gonewx/quadcuber/mechanical/README.txt

Quadcuber 最终结构与装配

整机882件：64件四角闭环底盘＋668件四臂＋150件支承总成。
支承总成包括130件托座导向结构、16件U形杠杆和4件上止挡。

开始阅读：offline-viewer/index.html。逐步装配：offline-viewer/assembly.html。
可打印说明：manual/manual.pdf。最终零件表：final-BOM.csv；分组件／颜色：subsystem-BOM.csv。

装配范围：全部882个清单实例均明确逐步取用，没有预装核心。每臂88步从单件搭成165件，81号侧梁与84号销落底盘后依次按说明安装，形成167件。成品电机、舵机按采购件处理，不拆本体内部。舵机网格为近似外形，真实接口、定位、插入力和实体安全仍须验证。

所有模型和图解均为同一最终结构。四根底框经四个双销L形转角闭合。按住外柄使托盘升到上位；机械头可靠接管重量后，缓松外柄，让空托盘按设计关系回落约40.8毫米。无自动保持和阻尼。手只从外柄末端三孔区域上方按压，约9毫米桌面间隙是夹手危险区。

设计审阅尚未通过实体装配、插入力、防脱、保持、载荷、自重回落、冲击、手部隔离和带电联锁验收。名义网格及离散碰撞采样不等于连续路径或实体安全认证。60483根轴64毫米叠层和桥端40毫米叠层均无名义轴向余量。

source内包含生成最终模型所必需的冻结计算依赖和版权信息，供重建溯源。它们不是另一本装配说明。当前装配内容以manual/guide.json、manual/manual.pdf和offline-viewer为准。
