gonewx/quadcuber/docs/lego/README.md

# 当前机械装配入口

[501 步逐步组装](../../generated/site/integrated-assembly.html) · [882 件整机 3D](../../generated/site/index.html) · [PDF](../../generated/mechanical/manual/manual.pdf) · [BOM](../../generated/mechanical/final-BOM.csv)

源码和构建见 [mechanical/README.md](../../mechanical/README.md)。[库存约束](inventory.md)保持有效。旧版本和研究资料通过 [Git 历史索引](../history.md)查阅，不再作为当前装配入口。
