gonewx/quadcuber/generated/electronics/release-preflight/README.md

> **本页以下均为历史评审记录，不是当前送厂入口。** 所有 `ENG-FULL-*` / `ENG-POWER-CONTROLLER-*` 变体含旧Phoenix J1，现已废止，不得下单或混用。当前仅用[唯一工程首板包](../engineering-first-board/README.md)：设计 `db20b98`，RASPC722X DC5521，153件厂商双面装配+18件用户自焊。原风险丝印保持，CAM确认见新包。

> 最新国内丝印修正：52处可见文字改为1mm，其他PCB字节不变。当前PCB `11b8502157f6d15a8be044557d35306fc5444240d9bb40ef5166bf3fedb1bb9e`；当前完整EV3候选为 `ENG-FULL-EV3-v3-CN-SILK`，旧v2/NO-EV3候选绑定旧板，禁止混用。详见 [丝印报告](../silkscreen-revision/README.md)。新增修改仅本地提交，未上传审核。

# A1 制造放行评估：受控原型条件

上一轮 USB 槽适配基线 PCB SHA-256 `b04859e7a282eb648943abfbf70d00e488a887627a74470aab24ffc20d637d44`。基于已推送的 `da5fc42` 完成局部 JLC 适配，最新证据见 [实施报告](jlc-implementation/README.md)。本轮仅本地提交，不推送、上传或下单。

**结论：电源/控制器可准备受控台架首板；完整EV3装配和机器人装机仍有具体前置缺口。没有把首板才能测的动态/热性能设为首次制板前必须已有的结果，也没有作量产放行。** 目前没有下单、支付或上传板厂。

**J5 四槽焊环已达到 0.254 mm，必要的局部 VBUS 避让已完成，原有 0.20 mm 规则保持。最终 ERC/DRC 均为零。** 工艺边/基准点仍为可移除拼板提案，未修改功能板。

## 已实际关闭

- 制造独立检查30项通过：11个Gerber、2个钻孔文件与重新导出一致；原板BOM、孔位、槽、面别和位置一致。详见 [制造报告](fabrication-preflight.md)。
- 原CPL误含DNP C26/C36的风险已在候选文件关闭：[171项BOM](fabrication-populated-bom.csv)、[171项坐标表](fabrication-populated-positions.csv)。默认 CPL 已同步排除 DNP；这仍是含通孔器件的装配表，不能直接假定为厂商SMT格式。
- 控制器54颗元件/180个接脚的跨源检查通过；交付UF2的1318块、ROM CRC及实际QE分支通过。详见 [控制器报告](controller/report.md)。
- 机械角度加密到1°，720个臂样本最大Y仍116 mm，基板面Y124 mm的裸网格间隙仍8 mm；[实际结果](mechanical-envelope-1deg.json)。B面C20/C30最大厚度2.2 mm已占用其中一部分，剩余至多5.8 mm，尚需扣装配公差和其他突出物。
- 最新BOOT直连与0.1%反馈设计保持不变；先前动态模型数值失败没有被改写为通过，PSpice交接仍NOT_RUN。WEBENCH典型条件也未替代当前实际元件验证。
- 电源37个位号的源/原板/网表/BOM合同通过；[电源报告](power-review.md)及[复算数据](power-bounds.json)给出反馈、真实电容需求、联合电流、回生与热边界。电源上电前需确认电源限流模式与输出电容，先接线后使能，从室温、无外部负载、0.5A限流开始。

## 首次试产前必须落实的条件

| 条件 | 关闭方式 / 责任输入 |
|---|---|
| 明确试产用途 | 完整EV3板需先关闭下一行；如先做不装J10–J13的电源/控制器台架板，需明确该装配变体、禁接EV3负载并接受接口可能改版。171项完整候选仍含四个EV3；另备167项 `ENG-POWER-CONTROLLER-NO-EV3-v2-JLC` 候选，见下文，禁止混用。 |
| EV3实物映射/配合与能力 | 使用已提供尺寸图继续核对，无需重新上传：图上1/6已明确，2–5连续顺序和元件面有视图支持；同批样品六路通断记录、焊尾/定位柱与固定耳试配可关闭实物关系，无需另索完整图号/MPN作为唯一途径；电机触点持续/峰值电流额定或受控样品实验限值。见 [接口/机械报告](connector-mechanics.md)。 |
| 板厂/装配能力 | 4层、外铜70µm/内铜35µm与0.15 mm线距同时可制造；实际压合/板厚定义、USB阻抗复核、0.30 mm成品孔、0.60 mm镀槽、阻焊桥、热孔tenting/锡膏及双面工艺。现有阻焊桥规则为0，DRC不能证明工厂桥宽合格。需选定厂商工艺能力，不需要首板实测来确认这些制造条件。 |
| 装配资料 | 用精确MPN和DNP候选表，厂商逐项核对IC pin1、二极管带标、电解正负、连接器方向和上下板面；不得擅自替代Flash、晶振或功率器件。候选坐标角度尚需厂商机器约定确认。 |
| 受控台架 | 9V±2%可限流电源；输入连续总预算≤5A；先无负载再单路增加，禁止长时堵转及未经验证的同时满载。USB插接时主机须有效供VBUS，主机断电前拔USB；不支持外部供电接失电主机。3V3连续≤150mA。 |

Murata精确Cin/Cout的有效电容/ESR曲线仍缺：应索取原厂偏压/温度/容差数据或对实际料样测量。该缺口阻止宣称设计已覆盖PVT/稳定性，**不强制要求在受限首板制作前完成一切环路测量**。若首板验证暴露不稳定，按最小改动方案重新评审；不得默认装上两颗470µF来“补容量”。

## 首板回来执行，合格后才扩大用途

1. AOI/极性/短路与焊接检查，在限流电源下先逻辑和两路空载5V，捕获冷启动、关断、热启动及输入跌落。5V目标4.75–5.25V；不要将模型未跑通视为实测失败或通过。
2. 锁定实际MLCC与温度，测两路负载阶跃、最小/最大输入、环路/纹波与电容有效值；按预定范围逐级升载。静态反馈上界余量小，需要波形和实物容差证据。
3. 按控制器报告验证BOOTSEL/指定UF2、Flash持久化、时钟、1V1/3V3及允许供电组合；host-off仅用受保护夹具专项测试，不先接电脑。
4. 单电机/单舵机到并发调度，测**总输入电流**、各轨波形、温升与故障恢复。四路电机各0.75A加两轨各1.5A不能同时当安全预算，估算已超过5A。保险丝是故障保护，不是5A电子限流器。
5. 回生按当前≤0.05J/次、≤5Hz的暂定受限计划逐步验证；监测VM尖峰、TVS及电解温度。该界限是计算支持的实验范围，不是实际电机回生已测定值。热/保险/PTC及铜温合格后才能扩大负载/环境范围。
6. 独立绝缘台架测试不依赖机器人托架完成；装机前另完成支脚/底部防护、B面绝缘、焊脚、USB插拔与线缆扫掠实物检查。之后再做集成运行与耐久，不称量产认证。

## 真正需要外部补充的最少信息

已有原图、WEBENCH资料、机器人源模型及A1源文件均不再索取。剩余外部输入是：**EV3同批供货件的最小通断/配合记录，接点载流由受控首板测试建立实测边界；已确认嘉立创，按JLCPCB公开规范核对的装配工艺；Murata实际料号的偏压/温度/ESR数据或样品测量条件。** 支架、线缆与脚的实体公差留到装机阶段关闭。没有发现足以直接要求重新设计整套架构的证据；若选择支持失电主机USB或更高并发负载，需另立具体最小修改提案。

## 嘉立创与EV3后续更新

用户已确认嘉立创，并明确EV3插座没有更多资料：停止索要厂家完整图号/MPN/额定文件。已有图作为封装依据，实物六路断电通断是制板前避免针序错误的最小核验；接点载流只能通过受控首板电流/压降/温升建立本项目实测边界。详见 [JLC工艺方案](jlc-process-options.md)、[接口修正](connector-mechanics.md)。

另备 `ENG-POWER-CONTROLLER-NO-EV3-v2-JLC` 候选变体，BOM/CPL各167项，明确不装J10–J13、C26/C36；不是默认完整装配，不是下单许可。该变体可在EV3实物核验前用于电源/控制器验证，但后续接口若需改针序仍可能改板。另有当前板的 `ENG-FULL-EV3-v2-JLC` 171项完整候选；旧v1明确标为不可制造。
