gonewx/quadcuber/electronics/simulation/webench-handoff/README.md

# A1 双 TPS54302：WEBENCH 手动接续

2026-10-12 更新：**四项简化单路作业的用户PDF已由父对话正式取得并逐页文本/渲染审阅，见[PDF评审](review.md)。本工程环境尚无PDF原件；未发现内嵌CSV或采样附件。完整A1仍未通过，制造NOT RELEASED，本地ngspice/Xyce兼容状态不变。** 本环境此前止于myTI登录；下文初始接续流程是历史操作说明，不代表用户仍停在登录页，也不要求现在重复运行。本资料接续现有A1，不是旧main的Pico H板。

[最小修正提案](minimal-correction-proposal.md)：包含BOOT实际走线、可替换料号、反馈精度/比值比较和有效容量公式限制；仅提案，未实施。

## 后续设计规则校核

[剩余验证与实际计算](remaining-validation.md)：发现官方49.9 Ω是反馈环路注入电阻，并非BOOT串阻；当前1%反馈电阻叠加基准极限的静态上界约5.298 V。EN独立支路已运行并与KCL核对。先评审设计依据及有效电容，不继续重复默认仿真。PCB未修改。

## 四项用户截图结果小结

以下均为父对话实际查看用户截图后的记录，非本地运行、非原始数据复算。各页面摘要的统计窗口和定义尚待核对。

| 作业与证据 | 页面主要摘要 | 关键限制 |
| --- | --- | --- |
| [Startup-1](user-startup-evidence.md) | StartupTime 5.03 ms；VoutAverage 5.10 V；InductorMaxCurrent 1.86 A | 不能把页面启动时间直接等同于项目首次达到4.75 V的时刻；无完整25 ms数据 |
| [Steady State-2](user-steady-state-evidence.md) | 输出峰峰值3.94 mV；均值5.10 V；电感电流峰峰值0.53 A；平均频率414.82 kHz | 可见约0.90–1.00 ms窄窗口，不证明所有稳定性或本地模型时钟修复 |
| [LoadTransient3](user-load-transient-evidence.md) | 输出4.98–5.21 V；过冲/欠冲0.11/0.13 V；恢复0.32/0.31 ms | PDF已确认注入脉冲抵消电阻负载，约5.10 V时净负载1.53→0.18→1.53 A；非指定A/B工况 |
| [InputTransient4](user-input-transient-evidence.md) | Vin 8.82→9.18→8.82 V；输出5.09–5.11 V，两档均值5.10 V；恢复0.34/0.61 ms；过冲/欠冲各0.01 V | 四舍五入摘要，不能作为精密原始值；负载电流、源条件和完整时序待确认 |

共同缺项：BOOT串联49.9 Ω、EN 511 kΩ/105 kΩ分压仍未体现；输出ESR6 mΩ/颗是测试假设，电容有效容量降额、A/B实际轻载和双路行为未验证。标称电阻负载的实际电流需按原始定义及波形核对。四项完成只说明这些简化作业可运行，不是完整A1通过。

**四份PDF已收到并审阅，不重复索要。** [评审](review.md)区分第7页动态波形与设计计算，并记录Cin不匹配、BOOT/EN缺项及初始化单位异常。优先解决拓扑和有效电容等效性，再进行有依据的实际轻载验证；不追加盲扫，不因此放行制造。

## 初始接续步骤（历史流程；四项简化作业已完成）

在自己的浏览器打开 [TI 官方 WEBENCH](https://webench.ti.com/power-designer/switching-regulator)，自行登录 myTI。输入 **Vin min 8.82 V、max 9.18 V、Vout 5 V、Iout 1.5 A**，生成候选；在结果页 **Filter by Part Number** 输入 `TPS54302` 并按 Enter，选择 **TPS54302 / TPS54302DDC** 卡片的 **CUSTOMIZE**。不要选择 `TPS543021`。

先核对登录后页面能否表达下面的实际元件和连接；若不能，记录准确的字段/限制并回传去敏文字或元件页截图，暂不把默认设计当 A1 运行。首要差异：**10 µH、2×22 µF、100 kΩ/13.3 kΩ、75 pF、BOOT 串联 49.9 Ω、EN 511 kΩ/105 kΩ**；可选 470 µF 保持不装。账号只在 TI 官方页面输入，不回传密码、会话令牌或带登录参数的地址。

## 本环境最初观察的网页行为（用户后续见独立证据）

- 已实际观察：初始输入页、用户授权的条款勾选、`VIEW DESIGNS`、HTTP 200 的候选生成（本次 730 项）、结果页过滤器、准确 TPS54302 卡片及其 `CUSTOMIZE`。过滤后另有 TPS543021，二者不能混用。数量和默认元件是本次观察，后续可能改变。
- 首页输入器件名称并未限制本次候选结果；必须在结果页过滤并核对卡片。重启浏览器后直接打开 `/select` 曾恢复默认 14–22 V / 3.3 V / 2 A，不能沿用：每次检查页首输入输出摘要。
- 点击准确卡片的 CUSTOMIZE 后到 `login.ti.com` 官方登录页；此前无收费/订阅提示。卡片的 BOM Cost/IC Cost 是元件估算，不代表软件收费。
- **未核实**：登录后元件编辑入口、是否允许自定义 MPN/寄生/拓扑、双路联动、任意负载表达式、输入斜坡、初始条件、求解精度、导出格式、直接 SIMULATE 的权限。以下都是目标参数和回传要求，**不是已验证的登录后按钮教程**。不承诺 WEBENCH 能完整重现这套测试台。
- 登录页另显示登录即同意 transaction terms、terms of use、privacy policy；本环境没有完成该登录动作。用户自行审阅实际页面的新条款、权限或费用提示。

## 源文件与可追溯性

核对本地提交 `2d01805e8ac628a21c66806affd03b1b632a0859`；A1 源基线 `e34395e68b175cf9a279664fd4a13fd6573d95db`。

- 电路定义：[circuit.py](../../circuit.py)；生成的逐件值与网络：[circuit.json](../../../generated/electronics/circuit.json)；[BOM](../../../generated/electronics/bom.csv)。
- 已有测试台：[PSpice 九工况说明](../pspice-handoff/README.md)及 [VIN9_C0.8.cir](../pspice-handoff/VIN9_C0.8.cir)，这里只引用其外围条件，不宣称在线求解器与 PSpice 相同。
- [28 个降压元件的逐件清单](components.csv)直接从当前 circuit.py 提取，包含 A/B、MPN、引脚网络和 DNP；[来源与校验记录](source-verification.json)；[网页观察摘要](observed-web.json)。
- PCB SHA256：`9e55fcbee01241fc6ec3682fde79daaacd6bc623ecfc311809600e001099350a`。本次仅添加移交文档，不改 PCB、BOM 或负载预算。

## 输入与两路差别

| 项目 | A 路 | B 路 |
| --- | --- | --- |
| 芯片、输出网 | U2、5V_A | U3、5V_B |
| 输入 | 共用 VM；测试取 8.82 / 9.00 / 9.18 V | 同左 |
| 目标与判定 | 首页填 5 V；接受范围 4.75–5.25 V | 同左 |
| 实际反馈 | 100 kΩ / 13.3 kΩ | 同左 |
| 轻载测试值 | 0.25 A | 0.05 A |
| 增载值（总支路电流） | 1.5 A，已包含逻辑预算，不再另加 0.25 A | 1.5 A |
| 实际用途 | 两只舵机，另有逻辑/编码器负载 | 两只舵机 |

实际分压按理想 0.6 V 基准计算为 `0.6 × (1 + 100/13.3) = 5.1113 V`，不是 5.000 V；不是实测或容差保证。不要让网站为精确 5 V 自动改回 13.7 kΩ。如果无法独立保留这组电阻，应报告限制；任何试探性重生成都要重新核对实际 BOM。

## 每路完整元件映射与默认方案差异

表内“默认”只指本次准确 TPS54302DDC 卡片；MPN 未显示的地方没有猜。网页小电阻数值按元件旁的寄生标注记录，登录后须核实其具体定义，尤其 Qty=2 的 ESR 是单颗还是总等效。

| 功能、A / B 位号 | 实际每路值与 MPN | 本次默认卡片 | 必须核对的差异 |
| --- | --- | --- | --- |
| 芯片 U2 / U3 | TI **TPS54302DDCR**，SOT-23-6 | TPS54302DDC | 型号必须 TPS54302；包装后缀 R 未在卡片显示，导出 BOM 核对；不是 TPS543021 |
| 电感 L1 / L2 | **10 µH**；Bourns **SRP1245A-100M**；测试串联 DCR **21.4 mΩ**（典型） | 11 µH，15.8 mΩ | L、DCR、MPN 都须匹配；21.4 mΩ 不是保证最大值；已有器件审核记录 DCR max 25.5 mΩ、L ±20%，未纳入九工况 |
| 输入主电容 C20 / C30 | **10 µF / 25 V**，Murata **GRM32DR71E106KA12L**，1210 X7R | Cin 10 µF，0 Ω，MPN 未显示 | 标称相同；有效容量、ESR/ESL未由板源确认。已有理想输入测试不含其 ESR，不能把 0 Ω 称作实物参数 |
| 输入高频 C21 / C31 | **100 nF / 50 V**，Murata **GRM21BR71H104KA01L**，0805 X7R；VM–GND | 卡片未单列 | 必须核对能否保留；ESR/ESL未知，测试用理想电容 |
| BOOT 电阻 R20 / R30 | **49.9 Ω**，Yageo **RC0603FR-0749R9L** | 未单列 | 是 BOOT 到 BOOT_CAP 的独立串联电阻，不能拿电容 ESR 替代 |
| BOOT 电容 C22 / C32 | **100 nF / 50 V**，Murata **GRM21BR71H104KA01L**；BOOT_CAP–SW | Cbst 100 nF，280 mΩ | 容量相同；网页 280 mΩ 不是 A1 已确认 ESR，A1 测试电容为理想；必须保留外部 49.9 Ω 串联路径 |
| 输出 C23+C24 / C33+C34 | **每颗 22 µF / 25 V，2 颗并联，总 44 µF**；Murata **GRM32ER71E226KE15L**，1210 X7R | Cout 47 µF、Qty=2（总 94 µF），3.037 mΩ | 容量/MPN 不同。A1 测试合并后的**总 ESR 假设 3 mΩ**；若模型用两颗相同并联电容，等效每颗需 6 mΩ才能对应该假设，不能每颗填 3 mΩ；不代表实物 ESR 已确认 |
| 反馈上臂 R21 / R31 | **100 kΩ**，Yageo **RC0603FR-07100KL**；Vout–FB | Rfbt 100 kΩ | 值相同，默认 MPN 未显示 |
| 反馈下臂 R22 / R32 | **13.3 kΩ**，Yageo **RC0603FR-0713K3L**；FB–GND | Rfbb 13.7 kΩ | 必须保持实际 13.3 kΩ |
| 前馈 C25 / C35 | **75 pF**，KEMET **C0603C750J5GACTU**，0603；Vout–FB，与上臂并联 | Cff 100 pF，1 mΩ | 容量不同；A1 测试为理想电容，实物 ESR/ESL未确认，不能沿用默认寄生后不记录 |
| EN 上臂 R23 / R33 | **511 kΩ**，Yageo **RC0603FR-07511KL**；VM–EN | 未单列 | 核对能否保留分压，不用强制一直使能代替冷启动 |
| EN 下臂 R24 / R34 | **105 kΩ**，Yageo **RC0603FR-07105KL**；EN–GND | 未单列 | 同上；默认 EN 的确切接线没有从卡片文本确认 |
| 可选输出 C26 / C36 | **470 µF / 10 V**，Panasonic **EEU-FR1A471**；**DNP，不装** | 未单列 | 不加入仿真，不能用它平滑波形制造通过；与 VM 上已装的六颗 470 µF 是两回事 |

芯片实际脚号：1=GND、2=SW、3=VM/VIN、4=FB、5=EN、6=BOOT。两路元件拓扑完全相同。板上没有额外的 DCR/ESR 电阻；测试网表中的这些电阻是寄生等效。

## 实际预算与本次测试范围

本项目暂定每个 5 V 支路 **≤1.5 A 持续为设计/首板验证预算**，不是已经验证的连续额定。芯片 3 A 标称不允许把本次负载改成 3 A。A 路的 1.5 A 包括逻辑负载。

整板入口预算≤5 A；项目已有估算显示四马达各0.75 A RMS、两路5 V各1.5 A并加泄放时约5.02 A，需要降低组合负载。禁止将所有电机/舵机堵转作为持续工作模式。热/短时峰值、EV3 PINMAP/MPN/CURRENT及机械条件仍 HOLD。单路 WEBENCH 不证明双路共母线耦合、入口保护、USB、回灌或整板温升合格。

测试 Vin 是**芯片 VM 节点**的理想源目标，不是对外部9 V适配器经过线束/保险/保护压降后的保证。电源/线束阻抗、真实负载边沿/启动波形、实际 DC 偏压有效电容、ESR/ESL随频率温度曲线、板级热参数均未从现有文件确认。

## 登录后需要表达的冷启动与负载测试条件

先检查网站实际支持的分析种类与可编辑项。能完整映射才运行 A1 对照；不支持的项逐项记录为缺失。网站的默认参考设计可以另存诊断，但不能命名为 A1 通过。

| 设置 | 本项目基准要求 |
| --- | --- |
| 输入启动 | VM在 t=0 为0 V，0–1 ms线性升至选定8.82 / 9 / 9.18 V，之后保持 |
| 冷启动初值 | 不预充输出；保留芯片启动行为；不使用预初始化稳态模型或跳过初始工作点来代替冷启动 |
| 时长 | 从0保存到 **25 ms**；已有离线对照最大内部步长 **20 ns**，打印间隔100 ns。WEBENCH是否可设未知，打印间隔不等于内部精度 |
| 温度 | 已有A1测试台27°C；网页初始默认30°C。若可设置则对照27°C；固定30°C时明确记录偏差，不能宣称同温度复现；两者均非热验收 |
| 负载时序 | 0–12 ms轻载；12–18 ms每路1.5 A；18–25 ms恢复轻载。两路同时阶跃 |
| 轻载 | A=0.25 A；B=0.05 A；1.5 A为各路总电流 |
| 低压负载 | 实际测试电流=`clamp(Vout/4 V, 0, 1) × Iset(t)`，从输出流向GND，避免输出建立前被恒流抽负 |
| 边沿 | 现有基准为理想阶跃；若网站要求有限上升/下降时间，记录实际值并另标变体，不能猜实物边沿或冒充原基准 |
| 电感/电容等效 | L=10 µH、DCR=21.4 mΩ；输出总44 µF×容量系数，**总 ESR=3 mΩ 假设**；Cin=10 µF×系数并100 nF；BOOT/Cff/输入100 nF不乘容量系数 |
| 数值选项 | PSpice参考为 RELTOL=1e−4、ABSTOL=10 nA、VNTOL=10 µV、ITL1=1500/ITL2=400/ITL4=100。仅用于记录对照，不能假定在线引擎相同或照抄就能设置 |

等效负载不是固定电阻。即便网站能设置恒流阶跃，也需检查低压衰减；不能用5 V除电流所得固定电阻冒充同一测试。若只支持独立单路，可分别做 A/B 并标记“独立单路”，不声称验证了同时启动/同时阶跃和共母线耦合。若只支持分开的 startup/load-transient 分析，分别记录输入初值、负载、时长，不能拼接为一条完整0–25 ms结果。

### 九工况容量矩阵

系数0.4/0.8/1.2是敏感性假设，**不是 Murata 偏压保证曲线，也不是 ±20% 容差的完整证明**。下面每个 Vin 各运行三个系数；若网站只支持单路，A/B分别运行，共18个单路结果，不能称9个双路结果。先尝试 VIN9_C0.8。

| 容量系数 | 每路 Cin主电容有效值 | 每颗 Cout有效值（2颗） | 每路 Cout总有效值 |
| --- | --- | --- | --- |
| 0.4 | 4 µF | 8.8 µF | 17.6 µF |
| 0.8 | 8 µF | 17.6 µF | 35.2 µF |
| 1.2 | 12 µF | 26.4 µF | 52.8 µF |

Vin逐项为8.82、9.00、9.18 V，所有容量组合保持同样负载、ESR和DNP设置。额外系数1.0（10 µF输入/44 µF总输出）可用于标称诊断，但不替代九项。理想电源钳住Cin，改变它不能验证输入纹波或输入电容动态容差。若网站固定器件模型自动降额，需保存其有效值，避免又手工乘系数造成双重降额。

## 验收与需要回传的证据

先确认实际运行的元件/连线/输入/负载与上述映射一致，再确认计算完整。0–25 ms必须无致命/收敛中止、时间单调且数值有限，全部所需通道和增载/卸载前后数据齐全。未到终点的曲线不能用最终一个值当作通过。

逐路判定：

- 0–10 ms内达到4.75 V；10–25 ms全区间Vout≥4.75 V。
- 0–25 ms全区间Vout≤5.25 V。
- 0–25 ms电感电流绝对峰值严格小于6 A，方向SW→输出。
- 保留SW波形用于核对工作时序和标称400 kHz附近的重载开关行为；轻载跳脉冲不能按每周期恒定400 kHz机械判失败。不能只凭一张平滑Vout图排除模型时钟异常。

请回传工具**实际提供**的文件/页面，不要求未知格式：

1. 运行日期、可见工具/模型版本；选定芯片、输入/输出、温度、初始条件、分析种类与所有偏离项。设计标识仅保留不含登录令牌的部分。
2. 登录后实际电路图、逐件BOM/MPN/值/数量、DNP、寄生定义、输入和负载设置；若可导出网表或工程，保留实际运行版本。不要提交整个仓库。
3. 每工况状态、最后仿真时刻、完整错误/警告文字，成功和失败项都保留；状态区分 NOT_RUN、INCOMPLETE、COMPLETED_FAIL、COMPLETED_PASS。有未映射项时先标 NON_EQUIVALENT，不使用A1通过标签。
4. 若可导出数值数据，至少 `time_s, vin_VM_V, vout_V, iL_A, en_V, sw_V, iload_A`；A/B分开时文件名标路别。保留原始/自适应时间点以检查窄峰值，重采样均值不够；无通道或无导出能力明确写缺失。
5. 启动0–10 ms、12 ms增载和18 ms卸载两侧的曲线及全程视图；记录首次达4.75 V时刻、10 ms后最小输出、全程最大输出和最大绝对电感电流。截图应显示单位、图例、时间轴，移除账户个人信息。

建议命名 `A_VIN9_C0.8` / `B_VIN9_C0.8`（单路）或 `AB_VIN9_C0.8`（真正双路），全部结果先视为待审核。无法表达49.9 Ω BOOT串阻、EN分压、反馈、实际电容或负载时，应回传限制并暂停A1通过声明，无需通过换芯片/加电容/改负载制造可运行结果。
