gonewx/quadcuber/docs/lego/v3-baseline/README.md

# 双侧薄梁轮胎压头：搭建与验证

统一分支：`research/self-aligning-jaws`，工作目录为仓库主目录。**双侧支承、后部避让和说明书已同步到正式模型，名义 CAD 检查通过。实物刚度、保持力及带载间隙尚未验收。**

每臂上下各一组 **42610 轮毂＋50945 轮胎**，每组两侧各用一根 **32449 四孔薄梁**。四臂需 8 组轮毂／轮胎，已有 4 组，另补 4 组；32449 共需 16 根，库存未确认。原有 11478 五孔薄梁不能照本图直接替换。

- [图文搭建说明与可旋转模型](index.html)
- [完整 MPD 模型](model.mpd) · [BOM](bom.csv)
- [连接、避让、刚度与实物验收报告](mechanical_audit.md)
- [连续包络结果](mechanical_audit.json) · [新增件网格检查](mesh_clearance.json)
- [完整验证日志](validation.txt) · [压头专项检查](pressure_pad_checks.json)
- [实物加载记录表](load_test_template.csv)

重力承重专项：[下沉分析与测试步骤](gravity_test.md) · [承重记录表](gravity_test.csv)。实际下沉尚未测得；理想推杆退让改变夹口，上下不对称变形和整头倾斜另测。

## 防翻折修正

实物后拉推杆曾出现下夹指突然翻折。原模型只选取对称正常解，遗漏另一装配分支。本版已加入上下独立挡轴：正常25°不接触，名义约29.8°挡住，早于41.8°汇合位置。两侧竖梁改十一孔，根轴改八号轴，支架用双片32056；详见[改装清单、原理与手动验收](open_stops.md)。实物防翻折仍须轻载确认和舵机重新标定。

## 前端孔位和装配

孔号从后端（靠转盘）数，上下相同。每个轮毂保持在主臂中面，距主转轴 40mm。

| 位置 | 连接 |
|---|---|
| 7 孔主臂第 2 孔 | 灰色无摩擦销接输入连杆 |
| 主臂第 4 孔 | 8 号根轴，贯穿两侧十一孔梁与限位支架 |
| 主臂第 6 孔／两片薄梁第 1 十字孔 | 4519 三号轴贯穿，外侧各加 32123a 半轴套 |
| 主臂第 7 孔／两片薄梁第 2 圆孔 | 32054 挡套长销贯穿，挡套留在第一片外侧 |
| 两片薄梁第 3 圆孔 | 留空 |
| 两片薄梁第 4 十字孔 | 32062 二号轴贯穿，中间套 42610；轴两端齐平 |
| 42610 轮毂 | 套 50945 轮胎，轮毂圆孔绕固定十字轴转动 |

轮端轴向叠放为 **4mm 薄梁＋8mm 轮毂＋4mm 薄梁**，不能增加轮轴外伸或外轴套。后固定点同样是薄—粗—薄，再由两只半轴套夹住；前固定点用挡套长销。先套好轮毂和贯穿轴，再合上另一片薄梁，最后装固定轴限位和挡套销。检查轮毂没有被夹死，轮轴没有窜出。

每臂前端清单：42610 ×2、50945 ×2、32449 ×4、32062 ×2、4519 ×2、32123a ×4、32054 ×2。主臂和根轴另计。完整 BOM 中的 32062、4519、32123a 还包含其他部位的用量。

法向夹紧载荷由两片对称支承，减少旧单侧结构的 6mm 偏心；拧层时沿轮轴方向的力，保守按轮毂端面压向其中一片计算。不能据此宣称整臂刚度翻倍。轮胎侧向摩擦、轴套保持、转盘和底座刚度均须实测。

## 后部曲柄和粗连杆

旧单侧版的曲柄轴会进入旋转推杆包络，已作以下修正：

1. 舵机及曲柄后移一孔（8mm），平台垫梁的三根黑销改到图示孔位；舵机长销插垫梁第 1、5 孔。
2. 舵机连杆改为 **32524 七孔粗梁**：从靠魔方端数，第 2 孔接十字块，第 7 孔接曲柄，第 1 孔留空，两铰点相距 40mm。不能反装留空端。
3. 曲柄从夹紧端沿**远离推杆**的圆弧开合，角度约 −4.78° 到 +92.32°；总行程约 **97.10°**。旧版脉宽及运动方向不能直接沿用。
4. 十字块端三号轴及两只半轴套保留，粗连杆直接贴十字块。曲柄端二号轴外端与曲柄齐平，内端加半轴套定位粗连杆。实物检查轴与轴套的摩擦保持。

前端输入连杆、转盘、模块外移 16mm 及底座四角 7×5 框架保持当前模型中的配置。

## 名义尺寸

| 项目 | 数值 |
|---|---:|
| 输入销到主转轴／主转轴到轮轴 | 16mm／40mm |
| 夹紧／松开主臂角 | 3.84°／25° |
| 推杆行程 | 10.00mm |
| 舵机曲柄角行程 | 97.10° |
| 自由夹口／每侧名义橡胶压缩 | 55.36mm／0.32mm |
| 压头轴中心 X | −24.09mm |
| 50945 名义外包络 | 直径 14mm、宽 6mm |
| 42610 标称尺寸 | 直径 11mm、宽 8mm |

`50945_nominal.dat` 按用户给定 14×6mm 调整外包络，保留原网格安装内槽，是实物轮胎的名义示意。轮毂原 CAD 外缘约 11.2mm。模型不模拟橡胶变形和公差；0.32mm 压缩不能换算为已知夹紧力。

## 验证结果和使用边界

- 单模块夹紧／松开、七个中间开度、整机夹紧的连接、插深、孔型、挡肩和同孔检查：0 问题。
- 四臂 576 个离散状态、单臂中间开度 168 个回转姿态：邻臂竖直时未检出干涉。旧体素算法会漏浅穿入，另有以下三角网格检查补充。
- 改动件附近 81 个开度的 FCL 三角网格检查：未检出非配合相交；轴孔配合和名义平面接触均记录在 JSON 中。
- 新前端对竖直邻臂及本臂固定件，另查 288 个回转姿态：网格外包盒筛选后进行624次精细查询，无相交，全部零件对间隙下界≥2mm。
- 曲柄轴和内限位对推杆连续回转包络：最小余量约 **5.333mm**；曲柄角范围内还计算了连续开度的保守径向下界。
- 魔方连续回转间隙下界：松开头回位 **2.313mm**；夹紧头对静止另外两层 **7.772mm**；邻臂对转动单层 **1.333mm**；邻臂对整块翻转 **9.655mm**。
- 后部旋转半轴套对舵机连杆，81 个开度、各覆盖连续 360° 的包络下界最小约 **0.878mm**；固定角网格距离约 0.914mm。这一处低于原建议 1mm 带载目标，尚不能认定带载合格。

前端同属一个刚性组件的半轴套与挡套销间距 0.8mm，轮胎侧面与薄梁间距 1mm；后部曲柄轴对近似舵机壳体的网格采样间隙约 1.373mm。实物优先核对上述位置及邻臂单层端面，不把名义正距离当作公差余量认证。

**相邻机械手不能同时处于水平附近，保留 `--no-adjacent-horizontal`。** 整块翻转时 L/R 夹持回转，F/B 松开且竖直；松开回位先达到开端。整机所有零件的连续开合与连续回转联合状态尚未得到完整数学证明。

## 单臂验收

先断电手动检查全行程、轮毂自由转动和轴向保持，特别检查后部 0.878mm 与邻层 1.333mm 部位。按[舵机标定流程](../../single_arm.md#servo-calibration)脱开曲柄空载定位，在中间行程断电连接，确认开合支路方向后小步标定。

使用[审查报告](mechanical_audit.md)中的分级加载流程，测工作扭矩、夹持抗滑扭矩、轮端变形、轴套滑移及带载间隙。实物项目仍为“未执行”；单臂验收后再复制四臂。

## 复现

Python 依赖：`numpy`、`scipy`、`Pillow`、`python-fcl`；需已缓存 LDraw 零件。图像用仓库的软件渲染器生成。

```bash
python tools/lego/v3/test_dual_support.py
python tools/lego/v3/test_open_stops.py
python tools/lego/v3/verify_open_stops.py
python tools/lego/v3/run_check.py module travel all
python tools/lego/v3/four_arm.py
python tools/lego/v3/verify_pressure_pads.py
python tools/lego/v3/mesh_clearance.py
python tools/lego/v3/mechanical_audit.py
LDRAW_SOFTWARE_RENDER=1 python tools/lego/v3/booklet.py
python -m http.server 8000
```

检查脚本正常应退出 0。浏览器访问 `http://localhost:8000/docs/lego/v3/`；旧路径 `docs/lego/swivel-pressure-pads/` 链接到同一目录。
