gonewx/quadcuber/generated/electronics/simulation/linux-steady-followup/README.md

# A1 预初始化动态验证与冷启动兼容诊断

2026-10-12；继续基线 `0c2517720d7764b3bae5c0347b3b211606647013`，本地执行、不推送。A1原理图/PCB/BOM/固件未改。未向任何外部服务提交设计、BOM或参数。

## 结论与实际运行

A1双路实际BOM的9个VIN/电容组合，分别从轻载和1.5A工作负载初始化，**共18项实际求解**。完整完成0项，验收通过0项；终止分类 `{'NUMERICAL_FAILURE': 15, 'TIMEOUT_180S': 3}`。超时仅说明180秒预算内未完成，**不等于数值不收敛**。五毫秒计划包含负载和输入变化，未到的窗口明确缺失，未声称全部阶跃已测试完成。

原厂稳态参考延长到1.5ms、保存全程后成功积分，但**周期稳态及宏模型兼容性尚未验证**。原750–800us只有20个400kHz标称周期；实际SYSCLK出现81次完整逻辑上升，迟滞计数也相同。末1–1.5ms共810次，中位周期约0.608us（约1.65MHz），不是小幅阈值振铃假计数。TI公开规格为400kHz并有扩频，见[官方产品页](https://www.ti.com/product/TPS54302)。完整运行不能替代物理行为验证。

原参考700–800us与800–900us窗口均值差6.60mV；后来存在约5.14V尖峰。`reference-steady-extended/analysis.json`保存全部窗口数据与判断条件，`reference-check.png`给出波形。该结果修正上一阶段“稳态参考完成”的解释：时间覆盖完整，但不能据此宣称已经达到正确周期稳态。 扩频本来允许周期变化；这里不要求逐周期完全重复，也不把均值变化单独当作未稳态证明。原调制周期约1.024ms，1.5ms尚不足以比较多个完整调制周期；当前更直接的阻塞证据是异常时钟频率与最小振荡器事件失败。

## A1方法和阈值

- VIN=8.82/9/9.18V，电容因子0.4/0.8/1.2；每路10u输入+100n、10uH/DCR21.4mΩ、输出44u乘因子/合并ESR3mΩ、BOOT49.9Ω+100n、反馈100k/13.3k+75p、EN511k/105k。470u DNP未装。与既有实际BOM脚本及源合同独立核对，输入/输出C因子是假定范围，不是已获得的MLCC直流偏压曲线。
- 保留TI六脚功能映射、外部同名别名包装、四处IC等号和同电位初值目标候选适配，原模型hash及适配前提见上一阶段 `../linux-reference/xyce-reference/adaptation.json`。原XOR、保护网络、所有器件参数均不改；不启用UIC或SMOOTHBSRC。
- **仅初始化**：正常DCOP，原厂STEADY_STATE=1，输出.IC=5V、电感IC=初始负载、BOOT电容IC=VIN（依原参考IC方式按输入值设置）。没有独立电压源持续钳住输出，没有手工固定额外内部状态。STEADY_STATE=1本身是原厂预初始化模式，会改内部参考/软启动等行为，故本试验绝不验证冷启动或软启动保护。初始电压不证明随后调节成功。
- 轻载组A/B从0.25/0.05A在1ms升到1.5A，2ms返回；工作负载组从各1.5A在1ms降到上述轻载，2ms返回。低压负载按既有 `clamp(Vout/4,0,1)`缩放。移除原0V测流源并把B负载直接接输出，负载方程不变；B表达式外加大括号是Xyce语法要求。
- 3–3.01ms将输入变至9.18V，4–4.01ms降至8.82V。初始VIN=9.18V组的第一项是无变化控制，只有4ms才是输入变化；各case记录实际ΔVIN和到达状态。
- 运行到5ms、最大步长20ns，全部时刻保存。计划稳态窗口0.7–1、1.7–2、2.7–3、3.7–4、4.7–5ms，各300us（120个400kHz标称周期）。输出4.75–5.25V，电感绝对电流<6A，同一工作点窗口前后半段均值变化≤5mV，至少50个已确认的物理周期。这些是本次诊断判据，不是TI官方测试规范；不能跨负载/输入不同工作点直接比较均值。
- `window-assessment.json`实际计算已覆盖窗口，缺失窗口不插值补齐；异常SYSCLK上升数只作观测，不充当通过的物理周期数。全局部分波形极值也保留，但宏模型时钟兼容尚未成立，不据此认定硬件过压/失效。
- 输入电容并联理想VIN源：可观察规定输入波形下的输出响应，**无法验证输入源阻抗、输入纹波及输入电容动态作用**。温度、ESR频率依赖与实物寄生仍未覆盖。

|工况|终止分类|最后时刻µs|达到首次负载变化|完整阶跃验收|
|---|---|---:|---|---|
|light_VIN8.82_C0.4|NUMERICAL_FAILURE|0.731116|否|否|
|light_VIN8.82_C0.8|NUMERICAL_FAILURE|0.749964|否|否|
|light_VIN8.82_C1.2|NUMERICAL_FAILURE|0.749977|否|否|
|light_VIN9_C0.4|NUMERICAL_FAILURE|0.699409|否|否|
|light_VIN9_C0.8|NUMERICAL_FAILURE|0.697428|否|否|
|light_VIN9_C1.2|NUMERICAL_FAILURE|0.697452|否|否|
|light_VIN9.18_C0.4|NUMERICAL_FAILURE|0.681128|否|否|
|light_VIN9.18_C0.8|NUMERICAL_FAILURE|0.680391|否|否|
|light_VIN9.18_C1.2|NUMERICAL_FAILURE|0.679483|否|否|
|heavy_VIN8.82_C0.4|NUMERICAL_FAILURE|28.396224|否|否|
|heavy_VIN8.82_C0.8|TIMEOUT_180S|1017.811928|是|否|
|heavy_VIN8.82_C1.2|TIMEOUT_180S|1013.856360|是|否|
|heavy_VIN9_C0.4|NUMERICAL_FAILURE|41.062787|否|否|
|heavy_VIN9_C0.8|NUMERICAL_FAILURE|23.077201|否|否|
|heavy_VIN9_C1.2|TIMEOUT_180S|949.978595|否|否|
|heavy_VIN9.18_C0.4|NUMERICAL_FAILURE|29.519256|否|否|
|heavy_VIN9.18_C0.8|NUMERICAL_FAILURE|1002.959843|是|否|
|heavy_VIN9.18_C1.2|NUMERICAL_FAILURE|25.986794|否|否|

## 冷启动与最小单元结论

`cold-differential/`保存三项单因素可逆对照：Startup只改S=1仍在108.133086us失败；只把VIN换DC12V在2.38699189us失败。两者均在首次SW上升采样后约0.748ns停止，排除了“仅VIN斜坡”或“仅S标志”的解释。预充电Steady仅S=0可完成800us，但输出末0.7495V，不是5V调节或冷启动通过。外部储能与负载类型仍有混杂，不声称已确定器件根因。

`oscillator-diagnostic/`原U3器件逐字提取，在明确SDWN/ULQ边界下比较默认、严格容差与Gear。独立振荡器正常OP无平衡；仅为该单元使用明确零初值UIC时，首段充电约2.363us符合7.14286pF/5.3uA/1.75V，但首次比较器转换处仍失败。单元UIC不代表完整宏模型可以采用UIC；不改变上一阶段的初值反例结论。全模型高频现象可能涉及复位/下游耦合/事件处理，尚未确定。

## 合理停止点和后续要求

本轮已覆盖：ngspice44/47兼容与KLU、Xyce官方源码构建、语法/逻辑/连续开关单元、初值矩阵定位、默认/Gear/后向Euler/阻尼Newton/有界无LTE诊断、三项冷启动差异，以及独立振荡器对照。没有更改芯片物理参数换取“通过”。这不是声称穷尽所有Linux求解器，而是停止无依据地重复本兼容分支。

下一条有判别力的证据是同修订TI原U3/完整Startup在**官方PSpice**的网表、日志、首开关与振荡器波形，或先能通过这些最小单元的明确求解器修复。当前没有这样的参考结果。无Windows条件下，[WEBENCH官方公开页](https://www.ti.com/tool/WEBENCH-CIRCUIT-DESIGNER)仅确认在线设计/电气仿真功能，不证明可原样导入此DSN/双路BOM；本轮未登录、提交参数或运行在线设计。更多只读核查见 `a1-steady/online-capabilities.md`。没有擅自申请账户、付费或接受新许可。

## 证据与复现边界

`a1-steady/results.json`区分实际returncode、数值失败、超时、未到事件；`window-assessment.json`提供完成窗口的指标。`source-contract.json`绑定工程与元件；18份test.cir与log/CSV是实际执行证据。大CSV无损gzip压缩，解压即原字节。绝对路径是本环境运行记录；搬迁时需明确恢复同hash模型/别名/工具路径。

`run_matrix_executed.py`保留实际运行的原驱动；该版汇总标签把超时混称数值失败，已由 `finalize.py`依据rc124及日志更正。`run_matrix.py`同时修正后续重跑清旧波形和输入事件标记，未悄悄重跑本次矩阵。执行后需运行finalize和assess_windows作明确分类/窗口评估；passed保持false是因为模型物理兼容前提未满足，不是把积分结束等同通过。原始日志空白/CRLF保留。

制造继续 **NOT RELEASED**。EV3针序/视向/型号/载流、实物热与机械等HOLD不变。
