gonewx/quadcuber/docs/architecture-direction-review.md

# 机械路线复核：四夹爪是否是正确方向

日期：2026-10-04。性质：网络调研加估算，**没有任何实物验证**。标“已核对”的是我直接读过原文的内容；标“转述”的是调研时经搜索或摘要读到、尚未逐字核对的内容。

## 结论

1. **四夹爪不是公开资料里最快的乐高路线。** 最快的三台乐高机器都不夹魔方，而是在魔方中心盖上粘乐高件，由马达直接拧各面中心，用时 1.0~1.9 秒，比 CubeStormer 3 的 3.253 秒快。
2. **四夹爪路线没有可参考的公开设计。** CubeStormer 各代的夹爪结构查不到文字资料，也没找到任何带搭建说明的乐高多夹爪机器人。本项目的夹爪只能自己从头摸索，这正是目前反复重搭的根源。
3. **本项目目前的风险几乎全部来自“夹”这个动作**：预紧力、打滑、翻转时滑落、头部下垂、邻臂干涉、导轨别住。直驱中心的方案没有这些环节。
4. 是否改走直驱路线，取决于一个只有用户能定的问题：**能不能接受在魔方中心盖上粘乐高件**。

## 三条路线对比

| | A. 四夹爪（现方案） | B. 直驱 5 个面中心 | C. 转盘 + 翻转臂（arducuber） |
| --- | --- | --- | --- |
| 公开先例的用时 | CubeStormer 初代约 11~12 秒（转述）；II 代 5.35 秒；3 代 3.253 秒 | CubeTwister 约 1.9 秒；mirrcub3r 约 1.2 秒；SquidCuber 约 1.0 秒（均已核对） | 1.5~2 分钟（本项目前身） |
| 先例的硬件规模 | II 代每臂 3 个马达，共 12 个（转述）；3 代用 8 个 EV3 主机 | 10~12 个马达，每轴两个并联并加速 | 3 个马达 |
| 公开设计资料 | 无图纸、无源码、无夹爪细节 | 有源码，无搭建图 | 有完整说明书 |
| 是否改动魔方 | 否 | **是**：中心盖粘乐高件 | 否 |
| 每步的机械动作 | 转面，外加松开、夹紧、换手、整体翻转 | 只有转面 | 转面加翻转 |
| 本项目所需执行器 | 4 个带编码器马达 + 4 个舵机 | 5 个带编码器马达，不要舵机 | 已有 |
| 本项目估算用时 | 约 25 秒（见下） | 约 7~9 秒（见下） | — |
| 主要风险 | 夹持可靠性；设计无先例 | 魔方对中与机架刚度；放入魔方的方式；扫描视野受遮挡 | 速度上限低 |

### 用时估算的依据

两个估算用的是同一个实测数：大马达空载 90° 停稳 0.349 秒、180° 停稳 0.514 秒（`docs/single_arm-results.md`）。带魔方后会更慢，两边都没计入。

- **A 路线约 25 秒**：转盘减速 2.5 倍，头转 90° 需马达转 225°，按现有调参约 0.45~0.6 秒；舵机开合我估 0.30 秒。用这组参数跑规划器，10 个 20 步序列平均 25.26 秒，平均整体翻转 6.8 次。`machine.Timing` 的默认值给出 9.69 秒，但默认的转 90° 0.18 秒与实测不符。
- **B 路线约 7~9 秒**：只转 5 个面要多约 12% 的步数（mirrcub3r 作者的数字，已核对），按约 23 步、每步 0.35 秒计约 8 秒；相对两面可以同时转，会再少一些。这是 1:1 直驱、单马达、不做任何加速的情况。

**B 路线不加任何优化就已落在第一版 10~20 秒目标之内；A 路线按现有数据要靠调参才够得着。**

## 调研到的事实

### CubeStormer 系列

- 3 代：8 个 EV3 主机、四只机械手、三星手机识别求解；使用 speed cube，利用其“面没完全对齐也能开始下一次拧转”的容错；有“精密独立制动”。扫描约 0.5 秒、求解约 0.05 秒、其余约 2.7 秒为机械动作。（转述，来源：ARM 新闻稿、New Atlas、speedsolving 帖）
- II 代：每臂 2 个 NXT 马达负责旋转、1 个负责夹爪开合；可以两只手同时拧对面，魔方只靠一只手夹住。（转述，来源：speedsolving 帖、ARM 博客）
- **未找到**：各代夹爪的手指数量、接触魔方的部位、靠摩擦还是靠形状、有无橡胶件、齿轮比。

对本项目的含义：先例是用马达而非舵机驱动夹爪，且单只夹爪就能可靠固定魔方。本项目用舵机加死点锁定、名义压入量 0.32mm，夹持能力与先例不在一个量级。

### 直驱中心的乐高机器（已核对各仓库 README）

- [CubeTwister](https://github.com/c0pperdragon/CubeTwister)（2015）：2 个 EV3、10 个马达，每轴两个；抓住 5 个中心块直接拧，顶面不驱动；魔方中心装了连接板，需按固定朝向放入。
- [mirrcub3r](https://github.com/efrantar/mirrcub3r)（2019）：3 个 EV3、10 个中马达；在 GAN 356 R 的中心盖上粘 2x2 圆板；只转 5 个面；4 面镜子让一个摄像头同时看到 6 面。
- [SquidCuber](https://github.com/efrantar/squidcuber)（2020）：12 个马达两两并联加速，6 组各接一个中心；约 1300 个 Technic 件保证刚度和对中；2 个摄像头各看 3 面。

两位作者都提到：魔方要调得较紧并润滑；机架刚度和魔方对中是关键；这类改装“有人会认为是作弊”，但近年非乐高的吉尼斯纪录机器同样改了中心块。

### 其他

- 低成本自制夹爪机（3D 打印加舵机）多在几十秒到 1~2 分钟。OTVINTA 的夹爪退回时会把魔方拖偏，官方做法是给夹爪套橡皮筋增加摩擦。（转述）
- 没有找到乐高的“U 形叉或笼式卡住整层”方案。

## 零件特性的公开数据

| 物理量 | 公开数据情况 | 可用的数 |
| --- | --- | --- |
| EV3 大马达 | 可靠，多个来源一致 | 9V 空载 175 rpm、堵转约 0.43 N·m（Philo）；折算到输出轴的惯量约 0.0014~0.0015 kg·m²，机械时间常数约 0.076 秒（两个独立辨识） |
| EV3 中马达 | 转速扭矩有，惯量未找到 | 9V 空载 260 rpm；堵转扭矩三家结果 0.12~0.22 N·m，差异大 |
| 梁的弯曲 | 有一组实测，缺跨距 | 15 孔梁中点加 25N 挠度 1.5~2.5mm（HispaBrick 012） |
| Geekservo | 只有厂家标称 | 见下面“需要核对” |
| 轮胎 50945 | **未找到**硬度和压缩数据 | 只知外径 14mm、宽 6mm、材料为 SEBS |
| 销孔游隙 | **未找到** | 爱好者测的孔径、轴径互相差 0.05~0.1mm，不足以算游隙 |
| 60 齿转盘晃动和齿隙 | **未找到** | 只有定性描述 |
| 十字轴在圆孔里的摩擦 | **未找到** | — |

大马达输出轴惯量约 0.0015 kg·m²，而我估算的机械头惯量约 0.00013 kg·m²，再除以 2.5² 折算到马达轴只有约 0.00002 kg·m²。也就是说**转动慢的原因是马达自身和减速比，不是头部太重**。

### 需要用户核对的三处

1. **Geekservo 型号**：灰色有两种，9g 版标称 500 g·cm、行程 270°；“2KG”版标称 1.6 kg·cm、官方写 0~360°。两者力量差三倍，需按实物标签或重量（约 12g 对 20g）确认。
2. **大马达输出轴回程间隙**：有二手说法称约 12°，原文未读到。编码器在马达内部、齿轮箱之前，这部分间隙编码器看不到。无论走哪条路线都应实测。
3. **24 齿与 60 齿转盘的中心距**：论坛帖按公式算 60 齿配 20 齿才是 5 孔，配 24 齿是 5.25 孔。项目记录是用户按实物选的 24 齿，以实物为准；只是提醒确认啮合不过紧。

## 两条路线各自的下一步

**如果改走 B（直驱）：**

- 现有的 3 个 EV3 马达先做单轴原型：一个马达经乐高接头拧魔方的一个面，测带载 90° 耗时和到位精度。这一步只需要十几个零件。
- 需要补到 5 个带编码器的马达；驱动板现有 3 块共 6 路，够用；舵机不再需要。
- 软件上，四臂规划器不再需要，改为“只用 5 个面”的求解；`cube.py`、`simulate.py`、固件的位置控制和编码器部分可以沿用。
- 待解决的设计问题：魔方如何放入并对中；摄像头如何看到被马达挡住的面。

**如果继续走 A（四夹爪）：**

- 夹爪没有先例可循，建议把夹紧改为有弹性预紧的结构，并先写功能检查再出搭建图。
- 轮胎软硬和转盘晃动没有公开数据，仍需要用户测。
- 速度目标按现有数据应下调到 20 秒以上，或改小转盘减速比。

## 资料缺口

- CubeStormer 的夹爪结构只能逐帧看视频，本轮没有做。
- 直驱机器的马达接头与中心盖的具体连接形式、放入魔方的方式，README 里没有写，需要看视频或源码。
- 本文 A、B 两个用时都是估算，带载数据一个都没有。
