gonewx/quadcuber/electronics/sources/ev3-user-drawing-review.md

# 用户提供的 EV3 插座尺寸图独立审查

审查日期：2026-10-12。二次放大复核纠正：PCB LAYOUT 左下孔明确标有数字1；前次漏读，只有6号明确的说法错误。只依据原图读取尺寸；此记录不构成触点额定或实物通断测试。

## 来源和身份

- 原图：[ev3-connector-user-drawing.png](ev3-connector-user-drawing.png)，981705 bytes。
- Library ID：`libfile_4615016895288191aa6603a199e74b09`，version `0`。
- 上传文件 ID：`file_0000000048cc81f59498cbc9e4210389`。
- SHA-256：`0808d9590fab3bfbbe8f75c32301f15bebc2252b61f9d1b91cafab78275b486b`。
- 图有 Coorle 水印和偏置卡扣外形，但没有完整制造商料号、图号、版本或接点电气规格。**不能据此认定与 Adafruit 4434 同型**。
- 建议封装名 `EV3_Coorle_Drawing_PINMAP_HOLD`；BOM 料号暂记 `UNCONFIRMED user drawing`。Coorle 仅作为图的识别信息，不代表已核实原制造商。

## 图上可以读取的尺寸

以下单位均为 mm。没有标出的公差不自行补写。

|项目|图示尺寸|解释|
|---|---:|---|
|六个信号孔|Ø0.79|PCB LAYOUT 标注 `6-Ø0.79`|
|两个定位孔|Ø2.3|PCB LAYOUT 标注 `2-Ø2.3`|
|定位孔横向中心距|12|两个大孔之间|
|相邻信号的横向投影节距|1.02|六孔交错排列；总横跨 1.02×5=5.10|
|信号两排纵向间距|2.54|不是单排相邻孔的横向节距|
|定位孔轴线至下排信号孔|4.84|纸面纵向尺寸|
|最右信号孔至右定位孔|3.45|纸面横向尺寸，6−2.55=3.45|
|主体宽|12.2|正视主体尺寸，不能当作含固定耳的最大宽度|
|主体深|15±0.2|侧视图水平尺寸|
|主体高|14.95±0.2|侧视图垂直尺寸|
|前端至定位柱轴线|6|侧视图底部水平尺寸，用于推导主体相对孔的位置|

## 孔位坐标和视向

原点取两个定位孔中心的中点。先直接记录 **PCB LAYOUT 纸面**：向右为 +X，向下为 +Y。坐标不存在按照片透视测量或缩放反推。

|几何位置（从左到右）|X|Y|图上电气针号证据|
|---|---:|---:|---|
|信号位置 A|-2.55|4.84|**明确标注 1**，左下孔（在孔径引线下方）|
|信号位置 B|-1.53|2.30|未直接标号；若按常见连续顺序才对应 2|
|信号位置 C|-0.51|4.84|未直接标号；若按常见连续顺序才对应 3|
|信号位置 D|0.51|2.30|未直接标号；若按常见连续顺序才对应 4|
|信号位置 E|1.53|4.84|未直接标号；若按常见连续顺序才对应 5|
|信号位置 F|2.55|2.30|**明确标注 6**，右上孔|
|左定位孔|-6|0|无电气编号|
|右定位孔|6|0|无电气编号|

上排 Y=4.84−2.54=2.30；信号中心横向对称于定位孔中点。

PCB LAYOUT 的交错孔排与左下器件底面外形图左右相反，支持将 PCB LAYOUT 解释为**从 PCB 元件面观察**；插口朝 −Y。图中没有明确的 TOP VIEW/BOTTOM VIEW 或投影法文字，因此这仍是结合相关视图的解释，不冒充原图直接标明的事实。需要实物或供应商明确视向后才能解除镜像风险。

对板底边 J10～J13 使用平面内 180°旋转时，局部坐标变为 `(−X,−Y)`，插口改朝板面坐标 +Y，符合向板底边出线的目标。**旋转不是镜像**，不能借旋转解决未确认的观察面或引脚顺序。

## 主体、焊盘和机械包络

侧视图给出前端到定位柱轴线 6、主体深 15，结合上述插口方向，主体名义范围可推导为 `X=−6.1…+6.1`、`Y=−6…+9`。这是相关视图推导，不是 PCB LAYOUT 直接画出的完整外形；主体深度有 ±0.2 公差。

定位柱在 X=±6，固定耳明显向主体外伸，图中没有完整标注其最大宽度和外廓。不能只按 12.2×15 主体矩形判断相邻器件、板边和机壳干涉。孔半径1.15加0.5装配余量得到 X=±7.65 的 courtyard **下限**，并不证明此界线包住所有固定耳。尚须核实实际插头、卡扣操作区和线缆进出空间。

如采用 Ø1.40 的圆形 THT 焊盘、图示 Ø0.79 钻孔，名义环宽为 `(1.40−0.79)/2=0.305`。同排孔距 2.04，圆焊盘间净距 0.64；相邻交错孔距约2.737，净距约1.337，不因 1.02 的横向投影节距而短接。钻孔/电镀/钻偏及实际针脚尺寸仍须核验，不能只凭名义环宽放行。

## 保留的实物与性能核验

1. 用户已确认没有更多资料：保留同批供货标识及现有图作为追溯依据，不再索要完整MPN或原制造商文件；不能将该件写成已核实的Adafruit4434。
2. 图上孔1和6已明确；2～5依其间连续编号推导，未逐个印号。相关视图支持元件面解释，无需要求供应商重复提供这张图已有信息。用实际样品一次断电六路通断记录确认焊尾与触点及镜像即可替代另索书面针序；禁止写成已经实测。
3. 触点额定值无资料可得时，通过受控首板电流、压降和温升测量建立本项目工作边界，尤其两个电机触点；不再索要不存在的额定书，也不将实测边界冒充厂家额定。
4. 按图中名义孔径和外形制作；样品/首板试配实际焊尾、定位柱、固定耳、插头卡扣与线缆空间。未标注的完整耳部外廓不凭比例编造，但无需为受控样板另索不存在的尺寸图。

本图已提供名义封装依据与1/6端点标注；完整EV3板制板前用一次六路通断确认针序以避免返板。载流和最终机械安装在受控首板上建立实测边界，不再将缺少额外厂家资料等同无法打样。

## 最小实物确认与缩减资料要求

这张图足够建立名义封装：1/6两端、六孔交错序列、主体和定位孔已有依据。照片中可见导体没有明显横向换位，支持从1端至6端连续编号；中间导体有遮挡，因此这属于有依据的推导，不是独立电气测试。原器件底面图与PCB LAYOUT的交错孔排互为镜像，支持PCB LAYOUT是元件面视向，可信度高于孤立的一张孔位图，但图上确无TOP/BOTTOM文字。

最小核对不要求购买另一款接口或重新上传尺寸图：取同批一个未焊接插座，所有电源、电机和控制板均断开；固定插口/偏扣方向，按图上左下1、右上6标记焊尾A–F。插入实际要用的EV3线缆，另一头悬空。用万用表通断档从六个焊尾分别找到线缆另一端对应的裸露金属接点（不要按线色认号），记录六对关系和两端观察方向；每路应唯一导通，并快速检查邻路不短接。另一端编号须以有明确观察面的EV3接点定义或已验证接口为基准；若手头没有编号基准，先记录实际左右位置并拍同一朝向的探针对应关系，不猜数字。只测两端可以排除简单镜像，六路完整记录才能同时排除中间换位。试配1:1孔位纸样/现有空板可确认定位柱与固定耳配合。

对受控原型，能追溯到这张图与同批样品的供货标识、上述六路记录及实物配合，可以替代难获得的完整制造商料号/全套图号。精确MPN仍有助于复购，但不应单独成为无法打样的门槛。通断不能证明触点载流能力；先限定实际电流、测压降/温升，额定未知时不宣称持续电流或寿命资格。
