gonewx/quadcuber/electronics/simulation/protection-source-review.md

# 保护器件原厂资料独立复核

2026-10-12。仅研究公开原厂资料；未访问或重试被禁止的TI下载，未修改PCB、BOM或仿真结果。

## F1：发现并纠正选型依据

现电气源F1为`0467008.NR`、8A/32V、1206。原厂[467数据表（2023-02-27）](https://www.littelfuse.com/assetdocs/fuse-467-datasheet?assetguid=4a59f034-1cca-460e-a5ba-e1e66247c76d)实际是0603系列，电流表仅0.25～5A；没有所写8A订购项，不能给该料号编造I²t。因此F1原选型不能制造放行。原厂[466数据表（2023-06-21）](https://www.littelfuse.com/assetdocs/fuse-466-datasheet?assetguid=dbe9bcd7-6072-4adf-bf5b-d33e52a6b90f)虽为1206，同样仅到5A，不能把料号改成`0466008.NR`就视为解决。

可核实候选为`0407008.WR`，但属于**时滞**而非原称快断，需实施者评估故障协调后确定。原厂[407数据表（2020-09-14）](https://www.littelfuse.com/assetdocs/littelfuse-fuse-407-datasheet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)给出：

- 8A，24VDC；分断60A@24VDC，测试电路时间常数小于0.8ms。
- nominal melting I²t=24.120A²s，在1ms开断时间测得，不能当保证最小值或total-clearing I²t。
- 名义冷阻9mΩ，8A热稳定压降97mV；1206主体3.2±0.1778mm×1.63(+0.10/−0.20)mm，高度0.835±0.15mm。最终焊盘按第4页尺寸图复核，不能只凭“1206”自动判同封装。
- 连续电流建议≤80%额定，25°C即6.4A；75°C例子再乘0.85，为5.44A。6A持续预算仍依赖实际温度。
- 16A开断1～120s，24A为0.1～3s，64A为2～50ms。它不能被宣称为快速半导体保护；须核故障电源限流、线缆/铜路容许时间和MOS热安全区。

[DigiKey确切0407008.WR页面](https://www.digikey.com/en/products/detail/littelfuse-inc/0407008-WR/12702259)查询时Active、8791颗现货、支持1颗剪带；未购买，库存不是锁定承诺。上述仅为真实候选，不是已完成替换。

## SMBJ12A与重复制动

原厂[SMBJ数据表JC.07/04/25 v4](https://www.littelfuse.com/assetdocs/tvs-diodes-smbj-series-datasheet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)可直接引用的位置：第1页最大额定及注释；第2页SMBJ12A行；第3页图2脉宽—峰值功率；第4页图3初始结温降额和图4的10/1000µs波形。

SMBJ12A为12V工作反压，13.3～14.7V击穿@1mA，19.9V钳位@30.2A。600W针对规定10/1000µs脉冲；注释为非重复脉冲、初始结温25°C，feature中的重复占空比为0.01%。5W连续耗散仅适用于引线50°C、无限散热器；典型结到环境100°C/W、结到引线20°C/W并非本PCB保证值。结温上限150°C。额定条件每端5×5mm铜面积也应核对。图6是**正向**浪涌，不能作为雪崩制动的重复寿命曲线。

对题设0.1～1J、1～20ms、1～10Hz作量纲计算（非器件模型）：

|条件|计算结果|能说明什么|
|---|---:|---|
|每次0.1J/1ms|脉冲内平均100W|实际峰值至少为100W；不能由能量唯一确定波形|
|每次1J/1ms|脉冲内平均1000W|已不能套600W指定脉冲额定作安全证明|
|每次0.1J/20ms|脉冲内平均5W|仍需脉宽/初温及重复温升核对|
|每次1J/20ms|脉冲内平均50W|600W不是20ms或重复50W许可|
|全参数范围E×f|平均0.1～10W|1J×10Hz=10W，已超过5W理想无限散热器条件额定|
|全参数范围t×f|占空比0.1%～20%|为0.01%参考条件的10～2000倍|

因此**不能证明该整个制动范围安全**。最低能量/频率端未被证明必然失效，但也未因上述计算获得放行。真实TVS吸收能量与机械制动总能量不同：还要扣除电容储能增量、驱动/电机损耗及其他负载吸收。若以典型100°C/W估算40°C环境至150°C上限，平均功率约1.1W即耗尽温差，这仅是风险筛查；它既没有给脉冲峰值温升留余量，也不是本板热阻保证。不得简单用600W乘脉宽作为可接受焦耳数。

## 熔断器脉冲循环降额及适用边界

原厂[Fuseology Selection Guide（2014）](https://www.littelfuse.com/~/media/electronics/product_catalogs/littelfuse_fuseology_selection_guide.pdf.pdf)印刷第7页/PDF第8页Chart2给出：100、1000、10000、100000次对应Pulse I²t / nominal melting I²t上限48%、38%、29%、22%，并明确脉冲间需**10秒**充分散热。印刷第3页另给长期设计20%经验建议。该通用筛查不能取代具体系列确认，更不能应用于间隔0.1～1秒的1～10Hz制动或持续基线电流叠加条件。

I²t应对实际**流过F1**的电流积分；当前LM74700将反向回灌留在VM侧，TVS制动电流不必流经输入F1。TVS焦耳数不能直接换成F1的A²s；熔断器也不能保护被它隔离在负载侧的制动TVS免于反复制动过热。先验证F1真实选型，再分别处理输入浪涌/短路与VM回灌，不能用其中一个的合格结论替代另一个。

## 实施决策跟进

实施者已决定将F1改为0407008.WR并将整板连续输入预算收紧为5A；本文件不宣称改动已完成或检查通过。第4页文本尺寸1.000、1.800、1.500、3.500与拟定每焊盘1.0×1.8mm、内距1.5mm、外跨3.5mm、中心±1.25mm相容，旧中心±1.4mm落在新焊盘内。此轮独立浏览器未返回可见截图像素，因此上述是尺寸文本和算术一致性核对，不替代实施者对原图尺寸引线的视觉确认。5A小于原厂75°C示例允许的5.44A，但仍需验证板上局部温度和短路清除能力。
