gonewx/quadcuber/generated/electronics/release-preflight/connector-mechanics.md

# A1 接口与机械试产边界

2026-10-12；对象为 `da5fc42b5e0c6352c827f9ae905eb891fe0dd12b`，不是 main 上的 PicoH 版。未修改电路、封装或布线。

## EV3 已知与真正缺失的信息

重新读取 [LEGO 官方主板原理图第1页](https://www.lego.com/cdn/cs/set/assets/blt86e79bb287a0d0b1/Appendix_LEGO_MINDSTORMS_EV3_programmable_brick_main_hardware_schematics.pdf)：输出口1/2为电机，3为GND，4为5V，5/6为Tacho。当前工程的逻辑网络符合该定义。这不能证明用户插座焊尾与接点的物理映射。

用户已提供图 `electronics/sources/ev3-connector-user-drawing.png`，不需要重新上传。其逐项尺寸证据及明确/推定的区别见 `electronics/sources/ev3-user-drawing-review.md`：二次放大纠正前次漏读：图明确标注左下孔1和右上孔6，中间2–5为有端点支持的顺序推导；视图相互关系强烈支持元件面观察，但无文字标注。名义信号孔Ø0.79、定位孔Ø2.3和12 mm中心距已落实，不再列为未知。不能把180°旋转当成镜像验证，也不能把Coorle水印当确切料号。

本轮用KiCad10读取原生PCB，将J10–J13各自180°旋转反变换到封装局部坐标；24个信号焊盘均符合图上坐标及上述编号解释，1/6端点没有放反，网络3=GND、4=5V_ENC、1/2=电机、5/6=编码器。结果见 `ev3-native-coordinate-check.json`；这是图到PCB的实际一致性检查，不伪称实物通断。

完整EV3装配试产前可用同批样品的六路通断/固定方向记录与实际配合关闭映射和机械问题，无需把供应商完整型号/图号或重复提供尺寸图当唯一途径；保留可追溯的供货标识。触点持续/峰值电流仍需额定资料或受控实验限值。实际样品可关闭映射与配合问题；若无额定资料，电流能力只能通过受控样品测试建立实验限值，不能声称厂家额定。板上限流值不能替代连接器额定值。

这些不妨碍讨论一块**不装J10–J13、仅用于电源/控制器台架验证的工程样板**：必须在装配清单中明确排除连接器及禁止接电机，仍需板厂DFM确认，且用户需接受后续可能因针序而改板。现已单独准备 `ENG-POWER-CONTROLLER-NO-EV3-v1` 候选BOM/CPL（167项），清楚排除四个EV3及原C26/C36 DNP；未下单，也不等于完整机器人首板放行。

## 机械与底部电容

实际PCB为144×112 mm，安装孔距136×104 mm；安装方向为主要元件朝下，B面朝机器人。既有模型检查在Y=124 mm基板面与机器人最高下伸点Y=116 mm之间给出8 mm裸板间隙。追加1°角度采样的实际结果单独保存在 `mechanical-envelope-1deg.json`；该方法仅检查三角网格包络，仍未建模支架、紧固件、线缆、公差和中间夹爪行程的连续扫掠。

C20/C30位于朝机器人的B面；已核实Murata尺寸为2.0±0.2 mm厚，因此只扣这两颗电容就把8 mm降低到**至多5.8 mm**，尚未扣锡膏、焊脚、安装和几何公差，也未证明它们是B面最高点。不得称8 mm为器件净空。

底部六颗已装470µF/25V为Panasonic EEU-FR1E471，现有官方来源审计记录D10×H12.5 mm、P5 mm；插座图高度14.95±0.2 mm。两颗470µF/10V C26/C36为DNP，不能把它们的尺寸或电容量计入默认装配。已有板下约25 mm与40 mm级抬高预算是设计预算，并非支脚模型已完成；必须从实际最大装配高度、焊脚剪切、地面公差和至少5 mm防护距离反推支脚尺寸。高度来源见 `electronics/sources/bom-exact-part-audit.md`，不要将标称外形当所有装配公差的上限。

独立绝缘台架上的首板电气测试不要求机器人托架先完成；机器人装机前则必须完成托架/脚、B面绝缘、插拔空间、螺钉和线缆运动检查。现有Technic孔距不能直接证明PCB可卡装。

## 用户确认后的一次最小动手核验

用户已确认没有更多插座资料，不再索取。若准备制作完整EV3板，只需一次操作：**在插座与实际EV3线缆均完全断电时，固定两端观察方向，用通断档记录插座六个焊尾分别通到插头哪一个金属接点；给六对对应关系即可。** 端点1/6与中间2–5都需记录，尤其3/4的GND/5V不能倒置。可以用带标记的照片记录左右位置，不要求提供不存在的MPN文件；不可用线色或从背面看见的左右直接当数字编号。父对话统一收集这一次记录，避免反复询问。

不装EV3的167项样板可以把这项核验延后，但该批板将不能声称接口已确定，若结果与图的推导不同可能需改板；不得靠先接电机试转验证针序。针序错误可能使电源进入信号脚，必须在任何接口带电前关闭。触点额定未知不阻止制作测量用样板，实际电流/压降/温升按逐级受控测试建立限定边界，通断合格不等于1A或任何其他电流额定已证明。

待填六路记录模板：`ev3-continuity-record-template.csv`，所有实测栏明确为NOT_MEASURED。首板触点筛查可在室温用受控电流从0.1、0.25、0.5到0.75 A逐级记录两根电机触点的压降与温升；每级先短时再热稳定，出现接触不稳、持续升温或明显压降异常即停止。可暂以相对环境升温20°C或外壳60°C先到者作保守停止线，这只是项目试验止损线，不是该材料的安全额定或标准认证。通过后才评估实际PWM/启动峰值与预期环境；仅测常温直流不能证明峰值、插拔寿命或全温能力。
