gonewx/quadcuber/generated/electronics/release-preflight/jlc-preflight.md

> **历史预检（修正前 aa17fa9b）**：下文保留原测量及提案，不代表现板状态。最新实施与验证见 [实施报告](jlc-implementation/README.md)。仅扩大焊盘会违反项目原有 0.20 mm 间距；现已通过三个节点 +X 0.06 mm、五段 VBUS 局部避让关闭，未放宽规则。配套同名 JSON 已更新为最终板实测。

# 嘉立创 A1 实板工艺预检

本轮按用户已确认的嘉立创路线审查；公开依据采用 JLCPCB 官网，最终中国站所选订单工艺的 CAM 口径仍须一致。没有上传、下单、改板或改铜厚。原板 SHA-256：`aa17fa9b22cc113f423552e96b39004e5b6b77cb64c0e49f54233de939642a5a`。本报告与 `jlc-process-options.md` 配套，区分公开服务范围、实际几何问题与待授权修正。

## 结论与最小方案

保留四层、1.6 mm、外层 70 µm/内层 35 µm、ENIG 的既定意图。**有一个确定的普通插件焊盘问题：J5 四个 USB-C 屏蔽镀槽环宽仅 0.20 mm。** 不把降低到 1 oz 当作默认修复，也不把 28 个功能性散热过孔按普通插件孔环宽误判成必须全部扩大。

最小候选修正是保持 J5 四槽孔位、孔径及槽长不变，槽铜焊盘每边扩大 0.054 mm：1.0×2.1 → **1.108×2.208 mm**，1.0×1.8 → **1.108×1.908 mm**；名义环宽达到 0.254 mm。该值恰到公开最低要求，并非已经批准或带额外工艺余量的尺寸。下面列出对当前铜图形作等距外扩的各层净距证据。真正修改后还须重新铺铜、检查焊盘形状/阻焊跟随、DRC 和制造输出；本轮没有实施。

| 四槽扩大 0.054 mm 后 | 当前图形测量 |
|---|---|
| F.Cu 最近其他网铜 | **0.168571 mm**（右侧下槽附近走线） |
| In1.Cu 最近其他网铜 | 独立全层近邻复核 **1.731063 mm**；主脚本的 0.40 mm 局部窗内无其他网铜 |
| In2.Cu 最近其他网铜 | 四槽均 **0.196500 mm**，相邻 3V3 铜区；完整多边形复核交叠面积为 0 |
| B.Cu 最近其他网铜 | **0.216796 mm** |
| 最近 NPTH 孔边 | **0.551098 mm**（下方长槽到 J5 定位孔） |

上表是保持当前其他图形不动的“等距扩大”候选计算；没有发现必须为这 0.054 mm 外扩先挪走线的局部障碍。实施时可考虑取名义环宽 0.260 mm（铜盘 1.120×2.220 /1.920 mm）增加 6 µm 名义余量，但本轮没有额外实算该更大尺寸，也没有把其理论余量当成通过。所有最终尺寸仍须改后重铺铜/DRC。

**审计程序修正说明**：一次中间结果把 In2.Cu 的两个短槽报成 0 距离。原因是 KiCad 填充区链接孔轮廓直接送入快速裁剪产生几何假阳性；现脚本先正规化多边形，再计算。完整不裁剪的 3V3 铜区独立复核四槽原距离均 0.250500 mm，扩大后均 0.196500 mm，无交叠；最终 JSON 已更正。这不是原 PCB 出现后又被“修好”的短路。

此外，应明确 28 个散热孔采用开放孔配套装配控制，还是选用填孔/盖铜工艺、补齐制造拼板工艺边/基准点、处理细丝印，并对 RP2040 窄焊盘的公开能力口径取得工艺解释。以上是具体可执行的闭环路径，不是泛泛要求重做整板。

## 原板实际检查

[官网 PCB 能力](https://jlcpcb.com/capabilities/pcb-capabilities) 对本轮相关项目列明：多层 2 oz 线/距 0.15 mm，普通 PTH 环宽 0.254 mm；过孔另按孔与盘直径差判断；2 oz 铜焊盘间距 0.20 mm 用于阻焊桥。下列实测量来自原板，不是仅抄项目规则。

| 项目 | 实测和解释 |
|---|---|
| 孔分类 | 299 个原生 VIA；28 个原生 PAD 但功能为散热过孔；67 个普通元件 PTH；14 个 NPTH |
| 普通 PTH 环宽 | 67 个全查：仅 J5 四槽 0.20 mm 未达 0.254；其余 63 个通过。例如 EV3 J10–J13 为 0.305 mm，普通 2.54 mm 排针为 0.35 mm；详细位号最小值见 JSON |
| 散热过孔 | U1.57 四个：盘/孔 0.60/0.30 mm；U10–U13.9 各六个：0.63/0.33 mm；环宽均 0.15 mm。按过孔规则，两者盘径－孔径均 0.30 mm；需向 CAM 显式说明原生 PAD 分类，不能依赖自动识别 |
| U1 细脚 | 56 个 0.20×0.875 mm 焊盘，0.40 mm 节距；相邻 SMD 铜焊盘最小边距 **0.200000 mm**；零扩展阻焊开窗同样为 0.20 mm 间隔 |
| J5 信号脚 | 相邻 SMD 铜焊盘最小边距 **0.200000 mm**；重复 A/B 编号同位置同网焊盘已排除，不当成零间距缺陷 |
| J5 定位孔处 | NPTH 开窗到邻近 A1/B12 或 A12/B1 开窗 **0.194557 mm**，满足现有 J5 的 0.18 mm 特例；它不是“两块铜焊盘”的 0.20 mm 规则直接反例，但应单列定位孔附近阻焊桥 CAM 确认，不擅自移动连接器引脚 |
| 孔间距 | 功能性 via–via 按 0.20 mm、涉及普通元件孔按 0.45 mm：本轮未发现低于阈值者。若把所有热孔原生 PAD 强行套 0.45 mm，有一处 U1.57 与同网 GND VIA 的间隔 0.359256 mm；按其实际 via 功能满足 0.20 mm |
| 孔到走线 | 不同网逐孔检查：普通 PTH 0.28 mm、VIA/NPTH 0.20 mm，未发现低于阈值者；同网故意连接孔铜不当成违规 |
| 内层孔到铜 | 含当前填充铜区；不同网普通 PTH 0.30 mm、功能 VIA 0.20 mm，未发现低于阈值者 |
| 线宽和板边 | 走线最窄 0.15 mm；四铜层到 144×112 mm 板框中心线最小均 **0.40 mm**，在本轮所查图形上满足铣边 0.20 mm，恰达 V-cut 0.40 mm 边界；并非据此选定 V-cut 拼板 |

官网通用 SMD 铜焊盘最小尺寸与 U1 的 0.20 mm 宽细脚存在需解释之处；[PCBA 能力](https://jlcpcb.com/capabilities/pcb-assembly-capabilities) 同时支持 Standard 0.35 mm 最小 IC 节距，U1 为 0.40 mm。组装节距支持不自动豁免裸板铜盘宽度规则，但也不能据通用条目强改原厂 QFN 焊盘；盲目把其宽度改为 0.25 mm 会把相邻间隔压成 0.15 mm，反而影响 2 oz 阻焊桥。最小处理是保留经数据表核对的封装尺寸，针对 0.20×0.875/0.40 mm 的具体组合寻求该工艺口径确认。

## 散热孔确实暴露，不能用“板级 tenting=yes”宣称已经盖住

实际把每个孔轮廓与原生 F/B.Mask、F.Paste 图形求交，包含局部扩展和 mask-only EP 开窗：

- **U1.57，4 孔**：顶面孔口 100% 位于 EP 的 3.2×3.2 mm 开窗内；底面开窗覆盖为 0%。每孔约 **41.7102%** 孔面积与当前锡膏图形重叠。即使这四个 PAD 本身没有 F.Mask 属性，EP 总开窗仍让孔暴露。
- **U10/U11/U12/U13.9，共 24 孔**：孔口上下均 100% 开窗，顶面锡膏对每个孔口覆盖 100%。这些孔自身带阻焊开窗，不能用“有板级过孔盖油”代替处理。

不动孔位有两条候选工艺路线：**低成本样板可保留开放孔**，前提是装配工程接受当前孔形，明确模板分窗/锡量、焊锡流失和 X-ray/空洞验收；如果开放孔方案无法接受，再对这 28 孔选择 **树脂填孔并盖铜**，有额外热导需求时才评估铜浆填孔盖铜。填孔盖铜是可选风险控制与成本取舍，不是本报告强制所有样板采用 VIPPO，也不是因为存在热孔就认定封装不可制造。孔径清单和 XY 坐标在 JSON 的 `thermal_holes`。它们处于 [官网 via-in-pad 填孔工艺](https://jlcpcb.com/help/article/pcb-via-covering) 的孔径范围，但**孔径在范围内不等于本订单默认已包含该工艺**。需指定这 28 个孔，不能让普通插件槽/连接器孔被填堵；当前没有替用户选择或下单。墨水塞孔不是这组靠近或位于焊盘开窗的孔的等价替代。模板孔型/钢网厚度、锡量与 X-ray/空洞验收仍需装配工程审查，几何重叠不是实际回流空洞率。

## 丝印与双面制造资料

本板实际 156 个顶面实装位号、15 个底面实装位号（包括通孔项目，不等于 SMT 计数）；底面 C20/C30 较大，需确定双面回流顺序和保持方法。没有原生 Fiducial 封装，板框只有单板四边，没有制造工艺边。Standard PCBA 的这些要求可由 **5 mm 工艺边＋1 mm 铜基准点/2 mm 开窗＋2 mm 工艺孔** 的制造拼板方案闭合，并不必为此扩展功能 PCB。最终孔位、基准点双面、拼板连接/拆板边缘和预览须核对；本轮未生成或上传 panel。[工艺边与基准点说明](https://jlcpcb.com/help/article/how-to-add-edge-rails-fiducials-for-pcb-assembly-order)、[装配 FAQ](https://jlcpcb.com/help/article/pcb-assembly-faqs)。

实测原生丝印有 **1983 个对象**使用 0.12 mm 线/笔画，**52 条文字**高度 0.80 mm，包括 BOOT、RESET、SWD 等操作标签。需要把重要标签提高到公开可辨认尺寸，或明确制造丝印删减策略；不能只让其被静默裁掉。本轮按 mask 图形裁剪后的几何筛选还有 73 个丝印对象离开窗不足 0.15 mm。该数为本地几何预筛，未重新解析实际 Gerber 每个墨线片段，不能视为厂商 CAM 最终拒收数。丝印可在制造图形层单独整改并重新导出，不涉及功率架构变更。

## 方法与边界

`electronics/verify_jlc_preflight.py` 使用 KiCad 10.0.7 原生多边形、实际填充铜区和 Shapely 2.1.2；先对链接孔轮廓作 make_valid 正规化；曲线近似误差设为 0.0001 mm，阈值判断保留 0.0003 mm 数值余量。mask-only EP 开窗若没有原生 net，仅在与同封装铜焊盘求交得到唯一 net 时标记推断归属；保留原始 net 字段，避免把正常 EP 开窗/同网走线重叠报告成其他网裸露。

本轮没有重复完整铜对象两两间距检查；既有原生 DRC 零错误与 0.15 mm 铜间距约束仍作为那一项证据。这里新增的是实际环宽、孔/铜、开窗/孔、局部候选扩展、板边、丝印和装配元数据检查，不替代修改后的 DRC/厂商 CAM。所有器件极性仍需按原厂封装标记、组装面和实际机器角度核对；CPL 与 PCB 角度一致不等于送料方向已批准。

EV3 图中左下 1、右上 6 已由主线程重新核实，本报告不再延续旧的“看不到 1”说法，也不再要求用户提供无法取得的完整资料。EV3 的同批六路实物通断与试配验收、以及独立不装 EV3 的电源/控制器试验变体由主报告管理，不能由本次 PCB 工艺检查代替。

复现：`PYTHONPATH=/tmp/quadcuber-jlc-audit-deps python electronics/verify_jlc_preflight.py`。临时依赖可用 `python -m pip install --target /tmp/quadcuber-jlc-audit-deps shapely==2.1.2` 安装；脚本内部调用指定 KiCad AppRun，临时导出几何后删除临时目录，不保存原板。机器结果在 `jlc-preflight.json`。
