gonewx/quadcuber/generated/electronics/release-preflight/jlc-process-options.md

> **历史预检（修正前 aa17fa9b）**：下文保留原测量及提案，不代表现板状态。最新实施与验证见 [实施报告](jlc-implementation/README.md)。仅扩大焊盘会违反项目原有 0.20 mm 间距；现已通过三个节点 +X 0.06 mm、五段 VBUS 局部避让关闭，未放宽规则。配套同名 JSON 已更新为最终板实测。

# 嘉立创 / JLCPCB 工艺适配预检

2026-10-12。用户已确认**嘉立创**。本轮按 **JLCPCB 国际站公开规范**检查，最终国内订单所选服务/CAM仍须保持相同能力条件。只读公开网页与本地PCB，没有上传Gerber、联系厂商、登录、报价或下单。对象PCB哈希仍为 `aa17fa9b22cc113f423552e96b39004e5b6b77cb64c0e49f54233de939642a5a`。

## 已能收敛的工艺选择

- 当前144×112 mm、4层、1.6 mm、外铜2 oz/内铜1 oz、ENIG在公开可选范围内。多层2 oz线宽/间距下限是0.15/0.15 mm，**不是双面板2 oz的0.16 mm**。因此现有0.15 mm逻辑线不应仅因厚铜被判无解。[PCB能力表](https://jlcpcb.com/capabilities/pcb-capabilities)
- 当前真实双面装配（底面15项）应采用 **Standard PCBA**；该服务支持双面SMT/通孔，单板70×70至460×500 mm，当前尺寸满足。无需为了Economic服务把控制器去耦迁回顶面。[装配能力表](https://jlcpcb.com/capabilities/pcb-assembly-capabilities)
- Standard需要工艺边/基准点；优先作为**可移除的制造拼板附属结构**处理，保留功能板144×112 mm与现有安装孔。可按厂商方案增加至少5 mm工艺边，1 mm基准点及2 mm工艺孔；实际连接桥/刀路须避开USB与EV3外伸件、铜到切边留量并检查脱板后的尺寸。现阶段不擅自选V-cut，因为原板0.30 mm铜到板边规则不自动满足V-cut的0.40 mm要求。[工艺边说明](https://jlcpcb.com/help/article/how-to-add-edge-rails-fiducials-for-pcb-assembly-order)、[工艺边/孔建议](https://jlcpcb.com/help/article/specifications-for-adding-process-edges-and-positioning-holes)
- 厂商FAQ明确可代加基准点。故现板没有基准点不等于必须重画功能区；在未来授权下单前，应审阅厂商生成的拼板/工艺边预览。[PCBA FAQ第12问](https://jlcpcb.com/help/article/pcb-assembly-faqs)

## 明确需处理的局部工艺问题

USB-C J5四个屏蔽固定镀槽的真实环宽为0.20 mm，而公开2 oz元件PTH环宽要求0.254 mm。这不是普通电气过孔，不可用独立过孔尺寸规则豁免。最小候选为仅扩大四个槽焊盘，短边由1.000增加到1.108 mm、长边同增0.108 mm，即四周各加0.054 mm；孔位、孔径、器件和网络不变。本轮候选几何核查给出顶层最小他网距0.168571 mm、底层0.216796 mm、In2层0.196500 mm，In1层0.4 mm范围内未见他网；最近NPTH孔边0.551098 mm。内层另以完整铜区多边形复核排除了裁剪假阳性。该方案具备局部几何可行证据，仍须实施后重铺铜、DRC及导出核验；尚未改板。实际选值可考虑环宽0.26 mm的易读尺寸，但需再核对应净距，不能把本轮0.254候选数据原样套用。

RP2040与DRV散热孔的孔口实际位于EP阻焊开窗内；板级tenting标记不能覆盖被别的焊盘开窗露出的孔。低成本方向是明确模板分窗、焊膏量及开放热孔的装配验收；若装配方不能接受锡流失/空洞风险，再选择只针对热孔的树脂填孔盖帽。油墨塞孔对焊盘内或距开窗不足0.35 mm孔不适用，不能把“盖油”写成已经树脂塞孔；2 oz、4层的填孔收费本轮没有报价。[JLC过孔覆盖工艺](https://jlcpcb.com/help/article/pcb-via-covering)

不建议以“直接改成外铜1 oz”作为自动修复：虽然可能放宽焊环和阻焊要求，但会改变功率走线电阻与热条件，需要重新核验。优先保留2 oz，解决已定位的局部尺寸/工艺问题。任何铜形修改仍按最小变更提案处理，本轮只输出预检。

## 层叠与阻抗的诚实边界

[官方阻抗工具](https://jlcpcb.com/impedance)提供4层1.6 mm及外2 oz/内1 oz选项，但本次可读取页面默认表为另一组铜厚，不能据此杜撰当前选择对应的叠层编号。当前工程0.180/1.010/0.180 mm介质是设计意图，不是已获JLC认可的压合表。后续应锁定实际可生产层叠再核USB约90Ω差分；未以默认“无要求”叠层冒充原设计。控制器为12Mbit/s首板功能验证，不宣称USB认证。

局部几何逐项结果与具体处理候选以同目录 `jlc-preflight` 报告/JSON为准；这份工艺建议不能替代其不通过项目或正式CAM审核。
