gonewx/quadcuber/electronics/simulation/webench-handoff/minimal-correction-proposal.md

# A1 两路降压最小修正提案（已批准，实施依据）

2026-10-12更新：用户已明确批准本方案，当前已实施，见[实施报告](../../../generated/electronics/boot-direct-revision/README.md)；下文“待批准/未实施”为批准前的提案记录，实际结果以新版实施报告为准。

原提案基线HEAD `2d01805e8ac628a21c66806affd03b1b632a0859`。PCB、源电路与装配BOM未改；制造仍NOT RELEASED。本提案只处理BOOT依据和反馈静态容差，不代表整板已通过。用户关于“0Ω是否相当于不要电阻”的询问不构成实施批准；本次仅更新提案，等待用户批准后才可修改设计。

## 1. BOOT：49.9Ω位置确实不符引用参考；历史动机不可证实

原厂依据为[TI TPS54302 Rev C / SLVSDG6C](https://www.ti.com/lit/ds/symlink/tps54302.pdf)：第14页图7-1中，C3=0.1µF直接跨BOOT–SW；49.9Ω的R1在Vout与反馈上臂/前馈节点之间。第15页7.2.3.3说明R1是反馈环路测试断点。第12页6.3.10及第15页7.2.3.2规定100nF陶瓷bootstrap电容，使用X7R/X5R。

源证据：当前 `electronics/circuit.py:94–95` 定义R20/R30从BOOT到BOOT_CAP、C22/C32从BOOT_CAP到SW；最早引入该电路的 `d591b0e` 第47–48行已经如此。故问题早于A1迁移、KiCad10及求解器适配。原参考相同49.9Ω被放到另一位置，支持“可能误读参考”的推断，但没有设计日志证明作者动机，不能写成已查明的历史事实。

**优先方案（尚未生产）**：删除R20/R30及其串联位置，用短铜线连接芯片BOOT引脚与100nF电容的一端；C22/C32靠近U2/U3，另一端短接至各自SW，使电容直接跨接BOOT–SW。这里“取消电阻”包含重新连通铜线，绝不是只拆件或设DNP后留下开路；也不是将BOOT与SW直接短路，二者之间仍是100nF电容。

**复用旧焊盘的备选**：仅在需要保留现有电阻焊盘/铜线时，将R20/R30换为0603的0Ω跳线；0Ω不是该功能必需器件，不是新板优先方案。备选确切料号 [Yageo RC0603JR-070RL](https://yageogroup.com/component-documentation/download/specsheet/RC0603JR-070RL)。其尺寸1.6×0.8mm与现有0603对应；按[RC系列数据表](https://yageogroup.com/content/datasheet/asset/file/PYU-RC_GROUP_51_ROHS_L)第5页，0603跳线电阻<50mΩ、额定1A/最大2A。不能把单料页的通用“5%”字段解释成理想零欧，亦未据此证明BOOT脉冲电流裕量。

只读PCB检查见 [boot-layout-inspection.json](boot-layout-inspection.json)：R20/R30焊盘中心间距1.65mm，C22/C32为0805；A的BOOT铜线段总长约8.400mm无过孔，B约9.037mm并有2个过孔，后续BOOT_CAP线段均2.725mm。加跳线焊盘间距后，到电容的路径量级约12.775/13.412mm（线段合计，不是寄生提取或严格最短路径）。因此0Ω**可复用现有焊盘并去掉有意串阻**，但并未缩短回路、消除B路过孔，不能声称全部布局建议已满足。板尚未生产，因此本提案优先取消串阻位置、移动电容并局部重布BOOT–电容–SW回路。最终坐标、线长和是否能全程无过孔须布局后核对，目前不预先宣称已实现；这不是本次已实施变更。

电容ESR是电容模型内部寄生，不能冒充49.9Ω外置电阻，也不能把WEBENCH的280mΩ假设当成实物数据。直接铜连方案和0Ω备选都仍需实测BOOT相对SW电压、充电/开关边沿、启动与温升；数据表2.1V是典型驱动条件，不是凭一条典型波形即可覆盖PVT的保证。

## 2. 反馈：可复算的区间与候选料号

TI第5页5.5给出VFB=0.581/0.596/0.611V（min/typ/max，服从该表测试条件）。令上臂Rt、下臂Rb，两只电阻初始容差均为t：

```
Vtyp = 0.596 × (1 + Rt/Rb)
Vmin = 0.581 × (1 + Rt(1−t) / [Rb(1+t)])
Vmax = 0.611 × (1 + Rt(1+t) / [Rb(1−t)])
```

当前1%上臂99–101kΩ，下臂13.167–13.433kΩ；高端计算是 `0.611×(1+101/13.167)=5.297792739V`。以下“全初始容差”仅指基准极限和两个独立初始电阻极限，**不包括电阻温漂/老化、FB偏置电流、线/负载调节、纹波和瞬态**。

| 上/下臂kΩ | 初始精度 | Vmin | Vtyp | Vmax | 初始静态结论 |
|---|---|---:|---:|---:|---|
|100/13.3（当前）|1%|4.862918|5.077203|5.297793|上限超47.793mV|
|100/13.3|0.1%|4.940693|5.077203|5.214182|上下限内，上端余35.818mV|
|100/13.7|1%|4.737898|4.946365|5.160952|低于下限12.102mV|
|100/13.7|0.1%|4.813403|4.946365|5.079783|算术比较，低端余63.403mV|
|100/13.5|0.1%|4.876105|5.010815|5.145987|算术比较，中心较均衡|

4.75–5.25V是项目现有验收要求，具体来自 `electronics/simulation/run_buck_vendor.py` 的 `assess()` 和 `thresholds`，并写入PSpice交接说明；不是TI对上述全部实际外围的保证，也不能据此推导所有外接负载均接受该范围。上限约束覆盖启动/负载瞬态全程，下限在10ms后适用，故仅静态合格不足以放行。

已直接取得原厂单料规格的候选：

| 用途 | 完整MPN及原厂资料 | 已核规格 |
|---|---|---|
|同阻值精度升级，上臂R21/R31|[RT0603BRD07100KL](https://yageogroup.com/component-documentation/download/specsheet/RT0603BRD07100KL)|100kΩ、0.1%、±25ppm/°C、0603|
|同阻值精度升级，下臂R22/R32|[RT0603BRD0713K3L](https://yageogroup.com/component-documentation/download/specsheet/RT0603BRD0713K3L)|13.3kΩ、0.1%、±25ppm/°C、0603|
|改变比值的1%对照，上臂|[RC0603FR-07100KL](https://yageogroup.com/component-documentation/download/specsheet/RC0603FR-07100KL)|100kΩ、1%、±100ppm/°C、0603|
|改变比值的1%对照，下臂|[RC0603FR-0713K7L](https://yageogroup.com/component-documentation/download/specsheet/RC0603FR-0713K7L)|13.7kΩ、1%、±100ppm/°C、0603|

四者均为0.1W@70°C、75V，尺寸1.6×0.8×0.45mm（各±0.1mm）。这是原厂料号/封装核对，未查询现货或下单。13.5k/13.7k的0.1%方案此次未取得可核实的确切单料原厂页，故只列为数值比较，不把猜测编码当作已审核采购项。

**建议**：针对尚未生产的新板，优先删除R20/R30并局部缩短BOOT–100nF–SW回路；0Ω仅为复用旧焊盘的备选。反馈仍保留同阻值0.1%候选以维持典型工作点；EN与Cff暂不动。不要推荐100k/13.7k的1%替换，因为静态低端已失败。若目标是生产角点加动态余量，当前两个有确切MPN的方案都不能直接定版，需要围绕更接近5.0V的精密比值分配上下沿预算，再核准实际料号并验证。

温漂例子说明该区别：对于已核25ppm/°C的0.1%同阻值电阻，假设两只电阻相对25°C偏移100°C、TCR独立取相反最坏方向，以 `(1±0.001)(1±0.0025)` 组合，静态区间变为4.918949–5.237256V，上端只剩12.744mV。此例不是测得板温或完整温度资格。用户简化WEBENCH负载波形有约0.11V过冲，不能机械加到另一PVT角点作为精确预测，但已说明不能仅以35.8mV初始余量宣称全程5.25V必然满足。

数值文件：[minimal-correction-numbers.json](minimal-correction-numbers.json)；复算脚本：[calculate_correction_options.py](calculate_correction_options.py)。

## 3. Cout >25.1µF：只是带条件的初筛

TI第17页7.2.3.5.2式14采用低ESR近似 `f0≈5.1/(Vout×Cout)`，并要求加入Cff之前选择低于40kHz的交越频率。由此在5.077203V有 `Cout>25.112252µF`；若按输出4.75V计算则为 `>26.842105µF`。这里Cout是两颗并联陶瓷电容的**总有效容量**，必须考虑初始容差、DC偏压、温度、老化。C26/C36的470µF当前DNP，不能擅自计入；若装配它们应重做整个阻抗/环路分析。

44µF标称取0.4系数仅剩17.6µF，粗估57.07kHz；0.8系数35.2µF对应28.54kHz。这些系数不是Murata保证曲线，式14也不保证相位裕度、负载阶跃或稳定性，不能据此宣布17.6µF必然振荡。75pF前馈会改变环路，需结合实际C/ESR及式16或实测重新审查；未建议自动改值。实际Murata曲线仍因官方入口403未取得，阻塞量产验证。

## 4. 变更边界和下一轮证据

本次仅交付提案、数值和只读布局证据，未改PCB/网表/BOM，未提交推送。若后续授权实施，源定义、实际BOM/封装映射、网表和仿真断言必须同步，不能只改仿真值；再做ERC/DRC及实际拓扑启动、规定A/B负载阶跃和输入边界验证。新BOOT物理回路、精密反馈的PVT/动态预算以及实际电容特性均仍待关闭；EV3接口、电流、热和机械HOLD也不因本提案解除。

## 5. 实施影响清单（已只读核对；全部待批准）

### 网名与引脚合同

- A路删除R20；将原 `B1_BOOT_CAP` 合入 `B1_BOOT`，C22.1与U2.6同网，C22.2仍为 `B1_SW`（U2.2）。B路对应删除R30，`B2_BOOT_CAP` 合入 `B2_BOOT`，C32.1与U3.6同网，C32.2仍为 `B2_SW`（U3.2）。不改U2/U3引脚编号、SW功率网络功能或EN分压。
- 实际PCB应移除两只电阻封装，清理原BOOT/BOOT_CAP绕线及失效过孔后局部重布，不仅做网名字符串替换。原理图、板焊盘、铜线网归属必须一致；不允许把BOOT网并入SW网，也不允许留下孤立电容端。
- 保留C22/C32的100nF、现有确切MPN和0805封装作为本提案基础；位置靠近芯片，是否需要进一步变更封装不在本次批准范围内。

### 源定义、生成与导出

| 文件/环节 | 核实的影响及待实施约束 |
|---|---|
| `electronics/circuit.py:94–95` | 两路循环删除BOOT电阻的 `r(...)`；电容上端由 `pre+'BOOT_CAP'` 改为 `pre+'BOOT'`；同步可复现的放置描述。其 `r()` 默认MPN是RC系列F级1%，反馈0.1%升级须显式传入已核RT系列MPN，不能只改显示精度文字。|
| `electronics/generate.py` | 从 `C` 生成buck1/buck2原理图、符号库、`generated/electronics/circuit.json`、`bom.csv`及项目规则。默认路径会新建PCB，不能直接运行覆盖现有已布线A1；即使 `--metadata-only` 也会重写原理图/项目/库，后续须受控同步并检查差异，不能当成纯BOM命令。|
| 原生KiCad文件 | 更新 `buck1.kicad_sch`、`buck2.kicad_sch`及其相关库符号/内嵌符号；对现有 `quadcuber.kicad_pcb`做局部变更，保留其他A1电路和布线。过时R20/R30的专用符号清理不能删除其他元件共用0603封装。|
| BOM与源快照 | `generated/electronics/circuit.json`、`bom.csv`移除两只电阻并同步反馈精密MPN；不要以“DNP但仍串联”代替电气删除。`electronics/build.py`从既有 `bom.csv`产生分组BOM，不会自动从源电路修复它。|
| 导出与布局脚本 | `build.py`后续重导网表、原理图/装配图、位置文件、工程预览、ERC/DRC与源哈希。`compact_buck.py`只处理C20/C30输入电容，不能用它当BOOT重布工具；`finalize_power.py`包含依赖现有B2_SW几何的删除条件，不应在新局部布局上盲目重放。|

### 仿真与检查约束

- `electronics/simulation/run_buck_vendor.py:54`硬断言R20/R30=49.9；应改为断言电阻不存在、两路BOOT–电容–SW引脚连接正确，并增加反馈确切MPN/精度核对。第72行网表硬编码 `R{ch}boot ...49.9` 和中间节点 `b1bc/b2bc`；删除外置BOOT电阻，使 `C{ch}boot` 直接接 `b{ch}boot b{ch}sw 100n`。这不会修复先前宏模型兼容失败，也不改变原厂子电路脚序。
- `electronics/check.py`目前比较原理图网表和PCB焊盘一致性，但没有独立的BOOT电容拓扑断言；后续应明确验证上述两路引脚合同、电阻不存在、原BOOT_CAP网不再使用，防止原理图和PCB一起错误却通过一致性检查。ERC/DRC、原理图与PCB一致性仍须全部通过。
- `electronics/simulation/test_buck_vendor.py`当前覆盖模型脚序、适配、结果完整性和验收，但没有BOOT连接测试；后续应补能捕获开路/错误跨接/旧串阻残留的拓扑检查，保持4.75–5.25V等验收阈值。`run_boundaries.py::source_contract()`记录源/PCB哈希、核对主要器件与母线大电容；当前不会独立检查BOOT，不能将其通过当作这次变更正确。
- `webench-handoff/check_design_rules.py`硬编码旧R20/R30值与A路连接，反馈按1%计算；若成为新版本检查需按获批方案更新，并保留本次旧版本结果的基线身份。`boot-layout-inspection.json`及旧容量/容差结果是变更前证据，不应静默改成新板结果。
- `pspice-handoff/`九份 `.cir`、`source-manifest.json`、`static-validation.json`和说明绑定旧49.9Ω拓扑；下一版须生成新网表/哈希/静态核对，不能继承旧状态。`report_buck_vendor.py`及仿真交接文档的拓扑描述也应更新。旧失败日志、用户四份PDF评审和 `generated/.../linux-steady-followup/`中的历史实验仍保留为旧基线证据，不批量改写。
- `verify_kicad10_migration.py`验证相对e34395e的迁移几何不变；本次是有意设计变更，后续不能沿用“几何完全不变”的结论或放宽断言掩盖它。保留迁移记录，另做局部变更前后差异和新版ERC/DRC报告。

以上仅列出批准后需要同步的依赖；本轮仅修改本提案文件。反馈0.1%仍是待批准候选，其温漂/动态余量限制不变；不执行生成器、不重布、不更改BOM、不重新运行全模型扫描。
