gonewx/quadcuber/electronics/simulation/webench-handoff/review.md

# 四份用户 WEBENCH PDF 评审

2026-10-12。**四项简化单路电路已取得可用的启动、稳态、负载瞬态和输入瞬态仿真证据；完整A1未通过，制造NOT RELEASED，本地ngspice/Xyce兼容问题未修复。**

> 后续重要发现：[设计规则校核](remaining-validation.md)确认官方参考49.9 Ω位于反馈注入路径，不能作为当前BOOT串阻的依据；反馈全容差上限也需评审。本文记录的是PDF与当前实板差异，不代表要求原样保留未获依据的BOOT49.9 Ω。

## 来源、阅读与归档状态

用户消息 `Sentinel_a502504d386081918c72c0619b5dbb98`。父对话 `01a11840-6f67-76ca-b87a-1b09a71dc0e4` 通过正式workspace materialization取得全部PDF，由阅读代理逐页提取文本并渲染查看，向本任务提供核实发现。本任务依据该审阅整合文档，未重新下载或独立读取PDF原件。

| 文件 | Library ID | 页数／第7页类型与sim_id |
| --- | --- | --- |
| WBDesign1_Startup-1.pdf | `libfile_2143ced3dd7c819185aabb4a7bad2a23` | 7页；Startup，1 |
| WBDesign1_Steady State-2.pdf | `libfile_d9c60e3a883481918ff92dd0fb992558` | 8页；Steady State，2 |
| WBDesign1_Load Transient-3.pdf | `libfile_cb5dfd20f05c819189f81b0a44ae727f` | 8页；Load Transient，3 |
| WBDesign1_Input Transient-4.pdf | `libfile_f4821a8d36108191a39285952a61683f` | 8页；Input Transient，4 |

本工程环境此前正式下载遭代理403，原件**尚未复制到本工程，不能称已在仓库归档**。接收和审阅状态见[user-pdf-receipt.json](user-pdf-receipt.json)。四份第7页均有矢量动态波形，纯pdftotext会漏掉；未发现内嵌CSV或采样数据附件。已有PDF不能视为未收到，但也不能当作全套原始数字波形。

## 首要发现：负载瞬态不是空载或指定A/B阶跃

Load第7页显示持续并联的 **Rload≈3.333333 Ω** 与**向输出注入**电流的PULSE源：

- I1=0 A，I2=1.35 A；延迟Td=850 µs。
- 上升Tr=100 µs、下降Tf=100 µs，脉宽Pw=600 µs。
- 净输出负载 `Iload = Vout / 3.333333 Ω − Ipulse`；不是两者相加。

按5 V计算，净负载约 **1.50→0.15→1.50 A**；按约5.10 V则约 **1.53→0.18→1.53 A**。IOut曲线验证先减载、输出上冲，再增载、输出下冲。电阻电流随输出电压变化，上述数值是代入电压的近似解释，不是恒流台阶精确值。

截图摘要 `@Iout=0` 不能当整路空载，`@Iout=1.35`也不是已确认的净支路负载。这不是A路0.25 A或B路0.05 A到1.5 A的目标工况，也不是12/18 ms理想阶跃。PDF明确了源方向与脉冲时序，修正此前仅凭截图“实际激励待确认”的状态；仍缺全套原始采样以精确复算极值。

## 四项动态证据（第7页）

| 工况 | 实际可见波形与条件 | 结论边界 |
| --- | --- | --- |
| Startup-1 | Vout、Vin；输入曲线约9 V，仅列Rload；输出约5.7 ms进入平台 | 截图StartupTime=5.03 ms的测量定义未进入PDF，不能与平台时间混同；未证明0–1 ms输入斜坡或完整25 ms项目验收 |
| Steady State-2 | 仅Vout，约0.90–1.00 ms窗口，纹波约4 mV | 无Vin波形；不能拿Operating Vin=9.18 V替代实际激励，也不能从仅Vout独立复核电感电流及平均频率 |
| LoadTransient3 | Vout/Iout，输出约4.98–5.21 V；激励见上节 | 是有限边沿的减载/增载测试；不是空载、指定A/B轻载或双路测试 |
| InputTransient4 | Vout/Vin；8.82→9.18→8.82 V，约100 µs边沿（读图）；输出包络约5.094–5.113 V | 参数表未给精确Vin pulse时序；读图估值不等于精密采样结果，不能用更多小数伪装测量精度 |

Steady/Load/Input三份列出 **Cbst IC=8.82 V**；这是电容初始条件，不是Vin值。这三份的 **L1 Initial Current打印为“-1.5 V”**，单位异常；不能据此认定物理反向电流或擅自改成“-1.5 A”。必须取得实际模型/网表才能解释初始化。

PDF缺少截图摘要的完整测量定义与全套信号，因此不能独立精确验证截图中的 **1.86 A、0.53 A、414.82 kHz及各settling时间**。保留[启动](user-startup-evidence.md)、[稳态](user-steady-state-evidence.md)、[负载](user-load-transient-evidence.md)、[输入](user-input-transient-evidence.md)截图记录为独立来源，不把它们与PDF设计表或读图值合并冒充同一测量。

## 四份第1页BOM一致，但未与实板完全等效

| 项目 | 报告配置 | 与实际A1的关系 |
| --- | --- | --- |
| L | 10 µH、21.4 mΩ | 与现有A1线性对照值一致；CUSTOM不证明饱和特性已正确建模 |
| Rfbt / Rfbb | 100 kΩ / 13.3 kΩ | 与A1值一致 |
| Cff | 75 pF，CUSTOM | 标称值一致；CUSTOM不证明模型所有寄生正确 |
| Cout | 2×22 µF，单颗ESR6 mΩ | 名义总44 µF、总等效3 mΩ是现有测试假设；未确认DC偏压有效容量或实际ESR曲线 |
| Cin | Taiyo Yuden **EMK107BBJ106MA-T**，10 µF / 16 V，X5R，0603 | 实板为Murata **GRM32DR71E106KA12L** 10 µF / 25 V，X7R，1210，并100 nF高频电容；有效容量和寄生不等效 |
| Cbst | 100 nF、ESR280 mΩ | 缺实板独立串联 **49.9 Ω BOOT电阻**；电容ESR不能替代该电阻 |
| EN | 无实板分压 | 缺 **511 kΩ/105 kΩ**；不能宣称启动使能行为等效 |

不能将CUSTOM L/Cout/Cff标签当作完整原厂模型证明；输出容量系数0.4/0.8/1.2仍只是此前敏感性假设，报告未验证该降额矩阵。实际A/B轻载、共母线双路行为和实板保护/热条件均未覆盖。

## 设计计算与动态结果必须分开

四份第2–4页设计曲线、第4–5页Operating表相同，条件 **9.18 V / 1.5 A / 30°C**。下面均为报告设计计算，**不是第7页动态波形测量，更不是实物测量**：

| 设计表项目 | 值 |
| --- | ---: |
| VoutActual（分压计算） | 5.077 V |
| Switching frequency | 400 kHz |
| 输出纹波 | 4.042 mV |
| 电感电流峰峰值 | 560.003 mA |
| 电感峰值 | 1.78 A |
| 效率 | 94.801% |
| 结温 | 51.739°C |

该表5.077 V不应改写成动态平台5.10 V；也不等同于此前按理想0.6 V基准算出的5.1113 V。不同来源/模型定义应保留，不能以相近数值互相替代。四份未提供环路增益/相位裕度图，故不能宣称完整环路稳定裕度验证。

## 已验证范围与下一步优先级

已取得的是同一简化单路配置的四种在线分析报告与可见波形：能启动到约5.1 V、窄稳态窗口有约4 mV纹波、指定报告负载脉冲下恢复、8.82/9.18 V输入变化下恢复。页面与PDF为有用仿真证据，但不构成实物测量、完整A1验收或制造放行。

下一步优先**解决模型等效性**：确认工具能否表达BOOT 49.9 Ω和EN分压，并把Cin/Cout的实际器件、有效容量和寄生依据补齐；若不能表达，明确工具覆盖边界，不继续把当前拓扑的更多扫描算作A1验证。之后取得可检查的激励/初始化定义，针对A/B真实轻载0.25/0.05 A到1.5 A及有依据的输入边界做少量定向验证。不要为了填齐数量追加盲目参数扫描，也不要求用户重复提交这四份PDF。

如工具能导出原始波形或实际网表，优先用于核对净负载、初始化异常及关键峰值；若只能导出PDF，保留能力限制，不伪造缺失数字。现有PCB、保护、EV3及热/机械HOLD均不因这些报告自动解除。
