gonewx/quadcuber/electronics/simulation/webench-handoff/user-input-transient-evidence.md

# WEBENCH InputTransient4：用户截图证据

> 后续更新：四份PDF已由父对话逐页文本及渲染审阅，见[统一PDF评审](review.md)。本文保留当时截图证据与当时未知项；后续已确认的负载方向/激励以该评审为准。本工程尚未归档PDF原件，仍无原始采样附件。

记录日期：2026-10-12。**用户浏览器中的简化单路InputTransient4显示完成；截图中四个作业均有完成勾选。四项简化结果完成不等于完整A1通过，制造NOT RELEASED，本地ngspice/Xyce求解器兼容状态不变。**

## 来源与证据等级

- 用户消息：`Sentinel_6798a07d31ec819194cf2a77d683fe93`。
- 截图 Library ID：`libfile_de55319477a08191bdf42053b2e2780d`。
- 父对话 `01a11840-6f67-76ca-b87a-1b09a71dc0e4` 已实际查看截图并提供可见摘要。本任务没有再次抓取或上传截图，也没有在本环境运行此作业。
- 尚无原始数值波形、实际网表、模型设置或运行日志；本记录不将截图摘要当独立复算结果。

## 页面可见结果

作业 **InputTransient4** 显示完成。输入曲线为 **8.82 → 9.18 → 8.82 V**，输出在约0.7–3 ms的可见窗口内出现扰动后恢复，未见明显发散。具体边沿时刻、斜率、源阻抗和完整运行时间仍待导出确认。

| 页面指标／条件 | 显示值 |
| --- | ---: |
| VoutMax | 5.11 V |
| VoutMin | 5.09 V |
| Average Vout @ Vin=9.18 V | 5.10 V |
| Average Vout @ Vin=8.82 V | 5.10 V |
| Overshoot settling time | 0.34 ms |
| Undershoot settling time | 0.61 ms |
| Overshoot | 0.01 V |
| Undershoot | 0.01 V |

这些是页面四舍五入后的摘要；尤其0.01 V不能解释为精确10.000 mV，5.09–5.11 V也不能作为未舍入的原始极值。恢复时间的容差带、统计窗口及算法未核实。窗口内未见发散只描述本次可见波形，不证明所有工况稳定性或环路裕量。

## 电路与验收边界

仍是此前简化单路配置，实际A1的BOOT串联49.9 Ω和EN 511 kΩ/105 kΩ分压未体现；输出电容6 mΩ/颗、Qty=2是总等效3 mΩ的测试假设。有效容量DC偏压/降额未由厂家曲线确认，指定A/B轻载条件及双路同时行为未验证。

输入电压范围与目标8.82–9.18 V一致，但不能由此断言其他激励、初始条件、寄生和负载均与A1测试台一致。标称电阻负载的实际电流随Vout变化；网页1.5 A设计目标不能自动当作本次恒流负载实测值。需要原始源/负载定义和波形核实，不从其他作业的标签推断本作业负载。

可记录：**第四项简化在线作业显示完成，输入在8.82/9.18 V间切换，页面输出范围5.09–5.11 V、两档均值5.10 V。** 不记录为完整A1、九工况、电容降额边界、轻载/双路或制造验收通过，也不改变本地求解器问题的结论。

## 当前下一步

父对话已指导用户下载四个作业的原始文件并发回，**暂不用重复运行**。当前状态是等待导出：尚未获得或审核下载文件。收到后统一核对电路/模型、输入/负载边界、时序、数据单位和统计窗口，再决定补充哪些等效测试；不预先宣布通过。
