gonewx/quadcuber/electronics/simulation/webench-handoff/user-load-transient-evidence.md

# WEBENCH LoadTransient3：用户截图证据

> 后续更新：四份PDF已由父对话逐页文本及渲染审阅，见[统一PDF评审](review.md)。本文保留当时截图证据与当时未知项；后续已确认的负载方向/激励以该评审为准。本工程尚未归档PDF原件，仍无原始采样附件。

记录日期：2026-10-12。**用户浏览器中的简化单路LoadTransient3显示完成，是第三项截图所示完成作业；实际负载激励尚未精确确认，不是指定A/B轻载到1.5 A的工况验收。完整A1仍未通过，制造NOT RELEASED，本地ngspice/Xyce兼容问题状态不变。**

## 来源与证据等级

- 用户消息：`Sentinel_9c348cb825f8819184272d307f13492f`。
- 截图 Library ID：`libfile_59906fb1f4148191992079e9d4456c1a`。
- 父对话 `01a11840-6f67-76ca-b87a-1b09a71dc0e4` 已实际查看截图，提供可见内容供本任务记录。本任务没有再次抓取或上传截图。
- 当前仅有截图经父对话核读的摘要，没有原始波形、源定义、完整网表或运行日志；本环境未运行此作业。

## 页面摘要

作业 **LoadTransient3** 显示完成，摘要如下。Iout条件标签按页面保留，不解释为已确认的整路负载。

| 页面指标／条件 | 显示值 |
| --- | ---: |
| VoutMax | 5.21 V |
| VoutMin | 4.98 V |
| Average Vout @ Iout=1.35 | 5.12 V |
| Average Vout @ Iout=0 | 5.10 V |
| Overshoot settling time | 0.32 ms |
| Undershoot settling time | 0.31 ms |
| Overshoot | 0.11 V |
| Undershoot | 0.13 V |

截图中总Iout灰线约从1.5 A下降到0.2 A附近，再升回1.5 A；该数值为看图近似，不是原始数据确认。输出恢复至约5.10 V，所示窗口未见持续振荡。页面统计窗口、过冲/欠冲基准、恢复时间容差带均未核实，不从这些标签推断更严格的测试定义。

## 负载解释与不等效项

示意图包含约 **3.333333 Ω的Rload** 和并联的脉冲电流源。因此页面 `@Iout=0` **不能解释为整路真空载**；需要核对脉冲源方向、其0/1.35标签含义、基准电阻支路电流及总输出电流的测量位置。电阻支路电流还随Vout变化，不能把它当固定电流。

在没有实际源表达式和数值导出前，不按摘要标签自行重建激励，也不把约0.2 A看图结果改写成已确认0.25 A。**此作业不是已确认的A路0.25 A或B路0.05 A到各1.5 A的指定测试**；12/18 ms边沿、低压负载衰减、25 ms运行时长和双路同时跃变也未证实。

电路延续简化配置，BOOT串联49.9 Ω和EN 511 kΩ/105 kΩ分压仍未体现；输出两颗电容的6 mΩ/颗是已有总等效3 mΩ测试假设，不是厂家确认ESR。其余未展示的设置不假定与完整A1一致。

页面显示的4.98–5.21 V落在项目4.75–5.25 V范围内，**仅能作为该简化作业所报告的电压范围**；不能据此给指定A/B负载阶跃、九工况矩阵或完整A1标PASS。也没有本次负载作业全程绝对电感峰值的原始证据，不能拿之前Startup-1的1.86 A代替。

## 后续状态

父对话已指导用户保存Load3结果后运行InputTransient，后续统一核对实际条件。后续已收到[InputTransient4截图](user-input-transient-evidence.md)，第四项简化作业显示完成；当前等待用户提供四项原始导出，暂不用重复运行。 需收集实际导出和源配置，核对负载支路方向、总电流与时序；进一步验收仍受BOOT/EN等电路差异限制。
