gonewx/quadcuber/electronics/simulation/webench-handoff/user-startup-evidence.md

# WEBENCH Startup-1：用户截图证据

> 后续更新：四份PDF已由父对话逐页文本及渲染审阅，见[统一PDF评审](review.md)。本文保留当时截图证据与当时未知项；后续已确认的负载方向/激励以该评审为准。本工程尚未归档PDF原件，仍无原始采样附件。

记录日期：2026-10-12。**简化单路电路的 Startup-1 在用户浏览器中显示完成；不是完整 A1 动态验收通过，也不是本地 ngspice/Xyce 求解器修复。制造 NOT RELEASED。**

## 来源与证据等级

- 用户消息：`Sentinel_9e5ec36404248191b04b01fbefe26d84`。
- 截图 Library ID：`libfile_1ce13802553081919363220fc8e4c025`。
- 父对话 `01a11840-6f67-76ca-b87a-1b09a71dc0e4` 已通过正式 Library materialize 并实际查看截图，将可见内容交给本任务记录；本任务没有再次获取或上传截图。
- 本记录依据父对话的实际看图摘要。尚未收到原始数值波形、运行日志、完整工程或模型/求解设置；未在本环境运行此 WEBENCH 作业。

## 截图可见结果

作业名 **Startup-1**，有完成勾选。页面 Performance Summary 显示：

| 页面指标 | 显示值 |
| --- | ---: |
| StartupTime | 5.03 ms |
| VoutAverage | 5.10 V |
| InductorMaxCurrent | 1.86 A |

Vin 曲线显示9 V；Vout平稳升至约5.1 V，约6 ms后可见短平台。截图范围内没有明显过冲。页面这些指标的计算阈值/统计窗口尚未核实；StartupTime不能直接等同于项目“首次达到4.75 V”的测量，VoutAverage不能代替全程最小/最大值，InductorMaxCurrent不能自动当作全时段绝对峰值。

## 截图中的电路与 A1 差异

| 项目 | 可见设置 | 解释 |
| --- | --- | --- |
| L1 | 10 µH、21.4 mΩ | 与A1对照使用的电感值/DCR典型值一致；截图值本身不证明完整MPN及非线性模型匹配 |
| Cout | 22 µF、6 mΩ、Qty=2 | 标称总容量44 µF；若6 mΩ按每颗定义，两颗并联为3 mΩ，匹配已有仿真的ESR假设，不是厂家实测ESR证明 |
| Rfbt / Rfbb | 100 kΩ / 13.3 kΩ | 与实际A1分压一致 |
| Cff | 75 pF | 与实际A1值一致 |
| BOOT 串联电阻 | 仍无49.9 Ω | 不同于实际A1 |
| EN 分压 | 仍无511 kΩ / 105 kΩ | 不同于实际A1；启动使能条件未等效 |

其他未获确认的元件、实际MPN、输入高频100 nF、完整寄生、负载模型、温度、初始条件、求解步长及数据导出精度，不从这张截图推断。Vin显示9 V不能证明已采用项目0–1 ms的0→9 V输入斜坡。没有双路同时启动证据，也没有12/18 ms负载阶跃或完整0–25 ms波形。

## 可接受的结论与后续

可以记录为：**用户 WEBENCH 中简化电路的一项启动作业完成，显示输出均值5.10 V，页面最大电感电流1.86 A。** 这提供了在线参考模型在当前简化配置下可以启动的证据。

不能据此宣布：完整A1通过、九工况通过、启动阈值已严格验收、稳态纹波合格、轻载/增载/卸载通过、热/保护通过，或本地求解器兼容问题已解决。截图分辨率不足以定量给出纹波或排除窄过冲。

当时父对话指导用户下载Startup-1结果并运行SteadyState。后续已收到[Steady State-2截图](user-steady-state-evidence.md)，该简化作业显示完成；仍无原始导出。收到实际导出后再核对时间范围、输入/负载设置、统计窗口及必要波形。补齐BOOT/EN等差异之前，后续结果继续标注“简化电路”，不改制造放行状态。
