gonewx/quadcuber/generated/electronics/simulation/report.md

# A1 电源检查：已运行边界模型，原厂降压仿真仍阻塞

> 历史基线：这些65工况对应F1/母线泄放修订之前的板。当前修订结果以 `generated/electronics/protection-analysis/report.md` 为准。
2026-10-12；硬件基准`0623d035d1f25a2090b16c538a17157a3c693715`。PCB及原理图没有修改。**本报告不是制造放行，也不是硬件测试。**

## 实际运行与证据

ngspice44.2实际完成65个瞬态工况：54个母线回灌、8个USB/外供电二极管汇流、3个入口上电/掉电。每个目录内有可重跑网表、日志及压缩波形。源/BOM哈希与运行版本见`run-status.json`。54个回灌工况的输入能量−TVS耗散−电容储能增量的最大绝对残差为**21.97µJ**，未钳位工况另通过`ΔV=IΔt/C`核查。

TPS54302原厂SLVMBL9A模型下载受执行环境HTTP403限制，独立复核得到相同结果。**原厂模型运行0次；降压启动、环路与负载跃变未验证。** 已准备严格读取实际BOM及原厂脚序的重跑脚本，但尚未用该模型实际验证脚本兼容性。下载日志、模型来源、未运行范围和重建方法见`electronics/simulation/`。

## 母线回灌

实际BOM六只470µF，共2820µF，扫描±20%容量。母线初值9V，外部电源断开、其他负载为零；注入恒定**母线电流**1/3/6.452A，脉冲5/20/100ms。6.452A来自4×1.613A驱动限流上界，**只是应力参数，不是四马达真实回灌电流预测**。缺少马达电感、反电动势、转速、机械惯量、PWM模式和损耗，不能从电机限流直接推算回灌能量。

Littelfuse SMBJ12A模型为13.3或14.7V拐点，至19.9V@30.2A的分段线性拟合。没有采用ST器件模型；该插值也不是Littelfuse保证的全曲线，无温升/老化/失效机制。

最小电容2256µF、14.7V拐点、6.452A注入：

|持续时间|VM峰值|TVS耗散能量|TVS峰值功率|
|---|---:|---:|---:|
|5ms|15.810V|0.304J|101.965W|
|20ms|15.811V|1.834J|102.012W|
|100ms|15.811V|9.995J|102.012W|

模型电压低于25V电容额定**不能判为保护通过**：热失效未建模，600W额定对应指定脉冲波形，不能证明100ms/重复脉冲承受能力。未纳入ESR/ESL/布线电感还会漏掉快速尖峰。12V是反向工作电压而非精确钳位；模型已显示马达可能经历高于9V电压。维持禁止持续外力反拖、优先慢衰减刹车及首板回灌测试要求。不能用静态TVS“始终钳住”结果解除HOLD。

## 输入切换与浪涌

入口以理想无延迟单向器件加3.3mΩ导通电阻近似LM74700+CSD18540，源电压100µs升到9V，VM2820µF，4A负载随电压建立。源串阻为敏感性假设，包含线缆/连接/电源等效阻抗，并非实际测量值。20ms输入降至0V。

|假设源串阻|峰值入口电流|0～15ms电流平方积分|19ms时VM|
|---|---:|---:|---:|
|50mΩ|123.62A|2.038A²s|8.787V|
|200mΩ|40.65A|0.814A²s|8.187V|
|500mΩ|17.27A|0.471A²s|6.987V|

这是没有源限流/电感/控制延迟时的边界，峰值不能当实际浪涌预测，积分包括负载电流，不能直接判定保险寿命。说明入口8A熔断器不是8A限流器、LM74700不是软启动器。首板需使用有限流的9V电源，测量热插拔浪涌并与0467008.NR重复脉冲/I²t及MOS SOA核对。保证降压端VM≥8V时，9V−2%源在6A下允许总直流压降仅0.82V，即总串阻须小于约137mΩ；电源限流引起的掉压另算。

理想模型反向电流为0是**构造假设**，不是LM74700关断延迟、反向恢复、漏电或故障安全验证。真正的输入倒灌瞬态仍待原厂模型或硬件示波。

## USB/外供电切换

两路5V、D2/D5各用`max((V_A−V_K−0.35)/0.2,0)`拟合，VSYS1.1µF，50/150mA负载。外供或USB掉电时，150mA最小VSYS约4.6195V，仍有1.3195V相对3.3V的输入余量。

这里只证明拟合条件下的二极管汇流方向及保持电压；SS14正向压降/漏电/结电容、PTC热阻、输入4.75V边界、LDO动态、USBLC6及DP/DM主机保护均未建模。“反向0A”不代表真实USB无回灌。USB硬件HOLD保留。

## 损耗与热：计算而非热仿真

`driver_thermal.csv`扫描电流0.5/1/1.352/1.481/1.613A、桥阻0.565/1.13Ω、θJA41.1/60/80°C/W、环境25/40/60°C。0.565Ω及41.1°C/W为器件典型/参考板，其他值是敏感性参数，**不是最坏保证值**。仅含导通损耗；未加开关损耗及四驱动、双降压的热耦合。例：1A、1.13Ω、80°C/W、40°C环境已得130.4°C，超过125°C设计目标，因此“1A持续预算”仍不是实测额定。

`ldo_thermal.csv`用DBV参考板231.1°C/W。150mA、VSYS4.65V、40°C环境估86.8°C；VSYS5.25V时107.6°C，60°C环境则127.6°C。5.25V是保守输入边界而非正常二极管后的预期值。需实测板级热阻和机箱环境。

`buck_thermal.csv`用TPS54302最新数据表118.9°C/W，保守把**全部变换损耗**归给芯片。5V1.5A、40°C环境，假设效率85/90/95%分别给197.4/139.1/86.9°C。真实损耗分布和θJA未知；此表不预测实际结温，只显示不能凭3A芯片额定承诺封闭机箱1.5A连续。按这一保守方法，40°C环境要低于125°C需总效率约≥91.3%，或降低有效热阻/负载。

## 尚未完成

1. 取得并核对TI原厂LIB许可/版本，实际运行双TPS54302模型；完成启动、输入、负载及电容容差矩阵，再扩展L/ESR/反馈容差。当前脚本只准备了9工况初筛，未执行。
2. 输入源限流、线缆电感、LM74700动态及MOS模型；TVS温度/脉宽/重复功率和实际马达机电参数。
3. 真实PCB/机箱热模型或硬件热测、USB数据线断电主机回灌、EV3针序/载流和安装托架实体验证。

没有擅自改器件/加大电容来掩盖未知条件；这些结果也不足以合理定出制动电阻或浪涌限制元件。保留已有制造HOLD，继续工作的具体阻塞是**TI模型文件获取**，不是用户缺少全套购买链接。
