gonewx/quadcuber/docs/b1-taobao-comparison.md

# B1 淘宝采购：兴佳与优信对比

核对日期：2026-10-14。兴佳为用户指定的新亚洲兴佳电子，优信为深圳市优信电子科技有限公司。

## 购物车状态

- 兴佳已加入并核对18种，商品小计 **¥28.72**。排母2条、100µF电解4只、470µF/25V电解2只，其余各1只或1包。
- 优信原19种保留，小计¥50.37；与兴佳这16种对应的部分是¥23.68。对应采购包装支出减少¥11.96，约50.5%。
- 不是同品牌同包装比较；电阻和二极管包装数量不同，部分芯片厂家不明。缺少的DRV8871等不纳入这个差额。
- 均不含运费，未提交订单或付款。兴佳商品页运费显示¥4，合单费用及优惠以结算为准。

## 对应项

|规格|兴佳采购数量|兴佳金额|优信采购数量|优信金额|兴佳链接|
|---|---:|---:|---:|---:|---|
|AMS1117-5.0 SOT-223|1只|¥0.05|1只|¥0.58|[商品](https://item.taobao.com/item.htm?id=582103232969)|
|100uF/25V 6.3x7.7mm 贴片电解|4只|¥0.20|4只|¥0.76|[商品](https://item.taobao.com/item.htm?id=590838711923)|
|220uF/25V 8x10.5mm 贴片电解|1只|¥0.17|1只|¥0.35|[商品](https://item.taobao.com/item.htm?id=590838711923)|
|470uF/16V 8x10.5mm 贴片电解|1只|¥0.17|1只|¥0.30|[商品](https://item.taobao.com/item.htm?id=590838711923)|
|470uF/25V 10x10.5mm 贴片电解|2只|¥0.50|2只|¥1.04|[商品](https://item.taobao.com/item.htm?id=590838711923)|
|SS14 SMA 40V 1A|1只|¥0.03|1×10只|¥1.41|[商品](https://item.taobao.com/item.htm?id=597044885463)|
|SS34 SMA 40V 3A|1只|¥0.08|1×10只|¥1.65|[商品](https://item.taobao.com/item.htm?id=597044885463)|
|2.54mm 1x20 单排直插排母|2只|¥0.30|2只|¥0.44|[商品](https://item.taobao.com/item.htm?id=567053063436)|
|LM2596S-5.0|1只|¥0.44|1只|¥4.99|[商品](https://item.taobao.com/item.htm?id=16340580059)|
|AO4407A SOIC-8|1只|¥0.10|1只|¥1.12|[商品](https://item.taobao.com/item.htm?id=18199180781)|
|SMBJ12A 单向 TVS SMB|1只|¥0.04|1只|¥0.14|[商品](https://item.taobao.com/item.htm?id=27267128760)|
|BZT52C12 SOD-123|1只|¥0.04|1×20只|¥2.51|[商品](https://item.taobao.com/item.htm?id=619495569501)|
|0805 10kΩ 1%|1×100只|¥1.20|1×50只|¥1.68|[商品](https://item.taobao.com/item.htm?id=595300481143)|
|0805 20kΩ 1%|1×100只|¥1.20|1×50只|¥1.68|[商品](https://item.taobao.com/item.htm?id=595300481143)|
|0805 220Ω 1%|1×100只|¥1.20|1×50只|¥1.68|[商品](https://item.taobao.com/item.htm?id=17397977463)|
|2512 300Ω 1% 1W|1×50只|¥6.00|1×10只|¥3.35|[商品](https://item.taobao.com/item.htm?id=705783428158)|

## 未加入的四项

- **DRV8871DDAR**：店内DRV8871搜索0件。
- **0805 43.2kΩ 1%**：43.2K店内搜索仅0603，无0805，未替换。
- **33uH 功率电感**：CD127R候选0.28元缺额定电流和端子图，未加入。 [候选商品](https://item.taobao.com/item.htm?id=580433714675)
- **1206 8A 慢断保险丝**：1206保险丝搜索12项，无匹配8A慢断；自恢复及1808快断不替换。

## 规格与比价限制

- LM2596S-5.0选管装单只¥0.44，厂家未明确，不能视为优信TI品牌款的同品牌替代。AO4407A页面品牌为“其他”。按标称型号加入，未验证原厂来源。
- 兴佳电解页面明确6×7对应6.3×7.7mm、8×10对应8×10.5mm、10×10对应10×10.5mm；尺寸匹配，ESR、寿命和原厂型号未完整提供。
- 2512、300Ω、1W兴佳50只¥6，优信10只¥3.35；本次只需要2只，优信整包支出更低。
- 33µH电感未因封装名相同就替换：优信有3A参数表及端子图，兴佳候选缺相同证据。
- 已购Pico H、DC005、EV3插座、0805 0.1µF和可裁切直插排针继续排除，不重复补购。
- 两店购物车是供选择的备选组，下单时不要将两组同用途元件一起购买。

优信逐项记录见 [原采购记录](b1-taobao-procurement.md)。

## 用户确认追加的陶瓷电容

|规格|包装及数量|购物车金额|链接|
|---|---|---:|---|
|0805 10µF/25V|100只装×1|¥7|[商品](https://item.taobao.com/item.htm?id=35730083224)|
|0805 22µF/25V|100只装×1|¥10|[商品](https://item.taobao.com/item.htm?id=38794914130)|

两项均已核对购物车数量为1包。10µF款标题写¥6，实际购物车显示¥7，按实际显示记录。新增¥17，兴佳18种合计¥28.72，不含运费。原16项对比金额仍为¥11.72对¥23.68。
