gonewx/quadcuber/docs/b1-taobao-final-recommendation.md

# B1最终采购建议：补查后的四店方案

核对日期：2026-10-14。一块B1板，排除已购库存；以下为本次已核对商品价格，未含运费和结算优惠。

## 推荐四店，22种合计 ¥20.45

|店铺|种类|商品小计|
|---|---:|---:|
|有源芯片科技|1|¥8.00|
|优信|2|¥5.03|
|新亚洲兴佳|12|¥5.00|
|易鑫天诚|7|¥2.42|
|合计|22|¥20.45|

DRV8871按用户指定改为有源芯片科技 ¥2/只、4只 ¥8，商品页显示包邮；相对上一轮已勾选方案 ¥36.93 再省 ¥16.48。已重新勾选四店22种商品，购物车实际显示 ¥20.45；未含最终运费。

这次按用户指定的方法，在淘宝搜索型号，找到带技术文档的商品，再对照芯片照片、丝印、电压后缀和封装。LM2596S-5.0、AMS1117-5.0、AO4407A均可按同标称型号采购，采用兴佳低价选项。图片支持型号判断，不等于实物批次或原厂来源鉴定。详见[照片与资料核对](b1-taobao-model-verification.md)。

## 逐店采购清单

### 有源芯片科技

|规格|购买数量|金额|链接|
|---|---:|---:|---|
|DRV8871DDAR|4只|¥8.00|[商品](https://item.taobao.com/item.htm?id=709820684573)|

### 优信

|规格|购买数量|金额|链接|
|---|---:|---:|---|
|0805 43.2kΩ 1%|1包，每包50只|¥1.68|[商品](https://item.taobao.com/item.htm?id=526088038633)|
|2512 300Ω 1% 1W|1包，每包10只|¥3.35|[商品](https://item.taobao.com/item.htm?id=657420081181)|

### 新亚洲兴佳

|规格|购买数量|金额|链接|
|---|---:|---:|---|
|AMS1117-5.0 SOT-223|1只|¥0.05|[商品](https://item.taobao.com/item.htm?id=582103232969)|
|100uF/25V 6.3x7.7mm 贴片电解|4只|¥0.28|[商品](https://item.taobao.com/item.htm?id=590838711923)|
|SS14 SMA 40V 1A|1只|¥0.03|[商品](https://item.taobao.com/item.htm?id=597044885463)|
|SS34 SMA 40V 3A|1只|¥0.08|[商品](https://item.taobao.com/item.htm?id=597044885463)|
|2.54mm 1x20 单排直插排母|2只|¥0.34|[商品](https://item.taobao.com/item.htm?id=567053063436)|
|LM2596S-5.0|1只|¥0.44|[商品](https://item.taobao.com/item.htm?id=16340580059)|
|AO4407A SOIC-8|1只|¥0.10|[商品](https://item.taobao.com/item.htm?id=18199180781)|
|SMBJ12A 单向 TVS SMB|1只|¥0.04|[商品](https://item.taobao.com/item.htm?id=27267128760)|
|BZT52C12 SOD-123|1只|¥0.04|[商品](https://item.taobao.com/item.htm?id=619495569501)|
|0805 10kΩ 1%|1×100只|¥1.20|[商品](https://item.taobao.com/item.htm?id=595300481143)|
|0805 20kΩ 1%|1×100只|¥1.20|[商品](https://item.taobao.com/item.htm?id=595300481143)|
|0805 220Ω 1%|1×100只|¥1.20|[商品](https://item.taobao.com/item.htm?id=17397977463)|

### 易鑫天诚

|规格|购买数量|金额|链接|
|---|---:|---:|---|
|0805 10uF/25V X7R ±10%|1只|¥0.12|[商品](https://item.taobao.com/item.htm?id=874400905935)|
|0805 22uF/16V X5R ±10%|1只|¥0.15|[商品](https://item.taobao.com/item.htm?id=874400905935)|
|220uF/25V 8x10.5mm 贴片电解|1只|¥0.12|[商品](https://item.taobao.com/item.htm?id=898487995009)|
|470uF/25V 10x10.5mm 贴片电解|2只|¥0.34|[商品](https://item.taobao.com/item.htm?id=898487995009)|
|470uF/16V 8x10.5mm 贴片电解|1只|¥0.12|[商品](https://item.taobao.com/item.htm?id=899607976823)|
|SLF12575T-330M3R2-PF 33uH/3.2A|1只|¥1.50|[商品](https://item.taobao.com/item.htm?id=878275918982)|
|1206 8A 32V 保险丝（丝印M）|1只|¥0.07|[商品](https://item.taobao.com/item.htm?id=864145601084)|

## 本轮调整

- LM2596S-5.0：优信 ¥4.99 → 兴佳 ¥0.44，省 ¥4.55。
- AO4407A：易鑫天诚 ¥0.35 → 兴佳 ¥0.10，省 ¥0.25。
- 100µF/25V、6.3×7.7mm 电解4只：兴佳现价 ¥0.28，与易鑫天诚持平；按已选清单留在兴佳。
- AMS1117-5.0：补充照片与技术文档对照，保留兴佳 ¥0.05。

## 保留的选择与限制

- TDK电感保留 SLF12575T-330M3R2-PF，33µH、¥1.50；完整料号及电流参数已核对。B1焊盘不等同于TDK推荐焊盘，装配前应试放。该系列已公告停产，本次按店铺现货采购。
- 保险丝沿用用户接受的1206、8A、32V、丝印M款，¥0.07；完整原厂料号和慢断曲线仍未确认，不能从字母M直接推断慢断。
- 电解电容按容量、耐压与外形尺寸选择；ESR和寿命未有完整原厂证据。
- 兴佳100只装陶瓷电容不选；易鑫天诚单只购买足够本次用量。
- 已购0.1µF/0805、排针、Pico H、DC005、EV3插座不重复购买。
- 用户要求直接移除不需要的备选，本轮按最终22种清单清理重复商品；未提交订单或付款。

## 购物车执行状态

有源芯片科技 DRV8871DDAR 已加入并核对数量为4只。已分批移除26种被替代的本轮备选，购物车总项数从73降至47。本轮四店仅剩22种，已全部勾选，商品总价和合计均显示 ¥20.45。原有其他购物车商品已核对保持不变。未下单或付款。

原始记录：[优信](b1-taobao-procurement.md)、[兴佳](b1-taobao-comparison.md)、[易鑫天诚](b1-taobao-yixintiancheng.md)。
