gonewx/quadcuber/docs/b1-taobao-procurement.md

# B1 载板淘宝采购记录

核对日期：2026-10-14。按一块 B1 板的 `generated/electronics-b1/bom-hand-solder.csv` 采购。本记录对应当时优先在**深圳市优信电子科技有限公司**采购的阶段；后续已按用户要求增加兴佳、易鑫天诚比较，最新选择见[最终采购建议](b1-taobao-final-recommendation.md)。尚未提交订单或付款。

## 当前购物车

本任务保留 **19 种规格**，均来自深圳市优信电子科技有限公司，商品小计 **¥50.37**，不含运费及结算优惠。原先跨店的 4 项已移除；临时加入的两份三星电容大包装也已移除。电容两项及保险丝一项尚未补齐，不能据此直接完成整板装配。

| 型号／规格 | 加购份数 | 每份数量 | 每份价格 | 小计 |
|---|---:|---:|---:|---:|
| [DRV8871DDAR](https://item.taobao.com/item.htm?id=721186324693) | 4 | 1 | ¥6.12 | ¥24.48 |
| [LM2596S-5.0](https://item.taobao.com/item.htm?id=522577612783) | 1 | 1 | ¥4.99 | ¥4.99 |
| [0805 43.2kΩ 1%](https://item.taobao.com/item.htm?id=526088038633) | 1 | 50 | ¥1.68 | ¥1.68 |
| [0805 10kΩ 1%](https://item.taobao.com/item.htm?id=526088038633) | 1 | 50 | ¥1.68 | ¥1.68 |
| [0805 20kΩ 1%](https://item.taobao.com/item.htm?id=526088038633) | 1 | 50 | ¥1.68 | ¥1.68 |
| [100uF/25V 6.3x7.7mm 贴片电解](https://item.taobao.com/item.htm?id=522577508778) | 4 | 1 | ¥0.19 | ¥0.76 |
| [2512 300Ω 1% 1W](https://item.taobao.com/item.htm?id=657420081181) | 1 | 10 | ¥3.35 | ¥3.35 |
| [AMS1117-5.0 SOT-223](https://item.taobao.com/item.htm?id=522575569083) | 1 | 1 | ¥0.58 | ¥0.58 |
| [AO4407A SOIC-8](https://item.taobao.com/item.htm?id=619612296393) | 1 | 1 | ¥1.12 | ¥1.12 |
| [220uF/25V 8x10.5mm 贴片电解](https://item.taobao.com/item.htm?id=522577488785) | 1 | 1 | ¥0.35 | ¥0.35 |
| [470uF/16V 8x10.5mm 贴片电解](https://item.taobao.com/item.htm?id=522554799510) | 1 | 1 | ¥0.30 | ¥0.30 |
| [470uF/25V 10x10.5mm 贴片电解](https://item.taobao.com/item.htm?id=522577620507) | 2 | 1 | ¥0.52 | ¥1.04 |
| [SMBJ12A 单向 TVS SMB](https://item.taobao.com/item.htm?id=1082115177422) | 1 | 1 | ¥0.14 | ¥0.14 |
| [BZT52C12 SOD-123](https://item.taobao.com/item.htm?id=677727797694) | 1 | 20 | ¥2.51 | ¥2.51 |
| [SS14 SMA 40V 1A](https://item.taobao.com/item.htm?id=642255079751) | 1 | 10 | ¥1.41 | ¥1.41 |
| [SS34 SMA 40V 3A](https://item.taobao.com/item.htm?id=522552855619) | 1 | 10 | ¥1.65 | ¥1.65 |
| [0805 220Ω 1%](https://item.taobao.com/item.htm?id=525978606290) | 1 | 50 | ¥1.68 | ¥1.68 |
| [2.54mm 1x20 单排直插排母](https://item.taobao.com/item.htm?id=522579376259) | 2 | 1 | ¥0.22 | ¥0.44 |
| [CDRH127 33uH 3A 12.5x12.5x8mm（最大尺寸）](https://item.taobao.com/item.htm?id=522553835885) | 1 | 1 | ¥0.53 | ¥0.53 |

## 尚未补齐的三项

| 需求 | 本次复核结果 |
|---|---|
| C5：0805、10µF／25V，1只 | 优信有三星 CL21X106KAYNNNE，页面 ¥13；三星系列链接选中同规格也为 ¥13，风华系列选中10µF／25V为 ¥16。尚未找到符合要求的小包装。 |
| C6：0805、22µF／16V，1只 | 三星 CL21A226MOQNNNE 链接明确50只，页面 ¥20.01。另查25V候选，三星页面 ¥50，风华页面 ¥39.80，均未找到更小包装。 |
| F1：1206、8A、慢断，1只 | 店内“1206 保险丝”找到慢断系列，选项只有1/2/3/4/5/7A；“8A 保险丝”搜索返回0件。未擅自改成7A、自恢复或快断。 |

可复核的优信链接：

- [三星10µF／25V](https://item.taobao.com/item.htm?id=673096547451)
- [三星22µF／16V，50只](https://item.taobao.com/item.htm?id=620083527217)
- [三星0805电容系列](https://item.taobao.com/item.htm?id=537816489806)
- [风华0805电容系列](https://item.taobao.com/item.htm?id=638305767496)
- [1206慢断保险丝系列，最高7A](https://item.taobao.com/item.htm?id=585414757643)

已检查店内22uf搜索的前三页、相关0805品牌系列选项及独立商品链接。搜索没有找到不代表店铺绝无此货；小包装与8A保险丝仍需可核实的商品链接或商家配货信息。未联系卖家。

## 电感核对

优信 [CDRH127系列](https://item.taobao.com/item.htm?id=522553835885) 的33µH选项已加入，SKU为4554697578475，单价¥0.53。此前只查到磁环款属于搜索遗漏，已纠正。

页面参数表的33µH对应 CTCDRH127F-330M，DCR最大64.8mΩ、IDC最大3.00A；尺寸图为外形最大12.5×12.5mm、高度最大8mm，端子宽5.0±0.2mm、内间距7.6±0.2mm。现有焊盘中心±4.95mm、尺寸2.9×5.4mm，内间距7.0mm，尺寸上可覆盖端子。此判断基于商家提供的图表，尚未测量实物，也未取得独立饱和曲线。

## 已购排除项

- 0805 0.1µF／50V（104）：历史订单有100只装，本次不重复买；一板需5只。
- 2.54mm单排直针40P：历史订单有购入，可截出5段1×3，本次不重复买。
- Pico H、DC-005电源座、同批EV3插座：按已知库存排除。
- LM2596模块、其他型号驱动模块、直插电容和直插二极管套装，不作为对应贴片器件替代。

历史购买记录不能证明目前剩余数量，焊接前取出库存确认。价格以页面显示为准，运费和优惠未进入结算页确认。
