gonewx/quadcuber/docs/b1-taobao-yixintiancheng.md

# B1采购：易鑫天诚核对记录

店铺：深圳市易鑫天诚电子。核对日期：2026-10-14。按同一B1缺件清单完成店内查找；保留优信、兴佳商品供用户比较。

## 已加入购物车

已加入并逐项核对 **10种，共14只，商品小计¥3.85**。未下单、未付款；购物车原有商品未删除。运费未计入，商品页显示¥1，实际合单费用以结算为准。

|规格|数量|单价|金额|链接|
|---|---:|---:|---:|---|
|0805 10uF/25V X7R ±10%|1只|¥0.12|¥0.12|[商品](https://item.taobao.com/item.htm?id=874400905935)|
|0805 22uF/16V X5R ±10%|1只|¥0.15|¥0.15|[商品](https://item.taobao.com/item.htm?id=874400905935)|
|LM2596S-5.0|1只|¥0.80|¥0.80|[商品](https://item.taobao.com/item.htm?id=861788895833)|
|AO4407A SOIC-8（UMW）|1只|¥0.35|¥0.35|[商品](https://item.taobao.com/item.htm?id=889777550248)|
|100uF/25V 6.3x7.7mm 贴片电解|4只|¥0.07|¥0.28|[商品](https://item.taobao.com/item.htm?id=898487995009)|
|220uF/25V 8x10.5mm 贴片电解|1只|¥0.12|¥0.12|[商品](https://item.taobao.com/item.htm?id=898487995009)|
|470uF/25V 10x10.5mm 贴片电解|2只|¥0.17|¥0.34|[商品](https://item.taobao.com/item.htm?id=898487995009)|
|470uF/16V 8x10.5mm 贴片电解|1只|¥0.12|¥0.12|[商品](https://item.taobao.com/item.htm?id=899607976823)|
|SLF12575T-330M3R2-PF 33uH/3.2A|1只|¥1.50|¥1.50|[商品](https://item.taobao.com/item.htm?id=878275918982)|

## 与兴佳对应8项对比

以下不含电感，因兴佳没有已确认可用并加购的电感。芯片厂家未必相同，陶瓷电容包装数量及22µF耐压不同，比较的是本次所选包装支出。

|规格|易鑫天诚|兴佳|说明|
|---|---:|---:|---|
|10µF陶瓷，0805/25V|1只¥0.12|100只¥7|易鑫天诚可单只买|
|22µF陶瓷，0805|16V 1只¥0.15|25V 100只¥10|两种均满足BOM最低耐压，介质/厂家并非完全一致|
|LM2596S-5.0|1只¥0.80|1只¥0.44|厂家未明确，兴佳便宜|
|AO4407A|UMW 1只¥0.35|厂家未明确1只¥0.10|不同厂家，兴佳标价低|
|100µF/25V，6.3×7.7mm|4只¥0.28|4只¥0.20|兴佳便宜|
|220µF/25V，8×10.5mm|1只¥0.12|1只¥0.17|易鑫天诚便宜|
|470µF/16V，8×10.5mm|1只¥0.12|1只¥0.17|易鑫天诚便宜|
|470µF/25V，10×10.5mm|2只¥0.34|2只¥0.50|易鑫天诚便宜|
|合计|**¥2.28**|**¥18.58**|差额¥16.30，主要来自陶瓷电容的包装数量|

## 未加入的12项

### 未找到对应规格（8项）

- **DRV8871DDAR**：店内搜索无结果。
- **AMS1117-5.0 SOT-223**：AMS1117搜索只见SOT-89，与板不匹配。
- **0805 10kΩ 1%**：0805电阻及电阻店内搜索未见对应贴片电阻。
- **0805 20kΩ 1%**：0805电阻及电阻店内搜索未见对应贴片电阻。
- **0805 220Ω 1%**：0805电阻及电阻店内搜索未见对应贴片电阻。
- **0805 43.2kΩ 1%**：0805电阻及电阻店内搜索未见对应贴片电阻。
- **2512 300Ω 1W 1%**：0805电阻及电阻店内搜索未见对应贴片电阻。
- **2.54mm 1x20 单排直插排母**：排母搜索未找到对应直插款；有弯针、2.0mm直母及圆孔款，不替换。

### 只有整盘选项（4项）

|型号|包装|页面价格|链接|
|---|---:|---:|---|
|SS14 SMA|2000只/盘|系列起价¥60，未确认该SKU单独价格|[商品](https://item.taobao.com/item.htm?id=799393524563)|
|SS34 SMA|2000只/盘|系列起价¥60，未确认该SKU单独价格|[商品](https://item.taobao.com/item.htm?id=799393524563)|
|SMBJ12A SMB|750只/盘|¥42|[商品](https://item.taobao.com/item.htm?id=789784361528)|
|BZT52C12 SOD-123|3000只/盘|¥64|[商品](https://item.taobao.com/item.htm?id=802500200716)|

单板各需1只，未为比较而加入数百至数千只的整盘商品。前两店的小包装已保留。

## 电感核对依据

新增[TDK SLF12575T-330M3R2-PF](https://item.taobao.com/item.htm?id=878275918982)，1只¥1.50。优信CDRH127 33µH/3A为¥0.53，两者不同型号、厂家，不能作为同品牌价格比较。

[TDK原厂规格](https://product.tdk.com/en/search/inductor/inductor/smd/info?part_no=SLF12575T-330M3R2-PF)给出33µH±20%、电感下降10%对应3.2A、温升40°C对应典型3.4A，外形12.5±0.3mm见方、高7.5±0.35mm。页面附带尺寸图显示端子2×3mm、内间距8.5mm。

B1当前焊盘中心x=±4.95mm，单焊盘2.9×5.4mm，对应x范围±[3.5,6.4]mm。按标称尺寸，电感端子x范围±[4.25,6.25]mm、宽3mm，能落在焊盘内。该判断是图纸几何核对；B1焊盘不等同于TDK推荐焊盘，收到实物仍需试放确认。未对卖家的原厂来源做独立验证。

TDK已公告该系列停产：最后接单日2026-03-31、最后出货日2026-12-31；本次备选为店铺现货。

## 其他规格限制

普通LM2596S-5.0厂家未明确；AO4407A为UMW。电解容量、耐压、外形尺寸匹配，但ESR与寿命未完整提供。
已购Pico H、DC005、EV3插座、0805 0.1µF和可裁切排针继续排除。三店购物车是备选，不应把相同用途的三组元件一起下单。

## 用户确认追加保险丝

用户明确要求无需继续处理丝印差异，加入该商品。已加入并核对[1206、8A、32V保险丝](https://item.taobao.com/item.htm?id=864145601084)1只，SKU“1206-8A 丝印M 熔断”，价格¥0.07。当前该店10种、14只，合计¥3.85，不含运费，未下单。

页面选项丝印M与所附CC12H8A资料的V仍不一致；记录用户接受该差异，不将M解释为慢断的通用标识。
