gonewx/quadcuber/docs/perfboard.md

# 单臂洞洞板：可拔插的逐孔安装与焊接图

> **2026-09-27 更新：编码器改用电阻分压**（每路 10kΩ 串联 + 20kΩ 接地，分压点在面包板第 26、28 列），不用电平转换模块。原因见 [接口复核报告](ev3-interface-verification.md)。

打开 [实物装配页面](wiring/perfboard.html)：可以切换**元件面、镜像焊接面、电源与拔插结构、面包板连接、舵机与马达**，点击 W01～W14 单独查看一根线，还可下载五张 SVG 矢量图。

本文件和图纸由 `docs/wiring/perfboard_layout.py` 的同一份孔位数据生成，运行 `python3 docs/wiring/build.py` 更新。

## 1. 本版确定的结构

- **模块全部可拔插。** 洞洞板上只焊插拔端子底座、排母、J5 排针和配线。DRV8833 和降压模块焊上排针后插入排母，不焊死在洞洞板上。
- **不用螺钉和支柱安装降压模块。** 四角针脚插入四个排母座，外部线束留松弛并固定，插拔时扶住底座。
- **不另装电容。** 模块原有的去耦／滤波电容保留。是否需要增加储能电容，留待实物供电与运行情况决定，本版没有外接电容或电容插座。
- J1、J4 使用 **5.08mm 插拔式接线端子**，由板上直针底座和可整块拔出的螺钉插头组成；不是必须逐根拧螺钉才能拆下的固定式端子。
- Pico 与编码器分压电阻仍放在面包板，Pico 由 USB 供电；J6 只给编码器电源及公共地连接供电，不接 Pico 的 VBUS、VSYS、3V3。

## 2. 图纸基准与朝向

**孔阵：32 列 × 24 行，2.54mm 孔距。** 选至少有这块完整孔阵的独立焊盘洞洞板（约 90 × 70mm），从选定的左上第一孔开始标 A1。列号向右增加，行号 A～X 向下增加。端子孔距 5.08mm，即隔一个孔装一脚。

**U1：用户手上的 DRV8833，脚序已由用户确认。** 左侧自上而下为 `VM、NC、GND、AO1、AO2、BO2、BO1、GND`；右侧为 `NC、AIN2、AIN1、STBY、BIN1、BIN2、NC、GND`。按这个朝向放置，左上 VM、右上 NC；不再套用其他厂商的脚序。两排各 8 针，针距按 2.54mm，机械排距暂按 **10.16mm（4 个孔距）** 绘制；焊接前用实物模块对齐排母，如排距不同再调整。模块下面的针座要留出元件空间，不能让焊点或器件碰到洞洞板。

**U2：DSN5000 / XL4005。** 外形按约 44 × 22mm 的模块绘制，电感、电位器朝上；四角电源焊孔假定横向相距 **38.1mm（15 个孔距）**、纵向相距 **15.24mm（6 个孔距）**，各焊一根向下的排针。此孔距是本版明确选定的机械假设，并非 XL4005 统一标准。若实物焊孔不匹配，只调整四个排母位置及相应焊线；不要硬掰模块插入。电路外形图中的芯片、电感等仅用于辨认，焊孔和电源标注才是接线依据。

把红三角标在 A1 附近。看背面时像翻书一样**左右翻板，A 行仍在上方**：红三角到了右上角，列号从左往右为 32～1。孔名不变，例如正面的 C3，在背面仍叫 C3，不能重新从左边数第 3 孔。

## 3. 元件插入孔位

| 编号 | 器件 | 孔位 | 朝向／连接 |
| --- | --- | --- | --- |
| J1 | 5.08mm 插拔端子，2 位（底座+插头） | 1=C3 (+9V)；2=C5 (GND) | 进线口朝上板边 |
| J4 | 5.08mm 插拔端子，2 位（底座+插头） | 1=V3 (M1)；2=V5 (M2) | 进线口朝下板边 |
| J2 / J3 | U2 四角电源排母（4 个分立 1 针座） | J2.1=I16 IN+；J2.2=O16 IN−；J3.1=I31 OUT+；J3.2=O31 OUT− | 横向 15 孔距，纵向 6 孔距；排母单触点额定电流需满足负载 |
| U2 | DSN5000 / XL4005 模块 + 四根向下排针 | 四角插入 I16、O16、I31、O31 | 电感、电位器朝上；图中模块机械尺寸是明确假设 |
| U1 | 用户 DRV8833 + 两排 1×8 排母 | 左 I9～P9；右 I13～P13 | 左上 VM、右上 NC；排距暂按10.16mm，单触点额定电流满足负载 |
| J5 | 2.54mm 1×3 公排针 | 1=V23 GND；2=V24 +5V；3=V25 SIG | 配舵机三孔母头，先核对线序 |
| J6 | 2.54mm 1×2 排母 | 1=V15 +5V；2=V16 GND | 配面包板公头引线，仅小电流支路 |
| J7 | 2.54mm 1×4 排母 | 1=V9；2=V10；3=V11；4=V12 | 配Pico公头线，1/2/3/4接GP2/GP3/GP8/3V3 |

J2/J3 是降压模块的四个针座编号，不再是接往板外降压模块的接线端子。J2 为输入侧，J3 为输出侧。

## 4. 背面逐根焊线

每根线只在起点、终点焊接；中间途经孔仅指示绝缘导线的走向，不剥皮、不焊接。交叉位置保留绝缘，其中一根从另一根上方跨过。底座的所有针脚先焊在各自独立焊盘上，图中彩线端头带彩色中心的银色圆是导线焊点；未接线的针脚只作底座固定，不与其他孔连锡。

| 线号 | 起点／孔 | 终点／孔 | 途经（不焊） | 用途 |
| --- | --- | --- | --- | --- |
| W01 | J1.1 / C3 | U1.VM / I9 | F3 → F7 → G7 → G9 | 9V → 驱动 VM |
| W02 | J1.1 / C3 | J2.1 / I16 | E3 → E16 | 9V → 降压输入 |
| W03 | J1.2 / C5 | U1.GND_9_16 / P9 | D5 → D8 → P8 | 驱动地单独回电源入口 |
| W04 | J1.2 / C5 | J2.2 / O16 | F5 → F18 → O18 | 电源地 → 降压 IN− |
| W05 | J3.1 / I31 | J5.2 / V24 | I32 → R32 → R24 | 5V → 舵机电源 |
| W06 | J3.1 / I31 | J6.1 / V15 | H31 → H29 → T29 → T15 | 5V → 面包板小电流支路 |
| W07 | J3.2 / O31 | J5.1 / V23 | O30 → U30 → U23 | 舵机地单独回降压 OUT− |
| W08 | J3.2 / O31 | J6.2 / V16 | P31 → P28 → S28 → S16 | 面包板公共地 |
| W09 | U1.AO1 / L9 | J4.1 / V3 | L3 | 驱动 AOUT1 → 马达 M1 |
| W10 | U1.AO2 / M9 | J4.2 / V5 | M5 | 驱动 AOUT2 → 马达 M2 |
| W11 | J7.1 / V9 | U1.AIN1 / K13 | R9 → R14 → K14 | GP2 → AIN1 |
| W12 | J7.2 / V10 | U1.AIN2 / J13 | Q10 → Q15 → J15 | GP3 → AIN2 |
| W13 | J7.3 / V11 | J5.3 / V25 | W11 → W25 | GP8 → 舵机信号 |
| W14 | J7.4 / V12 | U1.STBY / L13 | S12 → S11 → L11 | Pico 3V3 → STBY 使能 |

W01～W04 是电源入口分支；W05～W08 是降压输出分支；W09～W10 是电机输出；W11～W13 是控制信号，W14 是 STBY 的 3.3V 使能线。两条马达输出都不能接 GND 或 9V。

## 5. 面包板与洞洞板连接

见 [两板实际连线图](wiring/perfboard-bridge.svg)，或在装配页面选择“④ 面包板连接”。六根线均为公对公跳线，板上接口 J6/J7 是排母。

| 线号 | 洞洞板接口／孔位 | 面包板孔位 | 用途 |
| --- | --- | --- | --- |
| B01 | J6.1 / V15 | 上排 + 第8孔 | 降压5V → 编码器电源 |
| B02 | J6.2 / V16 | 上排 − 第9孔 | 公共地 |
| B03 | J7.1 / V9 | j6 | Pico GP2 → AIN1 |
| B04 | J7.2 / V10 | j7 | Pico GP3 → AIN2 |
| B05 | J7.3 / V11 | j13 | Pico GP8 → 舵机信号 |
| B06 | J7.4 / V12 | a7 | Pico 3V3 → STBY |

a7、b7、c7 是同一列上半侧的连通组，c7 是 Pico 3V3，STBY 的 3.3V 线插 a7。编码器分压电阻和跳线按[接线指南](wiring/index.html#breadboard)插；上下地轨与电源轨中间断口按原图连接。

### 舵机与马达完整接线

见 [完整实物连线图](wiring/perfboard-loads.svg)，或选择“⑤ 舵机与马达”。图中保留两块板之间的六根线，同时补上 EV3 六芯线与舵机三芯线。

| 线号 | 设备线端 | 常见颜色／功能 | 接入点／孔位 | 去向 |
| --- | --- | --- | --- | --- |
| E1 | EV3 1脚 | 白 / M1 | J4.1 / V3 | AO1 → 马达端1 |
| E2 | EV3 2脚 | 黑 / M2 | J4.2 / V5 | AO2 → 马达端2 |
| E3 | EV3 3脚 | 红 / GND | T-37 | 面包板上排 − 第37孔 |
| E4 | EV3 4脚 | 绿 / 5V | T+36 | 面包板上排 + 第36孔 |
| E5 | EV3 5脚 | 黄 / A相 | h33 | 10kΩ → 分压点第26列 → GP4 |
| E6 | EV3 6脚 | 蓝 / B相 | h31 | 10kΩ → 分压点第28列 → GP5 |
| S1 | 舵机 GND | 棕 / GND | J5.1 / V23 | 地；洞洞板 V23 |
| S2 | 舵机 V+ | 红 / 5V | J5.2 / V24 | 5V；洞洞板 V24 |
| S3 | 舵机 SIG | 黄 / SIG | J5.3 / V25 | GP8 信号；洞洞板 V25 |

EV3 线色只作常见配色参考，必须先确认脚号；红色对应编码器地，不是正极。编码器 A/B 各经 10kΩ 串联、20kΩ 接地分压后去 GP4/GP5，不能直接把 5V 信号接 Pico。面包板上排 +36、−37 和 h33、h31 是 EV3 线的接线孔。

马达两根驱动线接 J4 的可拔端子；四根编码器线经公头转接线插面包板。舵机自带三孔母头直接插 J5 公排针，1=棕 GND、2=红 5V、3=黄 SIG，先核对线序后再插。裸线需使用合适的压接／转接连接，不能将多股散线直接塞进面包板。

### 其他板外插线

- DC-005 插座中心针对应的焊脚（确认供电为中心正极）→ 线式保险丝 F1 → 直流开关 SW1 → J1.1；插座负极 → J1.2。插座型号为用户已有的 DC-005、5.5 × 2.1mm；中心针接电源正极，外套接负极，第三个切换脚留空并绝缘。断电插入一个未供电的 DC 插头，用万用表找出与中心、外套相通的焊脚，不能凭通用编号猜针脚。不同 DC-005 版本有差异，孔距不按 2.54mm 强插。插座引出短线到可拔 J1 插头，本体固定在绝缘底板或机架上，整套可拆换，不焊死在主洞洞板上。保险丝及开关在板外线束上，不占洞洞板孔位。
- J4.1 / J4.2 → EV3 线 1 / 2 脚（马达两端）。
- J5.1 / J5.2 / J5.3 → 舵机 GND / +5V / 信号；按舵机实际线序制作可拔转接线。
- J6.1 / J6.2 → 面包板上排 + / − 电源轨。
- J7.1 → j6（GP2）；J7.2 → j7（GP3）；J7.3 → j13（GP8）；J7.4 → a7（Pico 3V3，物理36脚）。公头排针线插入板上 J7 排母。
- EV3 线 3、4 脚仍接面包板 GND、5V；5、6 脚经电阻分压接 GP4、GP5，详见 [单臂接线](single_arm.md)。

STBY 经 W14 接 Pico 3V3，不接 9V。NC 保持悬空，B 路输出留空。驱动电源、信号和电机均按本页用户确认的脚序连接。

## 6. 排针、配线与验收

1. 接口匹配：线端公针配板上排母（J6/J7），线端母孔配板上公排针（J5）；模块公排针配 U1/U2 排母。先焊连接器底座，模块都先拔下。两排 U1 排母可借助尚未通电的模块对齐后点焊定位，再拔下模块完成焊接。U2 四角排母同样先按实物孔距定位。
2. 电源排针／排母的**单触点额定电流**必须覆盖该支路实际负载。不要用无规格、松动的杜邦插头承载舵机总电流；额定不足就换合适的连接器，模块仍保持可拆换。DSN5000 标称“5A”不代表当前散热条件下能持续输出 5A。
3. 单臂短线的主电源可从 0.5～0.75mm² 铜线评估，马达／舵机分支可从 0.3～0.5mm² 评估，最终按电流、压降、温升及端子允许线径确认。电源不通过普通细排线；配电不靠长串锡桥。螺钉插头按其规格压接线端，跨线全程绝缘。
4. 按 W01～W14 逐根焊线，断开 9V、USB，拔下模块，用万用表核对每根线首尾导通，以及不同网络之间无短路。图中铜焊盘彼此独立，不等同于面包板内部连通。
5. 确认 U2 的 IN− 与 OUT− 为公共地，再只插 U2，空载调到 5.0V，检查 J5.2、J6.1 对各自地约为 5V。调压后断电，等待模块自带电容放电。
6. 插 U1、接控制线及编码器，Pico 用 USB。先测马达，再断电接舵机，按 [单臂测试](single_arm.md#5-测试步骤) 操作。每次插拔或改线都断开 9V 和 USB。
7. 运行时检查驱动、降压、针座和导线的温升、压降及接触稳定性。DRV8833 工作电压不超过 10.8V；电机刹车回灌可能造成瞬态上升，普通万用表不一定能捕捉。本版不增加电容，不等于已验证所有负载下供电都稳定。
8. 板底加绝缘底板，避免裸焊点接触导电物；线束固定在底板或机架上，插拔时扶住连接器，不能用模块针脚承受拉线的力。

DRV8833 与降压模块的地各自回电源入口；舵机和面包板分别回降压输出地。GND 通过非隔离降压模块的 IN− / OUT− 相通，无需再让电机／舵机电流经过面包板。

## 7. 四臂扩展

本图只供单臂装配。四臂阶段增加一块 DRV8833、马达及舵机接口，重新核算同时启动电流、供电针座额定值、总线线径与散热，并按 [四臂 GPIO 表](single_arm.md#2-引脚分配) 接线；不能把当前单臂针座直接当成足够的整机供电接口。
