gonewx/quadcuber/generated/electronics/kicad10-independent-review.md

# 本阶段独立复核

2026-10-12，独立只读代理相对e34395e68b175cf9a279664fd4a13fd6573d95db审查本地变更。

结论：可保存为KiCad10 EDA通过、原厂模型动态仍阻塞的阶段记录；不能宣称全部用户目标完成。无Critical，无未处理的Important提交阻断问题。

已独立验证10项仿真工具单测；9份压缩波形逐一复算，0完成/0通过，点数末时刻与状态一致；原厂及XOR适配模型SHA匹配；release-status源哈希全匹配；21条构建命令成功及EDA计数为零；用10版pcbnew再次比较五类几何相同；版本保护拒绝9.0.2。Flash/固件未修改，EV3/制造HOLD保持。

已修复审查发现的旧gz重跑残留、初始化失败继承旧COMPLETED状态；明确输入电容并联理想源的验证盲区。

复核未独立重跑九工况求解、59项既有回归或完整EDA构建，针对这些只核对执行证据。

Minor保留：report_buck_vendor.py的失败叙述针对本次九个Timestep too small工况；未来超时/解析失败等不同结果必须同步修改叙述或加强输入校验。当前九份日志均符合，不影响本轮事实。

本阶段后按用户指示继续原厂模型/参考电路及求解器兼容诊断，动态验收尚未完成。
