gonewx/quadcuber/electronics/simulation/webench-handoff/user-steady-state-evidence.md

# WEBENCH Steady State-2：用户截图证据

> 后续更新：四份PDF已由父对话逐页文本及渲染审阅，见[统一PDF评审](review.md)。本文保留当时截图证据与当时未知项；后续已确认的负载方向/激励以该评审为准。本工程尚未归档PDF原件，仍无原始采样附件。

记录日期：2026-10-12。**用户浏览器中的简化单路 Steady State-2 显示完成，是继[Startup-1](user-startup-evidence.md)后的第二项截图所示完成作业；不是完整A1验证通过。制造 NOT RELEASED，本地ngspice/Xyce求解器问题仍未解决。**

## 来源与证据等级

- 用户消息：`Sentinel_1029deac2a6081918b0d2b26acdd89e7`。
- 截图 Library ID：`libfile_e80609402d7881919629d3d303308b10`。
- 父对话 `01a11840-6f67-76ca-b87a-1b09a71dc0e4` 已实际查看截图，提供可见内容供本任务记录。本任务未重复抓取或上传截图。
- 证据仅为用户截图经父对话核读的摘要；尚无原始波形、运行日志、实际工程或完整模型/求解设置。本环境未运行此作业。

## 截图可见结果

作业 **Steady State-2** 显示完成。页面摘要：

| 页面指标 | 显示值 |
| --- | ---: |
| VoutPeaktoPeak | 3.94 mV |
| VoutAverage | 5.10 V |
| InductorCurrentPeaktoPeak | 0.53 A |
| AverageFreq | 414.82 kHz |

可见Vout窗口约 **0.90–1.00 ms**，输出在约 **5.1015–5.1055 V** 之间呈周期波形，截图窗口内未见振幅持续增大。输入示意为9 V。

上述数值是工具页面的统计摘要，不是本任务从原始数据独立复算的结果；统计窗口与算法未核实。窄窗口内的周期波形不能证明全工况稳定性、环路相位裕量或负载跃变响应。414.82 kHz为该在线作业的页面指标，不构成本地宏模型时钟兼容问题已修复的证据。

## 配置与限制

延续Startup-1的简化配置：L=10 µH、DCR=21.4 mΩ，Cout每颗22 µF/6 mΩ、Qty=2，Rfbt/Rfbb=100 kΩ/13.3 kΩ，Cff=75 pF。每颗6 mΩ对应两颗并联总等效3 mΩ的测试假设，不是Murata已确认的实物ESR。

电路仍缺实际A1的 **BOOT串联49.9 Ω** 和 **EN 511 kΩ/105 kΩ分压**。未确认的器件参数、输入高频电容、负载电流与模型、温度、初始条件和求解设置不从这张摘要推断。输入9 V这一点不能替代8.82/9/9.18 V与容量系数组成的完整矩阵；单路结果不能替代双路共母线验证。

可以记录：**简化在线电路第二项作业显示完成，页面报告输出纹波3.94 mV、平均输出5.10 V、电感电流峰峰值0.53 A、平均频率414.82 kHz。** 不能记录为完整A1、启动/稳态/负载阶跃全套或制造验收通过。电感电流峰峰值也不能替代绝对峰值验收。

## 后续状态

父对话已指导用户保存SteadyState2结果并选择LoadTransient；若出现设置项，先查看设置，再按A/B轻载 **0.25/0.05 A** 到每路 **1.5 A** 的目标配置。后续已收到[LoadTransient3截图结果](user-load-transient-evidence.md)，简化作业显示完成，但激励尚未精确确认，不能当指定A/B工况。 后续仍需实际导出数据、运行条件和所有不等效项；BOOT/EN等差异未补齐之前继续标注“简化电路”。
