gonewx/quadcuber/generated/electronics/simulation/independent-review.md

# 仿真独立复核（2026-10-12）

只读检查了run_boundaries.py、run_buck_vendor.py、model-sources.json、run-status.json与实际输出；本报告不表示原厂模型或硬件验证通过。未修改PCB。

## 已执行证据

- 54个回灌、8个逻辑电源切换、3个入口切换工况共65个ngspice波形存在；输出文件列标题与脚本索引对应。
- 独立用纯Python重新梯形积分54个回灌波形，CSV能量数据差异不超过3.6e-15 J；最大能量平衡残差为2.1969770476e-5 J，约22微焦耳。Vregen由regen流向VM的正电流确为向总线注入；TVS电流由VM流地，乘VM电压为吸收功率，符号正确。
- run-status电气源和PCB SHA与磁盘一致。status明确vendor_model_cases=0、下载403、未硬件验证、未制造放行，没有把边界算例包装成原厂TPS54302仿真。
- 入口123.6 A峰值是理想控制器、0.05欧源阻、无电感/限流的设定结果，不是实际LM74700或电源会产生该电流的预测。逻辑OR模型的max(...,0)禁止负电流，因此反向电流为零是模型定义，不能验证实物漏电、关断延迟、反恢复或USB数据脚反灌。
- TVS分段线性、固定母线注入电流、纯电容、假定theta/效率/热态导通电阻均为声明的敏感性模型；below_25V/ below_12V只比较本模型波形，不能视为TVS、驱动或系统安全认证。热表为代数估计，没有电热闭环或PCB热求解。

## 执行器问题与修正复核

1. 两执行器复用case目录、运行前未清理waveform.txt。某些ngspice控制错误可能仍返回0，届时旧波形可能被读成新结果。须删除旧波形，开始时重置本轮状态，并在timeout/失败后留下明确失败状态，避免旧run-status继续冒充当前结果。加载前核对列名和列数。
2. vendor脚本的max_V与max_inductor_A仅统计10ms以后，会遗漏启动时的过压/过流而返回passed。稳态/阶跃最低输出值可在10ms后检查，但最高输出及峰值电感电流应覆盖全波形；启动时间和10ms达到目标电压应单独记录。

原厂模型未取得，未执行vendor脚本，故其PSpice语法、引脚名、依赖文件和ngspice收敛均未证明兼容。六针唯一子电路及针名集不符时立即失败的防错处理合理；不能把它能生成网表称为原厂仿真完成。上述两项已修正，见下述复核记录。

## 最终增量复核

重新只读检查修正版脚本，两项问题均已落实：运行前删除未压缩waveform.txt；本轮写入RUNNING，捕获失败后写FAILED/FAILED_OR_BLOCKED；读取数据检查列数、二维形状、有限值及仿真完成时间。vendor最高输出和电感电流已改为全瞬态统计，新增10ms前达到4.75V检查，10ms后最低输出继续检查。不会再因启动过压被窗口排除而通过。列标题尚未在执行器中自动验证，但本次独立逐一核对65个压缩波形的标题均与网表/索引一致。

最终run-status为COMPLETED（model_class明确为boundary surrogate，vendor_model_cases=0）；54+8+3个waveform.txt.gz均可解压且列标题正确。已审阅完整report.md：清楚区分原厂模型0次、边界模型65次和代数热估计；没有以TVS钳位、反向0A、额定电流或模型电压低于25V宣称实际保护通过。报告数值与已核对CSV一致。未发现需要阻止本次“边界分析部分交付”的新增硬错误。

原厂模型未执行及硬件/制造HOLD保持，不把vendor执行器静态复核作为TI模型兼容性验证。未来重跑失败时只应读取本轮状态，不能取旧CSV/压缩波形当新一轮结果。
