gonewx/quadcuber/artifacts/head-architecture-review/review.html

结构概念评审 · 尚非乐高逐件装配模型

# 先确定承重骨架，再选择梁的形状

常见 Technic 零件优先，允许少量补购；所有全圆孔薄梁禁用。保留马达与底座接口作为基准，重新安排框架、导向和推杆。

下图用简化实体说明结构关系。蓝色框架、黄色滑座均为功能外形，不代表已确认的整块零件。孔位、连接件、轴孔摩擦、整圈避让和承重尚待详细设计验证。

## 优先评估：封闭框架＋双导轨滑座

左右侧框以横向连接形成箱形骨架；每根导轨前后支承，滑座在每根导轨上设两个接触位置。夹指根轴双侧支承。

整体轴测另一侧侧视沿推杆看俯视 显示近侧框架显示驱动参照显示魔方 开合

承重框架双导轨滑座及轴向输入粗梁输入杆夹指

拖动旋转，滚轮缩放。开合仅解理想平面连杆，未计摩擦、弹性及实体干涉。上／前／左右轴随视角显示；左右是机械头的横向。

## 承重要分开检查

① 根轴及框架支承

轮胎 → 夹指 → 双侧根轴 → 前端立架 → 左右侧框／横向连接 → 转盘 → 固定支座 → 底座。

减小根轴悬伸，减少串联连接；转盘间隙、支座刚度和机械头自重仍需检查。

② 活动接头支承

夹指输入杆 → 滑座 → 双导轨的前后接触 → 导轨端座 → 框架。

推杆输入轴向力；横向力和力矩应由滑座支承。两路载荷的分配必须联立求解，不能各自假设承担全部载荷。

## 三条路线，按证据选择

路线 | 为什么值得考虑 | 必须解决的问题 | 当前判断
封闭框架＋直线滑座 | 导向与框架承重分工清楚；有机会删去摆杆和短驱动连杆。 | 四个滑动接触点的摩擦、导轨挠曲、平行度和卡滞；滑座自身也需刚性。 | 优先做导向小样。尚不能保证更少件或更硬。
封闭框架＋重排连杆导向 | 继续使用转动关节，避免长行程轴孔滑动。 | 关节间隙累积、层位和侧向支承；需要重新布置，不能直接套旧内芯。 | 滑动方案不达标时的主要对照。
上一版 L 梁兼容改型 | 已有局部几何及刚体分析数据，保留接口最多。 | 239→238 件，复杂叠层仍在，最小活动间隙约0.81mm。 | 留作对照，不作为新的推荐结论。

## 上一版的完整单臂：补足两个观察角度

以下是上一版真实零件模型，包含后部马达、舵机和支座；与上面的新结构概念区分。

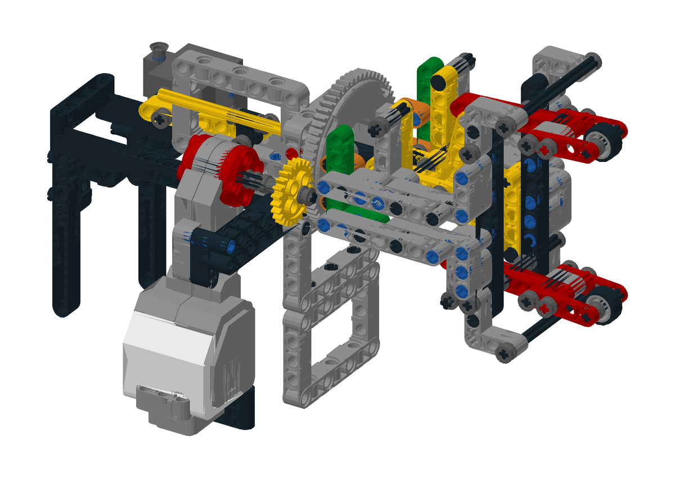
[picture p3: artifacts/head-architecture-review/previous-full.png]
上一版完整单臂轴测图
整体轴测 

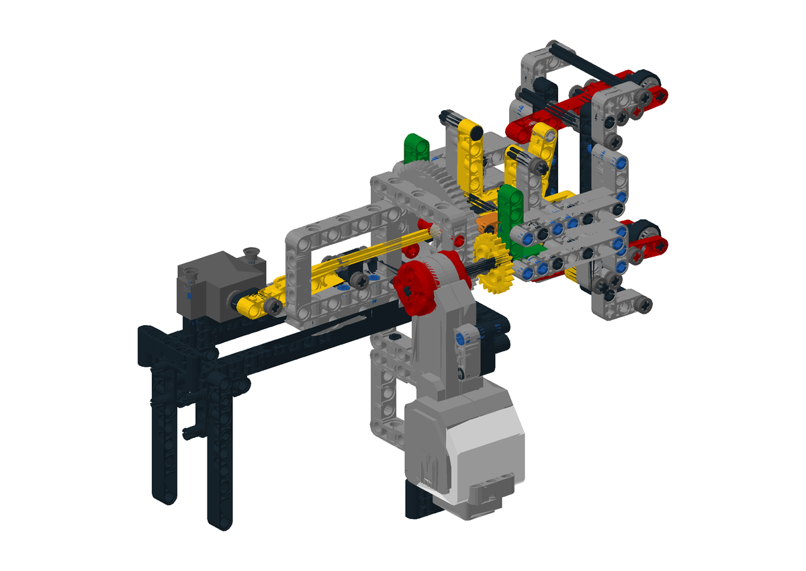
[picture p4: artifacts/head-architecture-review/previous-reverse.png]
上一版完整单臂从另一侧观察
另一侧轴测 

结构选择、承重边界与验证计划
