gonewx/quadcuber/mechanical/final/offline-viewer/index.html

Quadcuber 最终结构 / 882件

设计候选 · 未通过实体装配、承载与带电验收。按住外柄才能保持上位；无阻尼，谨防夹手与突然下落。 风险与范围

立体正视侧视俯视放大缩小复位全屏查看适合窗口原图大小重试3D

整机 · 882件 / 装料端姿

拖动旋转 · 滚轮 / 双指缩放 · R复位

装卸动作演示

查看放入、夹持交接、托座回落与退出的设计关系。只供审阅，不发送控制指令。

查看17阶段装卸动作

零件表与下载

完整501页PDF模型与构建源文件882件整机MPD整机BOM分组件BOM

## 最终整机零件表

与882件整机模型逐实例一致。仅列最终结构所用零件；颜色见分组件BOM。

设计号 | 数量
11478.dat | 4
14720.dat | 1
15100.dat | 6
18654.dat | 6
18938.dat | 4
18939.dat | 4
23948.dat | 1
2780.dat | 276
32013.dat | 4
32054.dat | 8
32062.dat | 12
32073.dat | 5
32123a.dat | 90
32140.dat | 7
32278.dat | 19
32316.dat | 33
32449.dat | 16
32523.dat | 24
32524.dat | 35
32525.dat | 8
32526.dat | 21
3648b.dat | 4
3673.dat | 8
3705.dat | 5
3706.dat | 1
3707.dat | 8
3708.dat | 5
3713.dat | 22
39790.dat | 4
39793.dat | 4
40490.dat | 20
41677.dat | 4
42610.dat | 8
43857.dat | 5
44294.dat | 4
4519.dat | 12
50945_nominal.dat | 8
55615.dat | 16
60483.dat | 16
62462.dat | 3
64179.dat | 20
6536.dat | 4
6558.dat | 109
95658.dat | 4
geekservo.dat | 4

装配范围与未通过的验收

本册共501步，含准备与检查：64件底盘从散件装配、150件支承与杠杆、四个机械臂组件的最终装配、接口与总装核对。四臂均从清单单件开始，全部882个实例逐步取用，没有预装核心；成品电机和舵机按采购件处理。

480步提供精确记录对应的局部3D；其余步骤使用原始图解，包括准备与检查页。图解、3D与PDF使用同一最终结构数据。蓝色只表示本步新取件，合并步骤可能没有新件。

支承总成含20件重力回落杠杆。只有持续按住外柄才保持上位；夹头可靠接管后缓松回落40.8毫米。无阻尼，不保证实物自落、刚度或回落冲击安全。按柄下方约9毫米夹手间隙，手只从末端三孔区域上方按压。

正常夹指开角不超过25°。实体装配路径、保持、载荷、手部隔离、自重回落与带电验收仍未通过；名义几何不代表实物验收。

最终结构 · 全机882件 / 底盘64 / 四臂668 / 支承150
