gonewx/quadcuber/mechanical/final/site-source/preview219/index.html

承载实测未通过：暂停带魔方运行

实际反馈：放入魔方后出现整体下垂。当前承载问题仍在诊断，请暂停带魔方运行。

此前的几何与运动检查不能代表承重合格。当前模型和装配说明保留供浏览、排查；没有修改机械模型或确认修复。

原8枚墙脚销的待批准项仍独立保留，不能视为已处理。

# 共用底盘 219 · 承载诊断中

承载实测未通过 · 暂停带魔方运行 219件底盘与升降，927件整机，40毫米行程

39790框使用4个；不使用71709面板。已换入新门架、承托和底部角连接，满足这两项已确认的库存限制。

正在解析内嵌模型…

复位视角 切换到下位40mm 只看底盘与升降 说明修订状态 219件零件表

拖动旋转 · 滚轮／双指缩放 · A/D、W/S旋转 · +/-缩放 · R复位

固定144件、移动69件、可取出锁件6件。下位隐藏6件锁件，整机921件，底盘与升降213件。蓝框标示56毫米魔方的上位位置；按钮只展示上下位，不模拟完整机械头操作。

## 219件装配说明正在修订

门架、承托和底部角连接已换成新实件，零件编号与移动分组也已更新。旧137步属于192件版本，不能用于当前219件模型。

当前页面提供新模型的旋转、缩放、整机／底盘和40毫米上下位审阅；新分步图会在逐件核对后补入。

原四臂接口仍待确认。原708件模块保持不变，8枚墙脚销的未批准纠错没有混入本版；相关装回施工继续暂缓。

导轨与座体部分配合为名义相切，不能当作实物公差余量。所有尺寸为名义CAD尺寸。停车状态最小名义间隙约0.371毫米，仍须核对实物余量。实物装配、制造公差、刚度、插拔力、保持力及手部空间仍需验证。内嵌全部CAD几何与渲染脚本，可离线查看。
