gonewx/quadcuber/generated/electronics/protection-analysis/input_rlc.csv

case | source_V | Rwire_ohm | Lwire_H | Csource_F | Cbus_F | peak_fuse_A | startup_I2t_A2s | I2t_fraction_407_nominal | VM_peak_V | VM_end_V | supply_peak_A
input_V8.82_R0.02_L2e-07_Cs0.00047_Cm0.002256 | 8.82 | 0.02 | 2e-07 | 0.00047 | 0.002256 | 160.793408 | 0.49806795975789586 | 0.020649583737889547 | 8.79590569 | 8.56347166 | 6.5
input_V8.82_R0.02_L2e-07_Cs0.00047_Cm0.003384 | 8.82 | 0.02 | 2e-07 | 0.00047 | 0.003384 | 162.563666 | 0.5640914205912566 | 0.023386874817216276 | 8.56347166 | 8.56347166 | 6.5
input_V8.82_R0.02_L2e-07_Cs0.0022_Cm0.002256 | 8.82 | 0.02 | 2e-07 | 0.0022 | 0.002256 | 188.094789 | 1.1902210753594882 | 0.04934581572800531 | 8.79517729 | 8.56347166 | 6.5
input_V8.82_R0.02_L2e-07_Cs0.0022_Cm0.003384 | 8.82 | 0.02 | 2e-07 | 0.0022 | 0.003384 | 192.126171 | 1.4527745828940717 | 0.060231118693784065 | 8.56347166 | 8.56347166 | 6.5
input_V8.82_R0.02_L2e-06_Cs0.00047_Cm0.002256 | 8.82 | 0.02 | 2e-06 | 0.00047 | 0.002256 | 88.4390053 | 0.4369916081160105 | 0.018117396688060138 | 8.79642487 | 8.56347166 | 6.5
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
