gonewx/quadcuber/generated/electronics/protection-analysis/mechanical_envelope.csv

J_equiv_each_kg_m2 | output_rpm | motor_L_H | four_rotational_J | four_magnetic_J | total_max_regen_J
3e-05 | 60 | 0.0005 | 0.002368705056261445 | 0.002601769 | 0.004970474056261445
3e-05 | 60 | 0.002 | 0.002368705056261445 | 0.010407076 | 0.012775781056261445
3e-05 | 60 | 0.01 | 0.002368705056261445 | 0.05203538 | 0.054404085056261445
3e-05 | 120 | 0.0005 | 0.00947482022504578 | 0.002601769 | 0.012076589225045781
3e-05 | 120 | 0.002 | 0.00947482022504578 | 0.010407076 | 0.01988189622504578
3e-05 | 120 | 0.01 | 0.00947482022504578 | 0.05203538 | 0.06151020022504578
3e-05 | 175 | 0.0005 | 0.020150442318890766 | 0.002601769 | 0.022752211318890766
3e-05 | 175 | 0.002 | 0.020150442318890766 | 0.010407076 | 0.030557518318890767
3e-05 | 175 | 0.01 | 0.020150442318890766 | 0.05203538 | 0.07218582231889076
0.0001 | 60 | 0.0005 | 0.007895683520871484 | 0.002601769 | 0.010497452520871484
0.0001 | 60 | 0.002 | 0.007895683520871484 | 0.010407076 | 0.018302759520871483
0.0001 | 60 | 0.01 | 0.007895683520871484 | 0.05203538 | 0.059931063520871485
0.0001 | 120 | 0.0005 | 0.031582734083485935 | 0.002601769 | 0.03418450308348593
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
