gonewx/quadcuber/generated/electronics/protection-analysis/regenerative_energy.csv

case | bleed_ohm | energy_per_event_J | pulse_s | repetition_Hz | VM_peak_V | TVS_total_5events_J | TVS_peak_W | TVS_last_event_average_W | input_5events_J | bleed_energy_J | source_energy_J | energy_balance_J
energy_E0.02_T0.005_Hz1_R1e+09 | 1000000000.0 | 0.02 | 0.005 | 1 | 13.1500718 | 0.0 | 0.0 | 0.0 | 0.10000000000000026 | 5.166772190650037e-07 | 6.586319460483032e-11 | 4.350196544655738e-08
energy_E0.02_T0.005_Hz1_R151.5 | 151.5 | 0.02 | 0.005 | 1 | 9.96853081 | 0.0 | 0.0 | 0.0 | 0.10000000000000026 | 2.2379287067741833 | 2.149166035836579 | 1.9275751508522967e-05
energy_E0.02_T0.005_Hz5_R1e+09 | 1000000000.0 | 0.02 | 0.005 | 5 | 13.1500856 | 0.0 | 0.0 | 0.0 | 0.1 | 1.0516244959727267e-07 | 6.586319460483032e-11 | 4.265130829073094e-08
energy_E0.02_T0.005_Hz5_R151.5 | 151.5 | 0.02 | 0.005 | 5 | 9.96853081 | 0.0 | 0.0 | 0.0 | 0.1 | 0.46026514314871725 | 0.3715024722983721 | 1.9275838767389766e-05
energy_E0.02_T0.02_Hz1_R1e+09 | 1000000000.0 | 0.02 | 0.02 | 1 | 13.1500712 | 0.0 | 0.0 | 0.0 | 0.09999999999999995 | 5.186061408110645e-07 | 6.760025170437881e-11 | 5.9374717087390394e-08
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
