gonewx/quadcuber/generated/electronics/simulation/linux-reference/xyce-compatibility/switch_expected.csv

control_V | resistance_ohm | I_VTEST_A
0.3 | 10000000.0 | -1e-07
0.35 | 10000000.0 | -1e-07
0.4 | 10000000.0 | -1e-07
0.45 | 7543641.645840775 | -1.3256197032521488e-07
0.5 | 3426162.740761824 | -2.9187171645490636e-07
0.55 | 1019545.2377995339 | -9.808294550600638e-07
0.6000000000000001 | 216322.78839065388 | -4.622721477656417e-06
0.65 | 35614.01921862152 | -2.8078830245509876e-05
0.7 | 4950.947656127362 | -0.00020198153352770474
0.75 | 632.455532033676 | -0.0015811388300841893
0.8 | 80.79261341108192 | -0.012377369140318402
0.8500000000000001 | 11.231532098203886 | -0.08903504804655432
0.9000000000000001 | 1.8490885910625516 | -0.5408069709766392
0.95 | 0.3923317820240251 | -2.5488630944988375
1.0 | 0.1167486865819626 | -8.565406851904557
1.05 | 0.053024788130085904 | -18.859104114601955
1.1 | 0.04 | -25.0
1.1500000000000001 | 0.04 | -25.0
1.2 | 0.04 | -25.0
