gonewx/quadcuber/generated/electronics/simulation/linux-steady-followup/cold-differential/startup_dc12/driver.cir.csv

TIME | V(VIN) | V(VOUT) | V(EN) | V(SW) | I(X_L1:L) | V(X_U1:XCORE:SDWN) | V(X_U1:XCORE:COMP) | V(X_U1:XCORE:SS_TR) | V(X_U1:XCORE:VREF_GM) | V(X_U1:XCORE:U5_LOW_CLMP) | V(X_U1:XCORE:N16888001) | V(X_U1:XCORE:U10_N16864604) | V(X_U1:XCORE:HICCUP) | V(X_U1:XCORE:U11_ENAB)
0.00000000e+00 | 1.20000000e+01 | 0.00000000e+00 | 0.00000000e+00 | 4.02659119e+00 | 0.00000000e+00 | 1.00000000e+00 | 0.00000000e+00 | 0.00000000e+00 | 0.00000000e+00 | 0.00000000e+00 | 0.00000000e+00 | 0.00000000e+00 | 0.00000000e+00 | 0.00000000e+00
5.00000000e-12 | 1.20000000e+01 | 7.56192055e-10 | 2.24535313e+00 | 1.51311982e+00 | 7.56559907e-07 | 1.00000000e+00 | 5.71001704e-12 | -8.40032276e-11 | -8.40032276e-11 | 0.00000000e+00 | 5.71001704e-12 | 0.00000000e+00 | 0.00000000e+00 | 1.00000000e+00
5.15625000e-12 | 1.20000000e+01 | 7.78657119e-10 | 2.24535313e+00 | 1.43844995e+00 | 7.79035688e-07 | 1.00000000e+00 | 5.88841358e-12 | -8.66283284e-11 | -8.66283284e-11 | 0.00000000e+00 | 5.88841358e-12 | 0.00000000e+00 | 0.00000000e+00 | 1.00000000e+00
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
