gonewx/quadcuber/generated/electronics/simulation/linux-reference/xyce-compatibility/runs/default/ic_alias_space/ic_alias_space.cir.csv

TIME | V(ACTUAL_EN) | V(ACTUAL_COMP)
0.00000000e+00 | 0.00000000e+00 | 1.36950000e+00
1.00000000e-06 | 9.99000999e-04 | 1.36813187e+00
1.01562500e-06 | 1.01461015e-03 | 1.36811049e+00
1.03125000e-06 | 1.03021917e-03 | 1.36808911e+00
1.04687500e-06 | 1.04582795e-03 | 1.36806774e+00
1.07812500e-06 | 1.07704478e-03 | 1.36802499e+00
1.14062500e-06 | 1.13947552e-03 | 1.36793949e+00
1.26562500e-06 | 1.26432528e-03 | 1.36776851e+00
1.51562500e-06 | 1.51397799e-03 | 1.36742661e+00
2.01562500e-06 | 2.01309622e-03 | 1.36674306e+00
3.01562500e-06 | 3.01058438e-03 | 1.36537700e+00
4.01562500e-06 | 4.00707555e-03 | 1.36401231e+00
5.01562500e-06 | 5.00257073e-03 | 1.36264898e+00
6.01562500e-06 | 5.99707091e-03 | 1.36128701e+00
7.01562500e-06 | 6.99057708e-03 | 1.35992640e+00
8.01562500e-06 | 7.98309025e-03 | 1.35856716e+00
9.01562500e-06 | 8.97461140e-03 | 1.35720927e+00
1.00156250e-05 | 9.96514152e-03 | 1.35585274e+00
1.10156250e-05 | 1.09546816e-02 | 1.35449756e+00
1.20156250e-05 | 1.19432327e-02 | 1.35314374e+00
1.30156250e-05 | 1.29307956e-02 | 1.35179128e+00
1.40156250e-05 | 1.39173716e-02 | 1.35044016e+00
1.50156250e-05 | 1.49029614e-02 | 1.34909039e+00
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
