gonewx/quadcuber/generated/electronics/simulation/linux-reference/xyce-compatibility/runs/default/ic_with_equals_observe/ic_with_equals_observe.cir.csv

TIME | V(OUT) | V(X1:QINT)
0.00000000e+00 | 0.00000000e+00 | 2.50000000e-01
1.00000000e-06 | 2.49750250e-01 | 2.49750250e-01
1.01562500e-06 | 2.49746347e-01 | 2.49746347e-01
1.03125000e-06 | 2.49742445e-01 | 2.49742445e-01
1.04490200e-06 | 2.49739036e-01 | 2.49739036e-01
1.07220599e-06 | 2.49732217e-01 | 2.49732217e-01
1.12681398e-06 | 2.49718580e-01 | 2.49718580e-01
1.23602996e-06 | 2.49691308e-01 | 2.49691308e-01
1.45446192e-06 | 2.49636774e-01 | 2.49636774e-01
1.89132584e-06 | 2.49527740e-01 | 2.49527740e-01
2.76505368e-06 | 2.49309816e-01 | 2.49309816e-01
3.76505368e-06 | 2.49060631e-01 | 2.49060631e-01
4.76505368e-06 | 2.48811695e-01 | 2.48811695e-01
5.76505368e-06 | 2.48563007e-01 | 2.48563007e-01
6.76505368e-06 | 2.48314568e-01 | 2.48314568e-01
7.76505368e-06 | 2.48066378e-01 | 2.48066378e-01
8.76505368e-06 | 2.47818436e-01 | 2.47818436e-01
9.76505368e-06 | 2.47570741e-01 | 2.47570741e-01
1.07650537e-05 | 2.47323294e-01 | 2.47323294e-01
1.17650537e-05 | 2.47076094e-01 | 2.47076094e-01
1.27650537e-05 | 2.46829142e-01 | 2.46829142e-01
1.37650537e-05 | 2.46582436e-01 | 2.46582436e-01
1.47650537e-05 | 2.46335977e-01 | 2.46335977e-01
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
