gonewx/quadcuber/generated/electronics/simulation/linux-reference/xyce-compatibility/runs/default/logic_value/logic_value.cir.csv

V(A) | V(B) | V(AS) | V(AD) | V(OS) | V(OD) | V(GS) | V(GE)
0.00000000e+00 | 0.00000000e+00 | 0.00000000e+00 | 0.00000000e+00 | 0.00000000e+00 | 0.00000000e+00 | -1.00000000e+00 | -1.00000000e+00
5.00000000e-01 | 0.00000000e+00 | 0.00000000e+00 | 0.00000000e+00 | 0.00000000e+00 | 0.00000000e+00 | -1.00000000e+00 | -1.00000000e+00
1.00000000e+00 | 0.00000000e+00 | 0.00000000e+00 | 0.00000000e+00 | 1.00000000e+00 | 1.00000000e+00 | 2.00000000e+00 | 2.00000000e+00
0.00000000e+00 | 5.00000000e-01 | 0.00000000e+00 | 0.00000000e+00 | 0.00000000e+00 | 0.00000000e+00 | -1.00000000e+00 | -1.00000000e+00
5.00000000e-01 | 5.00000000e-01 | 0.00000000e+00 | 0.00000000e+00 | 0.00000000e+00 | 0.00000000e+00 | -1.00000000e+00 | -1.00000000e+00
1.00000000e+00 | 5.00000000e-01 | 0.00000000e+00 | 0.00000000e+00 | 1.00000000e+00 | 1.00000000e+00 | 2.00000000e+00 | 2.00000000e+00
0.00000000e+00 | 1.00000000e+00 | 0.00000000e+00 | 0.00000000e+00 | 1.00000000e+00 | 1.00000000e+00 | -1.00000000e+00 | -1.00000000e+00
5.00000000e-01 | 1.00000000e+00 | 0.00000000e+00 | 0.00000000e+00 | 1.00000000e+00 | 1.00000000e+00 | -1.00000000e+00 | -1.00000000e+00
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
