gonewx/quadcuber/generated/electronics/simulation/linux-reference/xyce-compatibility/runs/default/rc_noop_noic/rc_noop_noic.cir.csv

TIME | V(OUT)
0.00000000e+00 | 0.00000000e+00
1.00000000e-06 | 9.99000999e-04
1.01562500e-06 | 1.01461015e-03
1.03125000e-06 | 1.03021917e-03
1.04489298e-06 | 1.04384800e-03
1.07217895e-06 | 1.07110512e-03
1.12675088e-06 | 1.12561711e-03
1.23589474e-06 | 1.23463216e-03
1.45418246e-06 | 1.45262658e-03
1.89075790e-06 | 1.88847270e-03
2.76390878e-06 | 2.75959435e-03
3.76390878e-06 | 3.75633639e-03
4.76390878e-06 | 4.75208218e-03
5.76390878e-06 | 5.74683272e-03
6.76390878e-06 | 6.74058901e-03
7.76390878e-06 | 7.73335204e-03
8.76390878e-06 | 8.72512280e-03
9.76390878e-06 | 9.71590229e-03
1.07639088e-05 | 1.07056915e-02
1.17639088e-05 | 1.16944914e-02
1.27639088e-05 | 1.26823030e-02
1.37639088e-05 | 1.36691273e-02
1.47639088e-05 | 1.46549652e-02
1.57639088e-05 | 1.56398178e-02
1.67639088e-05 | 1.66236861e-02
1.77639088e-05 | 1.76065710e-02
1.87639088e-05 | 1.85884734e-02
1.97639088e-05 | 1.95693945e-02
2.07639088e-05 | 2.05493351e-02
2.17639088e-05 | 2.15282963e-02
2.27639088e-05 | 2.25062790e-02
2.37639088e-05 | 2.34832843e-02
2.47639088e-05 | 2.44593130e-02
2.57639088e-05 | 2.54343661e-02
2.67639088e-05 | 2.64084447e-02
2.77639088e-05 | 2.73815497e-02
2.87639088e-05 | 2.83536821e-02
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
