gonewx/quadcuber/generated/electronics/simulation/linux-reference/xyce-compatibility/runs/default/rc_op_ic/rc_op_ic.cir.csv

TIME | V(OUT)
0.00000000e+00 | 2.50000000e-01
1.00000000e-06 | 2.50749251e-01
2.00000000e-06 | 2.51497753e-01
3.00000000e-06 | 2.52245881e-01
4.00000000e-06 | 2.52993262e-01
5.00000000e-06 | 2.53739895e-01
6.00000000e-06 | 2.54485782e-01
7.00000000e-06 | 2.55230924e-01
8.00000000e-06 | 2.55975321e-01
9.00000000e-06 | 2.56718974e-01
1.00000000e-05 | 2.57461883e-01
1.10000000e-05 | 2.58204050e-01
1.20000000e-05 | 2.58945475e-01
1.30000000e-05 | 2.59686160e-01
1.40000000e-05 | 2.60426103e-01
1.50000000e-05 | 2.61165308e-01
1.60000000e-05 | 2.61903773e-01
1.70000000e-05 | 2.62641501e-01
1.80000000e-05 | 2.63378491e-01
1.90000000e-05 | 2.64114744e-01
2.00000000e-05 | 2.64850261e-01
2.10000000e-05 | 2.65585044e-01
2.20000000e-05 | 2.66319092e-01
2.30000000e-05 | 2.67052406e-01
2.40000000e-05 | 2.67784987e-01
2.50000000e-05 | 2.68516836e-01
2.60000000e-05 | 2.69247954e-01
2.70000000e-05 | 2.69978341e-01
2.80000000e-05 | 2.70707998e-01
2.90000000e-05 | 2.71436925e-01
3.00000000e-05 | 2.72165124e-01
3.10000000e-05 | 2.72892595e-01
3.20000000e-05 | 2.73619339e-01
3.30000000e-05 | 2.74345357e-01
3.40000000e-05 | 2.75070649e-01
3.50000000e-05 | 2.75795216e-01
3.60000000e-05 | 2.76519059e-01
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
