gonewx/quadcuber/generated/electronics/simulation/linux-reference/xyce-compatibility/runs/default/rc_op_noic/rc_op_noic.cir.csv

TIME | V(OUT)
0.00000000e+00 | 1.00000000e+00
1.00000000e-06 | 1.00000000e+00
2.00000000e-06 | 1.00000000e+00
3.00000000e-06 | 1.00000000e+00
4.00000000e-06 | 1.00000000e+00
5.00000000e-06 | 1.00000000e+00
6.00000000e-06 | 1.00000000e+00
7.00000000e-06 | 1.00000000e+00
8.00000000e-06 | 1.00000000e+00
9.00000000e-06 | 1.00000000e+00
1.00000000e-05 | 1.00000000e+00
1.10000000e-05 | 1.00000000e+00
1.20000000e-05 | 1.00000000e+00
1.30000000e-05 | 1.00000000e+00
1.40000000e-05 | 1.00000000e+00
1.50000000e-05 | 1.00000000e+00
1.60000000e-05 | 1.00000000e+00
1.70000000e-05 | 1.00000000e+00
1.80000000e-05 | 1.00000000e+00
1.90000000e-05 | 1.00000000e+00
2.00000000e-05 | 1.00000000e+00
2.10000000e-05 | 1.00000000e+00
2.20000000e-05 | 1.00000000e+00
2.30000000e-05 | 1.00000000e+00
2.40000000e-05 | 1.00000000e+00
2.50000000e-05 | 1.00000000e+00
2.60000000e-05 | 1.00000000e+00
2.70000000e-05 | 1.00000000e+00
2.80000000e-05 | 1.00000000e+00
2.90000000e-05 | 1.00000000e+00
3.00000000e-05 | 1.00000000e+00
3.10000000e-05 | 1.00000000e+00
3.20000000e-05 | 1.00000000e+00
3.30000000e-05 | 1.00000000e+00
3.40000000e-05 | 1.00000000e+00
3.50000000e-05 | 1.00000000e+00
3.60000000e-05 | 1.00000000e+00
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
