gonewx/quadcuber/generated/electronics/simulation/linux-reference/xyce-compatibility/runs/default/rc_uic_ic/rc_uic_ic.cir.csv

TIME | V(OUT)
0.00000000e+00 | 2.50000000e-01
1.00000000e-06 | 2.50749251e-01
1.01562500e-06 | 2.50760958e-01
1.03125000e-06 | 2.50772664e-01
1.04489298e-06 | 2.50782886e-01
1.07217895e-06 | 2.50803329e-01
1.12675088e-06 | 2.50844213e-01
1.23589475e-06 | 2.50925974e-01
1.45418249e-06 | 2.51089470e-01
1.89075796e-06 | 2.51416355e-01
2.76390890e-06 | 2.52069696e-01
3.76390890e-06 | 2.52817252e-01
4.76390890e-06 | 2.53564062e-01
5.76390890e-06 | 2.54310125e-01
6.76390890e-06 | 2.55055442e-01
7.76390890e-06 | 2.55800014e-01
8.76390890e-06 | 2.56543842e-01
9.76390890e-06 | 2.57286927e-01
1.07639089e-05 | 2.58029269e-01
1.17639089e-05 | 2.58770869e-01
1.27639089e-05 | 2.59511727e-01
1.37639089e-05 | 2.60251846e-01
1.47639089e-05 | 2.60991224e-01
1.57639089e-05 | 2.61729863e-01
1.67639089e-05 | 2.62467765e-01
1.77639089e-05 | 2.63204928e-01
1.87639089e-05 | 2.63941355e-01
1.97639089e-05 | 2.64677046e-01
2.07639089e-05 | 2.65412001e-01
2.17639089e-05 | 2.66146222e-01
2.27639089e-05 | 2.66879709e-01
2.37639089e-05 | 2.67612463e-01
2.47639089e-05 | 2.68344485e-01
2.57639089e-05 | 2.69075775e-01
2.67639089e-05 | 2.69806334e-01
2.77639089e-05 | 2.70536162e-01
2.87639089e-05 | 2.71265262e-01
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
