gonewx/quadcuber/generated/electronics/simulation/linux-reference/xyce-compatibility/runs/default/switch_transfer/switch_transfer.cir.csv

V(CTRL) | I(VTEST)
3.00000000e-01 | -1.00000000e-07
3.50000000e-01 | -1.00000000e-07
4.00000000e-01 | -1.00000000e-07
4.50000000e-01 | -1.32561970e-07
5.00000000e-01 | -2.91871716e-07
5.50000000e-01 | -9.80829455e-07
6.00000000e-01 | -4.62272148e-06
6.50000000e-01 | -2.80788302e-05
7.00000000e-01 | -2.01981534e-04
7.50000000e-01 | -1.58113883e-03
8.00000000e-01 | -1.23773691e-02
8.50000000e-01 | -8.90350480e-02
9.00000000e-01 | -5.40806971e-01
9.50000000e-01 | -2.54886309e+00
1.00000000e+00 | -8.56540685e+00
1.05000000e+00 | -1.88591041e+01
1.10000000e+00 | -2.50000000e+01
1.15000000e+00 | -2.50000000e+01
1.20000000e+00 | -2.50000000e+01
