gonewx/quadcuber/generated/electronics/simulation/linux-reference/xyce-compatibility/runs/zero_v_ic/zero_v_ic_a_double_nested_op/zero_v_ic_a_double_nested_op.cir.csv

TIME | V(A) | V(B) | V(OUT) | I(XTEST:XCORE:VZERO)
0.00000000e+00 | 2.50000000e-01 | 2.50000000e-01 | 6.25000000e-02 | 0.00000000e+00
1.00000000e-06 | 2.50749251e-01 | 2.50749251e-01 | 6.28751868e-02 | 0.00000000e+00
2.00000000e-06 | 2.51497753e-01 | 2.51497753e-01 | 6.32511198e-02 | 0.00000000e+00
3.00000000e-06 | 2.52245881e-01 | 2.52245881e-01 | 6.36279846e-02 | 0.00000000e+00
4.00000000e-06 | 2.52993262e-01 | 2.52993262e-01 | 6.40055904e-02 | 0.00000000e+00
5.00000000e-06 | 2.53739895e-01 | 2.53739895e-01 | 6.43839343e-02 | 0.00000000e+00
6.00000000e-06 | 2.54485782e-01 | 2.54485782e-01 | 6.47630133e-02 | 0.00000000e+00
7.00000000e-06 | 2.55230924e-01 | 2.55230924e-01 | 6.51428245e-02 | 0.00000000e+00
8.00000000e-06 | 2.55975321e-01 | 2.55975321e-01 | 6.55233648e-02 | 0.00000000e+00
9.00000000e-06 | 2.56718974e-01 | 2.56718974e-01 | 6.59046314e-02 | 0.00000000e+00
1.00000000e-05 | 2.57461883e-01 | 2.57461883e-01 | 6.62866213e-02 | 0.00000000e+00
1.10000000e-05 | 2.58204050e-01 | 2.58204050e-01 | 6.66693315e-02 | 0.00000000e+00
1.20000000e-05 | 2.58945475e-01 | 2.58945475e-01 | 6.70527592e-02 | 0.00000000e+00
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
