gonewx/quadcuber/generated/electronics/simulation/linux-reference/xyce-compatibility/runs/zero_v_ic/zero_v_ic_a_op/zero_v_ic_a_op.cir.csv

TIME | V(A) | V(B) | V(OUT) | I(VZERO)
0.00000000e+00 | 1.00000000e+00 | 1.00000000e+00 | 1.00000000e+00 | 0.00000000e+00
1.00000000e-06 | 1.00000000e+00 | 1.00000000e+00 | 1.00000000e+00 | 0.00000000e+00
2.00000000e-06 | 1.00000000e+00 | 1.00000000e+00 | 1.00000000e+00 | 0.00000000e+00
3.00000000e-06 | 1.00000000e+00 | 1.00000000e+00 | 1.00000000e+00 | 0.00000000e+00
4.00000000e-06 | 1.00000000e+00 | 1.00000000e+00 | 1.00000000e+00 | 0.00000000e+00
5.00000000e-06 | 1.00000000e+00 | 1.00000000e+00 | 1.00000000e+00 | 0.00000000e+00
6.00000000e-06 | 1.00000000e+00 | 1.00000000e+00 | 1.00000000e+00 | 0.00000000e+00
7.00000000e-06 | 1.00000000e+00 | 1.00000000e+00 | 1.00000000e+00 | 0.00000000e+00
8.00000000e-06 | 1.00000000e+00 | 1.00000000e+00 | 1.00000000e+00 | 0.00000000e+00
9.00000000e-06 | 1.00000000e+00 | 1.00000000e+00 | 1.00000000e+00 | 0.00000000e+00
1.00000000e-05 | 1.00000000e+00 | 1.00000000e+00 | 1.00000000e+00 | 0.00000000e+00
1.10000000e-05 | 1.00000000e+00 | 1.00000000e+00 | 1.00000000e+00 | 0.00000000e+00
1.20000000e-05 | 1.00000000e+00 | 1.00000000e+00 | 1.00000000e+00 | 0.00000000e+00
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
