gonewx/quadcuber/generated/electronics/simulation/linux-reference/xyce-compatibility/runs/zero_v_ic/zero_v_ic_a_uic/zero_v_ic_a_uic.cir.csv

TIME | V(A) | V(B) | V(OUT) | I(VZERO)
0.00000000e+00 | 2.50000000e-01 | 0.00000000e+00 | 0.00000000e+00 | 0.00000000e+00
1.00000000e-06 | 2.50749251e-01 | 2.50749251e-01 | 2.50749251e-01 | 0.00000000e+00
1.01562500e-06 | 2.50760958e-01 | 2.50760958e-01 | 2.50760958e-01 | 0.00000000e+00
1.03125000e-06 | 2.50772664e-01 | 2.50772664e-01 | 2.50772664e-01 | 0.00000000e+00
1.04531250e-06 | 2.50783200e-01 | 2.50783200e-01 | 2.50783200e-01 | 0.00000000e+00
1.07343750e-06 | 2.50804272e-01 | 2.50804272e-01 | 2.50804272e-01 | 0.00000000e+00
1.12968750e-06 | 2.50846413e-01 | 2.50846413e-01 | 2.50846413e-01 | 0.00000000e+00
1.24218750e-06 | 2.50930688e-01 | 2.50930688e-01 | 2.50930688e-01 | 0.00000000e+00
1.46718750e-06 | 2.51099209e-01 | 2.51099209e-01 | 2.51099209e-01 | 0.00000000e+00
1.91718750e-06 | 2.51436139e-01 | 2.51436139e-01 | 2.51436139e-01 | 0.00000000e+00
2.81718750e-06 | 2.52109543e-01 | 2.52109543e-01 | 2.52109543e-01 | 0.00000000e+00
3.81718750e-06 | 2.52857060e-01 | 2.52857060e-01 | 2.52857060e-01 | 0.00000000e+00
4.81718750e-06 | 2.53603830e-01 | 2.53603830e-01 | 2.53603830e-01 | 0.00000000e+00
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
