gonewx/quadcuber/generated/electronics/simulation/linux-reference/xyce-compatibility/runs/zero_v_ic/zero_v_ic_b_uic/zero_v_ic_b_uic.cir.csv

TIME | V(A) | V(B) | V(OUT) | I(VZERO)
0.00000000e+00 | 0.00000000e+00 | 2.50000000e-01 | 0.00000000e+00 | 0.00000000e+00
1.00000000e-06 | 9.99000999e-04 | 9.99000999e-04 | 9.99000999e-04 | 0.00000000e+00
1.01562500e-06 | 1.01461015e-03 | 1.01461015e-03 | 1.01461015e-03 | 0.00000000e+00
1.03125000e-06 | 1.03021917e-03 | 1.03021917e-03 | 1.03021917e-03 | 0.00000000e+00
1.04531250e-06 | 1.04426708e-03 | 1.04426708e-03 | 1.04426708e-03 | 0.00000000e+00
1.07343750e-06 | 1.07236232e-03 | 1.07236232e-03 | 1.07236232e-03 | 0.00000000e+00
1.12968750e-06 | 1.12855042e-03 | 1.12855042e-03 | 1.12855042e-03 | 0.00000000e+00
1.24218750e-06 | 1.24091714e-03 | 1.24091714e-03 | 1.24091714e-03 | 0.00000000e+00
1.46718750e-06 | 1.46561265e-03 | 1.46561265e-03 | 1.46561265e-03 | 0.00000000e+00
1.91718750e-06 | 1.91485205e-03 | 1.91485205e-03 | 1.91485205e-03 | 0.00000000e+00
2.81718750e-06 | 2.81272464e-03 | 2.81272464e-03 | 2.81272464e-03 | 0.00000000e+00
3.81718750e-06 | 3.80941357e-03 | 3.80941357e-03 | 3.80941357e-03 | 0.00000000e+00
4.81718750e-06 | 4.80510631e-03 | 4.80510631e-03 | 4.80510631e-03 | 0.00000000e+00
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
