gonewx/quadcuber/docs/lego/v4/README.md

# v4：反向连杆、推杆导向与一体推杆

日期：2026-10-04。基准：双侧轮胎压头＋防翻折限位版（提交 `b9aa5d5`，说明书在 `docs/lego/v3-baseline/`）。模型：`tools/lego/v4/model.py`。

- **[搭建说明书（22 步，含可旋转模型）](index.html)** · [零件清单](bom.csv) · [MPD 模型](model.mpd)
- 选型过程：[`docs/rod-guide-options.md`](../../rod-guide-options.md)

**状态：名义 CAD 检查全部通过，当前改装后的实物验收仍待完成。** 推杆用原有的 12 号轴，不需要 16 号轴。下文保留了修改过程；当前结构以 `tools/lego/v4/model.py` 和最新改装段落为准。

**当前标定入口**：往后拉夹紧；名义夹紧在曲柄折叠死点前 **25°**，张开曲柄行程约 **110°**。这些只是 CAD 几何角度，不是实测脉宽，也不要求碰到死点。按 [单臂标定步骤](../../single_arm.md#servo-calibration)使用 `servo_cal` 手动会话，首次定位先脱开连杆；实测端点、安全工作区间及 `v4`／`R` 身份确认后才设置端点标定标志；随后用人工选择的保守临时等待时间做单次 `open` / `close` 测时，实测确认 `SERVO_MOVE_MS` 并设置 `SERVO_TIMING_CONFIRMED = True`、上传重载后，才允许连续开合和普通旋转。旧值、旧的“拉到死点”或直接 `servo` 示例不能沿用。舵机固定在平台上，不因舵机缠线限制转盘累计角度。

本目录早先放过一版“十字块前导向＋后部后移 2 孔”的 v4。它要把机械头加长 16mm，已被本版替换，没有保留。

## 为什么改

实物夹住魔方后轻压明显下移，推杆导向框有被撬出的趋势。原因是上下夹指共用的十字接头没有导向：魔方重量经夹指杠杆放大约 2.5 倍，全靠推杆从导向框伸出约 56mm 的悬臂来扛。

原版没法在机械头里加导向：十字接头在连杆后面，张开时会退进转盘上半的凸台范围。v4 把连杆反过来接，十字接头移到连杆前面，问题就消失了，机械头不用加长。连带的两项改动：

- 导向框和舵机当初后移 2 孔，是为了躲开后退的十字接头和推杆连接器。这个原因已经不存在，所以移回最初位置。
- 移回后推杆可以用一根 12 号轴，不再需要连接器。推杆只靠推杆导向和导向框前孔两处支承，导向框后孔不用。

## 改了什么

| 部位 | 基准版 | v4 |
| --- | --- | --- |
| 开合方向 | 往前推夹紧，往后拉张开 | **往后拉夹紧，往前推张开** |
| 十字接头位置 | 连杆后面，张开时退进转盘凸台 | **连杆前面**，全程在凸台前方 13mm 以上 |
| 十字接头、两根 5 孔连杆 | 米色长销穿十字接头 | 十字接头换到另一头；横销改为 **4 号轴＋两端半轴套**（见下文“侧梁让位”） |
| 侧板内侧梁 | 整根 11 孔梁 | **一长一短两段（5 孔＋3 孔）**，中段让给连杆；外侧加 7 孔梁连接上下 L 形梁 |
| 推杆导向 | 只有导向框两个孔 | 加一个 **32184 十字块**，10-05 起放在**转盘上半凸台内腔**里（前表面与转盘正面齐平）；两根 **8 号轴**穿 L 形梁、凸台端壁和十字块，同时代替侧板接转盘的 4 个销；推杆在中间圆孔里滑动 |
| 推杆 | 3 号轴＋连接器＋12 号轴 | **一根 12 号轴**，导向框后孔不用 |
| 导向框（7x5） | 比最初版本后移 2 孔 | **回到最初位置**，前移 2 孔 |
| 舵机 | 比最初版本后移 2 孔 | **回到最初位置**，前移 2 孔；垫块上的销重排 |
| 舵机连杆 | 7 孔粗梁第 2、7 孔，夹紧在伸直死点 | 同一根梁改用**第 1、7 孔**，当前名义夹紧在**折叠死点前 25°**（曲柄朝后） |
| 机械头长度、底座、竖墙、马达 | — | **都不变** |

## 单臂改装（从基准版实物出发）

1. **拆下**：整根推杆（3 号轴、连接器、12 号轴，12 号轴留着再用）；十字接头连同米色长销、两根连杆从夹指上取下（连杆另一端的灰色销可以留在主臂上）；舵机和导向框从平台上取下。
2. **导向框前移 2 孔**（说明书第 9 步）：两根蓝色长销改插平台框架长边的中间两个孔（从后数第 2、3 个竖孔），最靠后的那个孔补一个黑销。
3. **舵机前移 2 孔**（第 9、10 步）：舵机垫块（7 孔粗梁）位置不变，从平台后端数，黑销改插第 1、5、6 孔，舵机耳朵的蓝色长销改插第 3、7 孔。第 2、4 孔下面被 55615 的销占着，不要插。
4. **舵机连杆改孔**（第 12 步）：靠十字块那端从第 2 孔改到第 1 孔。
5. **装推杆导向**（第 14 步，10-05 起）：32184 从转盘正面中心孔放进上半凸台内腔，两侧各一个整轴套；两根 8 号轴从外侧穿过 L 形梁、凸台端壁、整轴套、十字块，两端加半轴套，代替侧板接转盘的 4 个摩擦销。
6. **装十字接头**（第 18 步）：十字接头放在连杆**前面**，即靠魔方一侧，十字孔朝后。4 号轴穿十字接头圆孔，两根连杆套在轴两端，最外面各一个半轴套，另一端仍接主臂第 2 孔。
7. **穿推杆**（第 19、20 步）：转盘上半扣好后，从平台后面把 12 号轴穿过导向框后孔（只是借道），依次穿过半轴套、舵机侧十字块、半轴套、导向框前孔、转盘中孔、推杆导向，最后插进十字接头到底。装好后推杆后端停在后孔前面。
8. **舵机重新标定**：方向反了，往后拉是夹紧。按 [`single_arm.md` 第 3 步](../../single_arm.md#servo-calibration)先脱开连杆，声明 `servo_cal ... detached` 后定位；断电装接并核实轴标记与基准脉宽后，才能声明 `aligned` 会话、小步找端点。当前名义夹紧在曲柄折叠死点前 25°，张开经远离推杆一侧约 110°；不能直接把这些 CAD 角度换成脉宽，也不能沿用旧值。

每臂零件变化：

| 零件 | 变化 |
| --- | --- |
| 32184 十字块 1x3（中间圆孔、两端十字孔） | +1 |
| 8 号轴 3707 | +2 |
| 半轴套 32123a | +4 |
| 3 号轴 4519、光面轴连接器 59443 | 各 −1 |

整机：32184 ×4、8 号轴 +8、半轴套 +16，少 4 个 3 号轴和 4 个连接器；总件数 696 → 716。侧梁让位（见下节）后再 +56，共 772；夹紧余量修改后再 +8，共 780；导向移入转盘凸台后为 740。

## 计算结果（名义值）

推杆按欧拉梁计算，导向框两孔和推杆导向都按简支处理，各方案用同一假设比较。没有计入销孔游隙，实际改善会小于表中比例。

> 下表“v4”一列是 2026-10-05 修改夹紧余量之前的历史方案；约 130° 的曲柄行程不是当前标定依据。当前连杆恢复主臂第 2 孔、长 80，夹紧点保留折叠死点前 25°，曲柄行程约 110°；见后文“推杆导向移入转盘凸台”及最新加固段落。

| 项目 | 基准版 | 已放弃的加长版 | v4 |
| --- | ---: | ---: | ---: |
| 转盘到轮轴 | 79.9mm | 95.9mm | **79.9mm** |
| 机械头质量（估算） | 约 57g | 约 67g | 约 61g |
| 机械头质心到转盘 | 约 30mm | 约 43mm | 约 29mm |
| 推杆弯曲造成的魔方下沉（夹紧，相对值） | 1 | 约 1/15 | **约 1/23** |
| 同上（松开） | 1 | 约 1/5 | 约 1/15 |
| 导向框受力（魔方重量 W 的倍数，夹紧） | 5.5W | 1.2W | 1.0W（只有前孔受力） |
| 推杆导向受力（夹紧） | — | 1.7W | 3.5W |
| 十字接头横移 1mm 引起魔方平移（夹紧） | 2.55mm | 2.55mm | 2.46mm |
| 每轮 2N 夹紧所需推杆力 | 2.70N | 3.16N | **2.61N** |
| 推杆每动 1mm 轮端开合（夹紧附近） | 0.68mm | 0.79mm | 0.65mm |
| 推杆行程 | 10.00mm | 8.14mm | 12.92mm |
| 舵机曲柄转角 | 约 97° | — | 约 130°（174°→45°） |
| 防翻折 | 开端到翻折只剩 1.6mm 推杆行程 | 0.8mm | **行程内没有翻折点** |

防翻折：连杆与主臂共线时两组装配解汇合，那里就是翻折点。v4 中十字接头到根轴的距离在 81~82 LDU 之间变化，离共线所需的 120 或 40 LDU 都很远，所以整个行程不会翻折。开限位挡轴保留，作异常保护。

导向框和舵机前移、改用一体推杆之后，推杆在十字接头处的柔度又降了约 13%。曾考虑用 16 号轴同时穿过导向框后孔，但最短需要约 14.7 个孔长，乐高没有 13~15 号轴，16 号轴会在后面多伸出约 24mm；多一处后孔支承只让柔度再降约 8%，不值得，所以用 12 号轴。

## 检查结果

全部使用原有检查程序（`tools/lego/v4/`）：

| 检查 | 结果 |
| --- | --- |
| `run_check.py`：连接、孔型、插深、挡环销装配顺序、同孔；单模块夹紧、松开、7 个中间位置；四臂整机含底座；曲柄连续回转 | 0 问题 |
| `mesh_clearance.py`：81 个开合位置三角网格距离 | 0 相交；最小间隙 0.25mm（夹紧时十字接头尾部对推杆导向） |
| `mesh_clearance.py`：整圈回转对竖直邻臂及本臂固定件，288 个状态 | 0 相交，下界 ≥2mm |
| `four_arm.py`：四臂 576 个状态 | 与基准版相同：邻臂竖直时无干涉，相邻两臂不能同时水平 |
| `mechanical_audit.py` | 曲柄轴对推杆径向余量 6.8mm；旋转半轴套对舵机连杆 2.62mm（基准版 0.89mm）；推杆穿导向框和舵机侧十字块的孔属有意配合，其余固定件离推杆 ≥3.5mm；魔方连续回转包络 2.31 / 7.77 / 1.33 / 9.66mm，与基准版相同 |
| `verify_pressure_pads.py` | 通过；导向框前孔和舵机侧十字块两侧半轴套全程都在推杆范围内（10-05 起为 16 号轴，后孔也在范围内） |

对检查程序的修改：

- `mechanical_audit.py` 的曲柄检查原来假设推杆一直伸到曲柄后面。v4 夹紧时曲柄朝后折叠，超出推杆后端，所以改为按无限长推杆计算径向余量，比实际更严格；同时识别 16 号推杆。
- `verify_pressure_pads.py` 中推杆与轴承孔的断言改为一体 12 号轴：只要求导向框前孔和舵机侧十字块在推杆范围内，后孔不用。
- 基准版的 `verify_open_stops.py` 按旧连杆方向计算翻折点，不适用于 v4，没有复制。

## 风险与待测

1. ~~连杆贴着 11 孔梁滑动~~：实测摩擦严重，已按下节“侧梁让位”修改。新结构的刚度靠外侧 7 孔梁和 32184 两侧撑开轴套，实物要再查侧板是否晃。
2. **推杆导向承受约 4.3 倍魔方重量的横向力**（10-05 起导向在转盘凸台里，离十字接头 24~37mm）。这是十字轴在圆孔里滑动，摩擦和磨损要实测。
3. ~~夹紧时十字接头尾部离推杆导向只有 0.25mm~~：实测十字接头先顶住导向、轮胎压不紧，已按“夹紧余量”一节修改，余量约 10mm。
4. **舵机夹紧点**：10-05 起名义夹紧点在折叠死点前 25°。余量仅供实物小步检查后微调预压，不代表整段都能安全通电；折叠死点是不能越过的几何边界，不是夹紧目标。模型的避让结果不等于实物验证，实际安全区间须按单臂流程标定。
5. **拆机械头要先抽推杆。** 一体推杆贯穿转盘，整体拆下机械头前，要先把 12 号轴从平台后面抽出来，或者把十字接头从推杆前端拔下。
6. **转盘本身的晃动没有改变。** 推杆问题解决后，它可能成为下沉的主要来源。

## 侧梁让位（2026-10-04 实测后修改）

**问题**：实物第 18 步，连杆和十字接头摩擦侧梁很严重。原因有三点：
- 十字接头移到连杆前方后，正好在 11 孔侧梁所在的 x = −140 ~ −120 范围内来回走。除夹紧位置外，连杆端头和米色长销端面在整个行程都贴着侧梁大面滑动（全开时贴合范围是 y = −10 ~ +46）；
- 厚度方向上，十字接头 20 加两根连杆 2×20，正好等于两侧侧梁内面之间的 60，名义间隙为 0；
- 32184 两根 8 号轴中间没有撑开件，外侧半轴套一推紧就把两侧侧板往里拉。

基准版的十字接头在连杆后面（x < −170），连杆从不经过侧梁，所以这是 v4 引入的问题。网格检查只判断是否相交，贴面算通过，因此没发现。

**改法**（每臂）：

| 部位 | 原来 | 现在 |
| --- | --- | --- |
| 侧板内侧梁 | 11 孔粗梁 ×2 | 每侧 5 孔＋3 孔粗梁各一段。贴上连杆的一侧，5 孔在下、3 孔在上；另一侧上下相反。中段空档让给连杆和十字接头。10-05 起 5 孔段再往外移一孔：第 1、2 孔接 L 形梁短臂中间孔和末端孔，第 5 孔伸出空着 |
| 侧板连接 | 4 个黑销 ×2 | 每侧 3 根蓝色长销（内侧梁＋L 形梁＋外侧梁）＋2 个黑销（L 形梁＋外侧梁，7 孔梁第 3、5 孔） |
| 外侧连接梁 | — | 每侧一根 7 孔粗梁，贴在 L 形梁短臂外侧，把上下两根 L 形梁重新连成一体（原来靠 11 孔梁） |
| 十字接头横销 | 米色 3 孔无摩擦长销 | **4 号轴＋两端半轴套**。侧梁让开后，连杆在厚度方向改由半轴套挡住 |
| 推杆导向两侧 | 空 | 两根 8 号轴上，32184 两侧各套 2 个整轴套，共 8 个。撑住侧板，32184 也停在正中 |

零件变化（每臂，相对侧梁让位前）：32525 −2；32316 +2；32523 +2；32524 +2；6558 +6；2780 −6；32556a −1；3705 +1；32123a +2；3713 +8。10-05 的变化另见下节。

**检查**：
- `run_check.py` 0 问题；`mesh_clearance.py` 0 相交；`four_arm.py`、`mechanical_audit.py`（魔方回转包络 2.31 / 7.77 / 1.33 / 9.66mm）、`verify_pressure_pads.py` 结果都与修改前相同。
- 补查贴面：在 81 个开度下，把连杆和十字接头沿厚度方向往侧梁挪 1 LDU，再测三角网格距离。连杆离 5 孔段至少 0.82mm，离 3 孔段至少 3.5mm，说明投影上已没有重叠，不会再贴面。
- 横轴挡套离 5 孔段 0.8mm。

**已装好 v4 的改法**：
1. 先抽出推杆，从夹指上取下十字接头和连杆。
2. 拆下两侧 11 孔梁，换成 5 孔＋3 孔两段，同时在外侧装 7 孔梁（第 13 步）。注意：两侧的长短段上下相反。
3. 在 32184 两侧的 8 号轴上补整轴套（第 15 步）。
4. 米色长销换成 4 号轴＋两个半轴套（第 18 步）。
5. 断电手推推杆走完全行程，连杆不应再碰侧梁。

**代价和待测**：
- 贴上连杆一侧的 3 孔段只有 1 个销接 L 形梁。它不绕这个销转，是靠限位支架（十字孔套在根轴上）和根轴，与另一侧的 5 孔段连成一体，属于间接约束。
- 上下 L 形梁原来靠 11 孔梁在靠魔方一端相连，现在靠外侧 7 孔梁。实物夹住魔方后，要按“10 秒检查”比较侧板晃动是否变大。
- 侧板外侧多了 1 孔厚，回转包络和四臂检查都不受影响。

## 夹紧余量（2026-10-05 实测后修改）

> **本节方案已被下一节“推杆导向移入转盘凸台”取代**：连杆恢复长 80，推杆恢复 12 号轴。本节保留作记录。

**问题**：十字接头往后顶住推杆导向时，夹指还没到位，轮胎只碰到魔方，没有压紧。原连杆（主臂第 2 孔、5 孔连杆、长 80）在名义夹紧位置，十字接头尾部离 32184 只有 0.25mm。按每 1mm 推杆行程带动轮端 0.65mm 计算，每侧只能再多压约 0.16mm，抵不过轮胎、魔方和孔位间隙的误差。导向块已经紧贴转盘，不能后移；所以只能改连杆几何，让名义夹紧时十字接头停在更靠前的位置。

**选型**：我按主臂接点（第 1~3 孔、根轴前方）、连杆长 60~120、十字接头前后两种接法逐一扫描，条件是：仍然往后拉夹紧、连杆不贴侧梁、余量足够、所需推杆力不要太大。选中的方案是：

| 项目 | 原连杆 | 现在 |
| --- | ---: | ---: |
| 主臂接点 | 第 2 孔（根轴后 2 孔） | **第 1 孔（根轴后 3 孔）** |
| 连杆 | 5 孔粗梁第 1、5 孔（长 80） | **7 孔粗梁第 1、6 孔（长 100）**，第 7 孔伸过十字接头空着 |
| 名义夹紧时十字接头尾部离推杆导向 | 0.25mm | **约 10mm** |
| 推杆每动 1mm 轮端开合（夹紧附近） | 0.65mm | 1.35mm |
| 每轮 2N 夹紧所需推杆力 | 2.61N | 5.41N |
| 推杆行程（3.84°→25°） | 12.92mm | 9.69mm |
| 十字接头横移 1mm 引起魔方平移 | 2.46mm | 1.58mm |
| 推杆伸出导向（十字接头销到 32184） | 16~29mm | 26~36mm |
| 推杆导向／导向框前孔受力（夹紧） | 3.5W／1.0W | 2.6W／1.0W |
| 推杆弯曲造成的魔方下沉（相对基准版） | 约 1/23 | 约 1/18 |
| 十字接头到根轴（翻折点在 40 或 160） | 81~82 LDU | 80~85 LDU，行程内不翻折 |

其他配套修改：

- **推杆改 16 号轴**。十字接头前移约 10mm 后，12 号轴后端会脱出舵机侧半轴套。16 号轴同时穿过导向框前、后两孔，舵机侧十字块正好在两孔之间，支承比原来好；夹紧时后端从后孔伸出约 14mm（`run_check.py` 和 `mechanical_audit.py` 确认不碰舵机、曲柄和平台）。
- **夹紧点不再放在折叠死点**。`CLAMP_CRANK_DEG = 25`：名义夹紧时曲柄离折叠还差 25°。从这里到折叠，推杆还能再往后 0.64mm，对应每侧轮胎再压 0.86mm，可以只靠调舵机脉宽来增减预压。曲柄转角从约 130° 变为约 85°。
- **侧梁 5 孔段外移一孔**。新连杆更斜，夹紧附近连杆在十字接头那一端会伸到 5 孔段的投影范围里，外移后离开 5.2mm。

**调整方法（本节历史方案，当前标定必须按[单臂会话流程](../../single_arm.md#servo-calibration)执行）**：
1. 先粗调：断电，把曲柄放在离折叠约 25° 处，往后拉推杆到轮胎刚好压住魔方，再把舵机侧十字块两侧半轴套贴紧。
2. 再细调：通电后，脉宽往折叠方向小步加，直到轮胎明显压缩。曲柄不要越过折叠死点。

**检查**：
- `run_check.py` 0 问题；`mesh_clearance.py` 0 相交，整圈回转下界 ≥2mm。
- 第一版让连杆的第 1 孔伸到主臂后面，回转时撞到马达齿轮轴，已改为第 7 孔伸过十字接头。现在离齿轮轴最近 4.9mm。
- 贴面补查：连杆往侧梁挪 1 LDU 后，离 5 孔段至少 5.2mm。
- `four_arm.py` 与原来相同；`verify_pressure_pads.py` 通过。
- `mechanical_audit.py`：曲柄轴对推杆 10.1mm，旋转半轴套对舵机连杆 2.80mm。魔方连续回转包络为 2.31 / 7.77 / 1.33 / **2.59**mm：最后一项（邻臂松开竖直、整块翻转）原来是 9.66mm，现在受连杆空着的第 7 孔限制，仍有 2.59mm。

**零件变化（每臂）**：32316 −2（旧连杆）；32524 +2（新连杆）；3708 −1；50451 +1；2780 +2。整机 772 → 780。

**已装好的改法**：
1. 拔下十字接头，取下两根 5 孔连杆。
2. 换成 7 孔粗梁：第 1 孔接主臂最后一个孔，第 6 孔套在十字接头的 4 号轴上。
3. 两侧 5 孔内侧梁往外移一孔，接 L 形梁短臂的中间孔和末端孔，并在外侧 7 孔梁第 3、5 孔补黑销。
4. 推杆换成 16 号轴。
5. 按上面的方法重新标定舵机。

**代价和待测**：
- 夹紧所需推杆力约翻倍。推杆和十字接头之间只靠十字孔摩擦，现在受拉，拉力加大后更可能被拔出来，夹紧后要检查推杆插深有没有变。舵机侧十字块的半轴套同理。
- 推杆每动 1mm，轮端动 1.35mm，粗调时预压比原来敏感，细调要靠舵机脉宽。

## 推杆导向移入转盘凸台（2026-10-05）

> 导向的固定方式和侧板接转盘的方式，已被下一节“转盘两侧连接加固”修改。

**思路**：夹紧余量不够，根源是 32184 贴在转盘正面、正好挡在十字接头尾巴后面。转盘上半和下半一样，底部有 5x3 的长方形凸台，内腔是空的，侧板就是用销插在凸台两端孔上。把导向放进这个内腔，导向仍随机械头转动，前表面与转盘正面齐平；十字接头尾巴可以一直退到转盘中心孔口。于是连杆、推杆都能回到 v4 最初的几何，不需要加长连杆，也不需要 16 号轴。

**结构**（每臂）：
- 32184 从转盘正面中心孔放进上半凸台内腔：中间圆孔对准推杆，两端十字孔对准凸台端壁上的孔。模型确认可以沿推杆方向直接放进去，全程不碰转盘；放好后离转盘 2.2mm。
- 两根 8 号轴从外侧依次穿过：L 形梁、凸台端壁、整轴套、十字块、整轴套、端壁、L 形梁，两端各加半轴套。十字块侧面到端壁内表面正好 8mm，每侧一个整轴套贴满，把十字块定在正中。（最初误写成半轴套：网格检查把整轴套和端壁的零间隙贴面当成了碰撞。半轴套会每侧留 4mm 空隙，只能靠摩擦定位。）
- 这两根 8 号轴代替原来侧板接转盘的 4 个摩擦销：每套侧板仍有两处连接（y = ±8mm），不会绕轴转。
- 连杆恢复主臂第 2 孔、5 孔粗梁（长 80）；推杆恢复一根 12 号轴。侧梁按“侧梁让位”第一版：5 孔段孔位 20~100，接 L 形梁短臂的拐角孔和末端孔；外侧 7 孔梁不变。
- 舵机仍是名义夹紧点在折叠死点前 25°，曲柄转角约 110°。

| 项目 | v4 最初 | 连杆长 100 方案 | **当前** |
| --- | ---: | ---: | ---: |
| 夹紧时十字接头尾部离导向 | 0.25mm | 约 10mm | **8.25mm** |
| 每轮 2N 夹紧所需推杆拉力 | 2.61N | 5.41N | **2.61N** |
| 推杆每动 1mm 轮端开合 | 0.65mm | 1.35mm | 0.65mm |
| 推杆行程 | 12.92mm | 9.69mm | 12.92mm |
| 推杆 | 12 号 | 16 号 | **12 号** |
| 导向到十字接头销 | 16~29mm | 26~36mm | 24~37mm |
| 推杆导向／导向框前孔受力（夹紧） | 3.5W／1.0W | 2.6W／1.0W | 4.3W／1.9W |
| 推杆弯曲造成的魔方下沉（相对基准版） | 约 1/23 | 约 1/18 | 约 1/11 |

**硬挡块**：越过夹紧继续往后拉，十字接头尾部离导向依次为 6.0 / 4.0 / 2.0mm（十字接头销在 x = −155 / −160 / −165）。到 −170 时，连杆正好垂直于推杆（死点），尾部同时碰到导向。这是名义 CAD 的硬挡位置，不保证实物在受力、变形或零件松脱时仍能防止过行程；正常夹紧不能以撞到它为目标，实物止挡仍需验收。

**检查**：
- `run_check.py` 0 问题；`mesh_clearance.py` 0 相交。整轴套两端与十字块、凸台端壁是名义贴面：`mesh_clearance.py` 新增判据，轴套沿轴线缩短 1% 后不再接触，记为贴面而不算相交。
- 整圈回转下界 1.28mm，由导向 8 号轴外侧的半轴套对马达 24 齿齿轮决定。原来这里是摩擦销，现在轴头外多了半轴套，余量偏紧，实物转一圈确认。
- 贴面补查：连杆离侧梁 5 孔段 0.82mm。
- `four_arm.py` 与原来相同；`verify_pressure_pads.py` 通过。
- `mechanical_audit.py`：魔方回转包络 2.31 / 7.77 / 1.33 / 9.66mm，与基准版相同；曲柄轴对推杆 10.1mm；旋转半轴套对舵机连杆 2.80mm。

**从“连杆长 100”实物改回来**：
1. 拆下推杆和十字接头；拆下转盘正面的 32184、两根 8 号轴及其上的轴套。
2. 把侧板从转盘上取下，拔掉凸台两端的 4 个摩擦销。
3. 32184 从正面放进凸台内腔，侧板贴回凸台两端，穿两根 8 号轴：内侧每边一个整轴套，外端各一个半轴套（第 14 步）。
4. 侧梁 5 孔段往推杆方向移回一孔：接 L 形梁短臂的拐角孔和末端孔，并拔掉外侧 7 孔梁中间多出的那个黑销（第 13 步）。
5. 7 孔连杆换回 5 孔连杆，接主臂第 2 孔。
6. 推杆换回 12 号轴，按第 19 步重新粗调和细调。

**代价和待测**：
- 往后拉夹紧，推杆和十字接头之间仍靠摩擦受拉，拉力约 2.6N（约 270g）。建议先测一下拔出力：推杆竖起、十字接头朝下挂水瓶，逐步加重。
- 导向比贴在转盘正面时后退了 8mm，下沉估算从 1/23 变为 1/11，仍比基准版好得多。
- 侧板与转盘的连接从摩擦销换成穿孔的 8 号轴，夹住魔方后看一下侧板根部有没有晃动。

## 转盘两侧连接加固（2026-10-05）

> 转盘上半一侧（侧板连接和导向）已被下一节“39793 一体导向”取代；转盘下半的 6 根蓝色长销保留。

**实测**：魔方的重量让机械头明显下垂，看起来是转盘固定框和“L 形梁接转盘”两处叠加造成的。

**原因**：机械头靠这条路径挂在墙上：

> 侧板 L 形梁 → 转盘上半凸台端壁 → 转盘轴承 → 转盘下半凸台端壁 → 固定框

两头的凸台端壁都只有一排 3 个孔（上中下，间距 8mm）。魔方离转盘约 80mm，力臂和孔距之比约 5 倍，连接处的间隙会被放大 5 倍左右，变成魔方的下沉。

- **上半**：上一版为了固定导向，把 L 形梁接凸台的 4 个摩擦销换成了 2 根贯穿的 8 号轴。十字轴在圆孔里有间隙，这一步让侧板根部变松了。
- **下半**：每个凸台只有 1 根红色挡套销（上下错开），其余 4 个孔空着。这些销只能从凸台内腔往外插，而内腔中间那排要让推杆通过。

**改法**：

| 位置 | 原来 | 现在 |
| --- | --- | --- |
| 转盘下半 ↔ 固定框 | 2 根 32054（一头一根，上下错开） | **6 根蓝色长摩擦销 6558，从框架外侧插入**：2 孔长一段穿过框架短边和凸台端壁，挡肩和 1 孔长一段留在外面。两头的上中下孔全部用上，中间一排不进内腔，碰不到推杆 |
| L 形梁 ↔ 转盘上半 | 2 根贯穿 8 号轴 | **恢复 4 个摩擦销**（上下两个孔） |
| 推杆导向 | 32184 套在两根 8 号轴上，内侧整轴套 | **吊挂式组件**：32184＋两根 3 号轴＋4 个半轴套＋两片 6632 薄梁，整体正好 3 孔宽，从正面放进凸台内腔。两根蓝色长销从侧板外面、两根 L 形梁之间的空隙，穿过凸台端壁的**中间孔**，插进薄梁的中间圆孔 |

导向组件的两根吊销都在推杆轴线的高度上，组件可以绕推杆轴线微微摆动（自动对正），但上下、左右、前后都被定住，推杆的横向支承不受影响。整个路径里，十字轴配圆孔的连接只剩推杆本身。

**检查**：
- `run_check.py` 0 问题；`mesh_clearance.py` 0 相交。
- 6632 薄梁贴住凸台端壁内表面是名义贴面：往里挪 0.1 LDU 间隙就是 0.04mm。`mesh_clearance.py` 的贴面判据从轴套推广到了薄梁。
- 整圈回转下界恢复到 ≥2mm。上一版导向轴外侧的半轴套离马达齿轮只有 1.28mm，现在去掉了。
- `four_arm.py`、`verify_pressure_pads.py`、`mechanical_audit.py` 都通过，魔方回转包络 2.31 / 7.77 / 1.33 / 9.66mm 不变。

**零件**（每臂，相对上一版）：
- 增加：6558 ＋8（下半 6 根，吊销 2 根）；6632 ＋2；3 号轴 ＋2；2780 ＋4。
- 减少：32054 −2；8 号轴 −2；整轴套 −4。半轴套数量不变（内侧 4 个代替外侧 4 个）。
- 整机 740 → 772。蓝色长销整机需要再多 32 根，请核对库存。

**改装**：
1. **下半**：拔掉两根红色挡套销，从框架两侧外面各插 3 根蓝色长销，2 孔长的一段朝里。
2. **上半**：拔出两根 8 号轴，取出 32184 和整轴套。L 形梁与凸台上下两个孔重新插 4 个摩擦销。
3. **导向组件**：在外面拼好导向组件，从正面放进凸台内腔，再从侧板外面插 2 根吊销（第 14 步）。

**仍待确认**：
- 加固后剩下的主要柔度来自转盘轴承本身的倾斜间隙，以及竖墙三块框架之间的销连接。
- 实物上请对比改前和改后，在相同魔方、相同按压下魔方下沉多少。如果仍然明显，下一步看是转盘两半之间在晃，还是竖墙整体在晃。

## 39793 一体导向（2026-10-05，当前方案）

用户指出 STEAM 套件里的 **39793（3x3 连接块，正面 5 孔、侧面两条贯穿孔）** 可以直接用在这里，不用拼装。

**结构**（第 14 步，4 张分步图）：
- 39793 从正面放进转盘上半两个凸耳之间：正面中心孔对准推杆，两条侧面孔对准凸耳的上下孔，方块两侧贴住凸耳内表面。
- 4 根蓝色长销 6558 从外侧插入：2 孔段穿过凸耳、插进方块侧面孔，挡肩贴凸耳外表面；露出的 1 孔段再接侧板 L 形梁。
- 侧板、凸耳、导向块由同一根摩擦销串起来；两个凸耳也通过方块连成一体。凸耳的中间孔不再使用。

**几何核对**：
- 方块正好 3 孔宽，两侧与凸耳是零间隙贴面：左右方向缩 1% 后离转盘 0.12mm。
- 凸耳之间的转盘实体从离中心 32.4 LDU 处才开始，方块上下只到 30 LDU，不碰盘面。
- 每根长销的三段分别落在 L 形梁、凸耳、方块里。
- 夹紧时十字接头离导向块 8.25mm，与之前相同。

**检查**：
- `run_check.py` 0 问题；`mesh_clearance.py` 0 相交（贴面判据新增 `FACE_FIT`：对 39793 沿三个方向分别缩 1%）。整圈回转下界 ≥2mm。
- `four_arm.py`、`verify_pressure_pads.py`、`mechanical_audit.py` 都通过。
- 分步图 119 张，零件覆盖校验通过。

**零件**（每臂，相对上一节）：
- 增加：39793 ＋1；6558 ＋2（凸耳 4 根代替吊销 2 根）。
- 减少：2780 −4；32184 −1；3 号轴 −2；半轴套 −4；6632 −2。
- 整机 772 → 732。39793 整机需要 4 个，用户已确认数量够（见 `docs/lego/inventory.md`）。

## 竖墙侧梁（2026-10-05）

**问题**：固定转盘的上框，和下面中框之间只靠底边 3 个竖向销连接。机械头前倾时，这个接缝的力臂只有框厚 8mm，相当于一个铰链。

**改法**（并入第 7 步，第 7.4~7.7 张分步图）：竖墙两侧各竖贴一根 9 孔粗梁（孔朝外）。
- 上 3 个孔：直接套住转盘固定销（蓝色长销）露在框外的 1 孔长段。
- 下 3 个孔：用黑销接中框短边的 3 个侧孔。
- 中间 2 个孔空着。

上框和中框在两侧被 6 个销锁成一体，销的间距 16~56mm，不再绕底边接缝转动。转盘固定销现在同时穿过框架、转盘凸台和侧梁三层。

**检查**：
- `run_check.py` 0 问题；`mesh_clearance.py` 0 相交。
- 侧梁离马达横梁、齿轮轴套、框架都是 1 LDU（0.4mm）贴靠。
- 转盘上半转一整圈，离侧梁始终 0.4mm：9 孔梁比框架窄 0.8mm，侧梁前表面比框架正面还缩进 0.4mm，不会比框架更靠近转盘。
- `four_arm.py`、`verify_pressure_pads.py`、`mechanical_audit.py` 都通过。

**零件**（每臂）：40490 ＋2，2780 ＋6。整机 732 → 764。

**实物改装**：每侧在中框侧面插 3 个黑销，然后把 9 孔梁压到蓝色长销露出的一段和黑销上。不用拆别的零件。

## 舵机侧斜撑（2026-10-05）

**为什么**：竖墙侧梁只把上框和中框锁在一起。这一整块对地面的支撑，仍只有 y = 40~60 附近的两排销：马达横梁，以及平台前端那一排 2 个销。前倾的有效力臂约 8mm，整块墙仍会绕这里点头。马达一侧有马达本体从墙顶连到底座，相当于一根斜撑；舵机一侧没有。这个方向是用户提出的：在舵机侧，把转盘后面的框和水平平台连起来。实现时，用三角形斜撑代替 L 形连接。

**结构**（第 7、11 步）：
- 竖墙侧梁舵机一侧最下面的孔（y = 120），改用一根蓝色长销：2 孔段穿过侧梁进中框，露出 1 孔段。
- 平台框舵机侧长边，从前数第 3 个侧孔（x = −330, y = 60）插一个黑销。
- 一根 7 孔粗梁做斜撑：第 1 孔套侧梁下部露出的蓝色长销，第 6 孔套平台框上的黑销，第 7 孔空着。两孔水平相距 80、竖直相距 60，正好 5 个孔距（3-4-5 三角形）。

这样，竖墙、平台、斜撑三者构成三角形。机械头的弯矩经侧梁、斜撑传到平台，再经平台后端的支柱落到底座，不再靠中间那一排销承担。

**检查**：
- `run_check.py` 0 问题；`mesh_clearance.py` 0 相交。
- 斜撑离平台下面的 15 孔梁 0.4mm（相邻一层贴靠）。整圈回转下界 ≥2mm。
- `four_arm.py`、`verify_pressure_pads.py`、`mechanical_audit.py` 都通过。

**检查程序的修改（`run_check.py` 挡环销装配顺序）**：
- 一根销在自己那一步只连接已装好的零件；以后才压到销头上的零件（如斜撑压到第 7 步的蓝色长销上），在它自己的步骤里再连接。
- 同一步有多种合并顺序时，先合并两边都已成型的大组件。
- 另外三个机械手按对应的 L 模块步骤（`Part.sub`）模拟。
- 原版检查器会把斜撑误报为“方向冲突”。对比测试表明，修改后没有放过原版能抓到的问题；“反插凸耳长销”这类情况两版都抓不到，是原有盲区。

**零件**（每臂）：32524 ＋1，6558 ＋1，2780 不变（侧梁少 1 个，平台多 1 个）。整机 764 → 772。

**实物改装**：
1. 拔掉舵机侧竖墙侧梁最下面那个黑销，换成蓝色长销，1 孔段朝外。
2. 平台框侧孔插一个黑销。
3. 压上 7 孔斜撑。

## 实物验收

1. 断电，手推推杆走完全行程：推杆导向和导向框处无卡点，连杆在侧梁空档里滑动、不碰侧梁。
2. 重做“10 秒检查”：夹紧魔方、夹指上下方向，手指轻按魔方。对比改装前，记录魔方大约下移多少，十字接头是否还会横移，导向框是否还被撬动。
3. 按[单臂标定流程](../../single_arm.md#servo-calibration)确认端点、安全工作区间、标定身份及完整开合时序后，再做 [`docs/clamp_test.md`](../../clamp_test.md) 的夹紧测试。那份文档的“死点”“推到死点”是旧方向，不能照做：v4 往后拉夹紧，当前名义夹紧在曲柄折叠死点前 25°，不要求拉到死点；夹紧力与保持力仍需实物验证。
4. 如果仍明显下沉，拍一下是转盘在晃还是侧板在弯，再决定加固哪里。
