gonewx/quadcuber/docs/lego/archive/v3/rod_support_update.md

# 推杆缩短与支承前移

**已将模型推杆从120mm缩短到104mm，夹紧时前悬伸从63.823mm降到47.823mm。承重问题尚未全部解决：前端仍有4处不足1mm的运动间隙，实物刚度、保持力和带载运行尚未验收。**

## 为什么需要改

原推杆有两个后部导向孔，不是全长悬空；但前导向孔到驱动铰点相距约64mm。公共接头增加Watt导向后，后部驱动布局仍值得缩短。

此前只强调平面内驱动竖向反力近零，容易漏掉偏心弯矩。100g由两臂理想均分、仅计重量增量、夹紧姿态时，两片驱动薄梁在正负Z侧的轴力分别约+0.441928N、−0.110482N，作用面距中面各6mm。它们向推杆前接头传入约0.331446N轴向合力，**同时传入3.314460N·mm绕Y弯矩**。该弯矩会使推杆沿轮轴方向弯曲，不能用竖向合力近零将它忽略。

这是同一空间二力杆算例的载荷合成，仍省略孔轴弯矩、接触弹性和实际分载。它说明需要检查推杆受弯，不等于已经预测实物下沉量。

## 修改后的尺寸

对照基准：提交 `35db5e5`。坐标为模型模块局部坐标，单位LDU；1LDU=0.4mm。

| 项目 | 修改前 | 当前 |
|---|---:|---:|
| 推杆轴件 | 3L＋12L | 2L＋11L |
| 总名义长度 | 120mm | 104mm |
| 后／前导向孔中心X | −530／−410 | −490／−370 |
| 两导向孔中心距 | 48mm | 48mm |
| 夹紧时前导向中心到铰点 | 63.823mm | 47.823mm |
| 全开时前导向中心到铰点 | 53.862mm | 37.862mm |
| 舵机和曲柄 | 原位置 | 向机械头移动16mm |
| 舵机垫梁 | 7孔，3个黑销 | 5孔，2个黑销 |

当前11L后轴在全行程覆盖两个导向孔，孔外最小名义余量8.177mm。轴连接器后端到前导向孔前面的轴向间隙最小为5.862mm；两者X坐标差随推杆行程线性变化，最小值在全开端，推杆绕X回转不改变该距离。

开合杆长、行程、前端轮轴、Watt导向和转盘位置保持当前几何。因此本次没有减少转盘到轮端的111.91mm距离，也没有消除剩余4处前端小间隙。底座和平台的外廓也没有随推杆一起缩小。

## 为什么是2L＋11L

直接前移导向框并改用3L＋10L，原连接器在行程约79%后会碰到前导向框。2L前短轴使连接器前移一个孔距，避开该位置；11L后轴同时保留足够的导向孔覆盖。

短轴插入32013约一孔深，另一半插入59443；后轴插入连接器另一半。两根轴的名义端点在连接器中央相接，实际网格有端部倒角。连接器与32013端面自然贴合，不再保留一孔裸露短轴，不能靠拔出短轴少插一截来调尺寸。

32013网格端面比名义平面多出0.0005LDU（0.0002mm），FCL因此把固定端面贴合报为相交。检查只对同轴、中心距恰为50LDU的这一指定零件对作端面接触分类，并验证向后分离0.001LDU后确实分离。回归检查确认，额外过插0.01LDU也不会被豁免。这不是运动间隙放宽。

## 缩短能改善多少

以同一材料、截面和载荷的均匀梁作方向性比较，两个理想简支间距为a、前悬伸为b：

- 端部横向力引起的位移柔度为 `b²(a+b)/(3EI)`；当前约为原来的0.481倍。
- 端部弯矩引起的位移柔度为 `(b²/2+ab/3)/EI`；当前约为原来的0.624倍。

不能直接把这些比值当作整机刚度或实测下沉改善比例。实际轴连接器、十字孔、圆孔、塑料蠕变和支架都有额外柔度；尤其不能把本结构套成完全固支的单段悬臂，只按长度三次方给结论。

## 装配与验证

每臂将3L前轴换成黑色32062二号轴、12L后轴换成黄色23948十一号轴；舵机及导向框前移两孔。五孔舵机垫梁从后端向前，第1、5孔装舵机耳朵长销，第3、4孔装平台黑销；第2孔由下方55615占用。导向框的两根长销前移，腾出的后方平台孔改回黑销。

整机1040件，比基准少4个固定销。十一号轴需求4根，库存仍须核对，见[BOM](bom.csv)。图示见[搭建说明](index.html)。

- 24项机械回归及68项全仓测试通过；新增检查覆盖总长和悬伸、全行程插深与支承余量、连接器避让、固定端面接触边界和推杆前接头弯矩。
- 连接、孔型、插深、挡肩和同孔检查：0问题。
- 81开度网格扫描：17273次距离查询，0非配合相交。
- 前端对邻臂／本臂固定件：288个回转状态，4472次精细查询，0相交，检查集合间隙下界≥2mm。
- 四臂576状态、单臂168个中间开度回转姿态、原有连续包络和防翻折检查通过。

原始证据：[支承尺寸与载荷](rod_support_checks.json) · [静力计算](load_path_checks.json) · [网格检查](mesh_clearance.json) · [验证日志](validation.txt)。

**剩余工作：**前端4处小间隙仍按[清单](motion_clearance_update.md)处理；按[加载步骤](gravity_test.md)测推杆前接头横向位移、Watt支架位移、整头俯仰、轴套滑移和换向回差。当前不能标记“承重已解决”。
