gonewx/quadcuber/docs/lego/archive/README.md

# 乐高机械结构历史归档 (docs/lego/archive)

本目录归档了 quadcuber 项目在机械结构迭代过程中的历史设计、单臂原型与中间试验版本。

> **当前定型方案**请访问 [docs/lego/v4/](../v4/)（[搭建说明书](../v4/index.html) · [设计说明](../v4/README.md) · [零件清单](../v4/bom.csv)）。

---

## 归档目录索引

| 目录 | 描述 | 说明 |
| :--- | :--- | :--- |
| [`v1/`](v1/index.html) | EV3 大马达单臂原型说明书 | 第一代单臂测试架（大马达旋转 + Geekservo 推拉叉子），含 23 步搭建说明与 `model.ldr`。 |
| [`medium/`](medium/index.html) | EV3 中马达单臂原型说明书 | 中马达旋转对比方案（26 步搭建说明、加固图与测试记录）。 |
| [`v2/`](v2/index.html) | 单臂原型 v2 说明书 | 单臂第二代优化方案。 |
| [`v3/`](v3/index.html) | 四臂整机 v3 说明书 | 包含肘节死点夹爪、Watt 承重导向、24 齿带 60 齿转盘，以及载荷分析、机械审查报告和 `design/` 讨论稿。 |
| [`v3-baseline/`](v3-baseline/index.html) | v3 基准版快照 | 双侧轮胎压头＋防翻折开限位版快照（提交 `b9aa5d5`），作为 v4 改装前实物基准。 |
| [`v5/`](v5/) | v5 推紧试验记录（未采用） | 尝试恢复向前推紧方案，因推杆后退超 40% 时连杆与转盘正面产生 5.8mm 干涉而未采用。 |
| [`research/`](research/) | 压头调研与评估 | 早期自适应旋转压头（swivel pad）概念设计、评估与探测脚本。 |
