gonewx/quadcuber/docs/lego/archive/v3/design/architecture-reset.md

# 机械头结构重新选型：承重优先，不限定 L 梁

日期：2026-10-01。本文保留最初的结构选型记录。

**后续进展：已完成[矩形骨架＋双导轨真实零件候选](boxed-slider.md)，含多角度模型、BOM差异、81开度／288回转组合检查及承重算例。实物承载与摩擦仍待测。** 以下概念图和“下一阶段”描述属于选型时的状态。

## 本轮结论

3×5 L 梁不是设计边界。上一版候选沿用多数旧孔位、支架和导向，只将单臂239件减到238件；它属于兼容改型，不能据此证明整体结构合理。

下一轮优先评估**封闭框架＋双导轨滑座＋双侧支承夹指**。用“封闭框架＋重新布置的连杆导向”作对照。先比较支承刚度、间隙和驱动力，再确定导向形式。直线滑座目前只是一项有明确验证问题的结构候选，不能宣称已经比连杆导向更好。

- [可旋转整体图、隐藏侧框、开合与多视图](../../../../artifacts/head-architecture-review/review.html)
- [整体轴测图](../../../../artifacts/head-architecture-review/concept-overall.png)
- [移除近侧框架，观察内部支承](../../../../artifacts/head-architecture-review/concept-inside.png)
- [沿推杆方向观察](../../../../artifacts/head-architecture-review/concept-front.png)
- [松开端侧视](../../../../artifacts/head-architecture-review/concept-open.png)

图中形体是功能布局，不是完整乐高零件模型。尤其黄色滑座与蓝色侧框不能直接当作某种现成零件；需要继续确定其组成、孔位与装配方法。上一版真实零件模型的两个完整单臂视图放在评审页底部，与新概念区分。

## 用户约束与设计假设

用户已确认：优先常见 Technic 零件，允许少量补购；**任何长度的全圆孔薄梁均禁用**；承重是重点；不要求继续采用3×5 L梁。库存约束同步记录在[库存文档](../../inventory.md)。

本轮以保留现有马达和底座接口为基准。夹头骨架、导向、推杆长度与舵机行程可调整，不再为了保留104mm推杆锁定内部布局。轮胎接触魔方的位置和四臂操作空间仍是整机约束。

载荷比较暂沿用已有100g魔方、两臂均分的计算基准。实际魔方质量、头部质量与质心、摩擦、转动加速度、最大夹紧力，均不能由示意图推断。

## 1. 先建立连续的承重路径

### 固定骨架

两个侧框与前后横向连接形成空间骨架；夹指根轴由左右两侧立架共同支承。侧框优先尝试常见整体矩形框，检查其尺寸是否适合；若由直梁拼框，必须消除四角铰接形成的平行四边形自由度。只有四根直梁加四个销并不等于刚性框架。

前端立架与侧框需要间隔开的多个连接点。转盘到侧框的连接也须利用上下、左右分开的安装点，避免把整个机械头挂在单销或长悬空轴套上。双侧支承的根轴仍需控制支承跨度、夹指与支承的距离，以及轴向定位面间隙。

根轴载荷依次经过前端立架、侧框、转盘、固定支座、底座。头部框架即使变硬，转盘间隙、固定支座弯曲和底座晃动仍会出现在轮胎端，需分别量测。

### 活动机构

优先评估两根前后两端固定的导轨。滑座在每根导轨上有前后两个接触位置，用接触间距承受力矩，避免只有一个短孔套在长轴上摆动。活动接头的横向力由滑座传给导轨端座与骨架。

推杆负责轴向开合。头部回转时，导轨和滑座跟随转盘；固定舵机与旋转推杆之间的接口必须允许轴向运动和相对回转，不能将两者直接锁死。图中“开合输入”只表示功能轴线，尚未设计这处最终连接。

双导轨并不自动保证顺滑：轴孔间隙会造成晃动，四个接触位置对平行度敏感，十字轴穿圆孔的实际接触与磨损需要小样检查。不能把它等同于精密直线轴承。滑座内部也必须是刚性连接，避免导轨没弯、滑座先扭。

### 夹指和输入杆

输入杆优先用圆孔粗梁，活动关节采用匹配的无摩擦销或在圆孔内转动的轴。夹指根轴双侧支承，轮胎保持接触中心；不通过把轴套压紧夹指来消除晃动。带十字端孔薄梁如用于固定支架，须明确哪些连接固定、哪些需要转动。

概念图暂用前力臂40mm、后力臂16mm、输入杆孔距32mm作比较基准。它们不是最终尺寸；缩短前力臂可以减少局部弯矩，但需同时保留魔方操作空间、开口和邻臂避让。

## 2. 承重不能仅按0.49N判断

以100g魔方由两臂均分计算，每臂外部重力为0.490N。在当前概念的理想竖直夹紧姿态，联立上下夹指力矩平衡得到：

| 量 | 计算值 | 含义 |
| --- | ---: | --- |
| 滑座横向载荷 | 约1.25N | 杠杆作用使内部反力大于外部重力 |
| 两根轴对夹指的合计竖向反力 | 约1.74N | 与滑座载荷对应；两条路径不能分别按0.49N估算 |
| 每侧2N预载时的轴向输入反力 | 约2.70N | 不包括导轨摩擦及舵机机构损失 |
| 同一预载下较大的单夹指根轴合反力 | 约8.10N | 约7.96N竖向、1.52N轴向分量；局部连接须承担夹紧产生的反力 |
| 魔方对转盘的弯矩 | 约0.055N·m | 尚未加头部自重和动态载荷 |

敏感性示例：每增加100g头部质量，若质心距转盘60mm，就增加约0.059N·m弯矩，已经与上述魔方载荷同量级。这不是头部实际质量，说明加梁加重可能抵消局部增刚收益。

计算仅针对夹紧端理想刚体、无摩擦铰链及二维平衡。0N预载算例用于分离重力增量，不表示没有夹紧力也能抓住魔方。松开端不施加“仍夹着魔方”的虚假接触载荷。详细结果和可复算脚本见[载荷数据](../../../../artifacts/head-architecture-review/concept-load.json)及[计算脚本](../../../../artifacts/head-architecture-review/concept_load.py)。

头部回转90°时，重力转到机构侧向，根轴轴向定位、夹指侧弯、滑座抗扭和转盘倾覆都需要空间模型及实测。二维平衡无法证明这些能力。上下输入粗梁若错层布置，夹紧力还可能产生附加力偶，下一阶段必须按最终层位计算。

## 3. 三条路线如何取舍

| 路线 | 优点或机会 | 主要代价 | 当前处理 |
| --- | --- | --- | --- |
| 封闭框架＋直线滑座 | 有机会移除Watt摆杆、横梁与短驱动连杆；支承路径直观 | 滑动摩擦、间隙、平行度；滑座和端座也会增加零件 | 优先验证导向小样，尚未选定为最终方案 |
| 封闭框架＋重新布置的连杆导向 | 以转动关节导向；可复用已有运动学分析方法 | 关节间隙累积、粗梁层位、空间受力；需要完整重排 | 与滑座方案在相同外载、接触位置下比较 |
| 上一版L梁兼容改型 | 局部几何验证资料已齐 | 整体仍复杂；最小活动间隙约0.81mm；没有实物刚度证据 | 保留为对照，不再作为本轮首选 |

此前某个双导轨草模与旧侧梁相交，只能说明那组布置不合适，不能排除直线导向这条路线。反过来，本轮整齐的概念图也不能作为零件可装配、无碰撞或承重通过的证据。

## 4. 先验证决定成败的部位

1. **导向小样：**确认真实零件、孔型和接触间距。在约1.25N横向载荷基准及最终计算的附加力矩下测启动阻力、往返阻力、摆量。再考虑活动件自重和载荷分配偏差。合格驱动力阈值须由现有舵机实测余量确定。
2. **骨架小样：**保留真实转盘与固定支座，分别测转盘、侧框、根轴和轮胎端位移，避免把全部下沉归因于夹指。称量机械头并测质心，用自重补全转盘弯矩。
3. **装配模型：**确定全部常见零件和层位；验证固定连接无自由铰链、关节不锁死、轴销长度与挡肩正确、连接可按顺序装入；全圆孔薄梁数量必须为零。
4. **开合与回转：**检查完整行程、整圈回转、马达齿轮与轴套、魔方扫掠及邻臂状态。原方案的碰撞检查结果不能移用于新方案。
5. **加载复测：**在0°、45°、90°姿态，加入夹紧预载、实际头部自重及魔方重量，测试下沉、侧移、反向间隙、保持后的变化和重复开合。再按预期加速度检查动态工况。

建议以轮胎端静态偏移不超过0.5mm作为首轮比较目标，而非已确认合格标准；最终阈值须由四臂实际净空和夹持容差反推。必须区分卸载回不来的零件移位、可恢复的弹性变形与反向加载出现的间隙。若滑动导向阻力或晃动不达标，就用连杆导向对照方案继续选型，不能以夹紧轴套掩盖问题。

## 交付边界

本轮完成约束修正、路线比较、可旋转整体概念图、上一版完整单臂多角度图和初步载荷计算。**新方案尚无完成的逐件模型、BOM、碰撞通过记录或承重验收。** 正式装配说明保持原状；上一版候选的81开度／288回转检查不适用于本轮新概念。
