gonewx/quadcuber/artifacts/head-architecture-review/concept-inside.png

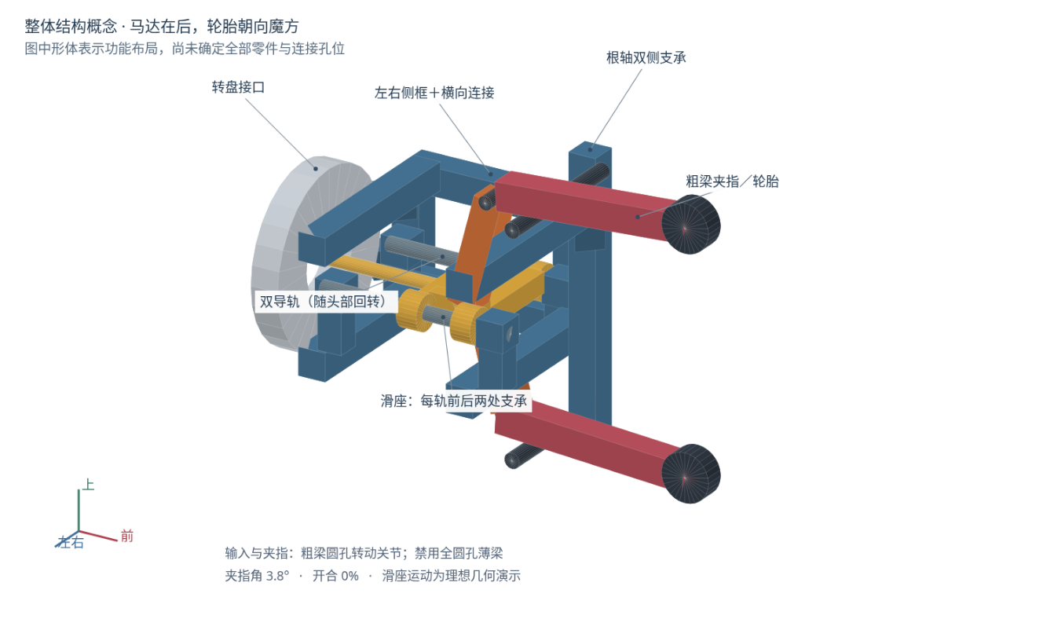
artifacts/head-architecture-review/concept-inside.png
