gonewx/quadcuber/artifacts/head-architecture-review/concept-open.png

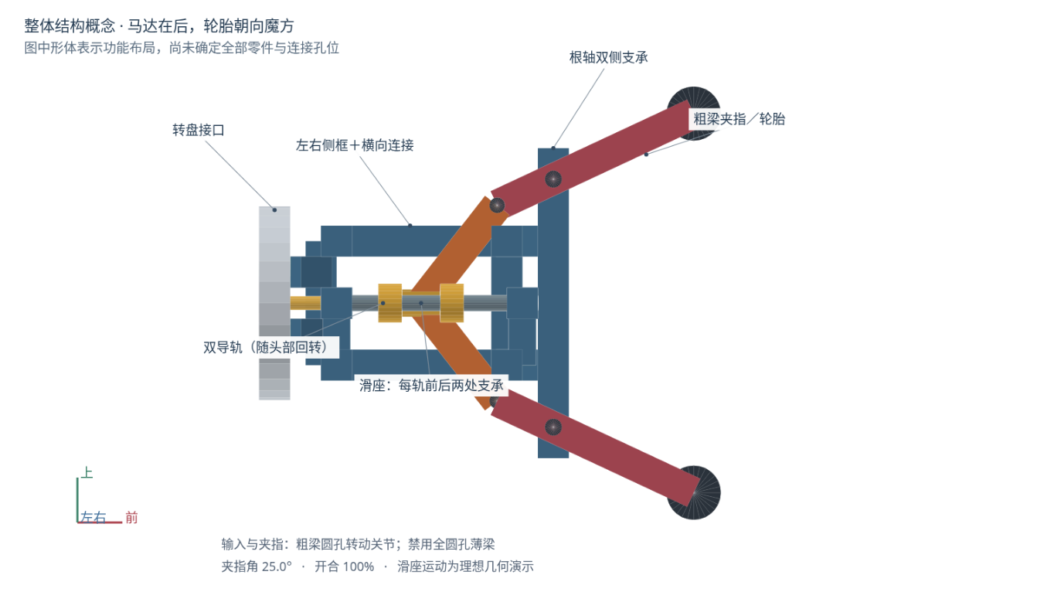
artifacts/head-architecture-review/concept-open.png
