gonewx/quadcuber/artifacts/head-redesign/head-overview.png

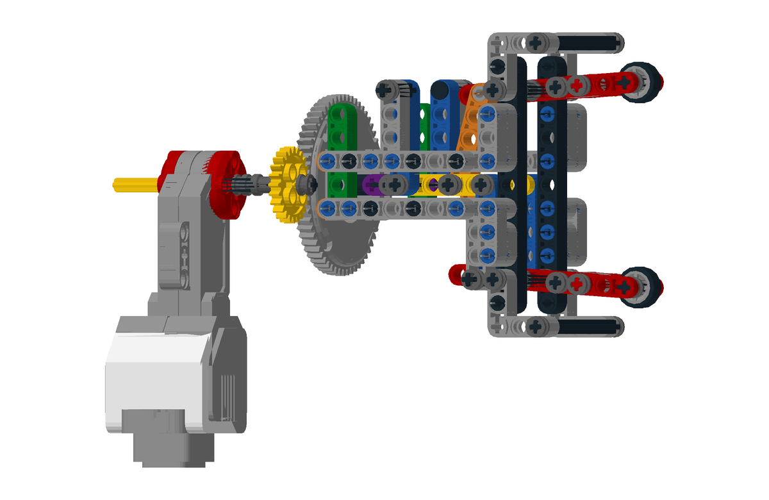
artifacts/head-redesign/head-overview.png
