gonewx/quadcuber/artifacts/head-redesign/mechanism-closed.png

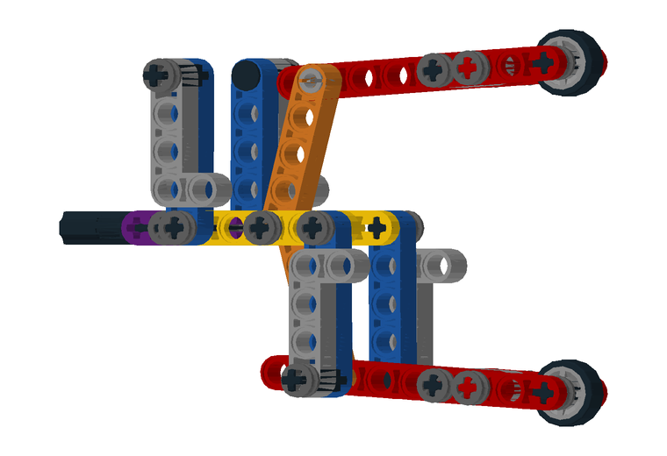
artifacts/head-redesign/mechanism-closed.png
