gonewx/quadcuber/artifacts/head-redesign/mechanism-open.png

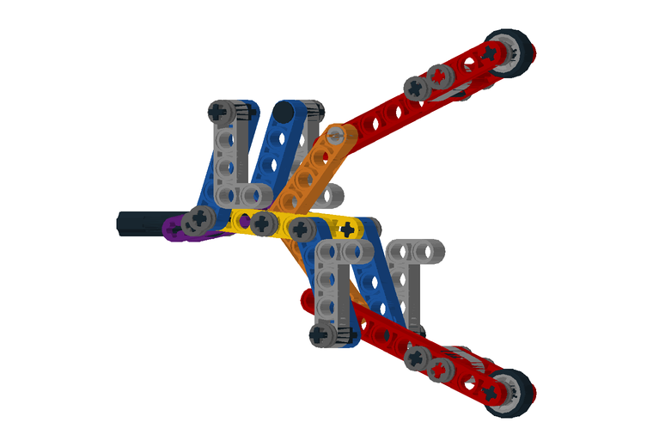
artifacts/head-redesign/mechanism-open.png
