gonewx/quadcuber/artifacts/rear-frame-experiments/oriented-overview.png

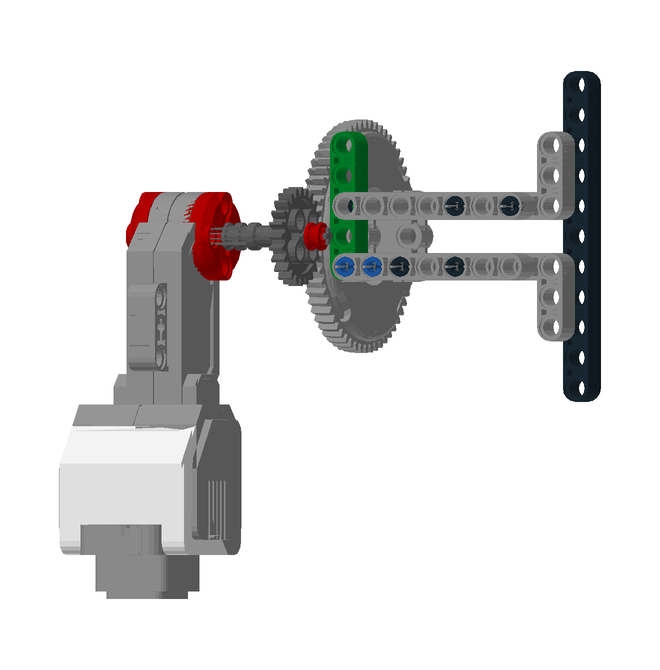
artifacts/rear-frame-experiments/oriented-overview.png
