gonewx/quadcuber/electronics/sources/ev3-connector-user-drawing.png

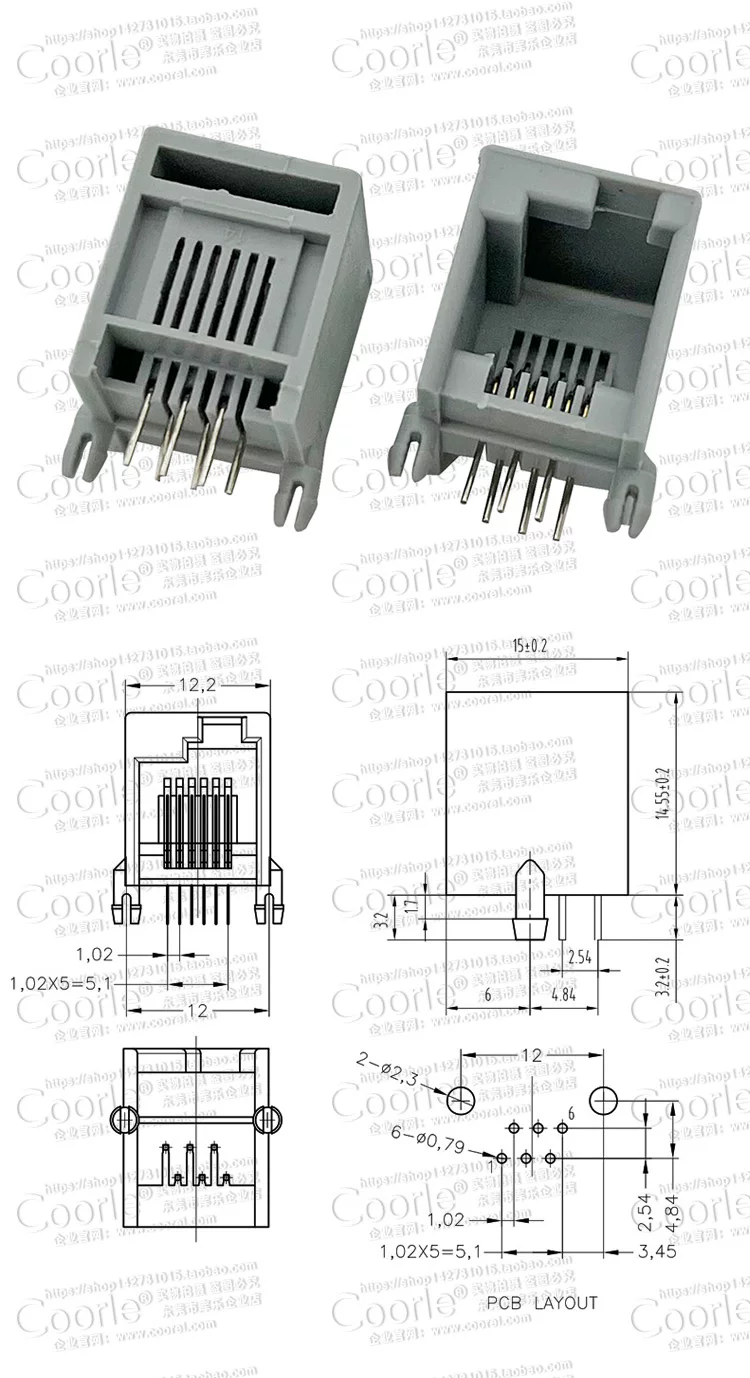
electronics/sources/ev3-connector-user-drawing.png
