gonewx/quadcuber/generated/electronics-b1/pcb-bottom.png

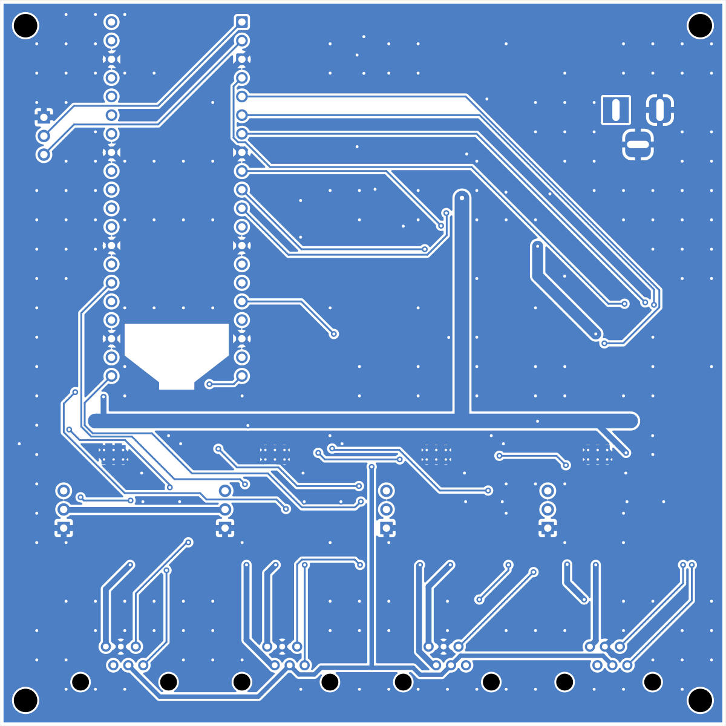
generated/electronics-b1/pcb-bottom.png
