gonewx/quadcuber/generated/electronics-b1/pcb-top.png

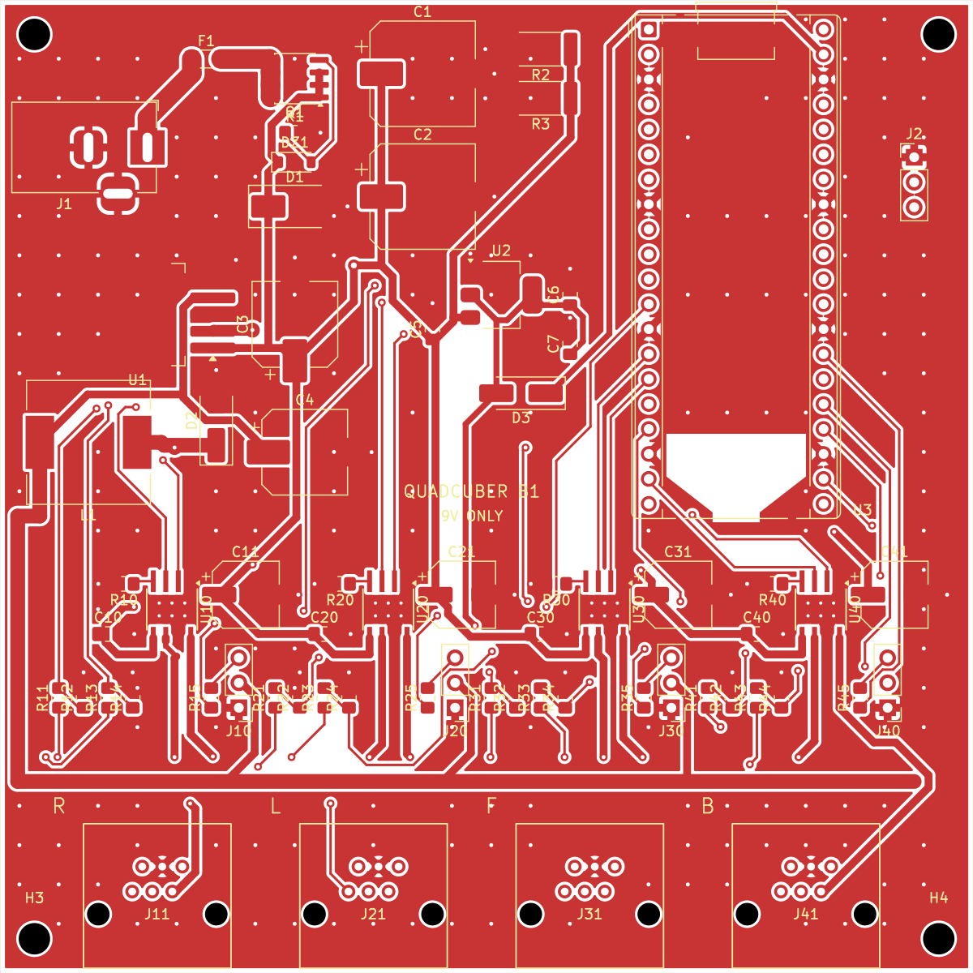
generated/electronics-b1/pcb-top.png
