gonewx/quadcuber/generated/electronics-b1/render-3d-top.png

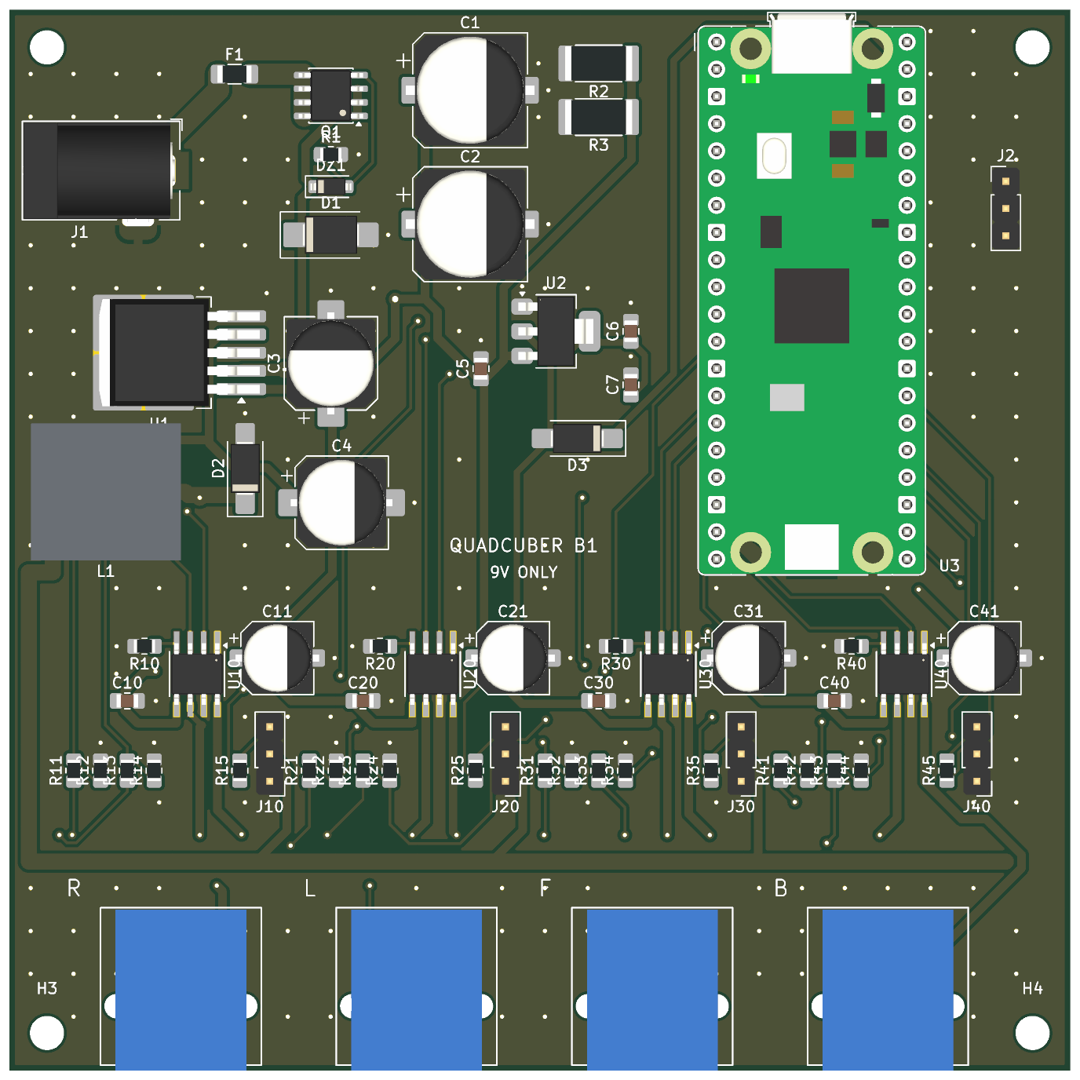
generated/electronics-b1/render-3d-top.png
