gonewx/quadcuber/generated/electronics/boot-direct-revision/layout-before-after.png

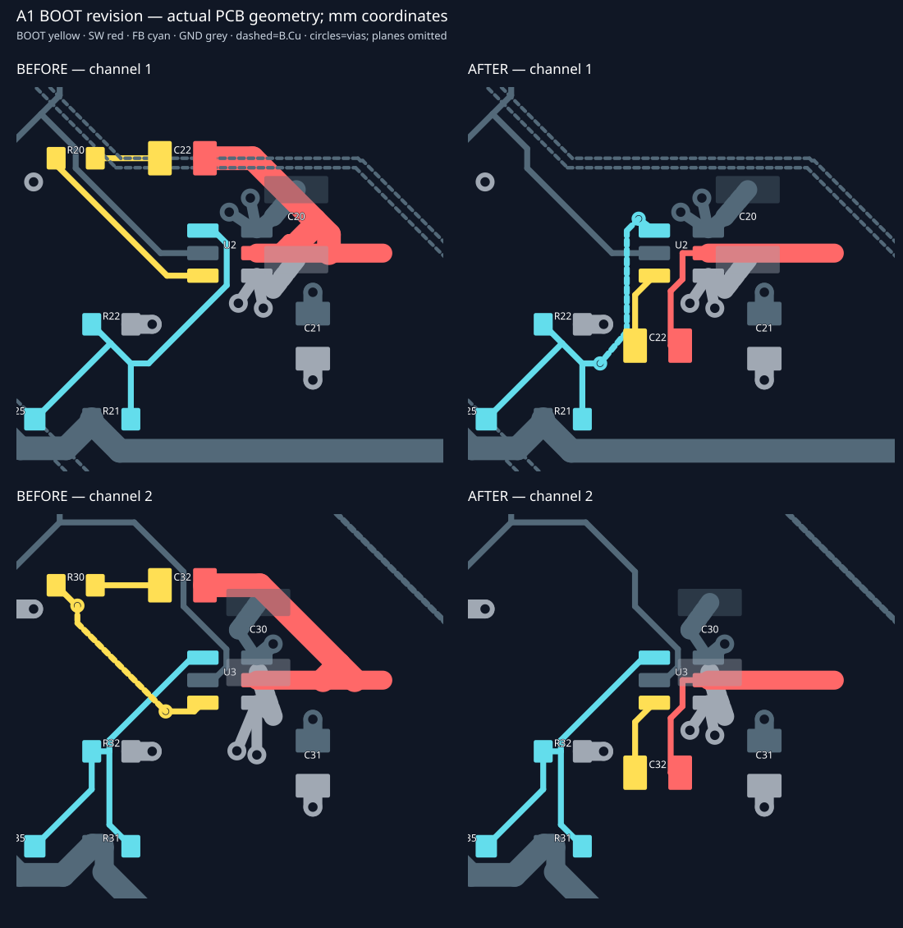
generated/electronics/boot-direct-revision/layout-before-after.png
