gonewx/quadcuber/generated/electronics/pcb-bottom.png

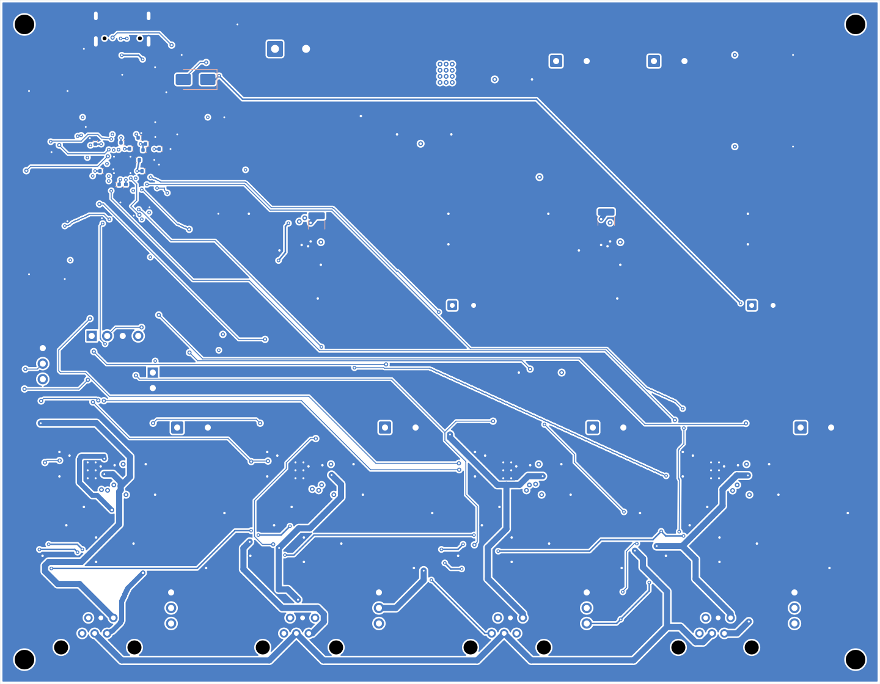
generated/electronics/pcb-bottom.png
