gonewx/quadcuber/generated/electronics/pcb-top.png

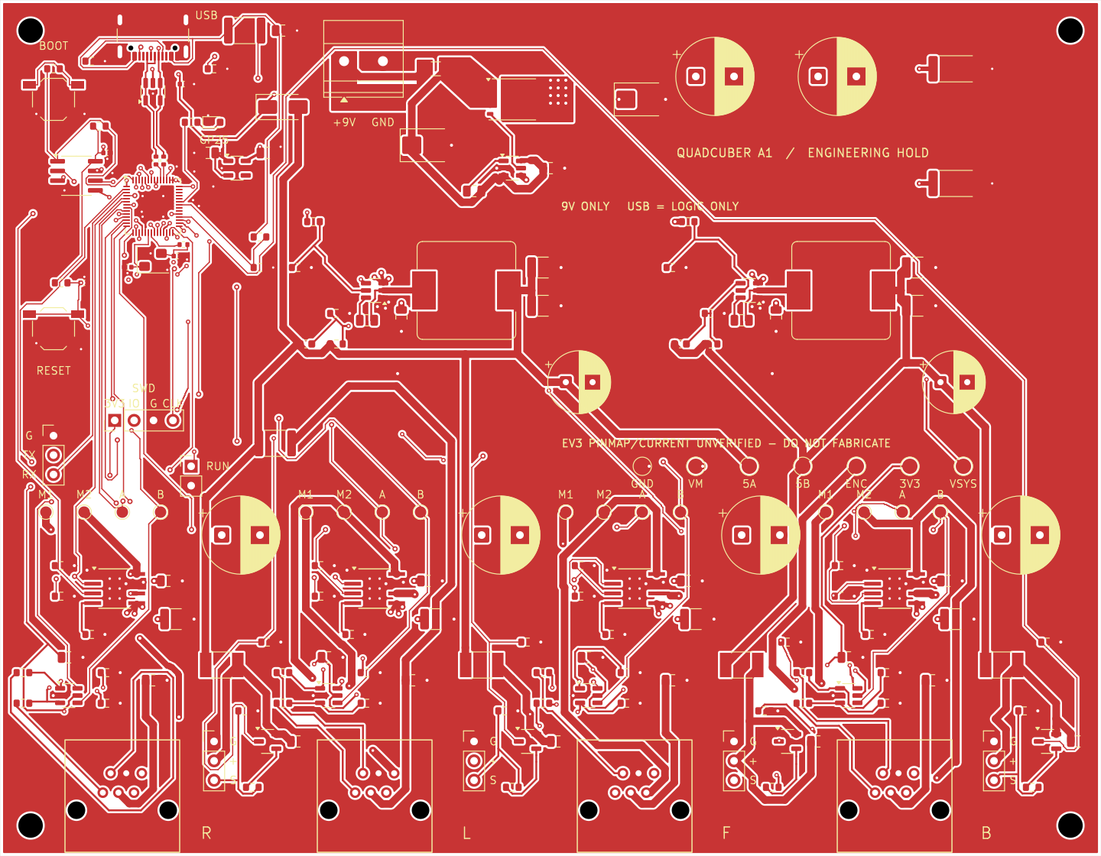
generated/electronics/pcb-top.png
