gonewx/quadcuber/generated/electronics/silkscreen-revision/before-after.png

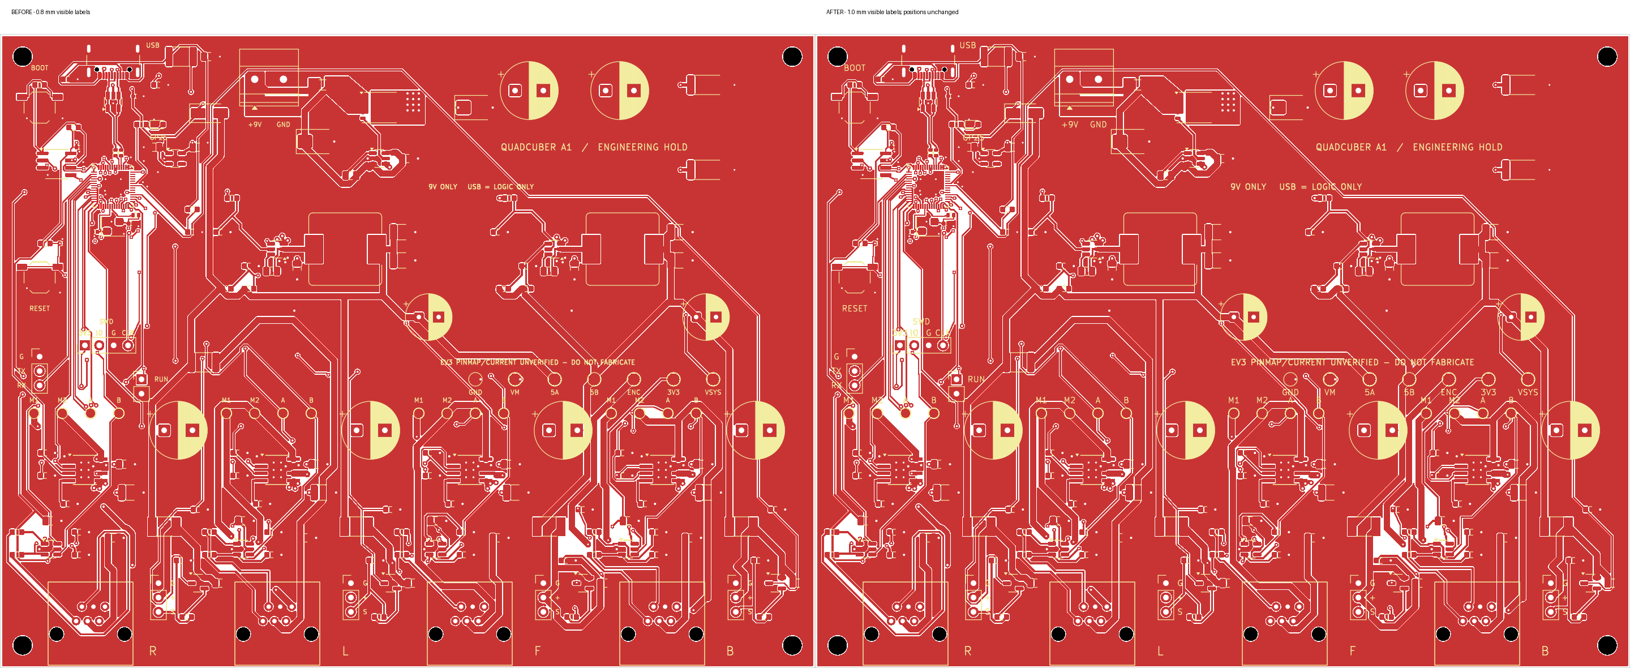
generated/electronics/silkscreen-revision/before-after.png
