gonewx/quadcuber/generated/electronics/simulation/linux-steady-followup/cold-differential/differential.png

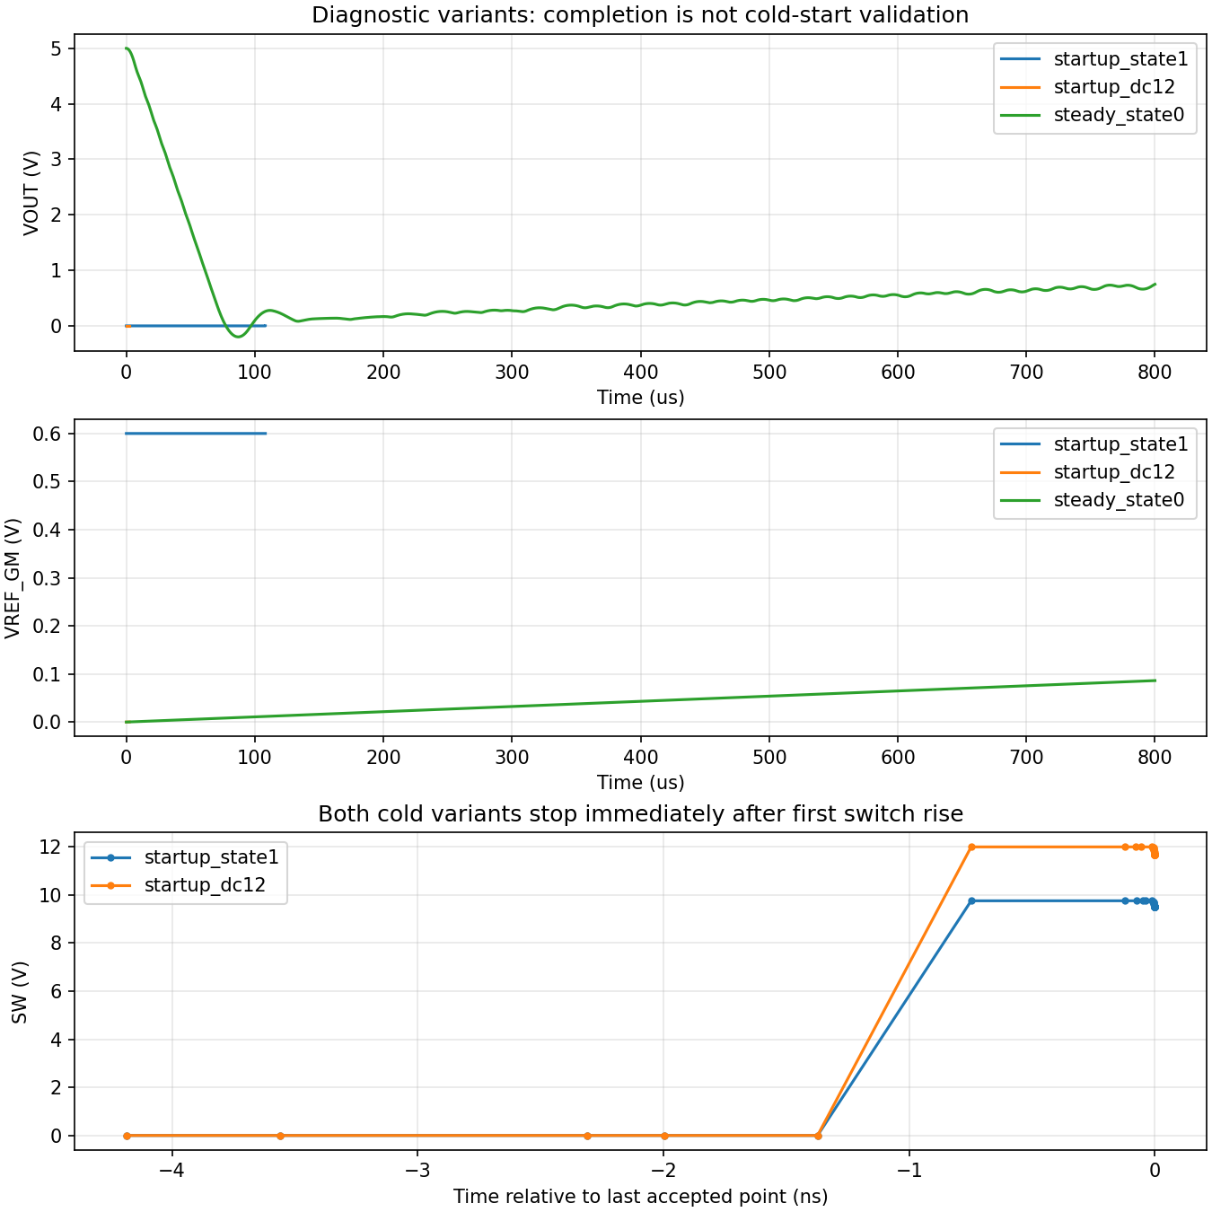
generated/electronics/simulation/linux-steady-followup/cold-differential/differential.png
