gonewx/quadcuber/generated/electronics/simulation/linux-steady-followup/reference-steady-extended/reference-check.png

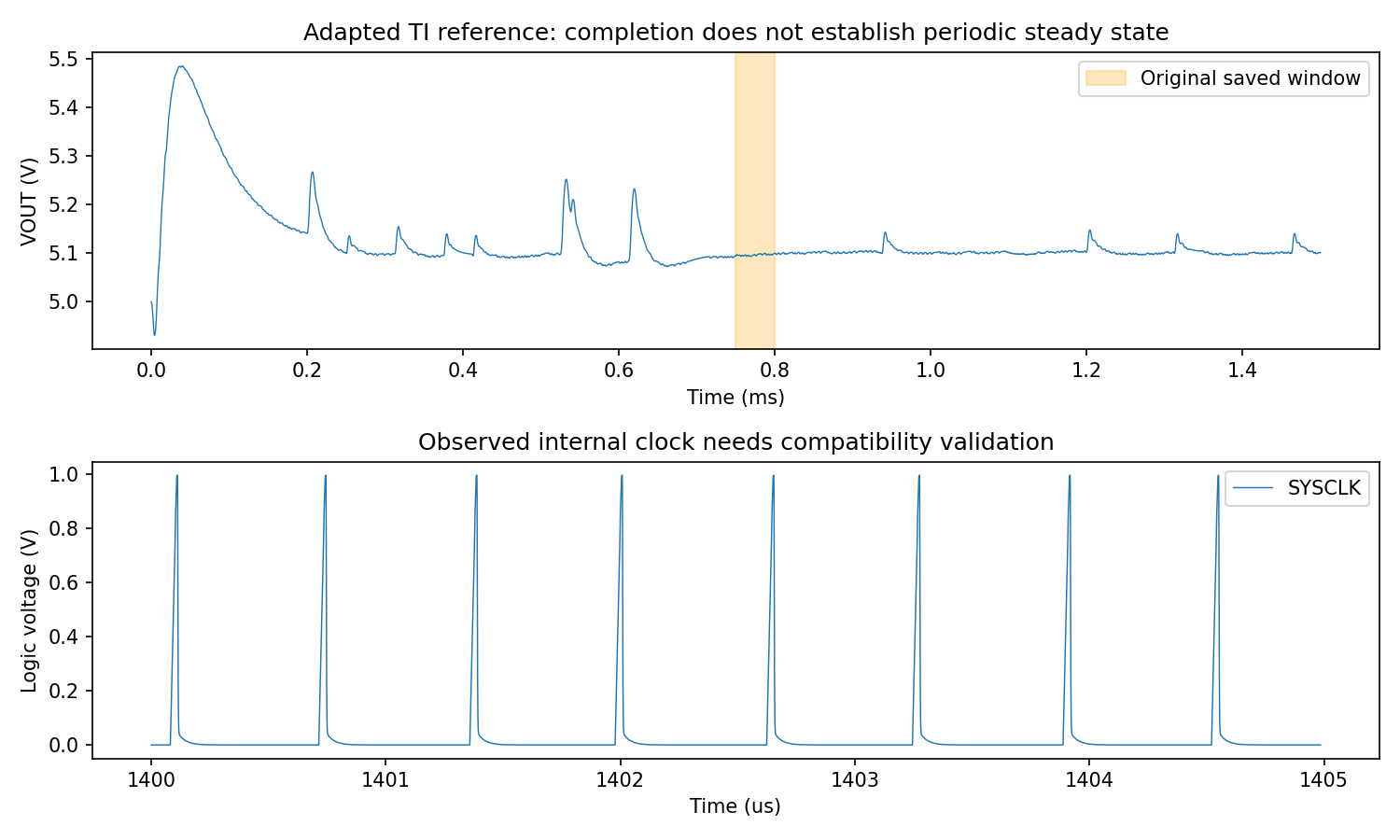
generated/electronics/simulation/linux-steady-followup/reference-steady-extended/reference-check.png
