gonewx/quadcuber/generated/electronics/simulation/regen-boundary.png

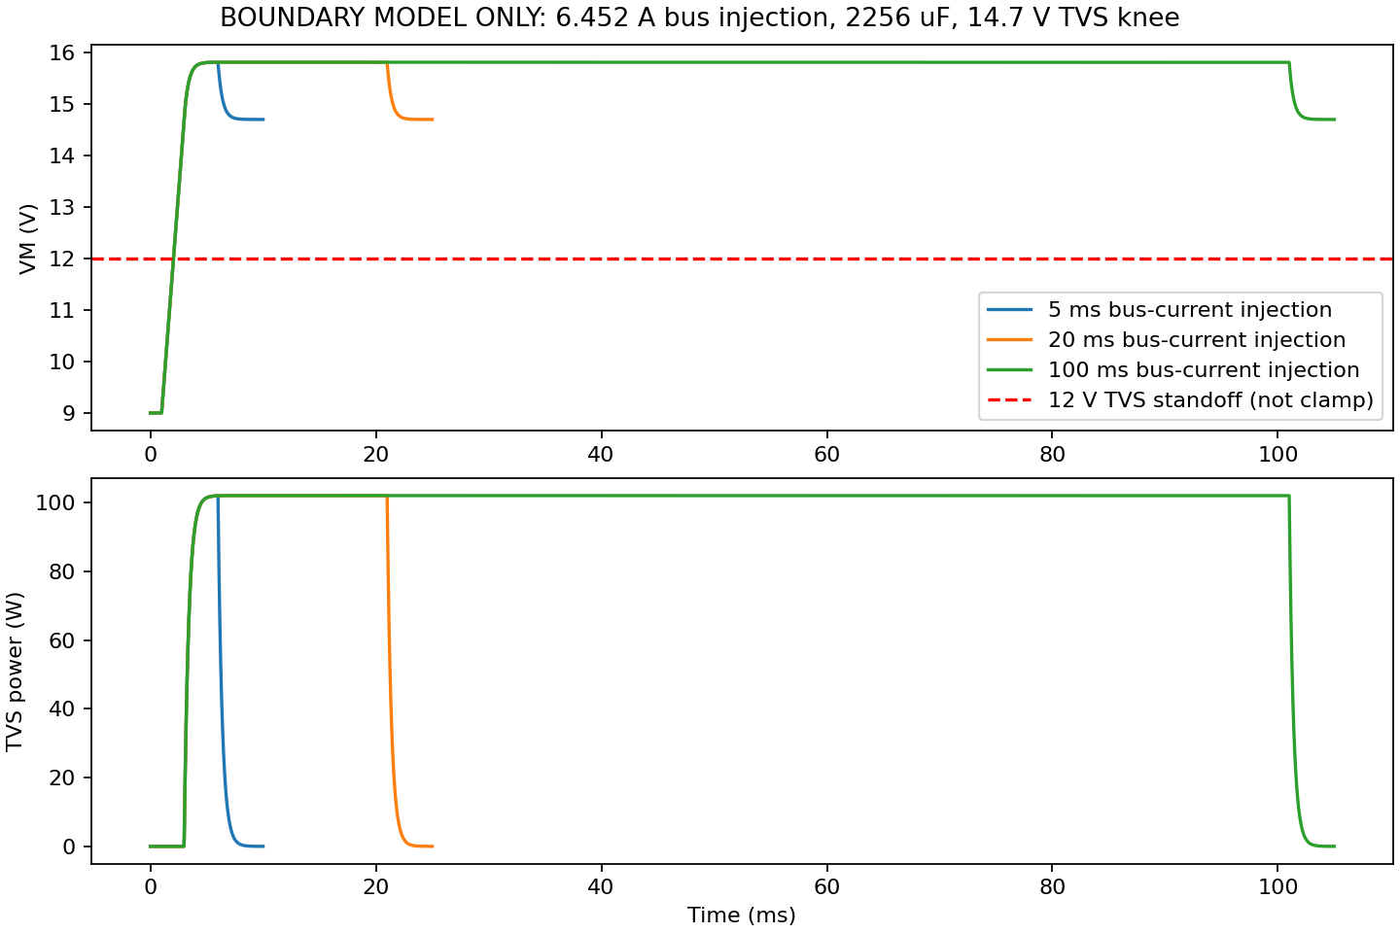
generated/electronics/simulation/regen-boundary.png
