gonewx/quadcuber/mechanical/final/site-source/dist/compact60483/diagrams/machine-loading-all50.png

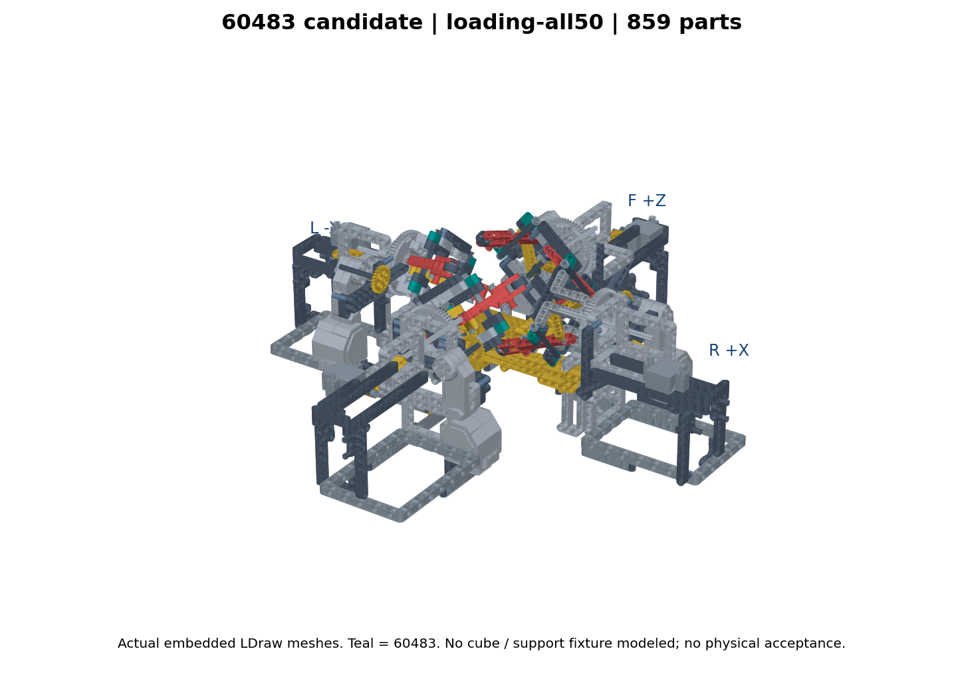
mechanical/final/site-source/dist/compact60483/diagrams/machine-loading-all50.png
