gonewx/quadcuber/mechanical/final/site-source/dist/compact60483/diagrams/root_done.png

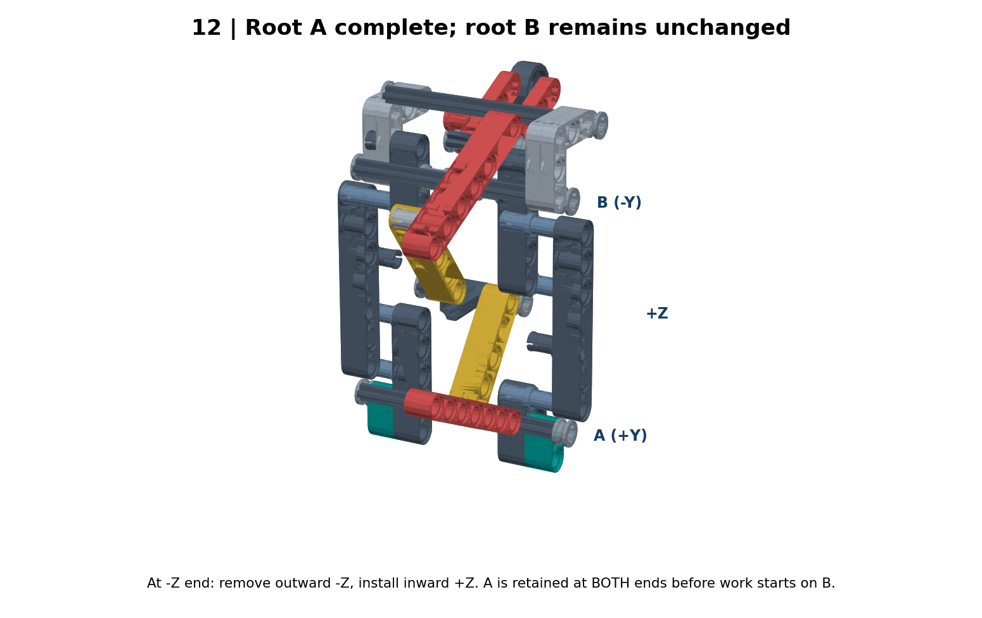
mechanical/final/site-source/dist/compact60483/diagrams/root_done.png
