gonewx/quadcuber/mechanical/final/site-source/dist/compact60483/diagrams/stop2.png

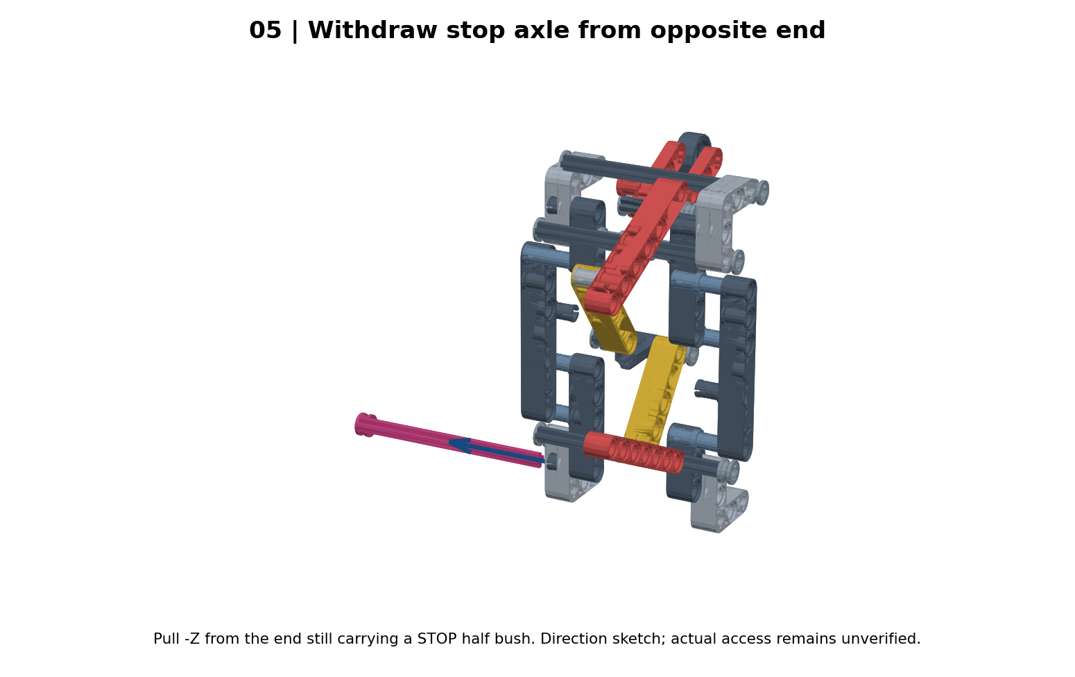
mechanical/final/site-source/dist/compact60483/diagrams/stop2.png
