gonewx/quadcuber/mechanical/final/site-source/dist/integrated/diagrams/brace-B.png

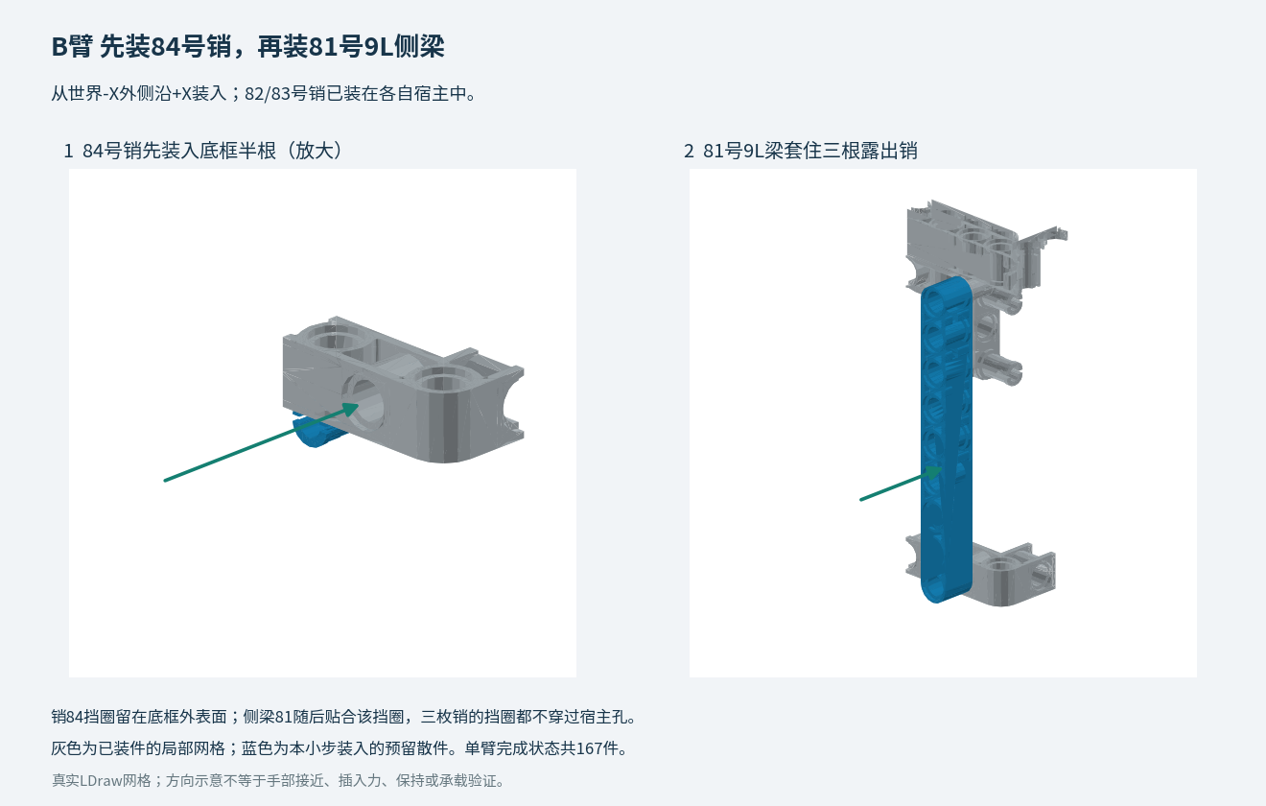
mechanical/final/site-source/dist/integrated/diagrams/brace-B.png
