gonewx/quadcuber/mechanical/final/site-source/dist/integrated/diagrams/integrated-whole.png

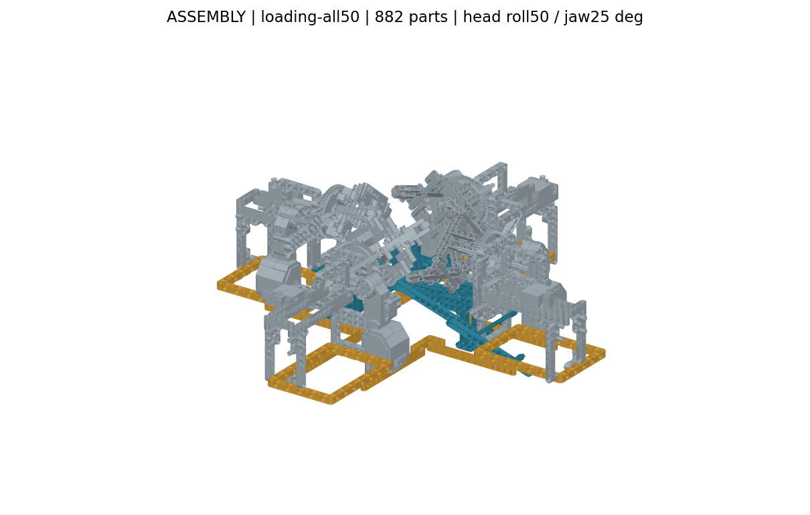
mechanical/final/site-source/dist/integrated/diagrams/integrated-whole.png
