gonewx/quadcuber/mechanical/final/site-source/dist/integrated/diagrams/interface-L.png

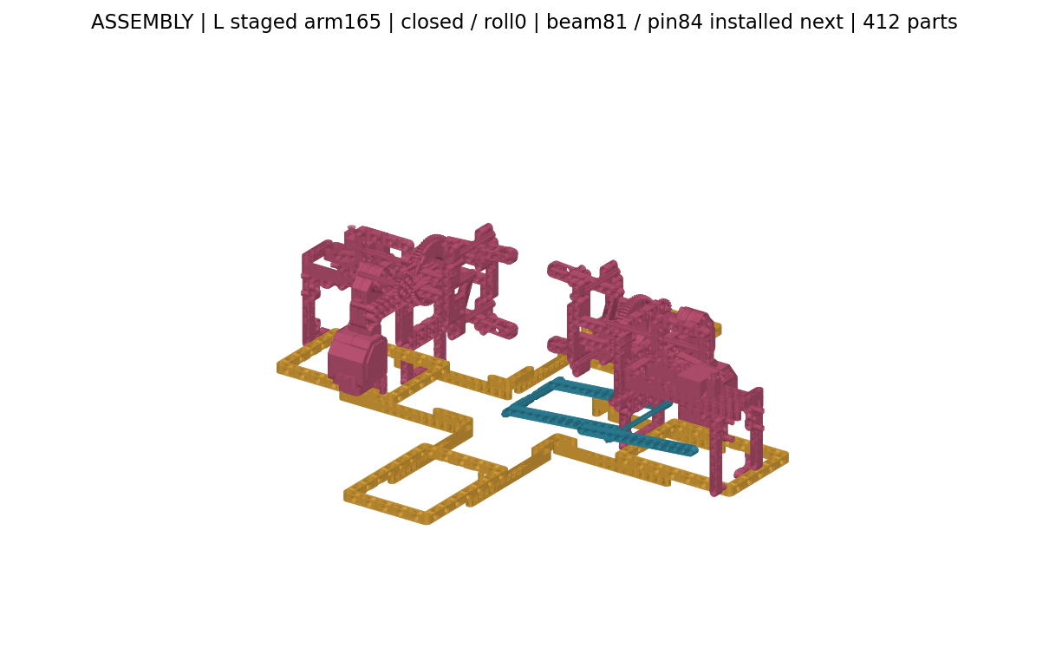
mechanical/final/site-source/dist/integrated/diagrams/interface-L.png
