gonewx/quadcuber/mechanical/final/site-source/dist/integrated/diagrams/interface-R.png

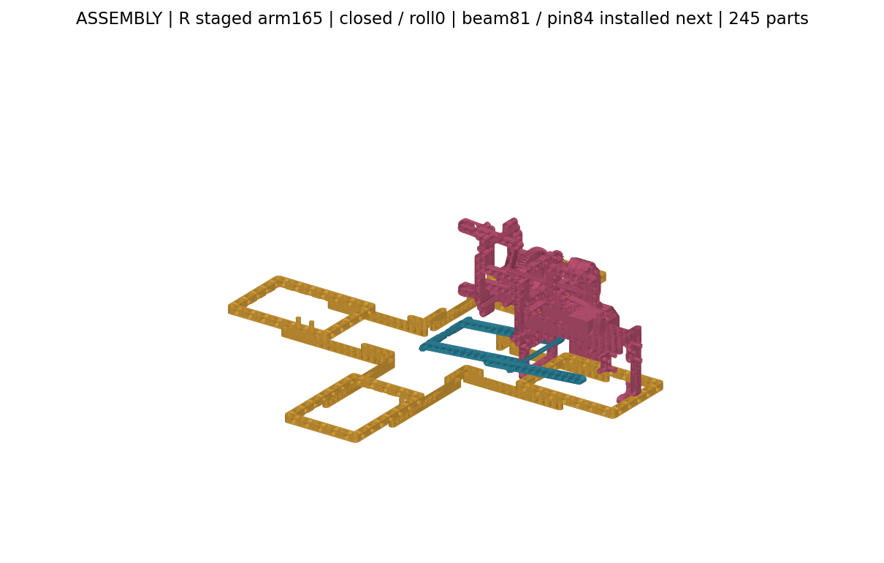
mechanical/final/site-source/dist/integrated/diagrams/interface-R.png
