gonewx/quadcuber/mechanical/final/site-source/dist/integrated/diagrams/support-complete.png

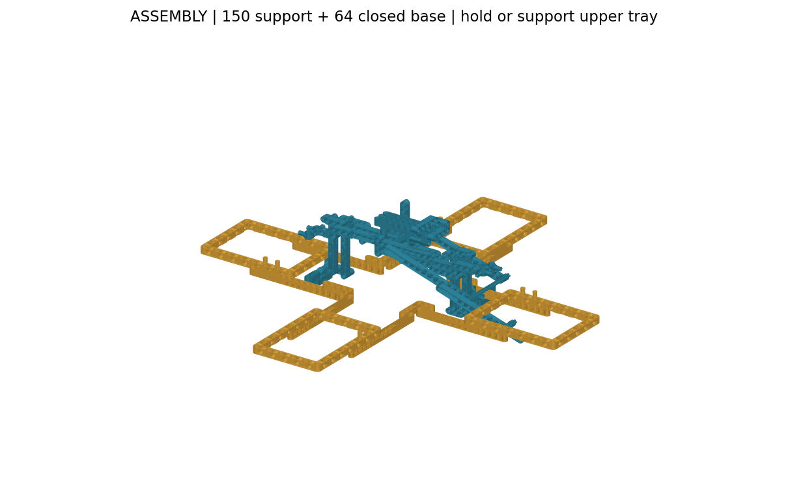
mechanical/final/site-source/dist/integrated/diagrams/support-complete.png
