gonewx/quadcuber/mechanical/final/site-source/dist/integrated/final-head-diagrams/08.png

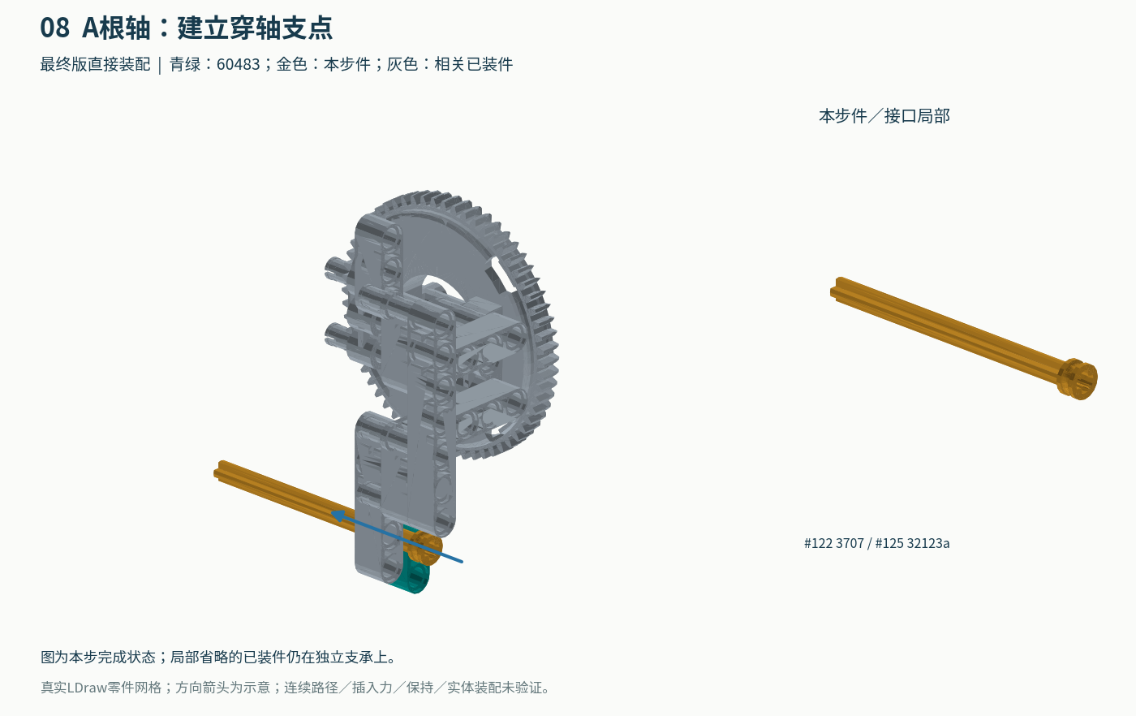
mechanical/final/site-source/dist/integrated/final-head-diagrams/08.png
