gonewx/quadcuber/mechanical/final/site-source/dist/integrated/final-head-diagrams/14.png

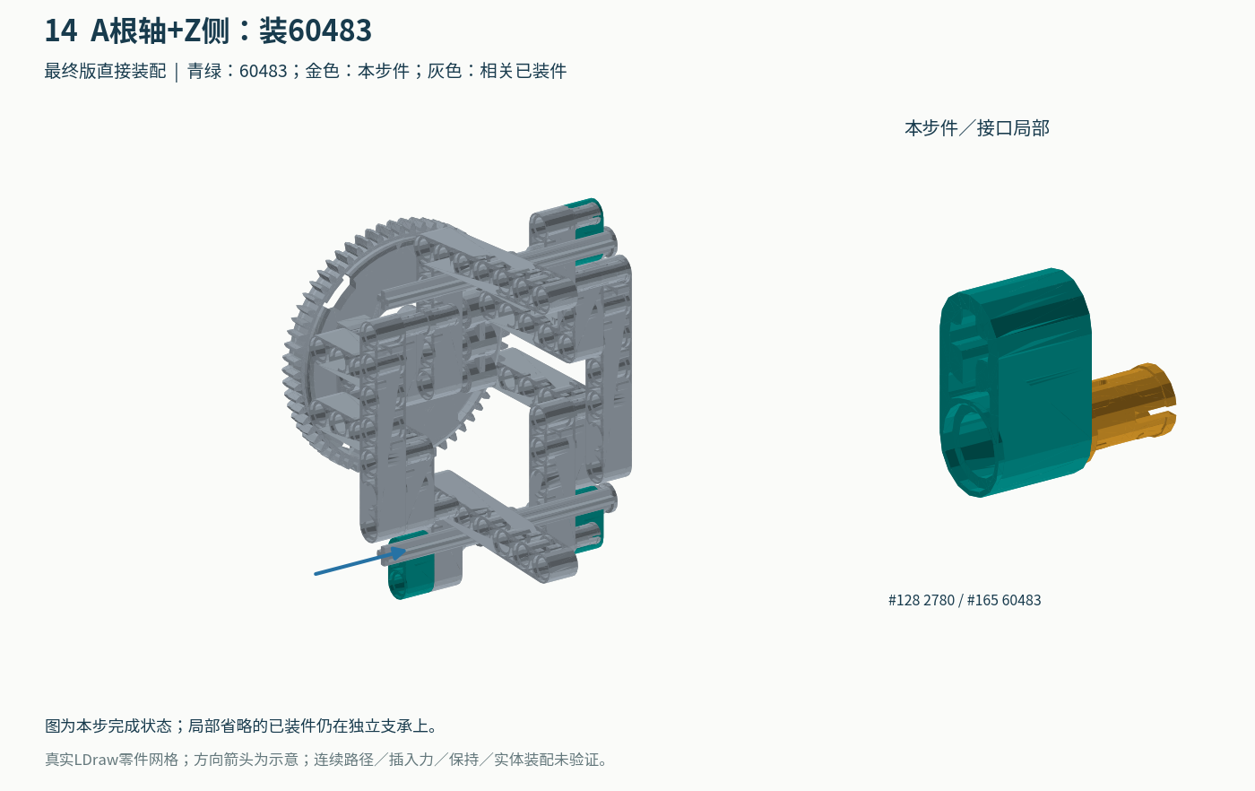
mechanical/final/site-source/dist/integrated/final-head-diagrams/14.png
