gonewx/quadcuber/mechanical/final/site-source/dist/integrated/final-head-diagrams/CORE17.png

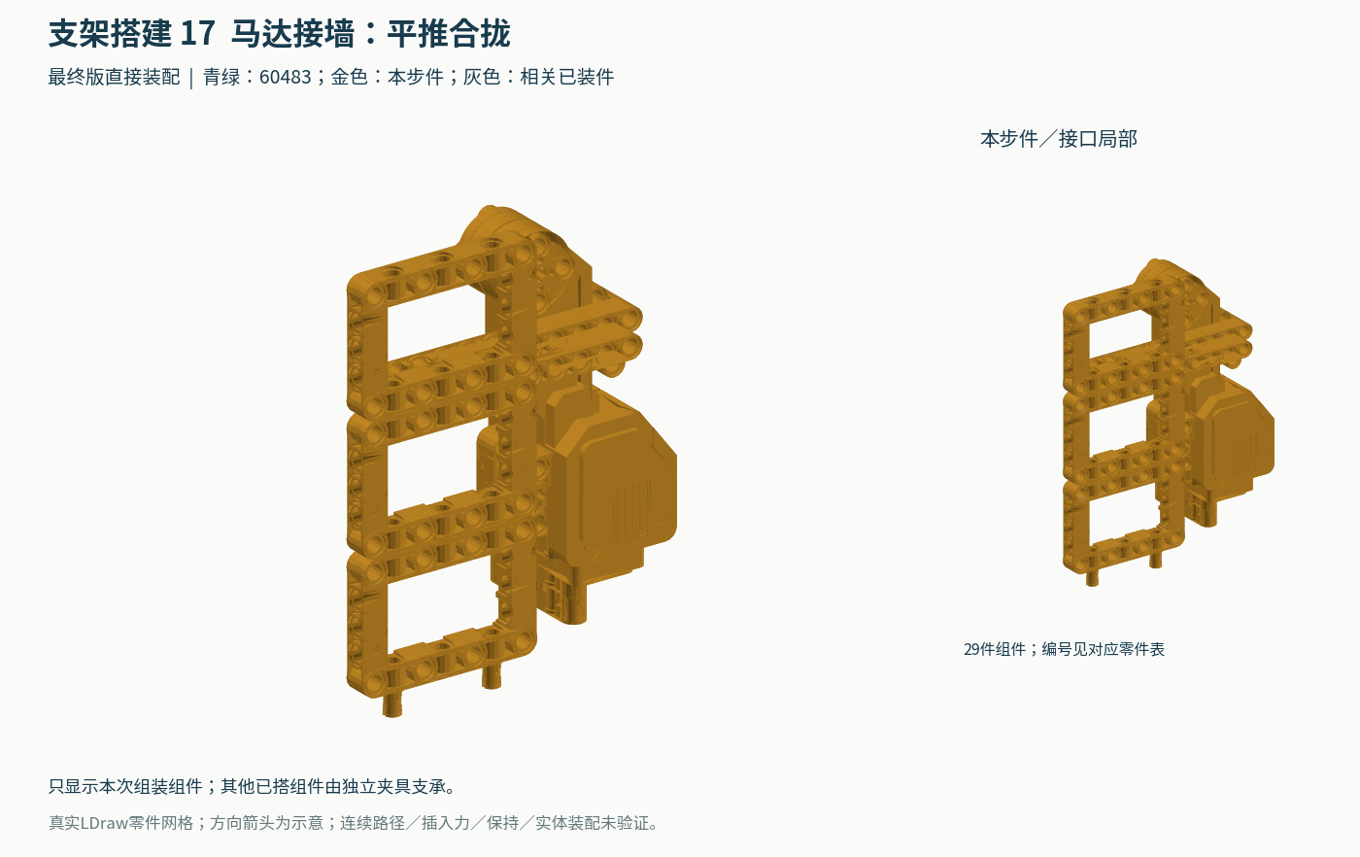
mechanical/final/site-source/dist/integrated/final-head-diagrams/CORE17.png
