gonewx/quadcuber/mechanical/final/site-source/dist/integrated/final-head-diagrams/CORE31.png

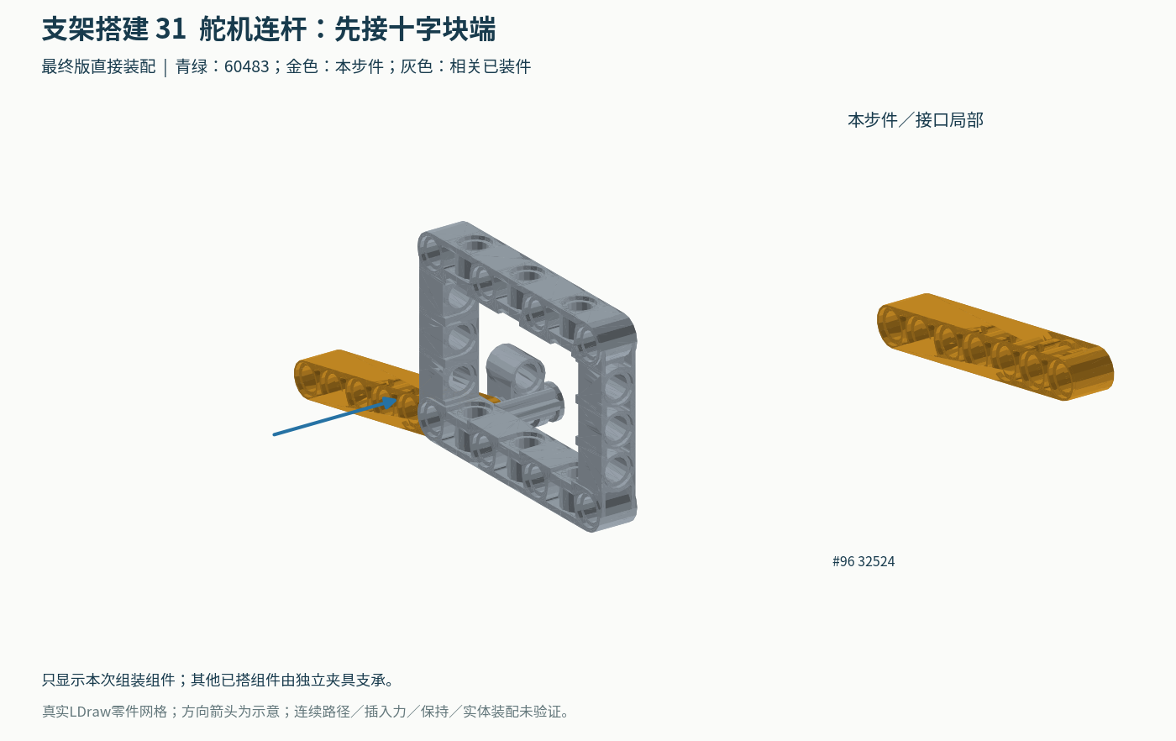
mechanical/final/site-source/dist/integrated/final-head-diagrams/CORE31.png
