gonewx/quadcuber/mechanical/final/site-source/dist/integrated/final-head-diagrams/CORE42.png

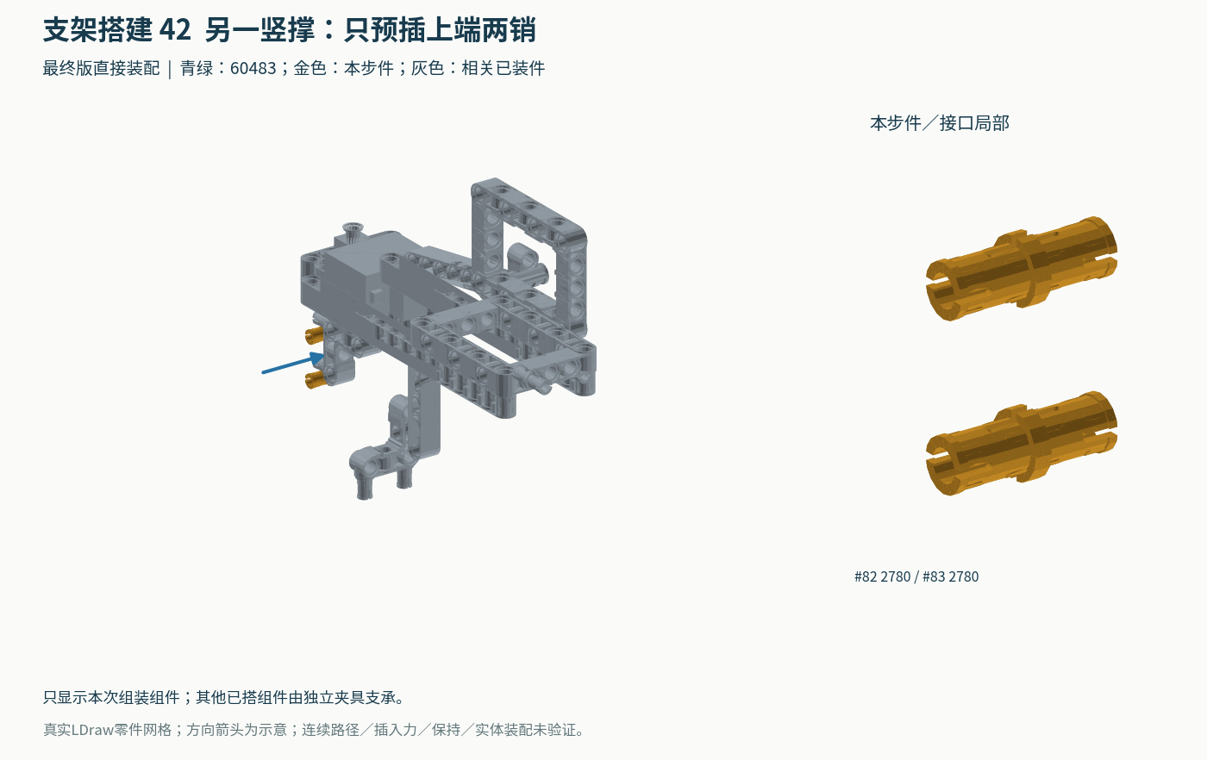
mechanical/final/site-source/dist/integrated/final-head-diagrams/CORE42.png
