gonewx/quadcuber/mechanical/final/site-source/dist/integrated/final-head-diagrams/CORE46.png

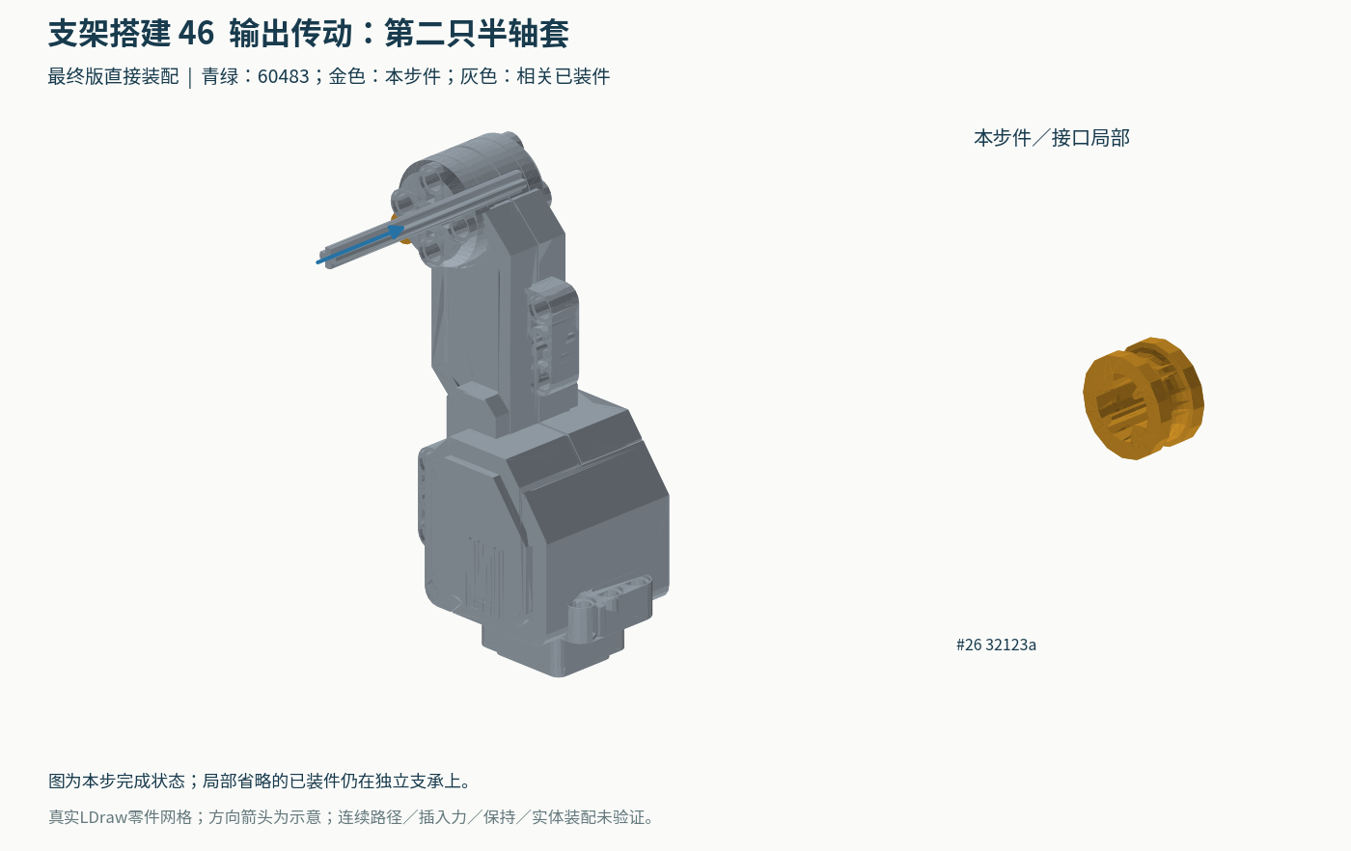
mechanical/final/site-source/dist/integrated/final-head-diagrams/CORE46.png
