gonewx/quadcuber/mechanical/final/site-source/dist/integrated/final-head-diagrams/TT04.png

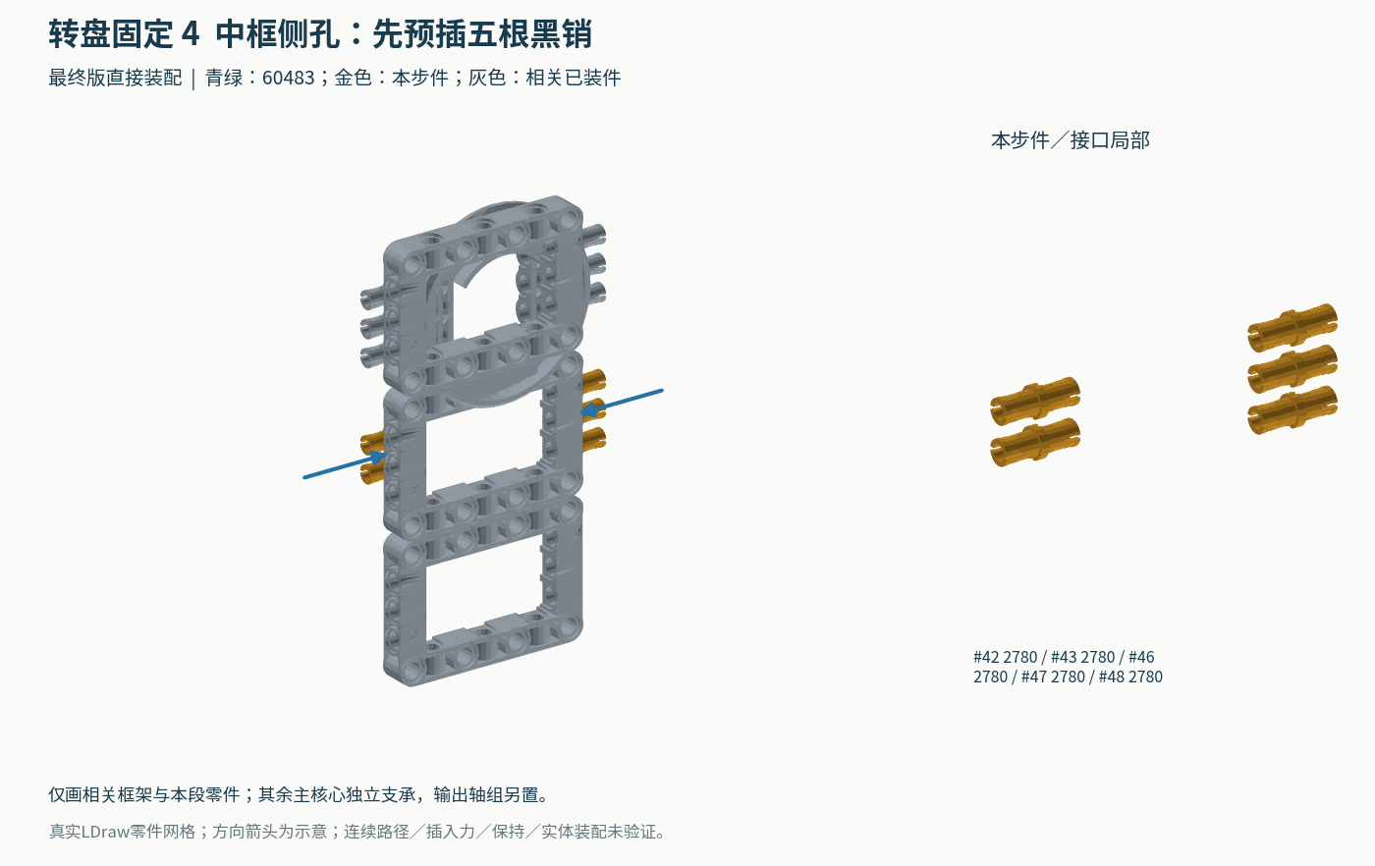
mechanical/final/site-source/dist/integrated/final-head-diagrams/TT04.png
