gonewx/quadcuber/mechanical/final/site-source/dist/integrated/head-diagrams/stack.png

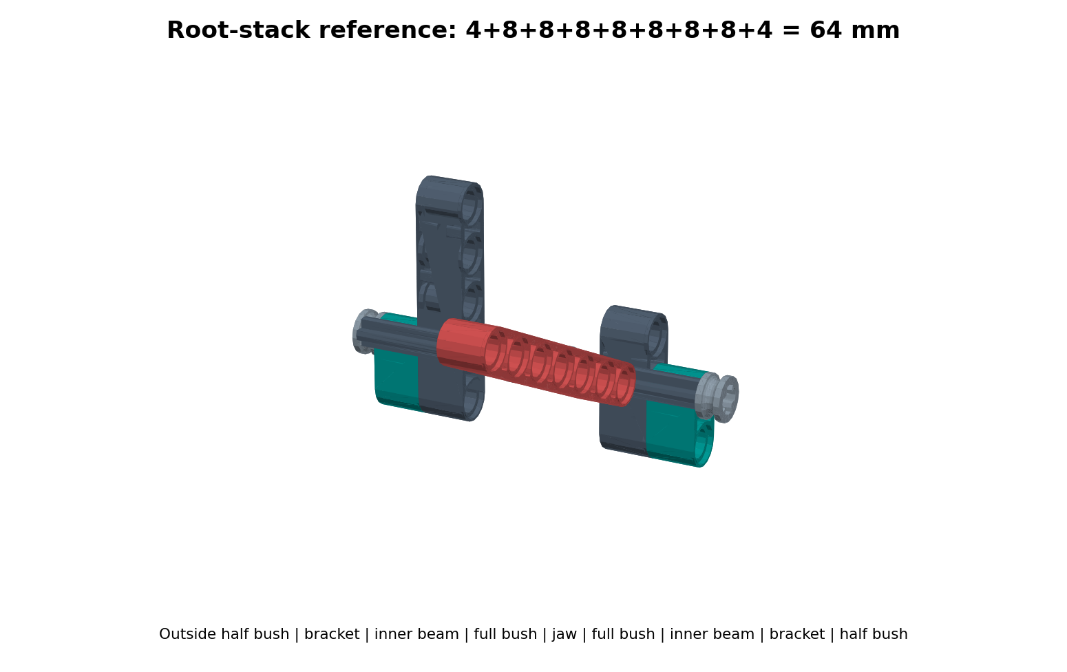
mechanical/final/site-source/dist/integrated/head-diagrams/stack.png
