gonewx/quadcuber/mechanical/final/site-source/dist/integrated/images/BASE-BAS-03.png

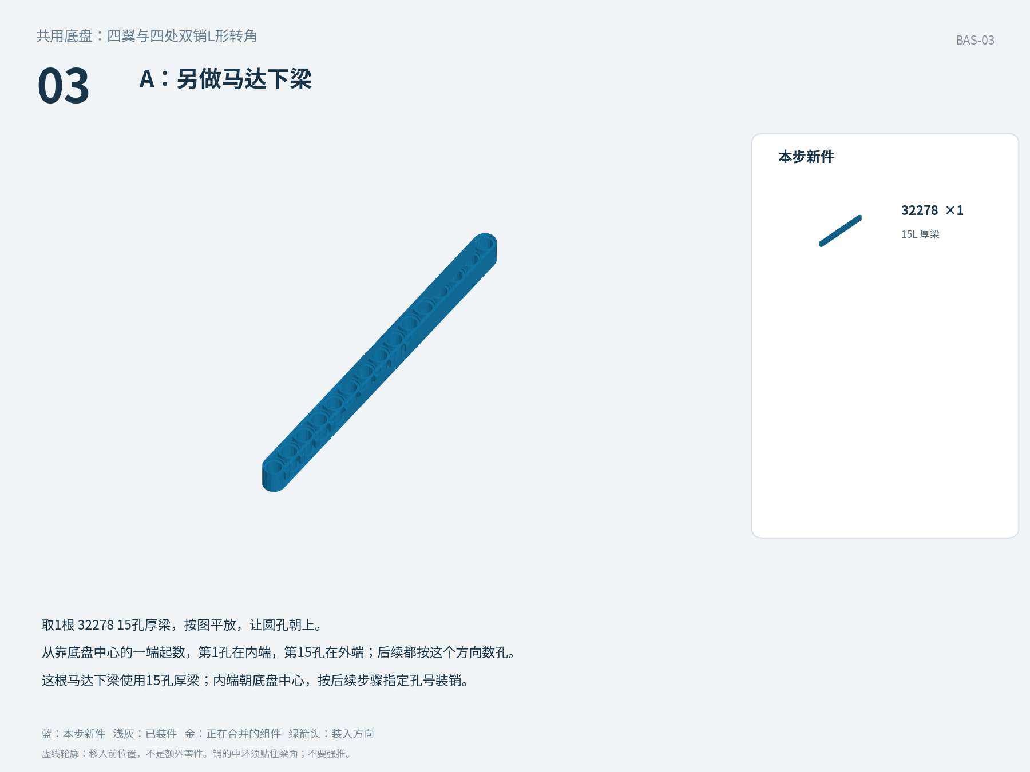
mechanical/final/site-source/dist/integrated/images/BASE-BAS-03.png
