gonewx/quadcuber/mechanical/final/site-source/dist/integrated/images/BASE-BAS-04.png

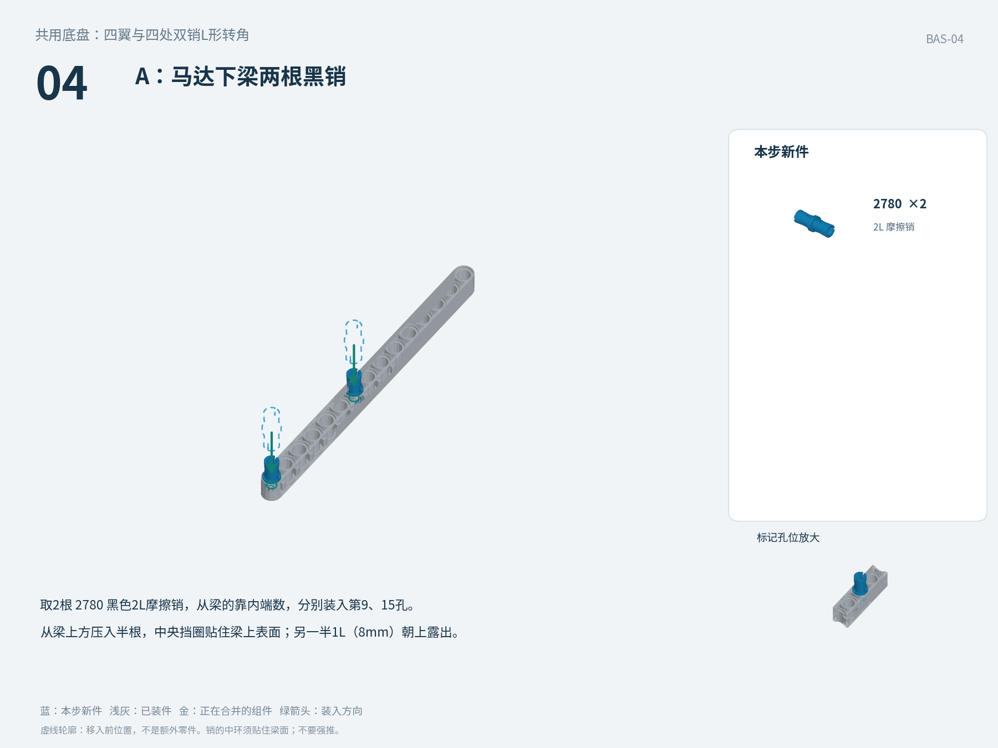
mechanical/final/site-source/dist/integrated/images/BASE-BAS-04.png
