gonewx/quadcuber/mechanical/final/site-source/dist/integrated/images/BASE-BAS-23.png

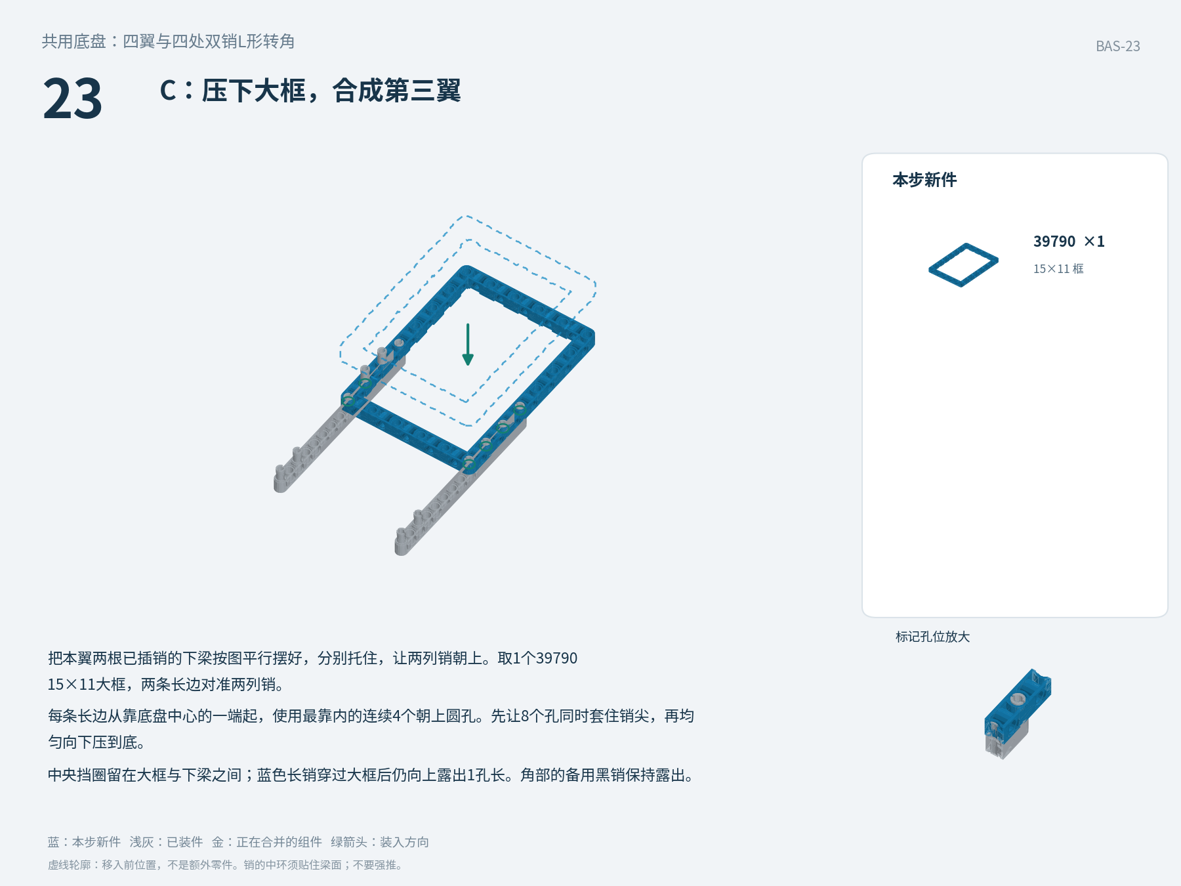
mechanical/final/site-source/dist/integrated/images/BASE-BAS-23.png
