gonewx/quadcuber/mechanical/final/site-source/dist/integrated/images/BASE-BAS-24.png

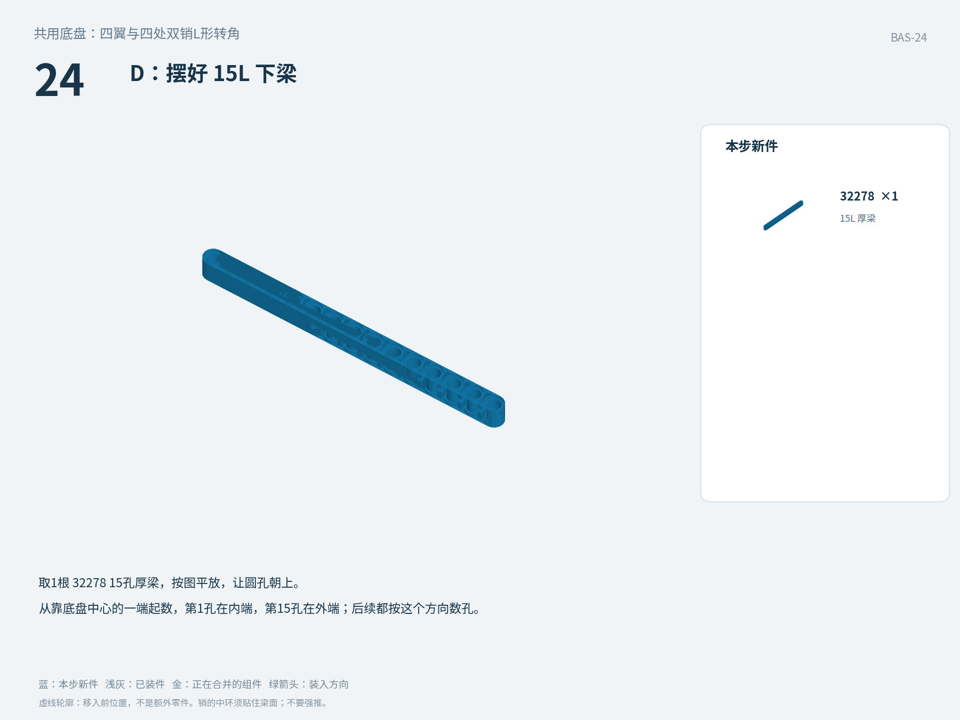
mechanical/final/site-source/dist/integrated/images/BASE-BAS-24.png
