gonewx/quadcuber/mechanical/final/site-source/dist/integrated/images/BASE-BAS-26.png

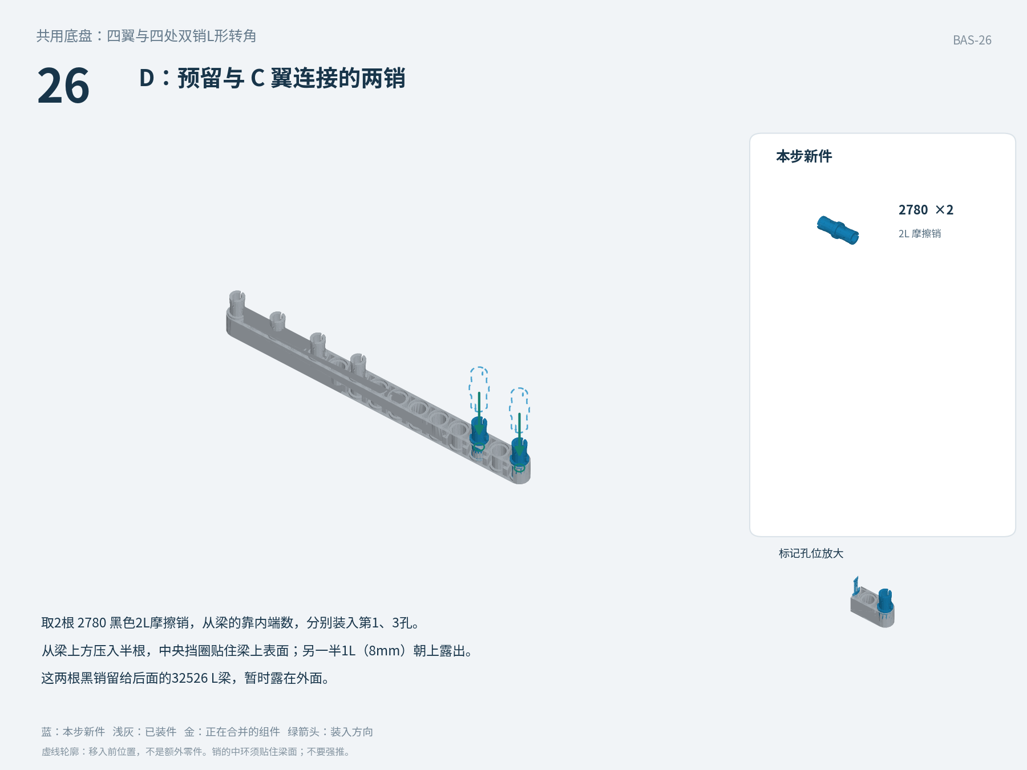
mechanical/final/site-source/dist/integrated/images/BASE-BAS-26.png
