gonewx/quadcuber/mechanical/final/site-source/dist/integrated/images/BASE-BAS-27.png

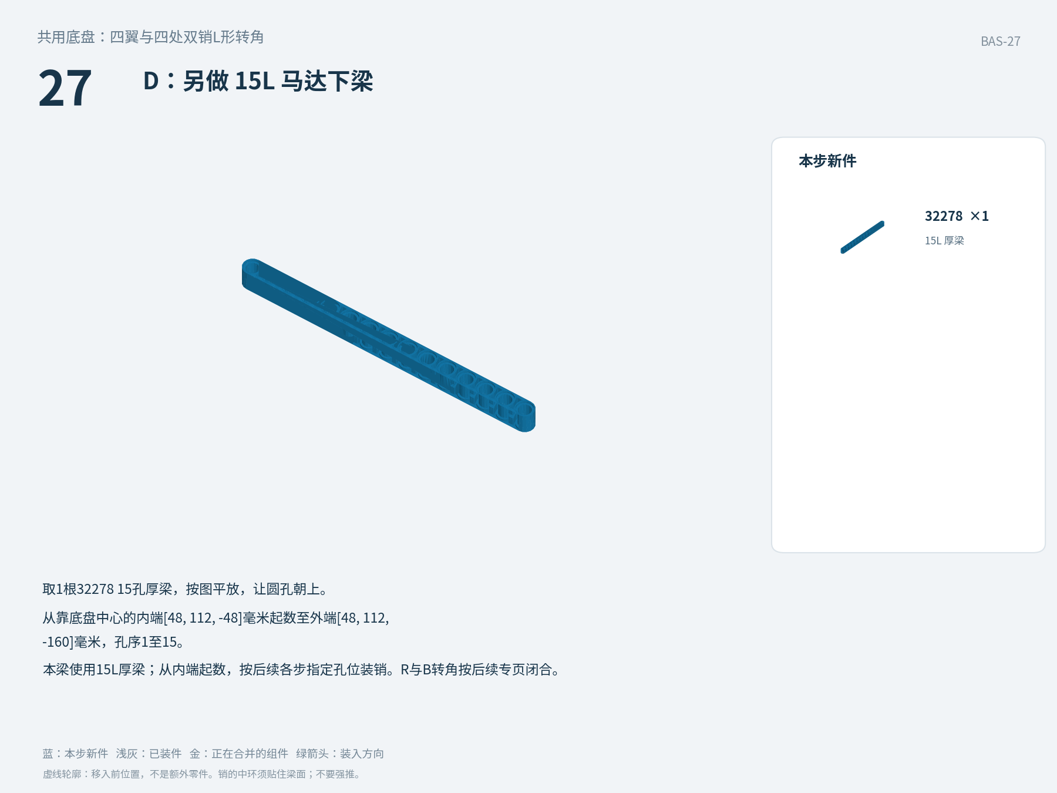
mechanical/final/site-source/dist/integrated/images/BASE-BAS-27.png
