gonewx/quadcuber/mechanical/final/site-source/dist/integrated/images/BASE-BAS-28.png

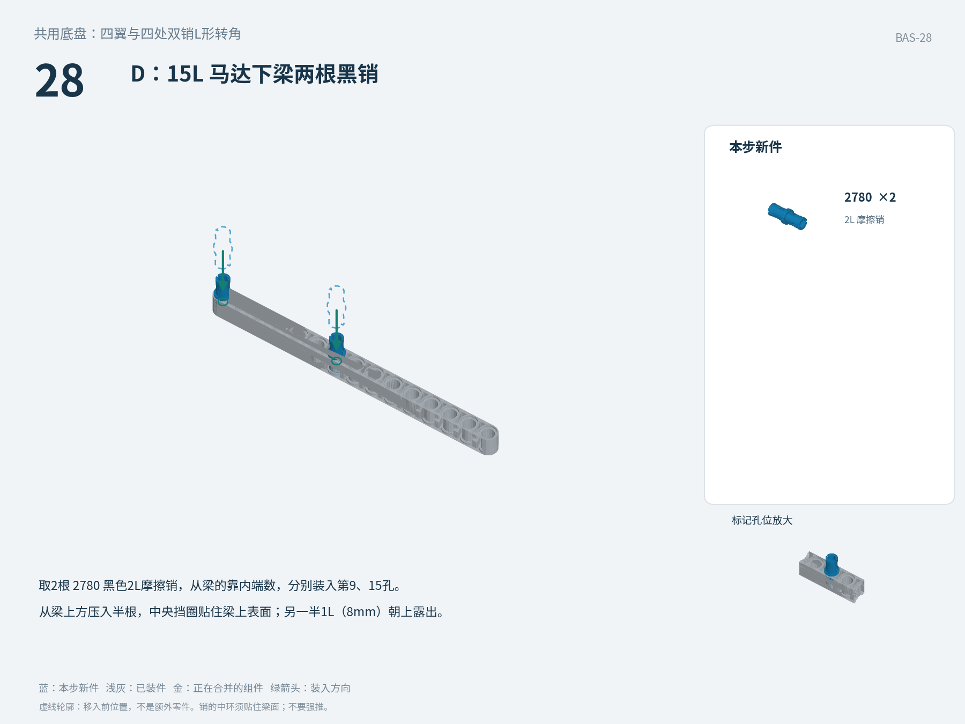
mechanical/final/site-source/dist/integrated/images/BASE-BAS-28.png
