gonewx/quadcuber/mechanical/final/site-source/dist/integrated/support-diagrams/001.png

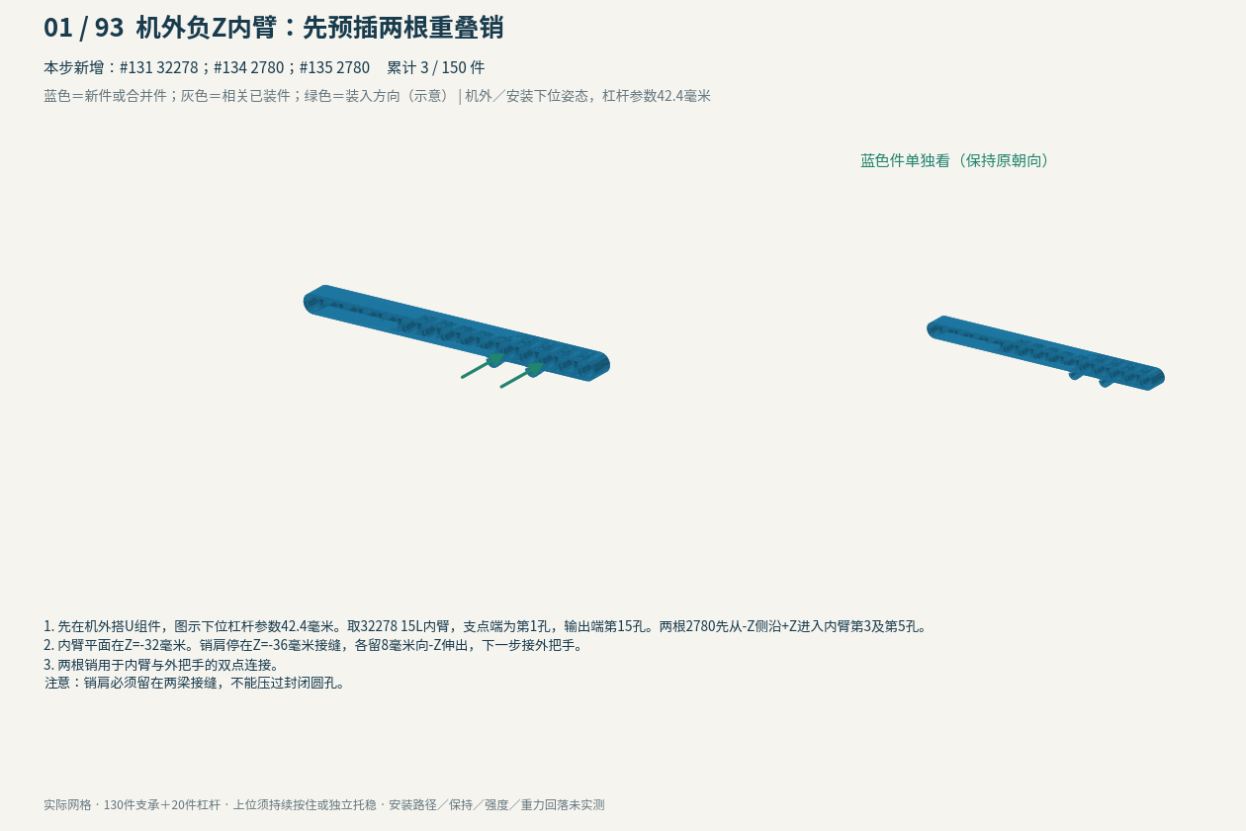
mechanical/final/site-source/dist/integrated/support-diagrams/001.png
