gonewx/quadcuber/mechanical/final/site-source/dist/integrated/support-diagrams/003.png

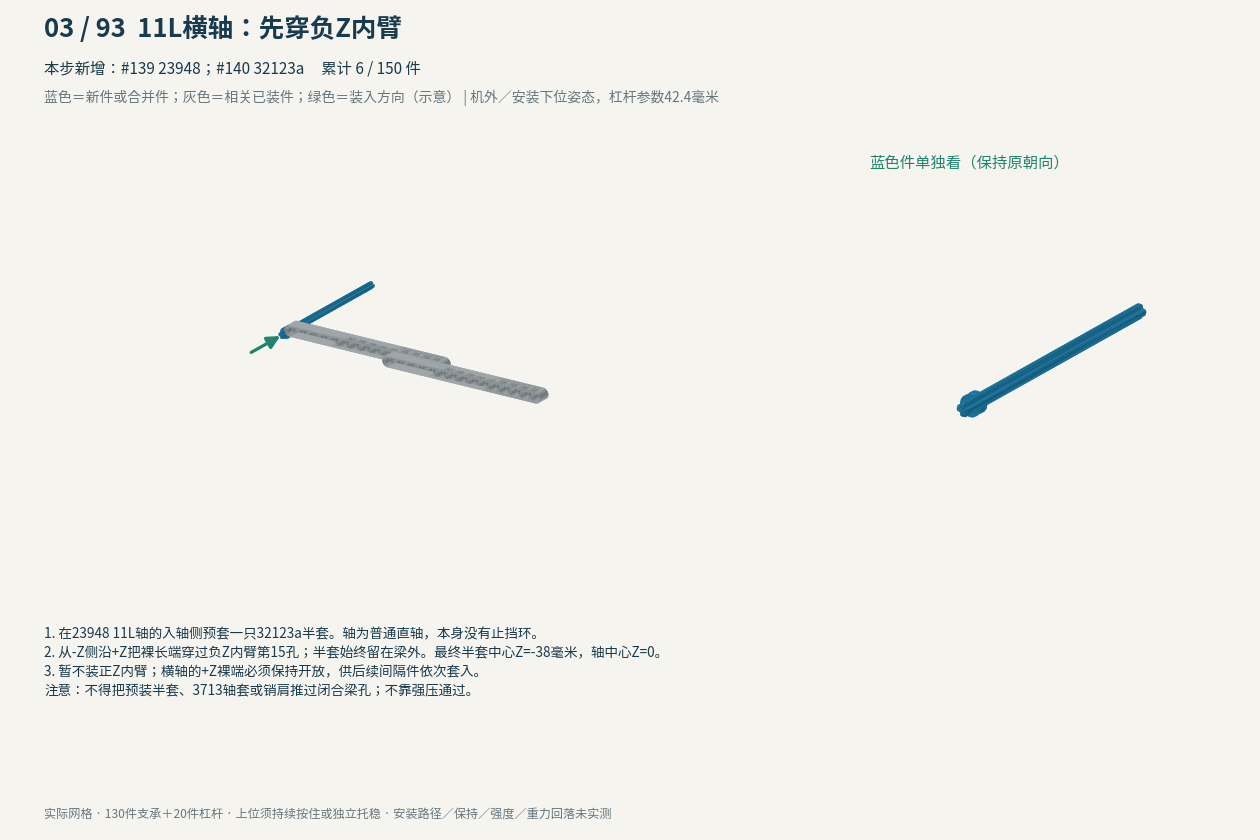
mechanical/final/site-source/dist/integrated/support-diagrams/003.png
