gonewx/quadcuber/mechanical/final/site-source/dist/integrated/support-diagrams/008.png

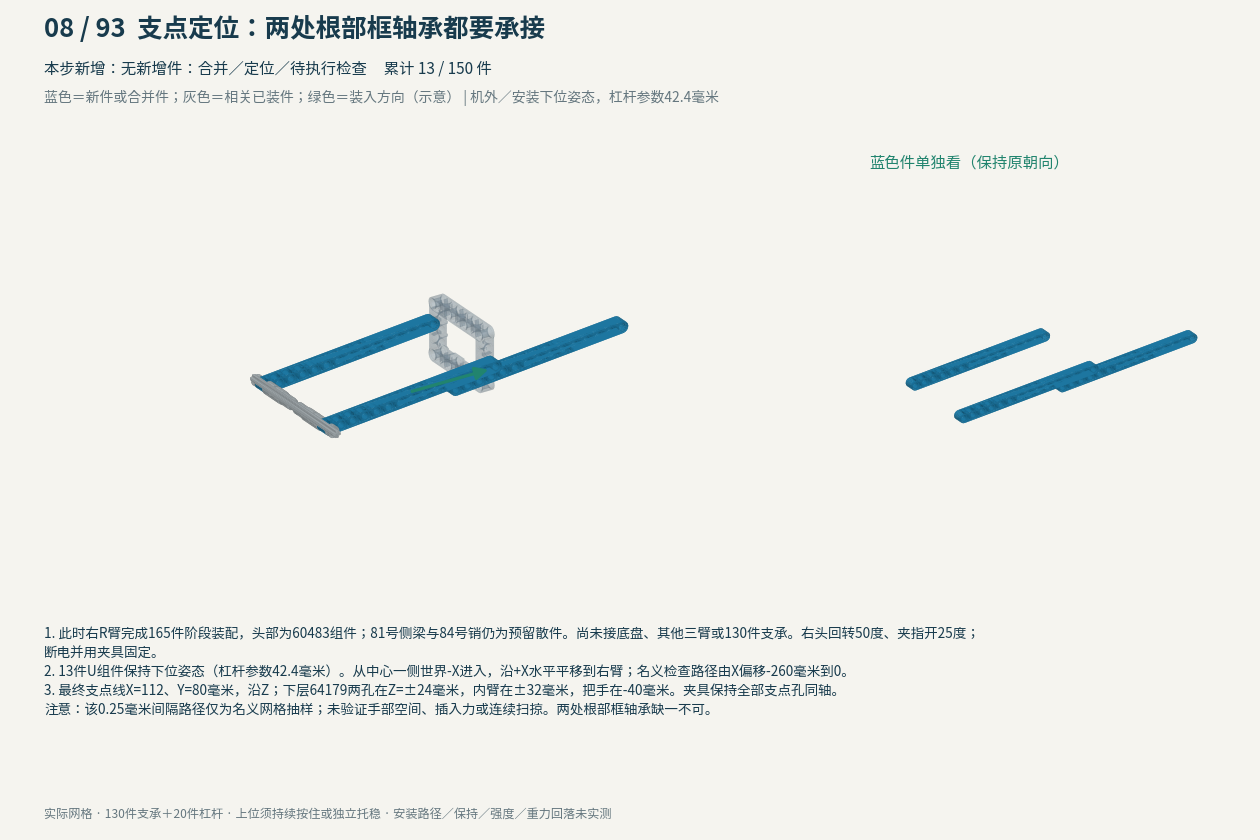
mechanical/final/site-source/dist/integrated/support-diagrams/008.png
