gonewx/quadcuber/mechanical/final/site-source/dist/integrated/support-diagrams/010.png

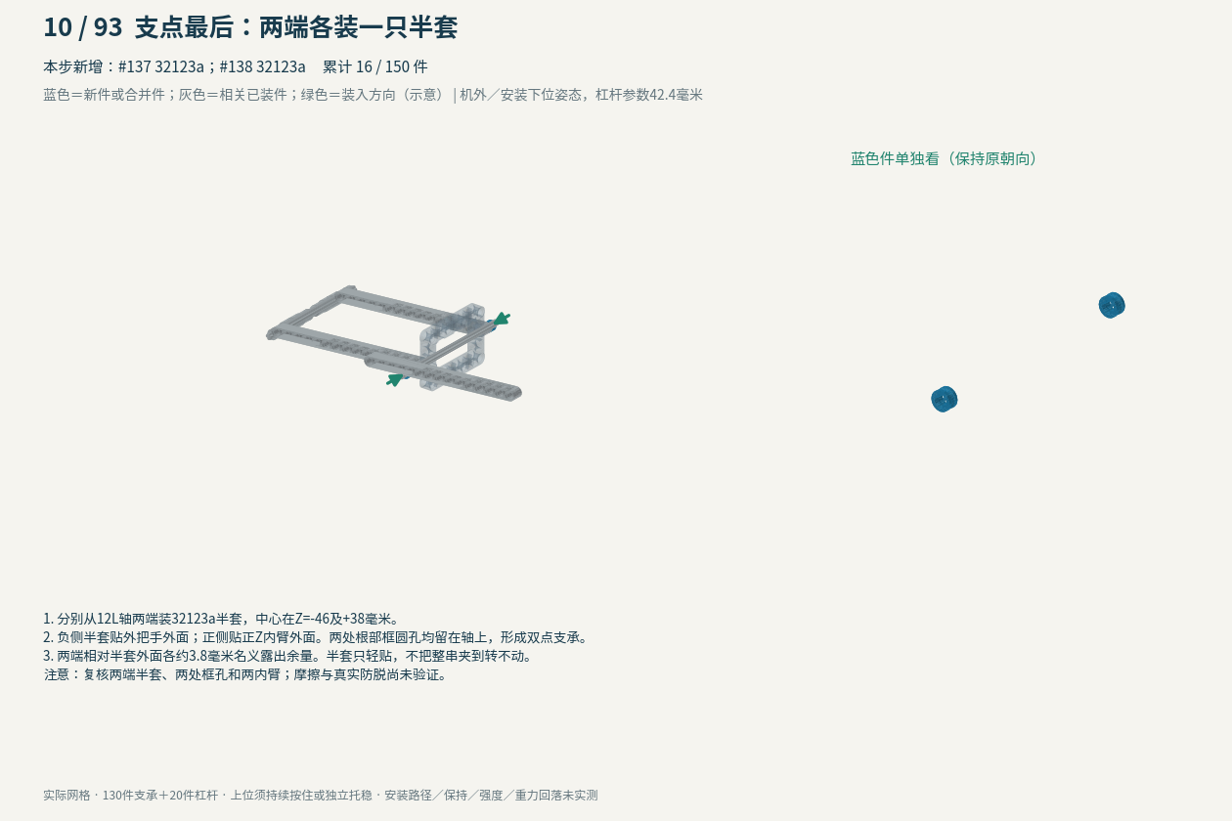
mechanical/final/site-source/dist/integrated/support-diagrams/010.png
