gonewx/quadcuber/mechanical/final/site-source/dist/integrated/support-diagrams/014.png

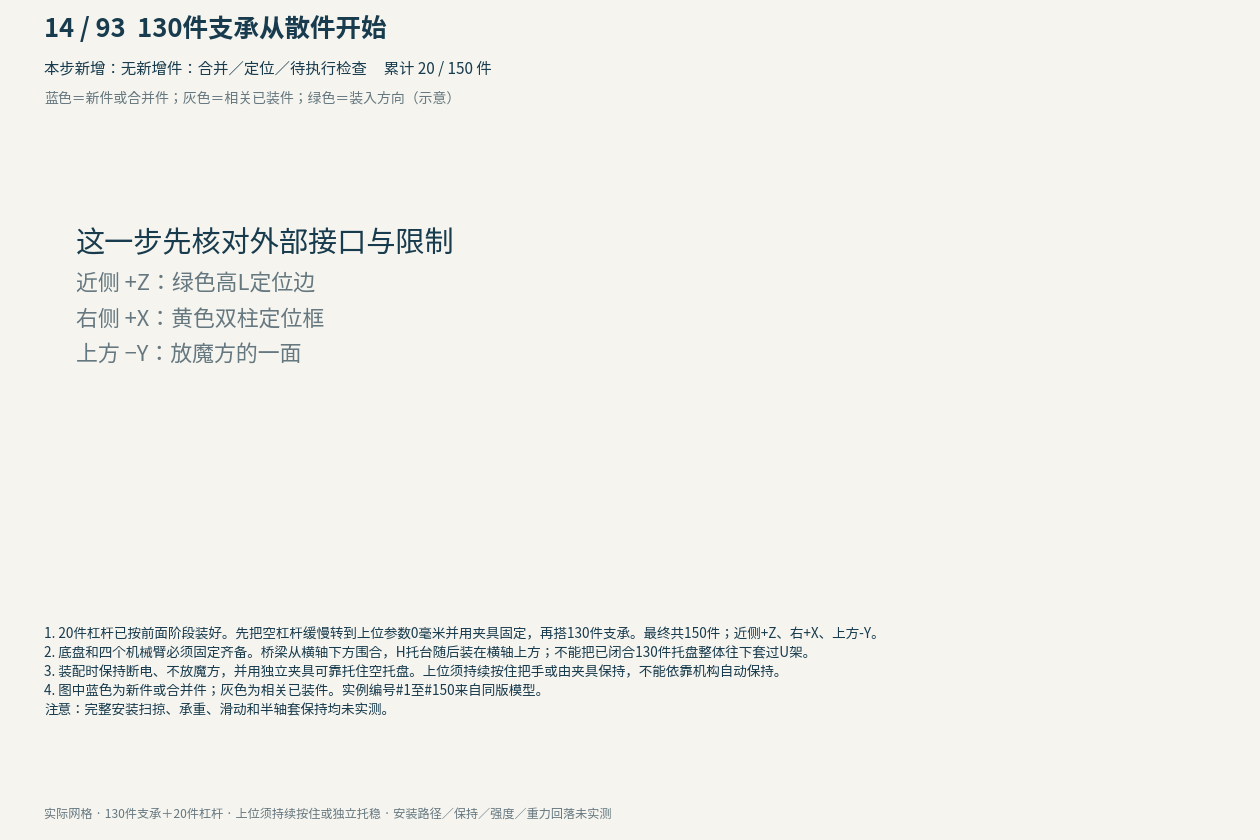
mechanical/final/site-source/dist/integrated/support-diagrams/014.png
