gonewx/quadcuber/mechanical/final/site-source/dist/integrated/support-diagrams/022.png

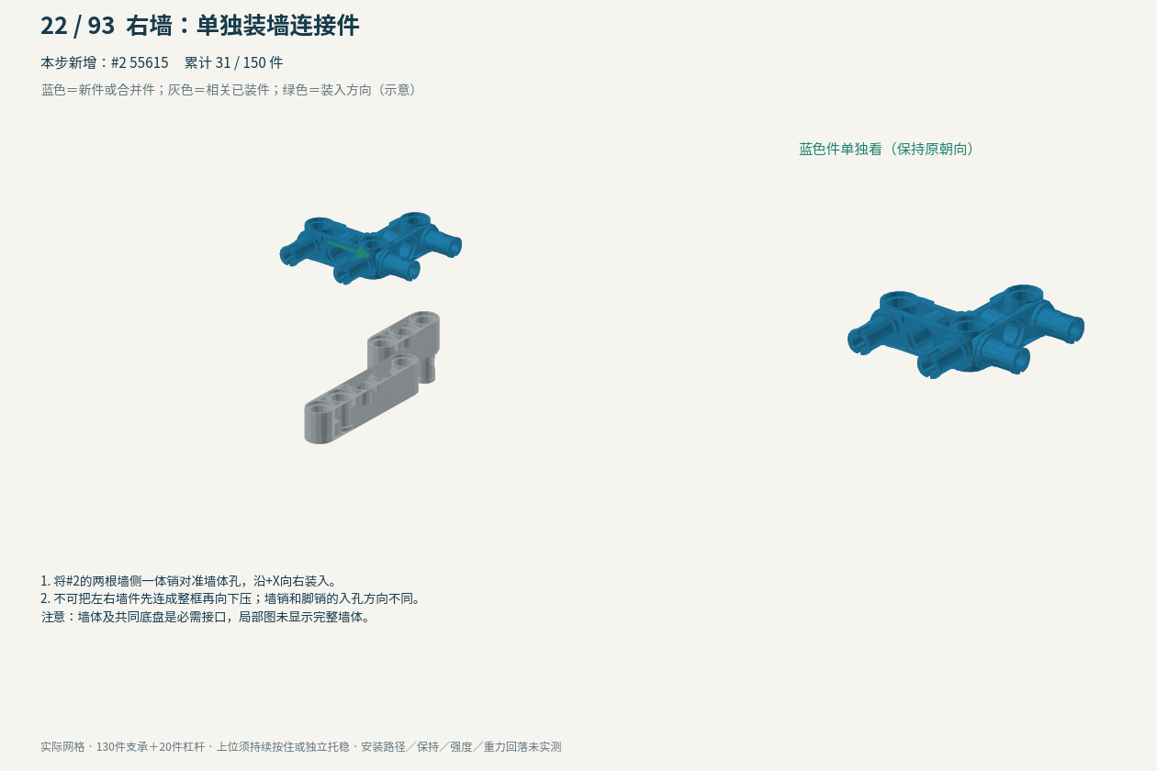
mechanical/final/site-source/dist/integrated/support-diagrams/022.png
