gonewx/quadcuber/mechanical/final/site-source/dist/integrated/support-diagrams/029.png

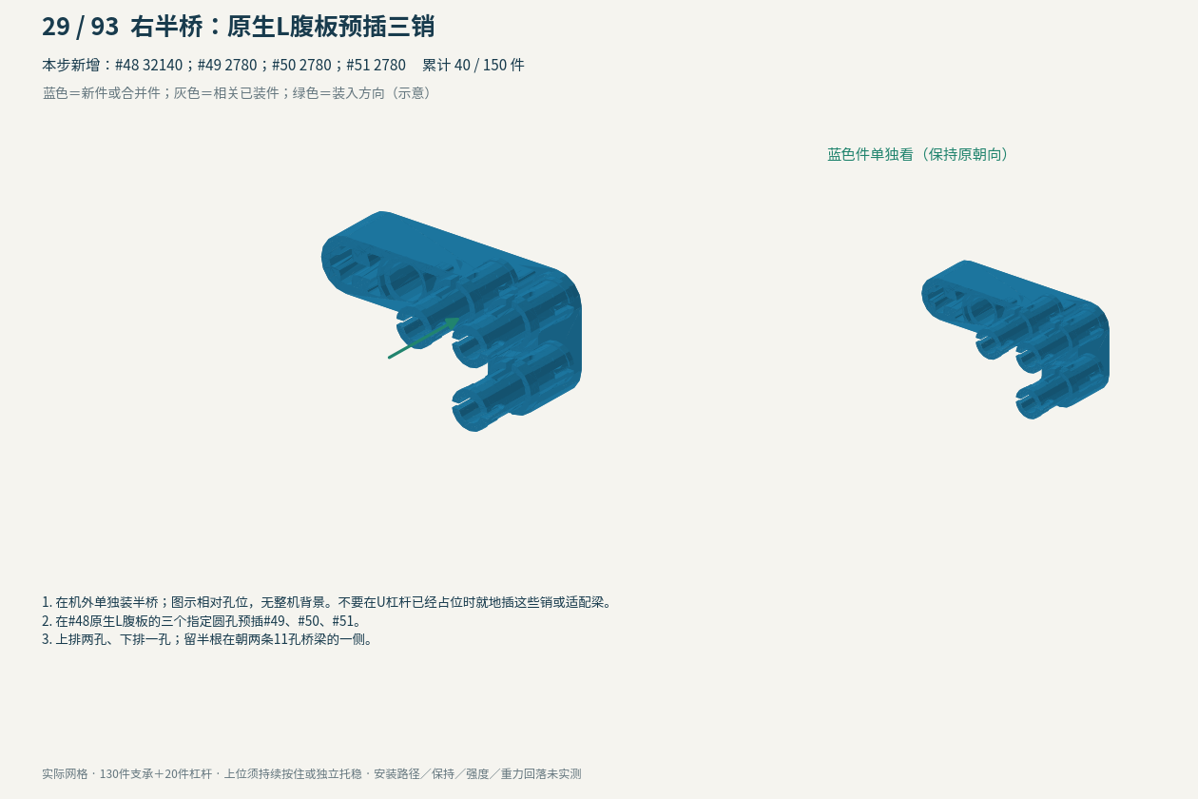
mechanical/final/site-source/dist/integrated/support-diagrams/029.png
