gonewx/quadcuber/electronics/first-board/order-and-cam.md

# 工程首板订单与CAM确认单

适用唯一包：quadcuber-A1-first-board-3cfff7c。设计可送CAM，未声称CAM已接受、料已齐或实板合格。用户自行提交嘉立创；不在此代下单。用途为少量工程验证，非量产/机器人直接满载交付。

## 确定的订单参数

|项|要求|
|---|---|
|功能板尺寸|144×112 mm；不能把Gerber笔宽外框当作新的功能尺寸|
|层数/材料|4层FR-4；F.Cu / In1.Cu / In2.Cu / B.Cu|
|成品厚度|1.6 mm；允许公差以CAM确认的订单为准|
|铜厚|外层2 oz（设计70µm）、内层1 oz（35µm），不能用默认内0.5oz替代|
|表面/颜色|ENIG沉金、绿阻焊白丝印；按细间距/孔工艺审核|
|最小线宽/间距规则|0.15/0.15 mm，正好等于嘉立创公开的外层2oz最小值，没有余量（外层约1190段0.15 mm走线）；原生DRC通过。见第8项，不能擅自整体缩线或改1oz|
|装配|嘉立创双面SMT，用户自焊清单中的18件通孔件；C26/C36不装|
|数量|由用户在下单时选择小批验证数量；本包全部数量按每块板计|

## CAM必须逐项确认，不把它们留成泛称“未验证”

1. **拼板/基准点**：功能板没有独立FID。由装配方增加可移除工艺边和基准点（建议至少5mm边、1mm基准点，最终以其夹持工艺为准），提供生产拼板预览；不得改变功能板孔铜、尺寸和位置。检查USB/EV3板边出线、拆边方式和双面夹持，不能自动假定V-cut可用。若要求移动功能区或改板，先提出具体位置及最小修改，不直接接受。
2. **镀槽不是NPTH**：J1三槽为3.556×1.016、3.048×0.762、0.762×3.048 mm；J5四槽为0.6×1.7 mm两处和0.6×1.4 mm两处，均在PTH Excellon的G85记录中。J1/J5铜环0.254 mm。确认按成品镀槽加工，不替换成圆孔/非金属槽。NPTH定位孔独立文件。
3. **28个焊盘内散热孔**：U1有4个Ø0.30；U10–U13各6个Ø0.33。`assembly/thermal-holes.csv`给出坐标。它们是散热过孔功能，不装元件脚；外环0.15 mm。U1的4个孔底面有阻焊覆盖；U10–U13的24个孔正反面阻焊都开窗，正面钢网开口完全盖住孔位，回流时焊锡会流进孔并从底面冒出（底面这些位置没有元件）。EP开窗中的孔不能只凭板级“盖油”断言已经封住。请CAM/装配方二选一给出接受方案：开放孔+明确钢网分窗/膏量/焊接验收；或针对这些孔的树脂填孔盖帽。不能用普通油墨塞孔冒充焊盘内树脂填孔。不得把J1/J5/用户自焊孔一起填掉。
4. **USB局部阻焊**：J5两个Ø0.65定位孔与相邻地焊盘开窗最近约0.1946 mm（同位置A/B编号重复合计4条检查记录）。确认实际阻焊桥能力，或书面接受局部合并/取消桥及焊接检查。U1焊盘宽0.20、pitch0.40 mm，按QFN工艺检查，不擅自扩焊盘。
5. **层叠/USB**：原生介质0.180/1.010/0.180 mm是设计意图，不是已获厂商承诺的叠层编号。选择实际可产的4层1.6mm、外2oz内1oz叠层，复核USB差分约90Ω。此首板是12Mbit/s功能验证，不宣称阻抗/USB认证通过；若需要修改铜线，必须先评审。
6. **装配确认**：按SMT BOM匹配精确制造商MPN，审核底面15件、pin1、二极管/LED极性及USB口朝向。CPL保留KiCad坐标和角度，不代表嘉立创料库零度定义已逐件验证。完成料库3D/贴片预览后才确认生产。
7. **USB-C J5混合工艺**：J5由厂商采购、贴装SMT触点；四个PTH屏蔽脚必须另由装配方确认选择性/手工等补焊方法并完成。它不属于用户“普通通孔件自焊”范围，不允许交付只有信号脚焊好的松动插座。若该服务不能焊屏蔽脚，停在此项并明确提出调整分工，不自行删J5或换料。

8. **2oz外层下的过孔铜环**：嘉立创能力页写明“多层板2oz：PTH铜环≥0.254 mm”。本板299个0.6/0.3 mm过孔和28个焊盘内散热孔的铜环都是0.15 mm（`validation/jlc-preflight.json`的`annular_by_class`列出了全部327个孔）。该页没有说明这条规则是否适用于普通过孔，请CAM明确答复：能否按现状生产、是否需要加大焊盘，或者能否把外层改为1oz。需要改设计时先返回评审，不接受CAM自动扩孔环或缩孔。
9. **U1热孔与相邻过孔间距**：U1.57有一个散热孔与旁边的GND过孔孔壁间距0.359 mm（同为GND网络），低于本项目0.45 mm的严格检查值，但不违反嘉立创公开的孔间距下限（`hole_spacing_violations`为空）。请CAM确认钻孔间距是否可接受。
10. **丝印线宽**：有1976段丝印线（主要是封装轮廓）宽0.12 mm，细于常见的0.15 mm建议值，可能印得断续。这只影响外观，接受即可，不需要因此改板。所有可见文字都是≥1 mm字高。
11. **未上架或缺货料号**：W25Q16RVCNJQ（U7）和MF-MSMF110/16X-2（F10–F13）在LCSC/嘉立创没有上架，需要走全球代购或寄料。U7只有RVSSJQ/RVSNJQ等其他后缀，F10–F13只有/16-2（NRND）、/24X-2、-2，都不得替换。0407008.WR（F1）、CSD18540Q5B（Q1）等的LCSC页面库存为0，详见`assembly/part-matching.csv`。缺任何一个都不能开工贴片，也不能由嘉立创自动选替代料。

## 丝印说明

设计基线 `3cfff7c` 已把原板的风险丝印改为 `QUADCUBER A1 / PROTOTYPE` 和 `VERIFY EV3 PINMAP BEFORE MOTOR USE`。电路、铜和孔都没有变化。板上不再有 “DO NOT FABRICATE” 字样，不需要再单独向工厂解释。EV3 针序仍须在接电机前做断电六路通断核对，见 [首次上电步骤](bring-up.md)。

## 资料与能力来源

- [PCB能力](https://jlcpcb.com/capabilities/pcb-capabilities)
- [装配能力](https://jlcpcb.com/capabilities/pcb-assembly-capabilities)
- [工艺边与FID](https://jlcpcb.com/help/article/how-to-add-edge-rails-fiducials-for-pcb-assembly-order)
- [过孔覆盖/填孔](https://jlcpcb.com/help/article/pcb-via-covering)

以上公开国际站规范用于审查依据；国内嘉立创实际所选服务、料库与CAM接受结果才是本订单依据。未报价、上传、采购或获得CAM承诺。
