gonewx/quadcuber/generated/electronics/engineering-first-board/docs/order-and-cam.md

# 工程首板订单与CAM确认单

适用唯一包：quadcuber-A1-first-board-db20b98。设计可送CAM，未声称CAM已接受、料已齐或实板合格。用户自行提交嘉立创；不在此代下单。用途为少量工程验证，非量产/机器人直接满载交付。

## 确定的订单参数

|项|要求|
|---|---|
|功能板尺寸|144×112 mm；不能把Gerber笔宽外框当作新的功能尺寸|
|层数/材料|4层FR-4；F.Cu / In1.Cu / In2.Cu / B.Cu|
|成品厚度|1.6 mm；允许公差以CAM确认的订单为准|
|铜厚|外层2 oz（设计70µm）、内层1 oz（35µm），不能用默认内0.5oz替代|
|表面/颜色|ENIG沉金、绿阻焊白丝印；按细间距/孔工艺审核|
|最小线宽/间距规则|0.15/0.15 mm；原生DRC通过，按外2oz审核；不能擅自整体缩线或改1oz|
|装配|嘉立创双面SMT，用户自焊清单中的18件通孔件；C26/C36不装|
|数量|由用户在下单时选择小批验证数量；本包全部数量按每块板计|

## CAM必须逐项确认，不把它们留成泛称“未验证”

1. **拼板/基准点**：功能板没有独立FID。由装配方增加可移除工艺边和基准点（建议至少5mm边、1mm基准点，最终以其夹持工艺为准），提供生产拼板预览；不得改变功能板孔铜、尺寸和位置。检查USB/EV3板边出线、拆边方式和双面夹持，不能自动假定V-cut可用。若要求移动功能区或改板，先提出具体位置及最小修改，不直接接受。
2. **镀槽不是NPTH**：J1三槽为3.556×1.016、3.048×0.762、0.762×3.048 mm；J5四槽为0.6×1.7 mm两处和0.6×1.4 mm两处，均在PTH Excellon的G85记录中。J1/J5铜环0.254 mm。确认按成品镀槽加工，不替换成圆孔/非金属槽。NPTH定位孔独立文件。
3. **28个焊盘内散热孔**：U1有4个Ø0.30；U10–U13各6个Ø0.33。`assembly/thermal-holes.csv`给出坐标。它们是散热过孔功能，不装元件脚；外环0.15 mm。EP开窗中的孔不能只凭板级“盖油”断言已经封住。请CAM/装配方二选一给出接受方案：开放孔+明确钢网分窗/膏量/焊接验收；或针对这些孔的树脂填孔盖帽。不能用普通油墨塞孔冒充焊盘内树脂填孔。不得把J1/J5/用户自焊孔一起填掉。
4. **USB局部阻焊**：J5两个Ø0.65定位孔与相邻地焊盘开窗最近约0.1946 mm（同位置A/B编号重复合计4条检查记录）。确认实际阻焊桥能力，或书面接受局部合并/取消桥及焊接检查。U1焊盘宽0.20、pitch0.40 mm，按QFN工艺检查，不擅自扩焊盘。
5. **层叠/USB**：原生介质0.180/1.010/0.180 mm是设计意图，不是已获厂商承诺的叠层编号。选择实际可产的4层1.6mm、外2oz内1oz叠层，复核USB差分约90Ω。此首板是12Mbit/s功能验证，不宣称阻抗/USB认证通过；若需要修改铜线，必须先评审。
6. **装配确认**：按SMT BOM匹配精确制造商MPN，审核底面15件、pin1、二极管/LED极性及USB口朝向。CPL保留KiCad坐标和角度，不代表嘉立创料库零度定义已逐件验证。完成料库3D/贴片预览后才确认生产。
7. **USB-C J5混合工艺**：J5由厂商采购、贴装SMT触点；四个PTH屏蔽脚必须另由装配方确认选择性/手工等补焊方法并完成。它不属于用户“普通通孔件自焊”范围，不允许交付只有信号脚焊好的松动插座。若该服务不能焊屏蔽脚，停在此项并明确提出调整分工，不自行删J5或换料。

## 风险丝印保留及用途解释

原板`ENGINEERING HOLD / DO NOT FABRICATE`风险文字没有删除，也没有改变Gerber。其实际影响是厂商可能暂停并要求确认；本包不能假装文字不存在。请随CAM提交本说明，说明本次申请是受控工程首板，用户须在生产预览明确确认保留这些文字后制造。该确认不构成性能/量产放行。

将来若用户另行批准更改丝印，建议`ENGINEERING PROTOTYPE / VERIFY BEFORE POWER`，仅调整丝印并重新导出/核验。本包不实施该改动。若厂商拒绝现有风险文字，不隐瞒或擅自删除，应返回用户确认。

## 资料与能力来源

- [PCB能力](https://jlcpcb.com/capabilities/pcb-capabilities)
- [装配能力](https://jlcpcb.com/capabilities/pcb-assembly-capabilities)
- [工艺边与FID](https://jlcpcb.com/help/article/how-to-add-edge-rails-fiducials-for-pcb-assembly-order)
- [过孔覆盖/填孔](https://jlcpcb.com/help/article/pcb-via-covering)

以上公开国际站规范用于审查依据；国内嘉立创实际所选服务、料库与CAM接受结果才是本订单依据。未报价、上传、采购或获得CAM承诺。
