gonewx/quadcuber/generated/electronics-b1/bom-hand-solder.csv

焊接顺序 | 类别 | 型号/规格 | 位号 | 数量 | 封装 | 说明
1 | 贴片 IC | AMS1117-5.0（SOT-223） | U2 | 1 | SOT-223-3_TabPin2 | 输入最高 15V；约 0.1A 时功耗约 0.4W
1 | 贴片 IC | AO4407A P-MOS（-30V/12A，SOIC-8） | Q1 | 1 | SOIC-8_3.9x4.9mm_P1.27mm | 反接保护：漏极(5-8)接电源、源极(1-3)接 VM；导通后双向导电
1 | 贴片 IC | DRV8871DDAR | U10,U20,U30,U40 | 4 | Texas_HTSOP-8-1EP_3.9x4.9mm_P1.27mm_EP2.95x4.9mm_Mask2.4x3.1mm_ThermalVias | 热风枪焊散热焊盘
1 | 贴片 IC | LM2596S-5.0（TO-263-5） | U1 | 1 | TO-263-5_TabPin3 | ON/OFF(5) 接地=常开；FB(4) 接输出；散热片焊盘接地铜
2 | 贴片电阻电容 | 0.1u 0.1µF 0805 | C7,C10,C20,C30,C40 | 5 | C_0805_2012Metric_Pad1.18x1.45mm_HandSolder
2 | 贴片电阻电容 | 10k 0805 | R1,R11,R13,R21,R23,R31,R33,R41,R43 | 9 | R_0805_2012Metric_Pad1.20x1.40mm_HandSolder
2 | 贴片电阻电容 | 10u/25V 10µF/25V 0805 | C5 | 1 | C_0805_2012Metric_Pad1.18x1.45mm_HandSolder
2 | 贴片电阻电容 | 20k 0805 | R12,R14,R22,R24,R32,R34,R42,R44 | 8 | R_0805_2012Metric_Pad1.20x1.40mm_HandSolder
2 | 贴片电阻电容 | 220 0805 | R15,R25,R35,R45 | 4 | R_0805_2012Metric_Pad1.20x1.40mm_HandSolder
2 | 贴片电阻电容 | 22u/16V 22µF/16V 0805 | C6 | 1 | C_0805_2012Metric_Pad1.18x1.45mm_HandSolder
2 | 贴片电阻电容 | 300R 1W 300Ω 1W 2512 | R2,R3 | 2 | R_2512_6332Metric_Pad1.40x3.35mm_HandSolder
2 | 贴片电阻电容 | 43.2kΩ 1% 0805 | R10,R20,R30,R40 | 4 | R_0805_2012Metric_Pad1.20x1.40mm_HandSolder | 限流约 1.48A（64/R）
3 | 贴片二极管 | 12V BZT52C12 稳压管 | DZ1 | 1 | D_SOD-123 | 阴极(1)接源极 VM，限制 |Vgs|<=12V
3 | 贴片二极管 | SMBJ12A 单向 TVS | D1 | 1 | D_SMB_Handsoldering | 阴极(1)接 VM
3 | 贴片二极管 | SS14 肖特基 | D3 | 1 | D_SMA_Handsoldering | 阴极(1)接 Pico VSYS
3 | 贴片二极管 | SS34 3A 肖特基 | D2 | 1 | D_SMA_Handsoldering | 阴极(1)接开关节点
4 | 贴片保险丝 | 1206 贴片保险丝 8A 慢断 | F1 | 1 | Fuse_1206_3216Metric_Pad1.42x1.75mm_HandSolder | 只防短路起火，不限流
5 | 贴片电解电容 | 100u/25V 100µF/25V 贴片电解 6.3×7.7 | C11,C21,C31,C41 | 4 | CP_Elec_6.3x7.7
5 | 贴片电解电容 | 220u/25V 220µF/25V 贴片电解 8×10.5（输入） | C3 | 1 | CP_Elec_8x10.5
5 | 贴片电解电容 | 470u/16V 470µF/16V 贴片电解 8×10.5（输出） | C4 | 1 | CP_Elec_8x10.5
5 | 贴片电解电容 | 470u/25V 470µF/25V 贴片电解 10×10.5 | C1,C2 | 2 | CP_Elec_10x10.5
6 | 贴片电感 | 33uH 3A 33µH/3A 贴片功率电感 12×12 | L1 | 1 | L_12x12mm_H8mm
7 | 排针/排母 | UART G TX RX 1×3 排针 | J2 | 1 | PinHeader_1x03_P2.54mm_Vertical | 接 Zero W：GP0=TX、GP1=RX
7 | 排针/排母 | 树莓派 Pico H + 2×1×20 排母 | U3 | 1 | RaspberryPi_Pico_Common_THT | USB 朝上；排母两排相距 17.78mm
7 | 排针/排母 | 舵机 B S+G 1×3 排针 | J40 | 1 | PinHeader_1x03_P2.54mm_Vertical | 自下而上 G/+/S
7 | 排针/排母 | 舵机 F S+G 1×3 排针 | J30 | 1 | PinHeader_1x03_P2.54mm_Vertical | 自下而上 G/+/S
7 | 排针/排母 | 舵机 L S+G 1×3 排针 | J20 | 1 | PinHeader_1x03_P2.54mm_Vertical | 自下而上 G/+/S
7 | 排针/排母 | 舵机 R S+G 1×3 排针 | J10 | 1 | PinHeader_1x03_P2.54mm_Vertical | 自下而上 G/+/S
8 | 插座 | 9V DC 中心正 DC-005 5.5/2.1mm | J1 | 1 | BarrelJack_Horizontal | 脚1=中心(+)、脚2=外壳(-)、脚3=开关脚并地；焊前用实物核对孔位
8 | 插座 | EV3 B 同批 EV3 插座（用户已有） | J41 | 1 | EV3_Socket_UserDrawing | 针序未用实物核实：接电机前断电六路通断
8 | 插座 | EV3 F 同批 EV3 插座（用户已有） | J31 | 1 | EV3_Socket_UserDrawing | 针序未用实物核实：接电机前断电六路通断
8 | 插座 | EV3 L 同批 EV3 插座（用户已有） | J21 | 1 | EV3_Socket_UserDrawing | 针序未用实物核实：接电机前断电六路通断
8 | 插座 | EV3 R 同批 EV3 插座（用户已有） | J11 | 1 | EV3_Socket_UserDrawing | 针序未用实物核实：接电机前断电六路通断
