gonewx/quadcuber/generated/electronics/bom-grouped.csv

References | Value | Manufacturer | MPN | Footprint | Quantity | Notes
U1 | RP2040 | Raspberry Pi | RP2040 | Quadcuber:QFN-56-1EP_7x7mm_P0.4mm_EP3.2x3.2mm_ThermalVias | 1 | Bare RP2040, not a Pico module. EP57 and TESTEN19 ground; DVDD23/50 supplied only by VREG_OUT45.
J2 | UART GND TX RX | Wurth Elektronik | 61300311121 | Quadcuber:PinHeader_1x03_P2.54mm_Vertical | 1
J3 | RESET | Wurth Elektronik | 61300211121 | Quadcuber:PinHeader_1x02_P2.54mm_Vertical | 1
J4 | SWD VREF D G C | Wurth Elektronik | 61300411121 | Quadcuber:PinHeader_1x04_P2.54mm_Vertical | 1
R400; R407 | 10k | Yageo | RC0603FR-0710KL | Quadcuber:R_0603_1608Metric | 2
S2 | RUN RESET | E-Switch | TL3342F160QG | Quadcuber:SW_SPST_TL3342 | 1
C400; C410; C411; C412; C413; C414; C415; C416; C417; C418; C419; C427; C424 | 100n | Murata | GRM155R71C104KA88D | Quadcuber:C_0402_1005Metric | 13
C420; C421 | 1u | Murata | GRM155R61C105KA12D | Quadcuber:C_0402_1005Metric | 2
D2 | SS14 external logic isolation | Vishay | SS14-E3/61T | Quadcuber:D_SMA | 1
D5 | SS14 USB isolation | Vishay | SS14-E3/61T | Quadcuber:D_SMA | 1
C1; C423 | 1u/16V | Murata | GRM21BR71C105KA01L | Quadcuber:C_0805_2012Metric | 2
U5 | TLV75533PDBVR | Texas Instruments | TLV75533PDBVR | Quadcuber:SOT-23-5 | 1 | 3.3V/500mA IC rating; controller continuous design target <=150mA; no external 3V3 injection.
C422 | 4.7u/16V | KEMET | C0805C475K4PACTU | Quadcuber:C_0805_2012Metric | 1
J5 | USB-C data / BOOTSEL | GCT | USB4105-GF-A | Quadcuber:USB_C_Receptacle_GCT_USB4105-xx-A_16P_TopMnt_Horizontal | 1 | USB2 device only. CC1/CC2 each 5.1k to ground. Shell ground. No PD.
R401; R402 | 5.1k | Yageo | RC0603FR-075K1L | Quadcuber:R_0603_1608Metric | 2
F3 | 0.5A USB PTC | Bourns | MF-MSMF050-2 | Quadcuber:Fuse_1812_4532Metric | 1
U6 | USBLC6-2SC6 | STMicroelectronics | USBLC6-2SC6 | Quadcuber:SOT-23-6 | 1
R403; R404 | 27 | Yageo | RC0402FR-0727RL | Quadcuber:R_0402_1005Metric | 2
R405; R406; R101; R102; R105; R106; R109; R108; R121; R122; R125; R126; R129; R128; R141; R142; R145; R146; R149; R148; R161; R162; R165; R166; R169; R168 | 100k | Yageo | RC0603FR-07100KL | Quadcuber:R_0603_1608Metric | 26
U7 | W25Q16RVCNJQ 2MiB | Winbond | W25Q16RVCNJQ | Quadcuber:SOIC-8_3.9x4.9mm_P1.27mm | 1 | Current-production RV successor per Winbond PCN DM202601-03-A / AN0000070. CN 150mil SOP8; use QUADCUBER_A1 MicroPython boot2 QE-mask adaptation.
R408; R410; R103; R104; R123; R124; R143; R144; R163; R164 | 1k | Yageo | RC0603FR-071KL | Quadcuber:R_0603_1608Metric | 10
S1 | BOOTSEL | E-Switch | TL3342F160QG | Quadcuber:SW_SPST_TL3342 | 1
Y1 | 12MHz CL10pF | Abracon | ABM8-272-T3 | Quadcuber:Crystal_SMD_3225-4Pin_3.2x2.5mm | 1
R409 | 1k | Yageo | RC0402FR-071KL | Quadcuber:R_0402_1005Metric | 1
C425; C426 | 15p | Murata | GRM1555C1H150JA01D | Quadcuber:C_0402_1005Metric | 2
D7 | USER LED GP25 | Lite-On | LTST-C190KGKT | Quadcuber:LED_0603_1608Metric | 1
J1 | 9V DC center-positive | Switchcraft | RASPC722X | Quadcuber:Jack_DC_Switchcraft_RASPC722X | 1 | 5.5/2.1 mm mating plug 762/762Z, 9.5 mm barrel; 5A carrying rating, regulated 9V continuous input budget <=5A. Project pins 1=center, 2=sleeve, 3=sleeve shunt NC. Drawing visually verified by parent thread; original PDF pending local archive. See sources/raspc722x-review.md.
F1 | 8A 24V time-lag fuse | Littelfuse | 0407008.WR | Quadcuber:Fuse_Littelfuse_407_1206 | 1 | 407 time-lag; 24VDC, 60A interrupt, nominal melting I2t24.12A2s; not fast semiconductor protection. Continuous input design budget <=5A; current-limited 9V source required.
U4 | LM74700QDBVRQ1 | Texas Instruments | LM74700QDBVRQ1 | Quadcuber:SOT-23-6 | 1 | Ideal diode / reverse polarity. EN is NOT a power disconnect.
Q1 | CSD18540Q5B | Texas Instruments | CSD18540Q5B | Quadcuber:TDSON-8-1 | 1
C4; C5; C21; C22; C31; C32; C100; C103; C104; C105; C120; C123; C124; C125; C140; C143; C144; C145; C160; C163; C164; C165 | 100n | Murata | GRM21BR71H104KA01L | Quadcuber:C_0805_2012Metric | 22
D4 | SMBJ12CA input transient | Littelfuse | SMBJ12CA | Quadcuber:D_SMB | 1
D3 | SMBJ12A transient clamp | Littelfuse | SMBJ12A | Quadcuber:D_SMB | 1 | 12V stand-off, 19.9V rated pulse clamp. Pulse-only; never sustained 12V input.
C2; C3; C102; C122; C142; C162 | 470u/25V | Panasonic | EEU-FR1E471 | Quadcuber:CP_Radial_D10.0mm_P5.00mm | 6
R500; R501 | 300R 1W VM bleed | Vishay | CRCW2512300RFKEG | Quadcuber:R_2512_6332Metric | 2 | Two 300R/1% in parallel:150R VM bleed, 0.562W total at9.18V. Operating envelope total regen <=0.05J/event and <=5Hz; verify actual energy and resistor film temperature. Not a full-power brake.
U2; U3 | TPS54302DDCR | Texas Instruments | TPS54302DDCR | Quadcuber:SOT-23-6 | 2
C20; C30; C101; C121; C141; C161 | 10u/25V | Murata | GRM32DR71E106KA12L | Quadcuber:C_1210_3225Metric | 6
L1; L2 | 10uH 9A Isat16A | Bourns | SRP1245A-100M | Quadcuber:L_Bourns_SRP1245A | 2
C23; C24; C33; C34 | 22u/25V | Murata | GRM32ER71E226KE15L | Quadcuber:C_1210_3225Metric | 4
R21; R31 | 100k | Yageo | RT0603BRD07100KL | Quadcuber:R_0603_1608Metric | 2
R22; R32 | 13.3k | Yageo | RT0603BRD0713K3L | Quadcuber:R_0603_1608Metric | 2
C25; C35 | 75p | KEMET | C0603C750J5GACTU | Quadcuber:C_0603_1608Metric | 2
R23; R33 | 511k | Yageo | RC0603FR-07511KL | Quadcuber:R_0603_1608Metric | 2
R24; R34 | 105k | Yageo | RC0603FR-07105KL | Quadcuber:R_0603_1608Metric | 2
C26; C36 | 470u/10V | Panasonic | EEU-FR1A471 | Quadcuber:CP_Radial_D8.0mm_P3.50mm | 0 | DNP by default. Populate only after loop/step-response verification with added 470uF.
F2 | 0.5A encoder PTC | Bourns | MF-MSMF050-2 | Quadcuber:Fuse_1812_4532Metric | 1
U10; U11; U12; U13 | DRV8871DDAR | Texas Instruments | DRV8871DDAR | Quadcuber:Texas_HTSOP-8-1EP_3.9x4.9mm_P1.27mm_EP2.95x4.9mm_Mask2.4x3.1mm_ThermalVias | 4
R100; R120; R140; R160 | 43.2k | Yageo | RC0603FR-0743K2L | Quadcuber:R_0603_1608Metric | 4
J10 | EV3 R PINMAP HOLD | Unconfirmed (Coorle watermark) | UNCONFIRMED user drawing | Quadcuber:EV3_UserDrawing_PINMAP_HOLD | 1 | Nominal hole geometry from user drawing. HOLD: actual MPN, numbering 1-5, observation side, contact current and ear envelope require confirmation. See sources/ev3-user-drawing-review.md.
U20; U21; U22; U23 | SN74LVC2G17DBVR | Texas Instruments | SN74LVC2G17DBVR | Quadcuber:SOT-23-6 | 4
F10; F11; F12; F13 | 1.1A servo PTC | Bourns | MF-MSMF110/16X-2 | Quadcuber:Fuse_Bourns_MF_MSMF_Style2_1812 | 4
J20 | R SERVO G + S | Wurth Elektronik | 61300311121 | Quadcuber:PinHeader_1x03_P2.54mm_Vertical | 1
U30; U31; U32; U33 | SN74AHCT1G125DBVR | Texas Instruments | SN74AHCT1G125DBVR | Quadcuber:SOT-23-5 | 4 | Input leakage specified at VCC=0; prevents USB-only GPIO phantom servo supply.
R107; R127; R147; R167 | 220 | Yageo | RC0603FR-07220RL | Quadcuber:R_0603_1608Metric | 4
J11 | EV3 L PINMAP HOLD | Unconfirmed (Coorle watermark) | UNCONFIRMED user drawing | Quadcuber:EV3_UserDrawing_PINMAP_HOLD | 1 | Nominal hole geometry from user drawing. HOLD: actual MPN, numbering 1-5, observation side, contact current and ear envelope require confirmation. See sources/ev3-user-drawing-review.md.
J21 | L SERVO G + S | Wurth Elektronik | 61300311121 | Quadcuber:PinHeader_1x03_P2.54mm_Vertical | 1
J12 | EV3 F PINMAP HOLD | Unconfirmed (Coorle watermark) | UNCONFIRMED user drawing | Quadcuber:EV3_UserDrawing_PINMAP_HOLD | 1 | Nominal hole geometry from user drawing. HOLD: actual MPN, numbering 1-5, observation side, contact current and ear envelope require confirmation. See sources/ev3-user-drawing-review.md.
J22 | F SERVO G + S | Wurth Elektronik | 61300311121 | Quadcuber:PinHeader_1x03_P2.54mm_Vertical | 1
J13 | EV3 B PINMAP HOLD | Unconfirmed (Coorle watermark) | UNCONFIRMED user drawing | Quadcuber:EV3_UserDrawing_PINMAP_HOLD | 1 | Nominal hole geometry from user drawing. HOLD: actual MPN, numbering 1-5, observation side, contact current and ear envelope require confirmation. See sources/ev3-user-drawing-review.md.
J23 | B SERVO G + S | Wurth Elektronik | 61300311121 | Quadcuber:PinHeader_1x03_P2.54mm_Vertical | 1
TP1 | GND | PCB | N/A PCB copper | Quadcuber:TestPoint_Pad_D2.0mm | 0
TP2 | VM | PCB | N/A PCB copper | Quadcuber:TestPoint_Pad_D2.0mm | 0
TP3 | 5V_A | PCB | N/A PCB copper | Quadcuber:TestPoint_Pad_D2.0mm | 0
TP4 | 5V_B | PCB | N/A PCB copper | Quadcuber:TestPoint_Pad_D2.0mm | 0
TP5 | 5V_ENC | PCB | N/A PCB copper | Quadcuber:TestPoint_Pad_D2.0mm | 0
TP6 | 3V3 | PCB | N/A PCB copper | Quadcuber:TestPoint_Pad_D2.0mm | 0
TP7 | VSYS | PCB | N/A PCB copper | Quadcuber:TestPoint_Pad_D2.0mm | 0
TP10 | R_M1 | PCB | N/A PCB copper | Quadcuber:TestPoint_Pad_D1.5mm | 0
TP11 | R_M2 | PCB | N/A PCB copper | Quadcuber:TestPoint_Pad_D1.5mm | 0
TP12 | GP4 | PCB | N/A PCB copper | Quadcuber:TestPoint_Pad_D1.5mm | 0
TP13 | GP5 | PCB | N/A PCB copper | Quadcuber:TestPoint_Pad_D1.5mm | 0
TP14 | L_M1 | PCB | N/A PCB copper | Quadcuber:TestPoint_Pad_D1.5mm | 0
TP15 | L_M2 | PCB | N/A PCB copper | Quadcuber:TestPoint_Pad_D1.5mm | 0
TP16 | GP12 | PCB | N/A PCB copper | Quadcuber:TestPoint_Pad_D1.5mm | 0
TP17 | GP13 | PCB | N/A PCB copper | Quadcuber:TestPoint_Pad_D1.5mm | 0
TP18 | F_M1 | PCB | N/A PCB copper | Quadcuber:TestPoint_Pad_D1.5mm | 0
TP19 | F_M2 | PCB | N/A PCB copper | Quadcuber:TestPoint_Pad_D1.5mm | 0
TP20 | GP16 | PCB | N/A PCB copper | Quadcuber:TestPoint_Pad_D1.5mm | 0
TP21 | GP17 | PCB | N/A PCB copper | Quadcuber:TestPoint_Pad_D1.5mm | 0
TP22 | B_M1 | PCB | N/A PCB copper | Quadcuber:TestPoint_Pad_D1.5mm | 0
TP23 | B_M2 | PCB | N/A PCB copper | Quadcuber:TestPoint_Pad_D1.5mm | 0
TP24 | GP18 | PCB | N/A PCB copper | Quadcuber:TestPoint_Pad_D1.5mm | 0
TP25 | GP19 | PCB | N/A PCB copper | Quadcuber:TestPoint_Pad_D1.5mm | 0
H1; H2; H3; H4 | M3 insulated standoff | PCB | N/A NPTH | Quadcuber:MountingHole_3.2mm_M3 | 0
