gonewx/quadcuber/electronics/simulation/webench-handoff/components.csv

rail | ref | value | manufacturer | MPN | DNP | pin_networks | notes
A | U2 | TPS54302DDCR | Texas Instruments | TPS54302DDCR | false | 1=GND; 2=B1_SW; 3=VM; 4=B1_FB; 5=B1_EN; 6=B1_BOOT
A | C20 | 10u/25V | Murata | GRM32DR71E106KA12L | false | 1=VM; 2=GND
A | C21 | 100n | Murata | GRM21BR71H104KA01L | false | 1=VM; 2=GND
A | R20 | 49.9 | Yageo | RC0603FR-0749R9L | false | 1=B1_BOOT; 2=B1_BOOT_CAP
A | C22 | 100n | Murata | GRM21BR71H104KA01L | false | 1=B1_BOOT_CAP; 2=B1_SW
A | L1 | 10uH 9A Isat16A | Bourns | SRP1245A-100M | false | 1=B1_SW; 2=5V_A
A | C23 | 22u/25V | Murata | GRM32ER71E226KE15L | false | 1=5V_A; 2=GND
A | C24 | 22u/25V | Murata | GRM32ER71E226KE15L | false | 1=5V_A; 2=GND
A | R21 | 100k | Yageo | RC0603FR-07100KL | false | 1=5V_A; 2=B1_FB
A | R22 | 13.3k | Yageo | RC0603FR-0713K3L | false | 1=B1_FB; 2=GND
A | C25 | 75p | KEMET | C0603C750J5GACTU | false | 1=5V_A; 2=B1_FB
A | R23 | 511k | Yageo | RC0603FR-07511KL | false | 1=VM; 2=B1_EN
A | R24 | 105k | Yageo | RC0603FR-07105KL | false | 1=B1_EN; 2=GND
A | C26 | 470u/10V | Panasonic | EEU-FR1A471 | true | 1=5V_A; 2=GND | DNP by default. Populate only after loop/step-response verification with added 470uF.
B | U3 | TPS54302DDCR | Texas Instruments | TPS54302DDCR | false | 1=GND; 2=B2_SW; 3=VM; 4=B2_FB; 5=B2_EN; 6=B2_BOOT
B | C30 | 10u/25V | Murata | GRM32DR71E106KA12L | false | 1=VM; 2=GND
B | C31 | 100n | Murata | GRM21BR71H104KA01L | false | 1=VM; 2=GND
B | R30 | 49.9 | Yageo | RC0603FR-0749R9L | false | 1=B2_BOOT; 2=B2_BOOT_CAP
B | C32 | 100n | Murata | GRM21BR71H104KA01L | false | 1=B2_BOOT_CAP; 2=B2_SW
B | L2 | 10uH 9A Isat16A | Bourns | SRP1245A-100M | false | 1=B2_SW; 2=5V_B
B | C33 | 22u/25V | Murata | GRM32ER71E226KE15L | false | 1=5V_B; 2=GND
B | C34 | 22u/25V | Murata | GRM32ER71E226KE15L | false | 1=5V_B; 2=GND
B | R31 | 100k | Yageo | RC0603FR-07100KL | false | 1=5V_B; 2=B2_FB
B | R32 | 13.3k | Yageo | RC0603FR-0713K3L | false | 1=B2_FB; 2=GND
B | C35 | 75p | KEMET | C0603C750J5GACTU | false | 1=5V_B; 2=B2_FB
B | R33 | 511k | Yageo | RC0603FR-07511KL | false | 1=VM; 2=B2_EN
B | R34 | 105k | Yageo | RC0603FR-07105KL | false | 1=B2_EN; 2=GND
B | C36 | 470u/10V | Panasonic | EEU-FR1A471 | true | 1=5V_B; 2=GND | DNP by default. Populate only after loop/step-response verification with added 470uF.
