gonewx/quadcuber/generated/electronics/engineering-first-board/assembly/hand-solder-purchase.csv

Reference | Value | Manufacturer | MPN | Footprint | Quantity | Notes | Process | Procurement_status
C102 | 470u/25V | Panasonic | EEU-FR1E471 | Quadcuber:CP_Radial_D10.0mm_P5.00mm | 1 | Polarity: pad 1 = + (VM), pad 2 = - (GND); match the can stripe to pad 2. | USER_THT | Exact MPN required; quantity per board; stock unverified
C122 | 470u/25V | Panasonic | EEU-FR1E471 | Quadcuber:CP_Radial_D10.0mm_P5.00mm | 1 | Polarity: pad 1 = + (VM), pad 2 = - (GND); match the can stripe to pad 2. | USER_THT | Exact MPN required; quantity per board; stock unverified
C142 | 470u/25V | Panasonic | EEU-FR1E471 | Quadcuber:CP_Radial_D10.0mm_P5.00mm | 1 | Polarity: pad 1 = + (VM), pad 2 = - (GND); match the can stripe to pad 2. | USER_THT | Exact MPN required; quantity per board; stock unverified
C162 | 470u/25V | Panasonic | EEU-FR1E471 | Quadcuber:CP_Radial_D10.0mm_P5.00mm | 1 | Polarity: pad 1 = + (VM), pad 2 = - (GND); match the can stripe to pad 2. | USER_THT | Exact MPN required; quantity per board; stock unverified
C2 | 470u/25V | Panasonic | EEU-FR1E471 | Quadcuber:CP_Radial_D10.0mm_P5.00mm | 1 | Polarity: pad 1 = + (VM), pad 2 = - (GND); match the can stripe to pad 2. | USER_THT | Exact MPN required; quantity per board; stock unverified
C3 | 470u/25V | Panasonic | EEU-FR1E471 | Quadcuber:CP_Radial_D10.0mm_P5.00mm | 1 | Polarity: pad 1 = + (VM), pad 2 = - (GND); match the can stripe to pad 2. | USER_THT | Exact MPN required; quantity per board; stock unverified
J1 | 9V DC center-positive | Switchcraft | RASPC722X | Quadcuber:Jack_DC_Switchcraft_RASPC722X | 1 | Mating plug 5.5/2.1 mm center-positive (Switchcraft 762/762Z, 9.5 mm barrel). Pin 1 = center +9V, pin 2 = sleeve GND, pin 3 = sleeve shunt not connected. Regulated 9V only, <=5A continuous budget. | USER_THT | Exact MPN required; quantity per board; stock unverified
J10 | EV3 socket R | User-supplied | NO_MPN_SAME_BATCH_AS_USER_DRAWING | Quadcuber:EV3_UserDrawing_PINMAP_HOLD | 1 | EV3 6-pin socket from the same batch as the user drawing; no procurement MPN; do not use a generic RJ12. Pins 1=M1 2=M2 3=GND 4=5V_ENC 5=TACHO A 6=TACHO B. Unpowered six-way continuity and fit check before connecting a motor. | USER_THT | User sample; continuity and fit before motor use
J11 | EV3 socket L | User-supplied | NO_MPN_SAME_BATCH_AS_USER_DRAWING | Quadcuber:EV3_UserDrawing_PINMAP_HOLD | 1 | EV3 6-pin socket from the same batch as the user drawing; no procurement MPN; do not use a generic RJ12. Pins 1=M1 2=M2 3=GND 4=5V_ENC 5=TACHO A 6=TACHO B. Unpowered six-way continuity and fit check before connecting a motor. | USER_THT | User sample; continuity and fit before motor use
J12 | EV3 socket F | User-supplied | NO_MPN_SAME_BATCH_AS_USER_DRAWING | Quadcuber:EV3_UserDrawing_PINMAP_HOLD | 1 | EV3 6-pin socket from the same batch as the user drawing; no procurement MPN; do not use a generic RJ12. Pins 1=M1 2=M2 3=GND 4=5V_ENC 5=TACHO A 6=TACHO B. Unpowered six-way continuity and fit check before connecting a motor. | USER_THT | User sample; continuity and fit before motor use
J13 | EV3 socket B | User-supplied | NO_MPN_SAME_BATCH_AS_USER_DRAWING | Quadcuber:EV3_UserDrawing_PINMAP_HOLD | 1 | EV3 6-pin socket from the same batch as the user drawing; no procurement MPN; do not use a generic RJ12. Pins 1=M1 2=M2 3=GND 4=5V_ENC 5=TACHO A 6=TACHO B. Unpowered six-way continuity and fit check before connecting a motor. | USER_THT | User sample; continuity and fit before motor use
J2 | UART GND TX RX | Wurth Elektronik | 61300311121 | Quadcuber:PinHeader_1x03_P2.54mm_Vertical | 1 |  | USER_THT | Exact MPN required; quantity per board; stock unverified
J20 | R SERVO G + S | Wurth Elektronik | 61300311121 | Quadcuber:PinHeader_1x03_P2.54mm_Vertical | 1 |  | USER_THT | Exact MPN required; quantity per board; stock unverified
J21 | L SERVO G + S | Wurth Elektronik | 61300311121 | Quadcuber:PinHeader_1x03_P2.54mm_Vertical | 1 |  | USER_THT | Exact MPN required; quantity per board; stock unverified
J22 | F SERVO G + S | Wurth Elektronik | 61300311121 | Quadcuber:PinHeader_1x03_P2.54mm_Vertical | 1 |  | USER_THT | Exact MPN required; quantity per board; stock unverified
J23 | B SERVO G + S | Wurth Elektronik | 61300311121 | Quadcuber:PinHeader_1x03_P2.54mm_Vertical | 1 |  | USER_THT | Exact MPN required; quantity per board; stock unverified
J3 | RESET | Wurth Elektronik | 61300211121 | Quadcuber:PinHeader_1x02_P2.54mm_Vertical | 1 |  | USER_THT | Exact MPN required; quantity per board; stock unverified
J4 | SWD VREF D G C | Wurth Elektronik | 61300411121 | Quadcuber:PinHeader_1x04_P2.54mm_Vertical | 1 |  | USER_THT | Exact MPN required; quantity per board; stock unverified
