gonewx/quadcuber/docs/lego/inventory.md

# 用户确认的乐高库存约束

## 薄梁孔型

用户明确确认：“我们所有的薄梁都是十字孔的，没有这种全圆孔的。”

- 现有薄梁使用带十字端孔的款式；这不表示其中间孔也都是十字孔。
- 没有32017五孔全圆孔薄梁。不得将其计作现有库存。
- 当前说明书第19步的输入杆、第20步的导向摆杆使用了32017，需更换；旧版清单不能作为用户已经持有这些零件的依据。
- 尚未确认各长度薄梁的可用数量，不自动假定有七孔或其他长度的薄梁。

## 2026-10-01 整体重设计约束

- 用户明确要求：**禁止使用任何长度的全圆孔薄梁**。这是设计禁用条件，不能以补购解决；不只针对32017。
- 优先使用常见 Technic 零件，允许少量补购。带十字端孔的薄梁仍须逐关节核对转动自由度。
- 不再限定必须使用3×5 L梁。夹头骨架、导向机构和推杆长度可重新设计，现有马达与底座接口作为优先保留的基准。
- 用户强调承重是重点：必须检查夹持下沉、不同回转方向的侧向变形、连接间隙、机械头自重及夹紧载荷；几何不相交不能替代承重验收。

## 改型要求

替换时检查两端的相对转动，不能把同长的十字端孔薄梁直接套到共同十字轴上而锁住机构。与库存约束相关的模型、BOM和装配图应同时更新。

## 2026-10-05 确认

- 39793（3x3 连接块，正面 5 孔、侧面两条贯穿孔，STEAM 套件）：用户确认数量够 v4 整机使用（需 4 个，每臂 1 个，作推杆导向）。
