gonewx/quadcuber/generated/mechanical/integrated-BOM.csv

part | quantity | baseline_quantity | delta
11478.dat | 4 | 2 | 2
14720.dat | 1 | 1 | 0
15100.dat | 6 | 6 | 0
18654.dat | 6 | 8 | -2
18938.dat | 4 | 4 | 0
18939.dat | 4 | 4 | 0
23948.dat | 1 | 0 | 1
2780.dat | 276 | 268 | 8
32002.dat | 0 | 2 | -2
32013.dat | 4 | 4 | 0
32054.dat | 8 | 10 | -2
32056.dat | 0 | 32 | -32
32062.dat | 12 | 12 | 0
32073.dat | 5 | 5 | 0
32123a.dat | 90 | 100 | -10
32140.dat | 7 | 7 | 0
32278.dat | 19 | 14 | 5
32316.dat | 33 | 33 | 0
32449.dat | 16 | 16 | 0
32523.dat | 24 | 24 | 0
32524.dat | 35 | 37 | -2
32525.dat | 8 | 8 | 0
32526.dat | 21 | 20 | 1
3648b.dat | 4 | 4 | 0
3673.dat | 8 | 8 | 0
3705.dat | 5 | 4 | 1
3706.dat | 1 | 1 | 0
3707.dat | 8 | 16 | -8
3708.dat | 5 | 4 | 1
3713.dat | 22 | 20 | 2
39790.dat | 4 | 4 | 0
39793.dat | 4 | 4 | 0
40490.dat | 20 | 20 | 0
41677.dat | 4 | 4 | 0
42610.dat | 8 | 8 | 0
43857.dat | 5 | 3 | 2
44294.dat | 4 | 4 | 0
4519.dat | 12 | 12 | 0
50945_nominal.dat | 8 | 8 | 0
55615.dat | 16 | 16 | 0
60483.dat | 16 | 0 | 16
62462.dat | 3 | 1 | 2
64179.dat | 20 | 20 | 0
6536.dat | 4 | 4 | 0
6558.dat | 109 | 109 | 0
95658.dat | 4 | 4 | 0
geekservo.dat | 4 | 4 | 0
