gonewx/quadcuber/generated/electronics/simulation/linux-reference/reference-recovery/pin-connectivity.csv

view | reference | value | placed_pin_index | symbol_pin_name | package_pin_number | x_dbu | y_dbu | net_database_id | net_name | touching_wire_record_indices
Startup | R2 | 100k | 1 | 2 | 2 | 980 | 320 | 16776600 | N16776600 | 47
Startup | R2 | 100k | 2 | 1 | 1 | 980 | 360 | 16776592 | VFB | 33
Startup | L1 | LDCR | 1 | 1 |  | 640 | 250 | 16776606 | SW | 6
Startup | L1 | LDCR | 2 | 2 |  | 720 | 250 | 16776637 | VOUT | 10
Startup | C4 | 0.1u | 1 | 1 | 1 | 580 | 220 | 16776633 | BOOT | 9
Startup | C4 | 0.1u | 2 | 2 | 2 | 610 | 220 | 16776606 | SW | 7
Startup | R1 | 49.9 | 1 | 2 | 2 | 980 | 260 | 16776637 | VOUT | 38
Startup | R1 | 49.9 | 2 | 1 | 1 | 980 | 300 | 16776600 | N16776600 | 50
Startup | C2 | 10u | 1 | 1 | 1 | 240 | 240 | 16776619 | VIN | 21
Startup | C2 | 10u | 2 | 2 | 2 | 240 | 270 | 16776627 | 0 | 25
Startup | C1 | 0.1u | 1 | 1 | 1 | 180 | 240 | 16776619 | VIN | 19
Startup | C1 | 0.1u | 2 | 2 | 2 | 180 | 270 | 16776627 | 0 | 23
Startup | U1 | TPS54302DDC_TRANS | 1 | GND | 1 | 540 | 310 | 16776627 | 0 | 37
Startup | U1 | TPS54302DDC_TRANS | 2 | SW | 2 | 540 | 250 | 16776606 | SW | 46
Startup | U1 | TPS54302DDC_TRANS | 3 | VIN | 3 | 400 | 220 | 16776619 | VIN | 18
Startup | U1 | TPS54302DDC_TRANS | 4 | FB | 4 | 540 | 290 | 16776592 | VFB | 35
Startup | U1 | TPS54302DDC_TRANS | 5 | EN | 5 | 400 | 250 | 16776604 | EN | 28
Startup | U1 | TPS54302DDC_TRANS | 6 | BOOT | 6 | 540 | 220 | 16776633 | BOOT | 9
Startup | RLoad | {5/3} | 1 | 2 | 2 | 1070 | 350 | 16776627 | 0 | 40
Startup | RLoad | {5/3} | 2 | 1 | 1 | 1070 | 310 | 16776637 | VOUT | 39
Startup | R3 | 13.3k | 1 | 2 | 2 | 980 | 380 | 16776592 | VFB | 1
Startup | R3 | 13.3k | 2 | 1 | 1 | 980 | 420 | 16776627 | 0 | 0
Startup | R4 | 510k | 1 | 2 | 2 | 310 | 240 | 16776619 | VIN | 26
Startup | R4 | 510k | 2 | 1 | 1 | 310 | 280 | 16776604 | EN | 4
Startup | Vin | VPULSE | 1 | + | 1 | 120 | 250 | 16776619 | VIN | 42
Startup | Vin | VPULSE | 2 | - | 2 | 120 | 290 | 16776627 | 0 | 41
Startup | C8 | 75p | 1 | 1 | 1 | 930 | 330 | 16776600 | N16776600 | 48
Startup | C8 | 75p | 2 | 2 | 2 | 930 | 360 | 16776592 | VFB | 51
Startup | C6 | CESR | 1 | 1 |  | 820 | 270 | 16776637 | VOUT | 13
Startup | C6 | CESR | 2 | 2 |  | 820 | 300 | 16776627 | 0 | 44
Startup | R5 | 105k | 1 | 2 | 2 | 310 | 310 | 16776604 | EN | 2
Startup | R5 | 105k | 2 | 1 | 1 | 310 | 350 | 16776627 | 0 | 3
Startup | C5 | CESR | 1 | 1 |  | 760 | 270 | 16776637 | VOUT | 11
Startup | C5 | CESR | 2 | 2 |  | 760 | 300 | 16776627 | 0 | 16
Steady_State | C2 | 10u | 1 | 1 | 1 | 250 | 240 | 16785519 | VIN | 21
Steady_State | C2 | 10u | 2 | 2 | 2 | 250 | 270 | 16785491 | 0 | 24
Steady_State | C4 | 0.1u | 1 | 1 | 1 | 590 | 220 | 16785509 | BOOT | 51
Steady_State | C4 | 0.1u | 2 | 2 | 2 | 620 | 220 | 16785538 | SW | 46
Steady_State | R5 | 105k | 1 | 2 | 2 | 320 | 310 | 16785498 | EN | 44
Steady_State | R5 | 105k | 2 | 1 | 1 | 320 | 350 | 16785491 | 0 | 43
Steady_State | U1 | TPS54302DDC_TRANS | 1 | GND | 1 | 550 | 310 | 16785491 | 0 | 41
Steady_State | U1 | TPS54302DDC_TRANS | 2 | SW | 2 | 550 | 250 | 16785538 | SW | 38
Steady_State | U1 | TPS54302DDC_TRANS | 3 | VIN | 3 | 410 | 220 | 16785519 | VIN | 18
Steady_State | U1 | TPS54302DDC_TRANS | 4 | FB | 4 | 550 | 290 | 16785513 | VFB | 35
Steady_State | U1 | TPS54302DDC_TRANS | 5 | EN | 5 | 410 | 250 | 16785498 | EN | 29
Steady_State | U1 | TPS54302DDC_TRANS | 6 | BOOT | 6 | 550 | 220 | 16785509 | BOOT | 51
Steady_State | C8 | 75p | 1 | 1 | 1 | 940 | 330 | 16785508 | N16785508 | 7
Steady_State | C8 | 75p | 2 | 2 | 2 | 940 | 360 | 16785513 | VFB | 5
Steady_State | L1 | LDCR | 1 | 1 |  | 650 | 250 | 16785538 | SW | 47
Steady_State | L1 | LDCR | 2 | 2 |  | 730 | 250 | 16785512 | VOUT | 12
Steady_State | C1 | 0.1u | 1 | 1 | 1 | 190 | 240 | 16785519 | VIN | 23
Steady_State | C1 | 0.1u | 2 | 2 | 2 | 190 | 270 | 16785491 | 0 | 26
Steady_State | C5 | CESR | 1 | 1 |  | 770 | 270 | 16785512 | VOUT | 11
Steady_State | C5 | CESR | 2 | 2 |  | 770 | 300 | 16785491 | 0 | 20
Steady_State | Iload | IDC | 1 | + | 1 | 1080 | 310 | 16785512 | VOUT | 14
Steady_State | Iload | IDC | 2 | - | 2 | 1080 | 350 | 16785491 | 0 | 13
Steady_State | Vin | VDC | 1 | + | 0 | 130 | 250 | 16785519 | VIN | 49
Steady_State | Vin | VDC | 2 | - | 1 | 130 | 290 | 16785491 | 0 | 50
Steady_State | R1 | 49.9 | 1 | 2 | 2 | 990 | 260 | 16785512 | VOUT | 10
Steady_State | R1 | 49.9 | 2 | 1 | 1 | 990 | 300 | 16785508 | N16785508 | 52
Steady_State | R3 | 13.3k | 1 | 2 | 2 | 990 | 380 | 16785513 | VFB | 8
Steady_State | R3 | 13.3k | 2 | 1 | 1 | 990 | 420 | 16785491 | 0 | 9
Steady_State | IC1 | 5 | 1 | + | 0 | 800 | 250 | 16785512 | VOUT | 40,53
Steady_State | R4 | 510k | 1 | 2 | 2 | 320 | 240 | 16785519 | VIN | 31
Steady_State | R4 | 510k | 2 | 1 | 1 | 320 | 280 | 16785498 | EN | 42
Steady_State | C6 | CESR | 1 | 1 |  | 830 | 270 | 16785512 | VOUT | 17
Steady_State | C6 | CESR | 2 | 2 |  | 830 | 300 | 16785491 | 0 | 3
Steady_State | R2 | 100k | 1 | 2 | 2 | 990 | 320 | 16785508 | N16785508 | 2
Steady_State | R2 | 100k | 2 | 1 | 1 | 990 | 360 | 16785513 | VFB | 0
