gonewx/quadcuber/mechanical/final/site-source/dist/compact60483/diagrams/inventory.png

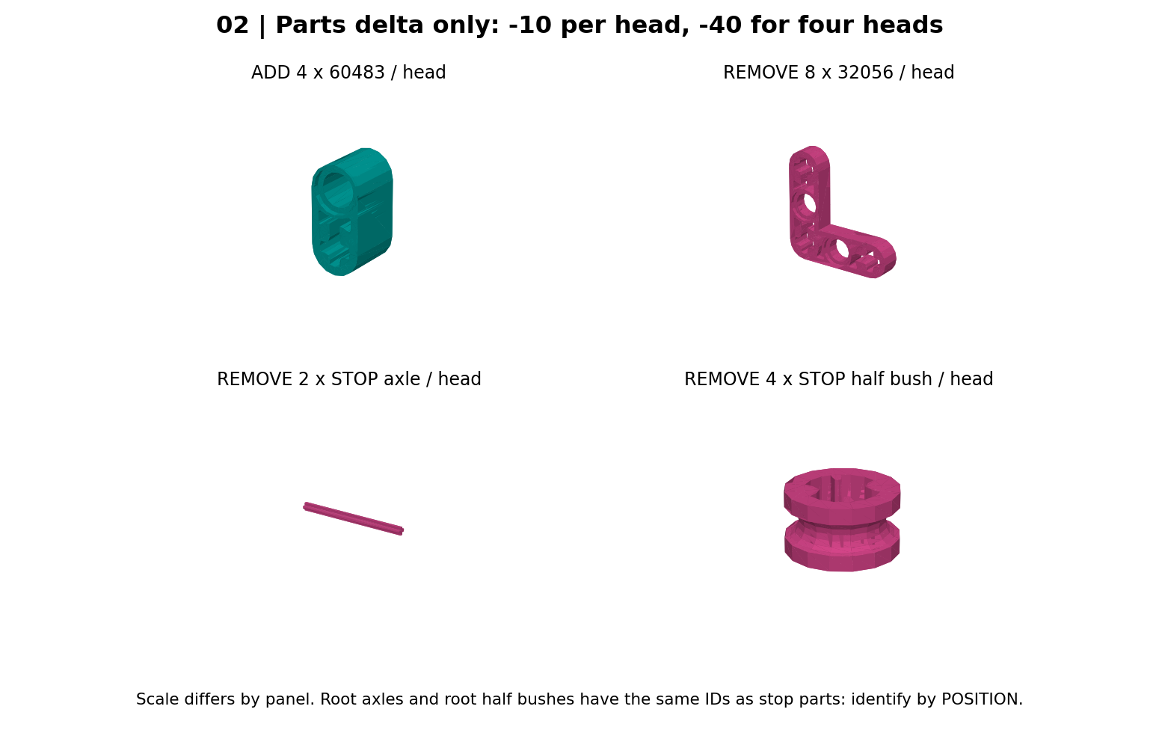
mechanical/final/site-source/dist/compact60483/diagrams/inventory.png
