gonewx/quadcuber/generated/electronics/release-preflight/fabrication-preflight.md

# A1 制造预检（候选资料，不构成投板/装配放行）

原板 SHA-256：`11b8502157f6d15a8be044557d35306fc5444240d9bb40ef5166bf3fedb1bb9e`。KiCad 10.0.7；脚本 `electronics/verify_fabrication_preflight.py` 实际读取原板、BOM、CPL、Gerber job、Excellon；另在临时目录独立导出，再比较图像内容。30 项自动一致性检查全部通过。审计脚本未保存原板；本次已对修正后的最终板重新导出并核验，未放行标志保留。

## 已消除的资料风险

原 `positions.csv` 有 173 行；C26、C36 在原板是 DNP，BOM 数量为 0，但仍有坐标行。没有明确 DNP 过滤的装配导入可能误装这两个 470 µF 电容，改变降压环路条件。

已生成 `fabrication-populated-bom.csv` 与 `fabrication-populated-positions.csv`，均为 171 个实装位号；默认 CPL 已通过 --exclude-dnp 永久修正。候选 CPL 保留已验证的 KiCad 坐标/角度/面别，未擅自转换为任何厂商机器角度，也未把含通孔器件的完整装配表冒充纯 SMT 贴片任务。TP/H 等 PCB 自带项目不采购；C26/C36 不装。本次 build 已排除 DNP，并以回归测试锁定 BOM/CPL 实装位号一致；每次改板仍须重新预检。

## 实测与一致性

| 项目 | 结果 |
|---|---|
| 板框中心线 | X 50–194 mm，Y 50–162 mm；**144 × 112 mm** |
| Gerber job Size | 144.05 × 112.05 mm，是 0.05 mm 轮廓线笔画包围尺寸，不是另一个板尺寸 |
| 铜层 | F.Cu / In1.Cu / In2.Cu / B.Cu，共四层；11 个 Gerber 与独立导出一致（仅忽略创建时间） |
| 钻孔 | PTH 394：299 个独立过孔 +95 个元件孔/槽；NPTH 14；逐孔位置、直径、槽长、镀/非镀类别均一致 |
| PTH 直径数量 | 0.30×134；0.33×24；0.35×42；0.40×127；0.60×4（镀槽）；0.79×24；0.80×4；1.00×33；1.30×2，单位 mm |
| NPTH 直径数量 | 0.65×2、2.30×8、3.20×4，单位 mm |
| 镀槽 | J5：宽 0.60 mm；两槽总长 1.40 mm、两槽总长 1.70 mm |
| Excellon 坐标 | 原板与导出最大误差 0.0005 mm，符合三位小数 mm 的量化；两个钻孔文件与独立导出内容一致 |
| 走线 | 2283 段；实测最窄 0.15 mm |
| 独立过孔环宽 | 四铜层直径最小值计算，最小 0.15 mm（直径 0.60 /钻径 0.30 mm） |
| 元件镀孔环宽 | 最小 0.15 mm，例如 U13.9 热孔（焊盘 0.63 /钻孔 0.33 mm）；所有镀孔焊盘孔偏移为零 |
| BOM/CPL | 原板及逐项 BOM 各 200 项，分组 BOM 展开与逐项 BOM 一致；默认 CPL 171 项；实装 171 项；每个坐标、角度、面别、封装均对应原板 |

环宽为设计几何值，未扣除钻偏、蚀刻、公差；本脚本没有另行测量全铜对象的最小间距或最小实际阻焊桥。原 DRC 的零错误仍以其已配置规则为边界，不能视为任意工厂能力保证。

## 供板厂确认的具体制造条件

- 原板/新导出 job 的 stackup、规则及文件层属性一致。外铜 0.070 mm（约 2 oz），内铜 0.035 mm（约 1 oz）；介质 0.180 /1.010 /0.180 mm，FR4；上下阻焊各 0.010 mm；ENIG。所有厚度合计 1.600 mm，扣除阻焊为 1.580 mm。确认板厂厚度定义、公差、最终成品外铜厚度及可用压合结构；此处只转录设计意图，未选择板厂实际压合料号或保证介电参数。
- 最窄线 0.15 mm，与 70 µm 外层铜同时存在；需按厂商厚铜能力确认。项目最小铜间距 0.15 mm，铜到板边 0.30 mm，铜到孔 0.25 mm，孔到孔 0.25 mm；这些是**配置规则值**，不是本脚本独立实测间距值。项目最低过孔环宽规则 0.10 mm，实际几何最小 0.15 mm。
- 阻焊扩展 0，最小阻焊桥规则 0，禁止 footprint 内自动桥接。0 mm 规则意味着此 DRC 不保证工厂需要的有限桥宽。厂商须核对细间距 QFN、热焊盘开窗及底层焊盘；不得据此声称阻焊工艺已通过。
- 当前过孔上下 tenting=yes，plugging/filling/capping=no。暴露焊盘内的热孔、模板开口和焊锡流失/空洞风险须由装配工艺确认；未自动要求或添加填孔盖帽工艺。
- 接受最小成品孔 0.30 mm、0.60 mm 镀槽、NPTH 与 PTH 分文件；确认槽加工/孔径公差、板边公差、表面处理、阻焊和模板工艺。Gerber project revision 为 `rev?`；应以本报告精确源哈希和包清单绑定版本，实际下单前再填写已批准的 A1/订单版本标识。

## 装配极性与剩余边界

`fabrication-polarity-padmap.csv` 导出二极管、IC、MOSFET、连接器及电解电容每个原板焊盘的编号、网络、绝对坐标、面别和封装角度。C26/C36 的 1 脚分别接 5V_A/5V_B，2 脚接 GND，但默认不装。此表是供装配核对的静态证据；PCB 与 CPL 角度一致不能独立证明厂家送料方向、每个 MPN 的 pin-1 标志或实物朝向正确。

J10 等 EV3 自定义连接器仍使用未确认 MPN/引脚观察方向；需实物/可靠原厂图确认 pin-1、编号方向与机械包络，不能由坐标表闭合。其余有极性器件应以精确 MPN 数据表、封装丝印/装配图和装配厂预览逐项签核。首板上电、热/负载/回生/环路与实际机构验证属于硬件验证，不属于本次制造文件一致性检查。

## 复现

```sh
XDG_CONFIG_HOME=/tmp/quadcuber-fabrication-config XDG_DATA_HOME=/tmp/quadcuber-fabrication-data XDG_CACHE_HOME=/tmp/quadcuber-fabrication-cache /workspace/tools/kicad-10.0.7/squashfs-root/AppRun python3.11 electronics/verify_fabrication_preflight.py
```

完整逐项结果与输入文件哈希：`fabrication-preflight.json`。候选过滤文件与本报告留在 `generated/electronics/release-preflight/`；未上传厂商、未下单、未变更制造放行状态。

## 双面装配与 EV3 分阶段试验的限制

候选实装 CPL 为顶面 156 项、底面 15 项；底面为 C20、C30、C410–C419、C420、C421、D5。顶面包含通孔件，156 项不等于 156 个顶面 SMT 元件。厂商需决定双面回流顺序、底面较大 C20/C30 的保持工艺、模板厚度/缩减及通孔后焊流程；当前 F/B Paste 导出内容已与原板匹配，但没有做锡膏转移率、焊膏覆盖率、桥接/空洞或双面工艺试验。热孔为设计真实开孔，文件正确不等于焊锡流失和空洞达标。

- **DNP 资料闭环已完成**：171 项候选文件明确排除 C26/C36，其他既定实装项未变。闭环仅限此源哈希的制造元数据，完整 build 输出策略未改。
- **全功能整板试产**：J10/J11/J12/J13 均为 `EV3_UserDrawing_PINMAP_HOLD`；未知的实物编号、观察方向、接触额定值和耳部机械包络阻止声称 EV3 接口/整板完整装配已验证。这也不能通过板厂裸板 DFM 自动解决。
- **不装 EV3 的电源/控制器试验用途**：四个 EV3 连接器的未知本身不妨碍利用已知测试点和控制接口定义一个受限电源/控制器验证实验。但这需要先明确试验装配变体（额外不装 J10–J13）、禁止接 EV3 负载的连接/固件条件、供电限流及量测计划，并先通过上述板厂/装配工艺条件与其余硬件启动风险评估。它不能证明 EV3 的机械/极性/驱动功能，也不是自动放行当前完整装配表。本次未擅自生成或批准此变体、未把 DNP 表里的四个连接器移除。
