gonewx/quadcuber/generated/wiring/index.html

quadcuber · 历史单臂总览 · 可选装配参考

# 历史单臂电路与可选洞洞板

本页保留原 R 单臂电路参考及可选洞洞板孔位，不是 R+L 接线图。当前接线请使用下方同一页面的原 R／新 R+L 切换，勿混用两种装配方案的线号与孔位。

一个 EV3 马达 (大马达或中马达接法相同)、一个灰色 Geekservo、一块 DRV8833、4 个电阻 (10kΩ ×2、20kΩ ×2)。引脚按 firmware/pico/config.py 的 R 臂分配, 接完按 docs/single_arm.md 第 4、5 节刷程序和测试。

当前接线：原 R／新 R+L（条件式） · 电路总览与验证状态 · 可选洞洞板 · 洞洞板配套面包板

2026-09-27 更新：编码器改用电阻分压, 不再用电平转换模块。BSS138 模块与 EV3 马达内部的串联电阻不匹配, 低电平降不下来。原因和测量依据见 接口复核报告。

## 三条不能违反的规则

马达电压不超过 10.8VDRV8833 的上限。9V 可以, 12V 会烧。

编码器信号必须经过分压Pico 的引脚不耐 5V, EV3 编码器输出 5V 信号; 每路 10kΩ 串联 + 20kΩ 接地, 降到约 3V。

舵机不从 Pico 取电舵机用 5V 降压模块供电, 启动电流会让 Pico 复位。

## 总览

9V 只给马达驱动和 5V 降压模块; 5V 给舵机和编码器; Pico 由电脑 USB 供电, 编码器的 5V 信号经电阻分压成约 3V 再进 Pico。所有模块的地 (GND) 连在一起, 图中没画出。

## 完整接线图

全部9V5V3.3V地线马达控制编码器舵机

点上面的按钮只看某一类线。线的颜色表示用途, 不是实际导线的颜色。所有接地符号表示连到同一个公共地。模块的排针顺序各家不同, 以板上的丝印为准。A 相下拉电阻那条竖线上的小半圆表示跨过 B 相线, 两线不相连。

## 分步接线

### 1. 先接所有地线

断电状态下, 把 9V 电源负极、5V 降压模块 GND、DRV8833 GND、舵机地线、EV3 线 3 号脚 (红色) 和 Pico 的 38 号脚连在一起。先接地, 后面任何一步接错都更不容易损坏器件。

在图上看

### 2. 接 9V

先用万用表确认电源电压在 8.5~9.5V (绝不能超过 10.8V)。9V 正极接 DRV8833 的 VM 和 5V 降压模块的输入; 本版不另装电容, 保留模块自带的电容。洞洞板按用户确认的 DRV8833 脚序使用 VM 输入。

在图上看

### 3. 接 5V

单独给 5V 降压模块通电, 先把输出调到 5.0V, 断电后再接: EV3 线 4 号脚 (绿色)、舵机正极。

在图上看

### 4. 接 3.3V

Pico 的 36 号脚 (3V3 OUT) 接 DRV8833 的 STBY (有的标 nSLEEP/EEP), 让驱动处于工作状态。不要接任何 5V 的东西。

在图上看

### 5. 接马达控制线

Pico 的 GP2 (4 号脚) 接 DRV8833 AIN1, GP3 (5 号脚) 接 AIN2。

在图上看

### 6. 接马达电源线

DRV8833 的 AOUT1 接 EV3 线 1 号脚 (白), AOUT2 接 2 号脚 (黑)。两根线接反也不会坏, 只是方向相反, 用 check 命令能发现。

在图上看

### 7. 接编码器分压

每路两个电阻: EV3 线 5 号脚 (黄, A 相) → 10kΩ → 分压点 → GP4, 分压点再经 20kΩ 接地; 6 号脚 (蓝, B 相) 同样接到 GP5。先不接 GP4/GP5 的跳线, 通电后手转马达量分压点: 应在约 0V 和 3V 之间变化, 不能超过 3.3V, 正常再接跳线。5V 信号绝不能直接接 Pico。

在图上看

### 8. 接舵机信号

Pico 的 GP8 (11 号脚) 接舵机信号线。舵机的电源和地已在第 1、3 步接好。

在图上看

勾选状态只保存在这台设备的浏览器里。

## 可选单臂洞洞板实物装配与焊接图

本方案仅供原 R 单臂可选装配，不是 R+L 接线方案；当前接线见 当前接线：原 R／新 R+L（条件式）。

2026-09-27 更新：编码器改用电阻分压。④⑤ 中编码器按最终方案画：每路 10kΩ 串联 + 20kΩ 接地，分压点在面包板第 26、28 列，不用电平转换模块。原因见接口复核报告。

按这版孔位插元件，再左右翻板照背面焊 14 根线。列 1～32、行 A～X，孔距 2.54mm；选至少有这块完整孔阵的独立焊盘洞洞板，约 90 × 70mm。先给 A1 旁边做红色标记。

全部可拆换：洞洞板只焊底座和配线，模块均可拔。选用5.08mm 插拔式端子（配套直针底座＋可拔螺钉插头）、2.54mm 排针、DRV8833 按你提供的实物丝印（左上 VM、右上 NC）安装，两排 8 针，机械排距暂按 10.16mm。你的模块若外形或脚序不同，先指出差异再改图，不能把同名芯片的其他模块直接插进这些孔。U2 按 XL4005 四角电源孔 38.1 × 15.24mm 这一机械假设画；这不是所有 XL4005 的统一尺寸。两块模块均插排母，无螺钉或支柱；不另装电容。

① 元件面② 镜像焊接面③ 电源与拔插结构④ 面包板连接⑤ 舵机与马达放大 150%显示全部焊线

9V5VGND马达IN1IN2舵机 PWMSTBY / 3.3V

### 01 · 照孔位插元件

### 02 · 翻面逐根焊线

### 03 · 板外电源与模块拔插方式

### 04 · 面包板与洞洞板实际连线

### 05 · 舵机与马达完整连线

背面全部 14 根线；底座先焊好；导线只焊首尾，中途跨线不相连。

下载可放大的矢量图：元件面 SVG · 焊接面 SVG · 板外接线 SVG · 两板连接 SVG · 舵机与马达全图 SVG。图已放大供阅读，打印不能当 1:1 钻孔模板。

### 两板之间的 6 根公对公线

线号 | 洞洞板接口 / 孔位 | 面包板孔位 | 用途
B01 | J6.1 / V15 | 上排 + 第8孔 | 降压5V → 编码器电源
B02 | J6.2 / V16 | 上排 − 第9孔 | 公共地
B03 | J7.1 / V9 | j6 | Pico GP2 → AIN1
B04 | J7.2 / V10 | j7 | Pico GP3 → AIN2
B05 | J7.3 / V11 | j13 | Pico GP8 → 舵机信号
B06 | J7.4 / V12 | a7 | Pico 3V3 → STBY

3.3V 线使用 a7（a7、b7、c7 同组相通，c7 是 Pico 3V3）。电源轨按原指南检查中间断口并补跨线。

### 舵机与 EV3 马达的 9 根线

线号 | 设备线端 | 常见颜色 / 功能 | 接入点 / 孔位 | 去向
E1 | EV3 1脚 | 白 / M1 | J4.1 / V3 | AO1 → 马达端1
E2 | EV3 2脚 | 黑 / M2 | J4.2 / V5 | AO2 → 马达端2
E3 | EV3 3脚 | 红 / GND | T-37 | 面包板上排 − 第37孔
E4 | EV3 4脚 | 绿 / 5V | T+36 | 面包板上排 + 第36孔
E5 | EV3 5脚 | 黄 / A相 | h33 | 10kΩ → 分压点第26列 → GP4
E6 | EV3 6脚 | 蓝 / B相 | h31 | 10kΩ → 分压点第28列 → GP5
S1 | 舵机 GND | 棕 / GND | J5.1 / V23 | 地；洞洞板 V23
S2 | 舵机 V+ | 红 / 5V | J5.2 / V24 | 5V；洞洞板 V24
S3 | 舵机 SIG | 黄 / SIG | J5.3 / V25 | GP8 信号；洞洞板 V25

EV3 线 1/2 脚接 J4 可拔端子；3/4/5/6 脚用公头转接线插面包板。舵机自带三孔母头插 J5，按棕 GND / 红 5V / 黄 SIG 核对顺序。EV3 红线是地线，不能当成电源正极。

### 安装表：先焊连接器底座，再插入模块

编号 | 器件 | 插入孔位 | 朝向
J1 | 5.08mm 插拔端子，2 位（底座+插头） | 1=C3 (+9V)；2=C5 (GND) | 进线口朝上板边
J4 | 5.08mm 插拔端子，2 位（底座+插头） | 1=V3 (M1)；2=V5 (M2) | 进线口朝下板边
J2 / J3 | U2 四角电源排母（4 个分立 1 针座） | J2.1=I16 IN+；J2.2=O16 IN−；J3.1=I31 OUT+；J3.2=O31 OUT− | 横向 15 孔距，纵向 6 孔距；排母单触点额定电流需满足负载
U2 | DSN5000 / XL4005 模块 + 四根向下排针 | 四角插入 I16、O16、I31、O31 | 电感、电位器朝上；图中模块机械尺寸是明确假设
U1 | 用户 DRV8833 + 两排 1×8 排母 | 左 I9～P9；右 I13～P13 | 左上 VM、右上 NC；排距暂按10.16mm，单触点额定电流满足负载
J5 | 2.54mm 1×3 公排针 | 1=V23 GND；2=V24 +5V；3=V25 SIG | 配舵机三孔母头，先核对线序
J6 | 2.54mm 1×2 排母 | 1=V15 +5V；2=V16 GND | 配面包板公头引线，仅小电流支路
J7 | 2.54mm 1×4 排母 | 1=V9；2=V10；3=V11；4=V12 | 配Pico公头线，1/2/3/4接GP2/GP3/GP8/3V3

### 焊线表：点击线号，在背面图中单独看这一根

所有线都用绝缘导线，只剥首尾约 2～3mm 焊在指定孔。表中“途经”是走线转弯位置，不是焊点；交叉处保留绝缘，一根从另一根上方跨过。配电端子同一焊脚接两根线时先合并固定，不能只依赖薄焊盘受力。

线号 | 起点 / 孔位 | 终点 / 孔位 | 途经（不焊） | 用途
W01 | J1.1 C3 | U1.VM I9 | F3 → F7 → G7 → G9 | 9V → 驱动 VM
W02 | J1.1 C3 | J2.1 I16 | E3 → E16 | 9V → 降压输入
W03 | J1.2 C5 | U1.GND_9_16 P9 | D5 → D8 → P8 | 驱动地单独回电源入口
W04 | J1.2 C5 | J2.2 O16 | F5 → F18 → O18 | 电源地 → 降压 IN−
W05 | J3.1 I31 | J5.2 V24 | I32 → R32 → R24 | 5V → 舵机电源
W06 | J3.1 I31 | J6.1 V15 | H31 → H29 → T29 → T15 | 5V → 面包板小电流支路
W07 | J3.2 O31 | J5.1 V23 | O30 → U30 → U23 | 舵机地单独回降压 OUT−
W08 | J3.2 O31 | J6.2 V16 | P31 → P28 → S28 → S16 | 面包板公共地
W09 | U1.AO1 L9 | J4.1 V3 | L3 | 驱动 AOUT1 → 马达 M1
W10 | U1.AO2 M9 | J4.2 V5 | M5 | 驱动 AOUT2 → 马达 M2
W11 | J7.1 V9 | U1.AIN1 K13 | R9 → R14 → K14 | GP2 → AIN1
W12 | J7.2 V10 | U1.AIN2 J13 | Q10 → Q15 → J15 | GP3 → AIN2
W13 | J7.3 V11 | J5.3 V25 | W11 → W25 | GP8 → 舵机信号
W14 | J7.4 V12 | U1.STBY L13 | S12 → S11 → L11 | Pico 3V3 → STBY 使能

### DRV8833 方向核对：按你提供的左右脚序

行 | 左排（第 9 列） | 右排（第 13 列）
I | I9 = VM | I13 = NC
J | J9 = NC | J13 = AIN2
K | K9 = GND | K13 = AIN1
L | L9 = AO1 | L13 = STBY
M | M9 = AO2 | M13 = BIN1
N | N9 = BO2 | N13 = BIN2
O | O9 = BO1 | O13 = NC
P | P9 = GND | P13 = GND

脚序按你提供的实物丝印：VM 接 9V，AO1/AO2 接马达；AIN1/AIN2 接 GP2/GP3；STBY 经 J7.4 接 Pico 3V3。NC 留空，未用 B 路输出留空；不另装电容，模块自带电容保留。机械排距仍是绘图假设，焊排母前用实物对齐。

### 焊接顺序与检查

1. 先只焊 J1/J4 端子底座、J5 排针、J6/J7 排母、U1 两排排母和 U2 四角排母；DRV8833 先不插。核对 A1、各接口正负和两排间距。
2. 按 W01～W14 焊接绝缘导线。断电测各线首尾导通；DRV8833 和降压都拔下时，9V、5V、地和各信号网络之间不能短路。
3. 先只插 U2 降压模块，按“电源与拔插结构”接 9V，空载调到 5.0V。确认 J5.2、J6.1 对各自 GND 约 5V，再断电放电。
4. 插入 DRV8833，接 J6、J7 和编码器，Pico 仍用 USB。先按单臂步骤测马达，再断电接舵机测试。
5. 大电流导线和接点按实际启动电流选型；带载检查压降、温升与 VM 瞬态，DRV8833 工作电压不超过 10.8V。用绝缘底板保护焊接面，线束留松弛并固定，插拔时扶住底座。

接面包板：J6.1 → 上排 +，J6.2 → 上排 −；J7.1 → j6（GP2），J7.2 → j7（GP3），J7.3 → j13（GP8），J7.4 → a7（3V3）。编码器分压电阻和跳线见④。完整说明见洞洞板设计文档。

## 可选洞洞板配套：面包板怎么插

与洞洞板之间的 6 根线见 ④ 两板实际连接图。下图的板内跳线保留，板外接线经 J6/J7 插座。

信号线走面包板; 大电流的线 (9V、马达线、舵机电源) 不走面包板, 直接连。孔的坐标写法: 字母是行, 数字是列, 例如 a5 是 a 行第 5 列。

细线是插在面包板上的跳线, 粗线头是不走面包板、直接连到别处的线 (写了去向)。面包板每一列的 f~j 五个孔是连通的: 第 26 列 (A 相) 和第 28 列 (B 相) 就是分压点, 各插着 10kΩ 的一端、20kΩ 的一端和到 GP4/GP5 的跳线; 第 33、31 列插 10kΩ 的另一端和 EV3 的黄、蓝线。电阻没有正负, 两头可以对调。

类别 | 从 → 到 | 说明
插 Pico | c3~c22、h3~h22 | USB 朝左。1 号脚在 h3, 20 号脚在 h22; 40 号脚在 c3, 21 号脚在 c22
地 | a5 → 上排 − | Pico 38 号脚 GND
地 | j5 → 下排 − | Pico 3 号脚 GND
地 | 上排 − (第 40 列) → 下排 − | 把上下两条地线轨连起来
编码器 A | 10kΩ: f26 ↔ f33; 20kΩ: j26 ↔ 下排 − | 第 26 列是 A 相分压点
编码器 A | i8 → i26 | GP4 → A 相分压点
编码器 A | 黄线 → h33 | EV3 5 号脚 → 10kΩ 的另一端
编码器 B | 10kΩ: g28 ↔ g31; 20kΩ: j28 ↔ 下排 − | 第 28 列是 B 相分压点
编码器 B | i9 → i28 | GP5 → B 相分压点
编码器 B | 蓝线 → h31 | EV3 6 号脚 → 10kΩ 的另一端
编码器电源 | 绿线 → 上排 + (第 36 列), 红线 → 上排 − (第 37 列) | EV3 线的红色是地线
5V 电源 | J6.1 → 上排 + 第8孔, J6.2 → 上排 − 第9孔 | 从洞洞板排母引出两根公对公线
马达控制 | j6 → J7.1, j7 → J7.2 | 经洞洞板焊线接 DRV8833 AIN1 / AIN2
舵机信号 | j13 → J7.3 | 经洞洞板接舵机信号，电源不走面包板
驱动使能 | a7 → J7.4 | Pico 36 号脚 3V3 (c7) → STBY

先检查面包板的电源轨。 有些面包板的电源轨在中间 (第 30 列左右) 是断开的, 红蓝线在那里有个缺口。用万用表测一下上排 + 的第 5 列和第 40 列通不通, 不通就在断口处补一根跳线。另外, 5V 降压模块的输入地和输出地大多是相通的, 用万用表确认一下; 面包板的地只通过降压模块的 GND 这一根线接出去。

## Pico 引脚

从正面 (有 RP2040 芯片的一面) 看, USB 口朝上, 左上角是 1 号脚。彩色的是单臂原型要接的脚; GP0/GP1 以后接 Zero W 的串口, 现在空着。

四个机械手的完整引脚分配

用途 | R 臂 | L 臂 | F 臂 | B 臂
马达 IN1 / IN2 | GP2 / GP3 | GP6 / GP7 | GP10 / GP11 | GP14 / GP15
编码器 A / B | GP4 / GP5 | GP12 / GP13 | GP16 / GP17 | GP18 / GP19
舵机 | GP8 | GP9 | GP20 | GP21
PIO 状态机 | 0, 1 | 2, 3 | 4, 5 | 6, 7

## EV3 线的 6 根芯

脚 | 常见线色 | 功能 | 接到
1 | 白 | 马达 M1 | DRV8833 AOUT1
2 | 黑 | 马达 M2 | DRV8833 AOUT2
3 | 红 | 地 GND | 公共地
4 | 绿 | 编码器电源 | 5V
5 | 黄 | 编码器 A 相 | 10kΩ → GP4 (GP4 经 20kΩ 接地)
6 | 蓝 | 编码器 B 相 | 10kΩ → GP5 (GP5 经 20kΩ 接地)

红线是地线, 不是正极。 线色只是常见配色, 不同的线可能不一样, 以万用表通断为准: 1、2 脚之间是马达线圈, 电阻约几欧到十几欧; 1、2 脚和其他脚之间不通。

## 编码器为什么用分压

LEGO 官方电路: EV3 马达里两路编码器都是推挽输出 0V/5V, 各经一个串联电阻到插头 (蓝线 3.3kΩ; 黄线的电阻兼作型号识别, 大马达 3.3kΩ、中马达 6.8kΩ)。加上外接的 10kΩ 和 20kΩ, 高电平约 3.0V (中马达黄线约 2.7V), 低电平约 0V；已有大马达空载计数和闭环记录，装机后仍需验收。

BSS138 电平转换模块的上拉会和马达内部电阻分压, 低电平只能降到约 1.65V (实测 1.60~1.64V), 不能用; TXS0108E 要求信号源内阻很低, 也不能用。详细依据。

## 上电前用万用表检查

测什么 | 怎么测 | 应该是
9V 电源 (空载) | 直流电压档, 红表笔接正极 | 8.5~9.5V, 绝不能超过 10.8V
5V 降压输出 | 直流电压档, 接任何负载之前 | 4.9~5.2V
9V 与 GND 之间 | 断电, 电阻档 | 不能是 0Ω (否则短路)
5V 与 GND 之间 | 断电, 电阻档 | 不能是 0Ω
各模块的 GND 之间 | 断电, 蜂鸣档 | 全部相通
EV3 线 1、2 脚之间 | 断电, 电阻档 | 几欧到十几欧 (马达线圈)
DRV8833 nSLEEP 对地 | 通电后, 直流电压档 | 约 3.3V（本项目固定接 Pico 3V3）
分压点 (第 26、28 列) 对地 | 通电后、先不接 GP4/GP5 跳线, 手转马达, 每次转一点停下读 | 在约 0V 和 3V 之间跳变, 任何时候不超过 3.3V

## 完整接线后的上电与分项测试

马达、编码器和舵机可一次接齐。当前直连方案先按 完整接线说明连接 P04 与舵机；分项测试时无需反复插拔。

1. 先只插 USB。用 Thonny 或 mpremote 进入 REPL, 运行 import arm_test; arm_test.main(), 出现 arm> 后输入 off，再用 help 查看命令列表。
2. 接通 9V。初始化不主动发马达或舵机动作命令，但不能保证硬件上电不抖动。首次舵机定位先脱开连杆；如果马达或舵机自己转、发烫，立刻断开动力电源（含舵机 5V）并检查接线。
3. 输入 enc, 用手把马达输出轴转一圈, 再输入 enc。计数应变化约 720 (方向取决于转向)。没有变化就检查 5V、分压电阻、黄/蓝线通断和 GP4/GP5。
4. 确认无魔方、机械头和联动机构全程自由、供电接线已核验后，先输入 motor_test unloaded，该命令仅授权空载测试，不会转动。再输入 check，马达应短暂正转并显示 方向正确。方向相反就按提示改 config.py，重新上传并 Ctrl+D 软重启，再核查并重开空载模式。off、异常、Ctrl+C、退出或重启都会撤销模式；它不允许 load/cube 等带载测试或舵机开合。方向确认之前不要运行 rot。
5. 马达方向和齿轮比确认后，按 docs/single_arm.md 第 5 节标定舵机，再做旋转及联合测试。首次定位必须脱开曲柄与连杆，使用 servo_cal ... detached 声明会话后才发基准脉冲；断电连接并核实轴位后使用 aligned 会话。首次须等于 start，随后可指定声明区间内任意脉宽，不限制相邻命令差值；未知行程和端点附近仍建议小步观察。进入舵机会话会停止马达并撤销空载模式。端点和安全工作区间默认未设置；实测并填写匹配的 v4/R 身份、开启端点标定标志后，还需分开确认时序。默认 SERVO_MOVE_MS=None、SERVO_TIMING_CONFIRMED=False；自行选择保守的临时等待时长（1～5000ms 整数，不能沿用旧 120ms），上传并 Ctrl+D 重载后，只单次 open 或 close，观察完全停稳再发下一条，录像测完整开合时间。此时 grip、cycle 和普通旋转仍被锁住，显式空载模式是例外。取开／合较慢实测值加余量回填等待时长、设置时序确认标志，再上传重载后才做连续和联合动作；机构或供电变化后重新确认。详见 完整标定流程。
