gonewx/quadcuber/docs/wiring/direct-breadboard.html

v4 实物标定 · 保留 R 线路 · 条件式新增 L

# 面包板接信号，动力线直接连接

按图里的元件朝向和孔位接线。DRV8833 放在面包板旁边，使用母头线接模块排针；本图不使用洞洞板、分线端子或 Bricktronics。DC-005 正极分别接驱动 VM、降压 IN+；负极分别接驱动 GND、降压 IN−。下方切换接线视图，图、逐线表、电阻表和下载同步更新。

9V 总电源关掉，编码器也会失去 5V。 手动计数时保持编码器供电，并先将 GP2、GP3 都置低。2026-09-28 更换驱动模块后，大马达空载闭环已通过；v4 机械头、舵机和整机供电仍待验证。

原 R 单臂新 R+L（条件式）

切换仅改变说明，不改实物接线或固件；若已接新增 L，不能通过切回 R 视图套用单臂上电步骤。

原 R 单臂 · 25 根线 / 4 只电阻

先确认：当前健康 DRV8833 的 B 路空闲。 用户尚未确认该硬件条件；若 B 路已占用或板子有故障，本方案不适用。电流、温升与实物尺寸未验收。现固件只有单臂控制，ARM_ID 不切换 GPIO；切换视图不意味双臂控制能力，不能据此让 R/L 同时运动。

原 R · SVG 大图原 R · PNG 图片原 R · 网络表 JSON电路总览与验证状态可选洞洞板方案

## 完整接线

断开 USB 和9V，按下图及逐线表一次接齐马达、编码器与舵机。P04 从 DC-005 负极直接接降压 IN−；舵机红／棕线分别通过 S01／S02 直连降压 OUT+／OUT−，黄线通过 S03 接 j13（GP8）。Pico 由 USB 供电。

原 R 的 25 根线与 4 只电阻全部保留；新增 L 为 13 根线与 4 只电阻，使用 L 前缀和琥珀色高亮。仅在确认同板健康 B 路空闲后考虑此候选接法。

GP6 / GP7 → BIN1 / BIN2，BO1 / BO2 → L EV3 1 / 2脚；GP12 / GP13 分别读取 L 编码器独立分压点；GP9 接 L 舵机信号。LS01 / LS02 从降压 OUT+ / OUT− 独立接 L 舵机电源和地，不借道 R 舵机或面包板。P04 独立回流、Pico USB 供电和 STBY 接 3V3 都不变；STBY 不是 5V VCC。

此视图只说明接线，不能照搬原 R 命令给 L 上电。现固件没有初始化 L 的 GPIO，off 不能保证 L 输入为低。硬件条件、独立 GPIO 初始化与控制方案验证之前，保持新增 L 动力断电。

## 完整接线图 · 原 R

点按钮突出显示一组线及对应表行（下载始终为所选模式的完整接线）；悬停导线可看编号。手机上横向拖动查看。交叉线没有圆点就不连接。

全部接线9V / 5V公共地驱动控制编码器马达动力舵机信号

面包板坐标：Pico 两排插在 c3～c22、h3～h22，USB 朝左。面包板实际通常超过40列，此处仅画使用区域；两半电源轨用图中的短跳线接通。未用的另一条正电源轨省略。

## 先看清这些实物连接

### 不用让动力电流经过面包板

- 9V → VM、驱动 GND → 电源负极，以及驱动输出 → 马达，全部用独立导线直接连接模块；马达加工线用现有普通接线端子转接。
- 模块公排针接母头线端，端子夹持对应线材；动力线和线端额定电流需满足马达启动电流，普通细杜邦跳线只用于信号。
- DRV8833 放在绝缘面并固定，底部引脚不要碰金属或彼此短接。模块不需要焊死。
- DC-005 正极焊脚引出两根线，分别接 VM 与降压 IN+，焊点用热缩管等绝缘；负极直接接 DRV8833 左排第3脚 GND。模块端仍用母头插接。

### 使用现有配件

- 9V 电源、DC-005、已有降压模块，输出调到 5.0V。此接法要求降压 IN− 与 OUT− 内部共地，完整接线时 OUT− 直接接舵机地。
- Pico、DRV8833、面包板、两只10kΩ与两只20kΩ。
- 已修复/重新制作的 EV3 线；散铜丝先接端子，再转成面包板公头线。
- 本图不额外加电容；保留模块自带电容。降压模块不要求螺钉或支柱，避免裸露焊盘接触导体即可。

朝向说明：DRV8833 元件面朝上，左排从上到下为 VM、NC、GND、AO1、AO2、BO2、BO1、GND；右排为 NC、AIN2、AIN1、STBY、BIN1、BIN2、NC、GND。与你提供的丝印一致。DC-005 的三个焊脚形状和降压模块尺寸未确认，图中只标功能，不猜焊脚顺序；DC-005 切换脚留空绝缘。

## 全部导线与分压孔位 · 原 R

BB.+ 是上方5V轨，BB.- 是上方地轨，BB.G 是下方地轨。每个数字列的 a～e 相通、f～j 相通，中槽两侧不通。DRV.GND-L1 是左排第3脚，DRV.GND-L2 是左排第8脚，DRV.GND-R 是右排第8脚；这三个脚通过模块内部连接共地。导线编号与图中提示、网络表一致。DRV.GND-L2 留空。

编号 | 怎么接 | 图内端点
P03 | DC 正极第一根线 → 降压 IN+ | DC.+9V → BUCK.IN+
P04 | DC 负极 → 降压 IN−（独立回流） | DC.GND → BUCK.IN−
P07 | DC 正极第二根线 → 驱动 VM（直接线） | DC.+9V → DRV.VM
P08 | DC 负极 → 驱动左排第3脚 GND（直接线） | DC.GND → DRV.GND-L1
P09 | 降压 OUT+ 直接接面包板上 + 第38孔 | BUCK.OUT+ → BB.+38
P10 | 驱动右排第8脚 GND → 面包板上 − 第38孔 | DRV.GND-R → BB.-38
G01 | Pico GND：a5 → 上 − 第5孔 | BB.a5 → BB.-5
G02 | 上下地轨相连 | BB.-40 → BB.G40
G03 | 跨接该电源轨中间断口（有断口时） | BB.-20 → BB.-21
G04 | 跨接该电源轨中间断口（有断口时） | BB.G20 → BB.G21
P11 | 跨接该电源轨中间断口（有断口时） | BB.+20 → BB.+21
C01 | GP2 / 物理4脚：j6 → AIN1 | BB.j6 → DRV.AIN1
C02 | GP3 / 物理5脚：j7 → AIN2 | BB.j7 → DRV.AIN2
C03 | Pico 3V3 / 物理36脚：a7 → STBY | BB.a7 → DRV.STBY
M01 | AO1 → EV3 1脚（直接线） | DRV.AO1 → EV3.1
M02 | AO2 → EV3 2脚（直接线） | DRV.AO2 → EV3.2
E01 | EV3 3脚 → 面包板 GND | EV3.3 → BB.-37
E02 | EV3 4脚 → 面包板 5V | EV3.4 → BB.+40
E03 | EV3 5脚 → h33，进入 A组10kΩ | EV3.5 → BB.h33
E04 | EV3 6脚 → h31，进入 B组10kΩ | EV3.6 → BB.h31
E05 | A分压点 i26 → GP4 i8（物理6脚） | BB.i26 → BB.i8
E06 | B分压点 i28 → GP5 i9（物理7脚） | BB.i28 → BB.i9
S01 | 降压 OUT+ → 舵机红线 +5V（独立动力线） | BUCK.OUT+ → SERVO.V+
S02 | 降压 OUT− → 舵机棕线 GND（独立回流） | BUCK.OUT− → SERVO.GND
S03 | GP8 / 物理11脚：j13 → 舵机黄线信号 | BB.j13 → SERVO.SIG

编号 | 怎么接 | 图内端点
P03 | DC 正极第一根线 → 降压 IN+ | DC.+9V → BUCK.IN+
P04 | DC 负极 → 降压 IN−（独立回流） | DC.GND → BUCK.IN−
P07 | DC 正极第二根线 → 驱动 VM（直接线） | DC.+9V → DRV.VM
P08 | DC 负极 → 驱动左排第3脚 GND（直接线） | DC.GND → DRV.GND-L1
P09 | 降压 OUT+ 直接接面包板上 + 第38孔 | BUCK.OUT+ → BB.+38
P10 | 驱动右排第8脚 GND → 面包板上 − 第38孔 | DRV.GND-R → BB.-38
G01 | Pico GND：a5 → 上 − 第5孔 | BB.a5 → BB.-5
G02 | 上下地轨相连 | BB.-40 → BB.G40
G03 | 跨接该电源轨中间断口（有断口时） | BB.-20 → BB.-21
G04 | 跨接该电源轨中间断口（有断口时） | BB.G20 → BB.G21
P11 | 跨接该电源轨中间断口（有断口时） | BB.+20 → BB.+21
C01 | GP2 / 物理4脚：j6 → AIN1 | BB.j6 → DRV.AIN1
C02 | GP3 / 物理5脚：j7 → AIN2 | BB.j7 → DRV.AIN2
C03 | Pico 3V3 / 物理36脚：a7 → STBY | BB.a7 → DRV.STBY
M01 | AO1 → EV3 1脚（直接线） | DRV.AO1 → EV3.1
M02 | AO2 → EV3 2脚（直接线） | DRV.AO2 → EV3.2
E01 | EV3 3脚 → 面包板 GND | EV3.3 → BB.-37
E02 | EV3 4脚 → 面包板 5V | EV3.4 → BB.+40
E03 | EV3 5脚 → h33，进入 A组10kΩ | EV3.5 → BB.h33
E04 | EV3 6脚 → h31，进入 B组10kΩ | EV3.6 → BB.h31
E05 | A分压点 i26 → GP4 i8（物理6脚） | BB.i26 → BB.i8
E06 | B分压点 i28 → GP5 i9（物理7脚） | BB.i28 → BB.i9
S01 | 降压 OUT+ → 舵机红线 +5V（独立动力线） | BUCK.OUT+ → SERVO.V+
S02 | 降压 OUT− → 舵机棕线 GND（独立回流） | BUCK.OUT− → SERVO.GND
S03 | GP8 / 物理11脚：j13 → 舵机黄线信号 | BB.j13 → SERVO.SIG
LC01 | 新增 L：GP6 / 物理9脚，j11 → BIN1 | BB.j11 → DRV.BIN1
LC02 | 新增 L：GP7 / 物理10脚，j12 → BIN2 | BB.j12 → DRV.BIN2
LM01 | 新增 L：BO1 → L EV3 1脚（独立动力线） | DRV.BO1 → L.EV3.1
LM02 | 新增 L：BO2 → L EV3 2脚（独立动力线） | DRV.BO2 → L.EV3.2
LE01 | 新增 L：EV3 3脚 → 上地轨 −39 | L.EV3.3 → BB.-39
LE02 | 新增 L：EV3 4脚 → 上5V轨 +39 | L.EV3.4 → BB.+39
LE03 | 新增 L：EV3 5脚 → h37，进入 LR1 10kΩ | L.EV3.5 → BB.h37
LE04 | 新增 L：EV3 6脚 → h40，进入 LR3 10kΩ | L.EV3.6 → BB.h40
LE05 | 新增 L：A分压点 i34 → GP12 i18（物理16脚） | BB.i34 → BB.i18
LE06 | 新增 L：B分压点 i36 → GP13 i19（物理17脚） | BB.i36 → BB.i19
LS01 | 新增 L：降压 OUT+ → L舵机 +5V（独立动力线） | BUCK.OUT+ → L.SERVO.V+
LS02 | 新增 L：降压 OUT− → L舵机 GND（独立回流） | BUCK.OUT− → L.SERVO.GND
LS03 | 新增 L：GP9 / 物理12脚，j14 → L舵机信号 | BB.j14 → L.SERVO.SIG

### 分压电阻 · 4 只

编号 | 阻值 | 两端插孔（无正反）
R1 | 10kΩ | f33 ↔ f26
R2 | 20kΩ | j26 ↔ G26
R3 | 10kΩ | g31 ↔ g28
R4 | 20kΩ | j28 ↔ G28

编号 | 阻值 | 两端插孔（无正反）
R1 | 10kΩ | f33 ↔ f26
R2 | 20kΩ | j26 ↔ G26
R3 | 10kΩ | g31 ↔ g28
R4 | 20kΩ | j28 ↔ G28
LR1 | 10kΩ | f37 ↔ f34
LR2 | 20kΩ | j34 ↔ G34
LR3 | 10kΩ | g40 ↔ g36
LR4 | 20kΩ | j36 ↔ G36

GP4 接第26列分压点，GP5 接第28列分压点；黄 / 蓝线接10kΩ另一端。R 的两只20kΩ都接下方地轨。程序保持 ENC_PULLUP=False（编码器构造参数 pull_up=False）。

L：EV3 5脚 → h37 → LR1（10kΩ，f37–f34）→ 第34列 → i18 / GP12，LR2（20kΩ，j34–G34）接地；EV3 6脚 → h40 → LR3（10kΩ，g40–g36）→ 第36列 → i19 / GP13，LR4（20kΩ，j36–G36）接地。R / L 四个编码器输入与分压节点各自独立，不能并联，也不能直连 5V。

几何核对采用 2.54mm 孔距：LR1 横跨 3 格（7.62mm），LR3 横跨 4 格（10.16mm）；它们位于 Pico 末端第22列之外。20kΩ 接下地轨的跨度依实际面包板而定；尚未收到电阻体尺寸，须断电确认引脚可达、无挤压且裸腿不相碰。图中的轨断口仅为模型，需核对实物通断。

## R 单臂接齐后，按命令分项测试

1. 断电检查：降压输出已空载调到5.0V；核对 P04 直接回电源负极，舵机红／棕线直连降压输出，全部设备共地。不放魔方，确认机械头及联动机构全程自由；首次舵机定位先脱开连杆，曲柄本身也要自由活动。
2. Pico先接USB：运行 import arm_test; arm_test.main()，出现 arm> 后输入 off。初始化时马达滑行、舵机 PWM 关闭；这只是软件不发命令，不能保证硬件上电不抖动。
3. 再打开9V：观察异常；马达或舵机自己转、发烫就切断动力电源（含舵机5V）。输入 enc，轻转机械头确认计数变化。确认无魔方、机构全程自由且供电接线已核验后，输入 motor_test unloaded；它只授权空载测试，不会自动转动。再按单臂说明执行 check、确认方向与齿轮比。off、异常、Ctrl+C、退出或重启都会撤销模式，继续前重新检查并声明；空载模式拒绝 load/cube 等带载测试及所有舵机开合预设。
4. 标定舵机：首次必须断电脱开连杆，使用 servo_cal ... detached 声明后才发基准脉冲；声明会话会停止马达与 PWM，并撤销空载马达模式。断电装接且核实轴标记、基准姿态和行程后，才用 aligned 会话小步标定；500～2500µs 只是驱动包络，不是机械安全区间，首次定位仍可能大幅跳转；后续允许在声明区间内指定绝对脉宽，仍须核对机械行程。端点与安全工作区间默认未设置，SERVO_CALIBRATED=False；手动会话或未完成标定时 open、close、grip、cycle 均拒绝，详见 完整舵机标定流程。
5. 先测完整开合时序：默认 SERVO_MOVE_MS=None、SERVO_TIMING_CONFIRMED=False。实测端点、安全工作区间并确认 v4/R 身份后，设置端点标定标志，自行选择保守的临时等待时间（1～5000ms整数，不能沿用旧120ms），上传并 Ctrl+D 重载。只单次 open 或 close，观察完全停稳才发下条，录像测完整行程；此时 grip、cycle 和普通旋转仍被锁住，显式空载马达模式是例外。
6. 旋转与联合测试：取开／合中较慢的实测时长加余量回填 SERVO_MOVE_MS，设置 SERVO_TIMING_CONFIRMED=True，重新上传并 Ctrl+D 重载后，再按 单臂测试第0～9步继续。每步通过后再做下一步，无需反复插拔舵机；机构或供电改变后重新确认时序。

大马达空载闭环已通过，见实测记录；这不代表 v4 机械头、舵机标定或整机供电已经实测通过。

## 可选排障：暂时隔离舵机

只有排查复位、供电跌落或驱动异常时，才需要断开 USB 和9V后暂时拔下舵机，单独检查马达和编码器。P04 保持直接接电源负极。排障后断电接回舵机。

## R+L 的验收边界

先断开 USB 与9V，确认健康 B 路确实空闲、每个孔只占一个端点、四组分压独立且每路为10kΩ串联＋20kΩ对地。确认各设备共地，舵机正负线独立直达降压输出，保留 P04 直接回 DC-005 负极。

后续受控电气验收需先将分压点与 Pico 断开，分别测量四路输出高低电平，再断电接回；分压点不可超过3.3V。电源启动瞬态、两路电机电流、驱动温升和线端承载仍待实际验收。本页没有双臂上电或运动测试步骤；原 R 的空载验证不覆盖新增 L。

## 依据

- LEGO 官方 EV3 原理图 (https://www.lego.com/cdn/cs/set/assets/blt86e79bb287a0d0b1/Appendix_LEGO_MINDSTORMS_EV3_programmable_brick_main_hardware_schematics.pdf)：Output 1/2为动力端、3为地、4为5V、5/6为反馈。
- Raspberry Pi Pico 官方数据手册 (https://datasheets.raspberrypi.com/pico/pico-datasheet.pdf)：物理脚位与GPIO对应。
- TI DRV8833 数据手册 (https://www.ti.com/lit/ds/symlink/drv8833.pdf)：输入控制逻辑；模块丝印排列使用用户实物确认结果。
