gonewx/quadcuber/generated/site/integrated-operation.html

Quadcuber 最终结构 / 882件

设计候选 · 未通过实体装配、承载与带电验收。按住外柄才能保持上位；无阻尼，谨防夹手与突然下落。 风险与范围

# 装卸动作演示

整机3D / 放入、夹持交接、托座回落与取出 · 17阶段设计端姿

立体正视侧视俯视放大缩小复位全屏查看重试3D

选择动作阶段

正在载入此阶段整机…

拖动旋转 · 滚轮 / 双指缩放 · R复位

本阶段说明与安全核对

仅供设计审阅；未通过实体验收，不可照此操作实机。

按压手只在外柄末端三孔上方；放取魔方的手和工具须完全离开四臂及托座运动区域。外柄手部隔离和控制联锁尚待实体验证，验证前不带电执行。

上一阶段设计端姿切换，不发送控制指令下一阶段

仅供设计审阅 · 不可照此操作实机

按压手只在外柄末端三孔上方；放取魔方的手和工具须完全离开四臂及托座运动区域。外柄手部隔离和控制联锁尚待实体验证，验证前不带电执行。

### 此阶段的设计说明

### 停下核对

### 当前支承与夹持

魔方支承

参考中心

四臂状态

托座

上位保持

打开原图

方向与魔方参考盒

R=+X，L=−X，F=+Z，B=−Z，向上=−Y；画面左右随视角改变，臂名不变。

黄色透明盒是56毫米魔方位置参考，不计入882件LEGO；不代表实体零件或碰撞结论。A/D、W/S可旋转，+/-缩放，R复位。

支承与四臂的关系

- 150件支承总成＝托座导向结构130件＋U形杠杆16件＋上止挡4件。
- 闭环底盘64＋四个60483机械臂668＋支承150＝整机882件；所有正常阶段件数不变。
- 四个39790底框经四个L角形成闭环；闭环拓扑不证明实物抗扭刚度。杠杆12L轴支在既有底层7×5框，两根15L内臂通过11L横轴中央轴套顶托原座；第三根15L为外侧按柄。
- 托盘靠持续按压保持上位；缓松后按设计关系靠自重下降，无自动保持与阻尼。

零件表与下载

完整501页PDF模型与构建源文件（图解/PDF另下）882件整机MPD整机BOM分组件BOM

## 最终整机零件表

与882件整机模型逐实例一致。仅列最终结构所用零件；颜色见分组件BOM。

设计号 | 数量
11478.dat | 4
14720.dat | 1
15100.dat | 6
18654.dat | 6
18938.dat | 4
18939.dat | 4
23948.dat | 1
2780.dat | 276
32013.dat | 4
32054.dat | 8
32062.dat | 12
32073.dat | 5
32123a.dat | 90
32140.dat | 7
32278.dat | 19
32316.dat | 33
32449.dat | 16
32523.dat | 24
32524.dat | 35
32525.dat | 8
32526.dat | 21
3648b.dat | 4
3673.dat | 8
3705.dat | 5
3706.dat | 1
3707.dat | 8
3708.dat | 5
3713.dat | 22
39790.dat | 4
39793.dat | 4
40490.dat | 20
41677.dat | 4
42610.dat | 8
43857.dat | 5
44294.dat | 4
4519.dat | 12
50945_nominal.dat | 8
55615.dat | 16
60483.dat | 16
62462.dat | 3
64179.dat | 20
6536.dat | 4
6558.dat | 109
95658.dat | 4
geekservo.dat | 4

装配范围与未通过的验收

本册共501步，含准备与检查：64件底盘从散件装配、150件支承与杠杆、四个机械臂组件的最终装配、接口与总装核对。四臂均从清单单件开始，全部882个实例逐步取用，没有预装核心；成品电机和舵机按采购件处理。

480步提供精确记录对应的局部3D；其余步骤使用原始图解，包括准备与检查页。图解、3D与PDF使用同一最终结构数据。蓝色只表示本步新取件，合并步骤可能没有新件。

支承总成含20件重力回落杠杆。只有持续按住外柄才保持上位；夹头可靠接管后缓松回落40.8毫米。无阻尼，不保证实物自落、刚度或回落冲击安全。按柄下方约9毫米夹手间隙，手只从末端三孔区域上方按压。

正常夹指开角不超过25°。实体装配路径、保持、载荷、手部隔离、自重回落与带电验收仍未通过；名义几何不代表实物验收。

最终结构 · 全机882件 / 底盘64 / 四臂668 / 支承150
