gonewx/quadcuber/mechanical/final/site-source/assembly-guide.html

操作前独立支撑滑架。拔锁键或升降时不要依赖另一把锁承载；手离开运动区域，不强制手转机械头。

回程顺序：保持夹持，先升座并锁住；再依次打开前后夹爪、左右夹爪，反转回装料角度，最后取出魔方。查看器不模拟这套操作流程。

当前可用范围：角舱16步。原有机械模块内部接头正在补充复核，原四臂总成装回步骤暂缓；不要按旧总览图的第9组施工。

## 搭建步骤

返回3D

192件名义几何复核版，实物待验收。按组件安排先后，各组内部仍需预插销与分步闭合；这不是900件逐件插入路径的实物证明。

1. 基础先搭好累计59件 · #1–59；先装两条7L基础梁（#2、7）；在原电机框接口闭合前完成预插销
2. 加入29件共用角舱累计88件 · 新增#60–88；20根2780先插下层Y112，挡圈Y108；再合上Y104梁与原39790接口框
3. 立框、侧夹层与脚独立组件13件 · #89、98–109；先完成立框销、垫套与侧夹层闭合；再预插4根脚销，合上根部与支脚
4. 滑架单独预装独立组件26件 · #145–170；普通销与三层6558销先就位；再闭合滑架的宿主梁与耳部
5. 承托座单独预装独立组件27件 · #124–144、171–175、186；先装15100的Y向根部，再合上顶销和5L梁；#132使用6558，按修正坐标装入
6. 连成63件移动总成移动组件63件 · 4 + 5 + #176–185；两根不平行轴分别穿入对应轴承；逐一加入定位挡套；不能同时压入两个轴端
7. 装移动总成，再穿导杆根部 + 移动件 + #90–97，共84件；支撑移动总成，预放导杆限位件；再从上方穿入导杆；尚不装原708模块
8. 将根部连接到共用底盘累计186件 · 2 + 7 + #110–123；4L/5L连接轴分别从轴承远侧穿入；内侧挡套先就位；落桌前完成四处连接
9. 原有机械模块装回：暂缓原708件内部接头正在复核。此处仅保留结构参考，不作为当前可施工步骤

查看9组装配总览图

修正192件共用底盘与原708件模块的九组搭建顺序图

此图是分组结构参考，第9组原机械模块装回暂缓。各组独立缩放；图中编号从1开始。

角舱细节 · 先插20根销，再合拢

以下四步只覆盖29件共用角舱与两个原接口框。

先插20根销，再合拢两层。基础离桌或翻面，留出底侧操作空间；不要尝试在两层闭合后穿销。

1. 摆好下层件中心Y112毫米：3个32526厚角件、1根32316（5L）搭接梁、2个42003轴孔座
2. 预插20根2780销先插入下层构件，中间挡圈位于Y108毫米，上半段露出等待合拢
3. 对齐上层梁与原接口框右侧15L梁、底边11L＋7L梁，以及2个原39790接口框；图中的上层抬高32毫米只是爆炸显示
4. 合拢到最终位置沿＋Y落回32毫米，套住预插销，上层中心到Y104毫米。核对右接口X192／208、Z−32；相邻接口X48、Z−176／−192。灰色原接口框不计入29件

29件共用角舱实际零件四步装配图：摆下层、预插20根销、对齐上层、合拢

真实零件网格；颜色仅用于识别。仅覆盖角舱与两个原接口框，省略其余基础、708件原模块、导轨和座部。

后续脚／导轨连接须按专门顺序装配。此图不证明手部净空、实际插拔力、保持力或刚度合格，也不是完整900件搭建说明。

关键细节 · 修正销与上位锁拆装

### 第132件：从−Z侧插入6558销

中心（40，32，−8）毫米，长端朝＋Z，挡肩落在Z−12的凹口侧。不要沿用旧2780销的挡肩位置。

### 第一把上位锁：先支撑滑架，再拆锁

1. 拆外半轴套第189件向＋v取下；第188件内半轴套留在原位，露出4毫米轴端
2. 抽出锁轴第187件向＋v平移32毫米，穿过静止的内半轴套；不要将内半轴套一并拉走
3. 再取内半轴套第188件先向−v退0.5毫米，再沿＋Y向下移12毫米；复装按相反顺序，滑架全程保持支撑

v＝（X＋Z）／√2，＋Y向下。禁止向−v抽锁轴，或向−Y取出游离内半轴套。另一把上位锁也沿＋v拆装。可选4L长锁轴未采用。

修正6558销的单面孔挡肩位置，以及上位锁三步取出路径

未验证手部净空、4毫米握持段可用性、插拔力、保持力或承载安全。
