gonewx/quadcuber/mechanical/final/site-source/dist/integrated/manual.pdf

## 001 / 501 准备 最终结构与装配范围

整机882件：底盘64＋四臂668＋支承150

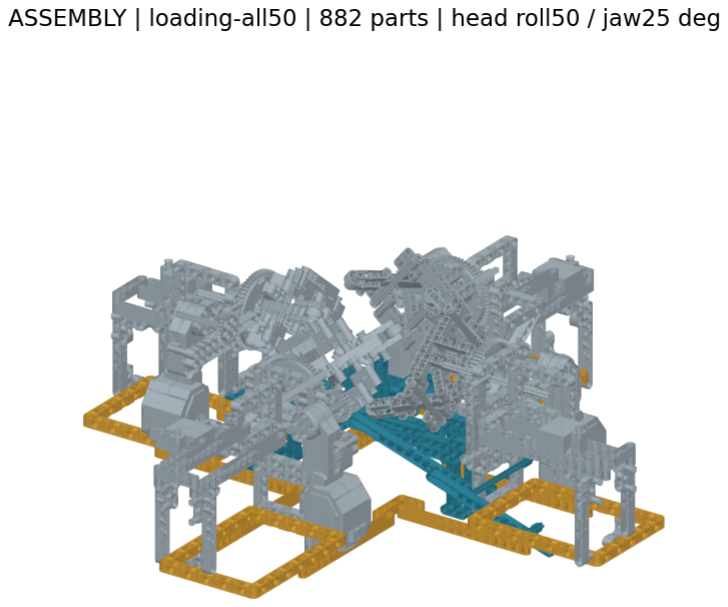
[picture p59: figure]

1. 按最终结构准备64件闭合底盘、四个167件机械臂和150件 支承总成。支承总成包含130件托座导向结构与20件重力回 落杠杆。
2. 底盘、四臂支架与传动、夹头及支承均从清单单件逐步搭 建。电机和舵机作为成品采购件，不拆内部；没有预装核心 前提。
3. 本册直接覆盖882个清单实例，各件只在首次取用时计数。 先搭完整墙架、舵机架及竖支脚，再装转盘下半和输出传动。 先在机外完成模块，再按顺序接入底盘，81号侧梁和84号销 留至臂就位后安装。
4. 按住外把手使托盘保持上位，夹头可靠接管重量后缓松回 落。本设计无自动保持和阻尼。

核对：同一882件模型对应本册、最终零件表及全部动作姿 态。实体装配与安全验收仍未通过。

真实LDraw网格；爆炸间距仅用于识别，不代表装配间隙或已验证路径。

FINAL ASSEMBLY | 设计审阅；实体装配／保持／强度／重力回落／带电动作未放行

## 002 / 501 准备 断电空载与独立支承

外部支承夹具不计入模型BOM

1. 装配时不放魔方，断开电机电源和驱动连接，固定底盘， 并用独立夹具支承机械臂、夹指及移动托盘。
2. 一次只装一个头部和一根根轴。未装好端部保持件前，夹 指和根轴均须独立支承。
3. 先确认工作台稳定、零件可从指定方向接近，再插入销轴。 不可用手指代替夹具，不靠软件停止代替断电。
4. 图示为名义装配姿态，不能证明人手接近空间、连续装配 路径或实际插入力。

核对：没有可靠支承、无接近空间或需要强推销肩穿孔时立 即停止。

真实LDraw网格；爆炸间距仅用于识别，不代表装配间隙或已验证路径。

FINAL ASSEMBLY | 设计审阅；实体装配／保持／强度／重力回落／带电动作未放行

## 003 / 501 准备 最终组件与零件盘点

底盘64件；四臂668件；支承150件

1. 每臂167件，含4件60483根部支架；四臂合计668件。根轴、 定位轴套、夹指和连接销按所在位置分组，不能仅凭相同型 号互换位置。
2. 支承总成150件包含130件托座导向结构与20件杠杆。杠杆 20件已包含4件上止挡。
3. 按本册组装双11478桥端、中央43857及32316五孔厚梁，并 核对托面、导轨和下止挡。
4. 底盘为四框闭环，每处L形转角双销连接。每臂墙脚用两 枚2780，共8枚。颜色是模型展示信息，采购配色未核实。

核对：882件是全部动作状态的固定数量，不因托盘上下或 夹指开合变化。

真实LDraw网格；爆炸间距仅用于识别，不代表装配间隙或已验证路径。

FINAL ASSEMBLY | 设计审阅；实体装配／保持／强度／重力回落／带电动作未放行

## 004 / 501 底盘64件 A：摆好 15L 下梁

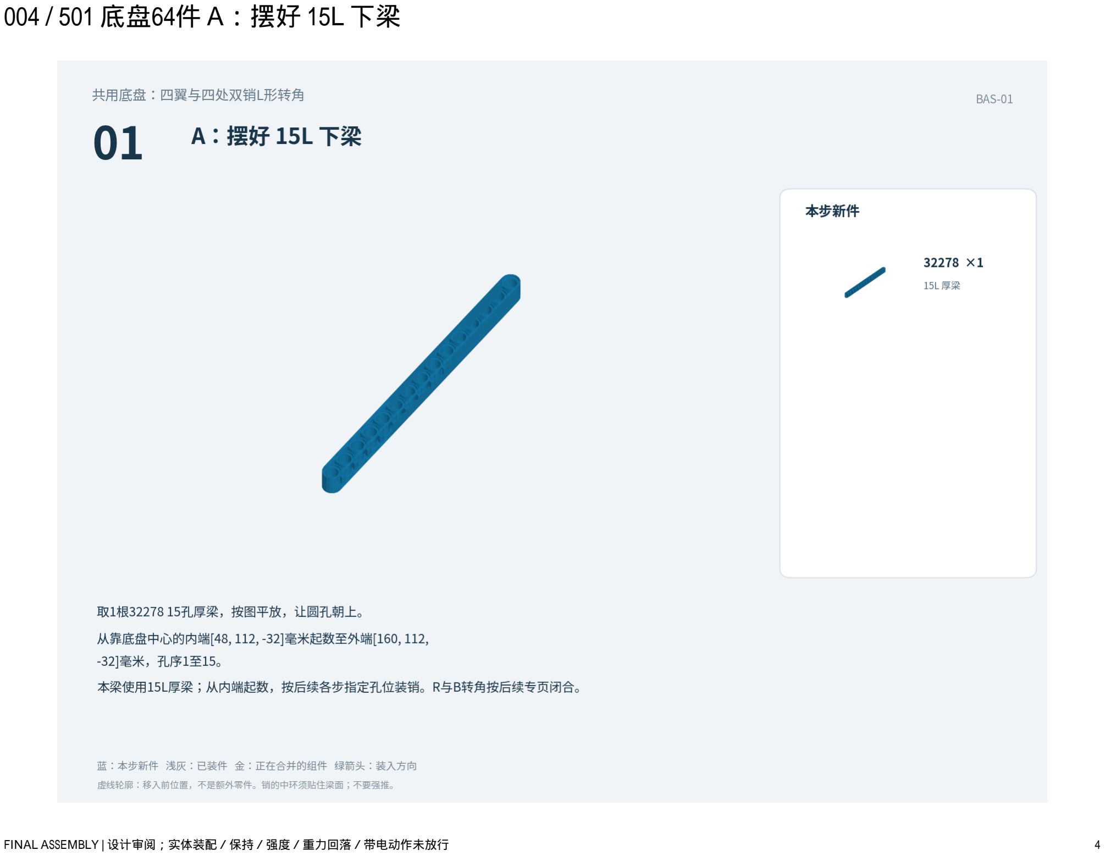
[picture p60: page 4]

FINAL ASSEMBLY | 设计审阅；实体装配／保持／强度／重力回落／带电动作未放行

## 005 / 501 底盘64件 A：15L 下梁预装四根黑销

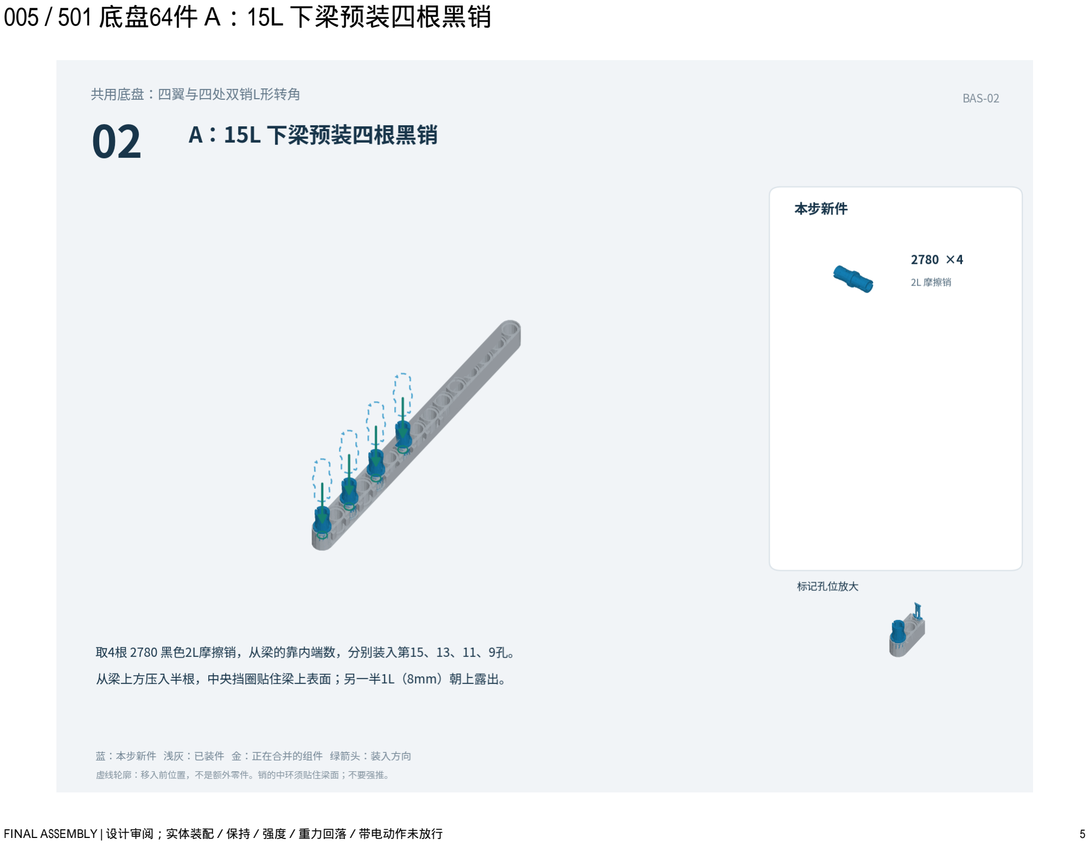
[picture p61: page 5]

FINAL ASSEMBLY | 设计审阅；实体装配／保持／强度／重力回落／带电动作未放行

## 006 / 501 底盘64件 A：另做马达下梁

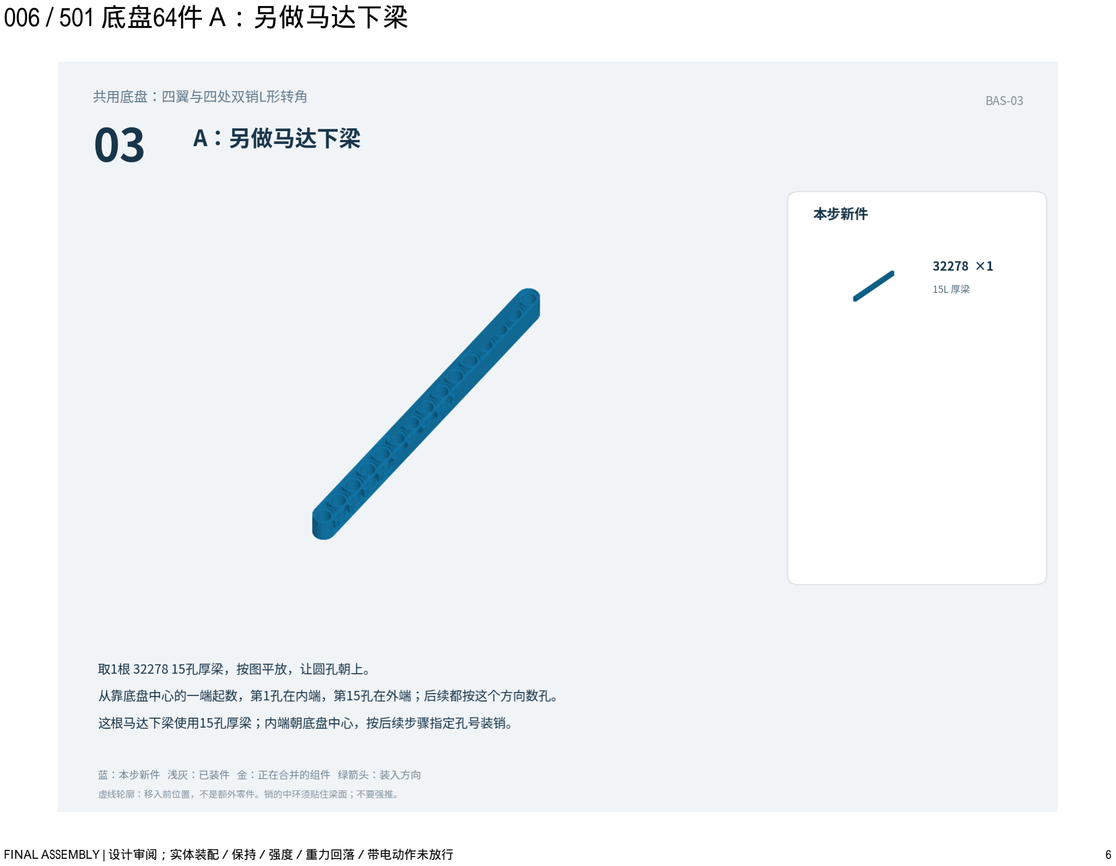
[picture p62: page 6]

FINAL ASSEMBLY | 设计审阅；实体装配／保持／强度／重力回落／带电动作未放行

## 007 / 501 底盘64件 A：马达下梁两根黑销

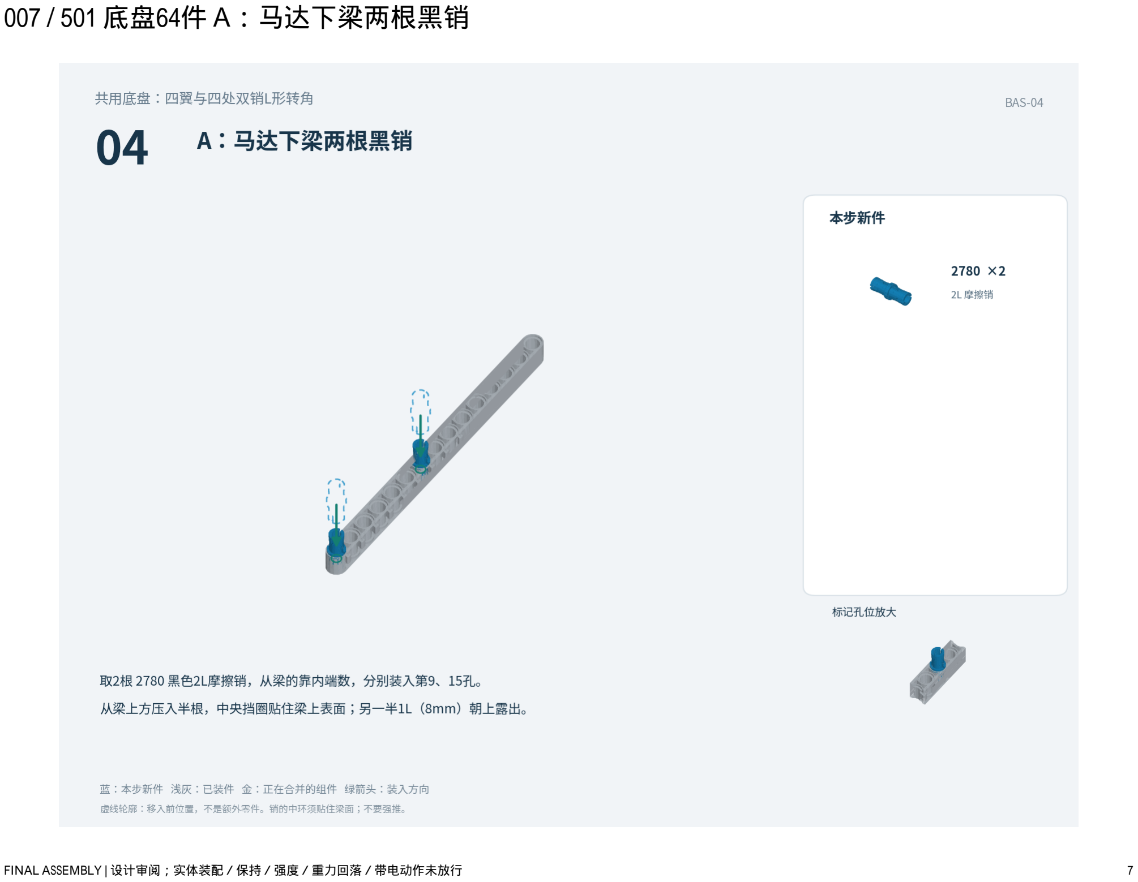
[picture p63: page 7]

FINAL ASSEMBLY | 设计审阅；实体装配／保持／强度／重力回落／带电动作未放行

## 008 / 501 底盘64件 A：马达下梁两根蓝销

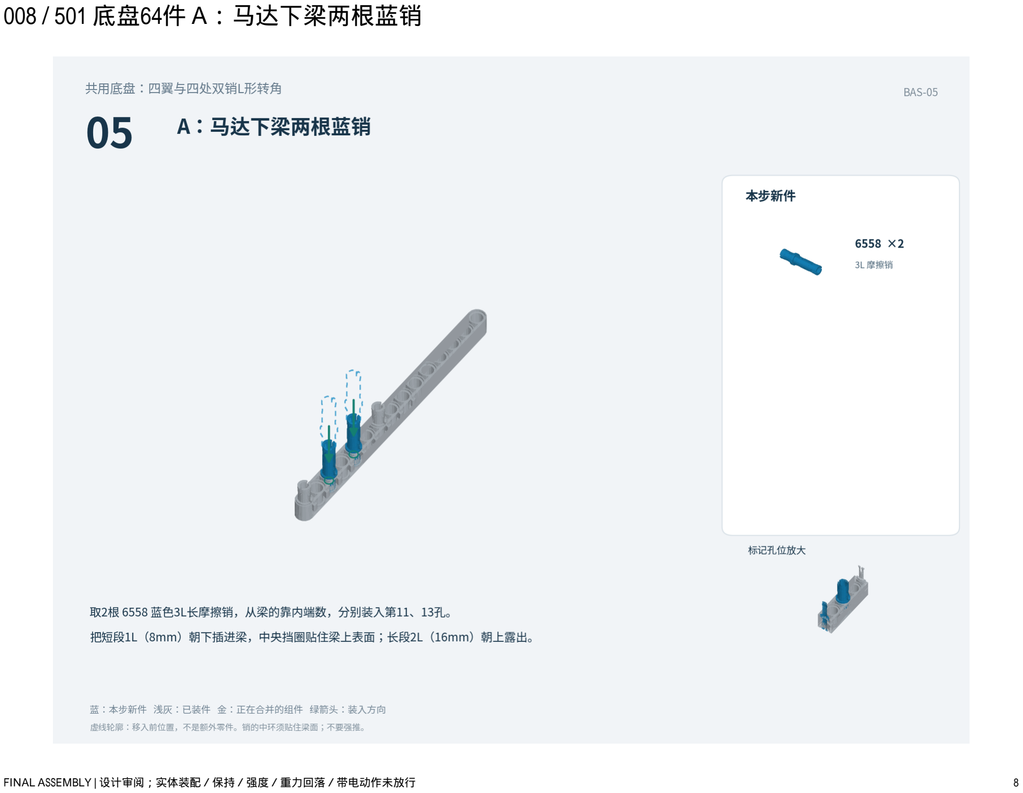
[picture p64: page 8]

FINAL ASSEMBLY | 设计审阅；实体装配／保持／强度／重力回落／带电动作未放行

## 009 / 501 底盘64件 A：预留第一处L梁黑销

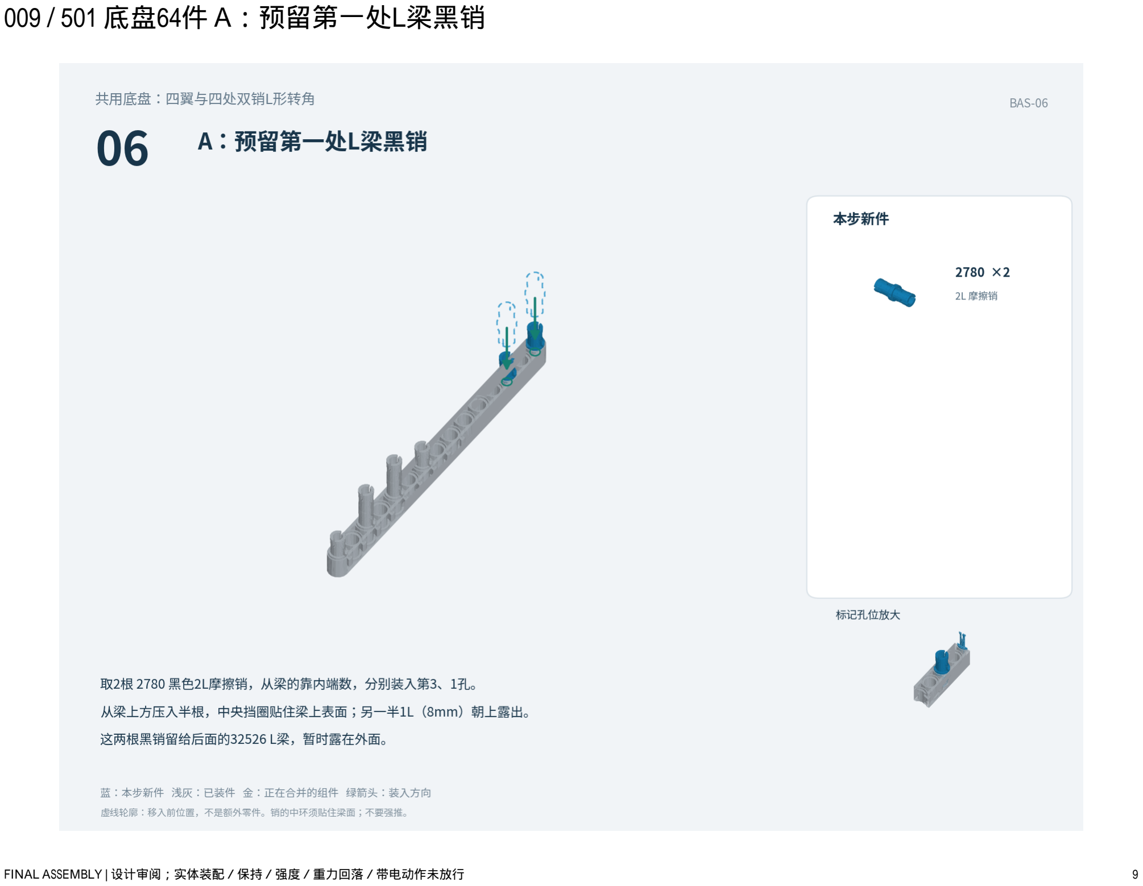
[picture p65: page 9]

FINAL ASSEMBLY | 设计审阅；实体装配／保持／强度／重力回落／带电动作未放行

## 010 / 501 底盘64件 A：压下大框，合成第一翼

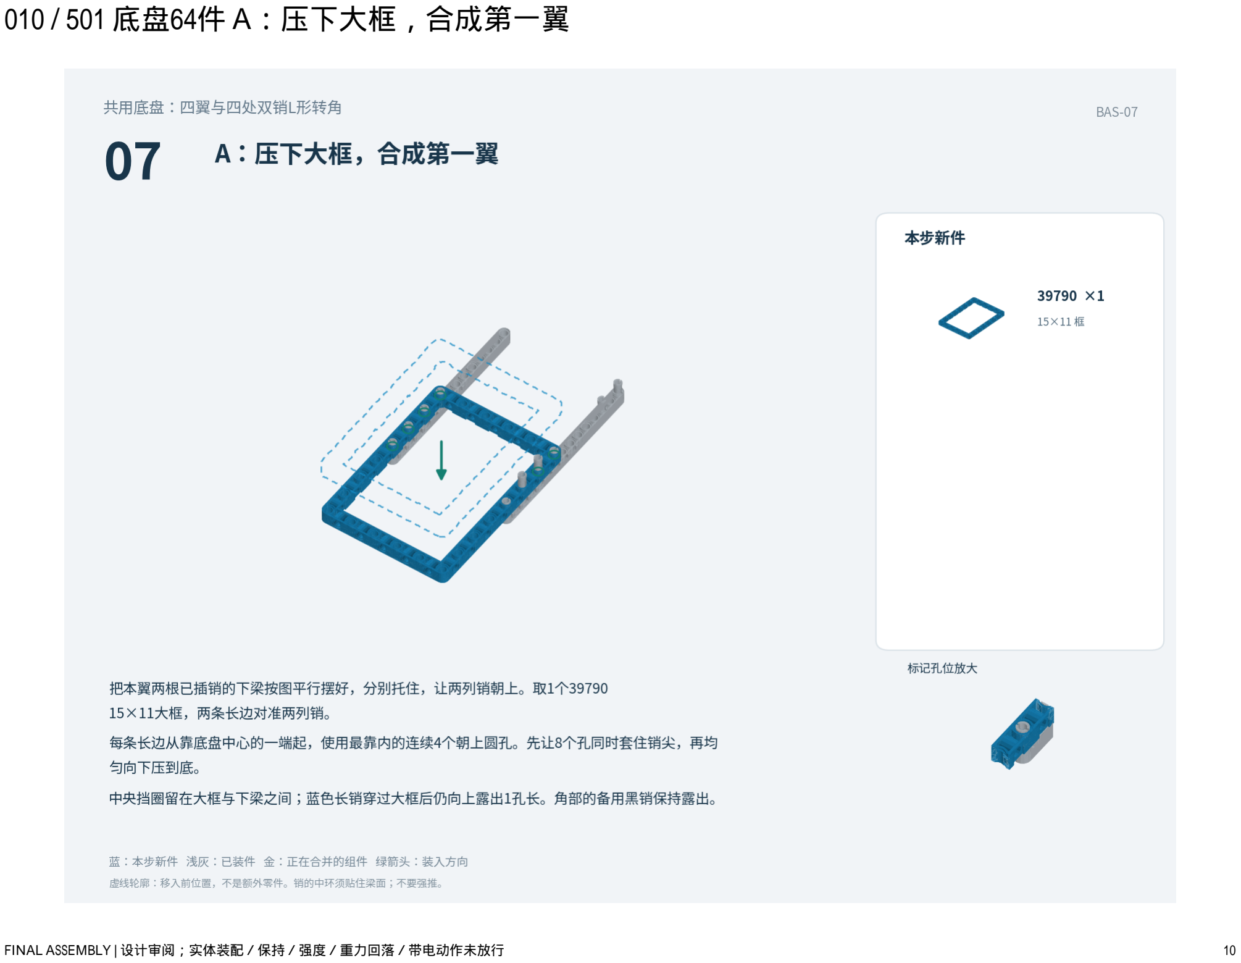
[picture p66: page 10]

FINAL ASSEMBLY | 设计审阅；实体装配／保持／强度／重力回落／带电动作未放行 | 10

## 011 / 501 底盘64件 B：摆好第一根 15L 梁

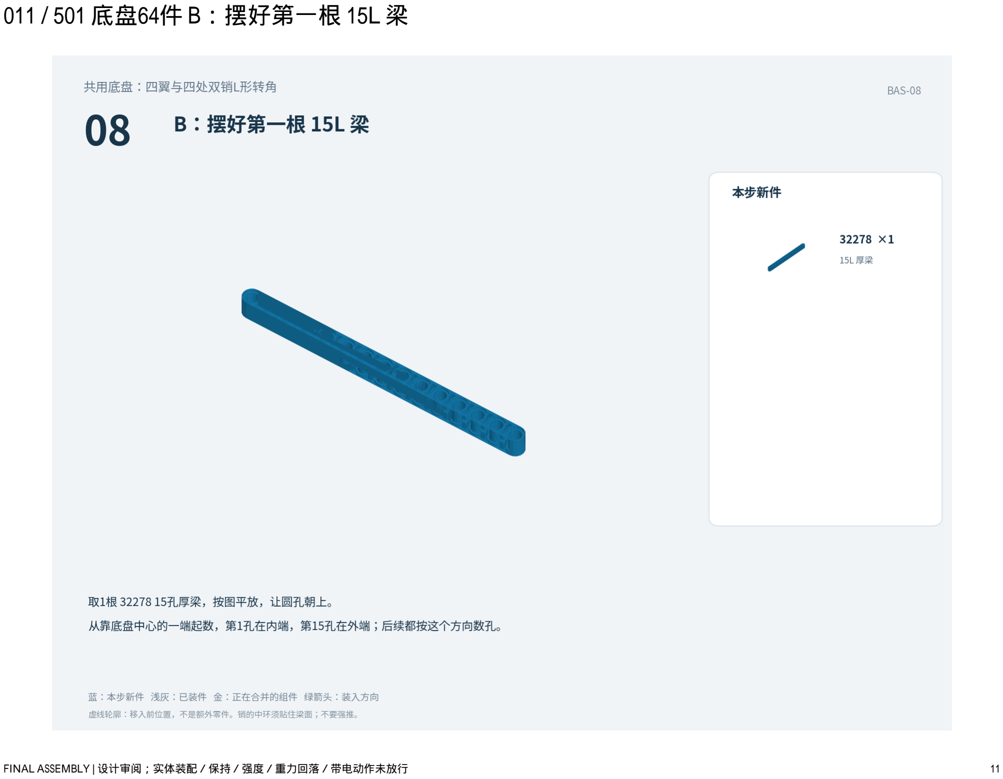
[picture p67: page 11]

## 012 / 501 底盘64件 B：第一根下梁预装四根黑销

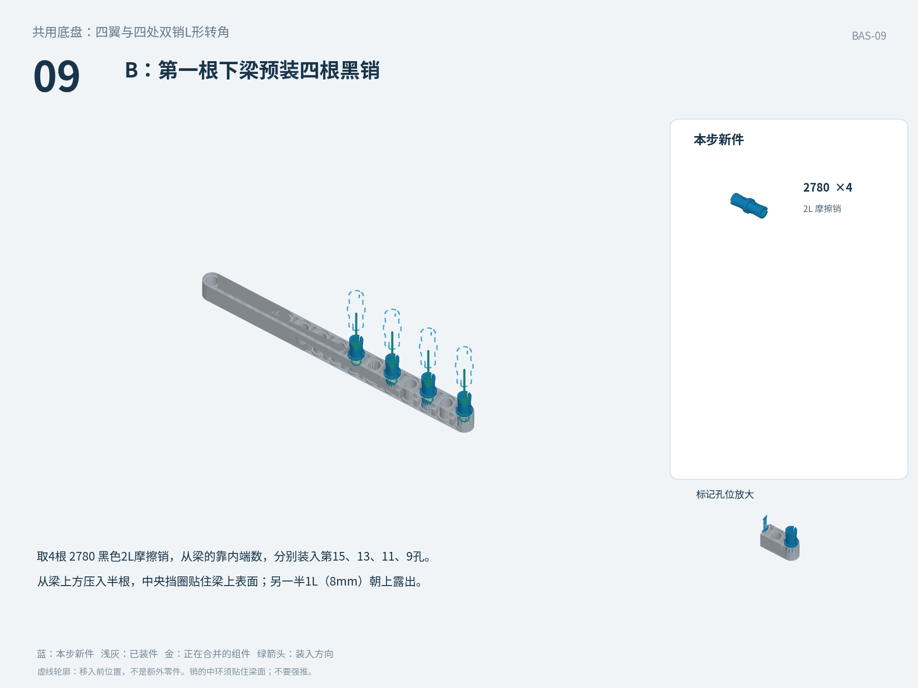
[picture p68: page 12]

## 013 / 501 底盘64件 B：预留与 A 翼连接的两销

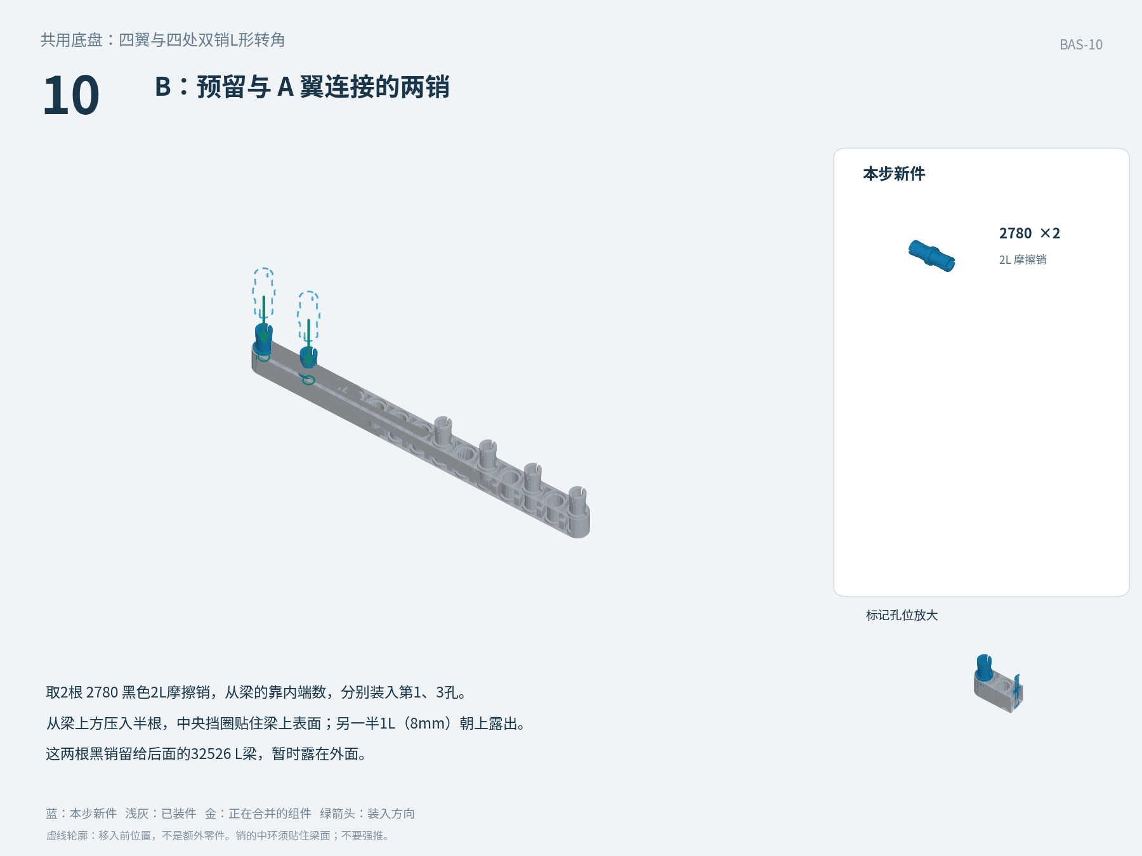
[picture p69: page 13]

## 014 / 501 底盘64件 B：另做马达下梁

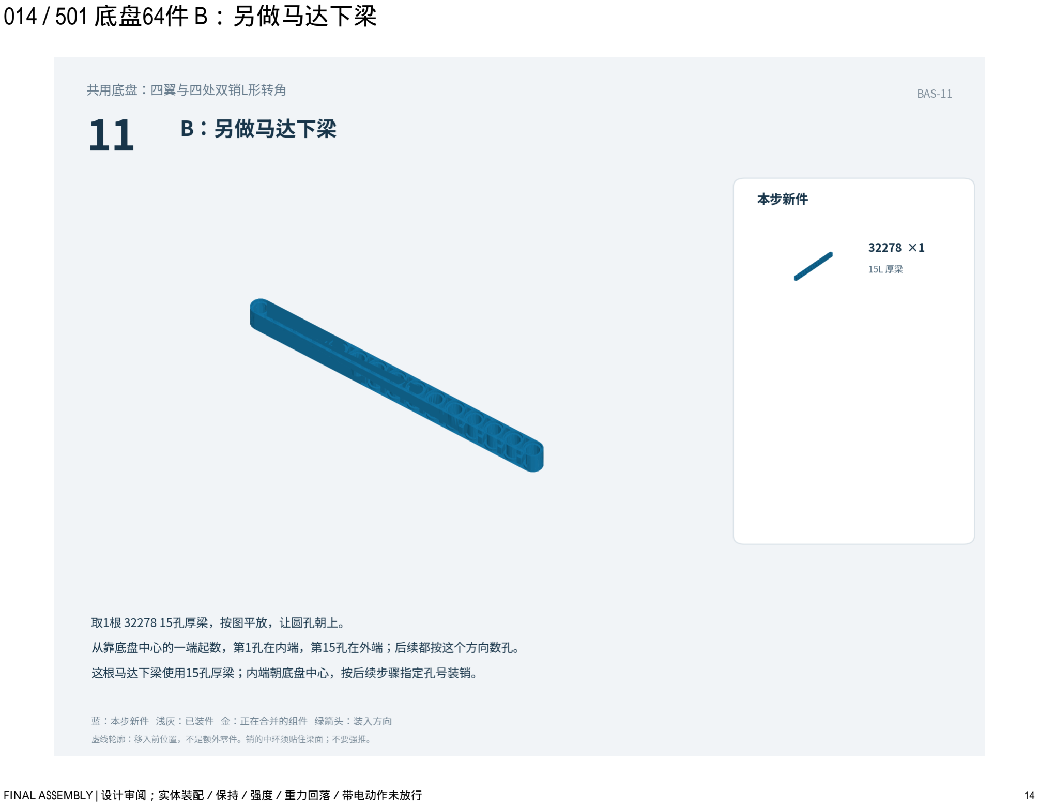
[picture p70: page 14]

## 015 / 501 底盘64件 B：马达下梁两根黑销

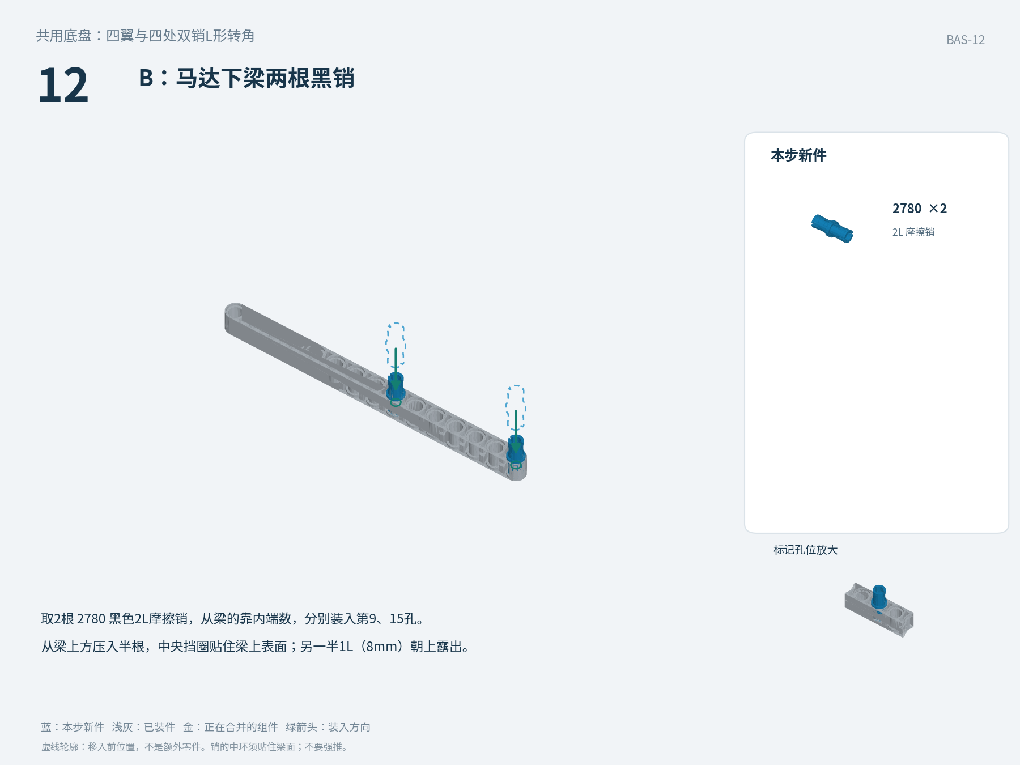
[picture p71: page 15]

## 016 / 501 底盘64件 B：马达下梁两根蓝销

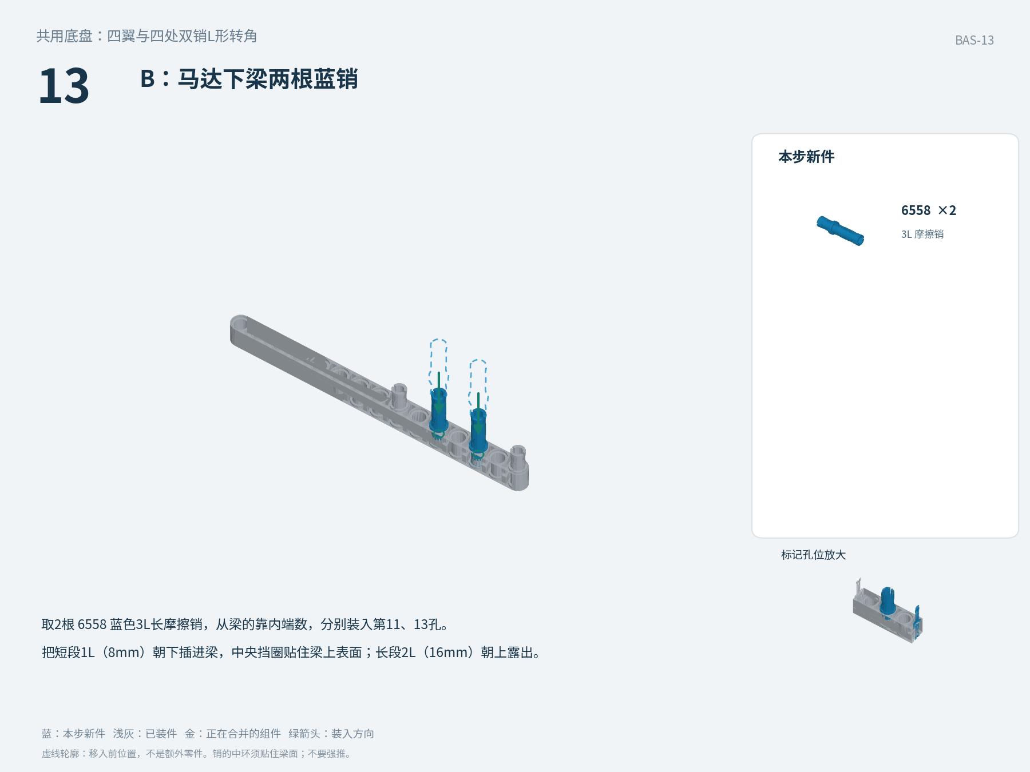
[picture p72: page 16]

## 017 / 501 底盘64件 B：预留第二处L梁黑销

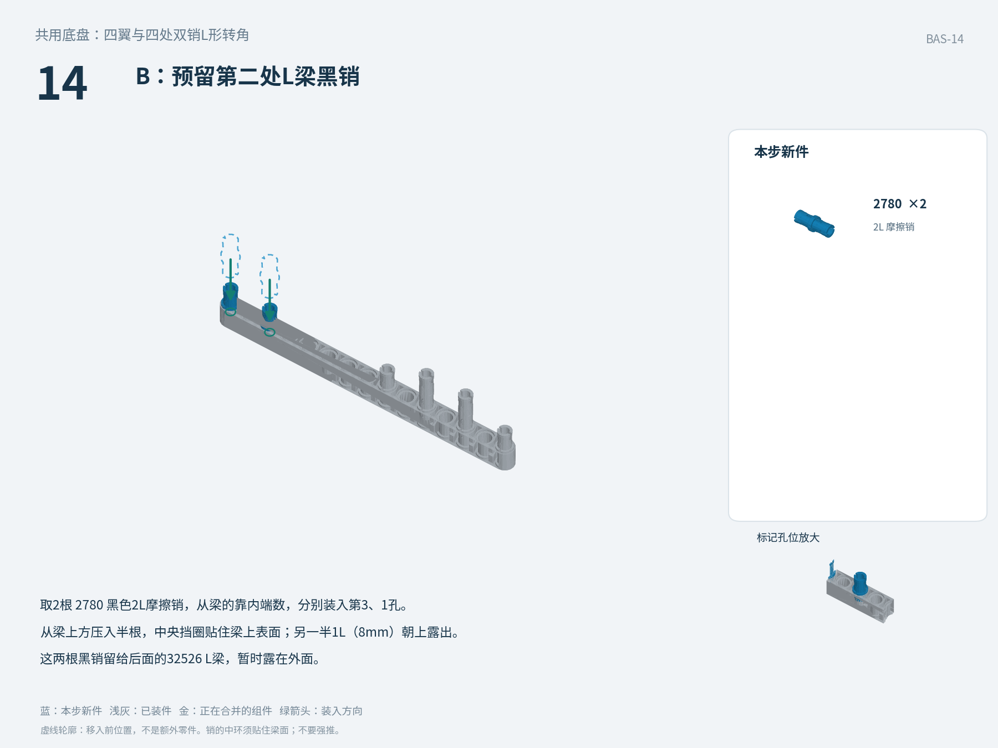
[picture p73: page 17]

## 018 / 501 底盘64件 B：压下大框，合成第二翼

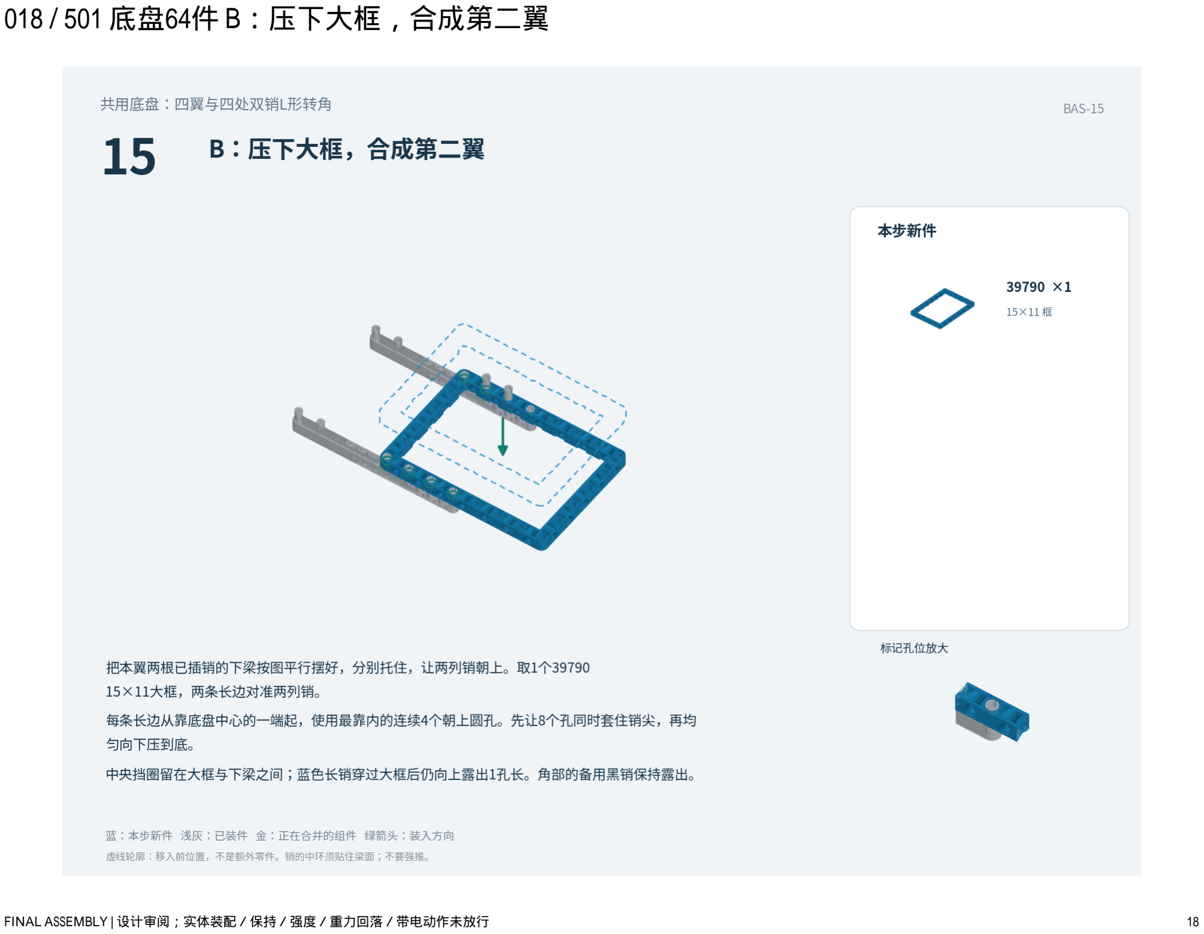
[picture p74: page 18]

## 019 / 501 底盘64件 C：摆好第一根 15L 梁

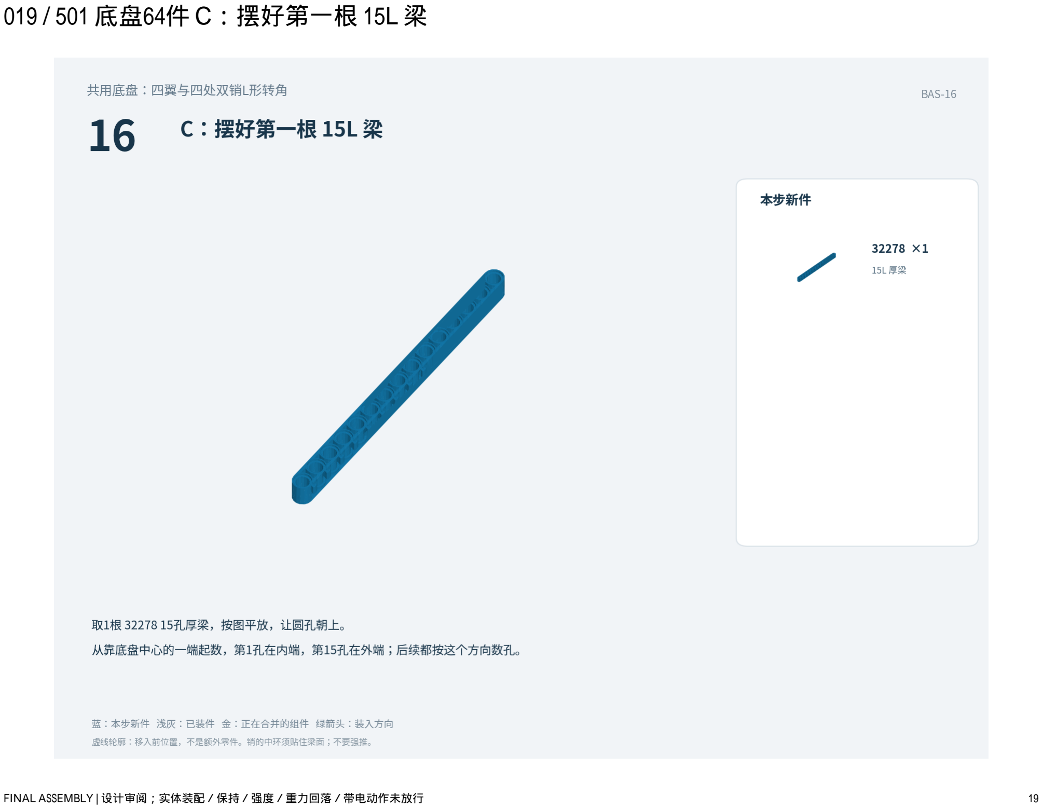
[picture p75: page 19]

## 020 / 501 底盘64件 C：第一根下梁预装四根黑销

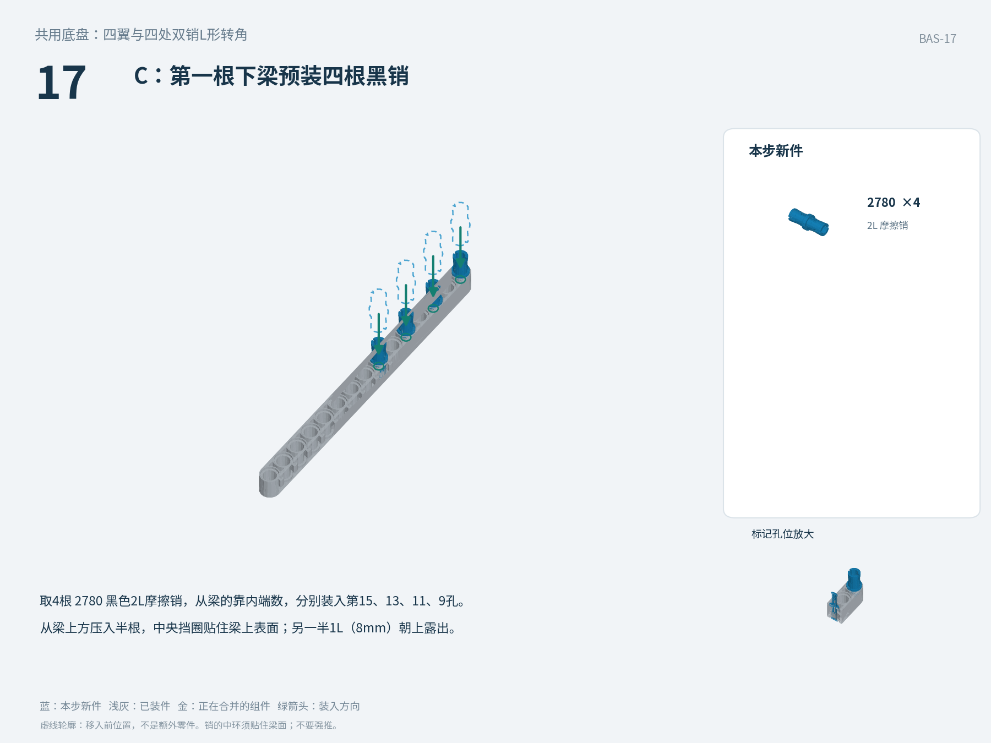
[picture p76: page 20]

## 021 / 501 底盘64件 C：预留与 B 翼连接的两销

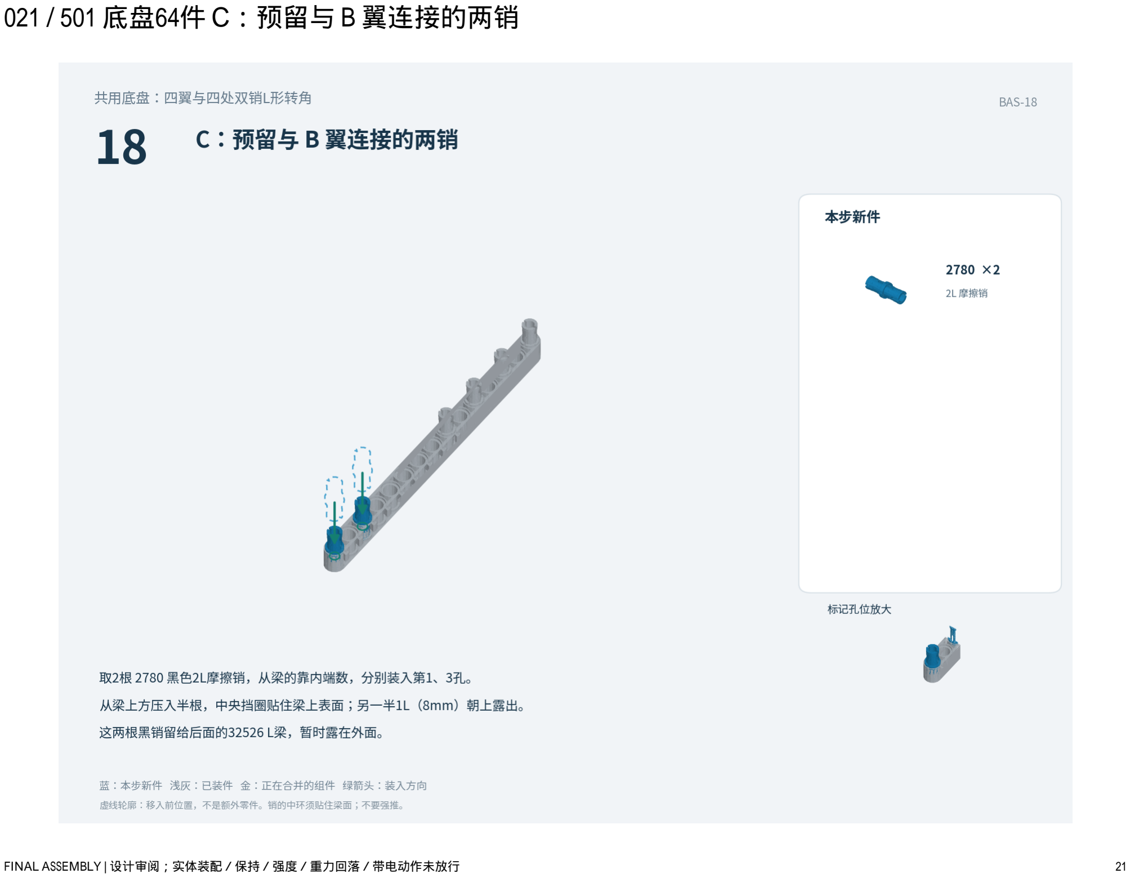
[picture p77: page 21]

## 022 / 501 底盘64件 C：另做马达下梁

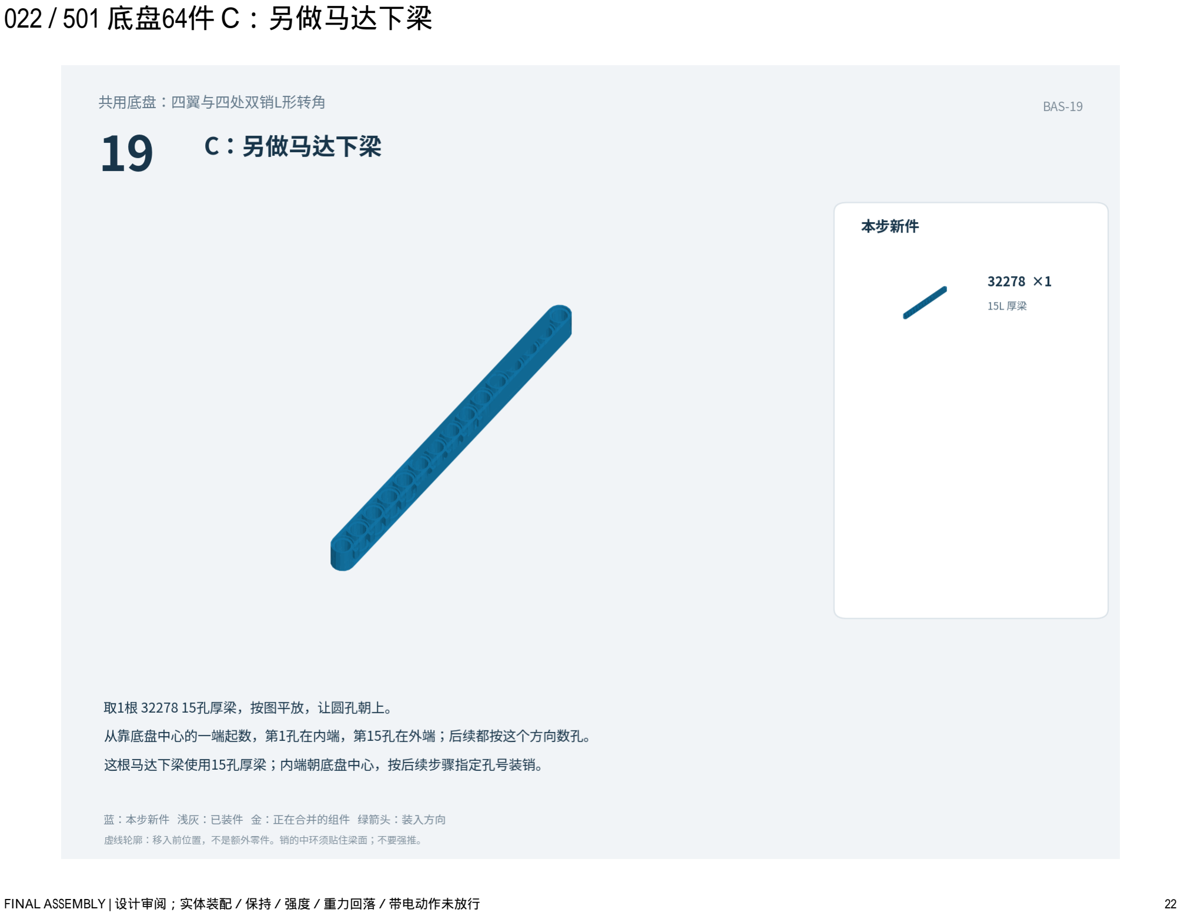
[picture p78: page 22]

## 023 / 501 底盘64件 C：马达下梁两根黑销

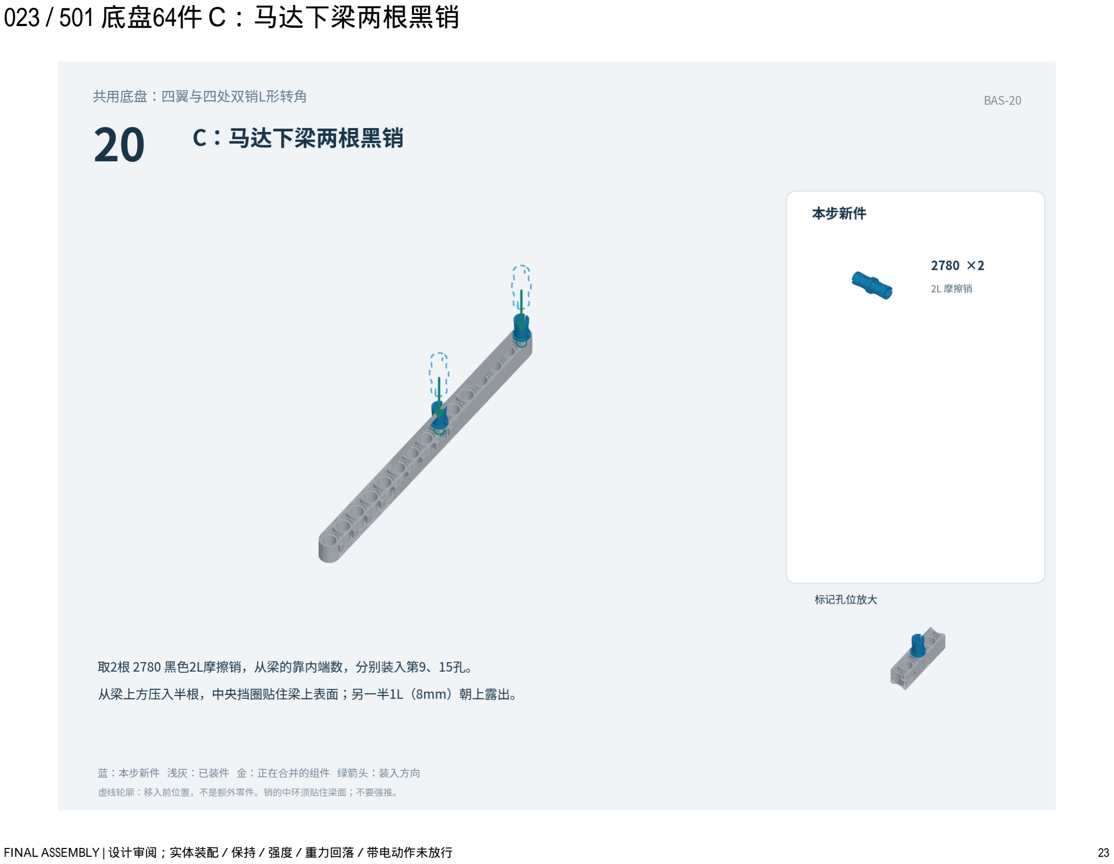
[picture p79: page 23]

## 024 / 501 底盘64件 C：马达下梁两根蓝销

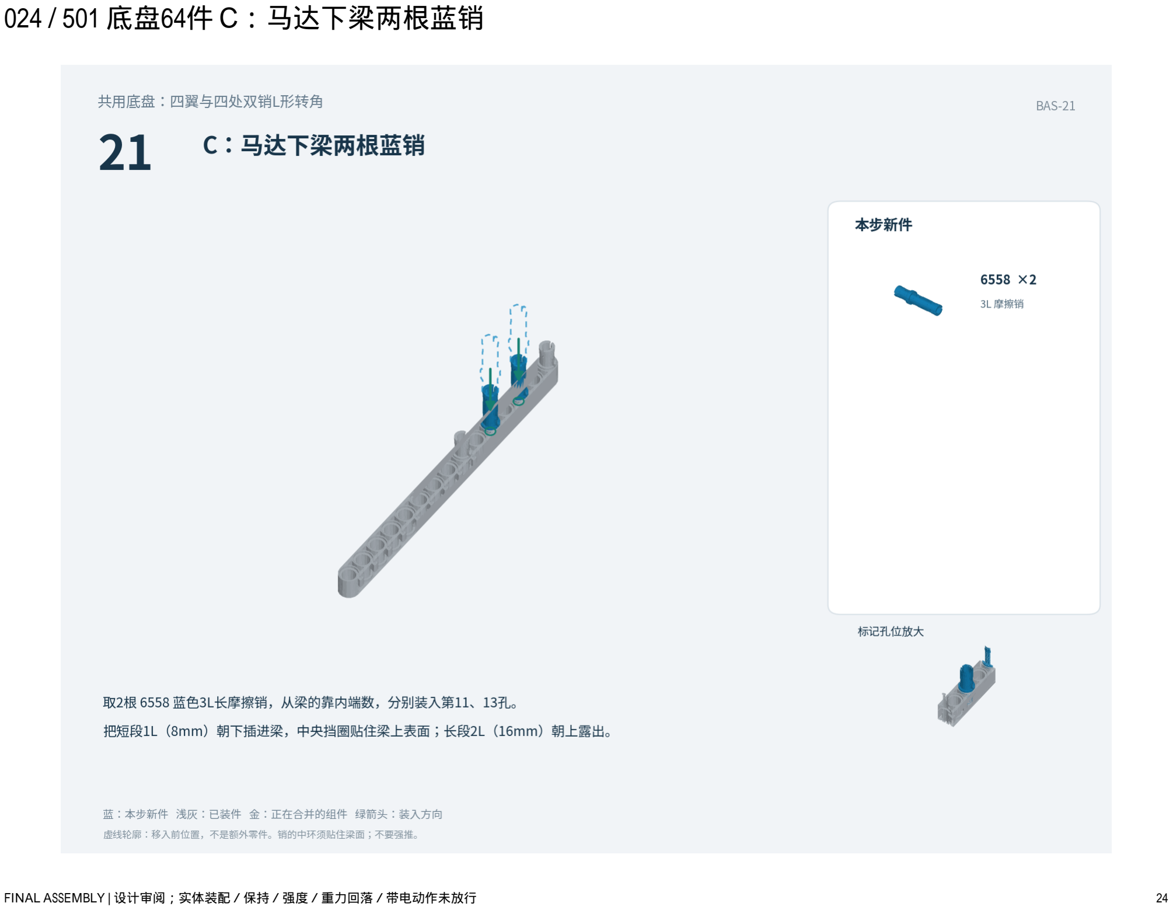
[picture p80: page 24]

## 025 / 501 底盘64件 C：预留第三处L梁黑销

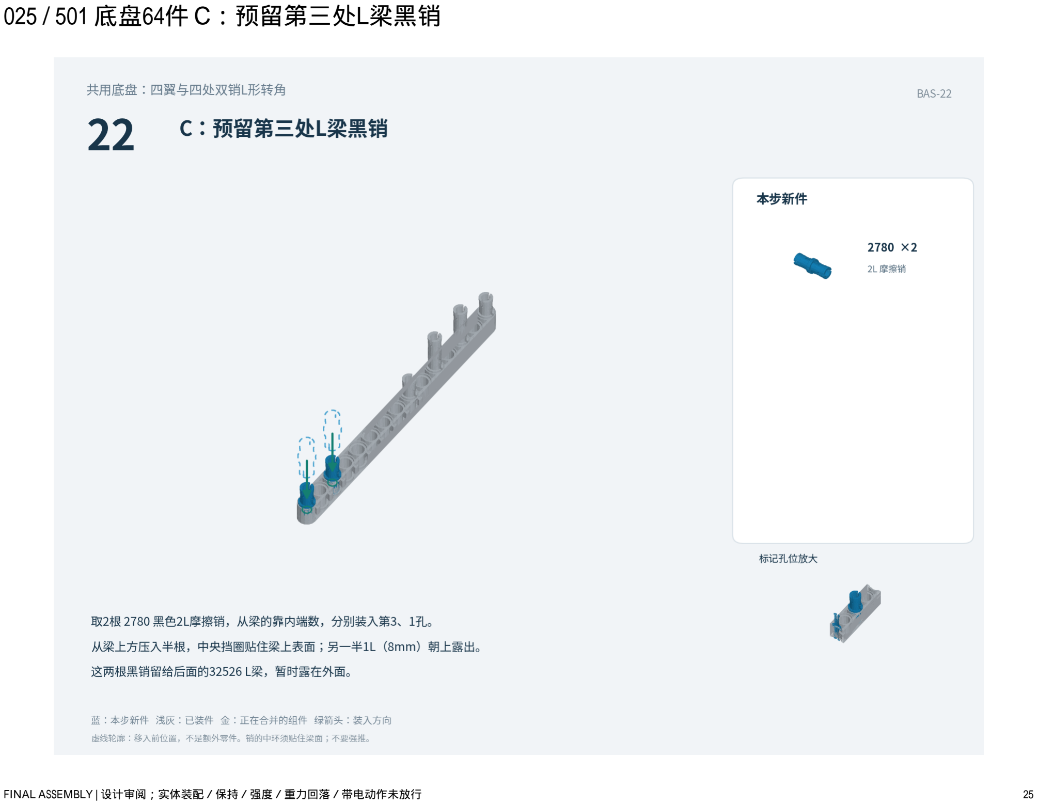
[picture p81: page 25]

## 026 / 501 底盘64件 C：压下大框，合成第三翼

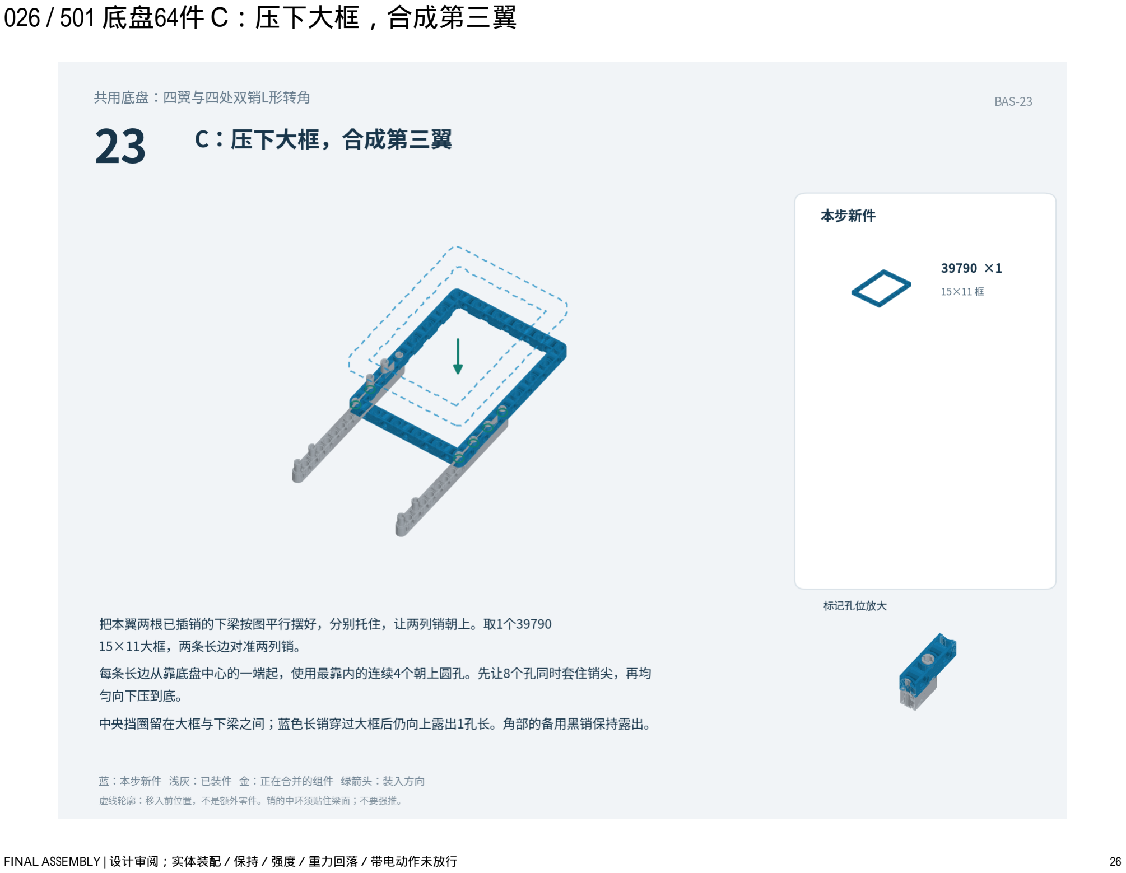
[picture p82: page 26]

## 027 / 501 底盘64件 D：摆好 15L 下梁

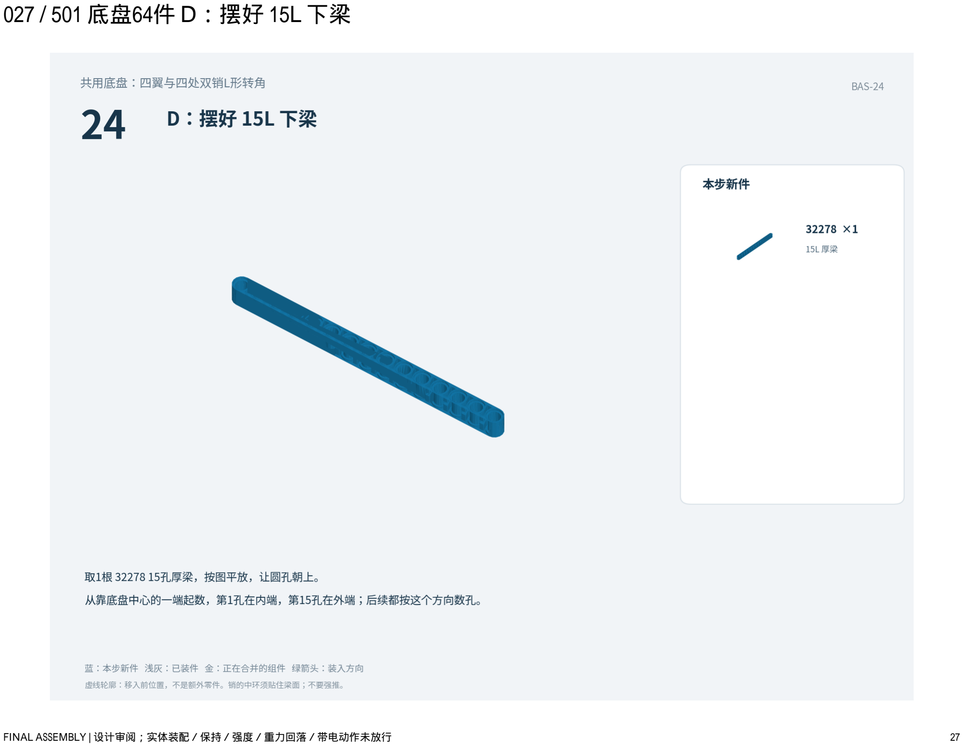
[picture p83: page 27]

## 028 / 501 底盘64件 D：15L 下梁预装四根黑销

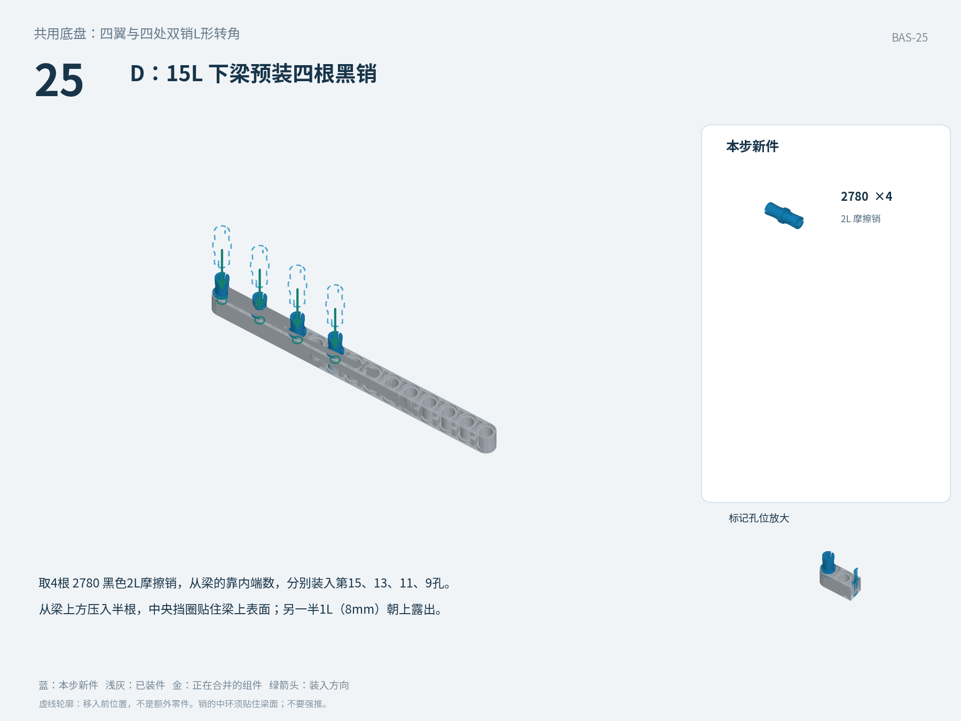
[picture p84: page 28]

## 029 / 501 底盘64件 D：预留与 C 翼连接的两销


## 030 / 501 底盘64件 D：另做 15L 马达下梁

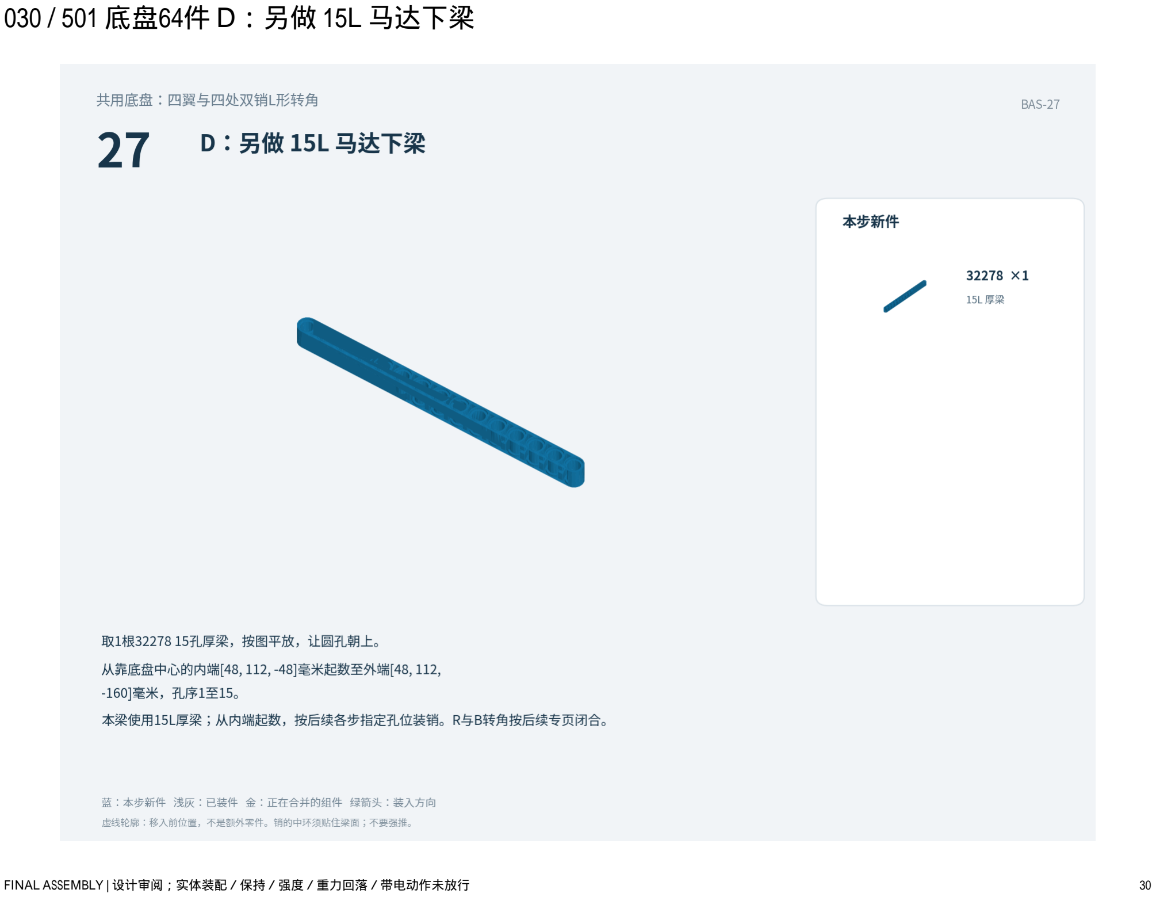
[picture p85: page 30]

## 031 / 501 底盘64件 D：15L 马达下梁两根黑销


## 032 / 501 底盘64件 D：15L 马达下梁两根蓝销

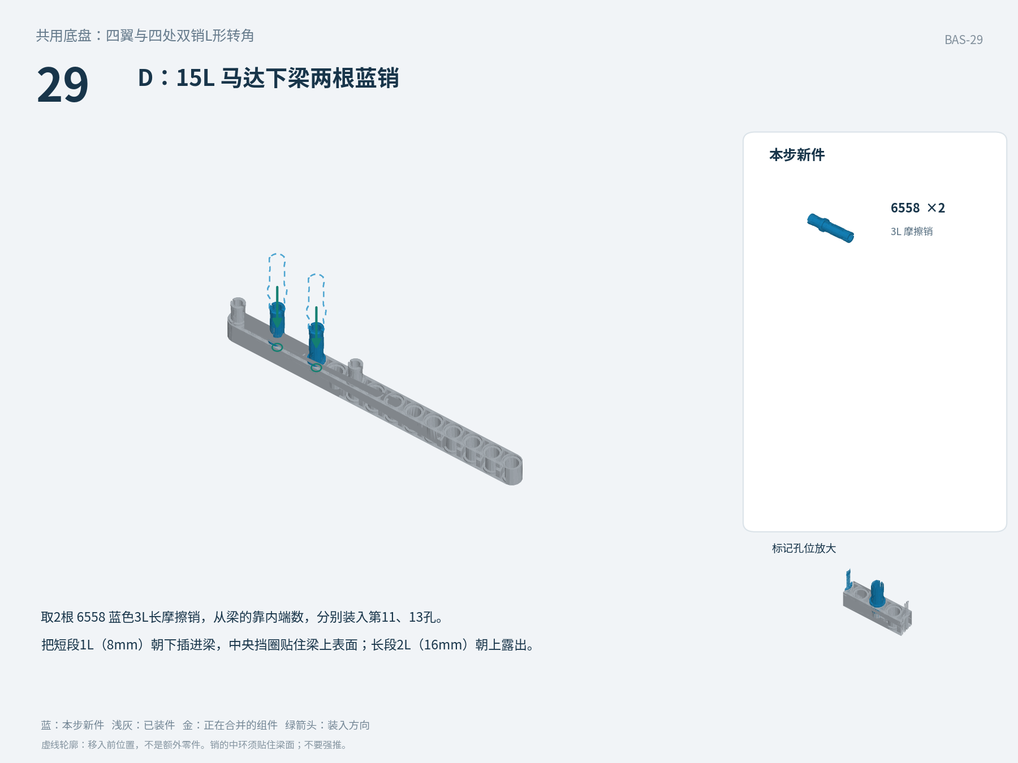
[picture p86: page 32]

## 033 / 501 底盘64件 D：压下大框，合成第四翼

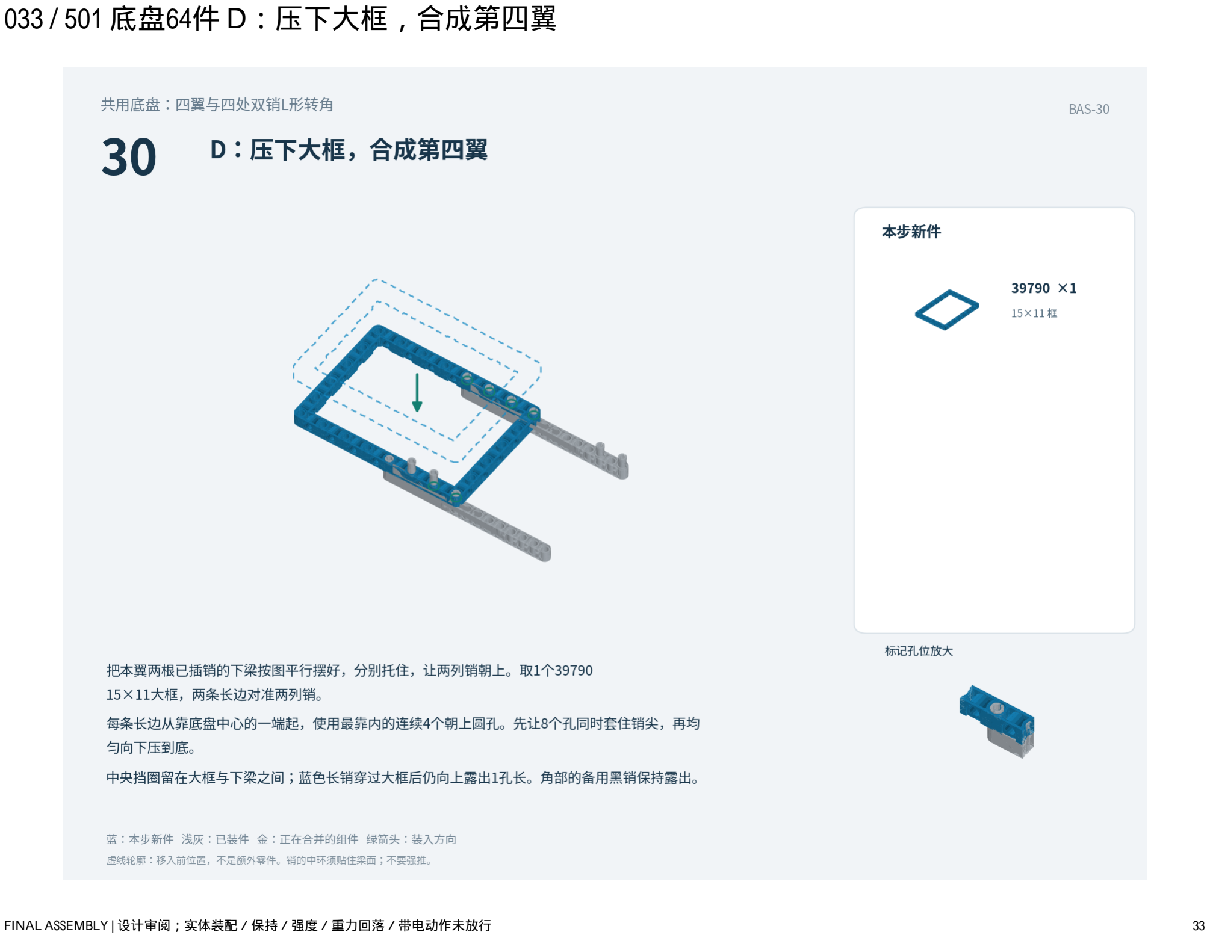
[picture p87: page 33]

## 034 / 501 底盘64件 连接A、B两翼：装第一件L梁

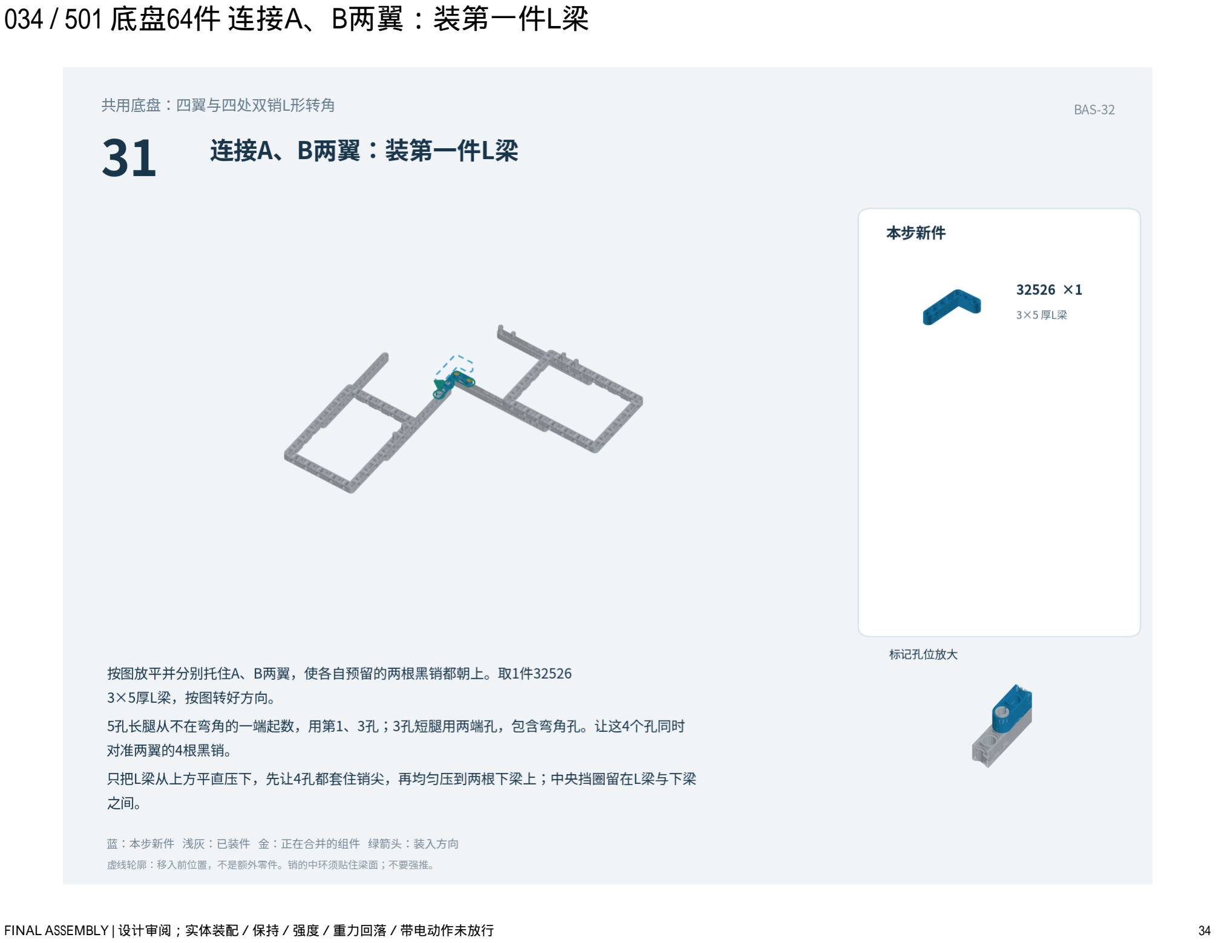
[picture p88: page 34]

## 035 / 501 底盘64件 接上C翼：装第二件L梁

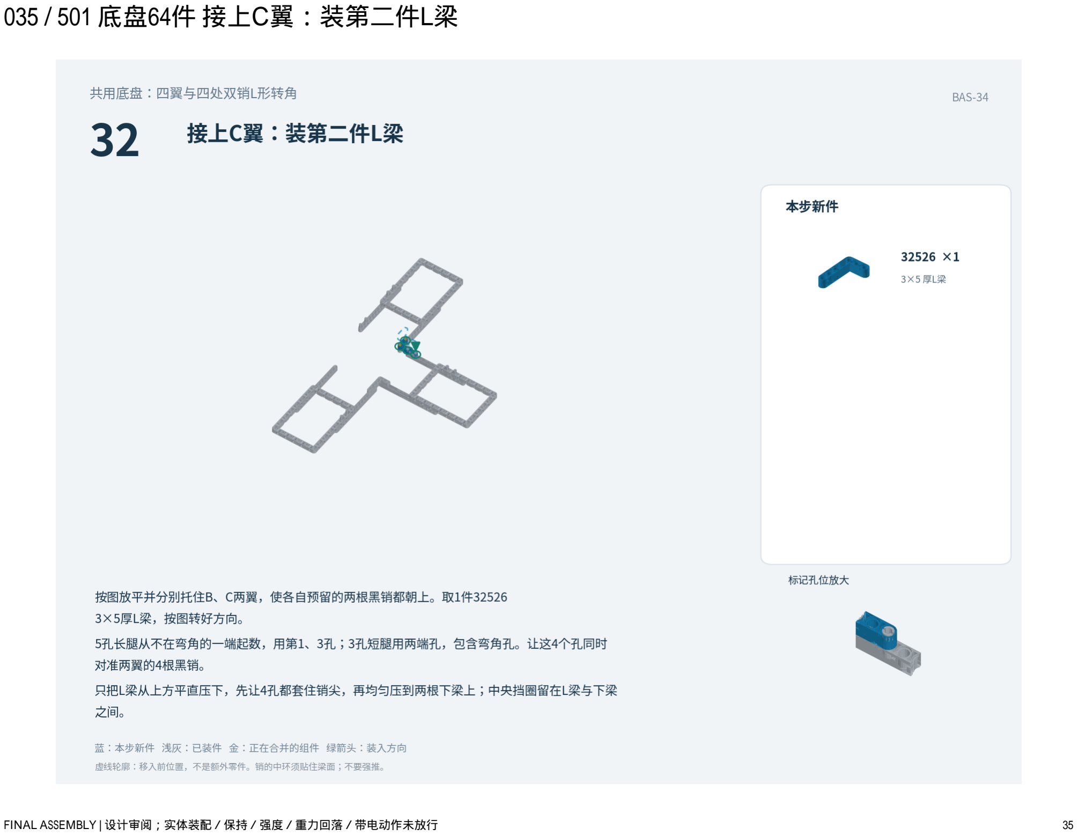
[picture p89: page 35]

## 036 / 501 底盘64件 接上D翼：59件临时开口底盘

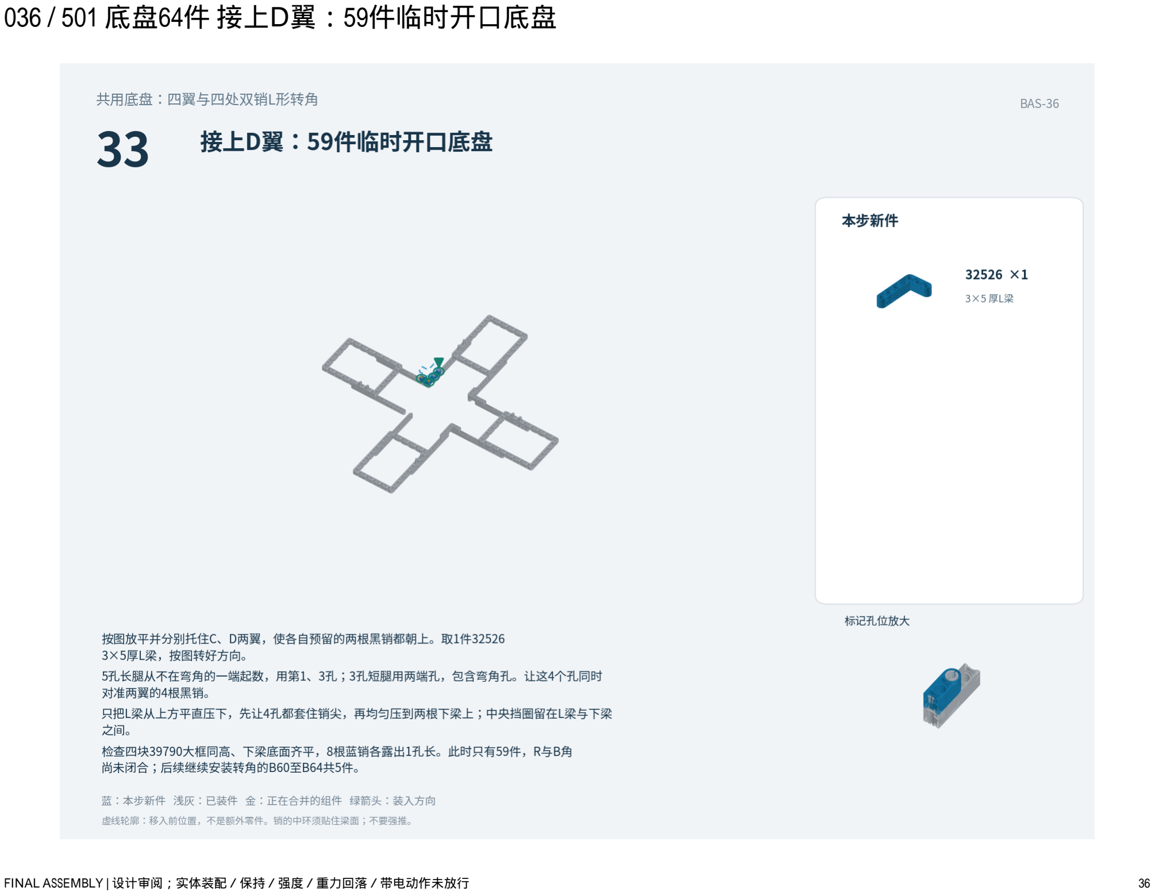
[picture p90: page 36]

## 037 / 501 底盘64件 R与B转角：预装四根黑销

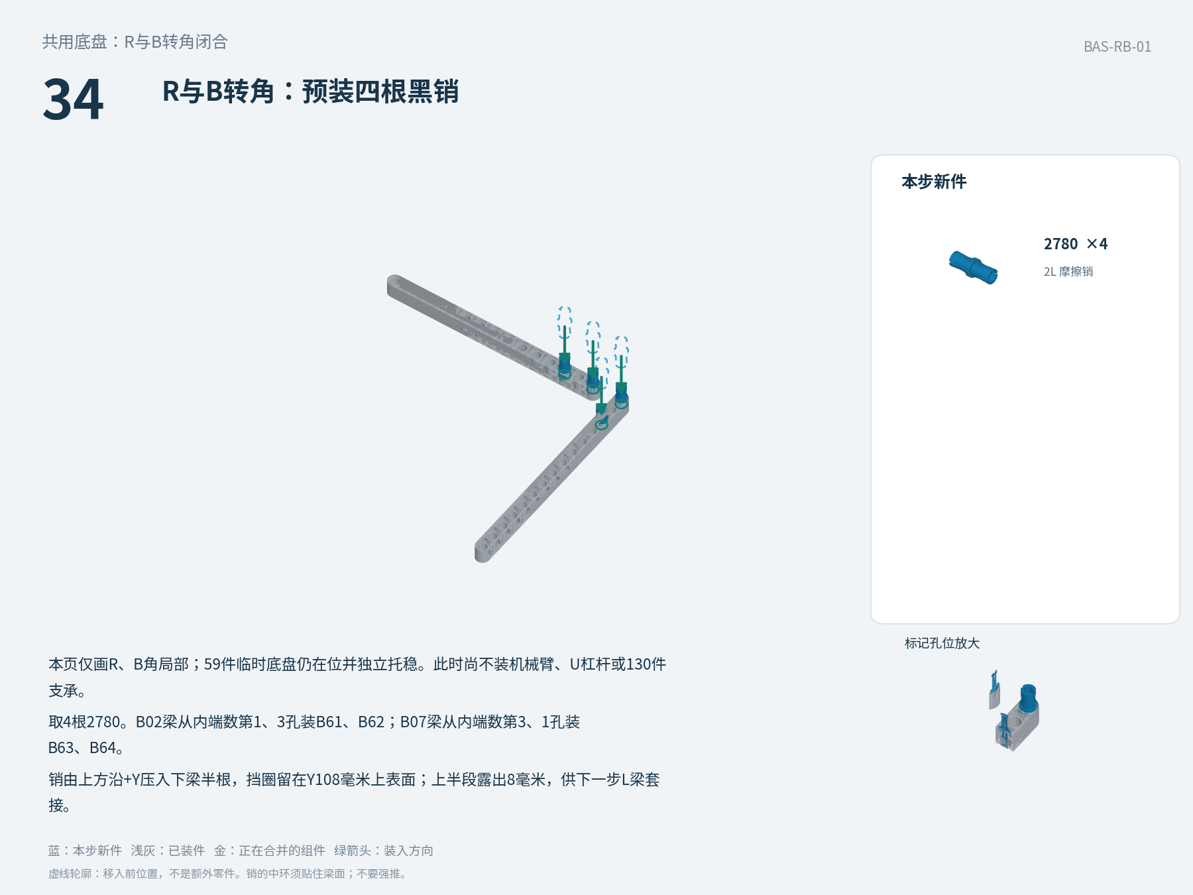
[picture p91: page 37]

## 038 / 501 底盘64件 R与B转角：装入第四根L梁

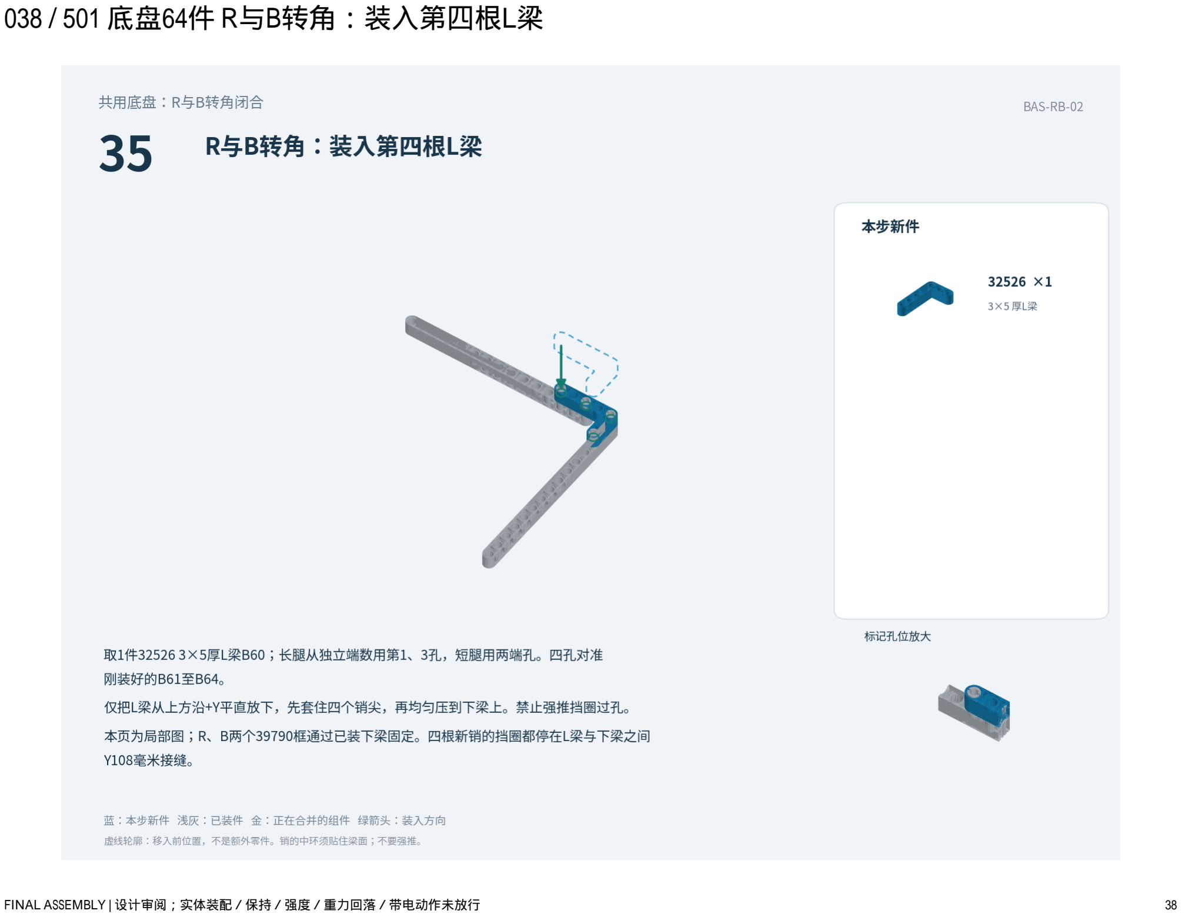
[picture p92: page 38]

## 039 / 501 底盘64件 四个39790框闭合：64件底盘核对

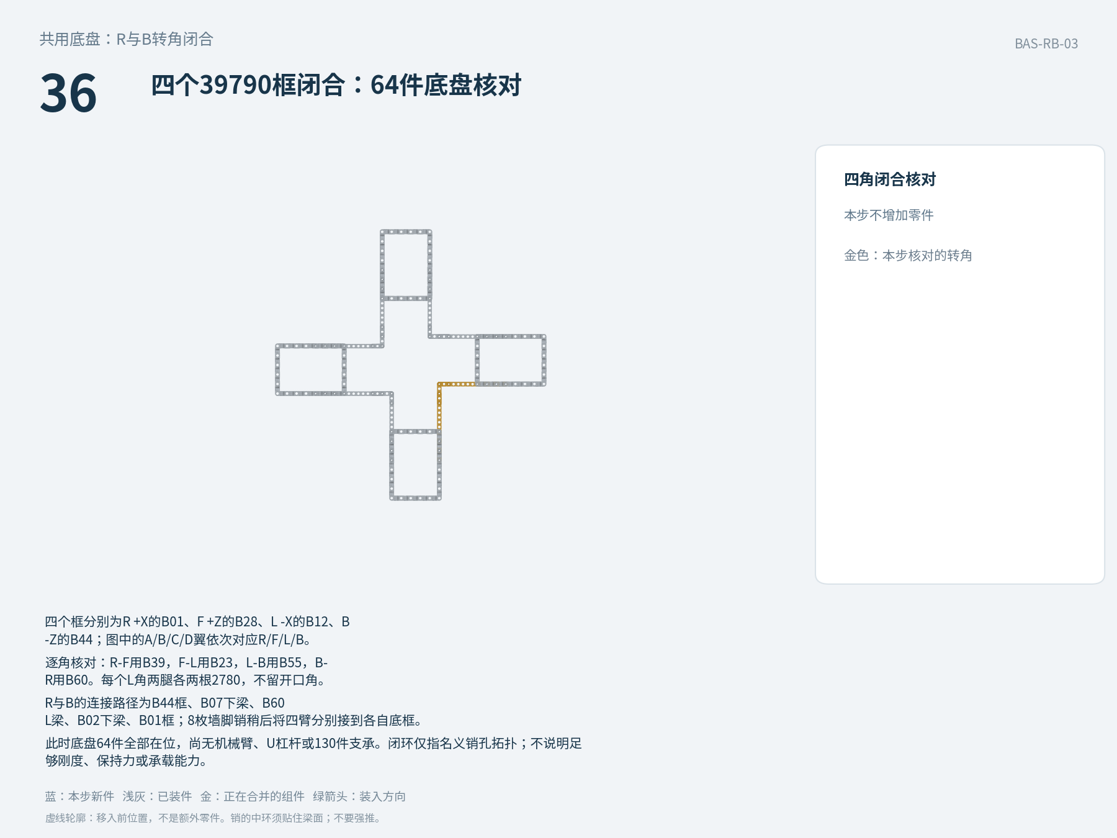
[picture p93: page 39]

## 040 / 501 四臂接口 墙脚连接销与底盘接口定位参照

共8×2780；每臂2枚

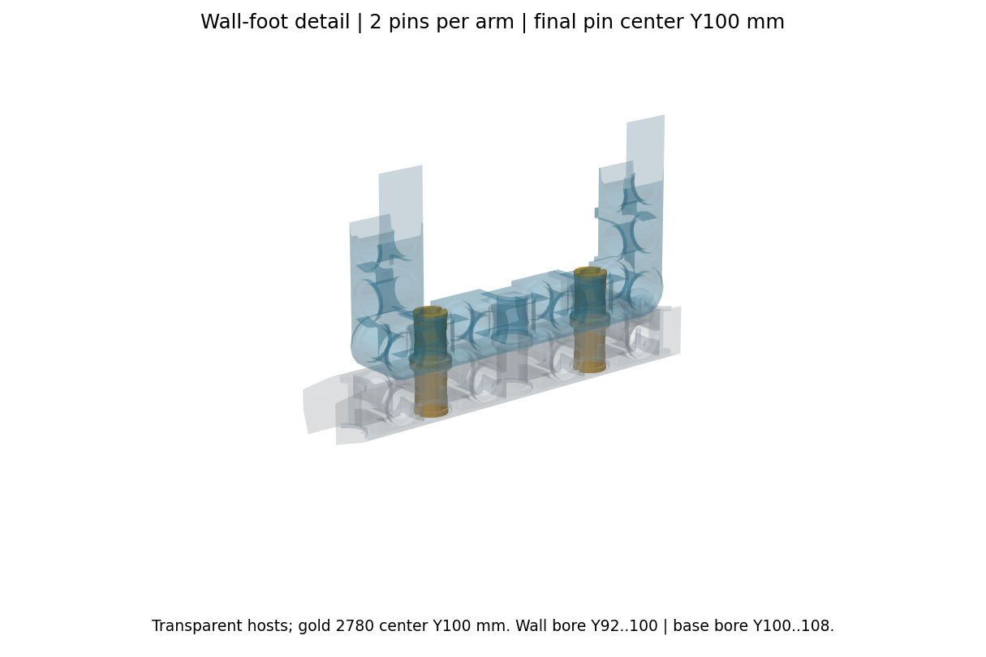
[picture p94: figure]

1. 局部图为L臂实际墙64179、底盘39790和两枚2780。其余三 臂绕竖直Y轴变换，向下均为+Y；图中省略不相关零件。
2. 销中心位于Y100毫米。墙孔占Y92至100毫米，底盘孔占 Y100至108毫米，销两侧各配合8毫米，挡环位于Y100接缝。
3. 此页为接口定位参照。后续逐件搭墙时将半插这两枚墙脚 销；在后续臂接入底盘时核对接缝。最终孔位已做名义核对 ，实际接近空间、插入力及保持力仍待验证。

核对：R、L、F、B各两枚，共8枚；够不到或需要强推挡环 过孔即停。

真实LDraw网格；爆炸间距仅用于识别，不代表装配间隙或已验证路径。

## 041 / 501 R 墙架／舵机架逐件搭建 R 从散件开始：放好竖墙下框

1×64179

1. 本页组装尚未接底盘的R 右臂，用独立夹具托稳。A/B和 ±Z为本头局部坐标。
2. 每臂从167个清单单件开始，包括成品电机和舵机；没有 预装核心或隐藏轴组。逐项取件，81侧梁和84销留到底盘阶 段。
3. 取第一块64179作为最下层框架，墙面在YZ平面，长边沿 Z。用夹具托住，后续向-Y上方逐层搭墙。
4. 本册覆盖全部清单件的装配顺序，不拆成品电机/舵机内 部；名义几何不等于实体装配通过。

核对：本步仅1块下框#3，孔向和编号与图一致。

真实LDraw网格；爆炸间距仅用于识别，不代表装配间隙或已验证路径。

## 042 / 501 R 墙架／舵机架逐件搭建 R 竖墙：下框上缘预插三销

3×2780

1. 本页组装尚未接底盘的R 右臂，用独立夹具托稳。A/B和 ±Z为本头局部坐标。
2. 取三根2780，从-Y上方沿+Y向下框#3上缘各插半根，位置 为局部Z=-16、0、+16毫米。
3. 中央挡圈留在上缘外面；中框未装，不能把销肩推过两层 孔。

核对：三根等高，另一半朝-Y外露。

真实LDraw网格；爆炸间距仅用于识别，不代表装配间隙或已验证路径。

## 043 / 501 R 墙架／舵机架逐件搭建 R 竖墙：压上中框

1×64179

1. 本页组装尚未接底盘的R 右臂，用独立夹具托稳。A/B和 ±Z为本头局部坐标。
2. 取第二块64179，长边沿Z，与下框保持同一墙面。
3. 从-Y上方沿+Y将中框下缘的三孔同时套住#7-9，均匀压到 挡圈。

核对：两框接缝平直，三销都连接相邻框。

真实LDraw网格；爆炸间距仅用于识别，不代表装配间隙或已验证路径。

## 044 / 501 R 墙架／舵机架逐件搭建 R 竖墙：中框上缘预插三销

3×2780

1. 本页组装尚未接底盘的R 右臂，用独立夹具托稳。A/B和 ±Z为本头局部坐标。
2. 从-Y上方沿+Y向中框#2上缘预插三根2780半根。
3. 仍用Z=-16、0、+16毫米三个位置，保留挡圈在框外。

核对：三个销尖朝-Y。

真实LDraw网格；爆炸间距仅用于识别，不代表装配间隙或已验证路径。

## 045 / 501 R 墙架／舵机架逐件搭建 R 竖墙：压上顶框

1×64179

1. 本页组装尚未接底盘的R 右臂，用独立夹具托稳。A/B和 ±Z为本头局部坐标。
2. 顶框64179长边沿Z，墙面与下面两框齐平。
3. 从-Y沿+Y套住#4-6三销；三块框的开口都保持畅通。

核对：三框九件完整，后续转盘放入最上框开口。

真实LDraw网格；爆炸间距仅用于识别，不代表装配间隙或已验证路径。

## 046 / 501 R 墙架／舵机架逐件搭建 R 墙脚：先半插两枚接口销

2×2780

1. 本页组装尚未接底盘的R 右臂，用独立夹具托稳。A/B和 ±Z为本头局部坐标。
2. 将墙倒置支承，从最下框#3底缘沿-Y各插半根2780。
3. 中央挡圈位于最终墙/底盘接缝Y100毫米；另一半朝+Y。 此时不取底盘。

核对：两枚销随墙保留，落底盘时不重复取件。

真实LDraw网格；爆炸间距仅用于识别，不代表装配间隙或已验证路径。

## 047 / 501 R 墙架／舵机架逐件搭建 R 马达：识别成品本体

1×95658

1. 本页组装尚未接底盘的R 右臂，用独立夹具托稳。A/B和 ±Z为本头局部坐标。
2. 取95658成品马达，保持断电，电线避开孔位。
3. 输出轴线沿X，本体在-Z侧；按图识别底面三圆孔和颈部 圆孔，不拆电机内部。

核对：型号与朝向一致，孔位没有被线缆遮住。

真实LDraw网格；爆炸间距仅用于识别，不代表装配间隙或已验证路径。

## 048 / 501 R 墙架／舵机架逐件搭建 R 马达底部：三枚销先入本体

3×2780

1. 本页组装尚未接底盘的R 右臂，用独立夹具托稳。A/B和 ±Z为本头局部坐标。
2. 把马达底面朝上，三孔沿X排列。
3. 每孔一根2780，只插半根，挡圈留在本体外侧；三销最终 向+Y露出。

核对：三销在同一平面。

真实LDraw网格；爆炸间距仅用于识别，不代表装配间隙或已验证路径。

## 049 / 501 R 墙架／舵机架逐件搭建 R 马达底块：第一根五孔梁

1×32316

1. 本页组装尚未接底盘的R 右臂，用独立夹具托稳。A/B和 ±Z为本头局部坐标。
2. 取32316五孔梁，长向沿X。
3. 从+Y沿-Y使第2、3、4孔套住三枚底销，压至挡圈。

核对：第1、5孔保持空着。

真实LDraw网格；爆炸间距仅用于识别，不代表装配间隙或已验证路径。

## 050 / 501 R 墙架／舵机架逐件搭建 R 马达底块：两端预插销

2×2780

1. 本页组装尚未接底盘的R 右臂，用独立夹具托稳。A/B和 ±Z为本头局部坐标。
2. 在第一根五孔梁第1、5孔，从+Y沿-Y各插半根2780。
3. 挡圈留在梁外，露出半根给第二层梁。

核对：两销间距四孔距。

真实LDraw网格；爆炸间距仅用于识别，不代表装配间隙或已验证路径。

## 051 / 501 R 墙架／舵机架逐件搭建 R 马达底块：第二根五孔梁

1×32316

1. 本页组装尚未接底盘的R 右臂，用独立夹具托稳。A/B和 ±Z为本头局部坐标。
2. 第二根32316与第一根平行对齐。
3. 从+Y沿-Y套住两端销，形成两层底块；中间孔保留给底 盘接口。

核对：两层梁贴合，无销肩穿过闭合双层。

真实LDraw网格；爆炸间距仅用于识别，不代表装配间隙或已验证路径。

## 052 / 501 R 墙架／舵机架逐件搭建 R 马达颈部：先放长短两销

1×2780；1×6558

1. 本页组装尚未接底盘的R 右臂，用独立夹具托稳。A/B和 ±Z为本头局部坐标。
2. 颈部上圆孔放6558#18，短段向-X入本体，挡肩留外；长 段向+X。
3. 下圆孔放2780#19半根；中间十字孔不要误用。

核对：上蓝长销、下黑短销均露出到同侧。

真实LDraw网格；爆炸间距仅用于识别，不代表装配间隙或已验证路径。

## 053 / 501 R 墙架／舵机架逐件搭建 R 马达前架：竖装三孔梁

1×32523

1. 本页组装尚未接底盘的R 右臂，用独立夹具托稳。A/B和 ±Z为本头局部坐标。
2. 取32523三孔梁，长向沿Y，孔轴沿X。
3. 从+X沿-X套上#18/#19，分别使用上下两孔，中孔保持空。

核对：三孔梁贴住销肩。

真实LDraw网格；爆炸间距仅用于识别，不代表装配间隙或已验证路径。

## 054 / 501 R 墙架／舵机架逐件搭建 R 马达前架：中孔预插黑销

1×2780

1. 本页组装尚未接底盘的R 右臂，用独立夹具托稳。A/B和 ±Z为本头局部坐标。
2. 在三孔梁中孔，从+X沿-X插入2780半根。
3. 露出半根向+X，给下方横梁使用。

核对：不要占用颈部十字孔。

真实LDraw网格；爆炸间距仅用于识别，不代表装配间隙或已验证路径。

## 055 / 501 R 墙架／舵机架逐件搭建 R 马达前架：接十一孔横梁

1×32525

1. 本页组装尚未接底盘的R 右臂，用独立夹具托稳。A/B和 ±Z为本头局部坐标。
2. 32525长向沿Z，向墙体伸出。
3. 第1孔从+X沿-X套住上方#18长销的剩余段；三孔竖梁与横 梁各占一孔厚。

核对：蓝销长段连接两根梁。

真实LDraw网格；爆炸间距仅用于识别，不代表装配间隙或已验证路径。

## 056 / 501 R 墙架／舵机架逐件搭建 R 马达前架：接七孔横梁

1×32524

1. 本页组装尚未接底盘的R 右臂，用独立夹具托稳。A/B和 ±Z为本头局部坐标。
2. 32524七孔梁与十一孔梁平行。
3. 第1孔从+X沿-X套住中间#21黑销。

核对：两横梁分别位于局部Y16、24毫米。

真实LDraw网格；爆炸间距仅用于识别，不代表装配间隙或已验证路径。

## 057 / 501 R 墙架／舵机架逐件搭建 R 马达接墙：四销先入横梁

4×2780

1. 本页组装尚未接底盘的R 右臂，用独立夹具托稳。A/B和 ±Z为本头局部坐标。
2. 从马达端数，十一孔梁第6、8、10孔接#30/#31/#32；七孔 梁第6孔接#33。
3. 四根2780从+X沿-X半插横梁，挡圈留在梁前；销尖向+X。

核对：三销接顶框，一销接中框；输出轴组尚未装。

真实LDraw网格；爆炸间距仅用于识别，不代表装配间隙或已验证路径。

## 058 / 501 R 墙架／舵机架逐件搭建 R 马达接墙：平推合拢

本步合并／核对，无新增件

1. 本页组装尚未接底盘的R 右臂，用独立夹具托稳。A/B和 ±Z为本头局部坐标。
2. 取刚搭好的完整马达组件，保持四销在横梁内，不再取销。
3. 从墙背面局部-X沿+X平推，四销同时进入墙孔；墙与马 达继续由夹具托住。

核对：四销肩留在横梁/墙之间；不装输出轴。

真实LDraw网格；爆炸间距仅用于识别，不代表装配间隙或已验证路径。

## 059 / 501 R 墙架／舵机架逐件搭建 R 舵机平台：平放两根十五孔梁

2×32278

1. 本页组装尚未接底盘的R 右臂，用独立夹具托稳。A/B和 ±Z为本头局部坐标。
2. 两根32278平行，长向沿X，相距四孔距。
3. 以夹具保持两梁前后端齐平；此时它们尚未连接。

核对：梁中心分别为Z0、32毫米，孔轴沿Y。

真实LDraw网格；爆炸间距仅用于识别，不代表装配间隙或已验证路径。

## 060 / 501 R 墙架／舵机架逐件搭建 R 平台前部：六枚销先入底梁

6×2780

1. 本页组装尚未接底盘的R 右臂，用独立夹具托稳。A/B和 ±Z为本头局部坐标。
2. 两根15L从最后端向前数：+Z梁第9、11、13、15孔各半插 2780；Z0梁第9、15孔各半插一根。
3. 销由-Y上方沿+Y插入梁，挡圈留在梁上；两蓝长销位置 暂空。

核对：4＋2共六销；全部露出朝-Y。

真实LDraw网格；爆炸间距仅用于识别，不代表装配间隙或已验证路径。

## 061 / 501 R 墙架／舵机架逐件搭建 R 平台前部：压上水平框架

1×64179

1. 本页组装尚未接底盘的R 右臂，用独立夹具托稳。A/B和 ±Z为本头局部坐标。
2. 64179平放，长边沿X，前端与两根十五孔梁对齐。
3. 从-Y沿+Y压到六枚销上，保持长销专用两孔空着。

核对：框架与两梁闭合，六销肩在夹层。

真实LDraw网格；爆炸间距仅用于识别，不代表装配间隙或已验证路径。

## 062 / 501 R 墙架／舵机架逐件搭建 R 舵机垫梁：先插三枚黑销

3×2780

1. 本页组装尚未接底盘的R 右臂，用独立夹具托稳。A/B和 ±Z为本头局部坐标。
2. 在+Z的15L底梁，从最后端孔向前数第2、6、7孔半插2780 ；它们对应稍后7L垫梁的第1、5、6孔。15L第1孔留给后横 梁。
3. 从-Y沿+Y装销，垫梁第2、4孔下方留给55615，不增贯穿 销。

核对：三销不占舵机耳销第3、7孔。

真实LDraw网格；爆炸间距仅用于识别，不代表装配间隙或已验证路径。

## 063 / 501 R 墙架／舵机架逐件搭建 R 舵机垫梁：压上七孔梁

1×32524

1. 本页组装尚未接底盘的R 右臂，用独立夹具托稳。A/B和 ±Z为本头局部坐标。
2. 取32524七孔梁，与底梁平行。
3. 从-Y沿+Y套住三销；从后端数第3、7孔保持空着。

核对：垫梁只由三枚黑销连接底梁。

真实LDraw网格；爆炸间距仅用于识别，不代表装配间隙或已验证路径。

## 064 / 501 R 墙架／舵机架逐件搭建 R 平台后横梁：两端预插销

2×2780

1. 本页组装尚未接底盘的R 右臂，用独立夹具托稳。A/B和 ±Z为本头局部坐标。
2. 两根十五孔梁各在最后一个孔从-Y沿+Y半插2780。
3. 销尖均向上，给横向五孔梁使用。

核对：两销同高，相距四孔距。

真实LDraw网格；爆炸间距仅用于识别，不代表装配间隙或已验证路径。

## 065 / 501 R 墙架／舵机架逐件搭建 R 平台后横梁：闭合长方形

1×32316

1. 本页组装尚未接底盘的R 右臂，用独立夹具托稳。A/B和 ±Z为本头局部坐标。
2. 32316五孔梁长向沿Z。
3. 从-Y沿+Y将两端孔套在#68/#69上，后框闭合。

核对：两梁前后都有横向连接。

真实LDraw网格；爆炸间距仅用于识别，不代表装配间隙或已验证路径。

## 066 / 501 R 墙架／舵机架逐件搭建 R 平台下方：装两个弯角连接器

2×55615

1. 本页组装尚未接底盘的R 右臂，用独立夹具托稳。A/B和 ±Z为本头局部坐标。
2. 两只55615的横臂顺X、竖臂朝+Y下方。
3. 从+Y下方向-Y压入：马达侧底梁倒数第2、4孔；舵机侧 倒数第3、5孔。使用连接器自带销，不另加销。

核对：两连接器竖臂孔沿Z，自带多余横销保持空置。

真实LDraw网格；爆炸间距仅用于识别，不代表装配间隙或已验证路径。

## 067 / 501 R 墙架／舵机架逐件搭建 R 推杆导向：先插两根蓝长销

2×6558

1. 本页组装尚未接底盘的R 右臂，用独立夹具托稳。A/B和 ±Z为本头局部坐标。
2. 从-Y沿+Y把6558长的两孔段穿平台框并插入Z0底梁。
3. 挡肩停在平台框上表面，短段朝-Y；导向框尚未装，销肩 不能穿过其底孔。

核对：长段连接平台两层，短段露出供导向框。

真实LDraw网格；爆炸间距仅用于识别，不代表装配间隙或已验证路径。

## 068 / 501 R 墙架／舵机架逐件搭建 R 推杆导向：最后压上竖框

1×64179

1. 本页组装尚未接底盘的R 右臂，用独立夹具托稳。A/B和 ±Z为本头局部坐标。
2. 64179竖立在XY平面，长向沿X，孔轴沿Z。
3. 从-Y沿+Y将底边两个侧孔套住#64/#65短段；导向圆孔朝 推杆轴线。

核对：导向框两销到肩，中央开口未被连杆或舵机封住。

真实LDraw网格；爆炸间距仅用于识别，不代表装配间隙或已验证路径。

## 069 / 501 R 墙架／舵机架逐件搭建 R 十字块：放入导向框开口

1×6536

1. 本页组装尚未接底盘的R 右臂，用独立夹具托稳。A/B和 ±Z为本头局部坐标。
2. 6536十字块圆孔在上，下面十字孔沿Z。
3. 舵机尚未装，把十字块从+Z沿-Z放入导向框中央开口， 以夹具托住；不靠推杆悬挂。

核对：框内名义余量约0.4毫米，遇阻停止，不磨件。

真实LDraw网格；爆炸间距仅用于识别，不代表装配间隙或已验证路径。

## 070 / 501 R 墙架／舵机架逐件搭建 R 十字块：穿入三号轴

1×4519

1. 本页组装尚未接底盘的R 右臂，用独立夹具托稳。A/B和 ±Z为本头局部坐标。
2. 4519三号轴从+Z沿-Z穿过下方十字孔。
3. -Z端留半孔给半轴套，+Z端留出连杆和另一只半轴套厚 度。

核对：轴不穿上方推杆圆孔。

真实LDraw网格；爆炸间距仅用于识别，不代表装配间隙或已验证路径。

## 071 / 501 R 墙架／舵机架逐件搭建 R 十字块：后侧半套定位

1×32123a

1. 本页组装尚未接底盘的R 右臂，用独立夹具托稳。A/B和 ±Z为本头局部坐标。
2. 从-Z沿+Z装32123a半轴套，贴住十字块后侧。
3. 十字块继续独立支承，不与导向框固连。

核对：后侧半套贴合而不挤压框架。

真实LDraw网格；爆炸间距仅用于识别，不代表装配间隙或已验证路径。

## 072 / 501 R 墙架／舵机架逐件搭建 R 舵机连杆：先接十字块端

1×32524

1. 本页组装尚未接底盘的R 右臂，用独立夹具托稳。A/B和 ±Z为本头局部坐标。
2. 32524七孔连杆的前端第1孔从+Z沿-Z套住三号轴。
3. 连杆直接贴十字块+Z面，不在两者中间加轴套；第7孔朝 舵机端且保持未连接。

核对：连杆在导向框外侧，舵机还未挡住来路。

真实LDraw网格；爆炸间距仅用于识别，不代表装配间隙或已验证路径。

## 073 / 501 R 墙架／舵机架逐件搭建 R 舵机连杆：外侧半套定位

1×32123a

1. 本页组装尚未接底盘的R 右臂，用独立夹具托稳。A/B和 ±Z为本头局部坐标。
2. 从+Z沿-Z套上32123a，贴住连杆外面。
3. 连杆远端继续由夹具支承，不提前接曲柄。

核对：半套4＋十字块8＋连杆8＋半套4＝24毫米，轴向零名 义余量；勿夹死连杆。

真实LDraw网格；爆炸间距仅用于识别，不代表装配间隙或已验证路径。

## 074 / 501 R 墙架／舵机架逐件搭建 R 舵机耳销：先短段入垫梁

2×6558

1. 本页组装尚未接底盘的R 右臂，用独立夹具托稳。A/B和 ±Z为本头局部坐标。
2. 两根6558短的一孔段从-Y沿+Y插入垫梁第3、7孔。
3. 挡肩留在垫梁上，长段向-Y；舵机未放，不能从上方把销 肩强推穿耳孔。

核对：两根蓝长销竖直，舵机来路保持空。

真实LDraw网格；爆炸间距仅用于识别，不代表装配间隙或已验证路径。

## 075 / 501 R 墙架／舵机架逐件搭建 R 舵机：机外核对成品本体

1×geekservo

1. 本页组装尚未接底盘的R 右臂，用独立夹具托稳。A/B和 ±Z为本头局部坐标。
2. 取成品geekservo，保持断电，暂不套入平台耳销。
3. 输出端朝图示连杆侧；先在机外接曲柄，再连同曲柄一起 落位，避免曲柄横向穿入被连杆挡住。
4. 舵机网格为近似外形，耳孔和输出配合必须对照实物核验。

核对：舵机单独支承，不拆本体内部。

真实LDraw网格；爆炸间距仅用于识别，不代表装配间隙或已验证路径。

## 076 / 501 R 墙架／舵机架逐件搭建 R 曲柄：机外条件定位后接舵机

1×41677

1. 本页组装尚未接底盘的R 右臂，用独立夹具托稳。A/B和 ±Z为本头局部坐标。
2. 41677曲柄从-Z沿+Z套向舵机输出端，末端孔仍不接连杆。
3. 仅在另行验证的断电输出轴位和接口匹配条件下自然套合 ；不能为追图示角度强扭舵机。
4. 近似舵机网格不证明真实输出花键/转接配合。未能自然 配合时保持待验证，不继续闭链。

核对：机外只接曲柄根部，整组独立支承。

真实LDraw网格；爆炸间距仅用于识别，不代表装配间隙或已验证路径。

## 077 / 501 R 墙架／舵机架逐件搭建 R 舵机与曲柄：整组沿耳销落位

本步合并／核对，无新增件

1. 本页组装尚未接底盘的R 右臂，用独立夹具托稳。A/B和 ±Z为本头局部坐标。
2. 取刚接好的舵机/曲柄两件组，保持相对方向，不重复取 件。
3. 从-Y沿+Y将舵机耳孔套住#73/#74两根蓝销长段，直到挡 肩；曲柄从连杆外侧经过，末端保持未连接。
4. 不能改成先落舵机、再横穿曲柄：已放好的连杆会挡住曲 柄入口。实际接口与耳孔遇阻立即停。

核对：两耳到肩、曲柄在连杆外侧，94/95仍未装。

真实LDraw网格；爆炸间距仅用于识别，不代表装配间隙或已验证路径。

## 078 / 501 R 墙架／舵机架逐件搭建 R 平台接墙：两枚销先入平台

2×2780

1. 本页组装尚未接底盘的R 右臂，用独立夹具托稳。A/B和 ±Z为本头局部坐标。
2. 平台仍未接墙，从前端+X沿-X向局部Z8、24毫米的端孔 半插2780，中间孔留空。已接舵机和曲柄仍保持在位。
3. 挡圈在平台前沿，露出半根向+X；这些销随后进入墙中 框，不穿闭合双层。

核对：两销轴线为X，不能与导向蓝销混用。

真实LDraw网格；爆炸间距仅用于识别，不代表装配间隙或已验证路径。

## 079 / 501 R 墙架／舵机架逐件搭建 R 平台接墙：从背面平推

本步合并／核对，无新增件

1. 本页组装尚未接底盘的R 右臂，用独立夹具托稳。A/B和 ±Z为本头局部坐标。
2. 取已搭平台、舵机、曲柄及连杆，省略的已接件仍在位； 继续用夹具托住连杆远端。
3. 从墙背面-X沿+X平推，两销进入中框；导向轴线与转盘 中心线保持同轴。

核对：平台和马达分别用各自销接墙，无重复取件。

真实LDraw网格；爆炸间距仅用于识别，不代表装配间隙或已验证路径。

## 080 / 501 R 墙架／舵机架逐件搭建 R 后竖撑：先给马达侧连接器插销

2×2780

1. 本页组装尚未接底盘的R 右臂，用独立夹具托稳。A/B和 ±Z为本头局部坐标。
2. 在马达侧55615#70的两孔，从-Z沿+Z半插两枚2780。
3. 挡圈留在-Z外面，露出销尖给9L竖梁。

核对：销位Y40、56毫米，两销向-Z露出。

真实LDraw网格；爆炸间距仅用于识别，不代表装配间隙或已验证路径。

## 081 / 501 R 墙架／舵机架逐件搭建 R 后竖撑：装马达侧九孔梁

1×40490

1. 本页组装尚未接底盘的R 右臂，用独立夹具托稳。A/B和 ±Z为本头局部坐标。
2. 40490竖向沿Y，从-Z沿+Z套住#79/#80。
3. 上方第2、4孔接两销，梁下端保持空，下一步接底脚。

核对：竖梁孔轴沿Z，底部第7、9孔可接近。

真实LDraw网格；爆炸间距仅用于识别，不代表装配间隙或已验证路径。

## 082 / 501 R 墙架／舵机架逐件搭建 R 后竖撑：底部弯角脚横插

1×55615

1. 本页组装尚未接底盘的R 右臂，用独立夹具托稳。A/B和 ±Z为本头局部坐标。
2. 55615底脚此时在机外，两个横销朝-Z。
3. 从+Z沿-Z把自带两销插入#78第7、9孔；底脚另外两销朝 +Y，留待整臂竖直落到底盘。
4. 底盘此时不得另装同一底脚；这件随臂移动，落座时不重 复取件。

核对：横销先接竖梁，下销仅作将来底盘接口。

真实LDraw网格；爆炸间距仅用于识别，不代表装配间隙或已验证路径。

## 083 / 501 R 墙架／舵机架逐件搭建 R 另一竖撑：只预插上端两销

2×2780

1. 本页组装尚未接底盘的R 右臂，用独立夹具托稳。A/B和 ±Z为本头局部坐标。
2. 在舵机侧55615#71两孔，从+Z沿-Z半插2780。
3. #81竖梁与#84底销留至整臂落座后再装，当前不封侧面。

核对：两销向+Z外露，81/84仍在散件格。

真实LDraw网格；爆炸间距仅用于识别，不代表装配间隙或已验证路径。

## 084 / 501 R 墙架／舵机架逐件搭建 R 平台斜撑：预插宿主黑销

1×2780

1. 本页组装尚未接底盘的R 右臂，用独立夹具托稳。A/B和 ±Z为本头局部坐标。
2. 在平台框舵机侧图示侧孔从+Z沿-Z半插2780。
3. 挡圈留在平台外面；#86斜撑等转盘侧梁和#44完成后再装。

核对：黑销露出朝+Z，对应未来斜撑第6孔。

真实LDraw网格；爆炸间距仅用于识别，不代表装配间隙或已验证路径。

## 085 / 501 R 转盘下半固定 R 转盘下半：凸台对准上框开口

1×18939

1. 本页组装尚未接底盘的R 右臂，用独立夹具托稳。A/B和 ±Z为本头局部坐标。
2. 断电、空载，把刚搭好的墙架和平台可靠夹住。确认输出 轴件#24-29与#86斜撑均为散件，尚未装有齿上半#115。
3. 取#34 18939无齿下半，长方形凸台朝支撑墙，从夹头一侧 局部+X沿-X放入最上方64179的开口；圆盘边沿贴框架正面。
4. 凸台两端各3孔应与框架两侧的3个横孔自然同轴。不要靠 长销把偏斜凸台硬拉正；暂由夹具保持。

核对：无齿下半已就位；两侧各3孔可见，输出轴组和侧梁 均未挡入口。

真实LDraw网格；爆炸间距仅用于识别，不代表装配间隙或已验证路径。

## 086 / 501 R 转盘下半固定 R 下半+Z侧：从外侧插三根蓝长销

3×6558

1. 本页组装尚未接底盘的R 右臂，用独立夹具托稳。A/B和 ±Z为本头局部坐标。
2. 在局部+Z外侧，将#35/#36/#37三根6558分别对准上、中、 下3孔；逐根沿-Z平推。
3. 每根长的2孔段朝内，依次穿框架侧壁与下半凸台端壁； 挡肩停在框架外面，短的1孔段朝+Z外露。
4. 三根分别位于局部Y=-8、0、+8毫米，不省略中间销。此 时不得先装#41侧梁或#86斜撑。

核对：三销肩贴框架外侧，3个短段均外露；下半保持夹具 支承。

真实LDraw网格；爆炸间距仅用于识别，不代表装配间隙或已验证路径。

## 087 / 501 R 转盘下半固定 R 下半-Z侧：从外侧插另三根蓝长销

3×6558

1. 本页组装尚未接底盘的R 右臂，用独立夹具托稳。A/B和 ±Z为本头局部坐标。
2. 输出轴件#24-29仍未装。站到局部-Z侧，把#38/#39/#40逐 根沿+Z装入另3孔。
3. 长的2孔段向内穿框架与凸台，挡肩留在框架外表面；短 的1孔段向-Z外露。
4. 中间#39的直线入口原本与输出轴位置相交，不能在轴组 已接电机时硬插；两侧合计使用6根6558。

核对：两侧各3根6558均到挡肩，无销肩被推过闭合宿主； 输出轴组仍未接。

真实LDraw网格；爆炸间距仅用于识别，不代表装配间隙或已验证路径。

## 088 / 501 R 转盘下半固定 R 中框侧孔：先预插五根黑销

5×2780

1. 本页组装尚未接底盘的R 右臂，用独立夹具托稳。A/B和 ±Z为本头局部坐标。
2. 两根40490侧梁都暂不装。中间64179框的+Z侧只在上、中 两孔预插#42/#43，沿-Z插半根；下孔对应侧梁第8孔，留给 #44长销。
3. -Z侧上、中、下3孔依次预插#46/#47/#48，沿+Z插半根。 所有2780中央挡圈停在框架外面。
4. 五根销另一半朝外露出，稍后由侧梁套住。不能先封梁后 把挡圈强推穿过两层孔。

核对：2＋3共5根黑销；+Z侧最下孔仍空，挡圈全部在框架 外侧。

真实LDraw网格；爆炸间距仅用于识别，不代表装配间隙或已验证路径。

## 089 / 501 R 转盘下半固定 R -Z侧梁：同时套住六个露出销段

1×40490

1. 本页组装尚未接底盘的R 右臂，用独立夹具托稳。A/B和 ±Z为本头局部坐标。
2. 取#45 40490 9L梁，沿墙的上下方向摆正，孔轴沿Z。输出 轴组仍在机外，给侧梁保留直线入口。
3. 从-Z外侧沿+Z平推：从上端数，第1至3孔同时套#38-40短 段，第6至8孔套#46-48黑销；第4、5、9孔不接销。
4. 六孔自然对准后才均匀压到销肩；不要用梁扭转或拉拢错 位的上下框。

核对：9L梁第1-3孔接固定长销、第6-8孔接中框黑销，六处 均贴合。

真实LDraw网格；爆炸间距仅用于识别，不代表装配间隙或已验证路径。

## 090 / 501 R 转盘下半固定 R +Z侧梁：套上三长销和两黑销

1×40490

1. 本页组装尚未接底盘的R 右臂，用独立夹具托稳。A/B和 ±Z为本头局部坐标。
2. 取#41另一根40490 9L梁，从+Z外侧沿-Z靠近墙体；#86斜 撑尚未安装。
3. 从上端数，第1-3孔套#35-37短段，第6/7孔套#42/#43黑销 ，第8孔与中框空孔同轴，留给#44。
4. 先逐处核对5个销尖，再均匀压到挡肩。两侧梁第4、5、9 孔均不接销。

核对：五个连接点齐平，第8孔未被黑销占用；斜撑仍在机 外。

真实LDraw网格；爆炸间距仅用于识别，不代表装配间隙或已验证路径。

## 091 / 501 R 转盘下半固定 R +Z下端长销：留出斜撑连接段

1×6558

1. 本页组装尚未接底盘的R 右臂，用独立夹具托稳。A/B和 ±Z为本头局部坐标。
2. #41梁已在位后，才从+Z外侧沿-Z插入#44 6558；长的2孔 段穿侧梁第8孔并接中框。
3. 挡肩停在侧梁外表面，短的1孔段朝+Z露出，专门用于#86 斜撑第1孔。
4. 不能把#44提前放在框架里再强压侧梁，也不能让它的挡 肩穿过已装斜撑。

核对：#44长段接梁与中框，短段向外；#86还未装。

真实LDraw网格；爆炸间距仅用于识别，不代表装配间隙或已验证路径。

## 092 / 501 R 转盘下半固定 R 斜撑最后：两孔同时套两根销

1×32524

1. 本页组装尚未接底盘的R 右臂，用独立夹具托稳。A/B和 ±Z为本头局部坐标。
2. 确认前面已装的平台黑销#85在位，露出段与#44短段都朝 +Z。取#86 32524七孔梁，保持图示斜向。
3. 从+Z外侧沿-Z平推：第1孔套#44短段，第6孔套平台#85露 出段；两孔中心距5孔距，不能误用第7孔。
4. 两点同时自然对齐后轻压到挡圈。斜撑此时才闭合；不得 用它强拉框架或平台。

核对：斜撑第1/6孔都就位，挡圈留在宿主之间；其余已搭 组件继续独立支承。

真实LDraw网格；爆炸间距仅用于识别，不代表装配间隙或已验证路径。

## 093 / 501 R 墙架／舵机架逐件搭建 R 输出传动：七号轴先入马达

1×44294

1. 本页组装尚未接底盘的R 右臂，用独立夹具托稳。A/B和 ±Z为本头局部坐标。
2. 从夹头侧+X沿-X将44294七号轴插入断电马达输出十字孔 ；保持轴线Y0、Z-40毫米。裸轴进入本体，外部留出套件位 置。
3. 零件和轴套肩位以本图为准；孔位自然匹配后才推进，保 持断电、独立支承。

核对：新装仅本步指定件；其他传动件不重复计数。

真实LDraw网格；爆炸间距仅用于识别，不代表装配间隙或已验证路径。

## 094 / 501 R 墙架／舵机架逐件搭建 R 输出传动：第一只半轴套

1×32123a

1. 本页组装尚未接底盘的R 右臂，用独立夹具托稳。A/B和 ±Z为本头局部坐标。
2. 从+X沿-X套32123a半套，贴到马达输出侧定位面。不得把 轴套推入本体。
3. 零件和轴套肩位以本图为准；孔位自然匹配后才推进，保 持断电、独立支承。

核对：新装仅本步指定件；其他传动件不重复计数。

真实LDraw网格；爆炸间距仅用于识别，不代表装配间隙或已验证路径。

## 095 / 501 R 墙架／舵机架逐件搭建 R 输出传动：第二只半轴套

1×32123a

1. 本页组装尚未接底盘的R 右臂，用独立夹具托稳。A/B和 ±Z为本头局部坐标。
2. 再从+X沿-X套第二只32123a，与第一只相贴。两只半套共 一孔厚。
3. 零件和轴套肩位以本图为准；孔位自然匹配后才推进，保 持断电、独立支承。

核对：新装仅本步指定件；其他传动件不重复计数。

真实LDraw网格；爆炸间距仅用于识别，不代表装配间隙或已验证路径。

## 096 / 501 R 墙架／舵机架逐件搭建 R 输出传动：整轴套

1×3713

1. 本页组装尚未接底盘的R 右臂，用独立夹具托稳。A/B和 ±Z为本头局部坐标。
2. 从+X沿-X套3713整套，贴住前两只半套。与-Z转盘侧梁仅 约0.4毫米名义间隙，遇阻立即停。
3. 零件和轴套肩位以本图为准；孔位自然匹配后才推进，保 持断电、独立支承。

核对：新装仅本步指定件；其他传动件不重复计数。

真实LDraw网格；爆炸间距仅用于识别，不代表装配间隙或已验证路径。

## 097 / 501 R 墙架／舵机架逐件搭建 R 输出传动：二十四齿轮

1×3648b

1. 本页组装尚未接底盘的R 右臂，用独立夹具托稳。A/B和 ±Z为本头局部坐标。
2. 3648b从+X沿-X套上轴并贴住整套。上半转盘还未扣合， 不强扭齿轮咬合。
3. 零件和轴套肩位以本图为准；孔位自然匹配后才推进，保 持断电、独立支承。

核对：新装仅本步指定件；其他传动件不重复计数。

真实LDraw网格；爆炸间距仅用于识别，不代表装配间隙或已验证路径。

## 098 / 501 R 墙架／舵机架逐件搭建 R 输出传动：轴端半套

1×32123a

1. 本页组装尚未接底盘的R 右臂，用独立夹具托稳。A/B和 ±Z为本头局部坐标。
2. 最后从+X沿-X套32123a半套，贴住齿轮前面。核对两半套、 整套、齿轮、末半套的顺序，不能挤压到转动发涩。
3. 零件和轴套肩位以本图为准；孔位自然匹配后才推进，保 持断电、独立支承。

核对：新装仅本步指定件；其他传动件不重复计数。

真实LDraw网格；爆炸间距仅用于识别，不代表装配间隙或已验证路径。

## 099 / 501 R 转盘下半固定 R 转盘与传动：完成动力底架核对

本步合并／核对，无新增件

1. 本页组装尚未接底盘的R 右臂，用独立夹具托稳。A/B和 ±Z为本头局部坐标。
2. 前述步骤已从单件装完90件动力底架，包括墙、电机架、 平台、舵机架、竖支脚、十字块与输出传动。此处不再取零 件。
3. 转盘六根销、两侧梁和斜撑已到位；曲柄与连杆末端仍未 连接，接口81/84仍为散件。
4. 输出轴、半套、整套、齿轮顺序逐项核对；不得将近似舵 机外形或名义小间隙视为实物通过。

核对：90件已引入且无重复；下面继续原夹头流程。

真实LDraw网格；爆炸间距仅用于识别，不代表装配间隙或已验证路径。

## 100 / 501 机械臂组件装配 R 独立搭建-Z侧板组件

1×2780；1×32316；1×32523；1×32524；2×32526；3×6558

1. 本页组装尚未接底盘的R 右臂，用独立夹具托稳。A/B和 ±Z为本头局部坐标。
2. 把#108五孔内梁与#109三孔内梁分别定位；-Z侧五孔段在 局部+Y，三孔段在-Y。将#111～#113三根6558的短段插入内 梁，挡肩留在内梁外侧。
3. 将#106/#107两根32526压到长销的露出段上，长臂沿推杆 方向、短臂朝夹指根轴。先在对应L梁孔预装#114黑销，再 压上#110外侧七孔梁。
4. 三根蓝销贯穿三层；黑销仅连接外侧两层。保留根轴孔及 60483固定孔，组件仍在机外夹具上。

核对：本组件9件；长短内梁位置与图一致，所有销肩留在 宿主接面。

真实LDraw网格；爆炸间距仅用于识别，不代表装配间隙或已验证路径。

## 101 / 501 机械臂组件装配 R 独立搭建+Z侧板组件

1×2780；1×32316；1×32523；1×32524；2×32526；3×6558

1. 本页组装尚未接底盘的R 右臂，用独立夹具托稳。A/B和 ±Z为本头局部坐标。
2. +Z侧长短内梁与上一组件相反：#99五孔段在局部-Y， #100三孔段在+Y。把#102～#104三根6558短段插入内梁。
3. 将#97/#98两根32526压到长销上；先把#105黑销装在对应L 梁孔，再压上#101外侧七孔梁。
4. 本组件暂存机外；先完成另一侧根轴叠层，再把本组件整 体装到转盘。

核对：本组件9件，两个组件共18件。两侧长短段不能照同 一方向复制。

真实LDraw网格；爆炸间距仅用于识别，不代表装配间隙或已验证路径。

## 102 / 501 机械臂组件装配 R 转盘上半与中央导向块就位

1×18938；1×39793

1. 本页组装尚未接底盘的R 右臂，用独立夹具托稳。A/B和 ±Z为本头局部坐标。
2. 取#115有齿转盘上半，正面凸耳朝夹指。将#116导向块从 正面放进两个凸耳之间，中心孔与转盘轴线重合。
3. 导向块两条侧孔对准两侧凸耳上下孔。仅作定位并用夹具 托住，下一步用销连接。

核对：中心孔畅通；凸耳中间孔未用。

真实LDraw网格；爆炸间距仅用于识别，不代表装配间隙或已验证路径。

## 103 / 501 机械臂组件装配 R 先插四根转盘长销

4×6558

1. 本页组装尚未接底盘的R 右臂，用独立夹具托稳。A/B和 ±Z为本头局部坐标。
2. 从两侧凸耳外面各装2根6558，长的2孔段向内穿凸耳并接 导向块。
3. 挡肩贴住凸耳外表面，短的1孔段向外露出，留给侧板后 端。此时两侧板均未装到转盘。

核对：四销都已到挡肩；不能先封侧板再把挡肩强推过孔。

真实LDraw网格；爆炸间距仅用于识别，不代表装配间隙或已验证路径。

## 104 / 501 机械臂组件装配 R 先接-Z侧板，+Z侧保持开放

本步合并／核对，无新增件

1. 本页组装尚未接底盘的R 右臂，用独立夹具托稳。A/B和 ±Z为本头局部坐标。
2. 取已完成的-Z侧板，从局部-Z外侧沿+Z靠近转盘，使两 根L梁的后端孔套住#119/#120露出的短销段。
3. 均匀压到销肩，持续独立托住侧板和转盘。+Z侧板仍单 独放置，不提前封合。

核对：本组件15件；两根根轴从+Z侧仍有装入夹指和整轴 套的空间。

真实LDraw网格；爆炸间距仅用于识别，不代表装配间隙或已验证路径。

## 105 / 501 机械臂组件装配 R A根轴-Z侧：固定销与60483

1×2780；1×60483

1. 本页组装尚未接底盘的R 右臂，用独立夹具托稳。A/B和 ±Z为本头局部坐标。
2. A对应局部+Y。先将#127黑色2780从-Z侧沿+Z插入内梁端 孔半根，挡圈停在内梁外表面。
3. 将#164 60483从同侧装到黑销露出段：圆孔接2780，十字 孔与相邻根轴孔同轴；两孔中心距8毫米。
4. 此时十字孔还没有根轴。夹具托住支架，不能用单销悬挂 它或靠扭转对相位。

核对：60483圆孔已接销，十字孔对根轴线；支架贴合内梁。

真实LDraw网格；爆炸间距仅用于识别，不代表装配间隙或已验证路径。

## 106 / 501 机械臂组件装配 R A根轴：建立穿轴支点

1×32123a；1×3707

1. 本页组装尚未接底盘的R 右臂，用独立夹具托稳。A/B和 ±Z为本头局部坐标。
2. 先把#125半轴套套在#122 8L根轴的-Z端，再沿+Z把轴穿过 60483十字孔与-Z内梁圆孔；夹具保持支架与轴同线。
3. 半套停在60483外侧；根轴伸入尚未封合的+Z侧。根轴十 字相位应自然通过60483，不能旋扭支架来强行咬合。

核对：轴穿过一侧60483和内梁，外侧半套到位；未连接端 由夹具支承。

真实LDraw网格；爆炸间距仅用于识别，不代表装配间隙或已验证路径。

## 107 / 501 机械臂组件装配 R A根轴：依次装整套、夹指、整套

1×32524；2×3713

1. 本页组装尚未接底盘的R 右臂，用独立夹具托稳。A/B和 ±Z为本头局部坐标。
2. 从开放的+Z端，沿-Z依次套上#123整轴套、#121红色7孔 夹指的第4圆孔、#124整轴套。
3. 每只整套厚8毫米；夹指圆孔厚8毫米。三件在两侧内梁之 间构成24毫米叠层，先由夹具支承，不依靠摩擦锁紧。
4. 夹指朝魔方方向，保持本图的正常近闭合分支；图示约 3.84°，不反向翻折。

核对：内侧顺序为整套／夹指圆孔／整套；+Z侧板仍独立 暂存。

真实LDraw网格；爆炸间距仅用于识别，不代表装配间隙或已验证路径。

## 108 / 501 机械臂组件装配 R B根轴-Z侧：固定销与60483

1×2780；1×60483

1. 本页组装尚未接底盘的R 右臂，用独立夹具托稳。A/B和 ±Z为本头局部坐标。
2. B对应局部-Y。先将#135黑色2780从-Z侧沿+Z插入内梁端 孔半根，挡圈停在内梁外表面。
3. 将#166 60483从同侧装到黑销露出段：圆孔接2780，十字 孔与相邻根轴孔同轴；两孔中心距8毫米。
4. 此时十字孔还没有根轴。夹具托住支架，不能用单销悬挂 它或靠扭转对相位。

核对：60483圆孔已接销，十字孔对根轴线；支架贴合内梁。

真实LDraw网格；爆炸间距仅用于识别，不代表装配间隙或已验证路径。

## 109 / 501 机械臂组件装配 R B根轴：建立穿轴支点

1×32123a；1×3707

1. 本页组装尚未接底盘的R 右臂，用独立夹具托稳。A/B和 ±Z为本头局部坐标。
2. 先把#133半轴套套在#130 8L根轴的-Z端，再沿+Z把轴穿过 60483十字孔与-Z内梁圆孔；夹具保持支架与轴同线。
3. 半套停在60483外侧；根轴伸入尚未封合的+Z侧。根轴十 字相位应自然通过60483，不能旋扭支架来强行咬合。

核对：轴穿过一侧60483和内梁，外侧半套到位；未连接端 由夹具支承。

真实LDraw网格；爆炸间距仅用于识别，不代表装配间隙或已验证路径。

## 110 / 501 机械臂组件装配 R B根轴：依次装整套、夹指、整套

1×32524；2×3713

1. 本页组装尚未接底盘的R 右臂，用独立夹具托稳。A/B和 ±Z为本头局部坐标。
2. 从开放的+Z端，沿-Z依次套上#131整轴套、#129红色7孔 夹指的第4圆孔、#132整轴套。
3. 每只整套厚8毫米；夹指圆孔厚8毫米。三件在两侧内梁之 间构成24毫米叠层，先由夹具支承，不依靠摩擦锁紧。
4. 夹指朝魔方方向，保持本图的正常近闭合分支；图示约 3.84°，不反向翻折。

核对：内侧顺序为整套／夹指圆孔／整套；+Z侧板仍独立 暂存。

真实LDraw网格；爆炸间距仅用于识别，不代表装配间隙或已验证路径。

## 111 / 501 机械臂组件装配 R 合上+Z侧板组件

本步合并／核对，无新增件

1. 本页组装尚未接底盘的R 右臂，用独立夹具托稳。A/B和 ±Z为本头局部坐标。
2. 同时托住两根根轴、夹指与四只整轴套。把已完成的+Z 侧板从+Z外侧沿-Z靠近。
3. 侧板前端两个根轴孔分别套住A/B轴；后端两根L梁孔同时 套住#117/#118转盘长销短段，均匀压至销肩。
4. 四处必须自然对齐；不能用侧板把歪斜轴套硬挤进空隙。 若侧板无法无强力就位，停下复核支承和孔向。

核对：两根轴均穿过两侧内梁，四只整轴套与两夹指在位； +Z端60483与半套尚待安装。

真实LDraw网格；爆炸间距仅用于识别，不代表装配间隙或已验证路径。

## 112 / 501 机械臂组件装配 R A根轴+Z侧：装60483

1×2780；1×60483

1. 本页组装尚未接底盘的R 右臂，用独立夹具托稳。A/B和 ±Z为本头局部坐标。
2. 先从+Z外侧沿-Z把#128黑销插入内梁端孔半根，挡圈停在 内梁与支架的接面。
3. 将#165 60483十字孔对根轴、圆孔对黑销，同时平推到位 ；十字孔与圆孔各接合8毫米。保持根轴另一端半套在位。

核对：两点同时贴合；没有推动根轴或把销挡肩强推穿过宿 主。

真实LDraw网格；爆炸间距仅用于识别，不代表装配间隙或已验证路径。

## 113 / 501 机械臂组件装配 R A根轴+Z半套与64毫米叠层

1×32123a

1. 本页组装尚未接底盘的R 右臂，用独立夹具托稳。A/B和 ±Z为本头局部坐标。
2. 从+Z端沿-Z套上#126半轴套，停在60483外侧。不要用半 套压紧夹指或拉拢结构。
3. 从-Z到+Z：半套4＋60483 8＋内梁8＋整套8＋夹指8＋整套 8＋内梁8＋60483 8＋半套4＝64毫米，恰好占满8L根轴。
4. 名义轴向余量为零。自由转动和可靠防脱是否兼容必须实 测；任何卡死、松脱或轴端接合不足都停止。

核对：两端半套齐全；64毫米零名义余量已记录，未把几何 吻合当作实体验收。

真实LDraw网格；爆炸间距仅用于识别，不代表装配间隙或已验证路径。

## 114 / 501 机械臂组件装配 R B根轴+Z侧：装60483

1×2780；1×60483

1. 本页组装尚未接底盘的R 右臂，用独立夹具托稳。A/B和 ±Z为本头局部坐标。
2. 先从+Z外侧沿-Z把#136黑销插入内梁端孔半根，挡圈停在 内梁与支架的接面。
3. 将#167 60483十字孔对根轴、圆孔对黑销，同时平推到位 ；十字孔与圆孔各接合8毫米。保持根轴另一端半套在位。

核对：两点同时贴合；没有推动根轴或把销挡肩强推穿过宿 主。

真实LDraw网格；爆炸间距仅用于识别，不代表装配间隙或已验证路径。

## 115 / 501 机械臂组件装配 R B根轴+Z半套与64毫米叠层

1×32123a

1. 本页组装尚未接底盘的R 右臂，用独立夹具托稳。A/B和 ±Z为本头局部坐标。
2. 从+Z端沿-Z套上#134半轴套，停在60483外侧。不要用半 套压紧夹指或拉拢结构。
3. 从-Z到+Z：半套4＋60483 8＋内梁8＋整套8＋夹指8＋整套 8＋内梁8＋60483 8＋半套4＝64毫米，恰好占满8L根轴。
4. 名义轴向余量为零。自由转动和可靠防脱是否兼容必须实 测；任何卡死、松脱或轴端接合不足都停止。

核对：两端半套齐全；64毫米零名义余量已记录，未把几何 吻合当作实体验收。

真实LDraw网格；爆炸间距仅用于识别，不代表装配间隙或已验证路径。

## 116 / 501 机械臂组件装配 R A轮胎与轮毂预装

1×42610；1×50945_nominal

1. 本页组装尚未接底盘的R 右臂，用独立夹具托稳。A/B和 ±Z为本头局部坐标。
2. 把#145轮胎套在#144轮毂上，确认胎圈均匀就座。将这2 件组件暂存在机外。
3. 每臂两组独立轮胎压头；轮胎网格是名义14×6毫米尺寸 ，实际橡胶形变和摩擦未验证。

核对：2件组件同心，轮毂中孔保持畅通。

真实LDraw网格；爆炸间距仅用于识别，不代表装配间隙或已验证路径。

## 117 / 501 机械臂组件装配 R A压头：先装-Z薄梁与两连接点

1×32054；1×32123a；1×32449；1×4519

1. 本页组装尚未接底盘的R 右臂，用独立夹具托稳。A/B和 ±Z为本头局部坐标。
2. 把#137四孔薄梁贴在红色夹指-Z侧。薄梁第1十字孔对夹 指第6孔，用#139 3L轴贯穿，并在-Z端加#140半套。
3. 薄梁第2圆孔对夹指第7孔，从-Z侧插#142 32054，挡套停 在第一根薄梁外侧；露出的轴和销给另一侧薄梁使用。
4. 薄梁第3圆孔留空，第4十字孔用于轮轴；+Z侧薄梁下一 步安装。

核对：薄梁由两个连接点定位，挡套在正确外侧；轮胎组件 仍单独托住。

真实LDraw网格；爆炸间距仅用于识别，不代表装配间隙或已验证路径。

## 118 / 501 机械臂组件装配 R A压头：轮轴、轮胎与+Z薄梁

1×32062；1×32123a；1×32449

1. 本页组装尚未接底盘的R 右臂，用独立夹具托稳。A/B和 ±Z为本头局部坐标。
2. 把#143 2L轮轴穿过-Z薄梁第4十字孔，套入已准备的轮胎 ／轮毂组件；轮毂位于夹指中面。
3. 把#138 +Z薄梁同时对准3L轴、32054销和2L轮轴三个连接 点，沿-Z平直压到位，再在3L轴+Z端套#141半套。
4. 2L轮轴两端与薄梁外侧齐平，不加外轴套。检查轮毂能绕 固定轴自由转动；不能靠挤压薄梁消除间隙。

核对：本夹指轮胎压头9件齐全，两个3L轴半套和32054挡套 到位。

真实LDraw网格；爆炸间距仅用于识别，不代表装配间隙或已验证路径。

## 119 / 501 机械臂组件装配 R B轮胎与轮毂预装

1×42610；1×50945_nominal

1. 本页组装尚未接底盘的R 右臂，用独立夹具托稳。A/B和 ±Z为本头局部坐标。
2. 把#154轮胎套在#153轮毂上，确认胎圈均匀就座。将这2 件组件暂存在机外。
3. 每臂两组独立轮胎压头；轮胎网格是名义14×6毫米尺寸 ，实际橡胶形变和摩擦未验证。

核对：2件组件同心，轮毂中孔保持畅通。

真实LDraw网格；爆炸间距仅用于识别，不代表装配间隙或已验证路径。

## 120 / 501 机械臂组件装配 R B压头：先装-Z薄梁与两连接点

1×32054；1×32123a；1×32449；1×4519

1. 本页组装尚未接底盘的R 右臂，用独立夹具托稳。A/B和 ±Z为本头局部坐标。
2. 把#146四孔薄梁贴在红色夹指-Z侧。薄梁第1十字孔对夹 指第6孔，用#148 3L轴贯穿，并在-Z端加#149半套。
3. 薄梁第2圆孔对夹指第7孔，从-Z侧插#151 32054，挡套停 在第一根薄梁外侧；露出的轴和销给另一侧薄梁使用。
4. 薄梁第3圆孔留空，第4十字孔用于轮轴；+Z侧薄梁下一 步安装。

核对：薄梁由两个连接点定位，挡套在正确外侧；轮胎组件 仍单独托住。

真实LDraw网格；爆炸间距仅用于识别，不代表装配间隙或已验证路径。

## 121 / 501 机械臂组件装配 R B压头：轮轴、轮胎与+Z薄梁

1×32062；1×32123a；1×32449

1. 本页组装尚未接底盘的R 右臂，用独立夹具托稳。A/B和 ±Z为本头局部坐标。
2. 把#152 2L轮轴穿过-Z薄梁第4十字孔，套入已准备的轮胎 ／轮毂组件；轮毂位于夹指中面。
3. 把#147 +Z薄梁同时对准3L轴、32054销和2L轮轴三个连接 点，沿-Z平直压到位，再在3L轴+Z端套#150半套。
4. 2L轮轴两端与薄梁外侧齐平，不加外轴套。检查轮毂能绕 固定轴自由转动；不能靠挤压薄梁消除间隙。

核对：本夹指轮胎压头9件齐全，两个3L轴半套和32054挡套 到位。

真实LDraw网格；爆炸间距仅用于识别，不代表装配间隙或已验证路径。

## 122 / 501 机械臂组件装配 R 先把无摩擦销各插入夹指半根

2×3673

1. 本页组装尚未接底盘的R 右臂，用独立夹具托稳。A/B和 ±Z为本头局部坐标。
2. 两根黄色连杆尚未接到夹指。A夹指第2孔先从+Z侧沿-Z 插#160灰色3673半根；B夹指第2孔从-Z侧沿+Z插#162半根。
3. 两个中央挡圈都留在夹指外表面，销的另一半露出，供下 一步各自的连杆圆孔套接。
4. 夹指和已装头部由夹具支承。不能把销推穿夹指后再把挡 圈强推通过连杆。

核对：A/B两销肩分别在+Z/-Z夹指外表面，露出段方向相 反。

真实LDraw网格；爆炸间距仅用于识别，不代表装配间隙或已验证路径。

## 123 / 501 机械臂组件装配 R 两根黄色连杆分别从各自外侧套销

2×32316

1. 本页组装尚未接底盘的R 右臂，用独立夹具托稳。A/B和 ±Z为本头局部坐标。
2. 先从+Z外侧沿-Z把#159连杆一端套到A销#160的露出段， 直到与夹指之间的销肩接触。
3. 再从-Z外侧沿+Z把#161连杆一端套到B销#162的露出段。 两根连杆分别装入，不把它们预先连成刚性组件一起硬推。
4. 两连杆自由端由夹具托在十字接头位置。保持正常近闭合 分支；下一步用横轴连接中间三个孔。

核对：两销肩停在各自的夹指与连杆接面，连杆可绕无摩擦 销转动。

真实LDraw网格；爆炸间距仅用于识别，不代表装配间隙或已验证路径。

## 124 / 501 机械臂组件装配 R 连接十字接头横轴与两端半套

1×32013；2×32123a；1×3705

1. 本页组装尚未接底盘的R 右臂，用独立夹具托稳。A/B和 ±Z为本头局部坐标。
2. 用夹具保持两连杆自由端同轴，在中间放#155 32013，横 圆孔对准两个连杆端孔，纵向十字孔朝后接推杆。
3. 在#156 4L横轴-Z端预套#157半套；从-Z沿+Z依次穿过#161 连杆、32013横圆孔和#159连杆，再从+Z端套#158半套。
4. 轴本体穿圆孔，无销挡肩经过闭合孔。两半套停在连杆外 侧，不能压死连杆；十字接头在两连杆朝魔方的一端。

核对：横轴与两端半套齐全，三处圆孔自然同轴；纵向十字 孔仍畅通。

真实LDraw网格；爆炸间距仅用于识别，不代表装配间隙或已验证路径。

## 125 / 501 机械臂组件装配 R 离机接合机械头与90件动力核心

本步合并／核对，无新增件

1. 本页组装尚未接底盘的R 右臂，用独立夹具托稳。A/B和 ±Z为本头局部坐标。
2. 转盘下半固定及轴组接入已按前述步骤完成，90件动力底 架、机械头及未闭合的曲柄／连杆分别独立支承。将转盘上 半对准核心的下半扣合；同时保持齿轮与转盘的名义啮合位 置。
3. #94曲柄端轴和#95半套尚未安装，因此黄色舵机连杆不会 把推杆强制锁在舵机角度上。
4. 此时整臂仍在底盘外，#81侧梁和#84底框销仍在专格。扣 合所需空间、卡扣力及实体啮合必须另行验证。

核对：转盘上下半及导向孔同轴；曲柄与连杆未连接，推杆 通道未封闭。

真实LDraw网格；爆炸间距仅用于识别，不代表装配间隙或已验证路径。

## 126 / 501 机械臂组件装配 R 从后方穿12L推杆及两只半套

2×32123a；1×3708

1. 本页组装尚未接底盘的R 右臂，用独立夹具托稳。A/B和 ±Z为本头局部坐标。
2. 把#88/#89两只半套分别用夹具定位在十字块#87的前后， 孔轴线对准导向框前孔；曲柄端仍不连接。
3. #163 12L轴从平台后方沿+X穿入：导向框后孔只借道，再 依次通过后半套、十字块圆孔、前半套、导向框前孔、转盘 中心及#116导向块，最后插进#155十字孔到底。
4. 图示为完成位置，后导向孔不承载推杆。自然移动未连接 的十字块／连杆帮助对孔，不反驱舵机；两半套不把滑动机 构夹死。

核对：推杆前端名义进入十字接头8毫米；两个导向处畅通、 两半套就位。

真实LDraw网格；爆炸间距仅用于识别，不代表装配间隙或已验证路径。

## 127 / 501 机械臂组件装配 R 匹配名义姿态后连接曲柄端

1×32062；1×32123a

1. 本页组装尚未接底盘的R 右臂，用独立夹具托稳。A/B和 ±Z为本头局部坐标。
2. 先核对舵机曲柄#93已由另行验证的定位流程处于所需姿 态。本页仅表达断电、空载、孔位自然对齐时的机械连接； 不提供上电归零或脉宽标定。
3. 保持夹指和推杆在图示正常近闭合分支，让#96连杆端孔 与曲柄末端孔自然同轴，再插#94 2L轴：外端与曲柄外面齐 平；内端装#95半套贴住连杆。
4. 孔位不自然重合、需要硬拉连杆或反驱舵机时立即停止， 保持分离和支承，等待专门定位／标定；不能把本页当作定 位已完成的证据。

核对：只有预先满足自然对孔条件才记录此步完成；否则整 臂仍标为待验证。

真实LDraw网格；爆炸间距仅用于识别，不代表装配间隙或已验证路径。

## 128 / 501 机械臂组件装配 R 单臂165件待接底盘，2件留待接口

本步合并／核对，无新增件

1. 本页组装尚未接底盘的R 右臂，用独立夹具托稳。A/B和 ±Z为本头局部坐标。
2. 核对已完成的90件动力底架与75件夹头件共165件；每头4 件60483、2根8L根轴、4只根轴整套、4只根轴外半套和4枚 支架固定销齐全。
3. #81 40490侧梁与#84 2780销保持散件状态，待整臂落到底 盘后先装#84、再装#81，使每臂达到167件；不要提前装这 两件。
4. R、L、F、B四臂分别在机外完成同一局部流程。各臂独 立记录；四臂最终合计668件，不以一个臂通过代替其余三 臂。
5. 64毫米根轴叠层零名义余量；夹指正常约3.84°～25°。 装配路径、保持、载荷、控制联锁和实体开合均未放行。

核对：165件在位＋2件专格＝167件／臂；不插电、不带魔 方，仍需实体验证。

真实LDraw网格；爆炸间距仅用于识别，不代表装配间隙或已验证路径。

## 129 / 501 L 墙架／舵机架逐件搭建 L 从散件开始：放好竖墙下框

1×64179

1. 本页组装尚未接底盘的L 左臂，用独立夹具托稳。A/B和 ±Z为本头局部坐标。
2. 每臂从167个清单单件开始，包括成品电机和舵机；没有 预装核心或隐藏轴组。逐项取件，81侧梁和84销留到底盘阶 段。
3. 取第一块64179作为最下层框架，墙面在YZ平面，长边沿 Z。用夹具托住，后续向-Y上方逐层搭墙。
4. 本册覆盖全部清单件的装配顺序，不拆成品电机/舵机内 部；名义几何不等于实体装配通过。

核对：本步仅1块下框#3，孔向和编号与图一致。

真实LDraw网格；爆炸间距仅用于识别，不代表装配间隙或已验证路径。

## 130 / 501 L 墙架／舵机架逐件搭建 L 竖墙：下框上缘预插三销

3×2780

1. 本页组装尚未接底盘的L 左臂，用独立夹具托稳。A/B和 ±Z为本头局部坐标。
2. 取三根2780，从-Y上方沿+Y向下框#3上缘各插半根，位置 为局部Z=-16、0、+16毫米。
3. 中央挡圈留在上缘外面；中框未装，不能把销肩推过两层 孔。

核对：三根等高，另一半朝-Y外露。

真实LDraw网格；爆炸间距仅用于识别，不代表装配间隙或已验证路径。

## 131 / 501 L 墙架／舵机架逐件搭建 L 竖墙：压上中框

1×64179

1. 本页组装尚未接底盘的L 左臂，用独立夹具托稳。A/B和 ±Z为本头局部坐标。
2. 取第二块64179，长边沿Z，与下框保持同一墙面。
3. 从-Y上方沿+Y将中框下缘的三孔同时套住#7-9，均匀压到 挡圈。

核对：两框接缝平直，三销都连接相邻框。

真实LDraw网格；爆炸间距仅用于识别，不代表装配间隙或已验证路径。

## 132 / 501 L 墙架／舵机架逐件搭建 L 竖墙：中框上缘预插三销

3×2780

1. 本页组装尚未接底盘的L 左臂，用独立夹具托稳。A/B和 ±Z为本头局部坐标。
2. 从-Y上方沿+Y向中框#2上缘预插三根2780半根。
3. 仍用Z=-16、0、+16毫米三个位置，保留挡圈在框外。

核对：三个销尖朝-Y。

真实LDraw网格；爆炸间距仅用于识别，不代表装配间隙或已验证路径。

## 133 / 501 L 墙架／舵机架逐件搭建 L 竖墙：压上顶框

1×64179

1. 本页组装尚未接底盘的L 左臂，用独立夹具托稳。A/B和 ±Z为本头局部坐标。
2. 顶框64179长边沿Z，墙面与下面两框齐平。
3. 从-Y沿+Y套住#4-6三销；三块框的开口都保持畅通。

核对：三框九件完整，后续转盘放入最上框开口。

真实LDraw网格；爆炸间距仅用于识别，不代表装配间隙或已验证路径。

## 134 / 501 L 墙架／舵机架逐件搭建 L 墙脚：先半插两枚接口销

2×2780

1. 本页组装尚未接底盘的L 左臂，用独立夹具托稳。A/B和 ±Z为本头局部坐标。
2. 将墙倒置支承，从最下框#3底缘沿-Y各插半根2780。
3. 中央挡圈位于最终墙/底盘接缝Y100毫米；另一半朝+Y。 此时不取底盘。

核对：两枚销随墙保留，落底盘时不重复取件。

真实LDraw网格；爆炸间距仅用于识别，不代表装配间隙或已验证路径。

## 135 / 501 L 墙架／舵机架逐件搭建 L 马达：识别成品本体

1×95658

1. 本页组装尚未接底盘的L 左臂，用独立夹具托稳。A/B和 ±Z为本头局部坐标。
2. 取95658成品马达，保持断电，电线避开孔位。
3. 输出轴线沿X，本体在-Z侧；按图识别底面三圆孔和颈部 圆孔，不拆电机内部。

核对：型号与朝向一致，孔位没有被线缆遮住。

真实LDraw网格；爆炸间距仅用于识别，不代表装配间隙或已验证路径。

## 136 / 501 L 墙架／舵机架逐件搭建 L 马达底部：三枚销先入本体

3×2780

1. 本页组装尚未接底盘的L 左臂，用独立夹具托稳。A/B和 ±Z为本头局部坐标。
2. 把马达底面朝上，三孔沿X排列。
3. 每孔一根2780，只插半根，挡圈留在本体外侧；三销最终 向+Y露出。

核对：三销在同一平面。

真实LDraw网格；爆炸间距仅用于识别，不代表装配间隙或已验证路径。

## 137 / 501 L 墙架／舵机架逐件搭建 L 马达底块：第一根五孔梁

1×32316

1. 本页组装尚未接底盘的L 左臂，用独立夹具托稳。A/B和 ±Z为本头局部坐标。
2. 取32316五孔梁，长向沿X。
3. 从+Y沿-Y使第2、3、4孔套住三枚底销，压至挡圈。

核对：第1、5孔保持空着。

真实LDraw网格；爆炸间距仅用于识别，不代表装配间隙或已验证路径。

## 138 / 501 L 墙架／舵机架逐件搭建 L 马达底块：两端预插销

2×2780

1. 本页组装尚未接底盘的L 左臂，用独立夹具托稳。A/B和 ±Z为本头局部坐标。
2. 在第一根五孔梁第1、5孔，从+Y沿-Y各插半根2780。
3. 挡圈留在梁外，露出半根给第二层梁。

核对：两销间距四孔距。

真实LDraw网格；爆炸间距仅用于识别，不代表装配间隙或已验证路径。

## 139 / 501 L 墙架／舵机架逐件搭建 L 马达底块：第二根五孔梁

1×32316

1. 本页组装尚未接底盘的L 左臂，用独立夹具托稳。A/B和 ±Z为本头局部坐标。
2. 第二根32316与第一根平行对齐。
3. 从+Y沿-Y套住两端销，形成两层底块；中间孔保留给底 盘接口。

核对：两层梁贴合，无销肩穿过闭合双层。

真实LDraw网格；爆炸间距仅用于识别，不代表装配间隙或已验证路径。

## 140 / 501 L 墙架／舵机架逐件搭建 L 马达颈部：先放长短两销

1×2780；1×6558

1. 本页组装尚未接底盘的L 左臂，用独立夹具托稳。A/B和 ±Z为本头局部坐标。
2. 颈部上圆孔放6558#18，短段向-X入本体，挡肩留外；长 段向+X。
3. 下圆孔放2780#19半根；中间十字孔不要误用。

核对：上蓝长销、下黑短销均露出到同侧。

真实LDraw网格；爆炸间距仅用于识别，不代表装配间隙或已验证路径。

## 141 / 501 L 墙架／舵机架逐件搭建 L 马达前架：竖装三孔梁

1×32523

1. 本页组装尚未接底盘的L 左臂，用独立夹具托稳。A/B和 ±Z为本头局部坐标。
2. 取32523三孔梁，长向沿Y，孔轴沿X。
3. 从+X沿-X套上#18/#19，分别使用上下两孔，中孔保持空。

核对：三孔梁贴住销肩。

真实LDraw网格；爆炸间距仅用于识别，不代表装配间隙或已验证路径。

## 142 / 501 L 墙架／舵机架逐件搭建 L 马达前架：中孔预插黑销

1×2780

1. 本页组装尚未接底盘的L 左臂，用独立夹具托稳。A/B和 ±Z为本头局部坐标。
2. 在三孔梁中孔，从+X沿-X插入2780半根。
3. 露出半根向+X，给下方横梁使用。

核对：不要占用颈部十字孔。

真实LDraw网格；爆炸间距仅用于识别，不代表装配间隙或已验证路径。

## 143 / 501 L 墙架／舵机架逐件搭建 L 马达前架：接十一孔横梁

1×32525

1. 本页组装尚未接底盘的L 左臂，用独立夹具托稳。A/B和 ±Z为本头局部坐标。
2. 32525长向沿Z，向墙体伸出。
3. 第1孔从+X沿-X套住上方#18长销的剩余段；三孔竖梁与横 梁各占一孔厚。

核对：蓝销长段连接两根梁。

真实LDraw网格；爆炸间距仅用于识别，不代表装配间隙或已验证路径。

## 144 / 501 L 墙架／舵机架逐件搭建 L 马达前架：接七孔横梁

1×32524

1. 本页组装尚未接底盘的L 左臂，用独立夹具托稳。A/B和 ±Z为本头局部坐标。
2. 32524七孔梁与十一孔梁平行。
3. 第1孔从+X沿-X套住中间#21黑销。

核对：两横梁分别位于局部Y16、24毫米。

真实LDraw网格；爆炸间距仅用于识别，不代表装配间隙或已验证路径。

## 145 / 501 L 墙架／舵机架逐件搭建 L 马达接墙：四销先入横梁

4×2780

1. 本页组装尚未接底盘的L 左臂，用独立夹具托稳。A/B和 ±Z为本头局部坐标。
2. 从马达端数，十一孔梁第6、8、10孔接#30/#31/#32；七孔 梁第6孔接#33。
3. 四根2780从+X沿-X半插横梁，挡圈留在梁前；销尖向+X。

核对：三销接顶框，一销接中框；输出轴组尚未装。

真实LDraw网格；爆炸间距仅用于识别，不代表装配间隙或已验证路径。

## 146 / 501 L 墙架／舵机架逐件搭建 L 马达接墙：平推合拢

本步合并／核对，无新增件

1. 本页组装尚未接底盘的L 左臂，用独立夹具托稳。A/B和 ±Z为本头局部坐标。
2. 取刚搭好的完整马达组件，保持四销在横梁内，不再取销。
3. 从墙背面局部-X沿+X平推，四销同时进入墙孔；墙与马 达继续由夹具托住。

核对：四销肩留在横梁/墙之间；不装输出轴。

真实LDraw网格；爆炸间距仅用于识别，不代表装配间隙或已验证路径。

## 147 / 501 L 墙架／舵机架逐件搭建 L 舵机平台：平放两根十五孔梁

2×32278

1. 本页组装尚未接底盘的L 左臂，用独立夹具托稳。A/B和 ±Z为本头局部坐标。
2. 两根32278平行，长向沿X，相距四孔距。
3. 以夹具保持两梁前后端齐平；此时它们尚未连接。

核对：梁中心分别为Z0、32毫米，孔轴沿Y。

真实LDraw网格；爆炸间距仅用于识别，不代表装配间隙或已验证路径。

## 148 / 501 L 墙架／舵机架逐件搭建 L 平台前部：六枚销先入底梁

6×2780

1. 本页组装尚未接底盘的L 左臂，用独立夹具托稳。A/B和 ±Z为本头局部坐标。
2. 两根15L从最后端向前数：+Z梁第9、11、13、15孔各半插 2780；Z0梁第9、15孔各半插一根。
3. 销由-Y上方沿+Y插入梁，挡圈留在梁上；两蓝长销位置 暂空。

核对：4＋2共六销；全部露出朝-Y。

真实LDraw网格；爆炸间距仅用于识别，不代表装配间隙或已验证路径。

## 149 / 501 L 墙架／舵机架逐件搭建 L 平台前部：压上水平框架

1×64179

1. 本页组装尚未接底盘的L 左臂，用独立夹具托稳。A/B和 ±Z为本头局部坐标。
2. 64179平放，长边沿X，前端与两根十五孔梁对齐。
3. 从-Y沿+Y压到六枚销上，保持长销专用两孔空着。

核对：框架与两梁闭合，六销肩在夹层。

真实LDraw网格；爆炸间距仅用于识别，不代表装配间隙或已验证路径。

## 150 / 501 L 墙架／舵机架逐件搭建 L 舵机垫梁：先插三枚黑销

3×2780

1. 本页组装尚未接底盘的L 左臂，用独立夹具托稳。A/B和 ±Z为本头局部坐标。
2. 在+Z的15L底梁，从最后端孔向前数第2、6、7孔半插2780 ；它们对应稍后7L垫梁的第1、5、6孔。15L第1孔留给后横 梁。
3. 从-Y沿+Y装销，垫梁第2、4孔下方留给55615，不增贯穿 销。

核对：三销不占舵机耳销第3、7孔。

真实LDraw网格；爆炸间距仅用于识别，不代表装配间隙或已验证路径。

## 151 / 501 L 墙架／舵机架逐件搭建 L 舵机垫梁：压上七孔梁

1×32524

1. 本页组装尚未接底盘的L 左臂，用独立夹具托稳。A/B和 ±Z为本头局部坐标。
2. 取32524七孔梁，与底梁平行。
3. 从-Y沿+Y套住三销；从后端数第3、7孔保持空着。

核对：垫梁只由三枚黑销连接底梁。

真实LDraw网格；爆炸间距仅用于识别，不代表装配间隙或已验证路径。

## 152 / 501 L 墙架／舵机架逐件搭建 L 平台后横梁：两端预插销

2×2780

1. 本页组装尚未接底盘的L 左臂，用独立夹具托稳。A/B和 ±Z为本头局部坐标。
2. 两根十五孔梁各在最后一个孔从-Y沿+Y半插2780。
3. 销尖均向上，给横向五孔梁使用。

核对：两销同高，相距四孔距。

真实LDraw网格；爆炸间距仅用于识别，不代表装配间隙或已验证路径。

## 153 / 501 L 墙架／舵机架逐件搭建 L 平台后横梁：闭合长方形

1×32316

1. 本页组装尚未接底盘的L 左臂，用独立夹具托稳。A/B和 ±Z为本头局部坐标。
2. 32316五孔梁长向沿Z。
3. 从-Y沿+Y将两端孔套在#68/#69上，后框闭合。

核对：两梁前后都有横向连接。

真实LDraw网格；爆炸间距仅用于识别，不代表装配间隙或已验证路径。

## 154 / 501 L 墙架／舵机架逐件搭建 L 平台下方：装两个弯角连接器

2×55615

1. 本页组装尚未接底盘的L 左臂，用独立夹具托稳。A/B和 ±Z为本头局部坐标。
2. 两只55615的横臂顺X、竖臂朝+Y下方。
3. 从+Y下方向-Y压入：马达侧底梁倒数第2、4孔；舵机侧 倒数第3、5孔。使用连接器自带销，不另加销。

核对：两连接器竖臂孔沿Z，自带多余横销保持空置。

真实LDraw网格；爆炸间距仅用于识别，不代表装配间隙或已验证路径。

## 155 / 501 L 墙架／舵机架逐件搭建 L 推杆导向：先插两根蓝长销

2×6558

1. 本页组装尚未接底盘的L 左臂，用独立夹具托稳。A/B和 ±Z为本头局部坐标。
2. 从-Y沿+Y把6558长的两孔段穿平台框并插入Z0底梁。
3. 挡肩停在平台框上表面，短段朝-Y；导向框尚未装，销肩 不能穿过其底孔。

核对：长段连接平台两层，短段露出供导向框。

真实LDraw网格；爆炸间距仅用于识别，不代表装配间隙或已验证路径。

## 156 / 501 L 墙架／舵机架逐件搭建 L 推杆导向：最后压上竖框

1×64179

1. 本页组装尚未接底盘的L 左臂，用独立夹具托稳。A/B和 ±Z为本头局部坐标。
2. 64179竖立在XY平面，长向沿X，孔轴沿Z。
3. 从-Y沿+Y将底边两个侧孔套住#64/#65短段；导向圆孔朝 推杆轴线。

核对：导向框两销到肩，中央开口未被连杆或舵机封住。

真实LDraw网格；爆炸间距仅用于识别，不代表装配间隙或已验证路径。

## 157 / 501 L 墙架／舵机架逐件搭建 L 十字块：放入导向框开口

1×6536

1. 本页组装尚未接底盘的L 左臂，用独立夹具托稳。A/B和 ±Z为本头局部坐标。
2. 6536十字块圆孔在上，下面十字孔沿Z。
3. 舵机尚未装，把十字块从+Z沿-Z放入导向框中央开口， 以夹具托住；不靠推杆悬挂。

核对：框内名义余量约0.4毫米，遇阻停止，不磨件。

真实LDraw网格；爆炸间距仅用于识别，不代表装配间隙或已验证路径。

## 158 / 501 L 墙架／舵机架逐件搭建 L 十字块：穿入三号轴

1×4519

1. 本页组装尚未接底盘的L 左臂，用独立夹具托稳。A/B和 ±Z为本头局部坐标。
2. 4519三号轴从+Z沿-Z穿过下方十字孔。
3. -Z端留半孔给半轴套，+Z端留出连杆和另一只半轴套厚 度。

核对：轴不穿上方推杆圆孔。

真实LDraw网格；爆炸间距仅用于识别，不代表装配间隙或已验证路径。

## 159 / 501 L 墙架／舵机架逐件搭建 L 十字块：后侧半套定位

1×32123a

1. 本页组装尚未接底盘的L 左臂，用独立夹具托稳。A/B和 ±Z为本头局部坐标。
2. 从-Z沿+Z装32123a半轴套，贴住十字块后侧。
3. 十字块继续独立支承，不与导向框固连。

核对：后侧半套贴合而不挤压框架。

真实LDraw网格；爆炸间距仅用于识别，不代表装配间隙或已验证路径。

## 160 / 501 L 墙架／舵机架逐件搭建 L 舵机连杆：先接十字块端

1×32524

1. 本页组装尚未接底盘的L 左臂，用独立夹具托稳。A/B和 ±Z为本头局部坐标。
2. 32524七孔连杆的前端第1孔从+Z沿-Z套住三号轴。
3. 连杆直接贴十字块+Z面，不在两者中间加轴套；第7孔朝 舵机端且保持未连接。

核对：连杆在导向框外侧，舵机还未挡住来路。

真实LDraw网格；爆炸间距仅用于识别，不代表装配间隙或已验证路径。

## 161 / 501 L 墙架／舵机架逐件搭建 L 舵机连杆：外侧半套定位

1×32123a

1. 本页组装尚未接底盘的L 左臂，用独立夹具托稳。A/B和 ±Z为本头局部坐标。
2. 从+Z沿-Z套上32123a，贴住连杆外面。
3. 连杆远端继续由夹具支承，不提前接曲柄。

核对：半套4＋十字块8＋连杆8＋半套4＝24毫米，轴向零名 义余量；勿夹死连杆。

真实LDraw网格；爆炸间距仅用于识别，不代表装配间隙或已验证路径。

## 162 / 501 L 墙架／舵机架逐件搭建 L 舵机耳销：先短段入垫梁

2×6558

1. 本页组装尚未接底盘的L 左臂，用独立夹具托稳。A/B和 ±Z为本头局部坐标。
2. 两根6558短的一孔段从-Y沿+Y插入垫梁第3、7孔。
3. 挡肩留在垫梁上，长段向-Y；舵机未放，不能从上方把销 肩强推穿耳孔。

核对：两根蓝长销竖直，舵机来路保持空。

真实LDraw网格；爆炸间距仅用于识别，不代表装配间隙或已验证路径。

## 163 / 501 L 墙架／舵机架逐件搭建 L 舵机：机外核对成品本体

1×geekservo

1. 本页组装尚未接底盘的L 左臂，用独立夹具托稳。A/B和 ±Z为本头局部坐标。
2. 取成品geekservo，保持断电，暂不套入平台耳销。
3. 输出端朝图示连杆侧；先在机外接曲柄，再连同曲柄一起 落位，避免曲柄横向穿入被连杆挡住。
4. 舵机网格为近似外形，耳孔和输出配合必须对照实物核验。

核对：舵机单独支承，不拆本体内部。

真实LDraw网格；爆炸间距仅用于识别，不代表装配间隙或已验证路径。

## 164 / 501 L 墙架／舵机架逐件搭建 L 曲柄：机外条件定位后接舵机

1×41677

1. 本页组装尚未接底盘的L 左臂，用独立夹具托稳。A/B和 ±Z为本头局部坐标。
2. 41677曲柄从-Z沿+Z套向舵机输出端，末端孔仍不接连杆。
3. 仅在另行验证的断电输出轴位和接口匹配条件下自然套合 ；不能为追图示角度强扭舵机。
4. 近似舵机网格不证明真实输出花键/转接配合。未能自然 配合时保持待验证，不继续闭链。

核对：机外只接曲柄根部，整组独立支承。

真实LDraw网格；爆炸间距仅用于识别，不代表装配间隙或已验证路径。

## 165 / 501 L 墙架／舵机架逐件搭建 L 舵机与曲柄：整组沿耳销落位

本步合并／核对，无新增件

1. 本页组装尚未接底盘的L 左臂，用独立夹具托稳。A/B和 ±Z为本头局部坐标。
2. 取刚接好的舵机/曲柄两件组，保持相对方向，不重复取 件。
3. 从-Y沿+Y将舵机耳孔套住#73/#74两根蓝销长段，直到挡 肩；曲柄从连杆外侧经过，末端保持未连接。
4. 不能改成先落舵机、再横穿曲柄：已放好的连杆会挡住曲 柄入口。实际接口与耳孔遇阻立即停。

核对：两耳到肩、曲柄在连杆外侧，94/95仍未装。

真实LDraw网格；爆炸间距仅用于识别，不代表装配间隙或已验证路径。

## 166 / 501 L 墙架／舵机架逐件搭建 L 平台接墙：两枚销先入平台

2×2780

1. 本页组装尚未接底盘的L 左臂，用独立夹具托稳。A/B和 ±Z为本头局部坐标。
2. 平台仍未接墙，从前端+X沿-X向局部Z8、24毫米的端孔 半插2780，中间孔留空。已接舵机和曲柄仍保持在位。
3. 挡圈在平台前沿，露出半根向+X；这些销随后进入墙中 框，不穿闭合双层。

核对：两销轴线为X，不能与导向蓝销混用。

真实LDraw网格；爆炸间距仅用于识别，不代表装配间隙或已验证路径。

## 167 / 501 L 墙架／舵机架逐件搭建 L 平台接墙：从背面平推

本步合并／核对，无新增件

1. 本页组装尚未接底盘的L 左臂，用独立夹具托稳。A/B和 ±Z为本头局部坐标。
2. 取已搭平台、舵机、曲柄及连杆，省略的已接件仍在位； 继续用夹具托住连杆远端。
3. 从墙背面-X沿+X平推，两销进入中框；导向轴线与转盘 中心线保持同轴。

核对：平台和马达分别用各自销接墙，无重复取件。

真实LDraw网格；爆炸间距仅用于识别，不代表装配间隙或已验证路径。

## 168 / 501 L 墙架／舵机架逐件搭建 L 后竖撑：先给马达侧连接器插销

2×2780

1. 本页组装尚未接底盘的L 左臂，用独立夹具托稳。A/B和 ±Z为本头局部坐标。
2. 在马达侧55615#70的两孔，从-Z沿+Z半插两枚2780。
3. 挡圈留在-Z外面，露出销尖给9L竖梁。

核对：销位Y40、56毫米，两销向-Z露出。

真实LDraw网格；爆炸间距仅用于识别，不代表装配间隙或已验证路径。

## 169 / 501 L 墙架／舵机架逐件搭建 L 后竖撑：装马达侧九孔梁

1×40490

1. 本页组装尚未接底盘的L 左臂，用独立夹具托稳。A/B和 ±Z为本头局部坐标。
2. 40490竖向沿Y，从-Z沿+Z套住#79/#80。
3. 上方第2、4孔接两销，梁下端保持空，下一步接底脚。

核对：竖梁孔轴沿Z，底部第7、9孔可接近。

真实LDraw网格；爆炸间距仅用于识别，不代表装配间隙或已验证路径。

## 170 / 501 L 墙架／舵机架逐件搭建 L 后竖撑：底部弯角脚横插

1×55615

1. 本页组装尚未接底盘的L 左臂，用独立夹具托稳。A/B和 ±Z为本头局部坐标。
2. 55615底脚此时在机外，两个横销朝-Z。
3. 从+Z沿-Z把自带两销插入#78第7、9孔；底脚另外两销朝 +Y，留待整臂竖直落到底盘。
4. 底盘此时不得另装同一底脚；这件随臂移动，落座时不重 复取件。

核对：横销先接竖梁，下销仅作将来底盘接口。

真实LDraw网格；爆炸间距仅用于识别，不代表装配间隙或已验证路径。

## 171 / 501 L 墙架／舵机架逐件搭建 L 另一竖撑：只预插上端两销

2×2780

1. 本页组装尚未接底盘的L 左臂，用独立夹具托稳。A/B和 ±Z为本头局部坐标。
2. 在舵机侧55615#71两孔，从+Z沿-Z半插2780。
3. #81竖梁与#84底销留至整臂落座后再装，当前不封侧面。

核对：两销向+Z外露，81/84仍在散件格。

真实LDraw网格；爆炸间距仅用于识别，不代表装配间隙或已验证路径。

## 172 / 501 L 墙架／舵机架逐件搭建 L 平台斜撑：预插宿主黑销

1×2780

1. 本页组装尚未接底盘的L 左臂，用独立夹具托稳。A/B和 ±Z为本头局部坐标。
2. 在平台框舵机侧图示侧孔从+Z沿-Z半插2780。
3. 挡圈留在平台外面；#86斜撑等转盘侧梁和#44完成后再装。

核对：黑销露出朝+Z，对应未来斜撑第6孔。

真实LDraw网格；爆炸间距仅用于识别，不代表装配间隙或已验证路径。

## 173 / 501 L 转盘下半固定 L 转盘下半：凸台对准上框开口

1×18939

1. 本页组装尚未接底盘的L 左臂，用独立夹具托稳。A/B和 ±Z为本头局部坐标。
2. 断电、空载，把刚搭好的墙架和平台可靠夹住。确认输出 轴件#24-29与#86斜撑均为散件，尚未装有齿上半#115。
3. 取#34 18939无齿下半，长方形凸台朝支撑墙，从夹头一侧 局部+X沿-X放入最上方64179的开口；圆盘边沿贴框架正面。
4. 凸台两端各3孔应与框架两侧的3个横孔自然同轴。不要靠 长销把偏斜凸台硬拉正；暂由夹具保持。

核对：无齿下半已就位；两侧各3孔可见，输出轴组和侧梁 均未挡入口。

真实LDraw网格；爆炸间距仅用于识别，不代表装配间隙或已验证路径。

## 174 / 501 L 转盘下半固定 L 下半+Z侧：从外侧插三根蓝长销

3×6558

1. 本页组装尚未接底盘的L 左臂，用独立夹具托稳。A/B和 ±Z为本头局部坐标。
2. 在局部+Z外侧，将#35/#36/#37三根6558分别对准上、中、 下3孔；逐根沿-Z平推。
3. 每根长的2孔段朝内，依次穿框架侧壁与下半凸台端壁； 挡肩停在框架外面，短的1孔段朝+Z外露。
4. 三根分别位于局部Y=-8、0、+8毫米，不省略中间销。此 时不得先装#41侧梁或#86斜撑。

核对：三销肩贴框架外侧，3个短段均外露；下半保持夹具 支承。

真实LDraw网格；爆炸间距仅用于识别，不代表装配间隙或已验证路径。

## 175 / 501 L 转盘下半固定 L 下半-Z侧：从外侧插另三根蓝长销

3×6558

1. 本页组装尚未接底盘的L 左臂，用独立夹具托稳。A/B和 ±Z为本头局部坐标。
2. 输出轴件#24-29仍未装。站到局部-Z侧，把#38/#39/#40逐 根沿+Z装入另3孔。
3. 长的2孔段向内穿框架与凸台，挡肩留在框架外表面；短 的1孔段向-Z外露。
4. 中间#39的直线入口原本与输出轴位置相交，不能在轴组 已接电机时硬插；两侧合计使用6根6558。

核对：两侧各3根6558均到挡肩，无销肩被推过闭合宿主； 输出轴组仍未接。

真实LDraw网格；爆炸间距仅用于识别，不代表装配间隙或已验证路径。

## 176 / 501 L 转盘下半固定 L 中框侧孔：先预插五根黑销

5×2780

1. 本页组装尚未接底盘的L 左臂，用独立夹具托稳。A/B和 ±Z为本头局部坐标。
2. 两根40490侧梁都暂不装。中间64179框的+Z侧只在上、中 两孔预插#42/#43，沿-Z插半根；下孔对应侧梁第8孔，留给 #44长销。
3. -Z侧上、中、下3孔依次预插#46/#47/#48，沿+Z插半根。 所有2780中央挡圈停在框架外面。
4. 五根销另一半朝外露出，稍后由侧梁套住。不能先封梁后 把挡圈强推穿过两层孔。

核对：2＋3共5根黑销；+Z侧最下孔仍空，挡圈全部在框架 外侧。

真实LDraw网格；爆炸间距仅用于识别，不代表装配间隙或已验证路径。

## 177 / 501 L 转盘下半固定 L -Z侧梁：同时套住六个露出销段

1×40490

1. 本页组装尚未接底盘的L 左臂，用独立夹具托稳。A/B和 ±Z为本头局部坐标。
2. 取#45 40490 9L梁，沿墙的上下方向摆正，孔轴沿Z。输出 轴组仍在机外，给侧梁保留直线入口。
3. 从-Z外侧沿+Z平推：从上端数，第1至3孔同时套#38-40短 段，第6至8孔套#46-48黑销；第4、5、9孔不接销。
4. 六孔自然对准后才均匀压到销肩；不要用梁扭转或拉拢错 位的上下框。

核对：9L梁第1-3孔接固定长销、第6-8孔接中框黑销，六处 均贴合。

真实LDraw网格；爆炸间距仅用于识别，不代表装配间隙或已验证路径。

## 178 / 501 L 转盘下半固定 L +Z侧梁：套上三长销和两黑销

1×40490

1. 本页组装尚未接底盘的L 左臂，用独立夹具托稳。A/B和 ±Z为本头局部坐标。
2. 取#41另一根40490 9L梁，从+Z外侧沿-Z靠近墙体；#86斜 撑尚未安装。
3. 从上端数，第1-3孔套#35-37短段，第6/7孔套#42/#43黑销 ，第8孔与中框空孔同轴，留给#44。
4. 先逐处核对5个销尖，再均匀压到挡肩。两侧梁第4、5、9 孔均不接销。

核对：五个连接点齐平，第8孔未被黑销占用；斜撑仍在机 外。

真实LDraw网格；爆炸间距仅用于识别，不代表装配间隙或已验证路径。

## 179 / 501 L 转盘下半固定 L +Z下端长销：留出斜撑连接段

1×6558

1. 本页组装尚未接底盘的L 左臂，用独立夹具托稳。A/B和 ±Z为本头局部坐标。
2. #41梁已在位后，才从+Z外侧沿-Z插入#44 6558；长的2孔 段穿侧梁第8孔并接中框。
3. 挡肩停在侧梁外表面，短的1孔段朝+Z露出，专门用于#86 斜撑第1孔。
4. 不能把#44提前放在框架里再强压侧梁，也不能让它的挡 肩穿过已装斜撑。

核对：#44长段接梁与中框，短段向外；#86还未装。

真实LDraw网格；爆炸间距仅用于识别，不代表装配间隙或已验证路径。

## 180 / 501 L 转盘下半固定 L 斜撑最后：两孔同时套两根销

1×32524

1. 本页组装尚未接底盘的L 左臂，用独立夹具托稳。A/B和 ±Z为本头局部坐标。
2. 确认前面已装的平台黑销#85在位，露出段与#44短段都朝 +Z。取#86 32524七孔梁，保持图示斜向。
3. 从+Z外侧沿-Z平推：第1孔套#44短段，第6孔套平台#85露 出段；两孔中心距5孔距，不能误用第7孔。
4. 两点同时自然对齐后轻压到挡圈。斜撑此时才闭合；不得 用它强拉框架或平台。

核对：斜撑第1/6孔都就位，挡圈留在宿主之间；其余已搭 组件继续独立支承。

真实LDraw网格；爆炸间距仅用于识别，不代表装配间隙或已验证路径。

## 181 / 501 L 墙架／舵机架逐件搭建 L 输出传动：七号轴先入马达

1×44294

1. 本页组装尚未接底盘的L 左臂，用独立夹具托稳。A/B和 ±Z为本头局部坐标。
2. 从夹头侧+X沿-X将44294七号轴插入断电马达输出十字孔 ；保持轴线Y0、Z-40毫米。裸轴进入本体，外部留出套件位 置。
3. 零件和轴套肩位以本图为准；孔位自然匹配后才推进，保 持断电、独立支承。

核对：新装仅本步指定件；其他传动件不重复计数。

真实LDraw网格；爆炸间距仅用于识别，不代表装配间隙或已验证路径。

## 182 / 501 L 墙架／舵机架逐件搭建 L 输出传动：第一只半轴套

1×32123a

1. 本页组装尚未接底盘的L 左臂，用独立夹具托稳。A/B和 ±Z为本头局部坐标。
2. 从+X沿-X套32123a半套，贴到马达输出侧定位面。不得把 轴套推入本体。
3. 零件和轴套肩位以本图为准；孔位自然匹配后才推进，保 持断电、独立支承。

核对：新装仅本步指定件；其他传动件不重复计数。

真实LDraw网格；爆炸间距仅用于识别，不代表装配间隙或已验证路径。

## 183 / 501 L 墙架／舵机架逐件搭建 L 输出传动：第二只半轴套

1×32123a

1. 本页组装尚未接底盘的L 左臂，用独立夹具托稳。A/B和 ±Z为本头局部坐标。
2. 再从+X沿-X套第二只32123a，与第一只相贴。两只半套共 一孔厚。
3. 零件和轴套肩位以本图为准；孔位自然匹配后才推进，保 持断电、独立支承。

核对：新装仅本步指定件；其他传动件不重复计数。

真实LDraw网格；爆炸间距仅用于识别，不代表装配间隙或已验证路径。

## 184 / 501 L 墙架／舵机架逐件搭建 L 输出传动：整轴套

1×3713

1. 本页组装尚未接底盘的L 左臂，用独立夹具托稳。A/B和 ±Z为本头局部坐标。
2. 从+X沿-X套3713整套，贴住前两只半套。与-Z转盘侧梁仅 约0.4毫米名义间隙，遇阻立即停。
3. 零件和轴套肩位以本图为准；孔位自然匹配后才推进，保 持断电、独立支承。

核对：新装仅本步指定件；其他传动件不重复计数。

真实LDraw网格；爆炸间距仅用于识别，不代表装配间隙或已验证路径。

## 185 / 501 L 墙架／舵机架逐件搭建 L 输出传动：二十四齿轮

1×3648b

1. 本页组装尚未接底盘的L 左臂，用独立夹具托稳。A/B和 ±Z为本头局部坐标。
2. 3648b从+X沿-X套上轴并贴住整套。上半转盘还未扣合， 不强扭齿轮咬合。
3. 零件和轴套肩位以本图为准；孔位自然匹配后才推进，保 持断电、独立支承。

核对：新装仅本步指定件；其他传动件不重复计数。

真实LDraw网格；爆炸间距仅用于识别，不代表装配间隙或已验证路径。

## 186 / 501 L 墙架／舵机架逐件搭建 L 输出传动：轴端半套

1×32123a

1. 本页组装尚未接底盘的L 左臂，用独立夹具托稳。A/B和 ±Z为本头局部坐标。
2. 最后从+X沿-X套32123a半套，贴住齿轮前面。核对两半套、 整套、齿轮、末半套的顺序，不能挤压到转动发涩。
3. 零件和轴套肩位以本图为准；孔位自然匹配后才推进，保 持断电、独立支承。

核对：新装仅本步指定件；其他传动件不重复计数。

真实LDraw网格；爆炸间距仅用于识别，不代表装配间隙或已验证路径。

## 187 / 501 L 转盘下半固定 L 转盘与传动：完成动力底架核对

本步合并／核对，无新增件

1. 本页组装尚未接底盘的L 左臂，用独立夹具托稳。A/B和 ±Z为本头局部坐标。
2. 前述步骤已从单件装完90件动力底架，包括墙、电机架、 平台、舵机架、竖支脚、十字块与输出传动。此处不再取零 件。
3. 转盘六根销、两侧梁和斜撑已到位；曲柄与连杆末端仍未 连接，接口81/84仍为散件。
4. 输出轴、半套、整套、齿轮顺序逐项核对；不得将近似舵 机外形或名义小间隙视为实物通过。

核对：90件已引入且无重复；下面继续原夹头流程。

真实LDraw网格；爆炸间距仅用于识别，不代表装配间隙或已验证路径。

## 188 / 501 机械臂组件装配 L 独立搭建-Z侧板组件

1×2780；1×32316；1×32523；1×32524；2×32526；3×6558

1. 本页组装尚未接底盘的L 左臂，用独立夹具托稳。A/B和 ±Z为本头局部坐标。
2. 把#108五孔内梁与#109三孔内梁分别定位；-Z侧五孔段在 局部+Y，三孔段在-Y。将#111～#113三根6558的短段插入内 梁，挡肩留在内梁外侧。
3. 将#106/#107两根32526压到长销的露出段上，长臂沿推杆 方向、短臂朝夹指根轴。先在对应L梁孔预装#114黑销，再 压上#110外侧七孔梁。
4. 三根蓝销贯穿三层；黑销仅连接外侧两层。保留根轴孔及 60483固定孔，组件仍在机外夹具上。

核对：本组件9件；长短内梁位置与图一致，所有销肩留在 宿主接面。

真实LDraw网格；爆炸间距仅用于识别，不代表装配间隙或已验证路径。

## 189 / 501 机械臂组件装配 L 独立搭建+Z侧板组件

1×2780；1×32316；1×32523；1×32524；2×32526；3×6558

1. 本页组装尚未接底盘的L 左臂，用独立夹具托稳。A/B和 ±Z为本头局部坐标。
2. +Z侧长短内梁与上一组件相反：#99五孔段在局部-Y， #100三孔段在+Y。把#102～#104三根6558短段插入内梁。
3. 将#97/#98两根32526压到长销上；先把#105黑销装在对应L 梁孔，再压上#101外侧七孔梁。
4. 本组件暂存机外；先完成另一侧根轴叠层，再把本组件整 体装到转盘。

核对：本组件9件，两个组件共18件。两侧长短段不能照同 一方向复制。

真实LDraw网格；爆炸间距仅用于识别，不代表装配间隙或已验证路径。

## 190 / 501 机械臂组件装配 L 转盘上半与中央导向块就位

1×18938；1×39793

1. 本页组装尚未接底盘的L 左臂，用独立夹具托稳。A/B和 ±Z为本头局部坐标。
2. 取#115有齿转盘上半，正面凸耳朝夹指。将#116导向块从 正面放进两个凸耳之间，中心孔与转盘轴线重合。
3. 导向块两条侧孔对准两侧凸耳上下孔。仅作定位并用夹具 托住，下一步用销连接。

核对：中心孔畅通；凸耳中间孔未用。

真实LDraw网格；爆炸间距仅用于识别，不代表装配间隙或已验证路径。

## 191 / 501 机械臂组件装配 L 先插四根转盘长销

4×6558

1. 本页组装尚未接底盘的L 左臂，用独立夹具托稳。A/B和 ±Z为本头局部坐标。
2. 从两侧凸耳外面各装2根6558，长的2孔段向内穿凸耳并接 导向块。
3. 挡肩贴住凸耳外表面，短的1孔段向外露出，留给侧板后 端。此时两侧板均未装到转盘。

核对：四销都已到挡肩；不能先封侧板再把挡肩强推过孔。

真实LDraw网格；爆炸间距仅用于识别，不代表装配间隙或已验证路径。

## 192 / 501 机械臂组件装配 L 先接-Z侧板，+Z侧保持开放

本步合并／核对，无新增件

1. 本页组装尚未接底盘的L 左臂，用独立夹具托稳。A/B和 ±Z为本头局部坐标。
2. 取已完成的-Z侧板，从局部-Z外侧沿+Z靠近转盘，使两 根L梁的后端孔套住#119/#120露出的短销段。
3. 均匀压到销肩，持续独立托住侧板和转盘。+Z侧板仍单 独放置，不提前封合。

核对：本组件15件；两根根轴从+Z侧仍有装入夹指和整轴 套的空间。

真实LDraw网格；爆炸间距仅用于识别，不代表装配间隙或已验证路径。

## 193 / 501 机械臂组件装配 L A根轴-Z侧：固定销与60483

1×2780；1×60483

1. 本页组装尚未接底盘的L 左臂，用独立夹具托稳。A/B和 ±Z为本头局部坐标。
2. A对应局部+Y。先将#127黑色2780从-Z侧沿+Z插入内梁端 孔半根，挡圈停在内梁外表面。
3. 将#164 60483从同侧装到黑销露出段：圆孔接2780，十字 孔与相邻根轴孔同轴；两孔中心距8毫米。
4. 此时十字孔还没有根轴。夹具托住支架，不能用单销悬挂 它或靠扭转对相位。

核对：60483圆孔已接销，十字孔对根轴线；支架贴合内梁。

真实LDraw网格；爆炸间距仅用于识别，不代表装配间隙或已验证路径。

## 194 / 501 机械臂组件装配 L A根轴：建立穿轴支点

1×32123a；1×3707

1. 本页组装尚未接底盘的L 左臂，用独立夹具托稳。A/B和 ±Z为本头局部坐标。
2. 先把#125半轴套套在#122 8L根轴的-Z端，再沿+Z把轴穿过 60483十字孔与-Z内梁圆孔；夹具保持支架与轴同线。
3. 半套停在60483外侧；根轴伸入尚未封合的+Z侧。根轴十 字相位应自然通过60483，不能旋扭支架来强行咬合。

核对：轴穿过一侧60483和内梁，外侧半套到位；未连接端 由夹具支承。

真实LDraw网格；爆炸间距仅用于识别，不代表装配间隙或已验证路径。

## 195 / 501 机械臂组件装配 L A根轴：依次装整套、夹指、整套

1×32524；2×3713

1. 本页组装尚未接底盘的L 左臂，用独立夹具托稳。A/B和 ±Z为本头局部坐标。
2. 从开放的+Z端，沿-Z依次套上#123整轴套、#121红色7孔 夹指的第4圆孔、#124整轴套。
3. 每只整套厚8毫米；夹指圆孔厚8毫米。三件在两侧内梁之 间构成24毫米叠层，先由夹具支承，不依靠摩擦锁紧。
4. 夹指朝魔方方向，保持本图的正常近闭合分支；图示约 3.84°，不反向翻折。

核对：内侧顺序为整套／夹指圆孔／整套；+Z侧板仍独立 暂存。

真实LDraw网格；爆炸间距仅用于识别，不代表装配间隙或已验证路径。

## 196 / 501 机械臂组件装配 L B根轴-Z侧：固定销与60483

1×2780；1×60483

1. 本页组装尚未接底盘的L 左臂，用独立夹具托稳。A/B和 ±Z为本头局部坐标。
2. B对应局部-Y。先将#135黑色2780从-Z侧沿+Z插入内梁端 孔半根，挡圈停在内梁外表面。
3. 将#166 60483从同侧装到黑销露出段：圆孔接2780，十字 孔与相邻根轴孔同轴；两孔中心距8毫米。
4. 此时十字孔还没有根轴。夹具托住支架，不能用单销悬挂 它或靠扭转对相位。

核对：60483圆孔已接销，十字孔对根轴线；支架贴合内梁。

真实LDraw网格；爆炸间距仅用于识别，不代表装配间隙或已验证路径。

## 197 / 501 机械臂组件装配 L B根轴：建立穿轴支点

1×32123a；1×3707

1. 本页组装尚未接底盘的L 左臂，用独立夹具托稳。A/B和 ±Z为本头局部坐标。
2. 先把#133半轴套套在#130 8L根轴的-Z端，再沿+Z把轴穿过 60483十字孔与-Z内梁圆孔；夹具保持支架与轴同线。
3. 半套停在60483外侧；根轴伸入尚未封合的+Z侧。根轴十 字相位应自然通过60483，不能旋扭支架来强行咬合。

核对：轴穿过一侧60483和内梁，外侧半套到位；未连接端 由夹具支承。

真实LDraw网格；爆炸间距仅用于识别，不代表装配间隙或已验证路径。

## 198 / 501 机械臂组件装配 L B根轴：依次装整套、夹指、整套

1×32524；2×3713

1. 本页组装尚未接底盘的L 左臂，用独立夹具托稳。A/B和 ±Z为本头局部坐标。
2. 从开放的+Z端，沿-Z依次套上#131整轴套、#129红色7孔 夹指的第4圆孔、#132整轴套。
3. 每只整套厚8毫米；夹指圆孔厚8毫米。三件在两侧内梁之 间构成24毫米叠层，先由夹具支承，不依靠摩擦锁紧。
4. 夹指朝魔方方向，保持本图的正常近闭合分支；图示约 3.84°，不反向翻折。

核对：内侧顺序为整套／夹指圆孔／整套；+Z侧板仍独立 暂存。

真实LDraw网格；爆炸间距仅用于识别，不代表装配间隙或已验证路径。

## 199 / 501 机械臂组件装配 L 合上+Z侧板组件

本步合并／核对，无新增件

1. 本页组装尚未接底盘的L 左臂，用独立夹具托稳。A/B和 ±Z为本头局部坐标。
2. 同时托住两根根轴、夹指与四只整轴套。把已完成的+Z 侧板从+Z外侧沿-Z靠近。
3. 侧板前端两个根轴孔分别套住A/B轴；后端两根L梁孔同时 套住#117/#118转盘长销短段，均匀压至销肩。
4. 四处必须自然对齐；不能用侧板把歪斜轴套硬挤进空隙。 若侧板无法无强力就位，停下复核支承和孔向。

核对：两根轴均穿过两侧内梁，四只整轴套与两夹指在位； +Z端60483与半套尚待安装。

真实LDraw网格；爆炸间距仅用于识别，不代表装配间隙或已验证路径。

## 200 / 501 机械臂组件装配 L A根轴+Z侧：装60483

1×2780；1×60483

1. 本页组装尚未接底盘的L 左臂，用独立夹具托稳。A/B和 ±Z为本头局部坐标。
2. 先从+Z外侧沿-Z把#128黑销插入内梁端孔半根，挡圈停在 内梁与支架的接面。
3. 将#165 60483十字孔对根轴、圆孔对黑销，同时平推到位 ；十字孔与圆孔各接合8毫米。保持根轴另一端半套在位。

核对：两点同时贴合；没有推动根轴或把销挡肩强推穿过宿 主。

真实LDraw网格；爆炸间距仅用于识别，不代表装配间隙或已验证路径。

## 201 / 501 机械臂组件装配 L A根轴+Z半套与64毫米叠层

1×32123a

1. 本页组装尚未接底盘的L 左臂，用独立夹具托稳。A/B和 ±Z为本头局部坐标。
2. 从+Z端沿-Z套上#126半轴套，停在60483外侧。不要用半 套压紧夹指或拉拢结构。
3. 从-Z到+Z：半套4＋60483 8＋内梁8＋整套8＋夹指8＋整套 8＋内梁8＋60483 8＋半套4＝64毫米，恰好占满8L根轴。
4. 名义轴向余量为零。自由转动和可靠防脱是否兼容必须实 测；任何卡死、松脱或轴端接合不足都停止。

核对：两端半套齐全；64毫米零名义余量已记录，未把几何 吻合当作实体验收。

真实LDraw网格；爆炸间距仅用于识别，不代表装配间隙或已验证路径。

## 202 / 501 机械臂组件装配 L B根轴+Z侧：装60483

1×2780；1×60483

1. 本页组装尚未接底盘的L 左臂，用独立夹具托稳。A/B和 ±Z为本头局部坐标。
2. 先从+Z外侧沿-Z把#136黑销插入内梁端孔半根，挡圈停在 内梁与支架的接面。
3. 将#167 60483十字孔对根轴、圆孔对黑销，同时平推到位 ；十字孔与圆孔各接合8毫米。保持根轴另一端半套在位。

核对：两点同时贴合；没有推动根轴或把销挡肩强推穿过宿 主。

真实LDraw网格；爆炸间距仅用于识别，不代表装配间隙或已验证路径。

## 203 / 501 机械臂组件装配 L B根轴+Z半套与64毫米叠层

1×32123a

1. 本页组装尚未接底盘的L 左臂，用独立夹具托稳。A/B和 ±Z为本头局部坐标。
2. 从+Z端沿-Z套上#134半轴套，停在60483外侧。不要用半 套压紧夹指或拉拢结构。
3. 从-Z到+Z：半套4＋60483 8＋内梁8＋整套8＋夹指8＋整套 8＋内梁8＋60483 8＋半套4＝64毫米，恰好占满8L根轴。
4. 名义轴向余量为零。自由转动和可靠防脱是否兼容必须实 测；任何卡死、松脱或轴端接合不足都停止。

核对：两端半套齐全；64毫米零名义余量已记录，未把几何 吻合当作实体验收。

真实LDraw网格；爆炸间距仅用于识别，不代表装配间隙或已验证路径。

## 204 / 501 机械臂组件装配 L A轮胎与轮毂预装

1×42610；1×50945_nominal

1. 本页组装尚未接底盘的L 左臂，用独立夹具托稳。A/B和 ±Z为本头局部坐标。
2. 把#145轮胎套在#144轮毂上，确认胎圈均匀就座。将这2 件组件暂存在机外。
3. 每臂两组独立轮胎压头；轮胎网格是名义14×6毫米尺寸 ，实际橡胶形变和摩擦未验证。

核对：2件组件同心，轮毂中孔保持畅通。

真实LDraw网格；爆炸间距仅用于识别，不代表装配间隙或已验证路径。

## 205 / 501 机械臂组件装配 L A压头：先装-Z薄梁与两连接点

1×32054；1×32123a；1×32449；1×4519

1. 本页组装尚未接底盘的L 左臂，用独立夹具托稳。A/B和 ±Z为本头局部坐标。
2. 把#137四孔薄梁贴在红色夹指-Z侧。薄梁第1十字孔对夹 指第6孔，用#139 3L轴贯穿，并在-Z端加#140半套。
3. 薄梁第2圆孔对夹指第7孔，从-Z侧插#142 32054，挡套停 在第一根薄梁外侧；露出的轴和销给另一侧薄梁使用。
4. 薄梁第3圆孔留空，第4十字孔用于轮轴；+Z侧薄梁下一 步安装。

核对：薄梁由两个连接点定位，挡套在正确外侧；轮胎组件 仍单独托住。

真实LDraw网格；爆炸间距仅用于识别，不代表装配间隙或已验证路径。

## 206 / 501 机械臂组件装配 L A压头：轮轴、轮胎与+Z薄梁

1×32062；1×32123a；1×32449

1. 本页组装尚未接底盘的L 左臂，用独立夹具托稳。A/B和 ±Z为本头局部坐标。
2. 把#143 2L轮轴穿过-Z薄梁第4十字孔，套入已准备的轮胎 ／轮毂组件；轮毂位于夹指中面。
3. 把#138 +Z薄梁同时对准3L轴、32054销和2L轮轴三个连接 点，沿-Z平直压到位，再在3L轴+Z端套#141半套。
4. 2L轮轴两端与薄梁外侧齐平，不加外轴套。检查轮毂能绕 固定轴自由转动；不能靠挤压薄梁消除间隙。

核对：本夹指轮胎压头9件齐全，两个3L轴半套和32054挡套 到位。

真实LDraw网格；爆炸间距仅用于识别，不代表装配间隙或已验证路径。

## 207 / 501 机械臂组件装配 L B轮胎与轮毂预装

1×42610；1×50945_nominal

1. 本页组装尚未接底盘的L 左臂，用独立夹具托稳。A/B和 ±Z为本头局部坐标。
2. 把#154轮胎套在#153轮毂上，确认胎圈均匀就座。将这2 件组件暂存在机外。
3. 每臂两组独立轮胎压头；轮胎网格是名义14×6毫米尺寸 ，实际橡胶形变和摩擦未验证。

核对：2件组件同心，轮毂中孔保持畅通。

真实LDraw网格；爆炸间距仅用于识别，不代表装配间隙或已验证路径。

## 208 / 501 机械臂组件装配 L B压头：先装-Z薄梁与两连接点

1×32054；1×32123a；1×32449；1×4519

1. 本页组装尚未接底盘的L 左臂，用独立夹具托稳。A/B和 ±Z为本头局部坐标。
2. 把#146四孔薄梁贴在红色夹指-Z侧。薄梁第1十字孔对夹 指第6孔，用#148 3L轴贯穿，并在-Z端加#149半套。
3. 薄梁第2圆孔对夹指第7孔，从-Z侧插#151 32054，挡套停 在第一根薄梁外侧；露出的轴和销给另一侧薄梁使用。
4. 薄梁第3圆孔留空，第4十字孔用于轮轴；+Z侧薄梁下一 步安装。

核对：薄梁由两个连接点定位，挡套在正确外侧；轮胎组件 仍单独托住。

真实LDraw网格；爆炸间距仅用于识别，不代表装配间隙或已验证路径。

## 209 / 501 机械臂组件装配 L B压头：轮轴、轮胎与+Z薄梁

1×32062；1×32123a；1×32449

1. 本页组装尚未接底盘的L 左臂，用独立夹具托稳。A/B和 ±Z为本头局部坐标。
2. 把#152 2L轮轴穿过-Z薄梁第4十字孔，套入已准备的轮胎 ／轮毂组件；轮毂位于夹指中面。
3. 把#147 +Z薄梁同时对准3L轴、32054销和2L轮轴三个连接 点，沿-Z平直压到位，再在3L轴+Z端套#150半套。
4. 2L轮轴两端与薄梁外侧齐平，不加外轴套。检查轮毂能绕 固定轴自由转动；不能靠挤压薄梁消除间隙。

核对：本夹指轮胎压头9件齐全，两个3L轴半套和32054挡套 到位。

真实LDraw网格；爆炸间距仅用于识别，不代表装配间隙或已验证路径。

## 210 / 501 机械臂组件装配 L 先把无摩擦销各插入夹指半根

2×3673

1. 本页组装尚未接底盘的L 左臂，用独立夹具托稳。A/B和 ±Z为本头局部坐标。
2. 两根黄色连杆尚未接到夹指。A夹指第2孔先从+Z侧沿-Z 插#160灰色3673半根；B夹指第2孔从-Z侧沿+Z插#162半根。
3. 两个中央挡圈都留在夹指外表面，销的另一半露出，供下 一步各自的连杆圆孔套接。
4. 夹指和已装头部由夹具支承。不能把销推穿夹指后再把挡 圈强推通过连杆。

核对：A/B两销肩分别在+Z/-Z夹指外表面，露出段方向相 反。

真实LDraw网格；爆炸间距仅用于识别，不代表装配间隙或已验证路径。

## 211 / 501 机械臂组件装配 L 两根黄色连杆分别从各自外侧套销

2×32316

1. 本页组装尚未接底盘的L 左臂，用独立夹具托稳。A/B和 ±Z为本头局部坐标。
2. 先从+Z外侧沿-Z把#159连杆一端套到A销#160的露出段， 直到与夹指之间的销肩接触。
3. 再从-Z外侧沿+Z把#161连杆一端套到B销#162的露出段。 两根连杆分别装入，不把它们预先连成刚性组件一起硬推。
4. 两连杆自由端由夹具托在十字接头位置。保持正常近闭合 分支；下一步用横轴连接中间三个孔。

核对：两销肩停在各自的夹指与连杆接面，连杆可绕无摩擦 销转动。

真实LDraw网格；爆炸间距仅用于识别，不代表装配间隙或已验证路径。

## 212 / 501 机械臂组件装配 L 连接十字接头横轴与两端半套

1×32013；2×32123a；1×3705

1. 本页组装尚未接底盘的L 左臂，用独立夹具托稳。A/B和 ±Z为本头局部坐标。
2. 用夹具保持两连杆自由端同轴，在中间放#155 32013，横 圆孔对准两个连杆端孔，纵向十字孔朝后接推杆。
3. 在#156 4L横轴-Z端预套#157半套；从-Z沿+Z依次穿过#161 连杆、32013横圆孔和#159连杆，再从+Z端套#158半套。
4. 轴本体穿圆孔，无销挡肩经过闭合孔。两半套停在连杆外 侧，不能压死连杆；十字接头在两连杆朝魔方的一端。

核对：横轴与两端半套齐全，三处圆孔自然同轴；纵向十字 孔仍畅通。

真实LDraw网格；爆炸间距仅用于识别，不代表装配间隙或已验证路径。

## 213 / 501 机械臂组件装配 L 离机接合机械头与90件动力核心

本步合并／核对，无新增件

1. 本页组装尚未接底盘的L 左臂，用独立夹具托稳。A/B和 ±Z为本头局部坐标。
2. 转盘下半固定及轴组接入已按前述步骤完成，90件动力底 架、机械头及未闭合的曲柄／连杆分别独立支承。将转盘上 半对准核心的下半扣合；同时保持齿轮与转盘的名义啮合位 置。
3. #94曲柄端轴和#95半套尚未安装，因此黄色舵机连杆不会 把推杆强制锁在舵机角度上。
4. 此时整臂仍在底盘外，#81侧梁和#84底框销仍在专格。扣 合所需空间、卡扣力及实体啮合必须另行验证。

核对：转盘上下半及导向孔同轴；曲柄与连杆未连接，推杆 通道未封闭。

真实LDraw网格；爆炸间距仅用于识别，不代表装配间隙或已验证路径。

## 214 / 501 机械臂组件装配 L 从后方穿12L推杆及两只半套

2×32123a；1×3708

1. 本页组装尚未接底盘的L 左臂，用独立夹具托稳。A/B和 ±Z为本头局部坐标。
2. 把#88/#89两只半套分别用夹具定位在十字块#87的前后， 孔轴线对准导向框前孔；曲柄端仍不连接。
3. #163 12L轴从平台后方沿+X穿入：导向框后孔只借道，再 依次通过后半套、十字块圆孔、前半套、导向框前孔、转盘 中心及#116导向块，最后插进#155十字孔到底。
4. 图示为完成位置，后导向孔不承载推杆。自然移动未连接 的十字块／连杆帮助对孔，不反驱舵机；两半套不把滑动机 构夹死。

核对：推杆前端名义进入十字接头8毫米；两个导向处畅通、 两半套就位。

真实LDraw网格；爆炸间距仅用于识别，不代表装配间隙或已验证路径。

## 215 / 501 机械臂组件装配 L 匹配名义姿态后连接曲柄端

1×32062；1×32123a

1. 本页组装尚未接底盘的L 左臂，用独立夹具托稳。A/B和 ±Z为本头局部坐标。
2. 先核对舵机曲柄#93已由另行验证的定位流程处于所需姿 态。本页仅表达断电、空载、孔位自然对齐时的机械连接； 不提供上电归零或脉宽标定。
3. 保持夹指和推杆在图示正常近闭合分支，让#96连杆端孔 与曲柄末端孔自然同轴，再插#94 2L轴：外端与曲柄外面齐 平；内端装#95半套贴住连杆。
4. 孔位不自然重合、需要硬拉连杆或反驱舵机时立即停止， 保持分离和支承，等待专门定位／标定；不能把本页当作定 位已完成的证据。

核对：只有预先满足自然对孔条件才记录此步完成；否则整 臂仍标为待验证。

真实LDraw网格；爆炸间距仅用于识别，不代表装配间隙或已验证路径。

## 216 / 501 机械臂组件装配 L 单臂165件待接底盘，2件留待接口

本步合并／核对，无新增件

1. 本页组装尚未接底盘的L 左臂，用独立夹具托稳。A/B和 ±Z为本头局部坐标。
2. 核对已完成的90件动力底架与75件夹头件共165件；每头4 件60483、2根8L根轴、4只根轴整套、4只根轴外半套和4枚 支架固定销齐全。
3. #81 40490侧梁与#84 2780销保持散件状态，待整臂落到底 盘后先装#84、再装#81，使每臂达到167件；不要提前装这 两件。
4. R、L、F、B四臂分别在机外完成同一局部流程。各臂独 立记录；四臂最终合计668件，不以一个臂通过代替其余三 臂。
5. 64毫米根轴叠层零名义余量；夹指正常约3.84°～25°。 装配路径、保持、载荷、控制联锁和实体开合均未放行。

核对：165件在位＋2件专格＝167件／臂；不插电、不带魔 方，仍需实体验证。

真实LDraw网格；爆炸间距仅用于识别，不代表装配间隙或已验证路径。

## 217 / 501 F 墙架／舵机架逐件搭建 F 从散件开始：放好竖墙下框

1×64179

1. 本页组装尚未接底盘的F 前臂，用独立夹具托稳。A/B和 ±Z为本头局部坐标。
2. 每臂从167个清单单件开始，包括成品电机和舵机；没有 预装核心或隐藏轴组。逐项取件，81侧梁和84销留到底盘阶 段。
3. 取第一块64179作为最下层框架，墙面在YZ平面，长边沿 Z。用夹具托住，后续向-Y上方逐层搭墙。
4. 本册覆盖全部清单件的装配顺序，不拆成品电机/舵机内 部；名义几何不等于实体装配通过。

核对：本步仅1块下框#3，孔向和编号与图一致。

真实LDraw网格；爆炸间距仅用于识别，不代表装配间隙或已验证路径。

## 218 / 501 F 墙架／舵机架逐件搭建 F 竖墙：下框上缘预插三销

3×2780

1. 本页组装尚未接底盘的F 前臂，用独立夹具托稳。A/B和 ±Z为本头局部坐标。
2. 取三根2780，从-Y上方沿+Y向下框#3上缘各插半根，位置 为局部Z=-16、0、+16毫米。
3. 中央挡圈留在上缘外面；中框未装，不能把销肩推过两层 孔。

核对：三根等高，另一半朝-Y外露。

真实LDraw网格；爆炸间距仅用于识别，不代表装配间隙或已验证路径。

## 219 / 501 F 墙架／舵机架逐件搭建 F 竖墙：压上中框

1×64179

1. 本页组装尚未接底盘的F 前臂，用独立夹具托稳。A/B和 ±Z为本头局部坐标。
2. 取第二块64179，长边沿Z，与下框保持同一墙面。
3. 从-Y上方沿+Y将中框下缘的三孔同时套住#7-9，均匀压到 挡圈。

核对：两框接缝平直，三销都连接相邻框。

真实LDraw网格；爆炸间距仅用于识别，不代表装配间隙或已验证路径。

## 220 / 501 F 墙架／舵机架逐件搭建 F 竖墙：中框上缘预插三销

3×2780

1. 本页组装尚未接底盘的F 前臂，用独立夹具托稳。A/B和 ±Z为本头局部坐标。
2. 从-Y上方沿+Y向中框#2上缘预插三根2780半根。
3. 仍用Z=-16、0、+16毫米三个位置，保留挡圈在框外。

核对：三个销尖朝-Y。

真实LDraw网格；爆炸间距仅用于识别，不代表装配间隙或已验证路径。

## 221 / 501 F 墙架／舵机架逐件搭建 F 竖墙：压上顶框

1×64179

1. 本页组装尚未接底盘的F 前臂，用独立夹具托稳。A/B和 ±Z为本头局部坐标。
2. 顶框64179长边沿Z，墙面与下面两框齐平。
3. 从-Y沿+Y套住#4-6三销；三块框的开口都保持畅通。

核对：三框九件完整，后续转盘放入最上框开口。

真实LDraw网格；爆炸间距仅用于识别，不代表装配间隙或已验证路径。

## 222 / 501 F 墙架／舵机架逐件搭建 F 墙脚：先半插两枚接口销

2×2780

1. 本页组装尚未接底盘的F 前臂，用独立夹具托稳。A/B和 ±Z为本头局部坐标。
2. 将墙倒置支承，从最下框#3底缘沿-Y各插半根2780。
3. 中央挡圈位于最终墙/底盘接缝Y100毫米；另一半朝+Y。 此时不取底盘。

核对：两枚销随墙保留，落底盘时不重复取件。

真实LDraw网格；爆炸间距仅用于识别，不代表装配间隙或已验证路径。

## 223 / 501 F 墙架／舵机架逐件搭建 F 马达：识别成品本体

1×95658

1. 本页组装尚未接底盘的F 前臂，用独立夹具托稳。A/B和 ±Z为本头局部坐标。
2. 取95658成品马达，保持断电，电线避开孔位。
3. 输出轴线沿X，本体在-Z侧；按图识别底面三圆孔和颈部 圆孔，不拆电机内部。

核对：型号与朝向一致，孔位没有被线缆遮住。

真实LDraw网格；爆炸间距仅用于识别，不代表装配间隙或已验证路径。

## 224 / 501 F 墙架／舵机架逐件搭建 F 马达底部：三枚销先入本体

3×2780

1. 本页组装尚未接底盘的F 前臂，用独立夹具托稳。A/B和 ±Z为本头局部坐标。
2. 把马达底面朝上，三孔沿X排列。
3. 每孔一根2780，只插半根，挡圈留在本体外侧；三销最终 向+Y露出。

核对：三销在同一平面。

真实LDraw网格；爆炸间距仅用于识别，不代表装配间隙或已验证路径。

## 225 / 501 F 墙架／舵机架逐件搭建 F 马达底块：第一根五孔梁

1×32316

1. 本页组装尚未接底盘的F 前臂，用独立夹具托稳。A/B和 ±Z为本头局部坐标。
2. 取32316五孔梁，长向沿X。
3. 从+Y沿-Y使第2、3、4孔套住三枚底销，压至挡圈。

核对：第1、5孔保持空着。

真实LDraw网格；爆炸间距仅用于识别，不代表装配间隙或已验证路径。

## 226 / 501 F 墙架／舵机架逐件搭建 F 马达底块：两端预插销

2×2780

1. 本页组装尚未接底盘的F 前臂，用独立夹具托稳。A/B和 ±Z为本头局部坐标。
2. 在第一根五孔梁第1、5孔，从+Y沿-Y各插半根2780。
3. 挡圈留在梁外，露出半根给第二层梁。

核对：两销间距四孔距。

真实LDraw网格；爆炸间距仅用于识别，不代表装配间隙或已验证路径。

## 227 / 501 F 墙架／舵机架逐件搭建 F 马达底块：第二根五孔梁

1×32316

1. 本页组装尚未接底盘的F 前臂，用独立夹具托稳。A/B和 ±Z为本头局部坐标。
2. 第二根32316与第一根平行对齐。
3. 从+Y沿-Y套住两端销，形成两层底块；中间孔保留给底 盘接口。

核对：两层梁贴合，无销肩穿过闭合双层。

真实LDraw网格；爆炸间距仅用于识别，不代表装配间隙或已验证路径。

## 228 / 501 F 墙架／舵机架逐件搭建 F 马达颈部：先放长短两销

1×2780；1×6558

1. 本页组装尚未接底盘的F 前臂，用独立夹具托稳。A/B和 ±Z为本头局部坐标。
2. 颈部上圆孔放6558#18，短段向-X入本体，挡肩留外；长 段向+X。
3. 下圆孔放2780#19半根；中间十字孔不要误用。

核对：上蓝长销、下黑短销均露出到同侧。

真实LDraw网格；爆炸间距仅用于识别，不代表装配间隙或已验证路径。

## 229 / 501 F 墙架／舵机架逐件搭建 F 马达前架：竖装三孔梁

1×32523

1. 本页组装尚未接底盘的F 前臂，用独立夹具托稳。A/B和 ±Z为本头局部坐标。
2. 取32523三孔梁，长向沿Y，孔轴沿X。
3. 从+X沿-X套上#18/#19，分别使用上下两孔，中孔保持空。

核对：三孔梁贴住销肩。

真实LDraw网格；爆炸间距仅用于识别，不代表装配间隙或已验证路径。

## 230 / 501 F 墙架／舵机架逐件搭建 F 马达前架：中孔预插黑销

1×2780

1. 本页组装尚未接底盘的F 前臂，用独立夹具托稳。A/B和 ±Z为本头局部坐标。
2. 在三孔梁中孔，从+X沿-X插入2780半根。
3. 露出半根向+X，给下方横梁使用。

核对：不要占用颈部十字孔。

真实LDraw网格；爆炸间距仅用于识别，不代表装配间隙或已验证路径。

## 231 / 501 F 墙架／舵机架逐件搭建 F 马达前架：接十一孔横梁

1×32525

1. 本页组装尚未接底盘的F 前臂，用独立夹具托稳。A/B和 ±Z为本头局部坐标。
2. 32525长向沿Z，向墙体伸出。
3. 第1孔从+X沿-X套住上方#18长销的剩余段；三孔竖梁与横 梁各占一孔厚。

核对：蓝销长段连接两根梁。

真实LDraw网格；爆炸间距仅用于识别，不代表装配间隙或已验证路径。

## 232 / 501 F 墙架／舵机架逐件搭建 F 马达前架：接七孔横梁

1×32524

1. 本页组装尚未接底盘的F 前臂，用独立夹具托稳。A/B和 ±Z为本头局部坐标。
2. 32524七孔梁与十一孔梁平行。
3. 第1孔从+X沿-X套住中间#21黑销。

核对：两横梁分别位于局部Y16、24毫米。

真实LDraw网格；爆炸间距仅用于识别，不代表装配间隙或已验证路径。

## 233 / 501 F 墙架／舵机架逐件搭建 F 马达接墙：四销先入横梁

4×2780

1. 本页组装尚未接底盘的F 前臂，用独立夹具托稳。A/B和 ±Z为本头局部坐标。
2. 从马达端数，十一孔梁第6、8、10孔接#30/#31/#32；七孔 梁第6孔接#33。
3. 四根2780从+X沿-X半插横梁，挡圈留在梁前；销尖向+X。

核对：三销接顶框，一销接中框；输出轴组尚未装。

真实LDraw网格；爆炸间距仅用于识别，不代表装配间隙或已验证路径。

## 234 / 501 F 墙架／舵机架逐件搭建 F 马达接墙：平推合拢

本步合并／核对，无新增件

1. 本页组装尚未接底盘的F 前臂，用独立夹具托稳。A/B和 ±Z为本头局部坐标。
2. 取刚搭好的完整马达组件，保持四销在横梁内，不再取销。
3. 从墙背面局部-X沿+X平推，四销同时进入墙孔；墙与马 达继续由夹具托住。

核对：四销肩留在横梁/墙之间；不装输出轴。

真实LDraw网格；爆炸间距仅用于识别，不代表装配间隙或已验证路径。

## 235 / 501 F 墙架／舵机架逐件搭建 F 舵机平台：平放两根十五孔梁

2×32278

1. 本页组装尚未接底盘的F 前臂，用独立夹具托稳。A/B和 ±Z为本头局部坐标。
2. 两根32278平行，长向沿X，相距四孔距。
3. 以夹具保持两梁前后端齐平；此时它们尚未连接。

核对：梁中心分别为Z0、32毫米，孔轴沿Y。

真实LDraw网格；爆炸间距仅用于识别，不代表装配间隙或已验证路径。

## 236 / 501 F 墙架／舵机架逐件搭建 F 平台前部：六枚销先入底梁

6×2780

1. 本页组装尚未接底盘的F 前臂，用独立夹具托稳。A/B和 ±Z为本头局部坐标。
2. 两根15L从最后端向前数：+Z梁第9、11、13、15孔各半插 2780；Z0梁第9、15孔各半插一根。
3. 销由-Y上方沿+Y插入梁，挡圈留在梁上；两蓝长销位置 暂空。

核对：4＋2共六销；全部露出朝-Y。

真实LDraw网格；爆炸间距仅用于识别，不代表装配间隙或已验证路径。

## 237 / 501 F 墙架／舵机架逐件搭建 F 平台前部：压上水平框架

1×64179

1. 本页组装尚未接底盘的F 前臂，用独立夹具托稳。A/B和 ±Z为本头局部坐标。
2. 64179平放，长边沿X，前端与两根十五孔梁对齐。
3. 从-Y沿+Y压到六枚销上，保持长销专用两孔空着。

核对：框架与两梁闭合，六销肩在夹层。

真实LDraw网格；爆炸间距仅用于识别，不代表装配间隙或已验证路径。

## 238 / 501 F 墙架／舵机架逐件搭建 F 舵机垫梁：先插三枚黑销

3×2780

1. 本页组装尚未接底盘的F 前臂，用独立夹具托稳。A/B和 ±Z为本头局部坐标。
2. 在+Z的15L底梁，从最后端孔向前数第2、6、7孔半插2780 ；它们对应稍后7L垫梁的第1、5、6孔。15L第1孔留给后横 梁。
3. 从-Y沿+Y装销，垫梁第2、4孔下方留给55615，不增贯穿 销。

核对：三销不占舵机耳销第3、7孔。

真实LDraw网格；爆炸间距仅用于识别，不代表装配间隙或已验证路径。

## 239 / 501 F 墙架／舵机架逐件搭建 F 舵机垫梁：压上七孔梁

1×32524

1. 本页组装尚未接底盘的F 前臂，用独立夹具托稳。A/B和 ±Z为本头局部坐标。
2. 取32524七孔梁，与底梁平行。
3. 从-Y沿+Y套住三销；从后端数第3、7孔保持空着。

核对：垫梁只由三枚黑销连接底梁。

真实LDraw网格；爆炸间距仅用于识别，不代表装配间隙或已验证路径。

## 240 / 501 F 墙架／舵机架逐件搭建 F 平台后横梁：两端预插销

2×2780

1. 本页组装尚未接底盘的F 前臂，用独立夹具托稳。A/B和 ±Z为本头局部坐标。
2. 两根十五孔梁各在最后一个孔从-Y沿+Y半插2780。
3. 销尖均向上，给横向五孔梁使用。

核对：两销同高，相距四孔距。

真实LDraw网格；爆炸间距仅用于识别，不代表装配间隙或已验证路径。

## 241 / 501 F 墙架／舵机架逐件搭建 F 平台后横梁：闭合长方形

1×32316

1. 本页组装尚未接底盘的F 前臂，用独立夹具托稳。A/B和 ±Z为本头局部坐标。
2. 32316五孔梁长向沿Z。
3. 从-Y沿+Y将两端孔套在#68/#69上，后框闭合。

核对：两梁前后都有横向连接。

真实LDraw网格；爆炸间距仅用于识别，不代表装配间隙或已验证路径。

## 242 / 501 F 墙架／舵机架逐件搭建 F 平台下方：装两个弯角连接器

2×55615

1. 本页组装尚未接底盘的F 前臂，用独立夹具托稳。A/B和 ±Z为本头局部坐标。
2. 两只55615的横臂顺X、竖臂朝+Y下方。
3. 从+Y下方向-Y压入：马达侧底梁倒数第2、4孔；舵机侧 倒数第3、5孔。使用连接器自带销，不另加销。

核对：两连接器竖臂孔沿Z，自带多余横销保持空置。

真实LDraw网格；爆炸间距仅用于识别，不代表装配间隙或已验证路径。

## 243 / 501 F 墙架／舵机架逐件搭建 F 推杆导向：先插两根蓝长销

2×6558

1. 本页组装尚未接底盘的F 前臂，用独立夹具托稳。A/B和 ±Z为本头局部坐标。
2. 从-Y沿+Y把6558长的两孔段穿平台框并插入Z0底梁。
3. 挡肩停在平台框上表面，短段朝-Y；导向框尚未装，销肩 不能穿过其底孔。

核对：长段连接平台两层，短段露出供导向框。

真实LDraw网格；爆炸间距仅用于识别，不代表装配间隙或已验证路径。

## 244 / 501 F 墙架／舵机架逐件搭建 F 推杆导向：最后压上竖框

1×64179

1. 本页组装尚未接底盘的F 前臂，用独立夹具托稳。A/B和 ±Z为本头局部坐标。
2. 64179竖立在XY平面，长向沿X，孔轴沿Z。
3. 从-Y沿+Y将底边两个侧孔套住#64/#65短段；导向圆孔朝 推杆轴线。

核对：导向框两销到肩，中央开口未被连杆或舵机封住。

真实LDraw网格；爆炸间距仅用于识别，不代表装配间隙或已验证路径。

## 245 / 501 F 墙架／舵机架逐件搭建 F 十字块：放入导向框开口

1×6536

1. 本页组装尚未接底盘的F 前臂，用独立夹具托稳。A/B和 ±Z为本头局部坐标。
2. 6536十字块圆孔在上，下面十字孔沿Z。
3. 舵机尚未装，把十字块从+Z沿-Z放入导向框中央开口， 以夹具托住；不靠推杆悬挂。

核对：框内名义余量约0.4毫米，遇阻停止，不磨件。

真实LDraw网格；爆炸间距仅用于识别，不代表装配间隙或已验证路径。

## 246 / 501 F 墙架／舵机架逐件搭建 F 十字块：穿入三号轴

1×4519

1. 本页组装尚未接底盘的F 前臂，用独立夹具托稳。A/B和 ±Z为本头局部坐标。
2. 4519三号轴从+Z沿-Z穿过下方十字孔。
3. -Z端留半孔给半轴套，+Z端留出连杆和另一只半轴套厚 度。

核对：轴不穿上方推杆圆孔。

真实LDraw网格；爆炸间距仅用于识别，不代表装配间隙或已验证路径。

## 247 / 501 F 墙架／舵机架逐件搭建 F 十字块：后侧半套定位

1×32123a

1. 本页组装尚未接底盘的F 前臂，用独立夹具托稳。A/B和 ±Z为本头局部坐标。
2. 从-Z沿+Z装32123a半轴套，贴住十字块后侧。
3. 十字块继续独立支承，不与导向框固连。

核对：后侧半套贴合而不挤压框架。

真实LDraw网格；爆炸间距仅用于识别，不代表装配间隙或已验证路径。

## 248 / 501 F 墙架／舵机架逐件搭建 F 舵机连杆：先接十字块端

1×32524

1. 本页组装尚未接底盘的F 前臂，用独立夹具托稳。A/B和 ±Z为本头局部坐标。
2. 32524七孔连杆的前端第1孔从+Z沿-Z套住三号轴。
3. 连杆直接贴十字块+Z面，不在两者中间加轴套；第7孔朝 舵机端且保持未连接。

核对：连杆在导向框外侧，舵机还未挡住来路。

真实LDraw网格；爆炸间距仅用于识别，不代表装配间隙或已验证路径。

## 249 / 501 F 墙架／舵机架逐件搭建 F 舵机连杆：外侧半套定位

1×32123a

1. 本页组装尚未接底盘的F 前臂，用独立夹具托稳。A/B和 ±Z为本头局部坐标。
2. 从+Z沿-Z套上32123a，贴住连杆外面。
3. 连杆远端继续由夹具支承，不提前接曲柄。

核对：半套4＋十字块8＋连杆8＋半套4＝24毫米，轴向零名 义余量；勿夹死连杆。

真实LDraw网格；爆炸间距仅用于识别，不代表装配间隙或已验证路径。

## 250 / 501 F 墙架／舵机架逐件搭建 F 舵机耳销：先短段入垫梁

2×6558

1. 本页组装尚未接底盘的F 前臂，用独立夹具托稳。A/B和 ±Z为本头局部坐标。
2. 两根6558短的一孔段从-Y沿+Y插入垫梁第3、7孔。
3. 挡肩留在垫梁上，长段向-Y；舵机未放，不能从上方把销 肩强推穿耳孔。

核对：两根蓝长销竖直，舵机来路保持空。

真实LDraw网格；爆炸间距仅用于识别，不代表装配间隙或已验证路径。

## 251 / 501 F 墙架／舵机架逐件搭建 F 舵机：机外核对成品本体

1×geekservo

1. 本页组装尚未接底盘的F 前臂，用独立夹具托稳。A/B和 ±Z为本头局部坐标。
2. 取成品geekservo，保持断电，暂不套入平台耳销。
3. 输出端朝图示连杆侧；先在机外接曲柄，再连同曲柄一起 落位，避免曲柄横向穿入被连杆挡住。
4. 舵机网格为近似外形，耳孔和输出配合必须对照实物核验。

核对：舵机单独支承，不拆本体内部。

真实LDraw网格；爆炸间距仅用于识别，不代表装配间隙或已验证路径。

## 252 / 501 F 墙架／舵机架逐件搭建 F 曲柄：机外条件定位后接舵机

1×41677

1. 本页组装尚未接底盘的F 前臂，用独立夹具托稳。A/B和 ±Z为本头局部坐标。
2. 41677曲柄从-Z沿+Z套向舵机输出端，末端孔仍不接连杆。
3. 仅在另行验证的断电输出轴位和接口匹配条件下自然套合 ；不能为追图示角度强扭舵机。
4. 近似舵机网格不证明真实输出花键/转接配合。未能自然 配合时保持待验证，不继续闭链。

核对：机外只接曲柄根部，整组独立支承。

真实LDraw网格；爆炸间距仅用于识别，不代表装配间隙或已验证路径。

## 253 / 501 F 墙架／舵机架逐件搭建 F 舵机与曲柄：整组沿耳销落位

本步合并／核对，无新增件

1. 本页组装尚未接底盘的F 前臂，用独立夹具托稳。A/B和 ±Z为本头局部坐标。
2. 取刚接好的舵机/曲柄两件组，保持相对方向，不重复取 件。
3. 从-Y沿+Y将舵机耳孔套住#73/#74两根蓝销长段，直到挡 肩；曲柄从连杆外侧经过，末端保持未连接。
4. 不能改成先落舵机、再横穿曲柄：已放好的连杆会挡住曲 柄入口。实际接口与耳孔遇阻立即停。

核对：两耳到肩、曲柄在连杆外侧，94/95仍未装。

真实LDraw网格；爆炸间距仅用于识别，不代表装配间隙或已验证路径。

## 254 / 501 F 墙架／舵机架逐件搭建 F 平台接墙：两枚销先入平台

2×2780

1. 本页组装尚未接底盘的F 前臂，用独立夹具托稳。A/B和 ±Z为本头局部坐标。
2. 平台仍未接墙，从前端+X沿-X向局部Z8、24毫米的端孔 半插2780，中间孔留空。已接舵机和曲柄仍保持在位。
3. 挡圈在平台前沿，露出半根向+X；这些销随后进入墙中 框，不穿闭合双层。

核对：两销轴线为X，不能与导向蓝销混用。

真实LDraw网格；爆炸间距仅用于识别，不代表装配间隙或已验证路径。

## 255 / 501 F 墙架／舵机架逐件搭建 F 平台接墙：从背面平推

本步合并／核对，无新增件

1. 本页组装尚未接底盘的F 前臂，用独立夹具托稳。A/B和 ±Z为本头局部坐标。
2. 取已搭平台、舵机、曲柄及连杆，省略的已接件仍在位； 继续用夹具托住连杆远端。
3. 从墙背面-X沿+X平推，两销进入中框；导向轴线与转盘 中心线保持同轴。

核对：平台和马达分别用各自销接墙，无重复取件。

真实LDraw网格；爆炸间距仅用于识别，不代表装配间隙或已验证路径。

## 256 / 501 F 墙架／舵机架逐件搭建 F 后竖撑：先给马达侧连接器插销

2×2780

1. 本页组装尚未接底盘的F 前臂，用独立夹具托稳。A/B和 ±Z为本头局部坐标。
2. 在马达侧55615#70的两孔，从-Z沿+Z半插两枚2780。
3. 挡圈留在-Z外面，露出销尖给9L竖梁。

核对：销位Y40、56毫米，两销向-Z露出。

真实LDraw网格；爆炸间距仅用于识别，不代表装配间隙或已验证路径。

## 257 / 501 F 墙架／舵机架逐件搭建 F 后竖撑：装马达侧九孔梁

1×40490

1. 本页组装尚未接底盘的F 前臂，用独立夹具托稳。A/B和 ±Z为本头局部坐标。
2. 40490竖向沿Y，从-Z沿+Z套住#79/#80。
3. 上方第2、4孔接两销，梁下端保持空，下一步接底脚。

核对：竖梁孔轴沿Z，底部第7、9孔可接近。

真实LDraw网格；爆炸间距仅用于识别，不代表装配间隙或已验证路径。

## 258 / 501 F 墙架／舵机架逐件搭建 F 后竖撑：底部弯角脚横插

1×55615

1. 本页组装尚未接底盘的F 前臂，用独立夹具托稳。A/B和 ±Z为本头局部坐标。
2. 55615底脚此时在机外，两个横销朝-Z。
3. 从+Z沿-Z把自带两销插入#78第7、9孔；底脚另外两销朝 +Y，留待整臂竖直落到底盘。
4. 底盘此时不得另装同一底脚；这件随臂移动，落座时不重 复取件。

核对：横销先接竖梁，下销仅作将来底盘接口。

真实LDraw网格；爆炸间距仅用于识别，不代表装配间隙或已验证路径。

## 259 / 501 F 墙架／舵机架逐件搭建 F 另一竖撑：只预插上端两销

2×2780

1. 本页组装尚未接底盘的F 前臂，用独立夹具托稳。A/B和 ±Z为本头局部坐标。
2. 在舵机侧55615#71两孔，从+Z沿-Z半插2780。
3. #81竖梁与#84底销留至整臂落座后再装，当前不封侧面。

核对：两销向+Z外露，81/84仍在散件格。

真实LDraw网格；爆炸间距仅用于识别，不代表装配间隙或已验证路径。

## 260 / 501 F 墙架／舵机架逐件搭建 F 平台斜撑：预插宿主黑销

1×2780

1. 本页组装尚未接底盘的F 前臂，用独立夹具托稳。A/B和 ±Z为本头局部坐标。
2. 在平台框舵机侧图示侧孔从+Z沿-Z半插2780。
3. 挡圈留在平台外面；#86斜撑等转盘侧梁和#44完成后再装。

核对：黑销露出朝+Z，对应未来斜撑第6孔。

真实LDraw网格；爆炸间距仅用于识别，不代表装配间隙或已验证路径。

## 261 / 501 F 转盘下半固定 F 转盘下半：凸台对准上框开口

1×18939

1. 本页组装尚未接底盘的F 前臂，用独立夹具托稳。A/B和 ±Z为本头局部坐标。
2. 断电、空载，把刚搭好的墙架和平台可靠夹住。确认输出 轴件#24-29与#86斜撑均为散件，尚未装有齿上半#115。
3. 取#34 18939无齿下半，长方形凸台朝支撑墙，从夹头一侧 局部+X沿-X放入最上方64179的开口；圆盘边沿贴框架正面。
4. 凸台两端各3孔应与框架两侧的3个横孔自然同轴。不要靠 长销把偏斜凸台硬拉正；暂由夹具保持。

核对：无齿下半已就位；两侧各3孔可见，输出轴组和侧梁 均未挡入口。

真实LDraw网格；爆炸间距仅用于识别，不代表装配间隙或已验证路径。

## 262 / 501 F 转盘下半固定 F 下半+Z侧：从外侧插三根蓝长销

3×6558

1. 本页组装尚未接底盘的F 前臂，用独立夹具托稳。A/B和 ±Z为本头局部坐标。
2. 在局部+Z外侧，将#35/#36/#37三根6558分别对准上、中、 下3孔；逐根沿-Z平推。
3. 每根长的2孔段朝内，依次穿框架侧壁与下半凸台端壁； 挡肩停在框架外面，短的1孔段朝+Z外露。
4. 三根分别位于局部Y=-8、0、+8毫米，不省略中间销。此 时不得先装#41侧梁或#86斜撑。

核对：三销肩贴框架外侧，3个短段均外露；下半保持夹具 支承。

真实LDraw网格；爆炸间距仅用于识别，不代表装配间隙或已验证路径。

## 263 / 501 F 转盘下半固定 F 下半-Z侧：从外侧插另三根蓝长销

3×6558

1. 本页组装尚未接底盘的F 前臂，用独立夹具托稳。A/B和 ±Z为本头局部坐标。
2. 输出轴件#24-29仍未装。站到局部-Z侧，把#38/#39/#40逐 根沿+Z装入另3孔。
3. 长的2孔段向内穿框架与凸台，挡肩留在框架外表面；短 的1孔段向-Z外露。
4. 中间#39的直线入口原本与输出轴位置相交，不能在轴组 已接电机时硬插；两侧合计使用6根6558。

核对：两侧各3根6558均到挡肩，无销肩被推过闭合宿主； 输出轴组仍未接。

真实LDraw网格；爆炸间距仅用于识别，不代表装配间隙或已验证路径。

## 264 / 501 F 转盘下半固定 F 中框侧孔：先预插五根黑销

5×2780

1. 本页组装尚未接底盘的F 前臂，用独立夹具托稳。A/B和 ±Z为本头局部坐标。
2. 两根40490侧梁都暂不装。中间64179框的+Z侧只在上、中 两孔预插#42/#43，沿-Z插半根；下孔对应侧梁第8孔，留给 #44长销。
3. -Z侧上、中、下3孔依次预插#46/#47/#48，沿+Z插半根。 所有2780中央挡圈停在框架外面。
4. 五根销另一半朝外露出，稍后由侧梁套住。不能先封梁后 把挡圈强推穿过两层孔。

核对：2＋3共5根黑销；+Z侧最下孔仍空，挡圈全部在框架 外侧。

真实LDraw网格；爆炸间距仅用于识别，不代表装配间隙或已验证路径。

## 265 / 501 F 转盘下半固定 F -Z侧梁：同时套住六个露出销段

1×40490

1. 本页组装尚未接底盘的F 前臂，用独立夹具托稳。A/B和 ±Z为本头局部坐标。
2. 取#45 40490 9L梁，沿墙的上下方向摆正，孔轴沿Z。输出 轴组仍在机外，给侧梁保留直线入口。
3. 从-Z外侧沿+Z平推：从上端数，第1至3孔同时套#38-40短 段，第6至8孔套#46-48黑销；第4、5、9孔不接销。
4. 六孔自然对准后才均匀压到销肩；不要用梁扭转或拉拢错 位的上下框。

核对：9L梁第1-3孔接固定长销、第6-8孔接中框黑销，六处 均贴合。

真实LDraw网格；爆炸间距仅用于识别，不代表装配间隙或已验证路径。

## 266 / 501 F 转盘下半固定 F +Z侧梁：套上三长销和两黑销

1×40490

1. 本页组装尚未接底盘的F 前臂，用独立夹具托稳。A/B和 ±Z为本头局部坐标。
2. 取#41另一根40490 9L梁，从+Z外侧沿-Z靠近墙体；#86斜 撑尚未安装。
3. 从上端数，第1-3孔套#35-37短段，第6/7孔套#42/#43黑销 ，第8孔与中框空孔同轴，留给#44。
4. 先逐处核对5个销尖，再均匀压到挡肩。两侧梁第4、5、9 孔均不接销。

核对：五个连接点齐平，第8孔未被黑销占用；斜撑仍在机 外。

真实LDraw网格；爆炸间距仅用于识别，不代表装配间隙或已验证路径。

## 267 / 501 F 转盘下半固定 F +Z下端长销：留出斜撑连接段

1×6558

1. 本页组装尚未接底盘的F 前臂，用独立夹具托稳。A/B和 ±Z为本头局部坐标。
2. #41梁已在位后，才从+Z外侧沿-Z插入#44 6558；长的2孔 段穿侧梁第8孔并接中框。
3. 挡肩停在侧梁外表面，短的1孔段朝+Z露出，专门用于#86 斜撑第1孔。
4. 不能把#44提前放在框架里再强压侧梁，也不能让它的挡 肩穿过已装斜撑。

核对：#44长段接梁与中框，短段向外；#86还未装。

真实LDraw网格；爆炸间距仅用于识别，不代表装配间隙或已验证路径。

## 268 / 501 F 转盘下半固定 F 斜撑最后：两孔同时套两根销

1×32524

1. 本页组装尚未接底盘的F 前臂，用独立夹具托稳。A/B和 ±Z为本头局部坐标。
2. 确认前面已装的平台黑销#85在位，露出段与#44短段都朝 +Z。取#86 32524七孔梁，保持图示斜向。
3. 从+Z外侧沿-Z平推：第1孔套#44短段，第6孔套平台#85露 出段；两孔中心距5孔距，不能误用第7孔。
4. 两点同时自然对齐后轻压到挡圈。斜撑此时才闭合；不得 用它强拉框架或平台。

核对：斜撑第1/6孔都就位，挡圈留在宿主之间；其余已搭 组件继续独立支承。

真实LDraw网格；爆炸间距仅用于识别，不代表装配间隙或已验证路径。

## 269 / 501 F 墙架／舵机架逐件搭建 F 输出传动：七号轴先入马达

1×44294

1. 本页组装尚未接底盘的F 前臂，用独立夹具托稳。A/B和 ±Z为本头局部坐标。
2. 从夹头侧+X沿-X将44294七号轴插入断电马达输出十字孔 ；保持轴线Y0、Z-40毫米。裸轴进入本体，外部留出套件位 置。
3. 零件和轴套肩位以本图为准；孔位自然匹配后才推进，保 持断电、独立支承。

核对：新装仅本步指定件；其他传动件不重复计数。

真实LDraw网格；爆炸间距仅用于识别，不代表装配间隙或已验证路径。

## 270 / 501 F 墙架／舵机架逐件搭建 F 输出传动：第一只半轴套

1×32123a

1. 本页组装尚未接底盘的F 前臂，用独立夹具托稳。A/B和 ±Z为本头局部坐标。
2. 从+X沿-X套32123a半套，贴到马达输出侧定位面。不得把 轴套推入本体。
3. 零件和轴套肩位以本图为准；孔位自然匹配后才推进，保 持断电、独立支承。

核对：新装仅本步指定件；其他传动件不重复计数。

真实LDraw网格；爆炸间距仅用于识别，不代表装配间隙或已验证路径。

## 271 / 501 F 墙架／舵机架逐件搭建 F 输出传动：第二只半轴套

1×32123a

1. 本页组装尚未接底盘的F 前臂，用独立夹具托稳。A/B和 ±Z为本头局部坐标。
2. 再从+X沿-X套第二只32123a，与第一只相贴。两只半套共 一孔厚。
3. 零件和轴套肩位以本图为准；孔位自然匹配后才推进，保 持断电、独立支承。

核对：新装仅本步指定件；其他传动件不重复计数。

真实LDraw网格；爆炸间距仅用于识别，不代表装配间隙或已验证路径。

## 272 / 501 F 墙架／舵机架逐件搭建 F 输出传动：整轴套

1×3713

1. 本页组装尚未接底盘的F 前臂，用独立夹具托稳。A/B和 ±Z为本头局部坐标。
2. 从+X沿-X套3713整套，贴住前两只半套。与-Z转盘侧梁仅 约0.4毫米名义间隙，遇阻立即停。
3. 零件和轴套肩位以本图为准；孔位自然匹配后才推进，保 持断电、独立支承。

核对：新装仅本步指定件；其他传动件不重复计数。

真实LDraw网格；爆炸间距仅用于识别，不代表装配间隙或已验证路径。

## 273 / 501 F 墙架／舵机架逐件搭建 F 输出传动：二十四齿轮

1×3648b

1. 本页组装尚未接底盘的F 前臂，用独立夹具托稳。A/B和 ±Z为本头局部坐标。
2. 3648b从+X沿-X套上轴并贴住整套。上半转盘还未扣合， 不强扭齿轮咬合。
3. 零件和轴套肩位以本图为准；孔位自然匹配后才推进，保 持断电、独立支承。

核对：新装仅本步指定件；其他传动件不重复计数。

真实LDraw网格；爆炸间距仅用于识别，不代表装配间隙或已验证路径。

## 274 / 501 F 墙架／舵机架逐件搭建 F 输出传动：轴端半套

1×32123a

1. 本页组装尚未接底盘的F 前臂，用独立夹具托稳。A/B和 ±Z为本头局部坐标。
2. 最后从+X沿-X套32123a半套，贴住齿轮前面。核对两半套、 整套、齿轮、末半套的顺序，不能挤压到转动发涩。
3. 零件和轴套肩位以本图为准；孔位自然匹配后才推进，保 持断电、独立支承。

核对：新装仅本步指定件；其他传动件不重复计数。

真实LDraw网格；爆炸间距仅用于识别，不代表装配间隙或已验证路径。

## 275 / 501 F 转盘下半固定 F 转盘与传动：完成动力底架核对

本步合并／核对，无新增件

1. 本页组装尚未接底盘的F 前臂，用独立夹具托稳。A/B和 ±Z为本头局部坐标。
2. 前述步骤已从单件装完90件动力底架，包括墙、电机架、 平台、舵机架、竖支脚、十字块与输出传动。此处不再取零 件。
3. 转盘六根销、两侧梁和斜撑已到位；曲柄与连杆末端仍未 连接，接口81/84仍为散件。
4. 输出轴、半套、整套、齿轮顺序逐项核对；不得将近似舵 机外形或名义小间隙视为实物通过。

核对：90件已引入且无重复；下面继续原夹头流程。

真实LDraw网格；爆炸间距仅用于识别，不代表装配间隙或已验证路径。

## 276 / 501 机械臂组件装配 F 独立搭建-Z侧板组件

1×2780；1×32316；1×32523；1×32524；2×32526；3×6558

1. 本页组装尚未接底盘的F 前臂，用独立夹具托稳。A/B和 ±Z为本头局部坐标。
2. 把#108五孔内梁与#109三孔内梁分别定位；-Z侧五孔段在 局部+Y，三孔段在-Y。将#111～#113三根6558的短段插入内 梁，挡肩留在内梁外侧。
3. 将#106/#107两根32526压到长销的露出段上，长臂沿推杆 方向、短臂朝夹指根轴。先在对应L梁孔预装#114黑销，再 压上#110外侧七孔梁。
4. 三根蓝销贯穿三层；黑销仅连接外侧两层。保留根轴孔及 60483固定孔，组件仍在机外夹具上。

核对：本组件9件；长短内梁位置与图一致，所有销肩留在 宿主接面。

真实LDraw网格；爆炸间距仅用于识别，不代表装配间隙或已验证路径。

## 277 / 501 机械臂组件装配 F 独立搭建+Z侧板组件

1×2780；1×32316；1×32523；1×32524；2×32526；3×6558

1. 本页组装尚未接底盘的F 前臂，用独立夹具托稳。A/B和 ±Z为本头局部坐标。
2. +Z侧长短内梁与上一组件相反：#99五孔段在局部-Y， #100三孔段在+Y。把#102～#104三根6558短段插入内梁。
3. 将#97/#98两根32526压到长销上；先把#105黑销装在对应L 梁孔，再压上#101外侧七孔梁。
4. 本组件暂存机外；先完成另一侧根轴叠层，再把本组件整 体装到转盘。

核对：本组件9件，两个组件共18件。两侧长短段不能照同 一方向复制。

真实LDraw网格；爆炸间距仅用于识别，不代表装配间隙或已验证路径。

## 278 / 501 机械臂组件装配 F 转盘上半与中央导向块就位

1×18938；1×39793

1. 本页组装尚未接底盘的F 前臂，用独立夹具托稳。A/B和 ±Z为本头局部坐标。
2. 取#115有齿转盘上半，正面凸耳朝夹指。将#116导向块从 正面放进两个凸耳之间，中心孔与转盘轴线重合。
3. 导向块两条侧孔对准两侧凸耳上下孔。仅作定位并用夹具 托住，下一步用销连接。

核对：中心孔畅通；凸耳中间孔未用。

真实LDraw网格；爆炸间距仅用于识别，不代表装配间隙或已验证路径。

## 279 / 501 机械臂组件装配 F 先插四根转盘长销

4×6558

1. 本页组装尚未接底盘的F 前臂，用独立夹具托稳。A/B和 ±Z为本头局部坐标。
2. 从两侧凸耳外面各装2根6558，长的2孔段向内穿凸耳并接 导向块。
3. 挡肩贴住凸耳外表面，短的1孔段向外露出，留给侧板后 端。此时两侧板均未装到转盘。

核对：四销都已到挡肩；不能先封侧板再把挡肩强推过孔。

真实LDraw网格；爆炸间距仅用于识别，不代表装配间隙或已验证路径。

## 280 / 501 机械臂组件装配 F 先接-Z侧板，+Z侧保持开放

本步合并／核对，无新增件

1. 本页组装尚未接底盘的F 前臂，用独立夹具托稳。A/B和 ±Z为本头局部坐标。
2. 取已完成的-Z侧板，从局部-Z外侧沿+Z靠近转盘，使两 根L梁的后端孔套住#119/#120露出的短销段。
3. 均匀压到销肩，持续独立托住侧板和转盘。+Z侧板仍单 独放置，不提前封合。

核对：本组件15件；两根根轴从+Z侧仍有装入夹指和整轴 套的空间。

真实LDraw网格；爆炸间距仅用于识别，不代表装配间隙或已验证路径。

## 281 / 501 机械臂组件装配 F A根轴-Z侧：固定销与60483

1×2780；1×60483

1. 本页组装尚未接底盘的F 前臂，用独立夹具托稳。A/B和 ±Z为本头局部坐标。
2. A对应局部+Y。先将#127黑色2780从-Z侧沿+Z插入内梁端 孔半根，挡圈停在内梁外表面。
3. 将#164 60483从同侧装到黑销露出段：圆孔接2780，十字 孔与相邻根轴孔同轴；两孔中心距8毫米。
4. 此时十字孔还没有根轴。夹具托住支架，不能用单销悬挂 它或靠扭转对相位。

核对：60483圆孔已接销，十字孔对根轴线；支架贴合内梁。

真实LDraw网格；爆炸间距仅用于识别，不代表装配间隙或已验证路径。

## 282 / 501 机械臂组件装配 F A根轴：建立穿轴支点

1×32123a；1×3707

1. 本页组装尚未接底盘的F 前臂，用独立夹具托稳。A/B和 ±Z为本头局部坐标。
2. 先把#125半轴套套在#122 8L根轴的-Z端，再沿+Z把轴穿过 60483十字孔与-Z内梁圆孔；夹具保持支架与轴同线。
3. 半套停在60483外侧；根轴伸入尚未封合的+Z侧。根轴十 字相位应自然通过60483，不能旋扭支架来强行咬合。

核对：轴穿过一侧60483和内梁，外侧半套到位；未连接端 由夹具支承。

真实LDraw网格；爆炸间距仅用于识别，不代表装配间隙或已验证路径。

## 283 / 501 机械臂组件装配 F A根轴：依次装整套、夹指、整套

1×32524；2×3713

1. 本页组装尚未接底盘的F 前臂，用独立夹具托稳。A/B和 ±Z为本头局部坐标。
2. 从开放的+Z端，沿-Z依次套上#123整轴套、#121红色7孔 夹指的第4圆孔、#124整轴套。
3. 每只整套厚8毫米；夹指圆孔厚8毫米。三件在两侧内梁之 间构成24毫米叠层，先由夹具支承，不依靠摩擦锁紧。
4. 夹指朝魔方方向，保持本图的正常近闭合分支；图示约 3.84°，不反向翻折。

核对：内侧顺序为整套／夹指圆孔／整套；+Z侧板仍独立 暂存。

真实LDraw网格；爆炸间距仅用于识别，不代表装配间隙或已验证路径。

## 284 / 501 机械臂组件装配 F B根轴-Z侧：固定销与60483

1×2780；1×60483

1. 本页组装尚未接底盘的F 前臂，用独立夹具托稳。A/B和 ±Z为本头局部坐标。
2. B对应局部-Y。先将#135黑色2780从-Z侧沿+Z插入内梁端 孔半根，挡圈停在内梁外表面。
3. 将#166 60483从同侧装到黑销露出段：圆孔接2780，十字 孔与相邻根轴孔同轴；两孔中心距8毫米。
4. 此时十字孔还没有根轴。夹具托住支架，不能用单销悬挂 它或靠扭转对相位。

核对：60483圆孔已接销，十字孔对根轴线；支架贴合内梁。

真实LDraw网格；爆炸间距仅用于识别，不代表装配间隙或已验证路径。

## 285 / 501 机械臂组件装配 F B根轴：建立穿轴支点

1×32123a；1×3707

1. 本页组装尚未接底盘的F 前臂，用独立夹具托稳。A/B和 ±Z为本头局部坐标。
2. 先把#133半轴套套在#130 8L根轴的-Z端，再沿+Z把轴穿过 60483十字孔与-Z内梁圆孔；夹具保持支架与轴同线。
3. 半套停在60483外侧；根轴伸入尚未封合的+Z侧。根轴十 字相位应自然通过60483，不能旋扭支架来强行咬合。

核对：轴穿过一侧60483和内梁，外侧半套到位；未连接端 由夹具支承。

真实LDraw网格；爆炸间距仅用于识别，不代表装配间隙或已验证路径。

## 286 / 501 机械臂组件装配 F B根轴：依次装整套、夹指、整套

1×32524；2×3713

1. 本页组装尚未接底盘的F 前臂，用独立夹具托稳。A/B和 ±Z为本头局部坐标。
2. 从开放的+Z端，沿-Z依次套上#131整轴套、#129红色7孔 夹指的第4圆孔、#132整轴套。
3. 每只整套厚8毫米；夹指圆孔厚8毫米。三件在两侧内梁之 间构成24毫米叠层，先由夹具支承，不依靠摩擦锁紧。
4. 夹指朝魔方方向，保持本图的正常近闭合分支；图示约 3.84°，不反向翻折。

核对：内侧顺序为整套／夹指圆孔／整套；+Z侧板仍独立 暂存。

真实LDraw网格；爆炸间距仅用于识别，不代表装配间隙或已验证路径。

## 287 / 501 机械臂组件装配 F 合上+Z侧板组件

本步合并／核对，无新增件

1. 本页组装尚未接底盘的F 前臂，用独立夹具托稳。A/B和 ±Z为本头局部坐标。
2. 同时托住两根根轴、夹指与四只整轴套。把已完成的+Z 侧板从+Z外侧沿-Z靠近。
3. 侧板前端两个根轴孔分别套住A/B轴；后端两根L梁孔同时 套住#117/#118转盘长销短段，均匀压至销肩。
4. 四处必须自然对齐；不能用侧板把歪斜轴套硬挤进空隙。 若侧板无法无强力就位，停下复核支承和孔向。

核对：两根轴均穿过两侧内梁，四只整轴套与两夹指在位； +Z端60483与半套尚待安装。

真实LDraw网格；爆炸间距仅用于识别，不代表装配间隙或已验证路径。

## 288 / 501 机械臂组件装配 F A根轴+Z侧：装60483

1×2780；1×60483

1. 本页组装尚未接底盘的F 前臂，用独立夹具托稳。A/B和 ±Z为本头局部坐标。
2. 先从+Z外侧沿-Z把#128黑销插入内梁端孔半根，挡圈停在 内梁与支架的接面。
3. 将#165 60483十字孔对根轴、圆孔对黑销，同时平推到位 ；十字孔与圆孔各接合8毫米。保持根轴另一端半套在位。

核对：两点同时贴合；没有推动根轴或把销挡肩强推穿过宿 主。

真实LDraw网格；爆炸间距仅用于识别，不代表装配间隙或已验证路径。

## 289 / 501 机械臂组件装配 F A根轴+Z半套与64毫米叠层

1×32123a

1. 本页组装尚未接底盘的F 前臂，用独立夹具托稳。A/B和 ±Z为本头局部坐标。
2. 从+Z端沿-Z套上#126半轴套，停在60483外侧。不要用半 套压紧夹指或拉拢结构。
3. 从-Z到+Z：半套4＋60483 8＋内梁8＋整套8＋夹指8＋整套 8＋内梁8＋60483 8＋半套4＝64毫米，恰好占满8L根轴。
4. 名义轴向余量为零。自由转动和可靠防脱是否兼容必须实 测；任何卡死、松脱或轴端接合不足都停止。

核对：两端半套齐全；64毫米零名义余量已记录，未把几何 吻合当作实体验收。

真实LDraw网格；爆炸间距仅用于识别，不代表装配间隙或已验证路径。

## 290 / 501 机械臂组件装配 F B根轴+Z侧：装60483

1×2780；1×60483

1. 本页组装尚未接底盘的F 前臂，用独立夹具托稳。A/B和 ±Z为本头局部坐标。
2. 先从+Z外侧沿-Z把#136黑销插入内梁端孔半根，挡圈停在 内梁与支架的接面。
3. 将#167 60483十字孔对根轴、圆孔对黑销，同时平推到位 ；十字孔与圆孔各接合8毫米。保持根轴另一端半套在位。

核对：两点同时贴合；没有推动根轴或把销挡肩强推穿过宿 主。

真实LDraw网格；爆炸间距仅用于识别，不代表装配间隙或已验证路径。

## 291 / 501 机械臂组件装配 F B根轴+Z半套与64毫米叠层

1×32123a

1. 本页组装尚未接底盘的F 前臂，用独立夹具托稳。A/B和 ±Z为本头局部坐标。
2. 从+Z端沿-Z套上#134半轴套，停在60483外侧。不要用半 套压紧夹指或拉拢结构。
3. 从-Z到+Z：半套4＋60483 8＋内梁8＋整套8＋夹指8＋整套 8＋内梁8＋60483 8＋半套4＝64毫米，恰好占满8L根轴。
4. 名义轴向余量为零。自由转动和可靠防脱是否兼容必须实 测；任何卡死、松脱或轴端接合不足都停止。

核对：两端半套齐全；64毫米零名义余量已记录，未把几何 吻合当作实体验收。

真实LDraw网格；爆炸间距仅用于识别，不代表装配间隙或已验证路径。

## 292 / 501 机械臂组件装配 F A轮胎与轮毂预装

1×42610；1×50945_nominal

1. 本页组装尚未接底盘的F 前臂，用独立夹具托稳。A/B和 ±Z为本头局部坐标。
2. 把#145轮胎套在#144轮毂上，确认胎圈均匀就座。将这2 件组件暂存在机外。
3. 每臂两组独立轮胎压头；轮胎网格是名义14×6毫米尺寸 ，实际橡胶形变和摩擦未验证。

核对：2件组件同心，轮毂中孔保持畅通。

真实LDraw网格；爆炸间距仅用于识别，不代表装配间隙或已验证路径。

## 293 / 501 机械臂组件装配 F A压头：先装-Z薄梁与两连接点

1×32054；1×32123a；1×32449；1×4519

1. 本页组装尚未接底盘的F 前臂，用独立夹具托稳。A/B和 ±Z为本头局部坐标。
2. 把#137四孔薄梁贴在红色夹指-Z侧。薄梁第1十字孔对夹 指第6孔，用#139 3L轴贯穿，并在-Z端加#140半套。
3. 薄梁第2圆孔对夹指第7孔，从-Z侧插#142 32054，挡套停 在第一根薄梁外侧；露出的轴和销给另一侧薄梁使用。
4. 薄梁第3圆孔留空，第4十字孔用于轮轴；+Z侧薄梁下一 步安装。

核对：薄梁由两个连接点定位，挡套在正确外侧；轮胎组件 仍单独托住。

真实LDraw网格；爆炸间距仅用于识别，不代表装配间隙或已验证路径。

## 294 / 501 机械臂组件装配 F A压头：轮轴、轮胎与+Z薄梁

1×32062；1×32123a；1×32449

1. 本页组装尚未接底盘的F 前臂，用独立夹具托稳。A/B和 ±Z为本头局部坐标。
2. 把#143 2L轮轴穿过-Z薄梁第4十字孔，套入已准备的轮胎 ／轮毂组件；轮毂位于夹指中面。
3. 把#138 +Z薄梁同时对准3L轴、32054销和2L轮轴三个连接 点，沿-Z平直压到位，再在3L轴+Z端套#141半套。
4. 2L轮轴两端与薄梁外侧齐平，不加外轴套。检查轮毂能绕 固定轴自由转动；不能靠挤压薄梁消除间隙。

核对：本夹指轮胎压头9件齐全，两个3L轴半套和32054挡套 到位。

真实LDraw网格；爆炸间距仅用于识别，不代表装配间隙或已验证路径。

## 295 / 501 机械臂组件装配 F B轮胎与轮毂预装

1×42610；1×50945_nominal

1. 本页组装尚未接底盘的F 前臂，用独立夹具托稳。A/B和 ±Z为本头局部坐标。
2. 把#154轮胎套在#153轮毂上，确认胎圈均匀就座。将这2 件组件暂存在机外。
3. 每臂两组独立轮胎压头；轮胎网格是名义14×6毫米尺寸 ，实际橡胶形变和摩擦未验证。

核对：2件组件同心，轮毂中孔保持畅通。

真实LDraw网格；爆炸间距仅用于识别，不代表装配间隙或已验证路径。

## 296 / 501 机械臂组件装配 F B压头：先装-Z薄梁与两连接点

1×32054；1×32123a；1×32449；1×4519

1. 本页组装尚未接底盘的F 前臂，用独立夹具托稳。A/B和 ±Z为本头局部坐标。
2. 把#146四孔薄梁贴在红色夹指-Z侧。薄梁第1十字孔对夹 指第6孔，用#148 3L轴贯穿，并在-Z端加#149半套。
3. 薄梁第2圆孔对夹指第7孔，从-Z侧插#151 32054，挡套停 在第一根薄梁外侧；露出的轴和销给另一侧薄梁使用。
4. 薄梁第3圆孔留空，第4十字孔用于轮轴；+Z侧薄梁下一 步安装。

核对：薄梁由两个连接点定位，挡套在正确外侧；轮胎组件 仍单独托住。

真实LDraw网格；爆炸间距仅用于识别，不代表装配间隙或已验证路径。

## 297 / 501 机械臂组件装配 F B压头：轮轴、轮胎与+Z薄梁

1×32062；1×32123a；1×32449

1. 本页组装尚未接底盘的F 前臂，用独立夹具托稳。A/B和 ±Z为本头局部坐标。
2. 把#152 2L轮轴穿过-Z薄梁第4十字孔，套入已准备的轮胎 ／轮毂组件；轮毂位于夹指中面。
3. 把#147 +Z薄梁同时对准3L轴、32054销和2L轮轴三个连接 点，沿-Z平直压到位，再在3L轴+Z端套#150半套。
4. 2L轮轴两端与薄梁外侧齐平，不加外轴套。检查轮毂能绕 固定轴自由转动；不能靠挤压薄梁消除间隙。

核对：本夹指轮胎压头9件齐全，两个3L轴半套和32054挡套 到位。

真实LDraw网格；爆炸间距仅用于识别，不代表装配间隙或已验证路径。

## 298 / 501 机械臂组件装配 F 先把无摩擦销各插入夹指半根

2×3673

1. 本页组装尚未接底盘的F 前臂，用独立夹具托稳。A/B和 ±Z为本头局部坐标。
2. 两根黄色连杆尚未接到夹指。A夹指第2孔先从+Z侧沿-Z 插#160灰色3673半根；B夹指第2孔从-Z侧沿+Z插#162半根。
3. 两个中央挡圈都留在夹指外表面，销的另一半露出，供下 一步各自的连杆圆孔套接。
4. 夹指和已装头部由夹具支承。不能把销推穿夹指后再把挡 圈强推通过连杆。

核对：A/B两销肩分别在+Z/-Z夹指外表面，露出段方向相 反。

真实LDraw网格；爆炸间距仅用于识别，不代表装配间隙或已验证路径。

## 299 / 501 机械臂组件装配 F 两根黄色连杆分别从各自外侧套销

2×32316

1. 本页组装尚未接底盘的F 前臂，用独立夹具托稳。A/B和 ±Z为本头局部坐标。
2. 先从+Z外侧沿-Z把#159连杆一端套到A销#160的露出段， 直到与夹指之间的销肩接触。
3. 再从-Z外侧沿+Z把#161连杆一端套到B销#162的露出段。 两根连杆分别装入，不把它们预先连成刚性组件一起硬推。
4. 两连杆自由端由夹具托在十字接头位置。保持正常近闭合 分支；下一步用横轴连接中间三个孔。

核对：两销肩停在各自的夹指与连杆接面，连杆可绕无摩擦 销转动。

真实LDraw网格；爆炸间距仅用于识别，不代表装配间隙或已验证路径。

## 300 / 501 机械臂组件装配 F 连接十字接头横轴与两端半套

1×32013；2×32123a；1×3705

1. 本页组装尚未接底盘的F 前臂，用独立夹具托稳。A/B和 ±Z为本头局部坐标。
2. 用夹具保持两连杆自由端同轴，在中间放#155 32013，横 圆孔对准两个连杆端孔，纵向十字孔朝后接推杆。
3. 在#156 4L横轴-Z端预套#157半套；从-Z沿+Z依次穿过#161 连杆、32013横圆孔和#159连杆，再从+Z端套#158半套。
4. 轴本体穿圆孔，无销挡肩经过闭合孔。两半套停在连杆外 侧，不能压死连杆；十字接头在两连杆朝魔方的一端。

核对：横轴与两端半套齐全，三处圆孔自然同轴；纵向十字 孔仍畅通。

真实LDraw网格；爆炸间距仅用于识别，不代表装配间隙或已验证路径。

## 301 / 501 机械臂组件装配 F 离机接合机械头与90件动力核心

本步合并／核对，无新增件

1. 本页组装尚未接底盘的F 前臂，用独立夹具托稳。A/B和 ±Z为本头局部坐标。
2. 转盘下半固定及轴组接入已按前述步骤完成，90件动力底 架、机械头及未闭合的曲柄／连杆分别独立支承。将转盘上 半对准核心的下半扣合；同时保持齿轮与转盘的名义啮合位 置。
3. #94曲柄端轴和#95半套尚未安装，因此黄色舵机连杆不会 把推杆强制锁在舵机角度上。
4. 此时整臂仍在底盘外，#81侧梁和#84底框销仍在专格。扣 合所需空间、卡扣力及实体啮合必须另行验证。

核对：转盘上下半及导向孔同轴；曲柄与连杆未连接，推杆 通道未封闭。

真实LDraw网格；爆炸间距仅用于识别，不代表装配间隙或已验证路径。

## 302 / 501 机械臂组件装配 F 从后方穿12L推杆及两只半套

2×32123a；1×3708

1. 本页组装尚未接底盘的F 前臂，用独立夹具托稳。A/B和 ±Z为本头局部坐标。
2. 把#88/#89两只半套分别用夹具定位在十字块#87的前后， 孔轴线对准导向框前孔；曲柄端仍不连接。
3. #163 12L轴从平台后方沿+X穿入：导向框后孔只借道，再 依次通过后半套、十字块圆孔、前半套、导向框前孔、转盘 中心及#116导向块，最后插进#155十字孔到底。
4. 图示为完成位置，后导向孔不承载推杆。自然移动未连接 的十字块／连杆帮助对孔，不反驱舵机；两半套不把滑动机 构夹死。

核对：推杆前端名义进入十字接头8毫米；两个导向处畅通、 两半套就位。

真实LDraw网格；爆炸间距仅用于识别，不代表装配间隙或已验证路径。

## 303 / 501 机械臂组件装配 F 匹配名义姿态后连接曲柄端

1×32062；1×32123a

1. 本页组装尚未接底盘的F 前臂，用独立夹具托稳。A/B和 ±Z为本头局部坐标。
2. 先核对舵机曲柄#93已由另行验证的定位流程处于所需姿 态。本页仅表达断电、空载、孔位自然对齐时的机械连接； 不提供上电归零或脉宽标定。
3. 保持夹指和推杆在图示正常近闭合分支，让#96连杆端孔 与曲柄末端孔自然同轴，再插#94 2L轴：外端与曲柄外面齐 平；内端装#95半套贴住连杆。
4. 孔位不自然重合、需要硬拉连杆或反驱舵机时立即停止， 保持分离和支承，等待专门定位／标定；不能把本页当作定 位已完成的证据。

核对：只有预先满足自然对孔条件才记录此步完成；否则整 臂仍标为待验证。

真实LDraw网格；爆炸间距仅用于识别，不代表装配间隙或已验证路径。

## 304 / 501 机械臂组件装配 F 单臂165件待接底盘，2件留待接口

本步合并／核对，无新增件

1. 本页组装尚未接底盘的F 前臂，用独立夹具托稳。A/B和 ±Z为本头局部坐标。
2. 核对已完成的90件动力底架与75件夹头件共165件；每头4 件60483、2根8L根轴、4只根轴整套、4只根轴外半套和4枚 支架固定销齐全。
3. #81 40490侧梁与#84 2780销保持散件状态，待整臂落到底 盘后先装#84、再装#81，使每臂达到167件；不要提前装这 两件。
4. R、L、F、B四臂分别在机外完成同一局部流程。各臂独 立记录；四臂最终合计668件，不以一个臂通过代替其余三 臂。
5. 64毫米根轴叠层零名义余量；夹指正常约3.84°～25°。 装配路径、保持、载荷、控制联锁和实体开合均未放行。

核对：165件在位＋2件专格＝167件／臂；不插电、不带魔 方，仍需实体验证。

真实LDraw网格；爆炸间距仅用于识别，不代表装配间隙或已验证路径。

## 305 / 501 B 墙架／舵机架逐件搭建 B 从散件开始：放好竖墙下框

1×64179

1. 本页组装尚未接底盘的B 后臂，用独立夹具托稳。A/B和 ±Z为本头局部坐标。
2. 每臂从167个清单单件开始，包括成品电机和舵机；没有 预装核心或隐藏轴组。逐项取件，81侧梁和84销留到底盘阶 段。
3. 取第一块64179作为最下层框架，墙面在YZ平面，长边沿 Z。用夹具托住，后续向-Y上方逐层搭墙。
4. 本册覆盖全部清单件的装配顺序，不拆成品电机/舵机内 部；名义几何不等于实体装配通过。

核对：本步仅1块下框#3，孔向和编号与图一致。

真实LDraw网格；爆炸间距仅用于识别，不代表装配间隙或已验证路径。

## 306 / 501 B 墙架／舵机架逐件搭建 B 竖墙：下框上缘预插三销

3×2780

1. 本页组装尚未接底盘的B 后臂，用独立夹具托稳。A/B和 ±Z为本头局部坐标。
2. 取三根2780，从-Y上方沿+Y向下框#3上缘各插半根，位置 为局部Z=-16、0、+16毫米。
3. 中央挡圈留在上缘外面；中框未装，不能把销肩推过两层 孔。

核对：三根等高，另一半朝-Y外露。

真实LDraw网格；爆炸间距仅用于识别，不代表装配间隙或已验证路径。

## 307 / 501 B 墙架／舵机架逐件搭建 B 竖墙：压上中框

1×64179

1. 本页组装尚未接底盘的B 后臂，用独立夹具托稳。A/B和 ±Z为本头局部坐标。
2. 取第二块64179，长边沿Z，与下框保持同一墙面。
3. 从-Y上方沿+Y将中框下缘的三孔同时套住#7-9，均匀压到 挡圈。

核对：两框接缝平直，三销都连接相邻框。

真实LDraw网格；爆炸间距仅用于识别，不代表装配间隙或已验证路径。

## 308 / 501 B 墙架／舵机架逐件搭建 B 竖墙：中框上缘预插三销

3×2780

1. 本页组装尚未接底盘的B 后臂，用独立夹具托稳。A/B和 ±Z为本头局部坐标。
2. 从-Y上方沿+Y向中框#2上缘预插三根2780半根。
3. 仍用Z=-16、0、+16毫米三个位置，保留挡圈在框外。

核对：三个销尖朝-Y。

真实LDraw网格；爆炸间距仅用于识别，不代表装配间隙或已验证路径。

## 309 / 501 B 墙架／舵机架逐件搭建 B 竖墙：压上顶框

1×64179

1. 本页组装尚未接底盘的B 后臂，用独立夹具托稳。A/B和 ±Z为本头局部坐标。
2. 顶框64179长边沿Z，墙面与下面两框齐平。
3. 从-Y沿+Y套住#4-6三销；三块框的开口都保持畅通。

核对：三框九件完整，后续转盘放入最上框开口。

真实LDraw网格；爆炸间距仅用于识别，不代表装配间隙或已验证路径。

## 310 / 501 B 墙架／舵机架逐件搭建 B 墙脚：先半插两枚接口销

2×2780

1. 本页组装尚未接底盘的B 后臂，用独立夹具托稳。A/B和 ±Z为本头局部坐标。
2. 将墙倒置支承，从最下框#3底缘沿-Y各插半根2780。
3. 中央挡圈位于最终墙/底盘接缝Y100毫米；另一半朝+Y。 此时不取底盘。

核对：两枚销随墙保留，落底盘时不重复取件。

真实LDraw网格；爆炸间距仅用于识别，不代表装配间隙或已验证路径。

## 311 / 501 B 墙架／舵机架逐件搭建 B 马达：识别成品本体

1×95658

1. 本页组装尚未接底盘的B 后臂，用独立夹具托稳。A/B和 ±Z为本头局部坐标。
2. 取95658成品马达，保持断电，电线避开孔位。
3. 输出轴线沿X，本体在-Z侧；按图识别底面三圆孔和颈部 圆孔，不拆电机内部。

核对：型号与朝向一致，孔位没有被线缆遮住。

真实LDraw网格；爆炸间距仅用于识别，不代表装配间隙或已验证路径。

## 312 / 501 B 墙架／舵机架逐件搭建 B 马达底部：三枚销先入本体

3×2780

1. 本页组装尚未接底盘的B 后臂，用独立夹具托稳。A/B和 ±Z为本头局部坐标。
2. 把马达底面朝上，三孔沿X排列。
3. 每孔一根2780，只插半根，挡圈留在本体外侧；三销最终 向+Y露出。

核对：三销在同一平面。

真实LDraw网格；爆炸间距仅用于识别，不代表装配间隙或已验证路径。

## 313 / 501 B 墙架／舵机架逐件搭建 B 马达底块：第一根五孔梁

1×32316

1. 本页组装尚未接底盘的B 后臂，用独立夹具托稳。A/B和 ±Z为本头局部坐标。
2. 取32316五孔梁，长向沿X。
3. 从+Y沿-Y使第2、3、4孔套住三枚底销，压至挡圈。

核对：第1、5孔保持空着。

真实LDraw网格；爆炸间距仅用于识别，不代表装配间隙或已验证路径。

## 314 / 501 B 墙架／舵机架逐件搭建 B 马达底块：两端预插销

2×2780

1. 本页组装尚未接底盘的B 后臂，用独立夹具托稳。A/B和 ±Z为本头局部坐标。
2. 在第一根五孔梁第1、5孔，从+Y沿-Y各插半根2780。
3. 挡圈留在梁外，露出半根给第二层梁。

核对：两销间距四孔距。

真实LDraw网格；爆炸间距仅用于识别，不代表装配间隙或已验证路径。

## 315 / 501 B 墙架／舵机架逐件搭建 B 马达底块：第二根五孔梁

1×32316

1. 本页组装尚未接底盘的B 后臂，用独立夹具托稳。A/B和 ±Z为本头局部坐标。
2. 第二根32316与第一根平行对齐。
3. 从+Y沿-Y套住两端销，形成两层底块；中间孔保留给底 盘接口。

核对：两层梁贴合，无销肩穿过闭合双层。

真实LDraw网格；爆炸间距仅用于识别，不代表装配间隙或已验证路径。

## 316 / 501 B 墙架／舵机架逐件搭建 B 马达颈部：先放长短两销

1×2780；1×6558

1. 本页组装尚未接底盘的B 后臂，用独立夹具托稳。A/B和 ±Z为本头局部坐标。
2. 颈部上圆孔放6558#18，短段向-X入本体，挡肩留外；长 段向+X。
3. 下圆孔放2780#19半根；中间十字孔不要误用。

核对：上蓝长销、下黑短销均露出到同侧。

真实LDraw网格；爆炸间距仅用于识别，不代表装配间隙或已验证路径。

## 317 / 501 B 墙架／舵机架逐件搭建 B 马达前架：竖装三孔梁

1×32523

1. 本页组装尚未接底盘的B 后臂，用独立夹具托稳。A/B和 ±Z为本头局部坐标。
2. 取32523三孔梁，长向沿Y，孔轴沿X。
3. 从+X沿-X套上#18/#19，分别使用上下两孔，中孔保持空。

核对：三孔梁贴住销肩。

真实LDraw网格；爆炸间距仅用于识别，不代表装配间隙或已验证路径。

## 318 / 501 B 墙架／舵机架逐件搭建 B 马达前架：中孔预插黑销

1×2780

1. 本页组装尚未接底盘的B 后臂，用独立夹具托稳。A/B和 ±Z为本头局部坐标。
2. 在三孔梁中孔，从+X沿-X插入2780半根。
3. 露出半根向+X，给下方横梁使用。

核对：不要占用颈部十字孔。

真实LDraw网格；爆炸间距仅用于识别，不代表装配间隙或已验证路径。

## 319 / 501 B 墙架／舵机架逐件搭建 B 马达前架：接十一孔横梁

1×32525

1. 本页组装尚未接底盘的B 后臂，用独立夹具托稳。A/B和 ±Z为本头局部坐标。
2. 32525长向沿Z，向墙体伸出。
3. 第1孔从+X沿-X套住上方#18长销的剩余段；三孔竖梁与横 梁各占一孔厚。

核对：蓝销长段连接两根梁。

真实LDraw网格；爆炸间距仅用于识别，不代表装配间隙或已验证路径。

## 320 / 501 B 墙架／舵机架逐件搭建 B 马达前架：接七孔横梁

1×32524

1. 本页组装尚未接底盘的B 后臂，用独立夹具托稳。A/B和 ±Z为本头局部坐标。
2. 32524七孔梁与十一孔梁平行。
3. 第1孔从+X沿-X套住中间#21黑销。

核对：两横梁分别位于局部Y16、24毫米。

真实LDraw网格；爆炸间距仅用于识别，不代表装配间隙或已验证路径。

## 321 / 501 B 墙架／舵机架逐件搭建 B 马达接墙：四销先入横梁

4×2780

1. 本页组装尚未接底盘的B 后臂，用独立夹具托稳。A/B和 ±Z为本头局部坐标。
2. 从马达端数，十一孔梁第6、8、10孔接#30/#31/#32；七孔 梁第6孔接#33。
3. 四根2780从+X沿-X半插横梁，挡圈留在梁前；销尖向+X。

核对：三销接顶框，一销接中框；输出轴组尚未装。

真实LDraw网格；爆炸间距仅用于识别，不代表装配间隙或已验证路径。

## 322 / 501 B 墙架／舵机架逐件搭建 B 马达接墙：平推合拢

本步合并／核对，无新增件

1. 本页组装尚未接底盘的B 后臂，用独立夹具托稳。A/B和 ±Z为本头局部坐标。
2. 取刚搭好的完整马达组件，保持四销在横梁内，不再取销。
3. 从墙背面局部-X沿+X平推，四销同时进入墙孔；墙与马 达继续由夹具托住。

核对：四销肩留在横梁/墙之间；不装输出轴。

真实LDraw网格；爆炸间距仅用于识别，不代表装配间隙或已验证路径。

## 323 / 501 B 墙架／舵机架逐件搭建 B 舵机平台：平放两根十五孔梁

2×32278

1. 本页组装尚未接底盘的B 后臂，用独立夹具托稳。A/B和 ±Z为本头局部坐标。
2. 两根32278平行，长向沿X，相距四孔距。
3. 以夹具保持两梁前后端齐平；此时它们尚未连接。

核对：梁中心分别为Z0、32毫米，孔轴沿Y。

真实LDraw网格；爆炸间距仅用于识别，不代表装配间隙或已验证路径。

## 324 / 501 B 墙架／舵机架逐件搭建 B 平台前部：六枚销先入底梁

6×2780

1. 本页组装尚未接底盘的B 后臂，用独立夹具托稳。A/B和 ±Z为本头局部坐标。
2. 两根15L从最后端向前数：+Z梁第9、11、13、15孔各半插 2780；Z0梁第9、15孔各半插一根。
3. 销由-Y上方沿+Y插入梁，挡圈留在梁上；两蓝长销位置 暂空。

核对：4＋2共六销；全部露出朝-Y。

真实LDraw网格；爆炸间距仅用于识别，不代表装配间隙或已验证路径。

## 325 / 501 B 墙架／舵机架逐件搭建 B 平台前部：压上水平框架

1×64179

1. 本页组装尚未接底盘的B 后臂，用独立夹具托稳。A/B和 ±Z为本头局部坐标。
2. 64179平放，长边沿X，前端与两根十五孔梁对齐。
3. 从-Y沿+Y压到六枚销上，保持长销专用两孔空着。

核对：框架与两梁闭合，六销肩在夹层。

真实LDraw网格；爆炸间距仅用于识别，不代表装配间隙或已验证路径。

## 326 / 501 B 墙架／舵机架逐件搭建 B 舵机垫梁：先插三枚黑销

3×2780

1. 本页组装尚未接底盘的B 后臂，用独立夹具托稳。A/B和 ±Z为本头局部坐标。
2. 在+Z的15L底梁，从最后端孔向前数第2、6、7孔半插2780 ；它们对应稍后7L垫梁的第1、5、6孔。15L第1孔留给后横 梁。
3. 从-Y沿+Y装销，垫梁第2、4孔下方留给55615，不增贯穿 销。

核对：三销不占舵机耳销第3、7孔。

真实LDraw网格；爆炸间距仅用于识别，不代表装配间隙或已验证路径。

## 327 / 501 B 墙架／舵机架逐件搭建 B 舵机垫梁：压上七孔梁

1×32524

1. 本页组装尚未接底盘的B 后臂，用独立夹具托稳。A/B和 ±Z为本头局部坐标。
2. 取32524七孔梁，与底梁平行。
3. 从-Y沿+Y套住三销；从后端数第3、7孔保持空着。

核对：垫梁只由三枚黑销连接底梁。

真实LDraw网格；爆炸间距仅用于识别，不代表装配间隙或已验证路径。

## 328 / 501 B 墙架／舵机架逐件搭建 B 平台后横梁：两端预插销

2×2780

1. 本页组装尚未接底盘的B 后臂，用独立夹具托稳。A/B和 ±Z为本头局部坐标。
2. 两根十五孔梁各在最后一个孔从-Y沿+Y半插2780。
3. 销尖均向上，给横向五孔梁使用。

核对：两销同高，相距四孔距。

真实LDraw网格；爆炸间距仅用于识别，不代表装配间隙或已验证路径。

## 329 / 501 B 墙架／舵机架逐件搭建 B 平台后横梁：闭合长方形

1×32316

1. 本页组装尚未接底盘的B 后臂，用独立夹具托稳。A/B和 ±Z为本头局部坐标。
2. 32316五孔梁长向沿Z。
3. 从-Y沿+Y将两端孔套在#68/#69上，后框闭合。

核对：两梁前后都有横向连接。

真实LDraw网格；爆炸间距仅用于识别，不代表装配间隙或已验证路径。

## 330 / 501 B 墙架／舵机架逐件搭建 B 平台下方：装两个弯角连接器

2×55615

1. 本页组装尚未接底盘的B 后臂，用独立夹具托稳。A/B和 ±Z为本头局部坐标。
2. 两只55615的横臂顺X、竖臂朝+Y下方。
3. 从+Y下方向-Y压入：马达侧底梁倒数第2、4孔；舵机侧 倒数第3、5孔。使用连接器自带销，不另加销。

核对：两连接器竖臂孔沿Z，自带多余横销保持空置。

真实LDraw网格；爆炸间距仅用于识别，不代表装配间隙或已验证路径。

## 331 / 501 B 墙架／舵机架逐件搭建 B 推杆导向：先插两根蓝长销

2×6558

1. 本页组装尚未接底盘的B 后臂，用独立夹具托稳。A/B和 ±Z为本头局部坐标。
2. 从-Y沿+Y把6558长的两孔段穿平台框并插入Z0底梁。
3. 挡肩停在平台框上表面，短段朝-Y；导向框尚未装，销肩 不能穿过其底孔。

核对：长段连接平台两层，短段露出供导向框。

真实LDraw网格；爆炸间距仅用于识别，不代表装配间隙或已验证路径。

## 332 / 501 B 墙架／舵机架逐件搭建 B 推杆导向：最后压上竖框

1×64179

1. 本页组装尚未接底盘的B 后臂，用独立夹具托稳。A/B和 ±Z为本头局部坐标。
2. 64179竖立在XY平面，长向沿X，孔轴沿Z。
3. 从-Y沿+Y将底边两个侧孔套住#64/#65短段；导向圆孔朝 推杆轴线。

核对：导向框两销到肩，中央开口未被连杆或舵机封住。

真实LDraw网格；爆炸间距仅用于识别，不代表装配间隙或已验证路径。

## 333 / 501 B 墙架／舵机架逐件搭建 B 十字块：放入导向框开口

1×6536

1. 本页组装尚未接底盘的B 后臂，用独立夹具托稳。A/B和 ±Z为本头局部坐标。
2. 6536十字块圆孔在上，下面十字孔沿Z。
3. 舵机尚未装，把十字块从+Z沿-Z放入导向框中央开口， 以夹具托住；不靠推杆悬挂。

核对：框内名义余量约0.4毫米，遇阻停止，不磨件。

真实LDraw网格；爆炸间距仅用于识别，不代表装配间隙或已验证路径。

## 334 / 501 B 墙架／舵机架逐件搭建 B 十字块：穿入三号轴

1×4519

1. 本页组装尚未接底盘的B 后臂，用独立夹具托稳。A/B和 ±Z为本头局部坐标。
2. 4519三号轴从+Z沿-Z穿过下方十字孔。
3. -Z端留半孔给半轴套，+Z端留出连杆和另一只半轴套厚 度。

核对：轴不穿上方推杆圆孔。

真实LDraw网格；爆炸间距仅用于识别，不代表装配间隙或已验证路径。

## 335 / 501 B 墙架／舵机架逐件搭建 B 十字块：后侧半套定位

1×32123a

1. 本页组装尚未接底盘的B 后臂，用独立夹具托稳。A/B和 ±Z为本头局部坐标。
2. 从-Z沿+Z装32123a半轴套，贴住十字块后侧。
3. 十字块继续独立支承，不与导向框固连。

核对：后侧半套贴合而不挤压框架。

真实LDraw网格；爆炸间距仅用于识别，不代表装配间隙或已验证路径。

## 336 / 501 B 墙架／舵机架逐件搭建 B 舵机连杆：先接十字块端

1×32524

1. 本页组装尚未接底盘的B 后臂，用独立夹具托稳。A/B和 ±Z为本头局部坐标。
2. 32524七孔连杆的前端第1孔从+Z沿-Z套住三号轴。
3. 连杆直接贴十字块+Z面，不在两者中间加轴套；第7孔朝 舵机端且保持未连接。

核对：连杆在导向框外侧，舵机还未挡住来路。

真实LDraw网格；爆炸间距仅用于识别，不代表装配间隙或已验证路径。

## 337 / 501 B 墙架／舵机架逐件搭建 B 舵机连杆：外侧半套定位

1×32123a

1. 本页组装尚未接底盘的B 后臂，用独立夹具托稳。A/B和 ±Z为本头局部坐标。
2. 从+Z沿-Z套上32123a，贴住连杆外面。
3. 连杆远端继续由夹具支承，不提前接曲柄。

核对：半套4＋十字块8＋连杆8＋半套4＝24毫米，轴向零名 义余量；勿夹死连杆。

真实LDraw网格；爆炸间距仅用于识别，不代表装配间隙或已验证路径。

## 338 / 501 B 墙架／舵机架逐件搭建 B 舵机耳销：先短段入垫梁

2×6558

1. 本页组装尚未接底盘的B 后臂，用独立夹具托稳。A/B和 ±Z为本头局部坐标。
2. 两根6558短的一孔段从-Y沿+Y插入垫梁第3、7孔。
3. 挡肩留在垫梁上，长段向-Y；舵机未放，不能从上方把销 肩强推穿耳孔。

核对：两根蓝长销竖直，舵机来路保持空。

真实LDraw网格；爆炸间距仅用于识别，不代表装配间隙或已验证路径。

## 339 / 501 B 墙架／舵机架逐件搭建 B 舵机：机外核对成品本体

1×geekservo

1. 本页组装尚未接底盘的B 后臂，用独立夹具托稳。A/B和 ±Z为本头局部坐标。
2. 取成品geekservo，保持断电，暂不套入平台耳销。
3. 输出端朝图示连杆侧；先在机外接曲柄，再连同曲柄一起 落位，避免曲柄横向穿入被连杆挡住。
4. 舵机网格为近似外形，耳孔和输出配合必须对照实物核验。

核对：舵机单独支承，不拆本体内部。

真实LDraw网格；爆炸间距仅用于识别，不代表装配间隙或已验证路径。

## 340 / 501 B 墙架／舵机架逐件搭建 B 曲柄：机外条件定位后接舵机

1×41677

1. 本页组装尚未接底盘的B 后臂，用独立夹具托稳。A/B和 ±Z为本头局部坐标。
2. 41677曲柄从-Z沿+Z套向舵机输出端，末端孔仍不接连杆。
3. 仅在另行验证的断电输出轴位和接口匹配条件下自然套合 ；不能为追图示角度强扭舵机。
4. 近似舵机网格不证明真实输出花键/转接配合。未能自然 配合时保持待验证，不继续闭链。

核对：机外只接曲柄根部，整组独立支承。

真实LDraw网格；爆炸间距仅用于识别，不代表装配间隙或已验证路径。

## 341 / 501 B 墙架／舵机架逐件搭建 B 舵机与曲柄：整组沿耳销落位

本步合并／核对，无新增件

1. 本页组装尚未接底盘的B 后臂，用独立夹具托稳。A/B和 ±Z为本头局部坐标。
2. 取刚接好的舵机/曲柄两件组，保持相对方向，不重复取 件。
3. 从-Y沿+Y将舵机耳孔套住#73/#74两根蓝销长段，直到挡 肩；曲柄从连杆外侧经过，末端保持未连接。
4. 不能改成先落舵机、再横穿曲柄：已放好的连杆会挡住曲 柄入口。实际接口与耳孔遇阻立即停。

核对：两耳到肩、曲柄在连杆外侧，94/95仍未装。

真实LDraw网格；爆炸间距仅用于识别，不代表装配间隙或已验证路径。

## 342 / 501 B 墙架／舵机架逐件搭建 B 平台接墙：两枚销先入平台

2×2780

1. 本页组装尚未接底盘的B 后臂，用独立夹具托稳。A/B和 ±Z为本头局部坐标。
2. 平台仍未接墙，从前端+X沿-X向局部Z8、24毫米的端孔 半插2780，中间孔留空。已接舵机和曲柄仍保持在位。
3. 挡圈在平台前沿，露出半根向+X；这些销随后进入墙中 框，不穿闭合双层。

核对：两销轴线为X，不能与导向蓝销混用。

真实LDraw网格；爆炸间距仅用于识别，不代表装配间隙或已验证路径。

## 343 / 501 B 墙架／舵机架逐件搭建 B 平台接墙：从背面平推

本步合并／核对，无新增件

1. 本页组装尚未接底盘的B 后臂，用独立夹具托稳。A/B和 ±Z为本头局部坐标。
2. 取已搭平台、舵机、曲柄及连杆，省略的已接件仍在位； 继续用夹具托住连杆远端。
3. 从墙背面-X沿+X平推，两销进入中框；导向轴线与转盘 中心线保持同轴。

核对：平台和马达分别用各自销接墙，无重复取件。

真实LDraw网格；爆炸间距仅用于识别，不代表装配间隙或已验证路径。

## 344 / 501 B 墙架／舵机架逐件搭建 B 后竖撑：先给马达侧连接器插销

2×2780

1. 本页组装尚未接底盘的B 后臂，用独立夹具托稳。A/B和 ±Z为本头局部坐标。
2. 在马达侧55615#70的两孔，从-Z沿+Z半插两枚2780。
3. 挡圈留在-Z外面，露出销尖给9L竖梁。

核对：销位Y40、56毫米，两销向-Z露出。

真实LDraw网格；爆炸间距仅用于识别，不代表装配间隙或已验证路径。

## 345 / 501 B 墙架／舵机架逐件搭建 B 后竖撑：装马达侧九孔梁

1×40490

1. 本页组装尚未接底盘的B 后臂，用独立夹具托稳。A/B和 ±Z为本头局部坐标。
2. 40490竖向沿Y，从-Z沿+Z套住#79/#80。
3. 上方第2、4孔接两销，梁下端保持空，下一步接底脚。

核对：竖梁孔轴沿Z，底部第7、9孔可接近。

真实LDraw网格；爆炸间距仅用于识别，不代表装配间隙或已验证路径。

## 346 / 501 B 墙架／舵机架逐件搭建 B 后竖撑：底部弯角脚横插

1×55615

1. 本页组装尚未接底盘的B 后臂，用独立夹具托稳。A/B和 ±Z为本头局部坐标。
2. 55615底脚此时在机外，两个横销朝-Z。
3. 从+Z沿-Z把自带两销插入#78第7、9孔；底脚另外两销朝 +Y，留待整臂竖直落到底盘。
4. 底盘此时不得另装同一底脚；这件随臂移动，落座时不重 复取件。

核对：横销先接竖梁，下销仅作将来底盘接口。

真实LDraw网格；爆炸间距仅用于识别，不代表装配间隙或已验证路径。

## 347 / 501 B 墙架／舵机架逐件搭建 B 另一竖撑：只预插上端两销

2×2780

1. 本页组装尚未接底盘的B 后臂，用独立夹具托稳。A/B和 ±Z为本头局部坐标。
2. 在舵机侧55615#71两孔，从+Z沿-Z半插2780。
3. #81竖梁与#84底销留至整臂落座后再装，当前不封侧面。

核对：两销向+Z外露，81/84仍在散件格。

真实LDraw网格；爆炸间距仅用于识别，不代表装配间隙或已验证路径。

## 348 / 501 B 墙架／舵机架逐件搭建 B 平台斜撑：预插宿主黑销

1×2780

1. 本页组装尚未接底盘的B 后臂，用独立夹具托稳。A/B和 ±Z为本头局部坐标。
2. 在平台框舵机侧图示侧孔从+Z沿-Z半插2780。
3. 挡圈留在平台外面；#86斜撑等转盘侧梁和#44完成后再装。

核对：黑销露出朝+Z，对应未来斜撑第6孔。

真实LDraw网格；爆炸间距仅用于识别，不代表装配间隙或已验证路径。

## 349 / 501 B 转盘下半固定 B 转盘下半：凸台对准上框开口

1×18939

1. 本页组装尚未接底盘的B 后臂，用独立夹具托稳。A/B和 ±Z为本头局部坐标。
2. 断电、空载，把刚搭好的墙架和平台可靠夹住。确认输出 轴件#24-29与#86斜撑均为散件，尚未装有齿上半#115。
3. 取#34 18939无齿下半，长方形凸台朝支撑墙，从夹头一侧 局部+X沿-X放入最上方64179的开口；圆盘边沿贴框架正面。
4. 凸台两端各3孔应与框架两侧的3个横孔自然同轴。不要靠 长销把偏斜凸台硬拉正；暂由夹具保持。

核对：无齿下半已就位；两侧各3孔可见，输出轴组和侧梁 均未挡入口。

真实LDraw网格；爆炸间距仅用于识别，不代表装配间隙或已验证路径。

## 350 / 501 B 转盘下半固定 B 下半+Z侧：从外侧插三根蓝长销

3×6558

1. 本页组装尚未接底盘的B 后臂，用独立夹具托稳。A/B和 ±Z为本头局部坐标。
2. 在局部+Z外侧，将#35/#36/#37三根6558分别对准上、中、 下3孔；逐根沿-Z平推。
3. 每根长的2孔段朝内，依次穿框架侧壁与下半凸台端壁； 挡肩停在框架外面，短的1孔段朝+Z外露。
4. 三根分别位于局部Y=-8、0、+8毫米，不省略中间销。此 时不得先装#41侧梁或#86斜撑。

核对：三销肩贴框架外侧，3个短段均外露；下半保持夹具 支承。

真实LDraw网格；爆炸间距仅用于识别，不代表装配间隙或已验证路径。

## 351 / 501 B 转盘下半固定 B 下半-Z侧：从外侧插另三根蓝长销

3×6558

1. 本页组装尚未接底盘的B 后臂，用独立夹具托稳。A/B和 ±Z为本头局部坐标。
2. 输出轴件#24-29仍未装。站到局部-Z侧，把#38/#39/#40逐 根沿+Z装入另3孔。
3. 长的2孔段向内穿框架与凸台，挡肩留在框架外表面；短 的1孔段向-Z外露。
4. 中间#39的直线入口原本与输出轴位置相交，不能在轴组 已接电机时硬插；两侧合计使用6根6558。

核对：两侧各3根6558均到挡肩，无销肩被推过闭合宿主； 输出轴组仍未接。

真实LDraw网格；爆炸间距仅用于识别，不代表装配间隙或已验证路径。

## 352 / 501 B 转盘下半固定 B 中框侧孔：先预插五根黑销

5×2780

1. 本页组装尚未接底盘的B 后臂，用独立夹具托稳。A/B和 ±Z为本头局部坐标。
2. 两根40490侧梁都暂不装。中间64179框的+Z侧只在上、中 两孔预插#42/#43，沿-Z插半根；下孔对应侧梁第8孔，留给 #44长销。
3. -Z侧上、中、下3孔依次预插#46/#47/#48，沿+Z插半根。 所有2780中央挡圈停在框架外面。
4. 五根销另一半朝外露出，稍后由侧梁套住。不能先封梁后 把挡圈强推穿过两层孔。

核对：2＋3共5根黑销；+Z侧最下孔仍空，挡圈全部在框架 外侧。

真实LDraw网格；爆炸间距仅用于识别，不代表装配间隙或已验证路径。

## 353 / 501 B 转盘下半固定 B -Z侧梁：同时套住六个露出销段

1×40490

1. 本页组装尚未接底盘的B 后臂，用独立夹具托稳。A/B和 ±Z为本头局部坐标。
2. 取#45 40490 9L梁，沿墙的上下方向摆正，孔轴沿Z。输出 轴组仍在机外，给侧梁保留直线入口。
3. 从-Z外侧沿+Z平推：从上端数，第1至3孔同时套#38-40短 段，第6至8孔套#46-48黑销；第4、5、9孔不接销。
4. 六孔自然对准后才均匀压到销肩；不要用梁扭转或拉拢错 位的上下框。

核对：9L梁第1-3孔接固定长销、第6-8孔接中框黑销，六处 均贴合。

真实LDraw网格；爆炸间距仅用于识别，不代表装配间隙或已验证路径。

## 354 / 501 B 转盘下半固定 B +Z侧梁：套上三长销和两黑销

1×40490

1. 本页组装尚未接底盘的B 后臂，用独立夹具托稳。A/B和 ±Z为本头局部坐标。
2. 取#41另一根40490 9L梁，从+Z外侧沿-Z靠近墙体；#86斜 撑尚未安装。
3. 从上端数，第1-3孔套#35-37短段，第6/7孔套#42/#43黑销 ，第8孔与中框空孔同轴，留给#44。
4. 先逐处核对5个销尖，再均匀压到挡肩。两侧梁第4、5、9 孔均不接销。

核对：五个连接点齐平，第8孔未被黑销占用；斜撑仍在机 外。

真实LDraw网格；爆炸间距仅用于识别，不代表装配间隙或已验证路径。

## 355 / 501 B 转盘下半固定 B +Z下端长销：留出斜撑连接段

1×6558

1. 本页组装尚未接底盘的B 后臂，用独立夹具托稳。A/B和 ±Z为本头局部坐标。
2. #41梁已在位后，才从+Z外侧沿-Z插入#44 6558；长的2孔 段穿侧梁第8孔并接中框。
3. 挡肩停在侧梁外表面，短的1孔段朝+Z露出，专门用于#86 斜撑第1孔。
4. 不能把#44提前放在框架里再强压侧梁，也不能让它的挡 肩穿过已装斜撑。

核对：#44长段接梁与中框，短段向外；#86还未装。

真实LDraw网格；爆炸间距仅用于识别，不代表装配间隙或已验证路径。

## 356 / 501 B 转盘下半固定 B 斜撑最后：两孔同时套两根销

1×32524

1. 本页组装尚未接底盘的B 后臂，用独立夹具托稳。A/B和 ±Z为本头局部坐标。
2. 确认前面已装的平台黑销#85在位，露出段与#44短段都朝 +Z。取#86 32524七孔梁，保持图示斜向。
3. 从+Z外侧沿-Z平推：第1孔套#44短段，第6孔套平台#85露 出段；两孔中心距5孔距，不能误用第7孔。
4. 两点同时自然对齐后轻压到挡圈。斜撑此时才闭合；不得 用它强拉框架或平台。

核对：斜撑第1/6孔都就位，挡圈留在宿主之间；其余已搭 组件继续独立支承。

真实LDraw网格；爆炸间距仅用于识别，不代表装配间隙或已验证路径。

## 357 / 501 B 墙架／舵机架逐件搭建 B 输出传动：七号轴先入马达

1×44294

1. 本页组装尚未接底盘的B 后臂，用独立夹具托稳。A/B和 ±Z为本头局部坐标。
2. 从夹头侧+X沿-X将44294七号轴插入断电马达输出十字孔 ；保持轴线Y0、Z-40毫米。裸轴进入本体，外部留出套件位 置。
3. 零件和轴套肩位以本图为准；孔位自然匹配后才推进，保 持断电、独立支承。

核对：新装仅本步指定件；其他传动件不重复计数。

真实LDraw网格；爆炸间距仅用于识别，不代表装配间隙或已验证路径。

## 358 / 501 B 墙架／舵机架逐件搭建 B 输出传动：第一只半轴套

1×32123a

1. 本页组装尚未接底盘的B 后臂，用独立夹具托稳。A/B和 ±Z为本头局部坐标。
2. 从+X沿-X套32123a半套，贴到马达输出侧定位面。不得把 轴套推入本体。
3. 零件和轴套肩位以本图为准；孔位自然匹配后才推进，保 持断电、独立支承。

核对：新装仅本步指定件；其他传动件不重复计数。

真实LDraw网格；爆炸间距仅用于识别，不代表装配间隙或已验证路径。

## 359 / 501 B 墙架／舵机架逐件搭建 B 输出传动：第二只半轴套

1×32123a

1. 本页组装尚未接底盘的B 后臂，用独立夹具托稳。A/B和 ±Z为本头局部坐标。
2. 再从+X沿-X套第二只32123a，与第一只相贴。两只半套共 一孔厚。
3. 零件和轴套肩位以本图为准；孔位自然匹配后才推进，保 持断电、独立支承。

核对：新装仅本步指定件；其他传动件不重复计数。

真实LDraw网格；爆炸间距仅用于识别，不代表装配间隙或已验证路径。

## 360 / 501 B 墙架／舵机架逐件搭建 B 输出传动：整轴套

1×3713

1. 本页组装尚未接底盘的B 后臂，用独立夹具托稳。A/B和 ±Z为本头局部坐标。
2. 从+X沿-X套3713整套，贴住前两只半套。与-Z转盘侧梁仅 约0.4毫米名义间隙，遇阻立即停。
3. 零件和轴套肩位以本图为准；孔位自然匹配后才推进，保 持断电、独立支承。

核对：新装仅本步指定件；其他传动件不重复计数。

真实LDraw网格；爆炸间距仅用于识别，不代表装配间隙或已验证路径。

## 361 / 501 B 墙架／舵机架逐件搭建 B 输出传动：二十四齿轮

1×3648b

1. 本页组装尚未接底盘的B 后臂，用独立夹具托稳。A/B和 ±Z为本头局部坐标。
2. 3648b从+X沿-X套上轴并贴住整套。上半转盘还未扣合， 不强扭齿轮咬合。
3. 零件和轴套肩位以本图为准；孔位自然匹配后才推进，保 持断电、独立支承。

核对：新装仅本步指定件；其他传动件不重复计数。

真实LDraw网格；爆炸间距仅用于识别，不代表装配间隙或已验证路径。

## 362 / 501 B 墙架／舵机架逐件搭建 B 输出传动：轴端半套

1×32123a

1. 本页组装尚未接底盘的B 后臂，用独立夹具托稳。A/B和 ±Z为本头局部坐标。
2. 最后从+X沿-X套32123a半套，贴住齿轮前面。核对两半套、 整套、齿轮、末半套的顺序，不能挤压到转动发涩。
3. 零件和轴套肩位以本图为准；孔位自然匹配后才推进，保 持断电、独立支承。

核对：新装仅本步指定件；其他传动件不重复计数。

真实LDraw网格；爆炸间距仅用于识别，不代表装配间隙或已验证路径。

## 363 / 501 B 转盘下半固定 B 转盘与传动：完成动力底架核对

本步合并／核对，无新增件

1. 本页组装尚未接底盘的B 后臂，用独立夹具托稳。A/B和 ±Z为本头局部坐标。
2. 前述步骤已从单件装完90件动力底架，包括墙、电机架、 平台、舵机架、竖支脚、十字块与输出传动。此处不再取零 件。
3. 转盘六根销、两侧梁和斜撑已到位；曲柄与连杆末端仍未 连接，接口81/84仍为散件。
4. 输出轴、半套、整套、齿轮顺序逐项核对；不得将近似舵 机外形或名义小间隙视为实物通过。

核对：90件已引入且无重复；下面继续原夹头流程。

真实LDraw网格；爆炸间距仅用于识别，不代表装配间隙或已验证路径。

## 364 / 501 机械臂组件装配 B 独立搭建-Z侧板组件

1×2780；1×32316；1×32523；1×32524；2×32526；3×6558

1. 本页组装尚未接底盘的B 后臂，用独立夹具托稳。A/B和 ±Z为本头局部坐标。
2. 把#108五孔内梁与#109三孔内梁分别定位；-Z侧五孔段在 局部+Y，三孔段在-Y。将#111～#113三根6558的短段插入内 梁，挡肩留在内梁外侧。
3. 将#106/#107两根32526压到长销的露出段上，长臂沿推杆 方向、短臂朝夹指根轴。先在对应L梁孔预装#114黑销，再 压上#110外侧七孔梁。
4. 三根蓝销贯穿三层；黑销仅连接外侧两层。保留根轴孔及 60483固定孔，组件仍在机外夹具上。

核对：本组件9件；长短内梁位置与图一致，所有销肩留在 宿主接面。

真实LDraw网格；爆炸间距仅用于识别，不代表装配间隙或已验证路径。

## 365 / 501 机械臂组件装配 B 独立搭建+Z侧板组件

1×2780；1×32316；1×32523；1×32524；2×32526；3×6558

1. 本页组装尚未接底盘的B 后臂，用独立夹具托稳。A/B和 ±Z为本头局部坐标。
2. +Z侧长短内梁与上一组件相反：#99五孔段在局部-Y， #100三孔段在+Y。把#102～#104三根6558短段插入内梁。
3. 将#97/#98两根32526压到长销上；先把#105黑销装在对应L 梁孔，再压上#101外侧七孔梁。
4. 本组件暂存机外；先完成另一侧根轴叠层，再把本组件整 体装到转盘。

核对：本组件9件，两个组件共18件。两侧长短段不能照同 一方向复制。

真实LDraw网格；爆炸间距仅用于识别，不代表装配间隙或已验证路径。

## 366 / 501 机械臂组件装配 B 转盘上半与中央导向块就位

1×18938；1×39793

1. 本页组装尚未接底盘的B 后臂，用独立夹具托稳。A/B和 ±Z为本头局部坐标。
2. 取#115有齿转盘上半，正面凸耳朝夹指。将#116导向块从 正面放进两个凸耳之间，中心孔与转盘轴线重合。
3. 导向块两条侧孔对准两侧凸耳上下孔。仅作定位并用夹具 托住，下一步用销连接。

核对：中心孔畅通；凸耳中间孔未用。

真实LDraw网格；爆炸间距仅用于识别，不代表装配间隙或已验证路径。

## 367 / 501 机械臂组件装配 B 先插四根转盘长销

4×6558

1. 本页组装尚未接底盘的B 后臂，用独立夹具托稳。A/B和 ±Z为本头局部坐标。
2. 从两侧凸耳外面各装2根6558，长的2孔段向内穿凸耳并接 导向块。
3. 挡肩贴住凸耳外表面，短的1孔段向外露出，留给侧板后 端。此时两侧板均未装到转盘。

核对：四销都已到挡肩；不能先封侧板再把挡肩强推过孔。

真实LDraw网格；爆炸间距仅用于识别，不代表装配间隙或已验证路径。

## 368 / 501 机械臂组件装配 B 先接-Z侧板，+Z侧保持开放

本步合并／核对，无新增件

1. 本页组装尚未接底盘的B 后臂，用独立夹具托稳。A/B和 ±Z为本头局部坐标。
2. 取已完成的-Z侧板，从局部-Z外侧沿+Z靠近转盘，使两 根L梁的后端孔套住#119/#120露出的短销段。
3. 均匀压到销肩，持续独立托住侧板和转盘。+Z侧板仍单 独放置，不提前封合。

核对：本组件15件；两根根轴从+Z侧仍有装入夹指和整轴 套的空间。

真实LDraw网格；爆炸间距仅用于识别，不代表装配间隙或已验证路径。

## 369 / 501 机械臂组件装配 B A根轴-Z侧：固定销与60483

1×2780；1×60483

1. 本页组装尚未接底盘的B 后臂，用独立夹具托稳。A/B和 ±Z为本头局部坐标。
2. A对应局部+Y。先将#127黑色2780从-Z侧沿+Z插入内梁端 孔半根，挡圈停在内梁外表面。
3. 将#164 60483从同侧装到黑销露出段：圆孔接2780，十字 孔与相邻根轴孔同轴；两孔中心距8毫米。
4. 此时十字孔还没有根轴。夹具托住支架，不能用单销悬挂 它或靠扭转对相位。

核对：60483圆孔已接销，十字孔对根轴线；支架贴合内梁。

真实LDraw网格；爆炸间距仅用于识别，不代表装配间隙或已验证路径。

## 370 / 501 机械臂组件装配 B A根轴：建立穿轴支点

1×32123a；1×3707

1. 本页组装尚未接底盘的B 后臂，用独立夹具托稳。A/B和 ±Z为本头局部坐标。
2. 先把#125半轴套套在#122 8L根轴的-Z端，再沿+Z把轴穿过 60483十字孔与-Z内梁圆孔；夹具保持支架与轴同线。
3. 半套停在60483外侧；根轴伸入尚未封合的+Z侧。根轴十 字相位应自然通过60483，不能旋扭支架来强行咬合。

核对：轴穿过一侧60483和内梁，外侧半套到位；未连接端 由夹具支承。

真实LDraw网格；爆炸间距仅用于识别，不代表装配间隙或已验证路径。

## 371 / 501 机械臂组件装配 B A根轴：依次装整套、夹指、整套

1×32524；2×3713

1. 本页组装尚未接底盘的B 后臂，用独立夹具托稳。A/B和 ±Z为本头局部坐标。
2. 从开放的+Z端，沿-Z依次套上#123整轴套、#121红色7孔 夹指的第4圆孔、#124整轴套。
3. 每只整套厚8毫米；夹指圆孔厚8毫米。三件在两侧内梁之 间构成24毫米叠层，先由夹具支承，不依靠摩擦锁紧。
4. 夹指朝魔方方向，保持本图的正常近闭合分支；图示约 3.84°，不反向翻折。

核对：内侧顺序为整套／夹指圆孔／整套；+Z侧板仍独立 暂存。

真实LDraw网格；爆炸间距仅用于识别，不代表装配间隙或已验证路径。

## 372 / 501 机械臂组件装配 B B根轴-Z侧：固定销与60483

1×2780；1×60483

1. 本页组装尚未接底盘的B 后臂，用独立夹具托稳。A/B和 ±Z为本头局部坐标。
2. B对应局部-Y。先将#135黑色2780从-Z侧沿+Z插入内梁端 孔半根，挡圈停在内梁外表面。
3. 将#166 60483从同侧装到黑销露出段：圆孔接2780，十字 孔与相邻根轴孔同轴；两孔中心距8毫米。
4. 此时十字孔还没有根轴。夹具托住支架，不能用单销悬挂 它或靠扭转对相位。

核对：60483圆孔已接销，十字孔对根轴线；支架贴合内梁。

真实LDraw网格；爆炸间距仅用于识别，不代表装配间隙或已验证路径。

## 373 / 501 机械臂组件装配 B B根轴：建立穿轴支点

1×32123a；1×3707

1. 本页组装尚未接底盘的B 后臂，用独立夹具托稳。A/B和 ±Z为本头局部坐标。
2. 先把#133半轴套套在#130 8L根轴的-Z端，再沿+Z把轴穿过 60483十字孔与-Z内梁圆孔；夹具保持支架与轴同线。
3. 半套停在60483外侧；根轴伸入尚未封合的+Z侧。根轴十 字相位应自然通过60483，不能旋扭支架来强行咬合。

核对：轴穿过一侧60483和内梁，外侧半套到位；未连接端 由夹具支承。

真实LDraw网格；爆炸间距仅用于识别，不代表装配间隙或已验证路径。

## 374 / 501 机械臂组件装配 B B根轴：依次装整套、夹指、整套

1×32524；2×3713

1. 本页组装尚未接底盘的B 后臂，用独立夹具托稳。A/B和 ±Z为本头局部坐标。
2. 从开放的+Z端，沿-Z依次套上#131整轴套、#129红色7孔 夹指的第4圆孔、#132整轴套。
3. 每只整套厚8毫米；夹指圆孔厚8毫米。三件在两侧内梁之 间构成24毫米叠层，先由夹具支承，不依靠摩擦锁紧。
4. 夹指朝魔方方向，保持本图的正常近闭合分支；图示约 3.84°，不反向翻折。

核对：内侧顺序为整套／夹指圆孔／整套；+Z侧板仍独立 暂存。

真实LDraw网格；爆炸间距仅用于识别，不代表装配间隙或已验证路径。

## 375 / 501 机械臂组件装配 B 合上+Z侧板组件

本步合并／核对，无新增件

1. 本页组装尚未接底盘的B 后臂，用独立夹具托稳。A/B和 ±Z为本头局部坐标。
2. 同时托住两根根轴、夹指与四只整轴套。把已完成的+Z 侧板从+Z外侧沿-Z靠近。
3. 侧板前端两个根轴孔分别套住A/B轴；后端两根L梁孔同时 套住#117/#118转盘长销短段，均匀压至销肩。
4. 四处必须自然对齐；不能用侧板把歪斜轴套硬挤进空隙。 若侧板无法无强力就位，停下复核支承和孔向。

核对：两根轴均穿过两侧内梁，四只整轴套与两夹指在位； +Z端60483与半套尚待安装。

真实LDraw网格；爆炸间距仅用于识别，不代表装配间隙或已验证路径。

## 376 / 501 机械臂组件装配 B A根轴+Z侧：装60483

1×2780；1×60483

1. 本页组装尚未接底盘的B 后臂，用独立夹具托稳。A/B和 ±Z为本头局部坐标。
2. 先从+Z外侧沿-Z把#128黑销插入内梁端孔半根，挡圈停在 内梁与支架的接面。
3. 将#165 60483十字孔对根轴、圆孔对黑销，同时平推到位 ；十字孔与圆孔各接合8毫米。保持根轴另一端半套在位。

核对：两点同时贴合；没有推动根轴或把销挡肩强推穿过宿 主。

真实LDraw网格；爆炸间距仅用于识别，不代表装配间隙或已验证路径。

## 377 / 501 机械臂组件装配 B A根轴+Z半套与64毫米叠层

1×32123a

1. 本页组装尚未接底盘的B 后臂，用独立夹具托稳。A/B和 ±Z为本头局部坐标。
2. 从+Z端沿-Z套上#126半轴套，停在60483外侧。不要用半 套压紧夹指或拉拢结构。
3. 从-Z到+Z：半套4＋60483 8＋内梁8＋整套8＋夹指8＋整套 8＋内梁8＋60483 8＋半套4＝64毫米，恰好占满8L根轴。
4. 名义轴向余量为零。自由转动和可靠防脱是否兼容必须实 测；任何卡死、松脱或轴端接合不足都停止。

核对：两端半套齐全；64毫米零名义余量已记录，未把几何 吻合当作实体验收。

真实LDraw网格；爆炸间距仅用于识别，不代表装配间隙或已验证路径。

## 378 / 501 机械臂组件装配 B B根轴+Z侧：装60483

1×2780；1×60483

1. 本页组装尚未接底盘的B 后臂，用独立夹具托稳。A/B和 ±Z为本头局部坐标。
2. 先从+Z外侧沿-Z把#136黑销插入内梁端孔半根，挡圈停在 内梁与支架的接面。
3. 将#167 60483十字孔对根轴、圆孔对黑销，同时平推到位 ；十字孔与圆孔各接合8毫米。保持根轴另一端半套在位。

核对：两点同时贴合；没有推动根轴或把销挡肩强推穿过宿 主。

真实LDraw网格；爆炸间距仅用于识别，不代表装配间隙或已验证路径。

## 379 / 501 机械臂组件装配 B B根轴+Z半套与64毫米叠层

1×32123a

1. 本页组装尚未接底盘的B 后臂，用独立夹具托稳。A/B和 ±Z为本头局部坐标。
2. 从+Z端沿-Z套上#134半轴套，停在60483外侧。不要用半 套压紧夹指或拉拢结构。
3. 从-Z到+Z：半套4＋60483 8＋内梁8＋整套8＋夹指8＋整套 8＋内梁8＋60483 8＋半套4＝64毫米，恰好占满8L根轴。
4. 名义轴向余量为零。自由转动和可靠防脱是否兼容必须实 测；任何卡死、松脱或轴端接合不足都停止。

核对：两端半套齐全；64毫米零名义余量已记录，未把几何 吻合当作实体验收。

真实LDraw网格；爆炸间距仅用于识别，不代表装配间隙或已验证路径。

## 380 / 501 机械臂组件装配 B A轮胎与轮毂预装

1×42610；1×50945_nominal

1. 本页组装尚未接底盘的B 后臂，用独立夹具托稳。A/B和 ±Z为本头局部坐标。
2. 把#145轮胎套在#144轮毂上，确认胎圈均匀就座。将这2 件组件暂存在机外。
3. 每臂两组独立轮胎压头；轮胎网格是名义14×6毫米尺寸 ，实际橡胶形变和摩擦未验证。

核对：2件组件同心，轮毂中孔保持畅通。

真实LDraw网格；爆炸间距仅用于识别，不代表装配间隙或已验证路径。

## 381 / 501 机械臂组件装配 B A压头：先装-Z薄梁与两连接点

1×32054；1×32123a；1×32449；1×4519

1. 本页组装尚未接底盘的B 后臂，用独立夹具托稳。A/B和 ±Z为本头局部坐标。
2. 把#137四孔薄梁贴在红色夹指-Z侧。薄梁第1十字孔对夹 指第6孔，用#139 3L轴贯穿，并在-Z端加#140半套。
3. 薄梁第2圆孔对夹指第7孔，从-Z侧插#142 32054，挡套停 在第一根薄梁外侧；露出的轴和销给另一侧薄梁使用。
4. 薄梁第3圆孔留空，第4十字孔用于轮轴；+Z侧薄梁下一 步安装。

核对：薄梁由两个连接点定位，挡套在正确外侧；轮胎组件 仍单独托住。

真实LDraw网格；爆炸间距仅用于识别，不代表装配间隙或已验证路径。

## 382 / 501 机械臂组件装配 B A压头：轮轴、轮胎与+Z薄梁

1×32062；1×32123a；1×32449

1. 本页组装尚未接底盘的B 后臂，用独立夹具托稳。A/B和 ±Z为本头局部坐标。
2. 把#143 2L轮轴穿过-Z薄梁第4十字孔，套入已准备的轮胎 ／轮毂组件；轮毂位于夹指中面。
3. 把#138 +Z薄梁同时对准3L轴、32054销和2L轮轴三个连接 点，沿-Z平直压到位，再在3L轴+Z端套#141半套。
4. 2L轮轴两端与薄梁外侧齐平，不加外轴套。检查轮毂能绕 固定轴自由转动；不能靠挤压薄梁消除间隙。

核对：本夹指轮胎压头9件齐全，两个3L轴半套和32054挡套 到位。

真实LDraw网格；爆炸间距仅用于识别，不代表装配间隙或已验证路径。

## 383 / 501 机械臂组件装配 B B轮胎与轮毂预装

1×42610；1×50945_nominal

1. 本页组装尚未接底盘的B 后臂，用独立夹具托稳。A/B和 ±Z为本头局部坐标。
2. 把#154轮胎套在#153轮毂上，确认胎圈均匀就座。将这2 件组件暂存在机外。
3. 每臂两组独立轮胎压头；轮胎网格是名义14×6毫米尺寸 ，实际橡胶形变和摩擦未验证。

核对：2件组件同心，轮毂中孔保持畅通。

真实LDraw网格；爆炸间距仅用于识别，不代表装配间隙或已验证路径。

## 384 / 501 机械臂组件装配 B B压头：先装-Z薄梁与两连接点

1×32054；1×32123a；1×32449；1×4519

1. 本页组装尚未接底盘的B 后臂，用独立夹具托稳。A/B和 ±Z为本头局部坐标。
2. 把#146四孔薄梁贴在红色夹指-Z侧。薄梁第1十字孔对夹 指第6孔，用#148 3L轴贯穿，并在-Z端加#149半套。
3. 薄梁第2圆孔对夹指第7孔，从-Z侧插#151 32054，挡套停 在第一根薄梁外侧；露出的轴和销给另一侧薄梁使用。
4. 薄梁第3圆孔留空，第4十字孔用于轮轴；+Z侧薄梁下一 步安装。

核对：薄梁由两个连接点定位，挡套在正确外侧；轮胎组件 仍单独托住。

真实LDraw网格；爆炸间距仅用于识别，不代表装配间隙或已验证路径。

## 385 / 501 机械臂组件装配 B B压头：轮轴、轮胎与+Z薄梁

1×32062；1×32123a；1×32449

1. 本页组装尚未接底盘的B 后臂，用独立夹具托稳。A/B和 ±Z为本头局部坐标。
2. 把#152 2L轮轴穿过-Z薄梁第4十字孔，套入已准备的轮胎 ／轮毂组件；轮毂位于夹指中面。
3. 把#147 +Z薄梁同时对准3L轴、32054销和2L轮轴三个连接 点，沿-Z平直压到位，再在3L轴+Z端套#150半套。
4. 2L轮轴两端与薄梁外侧齐平，不加外轴套。检查轮毂能绕 固定轴自由转动；不能靠挤压薄梁消除间隙。

核对：本夹指轮胎压头9件齐全，两个3L轴半套和32054挡套 到位。

真实LDraw网格；爆炸间距仅用于识别，不代表装配间隙或已验证路径。

## 386 / 501 机械臂组件装配 B 先把无摩擦销各插入夹指半根

2×3673

1. 本页组装尚未接底盘的B 后臂，用独立夹具托稳。A/B和 ±Z为本头局部坐标。
2. 两根黄色连杆尚未接到夹指。A夹指第2孔先从+Z侧沿-Z 插#160灰色3673半根；B夹指第2孔从-Z侧沿+Z插#162半根。
3. 两个中央挡圈都留在夹指外表面，销的另一半露出，供下 一步各自的连杆圆孔套接。
4. 夹指和已装头部由夹具支承。不能把销推穿夹指后再把挡 圈强推通过连杆。

核对：A/B两销肩分别在+Z/-Z夹指外表面，露出段方向相 反。

真实LDraw网格；爆炸间距仅用于识别，不代表装配间隙或已验证路径。

## 387 / 501 机械臂组件装配 B 两根黄色连杆分别从各自外侧套销

2×32316

1. 本页组装尚未接底盘的B 后臂，用独立夹具托稳。A/B和 ±Z为本头局部坐标。
2. 先从+Z外侧沿-Z把#159连杆一端套到A销#160的露出段， 直到与夹指之间的销肩接触。
3. 再从-Z外侧沿+Z把#161连杆一端套到B销#162的露出段。 两根连杆分别装入，不把它们预先连成刚性组件一起硬推。
4. 两连杆自由端由夹具托在十字接头位置。保持正常近闭合 分支；下一步用横轴连接中间三个孔。

核对：两销肩停在各自的夹指与连杆接面，连杆可绕无摩擦 销转动。

真实LDraw网格；爆炸间距仅用于识别，不代表装配间隙或已验证路径。

## 388 / 501 机械臂组件装配 B 连接十字接头横轴与两端半套

1×32013；2×32123a；1×3705

1. 本页组装尚未接底盘的B 后臂，用独立夹具托稳。A/B和 ±Z为本头局部坐标。
2. 用夹具保持两连杆自由端同轴，在中间放#155 32013，横 圆孔对准两个连杆端孔，纵向十字孔朝后接推杆。
3. 在#156 4L横轴-Z端预套#157半套；从-Z沿+Z依次穿过#161 连杆、32013横圆孔和#159连杆，再从+Z端套#158半套。
4. 轴本体穿圆孔，无销挡肩经过闭合孔。两半套停在连杆外 侧，不能压死连杆；十字接头在两连杆朝魔方的一端。

核对：横轴与两端半套齐全，三处圆孔自然同轴；纵向十字 孔仍畅通。

真实LDraw网格；爆炸间距仅用于识别，不代表装配间隙或已验证路径。

## 389 / 501 机械臂组件装配 B 离机接合机械头与90件动力核心

本步合并／核对，无新增件

1. 本页组装尚未接底盘的B 后臂，用独立夹具托稳。A/B和 ±Z为本头局部坐标。
2. 转盘下半固定及轴组接入已按前述步骤完成，90件动力底 架、机械头及未闭合的曲柄／连杆分别独立支承。将转盘上 半对准核心的下半扣合；同时保持齿轮与转盘的名义啮合位 置。
3. #94曲柄端轴和#95半套尚未安装，因此黄色舵机连杆不会 把推杆强制锁在舵机角度上。
4. 此时整臂仍在底盘外，#81侧梁和#84底框销仍在专格。扣 合所需空间、卡扣力及实体啮合必须另行验证。

核对：转盘上下半及导向孔同轴；曲柄与连杆未连接，推杆 通道未封闭。

真实LDraw网格；爆炸间距仅用于识别，不代表装配间隙或已验证路径。

## 390 / 501 机械臂组件装配 B 从后方穿12L推杆及两只半套

2×32123a；1×3708

1. 本页组装尚未接底盘的B 后臂，用独立夹具托稳。A/B和 ±Z为本头局部坐标。
2. 把#88/#89两只半套分别用夹具定位在十字块#87的前后， 孔轴线对准导向框前孔；曲柄端仍不连接。
3. #163 12L轴从平台后方沿+X穿入：导向框后孔只借道，再 依次通过后半套、十字块圆孔、前半套、导向框前孔、转盘 中心及#116导向块，最后插进#155十字孔到底。
4. 图示为完成位置，后导向孔不承载推杆。自然移动未连接 的十字块／连杆帮助对孔，不反驱舵机；两半套不把滑动机 构夹死。

核对：推杆前端名义进入十字接头8毫米；两个导向处畅通、 两半套就位。

真实LDraw网格；爆炸间距仅用于识别，不代表装配间隙或已验证路径。

## 391 / 501 机械臂组件装配 B 匹配名义姿态后连接曲柄端

1×32062；1×32123a

1. 本页组装尚未接底盘的B 后臂，用独立夹具托稳。A/B和 ±Z为本头局部坐标。
2. 先核对舵机曲柄#93已由另行验证的定位流程处于所需姿 态。本页仅表达断电、空载、孔位自然对齐时的机械连接； 不提供上电归零或脉宽标定。
3. 保持夹指和推杆在图示正常近闭合分支，让#96连杆端孔 与曲柄末端孔自然同轴，再插#94 2L轴：外端与曲柄外面齐 平；内端装#95半套贴住连杆。
4. 孔位不自然重合、需要硬拉连杆或反驱舵机时立即停止， 保持分离和支承，等待专门定位／标定；不能把本页当作定 位已完成的证据。

核对：只有预先满足自然对孔条件才记录此步完成；否则整 臂仍标为待验证。

真实LDraw网格；爆炸间距仅用于识别，不代表装配间隙或已验证路径。

## 392 / 501 机械臂组件装配 B 单臂165件待接底盘，2件留待接口

本步合并／核对，无新增件

1. 本页组装尚未接底盘的B 后臂，用独立夹具托稳。A/B和 ±Z为本头局部坐标。
2. 核对已完成的90件动力底架与75件夹头件共165件；每头4 件60483、2根8L根轴、4只根轴整套、4只根轴外半套和4枚 支架固定销齐全。
3. #81 40490侧梁与#84 2780销保持散件状态，待整臂落到底 盘后先装#84、再装#81，使每臂达到167件；不要提前装这 两件。
4. R、L、F、B四臂分别在机外完成同一局部流程。各臂独 立记录；四臂最终合计668件，不以一个臂通过代替其余三 臂。
5. 64毫米根轴叠层零名义余量；夹指正常约3.84°～25°。 装配路径、保持、载荷、控制联锁和实体开合均未放行。

核对：165件在位＋2件专格＝167件／臂；不插电、不带魔 方，仍需实体验证。

真实LDraw网格；爆炸间距仅用于识别，不代表装配间隙或已验证路径。

## 393 / 501 组件核对 四个机械臂组件核对

每臂165件待安装组件＋2件侧撑预留件；共668件

1. 逐一检查R、L、F、B两根根轴；每根轴两侧各1件60483， 轴套与连接销按图全部到位。
2. 每臂当前165件，另将81号侧梁和84号连接销两件单独预 留，安装到底盘后共167件。全部组件已按本册从清单单件 搭建；逐项核验完整性和姿态。墙脚49/50及底脚77随臂保 留，底盘上不得重复预装。
3. 四臂分别离机支承。R臂接U前需整头回转50°、夹指开 25°；接入底盘前需名义夹紧端／整头0°。这些姿态转换 须用另经验证的断电定位方法，无法安全定位就停止。

核对：每头单独核对，不以一头通过代替四头核对。

真实LDraw网格；爆炸间距仅用于识别，不代表装配间隙或已验证路径。

## 394 / 501 20件杠杆装配 机外负Z内臂：先预插两根重叠销


## 395 / 501 20件杠杆装配 外把手：从敞开侧合上两销

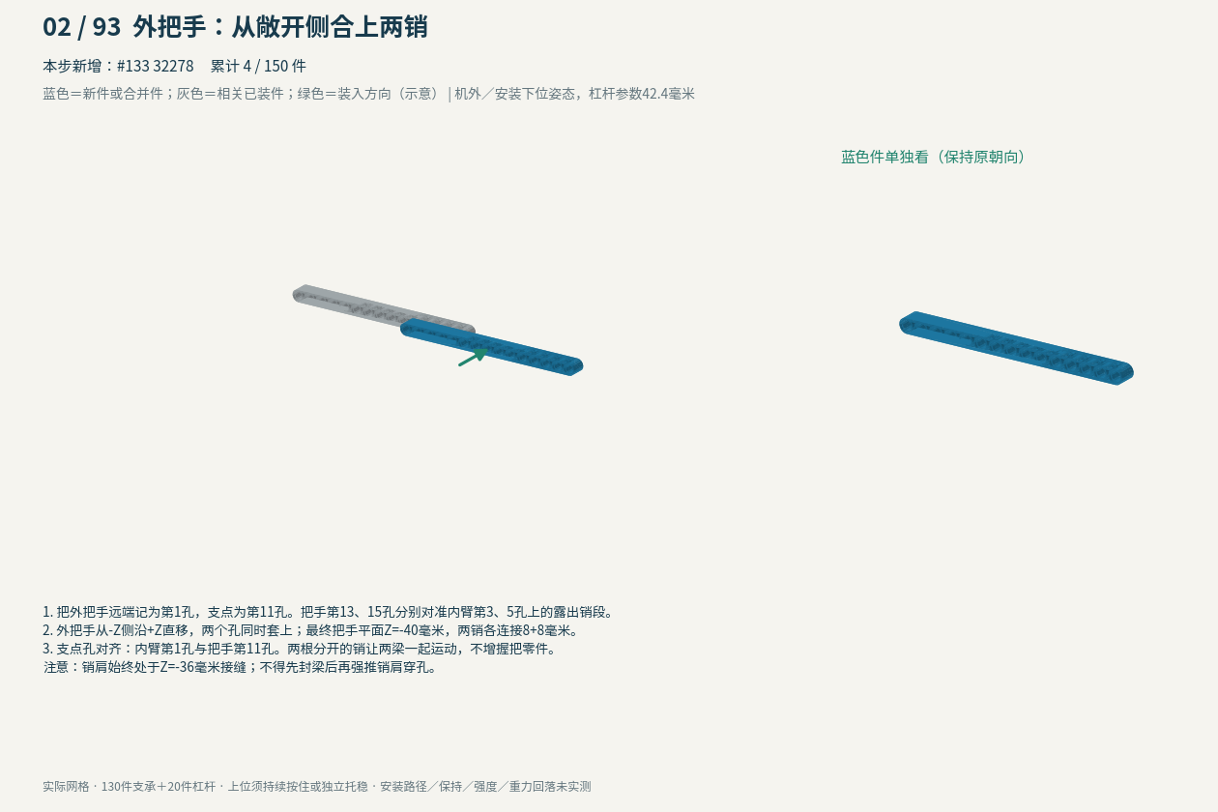
[picture p95: page 395]

## 396 / 501 20件杠杆装配 11L横轴：先穿负Z内臂


## 397 / 501 20件杠杆装配 横轴负侧：依次套2L和1L间隔件

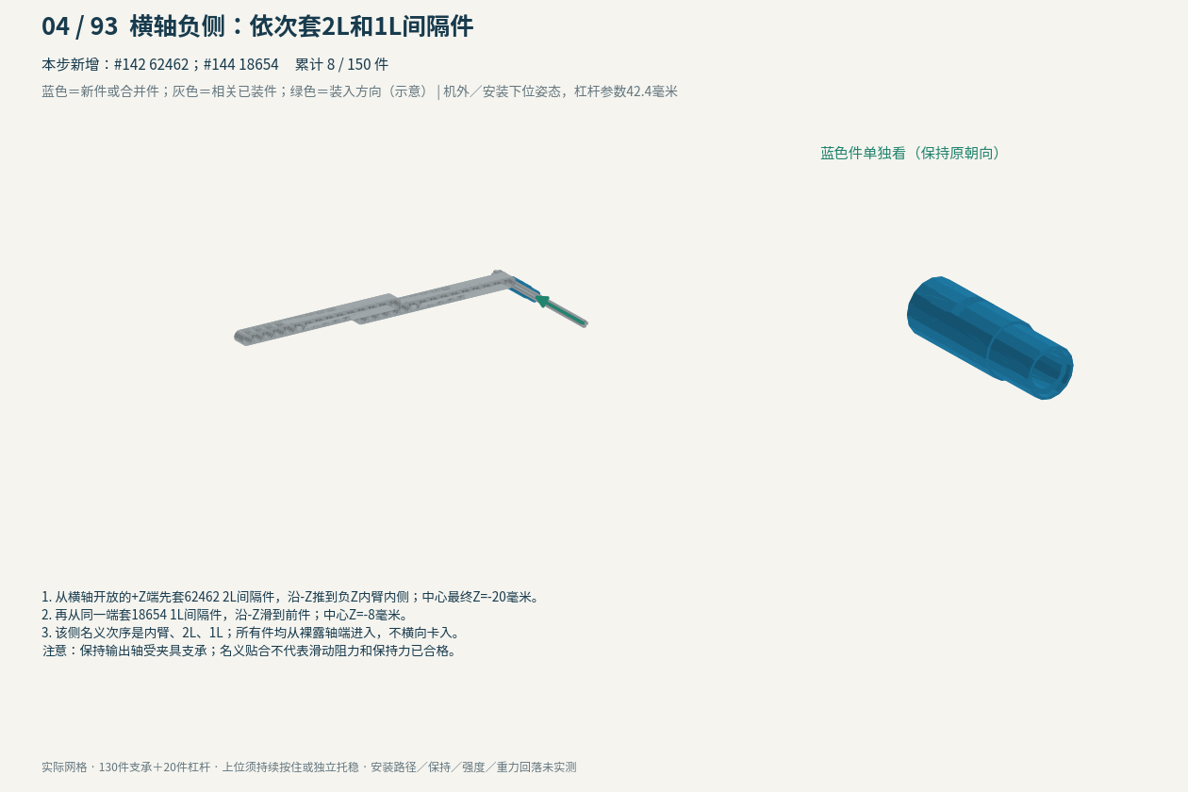
[picture p96: page 397]

## 398 / 501 20件杠杆装配 横轴中央和正侧：套滚轮与间隔件

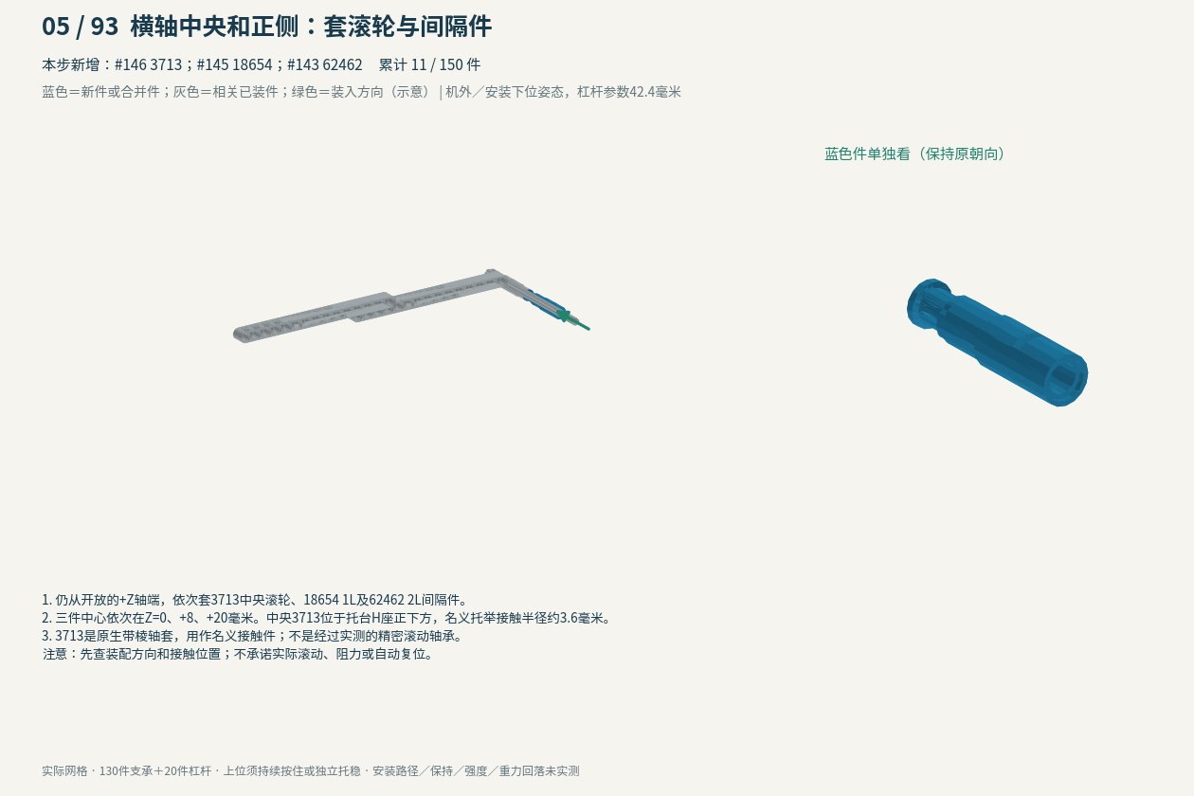
[picture p97: page 398]

## 399 / 501 20件杠杆装配 正Z内臂：从自由轴端合上

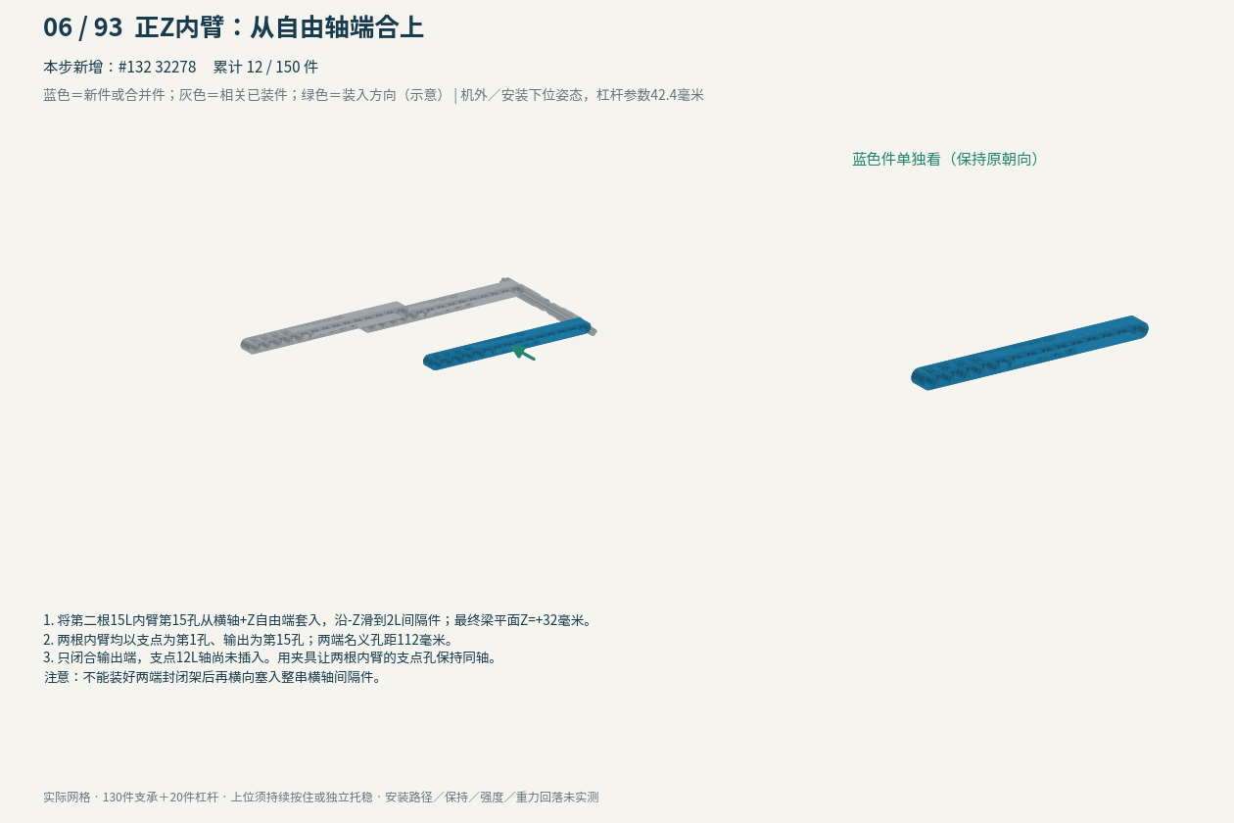
[picture p98: page 399]

## 400 / 501 20件杠杆装配 横轴最后：装正Z外半套

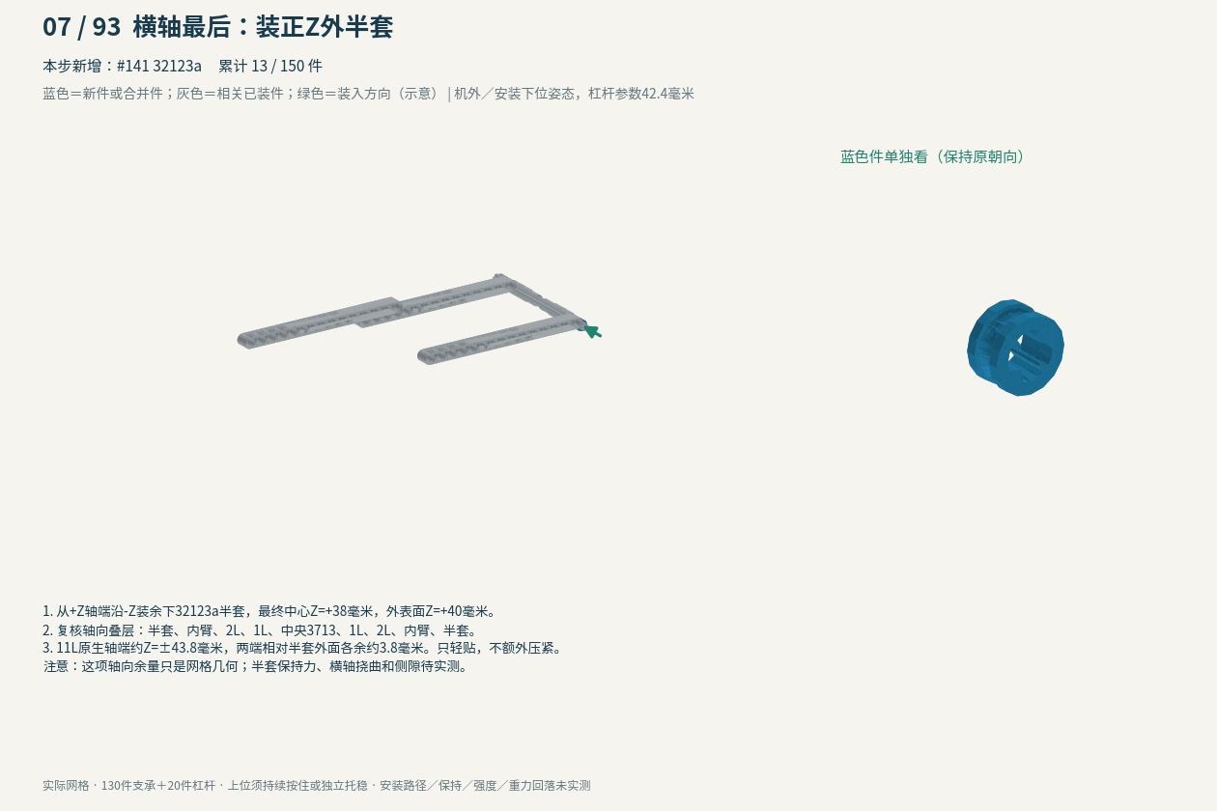
[picture p99: page 400]

## 401 / 501 20件杠杆装配 支点定位：两处根部框轴承都要承接


## 402 / 501 20件杠杆装配 12L支点轴：裸轴贯穿全部同轴孔

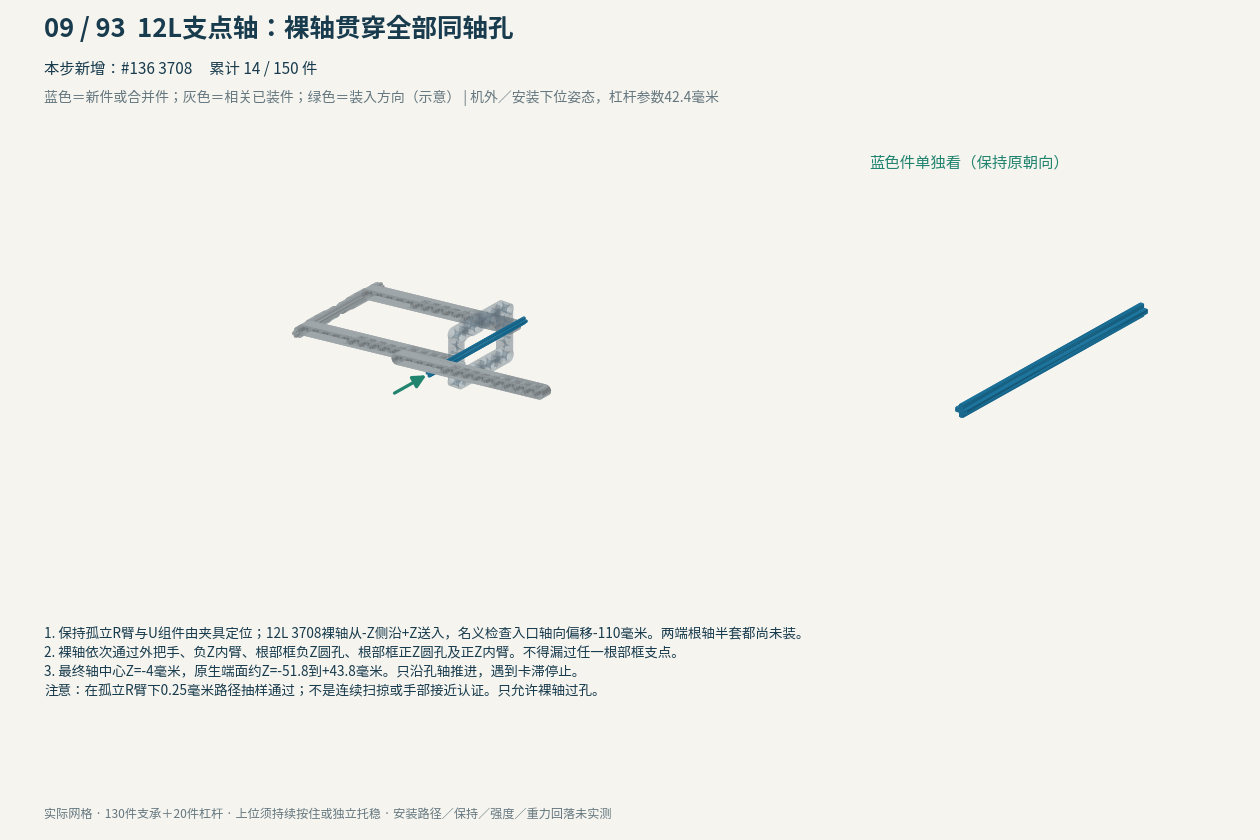
[picture p100: page 402]

## 403 / 501 20件杠杆装配 支点最后：两端各装一只半套


## 404 / 501 四臂接口 右R臂带16件杠杆分阶段接入底盘

R臂165＋杠杆16＋底盘64＝245件

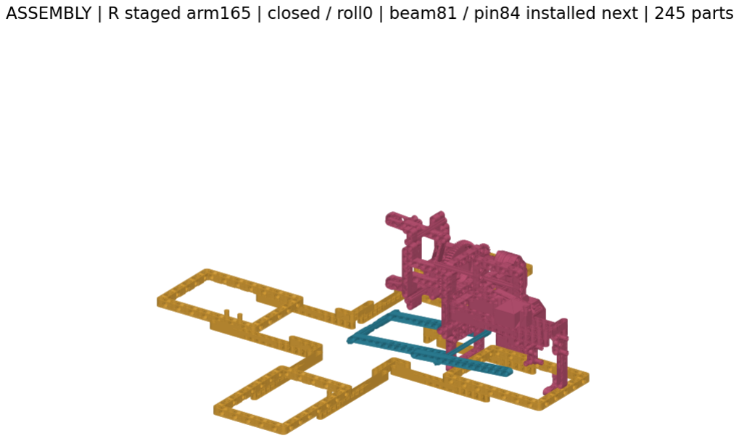
[picture p101: figure]

1. 先按前页在165件孤立R臂上装好U16，再于离机状态把头 设为夹指位于名义夹紧端（行程0）、整头回转0度。杠杆保 持42.4毫米；全程断电、独立托稳，不强扭传动。
2. 确认81号40490 9L侧梁和84号2780销仍单独预留，82/83两 销在已搭组件宿主内。R臂此时165件。
3. 将R165与U16作为一组从世界-Y上方沿+Y落到已闭合64件 底盘，名义高度偏移-160至0毫米。墙脚49/50和底脚77均随 臂下落，底盘上不另装同件；墙脚两销肩停在Y100毫米接缝。
4. 81号侧梁和84号销待臂就位后安装。就位后按下一页先装 84再装81；其余三臂与130件支承仍不装。

核对：本图真实省去81与84；分阶段名义检查不证明连续安 装、人手接近或插入力。

真实LDraw网格；爆炸间距仅用于识别，不代表装配间隙或已验证路径。

## 405 / 501 侧撑安装 R臂先装84号销再装81号侧梁

装入预留件：1×2780（84）＋1×40490 9L梁（81）；该臂共167件

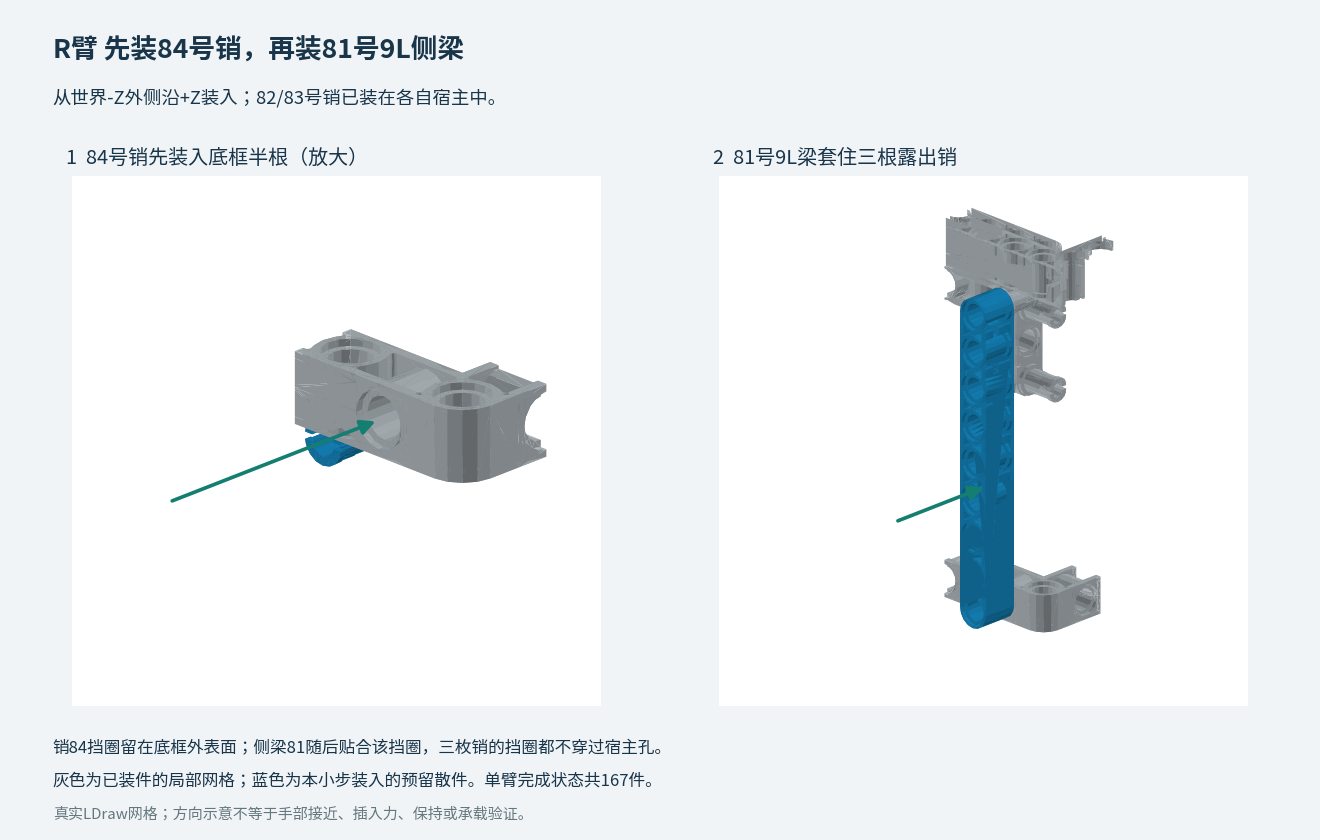
[picture p102: figure]

1. 保持该臂、底盘和U杠杆独立支承，电机断电。81/84为该 臂局部实例编号，不能与B81或支承编号混用；82/83两销留 在原宿主。
2. 先从世界-Z外侧沿+Z，把84号2780只插入底框半根，让中 央挡圈停在底框外侧接缝面。不要先放9L梁，也不要把销强 推穿过两个闭合宿主。
3. 再把81号9L梁从同一外侧沿同方向靠拢，使三个孔同时套 住82、83、84的露出销尖，均匀压至三处挡圈。图左右两幅 按1、2顺序执行。
4. 核对上面两销连接原臂宿主，下面84销连接对应39790底 框；三枚挡圈都留在宿主之间。预留件全部安装后，再按顺 序继续。

核对：没有接近空间、宿主不稳或需强推挡圈过孔即停；名 义路径检查不证明插入力、保持或承载。

真实LDraw网格；爆炸间距仅用于识别，不代表装配间隙或已验证路径。

## 406 / 501 四臂接口 -X左臂分阶段接入共同底盘

该臂165件；就位后安装预留81/84，共167件

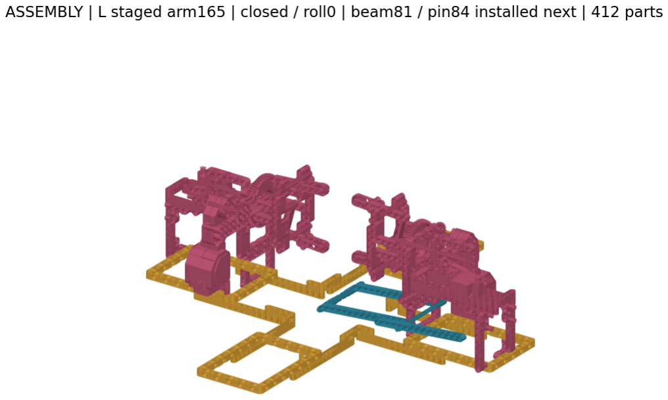
[picture p103: figure]

1. 独立托稳已完成根部装配的L臂。其余已装臂的81/84均已 安装；右臂U16保持下位参数42.4毫米，130件支承仍未安装。
2. 确认本臂81号9L侧梁和84号2780销仍单独预留，82/83两销 在已搭组件宿主内。本步图显示待装165件组件。
3. 该臂和已安装各臂均须夹指位于名义夹紧端（行程0）、 整头回转0度，将165件组件从世界-Y上方沿+Y下降，名义 高度偏移-160至0毫米。墙脚49/50和底脚77均随臂下落，底 盘上不另装同件；两枚墙脚销在Y100毫米接缝接合。
4. 继续独立支承该臂，并立即按下一页先装84销，再从外侧 安装81侧梁。四臂均达到167件后，才安装4件上止挡并搭 130件支承。

核对：路径为名义分阶段检查；不能推导完整连续无碰、人 手接近、销保持或承载能力。

真实LDraw网格；爆炸间距仅用于识别，不代表装配间隙或已验证路径。

## 407 / 501 侧撑安装 L臂先装84号销再装81号侧梁

装入预留件：1×2780（84）＋1×40490 9L梁（81）；该臂共167件

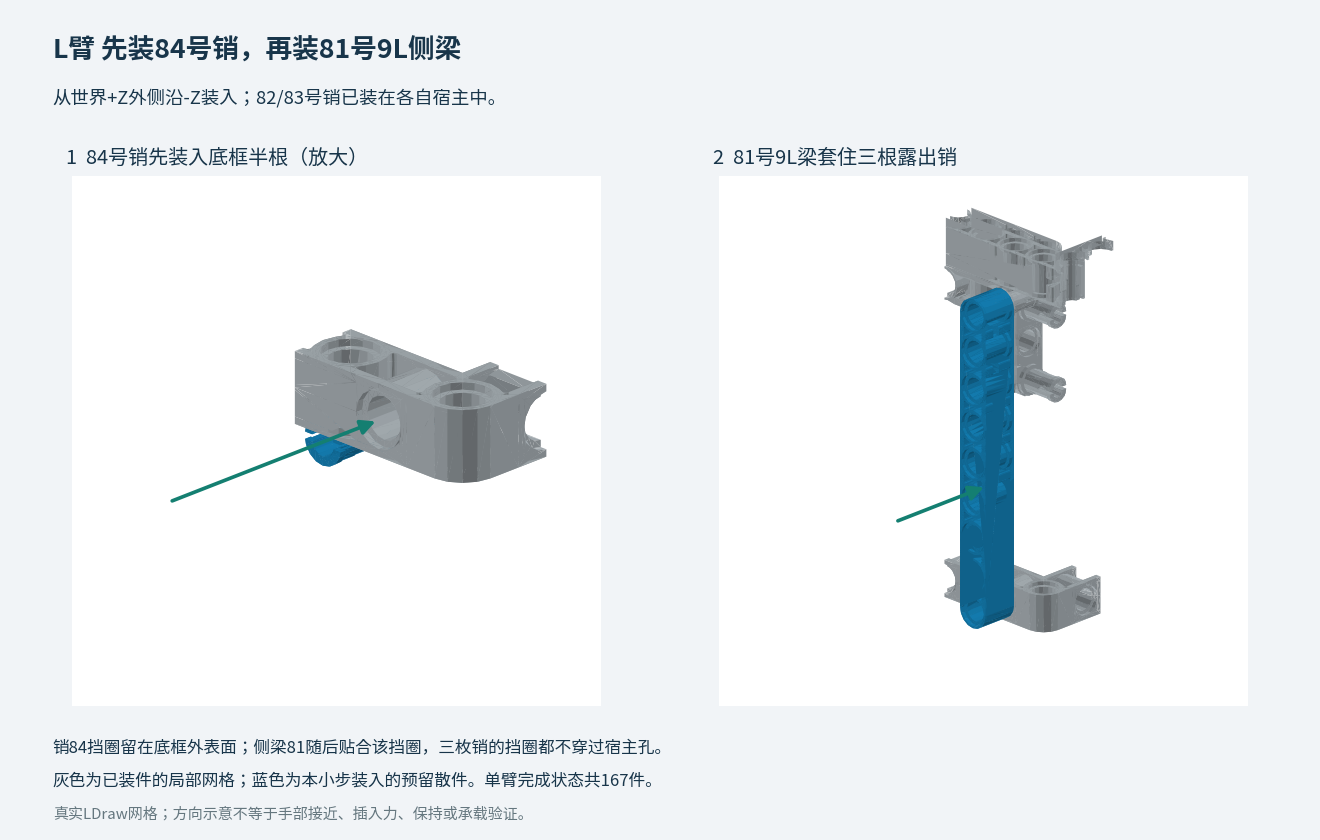
[picture p104: figure]

1. 保持该臂、底盘和U杠杆独立支承，电机断电。81/84为该 臂局部实例编号，不能与B81或支承编号混用；82/83两销留 在原宿主。
2. 先从世界+Z外侧沿-Z，把84号2780只插入底框半根，让中 央挡圈停在底框外侧接缝面。不要先放9L梁，也不要把销强 推穿过两个闭合宿主。
3. 再把81号9L梁从同一外侧沿同方向靠拢，使三个孔同时套 住82、83、84的露出销尖，均匀压至三处挡圈。图左右两幅 按1、2顺序执行。
4. 核对上面两销连接原臂宿主，下面84销连接对应39790底 框；三枚挡圈都留在宿主之间。预留件全部安装后，再按顺 序继续。

核对：没有接近空间、宿主不稳或需强推挡圈过孔即停；名 义路径检查不证明插入力、保持或承载。

真实LDraw网格；爆炸间距仅用于识别，不代表装配间隙或已验证路径。

## 408 / 501 四臂接口 +Z前臂分阶段接入共同底盘

该臂165件；就位后安装预留81/84，共167件

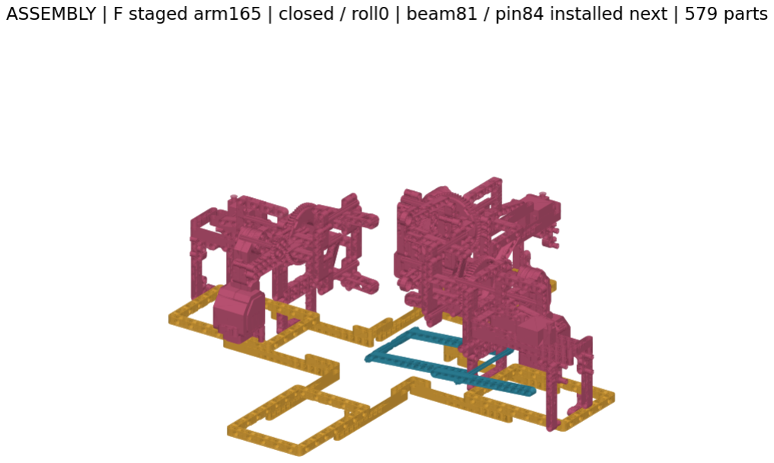
[picture p105: figure]

1. 独立托稳已完成根部装配的F臂。其余已装臂的81/84均已 安装；右臂U16保持下位参数42.4毫米，130件支承仍未安装。
2. 确认本臂81号9L侧梁和84号2780销仍单独预留，82/83两销 在已搭组件宿主内。本步图显示待装165件组件。
3. 该臂和已安装各臂均须夹指位于名义夹紧端（行程0）、 整头回转0度，将165件组件从世界-Y上方沿+Y下降，名义 高度偏移-160至0毫米。墙脚49/50和底脚77均随臂下落，底 盘上不另装同件；两枚墙脚销在Y100毫米接缝接合。
4. 继续独立支承该臂，并立即按下一页先装84销，再从外侧 安装81侧梁。四臂均达到167件后，才安装4件上止挡并搭 130件支承。

核对：路径为名义分阶段检查；不能推导完整连续无碰、人 手接近、销保持或承载能力。

真实LDraw网格；爆炸间距仅用于识别，不代表装配间隙或已验证路径。

## 409 / 501 侧撑安装 F臂先装84号销再装81号侧梁

装入预留件：1×2780（84）＋1×40490 9L梁（81）；该臂共167件

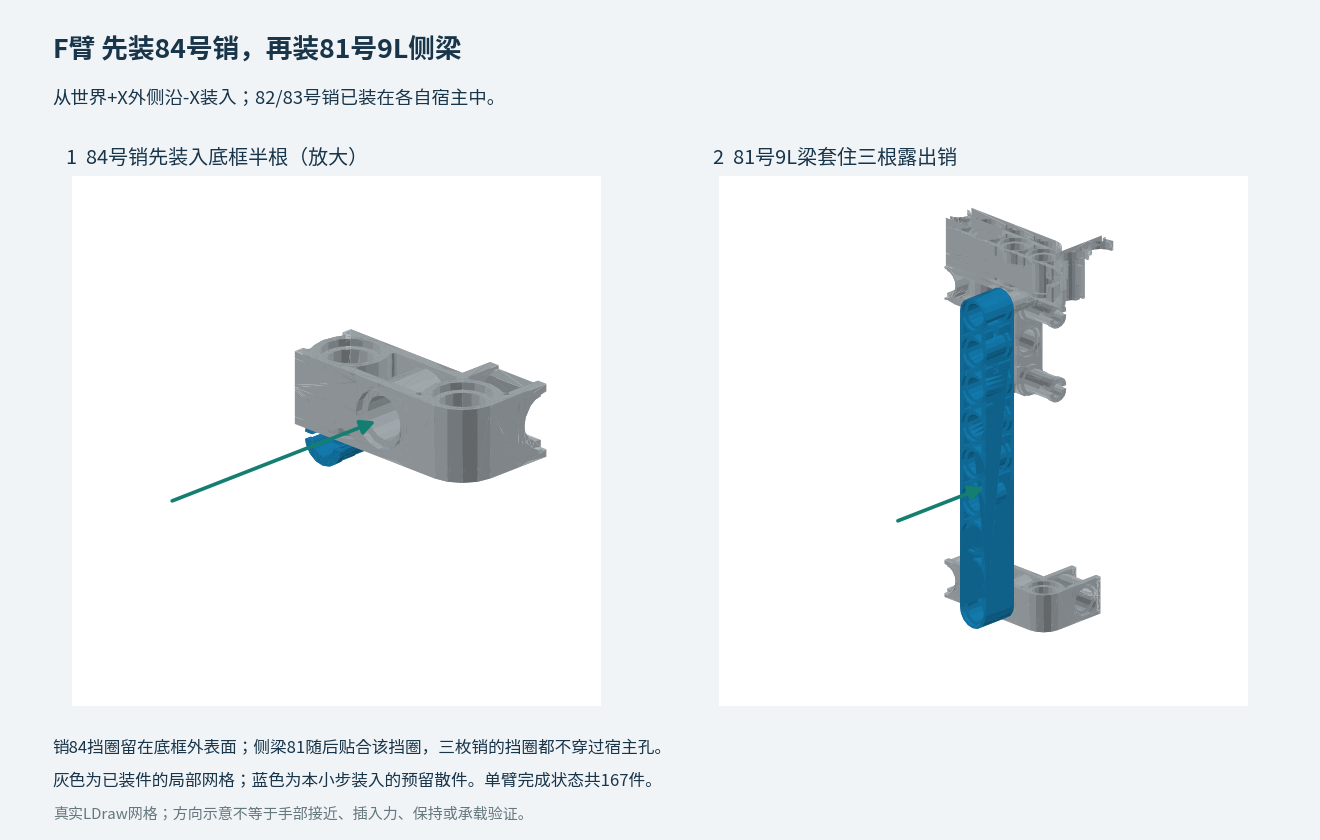
[picture p106: figure]

1. 保持该臂、底盘和U杠杆独立支承，电机断电。81/84为该 臂局部实例编号，不能与B81或支承编号混用；82/83两销留 在原宿主。
2. 先从世界+X外侧沿-X，把84号2780只插入底框半根，让中 央挡圈停在底框外侧接缝面。不要先放9L梁，也不要把销强 推穿过两个闭合宿主。
3. 再把81号9L梁从同一外侧沿同方向靠拢，使三个孔同时套 住82、83、84的露出销尖，均匀压至三处挡圈。图左右两幅 按1、2顺序执行。
4. 核对上面两销连接原臂宿主，下面84销连接对应39790底 框；三枚挡圈都留在宿主之间。预留件全部安装后，再按顺 序继续。

核对：没有接近空间、宿主不稳或需强推挡圈过孔即停；名 义路径检查不证明插入力、保持或承载。

真实LDraw网格；爆炸间距仅用于识别，不代表装配间隙或已验证路径。

## 410 / 501 四臂接口 -Z后臂分阶段接入共同底盘

该臂165件；就位后安装预留81/84，共167件

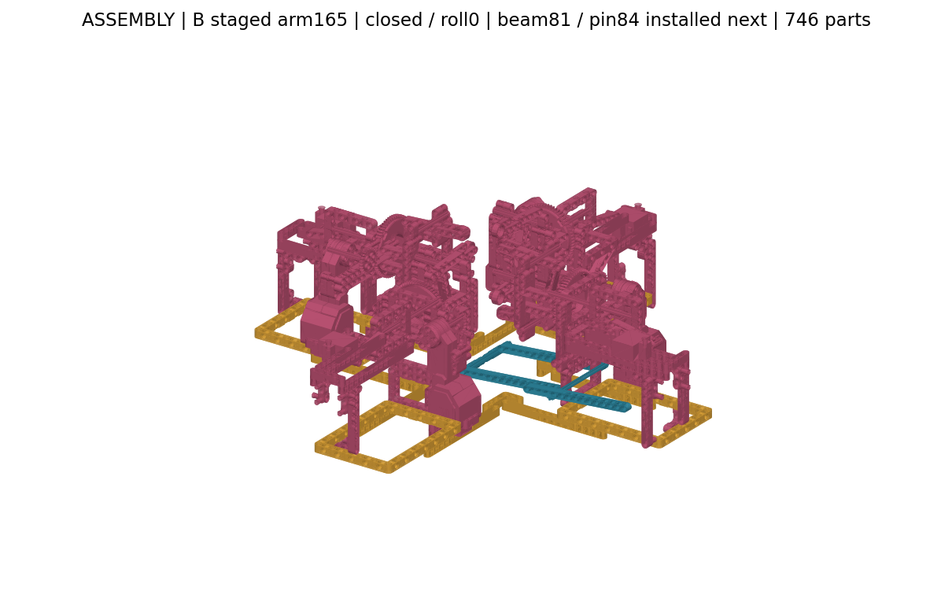
[picture p107: figure]

1. 独立托稳已完成根部装配的B臂。其余已装臂的81/84均已 安装；右臂U16保持下位参数42.4毫米，130件支承仍未安装。
2. 确认本臂81号9L侧梁和84号2780销仍单独预留，82/83两销 在已搭组件宿主内。本步图显示待装165件组件。
3. 该臂和已安装各臂均须夹指位于名义夹紧端（行程0）、 整头回转0度，将165件组件从世界-Y上方沿+Y下降，名义 高度偏移-160至0毫米。墙脚49/50和底脚77均随臂下落，底 盘上不另装同件；两枚墙脚销在Y100毫米接缝接合。
4. 继续独立支承该臂，并立即按下一页先装84销，再从外侧 安装81侧梁。四臂均达到167件后，才安装4件上止挡并搭 130件支承。

核对：路径为名义分阶段检查；不能推导完整连续无碰、人 手接近、销保持或承载能力。

真实LDraw网格；爆炸间距仅用于识别，不代表装配间隙或已验证路径。

## 411 / 501 侧撑安装 B臂先装84号销再装81号侧梁

装入预留件：1×2780（84）＋1×40490 9L梁（81）；该臂共167件


1. 保持该臂、底盘和U杠杆独立支承，电机断电。81/84为该 臂局部实例编号，不能与B81或支承编号混用；82/83两销留 在原宿主。
2. 先从世界-X外侧沿+X，把84号2780只插入底框半根，让中 央挡圈停在底框外侧接缝面。不要先放9L梁，也不要把销强 推穿过两个闭合宿主。
3. 再把81号9L梁从同一外侧沿同方向靠拢，使三个孔同时套 住82、83、84的露出销尖，均匀压至三处挡圈。图左右两幅 按1、2顺序执行。
4. 核对上面两销连接原臂宿主，下面84销连接对应39790底 框；三枚挡圈都留在宿主之间。预留件全部安装后，再按顺 序继续。
5. 四臂全装好后，U仍固定42.4，魔方、托盘和130件支承仍 未装。采用经验证的断电定位方法，按R、L、F、B逐头操 作：先保持夹指在名义夹紧端（行程0），整头回转0至50度 ，再张开至25度；一头完成再到下一头。无法可靠定位或隔 离就停；不授权带电动作。

核对：没有接近空间、宿主不稳或需强推挡圈过孔即停；名 义路径检查不证明插入力、保持或承载。

真实LDraw网格；爆炸间距仅用于识别，不代表装配间隙或已验证路径。

## 412 / 501 20件杠杆装配 上止挡：4L轴从把手外侧穿第4孔

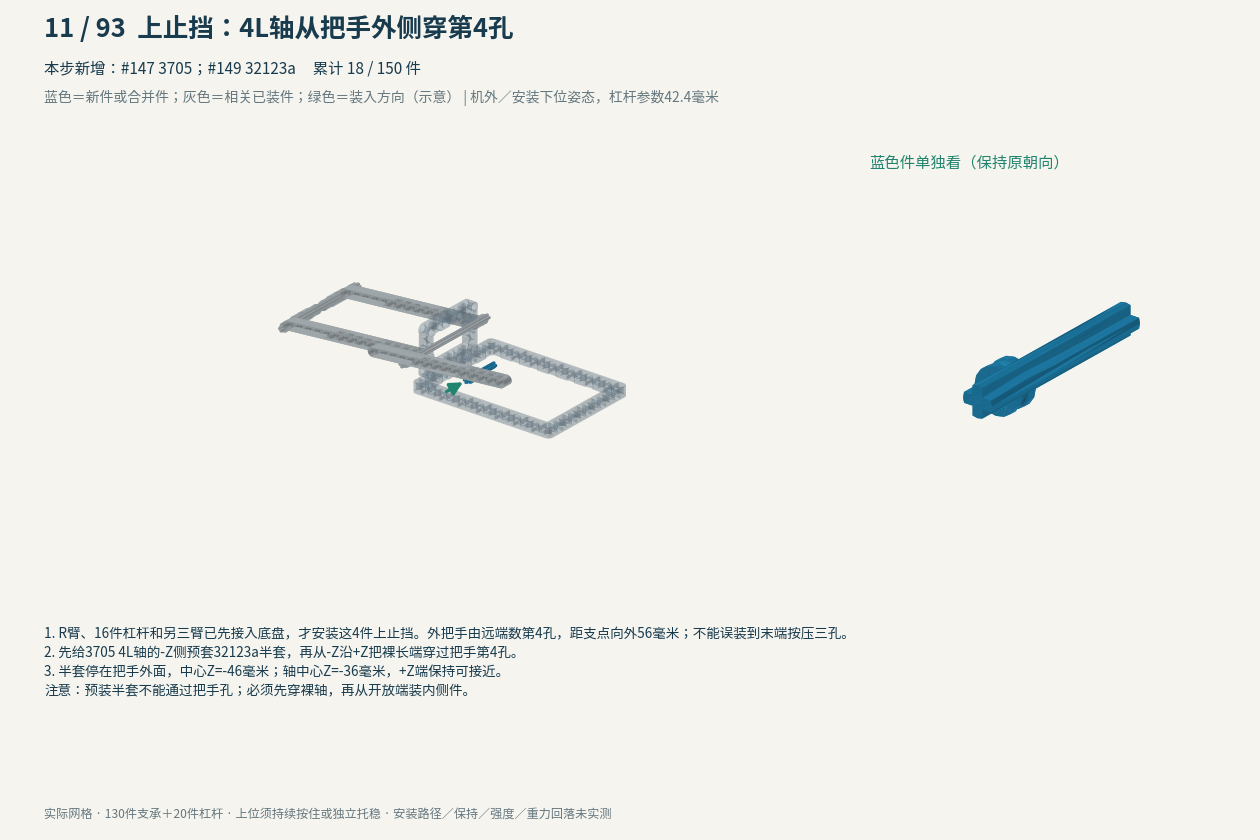
[picture p108: page 412]

## 413 / 501 20件杠杆装配 上止挡内侧：装3713接触轴套

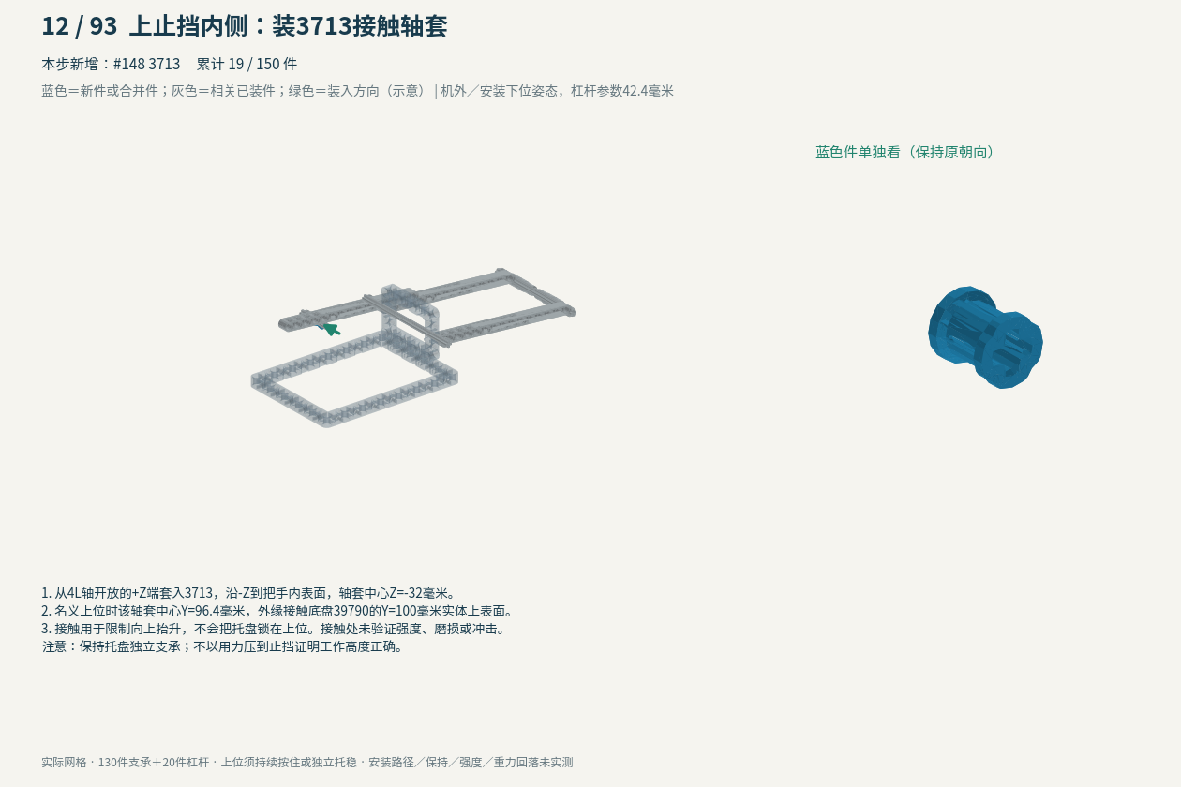
[picture p109: page 413]

## 414 / 501 20件杠杆装配 上止挡最后：内半套封住轴端

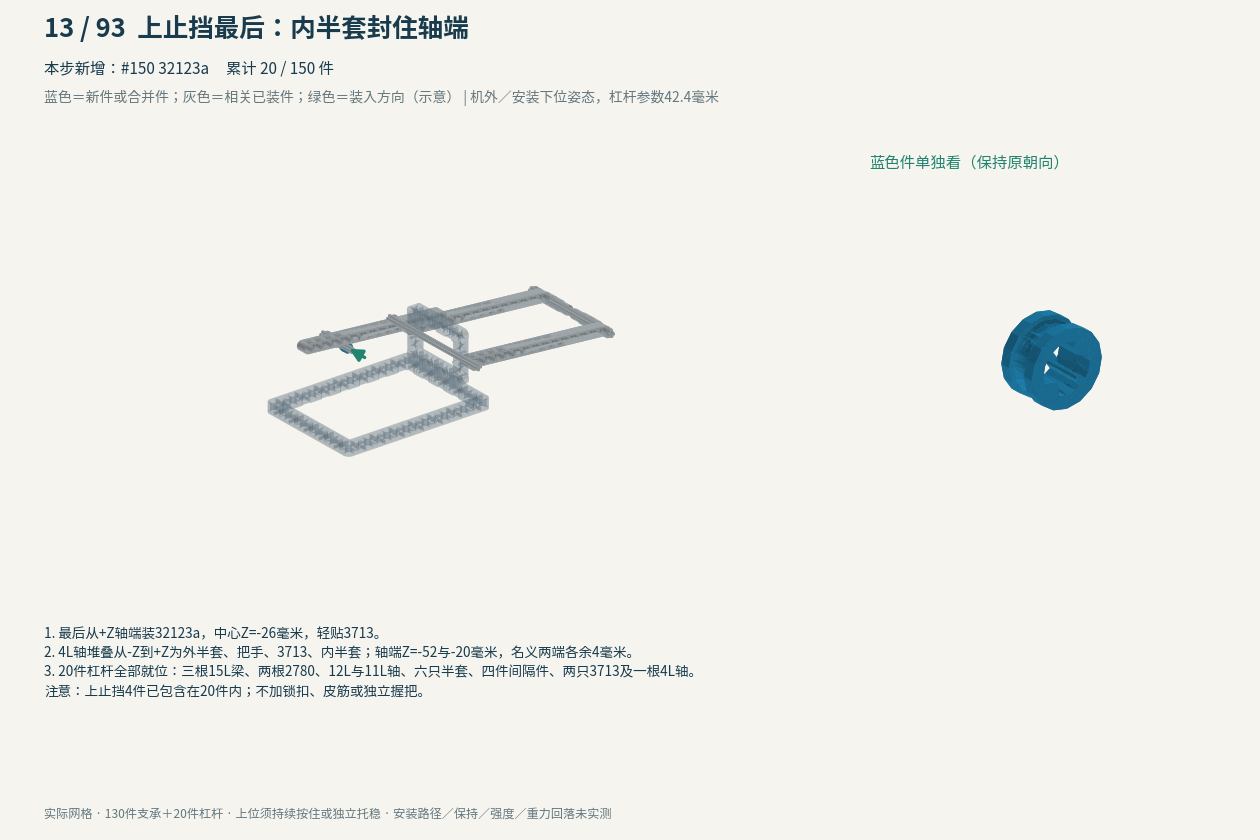
[picture p110: page 414]

## 415 / 501 130件支承装配 130件支承从散件开始


## 416 / 501 130件支承装配 右脚：短连梁预插两销

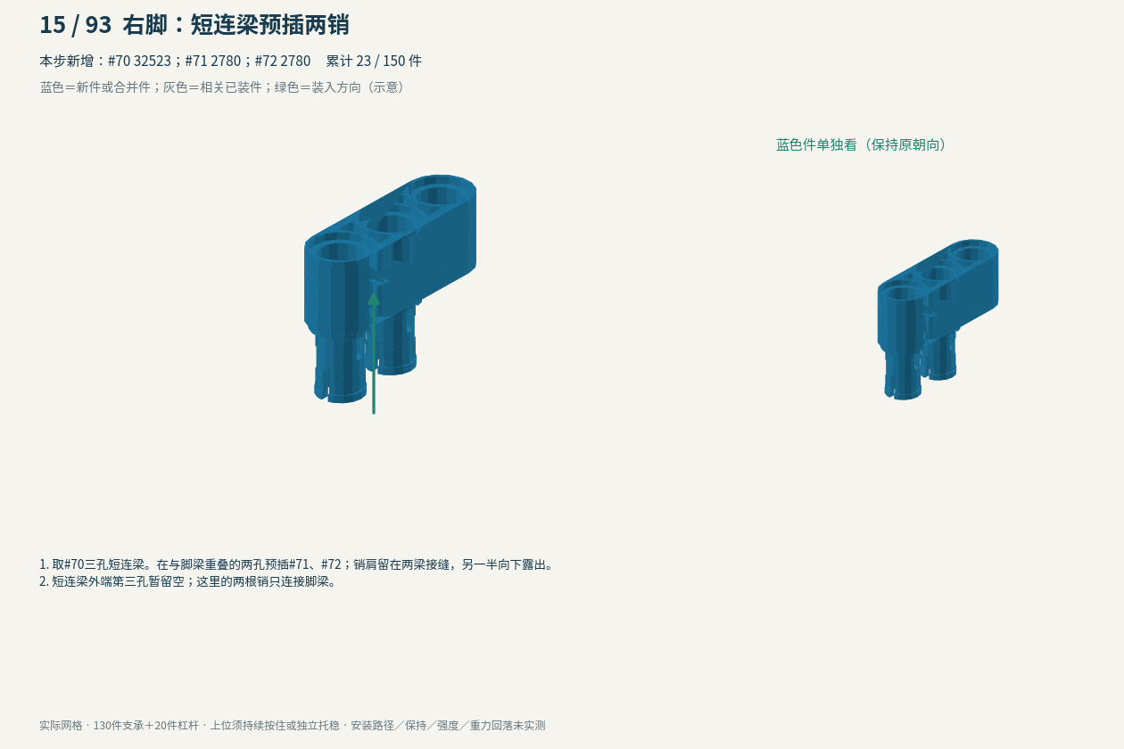
[picture p111: page 416]

## 417 / 501 130件支承装配 右脚：脚梁同轴合拢

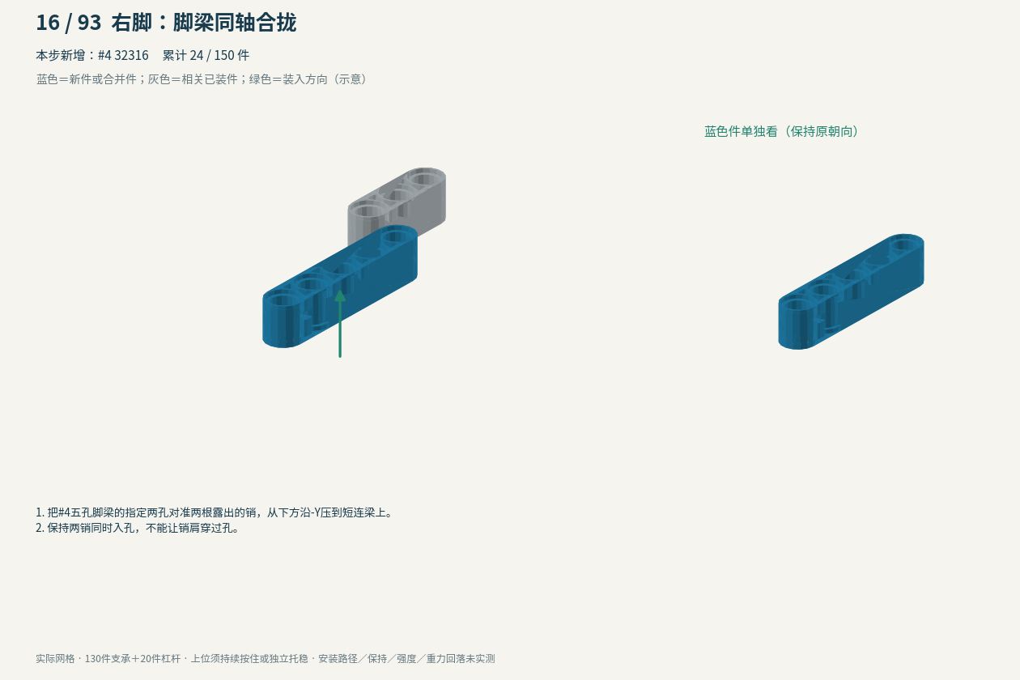
[picture p112: page 417]

## 418 / 501 130件支承装配 右脚：预插基座外接销

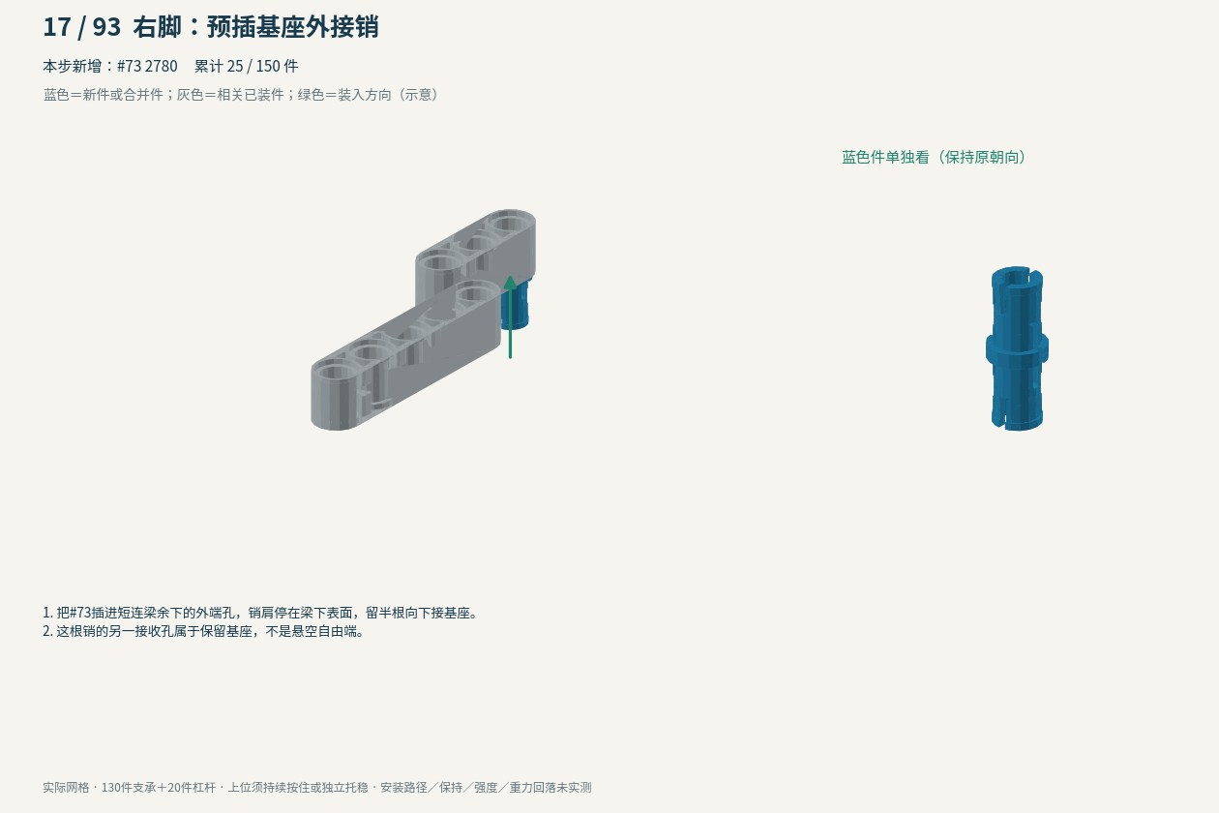
[picture p113: page 418]

## 419 / 501 130件支承装配 左脚：短连梁预插两销

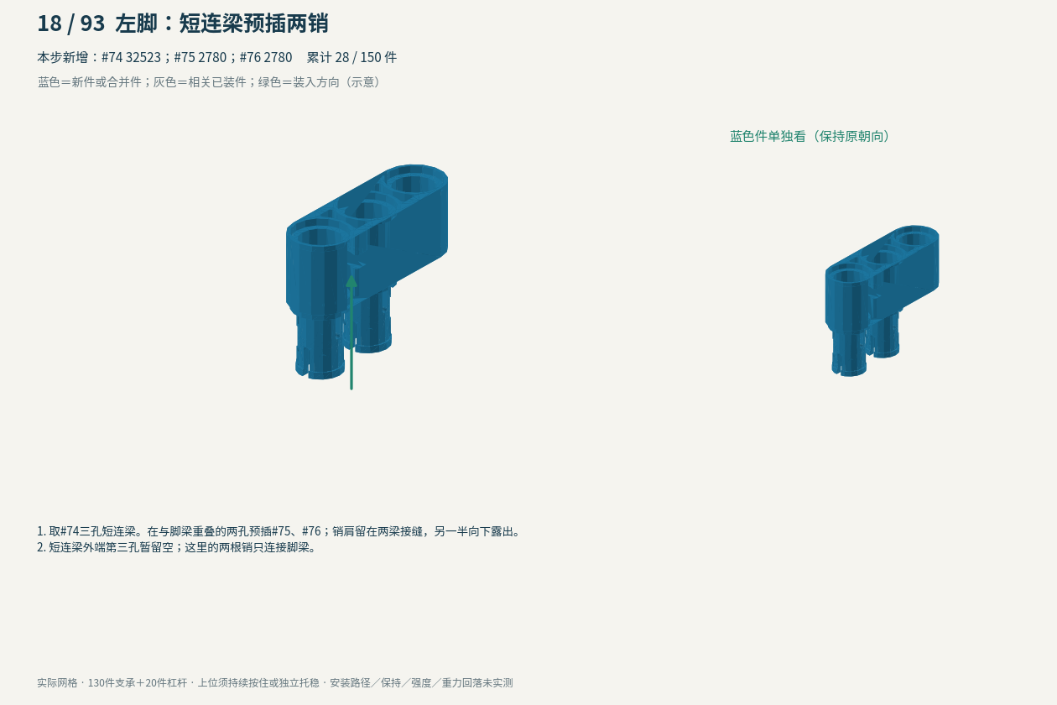
[picture p114: page 419]

## 420 / 501 130件支承装配 左脚：脚梁同轴合拢

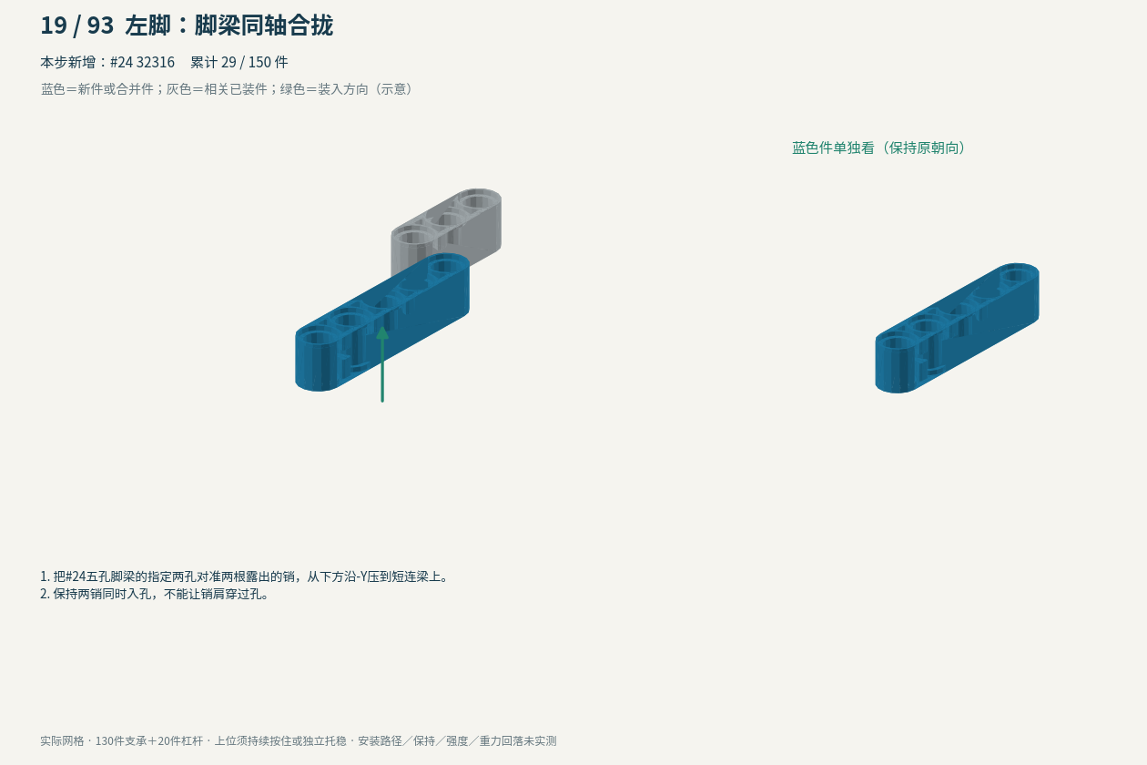
[picture p115: page 420]

## 421 / 501 130件支承装配 左脚：预插基座外接销

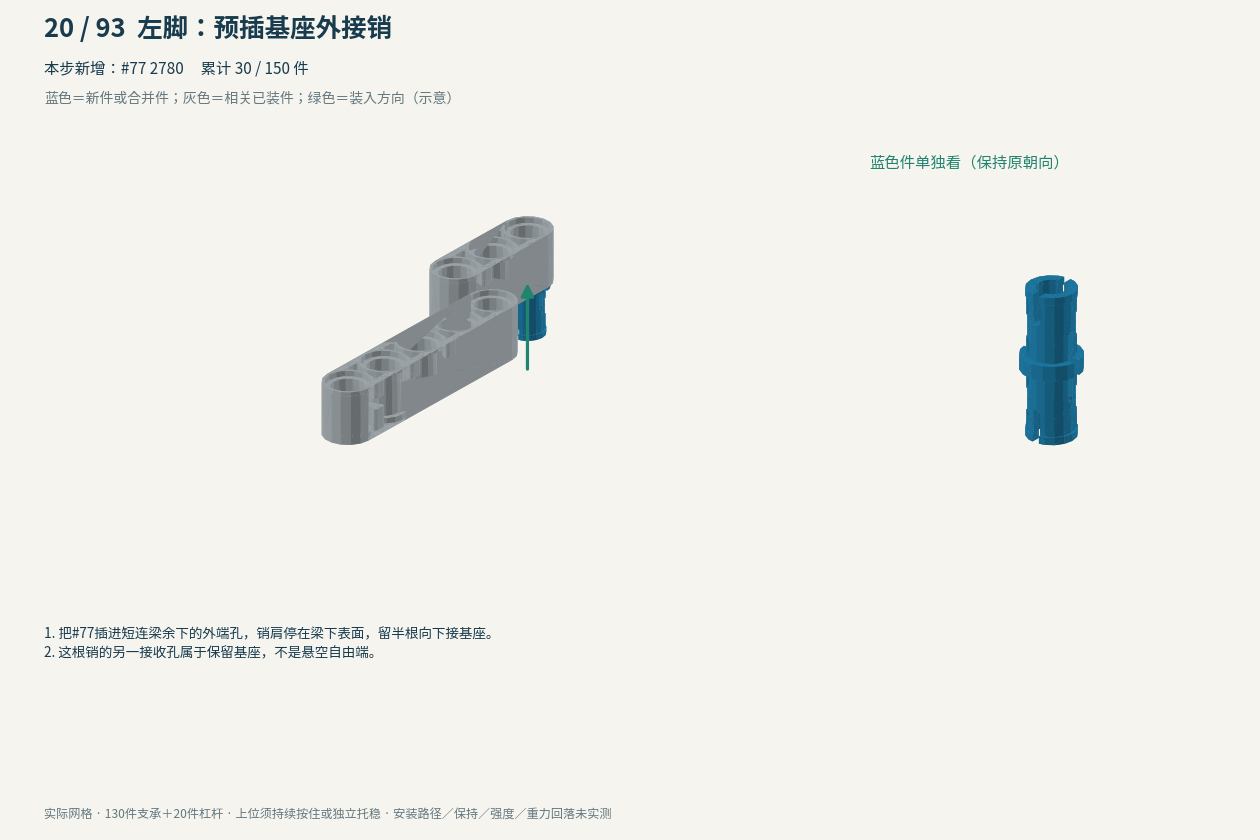
[picture p116: page 421]

## 422 / 501 130件支承装配 右脚：向下接入保留基座

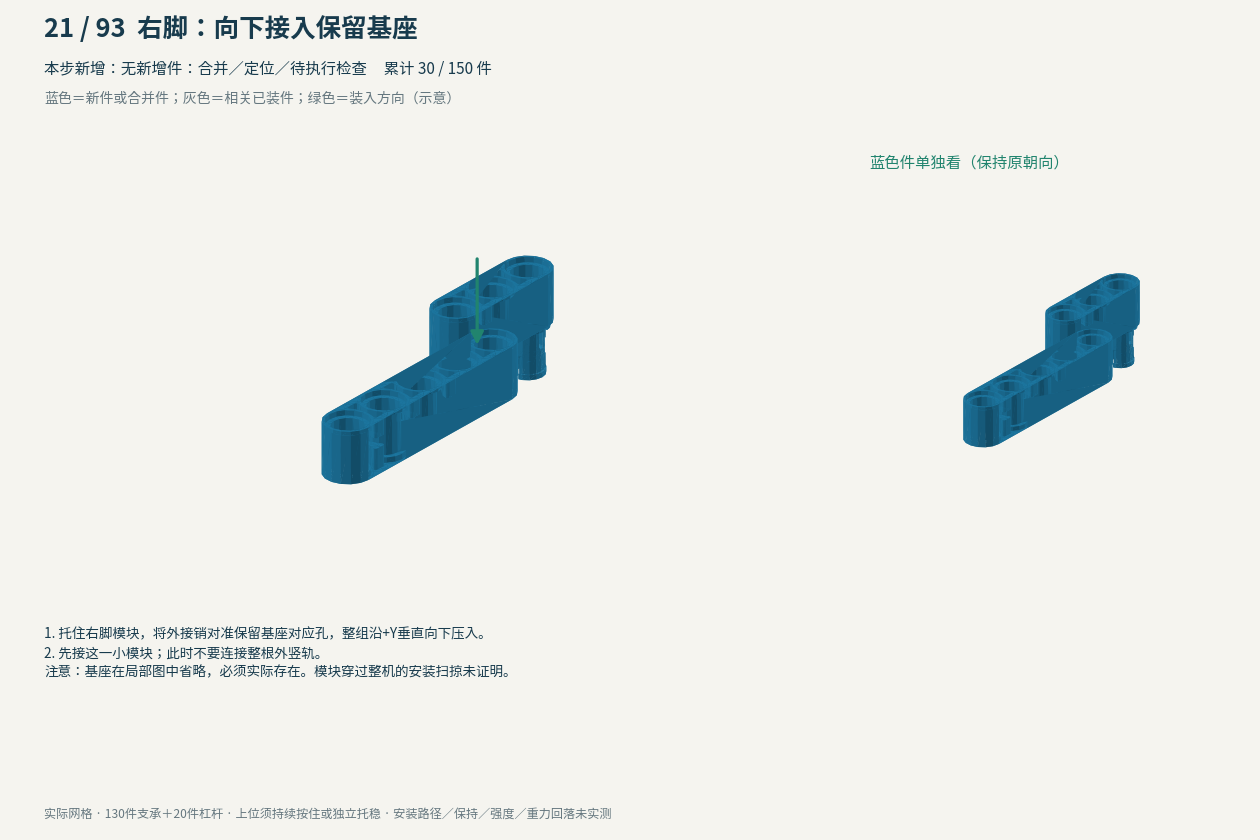
[picture p117: page 422]

## 423 / 501 130件支承装配 右墙：单独装墙连接件


## 424 / 501 130件支承装配 右脚：向下接脚连接件

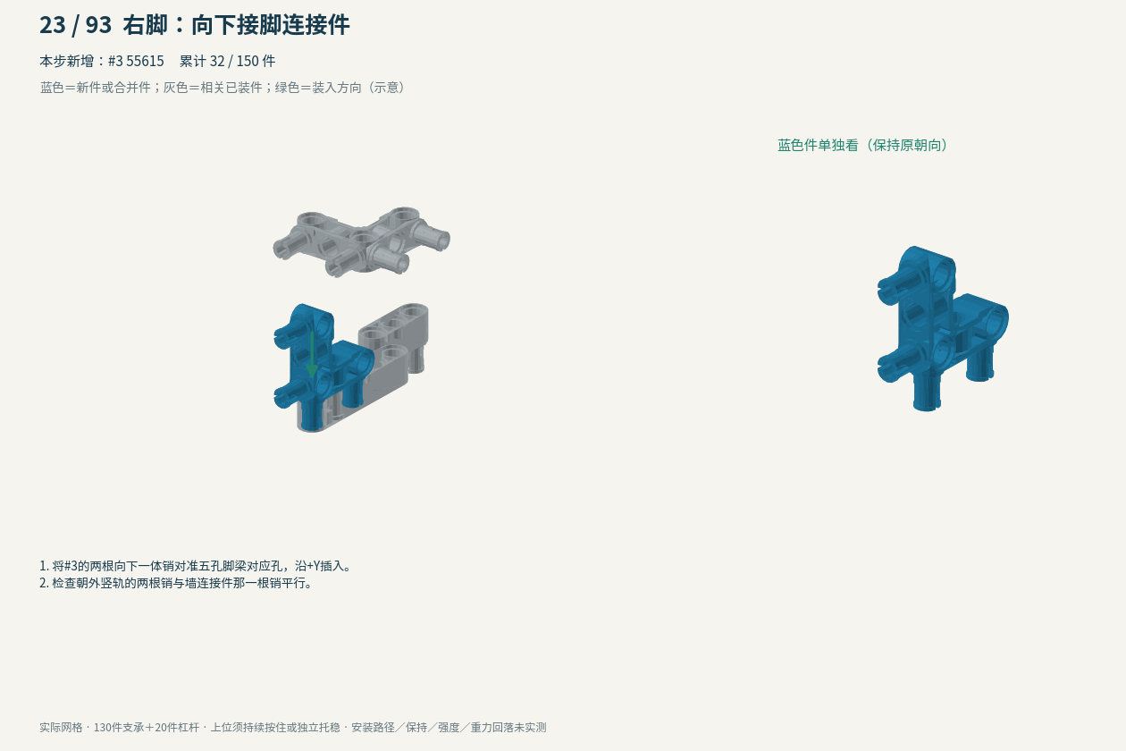
[picture p118: page 424]

## 425 / 501 130件支承装配 右框：外竖轨同时接三销

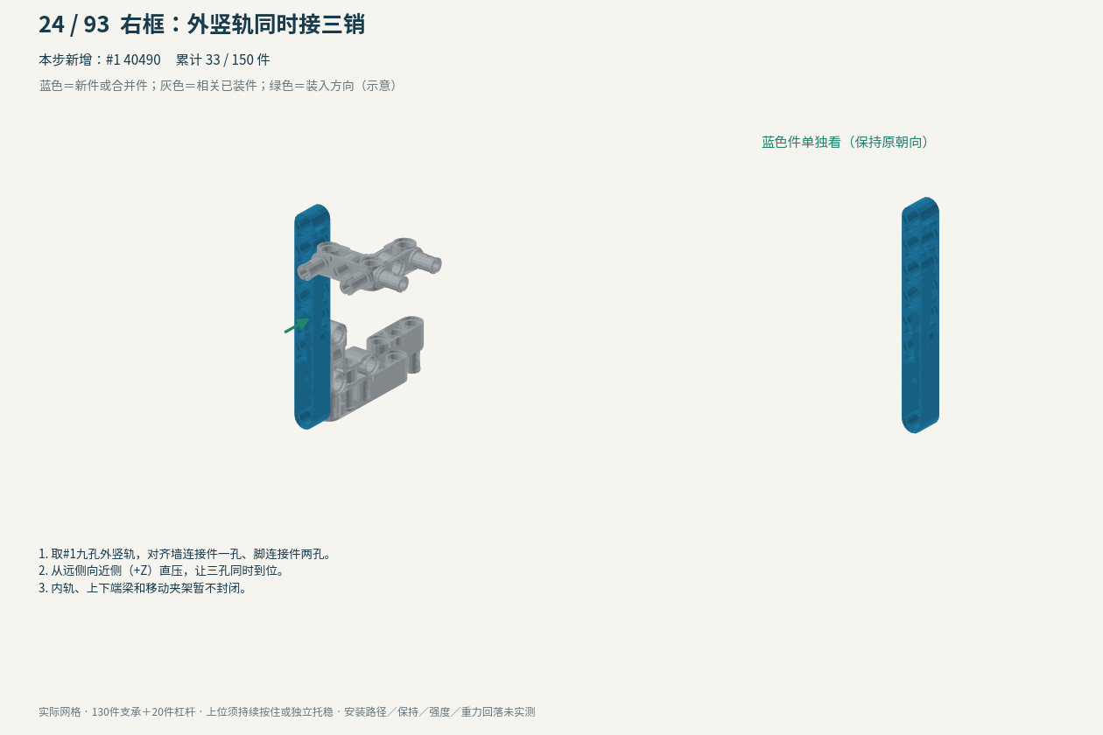
[picture p119: page 425]

## 426 / 501 130件支承装配 左脚：向下接入保留基座

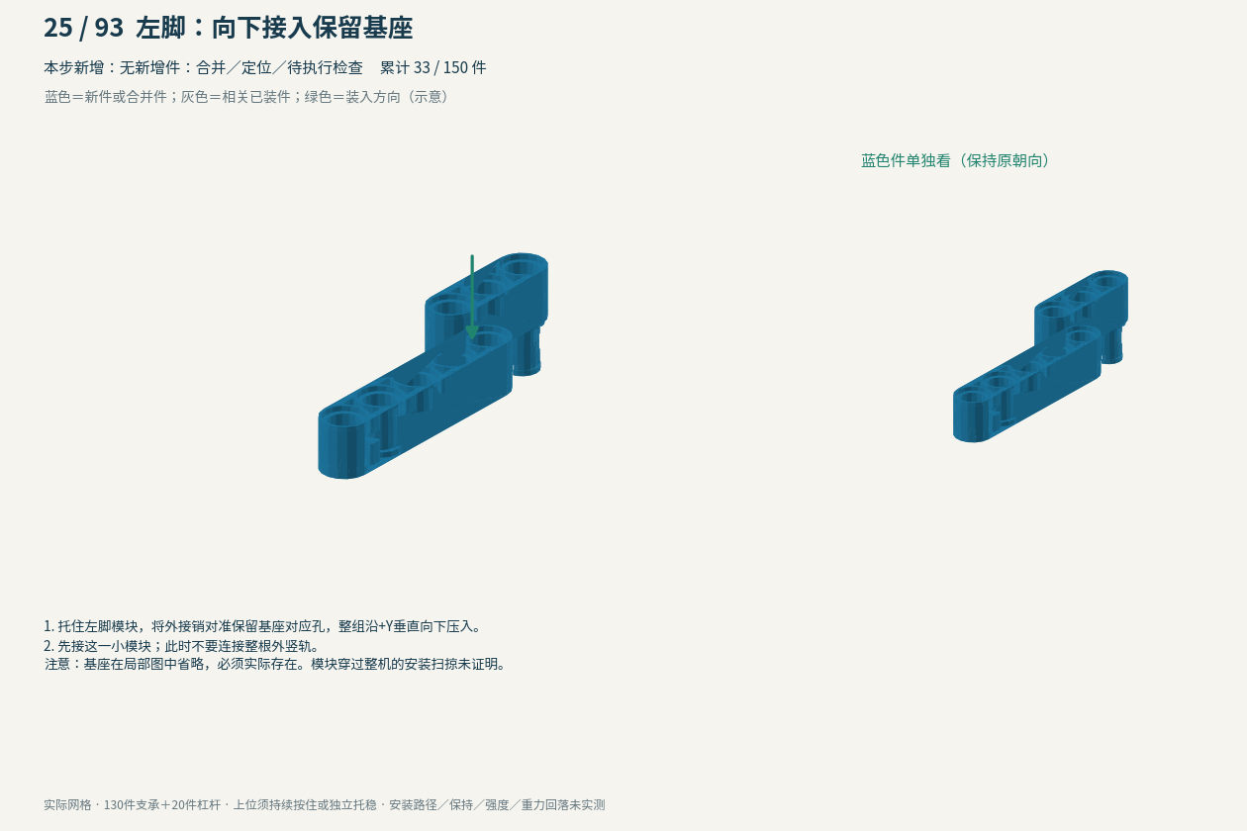
[picture p120: page 426]

## 427 / 501 130件支承装配 左墙：单独装墙连接件

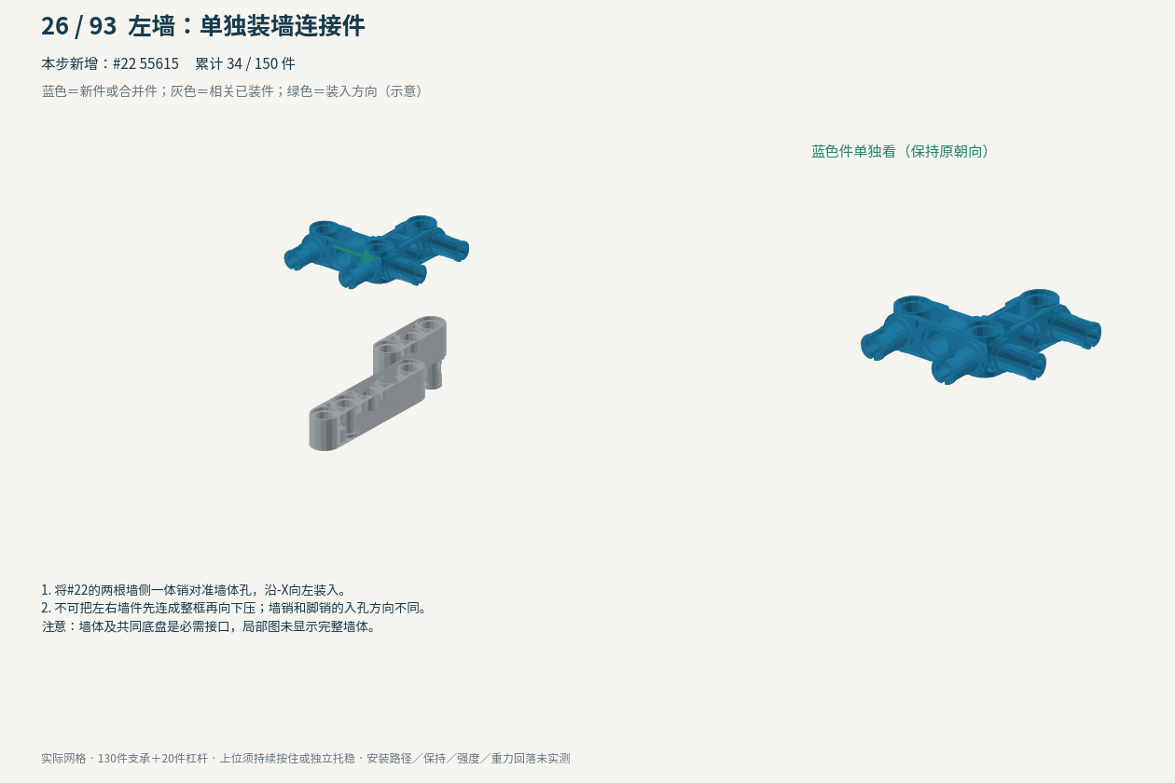
[picture p121: page 427]

## 428 / 501 130件支承装配 左脚：向下接脚连接件

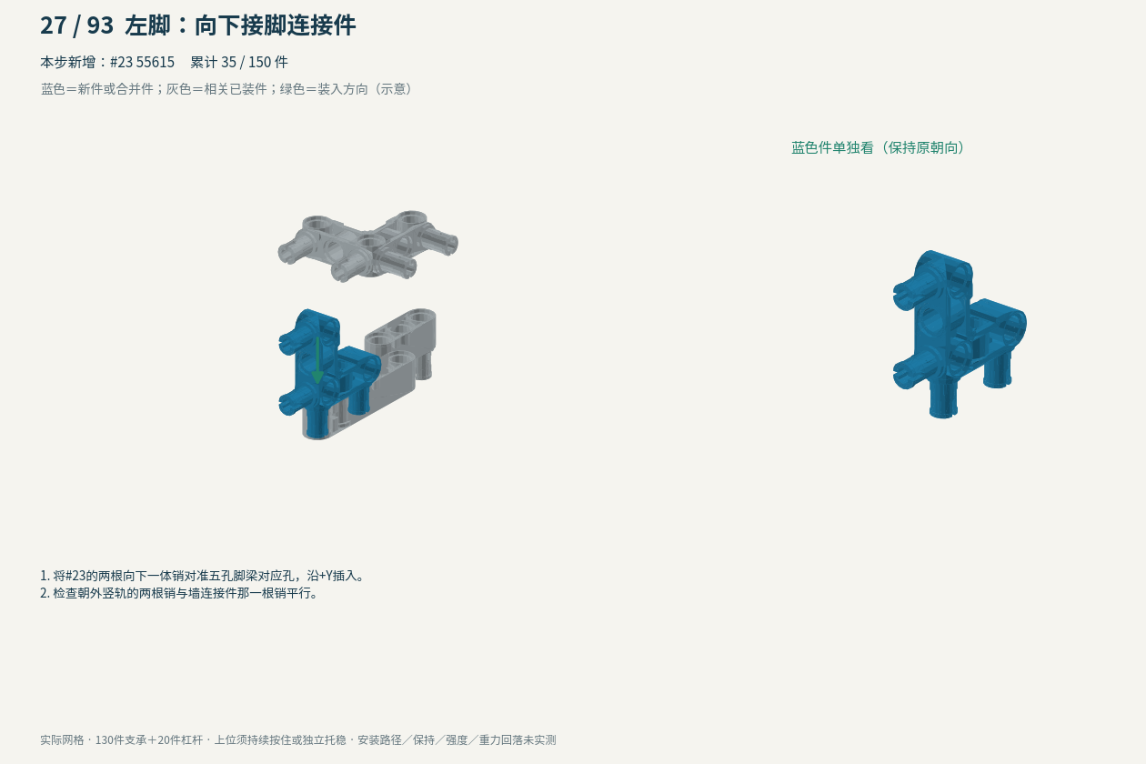
[picture p122: page 428]

## 429 / 501 130件支承装配 左框：外竖轨同时接三销

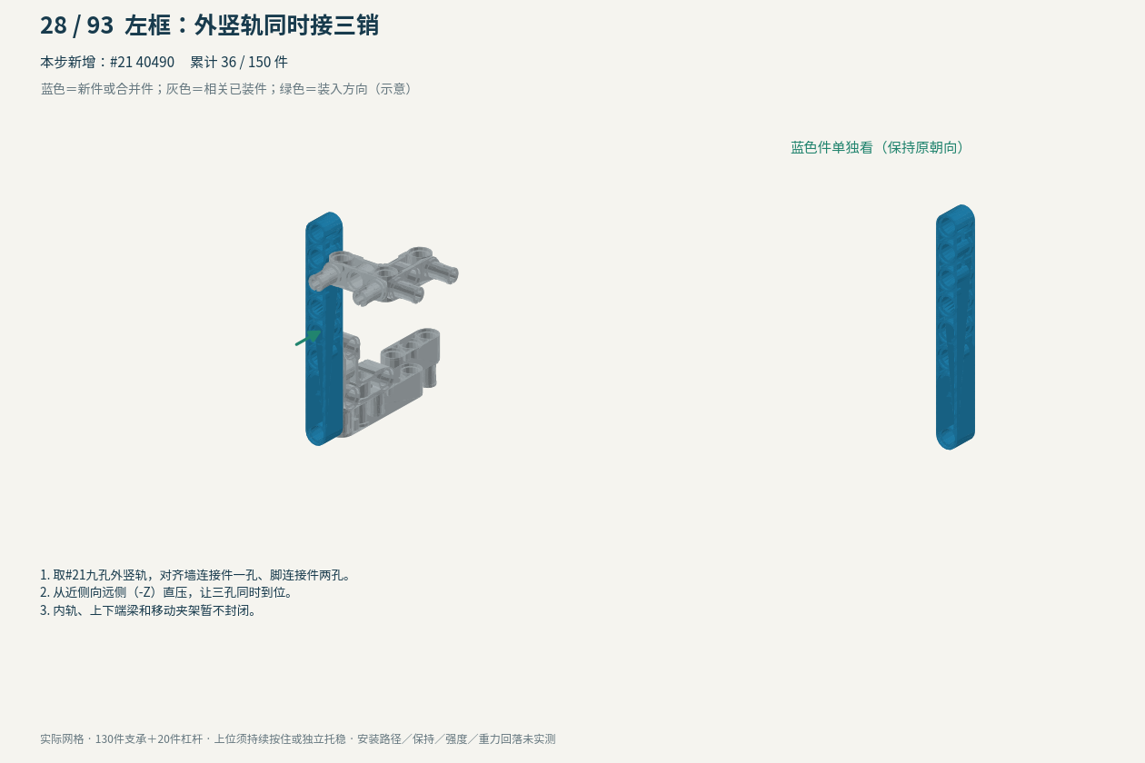
[picture p123: page 429]

## 430 / 501 130件支承装配 右半桥：原生L腹板预插三销


## 431 / 501 130件支承装配 右半桥：装上下两条长梁

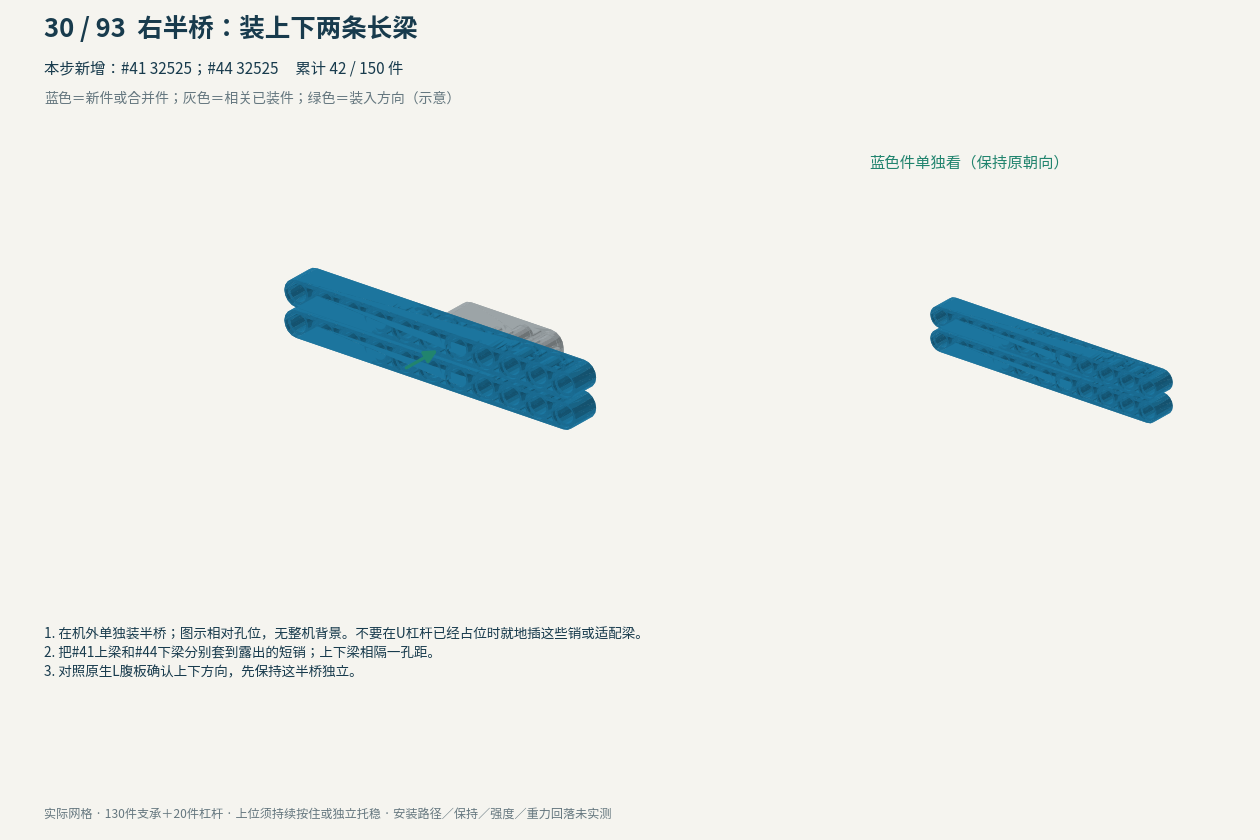
[picture p124: page 431]

## 432 / 501 130件支承装配 右桥端：8加8毫米普通销

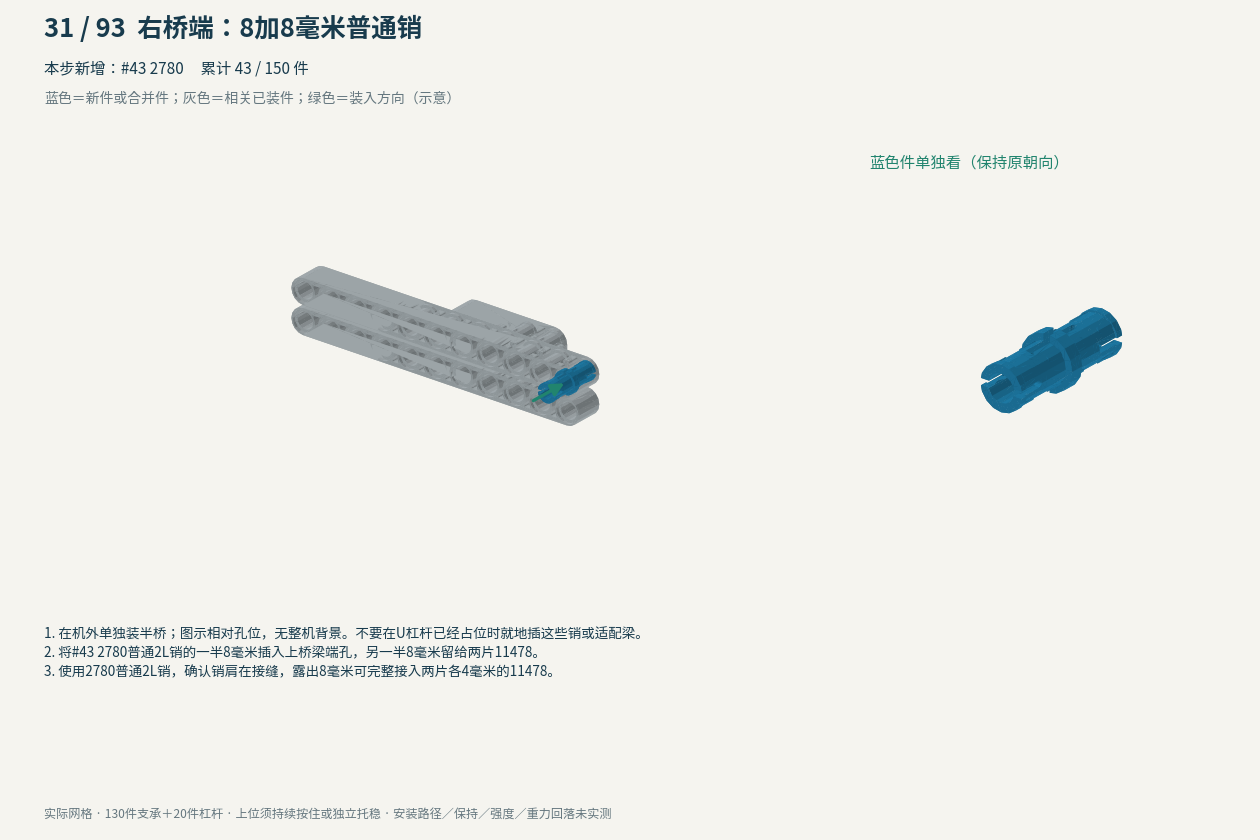
[picture p125: page 432]

## 433 / 501 130件支承装配 右桥端：双片11478形成8毫米叠层

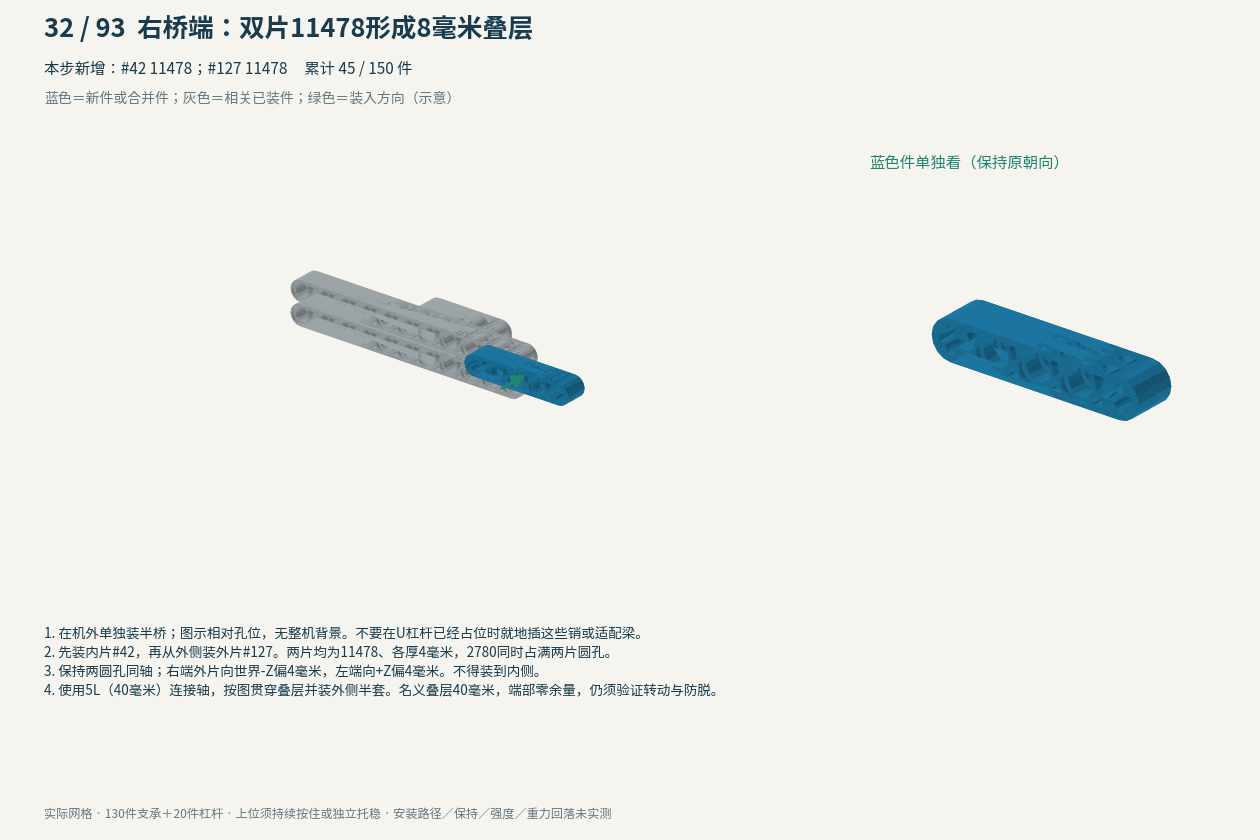
[picture p126: page 433]

## 434 / 501 130件支承装配 右桥端：下梁预插两根短销

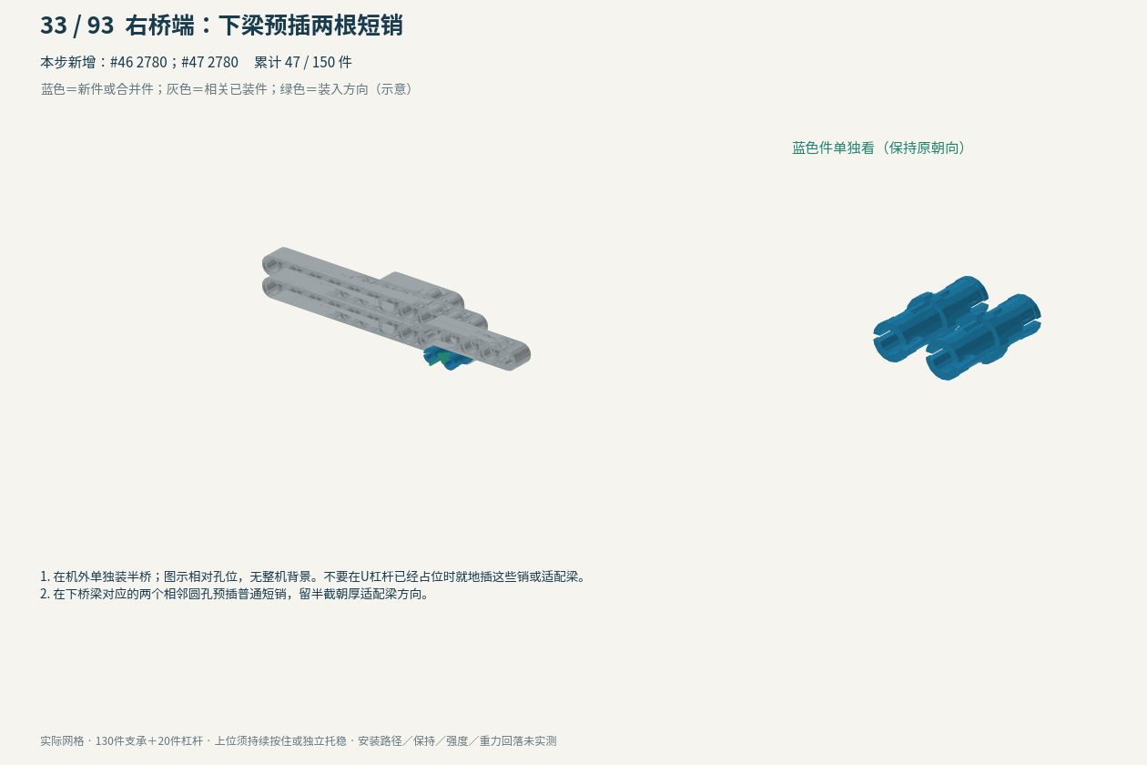
[picture p127: page 434]

## 435 / 501 130件支承装配 右桥端：接五孔厚适配梁

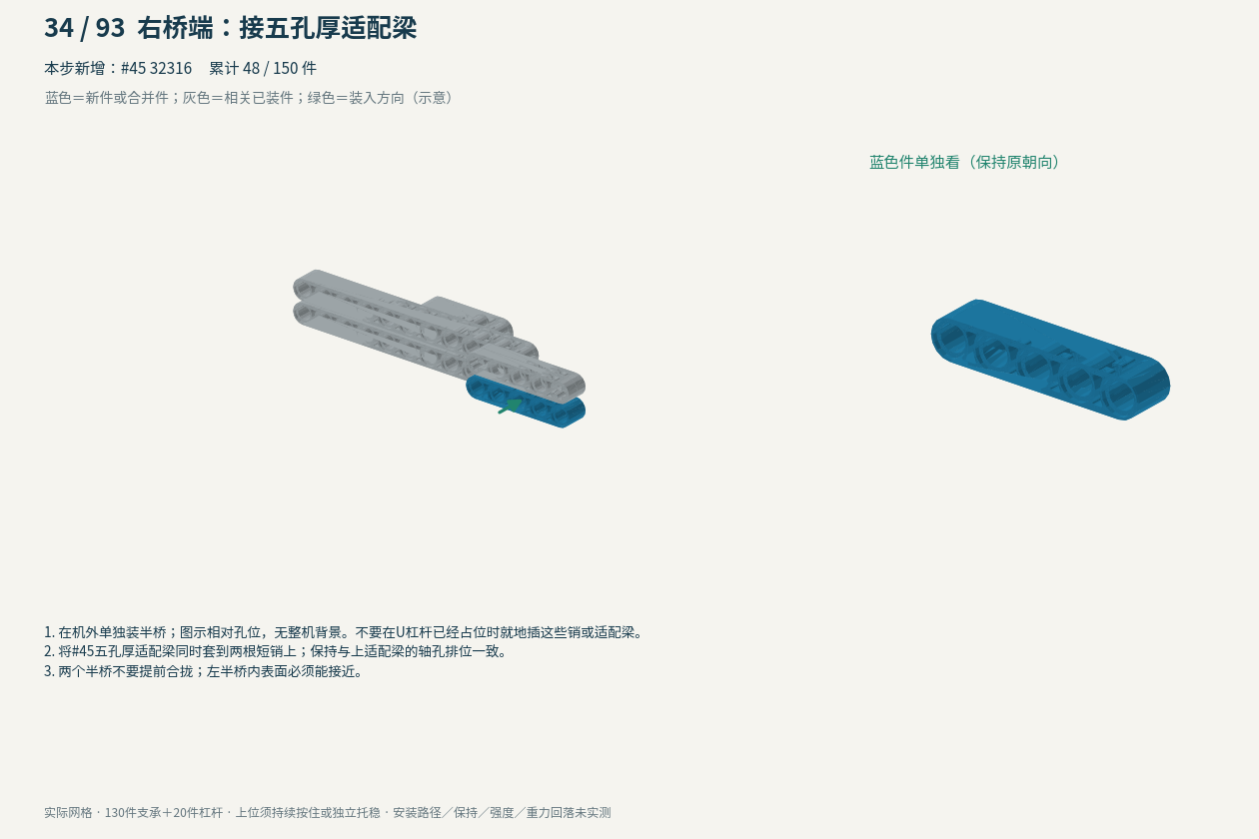
[picture p128: page 435]

## 436 / 501 130件支承装配 左半桥：原生L腹板预插三销

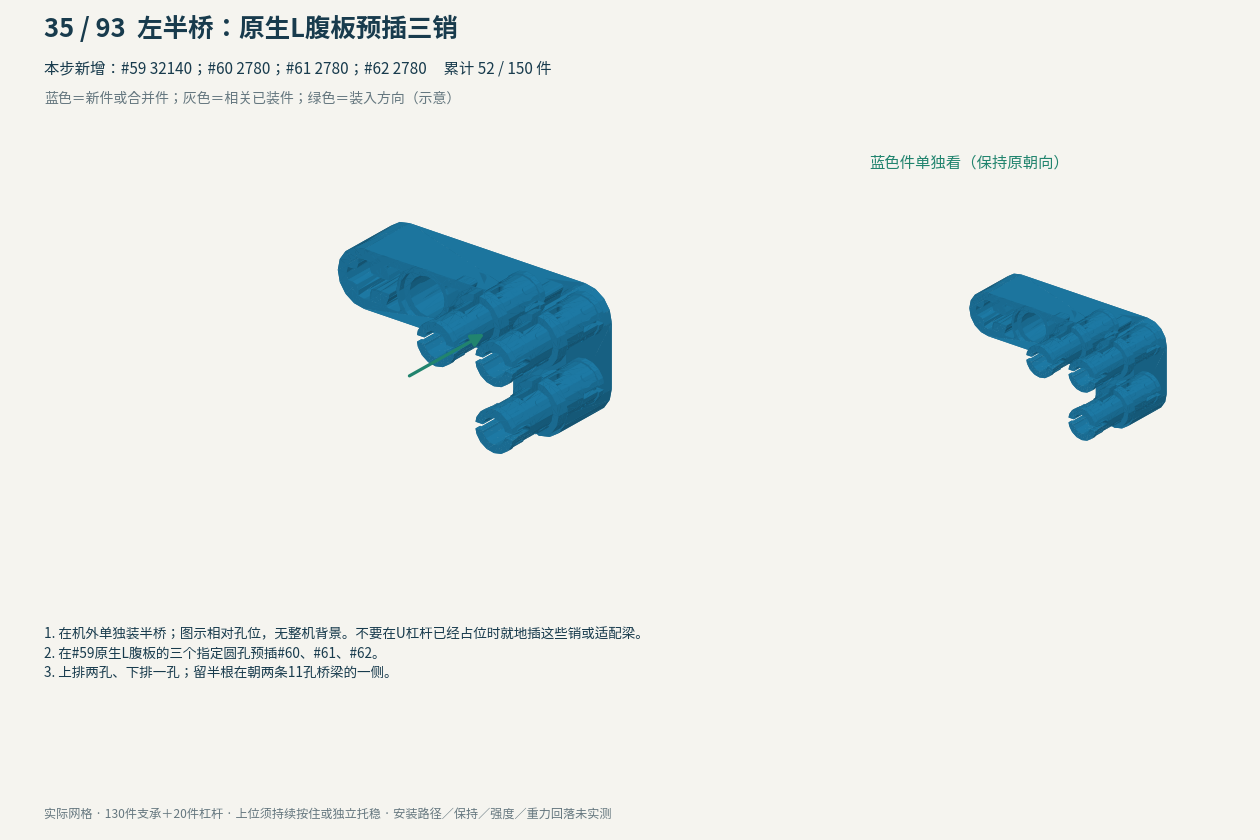
[picture p129: page 436]

## 437 / 501 130件支承装配 左半桥：装上下两条长梁

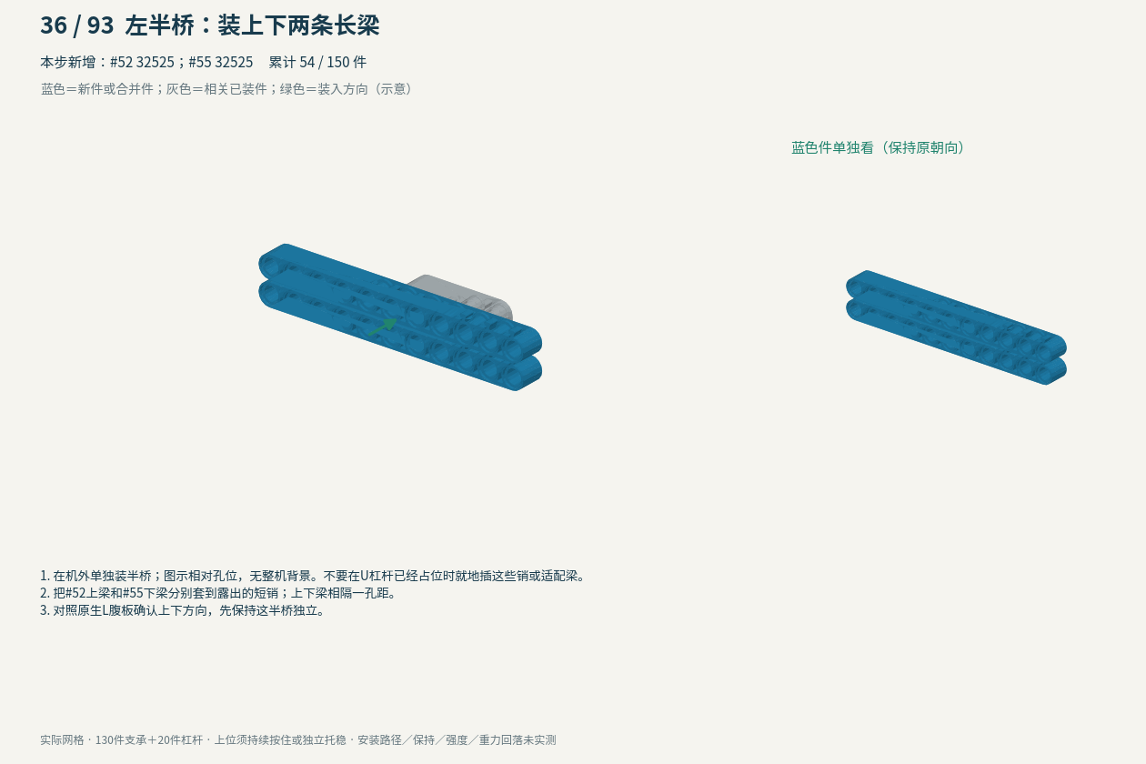
[picture p130: page 437]

## 438 / 501 130件支承装配 左桥端：8加8毫米普通销

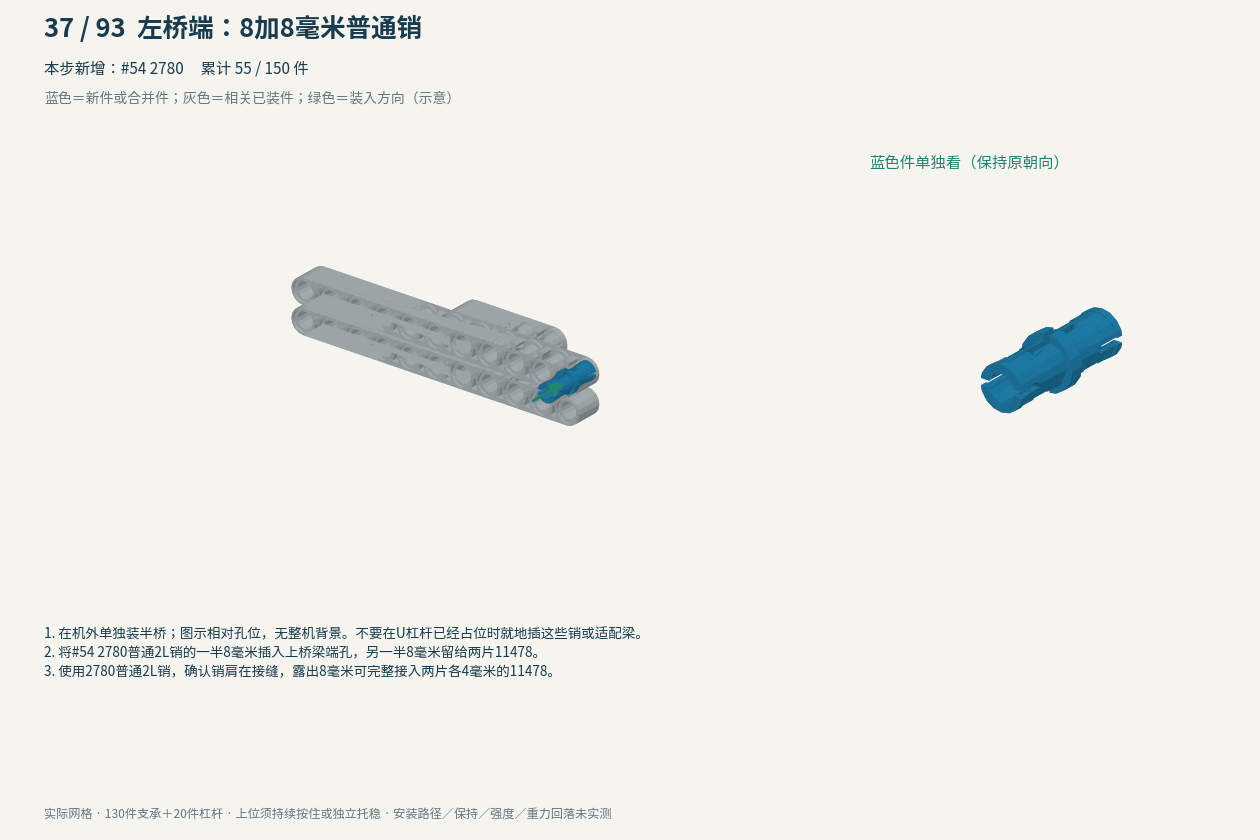
[picture p131: page 438]

## 439 / 501 130件支承装配 左桥端：双片11478形成8毫米叠层

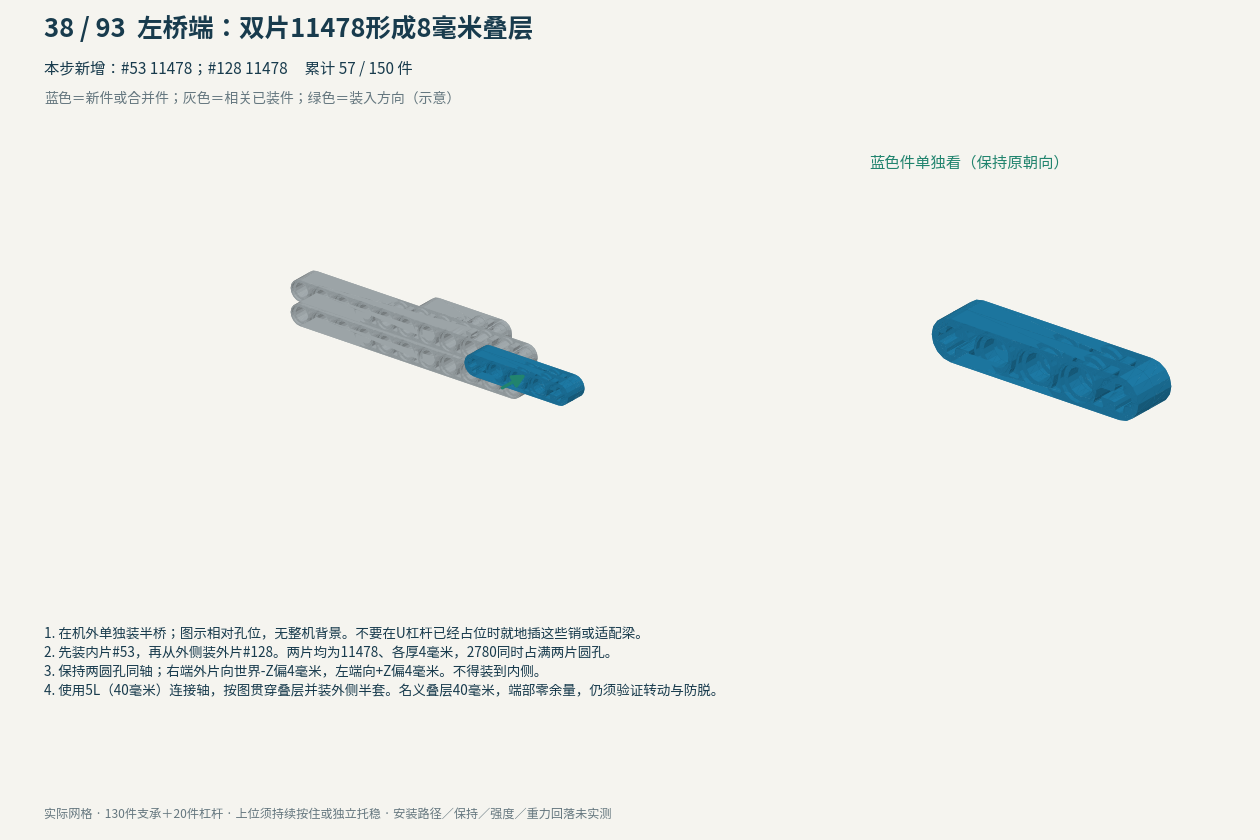
[picture p132: page 439]

## 440 / 501 130件支承装配 左桥端：下梁预插两根短销

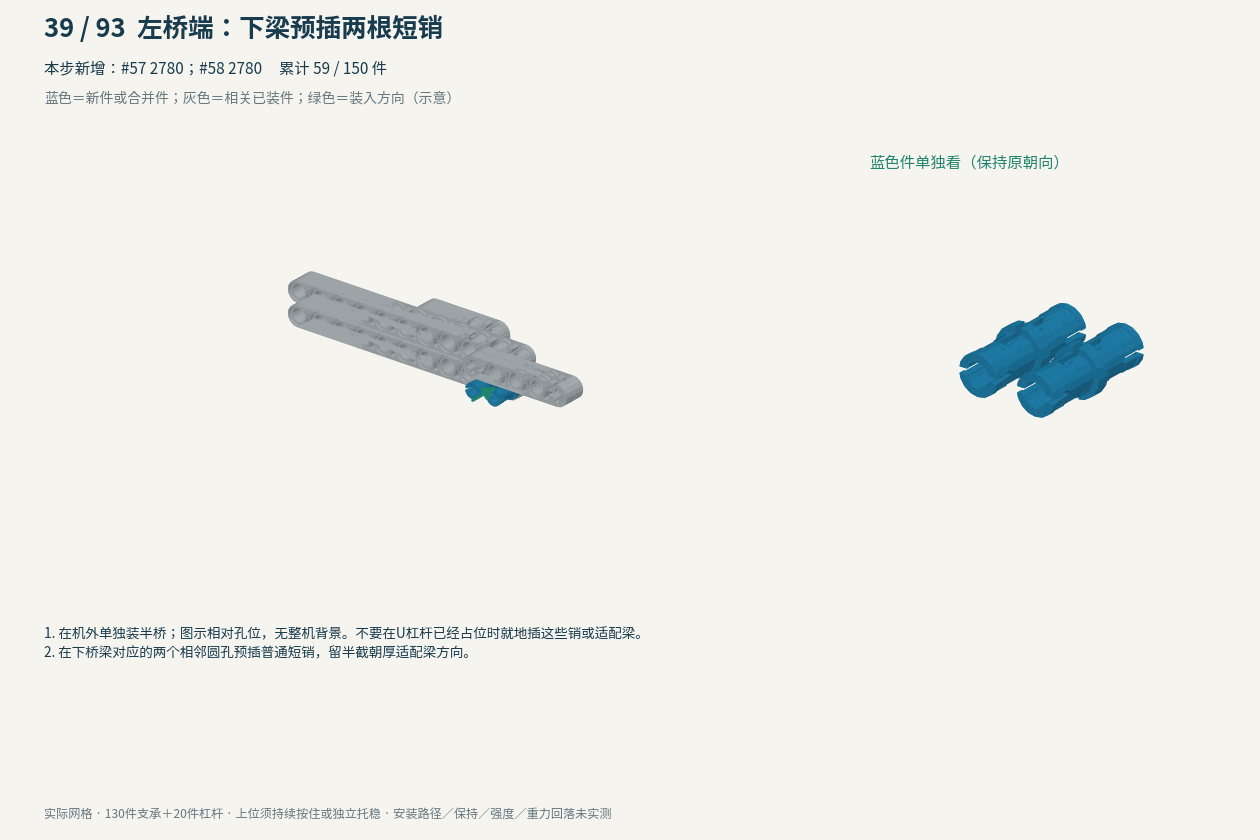
[picture p133: page 440]

## 441 / 501 130件支承装配 左桥端：接五孔厚适配梁

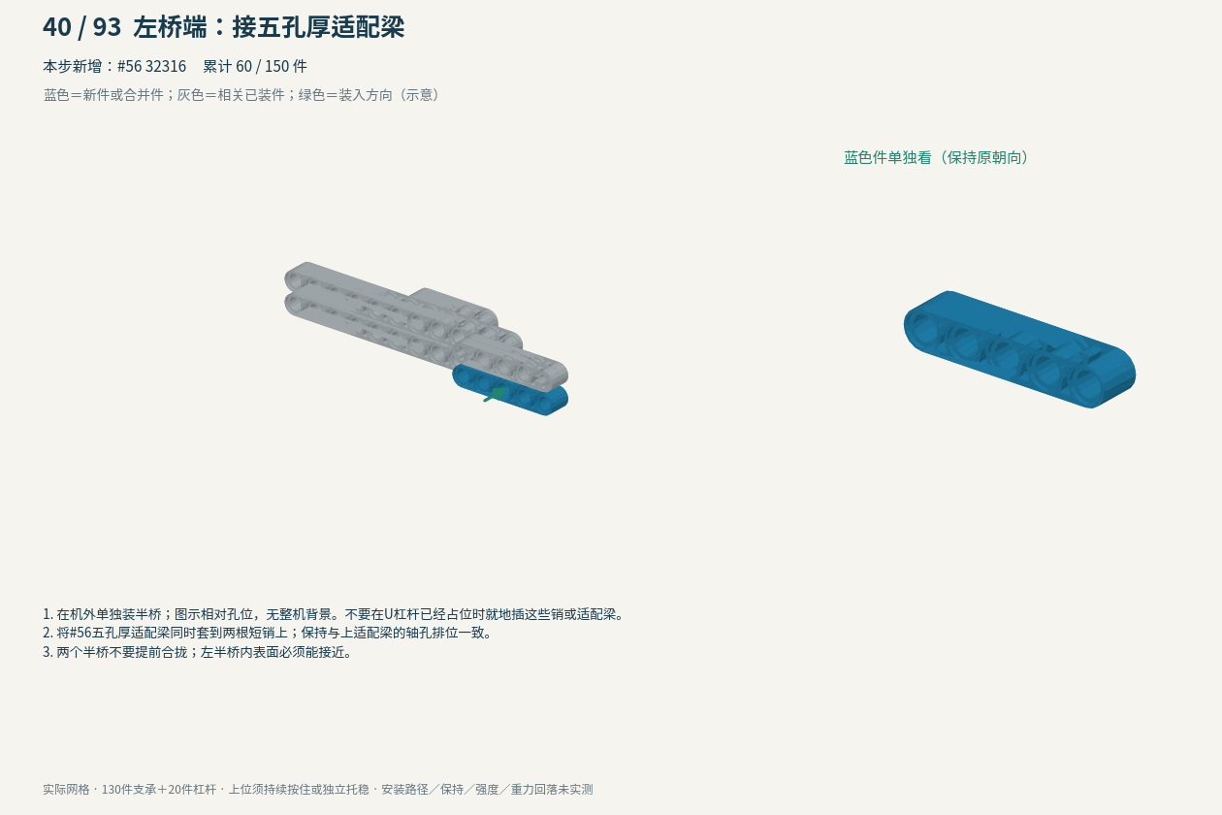
[picture p134: page 441]

## 442 / 501 130件支承装配 封桥前：5格轴先带内半套

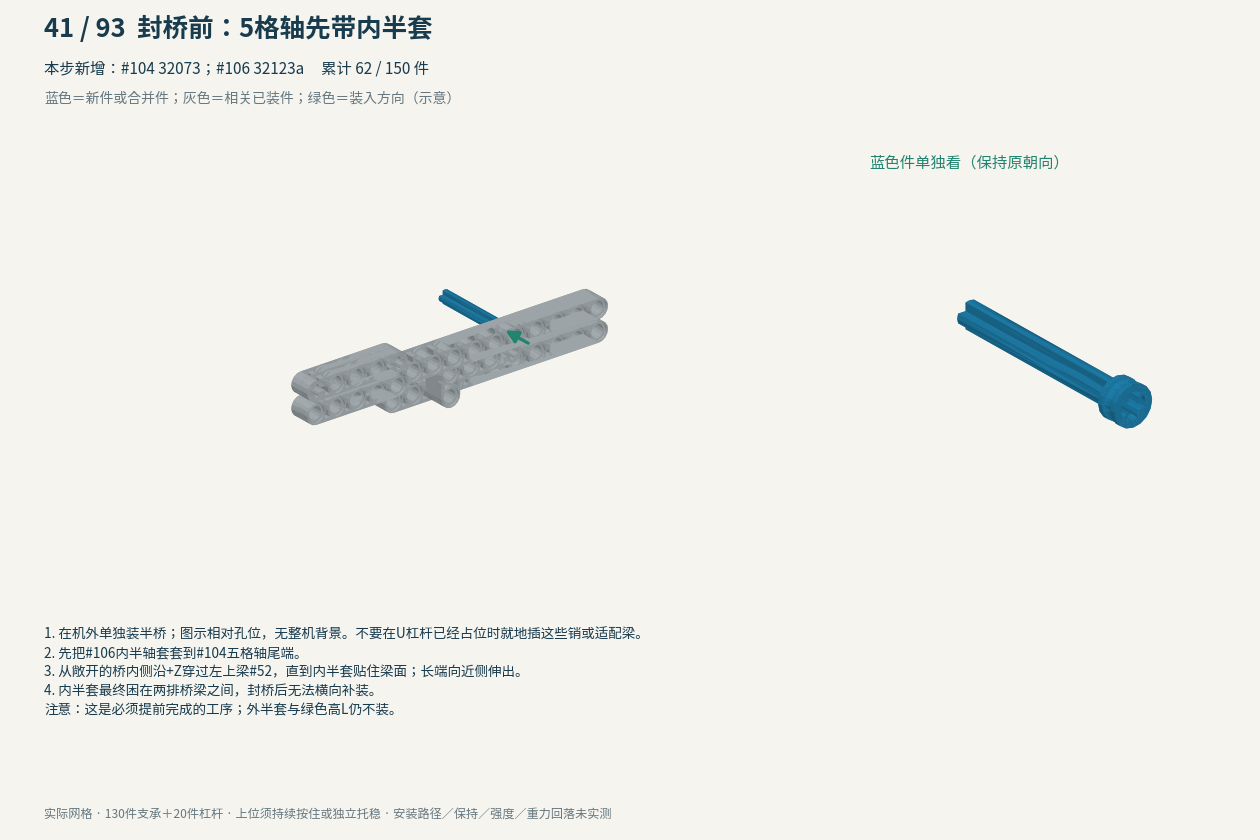
[picture p135: page 442]

## 443 / 501 130件支承装配 封桥前：6格轴先带内半套

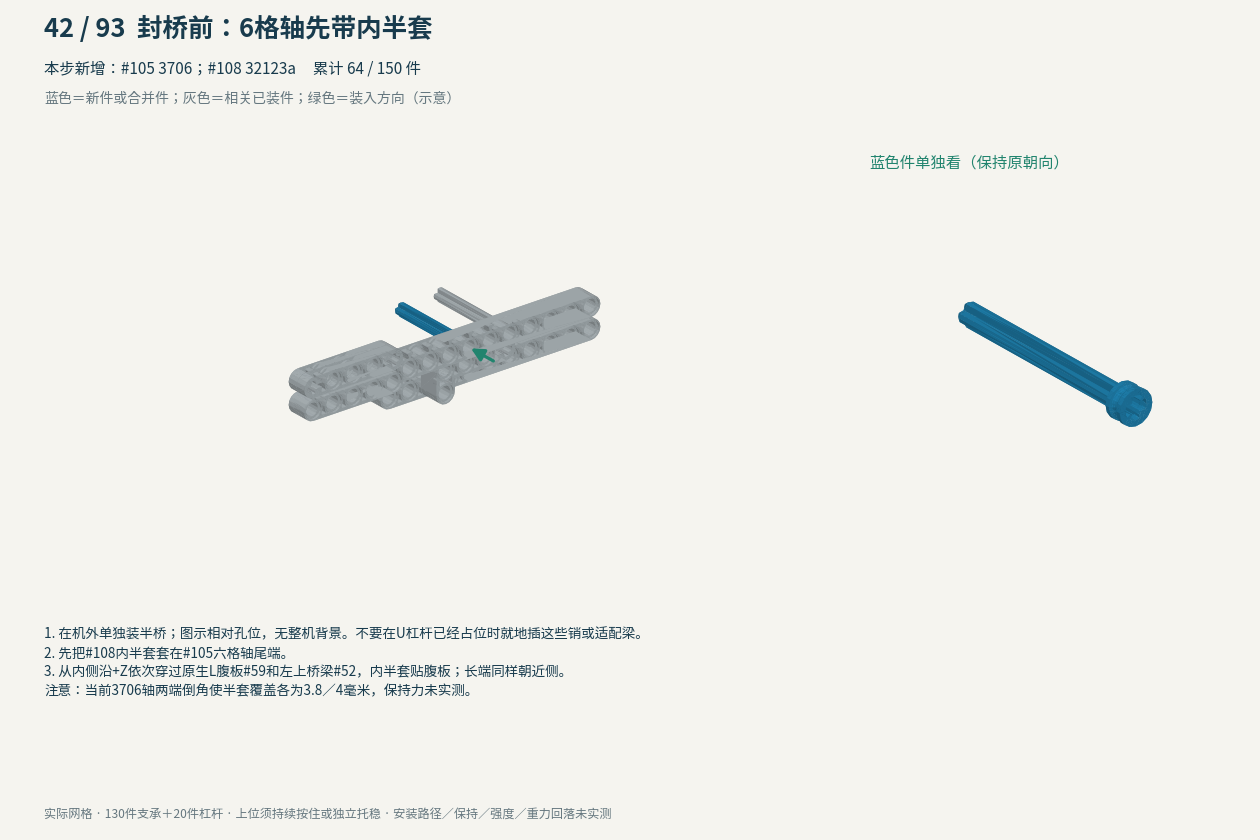
[picture p136: page 443]

## 444 / 501 130件支承装配 中央桥：先放中央短腹板

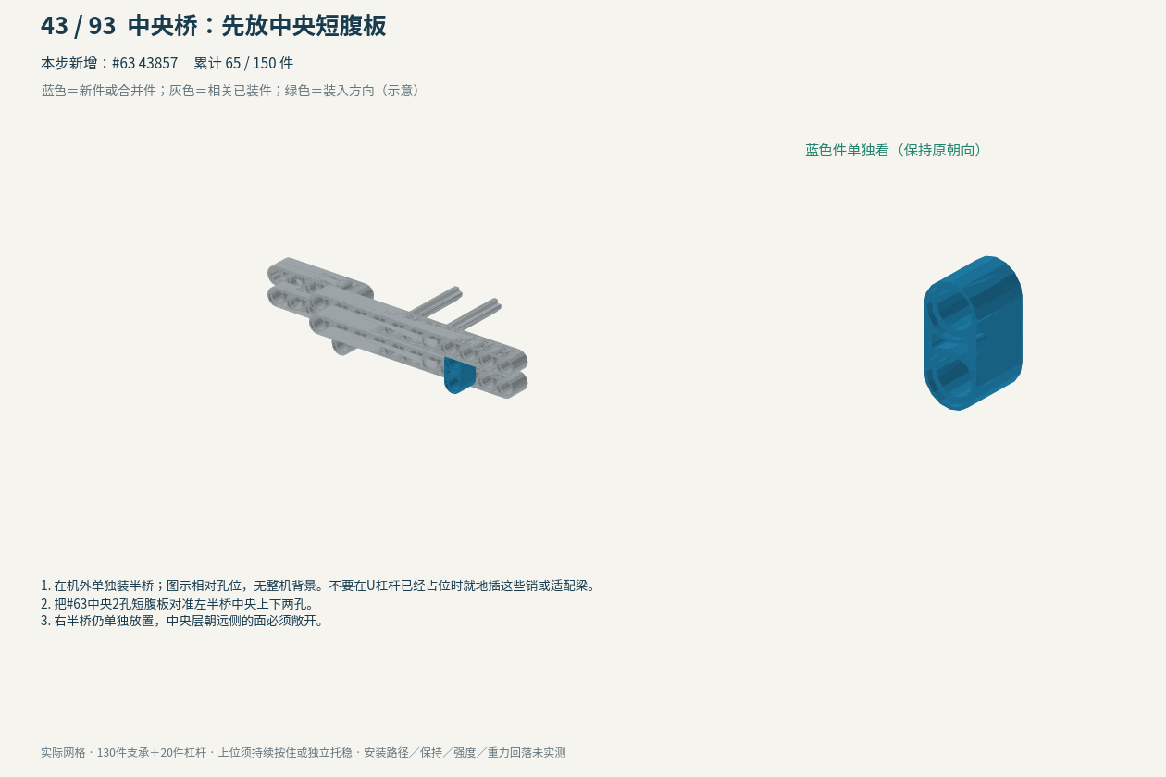
[picture p137: page 444]

## 445 / 501 130件支承装配 中央桥：两根长销穿腹板和左梁

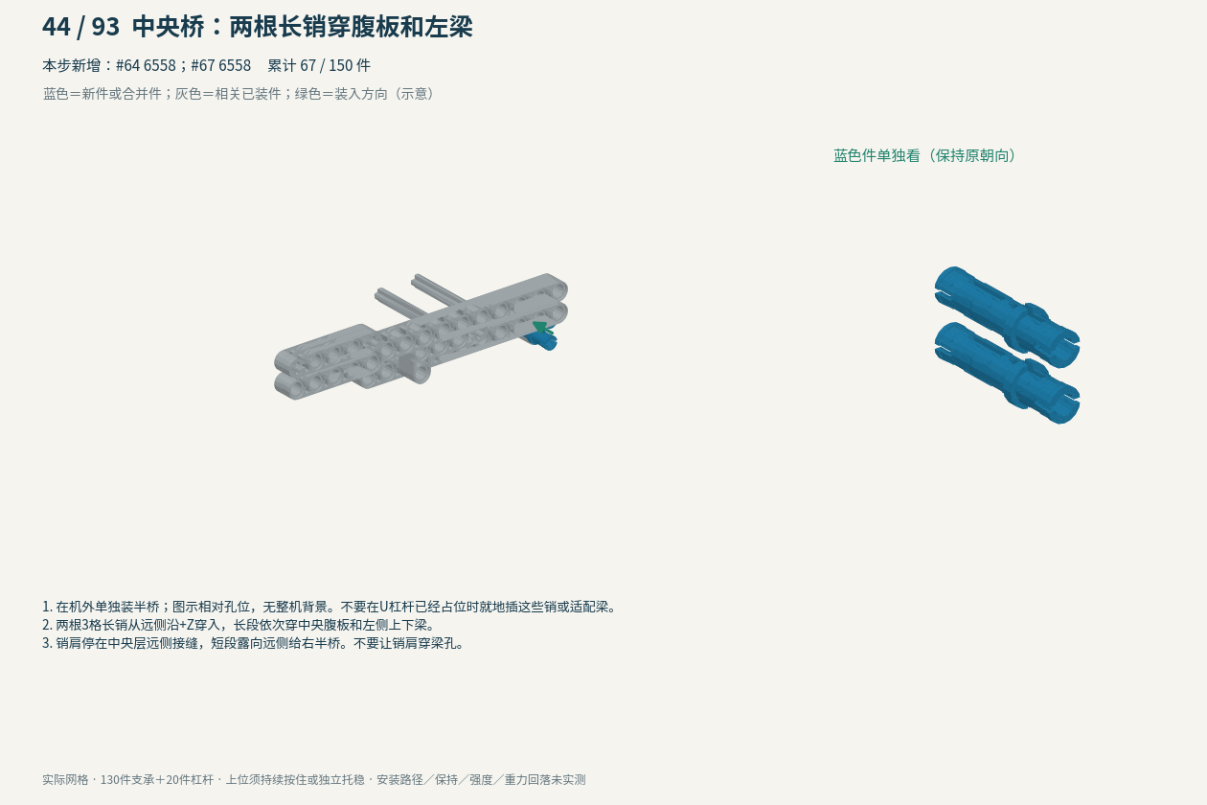
[picture p138: page 445]

## 446 / 501 130件支承装配 左中央列：装一件43857双孔连接件

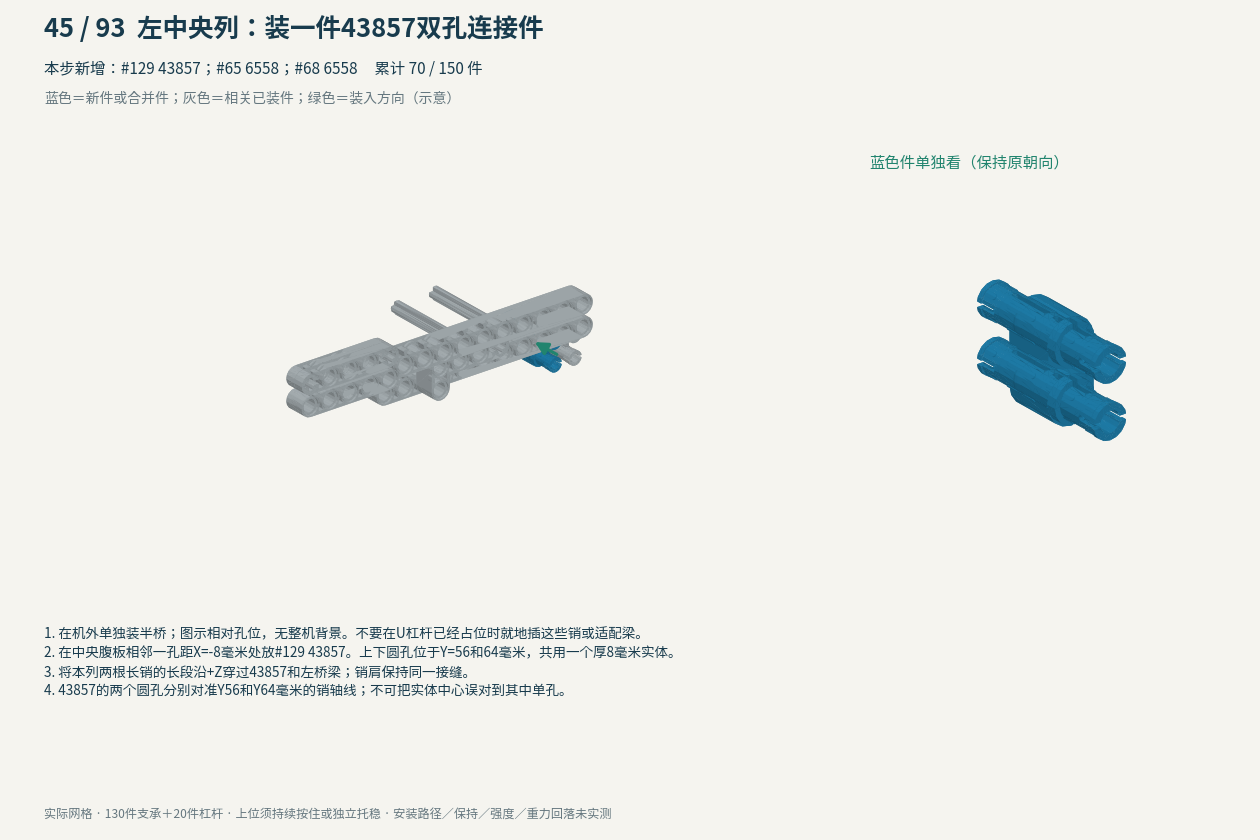
[picture p139: page 446]

## 447 / 501 130件支承装配 右中央列：装一件43857双孔连接件

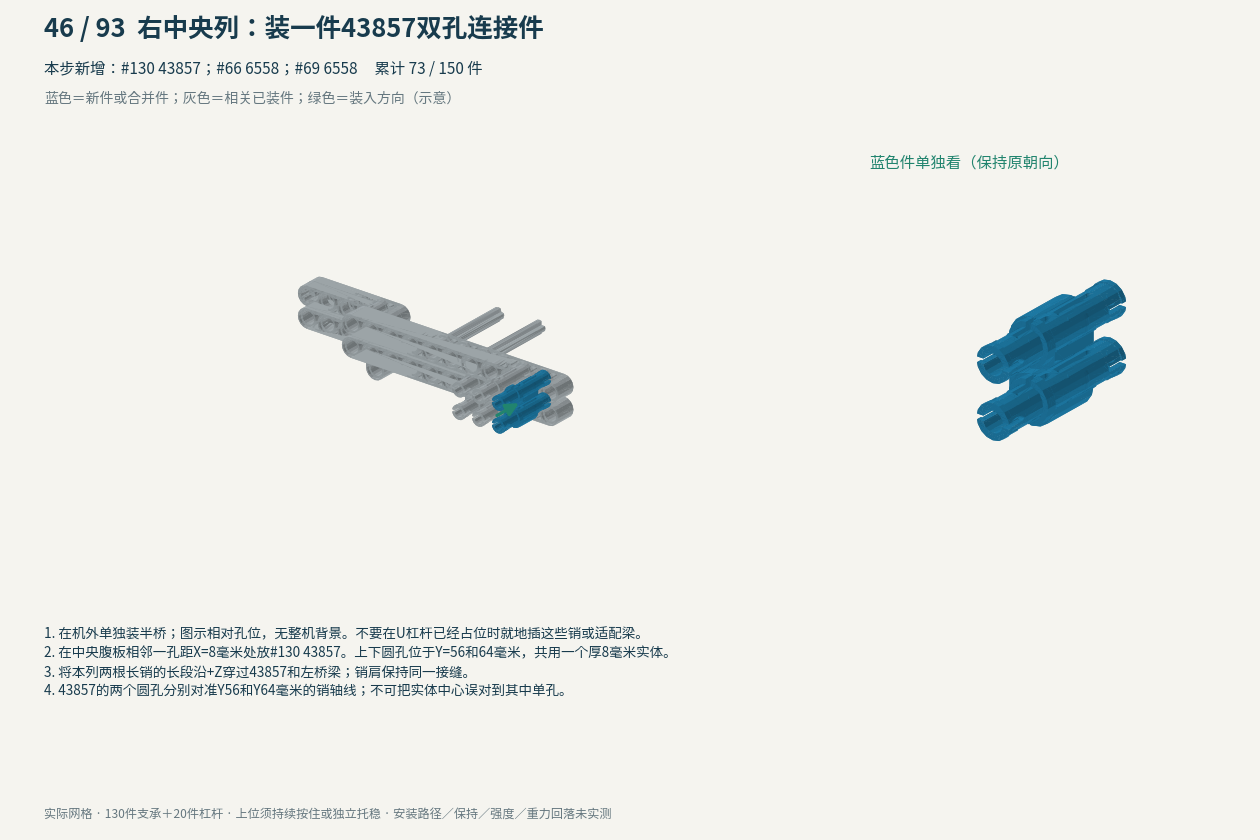
[picture p140: page 447]

## 448 / 501 130件支承装配 机外预插座柱根销：远侧四销

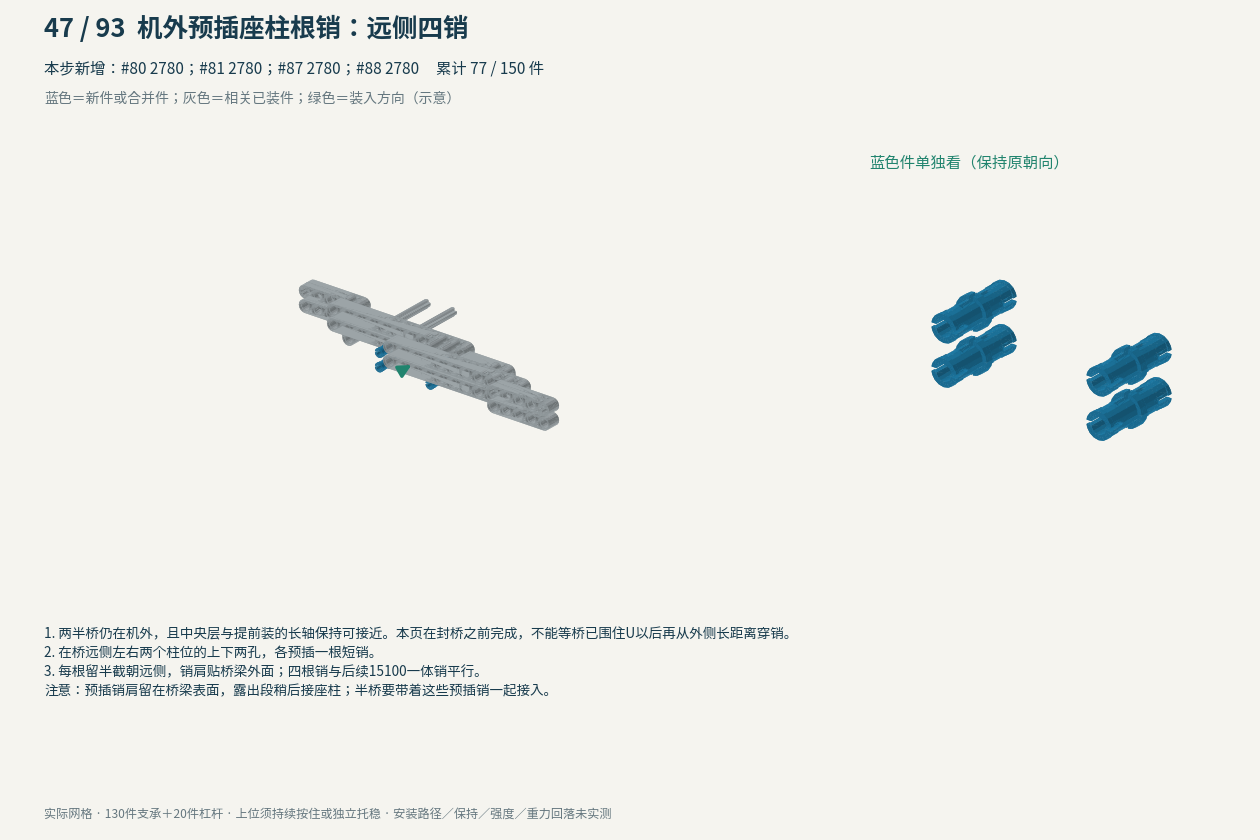
[picture p141: page 448]

## 449 / 501 130件支承装配 机外预插座柱根销：近右两销

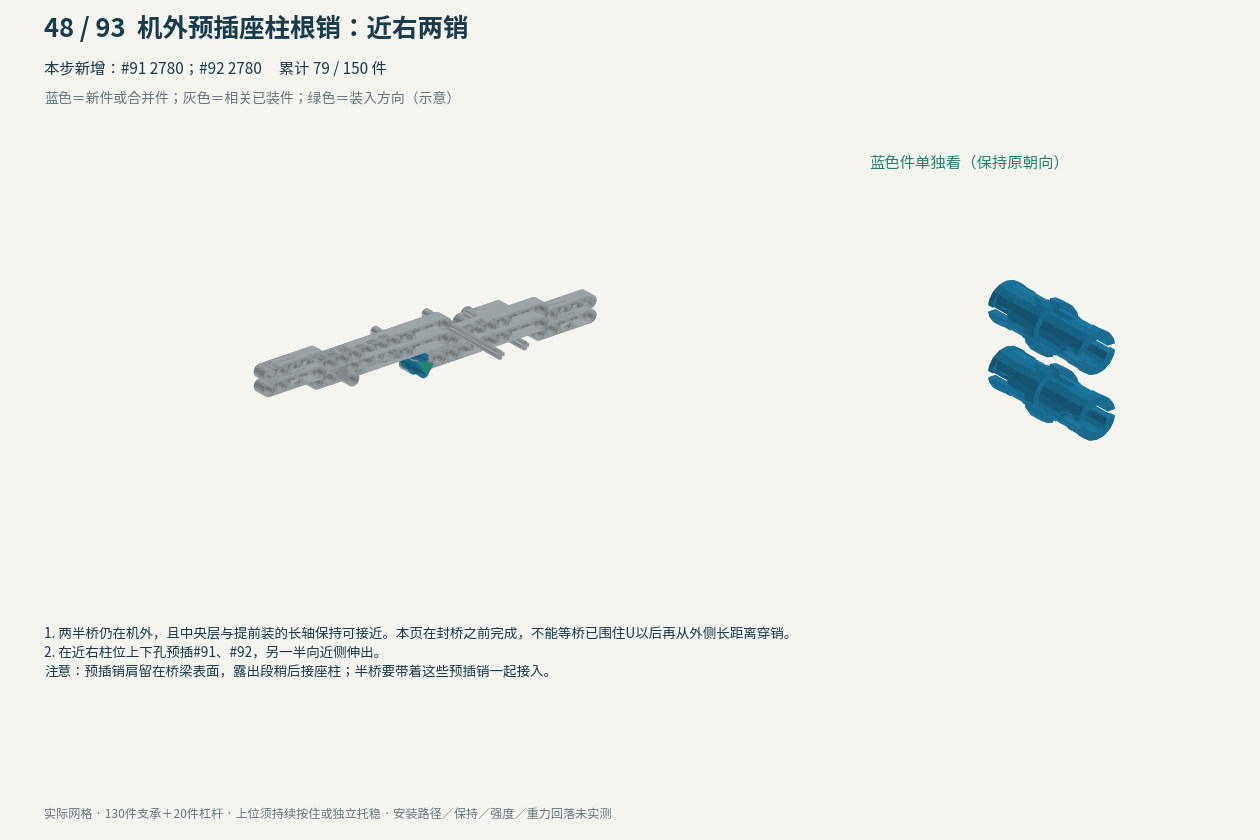
[picture p142: page 449]

## 450 / 501 130件支承装配 机外预插座柱根销：近左下销

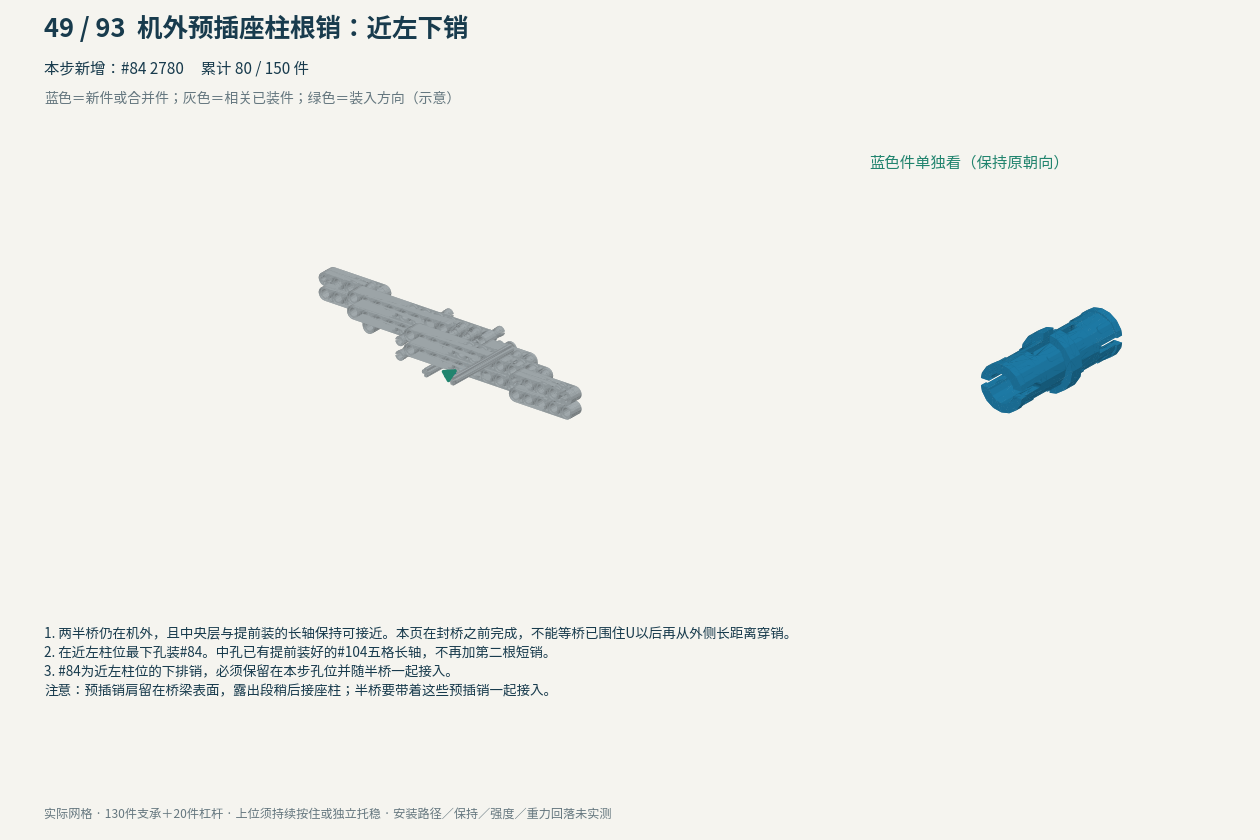
[picture p143: page 450]

## 451 / 501 130件支承装配 合并：右半桥六孔同步封桥

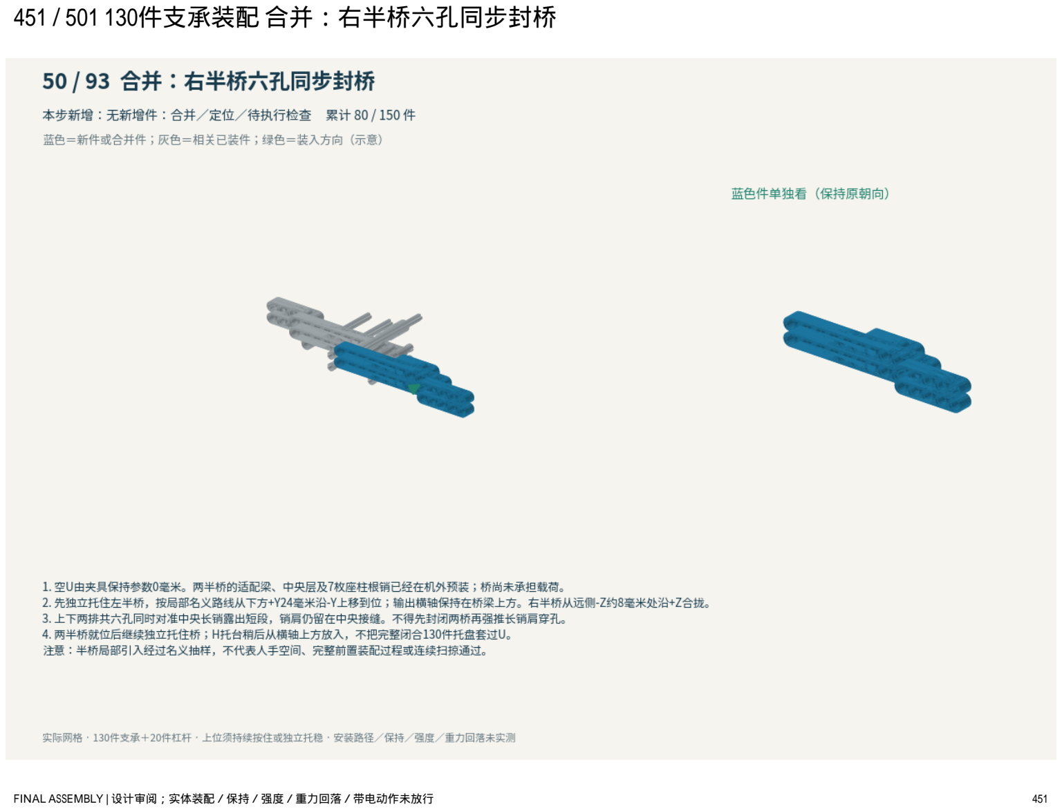
[picture p144: page 451]

## 452 / 501 130件支承装配 右夹架：围绕固定轨摆腹板和内轨

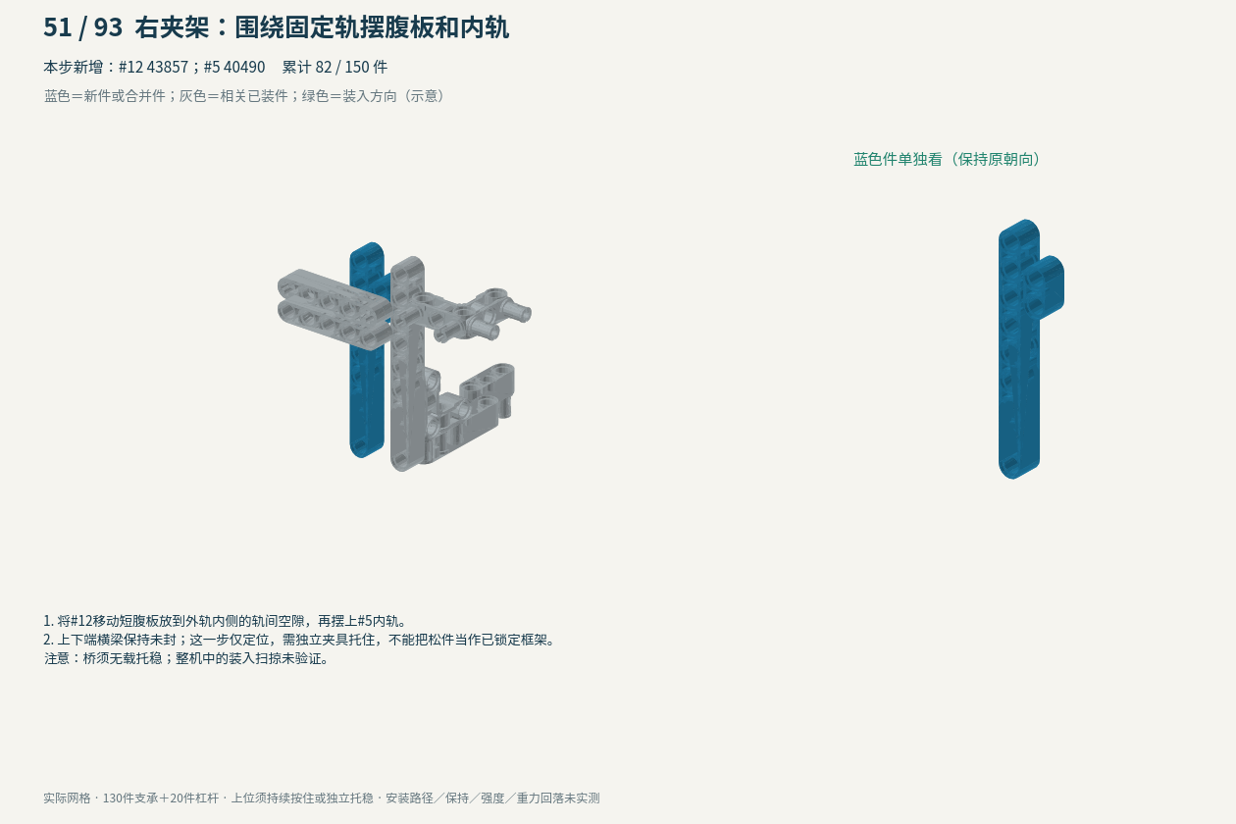
[picture p145: page 452]

## 453 / 501 130件支承装配 右夹架：两面原生L围住轨面

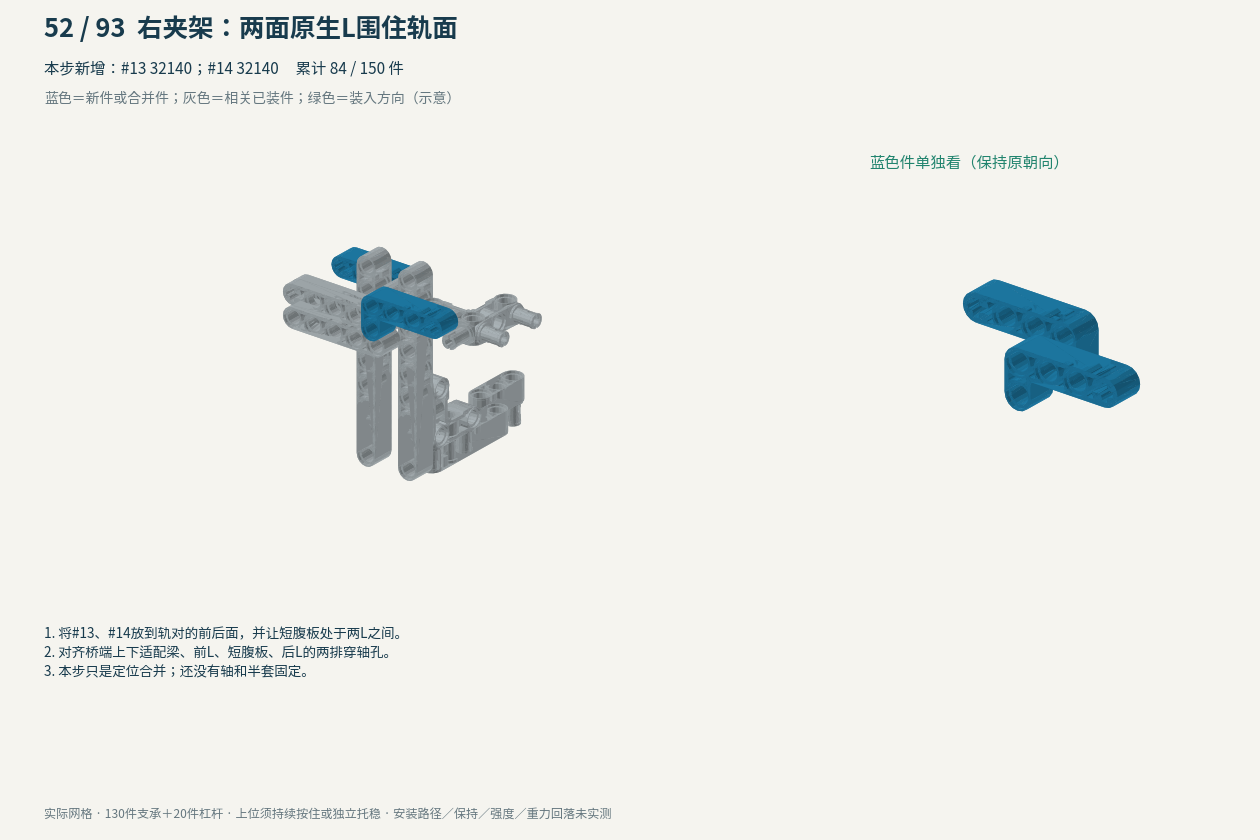
[picture p146: page 453]

## 454 / 501 130件支承装配 右夹架：上轴先带外侧半套

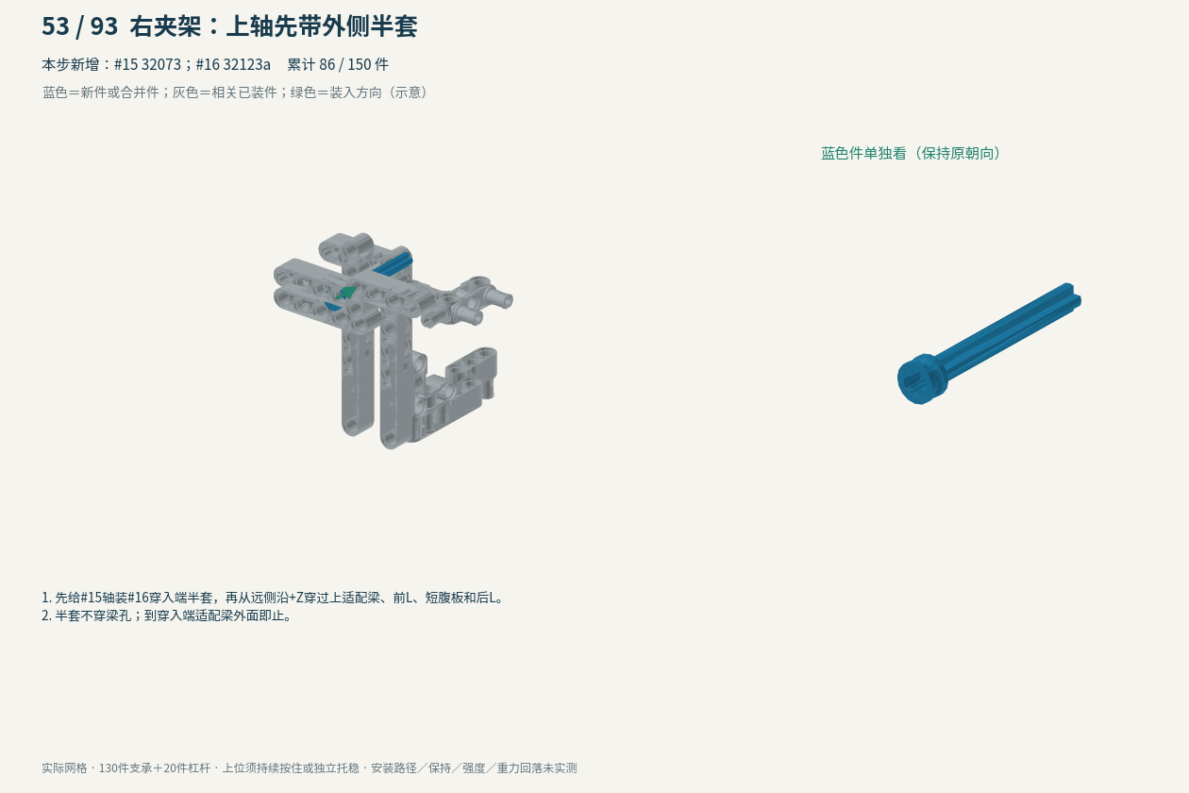
[picture p147: page 454]

## 455 / 501 130件支承装配 右下轴：先穿裸轴，再从局部放半套

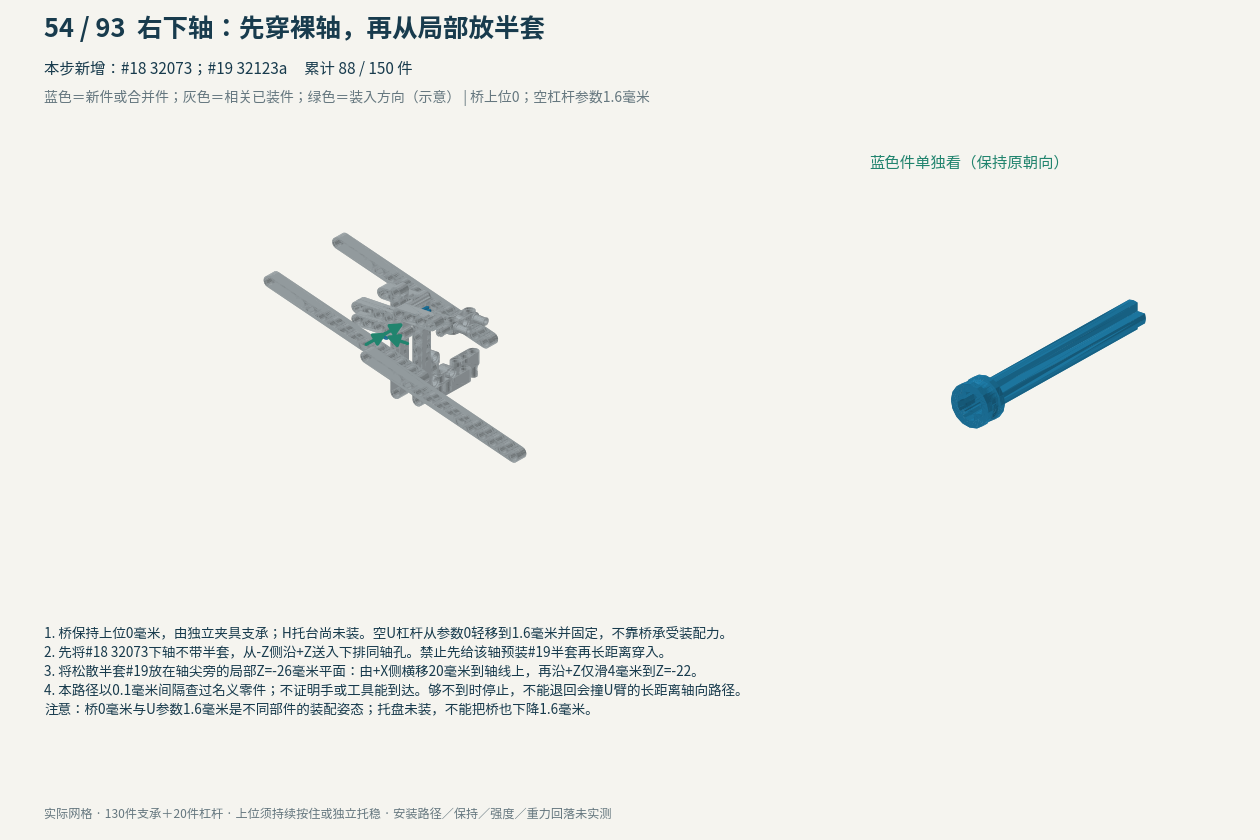
[picture p148: page 455]

## 456 / 501 130件支承装配 右夹架：正侧下半套从中心侧局部放入

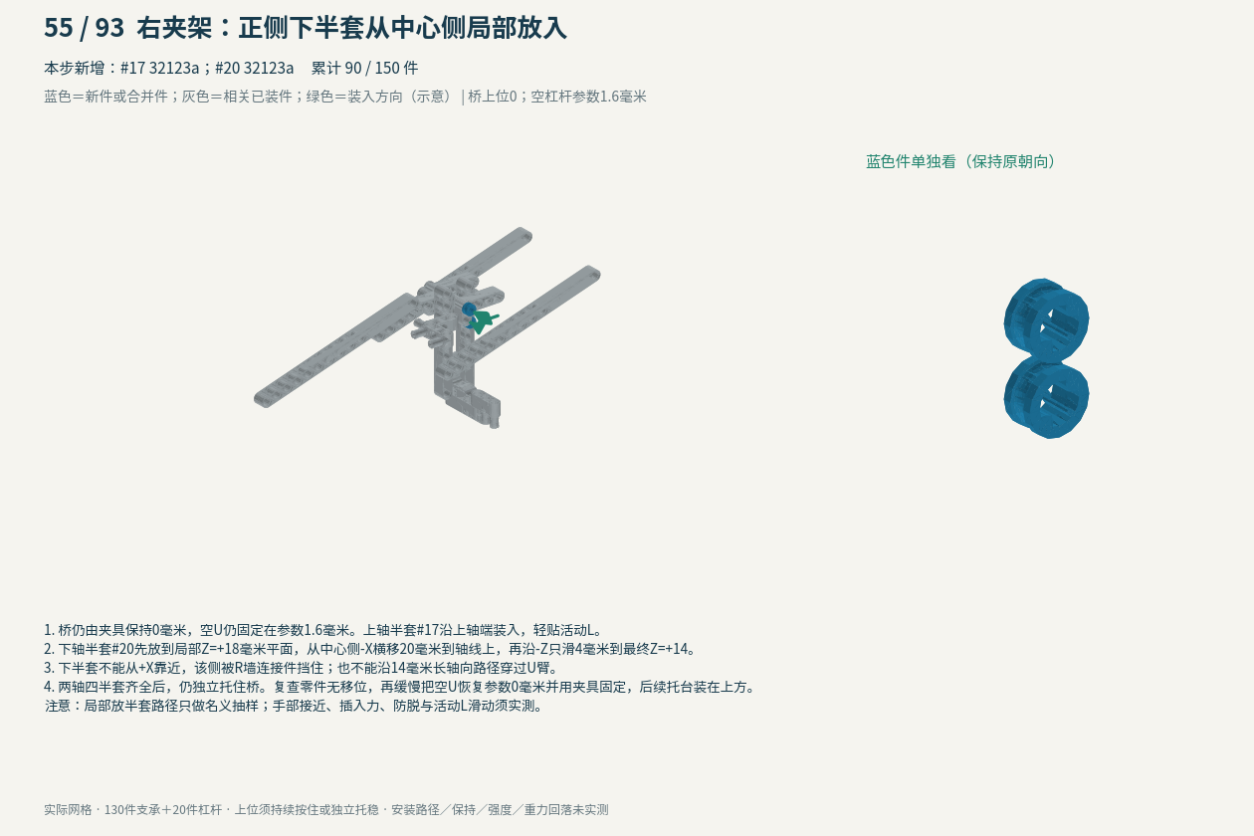
[picture p149: page 456]

## 457 / 501 130件支承装配 左夹架：围绕固定轨摆腹板和内轨

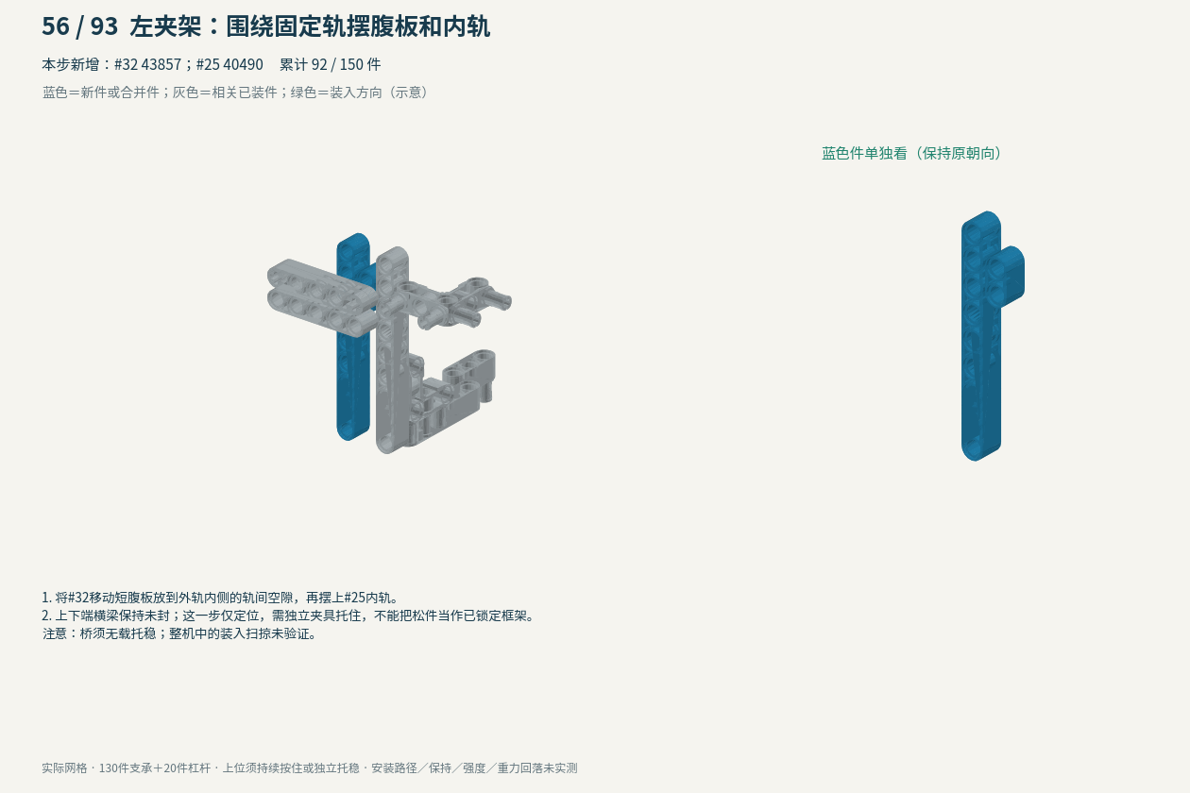
[picture p150: page 457]

## 458 / 501 130件支承装配 左夹架：两面原生L围住轨面

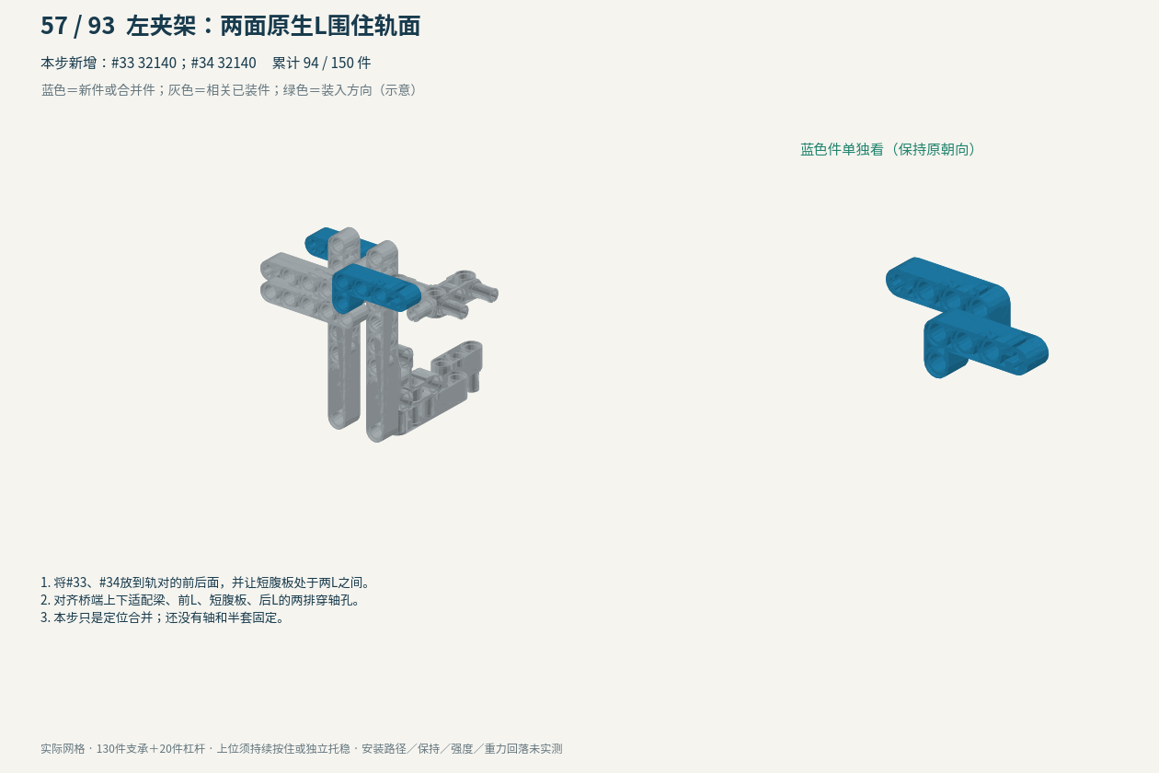
[picture p151: page 458]

## 459 / 501 130件支承装配 左夹架：上轴先带外侧半套

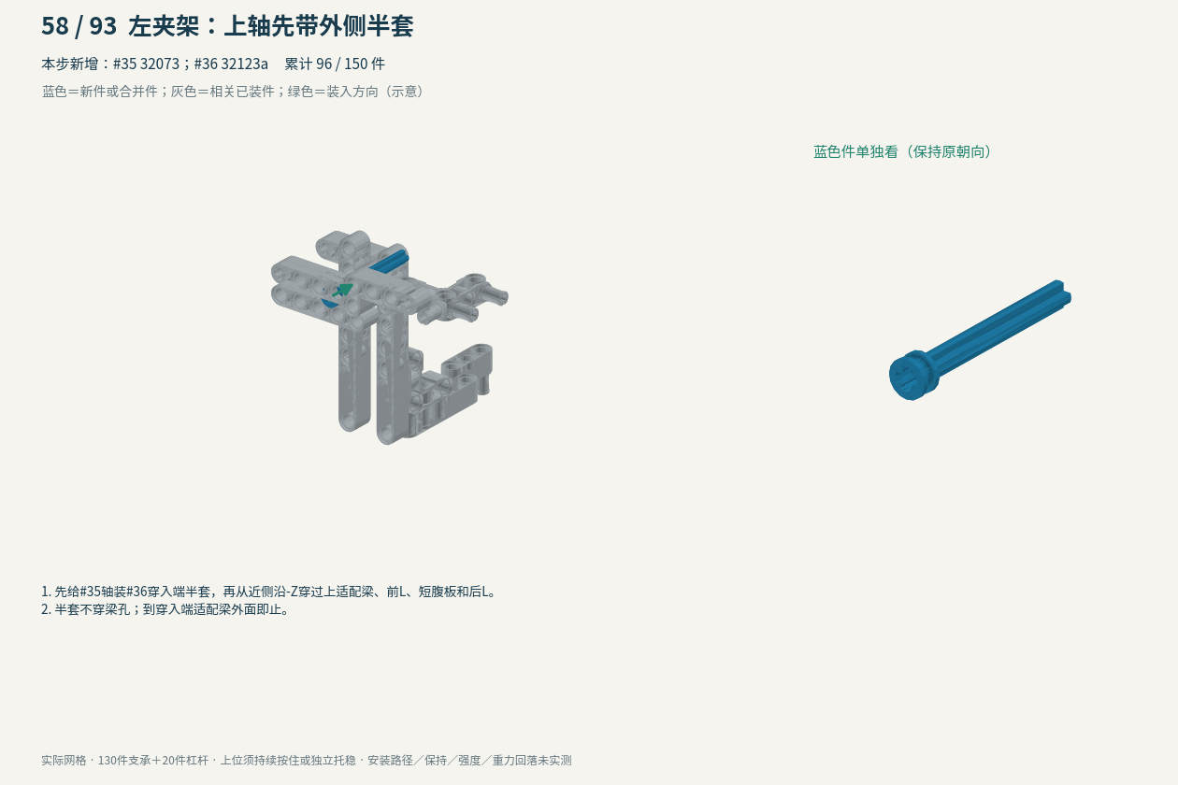
[picture p152: page 459]

## 460 / 501 130件支承装配 左夹架：下轴先带外侧半套

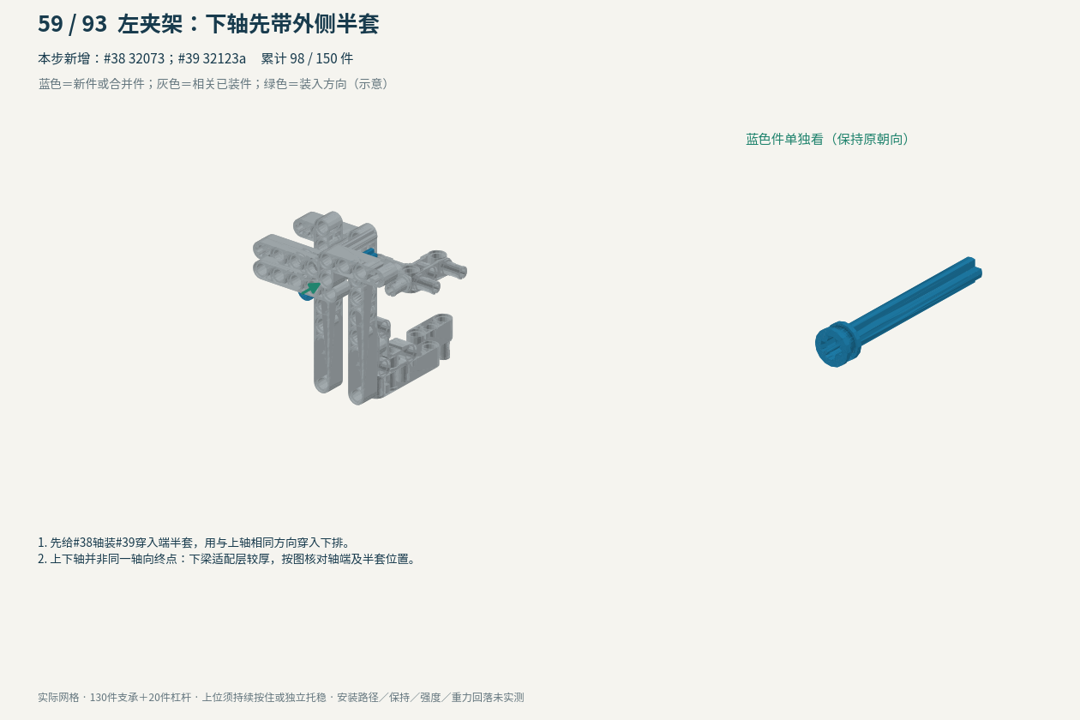
[picture p153: page 460]

## 461 / 501 130件支承装配 左夹架：最后装另侧两只半套

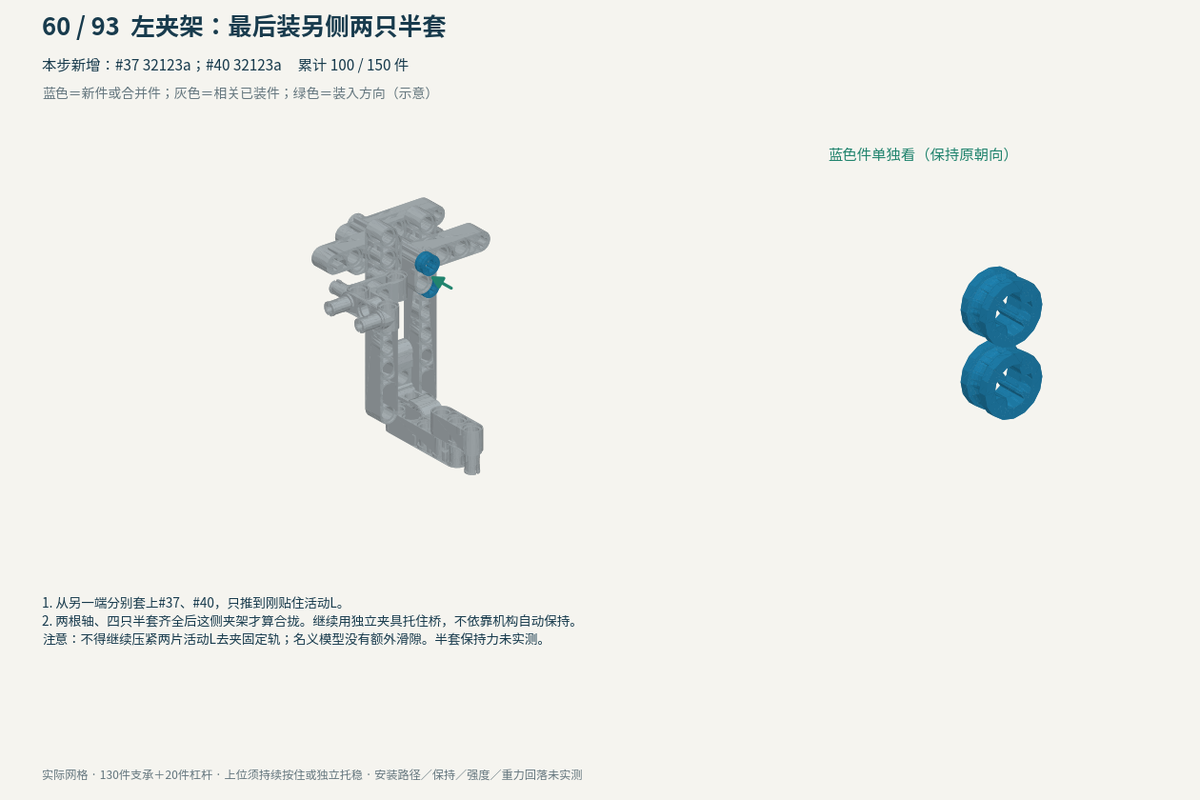
[picture p154: page 461]

## 462 / 501 130件支承装配 右上端梁：两根销先入轨孔

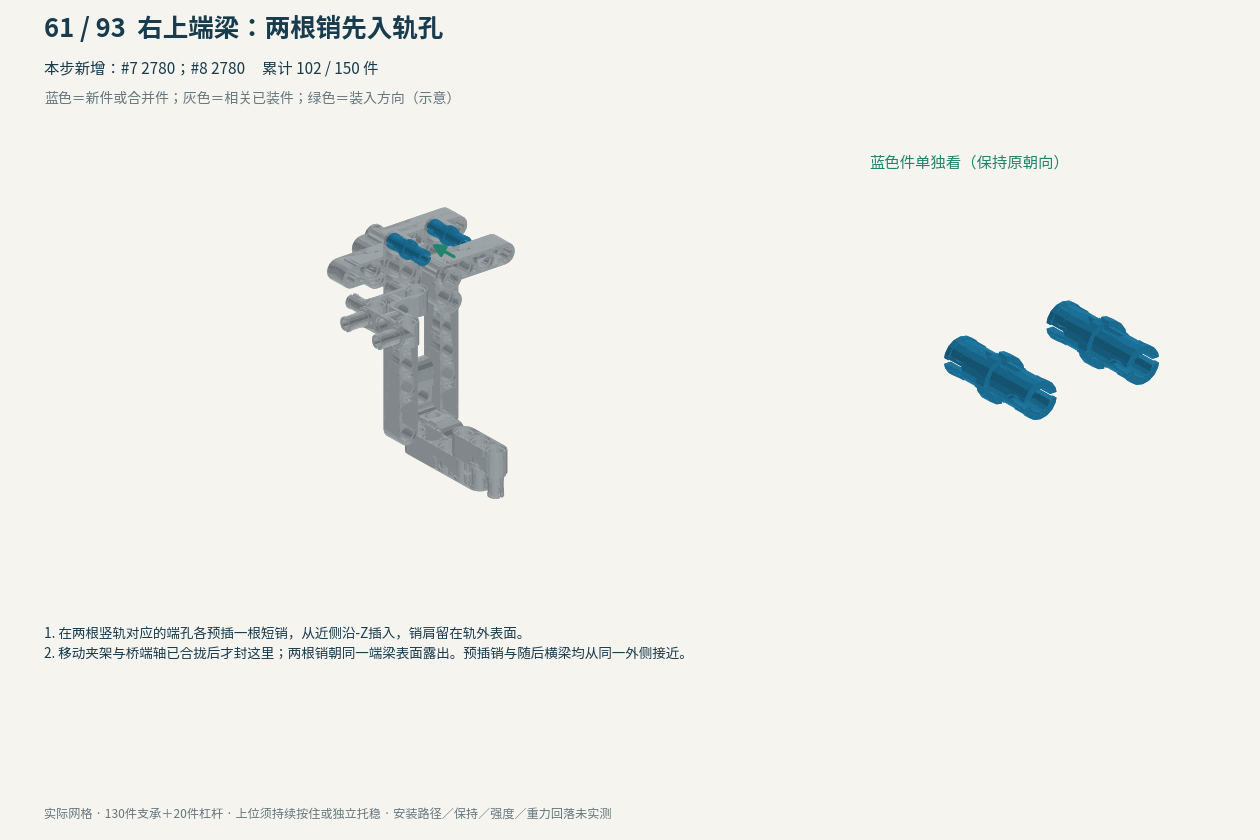
[picture p155: page 462]

## 463 / 501 130件支承装配 右上端梁：三孔横梁双孔合拢

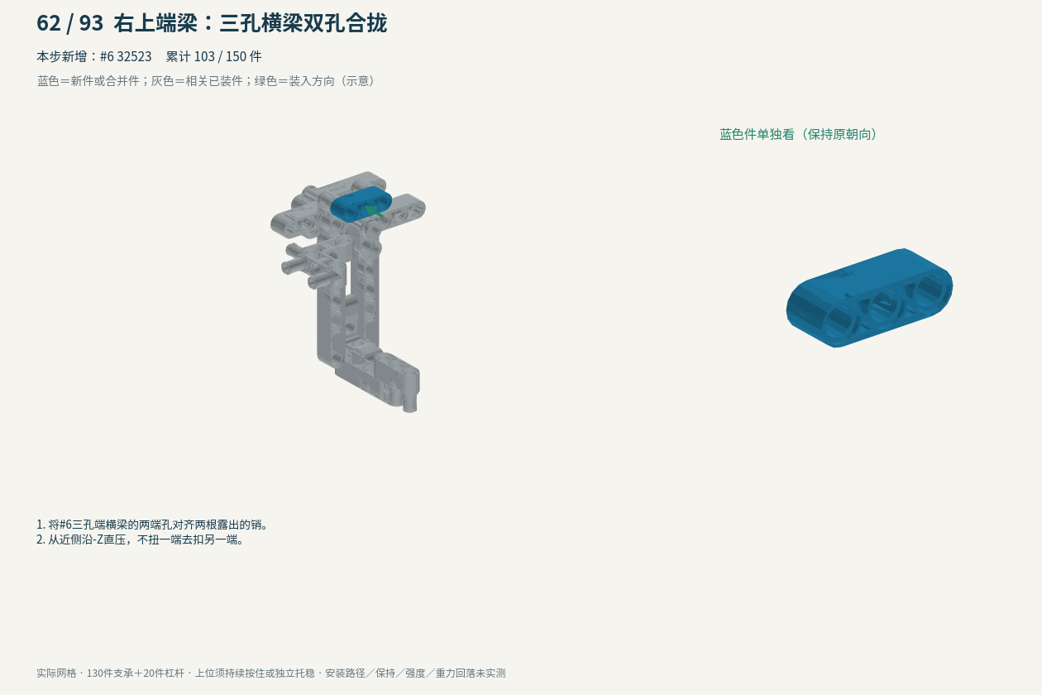
[picture p156: page 463]

## 464 / 501 130件支承装配 右下端梁：两根销先入轨孔

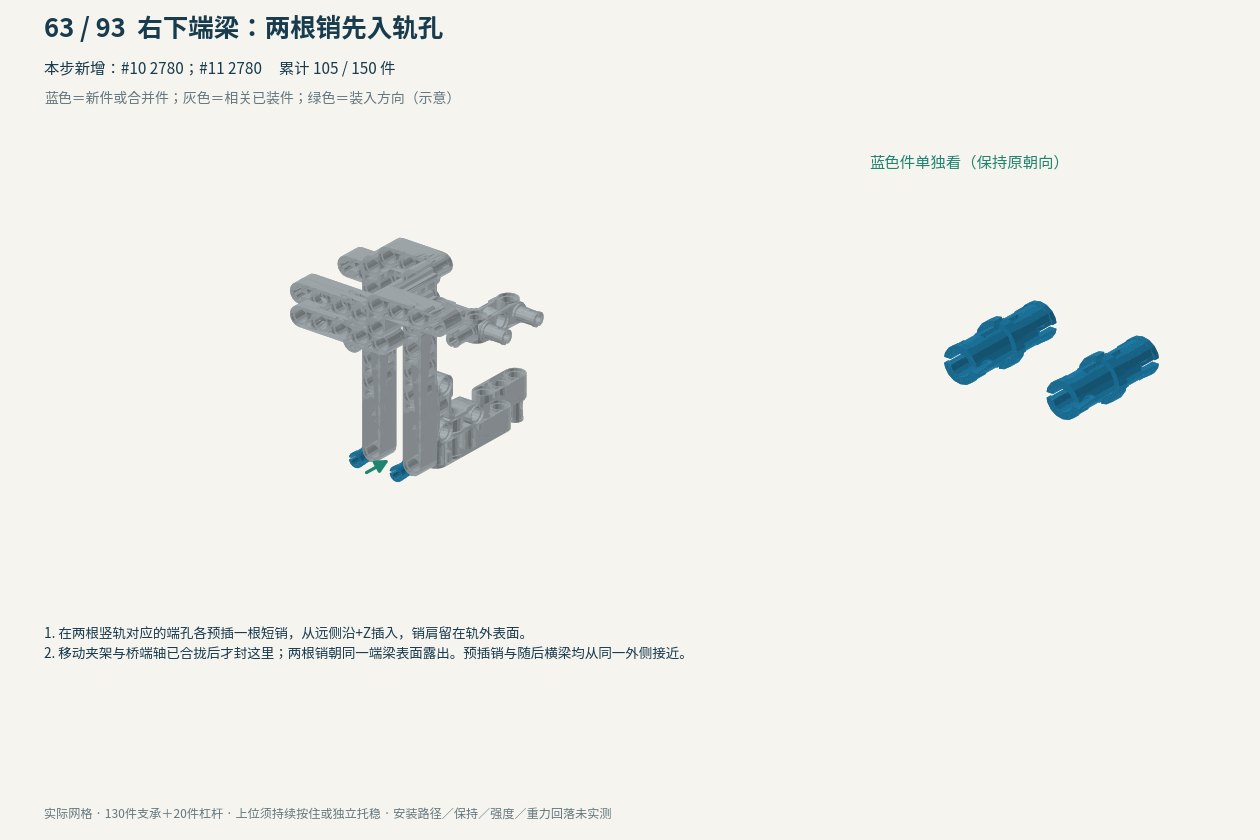
[picture p157: page 464]

## 465 / 501 130件支承装配 右下端梁：三孔横梁双孔合拢

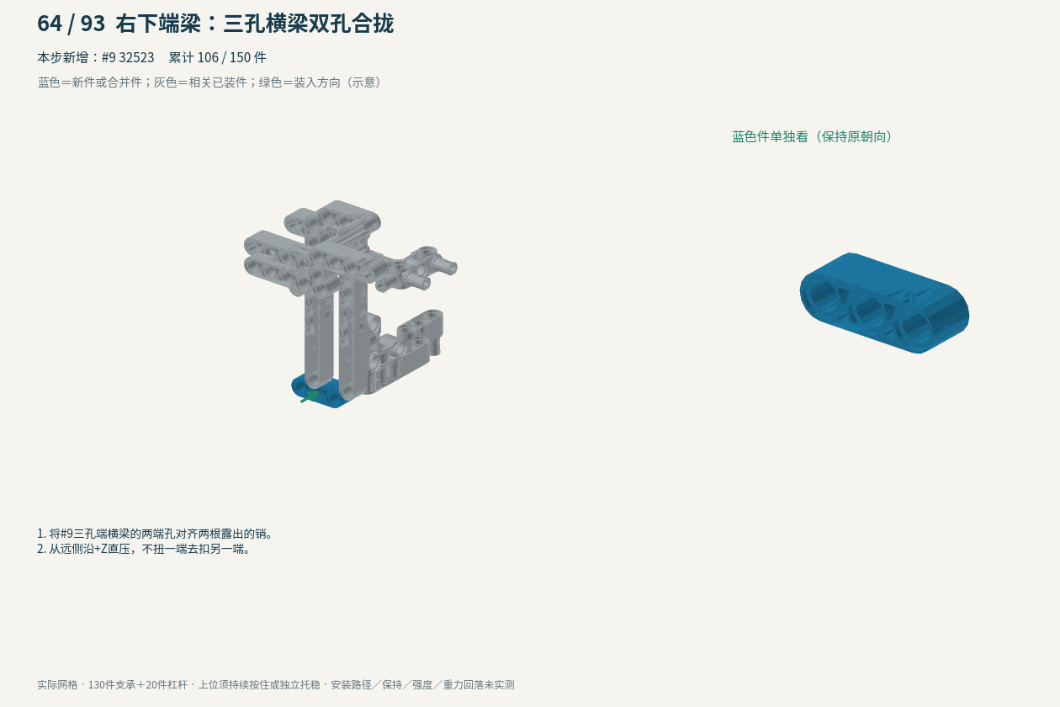
[picture p158: page 465]

## 466 / 501 130件支承装配 左上端梁：两根销先入轨孔

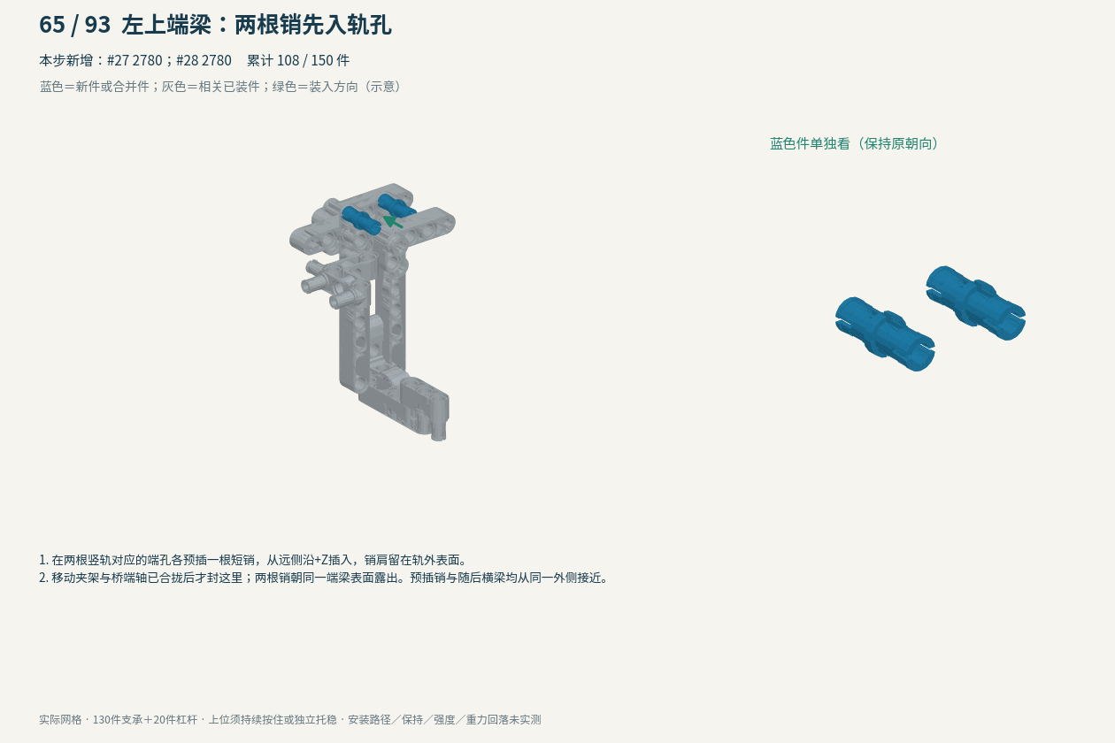
[picture p159: page 466]

## 467 / 501 130件支承装配 左上端梁：三孔横梁双孔合拢

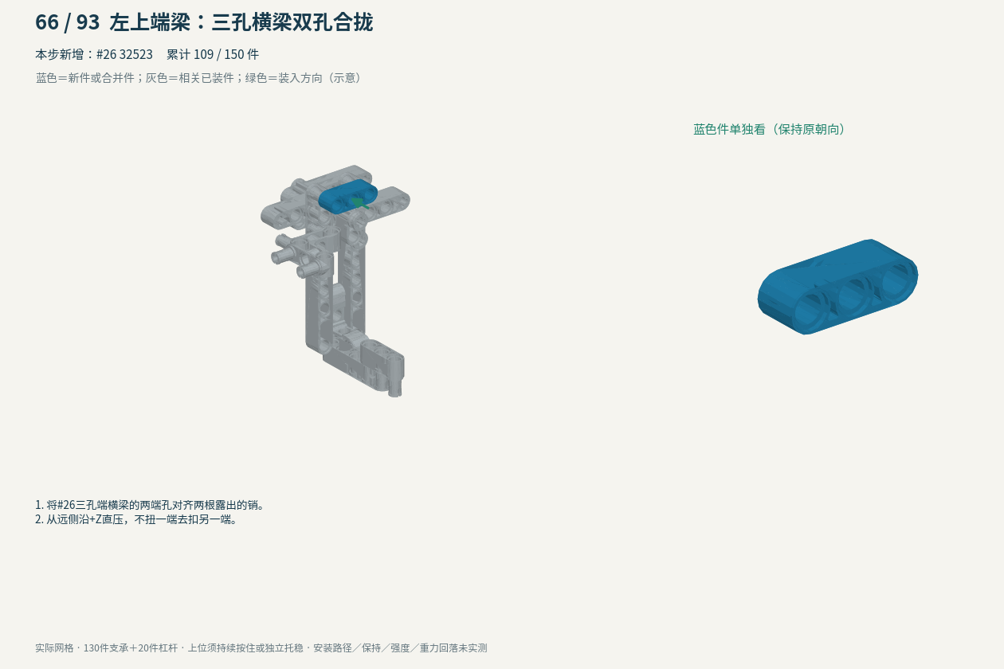
[picture p160: page 467]

## 468 / 501 130件支承装配 左下端梁：两根销先入轨孔

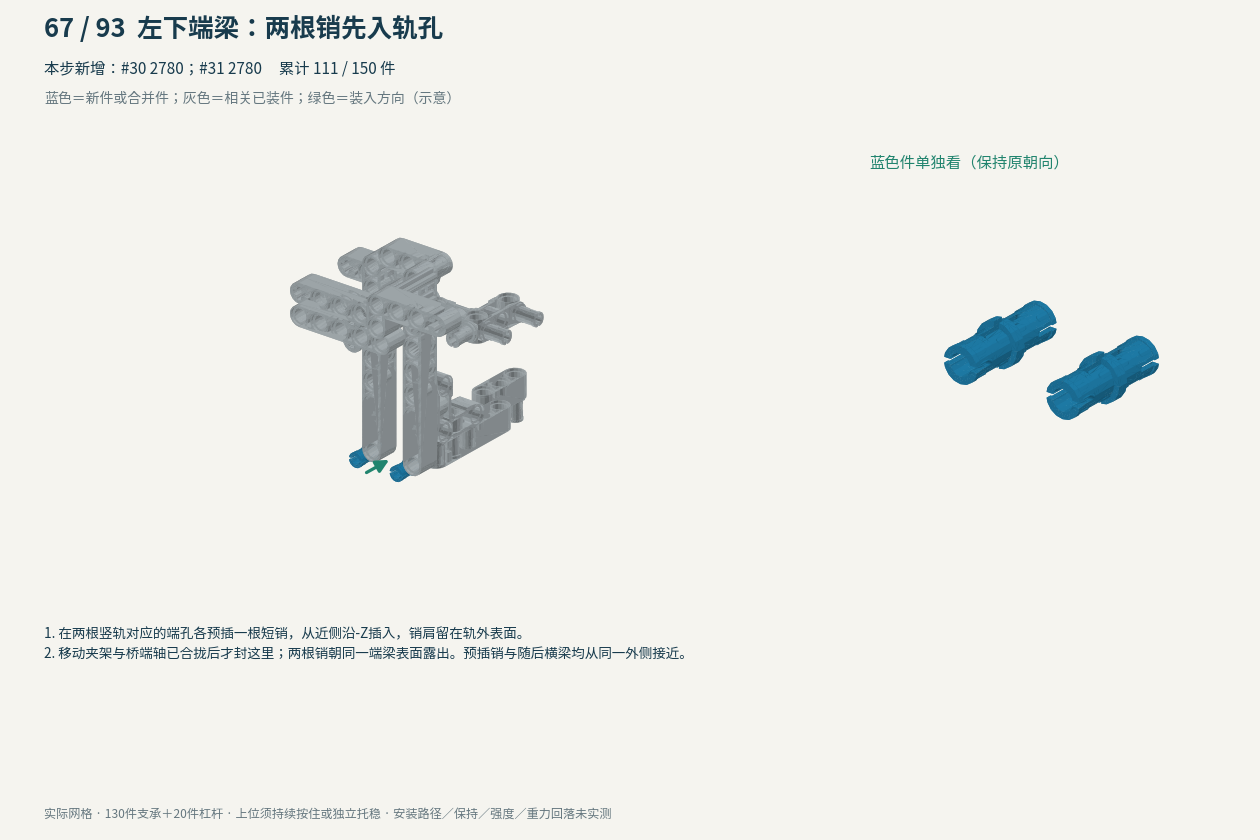
[picture p161: page 468]

## 469 / 501 130件支承装配 左下端梁：三孔横梁双孔合拢

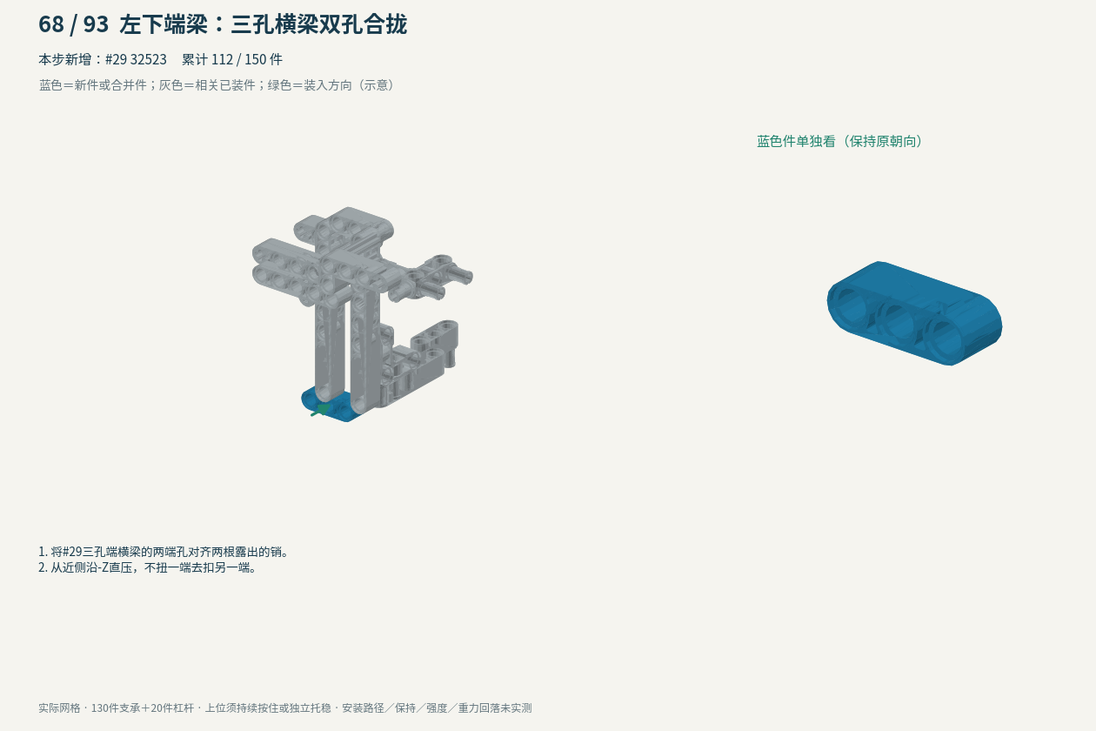
[picture p162: page 469]

## 470 / 501 130件支承装配 托面子组件：先取H座

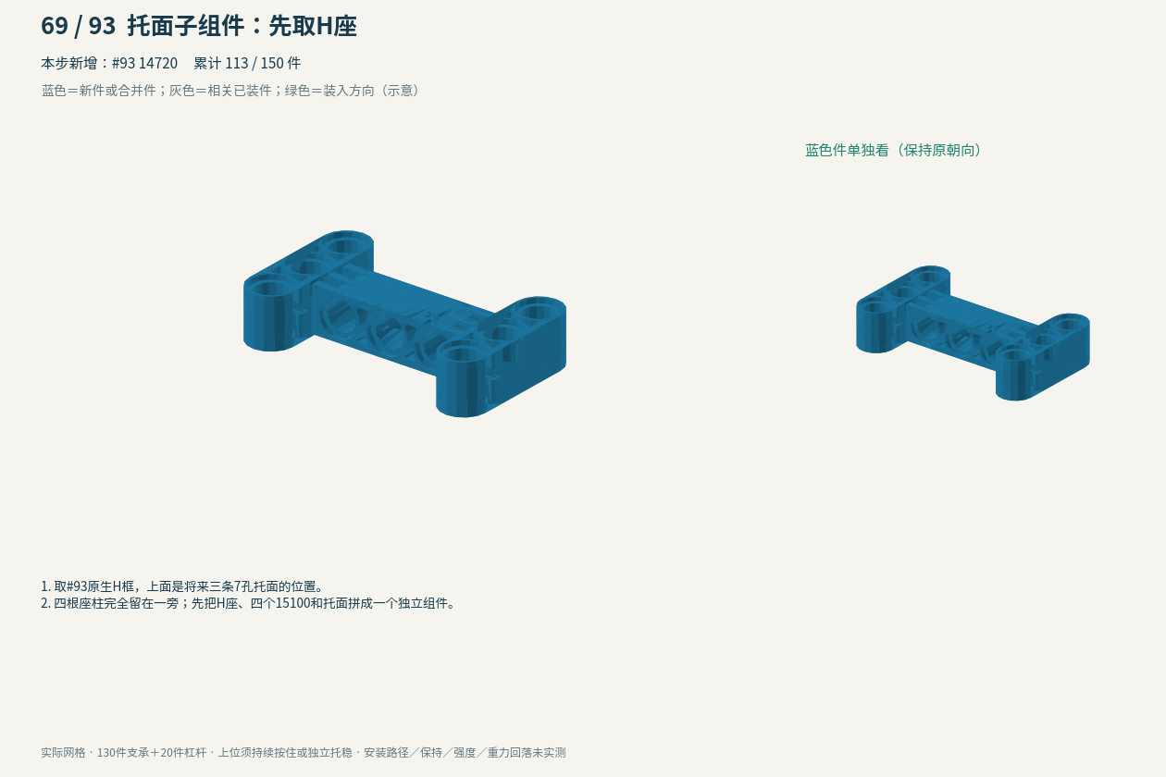
[picture p163: page 470]

## 471 / 501 130件支承装配 H座：近侧两个连接体和长销

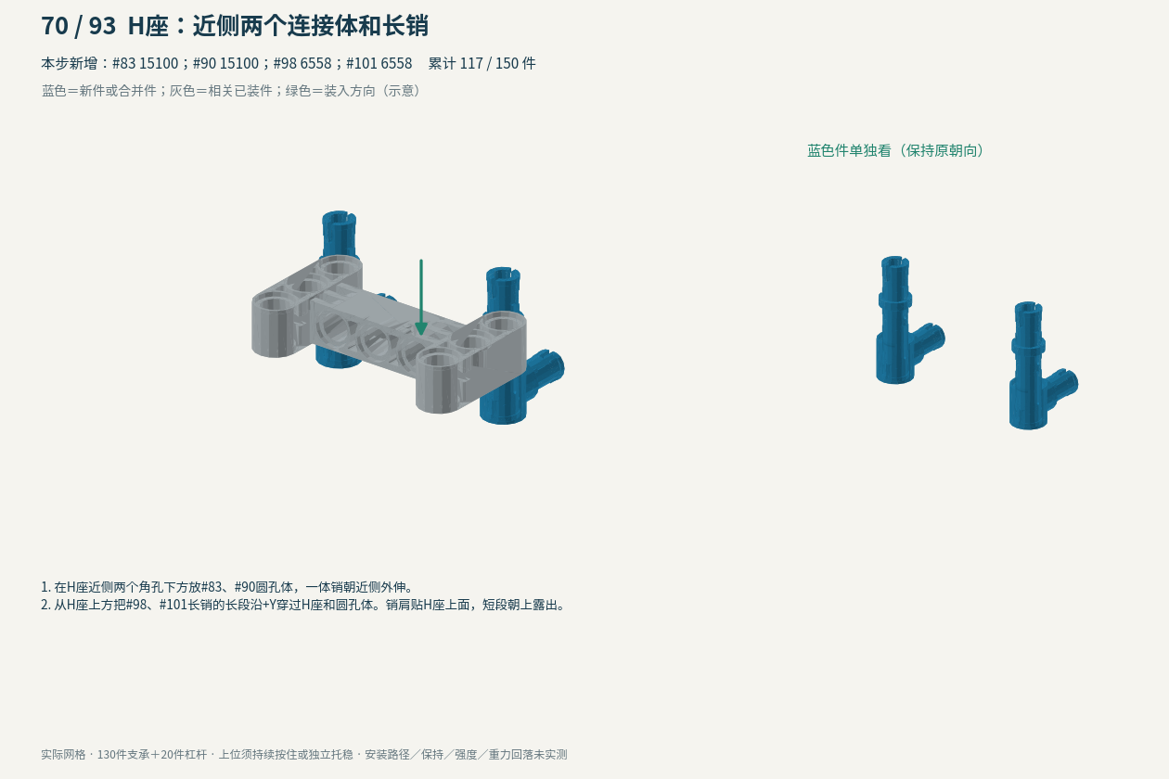
[picture p164: page 471]

## 472 / 501 130件支承装配 H座：远侧两个连接体和长销

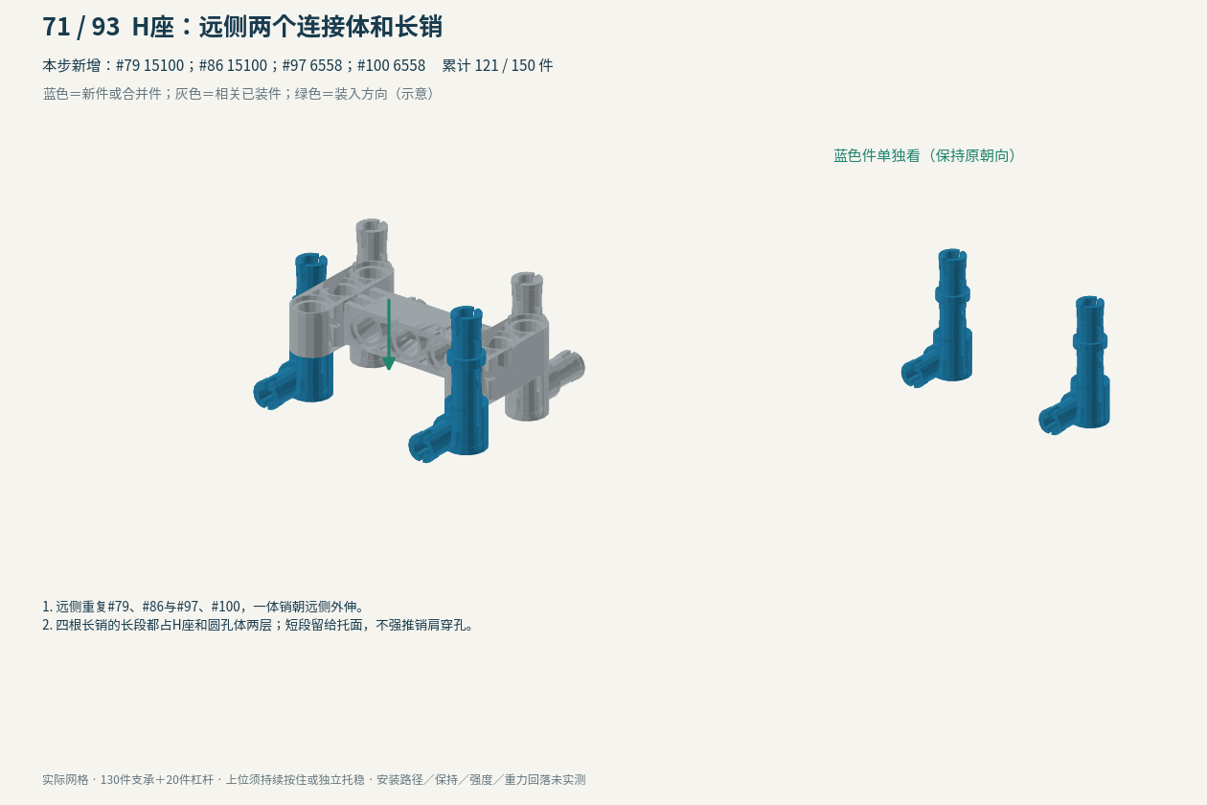
[picture p165: page 472]

## 473 / 501 130件支承装配 H座中排：独立预插两根短销

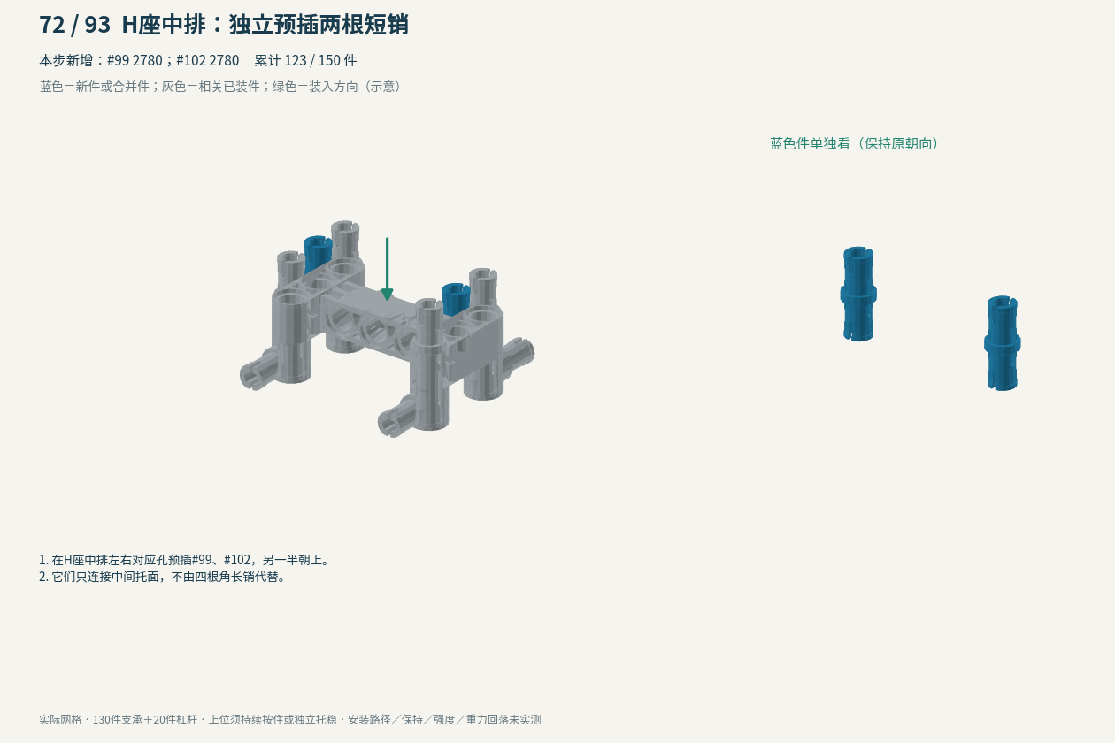
[picture p166: page 473]

## 474 / 501 130件支承装配 托面：装远侧7孔梁

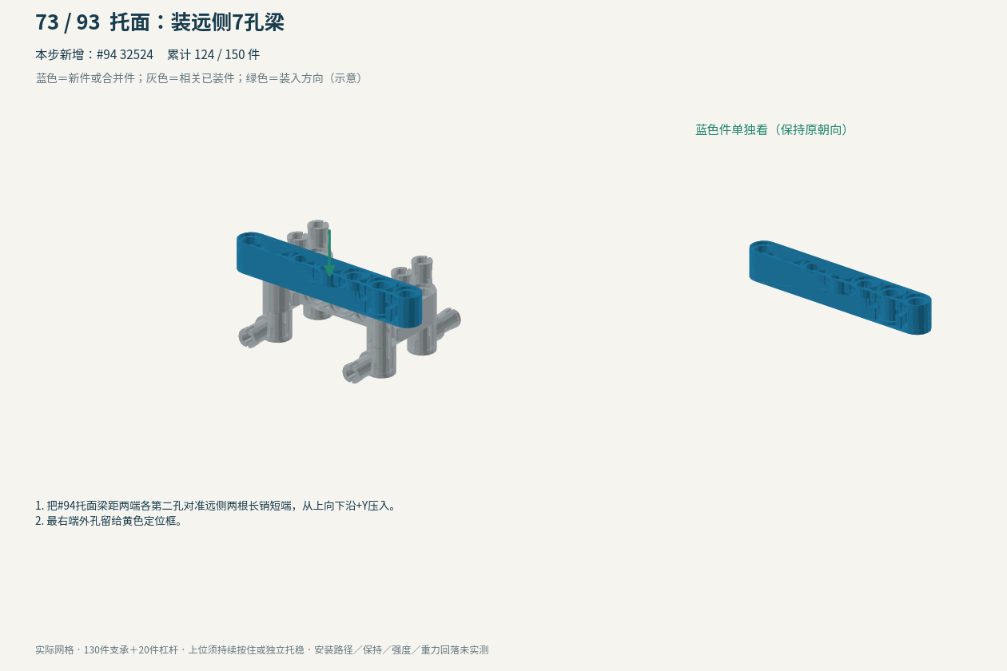
[picture p167: page 474]

## 475 / 501 130件支承装配 托面：装中间7孔梁

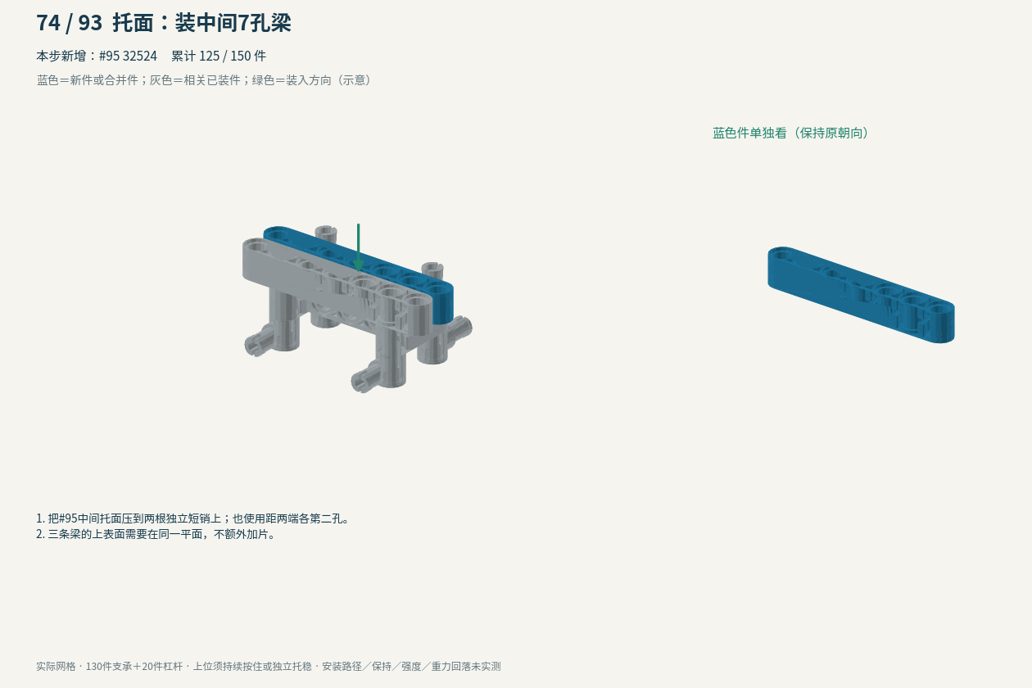
[picture p168: page 475]

## 476 / 501 130件支承装配 托面：装近侧7孔梁并检查

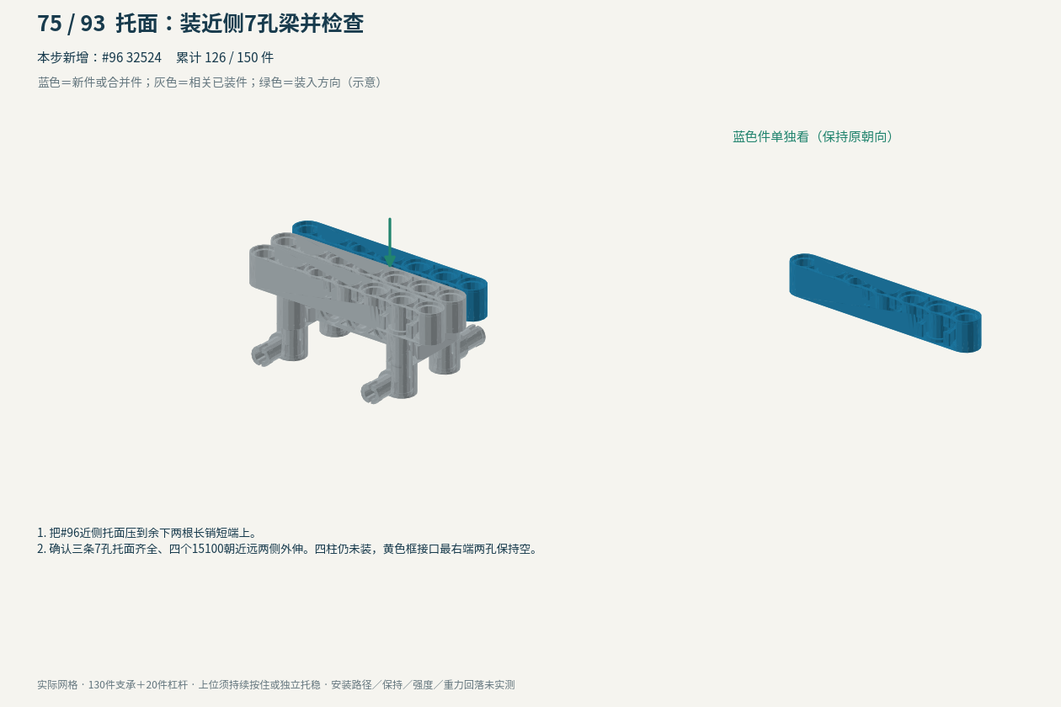
[picture p169: page 476]

## 477 / 501 130件支承装配 合并前定位：把完整托面放到桥上方

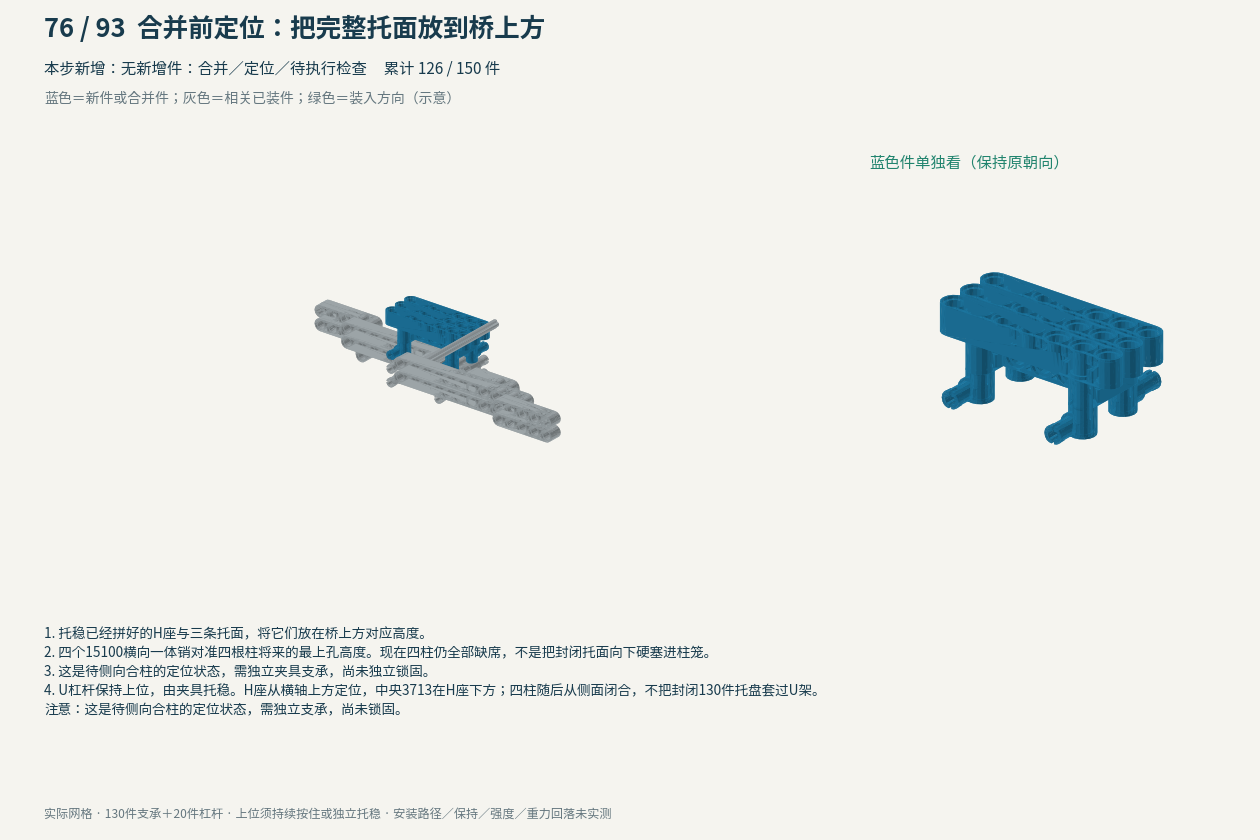
[picture p170: page 477]

## 478 / 501 130件支承装配 远左座柱：从外侧同时接三销

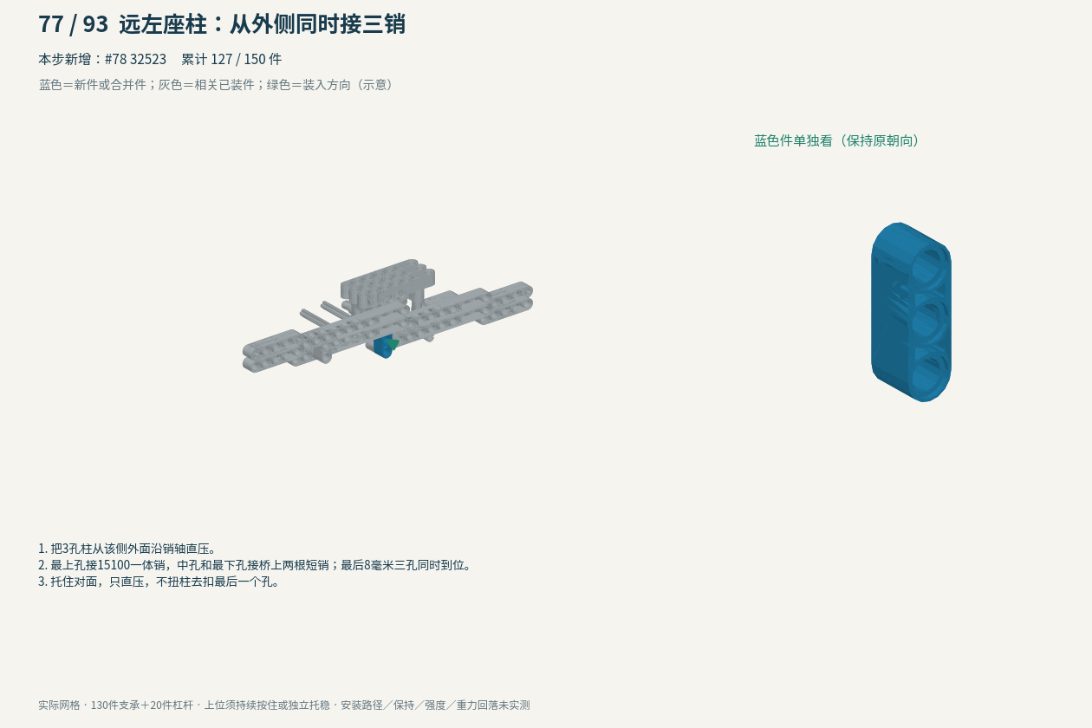
[picture p171: page 478]

## 479 / 501 130件支承装配 远右座柱：从外侧同时接三销

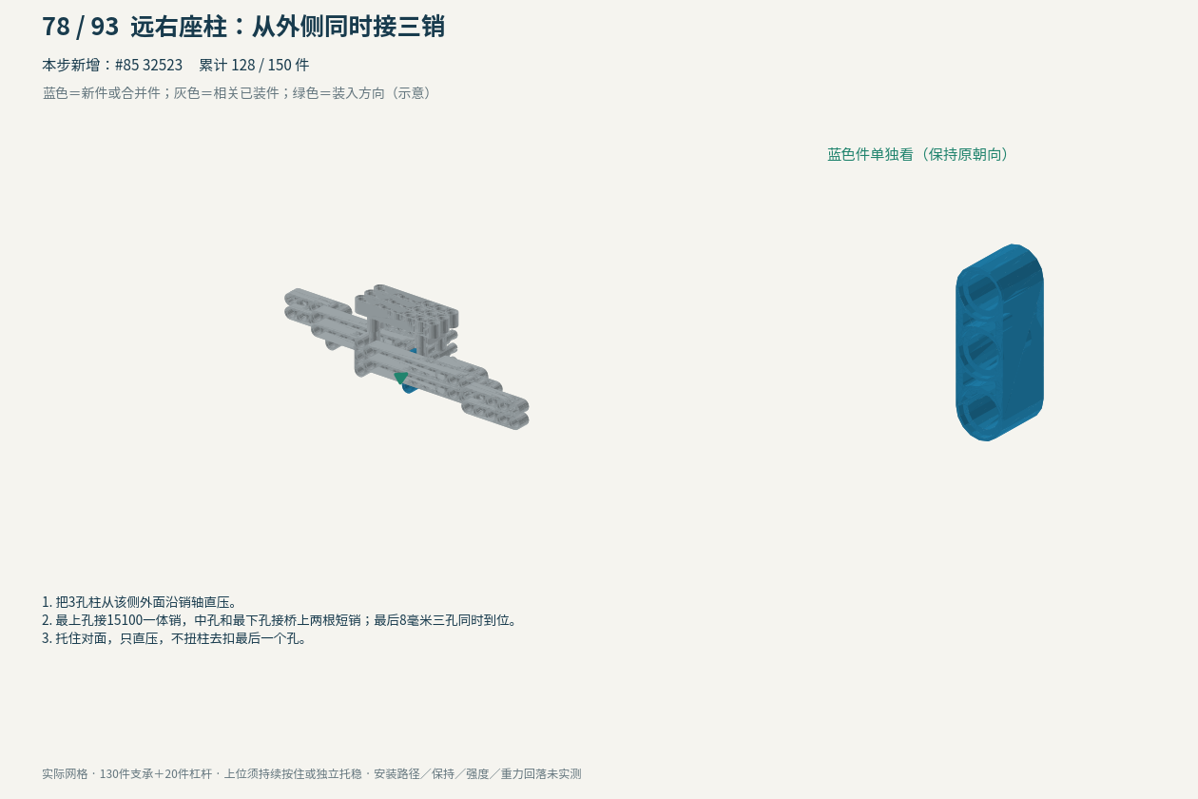
[picture p172: page 479]

## 480 / 501 130件支承装配 近右座柱：从外侧同时接三销

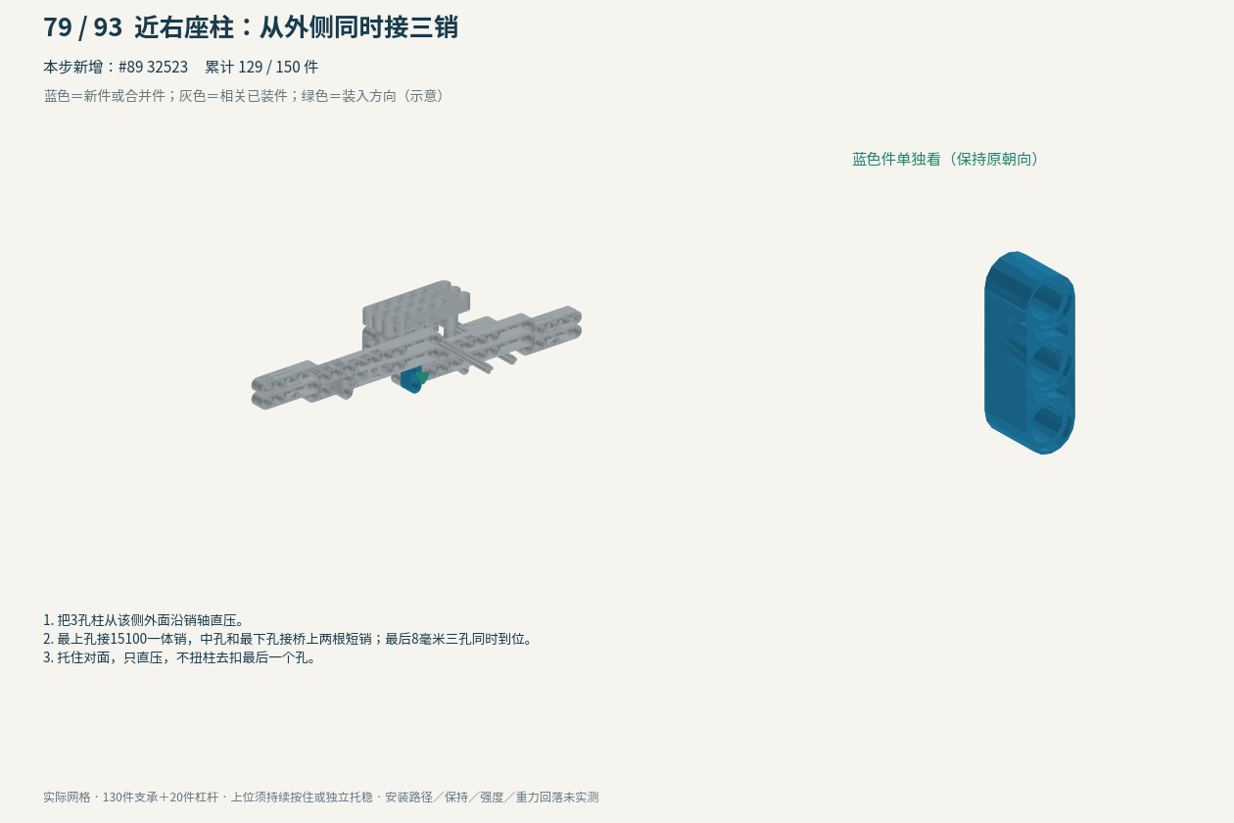
[picture p173: page 480]

## 481 / 501 130件支承装配 近左座柱：从长轴末端套入

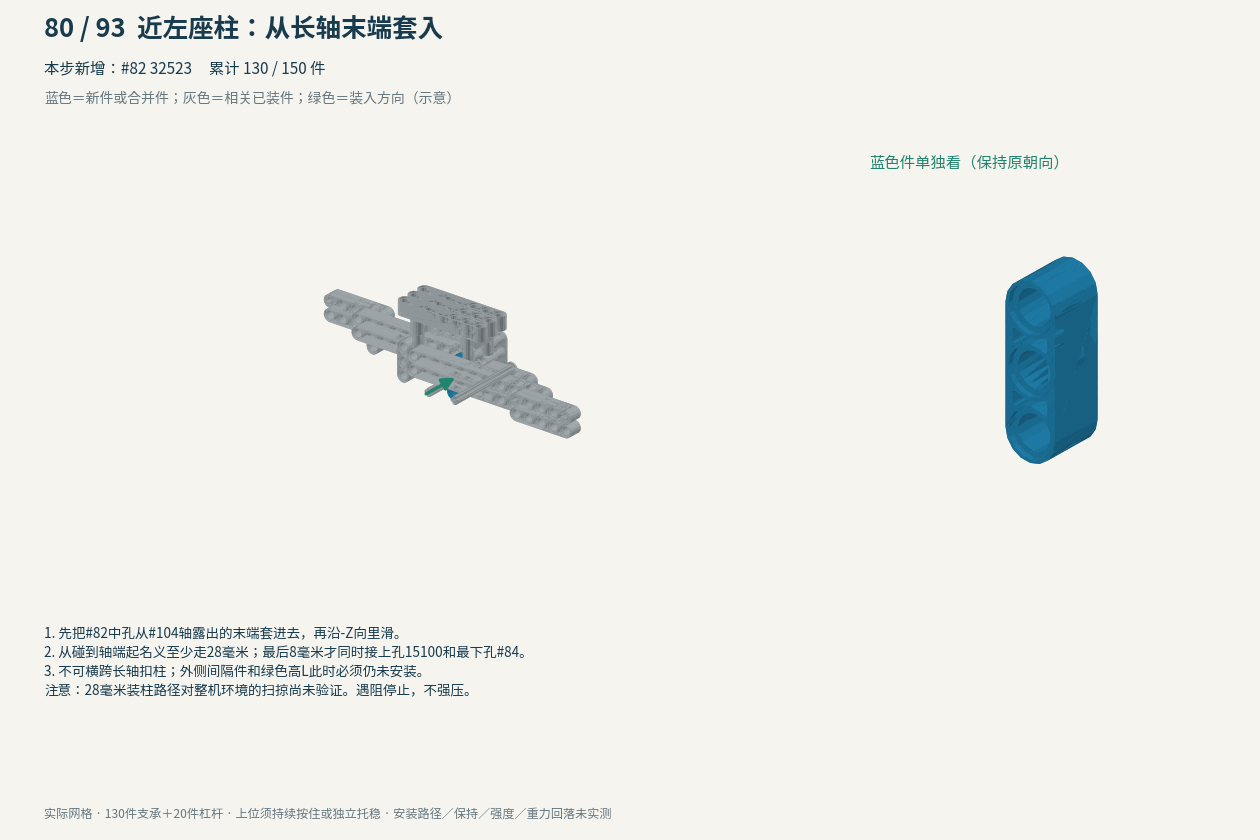
[picture p174: page 481]

## 482 / 501 130件支承装配 Z边：先套一格与两格间隔件

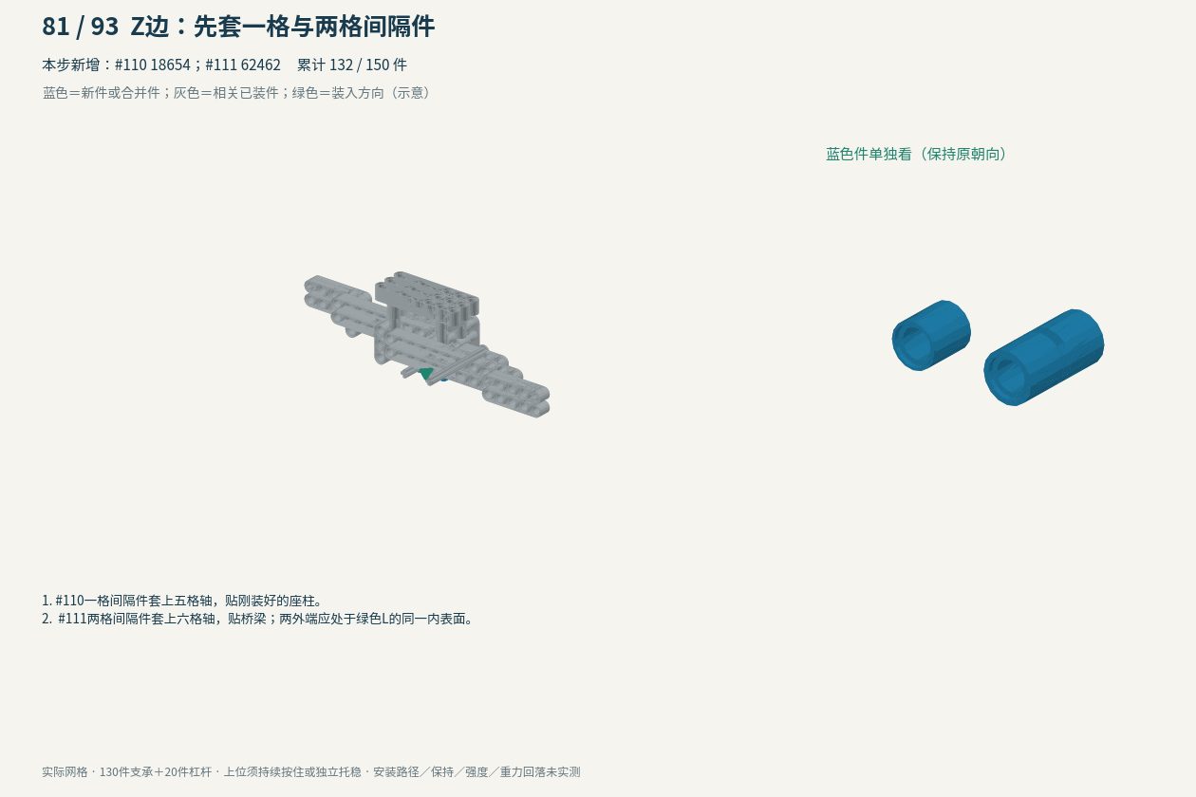
[picture p175: page 482]

## 483 / 501 130件支承装配 Z边：绿色高L同时套两轴

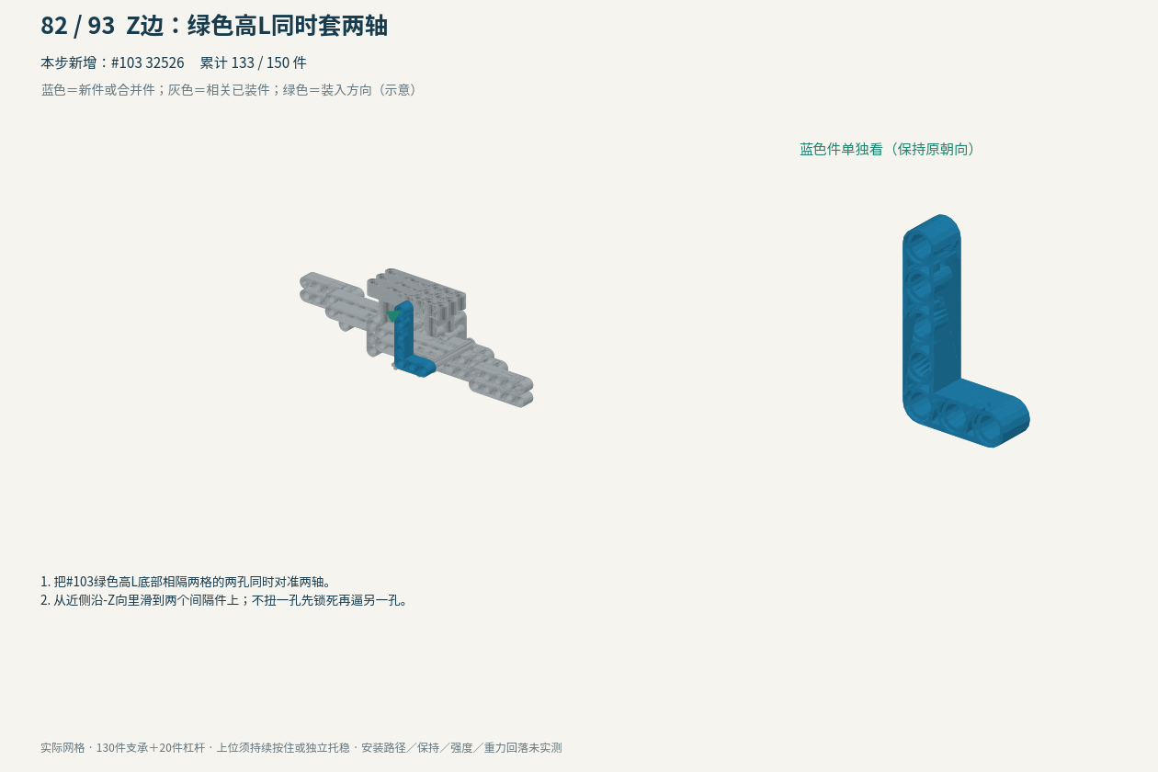
[picture p176: page 483]

## 484 / 501 130件支承装配 Z边：最后两只外半套

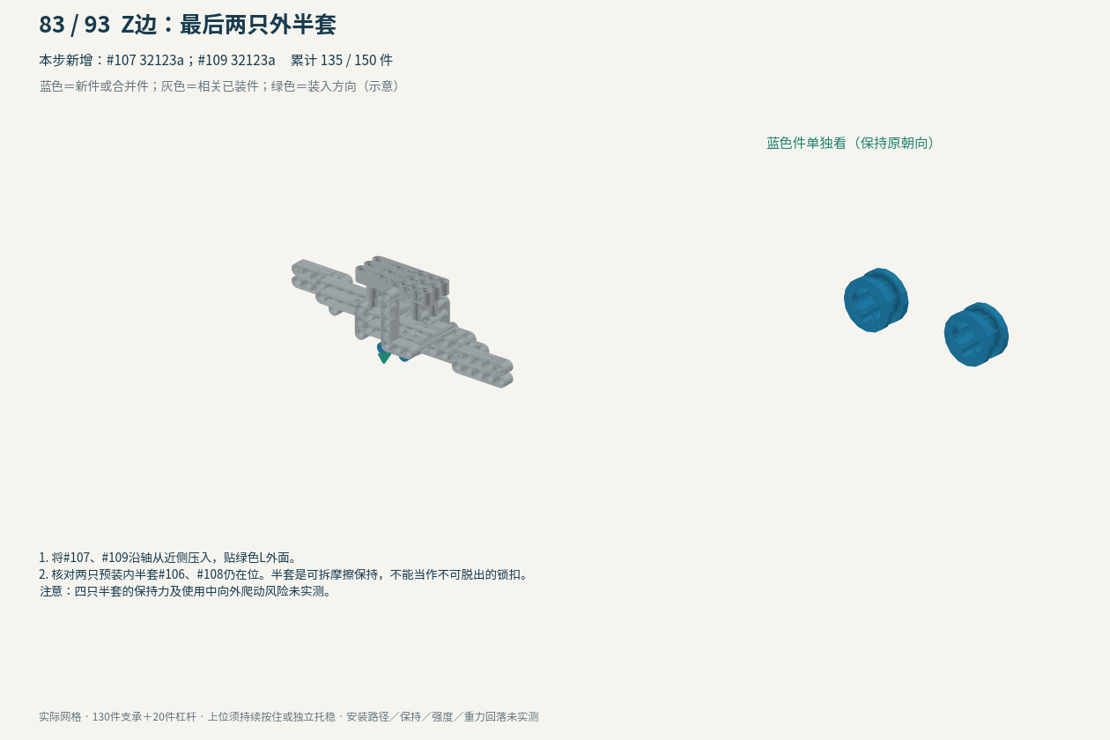
[picture p177: page 484]

## 485 / 501 130件支承装配 黄色X框：两根底销先装短端

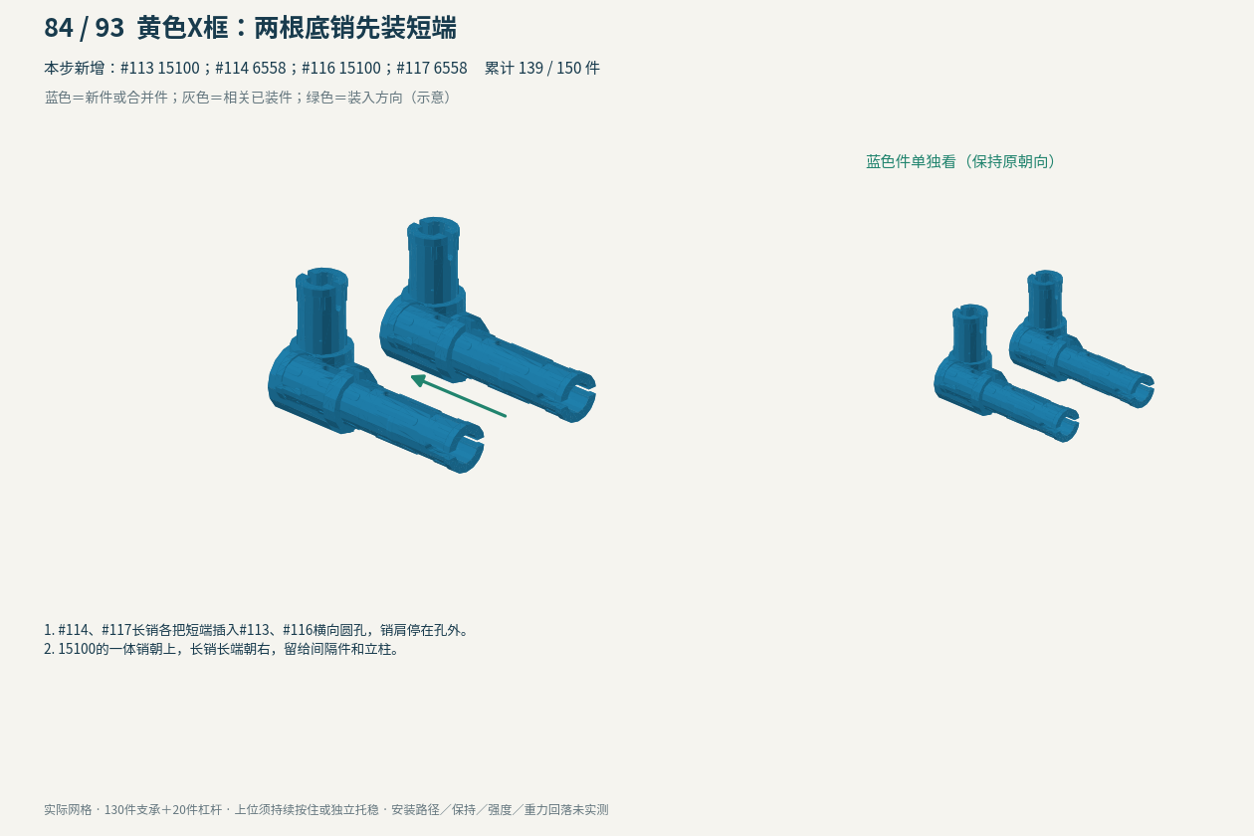
[picture p178: page 485]

## 486 / 501 130件支承装配 黄色X框：先套垫块，再套双柱

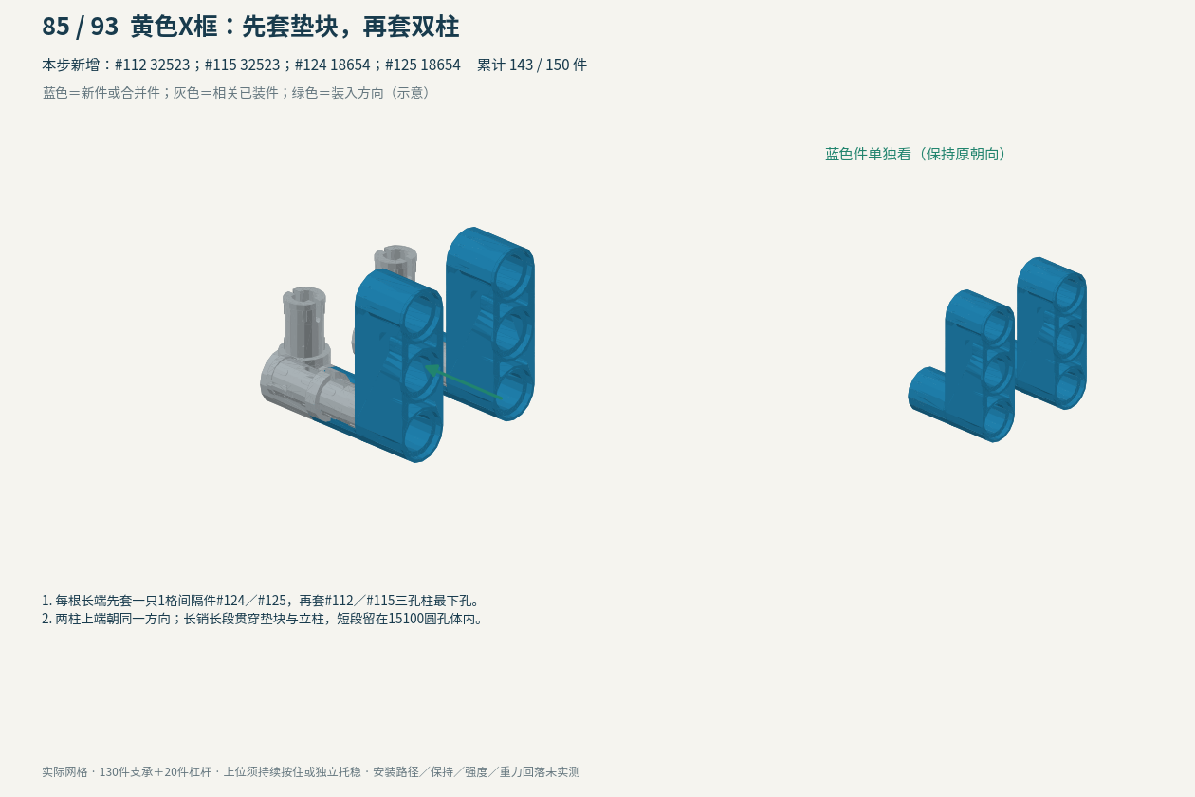
[picture p179: page 486]

## 487 / 501 130件支承装配 黄色X框：单独预插顶梁三销

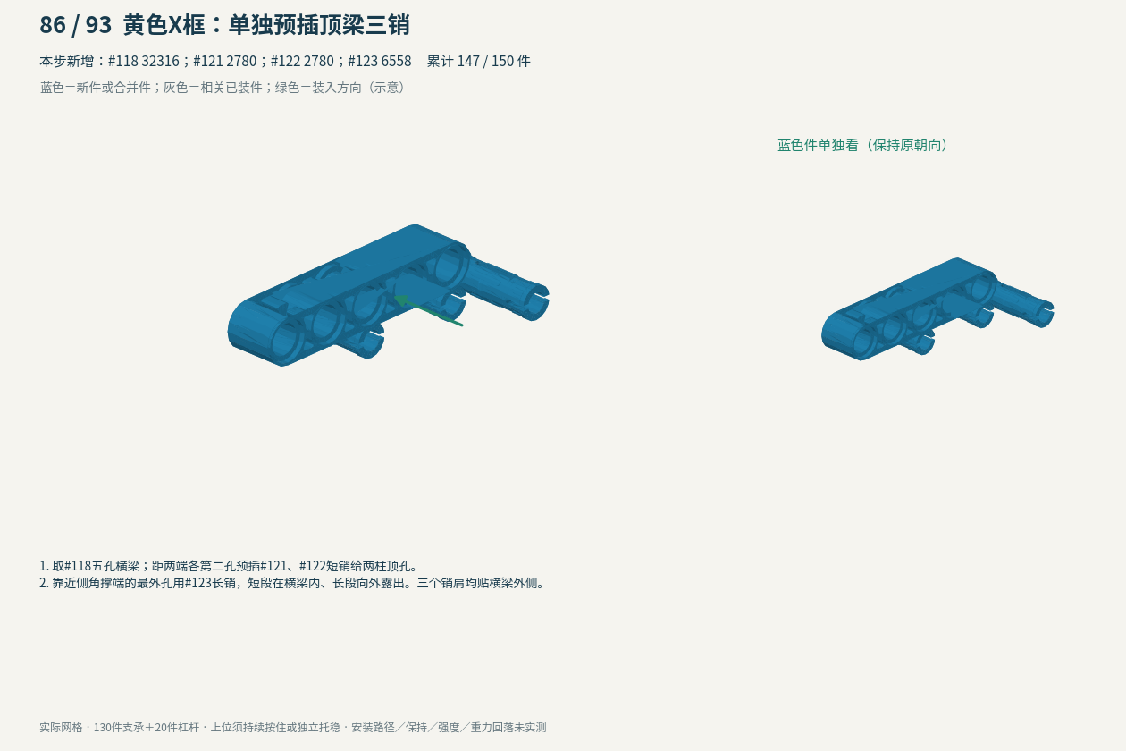
[picture p180: page 487]

## 488 / 501 130件支承装配 合并：双柱顶孔套上顶横梁

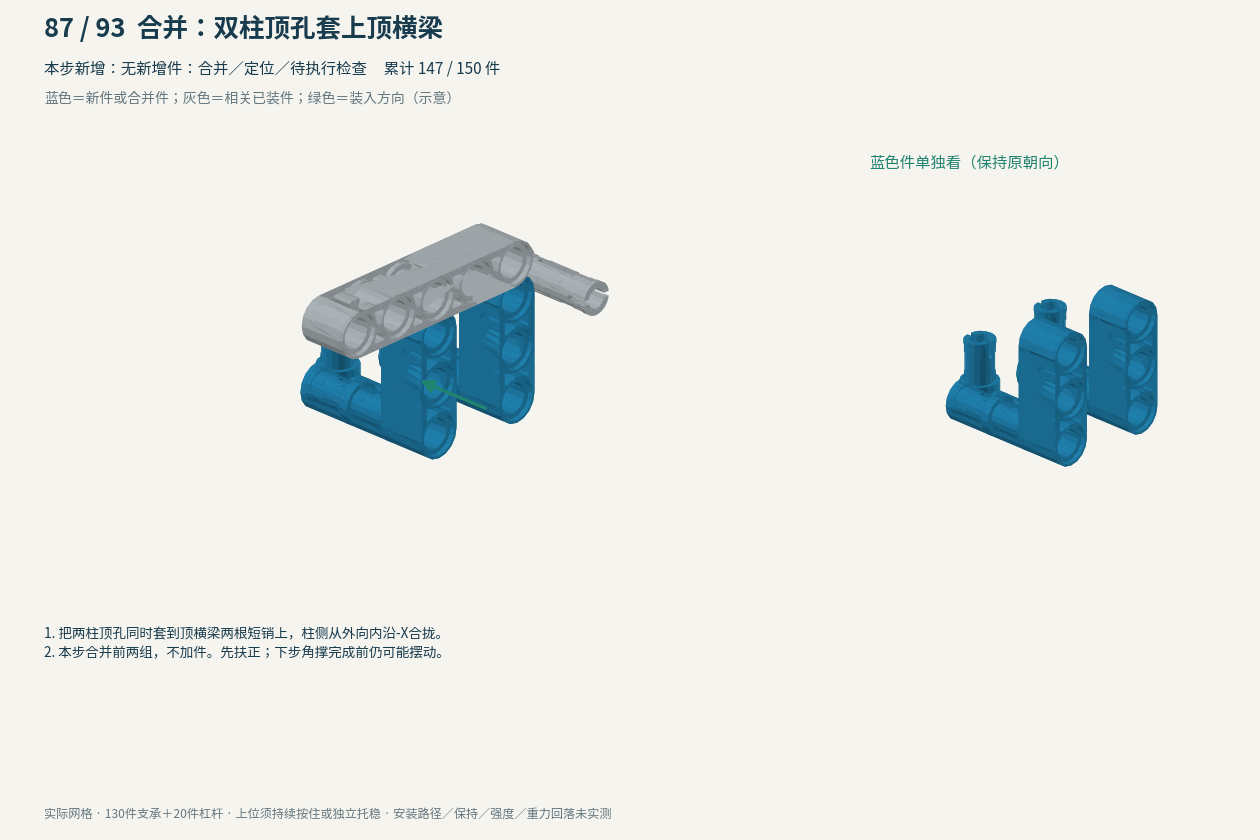
[picture p181: page 488]

## 489 / 501 130件支承装配 黄色X框：预备角撑双销入口

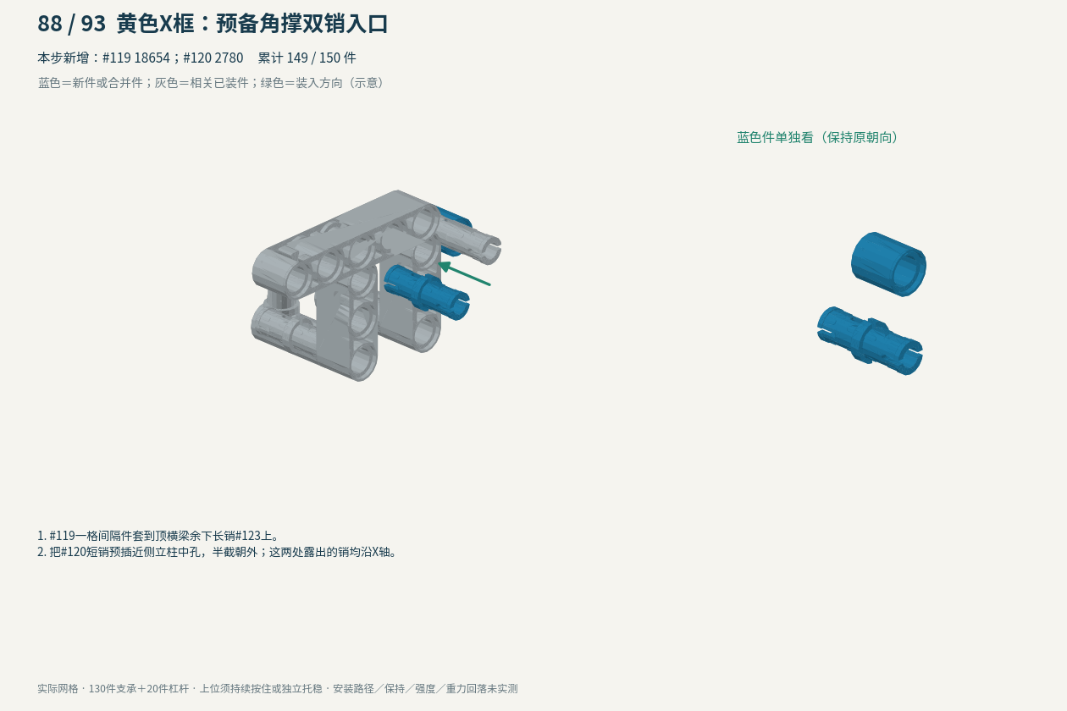
[picture p182: page 489]

## 490 / 501 130件支承装配 黄色X框：原生厚L同时接两销

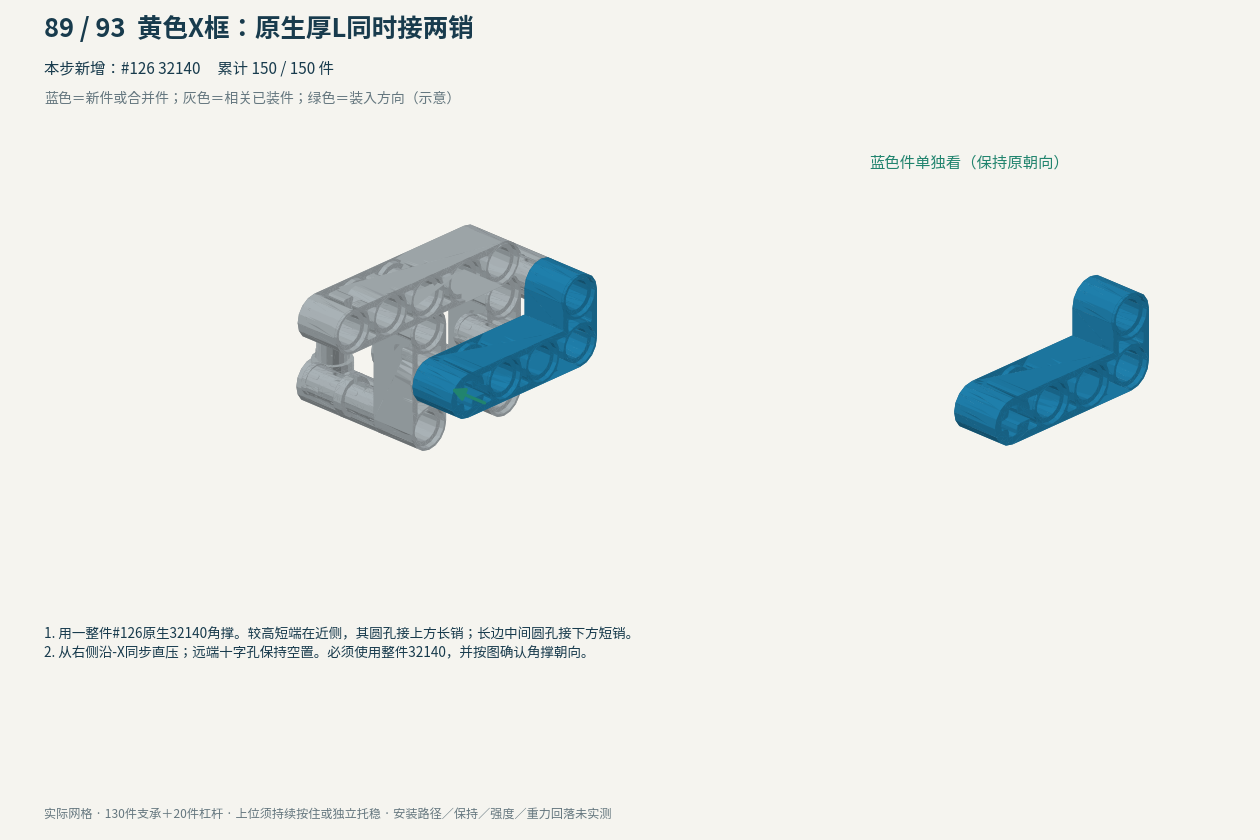
[picture p183: page 490]

## 491 / 501 130件支承装配 合并：完整黄色框从托面下方上插

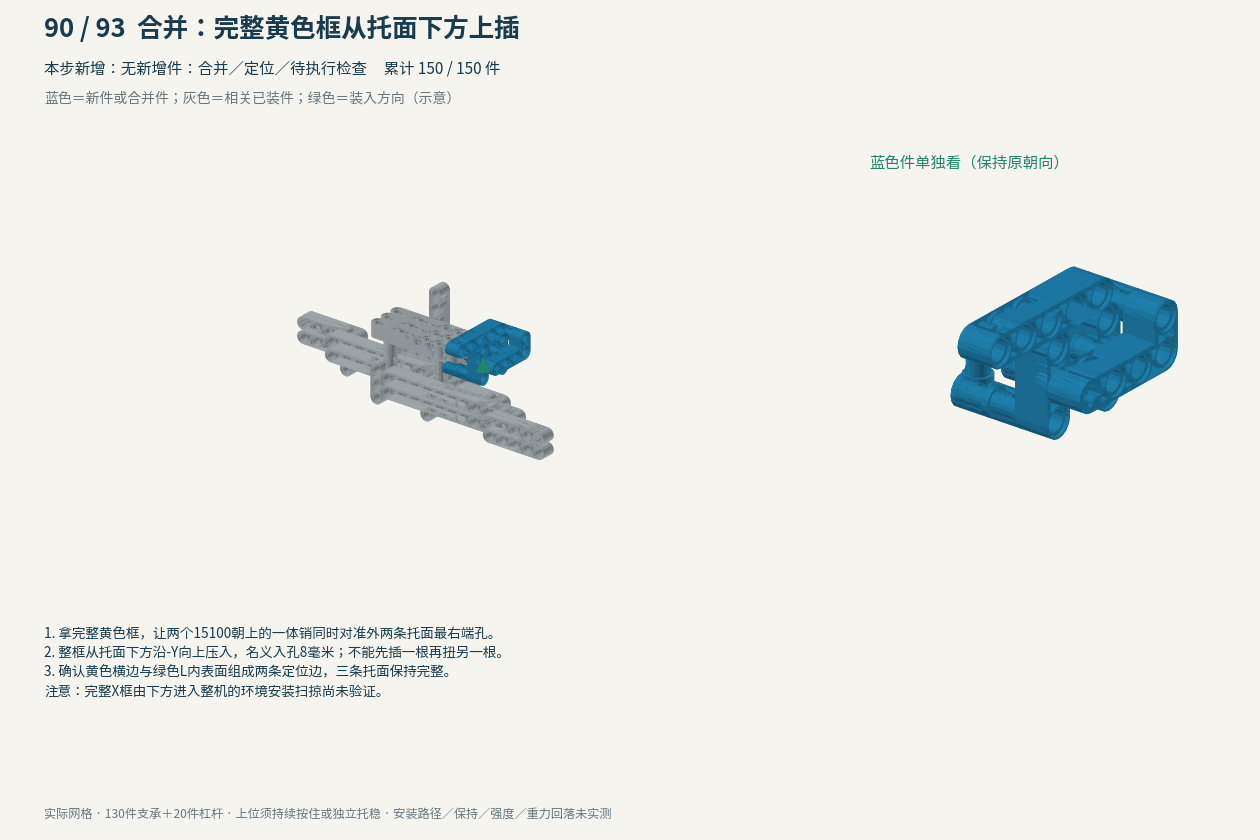
[picture p184: page 491]

## 492 / 501 130件支承装配 130件空托盘：独立支承下检查导轨

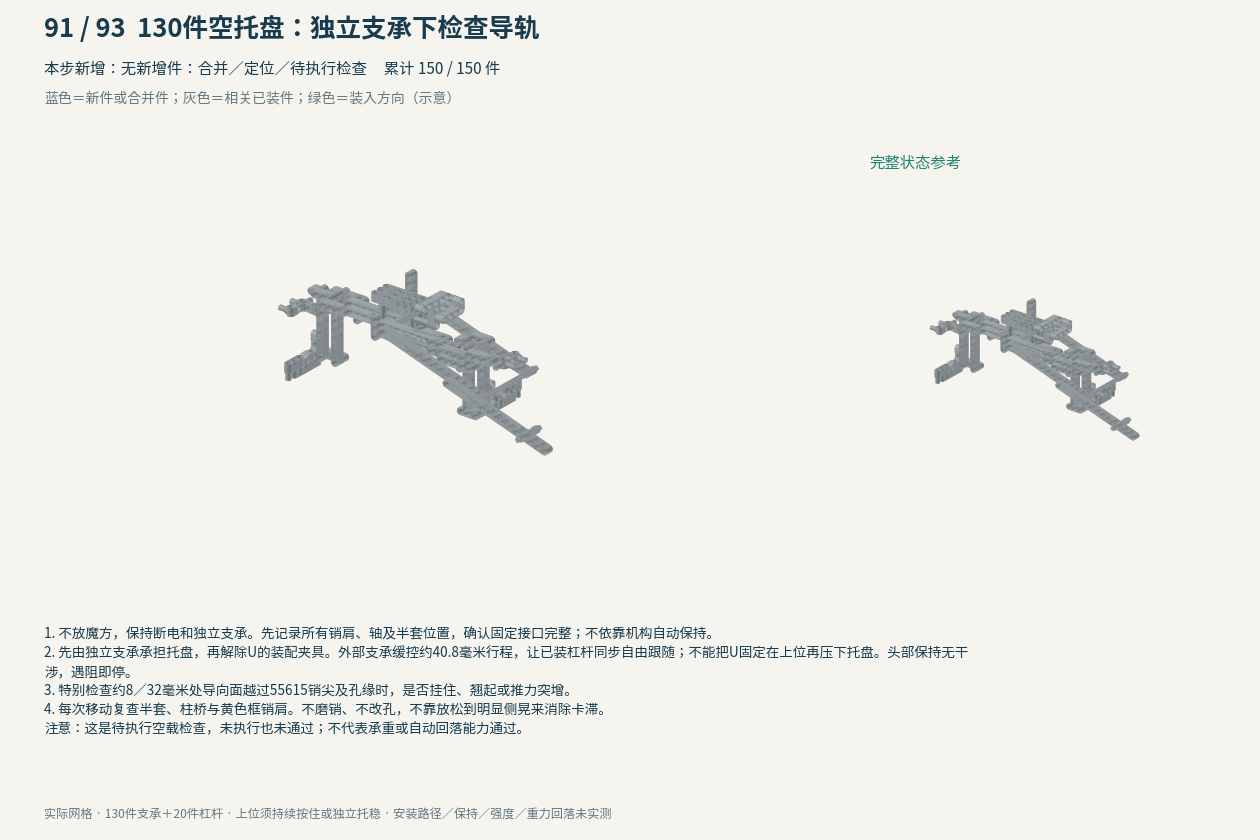
[picture p185: page 492]

## 493 / 501 130件支承装配 130件支承完成后保持空载并检查杠杆

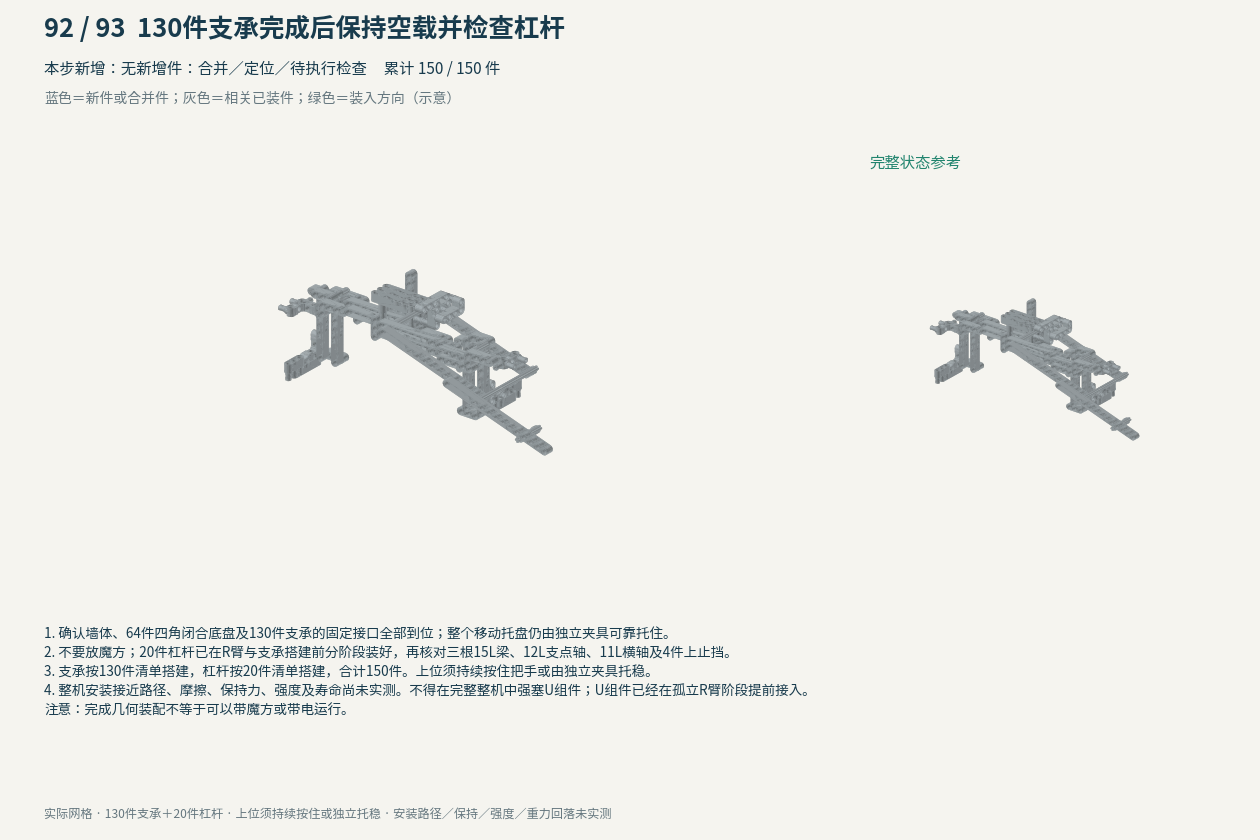
[picture p186: page 493]

## 494 / 501 20件杠杆装配 150件支承总成：空载检查前复核

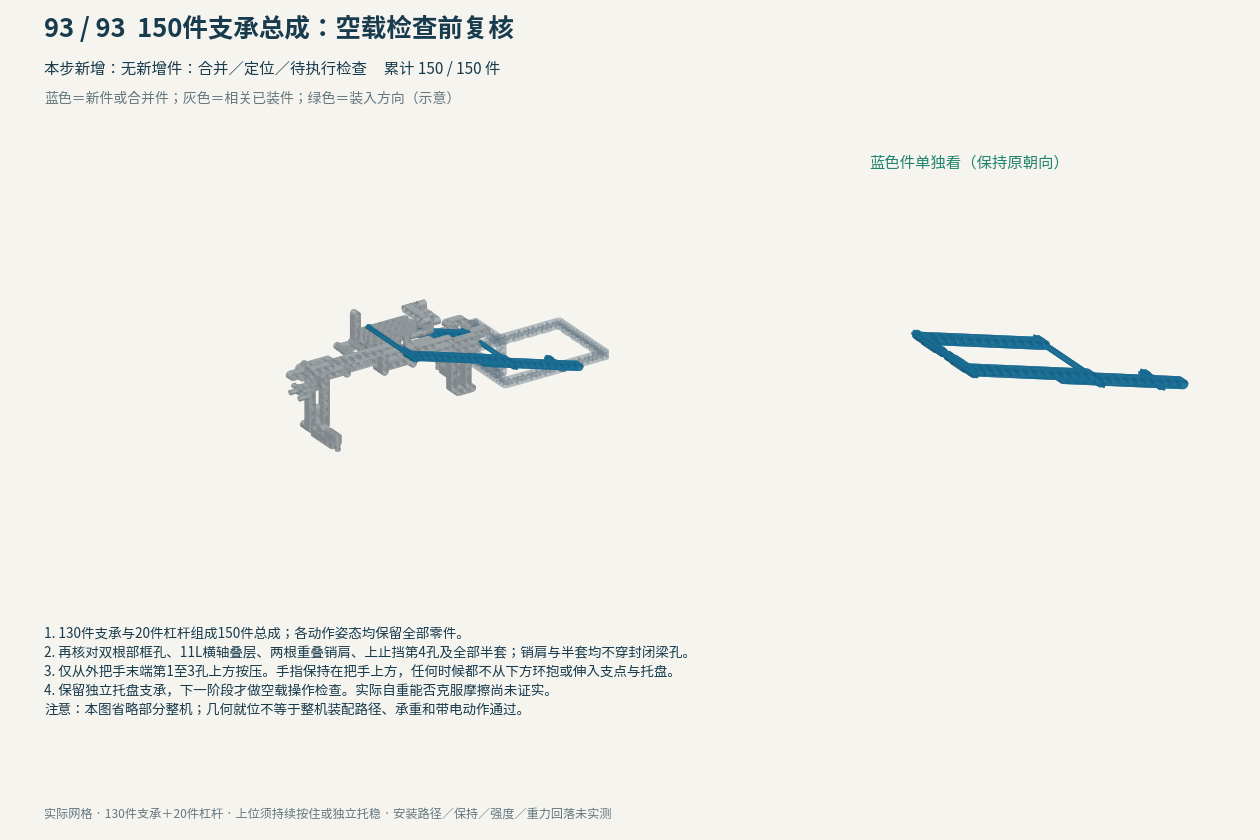
[picture p187: page 494]

## 495 / 501 最终核对 最终整机与20件杠杆核对

64＋668＋130＋20＝882件

1. 所有动作模型均882件；四个39790框通过四个双销L转角 闭合。核对每个转角的两处销连接均已到位。
2. 20件杠杆包括3×32278、2×2780、1×3708、1×23948、 6×32123a、2×62462、2×18654、2×3713、1×3705。外把 手需持续按住才保持上位。
3. 12L支点轴同时穿过原64179的两处支点孔，11L横轴各层 齐全；外把手第4孔为上止挡，末端第1至3孔才是上方按压 区。
4. 原托盘下落约40.8毫米到原导轨下止挡。下位图的杠杆参 数42.4毫米包括1.6毫米接触转换，不能把它当托盘行程。

核对：模型、逐步图、零件表同版；实体完成前仍不放行带 电运行。

真实LDraw网格；爆炸间距仅用于识别，不代表装配间隙或已验证路径。

## 496 / 501 空载操作检查 空载按住与缓松检查

按压区仅为把手末端三孔上方

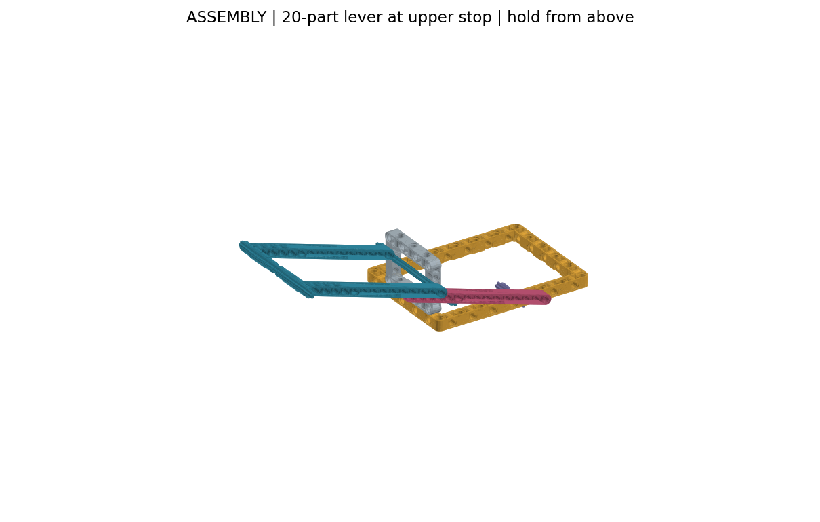
[picture p188: figure]

1. 保持断电、无魔方，并以独立支承作为保护。手只从把手 末端第1至3孔上方施力，手指保持在把手上表面以上。
2. 缓慢向下按把手，托盘被托到名义上位，3713上止挡接触 原39790实体上表面。到位后只保持必要按压力，不能猛压 止挡。
3. 缓慢减小按压力，观察空托盘是否在自重下平顺回落到原 导轨约40.8毫米下挡。出现不回落、卡滞、歪斜或突然落下 ，恢复独立支承并停止。
4. 裸机构最小离桌约9毫米；此处是夹手危险区，不是可伸 手的安全间隙。不从下方握住把手，不把手伸入支点、托盘 或桥梁之间。

核对：几何和碰撞抽样不证明重力一定复位，也不证明下降 阻尼或冲击强度。

真实LDraw网格；爆炸间距仅用于识别，不代表装配间隙或已验证路径。

## 497 / 501 操作关系 装料与机械头接管后再缓松

设计动作关系；不授权带电试机

1. 通过另行定义的实体验收后，装料关系为：按住把手让托 盘升到上位并持续保持，在三条完整托面上放56毫米魔方， 轻靠两条定位边。
2. 所有手和工具退出机械头运动范围之后，才允许另经验证 的头部夹持交接。不要把手伸到正在驱动或仍带电的机械头 旁。
3. 确认机械头已可靠接管魔方的重量后，才缓慢减小把手按 压力，让空托盘按重力回落。不得先松把手再等待机械头夹 紧。
4. 本册没有证明夹持力、空载自返、冲击、控制联锁或同时 手动／电动操作安全；没有这些验证时，不执行带魔方或带 电流程。

核对：按住是持续动作；该机构没有自动保持，上止挡不能 代替锁扣。

真实LDraw网格；爆炸间距仅用于识别，不代表装配间隙或已验证路径。

## 498 / 501 操作关系 取回魔方先抬升并持续按住

托盘承接后释放夹持；取走后才松把手

1. 采用另行验证的取回姿态；手、工具和其他身体部位须先 避开机械头运动区，电机运动时不得伸手靠近。
2. 按住把手抬升托盘，持续保持，直到托盘确实承接魔方重 量。不能仅看几何位置就认定已承接。
3. 托盘可靠承接后，再按经验证的控制流程解除头部夹持。 确认电机停止且安全断能后，从允许的路径取走魔方，同时 仍按住把手。
4. 魔方完全取走后，才缓慢减小按压力让空托盘回落。禁止 在魔方尚未取走时先松开。

核对：承接、解除夹持和取走的顺序不可省略；任何不确定 先恢复可靠支承。

真实LDraw网格；爆炸间距仅用于识别，不代表装配间隙或已验证路径。

## 499 / 501 证据与限制 上止挡与高度需要实测

0.14毫米仅为网格敏感性探测尺度

1. 4件上止挡在名义上位接触原框实体面；原导轨提供约40.8 毫米下端点。这只确定名义几何关系。
2. 约0.14毫米来自LDraw轴套多边形网格随相位变化的保守 敏感性探测。它不是实体圆轴套的周期性高度变化，也不是 实际公差等级或校准误差。
3. 实体需以同一固定基准记录空载、加载和卸载高度、左右 高差、回落情况、销与半套位移，并验证止挡、根轴、框架 和横轴的强度。
4. 没有已给定或已通过的载荷、拉脱力、寿命、下降速度及 冲击验收限值，不得从名义间隙推断性能合格。

核对：上止挡磨损、框弯曲、半套外爬或冲击均需独立检查。

真实LDraw网格；爆炸间距仅用于识别，不代表装配间隙或已验证路径。

## 500 / 501 安全与试验 夹指开角与整头回转分别核对

夹指名义夹紧端约3.8417°；正常张开不超过25°

1. 夹指行程0对应名义夹紧端，夹指角约3.8417°；不要把它 写成夹指角0°。
2. 夹指正常最大开角为25°。整头回转的0°、50°和90° 属于另一运动轴，不能混用。
3. 不把约30.872°自然端点当机械限位、归零基准或带电命 令。
4. 只在可靠支承和断电条件下检查，禁止硬掰夹指反驱传动。 实际夹持力、保持与控制联锁另行验收。

核对：角度与运动轴均已辨认；任何卡滞、异常松动或轴套 爬移均须停止。

真实LDraw网格；爆炸间距仅用于识别，不代表装配间隙或已验证路径。
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
