gonewx/quadcuber/generated/electronics/release-preflight/ENG-POWER-CONTROLLER-NO-EV3-v1/SUPERSEDED_NOT_FOR_MANUFACTURE.txt

Historical candidate for old PCB aa17fa9b. Superseded by v2-JLC. Do not manufacture using this set.
