gonewx/quadcuber/artifacts/head-frame-prototype/assembly.png

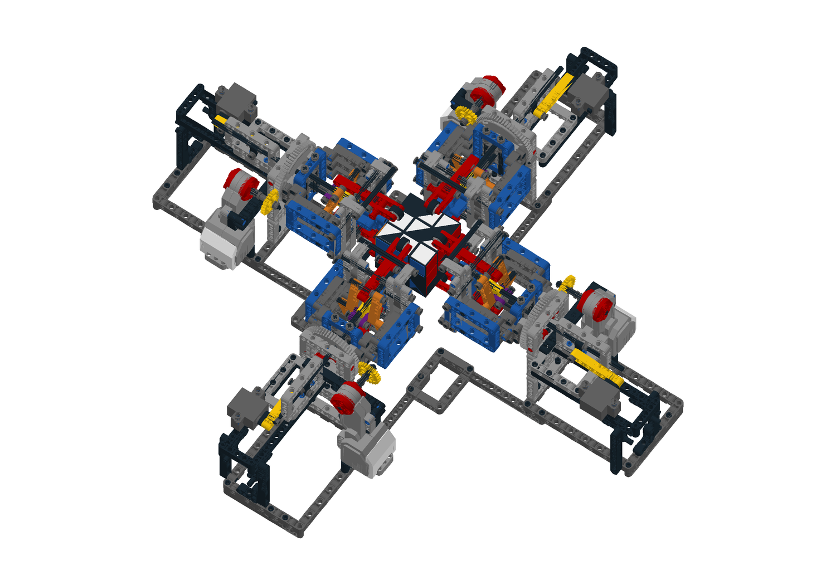
artifacts/head-frame-prototype/assembly.png
