gonewx/quadcuber/docs/lego/img/step01.png

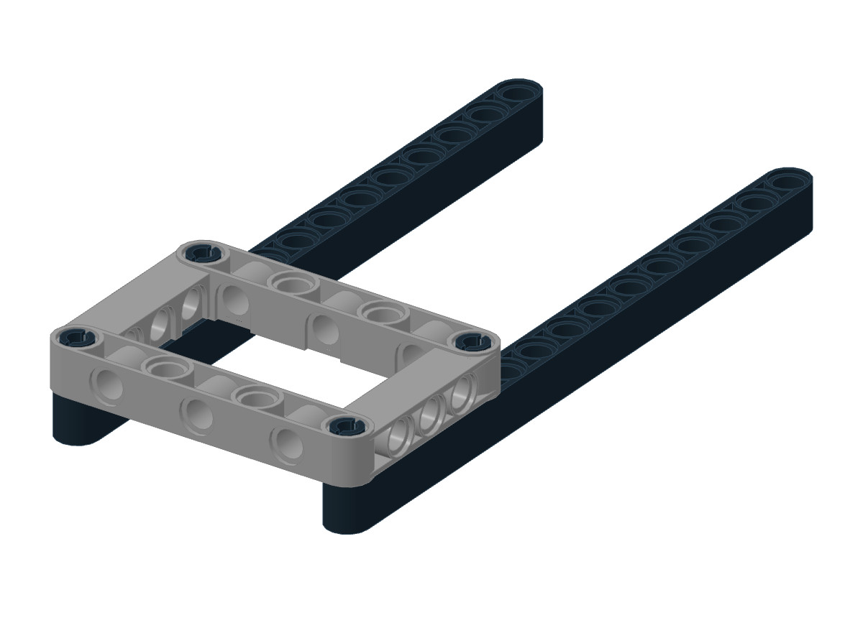
docs/lego/img/step01.png
