gonewx/quadcuber/docs/lego/img/step02.png

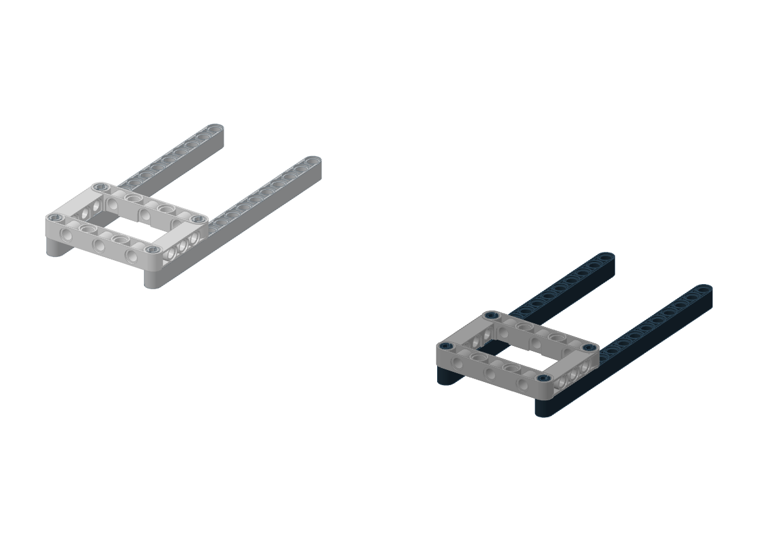
docs/lego/img/step02.png
