gonewx/quadcuber/docs/lego/img/step03.png

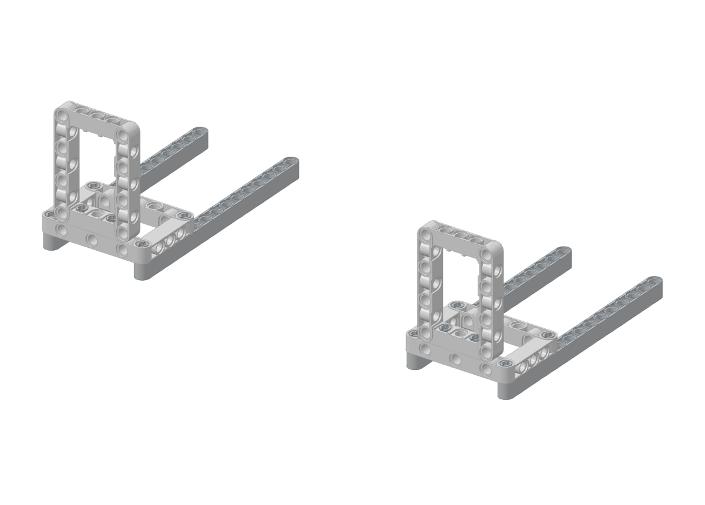
docs/lego/img/step03.png
