gonewx/quadcuber/docs/lego/img/step04.png

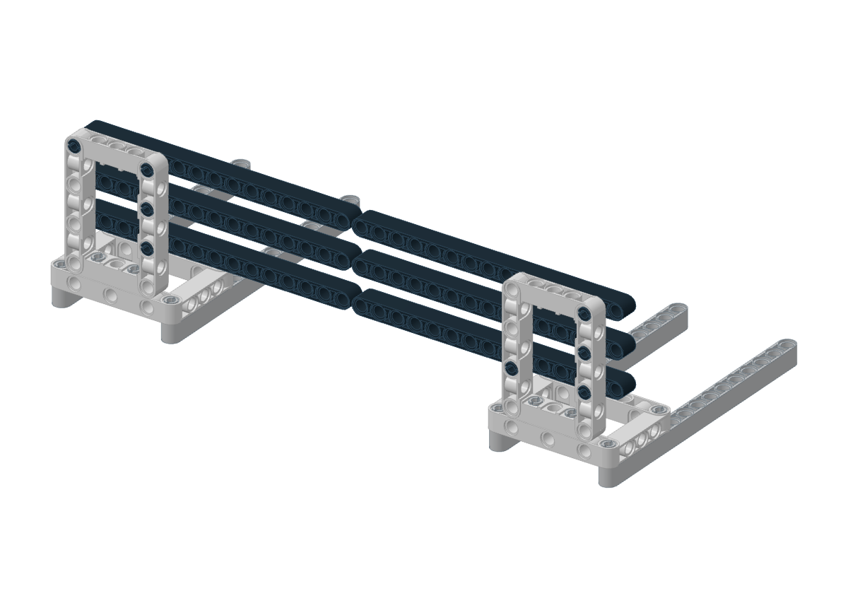
docs/lego/img/step04.png
