gonewx/quadcuber/docs/lego/img/step06.png

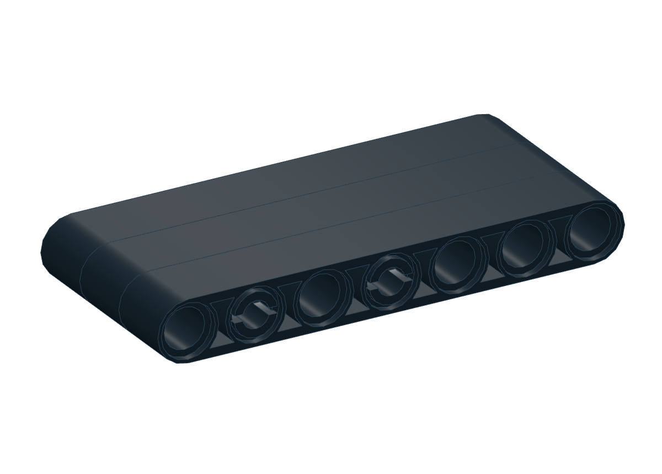
docs/lego/img/step06.png
