gonewx/quadcuber/docs/lego/img/step07.png

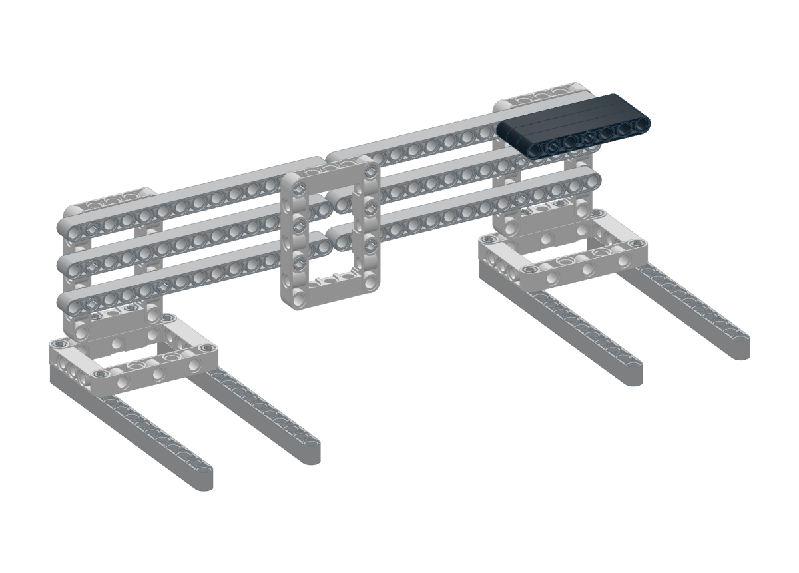
docs/lego/img/step07.png
