gonewx/quadcuber/docs/lego/img/step08.png

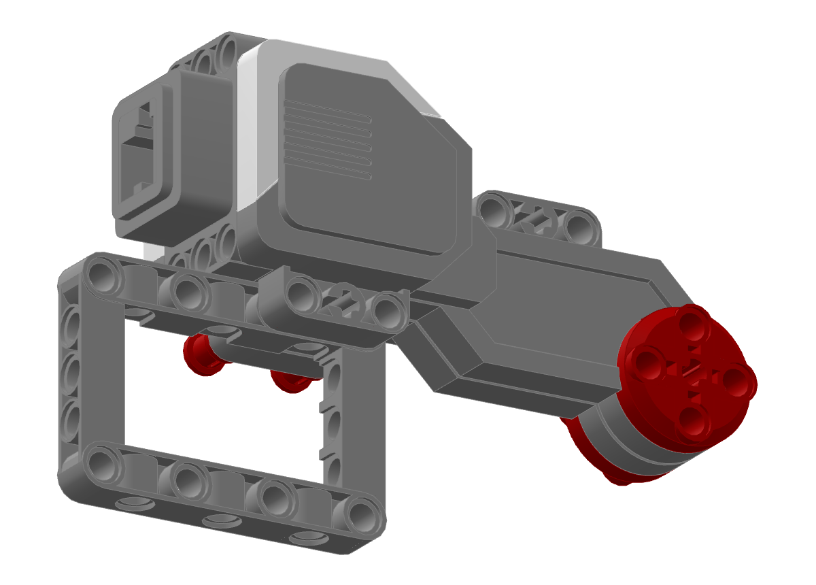
docs/lego/img/step08.png
