gonewx/quadcuber/docs/lego/img/step09.png

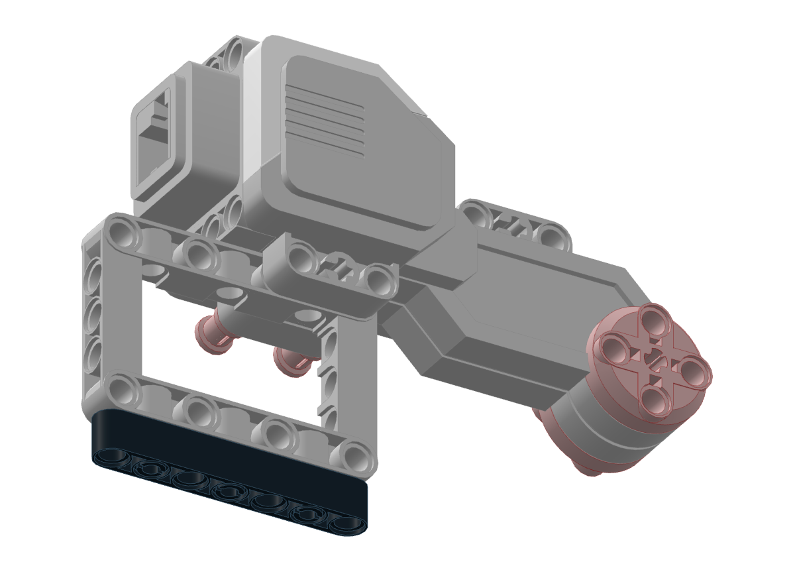
docs/lego/img/step09.png
