gonewx/quadcuber/docs/lego/img/step10.png

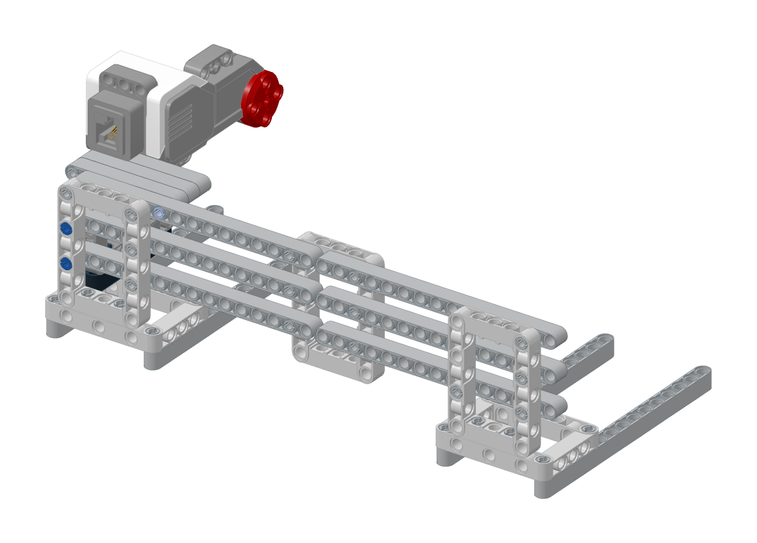
docs/lego/img/step10.png
