gonewx/quadcuber/docs/lego/img/step11.png

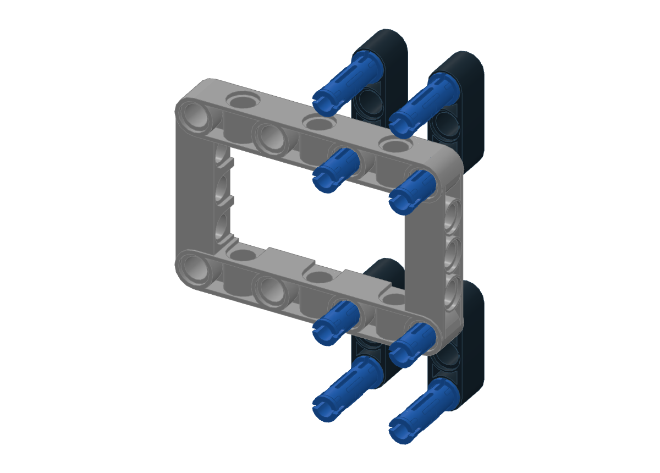
docs/lego/img/step11.png
