gonewx/quadcuber/docs/lego/img/step12.png

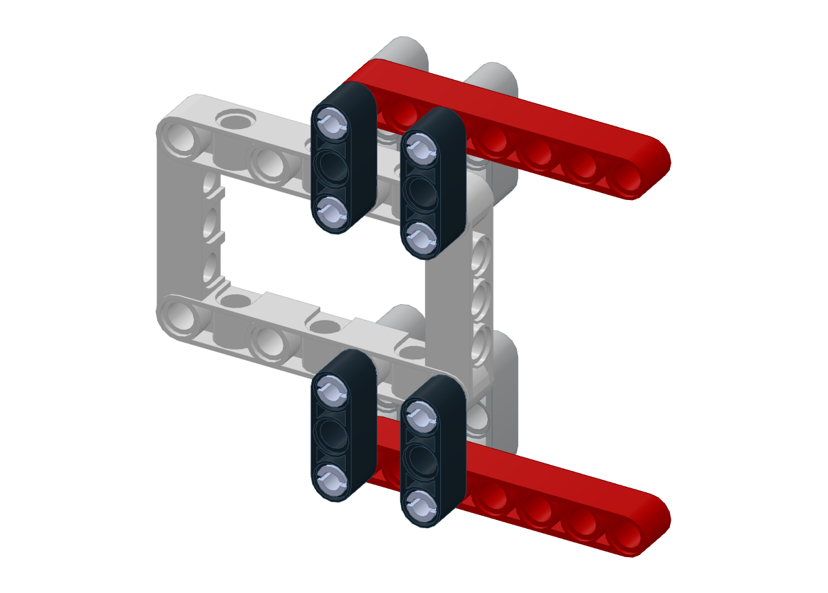
docs/lego/img/step12.png
