gonewx/quadcuber/docs/lego/img/step13.png

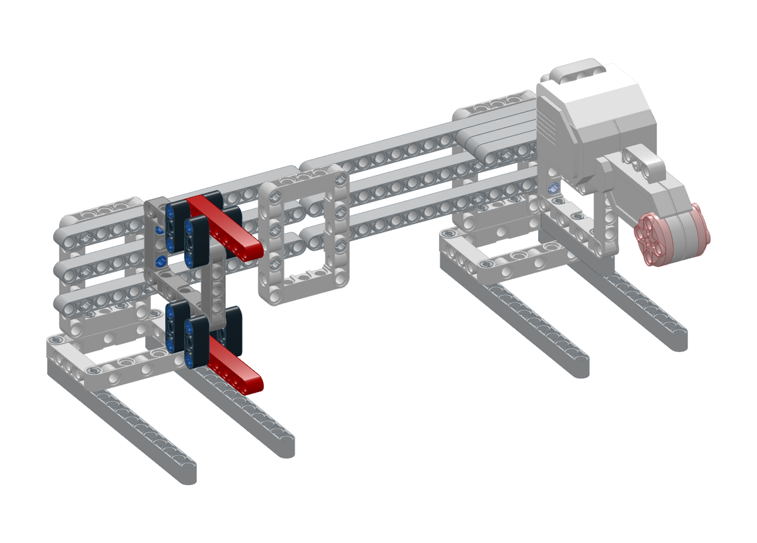
docs/lego/img/step13.png
