gonewx/quadcuber/docs/lego/img/step14.png

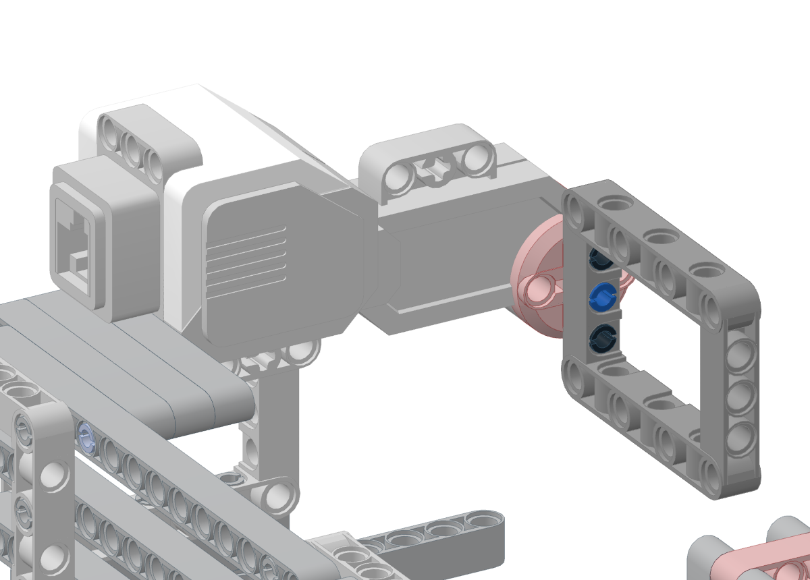
docs/lego/img/step14.png
