gonewx/quadcuber/docs/lego/img/step15.png

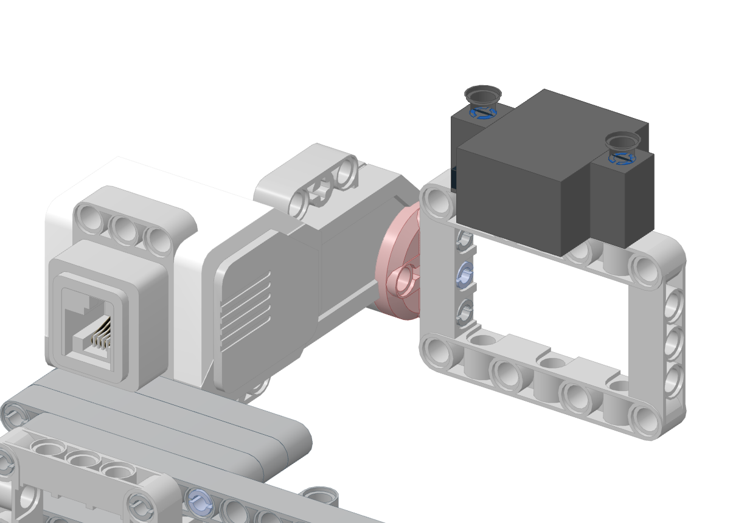
docs/lego/img/step15.png
