gonewx/quadcuber/docs/lego/img/step16.png

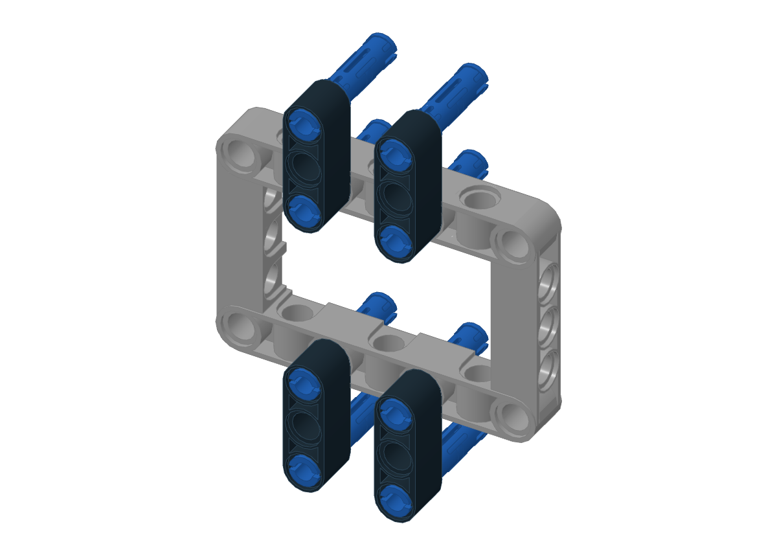
docs/lego/img/step16.png
