gonewx/quadcuber/docs/lego/img/step17.png

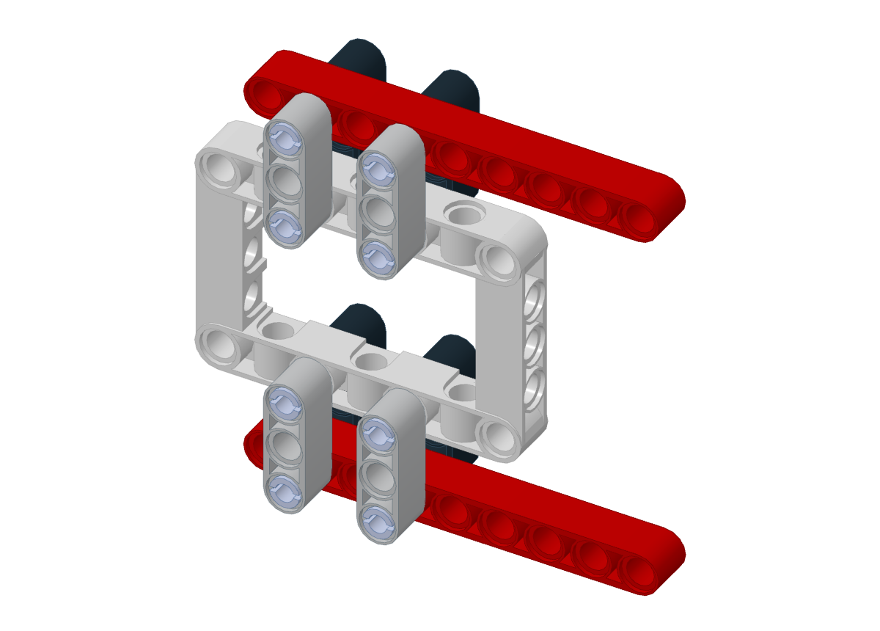
docs/lego/img/step17.png
