gonewx/quadcuber/docs/lego/img/step18.png

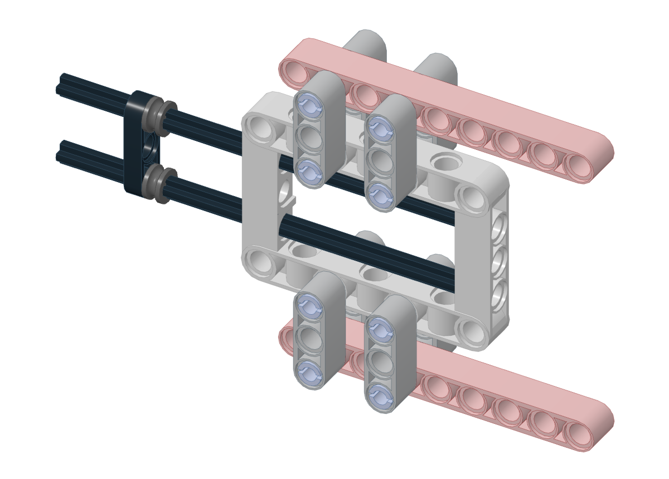
docs/lego/img/step18.png
