gonewx/quadcuber/docs/lego/img/step19.png

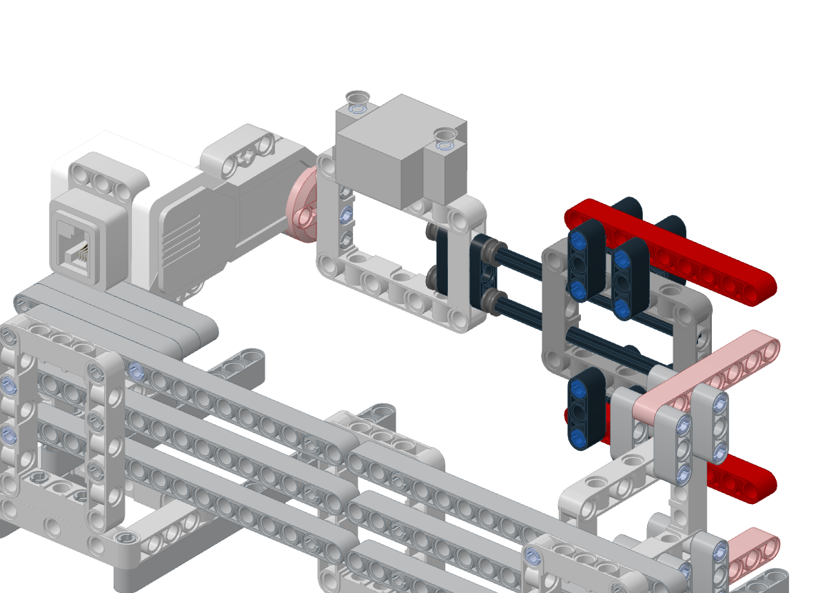
docs/lego/img/step19.png
