gonewx/quadcuber/docs/lego/img/step20.png

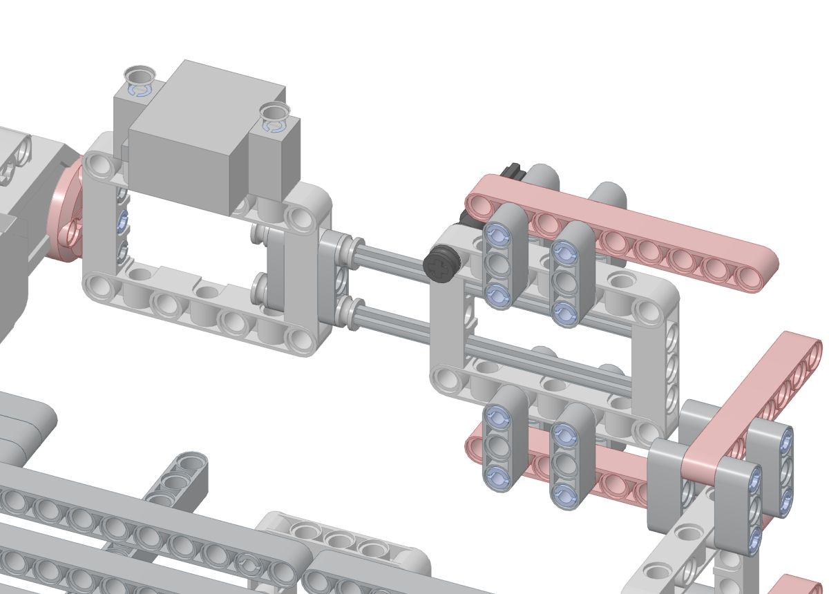
docs/lego/img/step20.png
