gonewx/quadcuber/docs/lego/img/step22.png

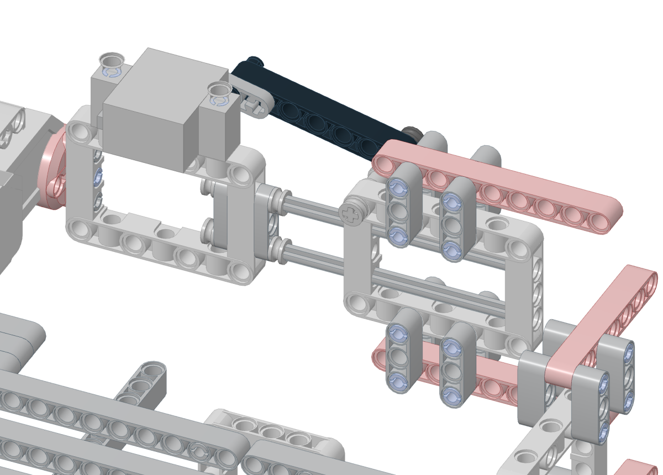
docs/lego/img/step22.png
