gonewx/quadcuber/docs/lego/img/step23.png

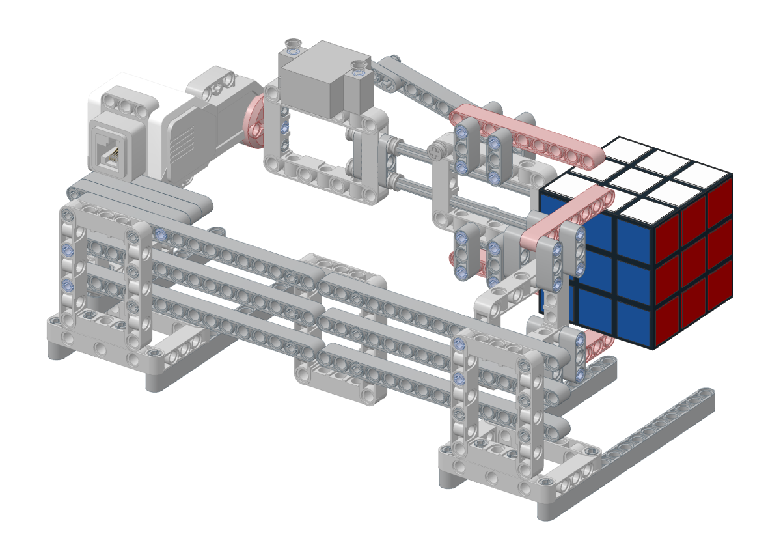
docs/lego/img/step23.png
