gonewx/quadcuber/docs/lego/medium/img/step05.png

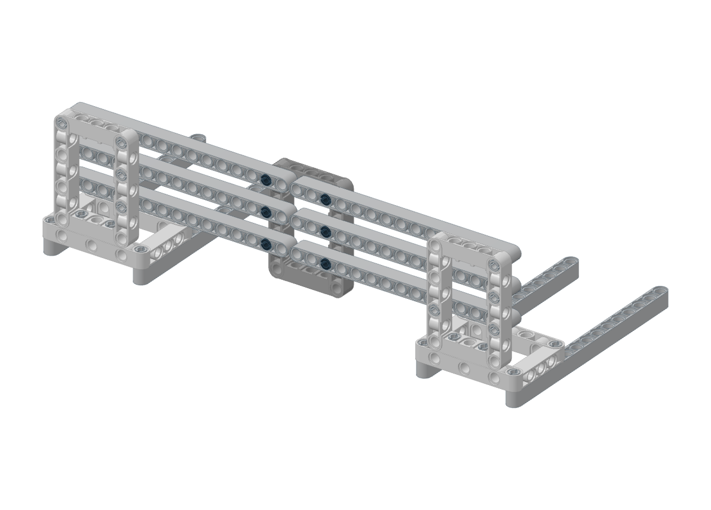
docs/lego/medium/img/step05.png
