gonewx/quadcuber/docs/lego/medium/img/step07.png

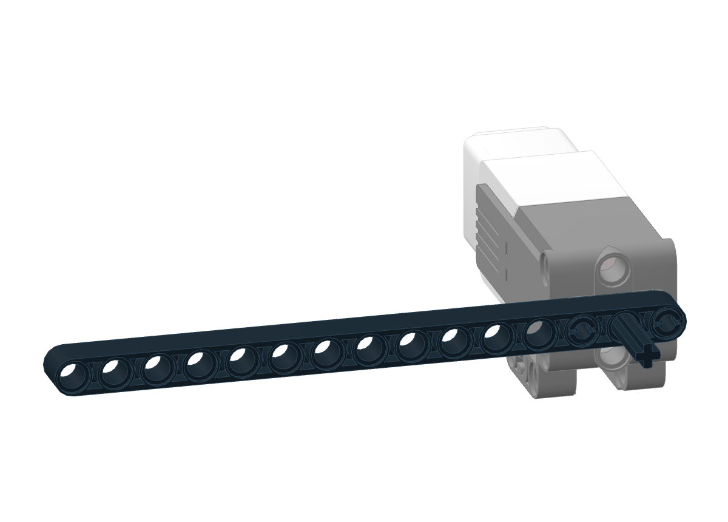
docs/lego/medium/img/step07.png
