gonewx/quadcuber/docs/lego/medium/img/step08.png

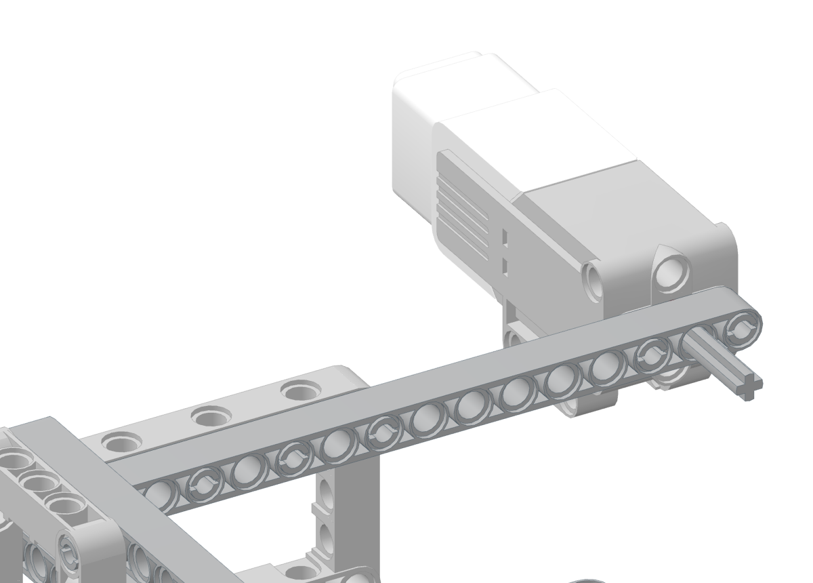
docs/lego/medium/img/step08.png
