gonewx/quadcuber/docs/lego/medium/img/step15.png

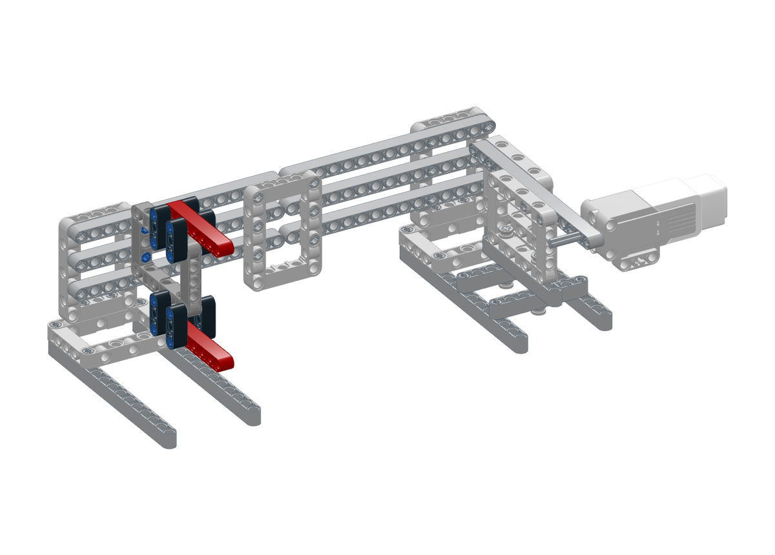
docs/lego/medium/img/step15.png
