gonewx/quadcuber/docs/lego/medium/img/step16.png

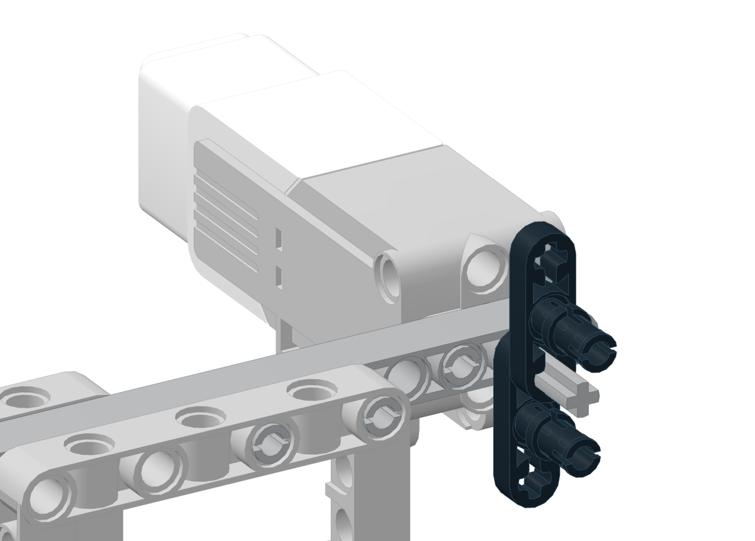
docs/lego/medium/img/step16.png
