gonewx/quadcuber/docs/lego/medium/img/step17.png

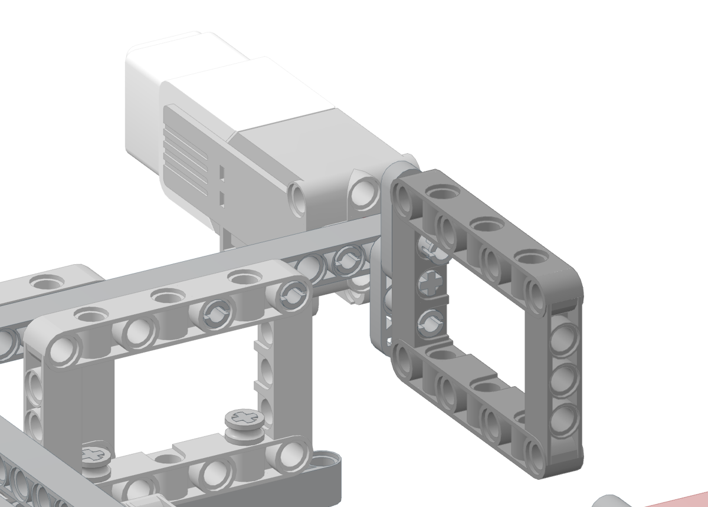
docs/lego/medium/img/step17.png
