gonewx/quadcuber/docs/lego/medium/img/step18.png

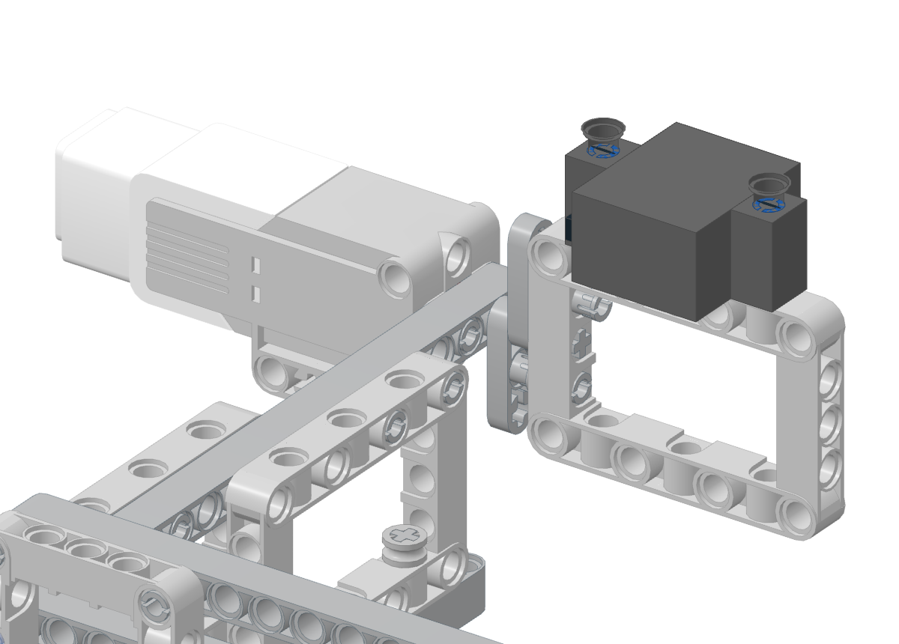
docs/lego/medium/img/step18.png
