gonewx/quadcuber/docs/lego/medium/img/step22.png

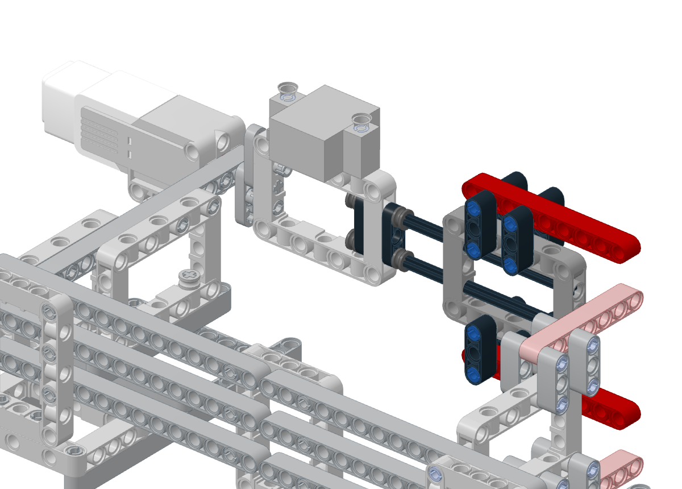
docs/lego/medium/img/step22.png
