gonewx/quadcuber/docs/lego/medium/img/step23.png

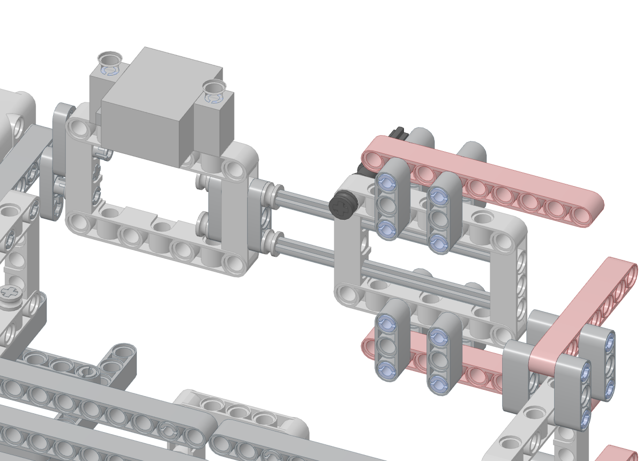
docs/lego/medium/img/step23.png
