gonewx/quadcuber/docs/lego/medium/img/step26.png

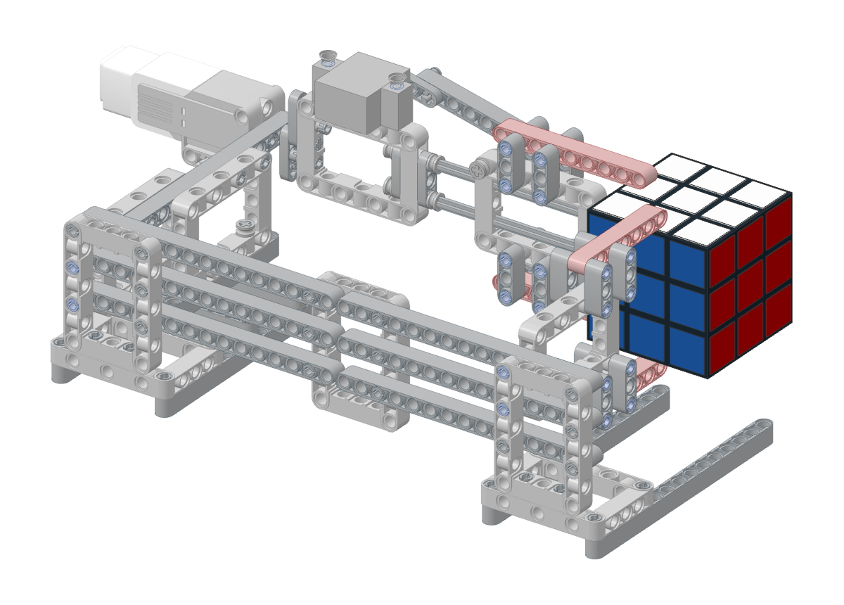
docs/lego/medium/img/step26.png
