gonewx/quadcuber/docs/lego/v3-baseline/img/step01.png

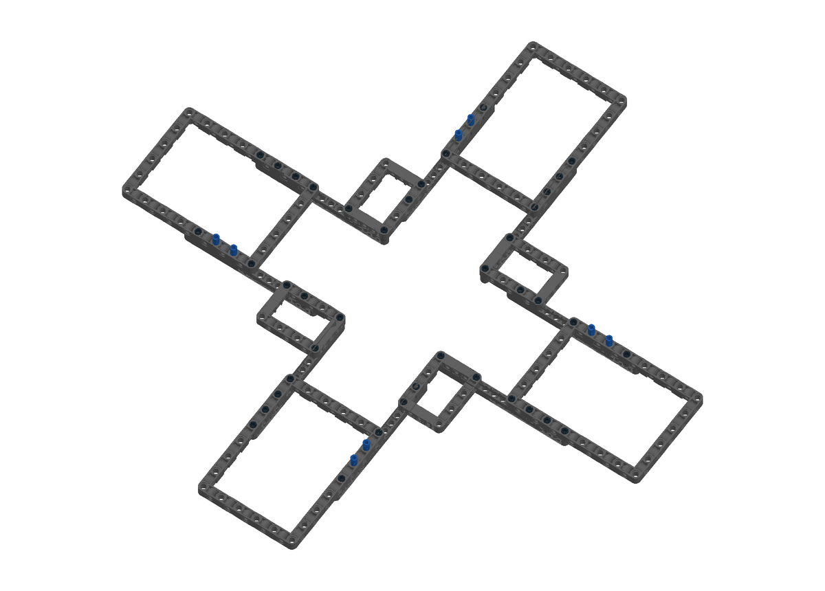
docs/lego/v3-baseline/img/step01.png
