gonewx/quadcuber/docs/lego/v3-baseline/img/step02.png

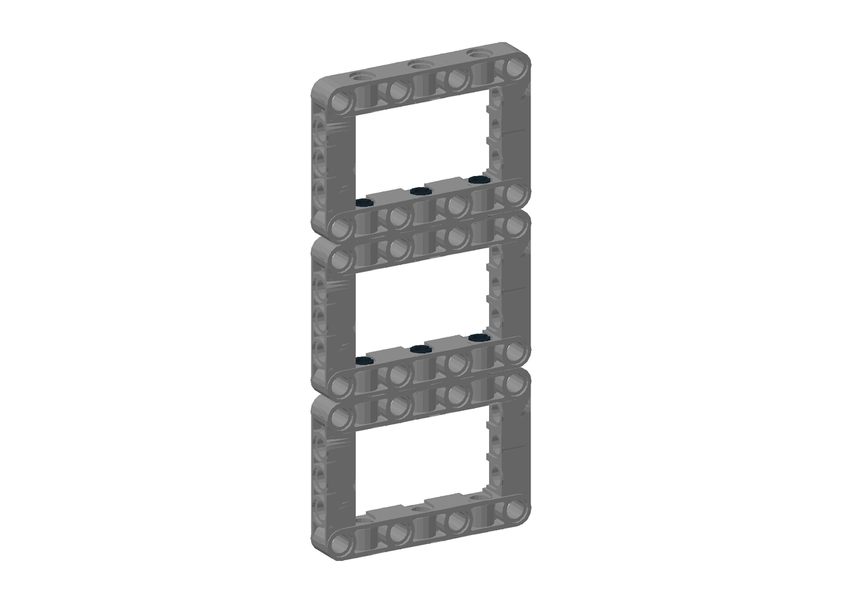
docs/lego/v3-baseline/img/step02.png
