gonewx/quadcuber/docs/lego/v3-baseline/img/step03.png

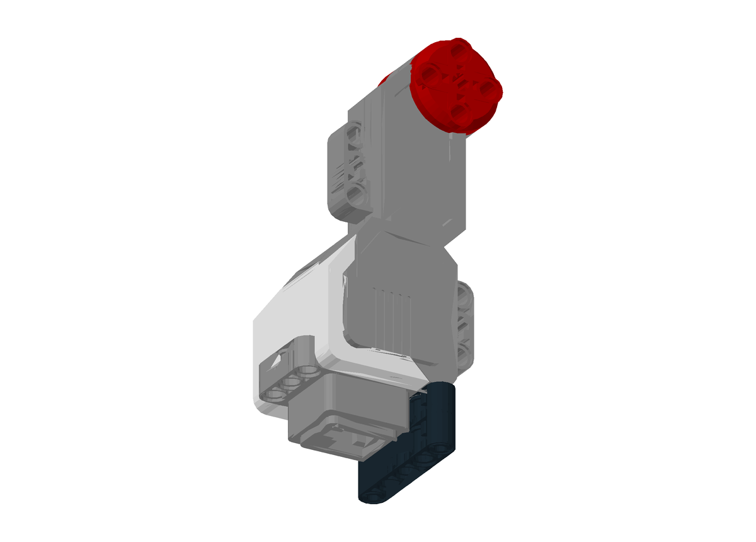
docs/lego/v3-baseline/img/step03.png
