gonewx/quadcuber/docs/lego/v3-baseline/img/step04.png

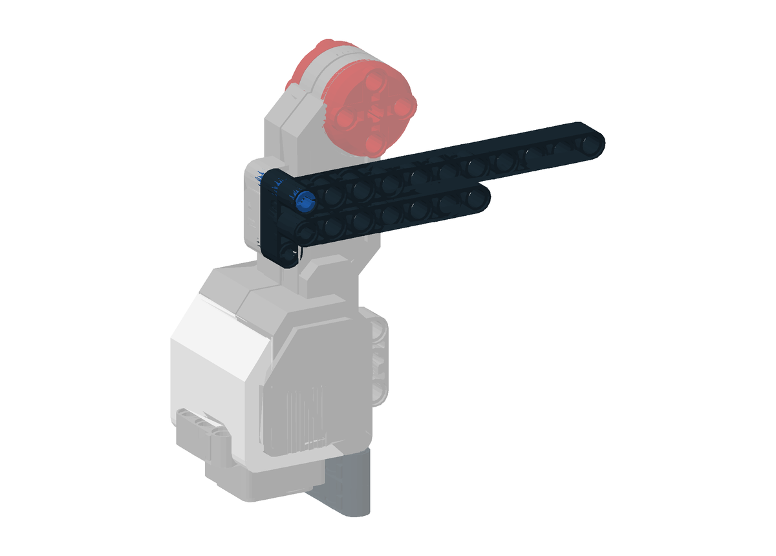
docs/lego/v3-baseline/img/step04.png
