gonewx/quadcuber/docs/lego/v3-baseline/img/step06.png

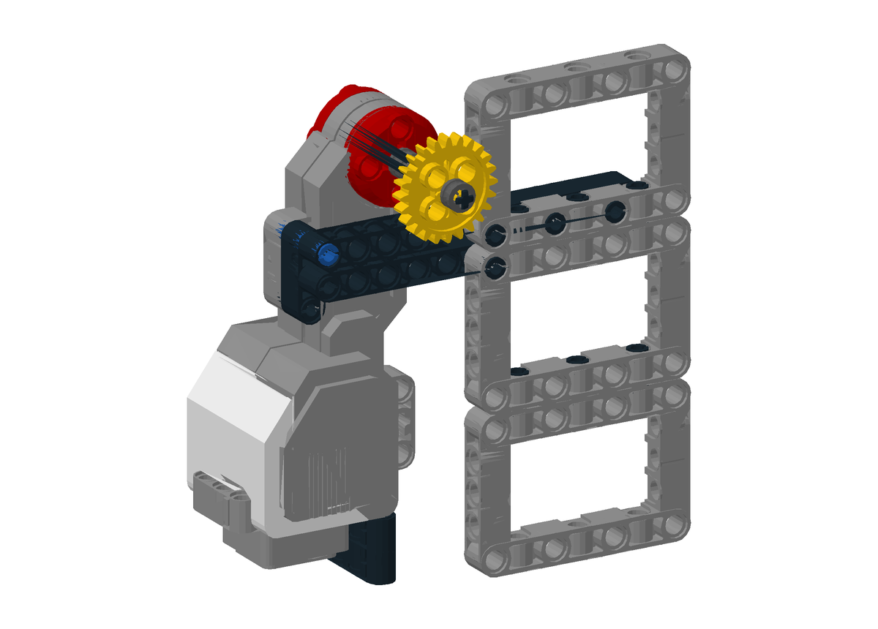
docs/lego/v3-baseline/img/step06.png
