gonewx/quadcuber/docs/lego/v3-baseline/img/step08.png

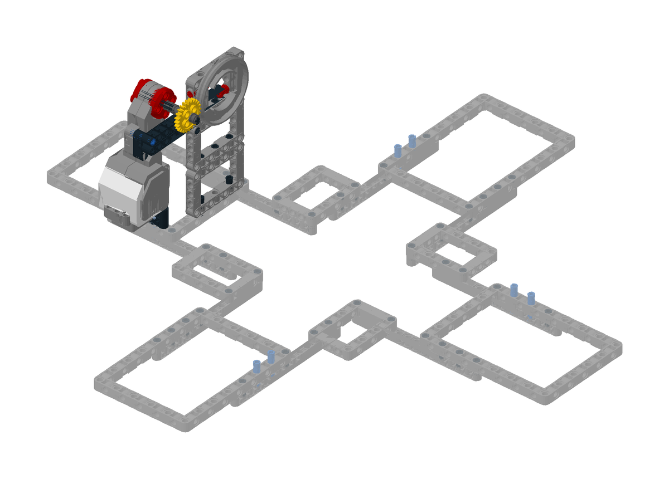
docs/lego/v3-baseline/img/step08.png
