gonewx/quadcuber/docs/lego/v3-baseline/img/step09.png

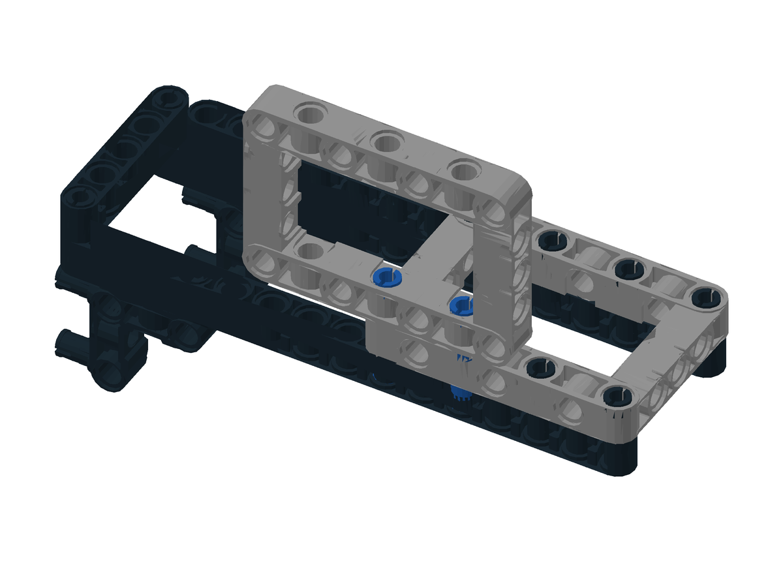
docs/lego/v3-baseline/img/step09.png
