gonewx/quadcuber/docs/lego/v3-baseline/img/step10.png

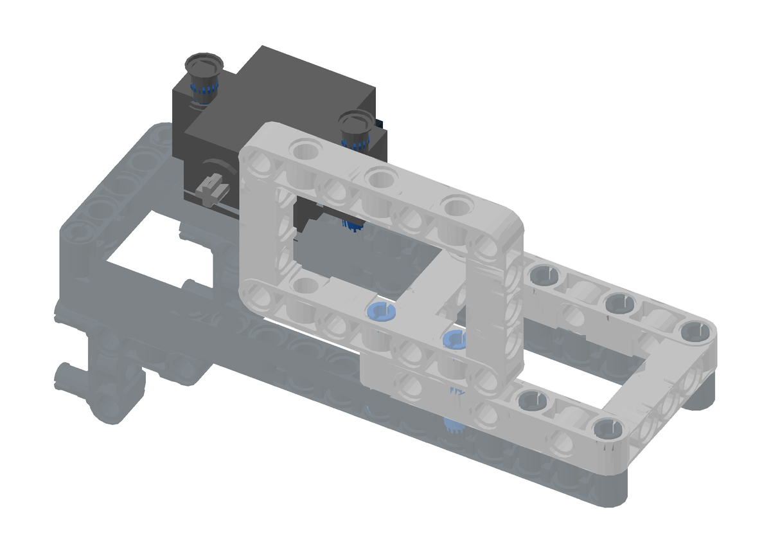
docs/lego/v3-baseline/img/step10.png
