gonewx/quadcuber/docs/lego/v3-baseline/img/step11.png

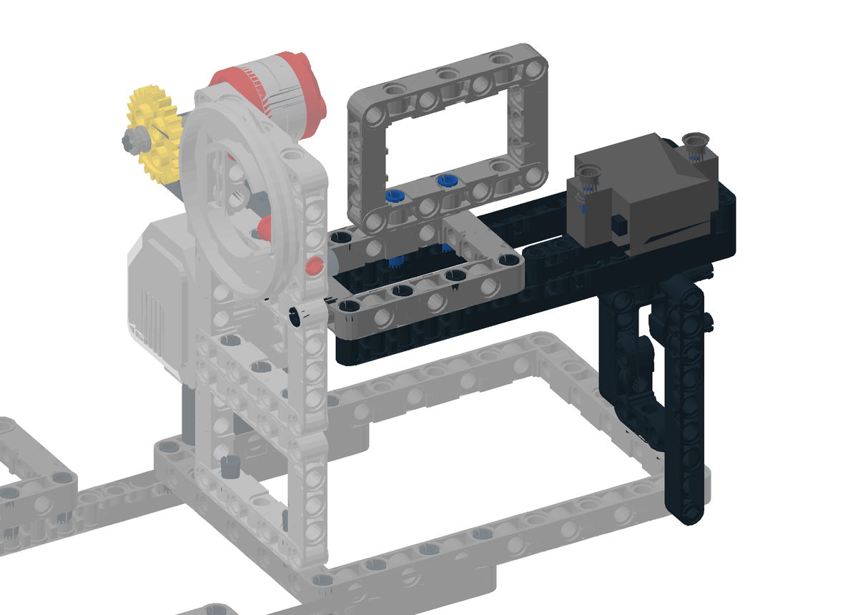
docs/lego/v3-baseline/img/step11.png
