gonewx/quadcuber/docs/lego/v3-baseline/img/step12.png

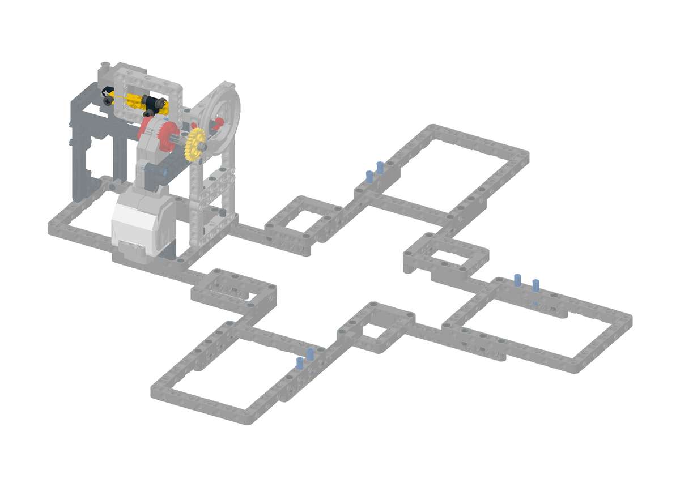
docs/lego/v3-baseline/img/step12.png
