gonewx/quadcuber/docs/lego/v3-baseline/img/step13.png

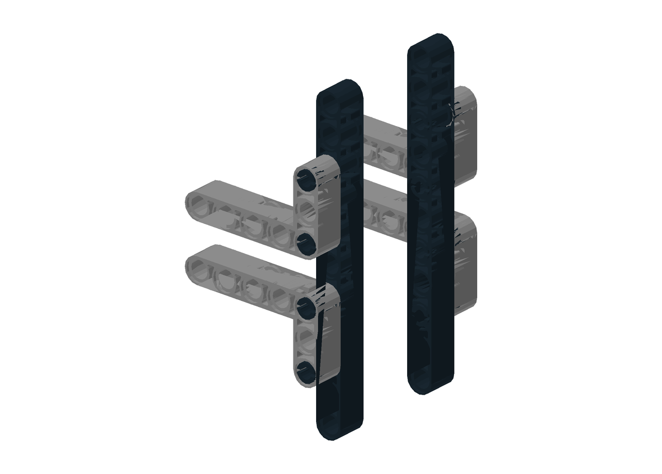
docs/lego/v3-baseline/img/step13.png
