gonewx/quadcuber/docs/lego/v3-baseline/img/step14.png

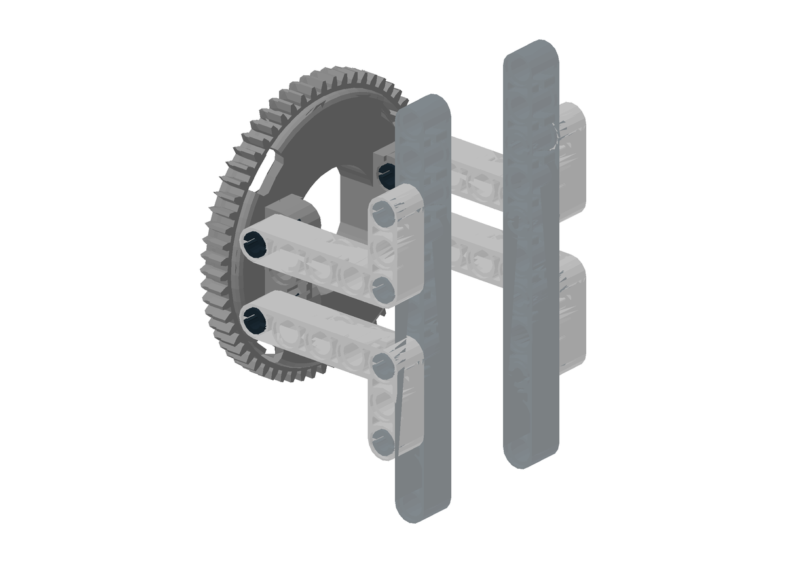
docs/lego/v3-baseline/img/step14.png
