gonewx/quadcuber/docs/lego/v3-baseline/img/step15.png

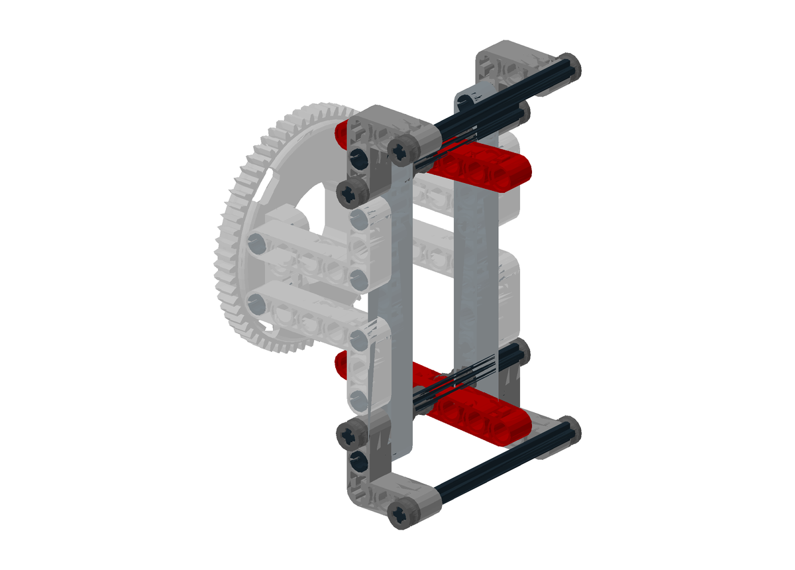
docs/lego/v3-baseline/img/step15.png
