gonewx/quadcuber/docs/lego/v3-baseline/img/step16.png

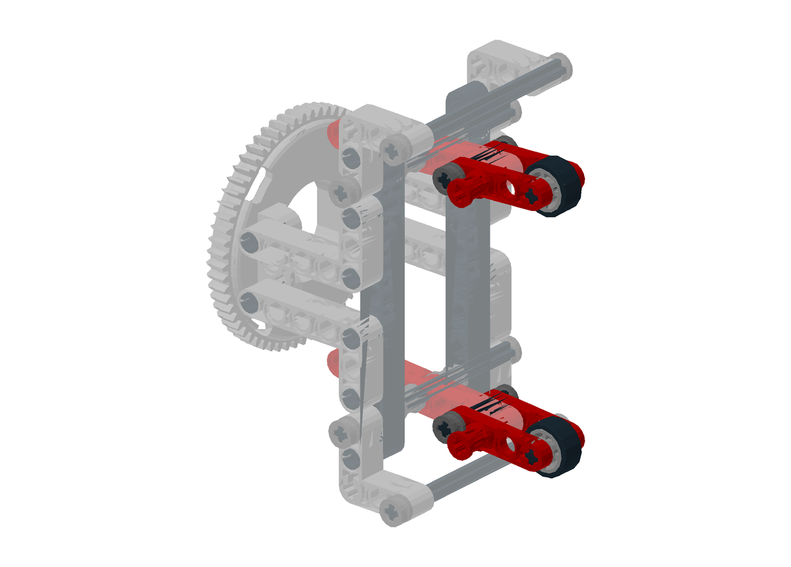
docs/lego/v3-baseline/img/step16.png
