gonewx/quadcuber/docs/lego/v3-baseline/img/step18.png

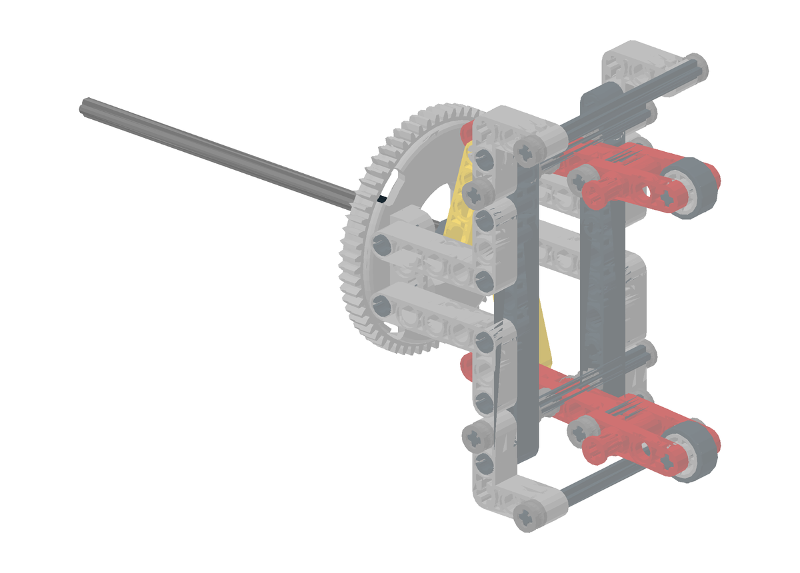
docs/lego/v3-baseline/img/step18.png
