gonewx/quadcuber/docs/lego/v3-baseline/img/step19.png

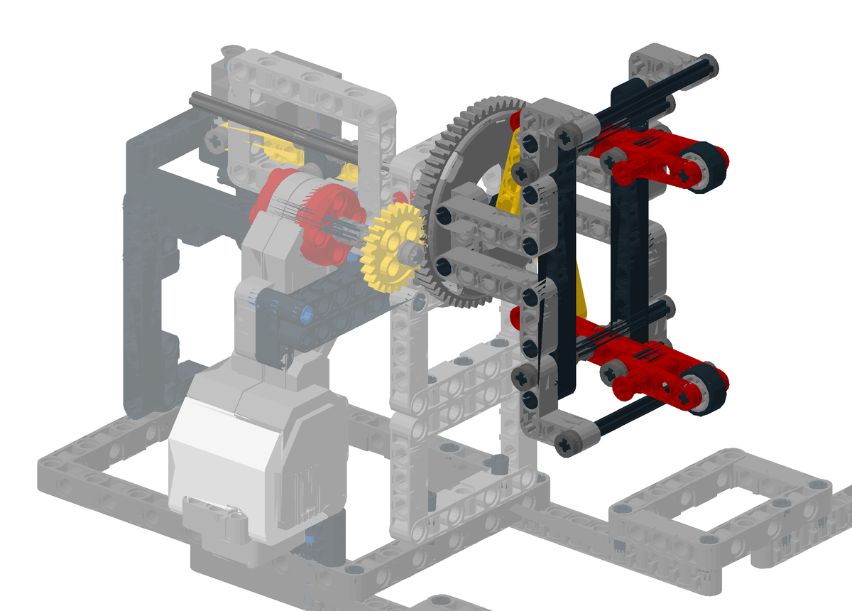
docs/lego/v3-baseline/img/step19.png
