gonewx/quadcuber/docs/lego/v3-baseline/img/step20.png

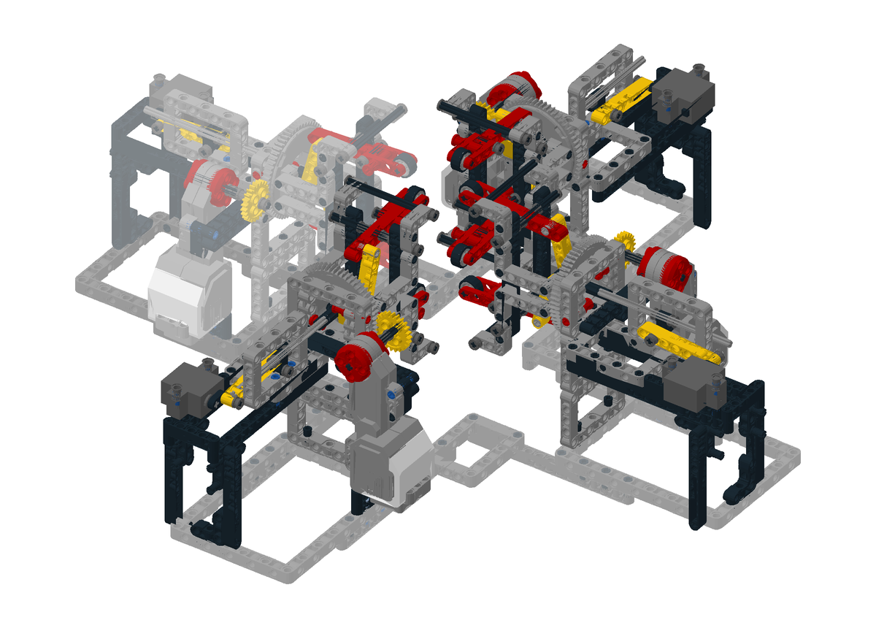
docs/lego/v3-baseline/img/step20.png
