gonewx/quadcuber/docs/lego/v3-baseline/img/step21.png

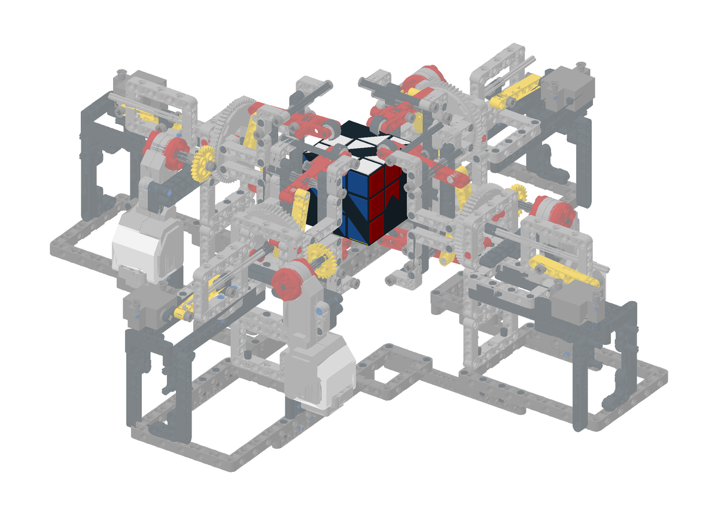
docs/lego/v3-baseline/img/step21.png
