gonewx/quadcuber/docs/measurements/2026-09-28-ev3-medium-installed/photos/IMG_0061.JPG

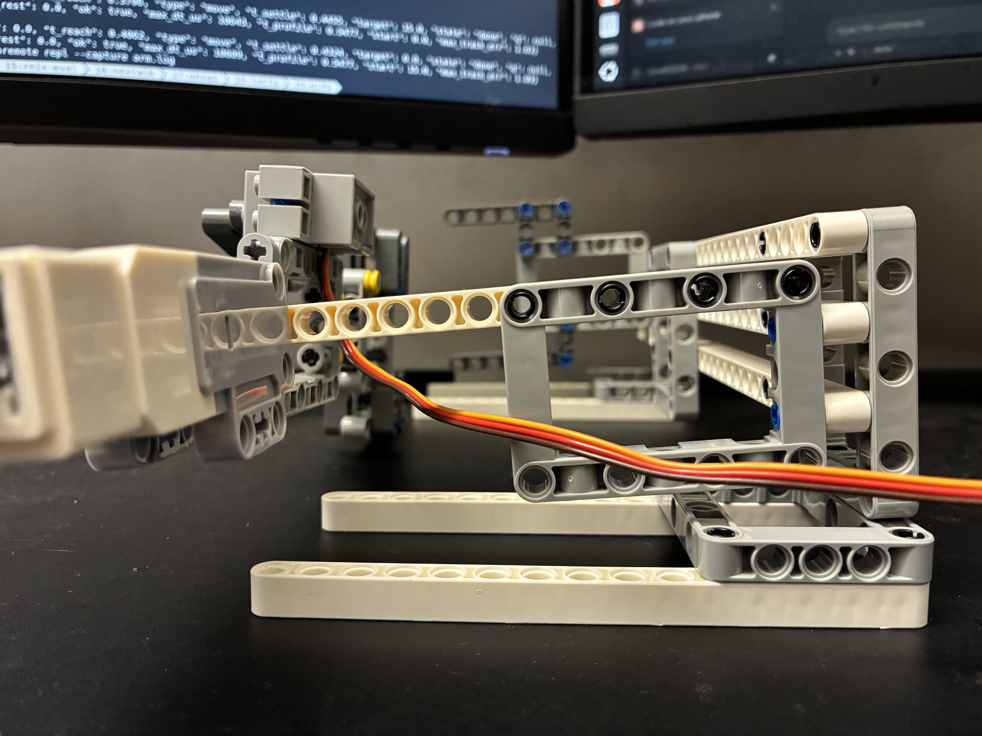
docs/measurements/2026-09-28-ev3-medium-installed/photos/IMG_0061.JPG
