gonewx/quadcuber/docs/wiring/direct-breadboard-rl.png

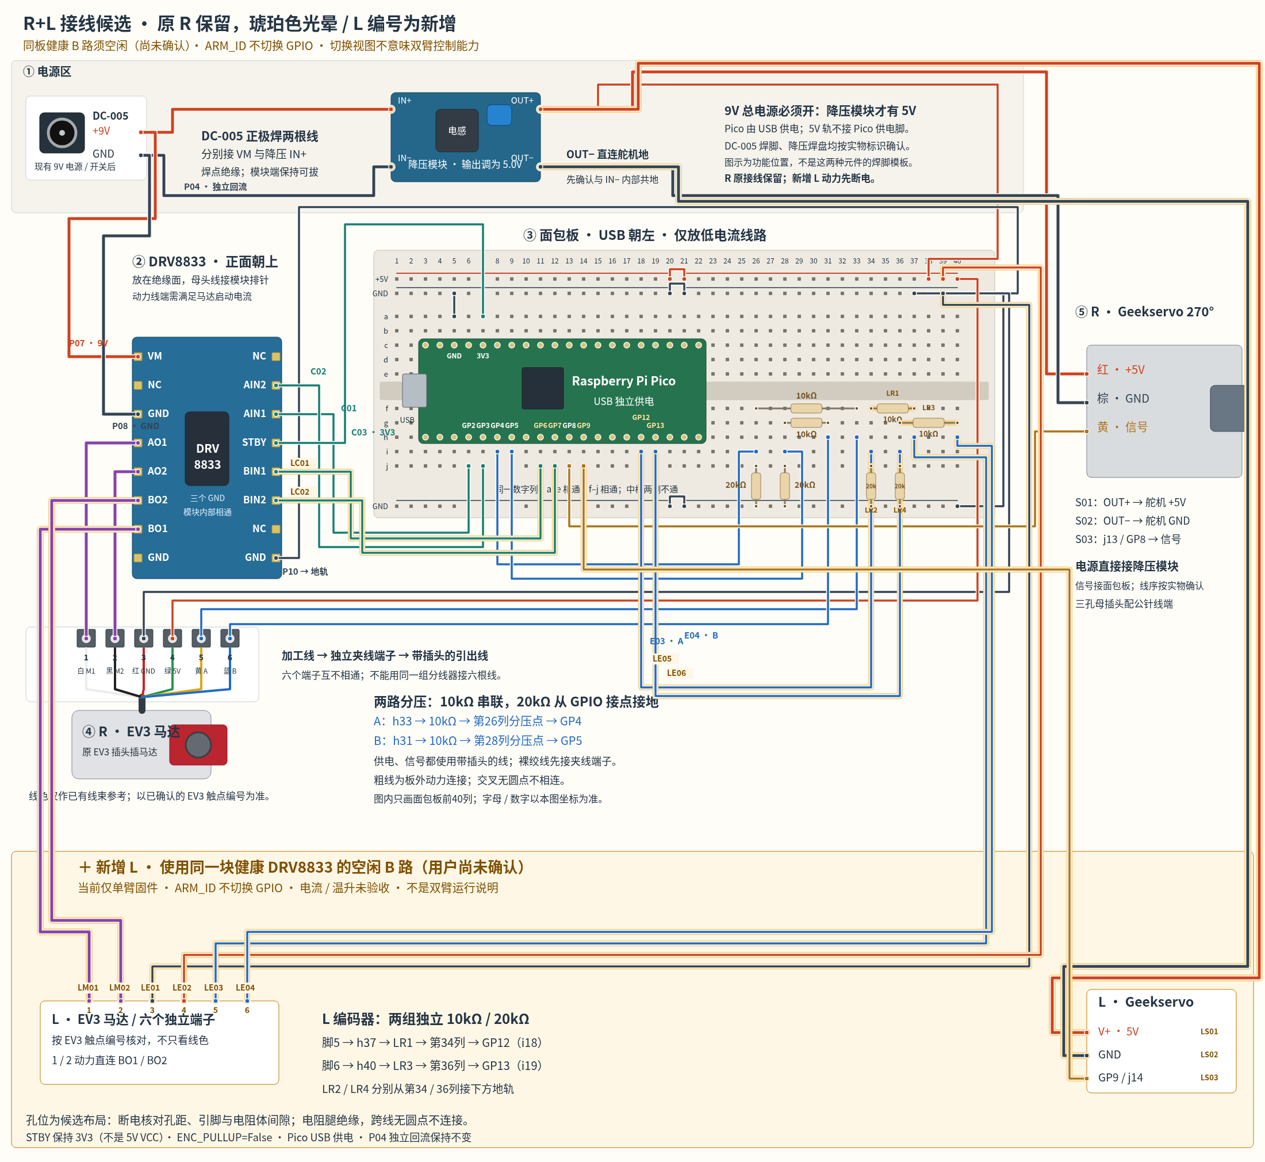
docs/wiring/direct-breadboard-rl.png
