gonewx/quadcuber/docs/wiring/direct-breadboard.png

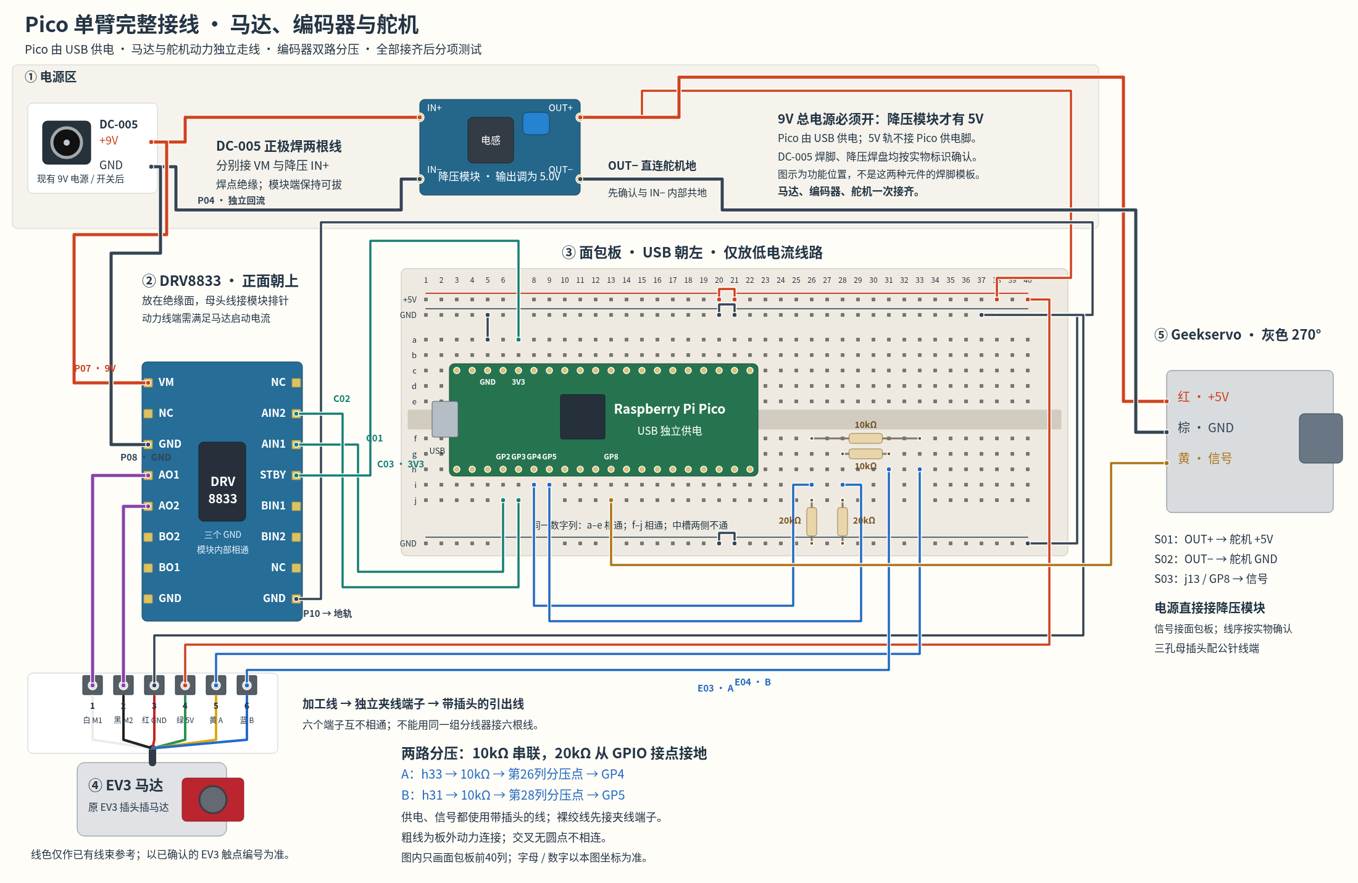
docs/wiring/direct-breadboard.png
