gonewx/quadcuber/generated/electronics/assembly-bottom.png

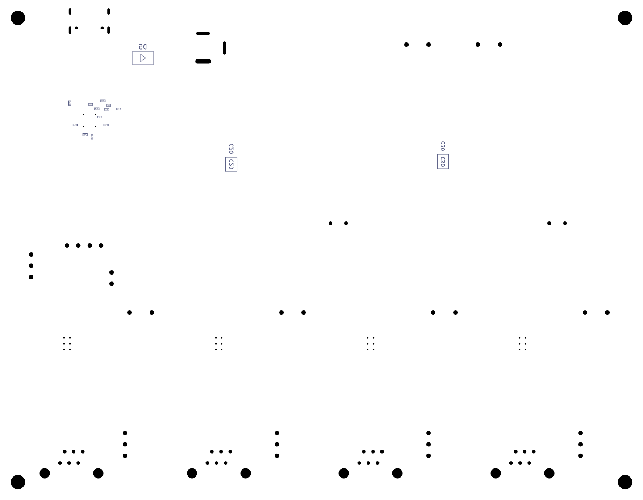
generated/electronics/assembly-bottom.png
