gonewx/quadcuber/generated/electronics/assembly.png

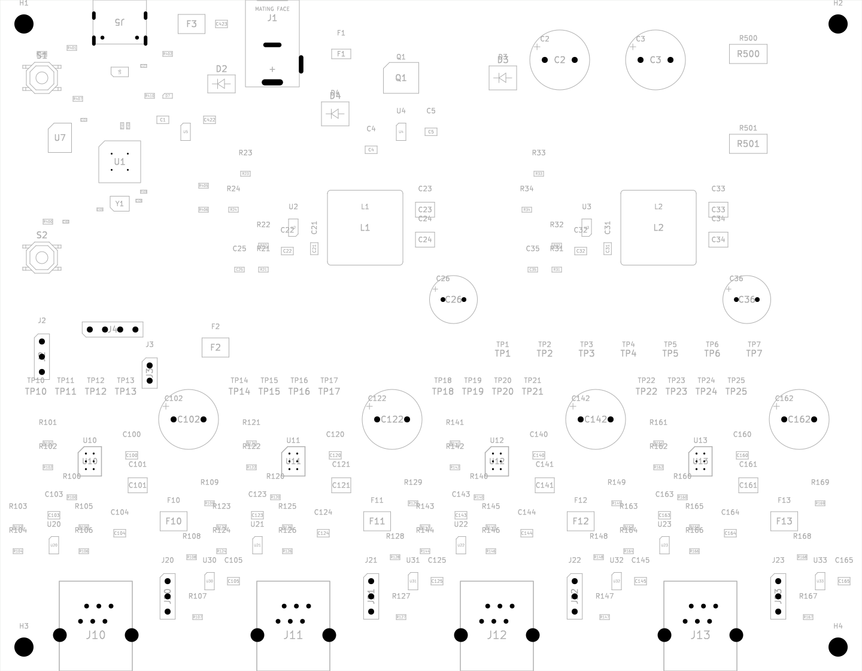
generated/electronics/assembly.png
