gonewx/quadcuber/generated/mechanical/manual/final-head-diagrams/18.png

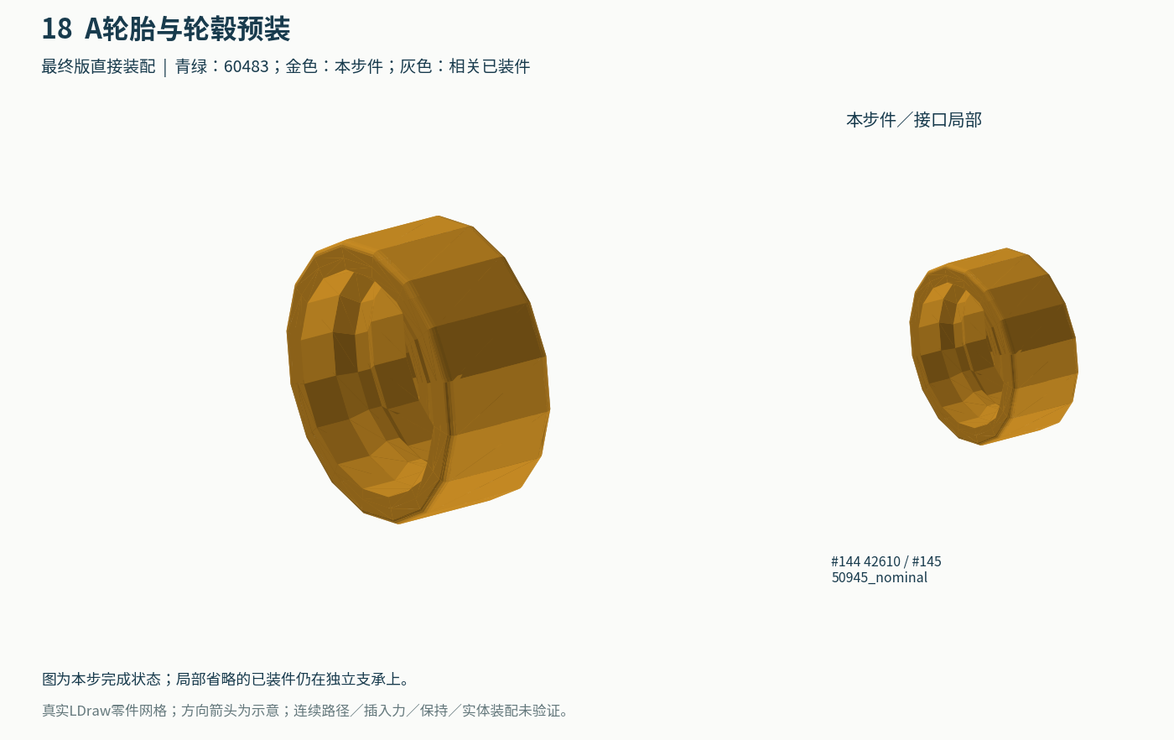
generated/mechanical/manual/final-head-diagrams/18.png
