gonewx/quadcuber/generated/mechanical/manual/final-head-diagrams/20.png

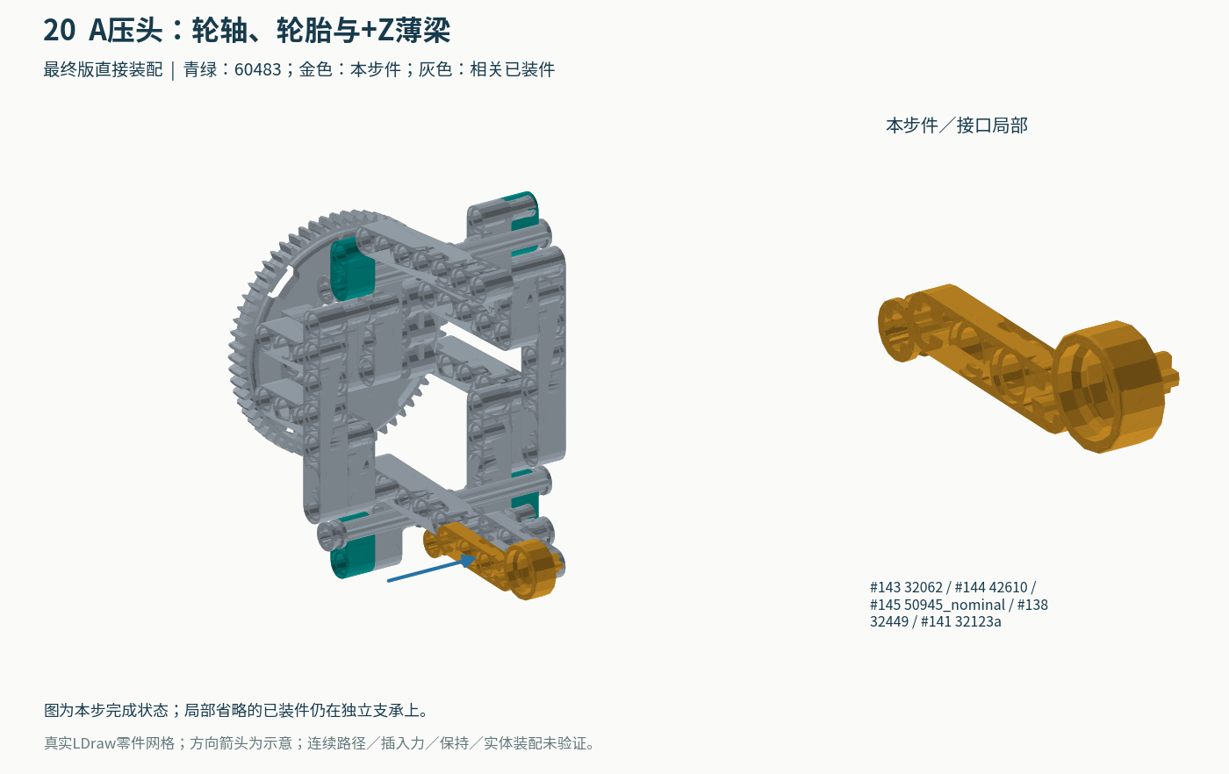
generated/mechanical/manual/final-head-diagrams/20.png
