gonewx/quadcuber/generated/mechanical/manual/final-head-diagrams/28.png

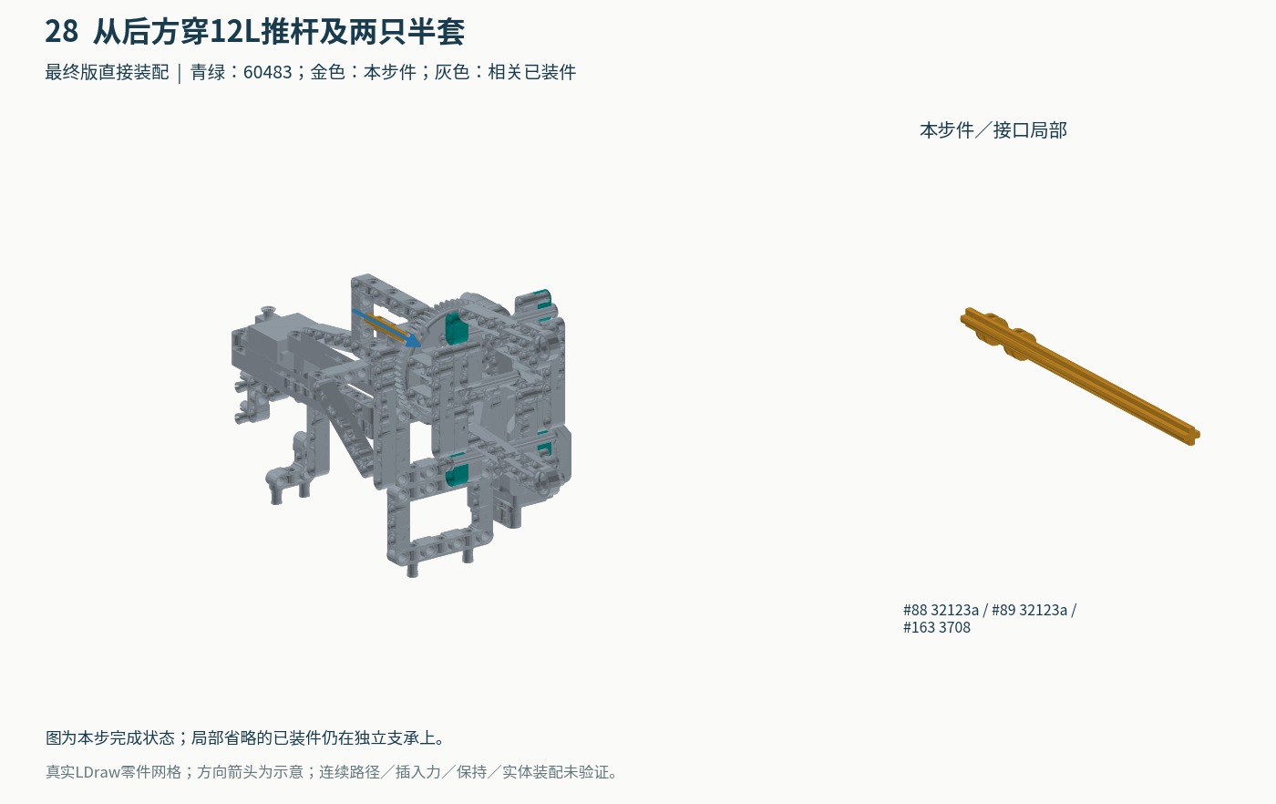
generated/mechanical/manual/final-head-diagrams/28.png
