gonewx/quadcuber/generated/mechanical/manual/final-head-diagrams/30.png

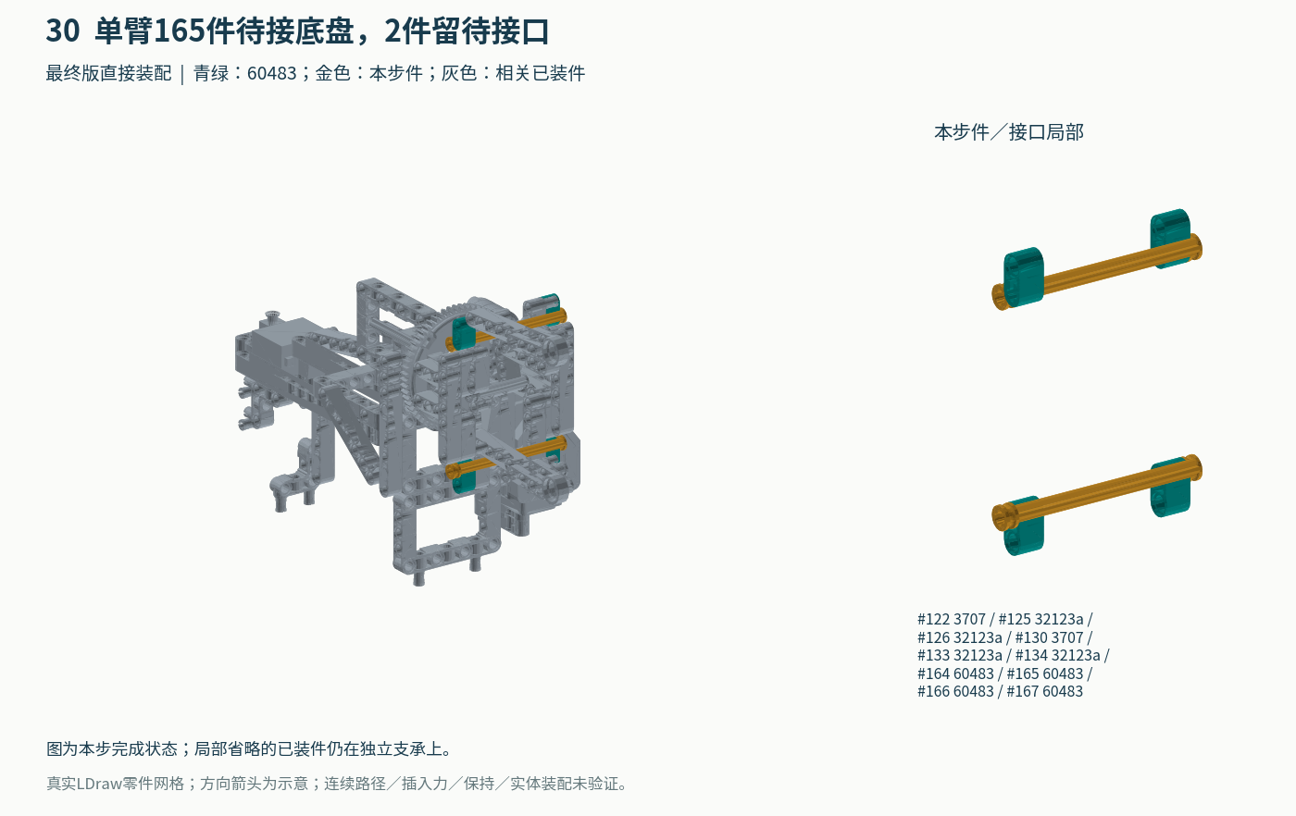
generated/mechanical/manual/final-head-diagrams/30.png
