gonewx/quadcuber/generated/mechanical/manual/final-head-diagrams/CORE02.png

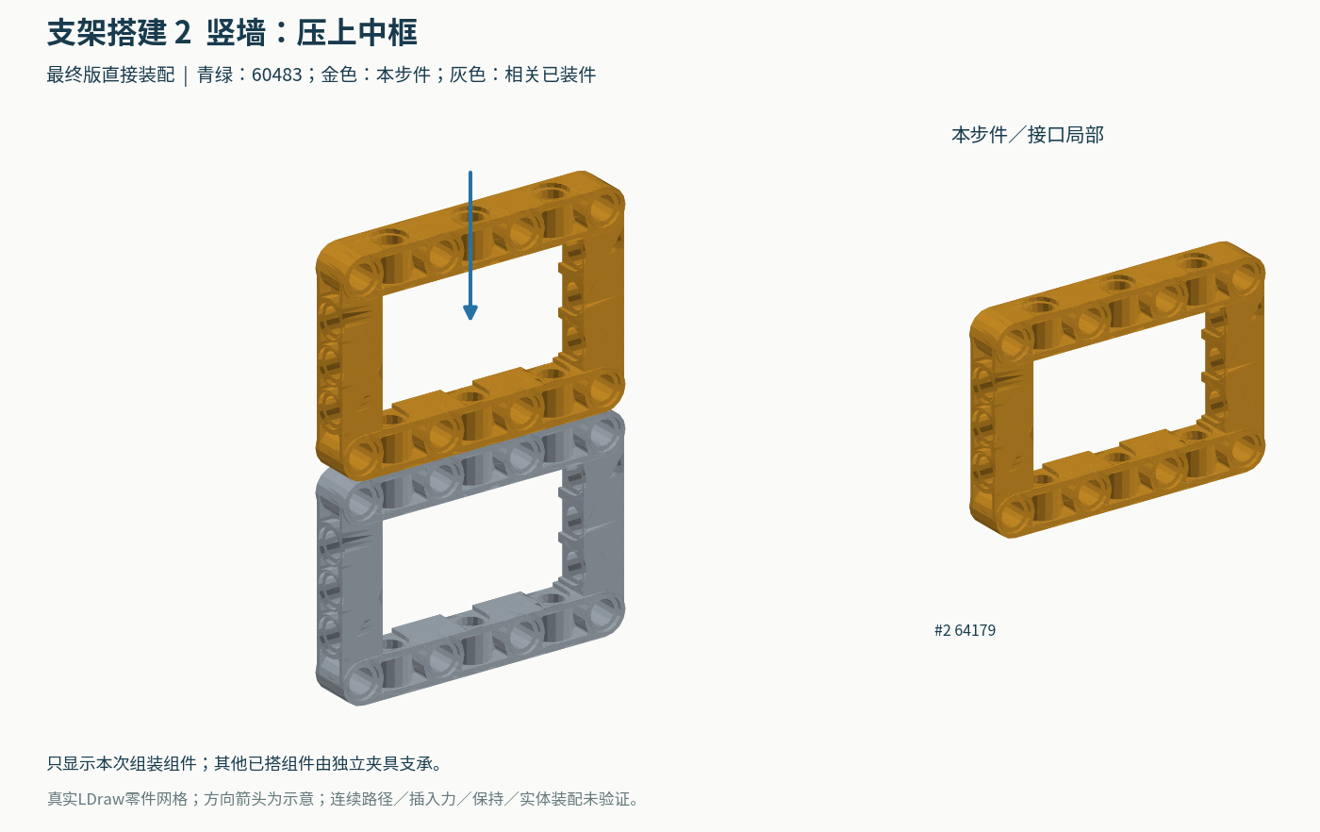
generated/mechanical/manual/final-head-diagrams/CORE02.png
