gonewx/quadcuber/generated/mechanical/manual/final-head-diagrams/CORE07.png

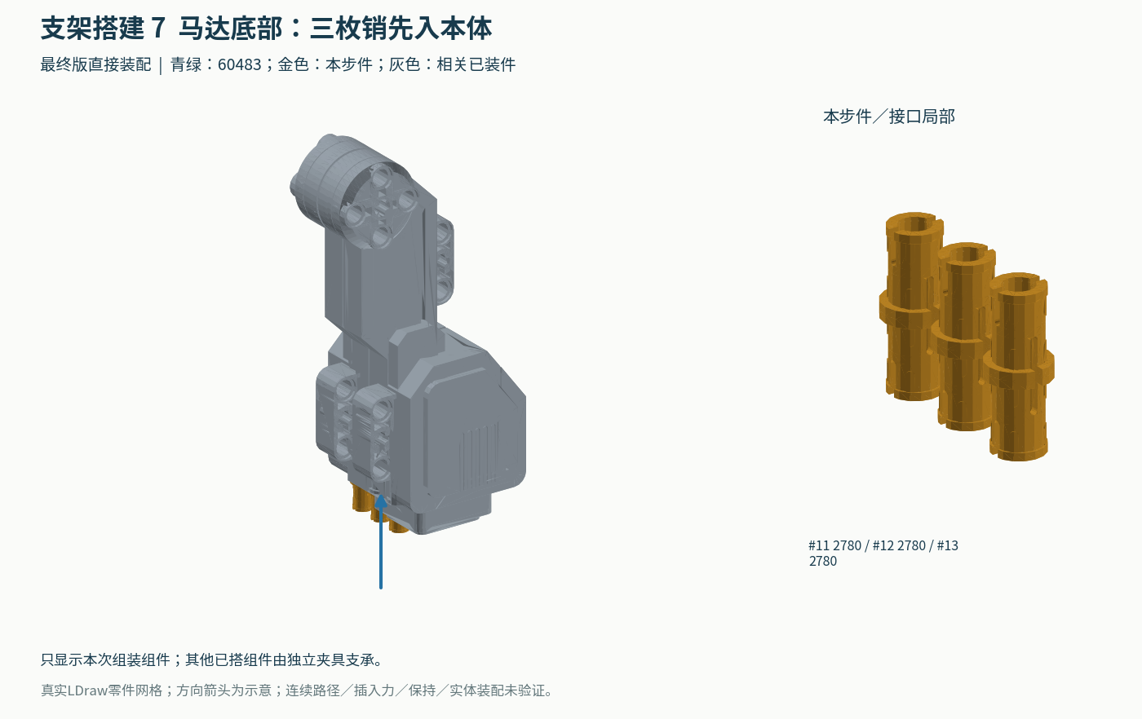
generated/mechanical/manual/final-head-diagrams/CORE07.png
