gonewx/quadcuber/generated/mechanical/manual/final-head-diagrams/CORE21.png

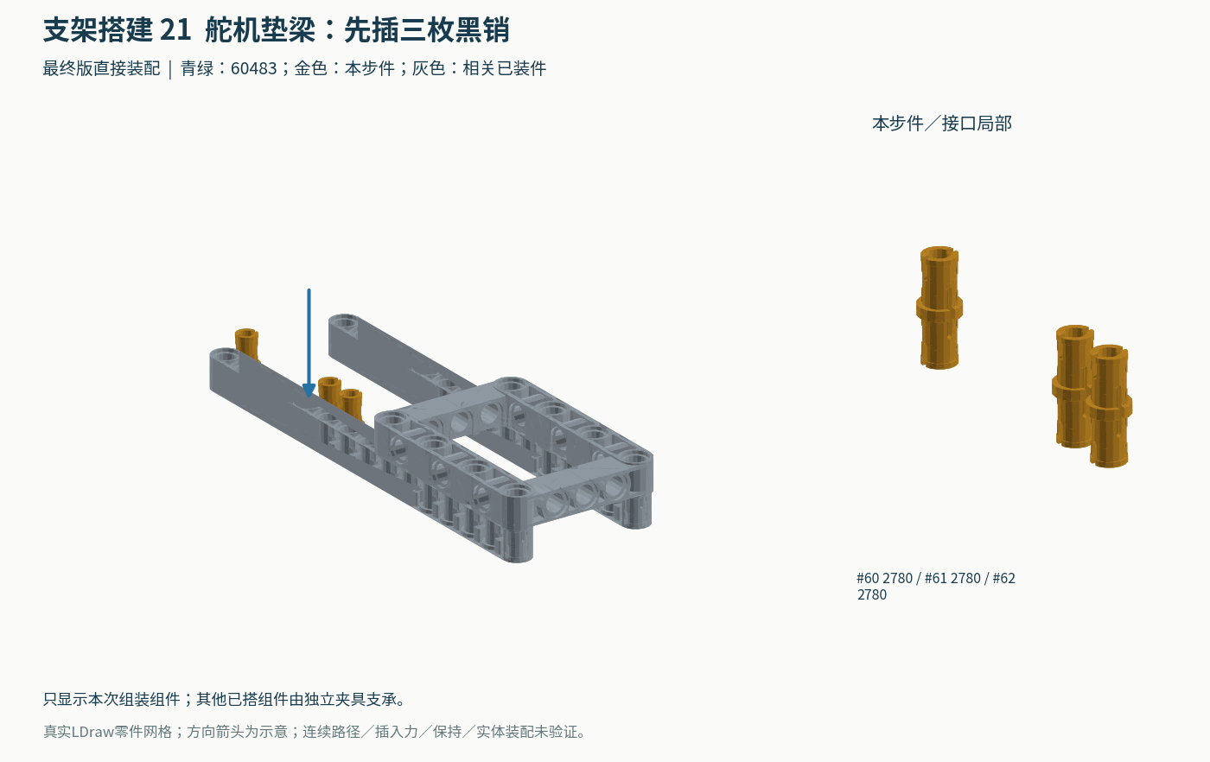
generated/mechanical/manual/final-head-diagrams/CORE21.png
