gonewx/quadcuber/generated/mechanical/manual/final-head-diagrams/CORE23.png

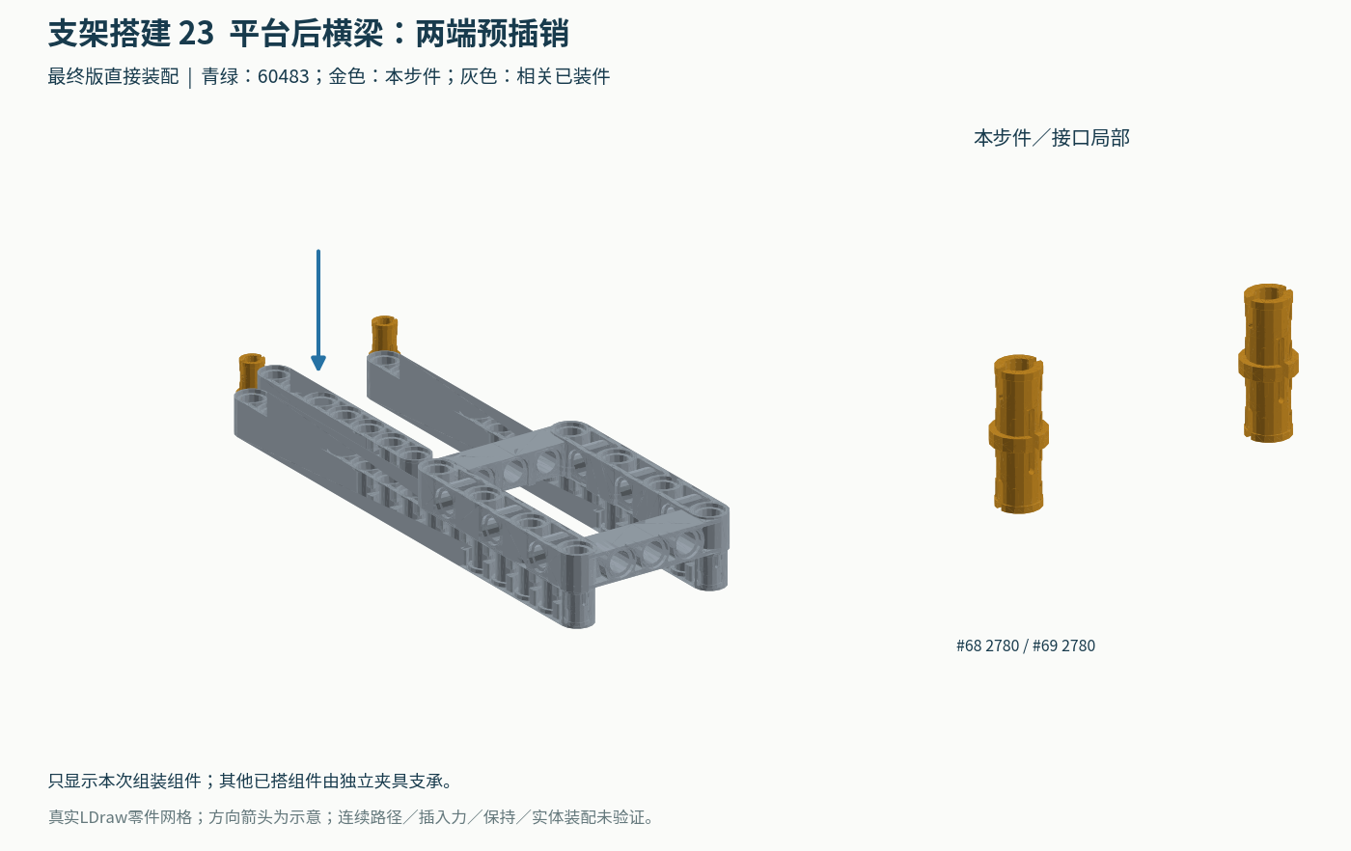
generated/mechanical/manual/final-head-diagrams/CORE23.png
