gonewx/quadcuber/generated/mechanical/manual/final-head-diagrams/CORE27.png

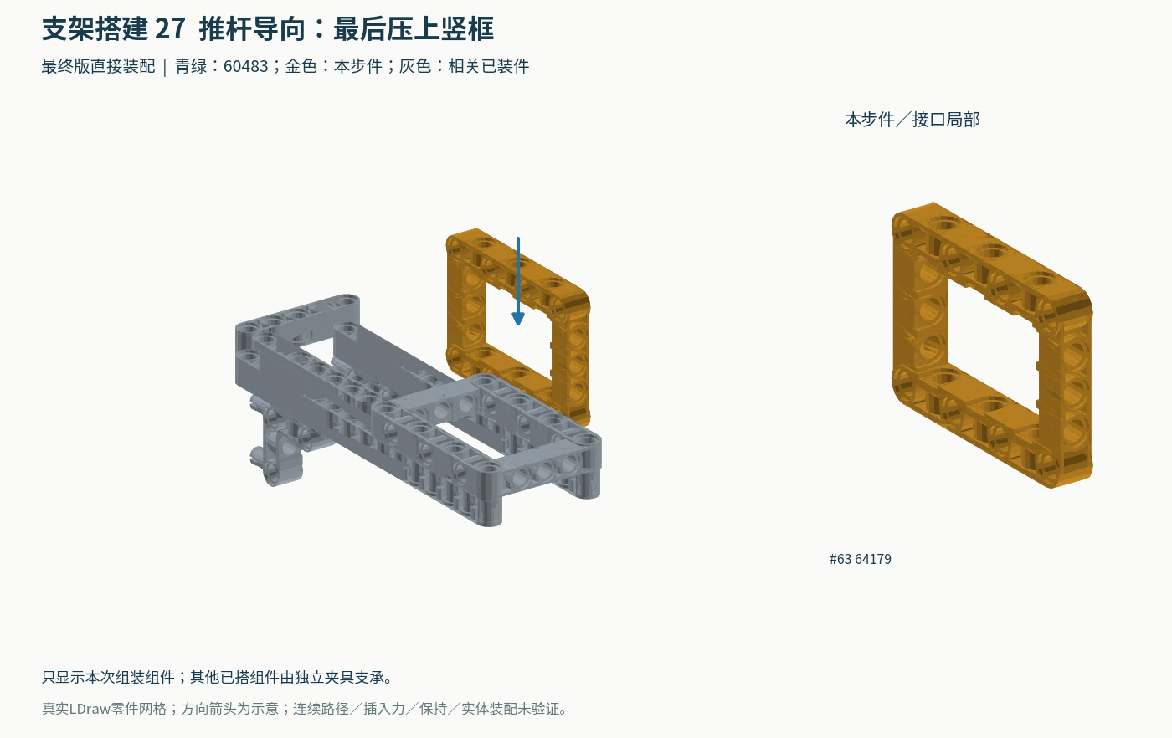
generated/mechanical/manual/final-head-diagrams/CORE27.png
