gonewx/quadcuber/generated/mechanical/manual/final-head-diagrams/CORE29.png

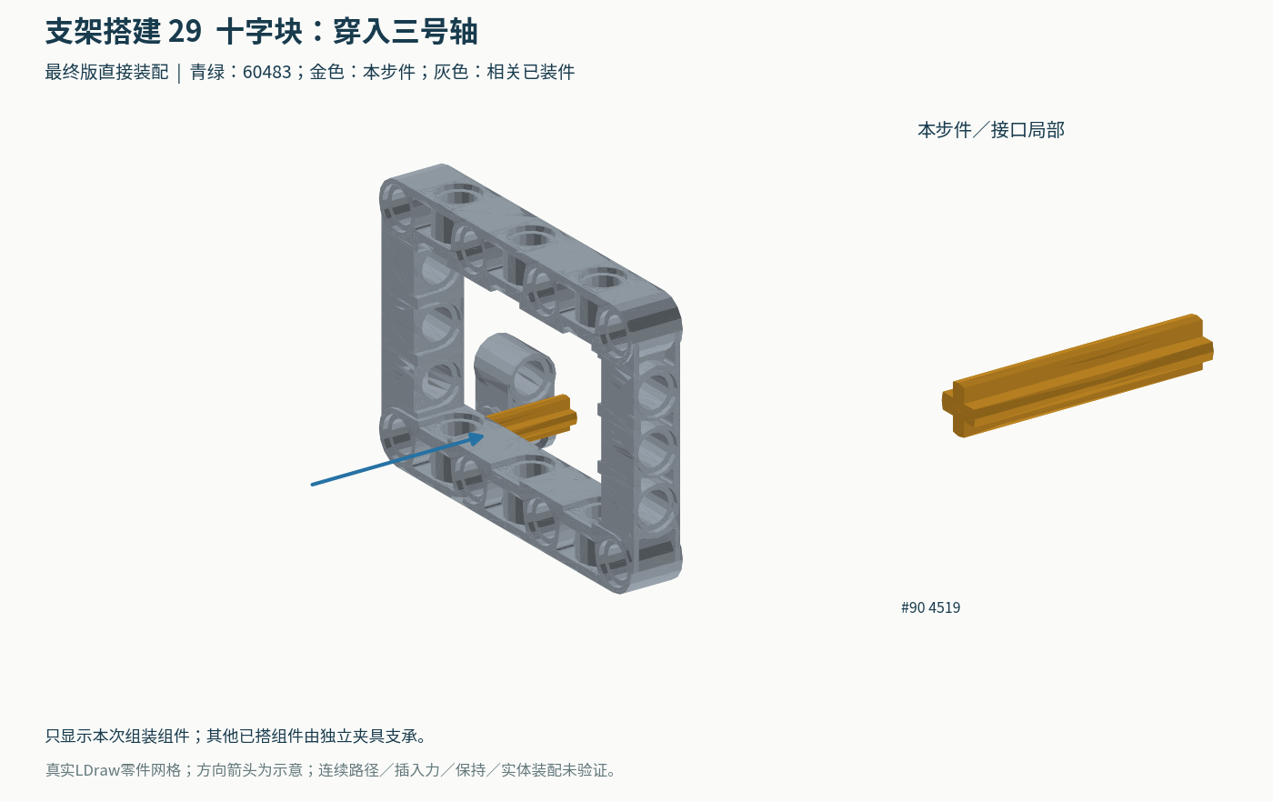
generated/mechanical/manual/final-head-diagrams/CORE29.png
