gonewx/quadcuber/generated/mechanical/manual/final-head-diagrams/CORE34.png

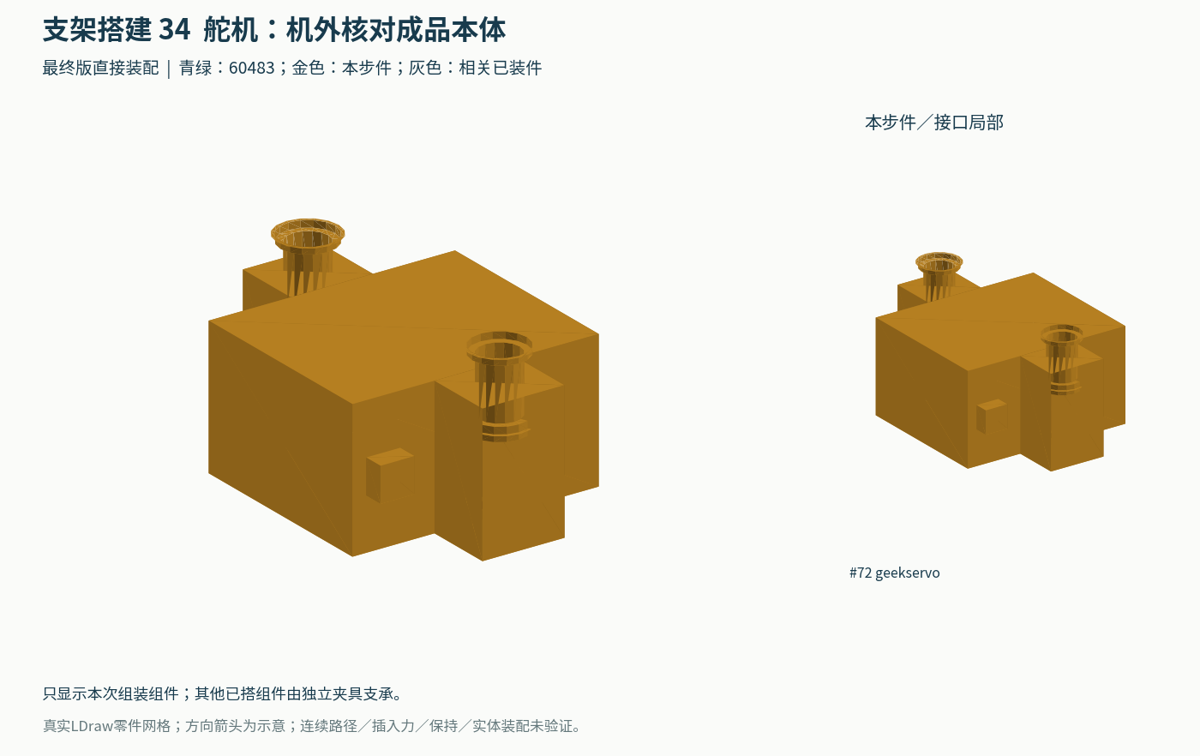
generated/mechanical/manual/final-head-diagrams/CORE34.png
