gonewx/quadcuber/generated/mechanical/manual/final-head-diagrams/CORE35.png

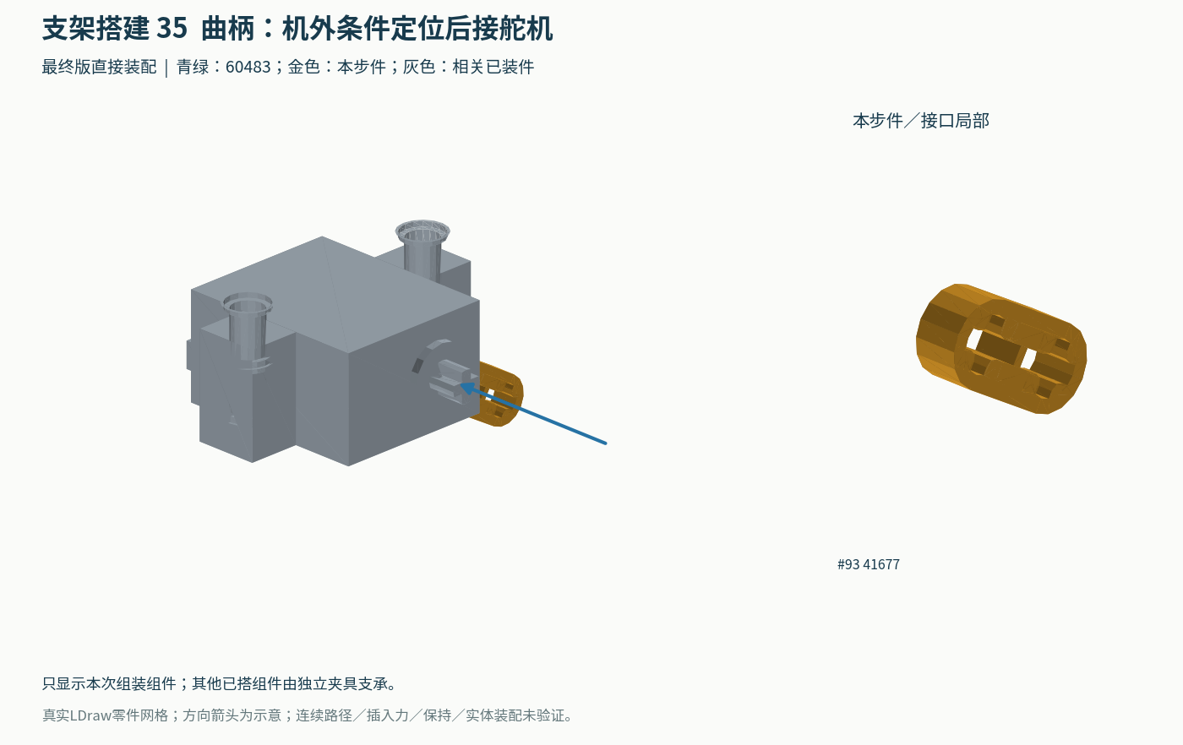
generated/mechanical/manual/final-head-diagrams/CORE35.png
