gonewx/quadcuber/generated/mechanical/manual/final-head-diagrams/CORE40.png

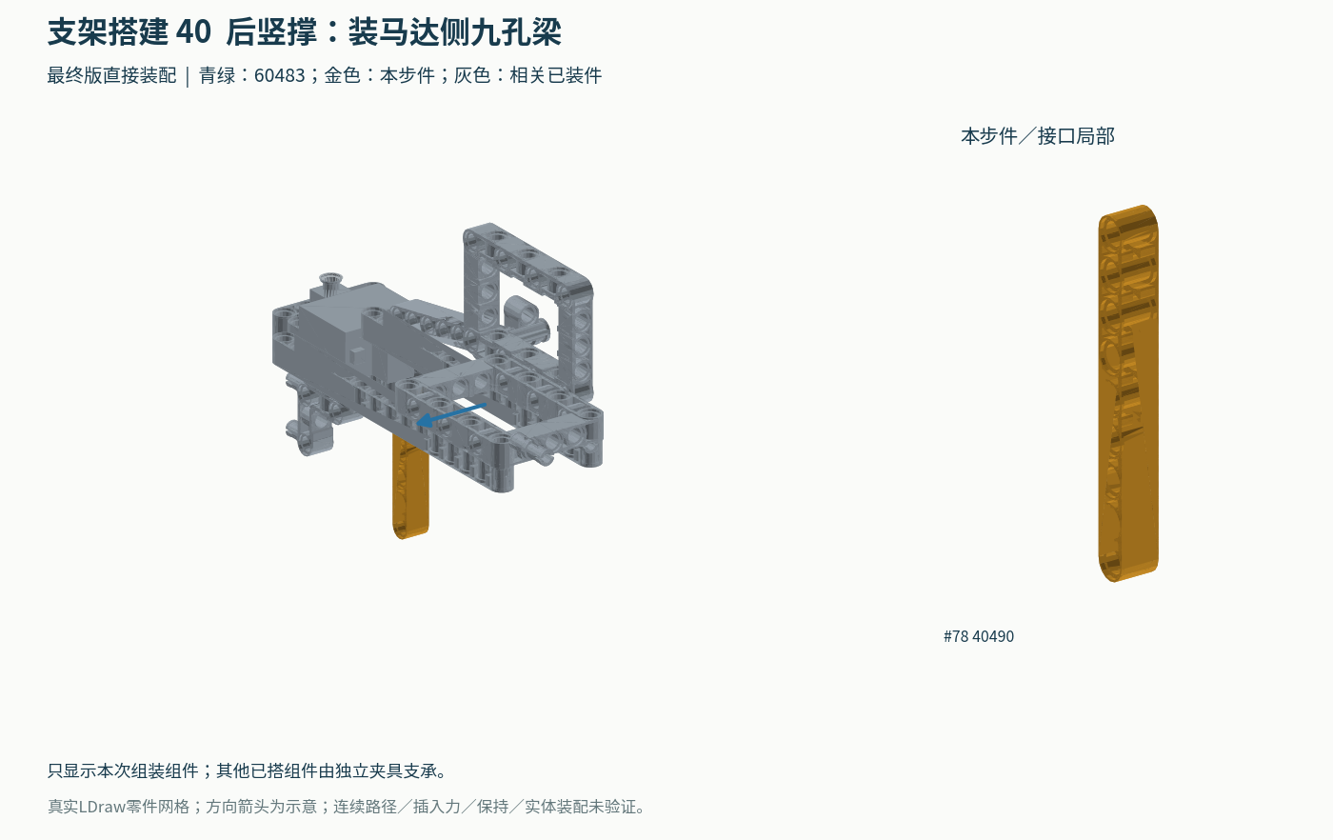
generated/mechanical/manual/final-head-diagrams/CORE40.png
