gonewx/quadcuber/generated/mechanical/manual/final-head-diagrams/CORE43.png

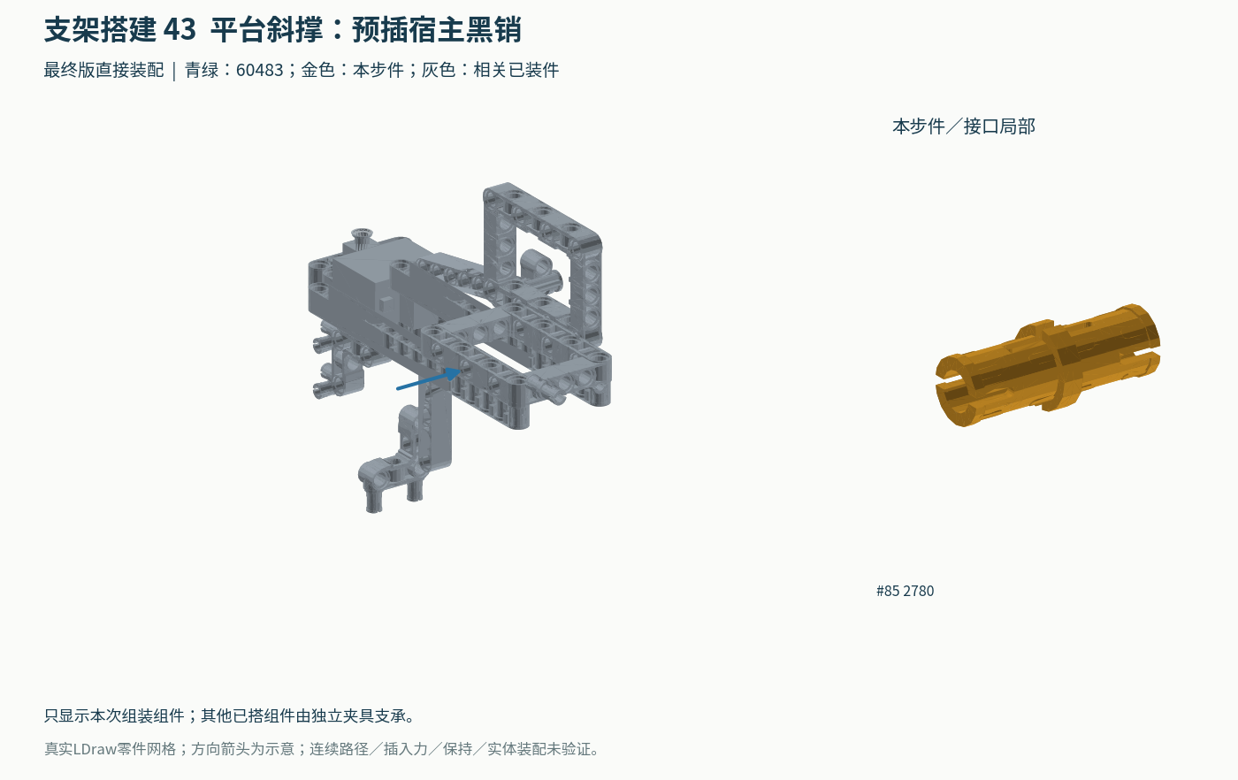
generated/mechanical/manual/final-head-diagrams/CORE43.png
