gonewx/quadcuber/generated/mechanical/manual/final-head-diagrams/TT02.png

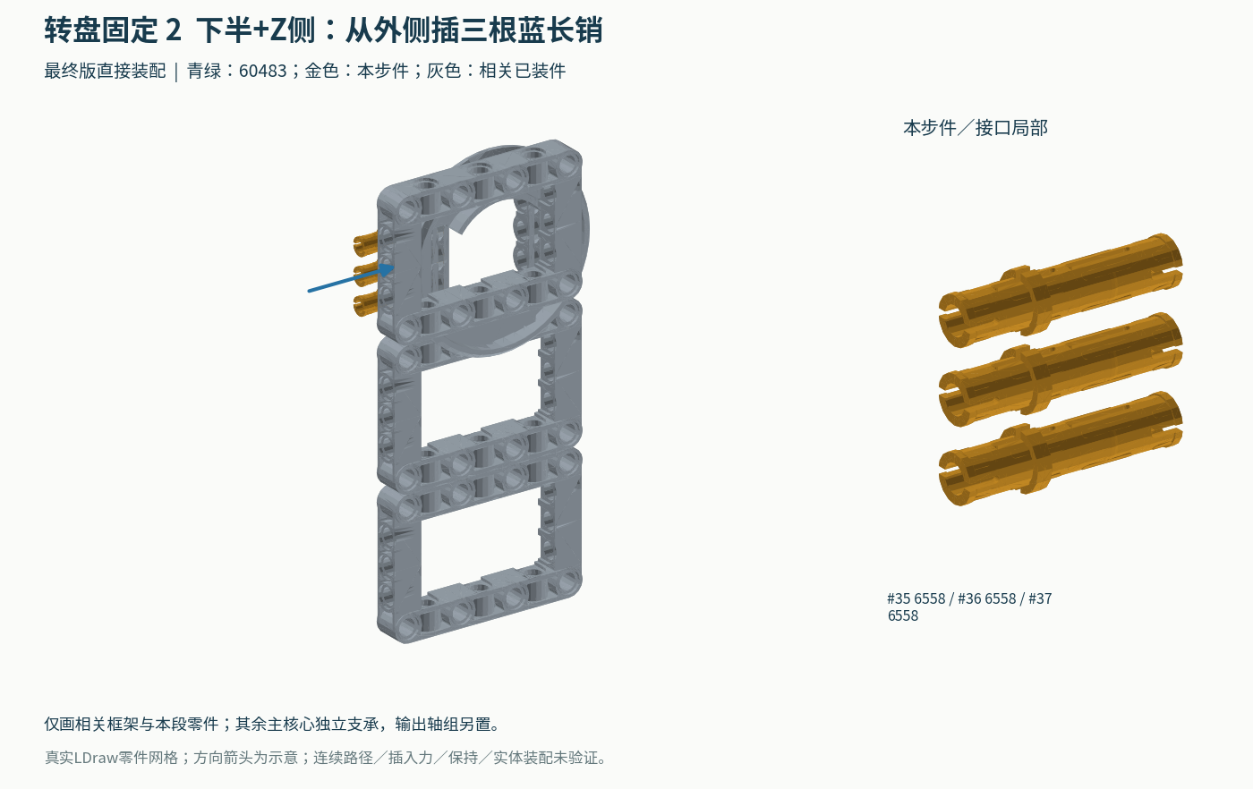
generated/mechanical/manual/final-head-diagrams/TT02.png
