gonewx/quadcuber/generated/mechanical/manual/images/BASE-BAS-15.png

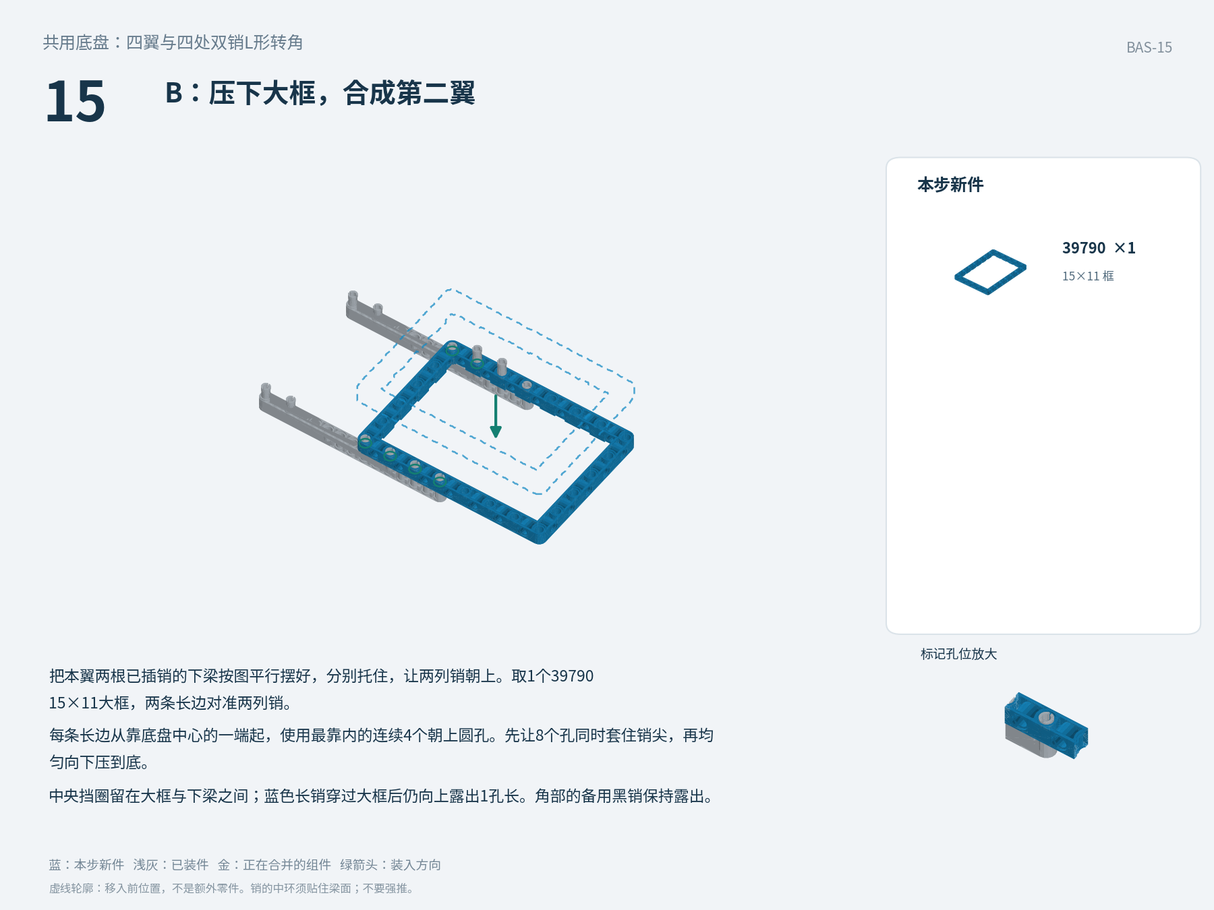
generated/mechanical/manual/images/BASE-BAS-15.png
