gonewx/quadcuber/generated/mechanical/manual/images/BASE-BAS-34.png

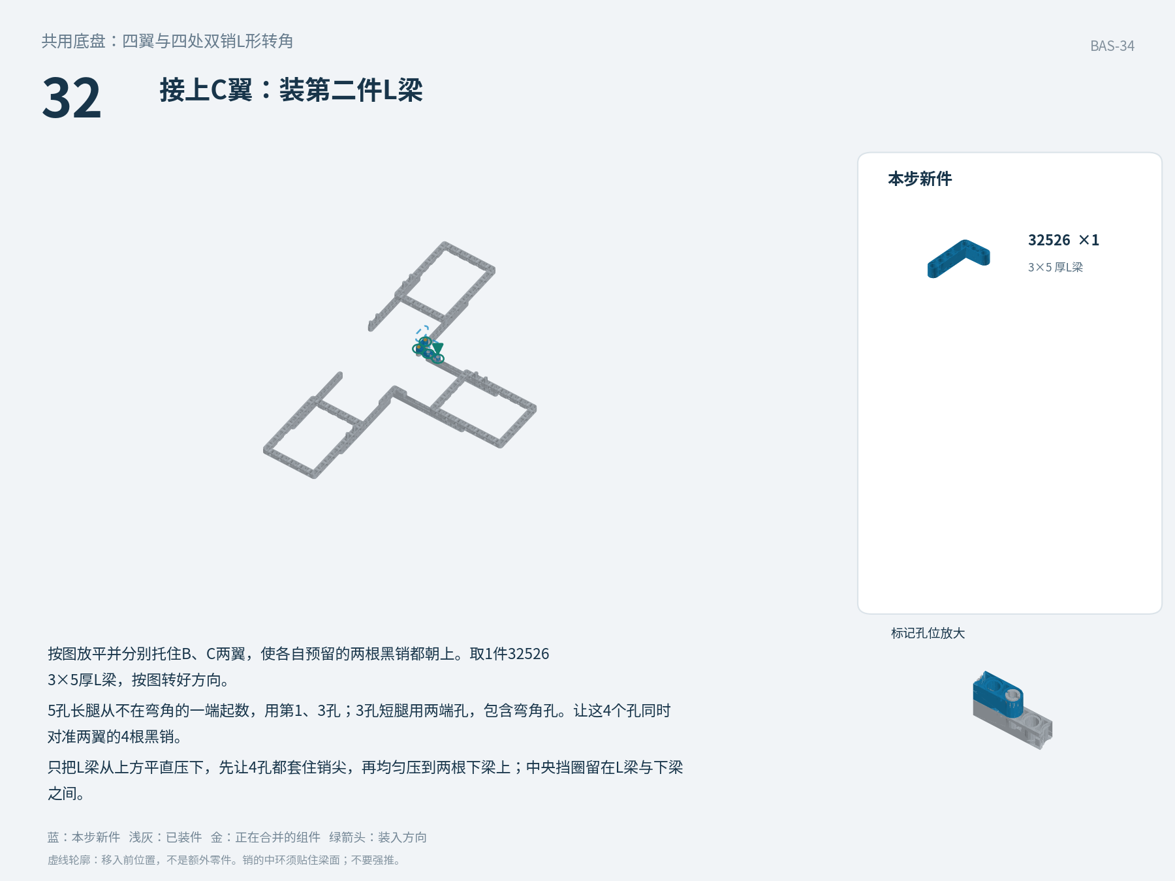
generated/mechanical/manual/images/BASE-BAS-34.png
