gonewx/quadcuber/generated/mechanical/manual/images/BASE-BAS-RB-02.png

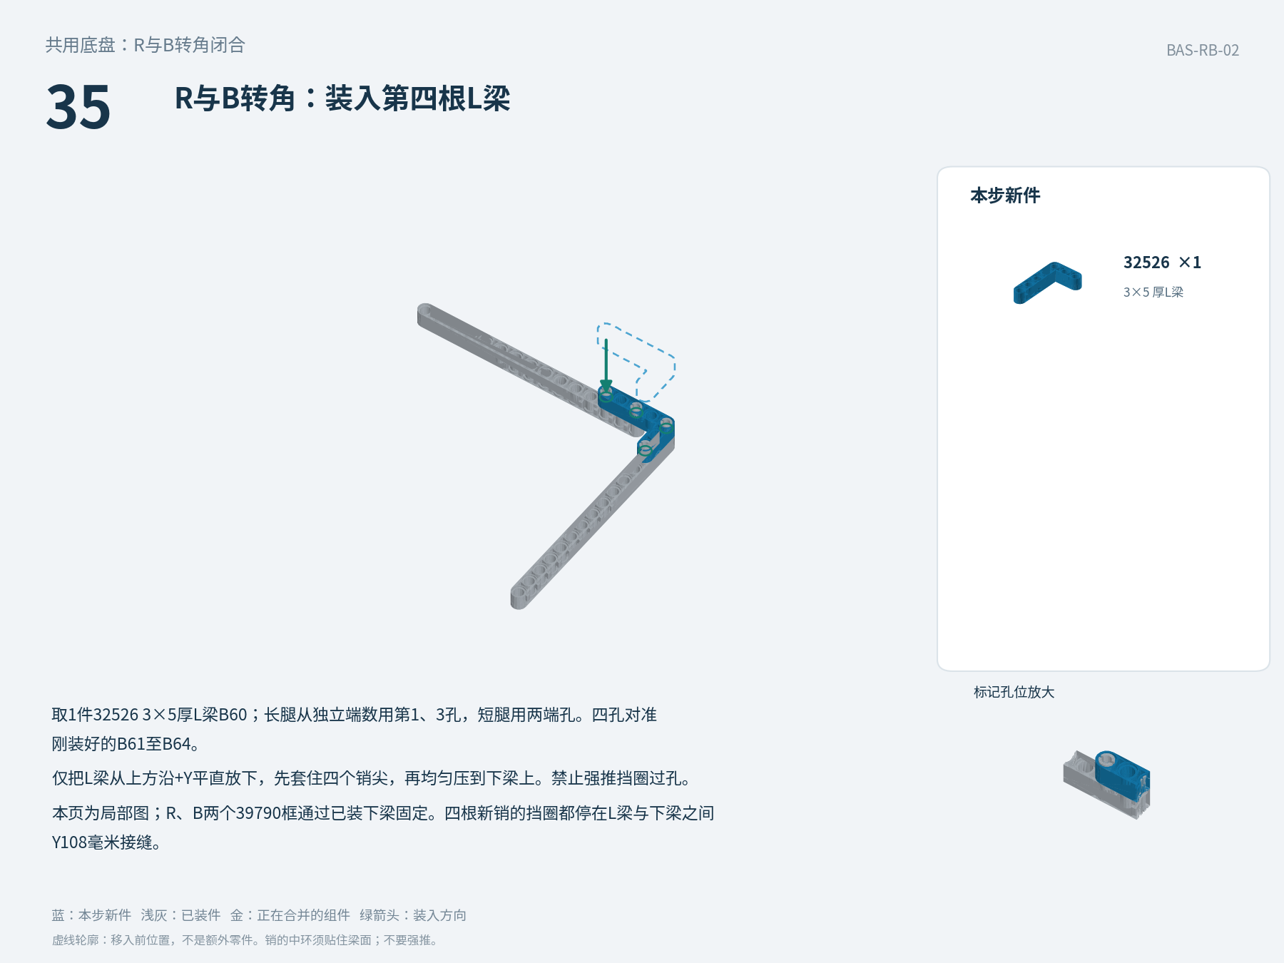
generated/mechanical/manual/images/BASE-BAS-RB-02.png
