gonewx/quadcuber/mechanical/final/manual/final-head-diagrams/06.png

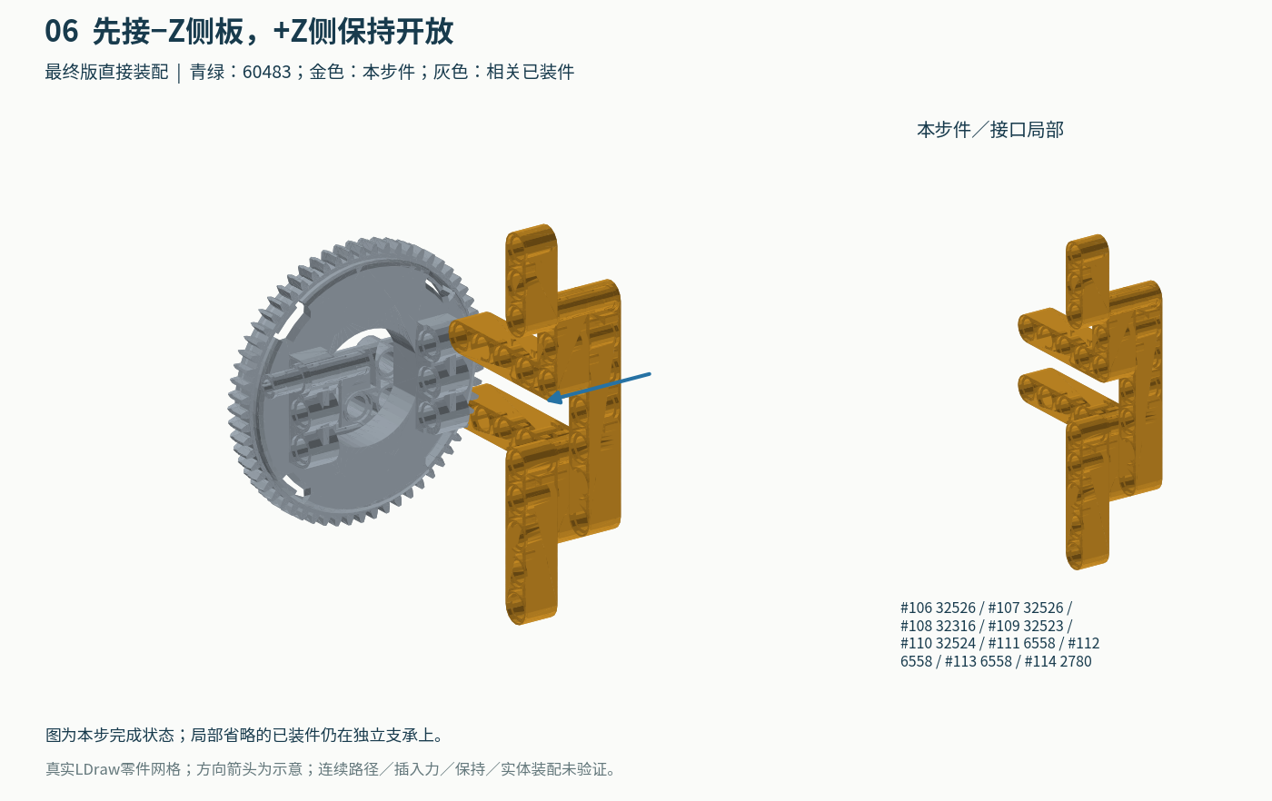
mechanical/final/manual/final-head-diagrams/06.png
