gonewx/quadcuber/mechanical/final/manual/final-head-diagrams/17.png

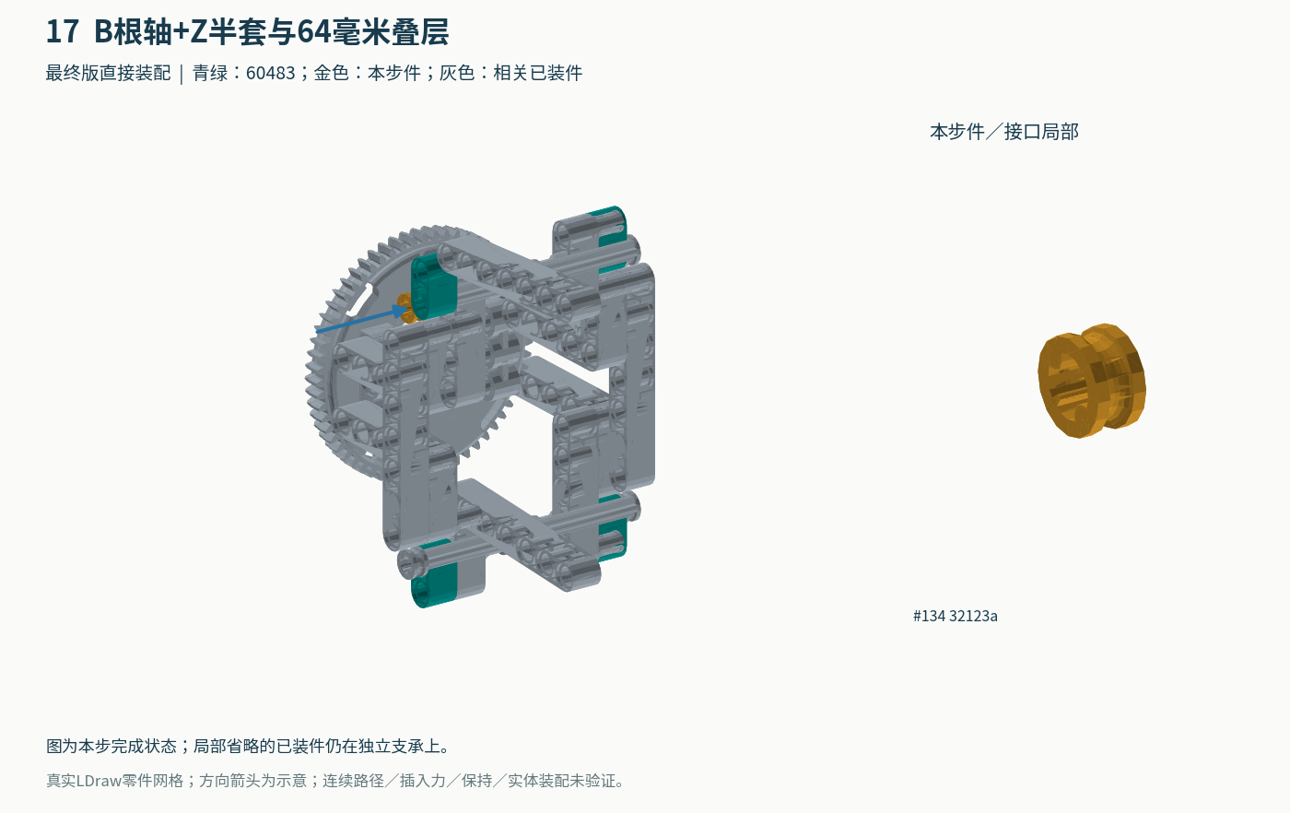
mechanical/final/manual/final-head-diagrams/17.png
