gonewx/quadcuber/mechanical/final/manual/final-head-diagrams/24.png

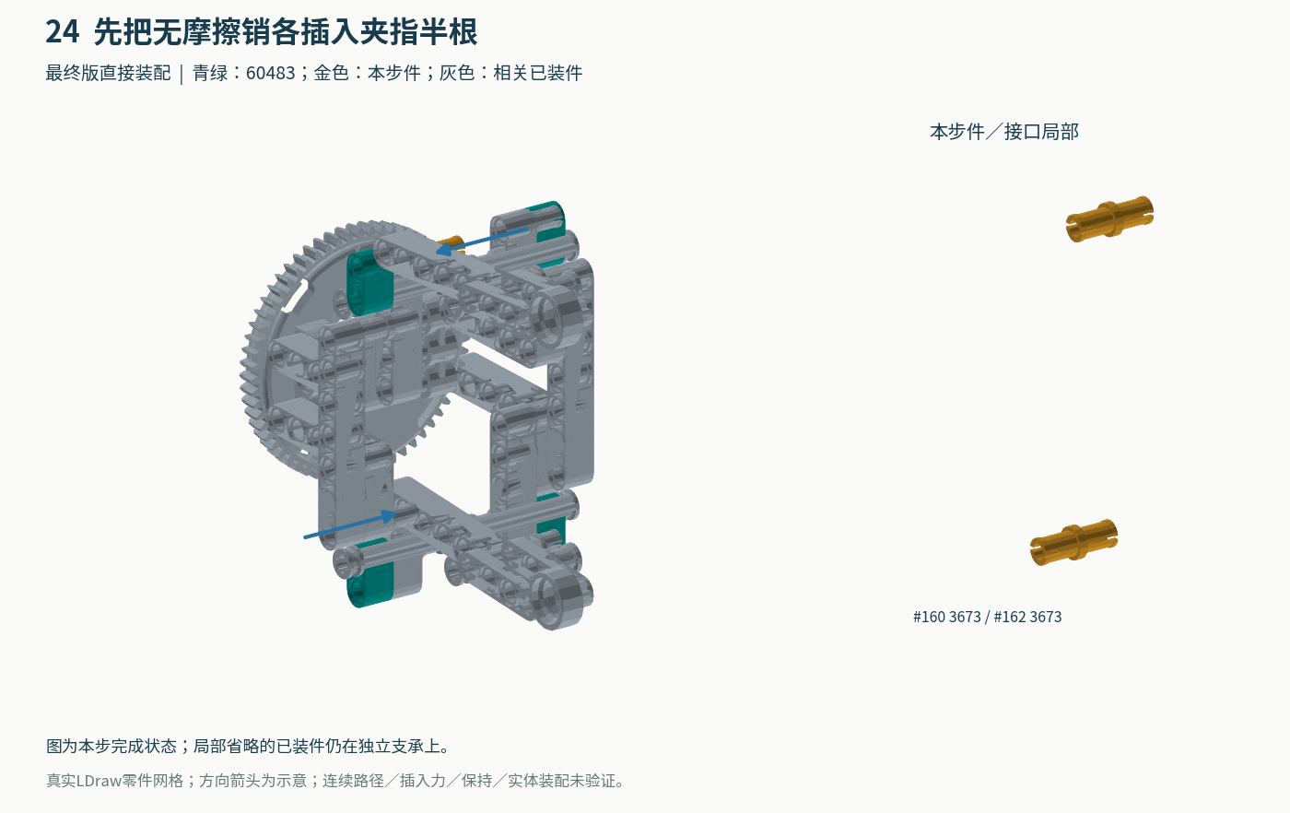
mechanical/final/manual/final-head-diagrams/24.png
