gonewx/quadcuber/mechanical/final/manual/final-head-diagrams/CORE13.png

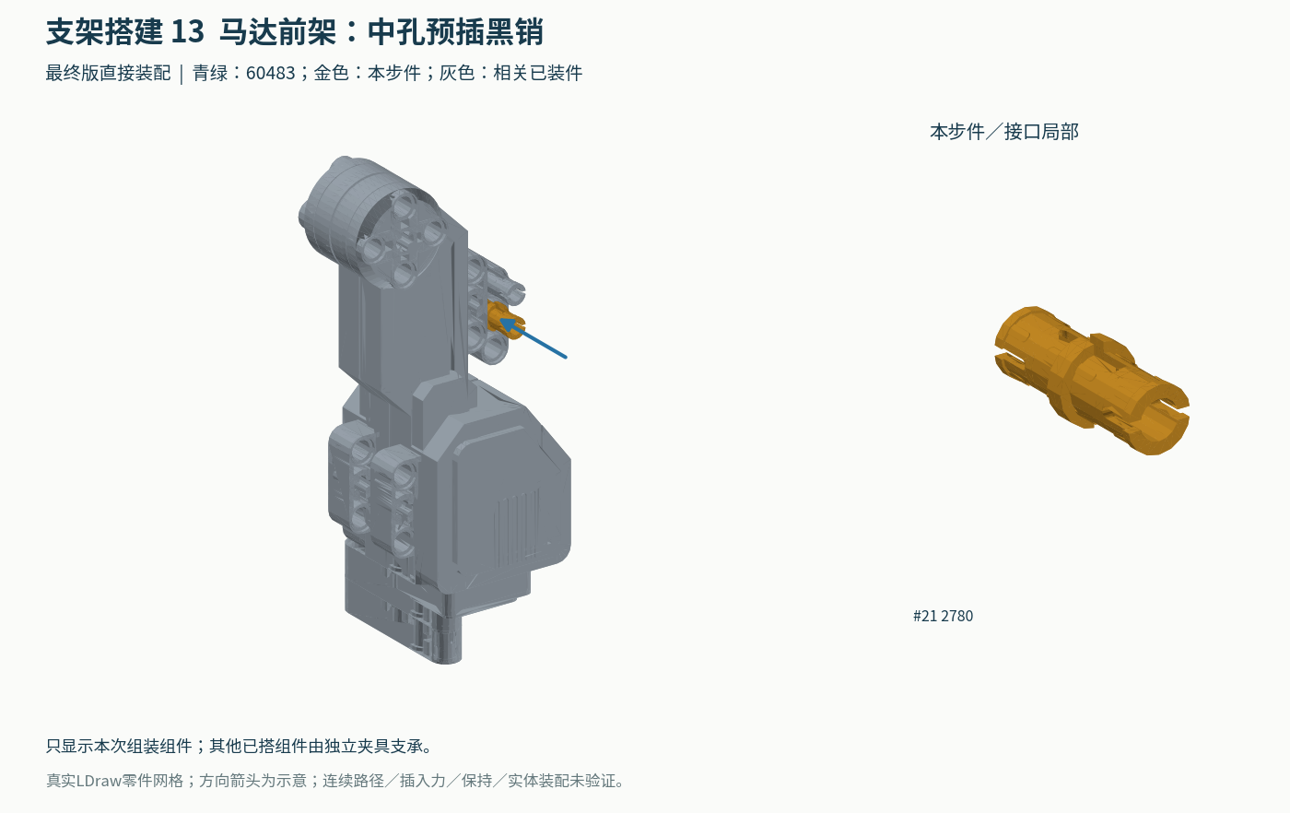
mechanical/final/manual/final-head-diagrams/CORE13.png
