gonewx/quadcuber/mechanical/final/manual/final-head-diagrams/TT07.png

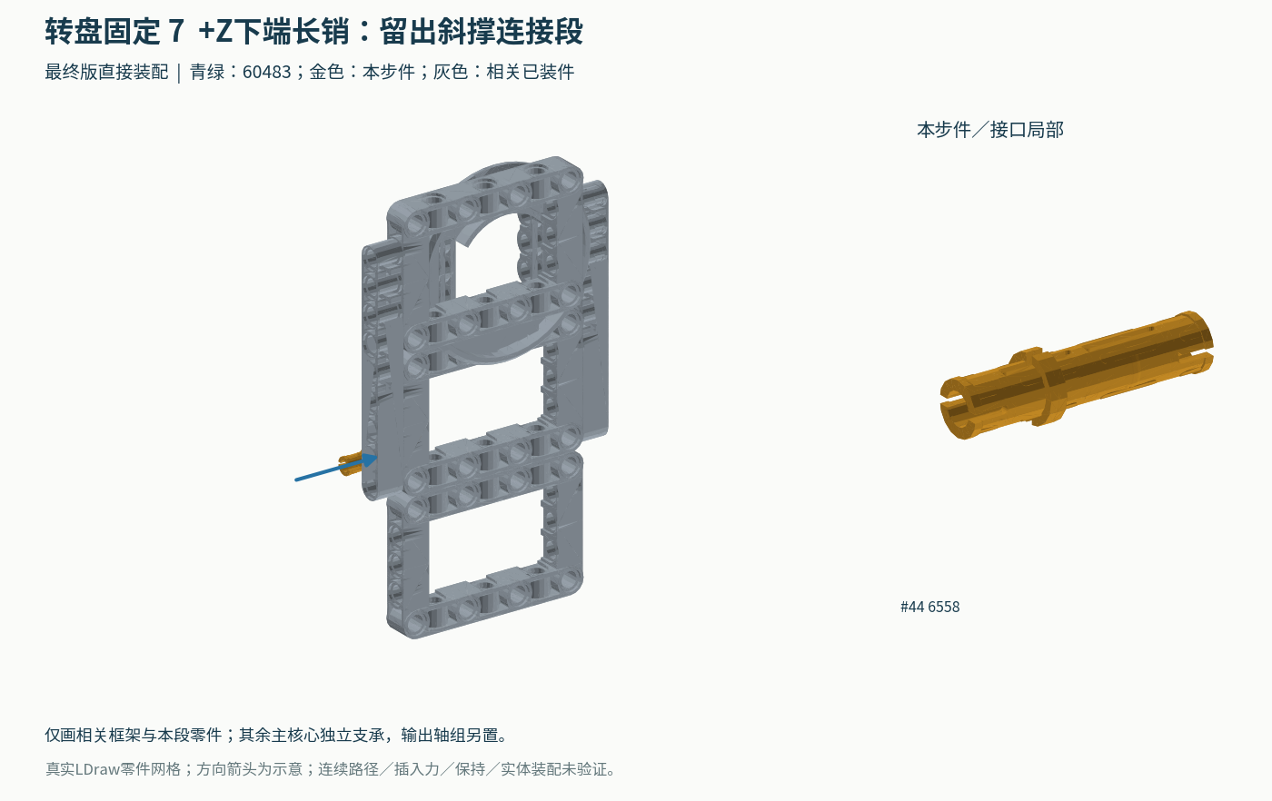
mechanical/final/manual/final-head-diagrams/TT07.png
