gonewx/quadcuber/mechanical/final/site-source/dist/candidate132-steps/001.png

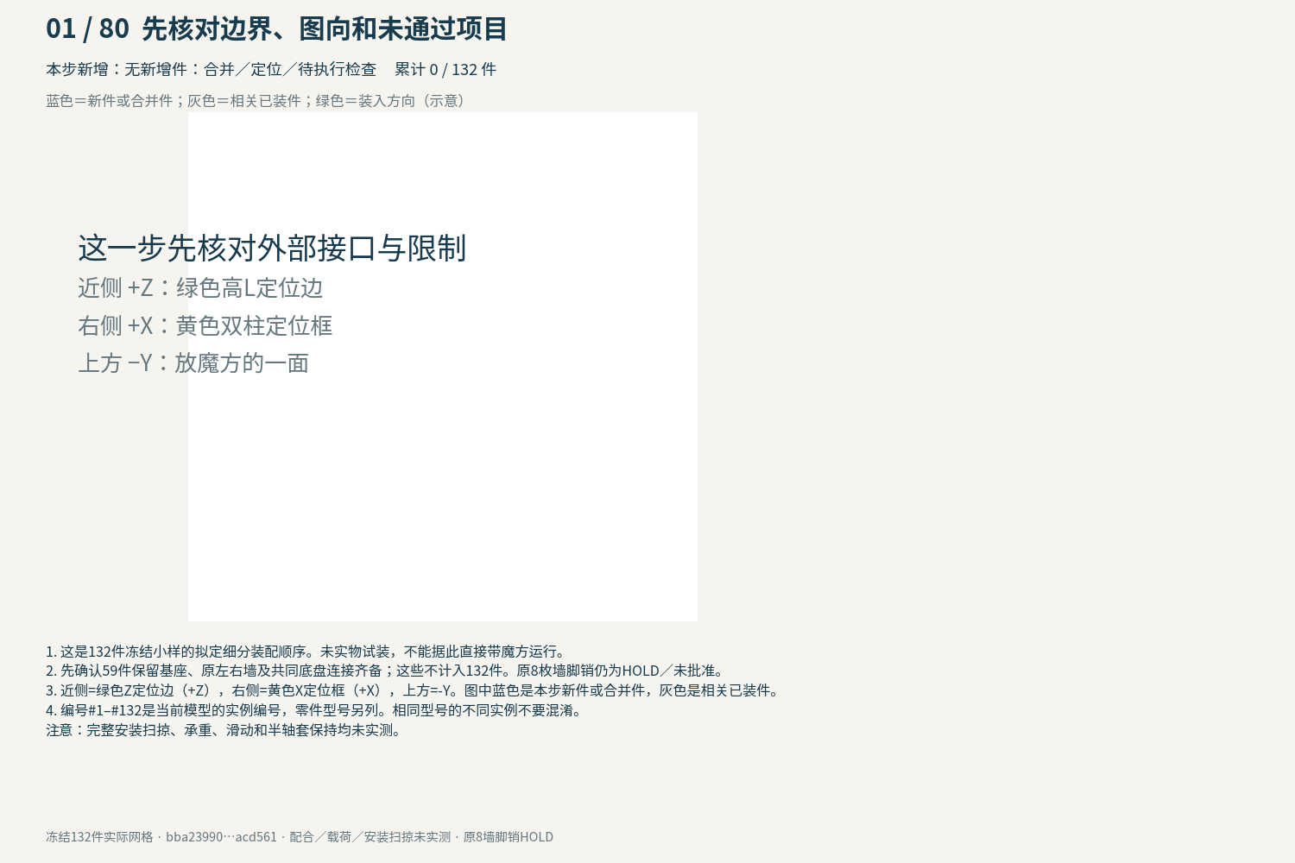
mechanical/final/site-source/dist/candidate132-steps/001.png
