gonewx/quadcuber/mechanical/final/site-source/dist/candidate132-steps/002.png

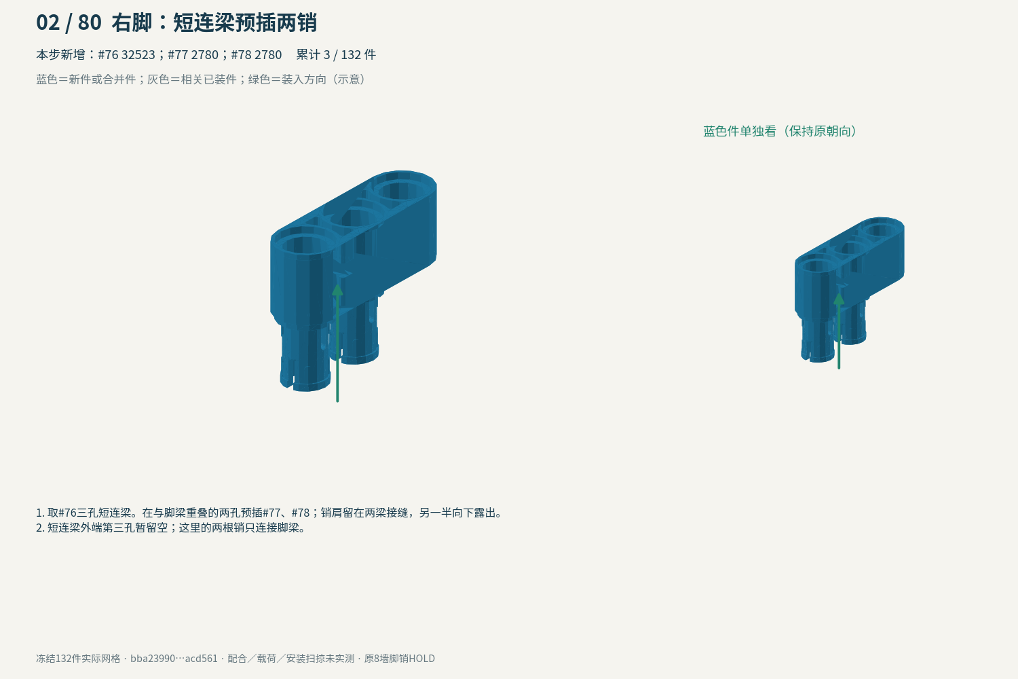
mechanical/final/site-source/dist/candidate132-steps/002.png
