gonewx/quadcuber/mechanical/final/site-source/dist/candidate132-steps/006.png

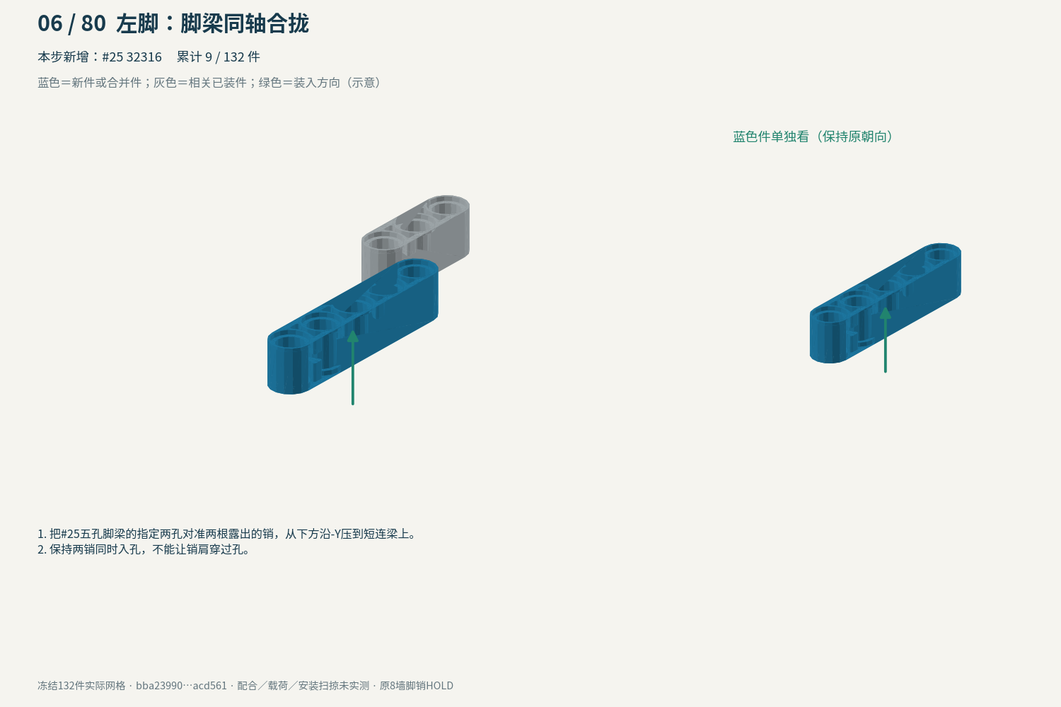
mechanical/final/site-source/dist/candidate132-steps/006.png
