gonewx/quadcuber/mechanical/final/site-source/dist/candidate132-steps/017.png

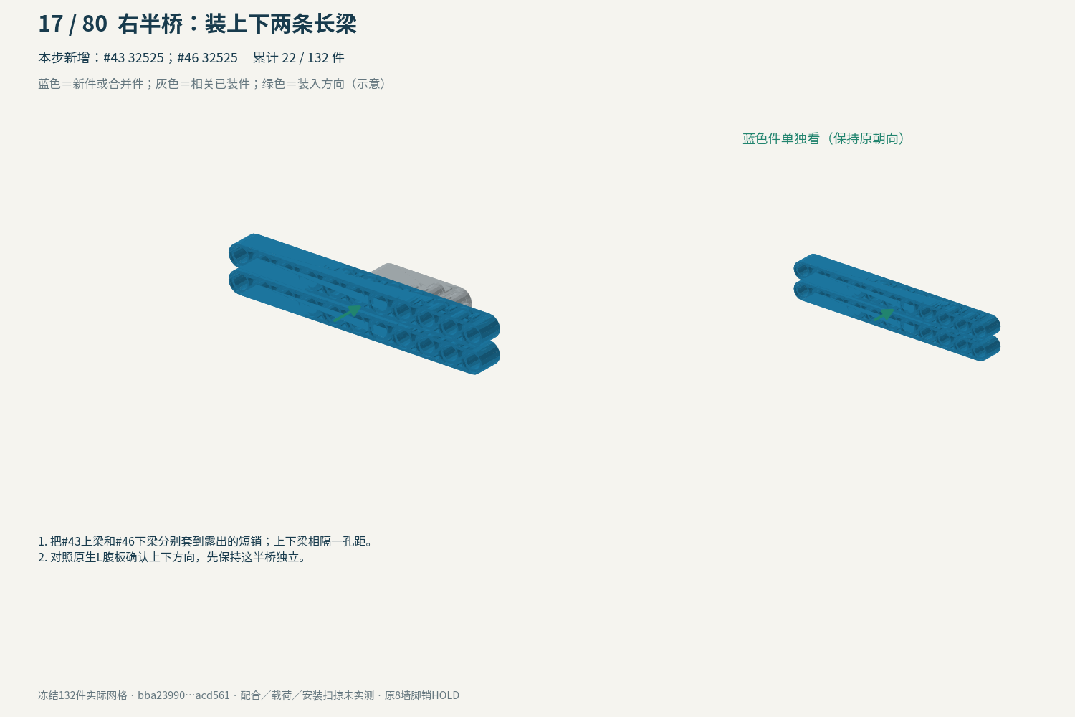
mechanical/final/site-source/dist/candidate132-steps/017.png
