gonewx/quadcuber/mechanical/final/site-source/dist/candidate132-steps/022.png

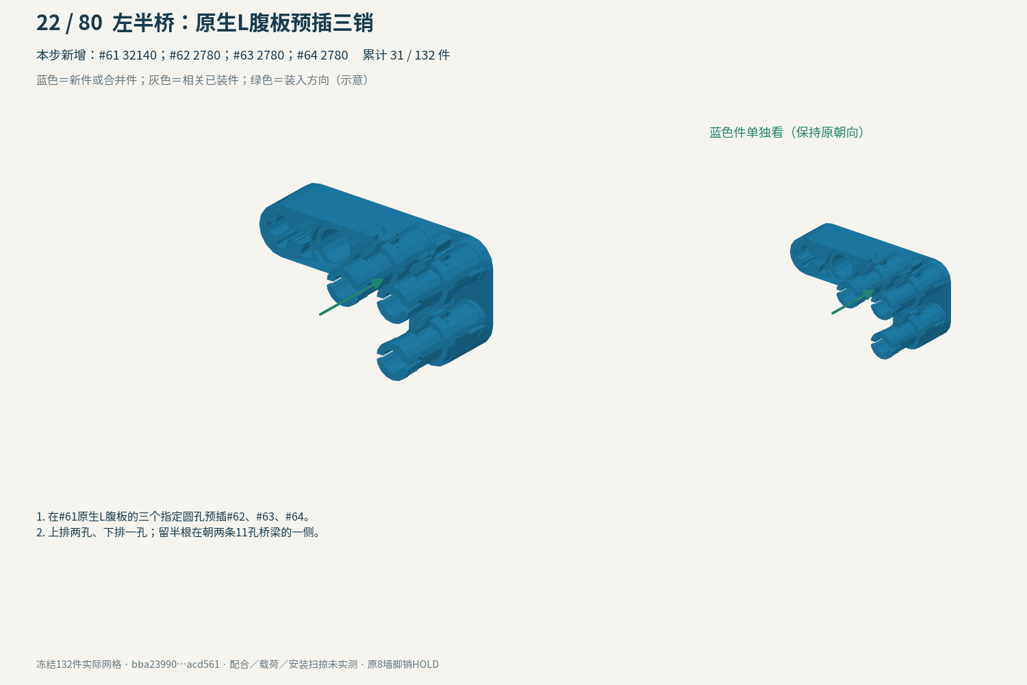
mechanical/final/site-source/dist/candidate132-steps/022.png
