gonewx/quadcuber/mechanical/final/site-source/dist/candidate132-steps/029.png

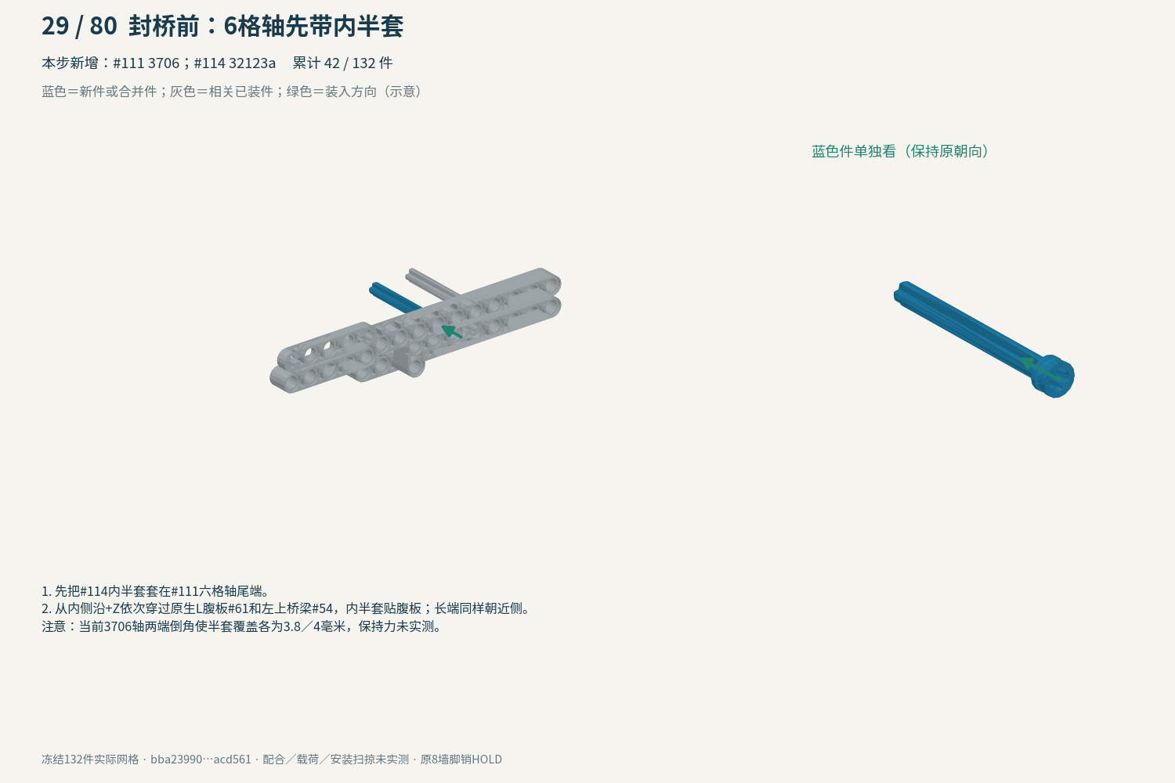
mechanical/final/site-source/dist/candidate132-steps/029.png
