gonewx/quadcuber/mechanical/final/site-source/dist/candidate132-steps/030.png

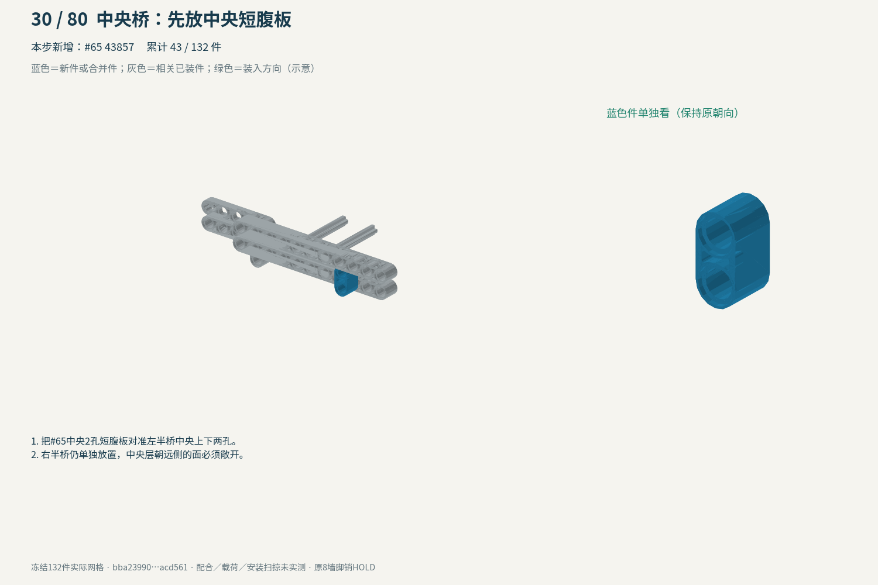
mechanical/final/site-source/dist/candidate132-steps/030.png
