gonewx/quadcuber/mechanical/final/site-source/dist/candidate132-steps/031.png

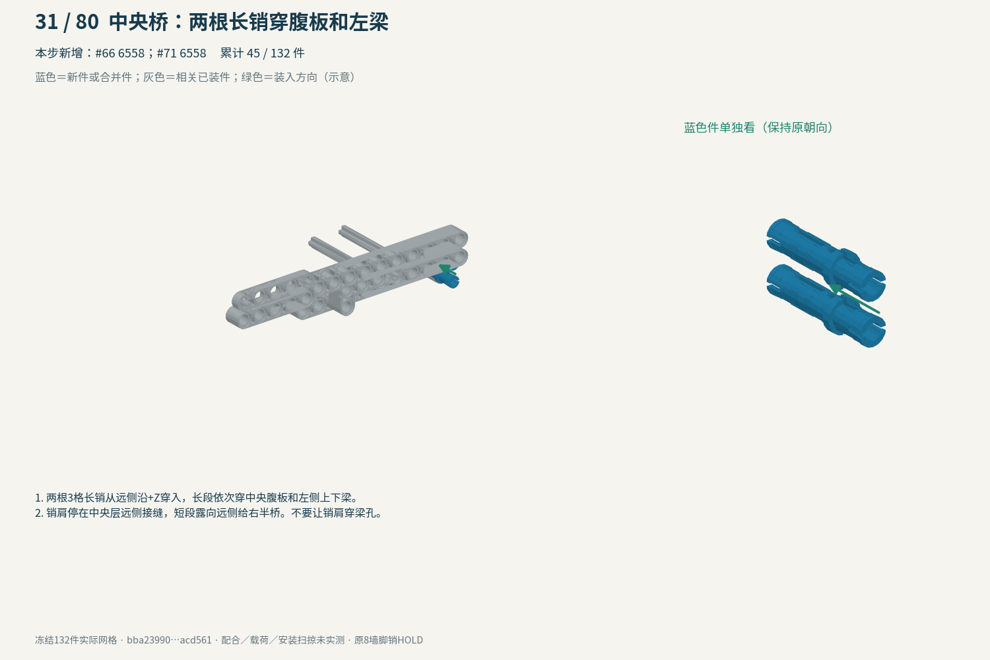
mechanical/final/site-source/dist/candidate132-steps/031.png
