gonewx/quadcuber/mechanical/final/site-source/dist/candidate132-steps/045.png

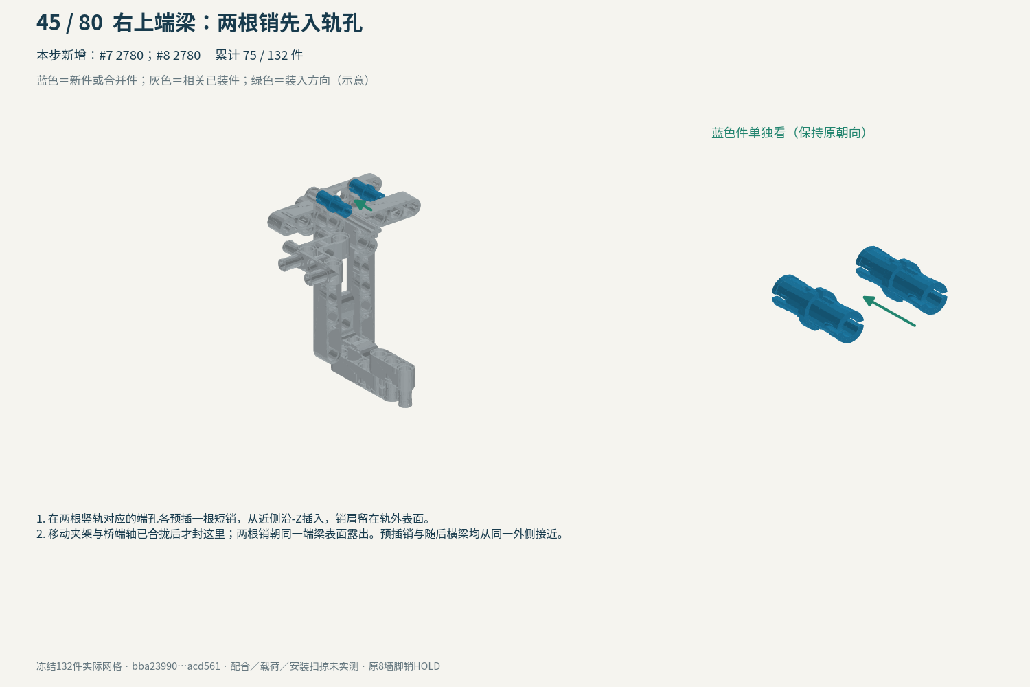
mechanical/final/site-source/dist/candidate132-steps/045.png
