gonewx/quadcuber/mechanical/final/site-source/dist/candidate132-steps/046.png

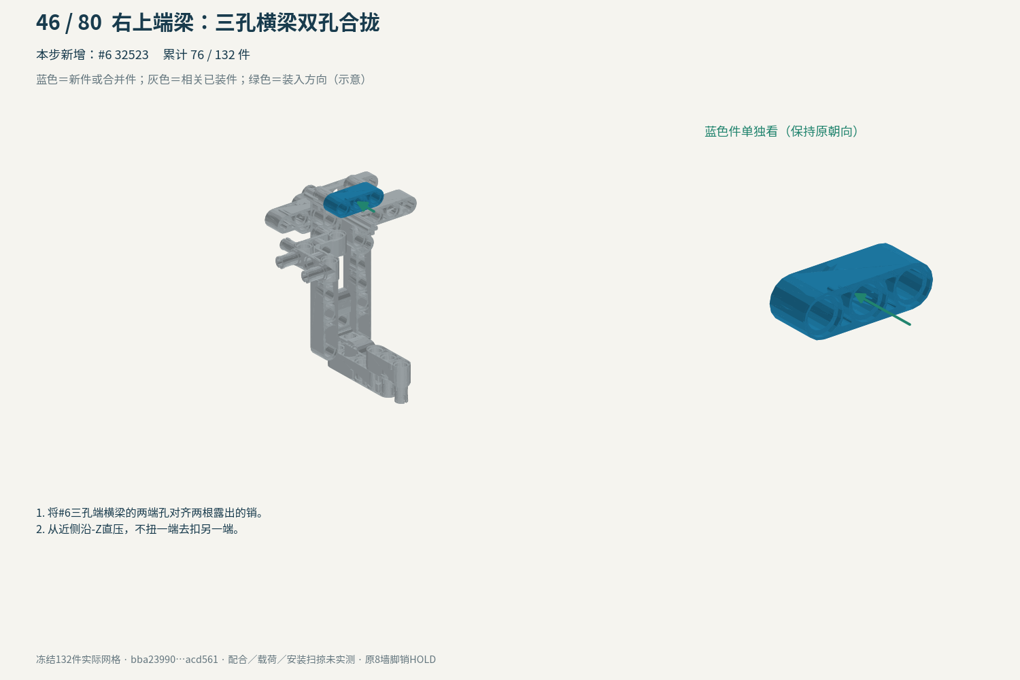
mechanical/final/site-source/dist/candidate132-steps/046.png
