gonewx/quadcuber/mechanical/final/site-source/dist/candidate132-steps/052.png

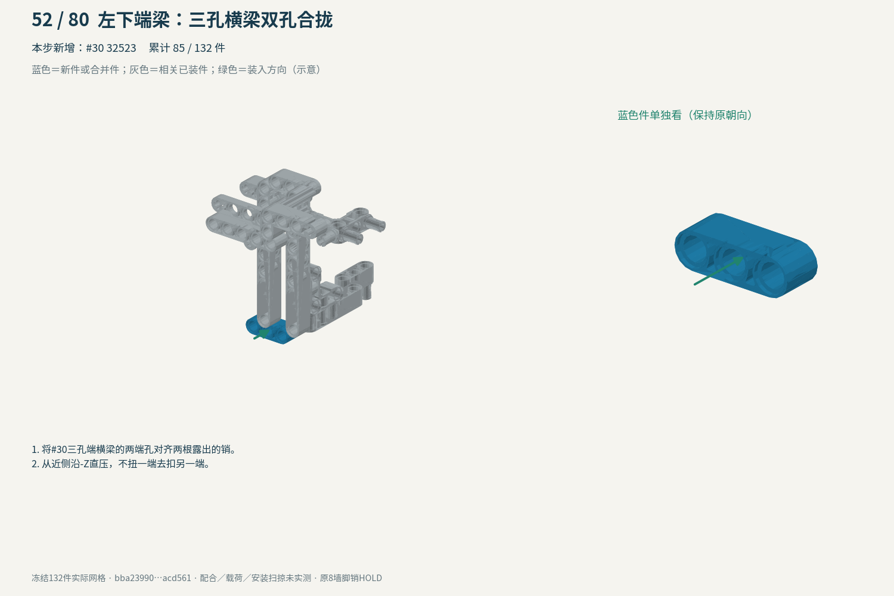
mechanical/final/site-source/dist/candidate132-steps/052.png
