gonewx/quadcuber/mechanical/final/site-source/dist/candidate132-steps/055.png

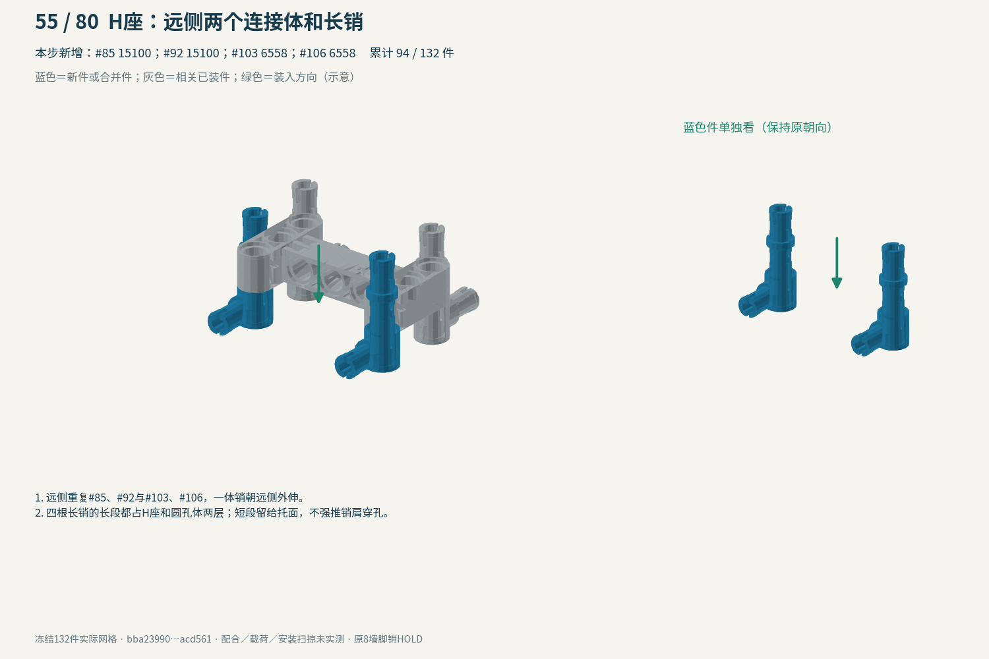
mechanical/final/site-source/dist/candidate132-steps/055.png
