gonewx/quadcuber/mechanical/final/site-source/dist/candidate132-steps/062.png

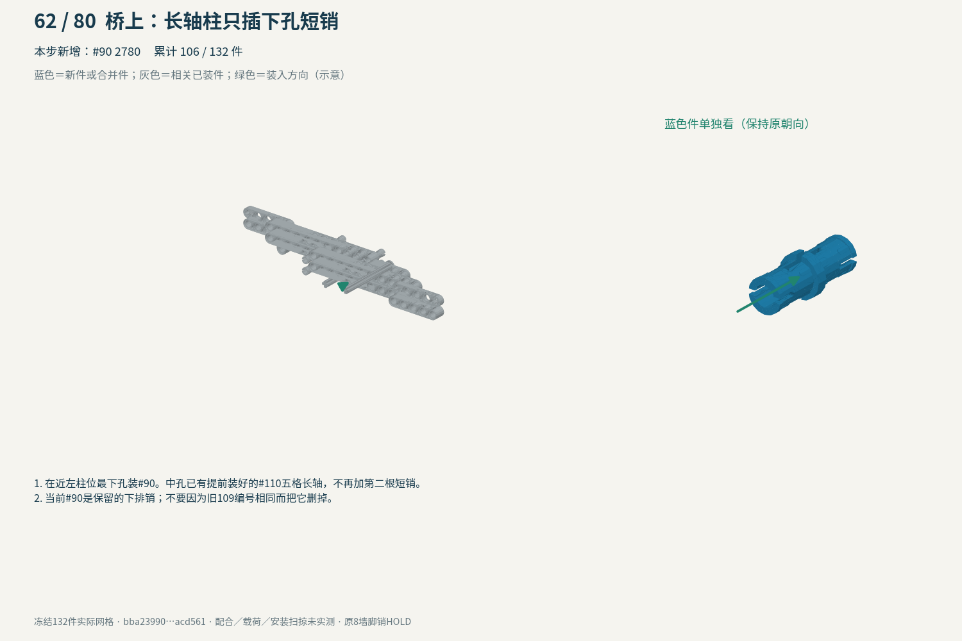
mechanical/final/site-source/dist/candidate132-steps/062.png
