gonewx/quadcuber/mechanical/final/site-source/dist/candidate132-steps/068.png

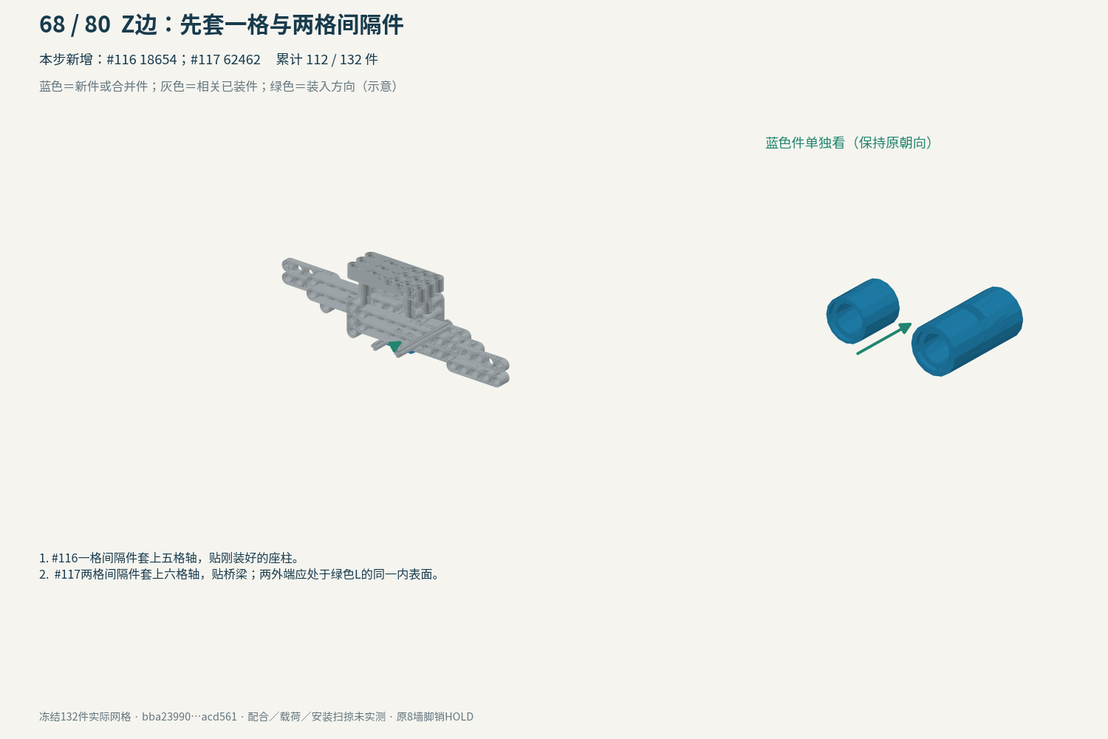
mechanical/final/site-source/dist/candidate132-steps/068.png
