gonewx/quadcuber/mechanical/final/site-source/dist/candidate132-steps/077.png

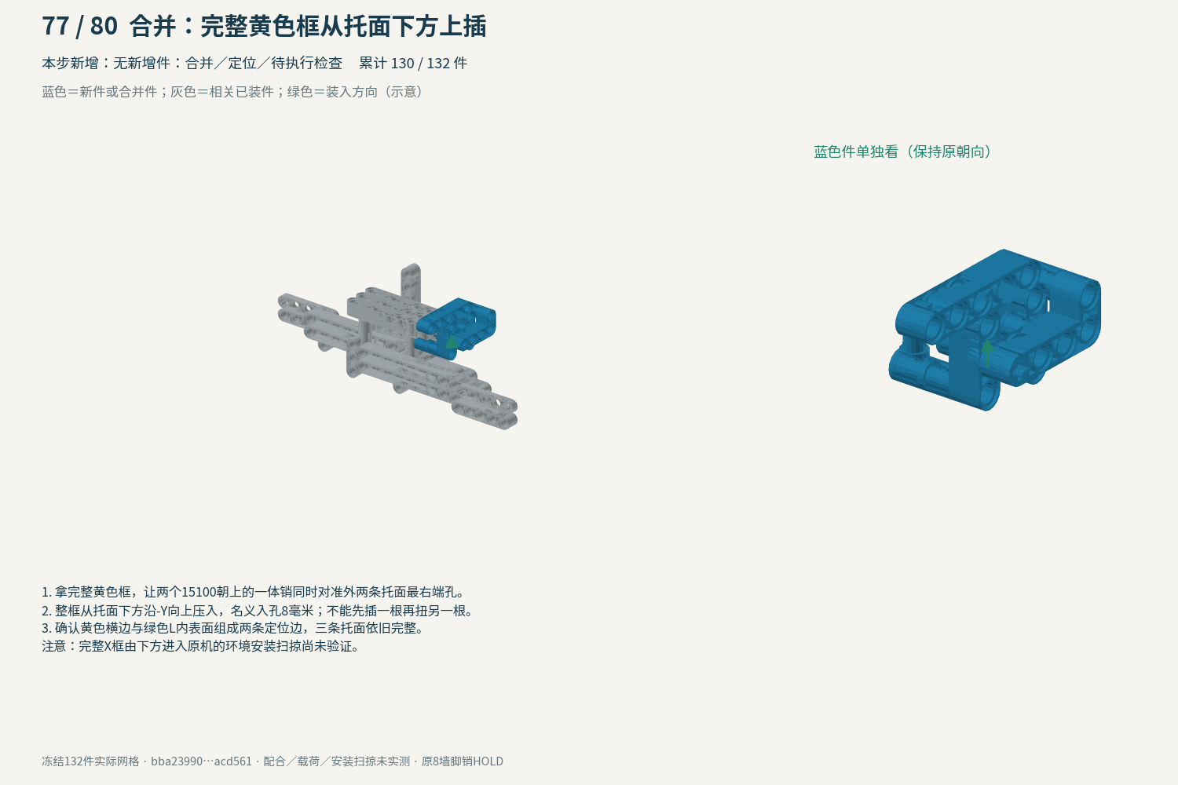
mechanical/final/site-source/dist/candidate132-steps/077.png
