gonewx/quadcuber/mechanical/final/site-source/dist/candidate132-steps/078.png

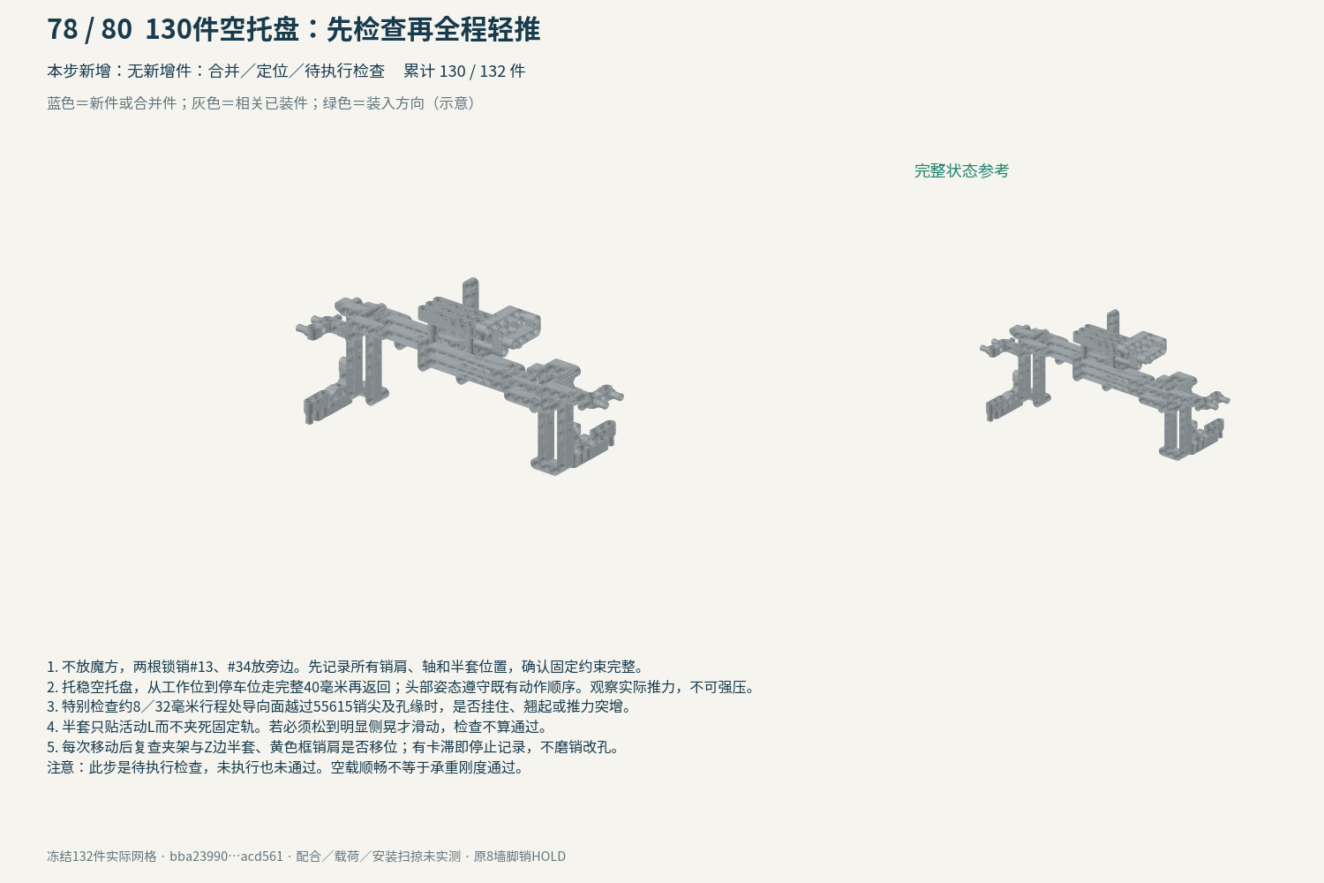
mechanical/final/site-source/dist/candidate132-steps/078.png
