gonewx/quadcuber/mechanical/final/site-source/dist/operation132/diagrams/fb_holds.png

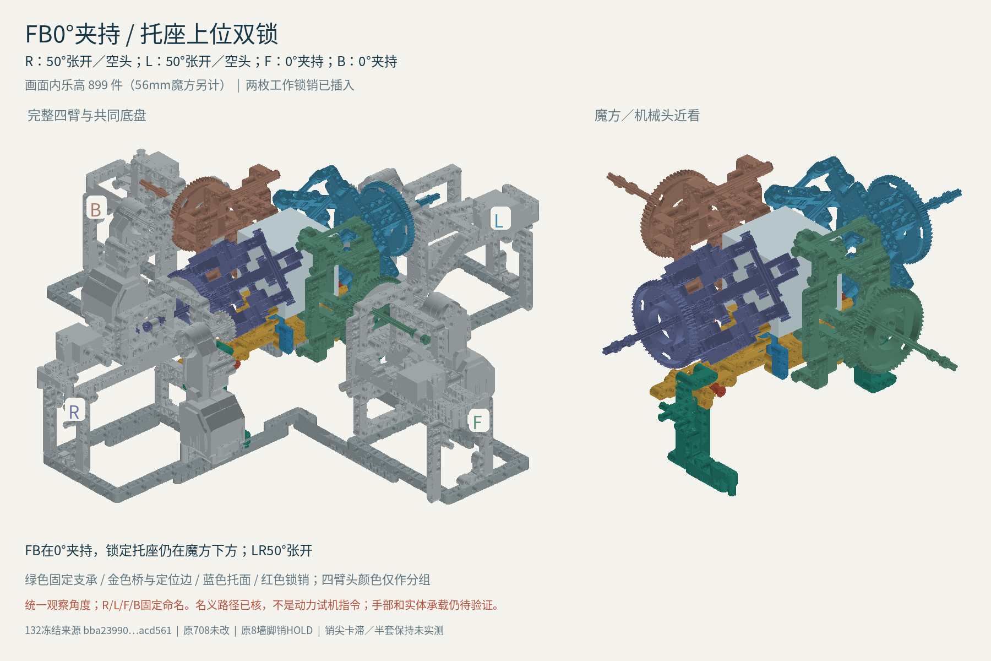
mechanical/final/site-source/dist/operation132/diagrams/fb_holds.png
