gonewx/quadcuber/mechanical/final/site-source/dist/operation132/diagrams/parked_fb.png

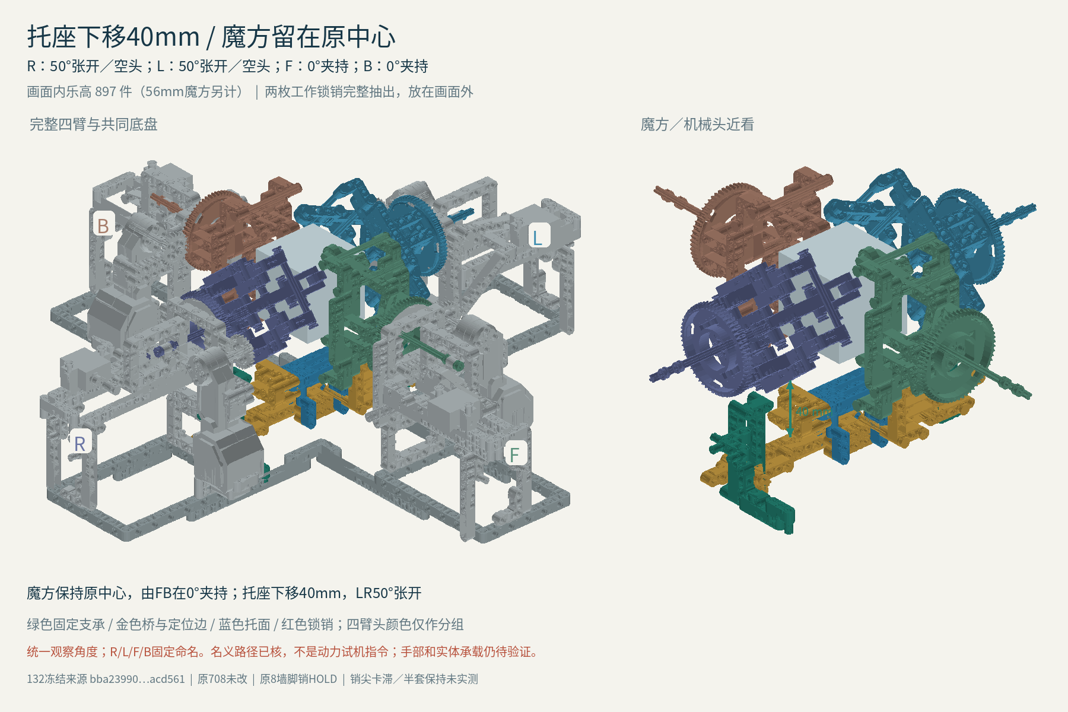
mechanical/final/site-source/dist/operation132/diagrams/parked_fb.png
