gonewx/quadcuber/mechanical/final/site-source/dist/steps219/bas-07.png

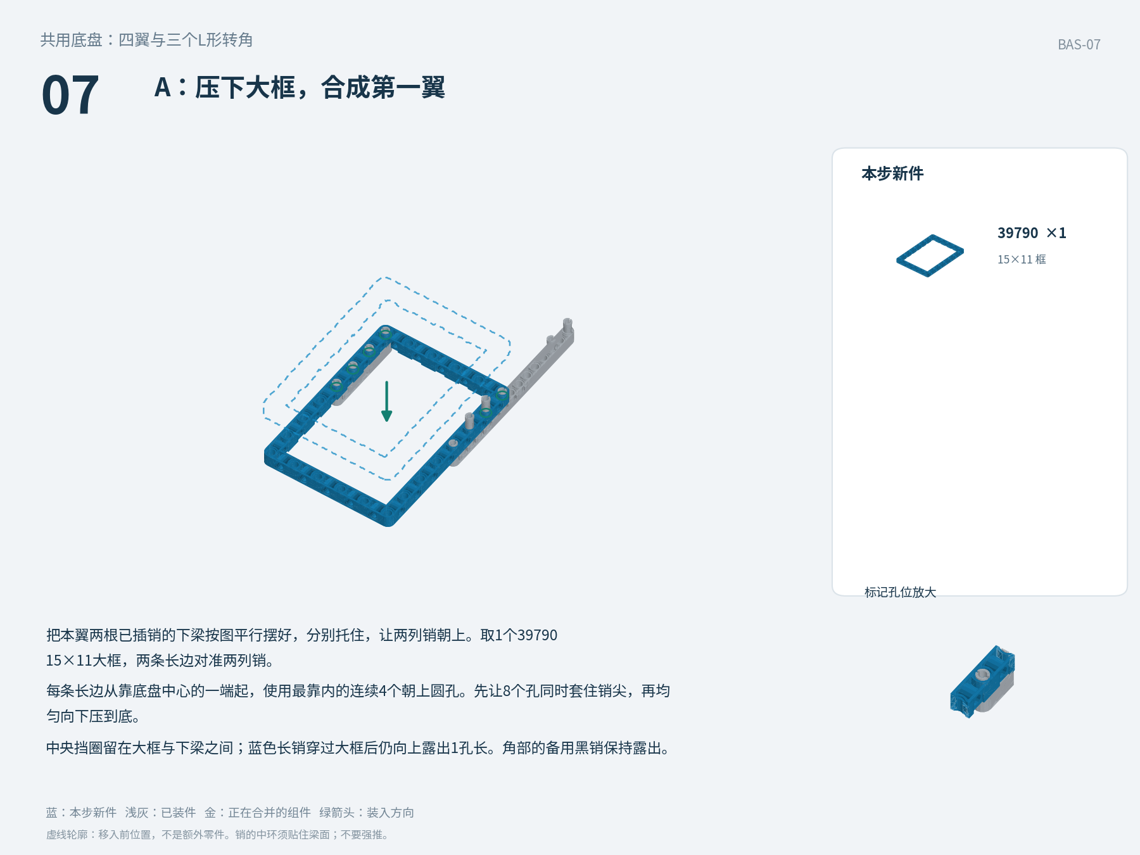
mechanical/final/site-source/dist/steps219/bas-07.png
