gonewx/quadcuber/mechanical/final/site-source/dist/steps219/car-01.png

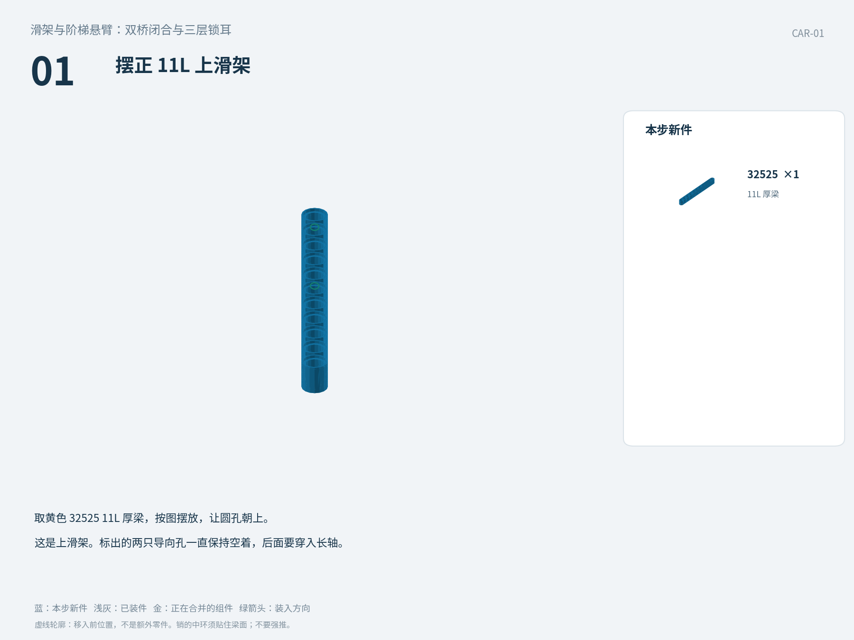
mechanical/final/site-source/dist/steps219/car-01.png
