gonewx/quadcuber/mechanical/final/site-source/dist/steps219/car-04.png

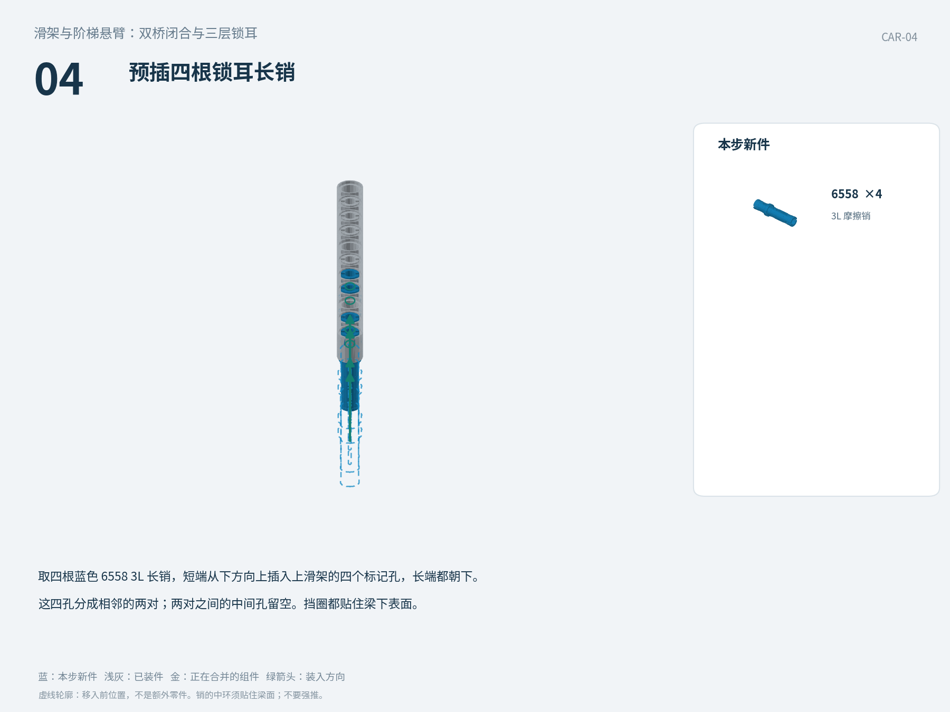
mechanical/final/site-source/dist/steps219/car-04.png
