gonewx/quadcuber/mechanical/final/site-source/dist/steps219/car-06.png

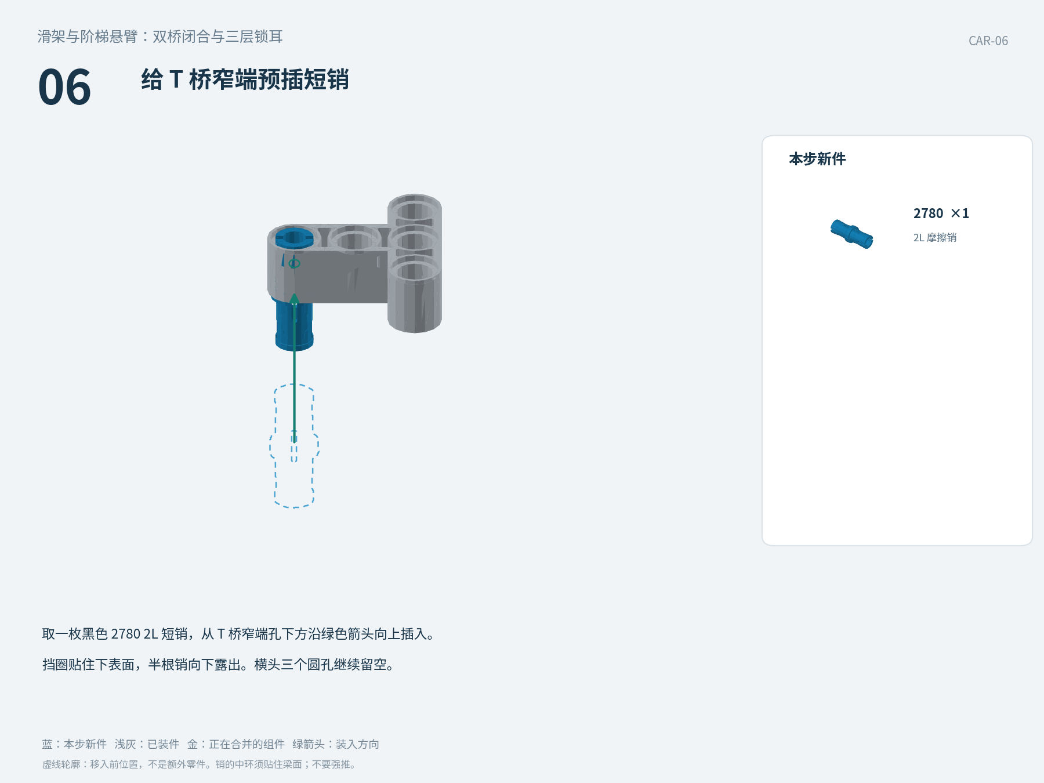
mechanical/final/site-source/dist/steps219/car-06.png
