gonewx/quadcuber/mechanical/final/site-source/dist/steps219/car-07.png

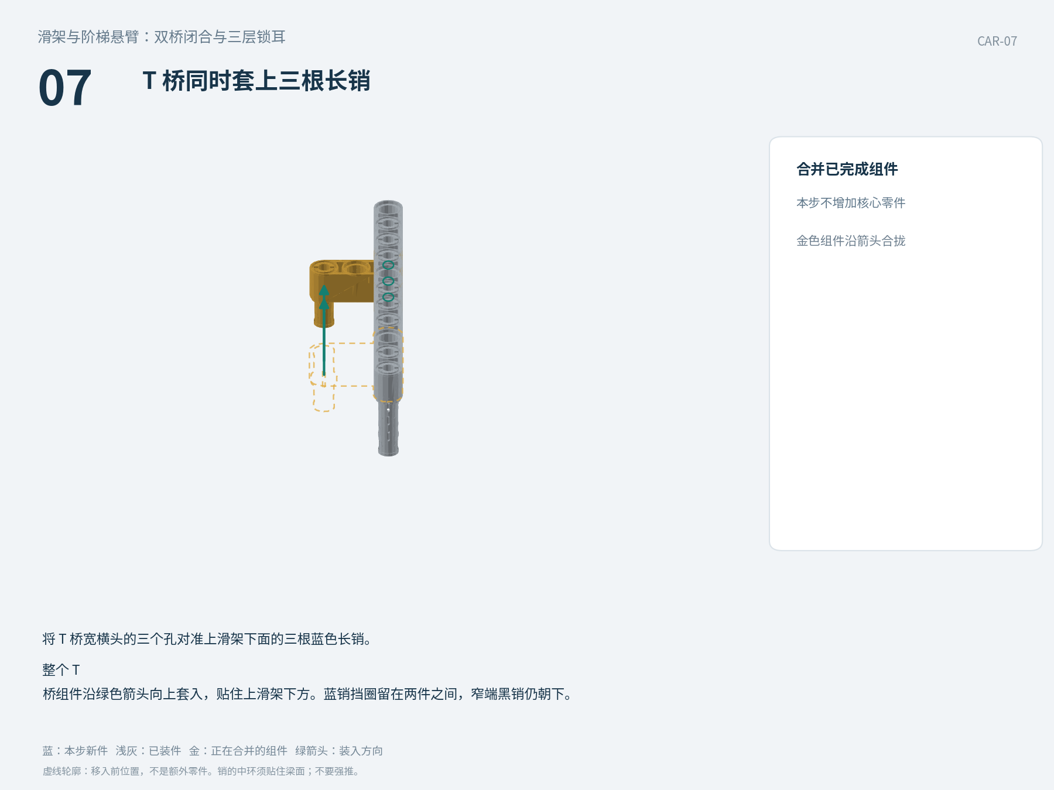
mechanical/final/site-source/dist/steps219/car-07.png
