gonewx/quadcuber/mechanical/final/site-source/dist/steps219/car-10.png

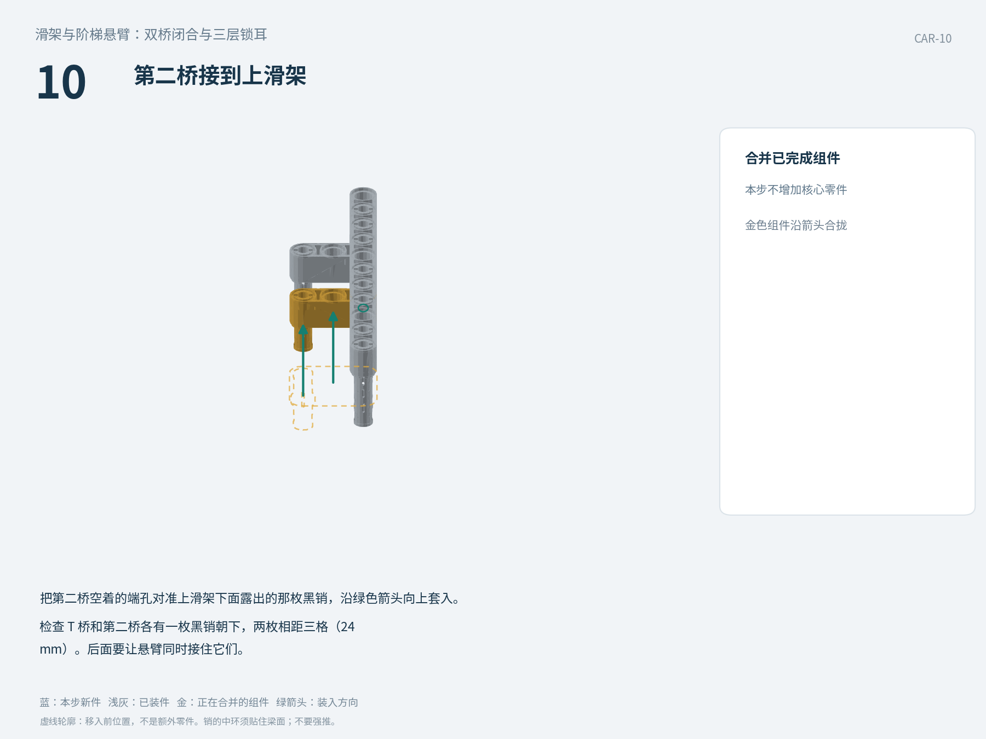
mechanical/final/site-source/dist/steps219/car-10.png
