gonewx/quadcuber/mechanical/final/site-source/dist/steps219/car-11.png

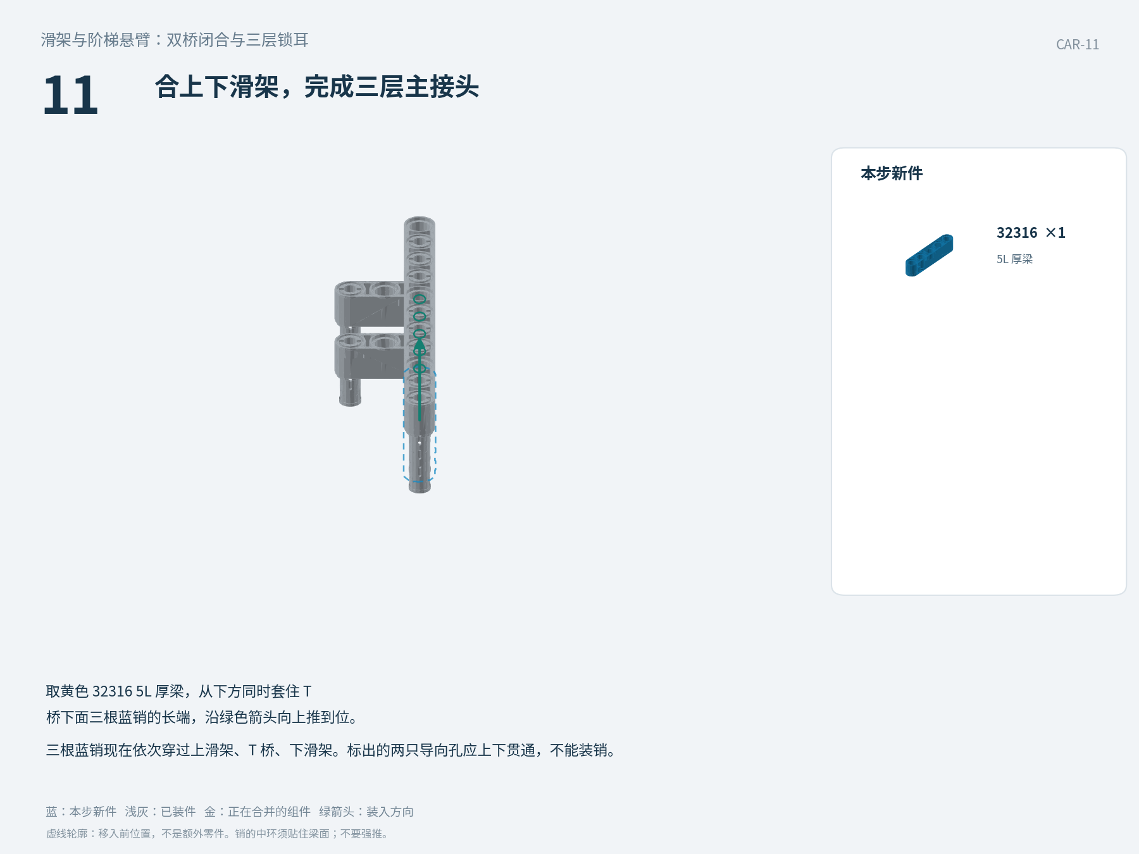
mechanical/final/site-source/dist/steps219/car-11.png
