gonewx/quadcuber/mechanical/final/site-source/dist/steps219/car-17.png

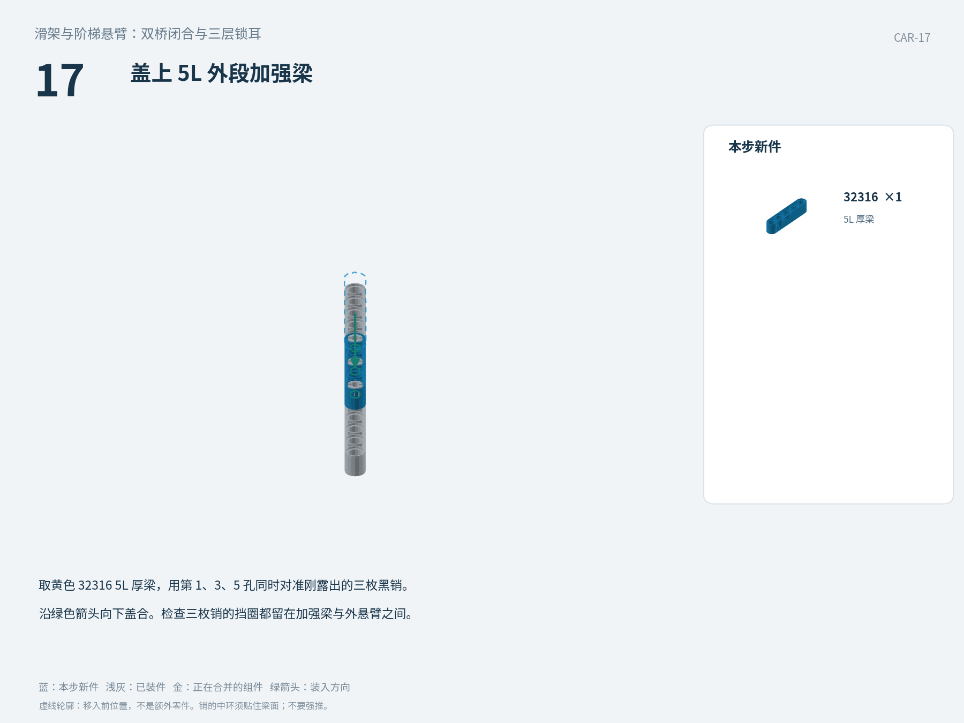
mechanical/final/site-source/dist/steps219/car-17.png
