gonewx/quadcuber/mechanical/final/site-source/dist/steps219/car-20.png

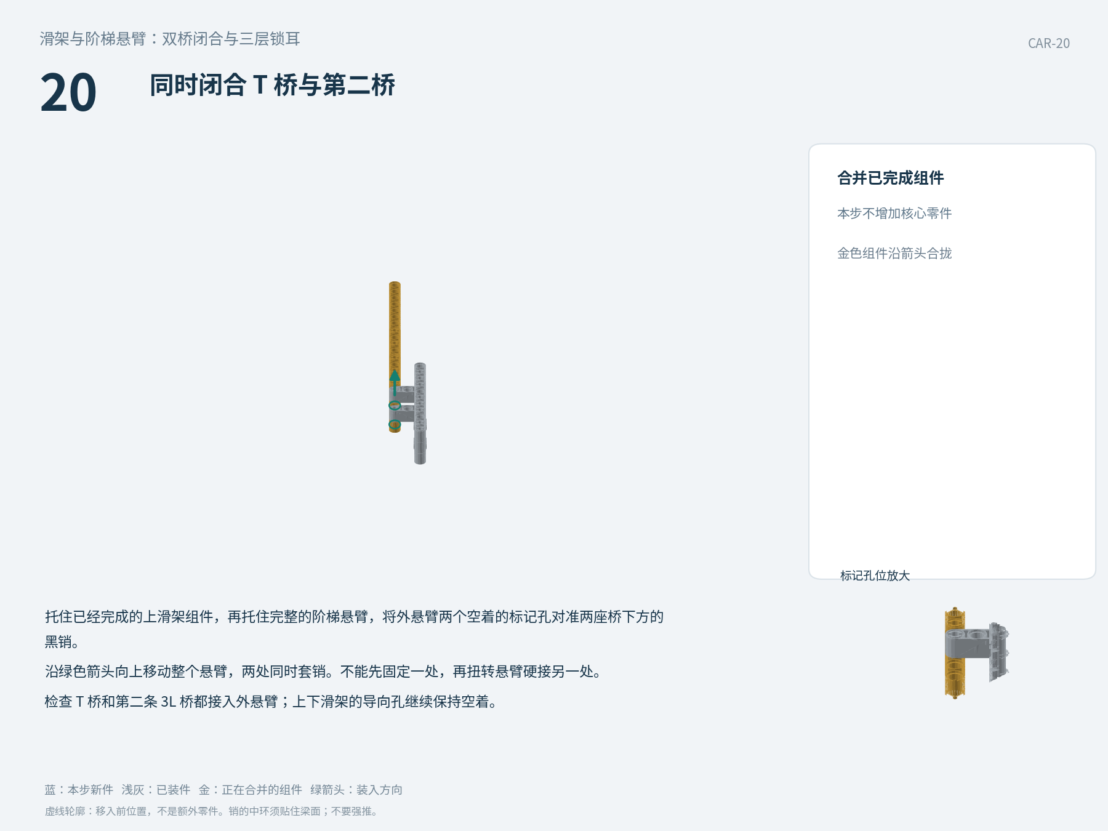
mechanical/final/site-source/dist/steps219/car-20.png
