gonewx/quadcuber/mechanical/final/site-source/dist/steps219/cor-01.png

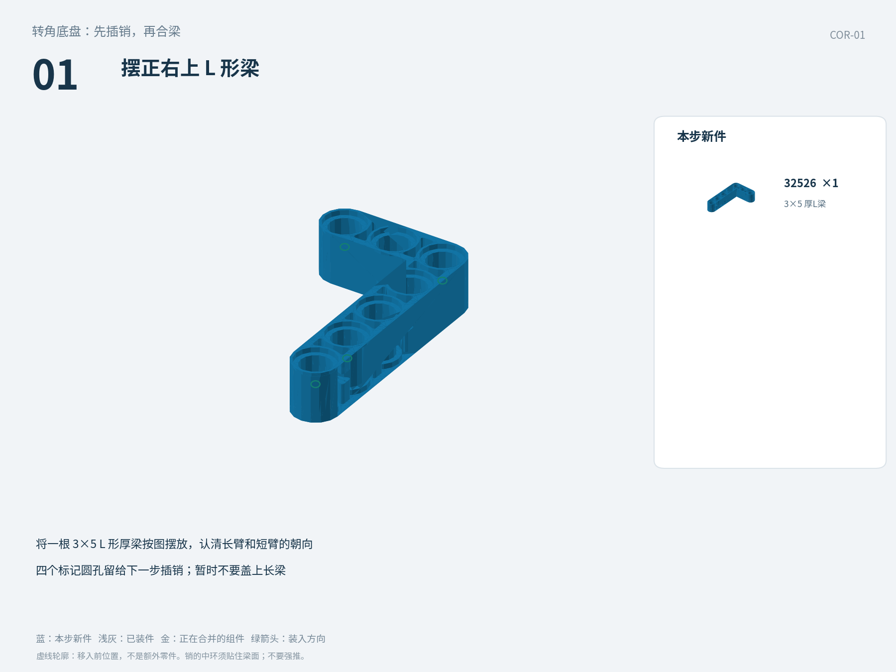
mechanical/final/site-source/dist/steps219/cor-01.png
