gonewx/quadcuber/mechanical/final/site-source/dist/steps219/cor-07.png

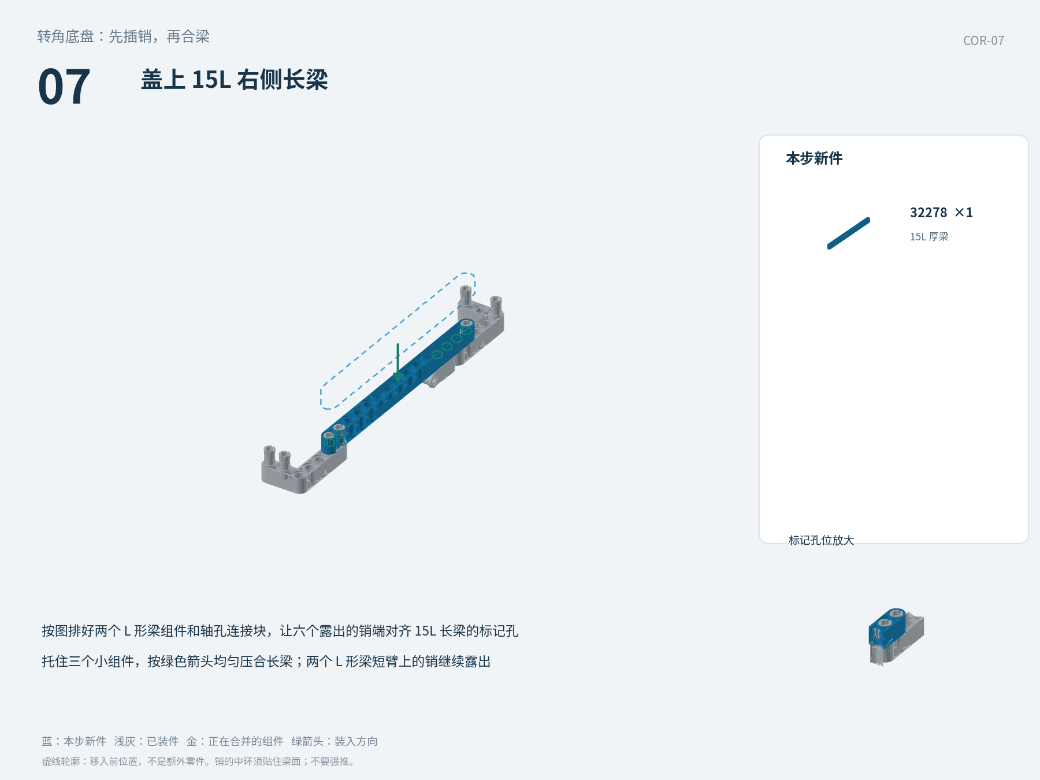
mechanical/final/site-source/dist/steps219/cor-07.png
