gonewx/quadcuber/mechanical/final/site-source/dist/steps219/cor-11.png

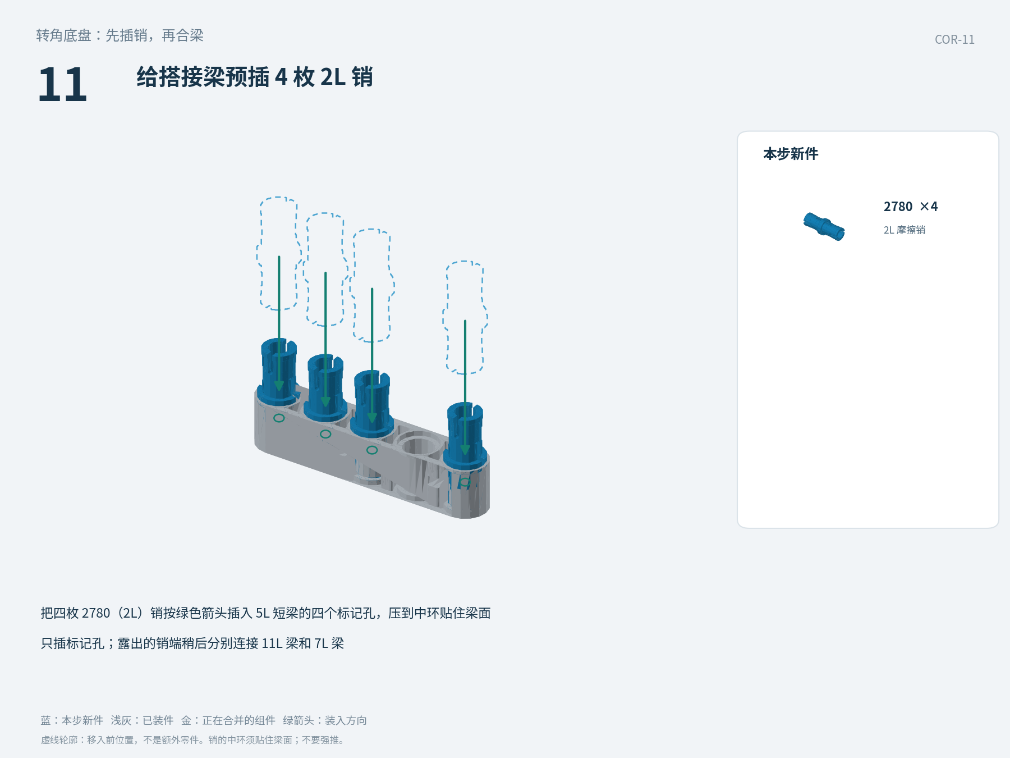
mechanical/final/site-source/dist/steps219/cor-11.png
