gonewx/quadcuber/mechanical/final/site-source/dist/steps219/gde-06.png

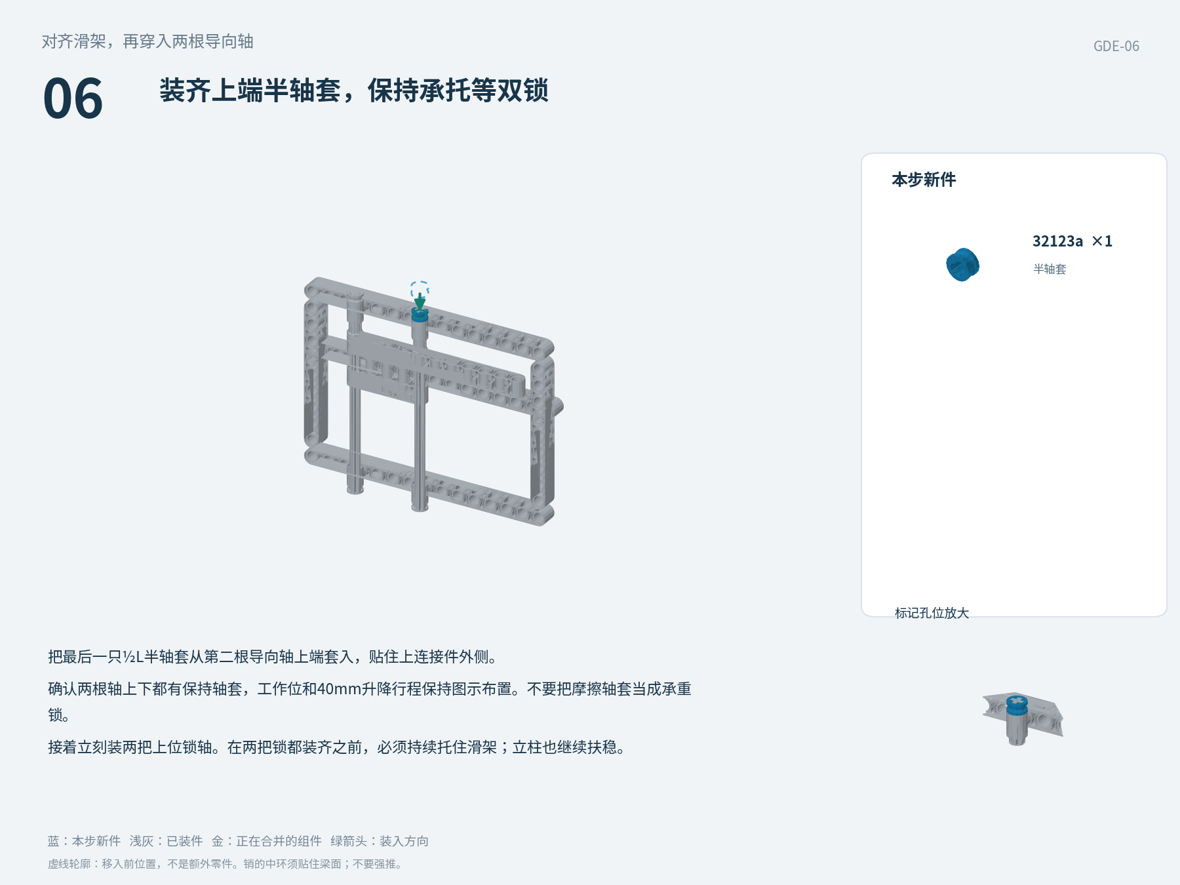
mechanical/final/site-source/dist/steps219/gde-06.png
