gonewx/quadcuber/mechanical/final/site-source/dist/steps219/key-04.png

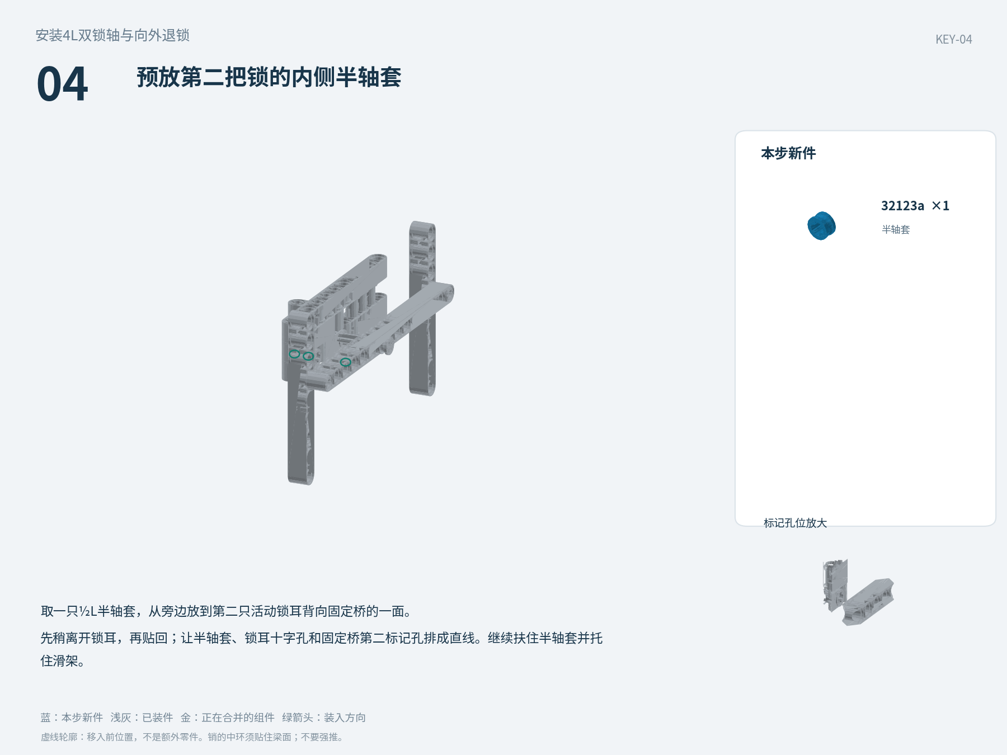
mechanical/final/site-source/dist/steps219/key-04.png
