gonewx/quadcuber/mechanical/final/site-source/dist/steps219/key-05.png

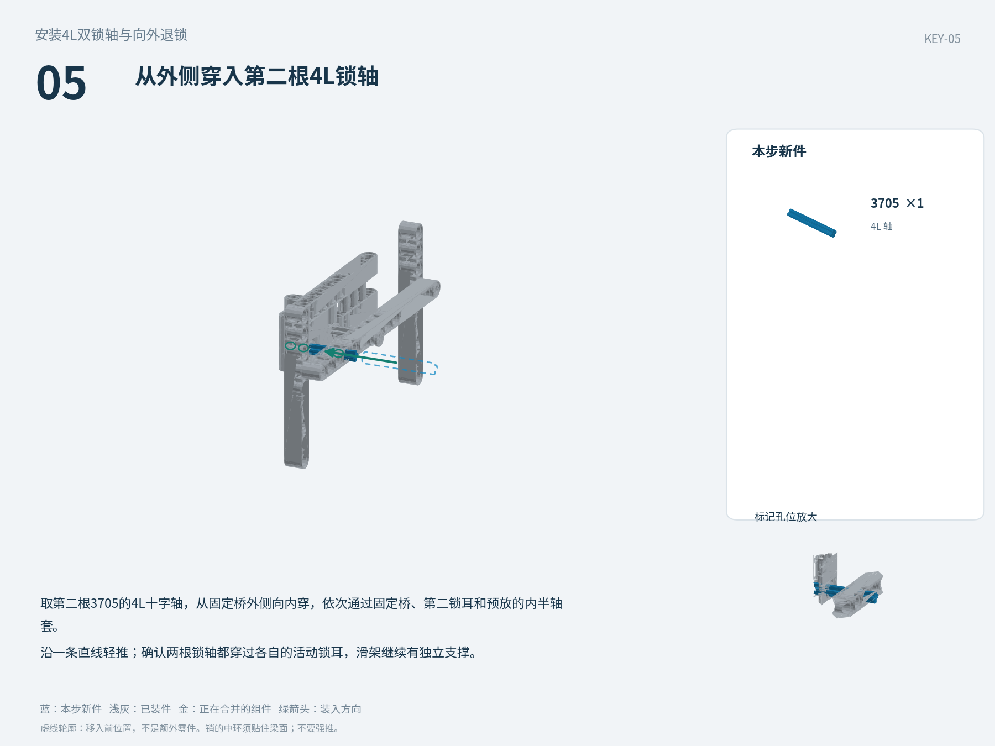
mechanical/final/site-source/dist/steps219/key-05.png
