gonewx/quadcuber/mechanical/final/site-source/dist/steps219/mst-01.png

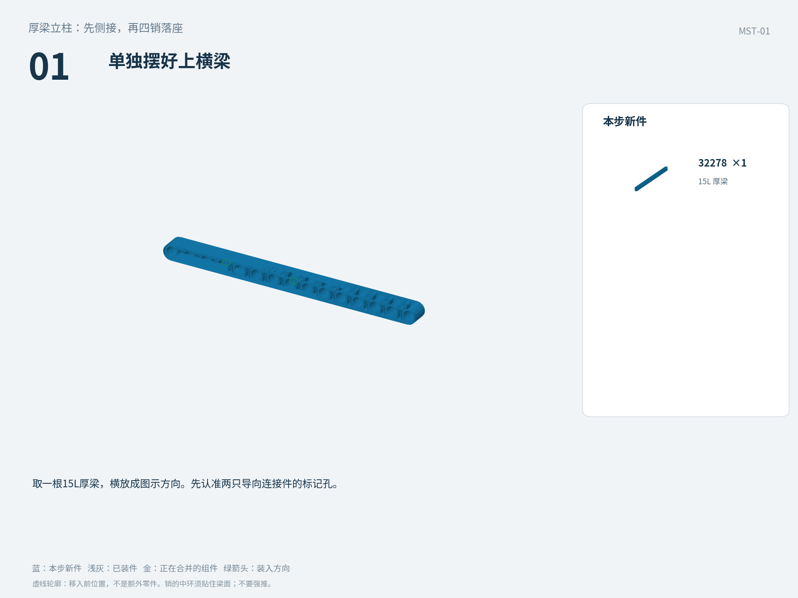
mechanical/final/site-source/dist/steps219/mst-01.png
