gonewx/quadcuber/mechanical/final/site-source/dist/steps219/mst-13.png

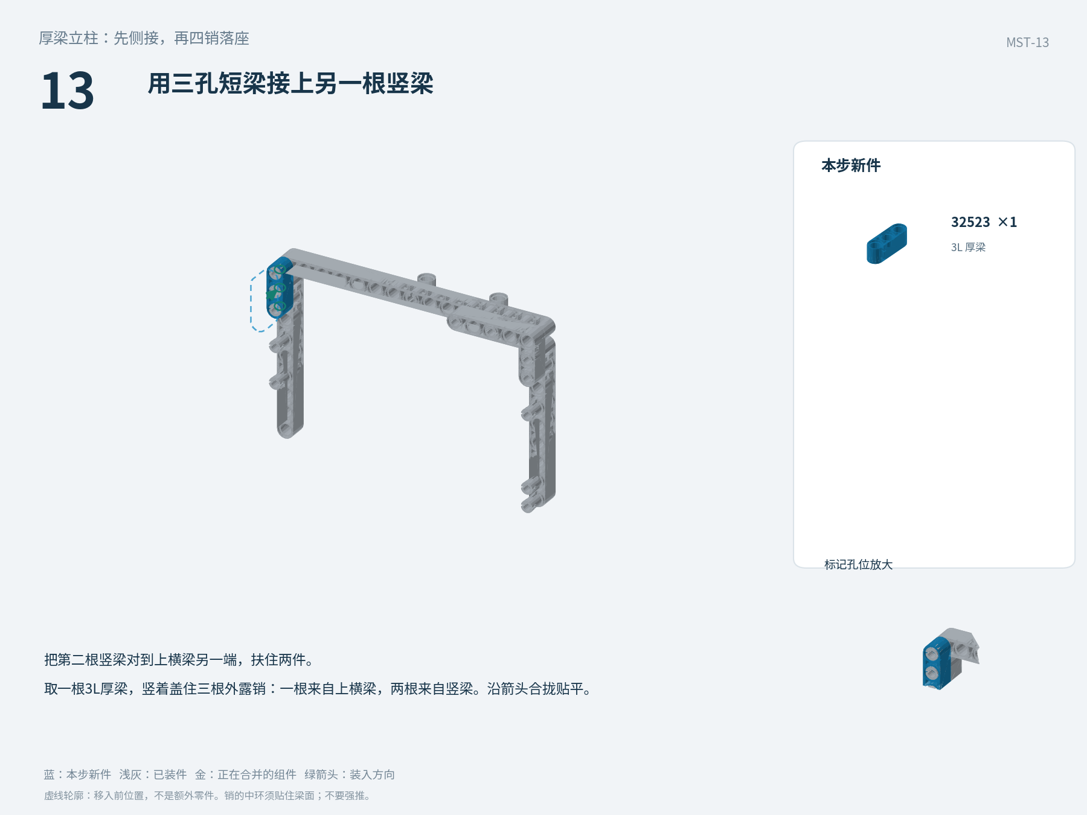
mechanical/final/site-source/dist/steps219/mst-13.png
