gonewx/quadcuber/mechanical/final/site-source/dist/steps219/mst-15.png

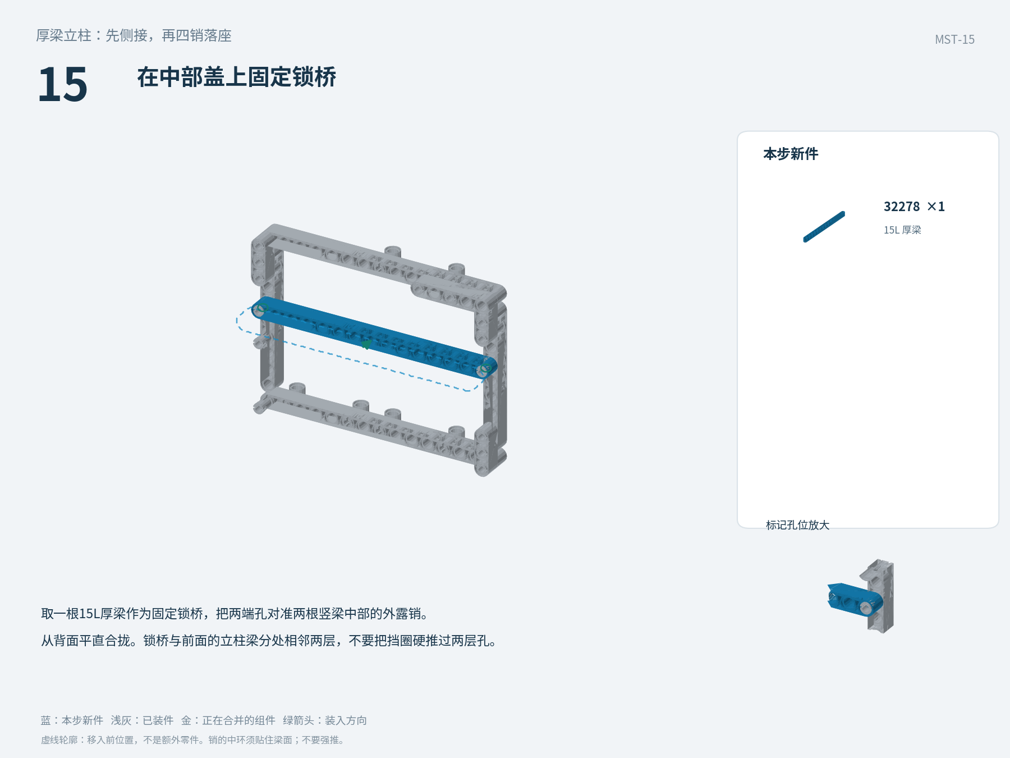
mechanical/final/site-source/dist/steps219/mst-15.png
