gonewx/quadcuber/mechanical/final/site-source/dist/steps219/mst-16.png

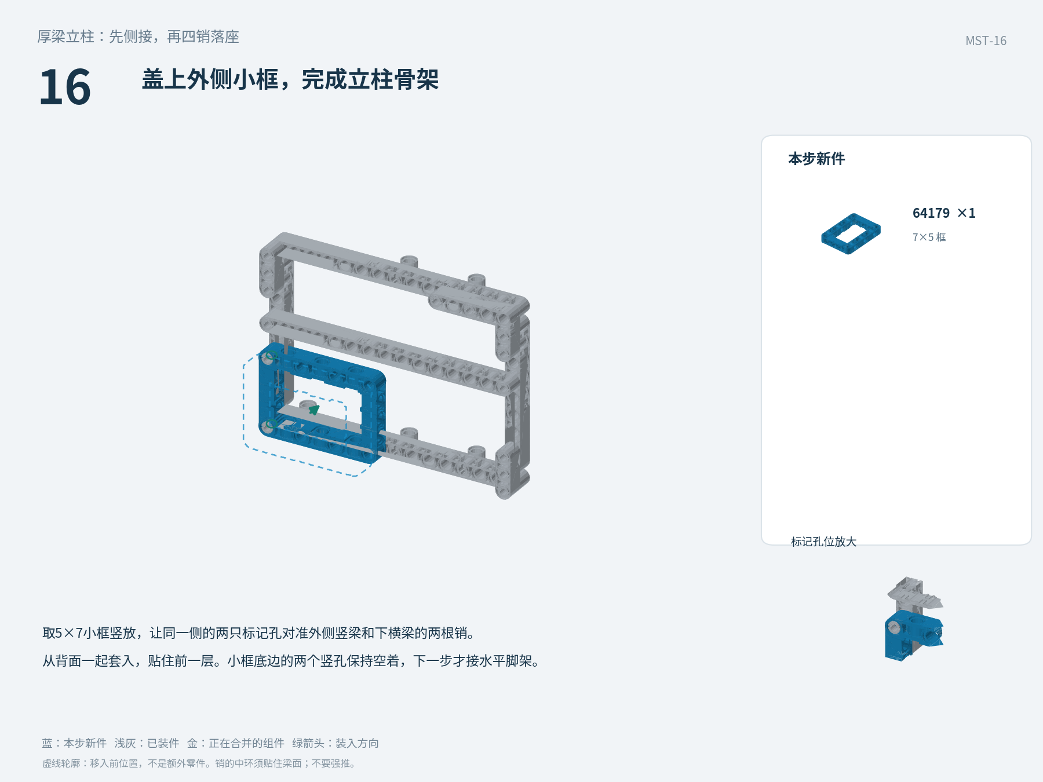
mechanical/final/site-source/dist/steps219/mst-16.png
