gonewx/quadcuber/mechanical/final/site-source/dist/steps219/mst-18.png

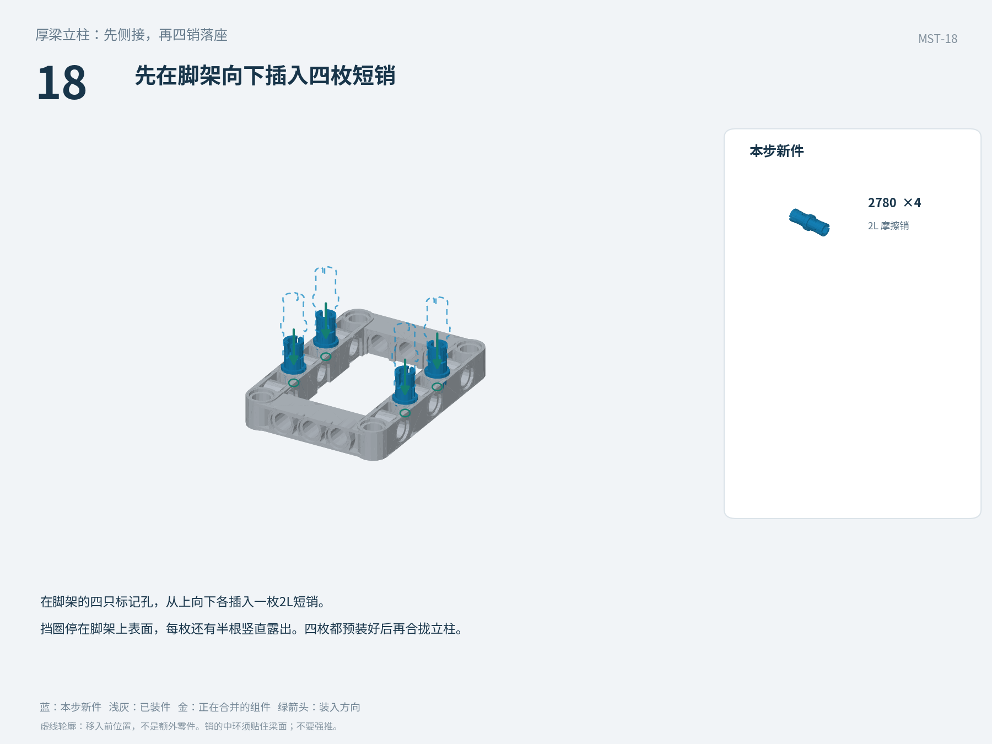
mechanical/final/site-source/dist/steps219/mst-18.png
