gonewx/quadcuber/mechanical/final/site-source/dist/steps219/mst-19.png

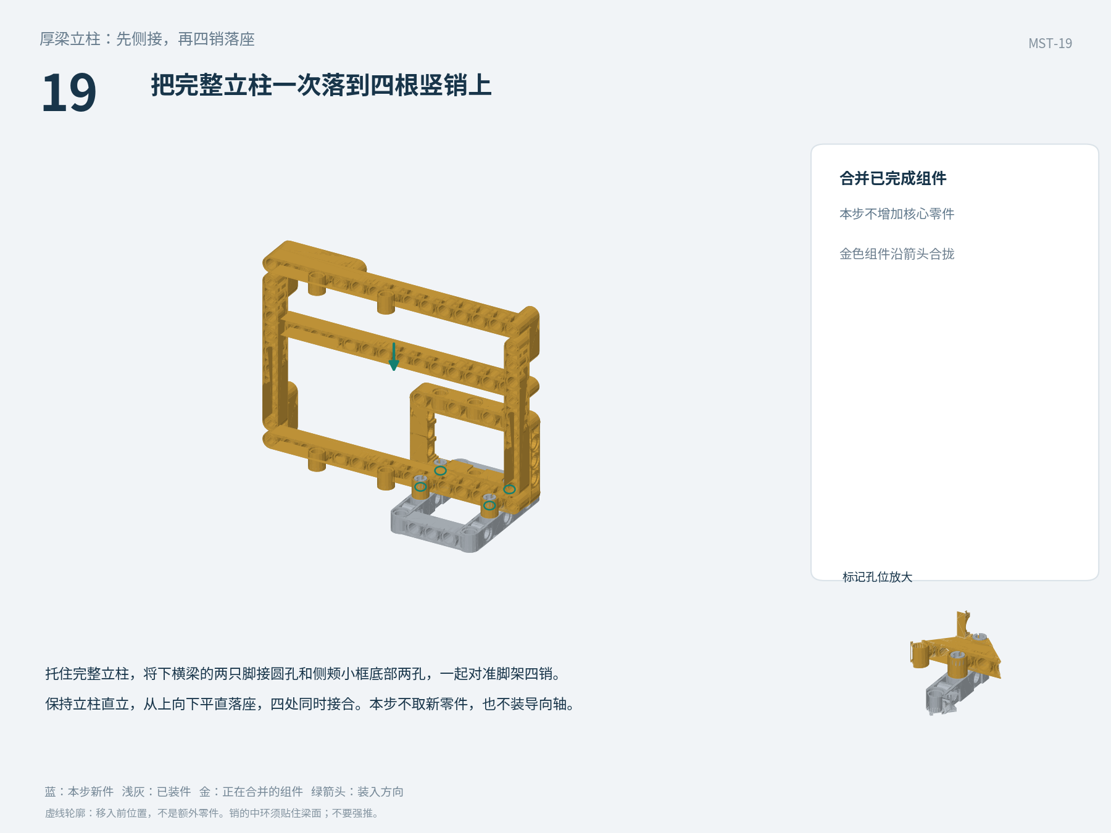
mechanical/final/site-source/dist/steps219/mst-19.png
