gonewx/quadcuber/mechanical/final/site-source/dist/steps219/seat-02.png

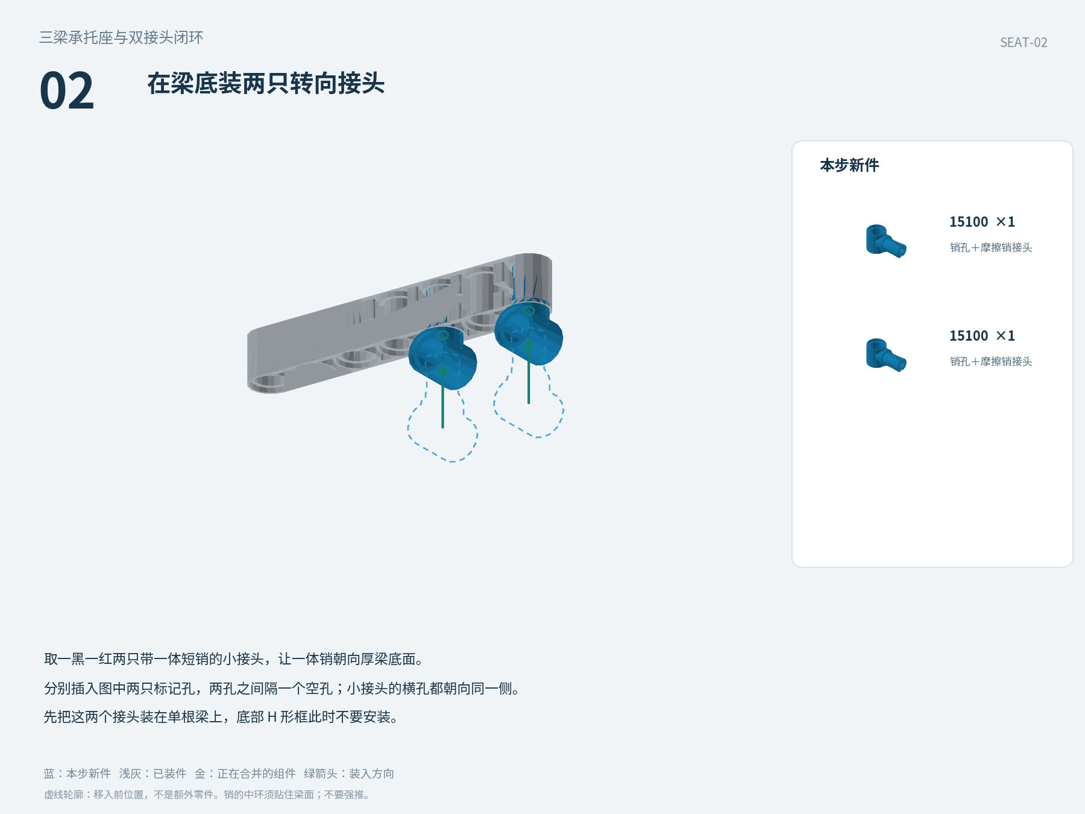
mechanical/final/site-source/dist/steps219/seat-02.png
