gonewx/quadcuber/mechanical/final/site-source/dist/steps219/seat-08.png

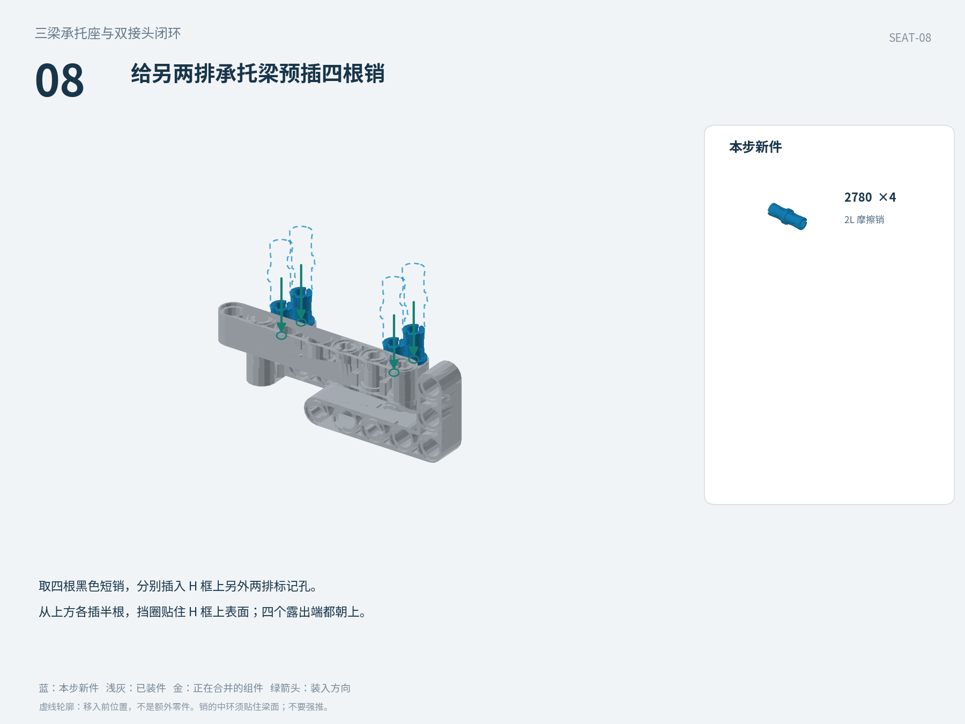
mechanical/final/site-source/dist/steps219/seat-08.png
