gonewx/quadcuber/mechanical/final/site-source/dist/steps219/seat-12.png

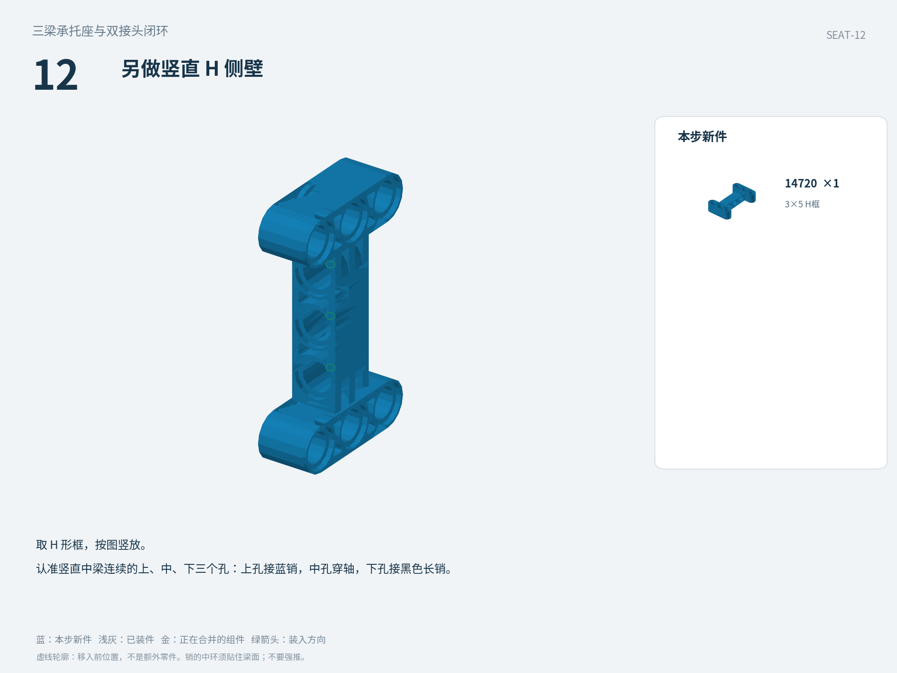
mechanical/final/site-source/dist/steps219/seat-12.png
