gonewx/quadcuber/mechanical/final/site-source/dist/steps219/seat-13.png

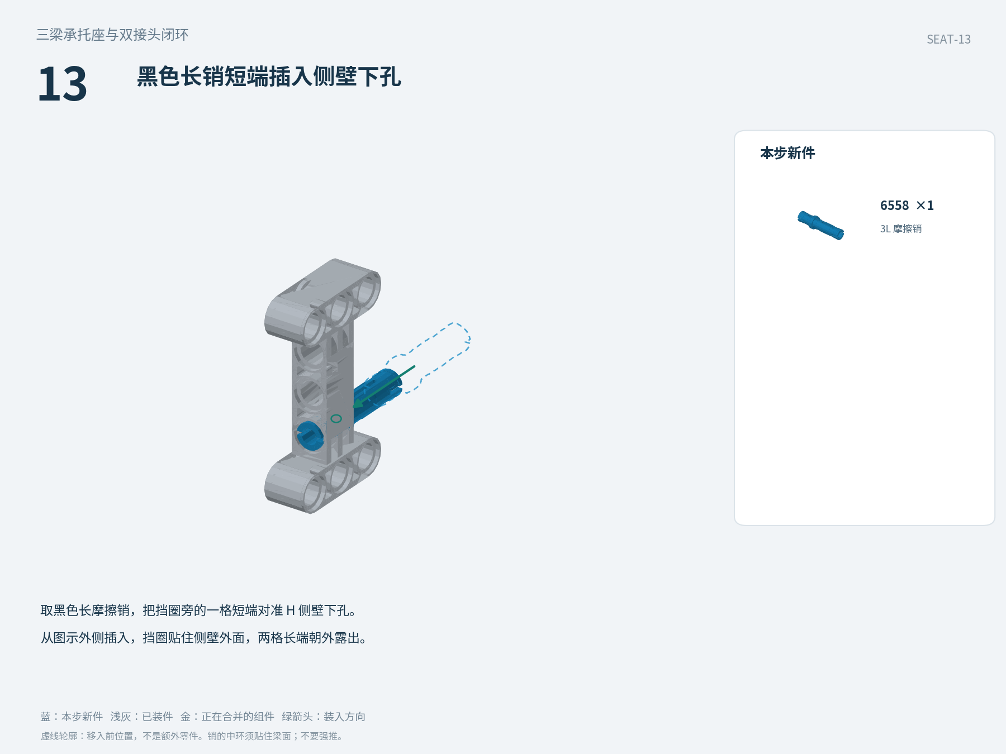
mechanical/final/site-source/dist/steps219/seat-13.png
