gonewx/quadcuber/mechanical/final/site-source/dist/steps219/seat-16.png

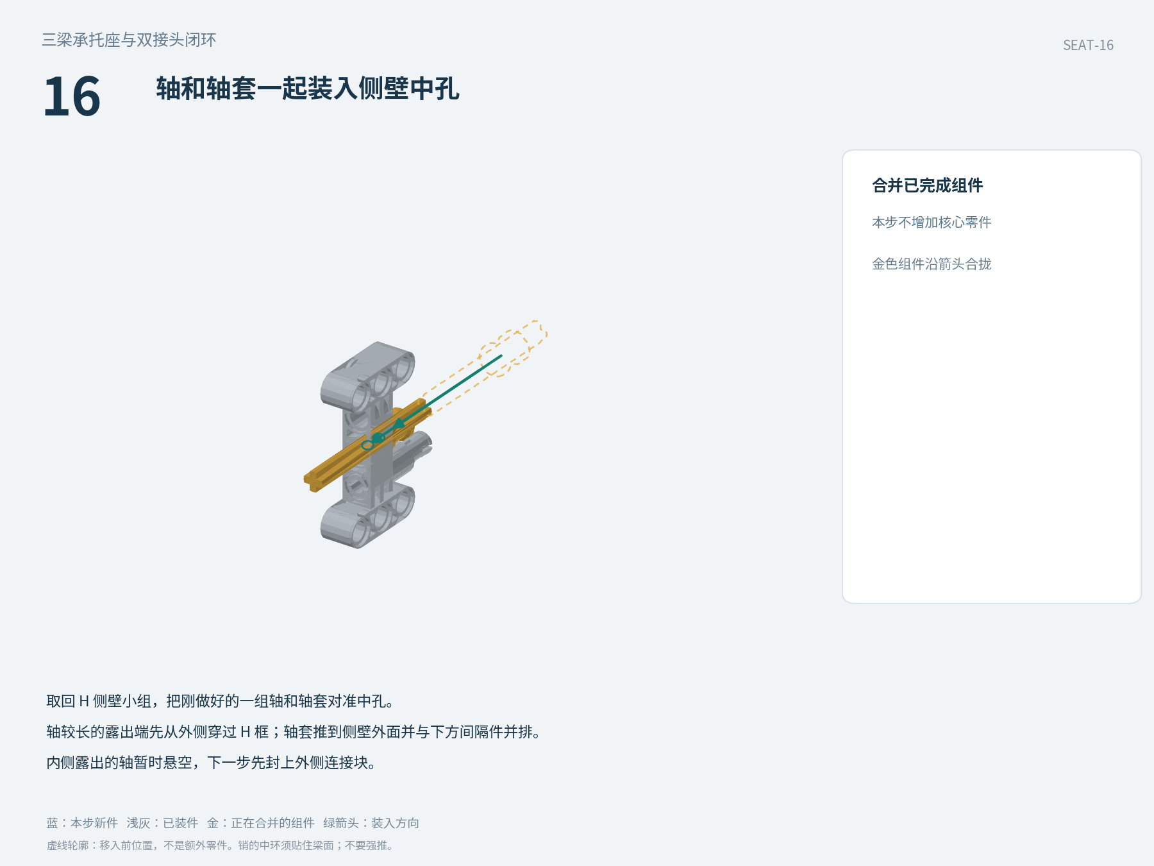
mechanical/final/site-source/dist/steps219/seat-16.png
