gonewx/quadcuber/mechanical/final/site-source/dist/steps219/seat-18.png

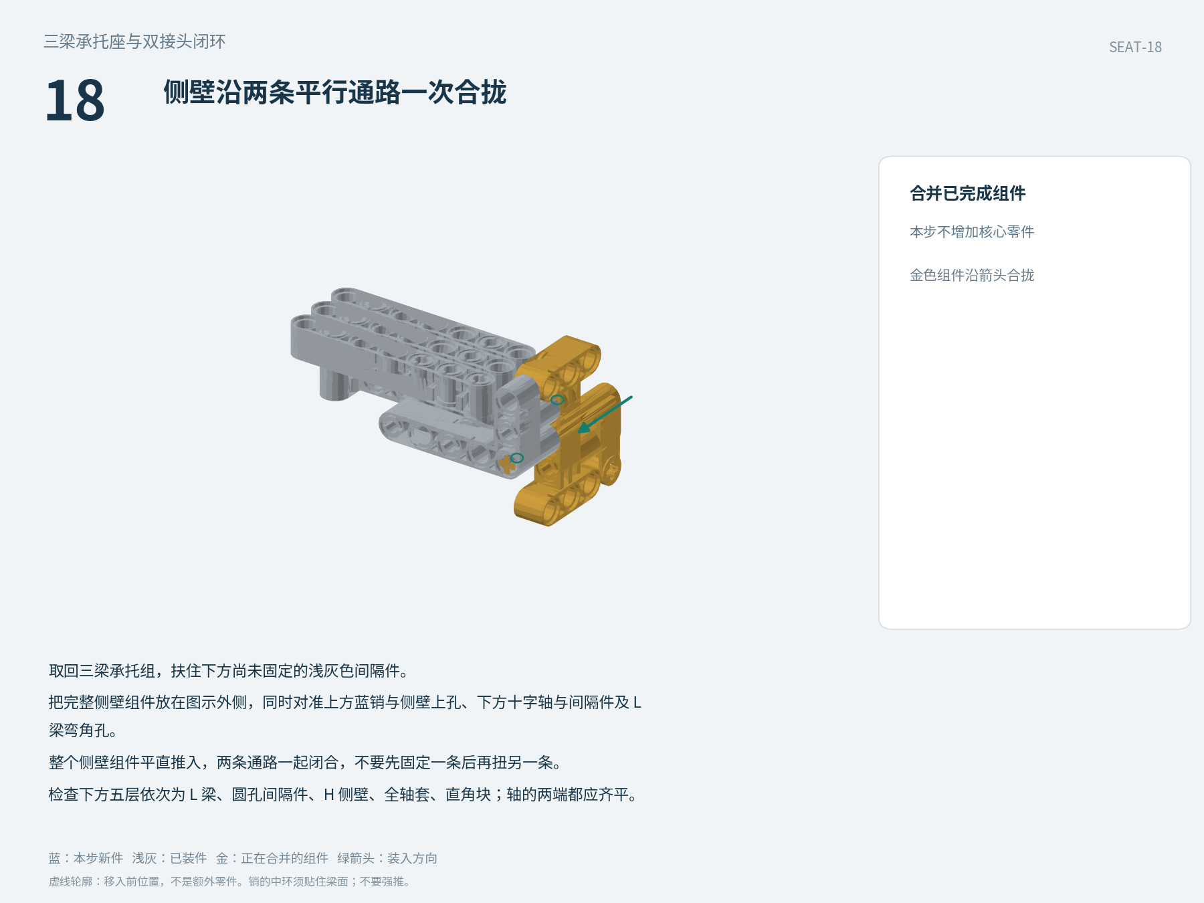
mechanical/final/site-source/dist/steps219/seat-18.png
