gonewx/quadcuber/mechanical/final/site-source/dist/steps219/seat-19.png

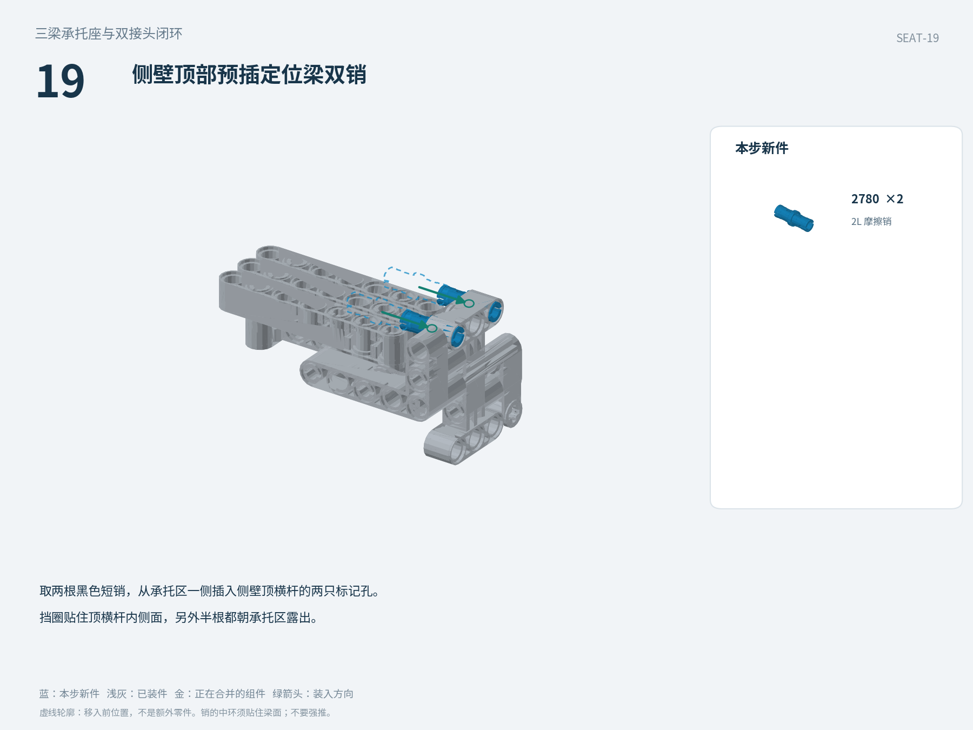
mechanical/final/site-source/dist/steps219/seat-19.png
