gonewx/quadcuber/mechanical/final/site-source/dist/steps219/seat-23.png

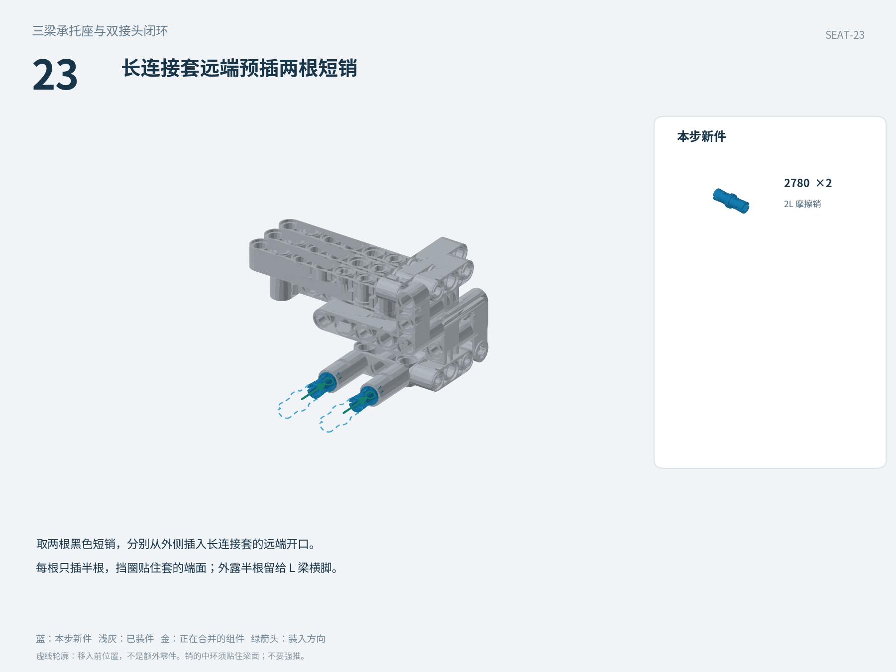
mechanical/final/site-source/dist/steps219/seat-23.png
