gonewx/quadcuber/mechanical/final/site-source/dist/steps219/sel-04.png

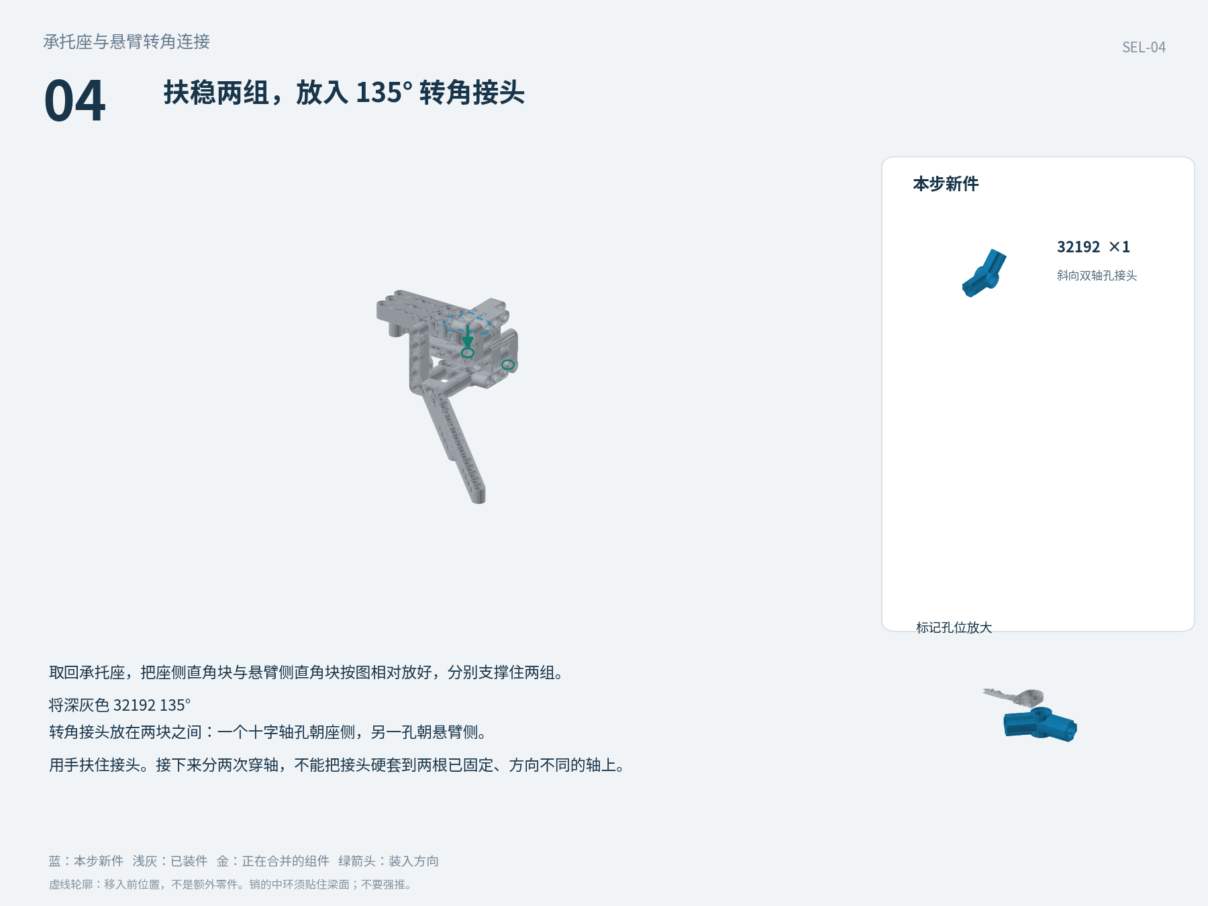
mechanical/final/site-source/dist/steps219/sel-04.png
