gonewx/quadcuber/mechanical/final/site-source/dist/steps219/sel-08.png

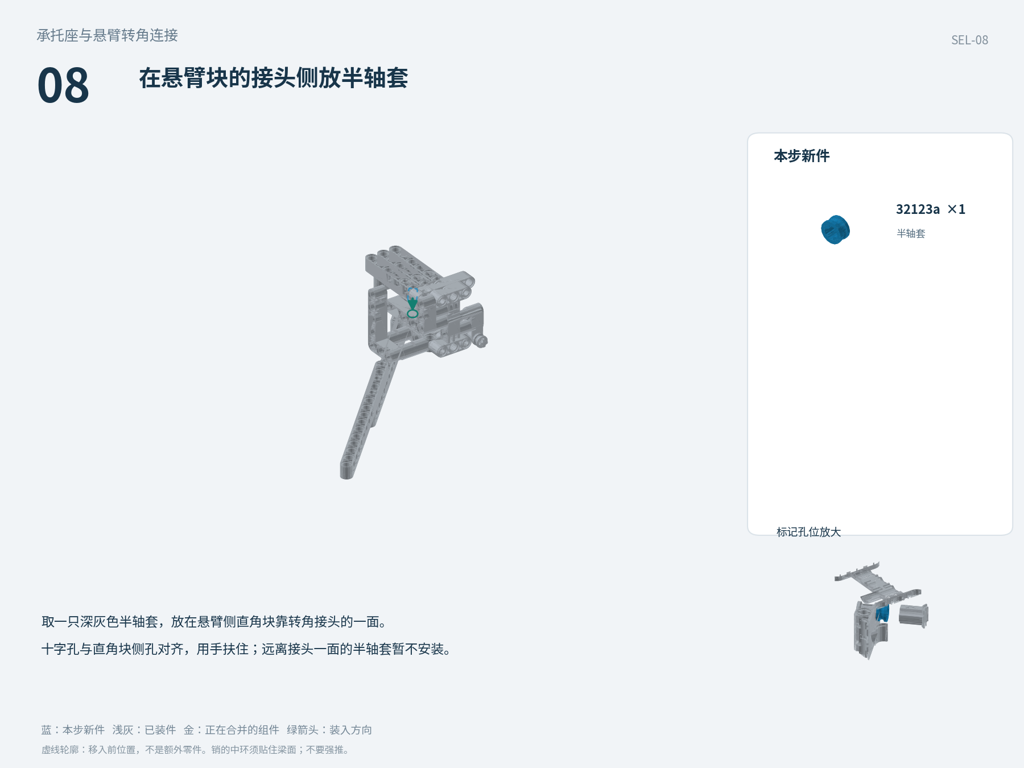
mechanical/final/site-source/dist/steps219/sel-08.png
