gonewx/quadcuber/mechanical/final/site-source/dist/steps219/tie-01.png

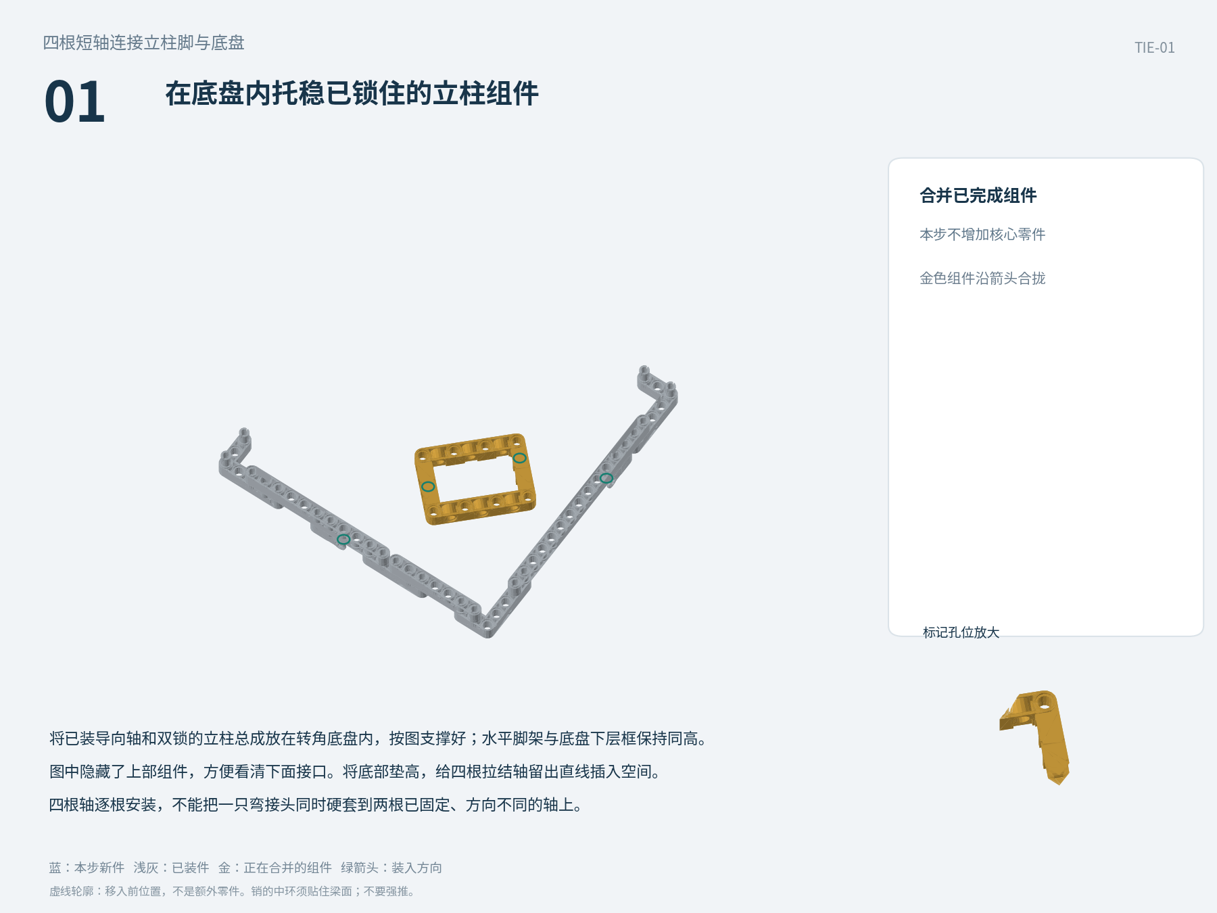
mechanical/final/site-source/dist/steps219/tie-01.png
