gonewx/quadcuber/mechanical/final/site-source/dist/steps219/tie-04.png

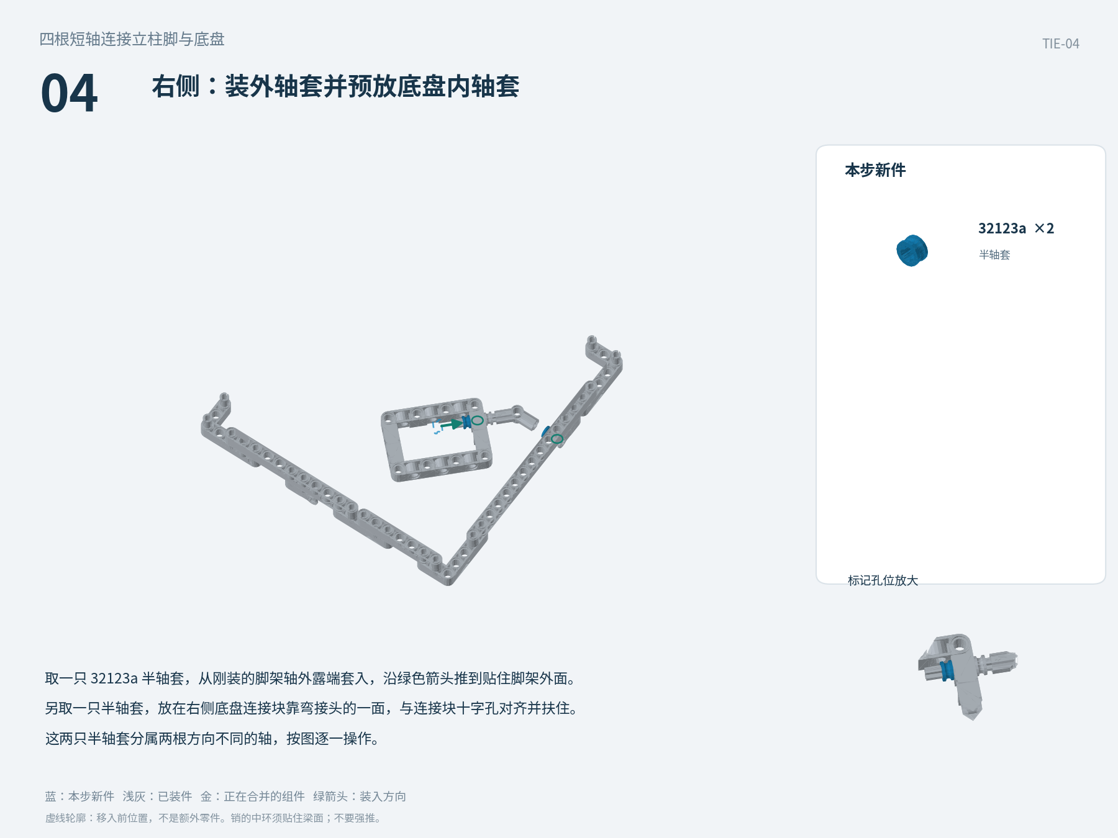
mechanical/final/site-source/dist/steps219/tie-04.png
