gonewx/quadcuber/mechanical/final/site-source/dist/steps219/tie-05.png

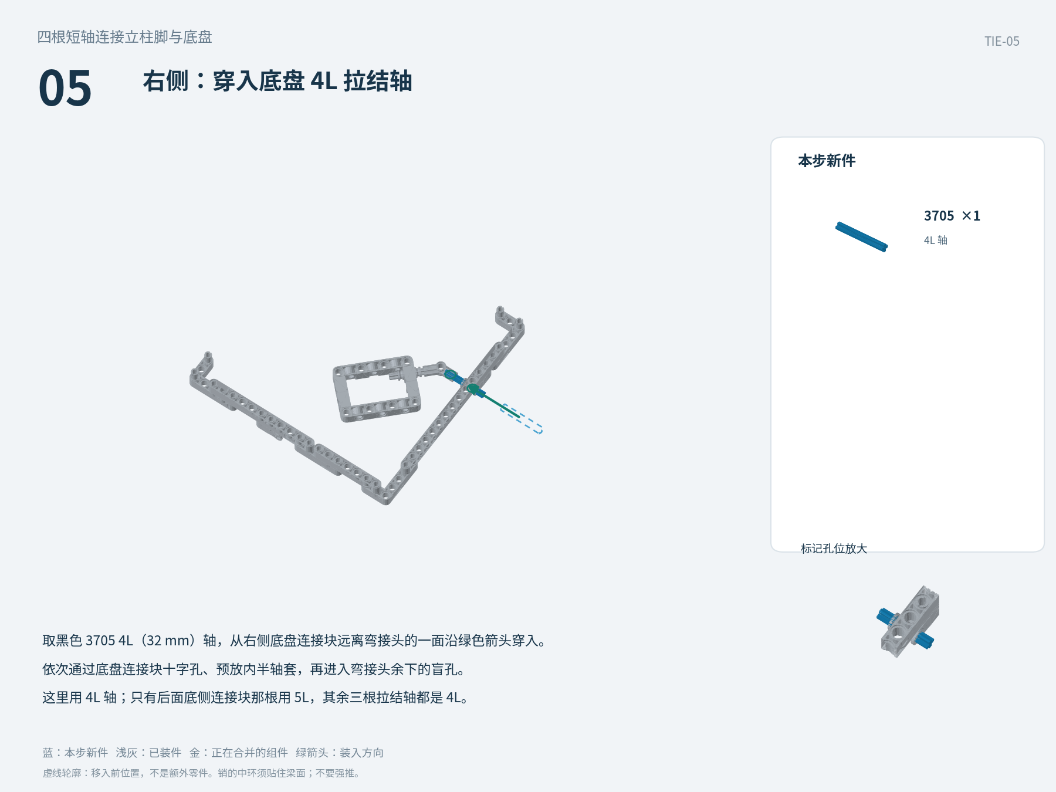
mechanical/final/site-source/dist/steps219/tie-05.png
