gonewx/quadcuber/mechanical/final/site-source/dist/steps219/tie-06.png

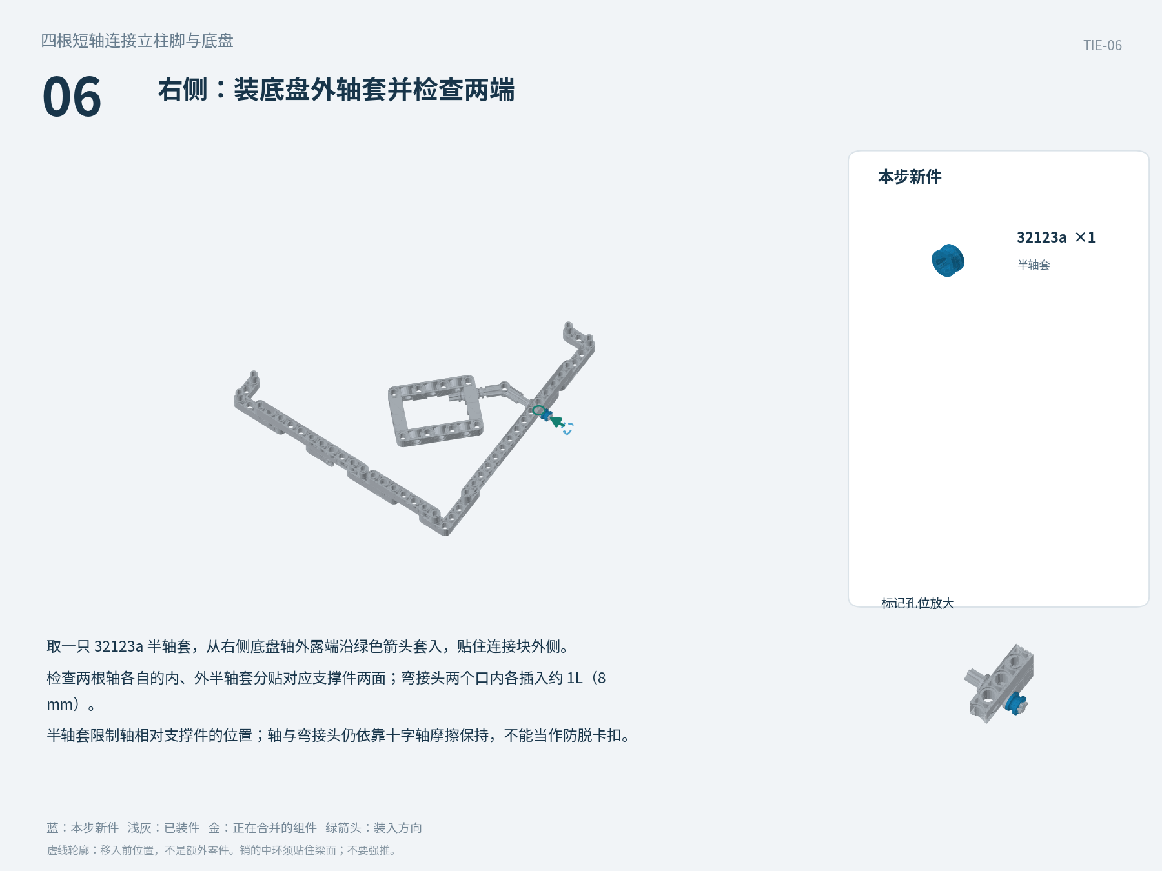
mechanical/final/site-source/dist/steps219/tie-06.png
