gonewx/quadcuber/electronics/first-board/bring-up.md

# 首板分级上电与扩大用途条件

这些是板回来后的测试，不是要求“先有已验证首板才能制首板”。首板包只允许工程验证，不代表电路安全、温升、回生或量产性能已经通过。

## 收板及自焊

核对版本、板厚、镀槽、短路/开路、pin1/二极管方向及底面15件。检查QFN/DRV EP焊接，按CAM约定验收热孔锡流失/空洞；必要时请求装配检查证据。先在绝缘台架上检查3V3、1V1、5V_A/B、VM对地无异常短路。自焊18件并清洗检查；EV3可最后焊接，在连接电机前完成断电六路通断与机械试配。C26/C36维持不装，不能擅自焊470µF来“补稳定性”。

## 1. 无外部负载上电

只用稳压9V±2%（8.82–9.18V）可限流实验电源，不接电池、12V或未知大储能电源；中心正5.5/2.1。确认电源限流模式和输出电容，先接线后使能，避免大电容热插拔。室温20–30°C，起始0.5A限流，优先缓升；电容充电可能进入限流，反复重启时停机排查，不能直接加到5A。

无电机/舵机/外接编码器，记录输入、VM、5V_A/B、3V3、1V1和电流。两路5V稳态应4.75–5.25V；检查启动不高于5.25V/不反复启动。3V3筛选3.20–3.40V，瞬态不超过3.60V；1V1筛选1.05–1.15V。异常立即断电，不继续下一步。

## 2. 控制器与USB

先确认电源，再连接供VBUS有效的主机，验证BOOTSEL、指定UF2烧录/恢复、Flash容量/持久化和冷启动。指定文件路径在manifest中；此包不自动烧录，也不更改固件。

允许USB独供逻辑、9V独供、双供且主机VBUS有效、全断电。**不支持外部供电接失电主机**，主机关机或睡眠撤VBUS前拔USB；ROM BOOTSEL也遵守。USB不能给电机/舵机供电；禁止SWD外部3V3注入。3V3连续预算≤150mA，不把LDO标称500mA当板级保证。

## 3. 两路5V电子负载

确认实际精确MLCC；直流偏压、温度、容差下的有效容量/ESR尚未完整取得。TPS54302原模型数值失败没有证明实板失败或通过；需要测启动、纹波和负载阶跃。

从每路约0.25A低负载逐步增加到0.75A，再按实测决定是否到1.5A；A包含板上逻辑。测单路/双路阶跃与8.82/9/9.18V输入条件，5V瞬态目标4.75–5.25V、稳态纹波目标≤50mVpp。反馈静态上角离5.25V余量小，不能只测平均值。临时外壳80°C作为停止线，不把它当结温认证；任何过冲、重启、异常温升应停机复核，不接昂贵外设。

## 4. 单臂、并发、回生

先EV3断电通断再单电机低速空载，然后逐级负载和单舵机，最后多臂调度。入口总电流连续≤5A；8A时滞保险仅作故障保护，**不是5A限流**。四电机各0.75A平均母线电流加两路5V各1.5A的保守算例约5.16A，不能默认同时满载。驱动电流调节阈值也不是板级热限流，禁止先做长时堵转。

原型回生计划暂按整板≤0.05J/事件、≤5Hz逐级验证，四臂同时制动合并计能量；这不是实际电机已测能量。记录VM含尖峰<12V、TVS/泄放电阻/电解温升。SMBJ12A不是连续刹车吸收器，输入反向阻断后F1也不能保护负载侧TVS的持续回灌。没有能量测量依据就不做激烈制动/持续反拖。

首板通过上述阶段后再扩大负载、环境温度、机器人安装和耐久。安装须检查底面元件/焊脚绝缘、支脚、插拔和线缆扫掠；独立台架制板不以机器人托架完成为前置条件。
