gonewx/quadcuber/docs/lego/v3-baseline/mechanical_validation.txt

双侧薄梁＋独立防翻折限位连续包络审查（2026-09-30）
mechanical_audit.py --self-test：退出0。
mechanical_audit.py：退出0。
实物验收未执行，后部半轴套小间隙仍待带载确认。

{
  "几何源": "双侧32449支承＋后移舵机＋7孔粗连杆；以文件SHA256为准",
  "model.py_SHA256": "aca89284d4abbd6f149a6d8082c1b4951c565cfc94fff194de301787b67df396",
  "零件三角网格_SHA256": {
    "18938.dat": "95c9e521fc44a9a0afa8e4a4d089c7ada59384d6aeb899915c60b0adc88dfce9",
    "18939.dat": "7f58adb7172d0296ce99fbe72e677943676b02d40c6dded059e14435f5148cf0",
    "2780.dat": "09b0ac746c5af1225e772756e86cfdc15a0e75b0be0fc3dd02023a40a87d5793",
    "32013.dat": "5f23daec8b16a72ea6104ce974f3e0390caddb7e4b11f7fd5781a05048e69594",
    "32054.dat": "7014a39ea04242f8ef254fbefe1828e9e5403db6a6e62df950c0eccc5ed6f26b",
    "32056.dat": "809b911262a43fdd9006a4439fe6ec0666f350f8873b6127a38500159c046ac4",
    "32062.dat": "85a044a46317f76f39ba60c7a78d224c356e052fbc3cf52f9cec0d8fdc84cc77",
    "32123a.dat": "f1e7c3d0f5378b66fa49c12a9372ecf3e359a8f87a41cc6ae35f047e78237f60",
    "32278.dat": "cf428882b1b1dd67b0cbdd2bb8ba112dd065657a95d7d1f03bd9203e2905b17b",
    "32316.dat": "f20f7535b92ca15d7f1075312466324e9cd936c65fad82b52776375d0814862d",
    "32449.dat": "303728d3c584776c2e9fc6e5930f37f3e5ec737b88fce973d5f9cd5f868963eb",
    "32523.dat": "9719e780cdfcabe3daddac2aa710ac2901791ec79f3c1804ce229512cc5be299",
    "32524.dat": "570d2a27d5d97828a19643daa9b0c54273e5d256deb91d22096b590b41a4944a",
    "32525.dat": "d12bcef2adface8e982206c3e747e16cdcc65a7615aa38cef889f5b9e077505f",
    "32526.dat": "349621945a3b9aef8ca0ed46231cc03c89cbd441349ace69b4ef7f2d30e548d8",
    "32556a.dat": "b297f773874362e7206678eb8ffb4866299a3afe69cac64042e0fecd764790fb",
    "3648b.dat": "373de4a164c746ba8dc12434ac89aca8c35615815415ea37860335f3f212fc83",
    "3673.dat": "57299da86d11846610ec57339deed1b2d96fa4599bd23df68933d04d0b5e8f86",
    "3707.dat": "f6c1e728fd0ef9ad675ed10632c0d97ff7f9118c2b267f31d99e95734ed6433e",
    "3708.dat": "d26ec98996f75d90fe3778ba038b6e7e8f58375f2c6daa9c36a4aec4b9b7213c",
    "3713.dat": "61da295bf8d4498627fc424cef7709cc82c6da98e032b951e734992ee5ced276",
    "39790.dat": "1fcc65ca1df008018dcf5122abea5040abadf95e2fa851ba8ed527cab6158ccd",
    "40490.dat": "3a3010442d9be2105e5fb279c045acd04a2e5048c3d9aa870b41e02f9b8a5a17",
    "41677.dat": "39b89d8524c9965fd78cea2d34c8992f8fbf74498d43c1db98317a927d8a0d7f",
    "42610.dat": "e50827a56e97278213d0d4d3d0ca53194df9c30b623a63ada337c215b456f540",
    "44294.dat": "4560a78d707483d36d4309e830100223e1280a358c605f75e64b482ada68accc",
    "4519.dat": "bc2b0f18474b0637a803cdfc52da963aa4c05da149aad83704f2b489bdf1b918",
    "50945_nominal.dat": "562b5a57b4071df8dfb294ee8a735e401bb3d38c79afe242422b5e24193039fb",
    "55615.dat": "45630e923391e353e9f42fdf9c294d91ef09b9b44c153f21e17c07843df830cd",
    "59443.dat": "cf3df41cac1553ce4864523cf09e0bccc1650cbdf18ba84709758424968b54b0",
    "64179.dat": "e15d22982b3082da14e954acfd5877fb5f800cd9d3c514b4d3cb155d57e36d2c",
    "6536.dat": "c4b169c10334989797848fe56b1249eebf174d8ae123d9cc1aeff912a87d31c5",
    "6558.dat": "f3d63c2e604232e9a13b08bc99d6b6528d60b27b654ca6a327763f896a289838",
    "95658.dat": "7244388a064ae0b38cfc908c4c6c79cdb4d7054b5fd62bd8695c6b40664dd1fa",
    "cube56.dat": "6b7687a573d7c626ede38e955a4e61ddc603f3f5eb5e10feb0e98b1e2b02427c",
    "geekservo.dat": "0ba041a6a87114c2b1d8318f680bf4b2f779b4fb12c998cfb1acb766bbdbf1ab"
  },
  "结论": "本脚本未检出后部包络干涉；实物刚度与保持力待测",
  "推杆直段对固定件_41行程位置": [
    {
      "零件": "64179.dat",
      "实例": 48,
      "径向余量_mm": -0.04609515662289674,
      "行程比例": 0.0,
      "有意配合": true
    },
    {
      "零件": "6536.dat",
      "实例": 68,
      "径向余量_mm": -0.04609515662289674,
      "行程比例": 0.0,
      "有意配合": true
    },
    {
      "零件": "32123a.dat",
      "实例": 72,
      "径向余量_mm": 3.5464274989274025,
      "行程比例": 0.0,
      "有意配合": false
    },
    {
      "零件": "32524.dat",
      "实例": 77,
      "径向余量_mm": 2.078374278559829,
      "行程比例": 0.9750000000000001,
      "有意配合": false
    }
  ],
  "魔方连续回转包络": [
    {
      "工况": "松开头回位对完整魔方",
      "连续360度间隙保守下界_mm": 2.313501336859383,
      "距离上界_mm": 2.313501336859383,
      "限制零件": "50945_nominal.dat",
      "状态": "证明分离"
    },
    {
      "工况": "夹紧头拧层对另外两层",
      "连续360度间隙保守下界_mm": 7.772276820971908,
      "距离上界_mm": 7.772276820971908,
      "限制零件": "50945_nominal.dat",
      "状态": "证明分离"
    },
    {
      "工况": "邻臂夹紧竖直对转动单层",
      "连续360度间隙保守下界_mm": 1.3333333333333344,
      "距离上界_mm": 1.3333333333333344,
      "限制零件": "32449.dat",
      "状态": "证明分离"
    },
    {
      "工况": "邻臂松开竖直对整块翻转",
      "连续360度间隙保守下界_mm": 9.655599101353392,
      "距离上界_mm": 9.655599101353392,
      "限制零件": "50945_nominal.dat",
      "状态": "证明分离"
    }
  ],
  "薄梁受力估算": {
    "假设": "无孔实心矩形薄梁、理想两点支承；不含销孔间隙、扭转、轮轴和主臂变形。E仅作参数示例。",
    "支点间距_mm": 8,
    "载荷距首支点_mm": 24,
    "面外惯性矩_mm4": 38.4,
    "面内惯性矩_mm4": 124.41600000000001,
    "单片支点反力与分配给该片的轮端力之比": [
      -2,
      3
    ],
    "法向分载": "夹紧法向N作用在两薄梁中间，理想对称时每片N/2；合成偏心距为0。",
    "轴向分载": "轮轴方向的Ft由轮毂端面推向一侧薄梁，保守按单片承受全Ft；不宣称面外柔度减半。",
    "E敏感性": [
      {
        "E_MPa": 1000,
        "轴向Ft单片保守柔度_mm每N": 0.05333333333333334,
        "轴向5N理想挠度_mm": 0.26666666666666666,
        "法向N两片均分理想柔度_mm每N": 0.008230452674897118
      },
      {
        "E_MPa": 2000,
        "轴向Ft单片保守柔度_mm每N": 0.02666666666666667,
        "轴向5N理想挠度_mm": 0.13333333333333333,
        "法向N两片均分理想柔度_mm每N": 0.004115226337448559
      },
      {
        "E_MPa": 3000,
        "轴向Ft单片保守柔度_mm每N": 0.017777777777777778,
        "轴向5N理想挠度_mm": 0.08888888888888889,
        "法向N两片均分理想柔度_mm每N": 0.002743484224965706
      }
    ],
    "两轮均匀分载示例": [
      {
        "单臂输出扭矩_Nm": 0.05,
        "每轮切向力_N": 0.8928571428571429
      },
      {
        "单臂输出扭矩_Nm": 0.1,
        "每轮切向力_N": 1.7857142857142858
      },
      {
        "单臂输出扭矩_Nm": 0.2,
        "每轮切向力_N": 3.5714285714285716
      },
      {
        "单臂输出扭矩_Nm": 0.5,
        "每轮切向力_N": 8.928571428571429
      }
    ],
    "实物验证": "未执行，不给出合格结论"
  },
  "范围限制": [
    "魔方工况使用完整表面三角形和连续角度包络；正距离可证明名义网格分离。",
    "三角网格是名义外形；不包含公差、材料变形、轴窜动及未建模线缆。",
    "整机所有零件对并未获得连续开合与回转的联合证明；原离散扫描保留为补充。",
    "圆柱到表面下界不检测一个实体完整包住另一个实体的特殊情况；本报告魔方位于各机械零件外部。"
  ]
}
曲柄轴检查： {"行程比例": 0.0, "零件": "32123a.dat", "用途": "曲柄端内限位", "回转包络径向余量_mm": 5.333333333333333, "表面见证顶点_LDU": [-510.0695654281643, 19.333333333333332, 0.0], "见证角_deg": 0.0, "顶点在推杆实体内": false}
结果： /mnt/disk0/project/cube/quadcuber/docs/lego/v3/mechanical_audit.json
