gonewx/quadcuber/docs/lego/v3-baseline/validation.txt

双侧薄梁＋独立防翻折限位版验证记录（2026-09-30）
名义 CAD 检查通过；实物防翻折、加载、公差验收未执行。
模型和零件网格 SHA256 见 mechanical_audit.json。

防翻折限位回归（退出 0）
...
----------------------------------------------------------------------
Ran 3 tests in 0.034s

OK

单模块、开合、整机检查（退出 0）
问题数: 0

四臂姿态扫描（退出 0）
扫描 576 个状态, 转角 0°～355°, 步长 5°; 按机械手对覆盖相邻状态组合。
邻居都竖直时的干涉状态数: 0
相邻水平状态存在碰撞: [('L', 'B'), ('L', 'F')]
拧 L 层 (F、B 夹紧竖直): 最近零件离轴 121.7 LDU, 魔方层扫掠半径 99.0, 切片径向余量 9.1mm（非三维最小距离，完整结果见 mechanical_audit.json）
整体翻转 (F、B 松开竖直): 最近零件离轴 123.1 LDU, 魔方扫掠半径 99.0, 切片径向余量 9.7mm（非三维最小距离，完整结果见 mechanical_audit.json）

压头专项检查（退出 0）
{
  "中间行程对本臂固定件": {
    "检查姿态数": 168,
    "干涉数": 0
  },
  "松开回位_完整魔方": {
    "最小表面采样间隙_mm": 2.32010932413969,
    "角度": 315,
    "零件": "50945_nominal.dat"
  },
  "夹紧拧层_静止的另外两层": {
    "最小表面采样间隙_mm": 7.7725003176384035,
    "角度": 34,
    "零件": "50945_nominal.dat"
  },
  "名义尺寸": {
    "夹紧主臂角_deg": 3.8416951197506415,
    "松开主臂角_deg": 25.0,
    "推杆行程_mm": 9.996824573166089,
    "自由夹口_mm": 55.36000000000001,
    "每侧橡胶名义压缩_mm": 0.32000000000000006,
    "压头轴中心X_mm": -24.08988098238744,
    "舵机曲柄转角_deg": 97.09704559941116
  },
  "整机压头用量": {
    "42610": 8,
    "50945": 8,
    "32062_轮轴": 8,
    "32449": 16,
    "4519_固定轴": 8,
    "32123a_固定轴限位": 16,
    "32054_固定销": 8
  }
}

新增件三角网格（退出 0）
距离查询数: 2931 相交数: 0
{'零件对': ('32123a.dat', '薄梁固定轴限位', '32054.dat', '薄梁固定挡套销'), '间隙_mm': 0.7999999999999887, '行程比例': 0.30000000000000004}
{'零件对': ('32526.dat', '', '32056.dat', '限位支架'), '间隙_mm': 0.8, '行程比例': 0.0}
{'零件对': ('32123a.dat', '', '32524.dat', '舵机连杆'), '间隙_mm': 0.9138236394183427, '行程比例': 0.9625}
{'零件对': ('32449.dat', '压头支承薄梁', '50945_nominal.dat', '橡胶胎'), '间隙_mm': 1.0, '行程比例': 0.0}
{'零件对': ('2780.dat', '', '32056.dat', '限位支架'), '间隙_mm': 1.3330404490989896, '行程比例': 0.0}
{'零件对': ('geekservo.dat', '', '32062.dat', '曲柄端轴'), '间隙_mm': 1.3730813625748186, '行程比例': 0.9625}
{'零件对': ('6558.dat', '', '32524.dat', '舵机连杆'), '间隙_mm': 1.4796, '行程比例': 0.0125}
{'零件对': ('3707.dat', '开限位挡轴', '32449.dat', '压头支承薄梁'), '间隙_mm': 1.7699745492164816, '行程比例': 1.0}
前端回转补查: {'状态数': 288, 'AABB候选阈值_mm': 2.0, '全部零件对间隙下界_mm': 2.0, '距离查询数': 624, '最小候选距离': {'零件对': ['50945_nominal.dat', '橡胶胎', '32123a.dat', '开限位挡轴轴套'], '邻臂': 'B', '本臂开度': 1.0, '回转角_deg': 315, '邻臂开度': 0.0, '间隙_mm': 8.3843056621242}, '相交数': 0, '相交记录': []}

双侧支承回归（退出 0）
...
----------------------------------------------------------------------
Ran 3 tests in 0.105s

OK

全仓单元测试（退出 0）
....................................................................
----------------------------------------------------------------------
Ran 68 tests in 4.525s

OK

限位专项检查（退出 0）
详见 open_stop_checks.json：正常25°留隙约1.770mm，名义接触29.775°，早于41.810°汇合位置。

图文渲染（退出 0）
76/76张PNG已生成，包含新版夹指、限位支架、挡轴及步骤图；另有孔位与限位SVG。
MPD、LDraw、HTML和BOM已更新。

交付一致性检查
HTML本地引用全部存在；LDraw、MPD与当前模型一致；BOM整机696件（不含魔方）与模型计数一致。
几何检查JSON源文件哈希与当前模型一致。已目检夹指详图、第15步和限位示意。
