gonewx/quadcuber/electronics/simulation/pspice-handoff-direct-boot-precision-v1/cases-and-results.csv

case | vin_V | cap_factor | state | deck_sha256
VIN8.82_C0.4 | 8.82 | 0.4 | NOT_RUN | 79d7283f63d8f0901d4d214acd0c40abf6f38abdf6da86dcf450f338a8ccf325
VIN8.82_C0.8 | 8.82 | 0.8 | NOT_RUN | 0924ccad0b8030c98ee7044c67d71e86e6705bba03acc91f8dd6a5370ba1c1aa
VIN8.82_C1.2 | 8.82 | 1.2 | NOT_RUN | 1f776c0bab9c2f0d1861e76cdfcb981d8e4395c815c7a14d21a3f3d946add103
VIN9_C0.4 | 9 | 0.4 | NOT_RUN | 237275acc1d568443149382d5e2dcea6cff133e22da81e14286b11d90727d9e0
VIN9_C0.8 | 9 | 0.8 | NOT_RUN | b4b12e0e02db2ac9ef1fdf545f66eb3faa39e9a7741cbb1f6228f061a1953e3c
VIN9_C1.2 | 9 | 1.2 | NOT_RUN | 80b58e15bbc2cdcfe5aaa939f4c3d7d23b6def9d1db5878cd192a9c739e81f00
VIN9.18_C0.4 | 9.18 | 0.4 | NOT_RUN | 74c15bae9f263845666f1c68b3ea8ea5d406acb3be41a80c383264faec5f09ce
VIN9.18_C0.8 | 9.18 | 0.8 | NOT_RUN | 33f1d41c94f7bafae0db3b128aa84755e2a4c0bd6b98b737ccdb4860ec76b186
VIN9.18_C1.2 | 9.18 | 1.2 | NOT_RUN | 266d6803d6d5d0814ea8b8f9cc3e82271492b188b10363e744e1b0136b99a183
