gonewx/quadcuber/docs/lego/v3-baseline/gravity_test.csv

测试编号 | 工况 | 推杆约束 | 头部角度_deg | 设计质量_g | 魔方质量_g | 附加向下载荷_N | 夹紧脉宽_us | 加载时间_s | 循环次数 | 上轮轴竖直位移_mm | 下轮轴竖直位移_mm | 根轴竖直位移_mm | 转盘相对俯仰_deg | 推杆退让_mm | 轴套迁移_mm | 魔方中心下沉_mm | 夹口变化_mm | 最小带载间隙_mm | 卸载60秒残余_mm | 测量仪器与分辨率 | 状态 | 备注
G-01 | 空头自重及线缆 | 机械固定 | 0/45/90/180 | 100 |  |  |  | 10 | 3 |  |  |  |  |  |  |  |  |  |  |  | 未执行 | 同一台面基准，分别记录各姿态
G-02 | 下轮端结构加载 | 机械固定 | 0 | 100 |  |  |  | 10 | 3 |  |  |  |  |  |  |  |  |  |  |  | 未执行 | 分0.25/0.5/1倍100g设计重量；单轮1倍仅为局部检查
G-03 | 下轮端正常保持加载 | 正常供电 | 0 | 100 |  |  |  | 10 | 3 |  |  |  |  |  |  |  |  |  |  |  | 未执行 | 与G-02相同载荷；移去临时推杆固定
G-04 | 实际魔方撤去托台 | 正常供电 | 0 | 100 |  |  |  | 10 | 3 |  |  |  |  |  |  |  |  |  |  |  | 未执行 | 两臂或四臂稳定夹持后撤托台
G-05 | 四臂转两臂承重交接 | 正常供电 | 0 | 100 |  |  |  | 10 | 3 |  |  |  |  |  |  |  |  |  |  |  | 未执行 | 相同夹紧指令；记录交接前后中心高度
G-06 | 相对两臂翻转45度承重 | 正常供电 | 45 | 100 |  |  |  | 10 | 3 |  |  |  |  |  |  |  |  |  |  |  | 未执行 | 静态承重通过后低速执行
G-07 | 相对两臂水平承重 | 正常供电 | 90 | 100 |  |  |  | 10 | 3 |  |  |  |  |  |  |  |  |  |  |  | 未执行 | 检查轮胎侧滑及轮毂端面传力
G-08 | 相对两臂倒置承重 | 正常供电 | 180 | 100 |  |  |  | 10 | 3 |  |  |  |  |  |  |  |  |  |  |  | 未执行 | 检查换向后孔隙及原上轮承重
