gonewx/quadcuber/docs/lego/v3-baseline/load_test_template.csv

测试编号 | 阶段 | 日期 | 操作者 | 样件或臂编号 | 结构版本 | 工况与方向 | 计划载荷_N | 实测载荷_N | 力臂_mm | 实测扭矩_Nm | 夹紧脉宽_us | 加载时间_s | 循环次数 | 轮轴相对主臂位移_mm | 轮轴相对底座位移_mm | 回差_mm | 卸载60秒残余_mm | 最小带载间隙_mm | 轴套迁移_mm | 落位误差_deg | 滑移或脱出 | 测量仪器与分辨率 | 状态 | 备注
M-01 | B |  |  |  | 待填写 | 轮端面外正向 | 0.5 |  |  |  |  | 10 |  |  |  |  |  |  |  |  |  |  | 未执行 | 上下轮分别测；三次循环。5N仅在前级无异常且实际需要时执行。
M-02 | B |  |  |  | 待填写 | 轮端面外反向 | 0.5 |  |  |  |  | 10 |  |  |  |  |  |  |  |  |  |  | 未执行 | 上下轮分别测；三次循环。5N仅在前级无异常且实际需要时执行。
M-03 | B |  |  |  | 待填写 | 轮端夹紧法向 | 0.5 |  |  |  |  | 10 |  |  |  |  |  |  |  |  |  |  | 未执行 | 上下轮分别测；三次循环。5N仅在前级无异常且实际需要时执行。
M-04 | B |  |  |  | 待填写 | 推杆轴向 | 0.5 |  |  |  |  | 10 |  |  |  |  |  |  |  |  |  |  | 未执行 | 上下轮分别测；三次循环。5N仅在前级无异常且实际需要时执行。
M-05 | B |  |  |  | 待填写 | 轮端面外正向 | 1 |  |  |  |  | 10 |  |  |  |  |  |  |  |  |  |  | 未执行 | 上下轮分别测；三次循环。5N仅在前级无异常且实际需要时执行。
M-06 | B |  |  |  | 待填写 | 轮端面外反向 | 1 |  |  |  |  | 10 |  |  |  |  |  |  |  |  |  |  | 未执行 | 上下轮分别测；三次循环。5N仅在前级无异常且实际需要时执行。
M-07 | B |  |  |  | 待填写 | 轮端夹紧法向 | 1 |  |  |  |  | 10 |  |  |  |  |  |  |  |  |  |  | 未执行 | 上下轮分别测；三次循环。5N仅在前级无异常且实际需要时执行。
M-08 | B |  |  |  | 待填写 | 推杆轴向 | 1 |  |  |  |  | 10 |  |  |  |  |  |  |  |  |  |  | 未执行 | 上下轮分别测；三次循环。5N仅在前级无异常且实际需要时执行。
M-09 | B |  |  |  | 待填写 | 轮端面外正向 | 2 |  |  |  |  | 10 |  |  |  |  |  |  |  |  |  |  | 未执行 | 上下轮分别测；三次循环。5N仅在前级无异常且实际需要时执行。
M-10 | B |  |  |  | 待填写 | 轮端面外反向 | 2 |  |  |  |  | 10 |  |  |  |  |  |  |  |  |  |  | 未执行 | 上下轮分别测；三次循环。5N仅在前级无异常且实际需要时执行。
M-11 | B |  |  |  | 待填写 | 轮端夹紧法向 | 2 |  |  |  |  | 10 |  |  |  |  |  |  |  |  |  |  | 未执行 | 上下轮分别测；三次循环。5N仅在前级无异常且实际需要时执行。
M-12 | B |  |  |  | 待填写 | 推杆轴向 | 2 |  |  |  |  | 10 |  |  |  |  |  |  |  |  |  |  | 未执行 | 上下轮分别测；三次循环。5N仅在前级无异常且实际需要时执行。
M-13 | B |  |  |  | 待填写 | 轮端面外正向 | 5 |  |  |  |  | 10 |  |  |  |  |  |  |  |  |  |  | 未执行 | 上下轮分别测；三次循环。5N仅在前级无异常且实际需要时执行。
M-14 | B |  |  |  | 待填写 | 轮端面外反向 | 5 |  |  |  |  | 10 |  |  |  |  |  |  |  |  |  |  | 未执行 | 上下轮分别测；三次循环。5N仅在前级无异常且实际需要时执行。
M-15 | B |  |  |  | 待填写 | 轮端夹紧法向 | 5 |  |  |  |  | 10 |  |  |  |  |  |  |  |  |  |  | 未执行 | 上下轮分别测；三次循环。5N仅在前级无异常且实际需要时执行。
M-16 | B |  |  |  | 待填写 | 推杆轴向 | 5 |  |  |  |  | 10 |  |  |  |  |  |  |  |  |  |  | 未执行 | 上下轮分别测；三次循环。5N仅在前级无异常且实际需要时执行。
M-17 | C |  |  |  | 待填写 | 单层起动正向 |  |  |  |  |  |  |  |  |  |  |  |  |  |  |  |  | 未执行 | 覆盖多个角度，每种至少三次；填写实际测量值。
M-18 | C |  |  |  | 待填写 | 单层起动反向 |  |  |  |  |  |  |  |  |  |  |  |  |  |  |  |  | 未执行 | 覆盖多个角度，每种至少三次；填写实际测量值。
M-19 | C |  |  |  | 待填写 | 单层持续转动 |  |  |  |  |  |  |  |  |  |  |  |  |  |  |  |  | 未执行 | 覆盖多个角度，每种至少三次；填写实际测量值。
M-20 | C |  |  |  | 待填写 | 整块翻转低速 |  |  |  |  |  |  |  |  |  |  |  |  |  |  |  |  | 未执行 | 覆盖多个角度，每种至少三次；填写实际测量值。
M-21 | C |  |  |  | 待填写 | 目标速度和加速度峰值 |  |  |  |  |  |  |  |  |  |  |  |  |  |  |  |  | 未执行 | 覆盖多个角度，每种至少三次；填写实际测量值。
M-22 | C |  |  |  | 待填写 | 抗滑扭矩 |  |  |  |  |  |  |  |  |  |  |  |  |  |  |  |  | 未执行 | 覆盖多个角度，每种至少三次；填写实际测量值。
M-23 | C |  |  |  | 待填写 | 夹紧力 |  |  |  |  |  |  |  |  |  |  |  |  |  |  |  |  | 未执行 | 覆盖多个角度，每种至少三次；填写实际测量值。
M-24 | D |  |  |  | 待填写 | 夹紧保持60秒 |  |  |  |  |  |  | 0 |  |  |  |  |  |  |  |  |  | 未执行 | 先完成当前版手动避让与承重验收；按审查报告执行。
M-25 | D |  |  |  | 待填写 | 拧层正反向 |  |  |  |  |  |  | 100 |  |  |  |  |  |  |  |  |  | 未执行 | 先完成当前版手动避让与承重验收；按审查报告执行。
M-26 | D |  |  |  | 待填写 | 整块翻转90度和180度 |  |  |  |  |  |  | 100 |  |  |  |  |  |  |  |  |  | 未执行 | 先完成当前版手动避让与承重验收；按审查报告执行。
M-27 | D |  |  |  | 待填写 | 初步耐久 |  |  |  |  |  |  | 1000 |  |  |  |  |  |  |  |  |  | 未执行 | 先完成当前版手动避让与承重验收；按审查报告执行。
