gonewx/quadcuber/generated/electronics/simulation/linux-steady-followup/a1-steady/light_VIN9.18_C0.4/test.cir.csv

TIME | V(VM) | V(B1OUT) | V(B2OUT) | I(L1) | I(L2) | V(B1EN) | V(B2EN) | V(B1SW) | V(B2SW) | V(X1:XCORE:SYSCLK) | V(X2:XCORE:SYSCLK)
0.0000000000000000e+00 | 9.1799999999999997e+00 | 5.0000000000000000e+00 | 5.0000000000000000e+00 | 2.5000000000000000e-01 | 5.0000000000000003e-02 | 0.0000000000000000e+00 | 0.0000000000000000e+00 | -7.9690745959854048e-01 | -7.5528056464849069e-01 | -9.4545701046125934e-125 | 9.0165806814313826e-131
5.0000000000000005e-12 | 9.1799999999999997e+00 | 4.9999998588914059e+00 | 4.9999998589602752e+00 | 2.4999709887152186e-01 | 4.9997121825563436e-02 | 1.7618320674792287e+00 | 1.7618320674792287e+00 | -7.9690715945520940e-01 | -7.5527907576629649e-01 | -3.2917189460941844e-112 | 8.9717332252271774e-131
5.1562500000000008e-12 | 9.1800000000000015e+00 | 4.9999998586190060e+00 | 4.9999998586900283e+00 | 2.4999700821125712e-01 | 4.9997031882613056e-02 | 1.7618320674792292e+00 | 1.7618320674792292e+00 | -7.9690715007567425e-01 | -7.5527902923734724e-01 | -3.3945677298290890e-112 | 8.9703319721119288e-131
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
