gonewx/quadcuber/generated/electronics/simulation/linux-steady-followup/a1-steady/light_VIN9_C1.2/test.cir.csv

TIME | V(VM) | V(B1OUT) | V(B2OUT) | I(L1) | I(L2) | V(B1EN) | V(B2EN) | V(B1SW) | V(B2SW) | V(X1:XCORE:SYSCLK) | V(X2:XCORE:SYSCLK)
0.0000000000000000e+00 | 9.0000000000000000e+00 | 5.0000000000000000e+00 | 5.0000000000000000e+00 | 2.5000000000000000e-01 | 5.0000000000000003e-02 | 0.0000000000000000e+00 | 0.0000000000000000e+00 | -7.9690745959866227e-01 | -7.5528056464909987e-01 | -9.4545701046125934e-125 | 9.0165806814313826e-131
5.0000000000000005e-12 | 8.9999999999999982e+00 | 4.9999998589003143e+00 | 4.9999998589691783e+00 | 2.4999709887152186e-01 | 4.9997121825563436e-02 | 1.7311769402717692e+00 | 1.7311769402717692e+00 | -7.9690715945533130e-01 | -7.5527907576690578e-01 | -3.2917189460941844e-112 | 8.9717332252271774e-131
5.1562500000000008e-12 | 9.0000000000000000e+00 | 4.9999998586281933e+00 | 4.9999998586992112e+00 | 2.4999700821125712e-01 | 4.9997031882613056e-02 | 1.7311769402717694e+00 | 1.7311769402717694e+00 | -7.9690715007579616e-01 | -7.5527902923795653e-01 | -3.3945677298290890e-112 | 8.9703319721119288e-131
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
