gonewx/quadcuber/generated/electronics/simulation/linux-steady-followup/oscillator-diagnostic/enable_default/test.cir.csv

TIME | V(SYSCLK) | V(RAMP) | V(U3_CLK_500K) | V(U3_N16810628) | V(U3_N16807586) | V(U3_BLANK) | V(U3_N16813790)
0.00000000e+00 | 0.00000000e+00 | 5.30000500e-07 | 0.00000000e+00 | 0.00000000e+00 | 9.99999999e-01 | -9.11134346e-29 | 3.00000000e-07
5.00000000e-12 | 0.00000000e+00 | 5.30000500e-07 | 0.00000000e+00 | 0.00000000e+00 | 9.99999999e-01 | -9.11131188e-29 | 2.99999994e-07
1.50000000e-11 | 0.00000000e+00 | 5.30000498e-07 | 0.00000000e+00 | 0.00000000e+00 | 9.99999999e-01 | -9.11124874e-29 | 2.99999982e-07
3.50000000e-11 | 0.00000000e+00 | 5.30000496e-07 | 0.00000000e+00 | 0.00000000e+00 | 9.99999999e-01 | -9.11112246e-29 | 2.99999959e-07
7.50000000e-11 | 0.00000000e+00 | 5.30000491e-07 | 0.00000000e+00 | 0.00000000e+00 | 9.99999999e-01 | -9.11086991e-29 | 2.99999912e-07
1.55000000e-10 | 0.00000000e+00 | 5.30000482e-07 | 0.00000000e+00 | 0.00000000e+00 | 9.99999999e-01 | -9.11036481e-29 | 2.99999818e-07
3.15000000e-10 | 0.00000000e+00 | 5.30000463e-07 | 0.00000000e+00 | 0.00000000e+00 | 9.99999999e-01 | -9.10935471e-29 | 2.99999631e-07
6.35000000e-10 | 0.00000000e+00 | 5.30000426e-07 | 0.00000000e+00 | 0.00000000e+00 | 9.99999999e-01 | -9.10733484e-29 | 2.99999256e-07
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
