gonewx/quadcuber/generated/electronics/simulation/linux-steady-followup/oscillator-diagnostic/uic_default/test.cir.csv

TIME | V(SYSCLK) | V(RAMP) | V(U3_CLK_500K) | V(U3_N16810628) | V(U3_N16807586) | V(U3_BLANK) | V(U3_N16813790)
0.00000000e+00 | 0.00000000e+00 | 0.00000000e+00 | 0.00000000e+00 | 0.00000000e+00 | 0.00000000e+00 | 0.00000000e+00 | 0.00000000e+00
5.00000000e-12 | 0.00000000e+00 | 3.71000199e-06 | 0.00000000e+00 | 0.00000000e+00 | 0.00000000e+00 | 0.00000000e+00 | 2.99999994e-07
5.15625000e-12 | 0.00000000e+00 | 3.82593955e-06 | 0.00000000e+00 | 0.00000000e+00 | 0.00000000e+00 | 0.00000000e+00 | 2.99999994e-07
5.31250000e-12 | 0.00000000e+00 | 3.94187711e-06 | 0.00000000e+00 | 0.00000000e+00 | 0.00000000e+00 | 0.00000000e+00 | 2.99999994e-07
5.46875000e-12 | 0.00000000e+00 | 4.05781467e-06 | 0.00000000e+00 | 0.00000000e+00 | 0.00000000e+00 | 0.00000000e+00 | 2.99999994e-07
5.78125000e-12 | 0.00000000e+00 | 4.28968980e-06 | 0.00000000e+00 | 0.00000000e+00 | 0.00000000e+00 | 0.00000000e+00 | 2.99999993e-07
6.40625000e-12 | 0.00000000e+00 | 4.75344004e-06 | 0.00000000e+00 | 0.00000000e+00 | 0.00000000e+00 | 0.00000000e+00 | 2.99999992e-07
7.65625000e-12 | 0.00000000e+00 | 5.68094054e-06 | 0.00000000e+00 | 0.00000000e+00 | 0.00000000e+00 | 0.00000000e+00 | 2.99999991e-07
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
