gonewx/quadcuber/generated/electronics/simulation/linux-steady-followup/oscillator-diagnostic/uic_gear_default/test.cir.csv

TIME | V(SYSCLK) | V(RAMP) | V(U3_CLK_500K) | V(U3_N16810628) | V(U3_N16807586) | V(U3_BLANK) | V(U3_N16813790)
0.00000000e+00 | 0.00000000e+00 | 0.00000000e+00 | 0.00000000e+00 | 0.00000000e+00 | 0.00000000e+00 | 0.00000000e+00 | 0.00000000e+00
5.00000000e-12 | 0.00000000e+00 | 3.71000199e-06 | 0.00000000e+00 | 0.00000000e+00 | 0.00000000e+00 | 0.00000000e+00 | 2.99999994e-07
5.15625000e-12 | 0.00000000e+00 | 3.82593955e-06 | 0.00000000e+00 | 0.00000000e+00 | 0.00000000e+00 | 0.00000000e+00 | 2.99999994e-07
5.31250000e-12 | 0.00000000e+00 | 3.94187711e-06 | 0.00000000e+00 | 0.00000000e+00 | 0.00000000e+00 | 0.00000000e+00 | 2.99999994e-07
5.62500000e-12 | 0.00000000e+00 | 4.17375223e-06 | 0.00000000e+00 | 0.00000000e+00 | 0.00000000e+00 | 0.00000000e+00 | 2.99999993e-07
6.25000000e-12 | 0.00000000e+00 | 4.63750248e-06 | 0.00000000e+00 | 0.00000000e+00 | 0.00000000e+00 | 0.00000000e+00 | 2.99999993e-07
7.50000000e-12 | 0.00000000e+00 | 5.56500298e-06 | 0.00000000e+00 | 0.00000000e+00 | 0.00000000e+00 | 0.00000000e+00 | 2.99999991e-07
1.00000000e-11 | 0.00000000e+00 | 7.42000396e-06 | 0.00000000e+00 | 0.00000000e+00 | 0.00000000e+00 | 0.00000000e+00 | 2.99999988e-07
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
