gonewx/quadcuber/generated/electronics/simulation/linux-steady-followup/oscillator-diagnostic/uic_gear_strict/test.cir.csv

TIME | V(SYSCLK) | V(RAMP) | V(U3_CLK_500K) | V(U3_N16810628) | V(U3_N16807586) | V(U3_BLANK) | V(U3_N16813790)
0.00000000e+00 | 0.00000000e+00 | 0.00000000e+00 | 0.00000000e+00 | 0.00000000e+00 | 0.00000000e+00 | 0.00000000e+00 | 0.00000000e+00
5.00000000e-12 | 0.00000000e+00 | 3.71000199e-06 | 0.00000000e+00 | 0.00000000e+00 | 0.00000000e+00 | 0.00000000e+00 | 2.99999994e-07
5.00976563e-12 | 0.00000000e+00 | 3.71724808e-06 | 0.00000000e+00 | 0.00000000e+00 | 0.00000000e+00 | 0.00000000e+00 | 2.99999994e-07
5.01953125e-12 | 0.00000000e+00 | 3.72449418e-06 | 0.00000000e+00 | 0.00000000e+00 | 0.00000000e+00 | 0.00000000e+00 | 2.99999994e-07
5.03906250e-12 | 0.00000000e+00 | 3.73898638e-06 | 0.00000000e+00 | 0.00000000e+00 | 0.00000000e+00 | 0.00000000e+00 | 2.99999994e-07
5.07812500e-12 | 0.00000000e+00 | 3.76797077e-06 | 0.00000000e+00 | 0.00000000e+00 | 0.00000000e+00 | 0.00000000e+00 | 2.99999994e-07
5.15625000e-12 | 0.00000000e+00 | 3.82593955e-06 | 0.00000000e+00 | 0.00000000e+00 | 0.00000000e+00 | 0.00000000e+00 | 2.99999994e-07
5.31250000e-12 | 0.00000000e+00 | 3.94187711e-06 | 0.00000000e+00 | 0.00000000e+00 | 0.00000000e+00 | 0.00000000e+00 | 2.99999994e-07
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
