gonewx/quadcuber/generated/electronics/simulation/linux-steady-followup/oscillator-diagnostic/uic_strict/test.cir.csv

TIME | V(SYSCLK) | V(RAMP) | V(U3_CLK_500K) | V(U3_N16810628) | V(U3_N16807586) | V(U3_BLANK) | V(U3_N16813790)
0.00000000e+00 | 0.00000000e+00 | 0.00000000e+00 | 0.00000000e+00 | 0.00000000e+00 | 0.00000000e+00 | 0.00000000e+00 | 0.00000000e+00
5.00000000e-12 | 0.00000000e+00 | 3.71000199e-06 | 0.00000000e+00 | 0.00000000e+00 | 0.00000000e+00 | 0.00000000e+00 | 2.99999994e-07
5.00976563e-12 | 0.00000000e+00 | 3.71724808e-06 | 0.00000000e+00 | 0.00000000e+00 | 0.00000000e+00 | 0.00000000e+00 | 2.99999994e-07
5.01368938e-12 | 0.00000000e+00 | 3.72015951e-06 | 0.00000000e+00 | 0.00000000e+00 | 0.00000000e+00 | 0.00000000e+00 | 2.99999994e-07
5.02153689e-12 | 0.00000000e+00 | 3.72598237e-06 | 0.00000000e+00 | 0.00000000e+00 | 0.00000000e+00 | 0.00000000e+00 | 2.99999994e-07
5.03723191e-12 | 0.00000000e+00 | 3.73762808e-06 | 0.00000000e+00 | 0.00000000e+00 | 0.00000000e+00 | 0.00000000e+00 | 2.99999994e-07
5.06862194e-12 | 0.00000000e+00 | 3.76091949e-06 | 0.00000000e+00 | 0.00000000e+00 | 0.00000000e+00 | 0.00000000e+00 | 2.99999994e-07
5.13140201e-12 | 0.00000000e+00 | 3.80750233e-06 | 0.00000000e+00 | 0.00000000e+00 | 0.00000000e+00 | 0.00000000e+00 | 2.99999994e-07
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
