gonewx/quadcuber/docs/lego/archive/v3/validation.txt

当前模型：2L＋11L推杆；3749圆销段接转盘、十字轴段朝外；第14步先装长销再装支架。以下命令均退出0。

$ python -m unittest discover -s tools/lego/v3 -p 'test_*.py'
...........................
----------------------------------------------------------------------
Ran 27 tests in 3.840s

OK

$ python -m unittest discover -s tests
....................................................................
----------------------------------------------------------------------
Ran 68 tests in 4.841s

OK

$ python tools/lego/v3/run_check.py module travel all
问题数: 0

$ python tools/lego/v3/four_arm.py
扫描 576 个状态, 转角 0°～355°, 步长 5°; 按机械手对覆盖相邻状态组合。
邻居都竖直时的干涉状态数: 0
相邻水平状态存在碰撞: [('L', 'B'), ('L', 'F')]
拧 L 层 (F、B 夹紧竖直): 最近零件离轴 121.7 LDU, 魔方层扫掠半径 99.0, 切片径向余量 9.1mm（非三维最小距离，完整结果见 mechanical_audit.json）
整体翻转 (F、B 松开竖直): 最近零件离轴 122.5 LDU, 魔方扫掠半径 99.0, 切片径向余量 9.4mm（非三维最小距离，完整结果见 mechanical_audit.json）

$ python tools/lego/v3/verify_pressure_pads.py
{
  "中间行程对本臂固定件": {
    "检查姿态数": 168,
    "干涉数": 0
  },
  "松开回位_完整魔方": {
    "最小表面采样间隙_mm": 2.0972873563877688,
    "角度": 315,
    "零件": "50945_nominal.dat"
  },
  "夹紧拧层_静止的另外两层": {
    "最小表面采样间隙_mm": 7.772500317629997,
    "角度": 34,
    "零件": "50945_nominal.dat"
  },
  "名义尺寸": {
    "夹紧主臂角_deg": 3.8416951197506415,
    "松开主臂角_deg": {
      "-1": 24.999999999999872,
      "1": 24.64996053733649
    },
    "推杆行程_mm": 9.960272079017386,
    "自由夹口_mm": 55.36000000000001,
    "每侧橡胶名义压缩_mm": 0.32000000000000006,
    "压头轴中心X_mm": -24.08988098238744,
    "舵机曲柄转角_deg": 96.83188822992771
  },
  "整机压头用量": {
    "42610": 8,
    "50945": 8,
    "32062_轮轴": 8,
    "32449": 16,
    "4519_固定轴": 8,
    "32123a_固定轴限位": 16,
    "32054_固定销": 8
  }
}

$ python tools/lego/v3/load_path_analysis.py
闭环最大残差_mm 3.5186076274840164e-12
约束最小奇异值 0.90842493146891
两臂100g静力 {'单臂分担重量_N': 0.4903325, '每个上接触预载_N': 0.0, '夹指': [{'夹指': '上', '轮端力_N': [0.0, -0.0], '输入杆拉力_N': 0.0, '输入杆轴力幅值_N': 0.0, '根轴传给侧架的力_N': [0.0, 0.0]}, {'夹指': '下', '轮端力_N': [0.0, 0.4903325], '输入杆拉力_N': -1.2913483120292353, '输入杆轴力幅值_N': 1.2913483120292353, '根轴传给侧架的力_N': [0.33144599687589243, 1.7384206435762866]}], '输入杆传给公共接头的力_N': [-0.33144599687589243, -1.2480881435762865], '两侧合计的前后导向杆轴力_N': [0.6240535528953246, -0.6240537654758517], '公共接头组合体空间平衡': {'假设': '摆杆和驱动薄梁为二力杆；分别平衡两根横梁Mz。省略孔轴弯矩与轴向接触力，实物弹性分载可能不同。', '输入杆偏心力矩_Nmm': [12.480881435762864, -3.3144599687589245, 0.0], '各侧前后摆杆轴力_N': {'负Z': [0.1386785673100721, -0.1386786145501893], '正Z': [0.48537498558525244, -0.4853751509256624]}, '各侧驱动薄梁轴力_N': {'负Z': -0.11048199846765099, '正Z': 0.4419279938706038}, '六分量平衡残差_Fxyz_N_Mxyz_Nmm': [-1.1102230246251565e-16, 0.0, 0.0, 1.7763568394002505e-15, -4.440892098500626e-16, 8.881784197001252e-16], '力平衡残差_N': 1.1102230246251565e-16, '力矩平衡残差_Nmm': 2.0350724194510405e-15}, '推杆前接头载荷': {'合力_xyz_N': [-0.3314459954029528, -5.78186331717324e-13, 0.0], '合矩_xyz_Nmm': [5.781863317173241e-12, -3.3144599540295285, 0.0], '绕推杆轴线的扭矩_Nmm': 5.781863317173241e-12, '横向弯矩幅值_Nmm': 3.3144599540295285, '假设': '由同一空间二力杆算例的两侧D端反力合成；合力很小不代表合矩为零。'}, '符号': '导向杆正值为压缩，负值为拉伸；两侧分配须计输入杆轴向偏心。', '铰接驱动轴力_N': 0.3314459954029529, '推杆铰接头竖向反力幅值_N': 5.781863317173241e-13, '转盘附加俯仰矩_Nm': 0.05487316843320702, '力平衡残差_N': 7.850462293418876e-17, '力矩平衡残差_Nmm': 7.105427357601002e-15}
两臂/四臂接触秩 5 6
/mnt/disk0/project/cube/quadcuber/docs/lego/v3/load_path_checks.json

$ python tools/lego/v3/verify_open_stops.py
{
  "model.py_SHA256": "693b654a75e89fc85ae9f13ed71a40e437e8a00bdcf71a68f456fd5b4737ee13",
  "两组角度": [
    {
      "夹指": "上",
      "推杆后退_mm": 0.0,
      "正常角_deg": 3.8416951199036293,
      "另一解_deg": 102.01306684009964
    },
    {
      "夹指": "下",
      "推杆后退_mm": 0.0,
      "正常角_deg": 3.8416951195976536,
      "另一解_deg": 102.0130668402614
    },
    {
      "夹指": "上",
      "推杆后退_mm": 9.960272079017386,
      "正常角_deg": 24.999999999999872,
      "另一解_deg": 61.34830818670121
    },
    {
      "夹指": "下",
      "推杆后退_mm": 9.960272079017386,
      "正常角_deg": 24.64996053733649,
      "另一解_deg": 61.59672652370494
    }
  ],
  "各夹指汇合点": {
    "-1": {
      "汇合角_deg": 41.908391619520465,
      "汇合行程_mm": 11.544801649071765
    },
    "1": {
      "汇合角_deg": 41.70728486545823,
      "汇合行程_mm": 11.657107013226392
    }
  },
  "最早汇合行程_mm": 11.544801649071765,
  "正常开行程_mm": 9.960272079017386,
  "两组解汇合前剩余后拉_mm": 1.5845295700543787,
  "名义挡轴方向接触": [
    {
      "夹指": "下",
      "挡轴自转_deg": 0,
      "25度工作间隙_mm": 1.7699745492164838,
      "首次接触角_deg": 29.77456110296771,
      "接触对应推杆后退_mm": 10.865010957180722,
      "距汇合点行程_mm": 0.7920960560456702
    },
    {
      "夹指": "上",
      "挡轴自转_deg": 0,
      "25度工作间隙_mm": 1.7699745492164838,
      "首次接触角_deg": 29.77456110296771,
      "接触对应推杆后退_mm": 10.765780923479703,
      "距汇合点行程_mm": 0.779020725592062
    }
  ],
  "挡轴自转采样接触角范围_deg": [
    29.62337600067258,
    30.265778191387653
  ],
  "工作间隙最小_mm": 1.7390324047352124,
  "汇合点行程裕量最小_mm": 0.7140189077026164,
  "结论": "刚性名义网格在正常开度留隙，异常开合在汇合前被挡；实物防翻折与挡轴强度待手动验收。",
  "限制": [
    "挡轴自转每5度采样；接触后到汇合角取50点，未进行连续弹性接触仿真。",
    "只允许正常姿态装配，不能把处于另一分支的夹指当成正常起点。",
    "模型行程检查不限制实物手拉或固件原始servo命令；必须校准实物开端，不能持续顶住限位。"
  ]
}

$ python tools/lego/v3/mesh_clearance.py
距离查询数: 17513 相交数: 0
{'零件对': ('3648b.dat', '', '32123a.dat', '齿轮外限位'), '间隙_mm': 0.15000000000000002, '行程比例': 0.0}
{'零件对': ('18938.dat', '', '41677.dat', '后短连接梁'), '间隙_mm': 0.4, '行程比例': 0.0}
{'零件对': ('32062.dat', '推杆短轴', '23948.dat', '推杆长轴'), '间隙_mm': 0.4, '行程比例': 0.0}
{'零件对': ('32123a.dat', '薄梁固定轴限位', '32054.dat', '薄梁固定挡套销'), '间隙_mm': 0.7999999999999887, '行程比例': 0.3375}
{'零件对': ('32526.dat', '前角梁', '43857.dat', '上导向垫梁'), '间隙_mm': 0.8, '行程比例': 0.0}
{'零件对': ('32526.dat', '前角梁', '32123a.dat', ''), '间隙_mm': 0.8, '行程比例': 0.0}
{'零件对': ('32140.dat', 'Watt支架', '43857.dat', '下前垫梁'), '间隙_mm': 0.8, '行程比例': 0.0}
{'零件对': ('32140.dat', 'Watt支架', '32056.dat', '限位支架'), '间隙_mm': 0.8, '行程比例': 0.0}
前端回转补查: {'状态数': 288, 'AABB候选阈值_mm': 2.0, '全部零件对间隙下界_mm': 2.0, '距离查询数': 4472, '最小候选距离': {'零件对': ['59443.dat', '推杆连接器', '32054.dat', ''], '邻臂': 'L', '本臂开度': 1.0, '回转角_deg': 290, '邻臂开度': 0.0, '间隙_mm': 2.2779881951774192}, '相交数': 0, '相交记录': []}

$ python tools/lego/v3/mechanical_audit.py
{
  "几何源": "双侧轮胎支承＋11478承重横梁＋空余孔朝曲柄的7孔粗连杆；以文件SHA256为准",
  "model.py_SHA256": "693b654a75e89fc85ae9f13ed71a40e437e8a00bdcf71a68f456fd5b4737ee13",
  "零件三角网格_SHA256": {
    "11478.dat": "edf4976f6eb8af4dac506df2c13395fae090b87b4af0ac48f9ebb48a45f3ae43",
    "18938.dat": "95c9e521fc44a9a0afa8e4a4d089c7ada59384d6aeb899915c60b0adc88dfce9",
    "18939.dat": "7f58adb7172d0296ce99fbe72e677943676b02d40c6dded059e14435f5148cf0",
    "23948.dat": "df1cc1252a2c17684787143059810879d0ad1f0562f17636820adcab7ee93081",
    "24316.dat": "4a0a830f3bfae3ec5a9963bb2072c0703d1381ad2e5458d3b12ae38121abdc48",
    "2780.dat": "09b0ac746c5af1225e772756e86cfdc15a0e75b0be0fc3dd02023a40a87d5793",
    "32013.dat": "5f23daec8b16a72ea6104ce974f3e0390caddb7e4b11f7fd5781a05048e69594",
    "32017.dat": "196753c1b2dcda2fb66caf678f8fc5bf415a8a84ecaf1193d8a0739d0a14c888",
    "32054.dat": "7014a39ea04242f8ef254fbefe1828e9e5403db6a6e62df950c0eccc5ed6f26b",
    "32056.dat": "809b911262a43fdd9006a4439fe6ec0666f350f8873b6127a38500159c046ac4",
    "32062.dat": "85a044a46317f76f39ba60c7a78d224c356e052fbc3cf52f9cec0d8fdc84cc77",
    "32073.dat": "688a6846bce87fe5714df0f88e1e53e1cdbabe4eed4ac6d27f53d4faeddd44ae",
    "32123a.dat": "f1e7c3d0f5378b66fa49c12a9372ecf3e359a8f87a41cc6ae35f047e78237f60",
    "32140.dat": "ffee4b7bd0a8d56f419f7f9792199b07c4c6607658b35a1a5278c187ab476007",
    "32278.dat": "cf428882b1b1dd67b0cbdd2bb8ba112dd065657a95d7d1f03bd9203e2905b17b",
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
    },
    {
      "工况": "邻臂夹紧竖直对转动单层",
      "连续360度间隙保守下界_mm": 1.3333333333333344,
      "距离上界_mm": 1.3333333333333344,
      "限制零件": "32449.dat",
      "状态": "证明分离"
    },
    {
      "工况": "邻臂松开竖直对整块翻转",
      "连续360度间隙保守下界_mm": 9.416371488189084,
      "距离上界_mm": 9.416371488189084,
      "限制零件": "50945_nominal.dat",
      "状态": "证明分离"
    }
  ],
  "薄梁受力估算": {
    "假设": "无孔实心矩形薄梁、理想两点支承；不含销孔间隙、扭转、轮轴和主臂变形。E仅作参数示例。",
    "支点间距_mm": 8,
    "载荷距首支点_mm": 24,
    "面外惯性矩_mm4": 38.4,
    "面内惯性矩_mm4": 124.41600000000001,
    "单片支点反力与分配给该片的轮端力之比": [
      -2,
      3
    ],
    "法向分载": "夹紧法向N作用在两薄梁中间，理想对称时每片N/2；合成偏心距为0。",
    "轴向分载": "轮轴方向的Ft由轮毂端面推向一侧薄梁，保守按单片承受全Ft；不宣称面外柔度减半。",
    "E敏感性": [
      {
        "E_MPa": 1000,
        "轴向Ft单片保守柔度_mm每N": 0.05333333333333334,
        "轴向5N理想挠度_mm": 0.26666666666666666,
        "法向N两片均分理想柔度_mm每N": 0.008230452674897118
      },
      {
        "E_MPa": 2000,
        "轴向Ft单片保守柔度_mm每N": 0.02666666666666667,
        "轴向5N理想挠度_mm": 0.13333333333333333,
        "法向N两片均分理想柔度_mm每N": 0.004115226337448559
      },
      {
        "E_MPa": 3000,
        "轴向Ft单片保守柔度_mm每N": 0.017777777777777778,
        "轴向5N理想挠度_mm": 0.08888888888888889,
        "法向N两片均分理想柔度_mm每N": 0.002743484224965706
      }
    ],
    "两轮均匀分载示例": [
      {
        "单臂输出扭矩_Nm": 0.05,
        "每轮切向力_N": 0.8928571428571429
      },
      {
        "单臂输出扭矩_Nm": 0.1,
        "每轮切向力_N": 1.7857142857142858
      },
      {
        "单臂输出扭矩_Nm": 0.2,
        "每轮切向力_N": 3.5714285714285716
      },
      {
        "单臂输出扭矩_Nm": 0.5,
        "每轮切向力_N": 8.928571428571429
      }
    ],
    "实物验证": "未执行，不给出合格结论"
  },
  "范围限制": [
    "魔方工况使用完整表面三角形和连续角度包络；正距离可证明名义网格分离。",
    "三角网格是名义外形；不包含公差、材料变形、轴窜动及未建模线缆。",
    "整机所有零件对并未获得连续开合与回转的联合证明；原离散扫描保留为补充。",
    "圆柱到表面下界不检测一个实体完整包住另一个实体的特殊情况；本报告魔方位于各机械零件外部。"
  ]
}
曲柄轴检查： {"行程比例": 0.0, "零件": "32123a.dat", "用途": "曲柄端内限位", "回转包络径向余量_mm": 5.333333333333333, "表面见证顶点_LDU": [-550.0695654281643, 19.333333333333332, 0.0], "见证角_deg": 0.0, "顶点在推杆实体内": false}
结果： /mnt/disk0/project/cube/quadcuber/docs/lego/v3/mechanical_audit.json

$ python tools/lego/v3/rod_support_analysis.py
{
  "model.py_SHA256": "693b654a75e89fc85ae9f13ed71a40e437e8a00bdcf71a68f456fd5b4737ee13",
  "参考版本": {
    "提交": "35db5e5",
    "总名义长度_mm": 120.0,
    "夹紧悬伸_mm": 63.822620791223564,
    "轴承中心距_mm": 48.0
  },
  "当前": {
    "总名义长度_mm": 104.0,
    "夹紧悬伸_mm": 47.822620791223564,
    "轴承中心距_mm": 48.0,
    "全行程最小孔外余量_mm": 8.177379208776438,
    "连接器到前轴承连续轴向间隙下界_mm": 5.862348712206177
  },
  "100g两臂均分_夹紧_仅重量增量": {
    "合力_xyz_N": [
      -0.3314459954029528,
      -5.78186331717324e-13,
      0.0
    ],
    "合矩_xyz_Nmm": [
      5.781863317173241e-12,
      -3.3144599540295285,
      0.0
    ],
    "绕推杆轴线的扭矩_Nmm": 5.781863317173241e-12,
    "横向弯矩幅值_Nmm": 3.3144599540295285,
    "假设": "由同一空间二力杆算例的两侧D端反力合成；合力很小不代表合矩为零。"
  },
  "理想梁相对柔度": {
    "假设": "均匀Euler–Bernoulli梁、两个理想简支、相同EI和载荷；a为支点间距，b为前悬伸。忽略连接器、塑料蠕变、孔隙和支座变形。",
    "端部横向力柔度公式": "b²(a+b)/(3EI)",
    "端部弯矩导致的位移柔度公式": "(b²/2+ab/3)/EI",
    "端部横向力_新旧柔度比": 0.48112270876172786,
    "端部弯矩_新旧柔度比": 0.6241898132762962,
    "限制": "这些比值只说明缩短的方向性收益，不能作为整机刚度提升或实际下沉量的预测。"
  }
}

$ python tools/lego/v3/gravity_analysis.py
/mnt/disk0/project/cube/quadcuber/docs/lego/v3/gravity_calculations.json
