gonewx/quadcuber/artifacts/rear-frame-experiments/oriented-detail.png

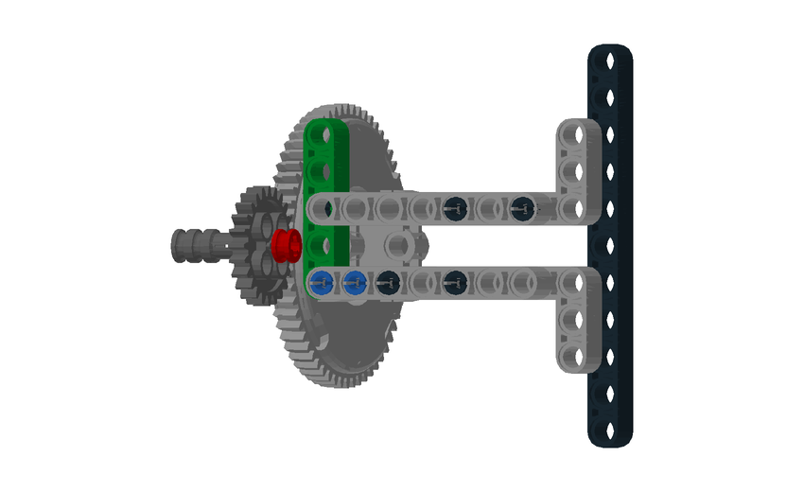
artifacts/rear-frame-experiments/oriented-detail.png
