gonewx/quadcuber/artifacts/rear-frame-experiments/upper.png

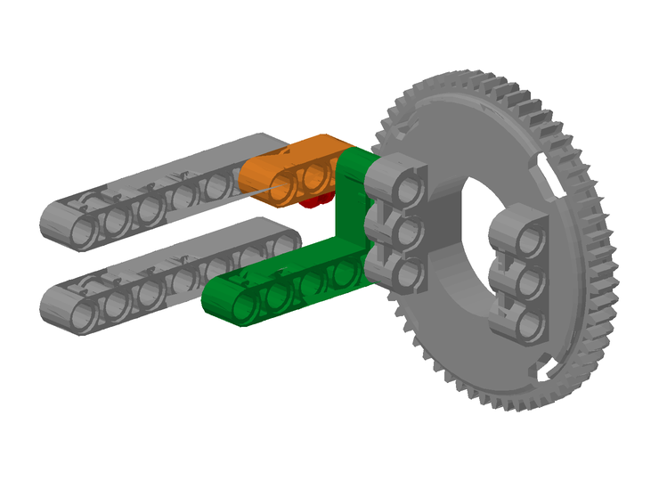
artifacts/rear-frame-experiments/upper.png
