gonewx/quadcuber/artifacts/rear-frame-experiments/vertical-centered.png

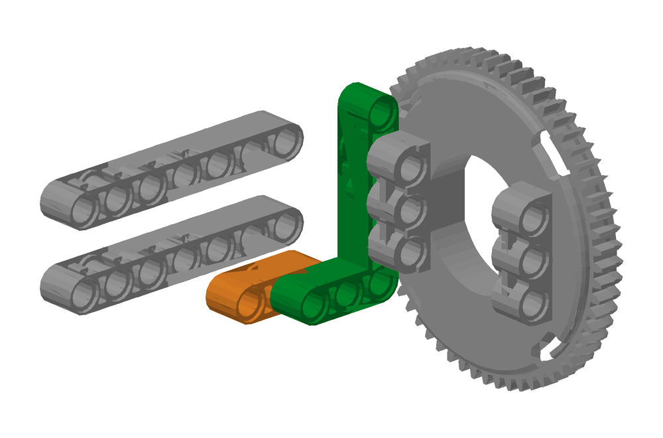
artifacts/rear-frame-experiments/vertical-centered.png
