gonewx/quadcuber/artifacts/rear-frame-experiments/vertical-hit.png

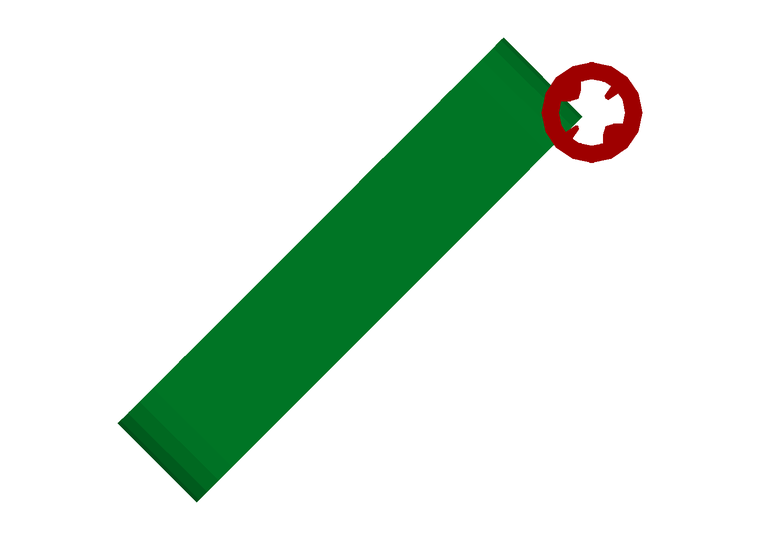
artifacts/rear-frame-experiments/vertical-hit.png
