gonewx/quadcuber/artifacts/rear-frame-experiments/vertical-static.png

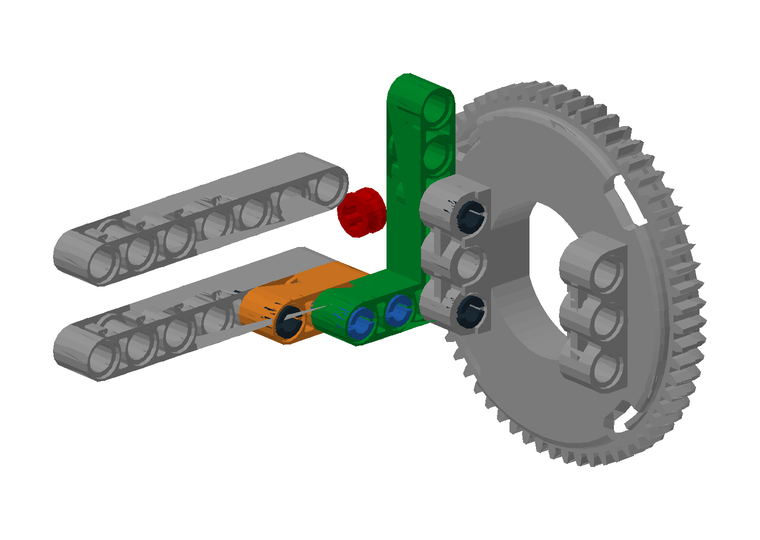
artifacts/rear-frame-experiments/vertical-static.png
