gonewx/quadcuber/docs/b1-motor-channel-debug.md

# B1 马达通道排查记录（2026-10-19 ~ 10-20）

## 结论

| 通道 | 插座 / 驱动 | 结果 |
|---|---|---|
| R | J11 / U10 | 正常：`check 0.3` 66~73 计数，`duty 0.6 500` 约 99° |
| L | J21 / U20 | **U20 第 8 脚（OUT2）虚焊**：带载时引脚 0V、焊盘 8V |
| F | J31 / U30 | 正常：73 计数，99.2° |
| B | J41 / U40 | **U40 第 3 脚（IN1）虚焊**：Pico 第 19 脚 3.3V、焊盘 3.3V、引脚 0V，两输出悬空约 1.14V |

四路舵机（J10~J40）全部正常；首测“不动”是舵机插头插反，后又误插进 J2（UART）。

## L 路证据链

| 已排除 | 依据 |
|---|---|
| 固件 | 绕开 arm_test，REPL 直接 `Pin(6)=1, Pin(7)=0` 驱动，仍 0 计数；F 路配置照 L 克隆且正常 |
| 编码器 | 手转 `enc` 有读数（-221） |
| 马达、线 | 同一套插 J11 正常；换线后 J21 仍不转 |
| 走线、J21 焊点 | 断电时线头 6 路到 U20 引脚均 0.x Ω，第 1、2 针之间不短路 |
| ILIM | U10/U20/U30/U40 第 4 脚对地都约 43kΩ |
| 地脚 | 带载时 U20 第 1 脚、第 7 脚（PGND）对地均 0V |
| 供电 | 换过两个电源，R、F 结果一致 |

关键测量（马达插 J21，GP6=1、GP7=0 持续输出，编码器动即自动断电）：

| 测点（对地） | 读数 | 说明 |
|---|---|---|
| J21 第 1 针（OUT1） | 8V | 上桥导通 |
| J21 第 2 针（OUT2） | 8V | 被马达绕组拉到 VM，下桥没导通 |
| J21 第 1 针对第 2 针 | 0V | 马达两端无压差 |

反向驱动（`duty -0.6 500`）同样 0°。曾据此误判为芯片下桥损坏；实际是第 8 脚虚焊——正转时芯片拉低的电平过不去，反转时输出的高电平也过不去，一个虚焊点即可解释两个方向都不转。最终测量：保持输出时第 8 脚**引脚**约 0V、**焊盘**约 8V。

## 经验

- **引脚与焊盘分开量**：带电保持输出时，先点引脚上方弯折处（轻碰不压），再点脚尖外露的焊盘铜。两者不同即虚焊。断电通断测试会被表笔压力“压通”，不能证明焊点良好。L、B 两路都是这样查出来的。
- 空载时输出脚读 0V 不能证明下桥正常：下桥不导通的输出是悬空的，表也读 0V。要接上马达、在输出保持时量**两个输出脚各自对地**。
- 带载测量用“编码器一动就断电”的保持输出脚本，用户不必先拔马达。
- 相邻 SOIC 引脚间距 1.27mm，第 6 脚（OUT1）紧挨第 5 脚（VM），带电测量优先选通孔焊盘或排针作测点。
- 黑表笔就近接舵机排针的 G 针（立着的针，好压住）。

## 修复后验收（2026-10-20）

补焊 U20、U40 全部引脚后，同一马达逐路插入，空载 `bench 1 20 free`：

| 路 | `check 0.3` | `duty ±0.6 500` | bench 成功 | 平均到位 | 最大误差 | 静止后最大 |
|---|---|---|---|---|---|---|
| R | 72 计数 | +99.4° | 20/20 | 0.561s | 0.2° | — |
| L | 72 计数 | +99.6° / −99.2° | 20/20 | 0.572s | 0.20° | 0.20° |
| F | 73 计数 | +99.2° | 20/20 | 0.559s | 0.20° | 0.40° |
| B | 72 计数 | +99.2° / −98.6° | 20/20 | 0.569s | 0.20° | 0.20° |

四路舵机（servo_cal 1100–1550µs 往复）均动作正常。

其余板级项（2026-10-20）：

| 项目 | 方法 | 结果 |
|---|---|---|
| J2 UART（GP0/GP1） | J2 的 TX、RX 短接回环：115200 发 34 字节、1M 发 0~255 全字节；拔线后再发 | 两次都完全一致；拔线后收不到任何字节（证明经 J2） |
| 仅靠板上 VSYS 供电 | 临时 main.py 闪板载 LED，拔 USB、只接 9V | LED 快闪，Pico 正常运行；测完已删除 main.py |

未测（等四臂机构带载时做）：四舵机同时夹紧加马达拧动时的 9V/5V 压降与芯片温升；补焊过的 U20、U40 长时间运行温度。

## 待办

1. 每次 move 的 `max_dt_us` 约 14ms（控制周期 1ms），疑似 GC，待查，不阻塞。
2. 舵机按 docs/single_arm.md 第 3 步实测标定（F/B 的开合值尚为 None）。
