gonewx/quadcuber/mechanical/final/site-source/dist/history-132.html

历史132支承＋原四臂版本；不含本次全部改动。当前整合版

另有60483根部短支架候选： 22步改装说明／PDF · 对应859／857件整机。本页原模型／历史记录保持独立。

# 新支承候选审阅 · 132件

升降支承＋托座＋X／Z定位边 · 仅供审阅的小样候选

件数范围：132件小样＋59件复用共同底盘＝191件；再加原四臂708件＝899件整机。旧219件包含底盘，比较时需使用同一范围。

承重／销尖滑动／半轴套保持未实测 · 不可照搭运行

X／Z定位边已纳入模型；名义几何与理想关节检查通过，尚未通过实物承载验收。

滑槽销尖跨孔缘在约8／32毫米行程附近仍可能卡滞，安装环境扫掠也未验证。几何检查不代表承重合格。

逐步审阅完整模型

正在解析候选模型…

复位视角查看下位端姿（40mm）查看整机背景

新增／合并重点本地已有组件

拖动旋转 · 滚轮／双指缩放 · A/D、W/S旋转 · +/-缩放 · R复位

## 132件 · 逐步审阅

候选装配顺序，尚未实物试装。每步显示本地子组件，蓝色为新增或合并重点，灰色为已有件。

选择步骤

上一步下一步

#### 本步新取零件

#### 怎么做

#### 停下核对

显示本步3D完整模型

前置步骤、零件编号与插入坐标

#### 先完成

#### 本步可见实例

#### 插入方向（世界坐标，毫米）

Y向下；仅表示名义方向。未给行程时为示意，不代表安装环境扫掠已验证。

审阅范围、姿态与未解决风险

- 132件小样包含83件支承、25件托座、9件Z定位边及15件X定位边。固定30件、移动100件、可抽锁件2件；下位移除2件锁后130件。
- 59件复用共同底盘和原四臂708件单独计入整机背景：上位899件，下位897件。上位四头均张开50°；下位前后夹紧0°、左右仍开50°，不是正常还原姿态。
- X／Z两面用于手动贴边定位，没有自动弹簧对中功能。模型为56毫米名义魔方设置定位基准，实物配合仍须验证。
- 来源模型接合与运动空间、定位增量的名义几何与理想关节已审；理想关节检查不等于实体的刚度、承载、摩擦或保持力验收。
- 滑槽销尖与滑面名义共面，跨孔缘可能卡滞；0.4毫米墙侧名义间隙没有实物余量保证。销尖滑动、半轴套保持、刚度和承重均未实测。
- 安装环境扫掠尚未验证。这里的两端姿仅用于几何审阅，不表示可在整机中按图装入或运行。
- 原8枚墙脚销仍是独立HOLD项，未在这次候选中修正。上、下位分别读取实际来源文件。

219版历史实物失败：已收到放入魔方即下垂的实物失败，承重待修，暂停带魔方运行。查看219版模型与145步诊断资料
