gonewx/quadcuber/generated/electronics/3d-display-repair/board-top.png

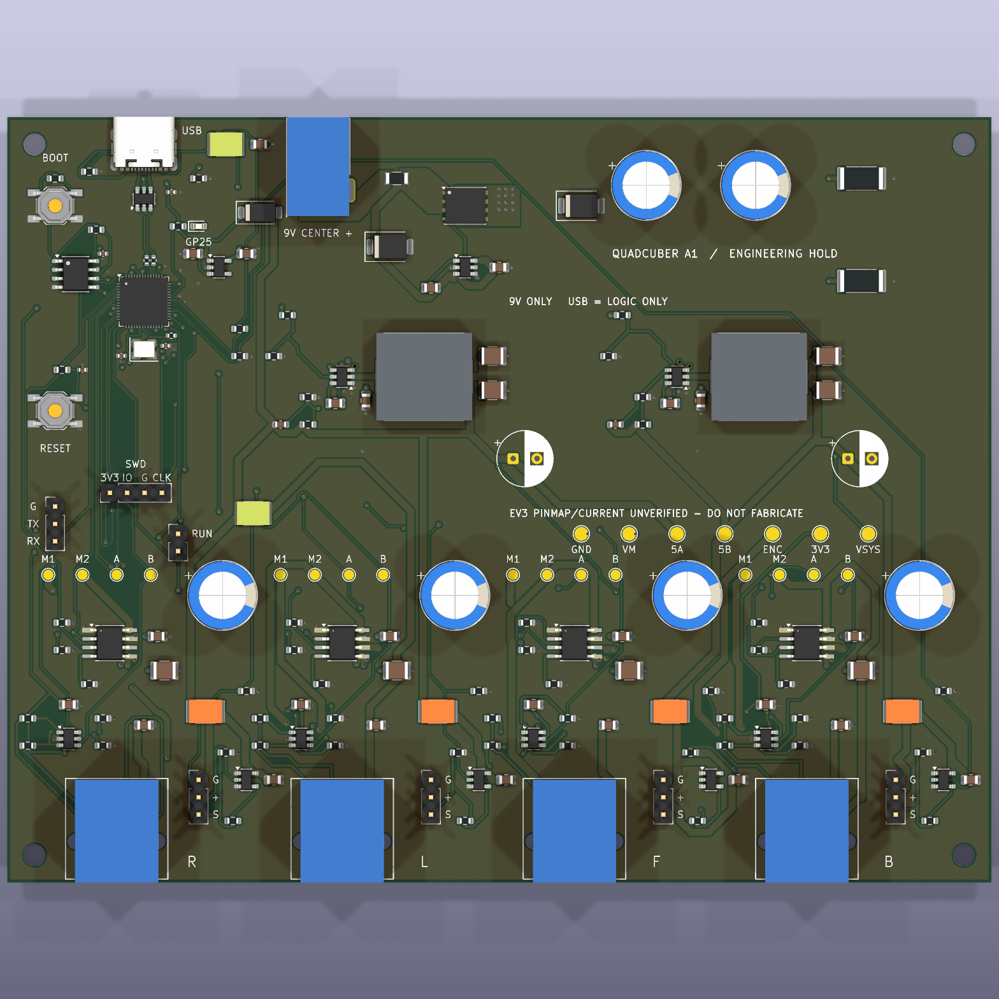
generated/electronics/3d-display-repair/board-top.png
