gonewx/quadcuber/generated/electronics-b1/schematic.pdf

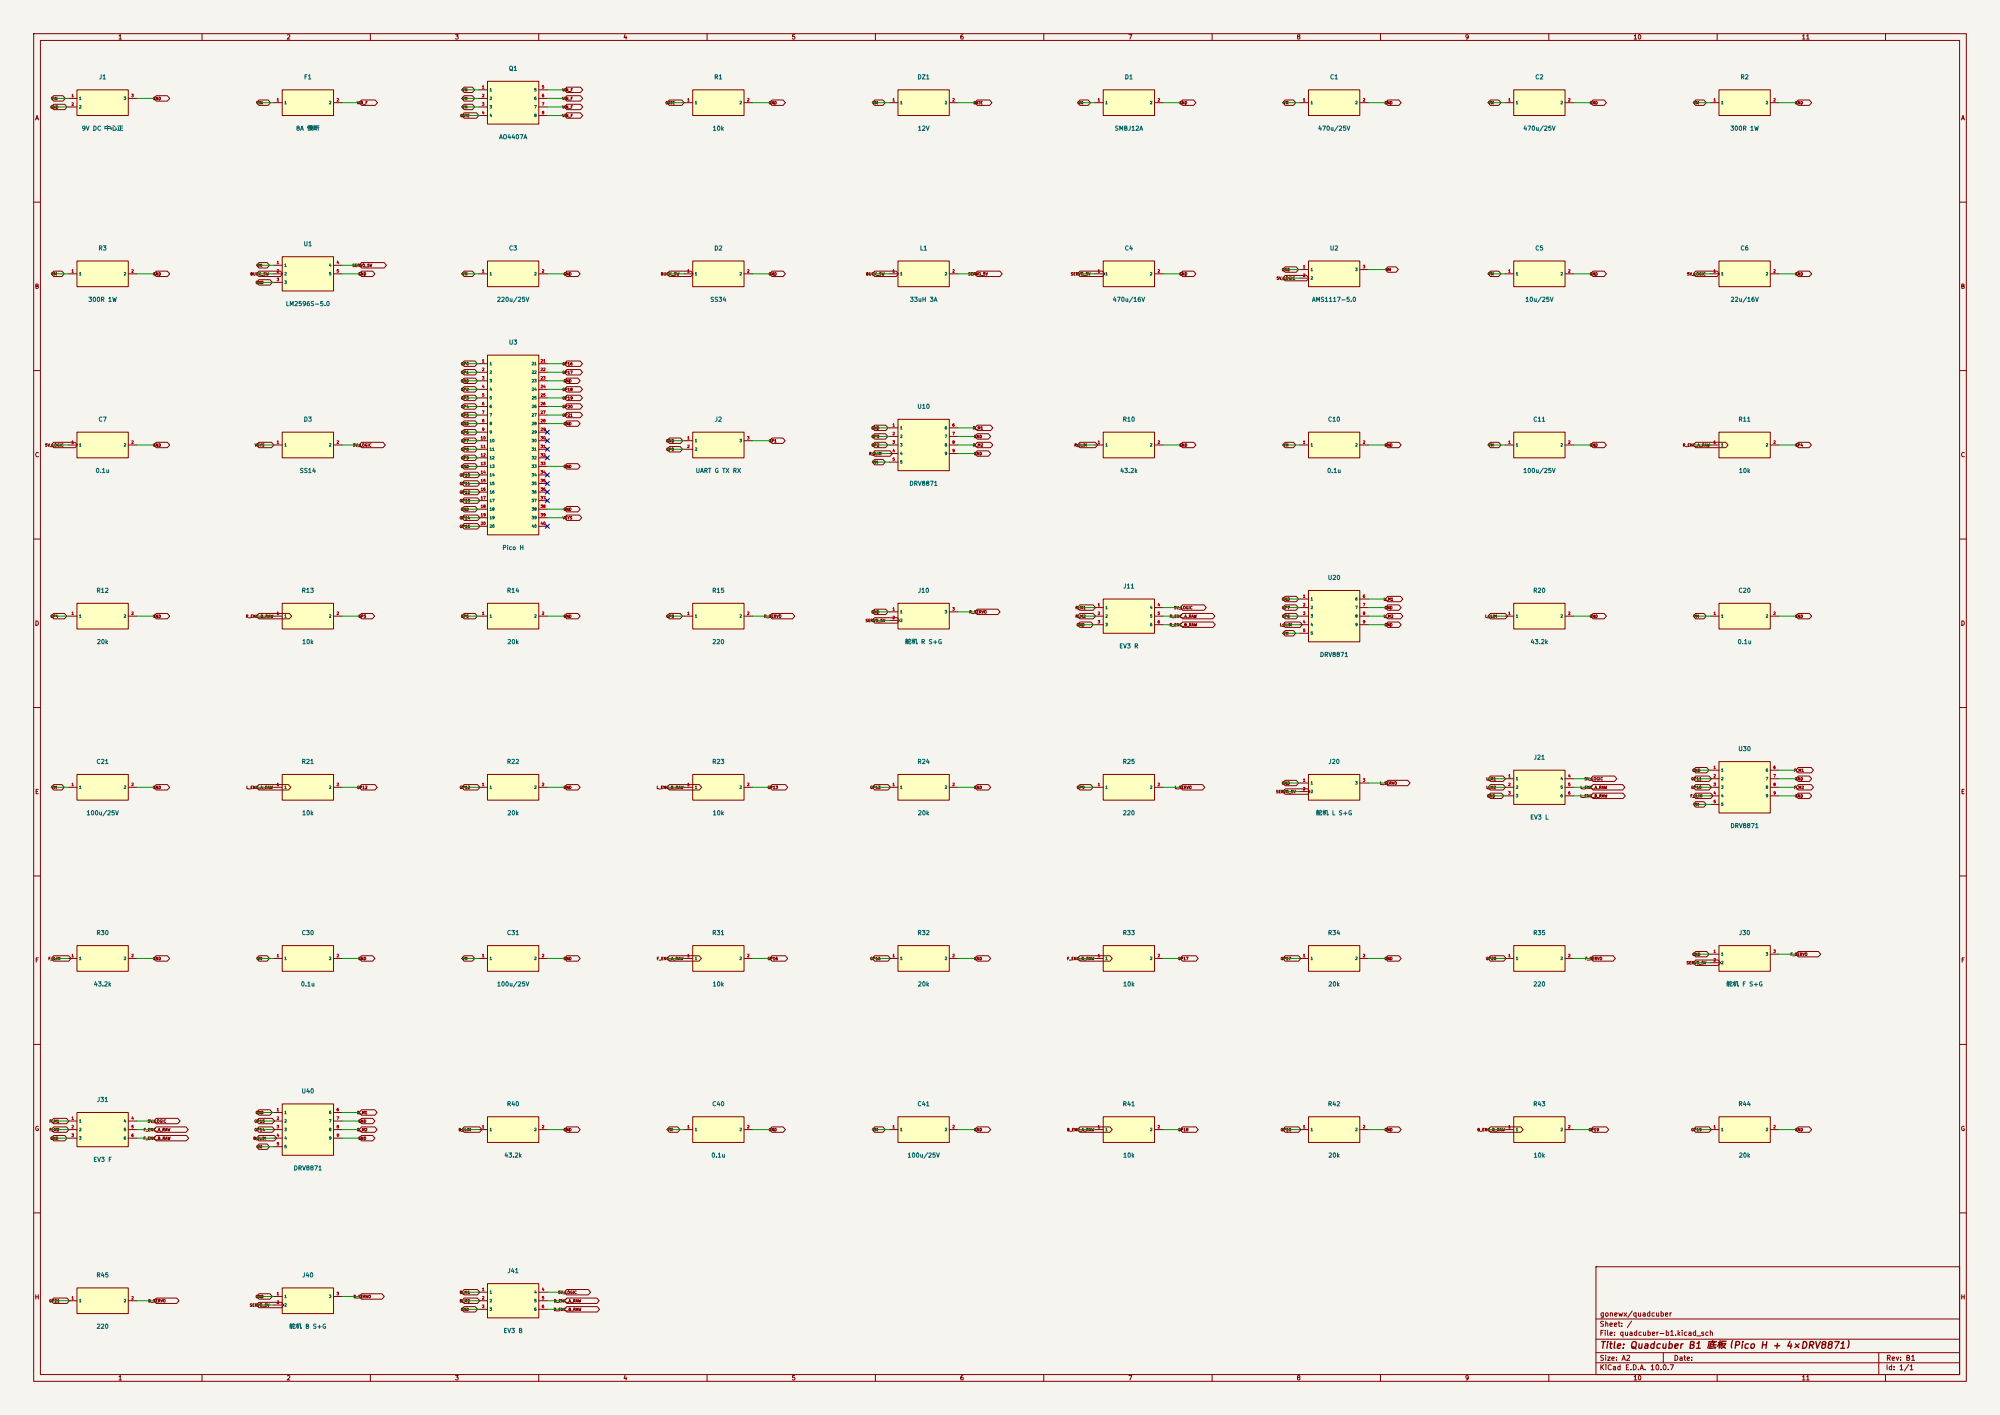
[picture p338: page 1]

gonewx/quadcuber
Sheet: /
File: quadcuber-b1.kicad_sch
Title: Quadcuber B1 底板（Pico H + 4×DRV8871）

Size: A2 | Rev: B1
KiCad E.D.A. 10.0.7 | Id: 1/1
