gonewx/quadcuber/generated/electronics/schematic.pdf

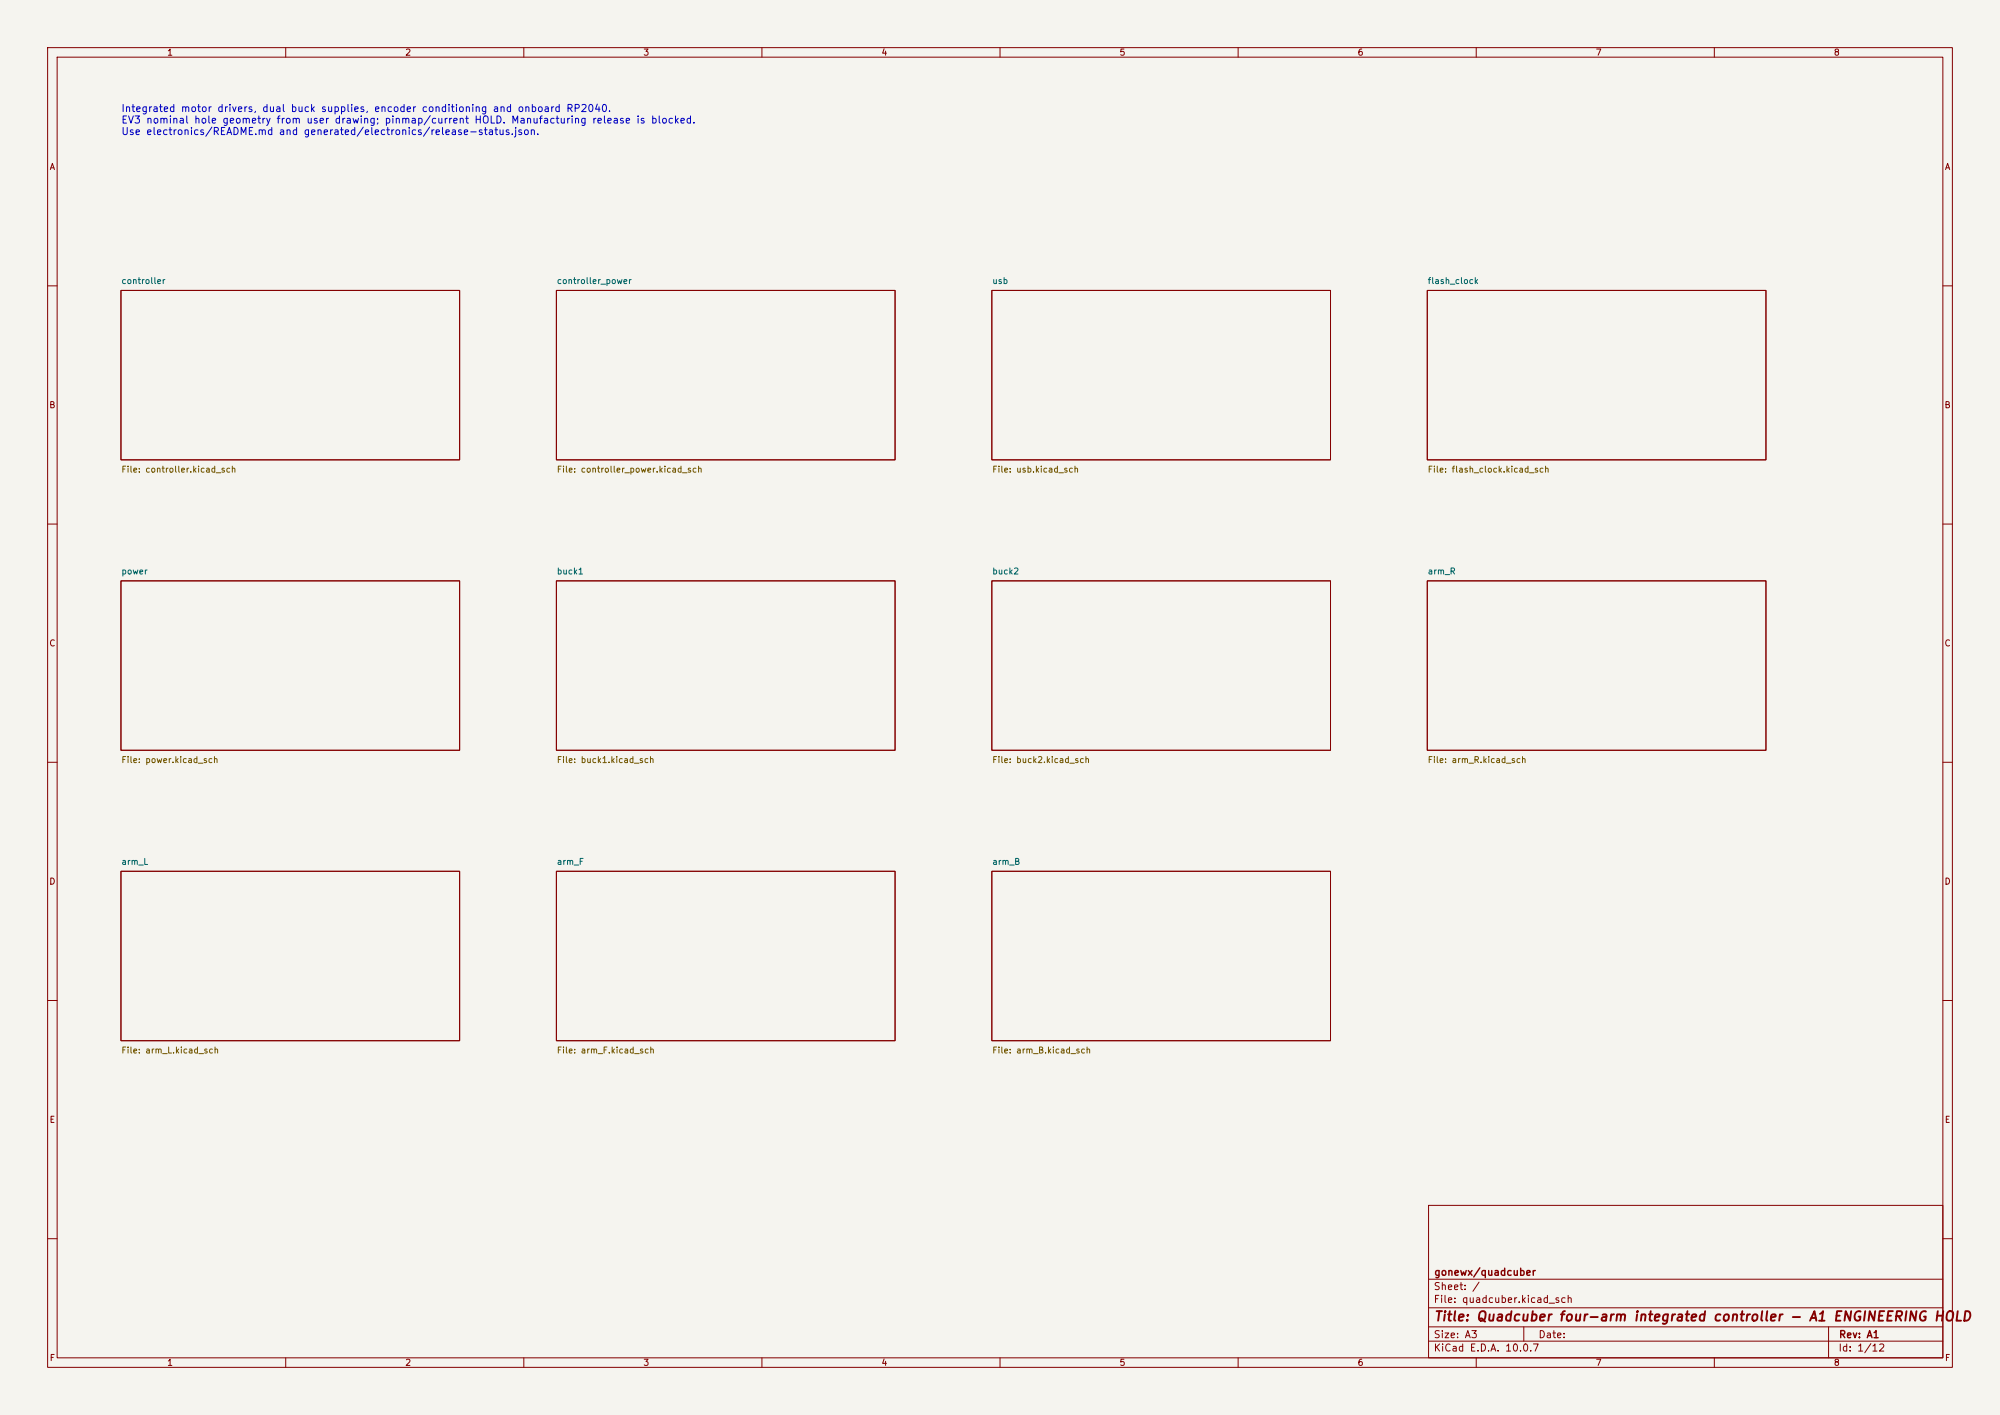
[picture p339: page 1]

Integrated motor drivers, dual buck supplies, encoder conditioning and onboard RP2040.
EV3 nominal hole geometry from user drawing; pinmap/current HOLD. Manufacturing release is blocked.
Use electronics/README.md and generated/electronics/release-status.json.

gonewx/quadcuber
Sheet: /
File: quadcuber.kicad_sch
Title: Quadcuber four-arm integrated controller - A1 ENGINEERING HOLD

Size: A3 | Rev: A1 | F Date:
KiCad E.D.A. 10.0.7 | Id: 1/12

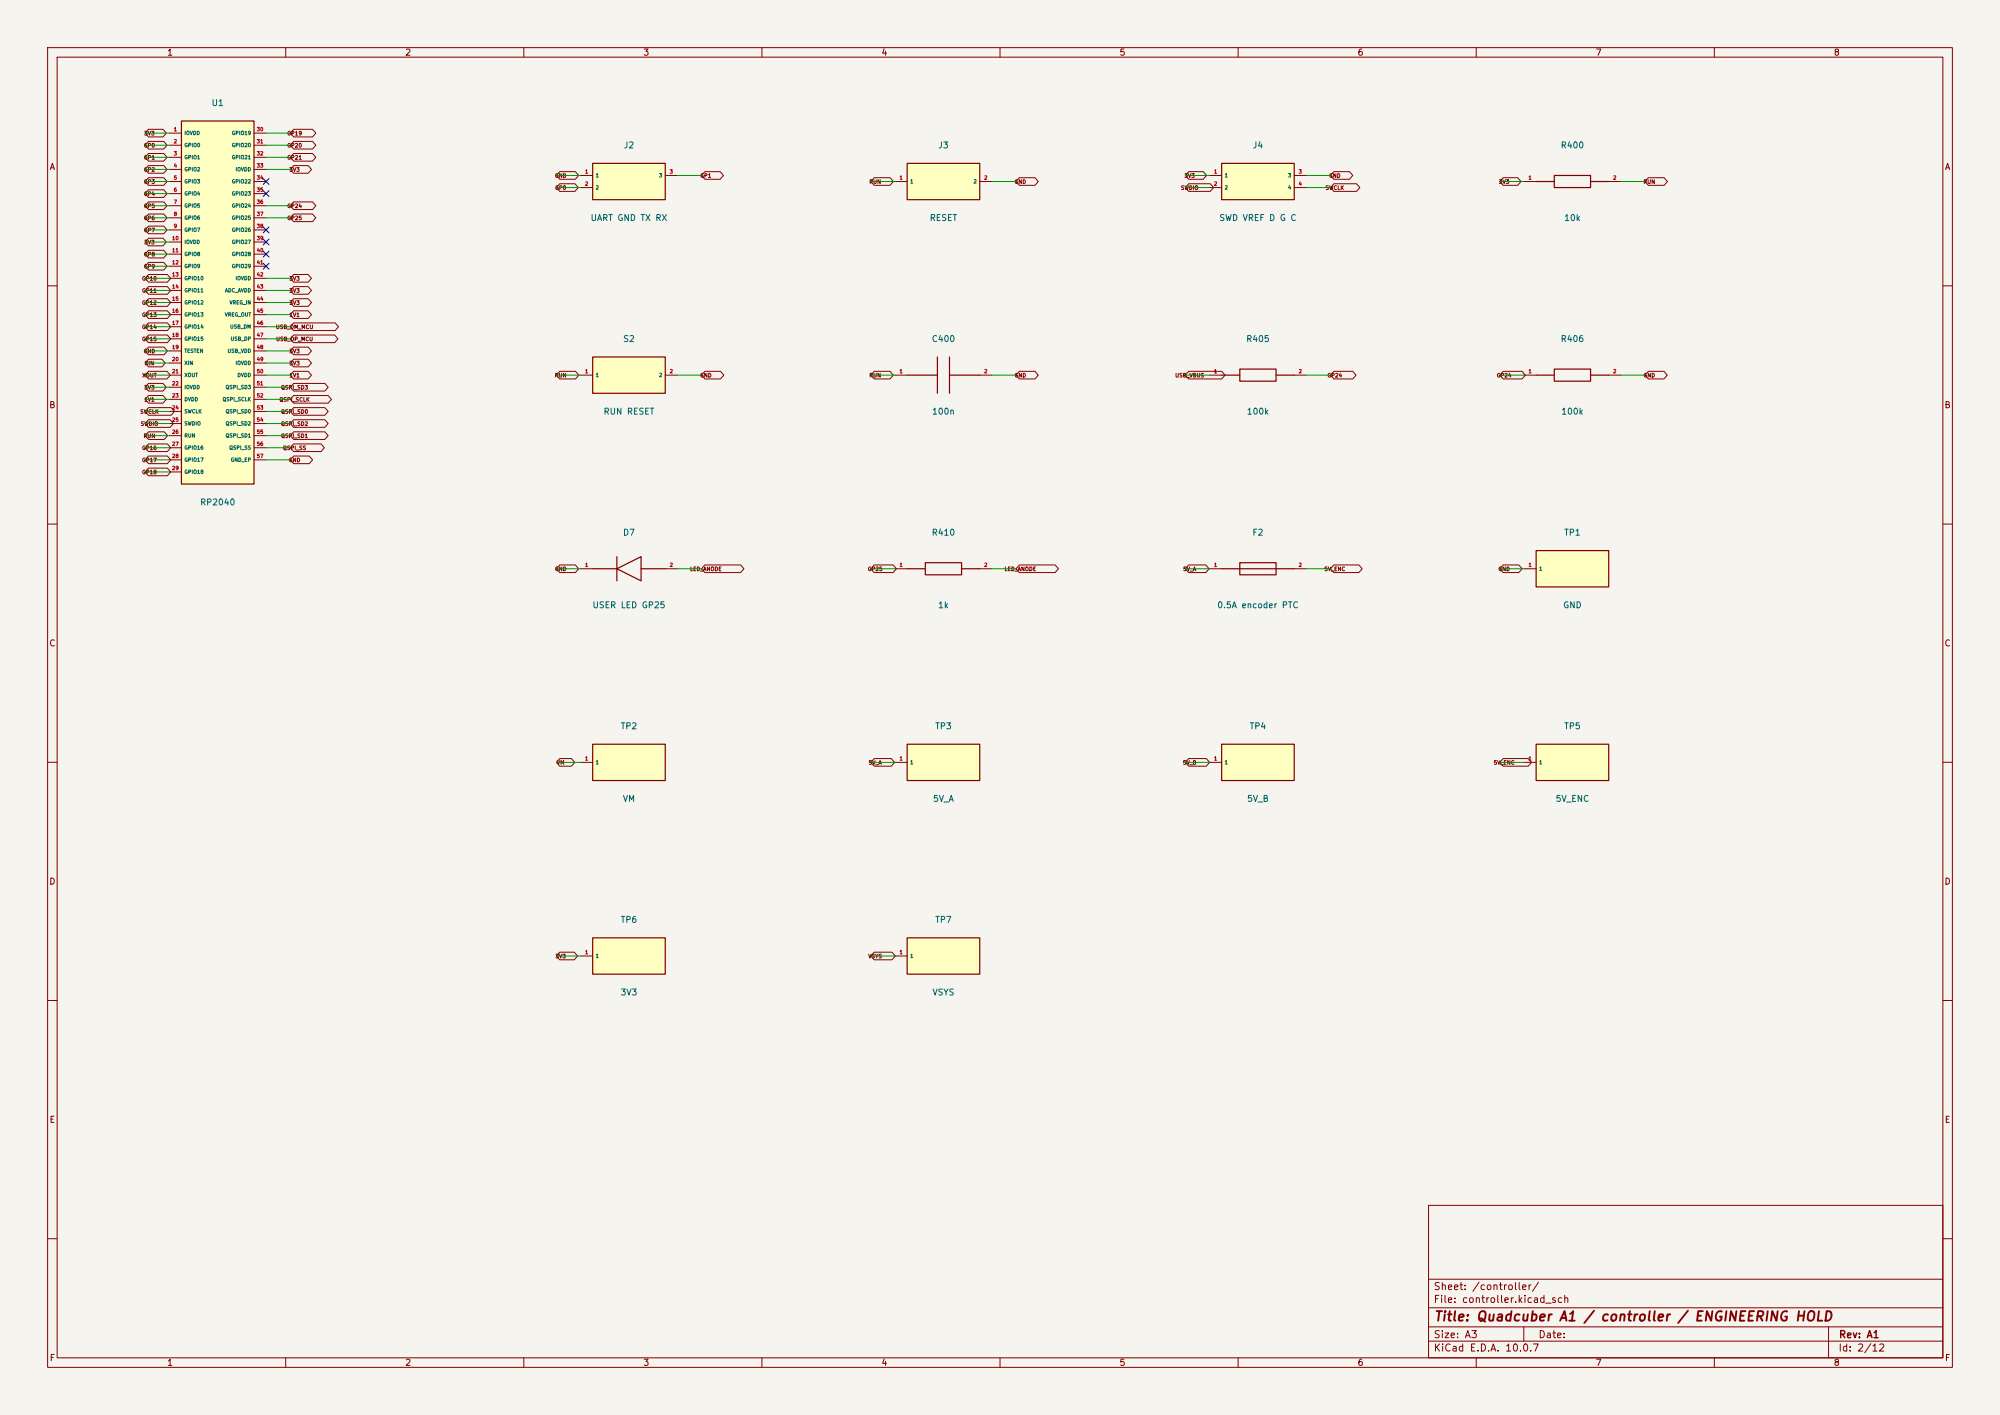
[picture p340: page 2]

3 J2 UART GND TX RX

Sheet: /controller/
File: controller.kicad_sch
Title: Quadcuber A1 / controller / ENGINEERING HOLD

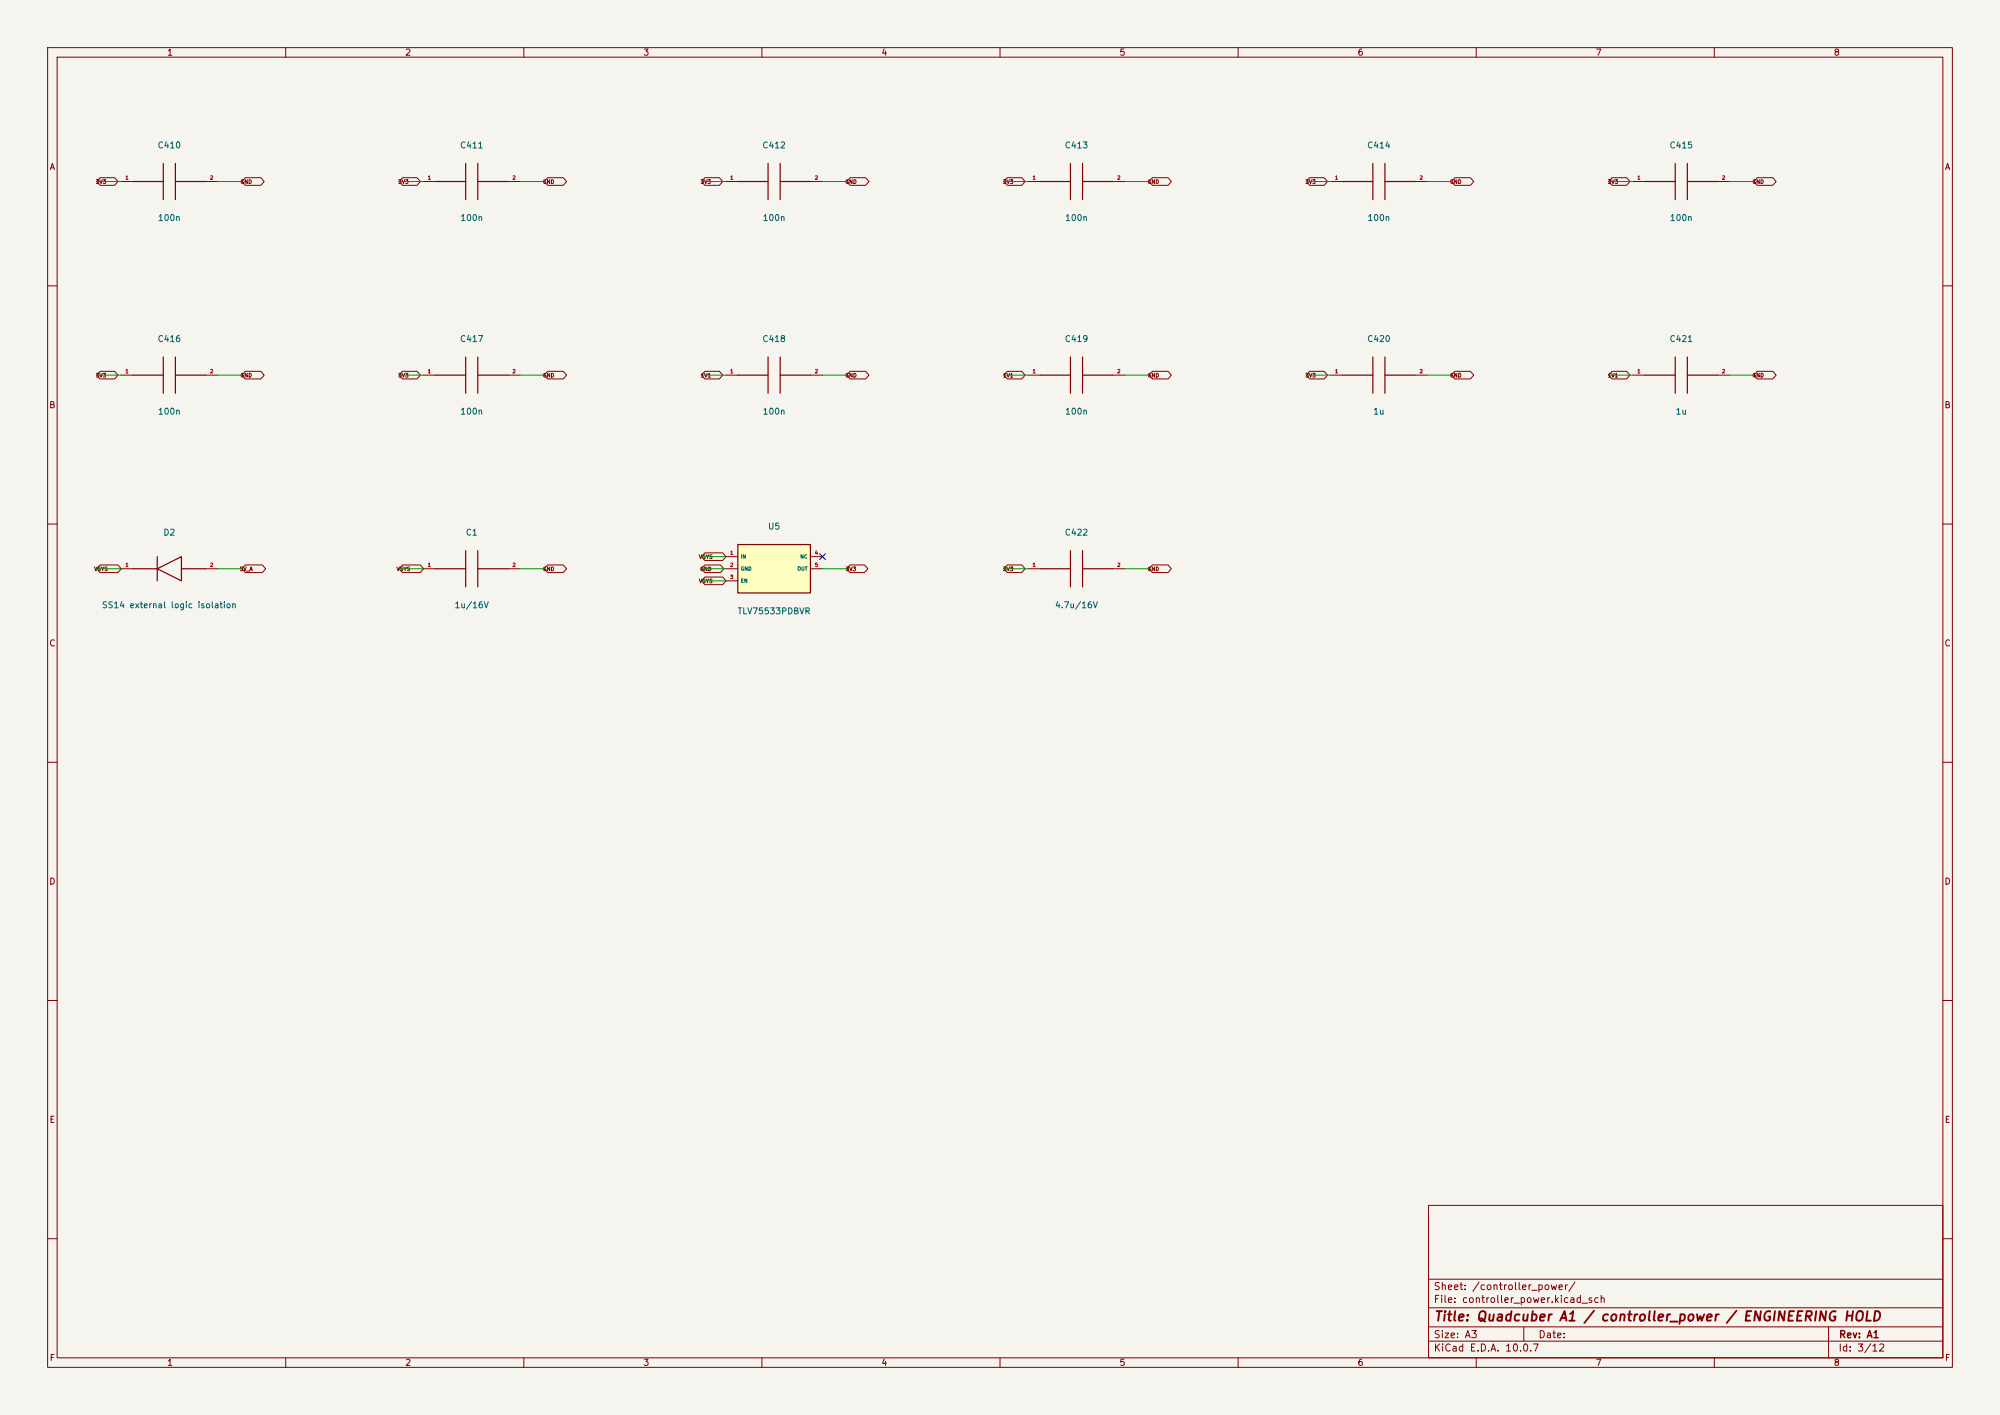
[picture p341: page 3]

Sheet: /controller_power/
File: controller_power.kicad_sch
Title: Quadcuber A1 / controller_power / ENGINEERING HOLD

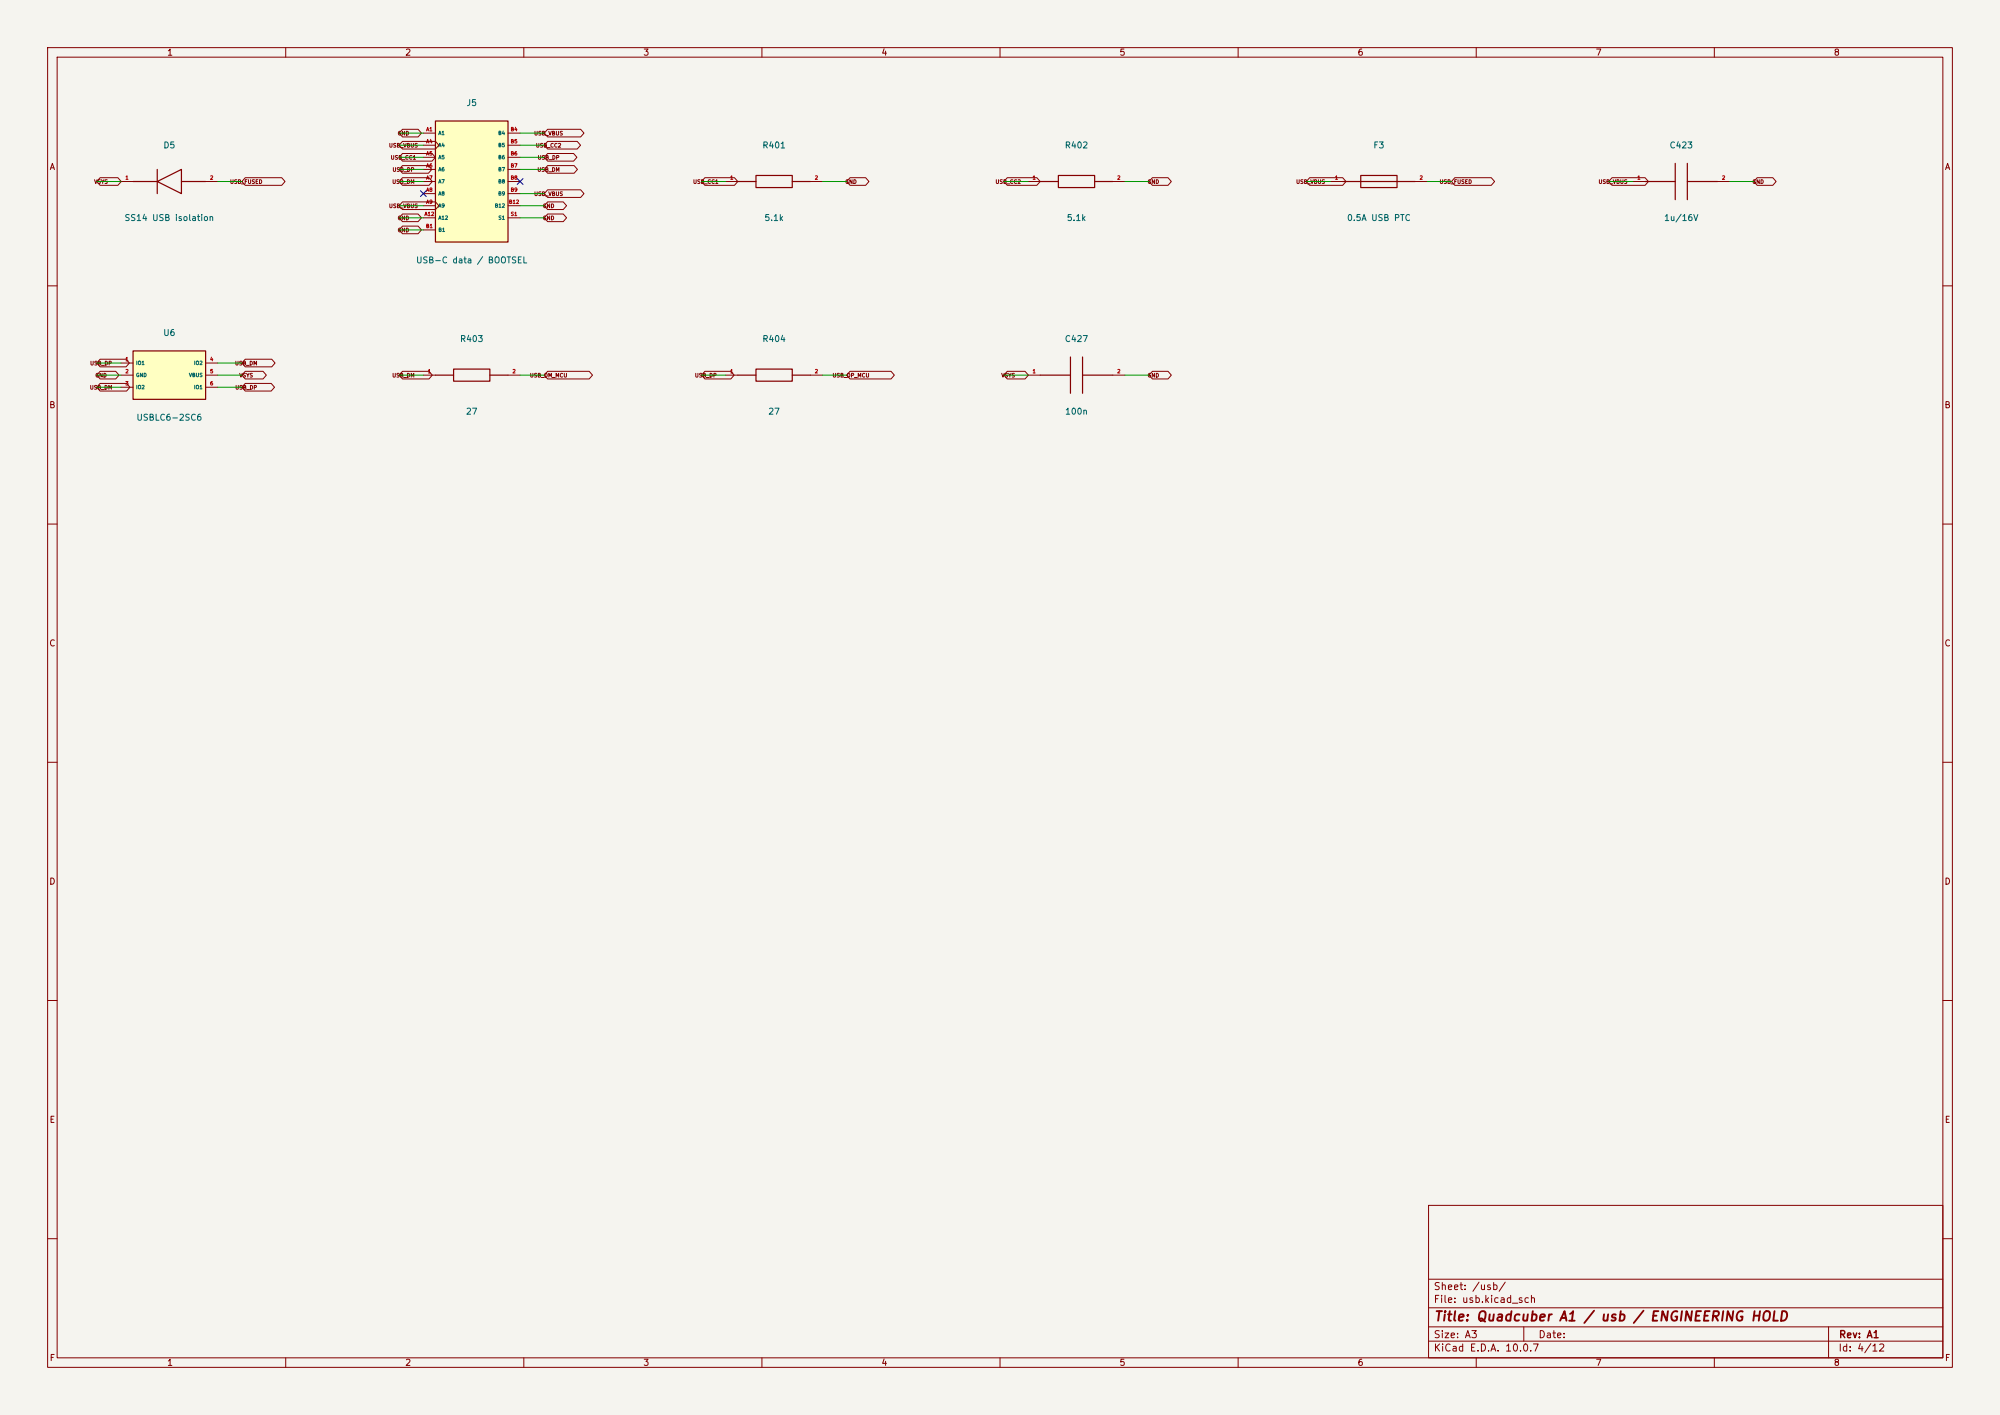
[picture p342: page 4]

Sheet: /usb/
File: usb.kicad_sch
Title: Quadcuber A1 / usb / ENGINEERING HOLD

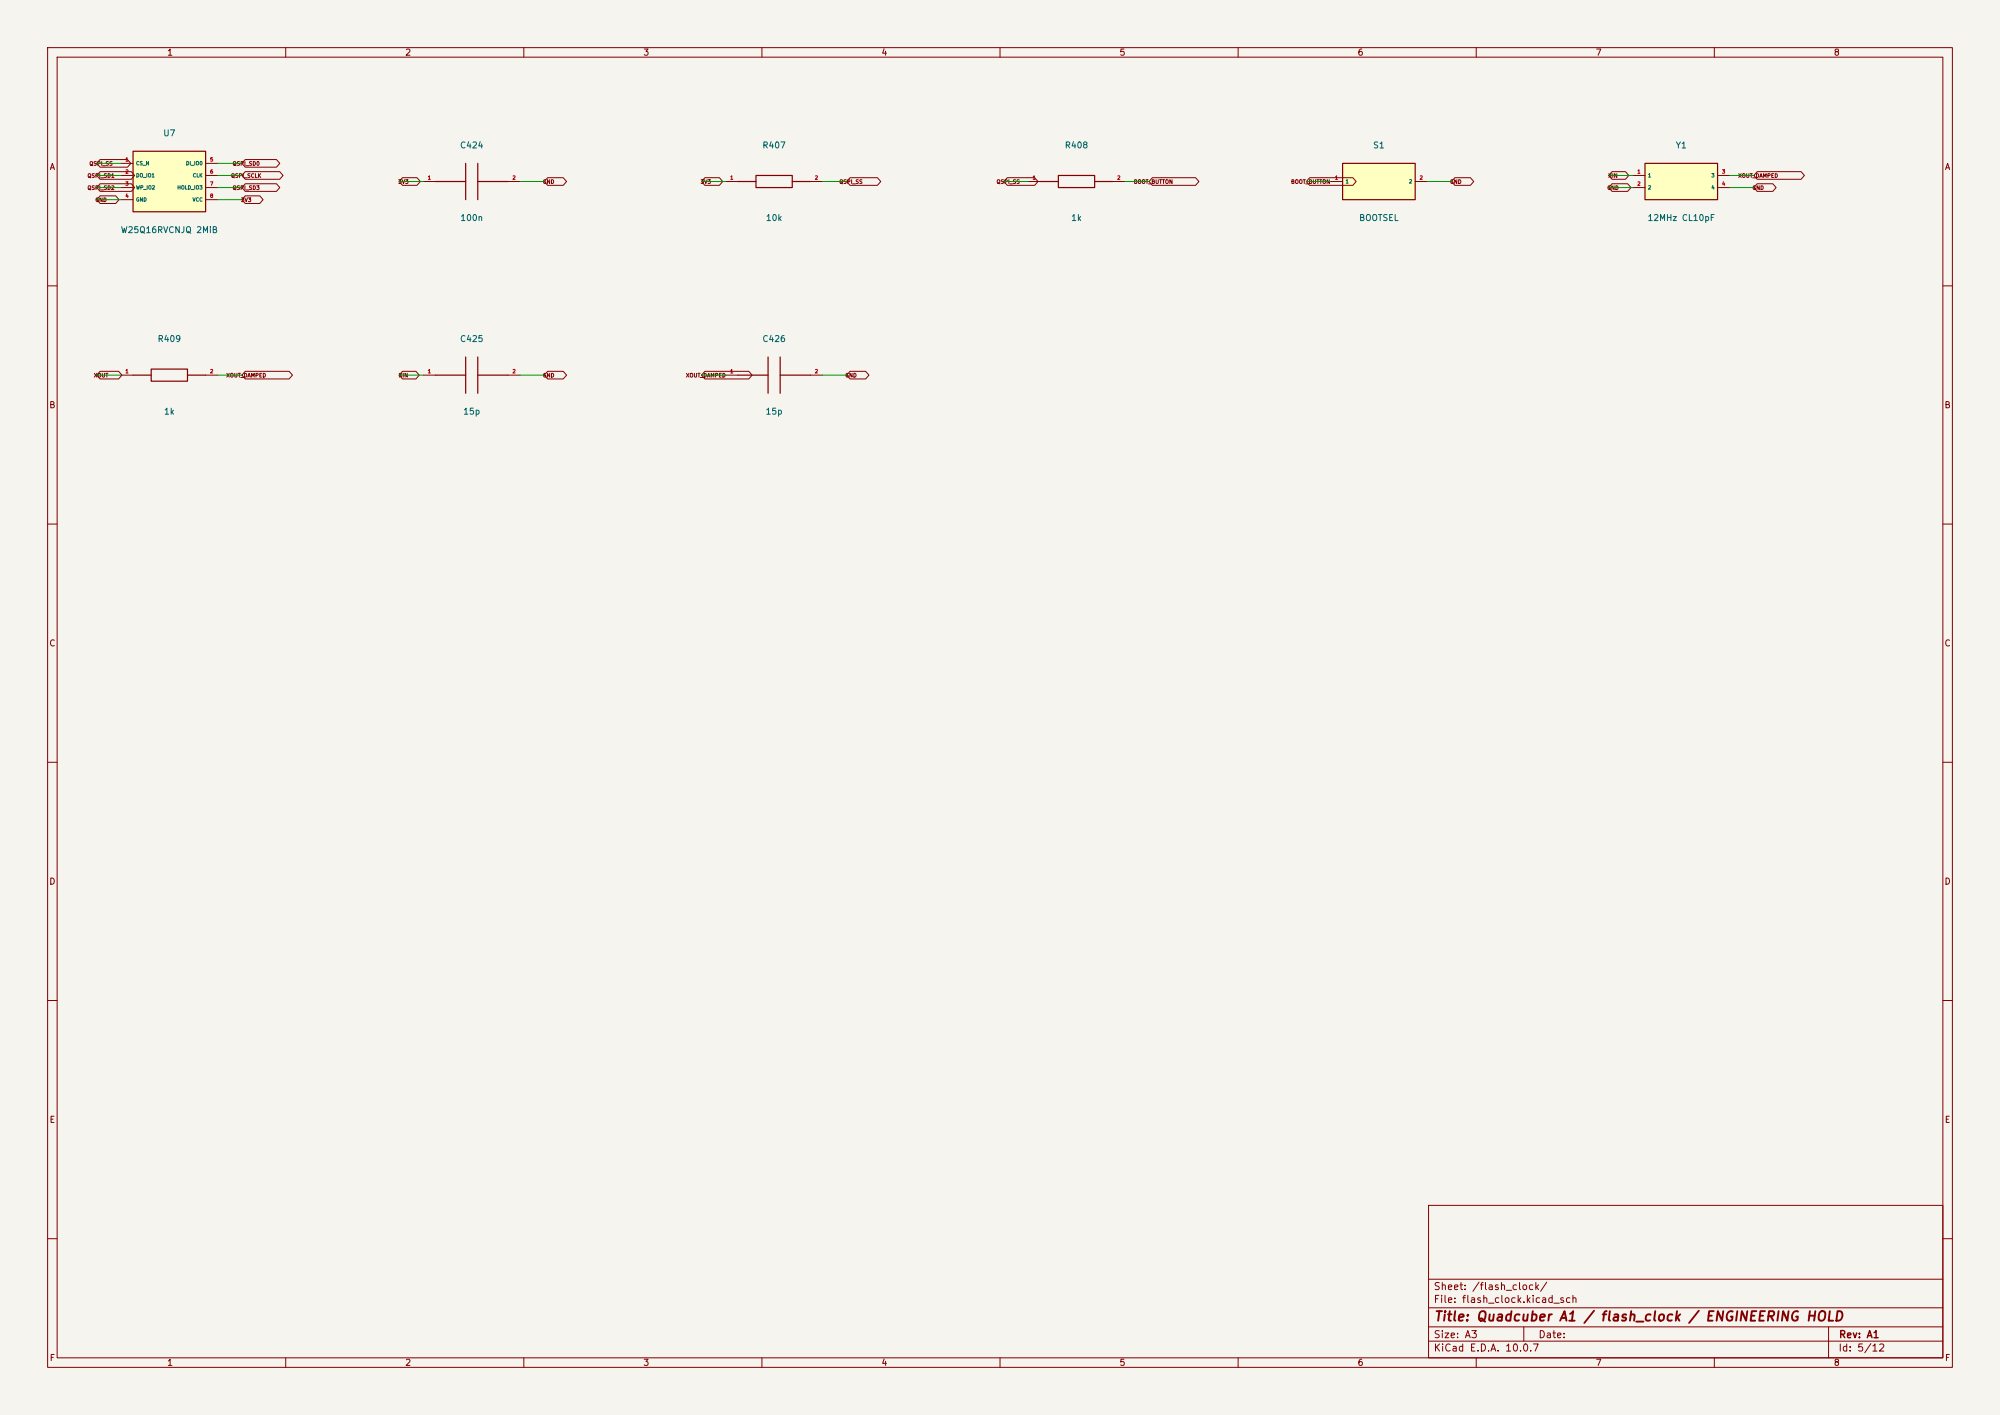
[picture p343: page 5]

Sheet: /flash_clock/
File: flash_clock.kicad_sch
Title: Quadcuber A1 / flash_clock / ENGINEERING HOLD

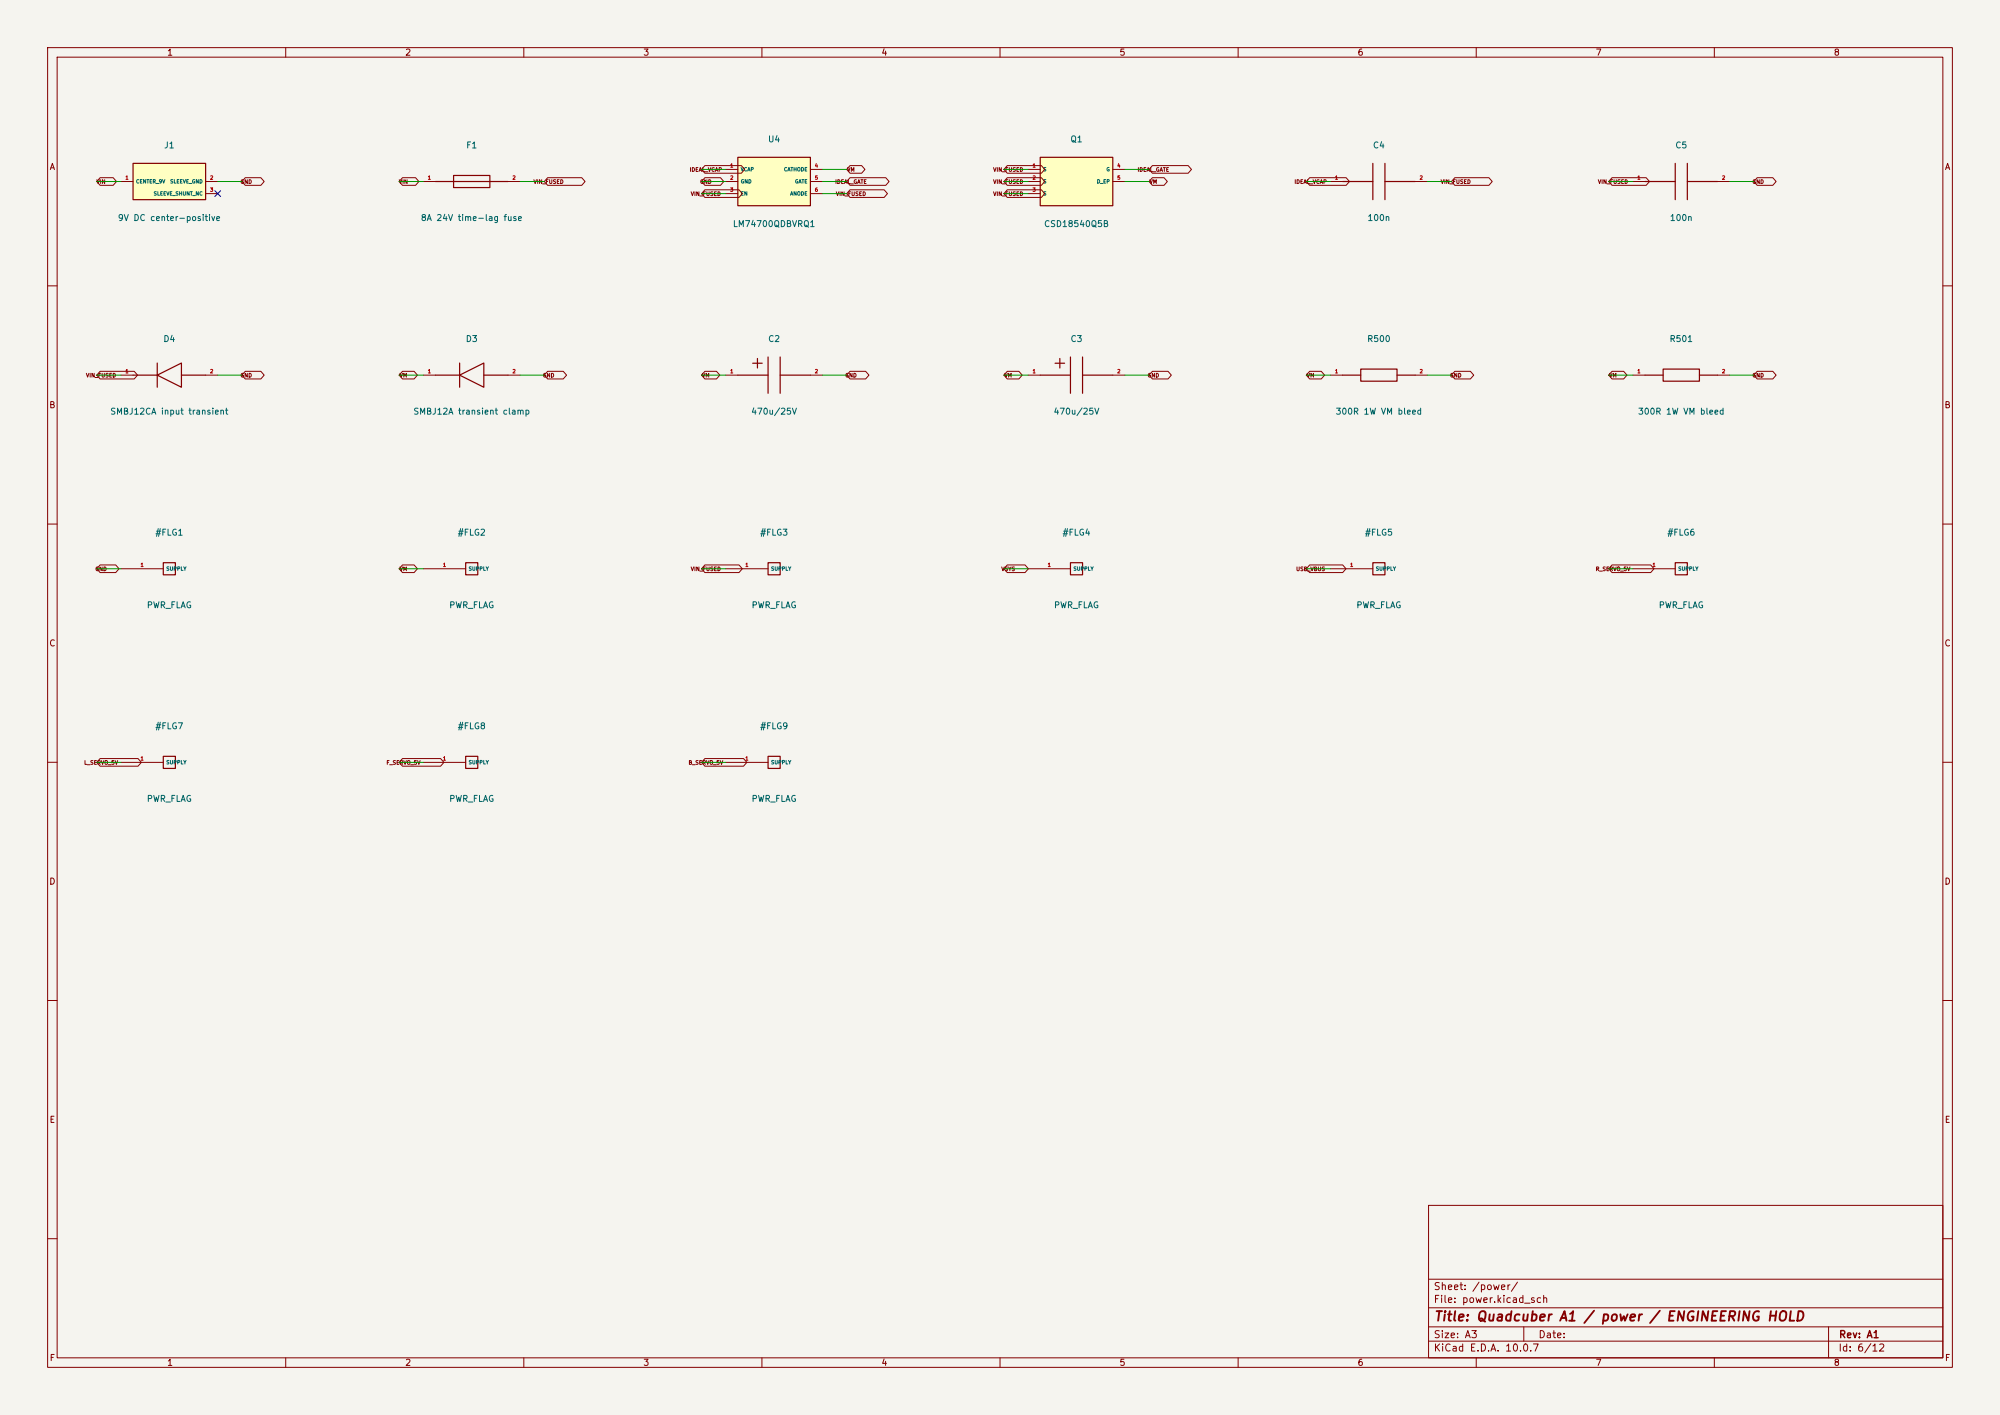
[picture p344: page 6]

Sheet: /power/
File: power.kicad_sch
Title: Quadcuber A1 / power / ENGINEERING HOLD

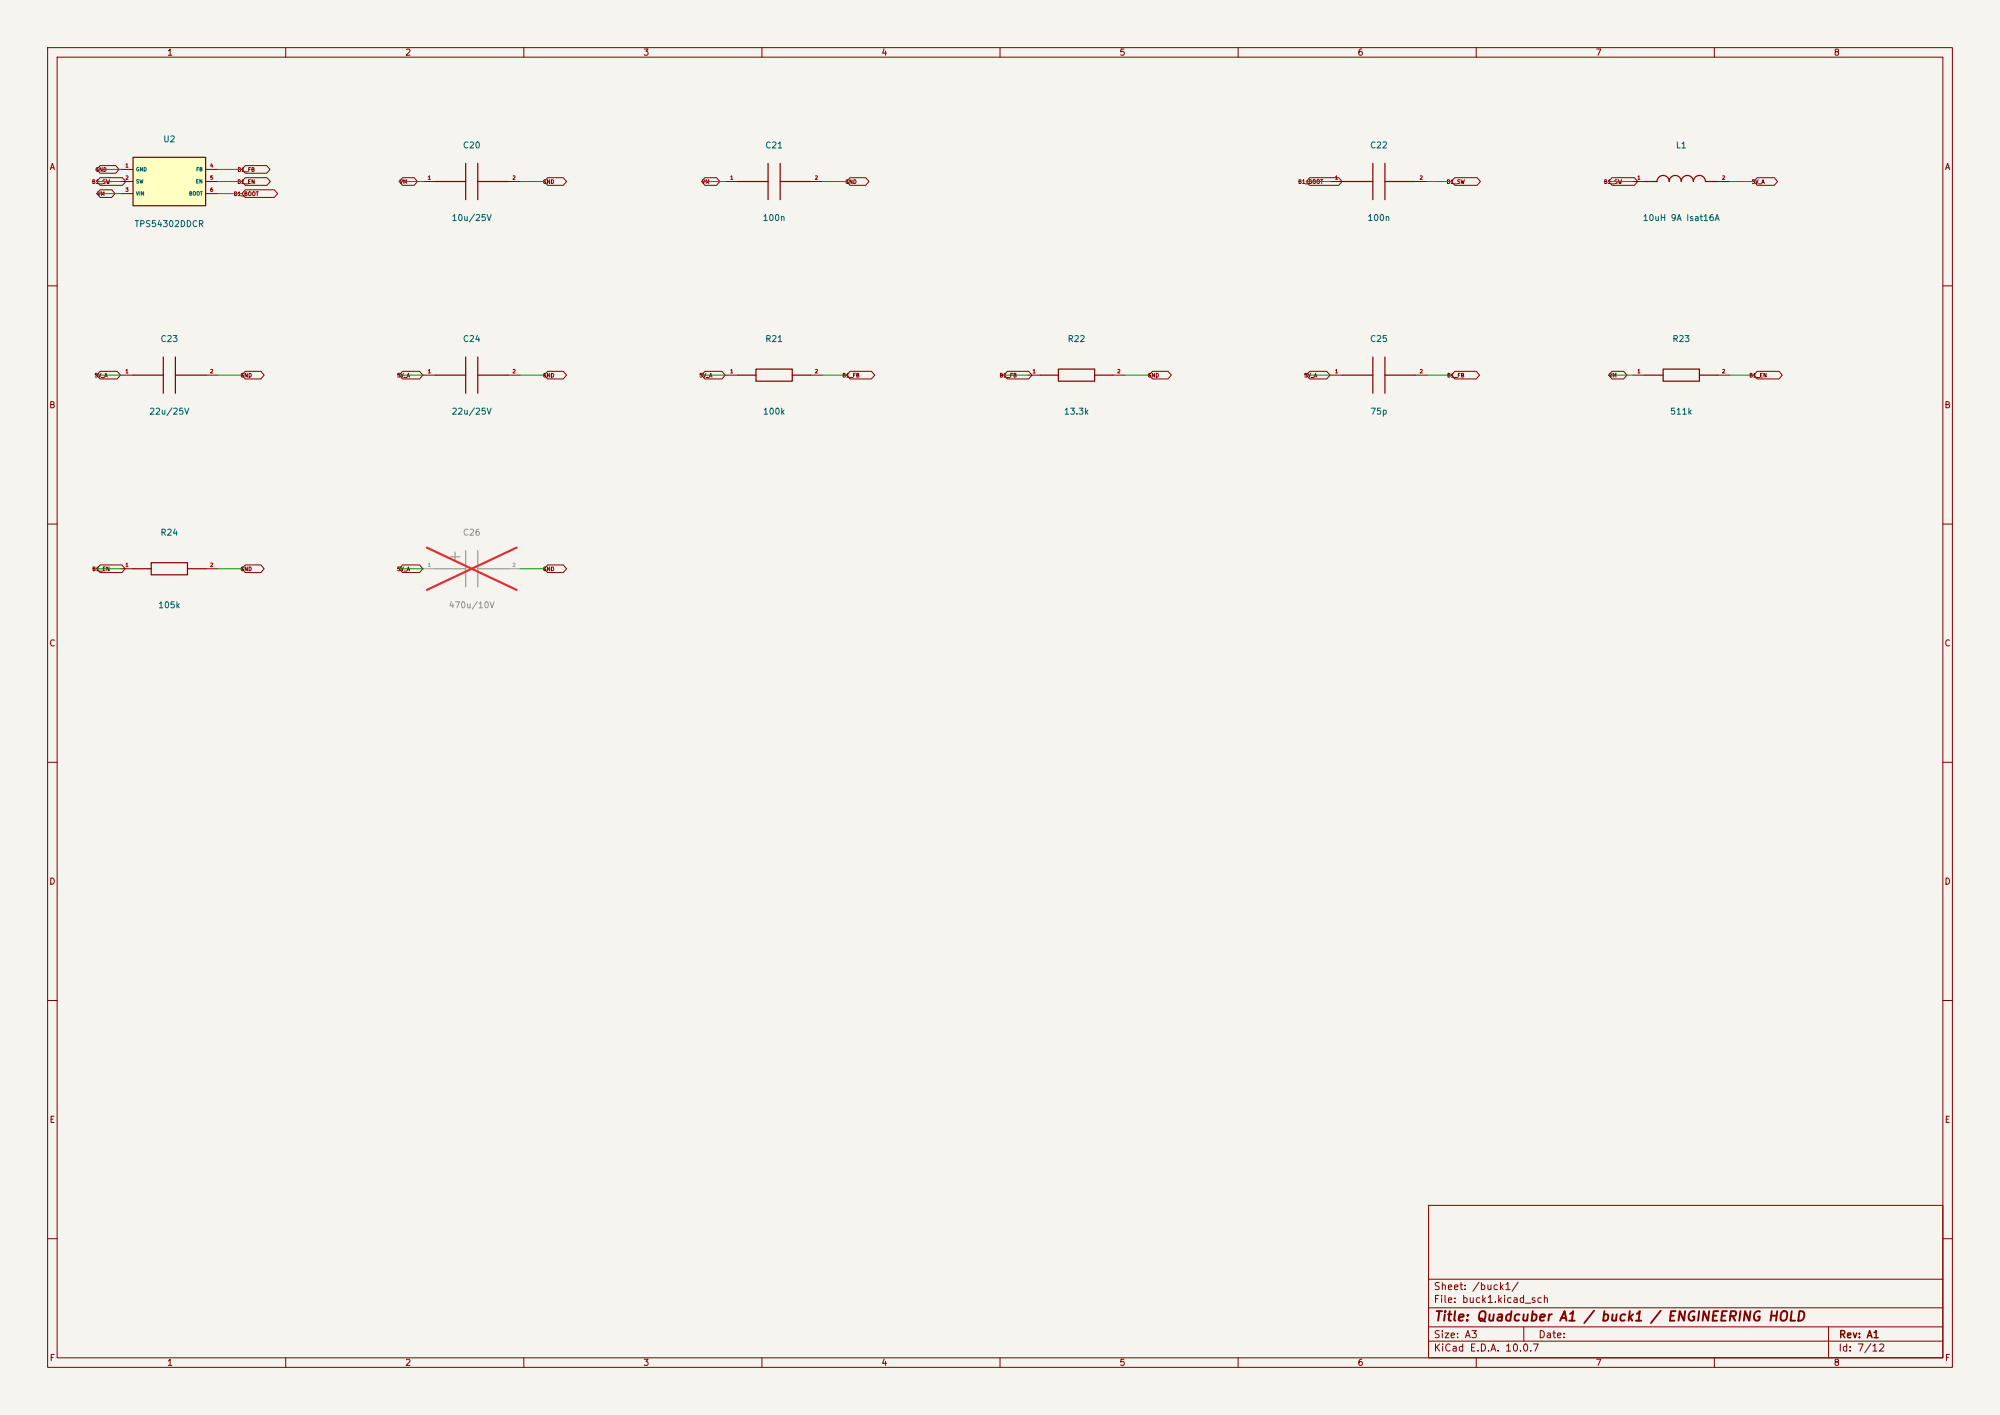
[picture p345: page 7]

Sheet: /buck1/
File: buck1.kicad_sch
Title: Quadcuber A1 / buck1 / ENGINEERING HOLD

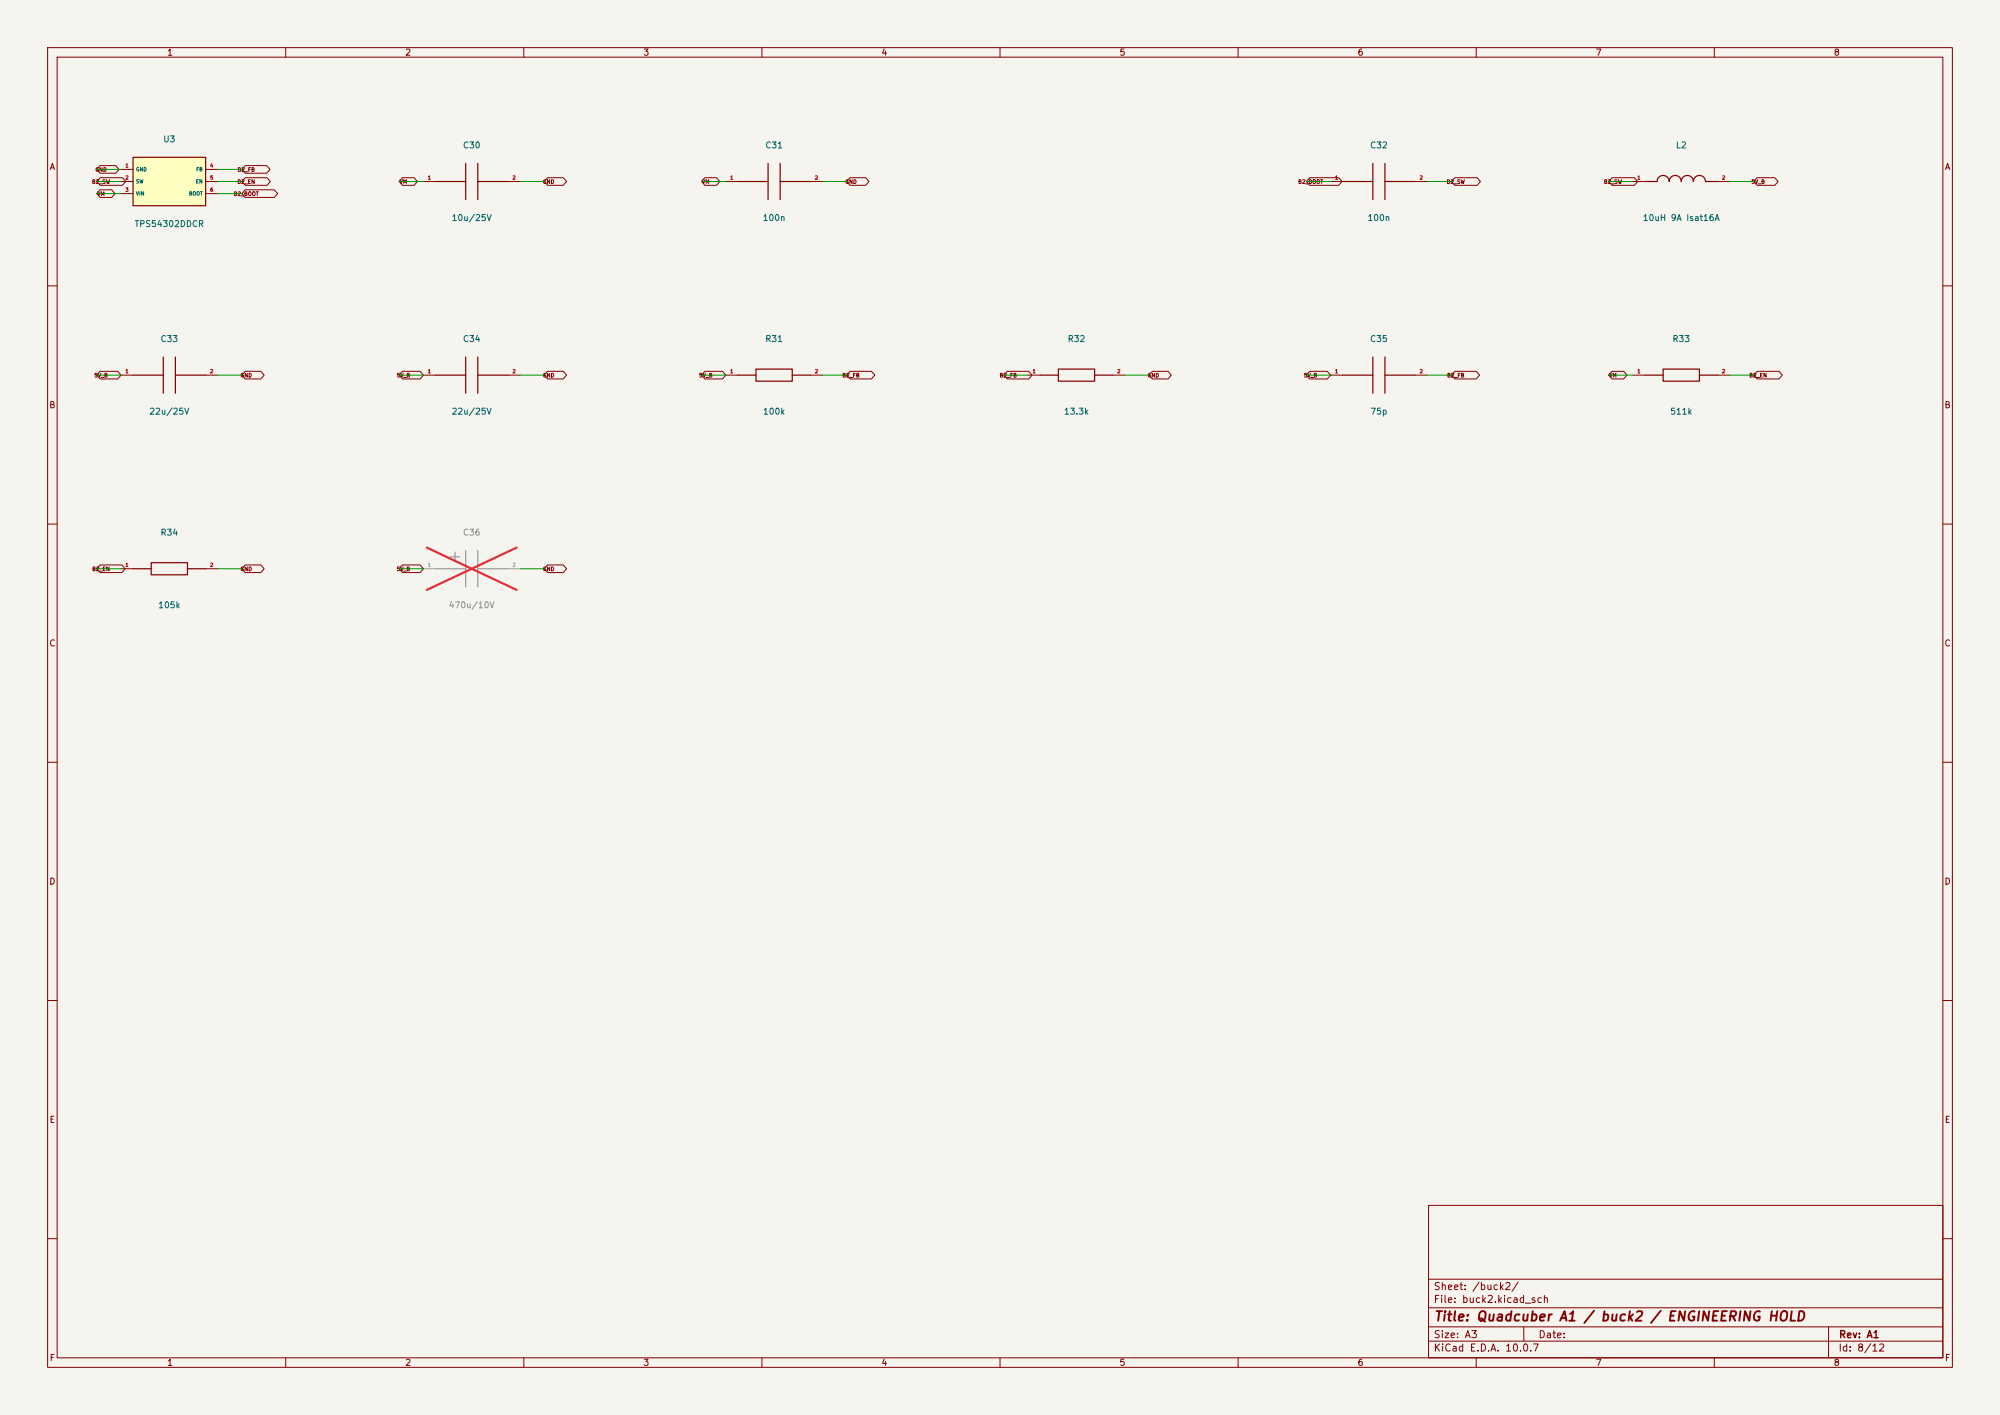
[picture p346: page 8]

Sheet: /buck2/
File: buck2.kicad_sch
Title: Quadcuber A1 / buck2 / ENGINEERING HOLD

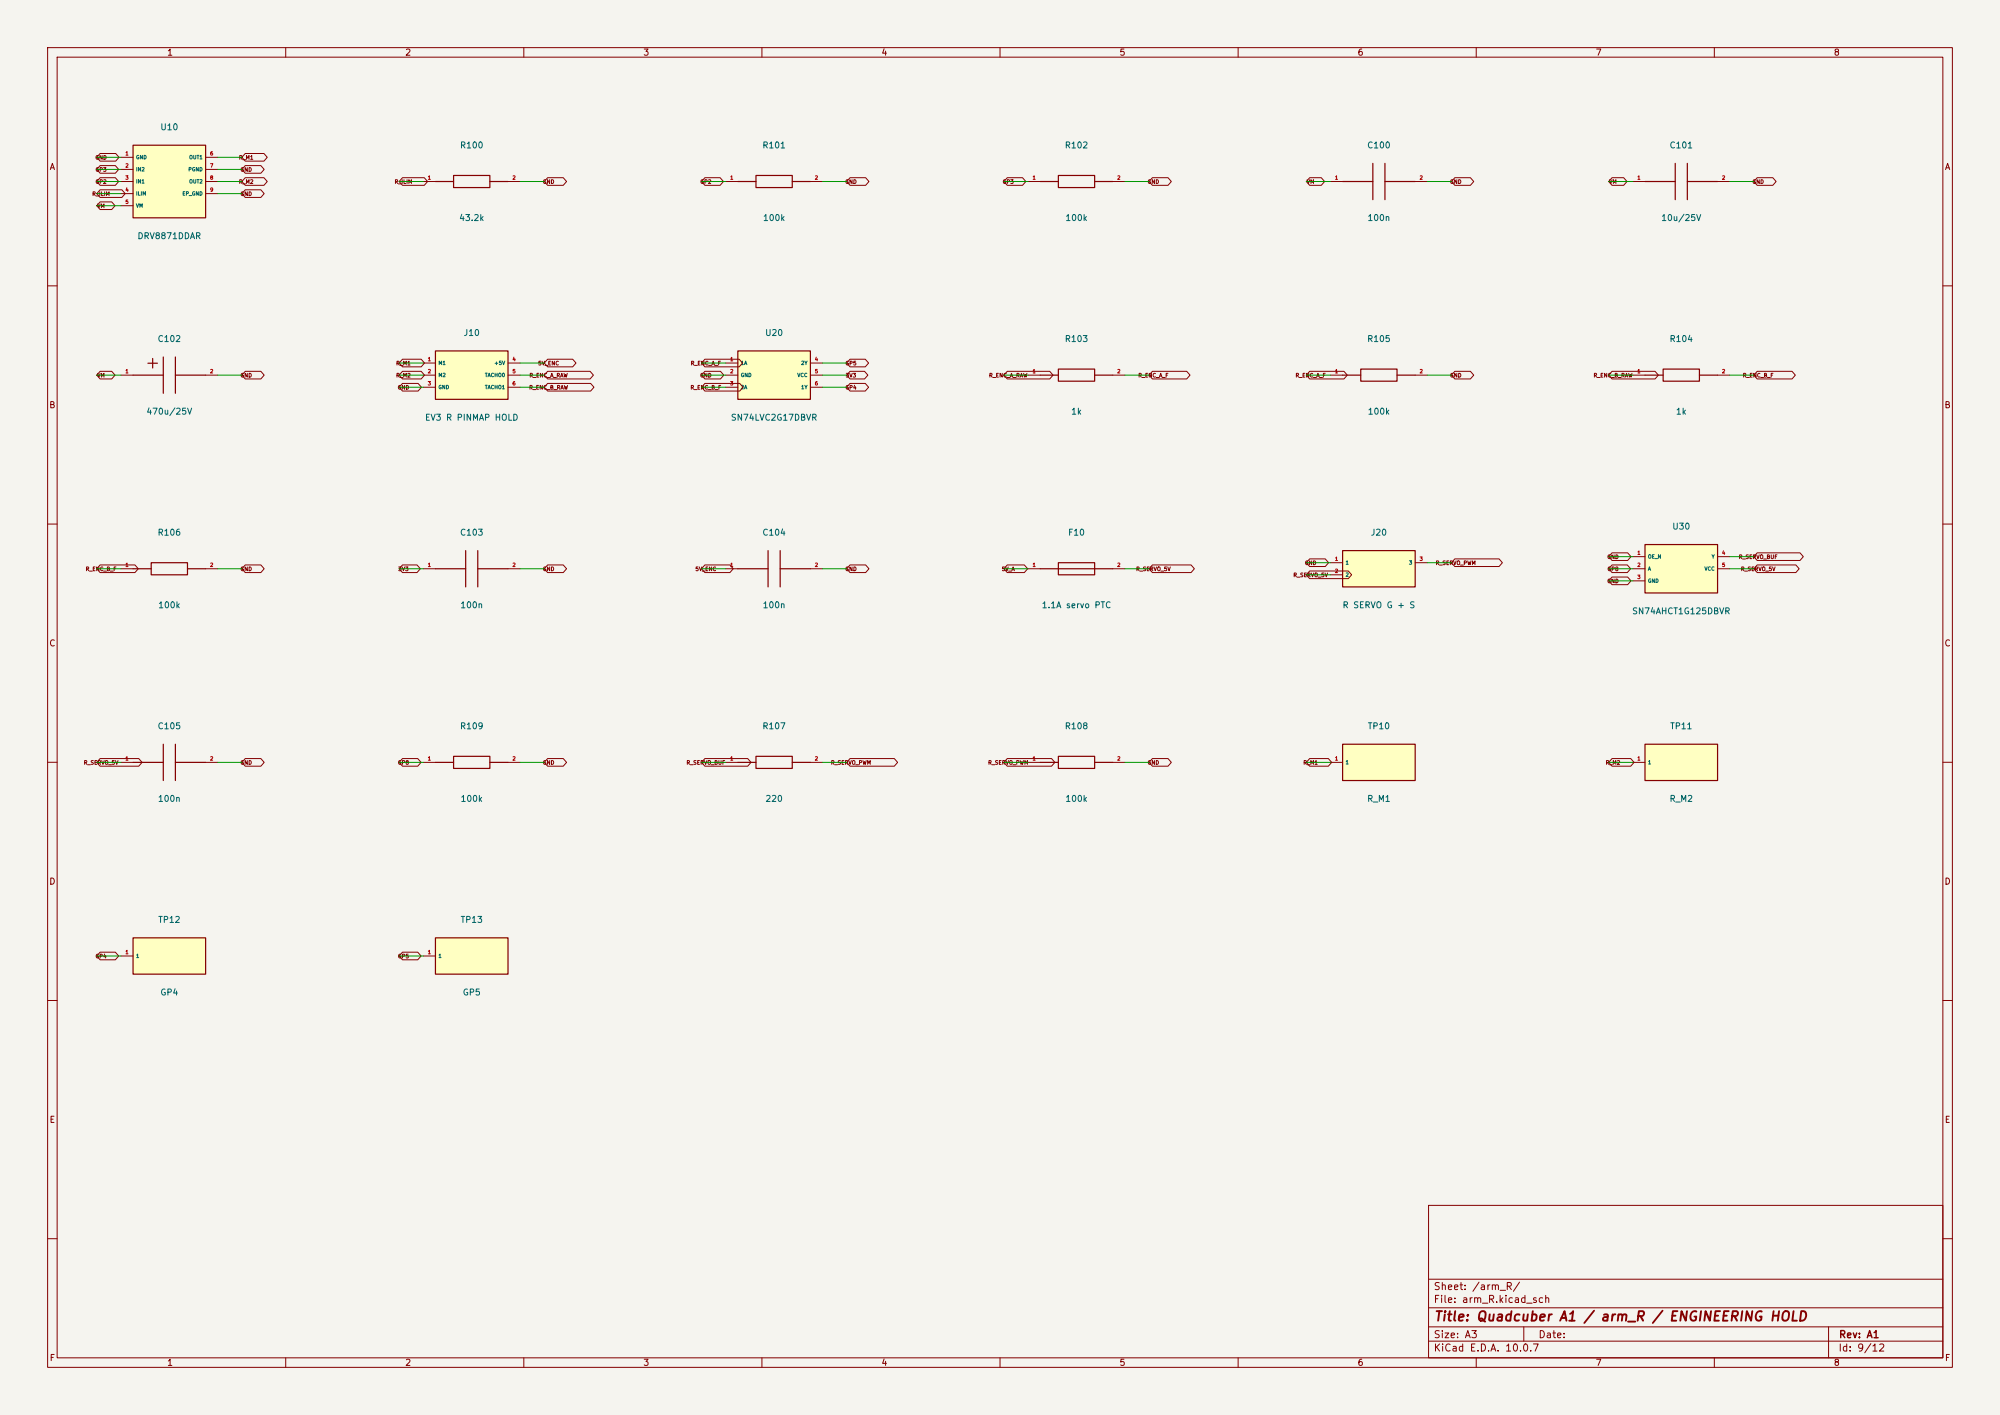
[picture p347: page 9]

Sheet: /arm_R/
File: arm_R.kicad_sch
Title: Quadcuber A1 / arm_R / ENGINEERING HOLD

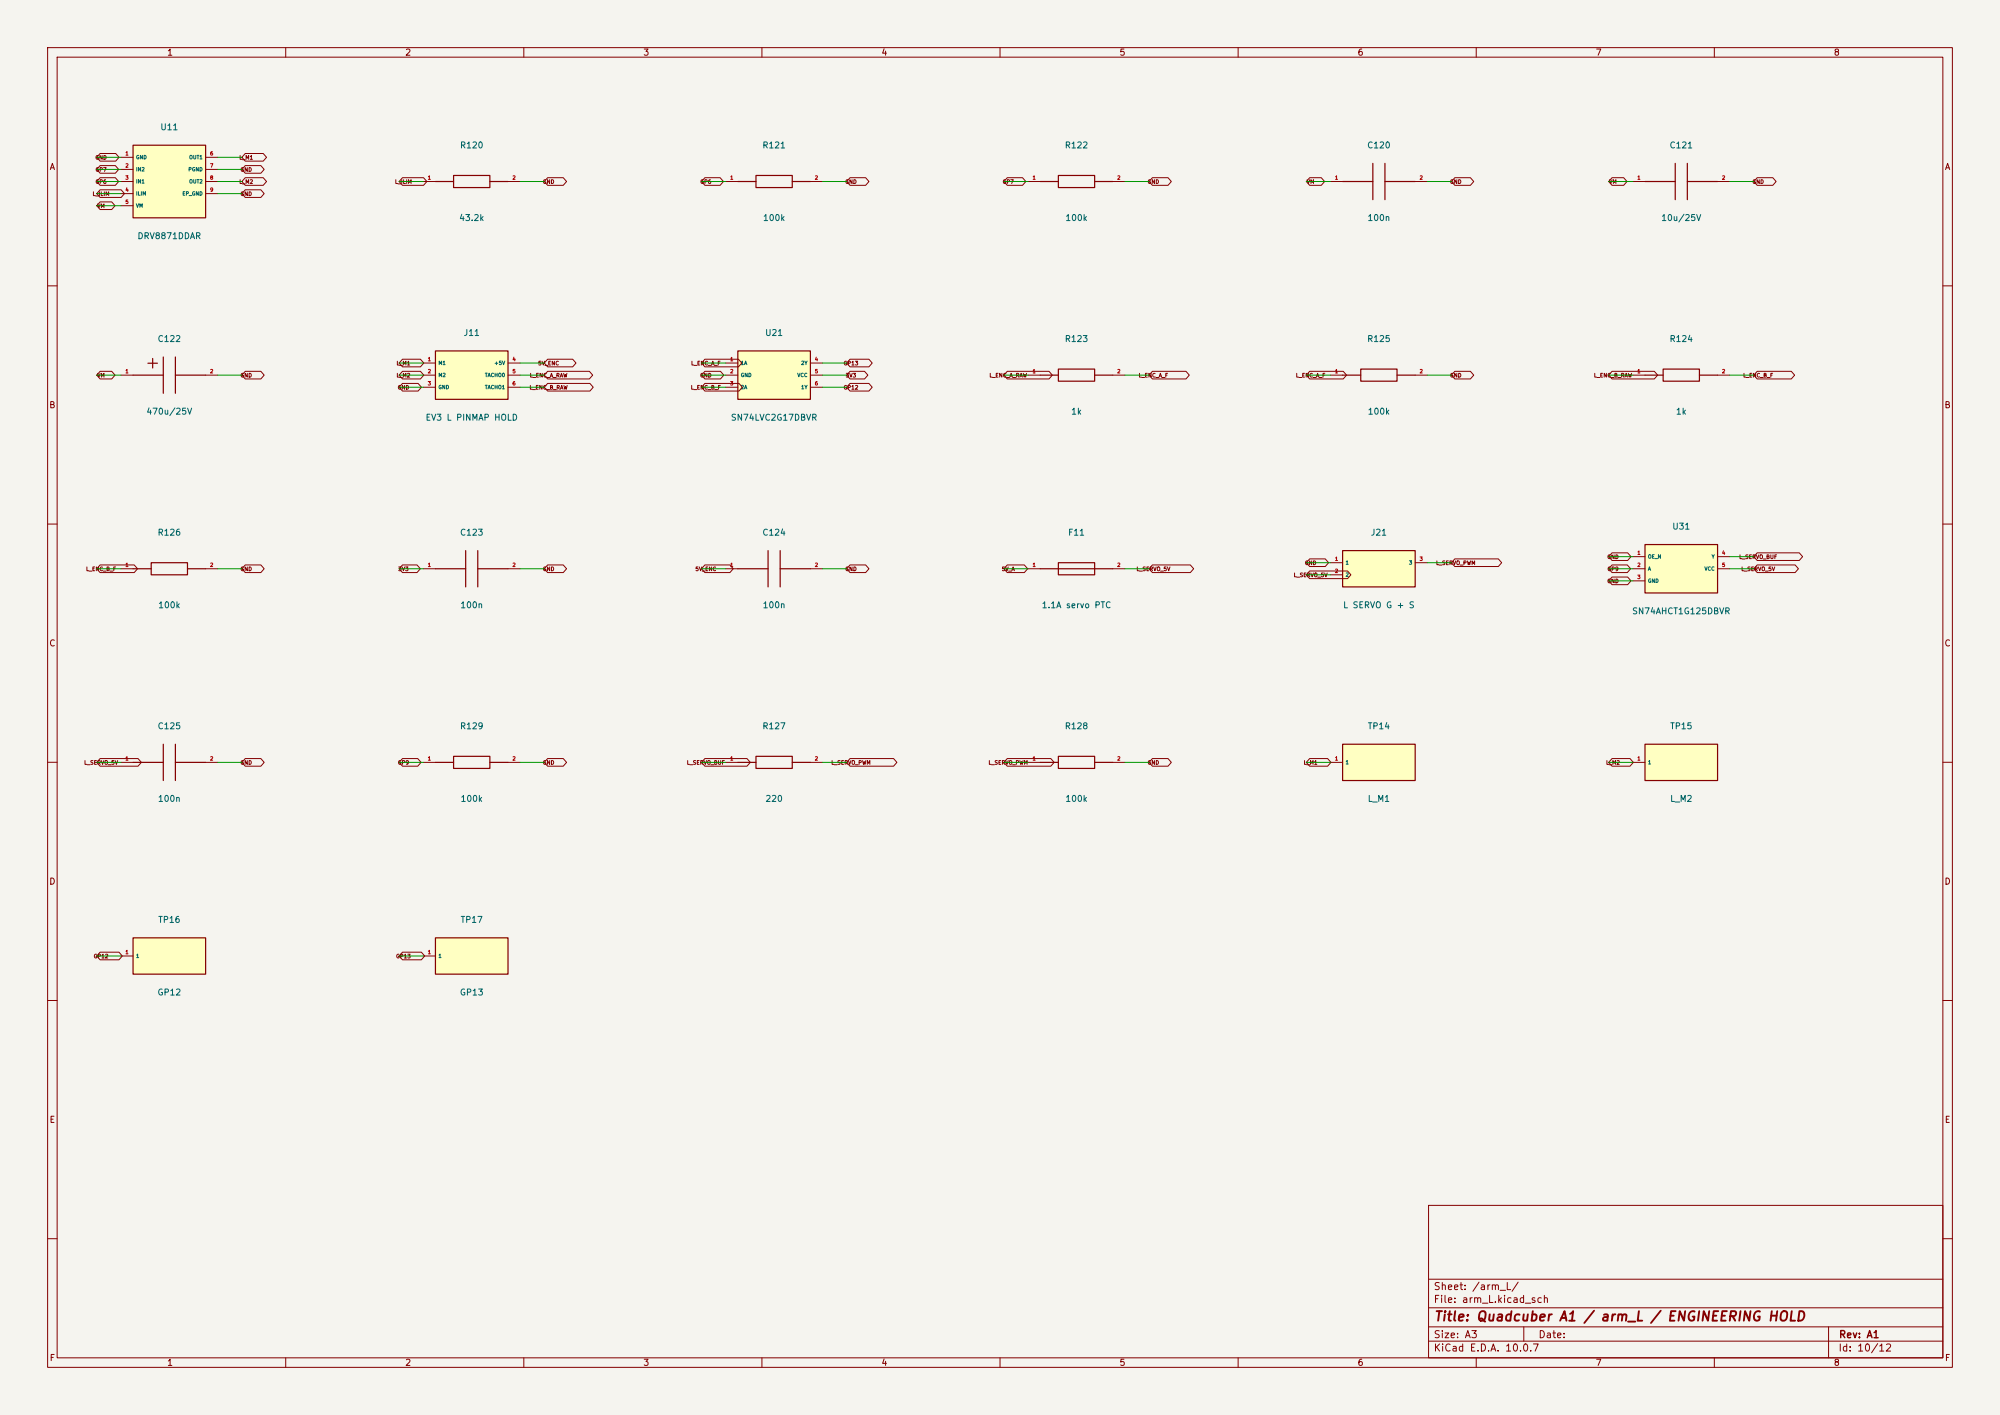
[picture p348: page 10]

Sheet: /arm_L/
File: arm_L.kicad_sch
Title: Quadcuber A1 / arm_L / ENGINEERING HOLD

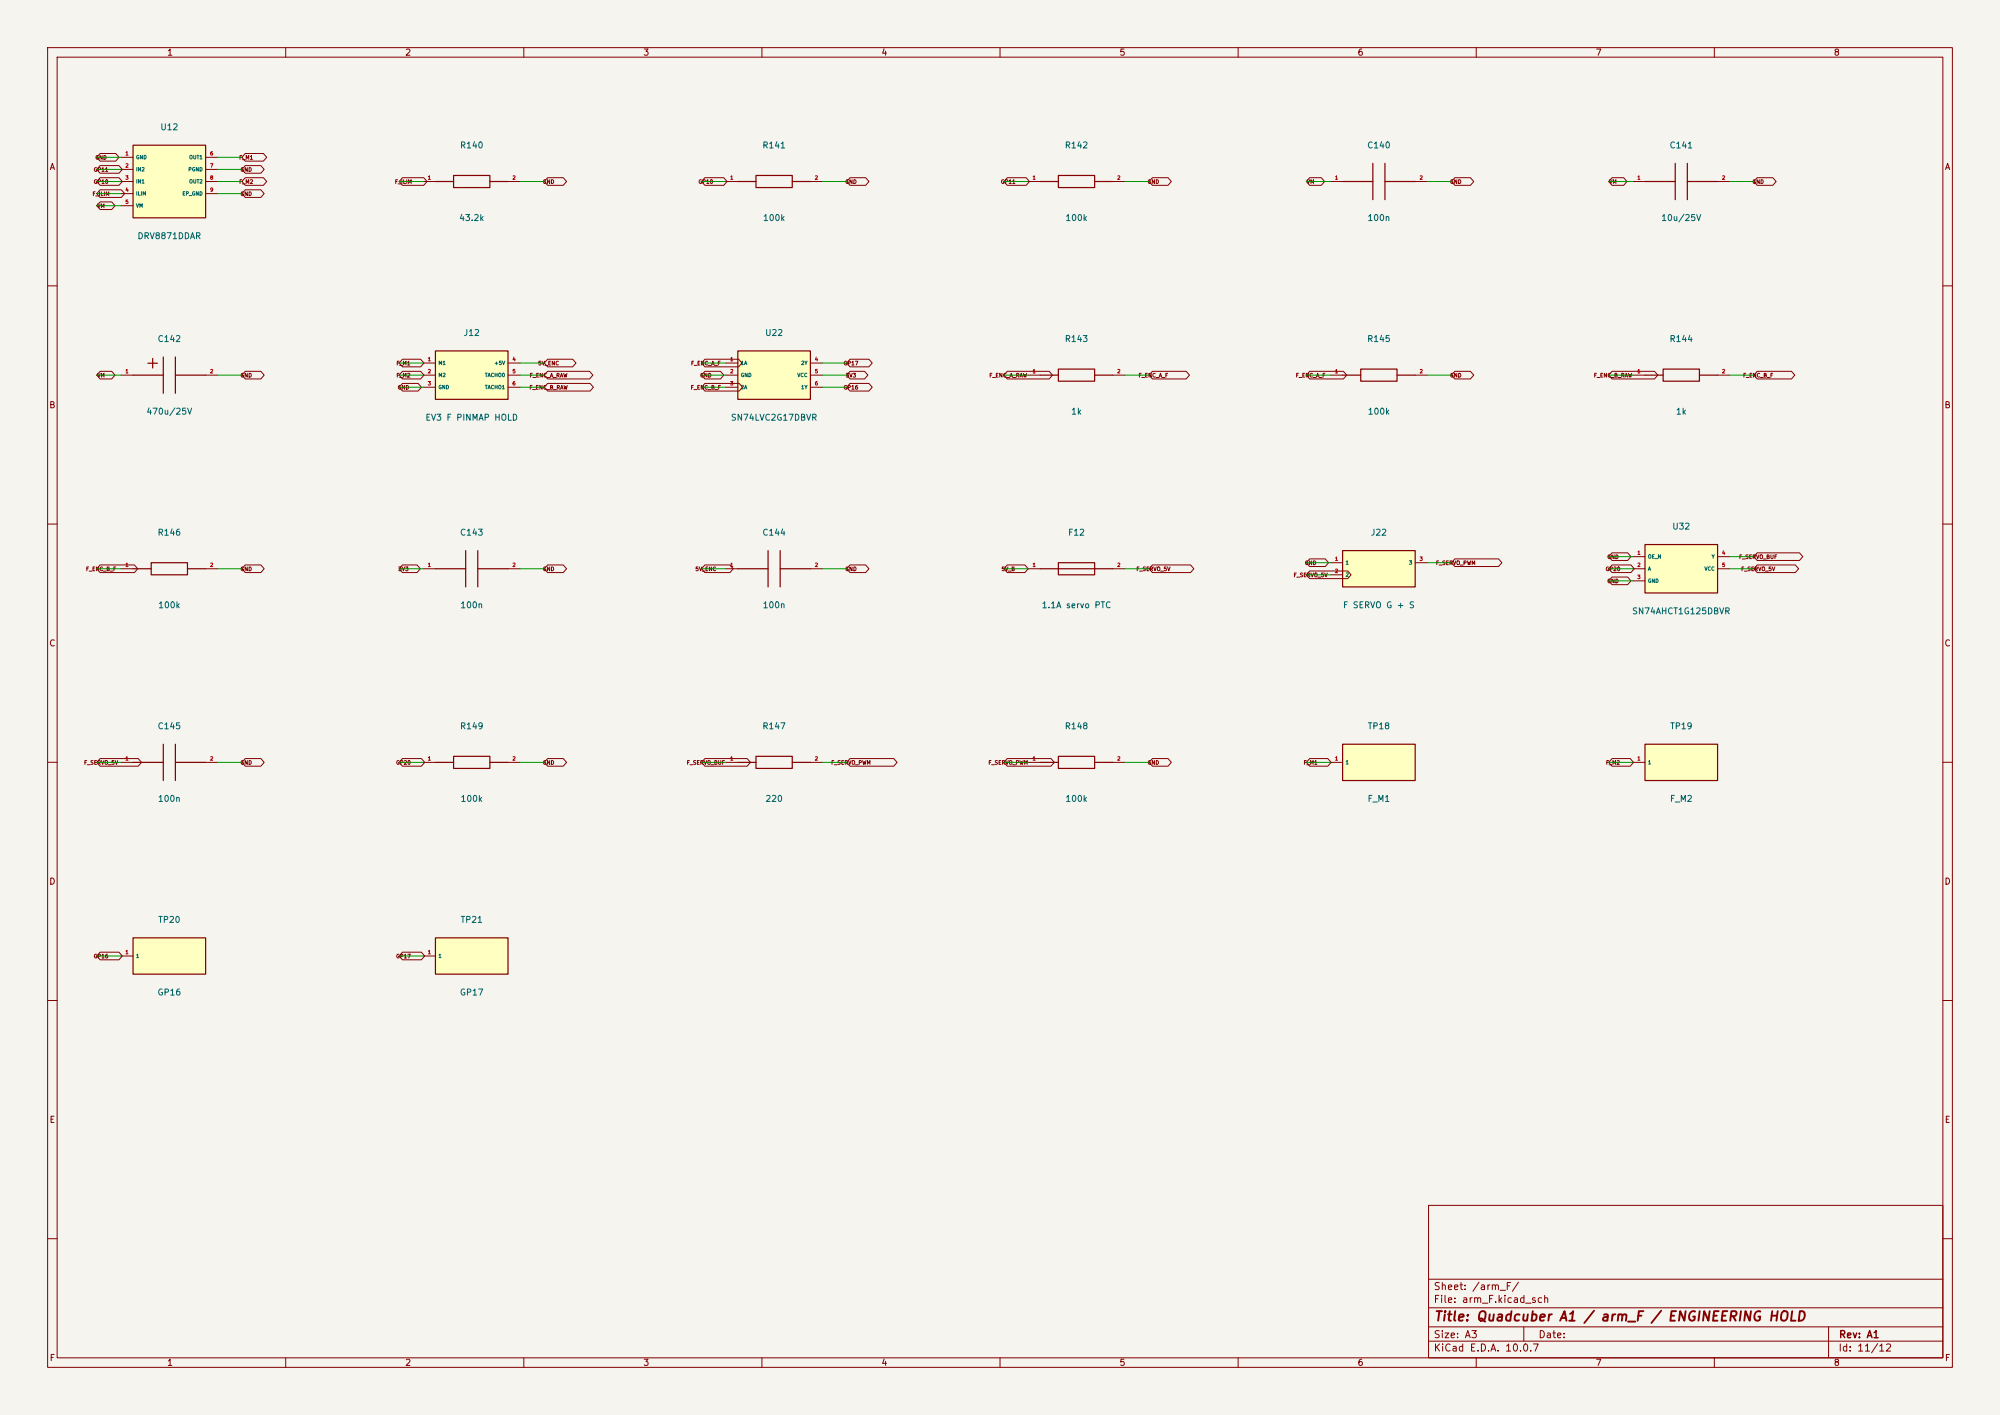
[picture p349: page 11]

Sheet: /arm_F/
File: arm_F.kicad_sch
Title: Quadcuber A1 / arm_F / ENGINEERING HOLD

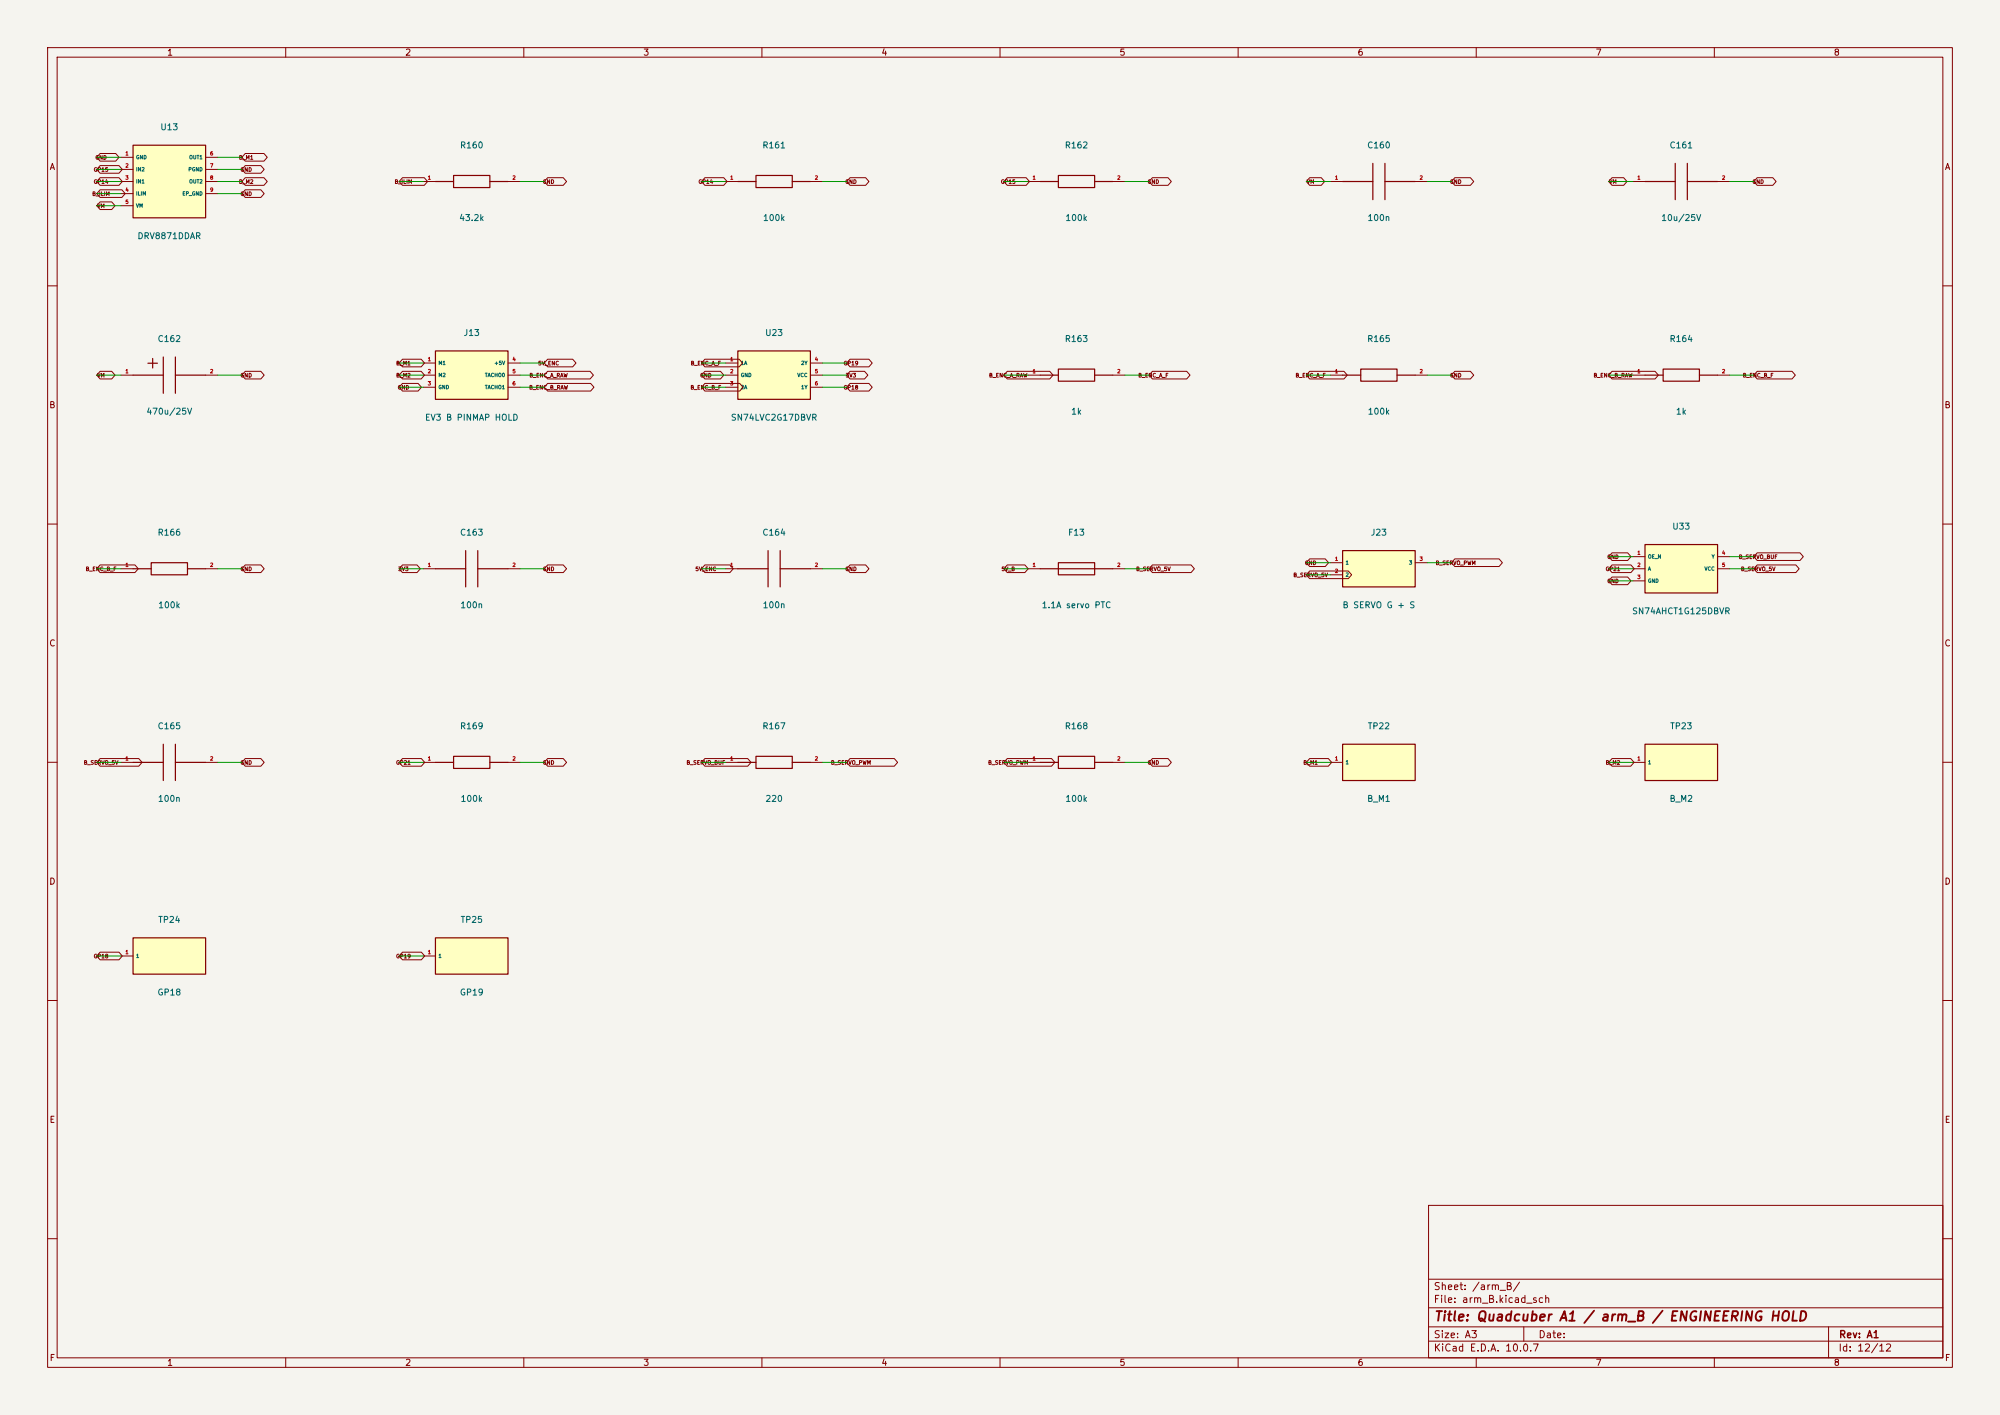
[picture p350: page 12]

Sheet: /arm_B/
File: arm_B.kicad_sch
Title: Quadcuber A1 / arm_B / ENGINEERING HOLD
