gonewx/quadcuber/(list of files, drawings)

Other design files:
generated/electronics/boot-direct-revision/pcb-drc.json
