gonewx/quadcuber/electronics-b1/quadcuber-b1.kicad_pcb

## KiCad design electronics-b1/quadcuber-b1.kicad_pcb (2026-10-20)

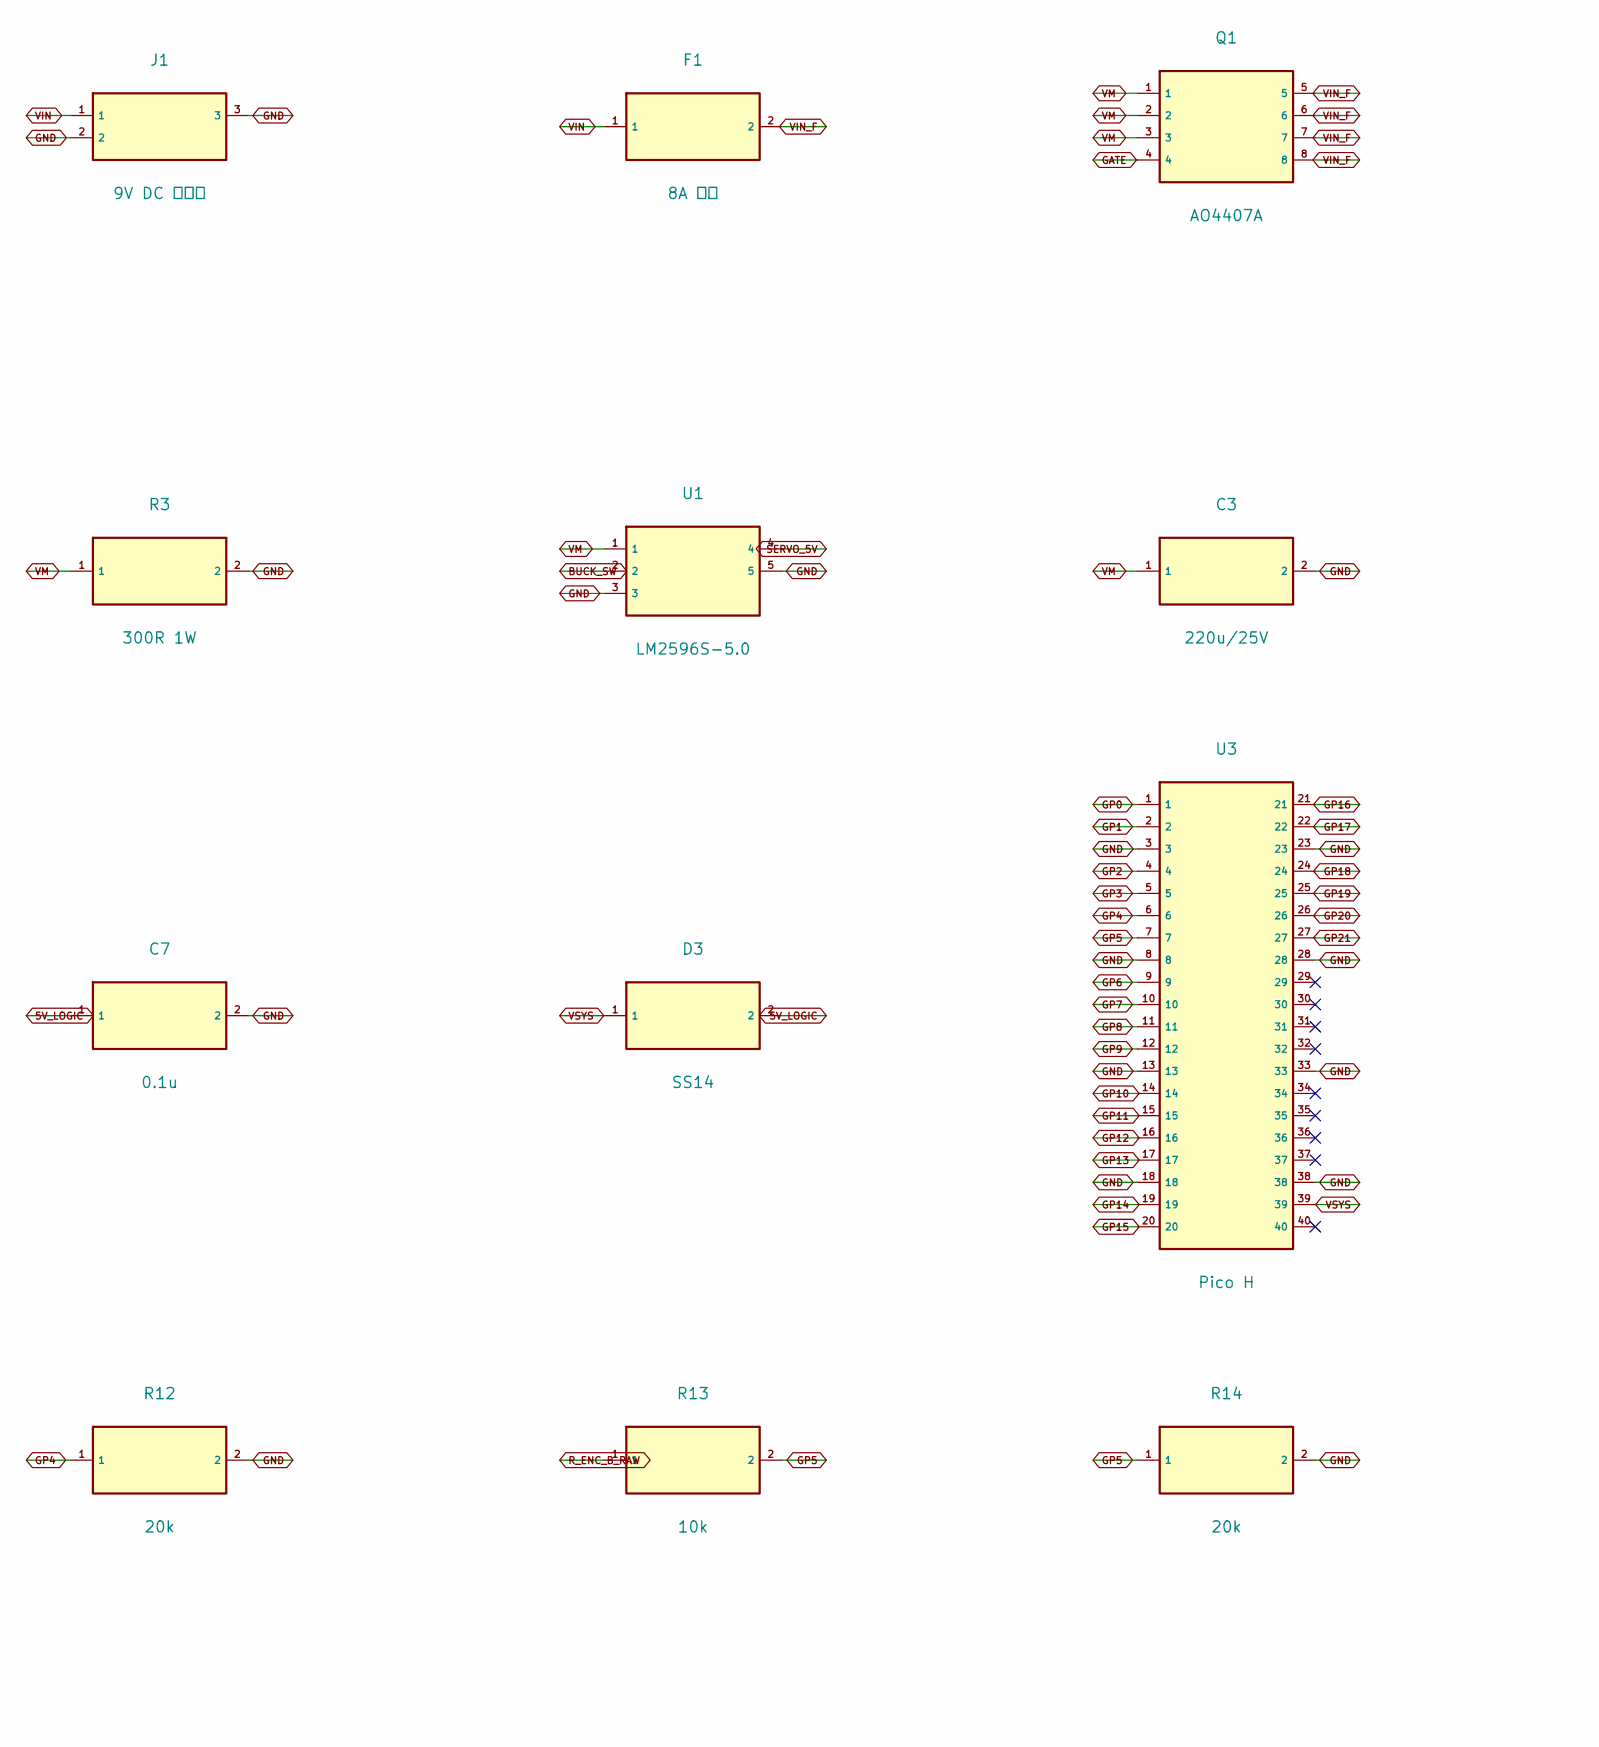
[picture p351: schematic quadcuber-b1.kicad_sch, Quadcuber B1 底板（Pico H + 4×DRV8871）, part in row 1, column 1]

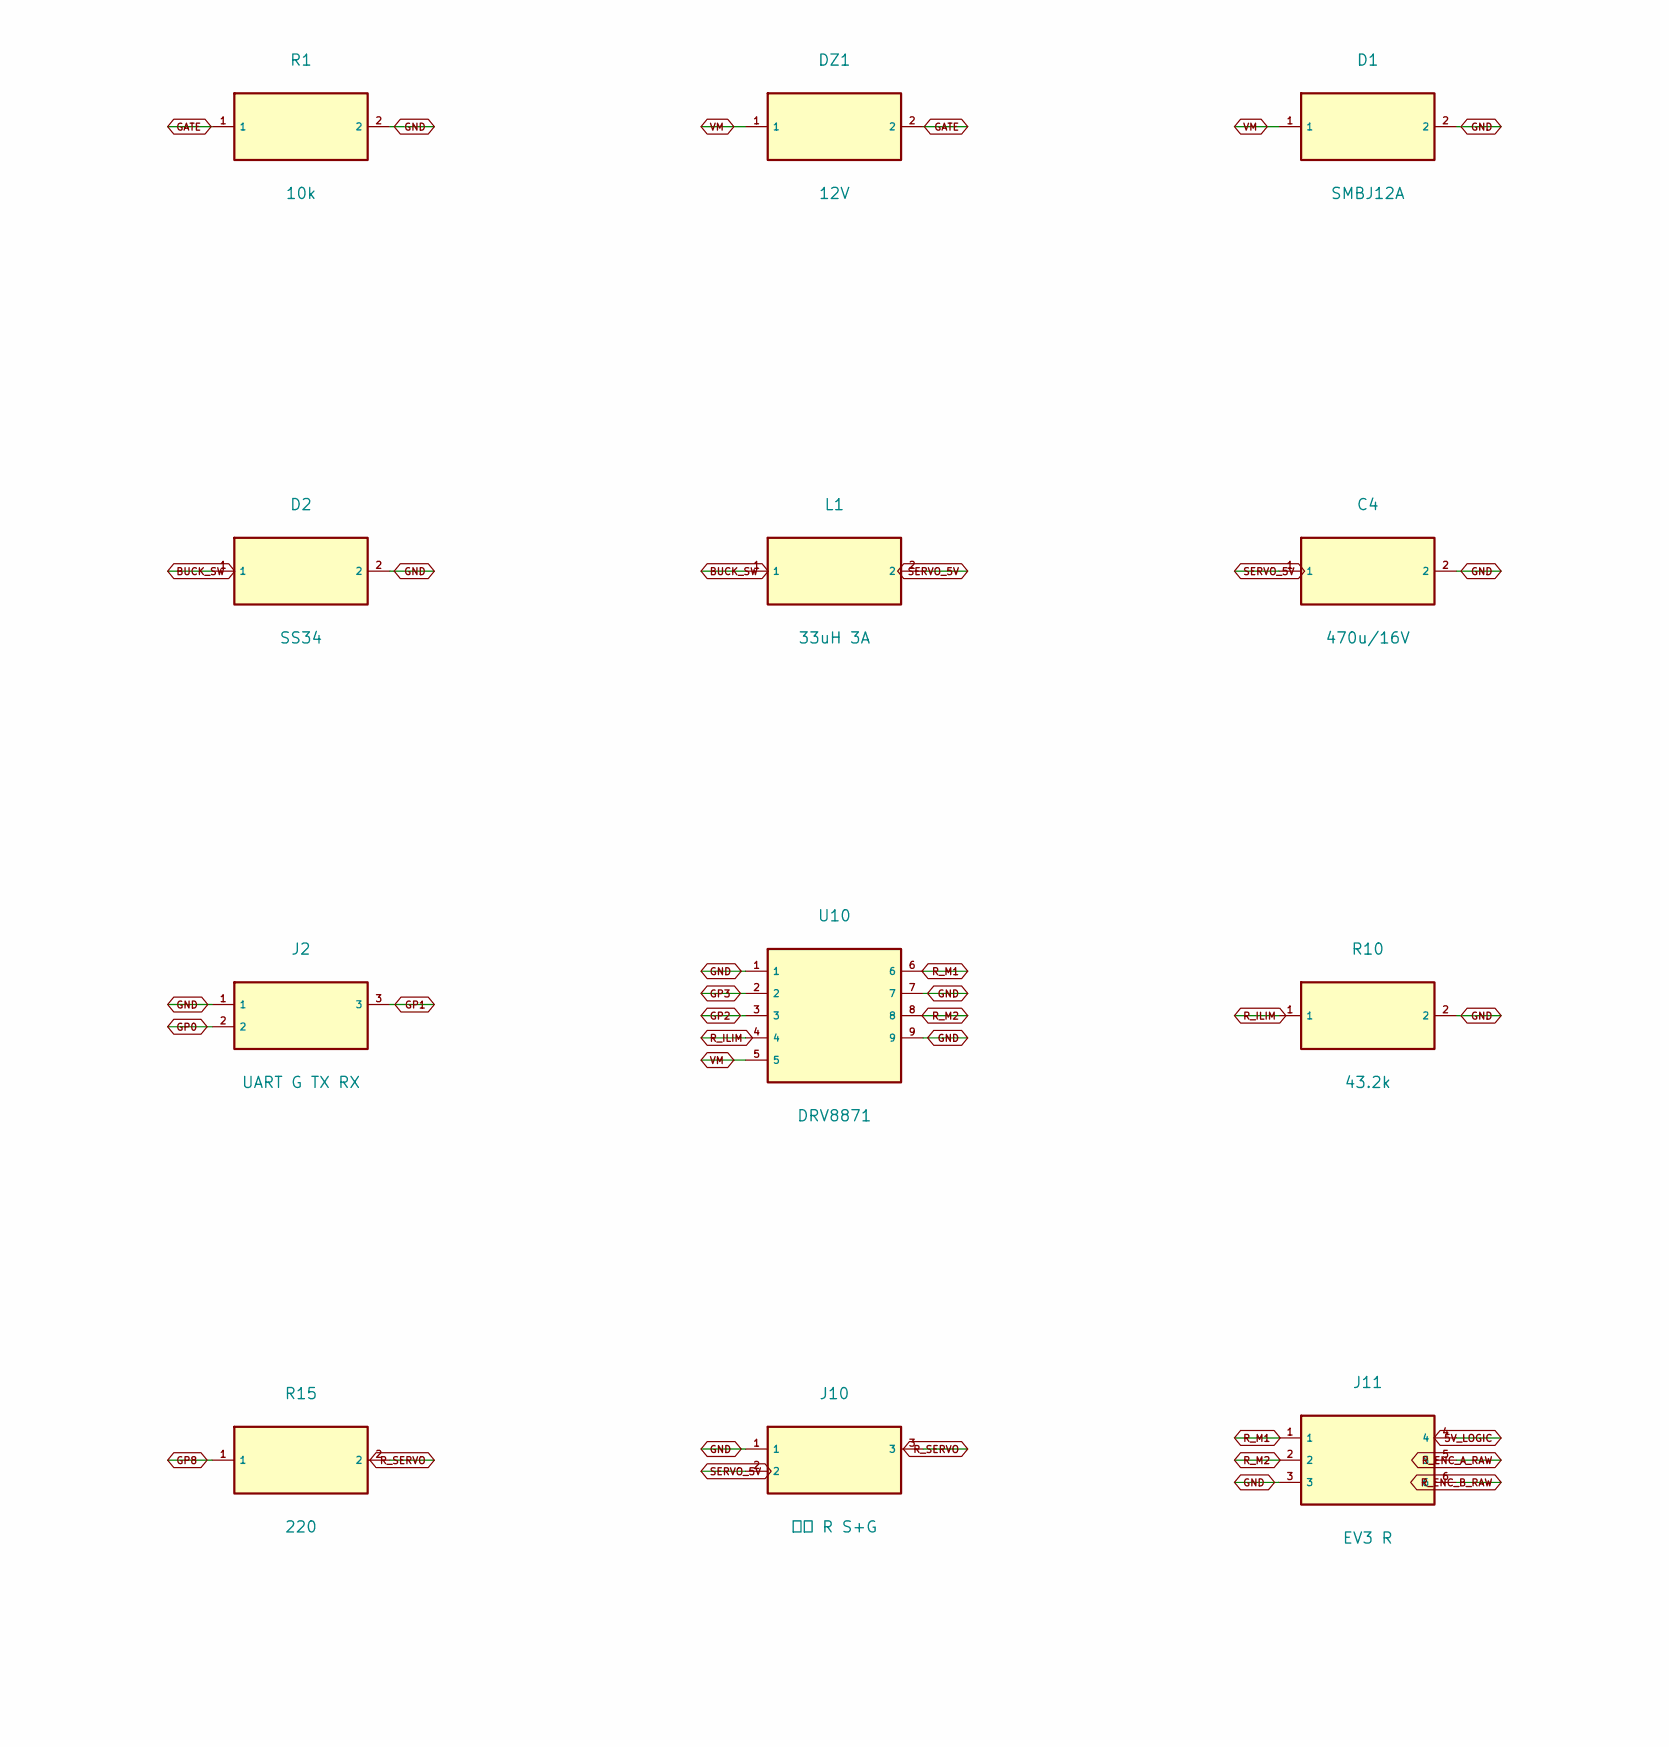
[picture p352: schematic quadcuber-b1.kicad_sch, Quadcuber B1 底板（Pico H + 4×DRV8871）, part in row 1, column 2]

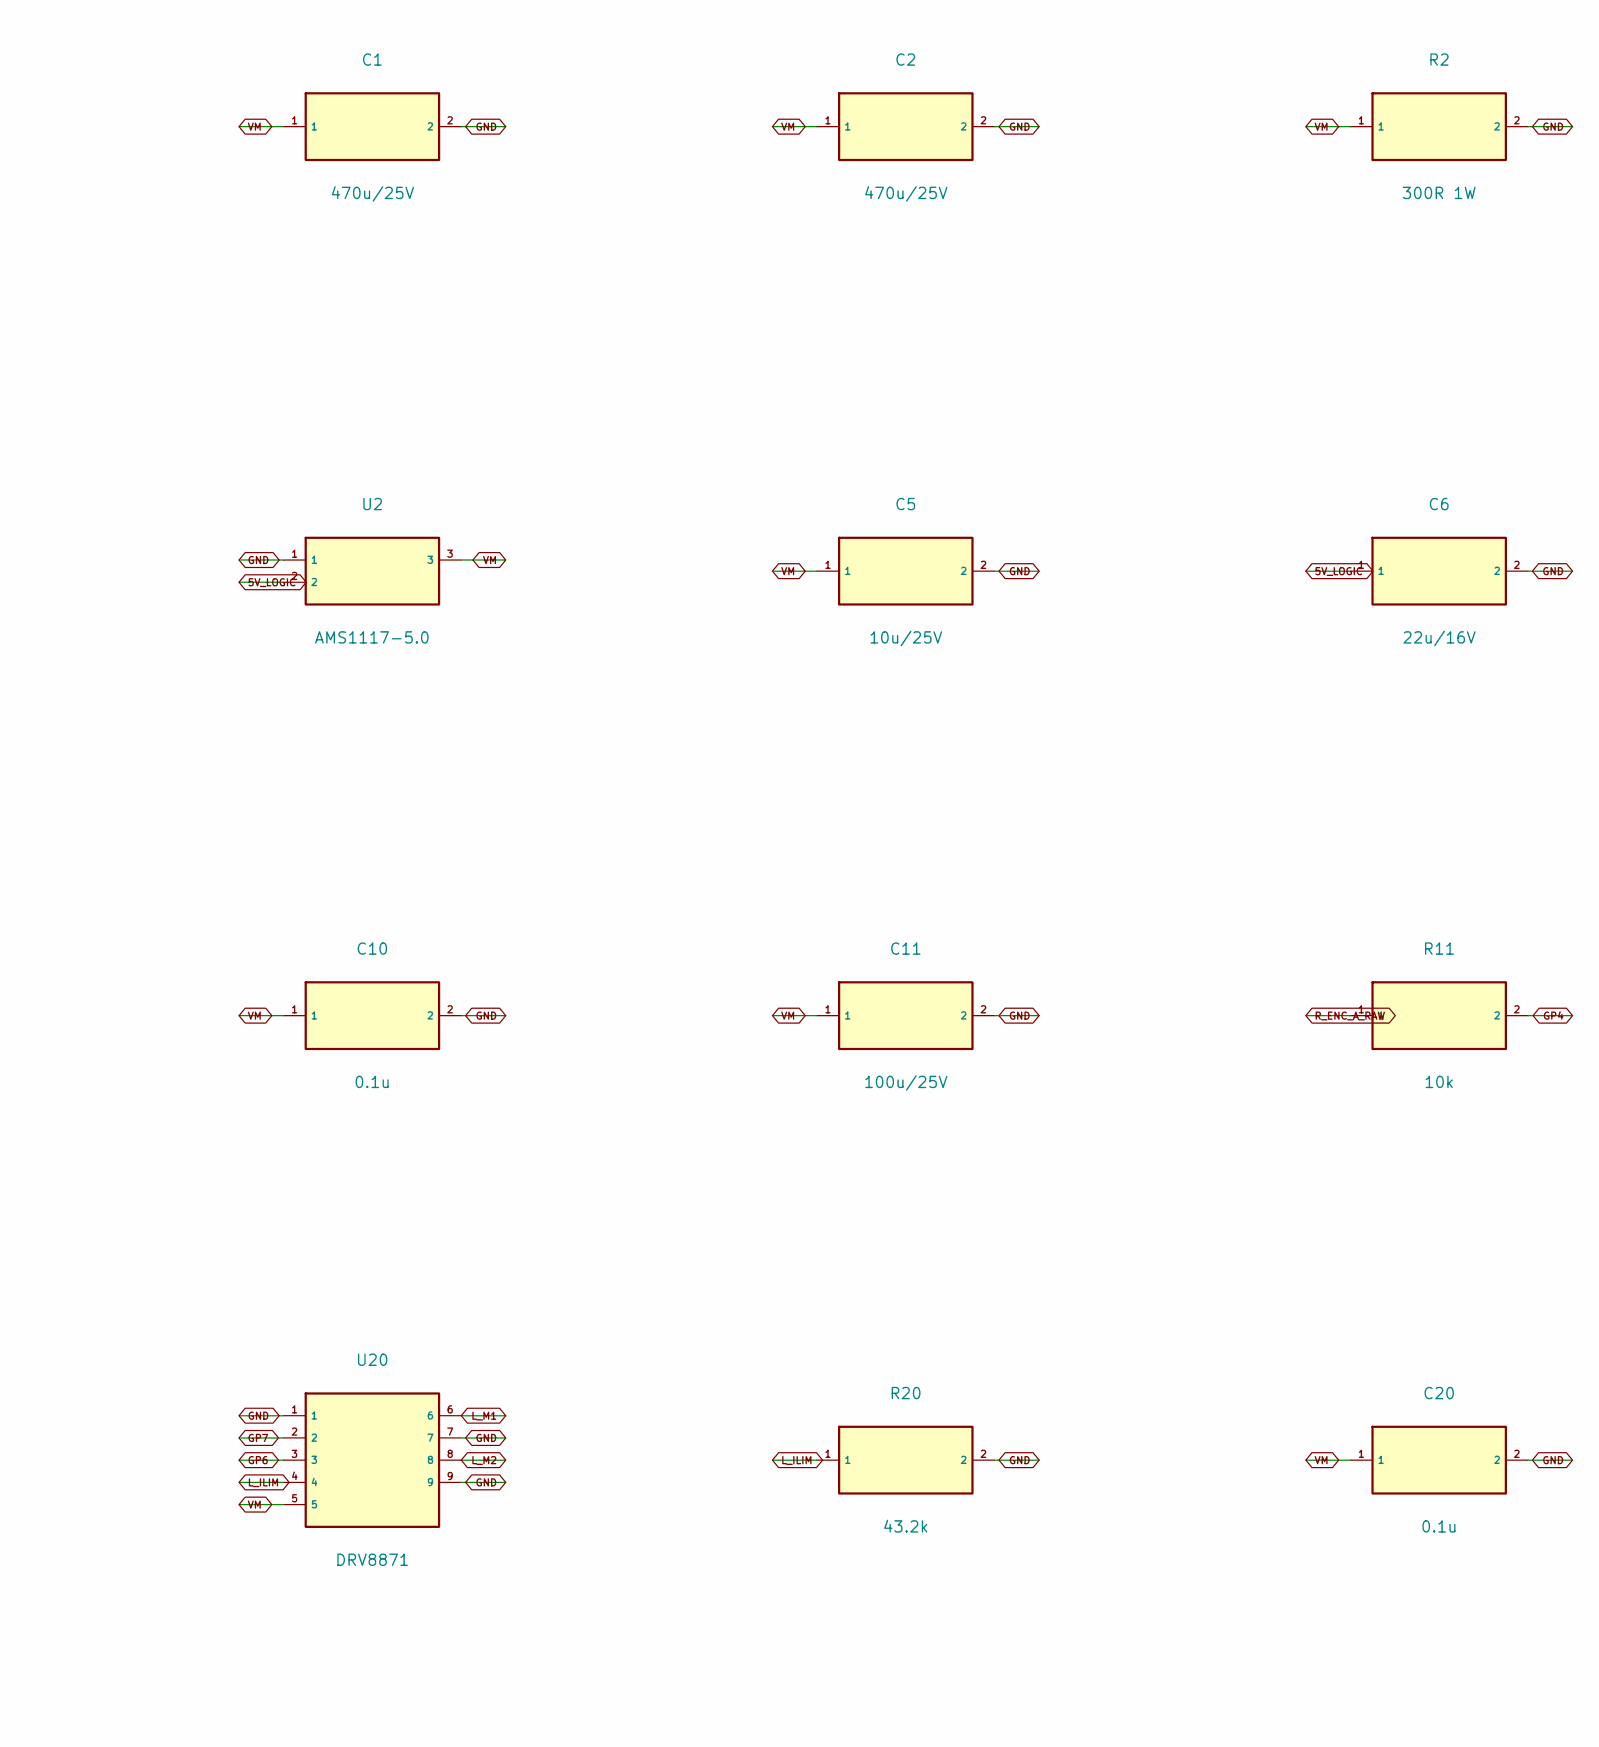
[picture p353: schematic quadcuber-b1.kicad_sch, Quadcuber B1 底板（Pico H + 4×DRV8871）, part in row 1, column 3]

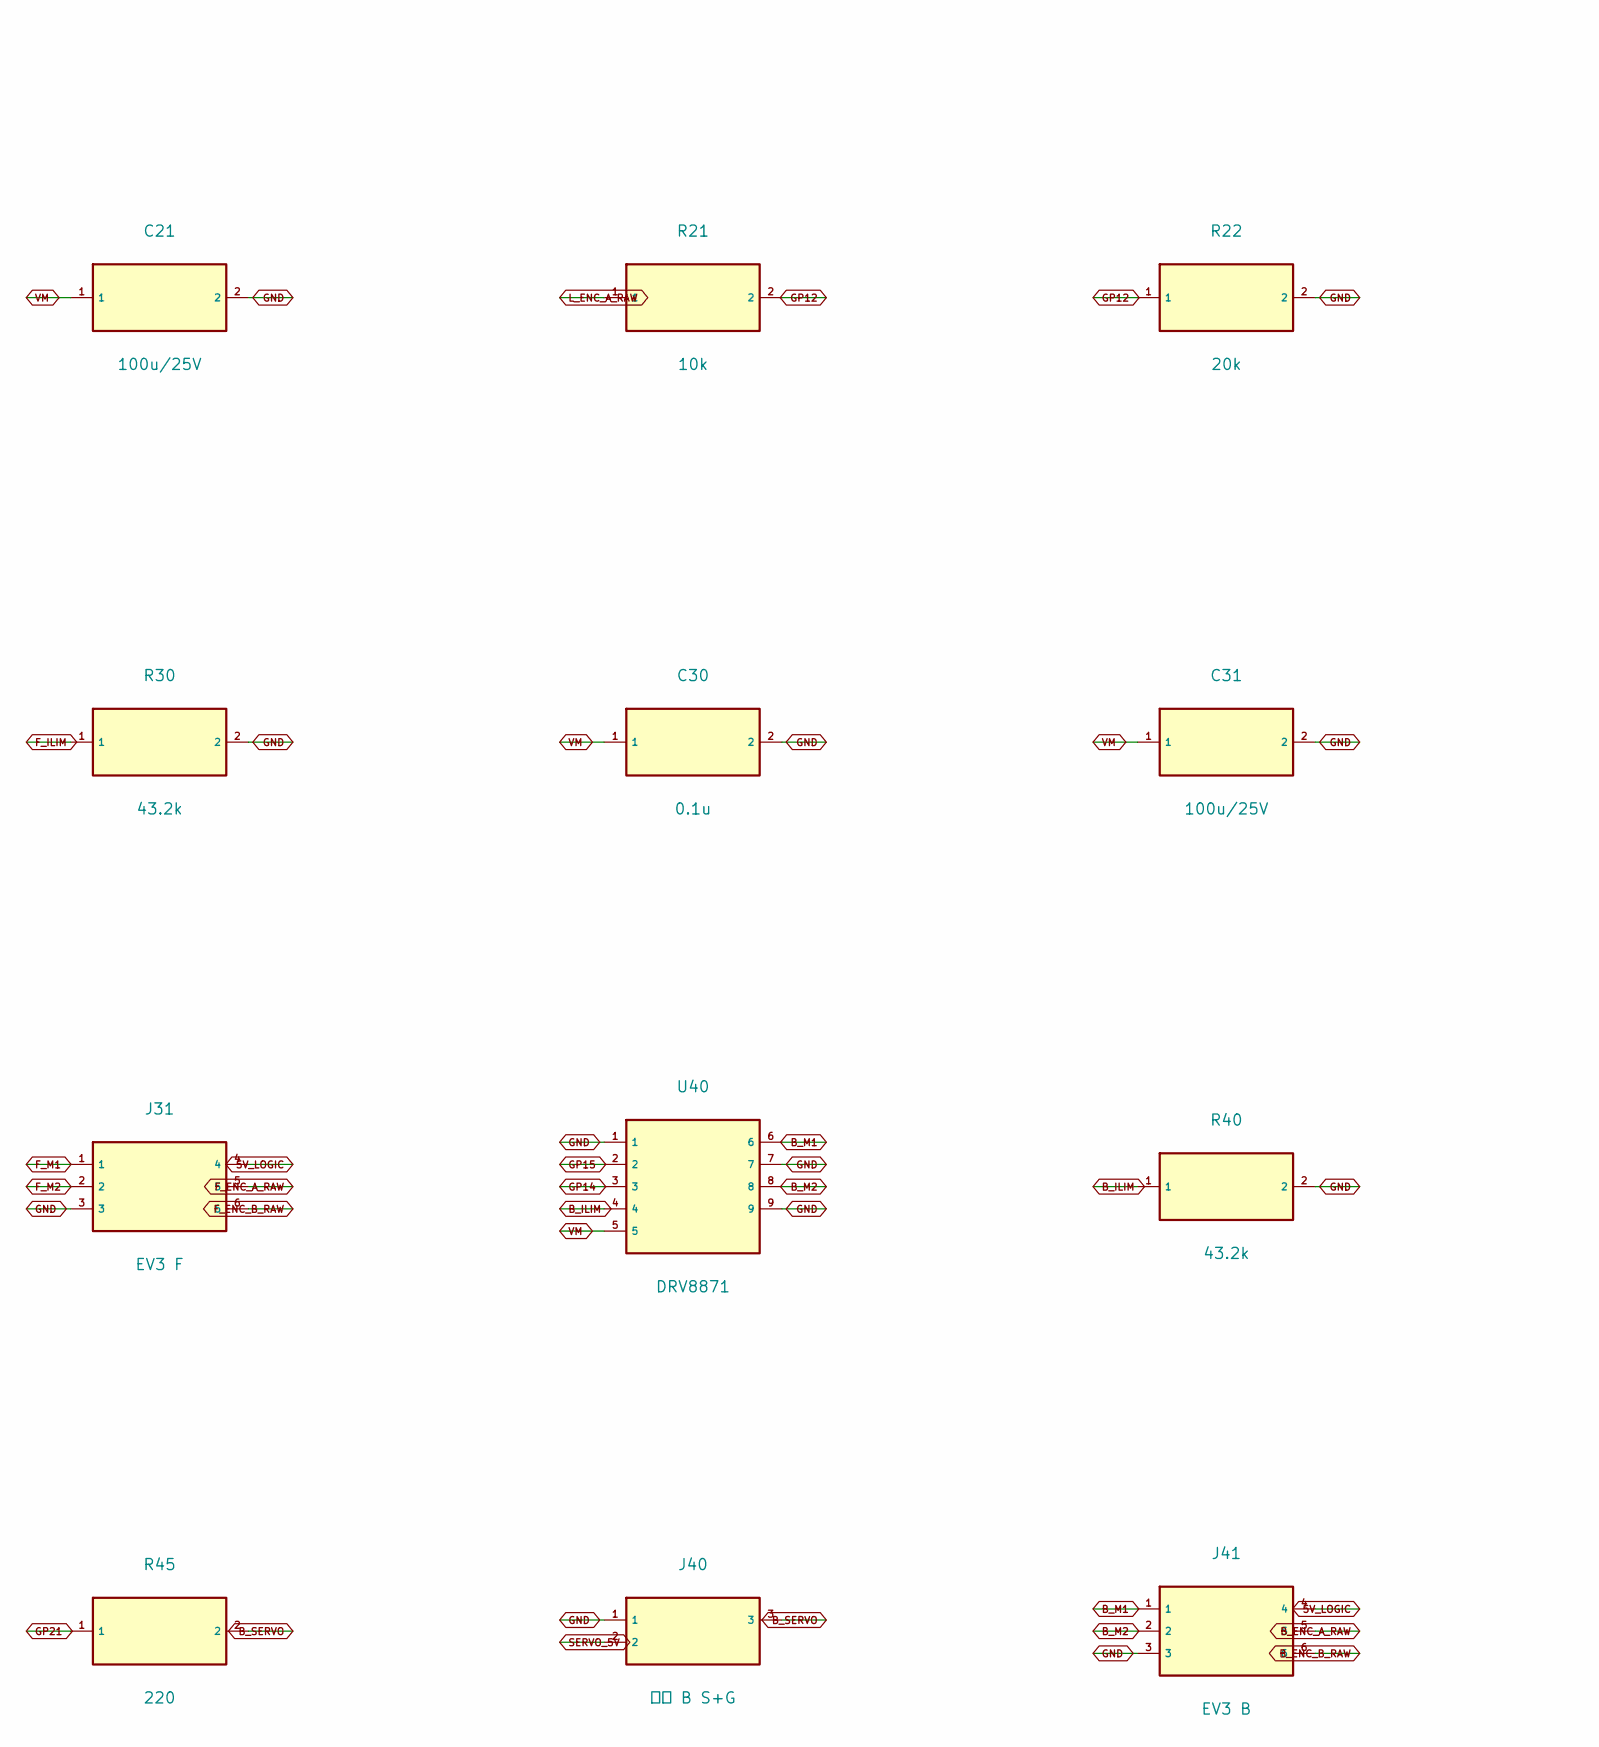
[picture p354: schematic quadcuber-b1.kicad_sch, Quadcuber B1 底板（Pico H + 4×DRV8871）, part in row 2, column 1]

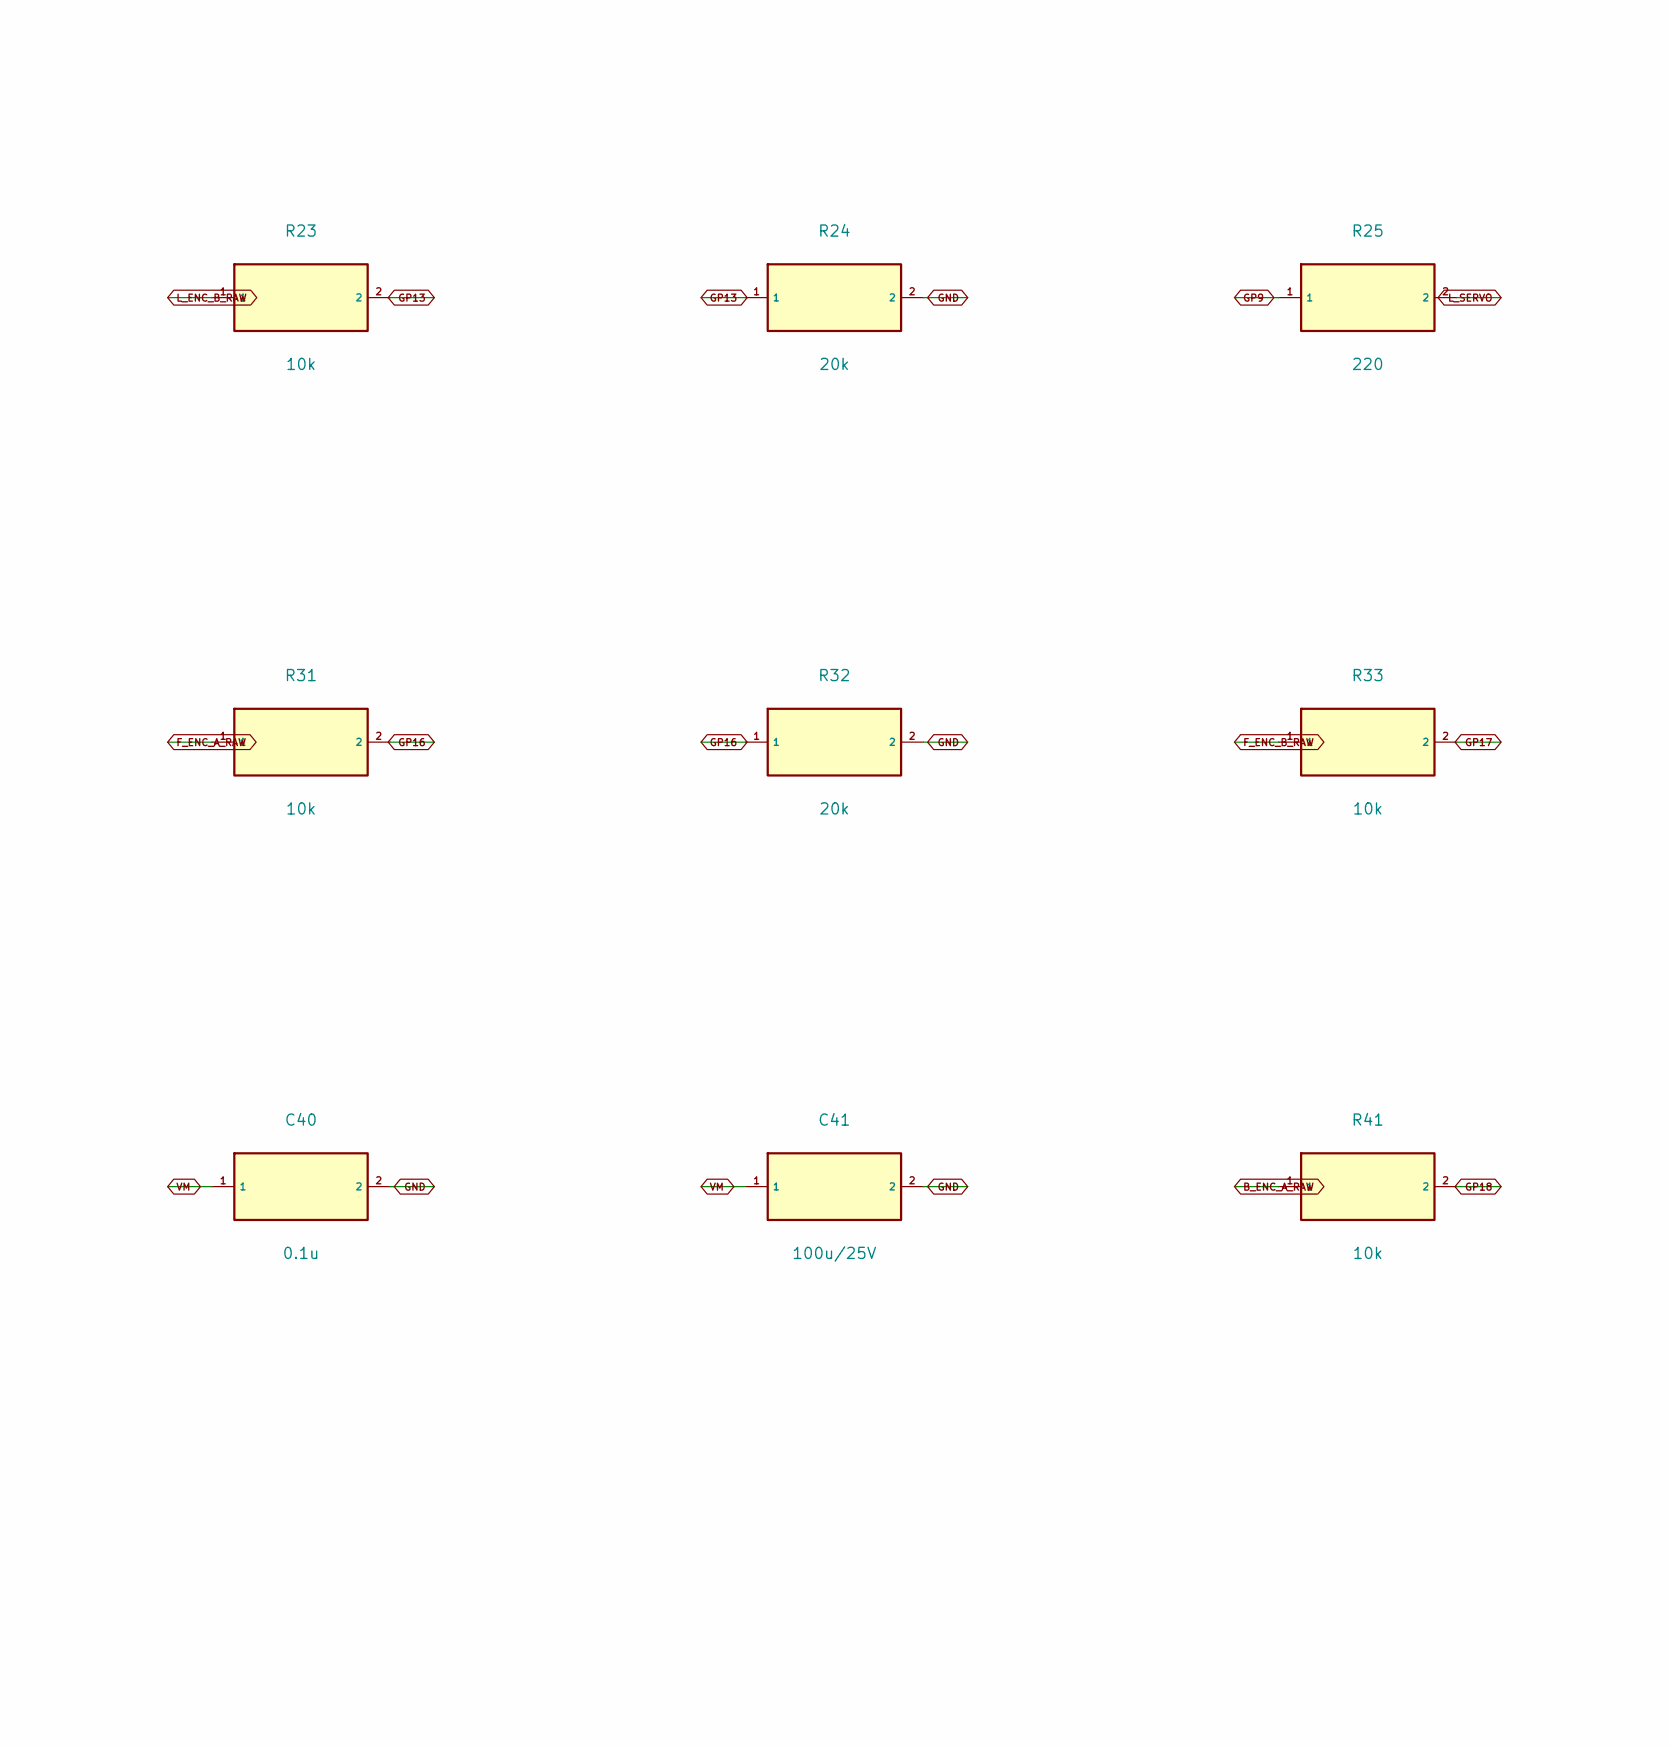
[picture p355: schematic quadcuber-b1.kicad_sch, Quadcuber B1 底板（Pico H + 4×DRV8871）, part in row 2, column 2]

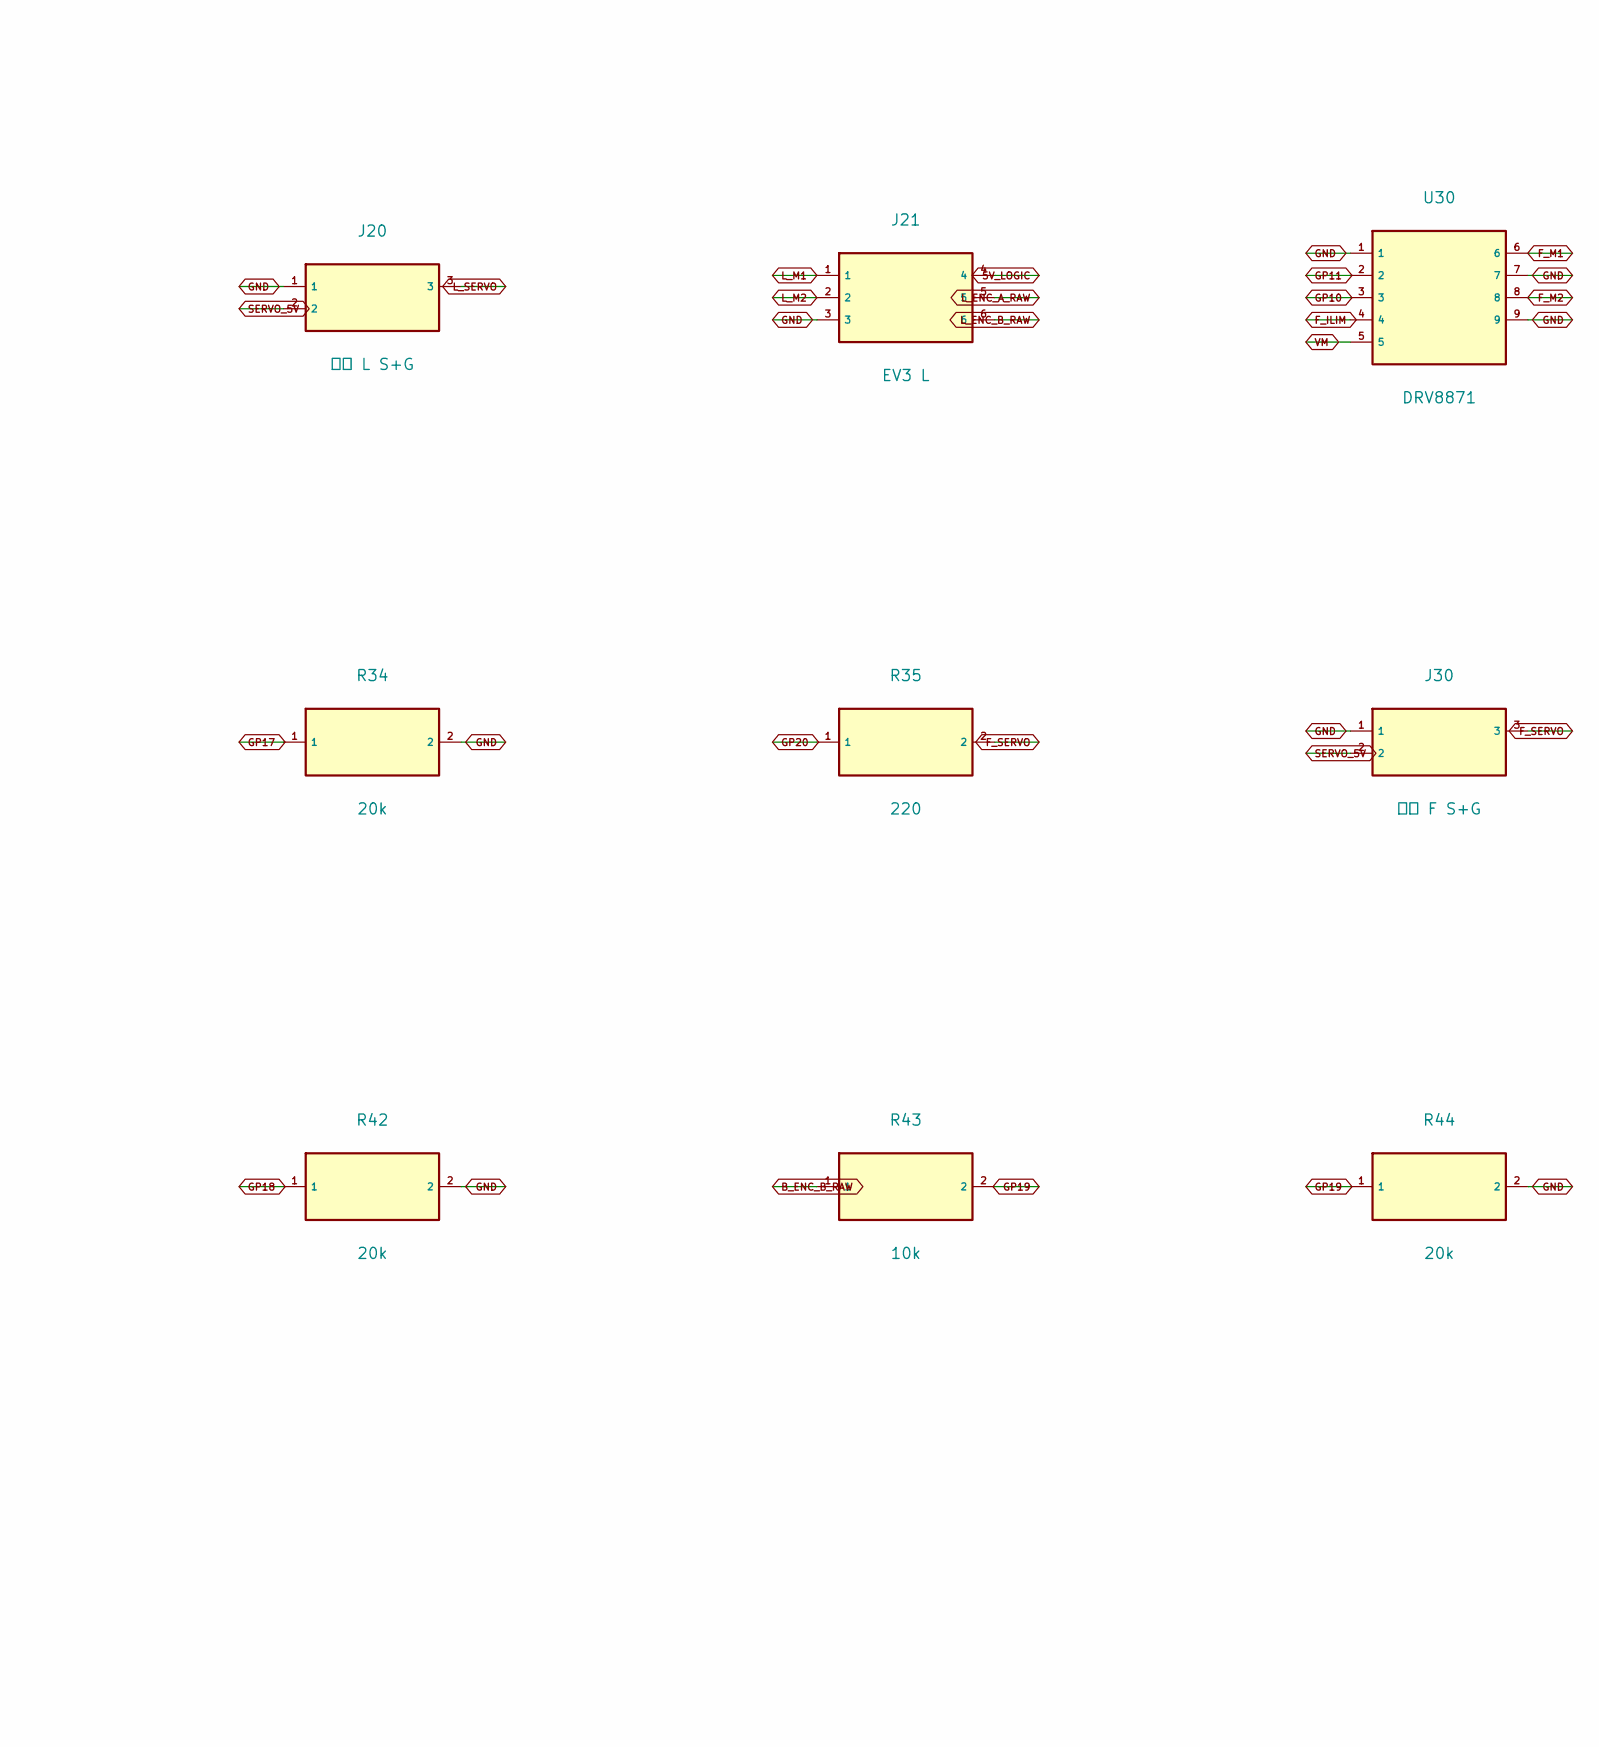
[picture p356: schematic quadcuber-b1.kicad_sch, Quadcuber B1 底板（Pico H + 4×DRV8871）, part in row 2, column 3]

Parts:
C1, C2: 470u/25V; CP_Elec_10x10.5
C3: 220u/25V; CP_Elec_8x10.5
C4: 470u/16V; CP_Elec_8x10.5
C5: 10u/25V; C_0805_2012Metric_Pad1.18x1.45mm_HandSolder
C6: 22u/16V; C_0805_2012Metric_Pad1.18x1.45mm_HandSolder
C7, C10, C20, C30, C40: 0.1u; C_0805_2012Metric_Pad1.18x1.45mm_HandSolder
C11, C21, C31, C41: 100u/25V; CP_Elec_6.3x7.7
D1: SMBJ12A; D_SMB_Handsoldering
D2: SS34; D_SMA_Handsoldering
D3: SS14; D_SMA_Handsoldering
DZ1: 12V; D_SOD-123
F1: 8A 慢断; Fuse_1206_3216Metric_Pad1.42x1.75mm_HandSolder
J1: 9V DC 中心正; BarrelJack_Horizontal
J2: UART G TX RX; PinHeader_1x03_P2.54mm_Vertical
J10: 舵机 R S+G; PinHeader_1x03_P2.54mm_Vertical
J11: EV3 R; EV3_Socket_UserDrawing
J20: 舵机 L S+G; PinHeader_1x03_P2.54mm_Vertical
J21: EV3 L; EV3_Socket_UserDrawing
J30: 舵机 F S+G; PinHeader_1x03_P2.54mm_Vertical
J31: EV3 F; EV3_Socket_UserDrawing
J40: 舵机 B S+G; PinHeader_1x03_P2.54mm_Vertical
J41: EV3 B; EV3_Socket_UserDrawing
L1: 33uH 3A; L_12x12mm_H8mm
Q1: AO4407A; SOIC-8_3.9x4.9mm_P1.27mm
R1, R11, R13, R21, R23, R31, R33, R41, R43: 10k; R_0805_2012Metric_Pad1.20x1.40mm_HandSolder
R2, R3: 300R 1W; R_2512_6332Metric_Pad1.40x3.35mm_HandSolder
R10, R20, R30, R40: 43.2k; R_0805_2012Metric_Pad1.20x1.40mm_HandSolder
R12, R14, R22, R24, R32, R34, R42, R44: 20k; R_0805_2012Metric_Pad1.20x1.40mm_HandSolder
R15, R25, R35, R45: 220; R_0805_2012Metric_Pad1.20x1.40mm_HandSolder
U1: LM2596S-5.0; TO-263-5_TabPin3
U2: AMS1117-5.0; SOT-223-3_TabPin2
U3: Pico H; RaspberryPi_Pico_Common_THT
U10, U20, U30, U40: DRV8871; Texas_HTSOP-8-1EP_3.9x4.9mm_P1.27mm_EP2.95x4.9mm_Mask2.4x3.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

Connections:
5V_LOGIC: C6.1, C7.1, D3.2, J11.4, J21.4, J31.4, J41.4, U2.2
BUCK_SW: D2.1, L1.1, U1.2
B_ENC_A_RAW: J41.5, R41.1
B_ENC_B_RAW: J41.6, R43.1
B_ILIM: R40.1, U40.4
B_M1: J41.1, U40.6
B_M2: J41.2, U40.8
B_SERVO: J40.3, R45.2
F_ENC_A_RAW: J31.5, R31.1
F_ENC_B_RAW: J31.6, R33.1
F_ILIM: R30.1, U30.4
F_M1: J31.1, U30.6
F_M2: J31.2, U30.8
F_SERVO: J30.3, R35.2
GATE: DZ1.2, Q1.4, R1.1
GND: C1.2, C2.2, C3.2, C4.2, C5.2, C6.2, C7.2, C10.2, C11.2, C20.2, C21.2, C30.2, C31.2, C40.2, C41.2, D1.2, D2.2, J1.2, J1.3, J2.1, J10.1, J11.3, J20.1, J21.3, J30.1, J31.3, J40.1, J41.3, R1.2, R2.2, R3.2, R10.2, R12.2, R14.2, R20.2, R22.2, R24.2, R30.2, R32.2, R34.2, R40.2, R42.2, R44.2, U1.3, U1.5, U2.1, U3.3, U3.8, U3.13, U3.18, U3.23, U3.28, U3.33, U3.38, U10.1, U10.7, U10.9, U20.1, U20.7, U20.9, U30.1, U30.7, U30.9, U40.1, U40.7, U40.9
GP0: J2.2, U3.1
GP1: J2.3, U3.2
GP2: U3.4, U10.3
GP3: U3.5, U10.2
GP4: R11.2, R12.1, U3.6
GP5: R13.2, R14.1, U3.7
GP6: U3.9, U20.3
GP7: U3.10, U20.2
GP8: R15.1, U3.11
GP9: R25.1, U3.12
GP10: U3.14, U30.3
GP11: U3.15, U30.2
GP12: R21.2, R22.1, U3.16
GP13: R23.2, R24.1, U3.17
GP14: U3.19, U40.3
GP15: U3.20, U40.2
GP16: R31.2, R32.1, U3.21
GP17: R33.2, R34.1, U3.22
GP18: R41.2, R42.1, U3.24
GP19: R43.2, R44.1, U3.25
GP20: R35.1, U3.26
GP21: R45.1, U3.27
L_ENC_A_RAW: J21.5, R21.1
L_ENC_B_RAW: J21.6, R23.1
L_ILIM: R20.1, U20.4
L_M1: J21.1, U20.6
L_M2: J21.2, U20.8
L_SERVO: J20.3, R25.2
R_ENC_A_RAW: J11.5, R11.1
R_ENC_B_RAW: J11.6, R13.1
R_ILIM: R10.1, U10.4
R_M1: J11.1, U10.6
R_M2: J11.2, U10.8
R_SERVO: J10.3, R15.2
SERVO_5V: C4.1, J10.2, J20.2, J30.2, J40.2, L1.2, U1.4
VIN: F1.1, J1.1
VIN_F: F1.2, Q1.5, Q1.6, Q1.7, Q1.8
VM: C1.1, C2.1, C3.1, C5.1, C10.1, C11.1, C20.1, C21.1, C30.1, C31.1, C40.1, C41.1, D1.1, DZ1.1, Q1.1, Q1.2, Q1.3, R2.1, R3.1, U1.1, U2.3, U10.5, U20.5, U30.5, U40.5
VSYS: D3.1, U3.39

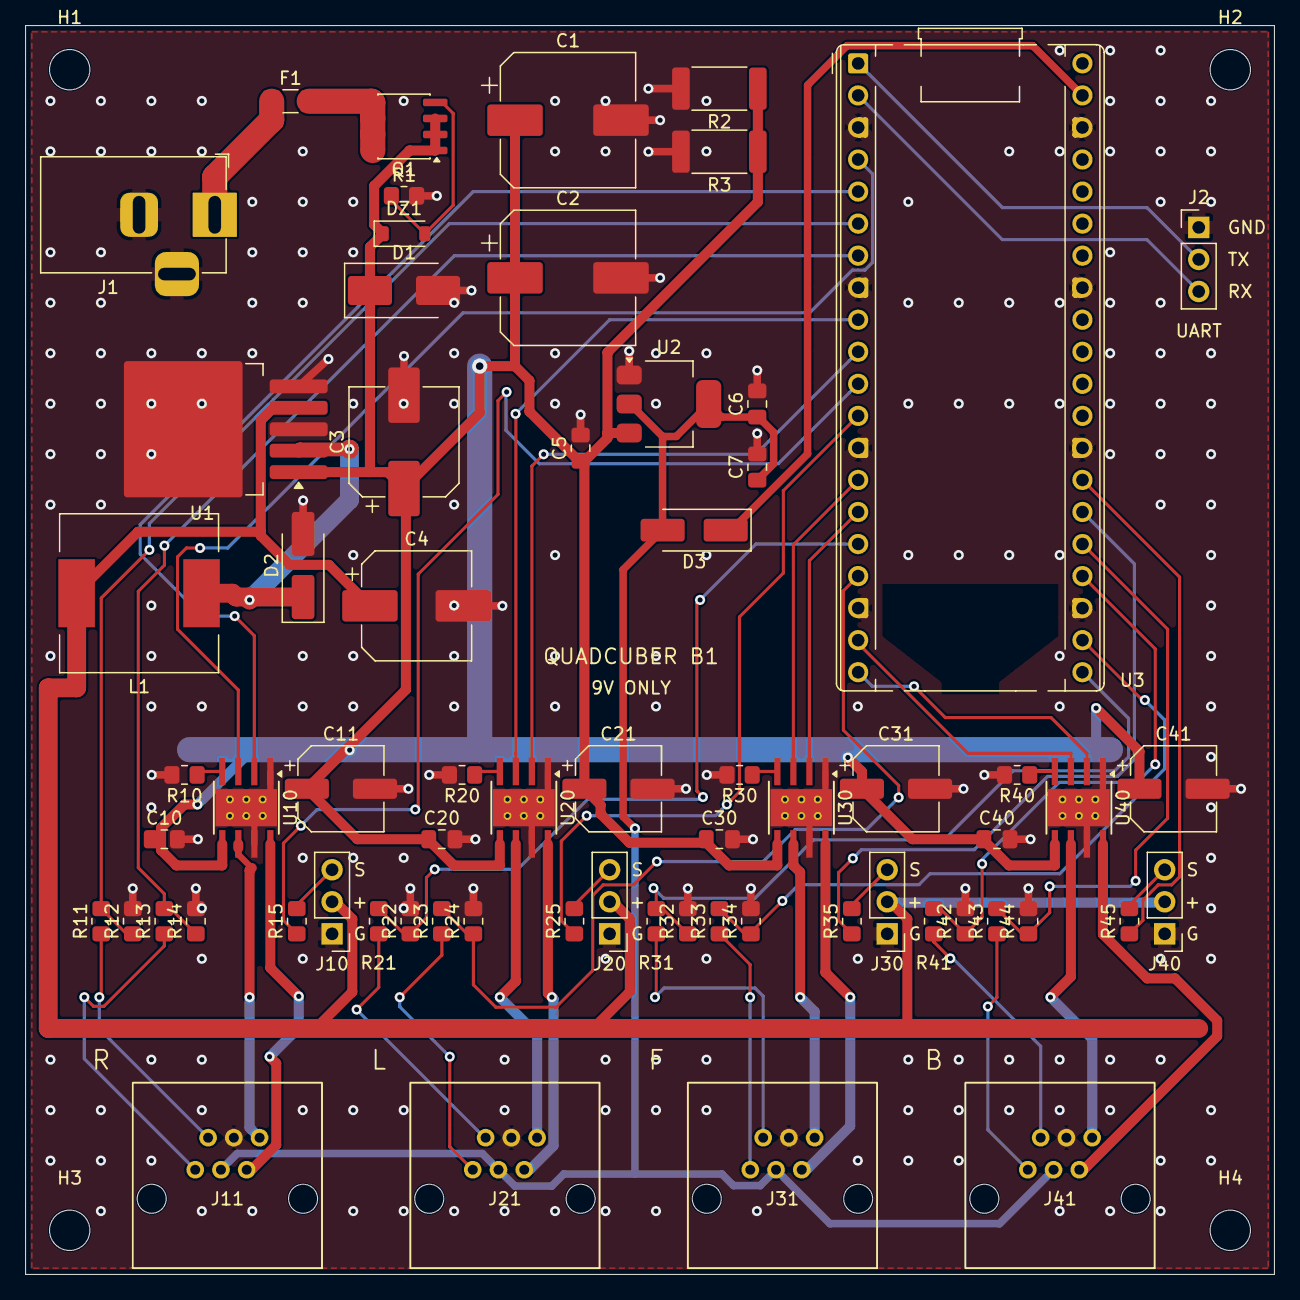
[picture p357: board quadcuber-b1.kicad_pcb from above]

Board: 2 copper layers, 99.0 x 99.0 mm, 70 parts (0 on the bottom side), 55 nets.

Other parts of the board:
H1, H2, H3, H4: M3; MountingHole_3.2mm_M3
