gonewx/quadcuber/electronics/quadcuber.kicad_pcb

## KiCad design electronics/quadcuber.kicad_pcb (2026-10-14)

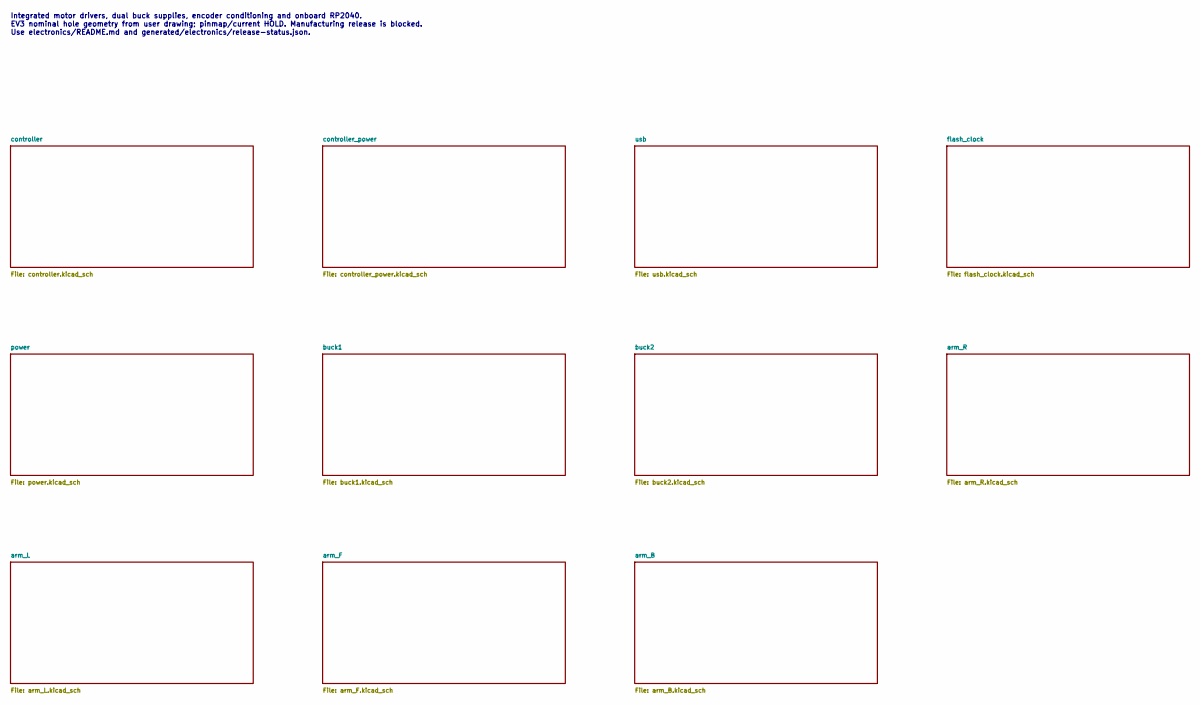
[picture p358: schematic quadcuber.kicad_sch, Quadcuber four-arm integrated controller - A1 ENGINEERING H…]

Notes on the sheet:
Integrated motor drivers, dual buck supplies, encoder conditioning and onboard RP2040. EV3 nominal hole geometry from user drawing; pinmap/current HOLD. Manufacturing release is blocked. Use electronics/README.md and generated/electronics/release-status.json.
