gonewx/quadcuber/electronics/quadcuber.kicad_pcb

## KiCad design electronics/quadcuber.kicad_pcb (continued)

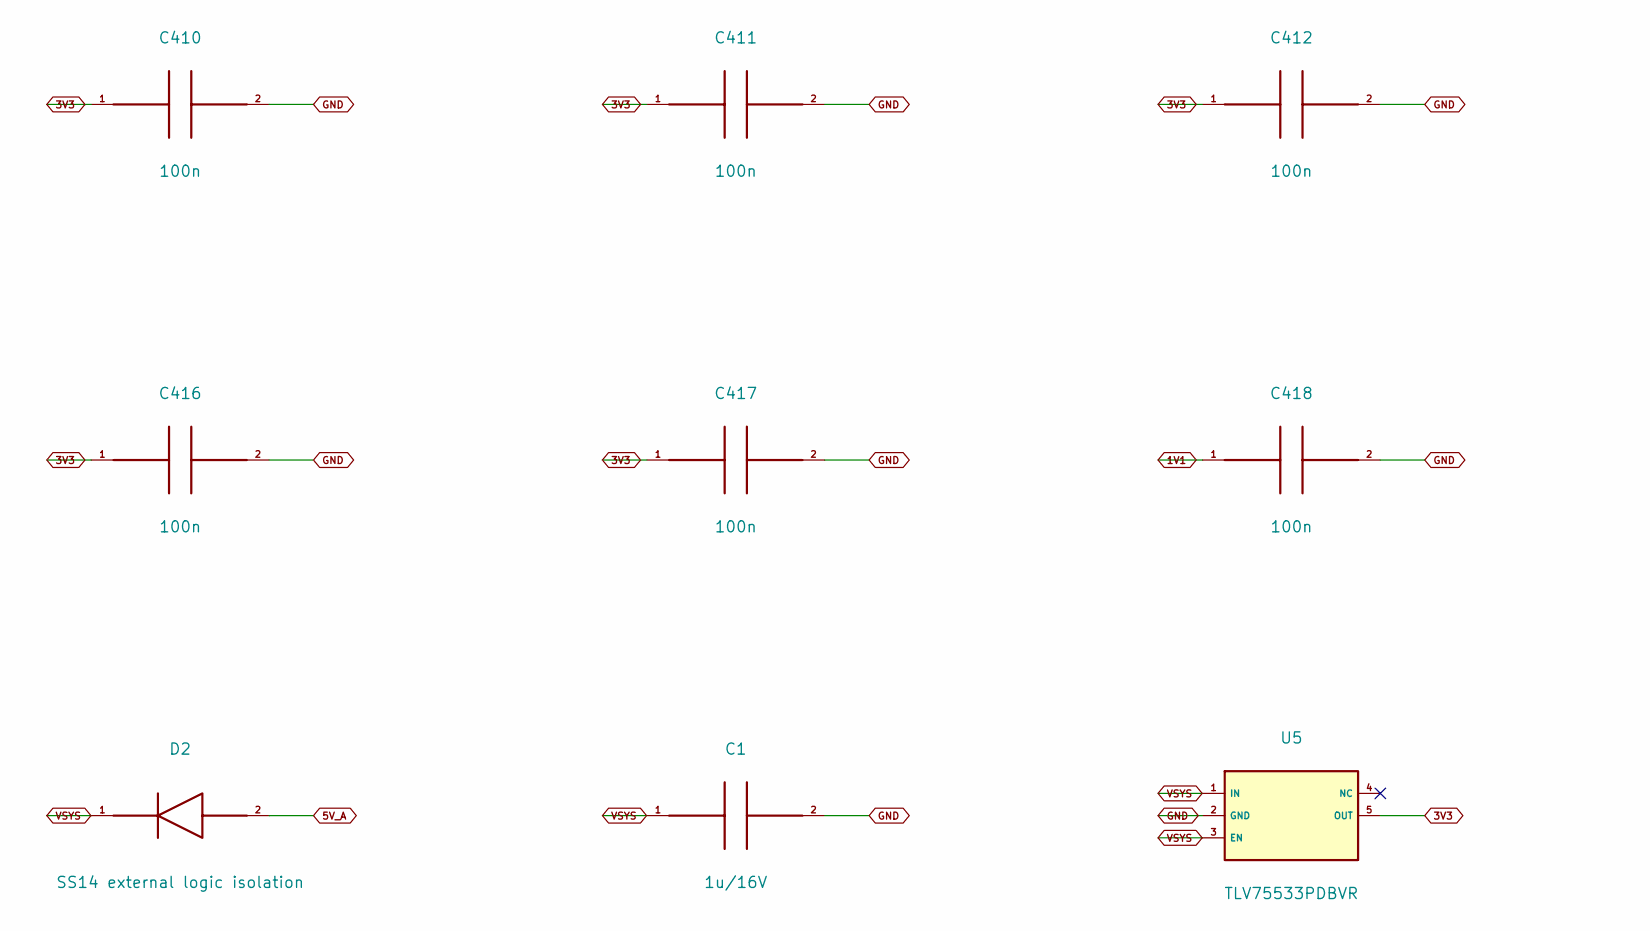
[picture p359: schematic controller_power.kicad_sch, Quadcuber A1 / controller_power / ENGINEERING HOLD, part in row 1, column 1]

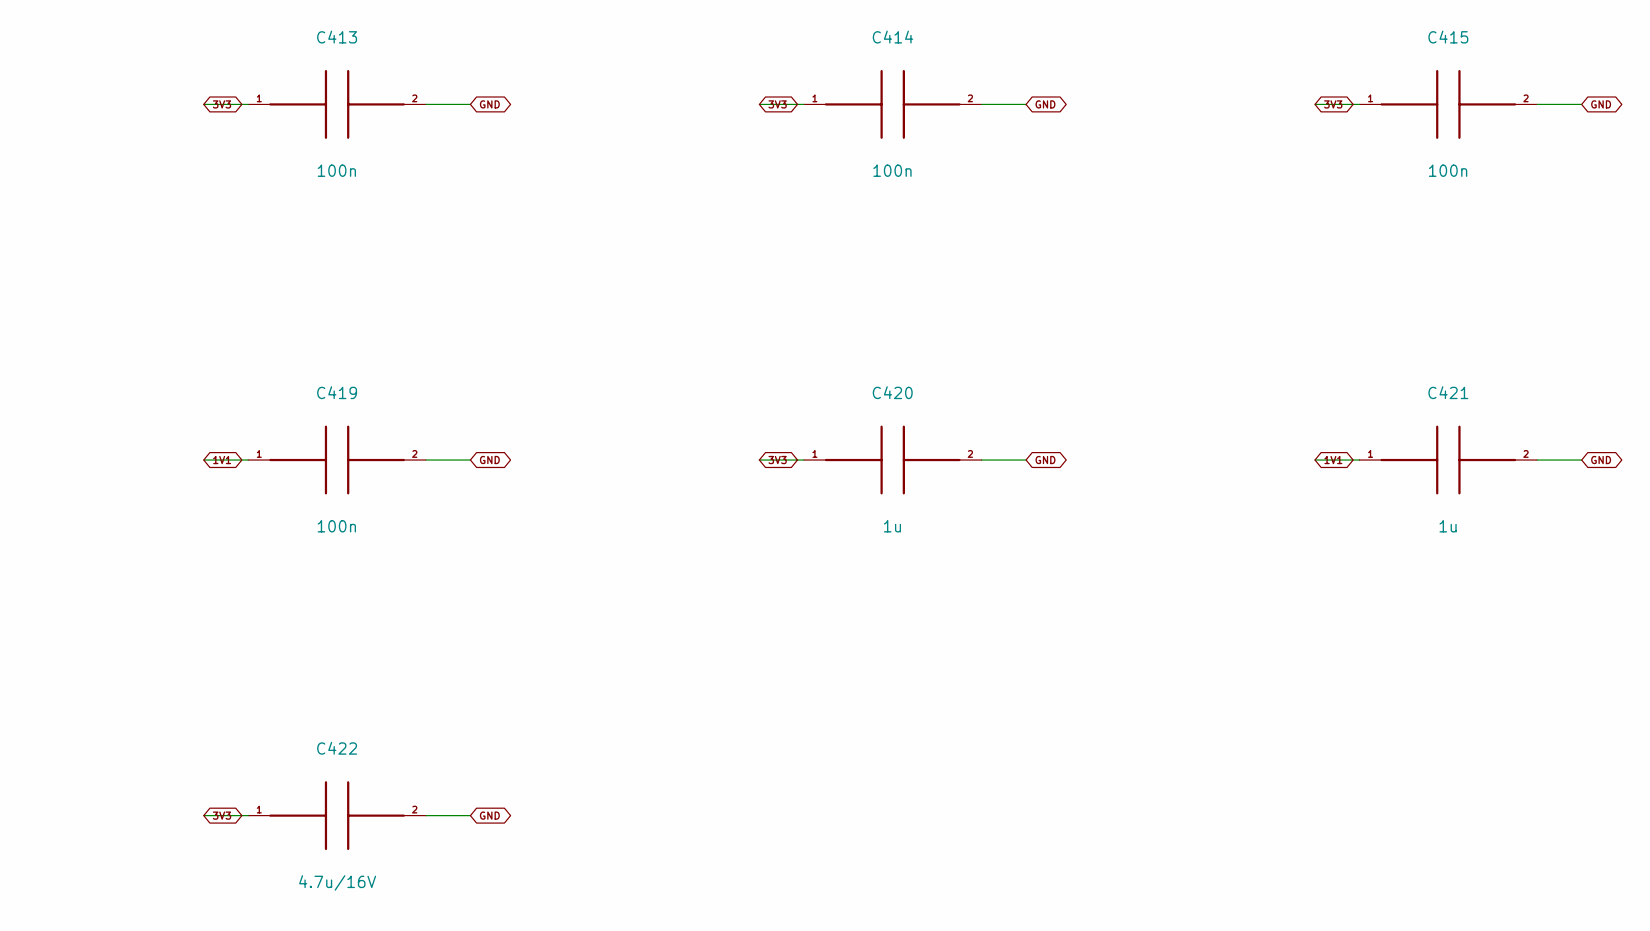
[picture p360: schematic controller_power.kicad_sch, Quadcuber A1 / controller_power / ENGINEERING HOLD, part in row 1, column 2]

Parts:
C1: 1u/16V; C_0805_2012Metric; MPN GRM21BR71C105KA01L
C410, C411, C412, C413, C414, C415, C416, C417, C418, C419: 100n; C_0402_1005Metric; MPN GRM155R71C104KA88D
C420, C421: 1u; C_0402_1005Metric; MPN GRM155R61C105KA12D
C422: 4.7u/16V; C_0805_2012Metric; MPN C0805C475K4PACTU
D2: SS14 external logic isolation; D_SMA; MPN SS14-E3/61T
U5: TLV75533PDBVR; SOT-23-5; MPN TLV75533PDBVR

Connections:
1V1: C418.1, C419.1, C421.1; also elsewhere on the board
3V3: C410.1, C411.1, C412.1, C413.1, C414.1, C415.1, C416.1, C417.1, C420.1, C422.1, U5.5 (OUT); also elsewhere on the board
5V_A: D2.2 (A); also elsewhere on the board
GND: C1.2, C410.2, C411.2, C412.2, C413.2, C414.2, C415.2, C416.2, C417.2, C418.2, C419.2, C420.2, C421.2, C422.2, U5.2 (GND); also elsewhere on the board
VSYS: C1.1, D2.1 (K), U5.1 (IN), U5.3 (EN); also elsewhere on the board

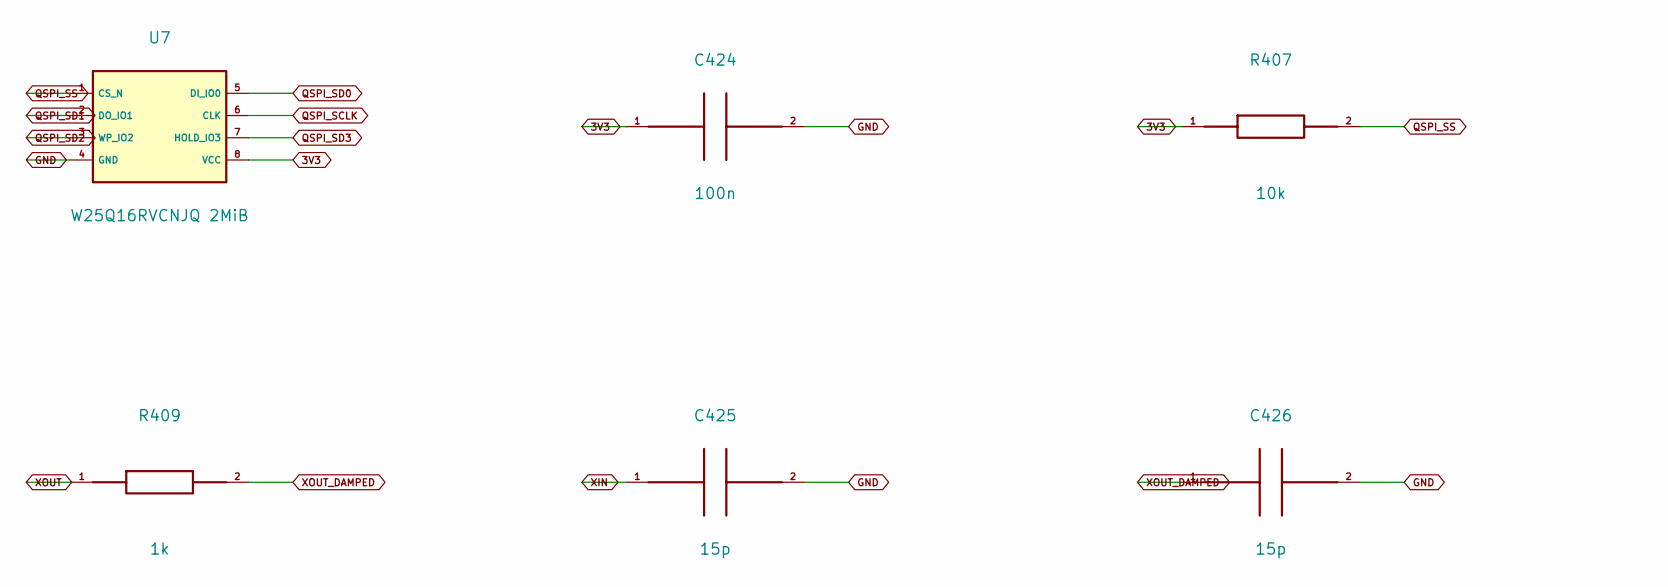
[picture p361: schematic flash_clock.kicad_sch, Quadcuber A1 / flash_clock / ENGINEERING HOLD, part in row 1, column 1]

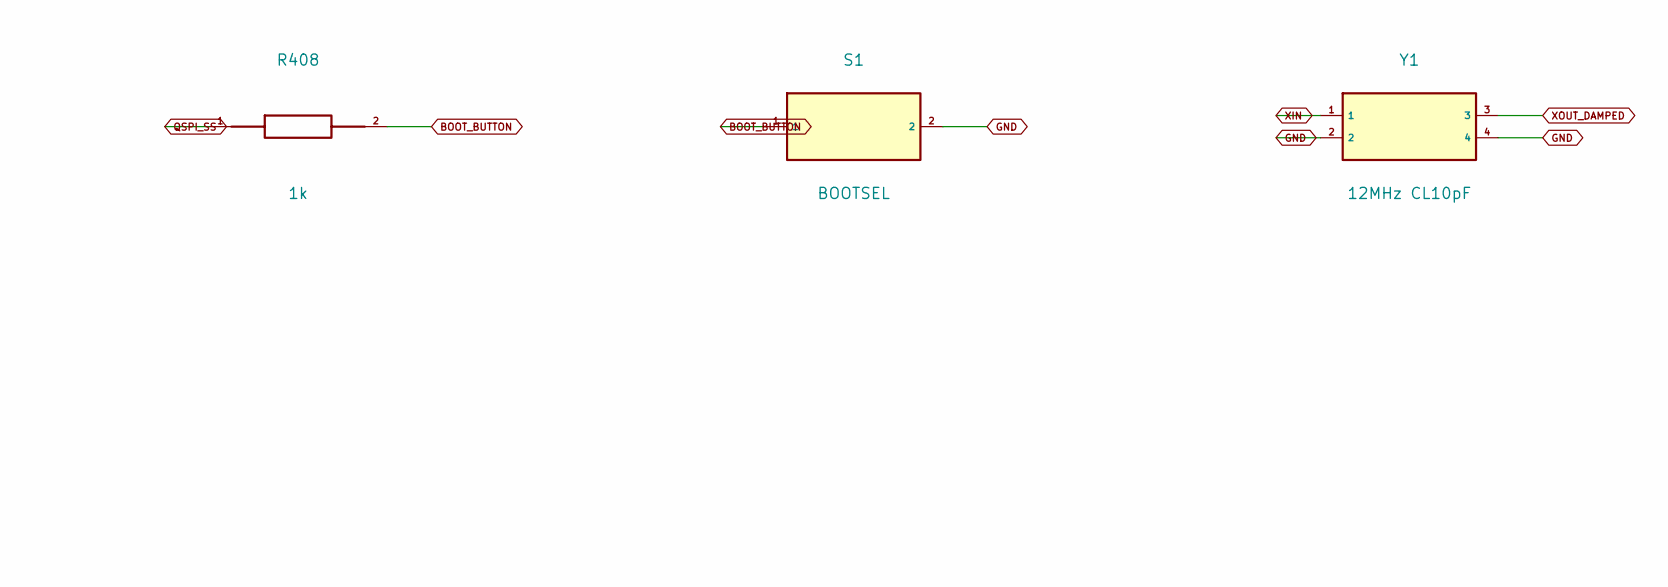
[picture p362: schematic flash_clock.kicad_sch, Quadcuber A1 / flash_clock / ENGINEERING HOLD, part in row 1, column 2]

Parts:
C424: 100n; C_0402_1005Metric; MPN GRM155R71C104KA88D
C425, C426: 15p; C_0402_1005Metric; MPN GRM1555C1H150JA01D
R407: 10k; R_0603_1608Metric; MPN RC0603FR-0710KL
R408: 1k; R_0603_1608Metric; MPN RC0603FR-071KL
R409: 1k; R_0402_1005Metric; MPN RC0402FR-071KL
S1: BOOTSEL; SW_SPST_TL3342; MPN TL3342F160QG
U7: W25Q16RVCNJQ 2MiB; SOIC-8_3.9x4.9mm_P1.27mm; MPN W25Q16RVCNJQ
Y1: 12MHz CL10pF; Crystal_SMD_3225-4Pin_3.2x2.5mm; MPN ABM8-272-T3

Connections:
3V3: C424.1, R407.1, U7.8 (VCC); also elsewhere on the board
BOOT_BUTTON: R408.2, S1.1
GND: C424.2, C425.2, C426.2, S1.2, U7.4 (GND), Y1.2, Y1.4; also elsewhere on the board
QSPI_SCLK: U7.6 (CLK); also elsewhere on the board
QSPI_SD0: U7.5 (DI_IO0); also elsewhere on the board
QSPI_SD1: U7.2 (DO_IO1); also elsewhere on the board
QSPI_SD2: U7.3 (WP_IO2); also elsewhere on the board
QSPI_SD3: U7.7 (HOLD_IO3); also elsewhere on the board
QSPI_SS: R407.2, R408.1, U7.1 (CS_N); also elsewhere on the board
XIN: C425.1, Y1.1; also elsewhere on the board
XOUT: R409.1; also elsewhere on the board
XOUT_DAMPED: C426.1, R409.2, Y1.3

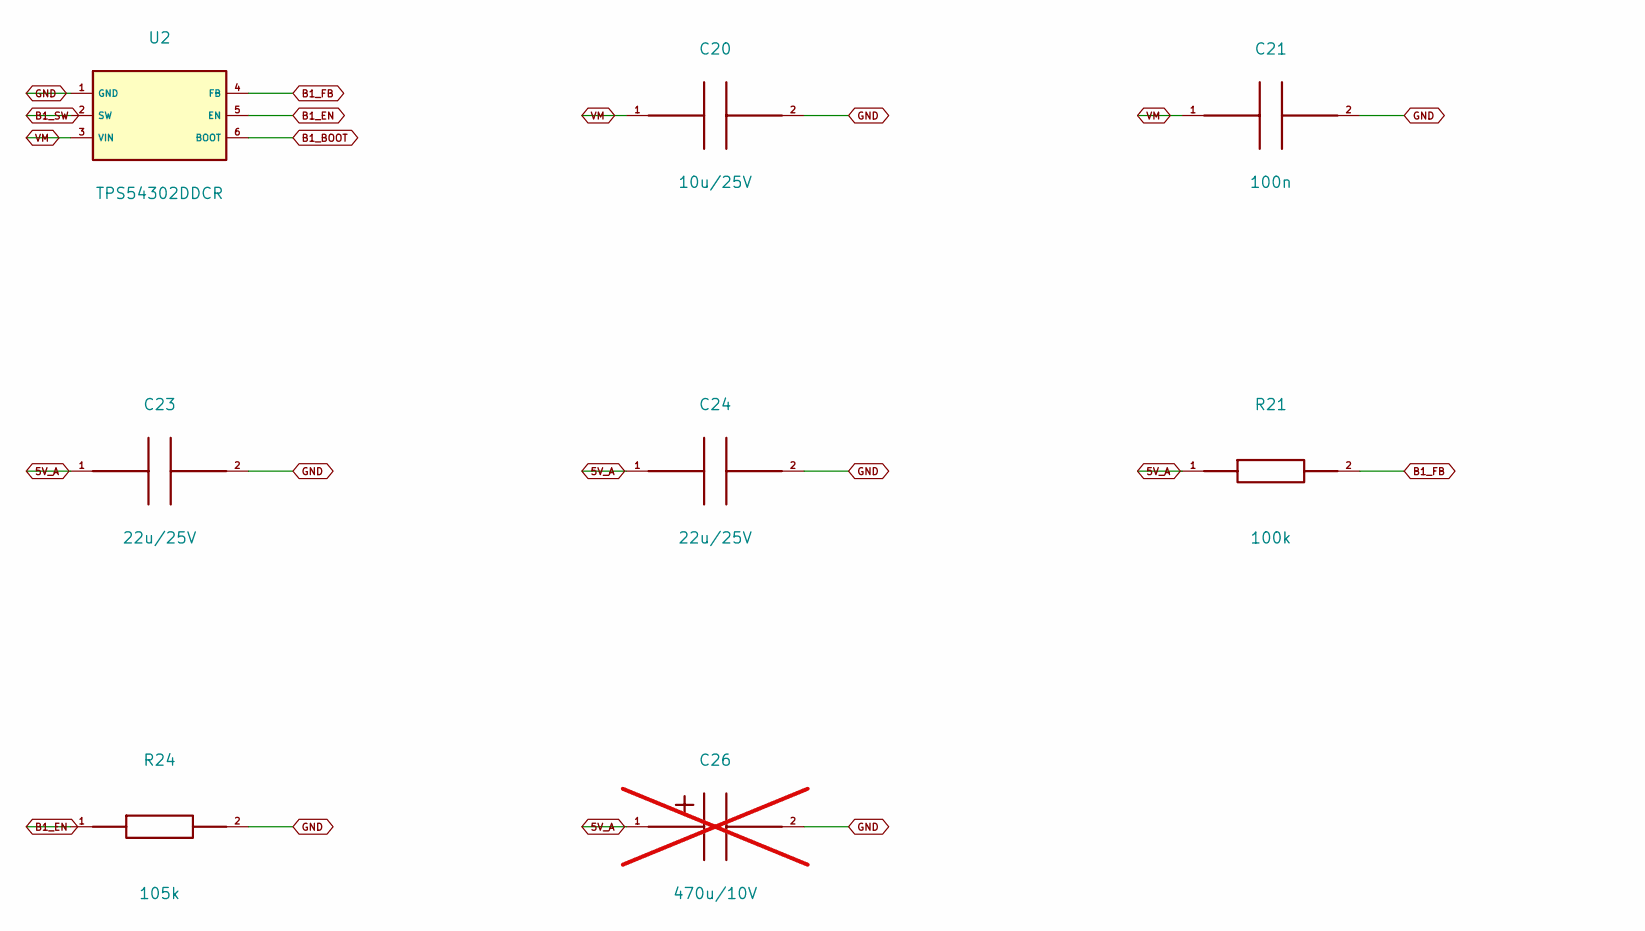
[picture p363: schematic buck1.kicad_sch, Quadcuber A1 / buck1 / ENGINEERING HOLD, part in row 1, column 1]

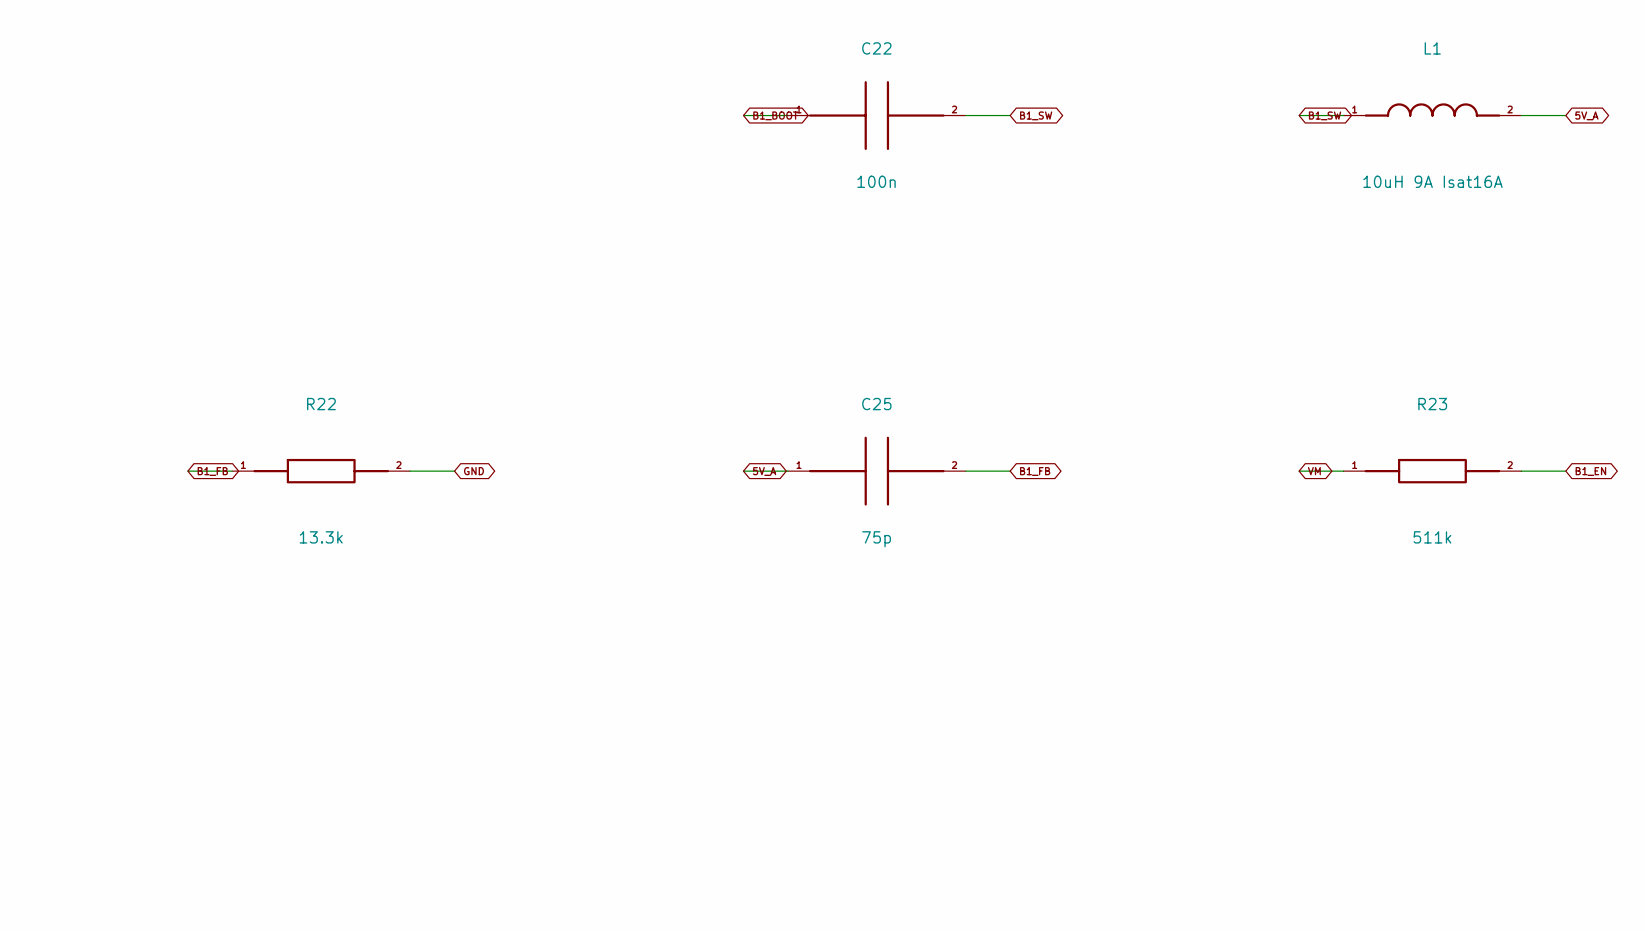
[picture p364: schematic buck1.kicad_sch, Quadcuber A1 / buck1 / ENGINEERING HOLD, part in row 1, column 2]

Parts:
C20: 10u/25V; C_1210_3225Metric; MPN GRM32DR71E106KA12L
C21, C22: 100n; C_0805_2012Metric; MPN GRM21BR71H104KA01L
C23, C24: 22u/25V; C_1210_3225Metric; MPN GRM32ER71E226KE15L
C25: 75p; C_0603_1608Metric; MPN C0603C750J5GACTU
C26: 470u/10V; CP_Radial_D8.0mm_P3.50mm; MPN EEU-FR1A471; not fitted
L1: 10uH 9A Isat16A; L_Bourns_SRP1245A; MPN SRP1245A-100M
R21: 100k; R_0603_1608Metric; MPN RT0603BRD07100KL
R22: 13.3k; R_0603_1608Metric; MPN RT0603BRD0713K3L
R23: 511k; R_0603_1608Metric; MPN RC0603FR-07511KL
R24: 105k; R_0603_1608Metric; MPN RC0603FR-07105KL
U2: TPS54302DDCR; SOT-23-6; MPN TPS54302DDCR

Connections:
5V_A: C23.1, C24.1, C25.1, C26.1 (+), L1.2, R21.1; also elsewhere on the board
B1_BOOT: C22.1, U2.6 (BOOT)
B1_EN: R23.2, R24.1, U2.5 (EN)
B1_FB: C25.2, R21.2, R22.1, U2.4 (FB)
B1_SW: C22.2, L1.1, U2.2 (SW)
GND: C20.2, C21.2, C23.2, C24.2, C26.2 (-), R22.2, R24.2, U2.1 (GND); also elsewhere on the board
VM: C20.1, C21.1, R23.1, U2.3 (VIN); also elsewhere on the board

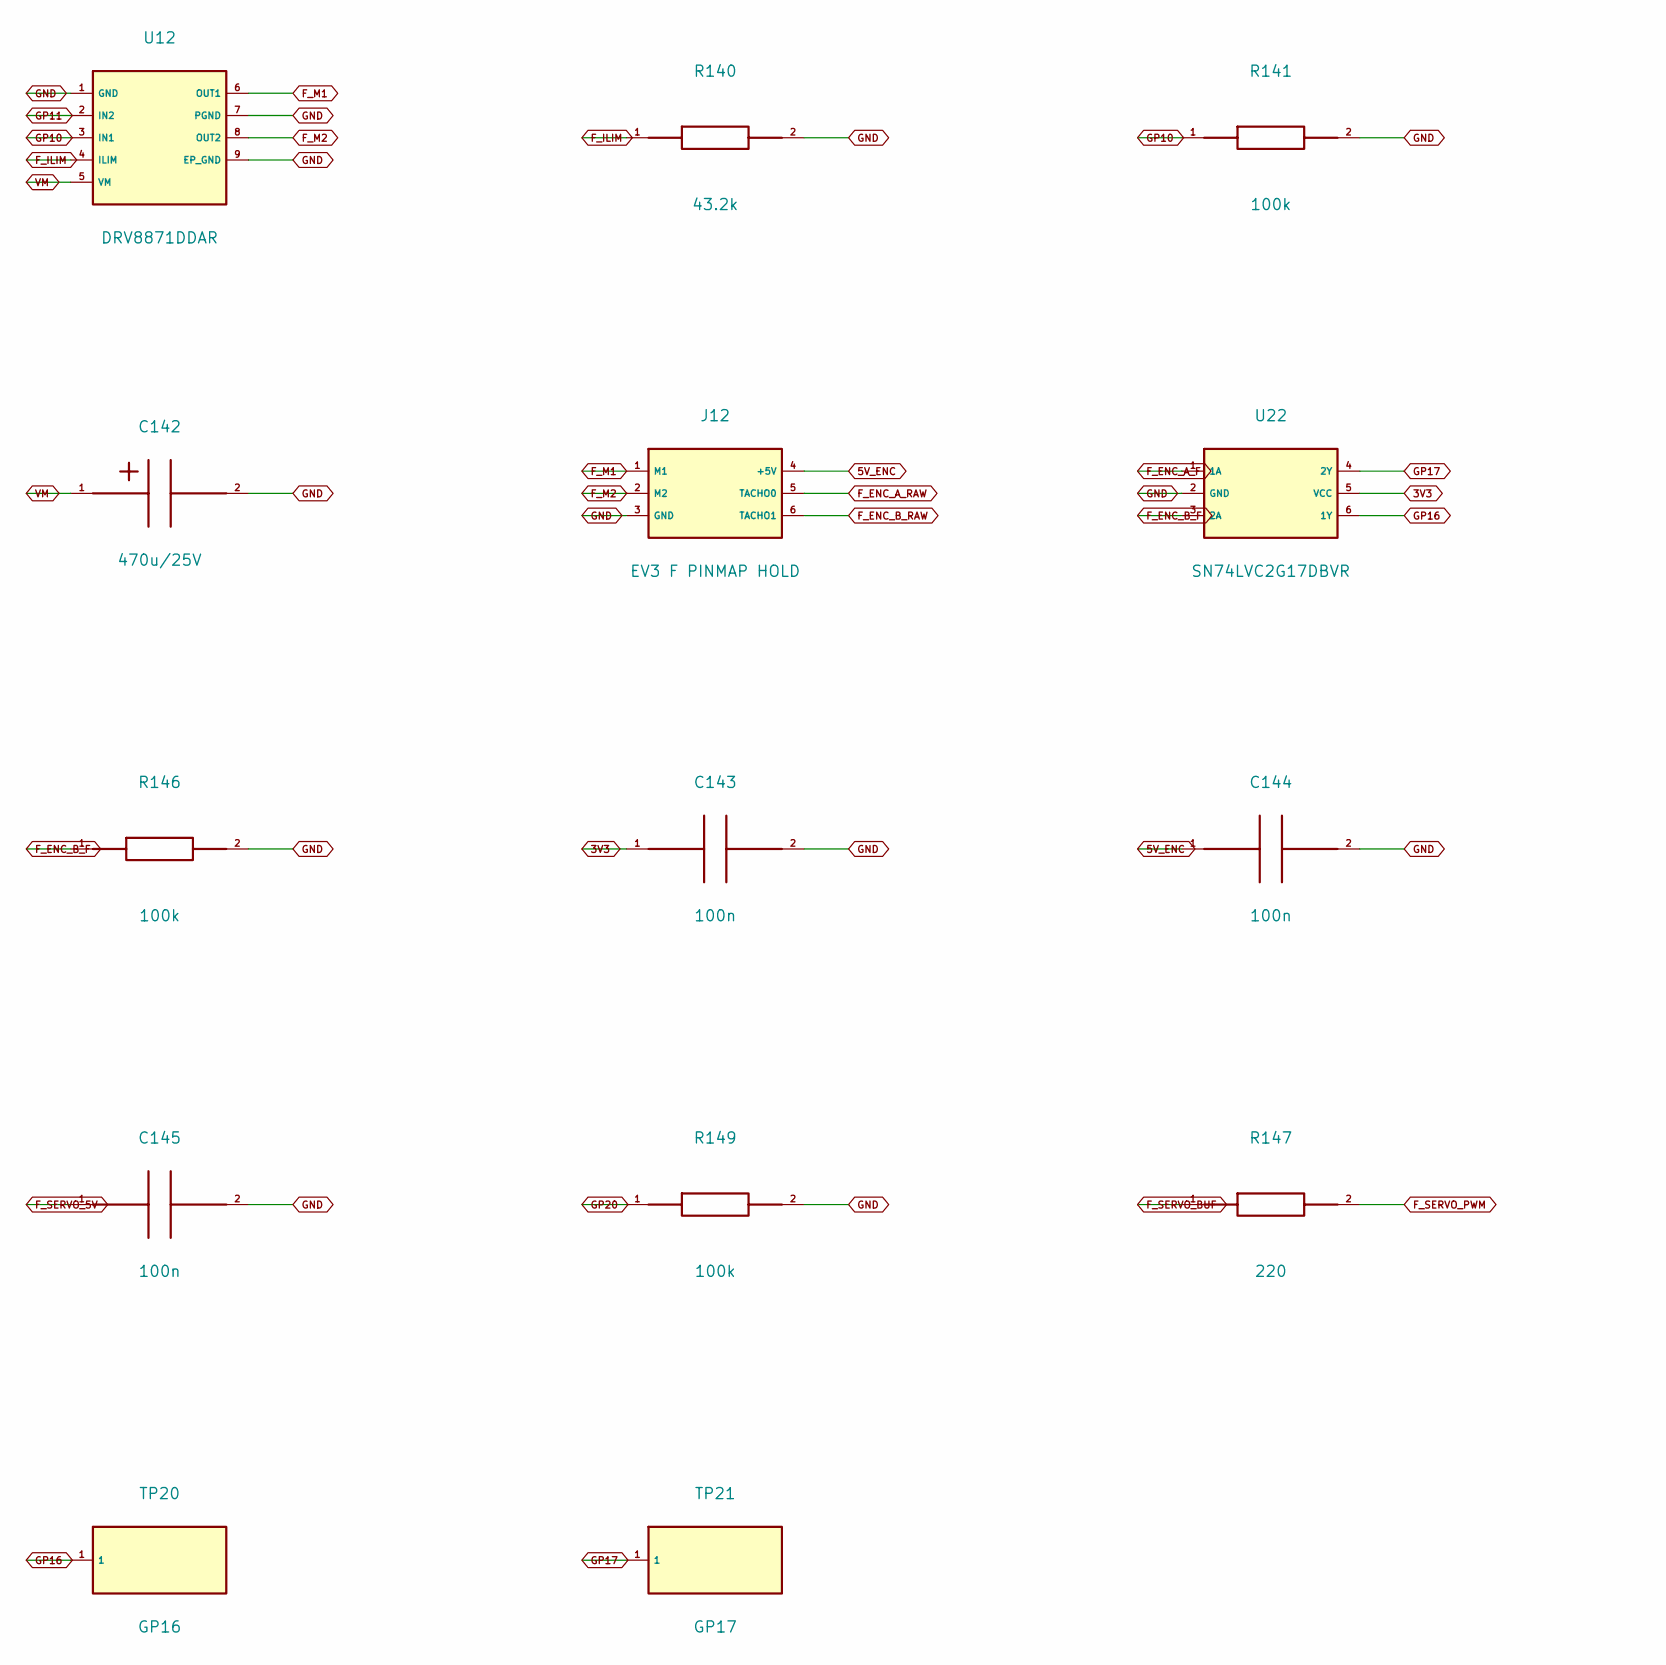
[picture p365: schematic arm_F.kicad_sch, Quadcuber A1 / arm_F / ENGINEERING HOLD, part in row 1, column 1]

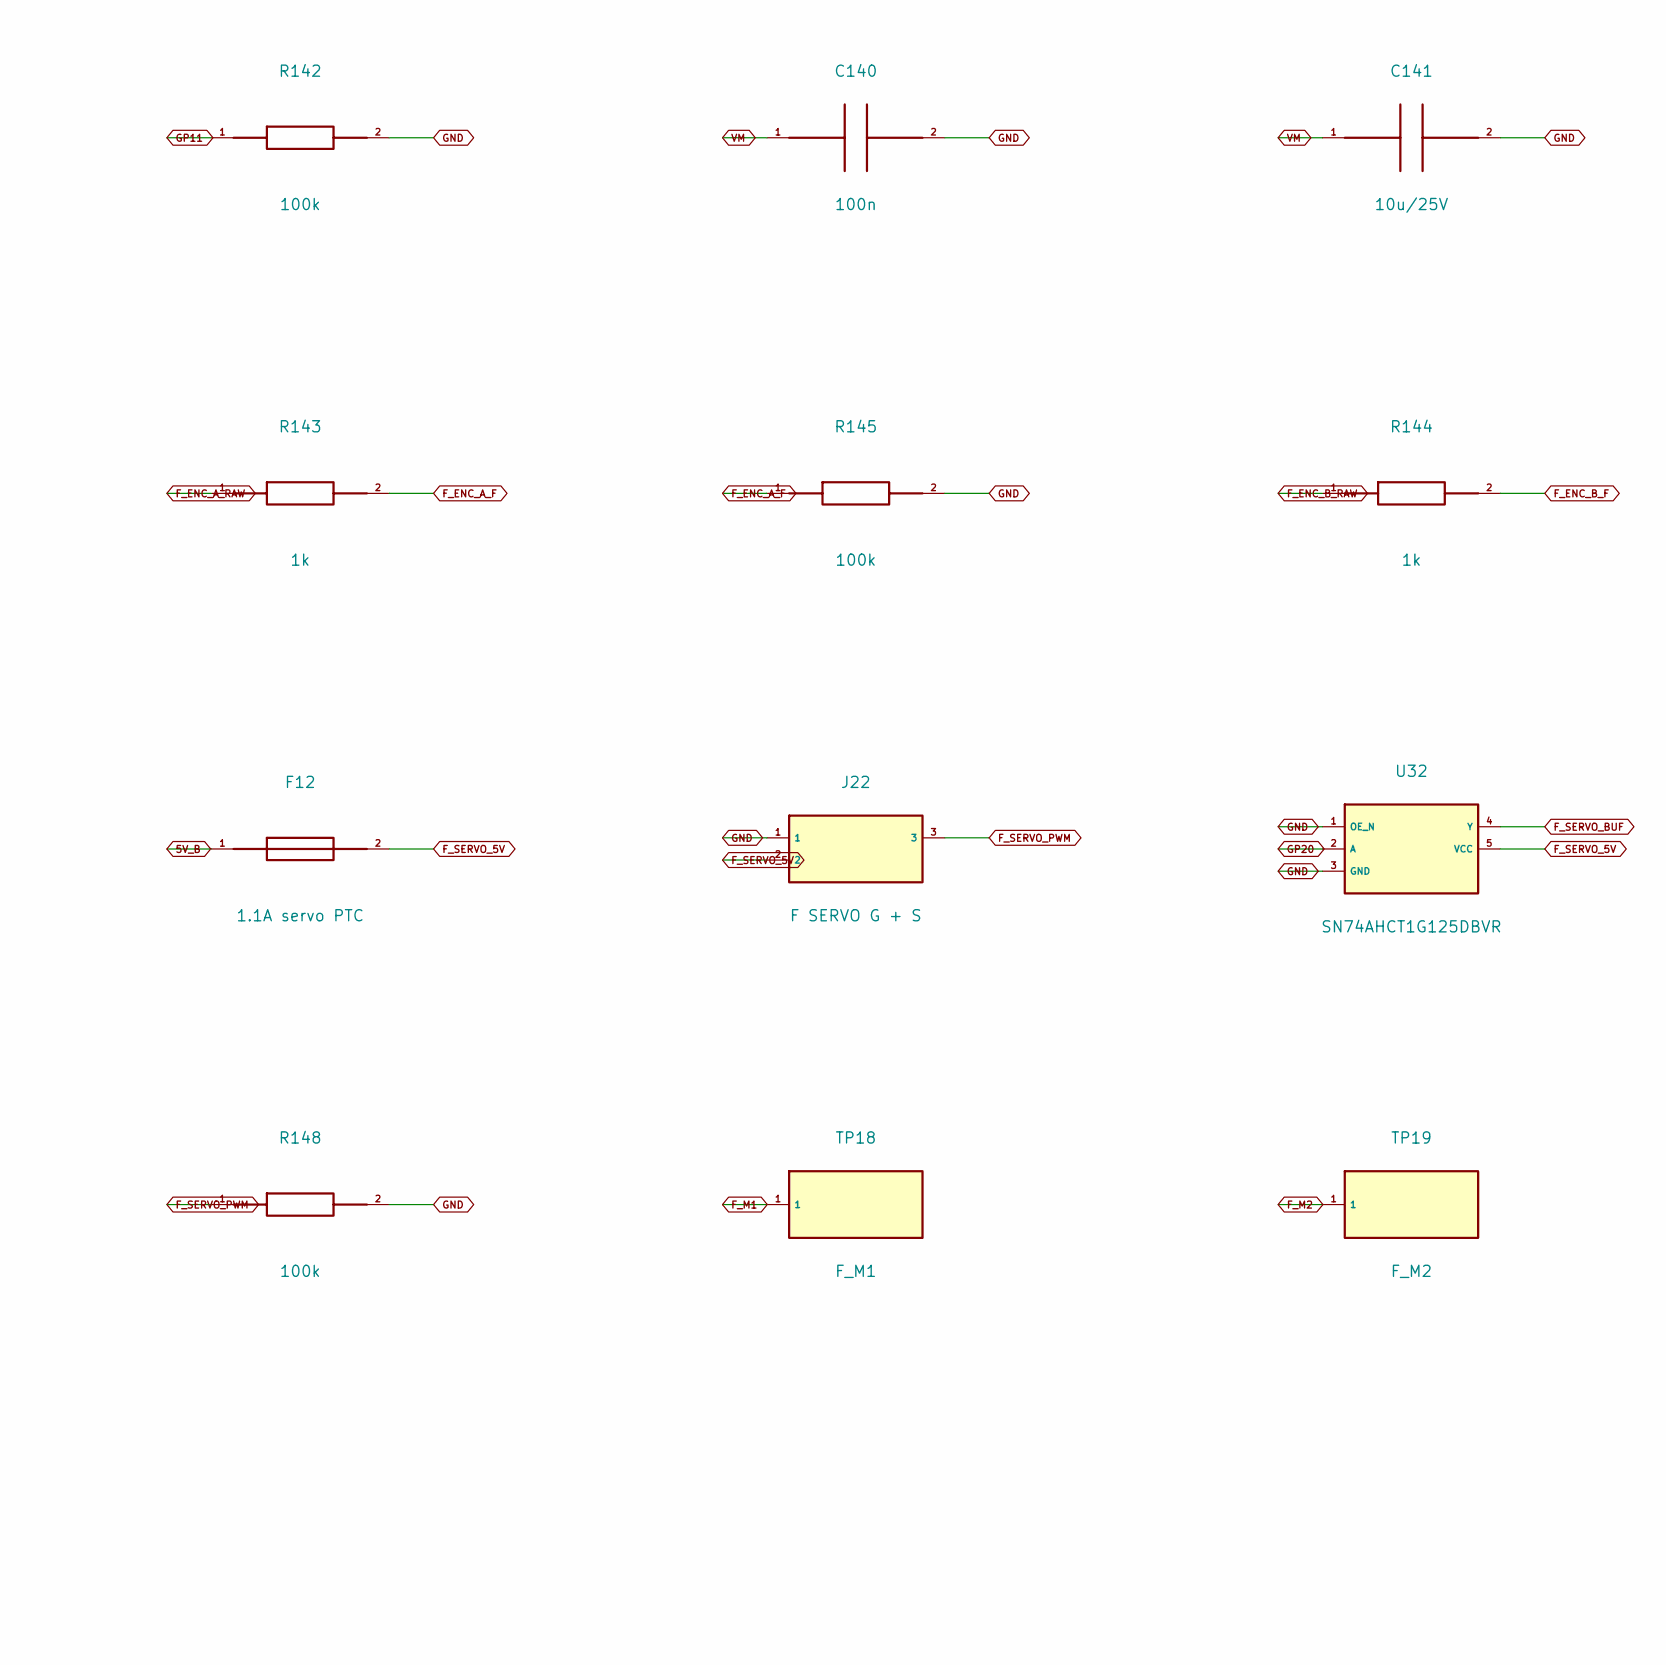
[picture p366: schematic arm_F.kicad_sch, Quadcuber A1 / arm_F / ENGINEERING HOLD, part in row 1, column 2]

Parts:
C140, C143, C144, C145: 100n; C_0805_2012Metric; MPN GRM21BR71H104KA01L
C141: 10u/25V; C_1210_3225Metric; MPN GRM32DR71E106KA12L
C142: 470u/25V; CP_Radial_D10.0mm_P5.00mm; MPN EEU-FR1E471
F12: 1.1A servo PTC; Fuse_Bourns_MF_MSMF_Style2_1812; MPN MF-MSMF110/16X-2
J12: EV3 F PINMAP HOLD; EV3_UserDrawing_PINMAP_HOLD; MPN UNCONFIRMED user drawing
J22: F SERVO G + S; PinHeader_1x03_P2.54mm_Vertical; MPN 61300311121
R140: 43.2k; R_0603_1608Metric; MPN RC0603FR-0743K2L
R141, R142, R145, R146, R148, R149: 100k; R_0603_1608Metric; MPN RC0603FR-07100KL
R143, R144: 1k; R_0603_1608Metric; MPN RC0603FR-071KL
R147: 220; R_0603_1608Metric; MPN RC0603FR-07220RL
TP18: F_M1; TestPoint_Pad_D1.5mm; MPN N/A PCB copper
TP19: F_M2; TestPoint_Pad_D1.5mm; MPN N/A PCB copper
TP20: GP16; TestPoint_Pad_D1.5mm; MPN N/A PCB copper
TP21: GP17; TestPoint_Pad_D1.5mm; MPN N/A PCB copper
U12: DRV8871DDAR; Texas_HTSOP-8-1EP_3.9x4.9mm_P1.27mm_EP2.95x4.9mm_Mask2.4x3.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; MPN DRV8871DDAR
U22: SN74LVC2G17DBVR; SOT-23-6; MPN SN74LVC2G17DBVR
U32: SN74AHCT1G125DBVR; SOT-23-5; MPN SN74AHCT1G125DBVR

Connections:
3V3: C143.1, U22.5 (VCC); also elsewhere on the board
5V_B: F12.1; also elsewhere on the board
5V_ENC: C144.1, J12.4 (+5V); also elsewhere on the board
F_ENC_A_F: R143.2, R145.1, U22.1 (1A)
F_ENC_A_RAW: J12.5 (TACHO0), R143.1
F_ENC_B_F: R144.2, R146.1, U22.3 (2A)
F_ENC_B_RAW: J12.6 (TACHO1), R144.1
F_ILIM: R140.1, U12.4 (ILIM)
F_M1: J12.1 (M1), TP18.1, U12.6 (OUT1)
F_M2: J12.2 (M2), TP19.1, U12.8 (OUT2)
F_SERVO_5V: C145.1, F12.2, J22.2, U32.5 (VCC)
F_SERVO_BUF: R147.1, U32.4 (Y)
F_SERVO_PWM: J22.3, R147.2, R148.1
GND: C140.2, C141.2, C142.2 (-), C143.2, C144.2, C145.2, J12.3 (GND), J22.1, R140.2, R141.2, R142.2, R145.2, R146.2, R148.2, R149.2, U12.1 (GND), U12.7 (PGND), U12.9 (EP_GND), U22.2 (GND), U32.1 (OE_N), U32.3 (GND); also elsewhere on the board
GP10: R141.1, U12.3 (IN1); also elsewhere on the board
GP11: R142.1, U12.2 (IN2); also elsewhere on the board
GP16: TP20.1, U22.6 (1Y); also elsewhere on the board
GP17: TP21.1, U22.4 (2Y); also elsewhere on the board
GP20: R149.1, U32.2 (A); also elsewhere on the board
VM: C140.1, C141.1, C142.1 (+), U12.5 (VM); also elsewhere on the board
