gonewx/quadcuber/electronics/quadcuber.kicad_pcb

## KiCad design electronics/quadcuber.kicad_pcb (continued)

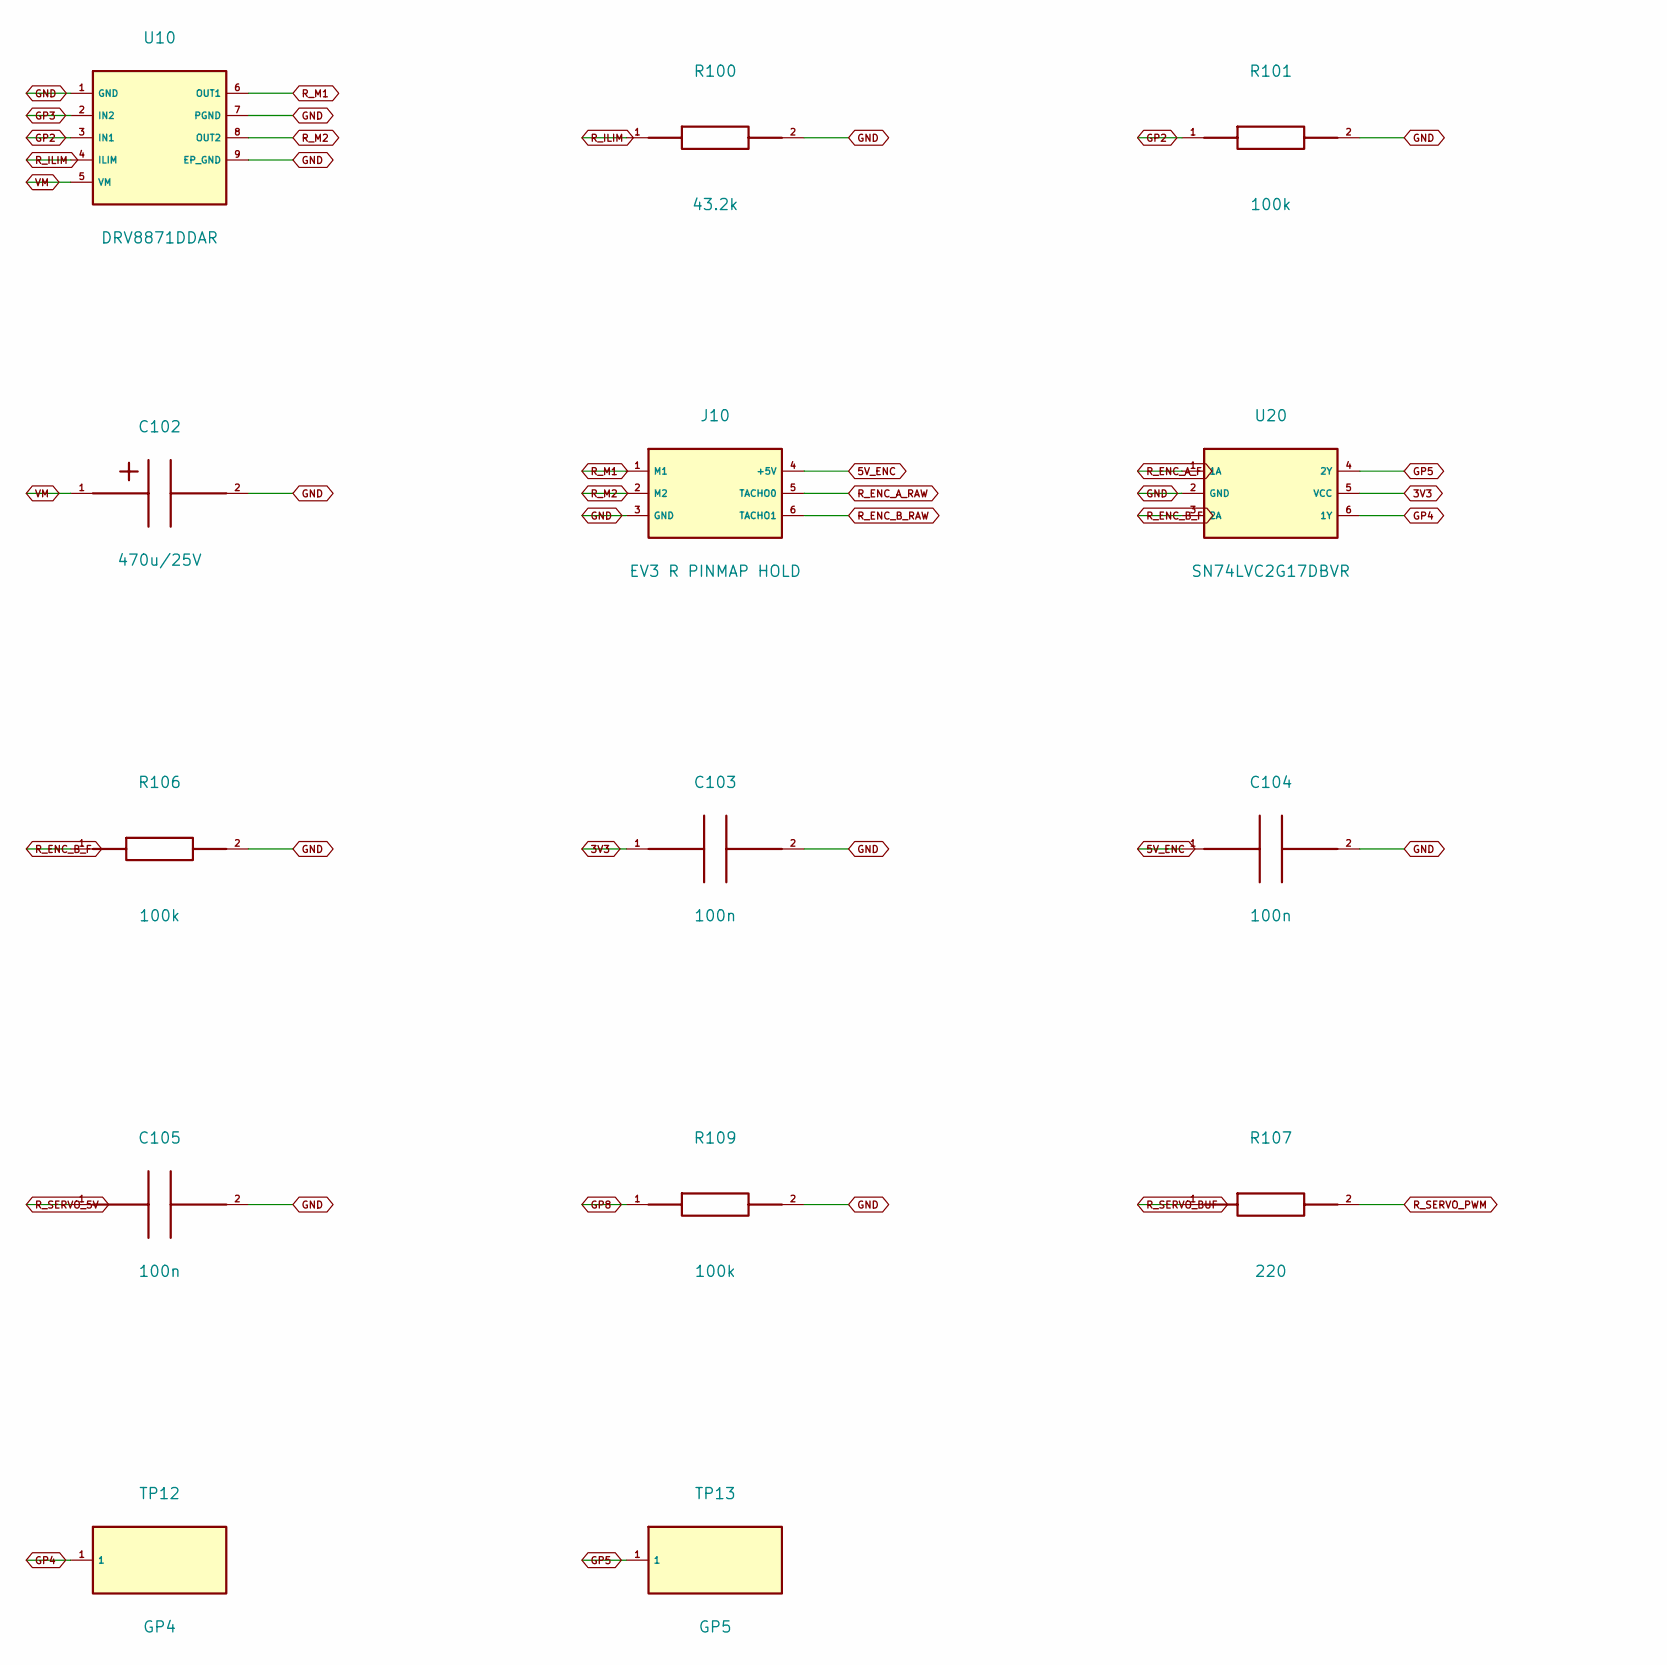
[picture p367: schematic arm_R.kicad_sch, Quadcuber A1 / arm_R / ENGINEERING HOLD, part in row 1, column 1]

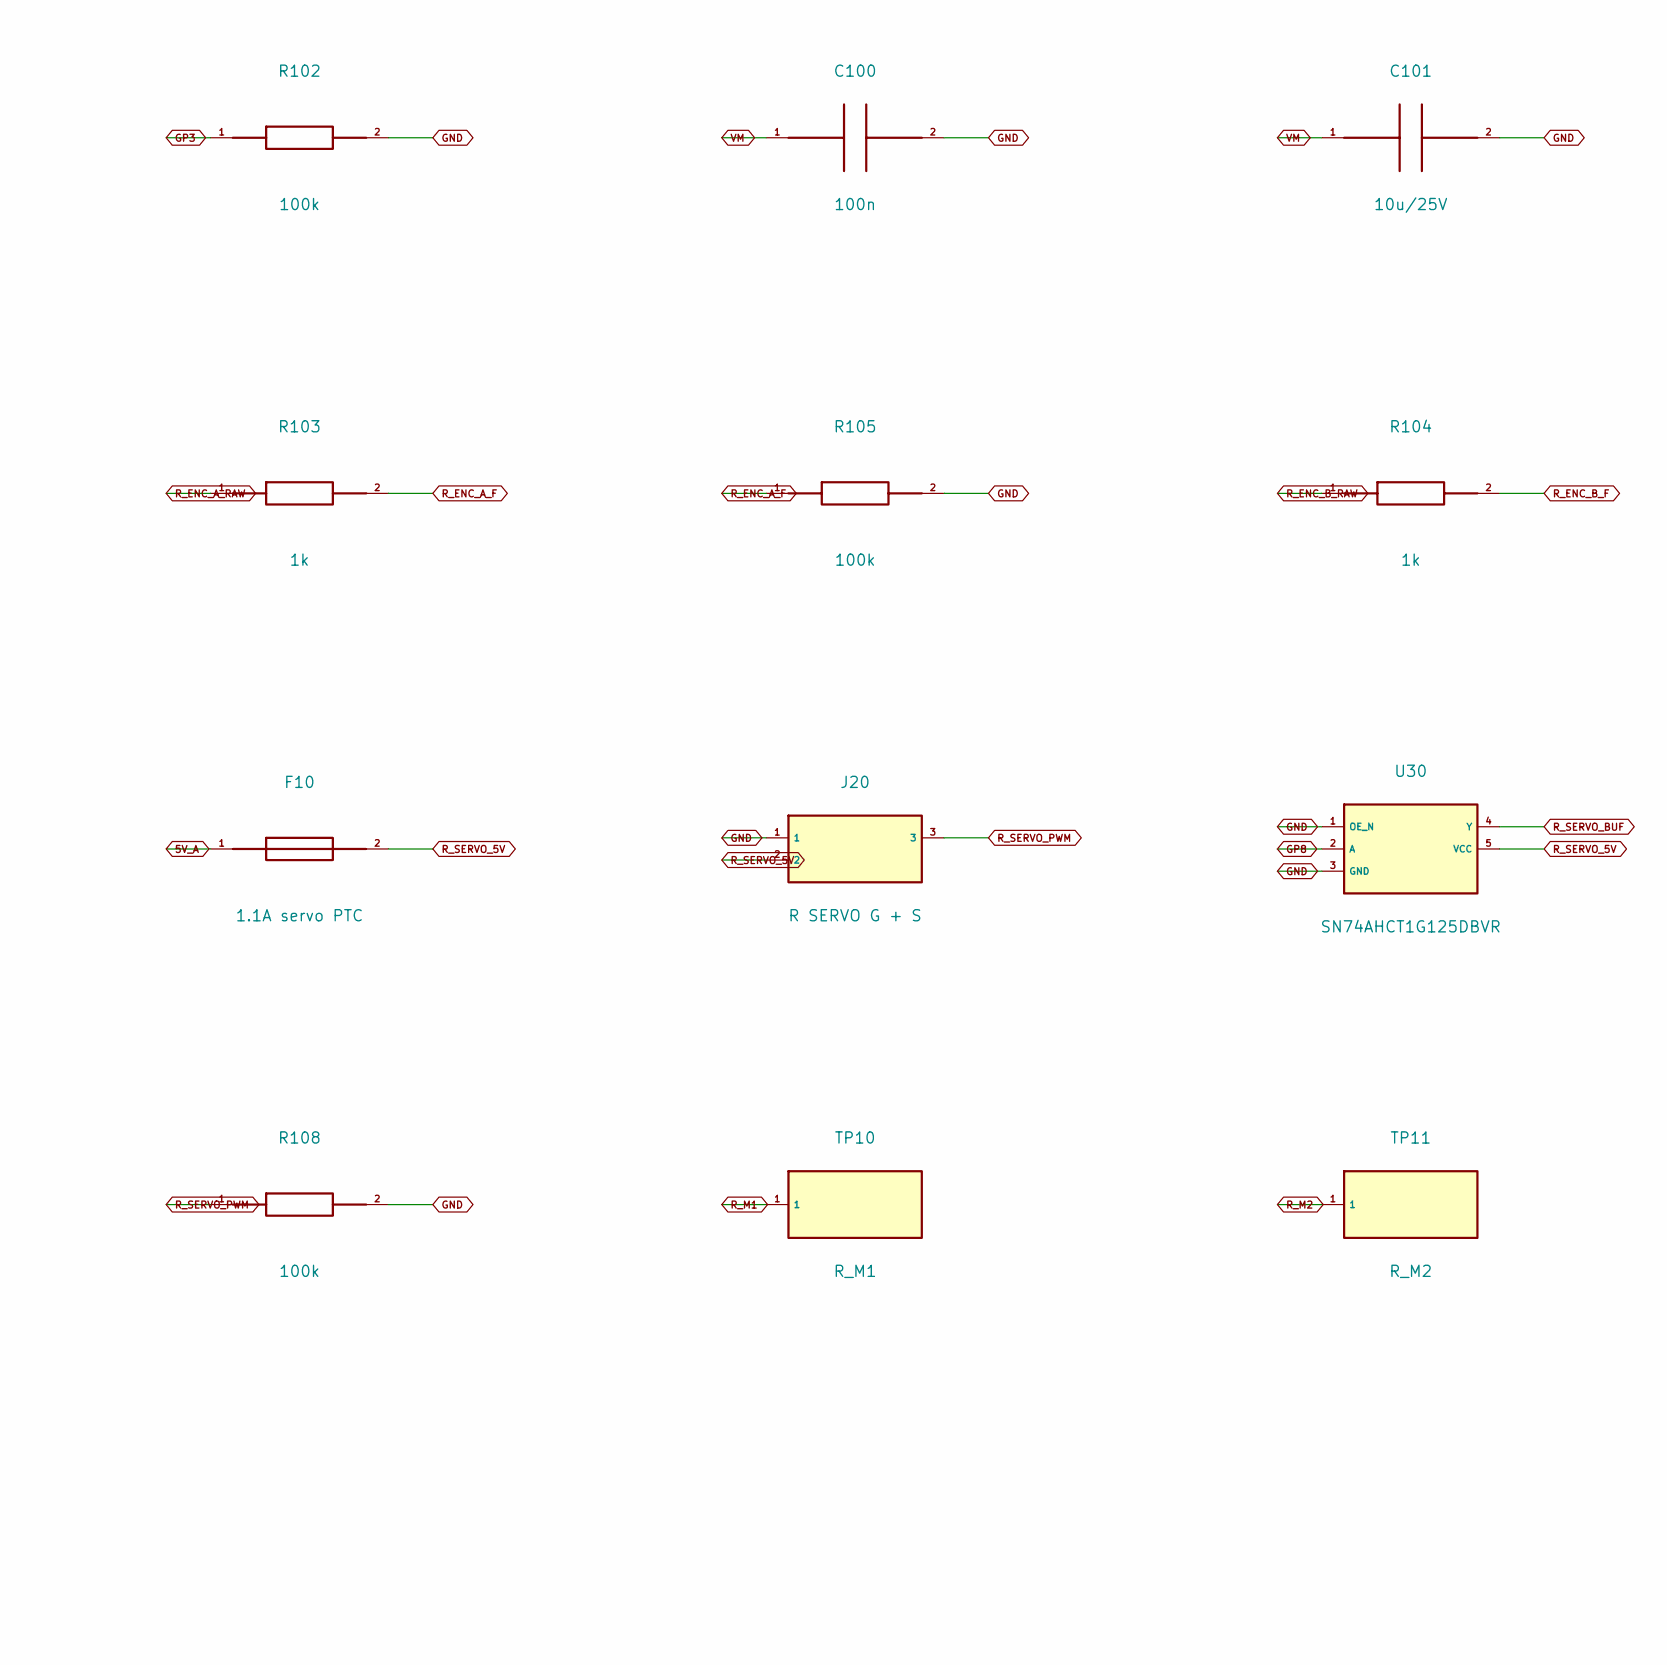
[picture p368: schematic arm_R.kicad_sch, Quadcuber A1 / arm_R / ENGINEERING HOLD, part in row 1, column 2]

Parts:
C100, C103, C104, C105: 100n; C_0805_2012Metric; MPN GRM21BR71H104KA01L
C101: 10u/25V; C_1210_3225Metric; MPN GRM32DR71E106KA12L
C102: 470u/25V; CP_Radial_D10.0mm_P5.00mm; MPN EEU-FR1E471
F10: 1.1A servo PTC; Fuse_Bourns_MF_MSMF_Style2_1812; MPN MF-MSMF110/16X-2
J10: EV3 R PINMAP HOLD; EV3_UserDrawing_PINMAP_HOLD; MPN UNCONFIRMED user drawing
J20: R SERVO G + S; PinHeader_1x03_P2.54mm_Vertical; MPN 61300311121
R100: 43.2k; R_0603_1608Metric; MPN RC0603FR-0743K2L
R101, R102, R105, R106, R108, R109: 100k; R_0603_1608Metric; MPN RC0603FR-07100KL
R103, R104: 1k; R_0603_1608Metric; MPN RC0603FR-071KL
R107: 220; R_0603_1608Metric; MPN RC0603FR-07220RL
TP10: R_M1; TestPoint_Pad_D1.5mm; MPN N/A PCB copper
TP11: R_M2; TestPoint_Pad_D1.5mm; MPN N/A PCB copper
TP12: GP4; TestPoint_Pad_D1.5mm; MPN N/A PCB copper
TP13: GP5; TestPoint_Pad_D1.5mm; MPN N/A PCB copper
U10: DRV8871DDAR; Texas_HTSOP-8-1EP_3.9x4.9mm_P1.27mm_EP2.95x4.9mm_Mask2.4x3.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; MPN DRV8871DDAR
U20: SN74LVC2G17DBVR; SOT-23-6; MPN SN74LVC2G17DBVR
U30: SN74AHCT1G125DBVR; SOT-23-5; MPN SN74AHCT1G125DBVR

Connections:
3V3: C103.1, U20.5 (VCC); also elsewhere on the board
5V_A: F10.1; also elsewhere on the board
5V_ENC: C104.1, J10.4 (+5V); also elsewhere on the board
GND: C100.2, C101.2, C102.2 (-), C103.2, C104.2, C105.2, J10.3 (GND), J20.1, R100.2, R101.2, R102.2, R105.2, R106.2, R108.2, R109.2, U10.1 (GND), U10.7 (PGND), U10.9 (EP_GND), U20.2 (GND), U30.1 (OE_N), U30.3 (GND); also elsewhere on the board
GP2: R101.1, U10.3 (IN1); also elsewhere on the board
GP3: R102.1, U10.2 (IN2); also elsewhere on the board
GP4: TP12.1, U20.6 (1Y); also elsewhere on the board
GP5: TP13.1, U20.4 (2Y); also elsewhere on the board
GP8: R109.1, U30.2 (A); also elsewhere on the board
R_ENC_A_F: R103.2, R105.1, U20.1 (1A)
R_ENC_A_RAW: J10.5 (TACHO0), R103.1
R_ENC_B_F: R104.2, R106.1, U20.3 (2A)
R_ENC_B_RAW: J10.6 (TACHO1), R104.1
R_ILIM: R100.1, U10.4 (ILIM)
R_M1: J10.1 (M1), TP10.1, U10.6 (OUT1)
R_M2: J10.2 (M2), TP11.1, U10.8 (OUT2)
R_SERVO_5V: C105.1, F10.2, J20.2, U30.5 (VCC)
R_SERVO_BUF: R107.1, U30.4 (Y)
R_SERVO_PWM: J20.3, R107.2, R108.1
VM: C100.1, C101.1, C102.1 (+), U10.5 (VM); also elsewhere on the board

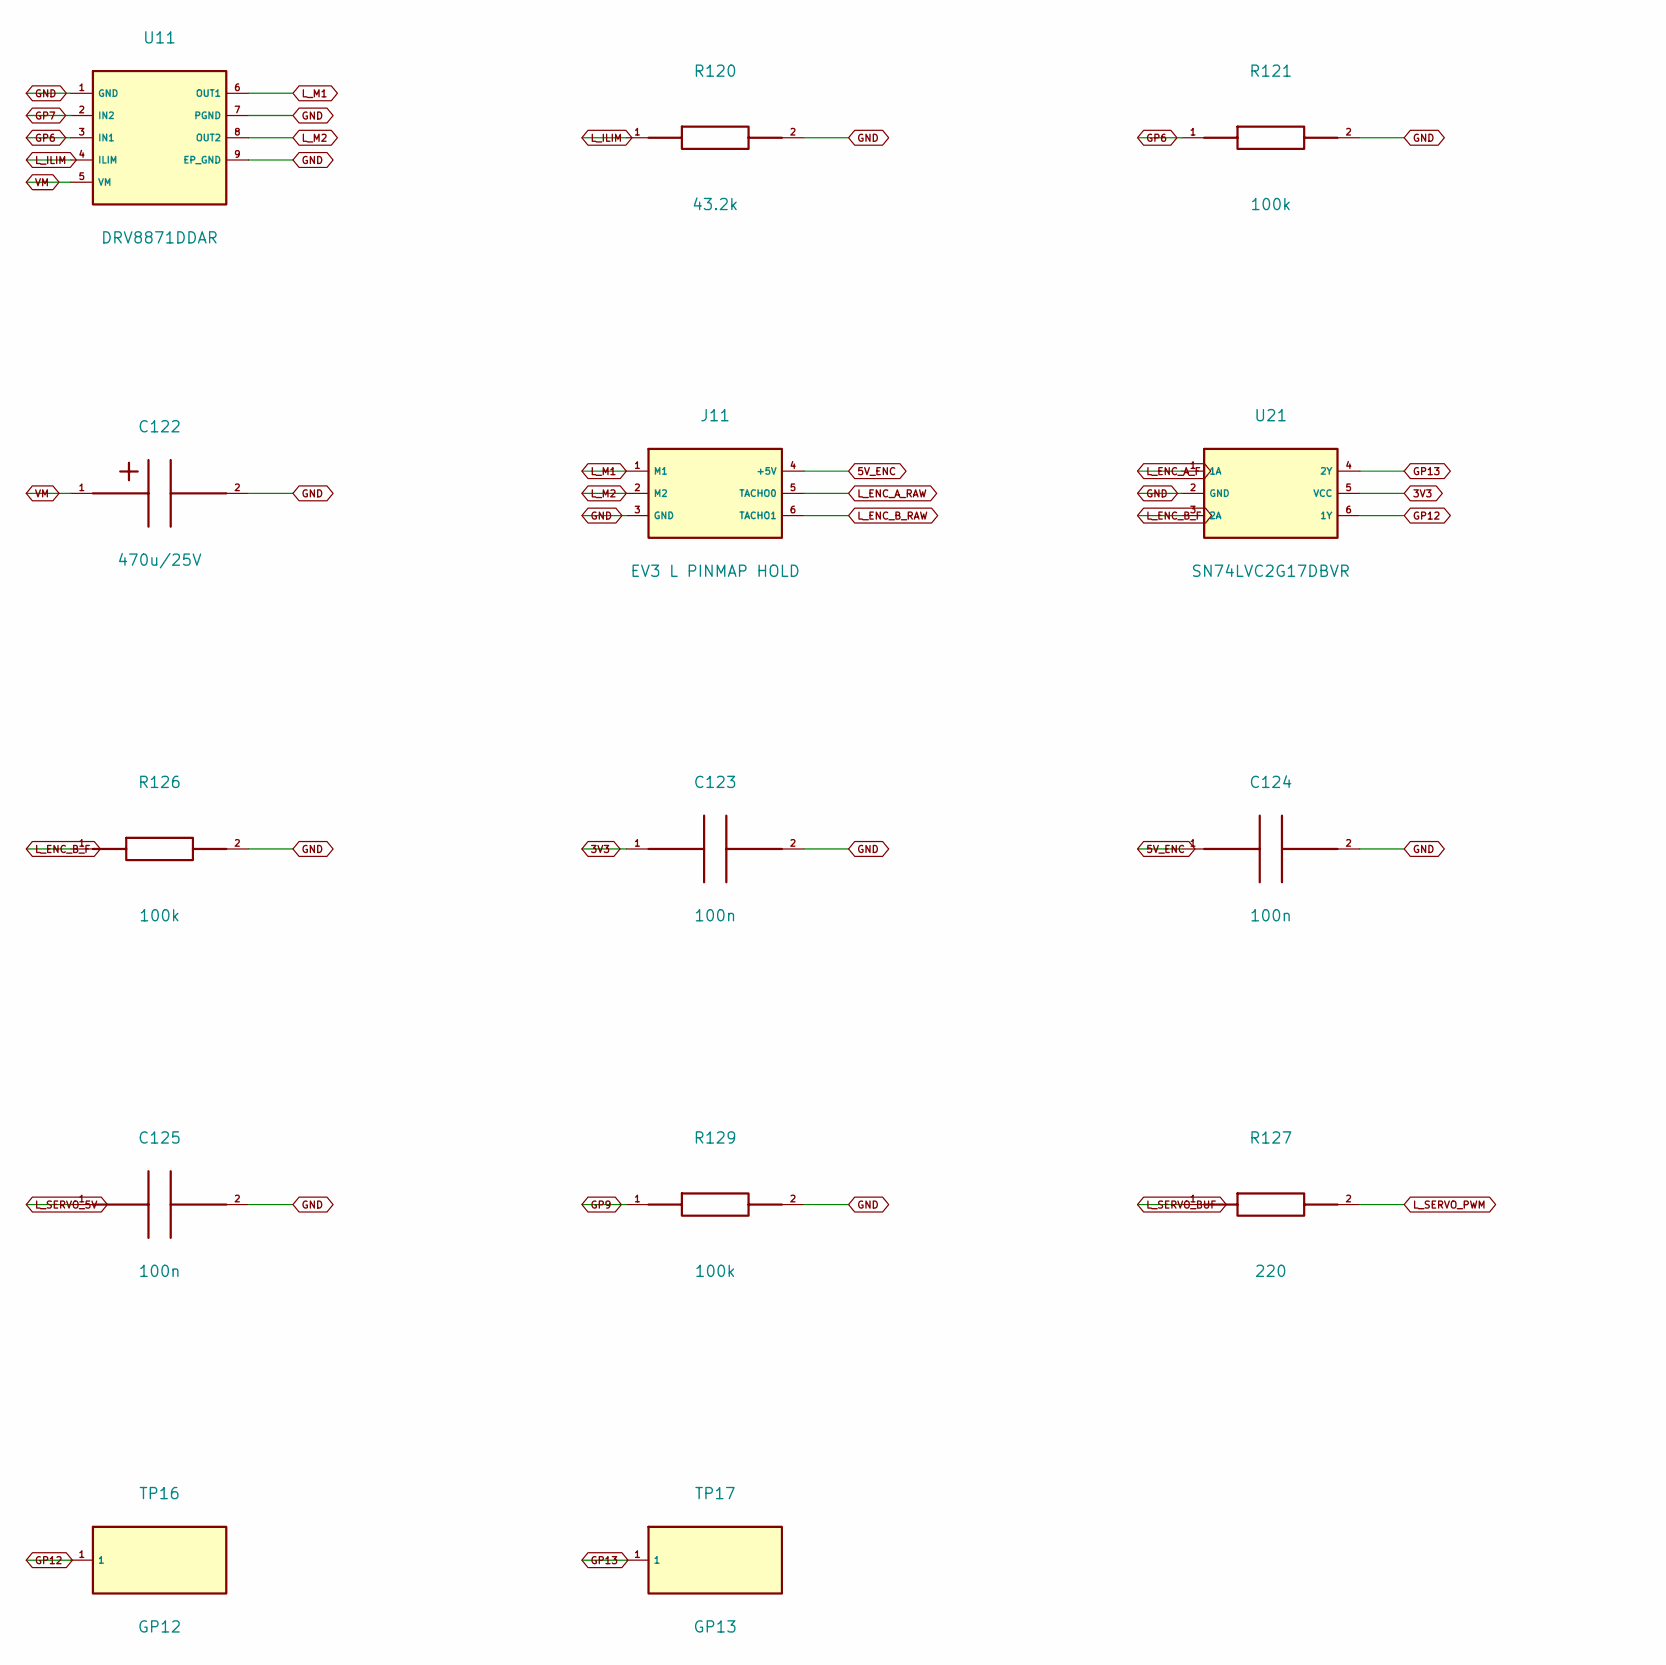
[picture p369: schematic arm_L.kicad_sch, Quadcuber A1 / arm_L / ENGINEERING HOLD, part in row 1, column 1]

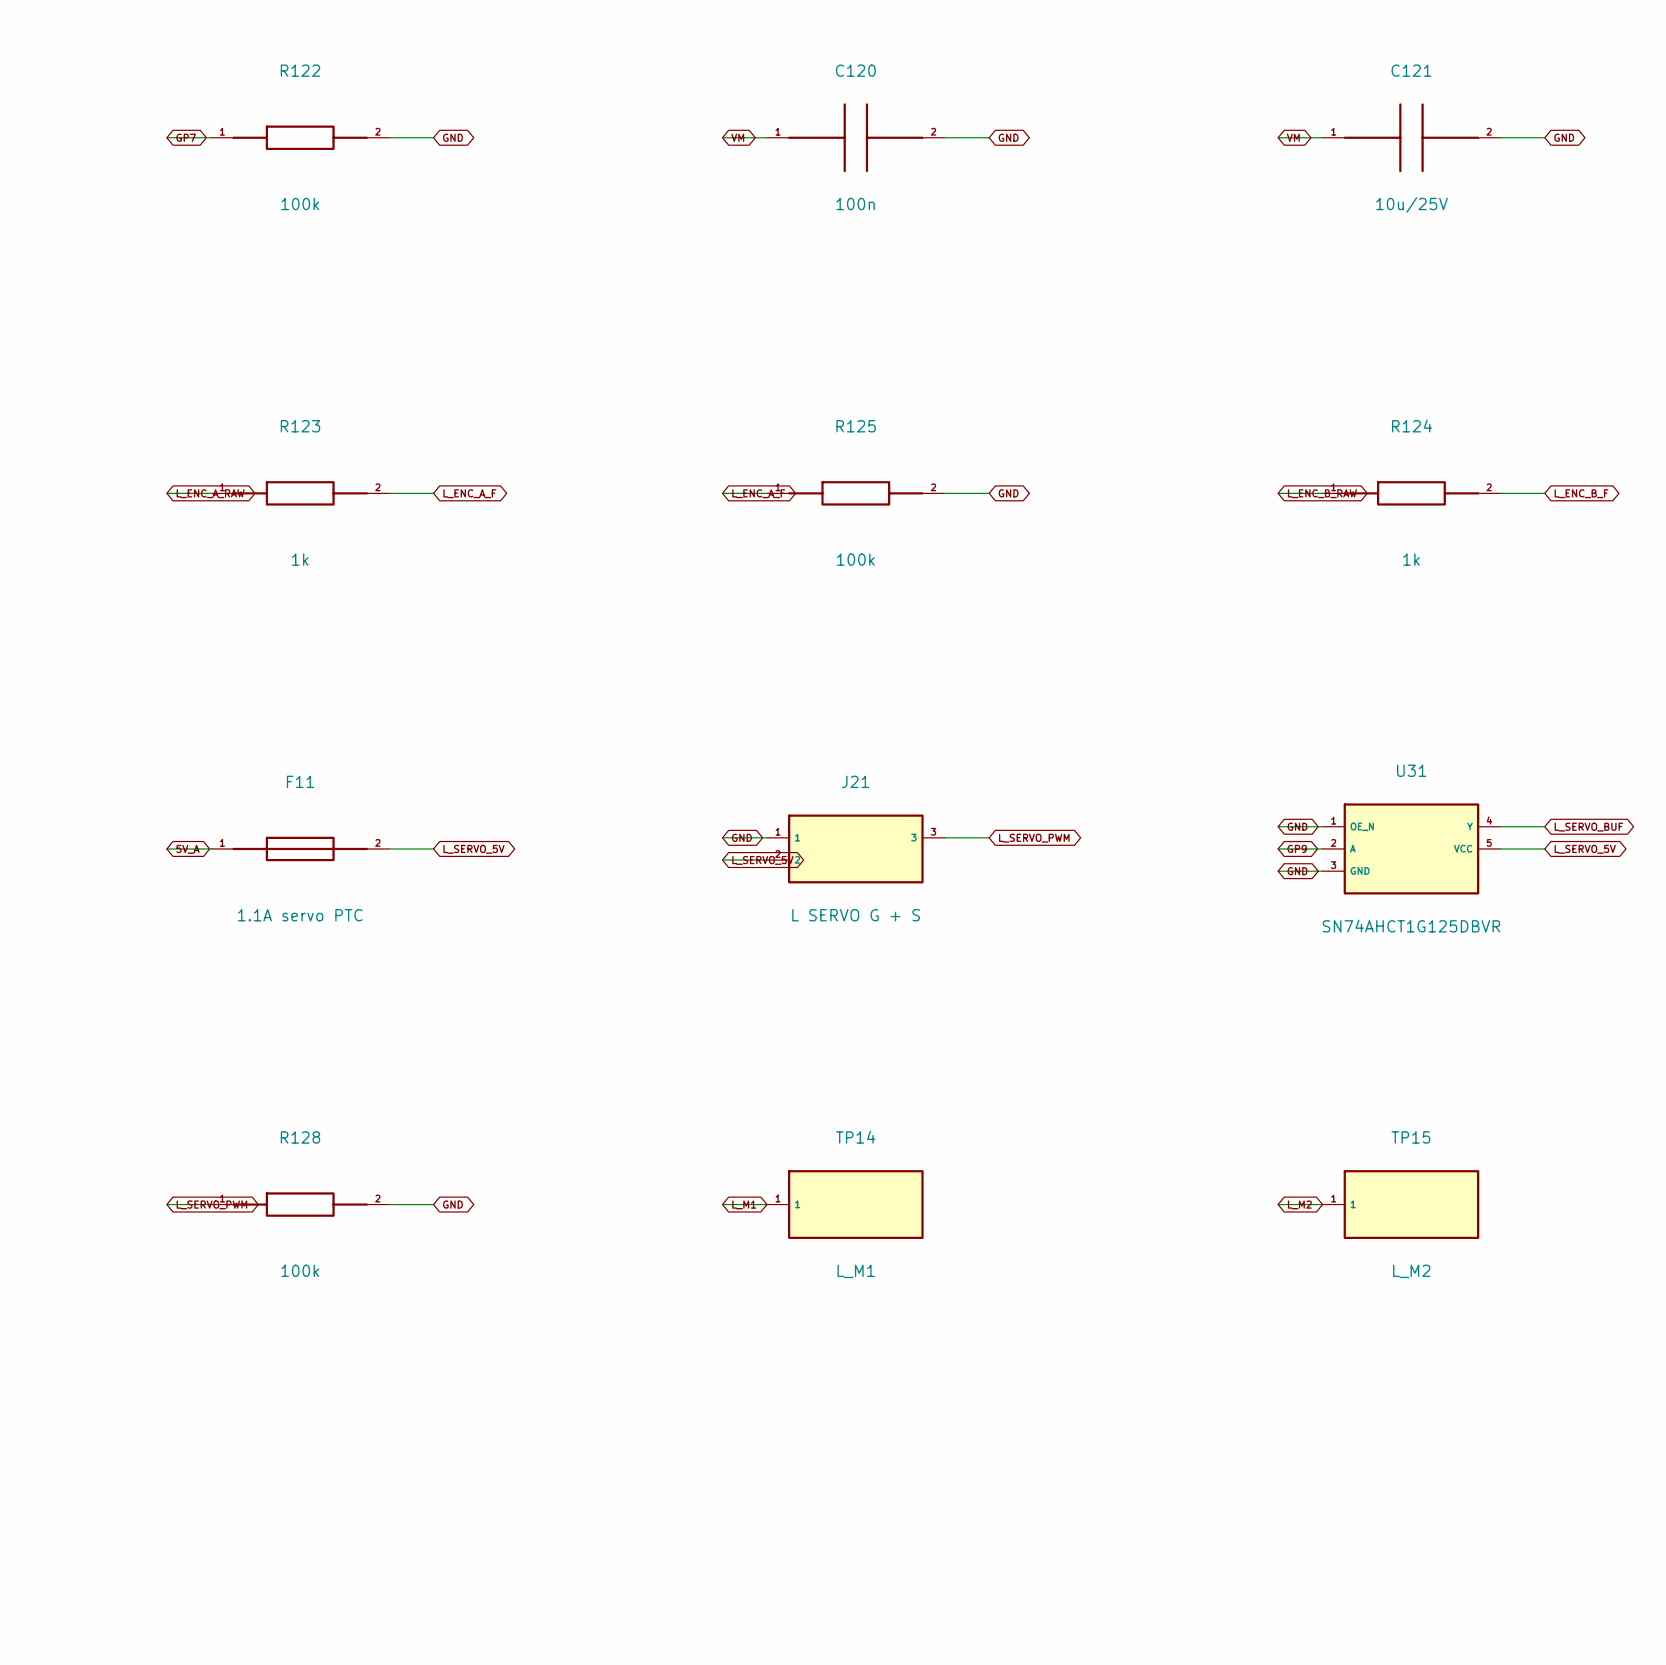
[picture p370: schematic arm_L.kicad_sch, Quadcuber A1 / arm_L / ENGINEERING HOLD, part in row 1, column 2]

Parts:
C120, C123, C124, C125: 100n; C_0805_2012Metric; MPN GRM21BR71H104KA01L
C121: 10u/25V; C_1210_3225Metric; MPN GRM32DR71E106KA12L
C122: 470u/25V; CP_Radial_D10.0mm_P5.00mm; MPN EEU-FR1E471
F11: 1.1A servo PTC; Fuse_Bourns_MF_MSMF_Style2_1812; MPN MF-MSMF110/16X-2
J11: EV3 L PINMAP HOLD; EV3_UserDrawing_PINMAP_HOLD; MPN UNCONFIRMED user drawing
J21: L SERVO G + S; PinHeader_1x03_P2.54mm_Vertical; MPN 61300311121
R120: 43.2k; R_0603_1608Metric; MPN RC0603FR-0743K2L
R121, R122, R125, R126, R128, R129: 100k; R_0603_1608Metric; MPN RC0603FR-07100KL
R123, R124: 1k; R_0603_1608Metric; MPN RC0603FR-071KL
R127: 220; R_0603_1608Metric; MPN RC0603FR-07220RL
TP14: L_M1; TestPoint_Pad_D1.5mm; MPN N/A PCB copper
TP15: L_M2; TestPoint_Pad_D1.5mm; MPN N/A PCB copper
TP16: GP12; TestPoint_Pad_D1.5mm; MPN N/A PCB copper
TP17: GP13; TestPoint_Pad_D1.5mm; MPN N/A PCB copper
U11: DRV8871DDAR; Texas_HTSOP-8-1EP_3.9x4.9mm_P1.27mm_EP2.95x4.9mm_Mask2.4x3.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; MPN DRV8871DDAR
U21: SN74LVC2G17DBVR; SOT-23-6; MPN SN74LVC2G17DBVR
U31: SN74AHCT1G125DBVR; SOT-23-5; MPN SN74AHCT1G125DBVR

Connections:
3V3: C123.1, U21.5 (VCC); also elsewhere on the board
5V_A: F11.1; also elsewhere on the board
5V_ENC: C124.1, J11.4 (+5V); also elsewhere on the board
GND: C120.2, C121.2, C122.2 (-), C123.2, C124.2, C125.2, J11.3 (GND), J21.1, R120.2, R121.2, R122.2, R125.2, R126.2, R128.2, R129.2, U11.1 (GND), U11.7 (PGND), U11.9 (EP_GND), U21.2 (GND), U31.1 (OE_N), U31.3 (GND); also elsewhere on the board
GP6: R121.1, U11.3 (IN1); also elsewhere on the board
GP7: R122.1, U11.2 (IN2); also elsewhere on the board
GP9: R129.1, U31.2 (A); also elsewhere on the board
GP12: TP16.1, U21.6 (1Y); also elsewhere on the board
GP13: TP17.1, U21.4 (2Y); also elsewhere on the board
L_ENC_A_F: R123.2, R125.1, U21.1 (1A)
L_ENC_A_RAW: J11.5 (TACHO0), R123.1
L_ENC_B_F: R124.2, R126.1, U21.3 (2A)
L_ENC_B_RAW: J11.6 (TACHO1), R124.1
L_ILIM: R120.1, U11.4 (ILIM)
L_M1: J11.1 (M1), TP14.1, U11.6 (OUT1)
L_M2: J11.2 (M2), TP15.1, U11.8 (OUT2)
L_SERVO_5V: C125.1, F11.2, J21.2, U31.5 (VCC)
L_SERVO_BUF: R127.1, U31.4 (Y)
L_SERVO_PWM: J21.3, R127.2, R128.1
VM: C120.1, C121.1, C122.1 (+), U11.5 (VM); also elsewhere on the board

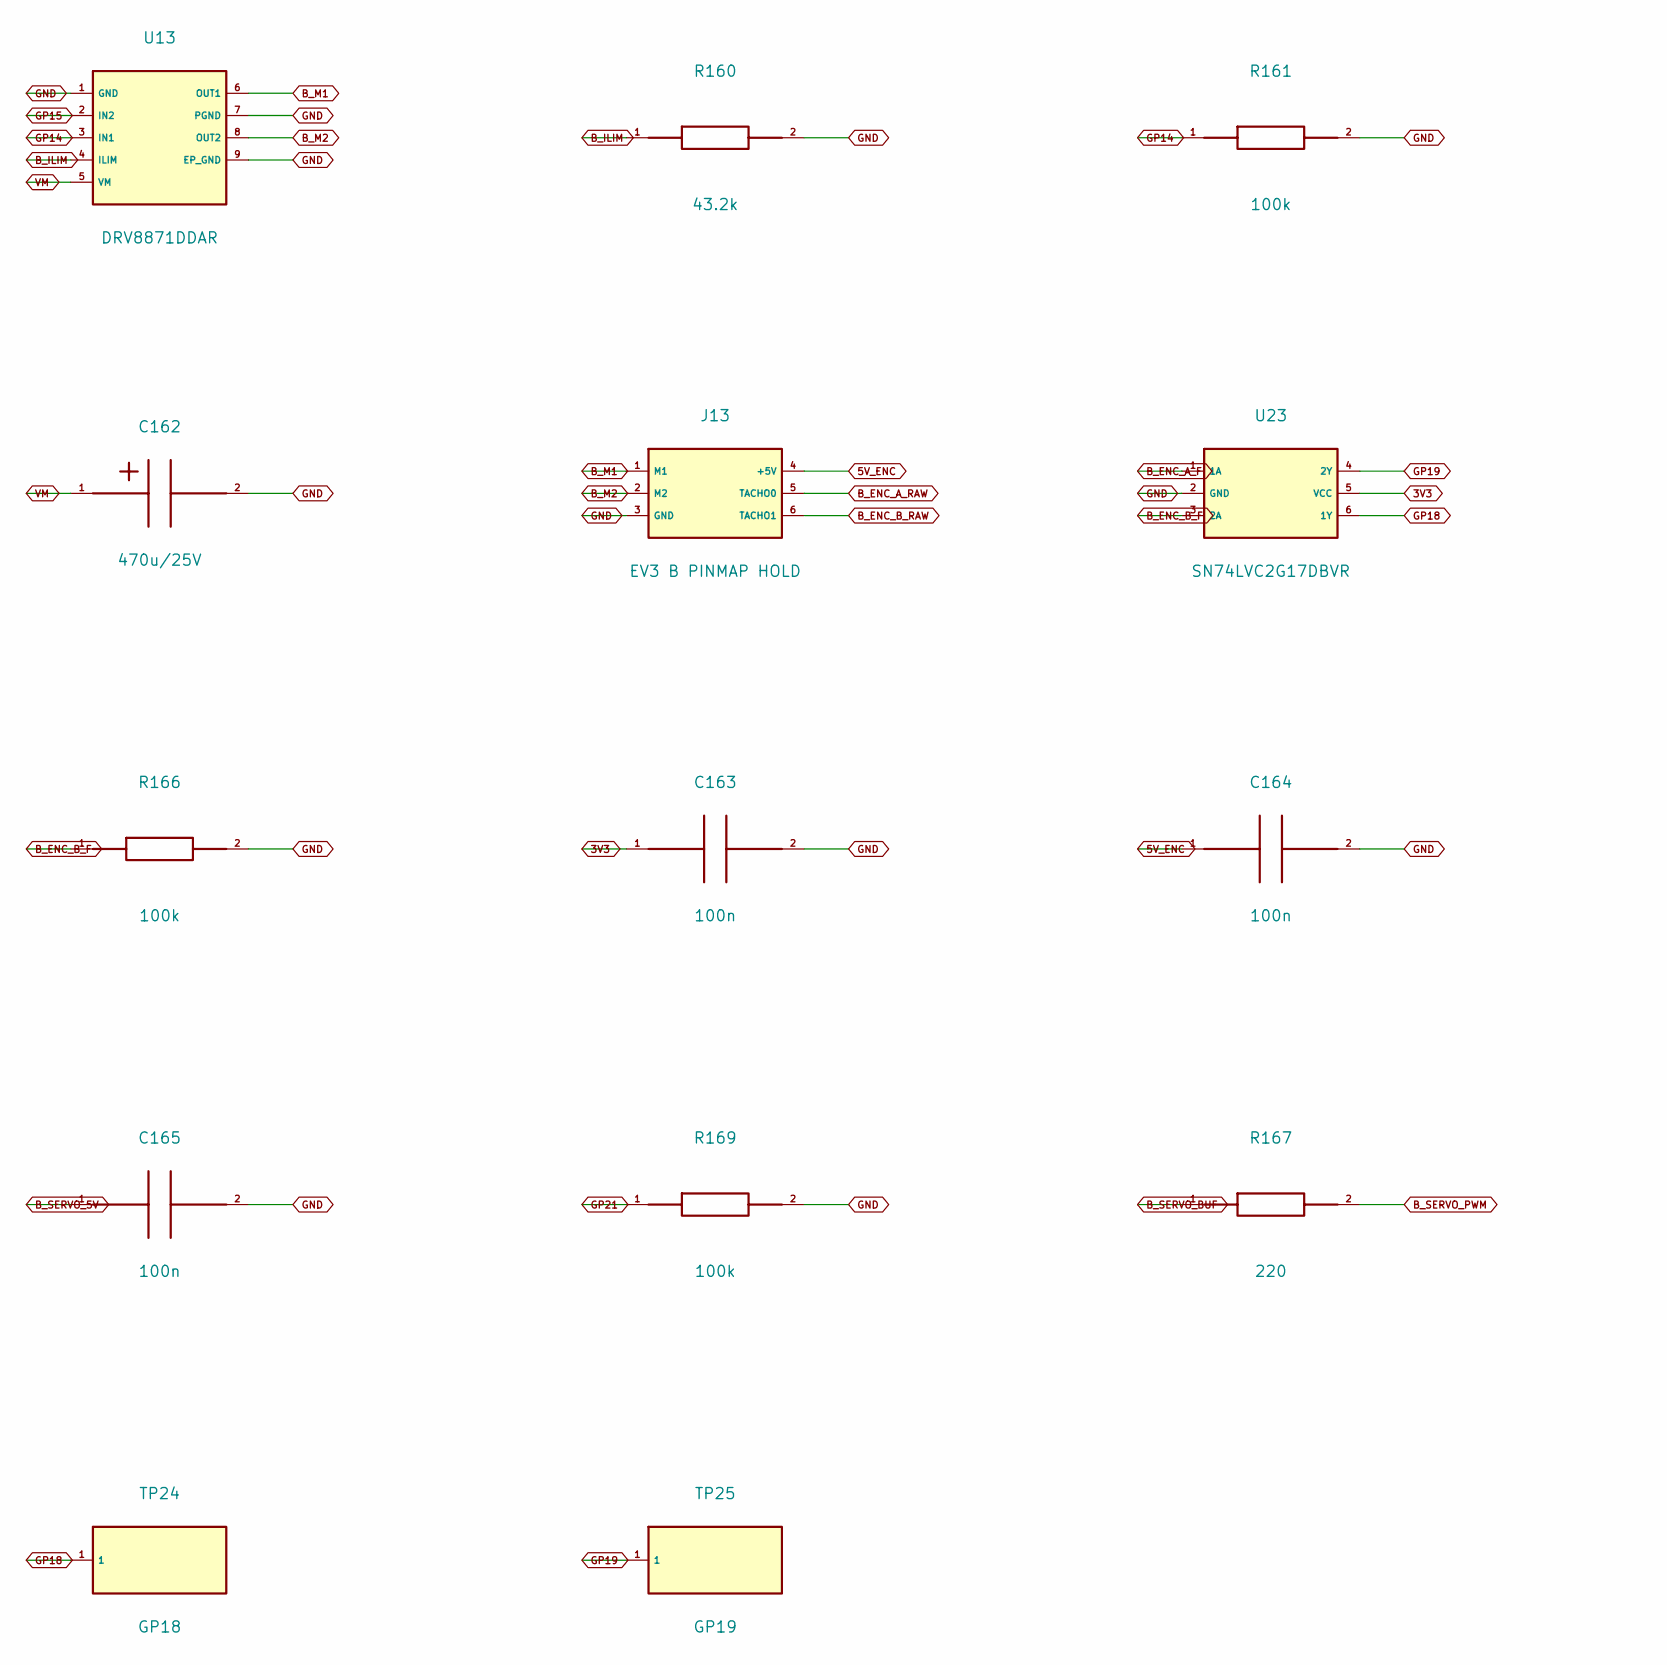
[picture p371: schematic arm_B.kicad_sch, Quadcuber A1 / arm_B / ENGINEERING HOLD, part in row 1, column 1]

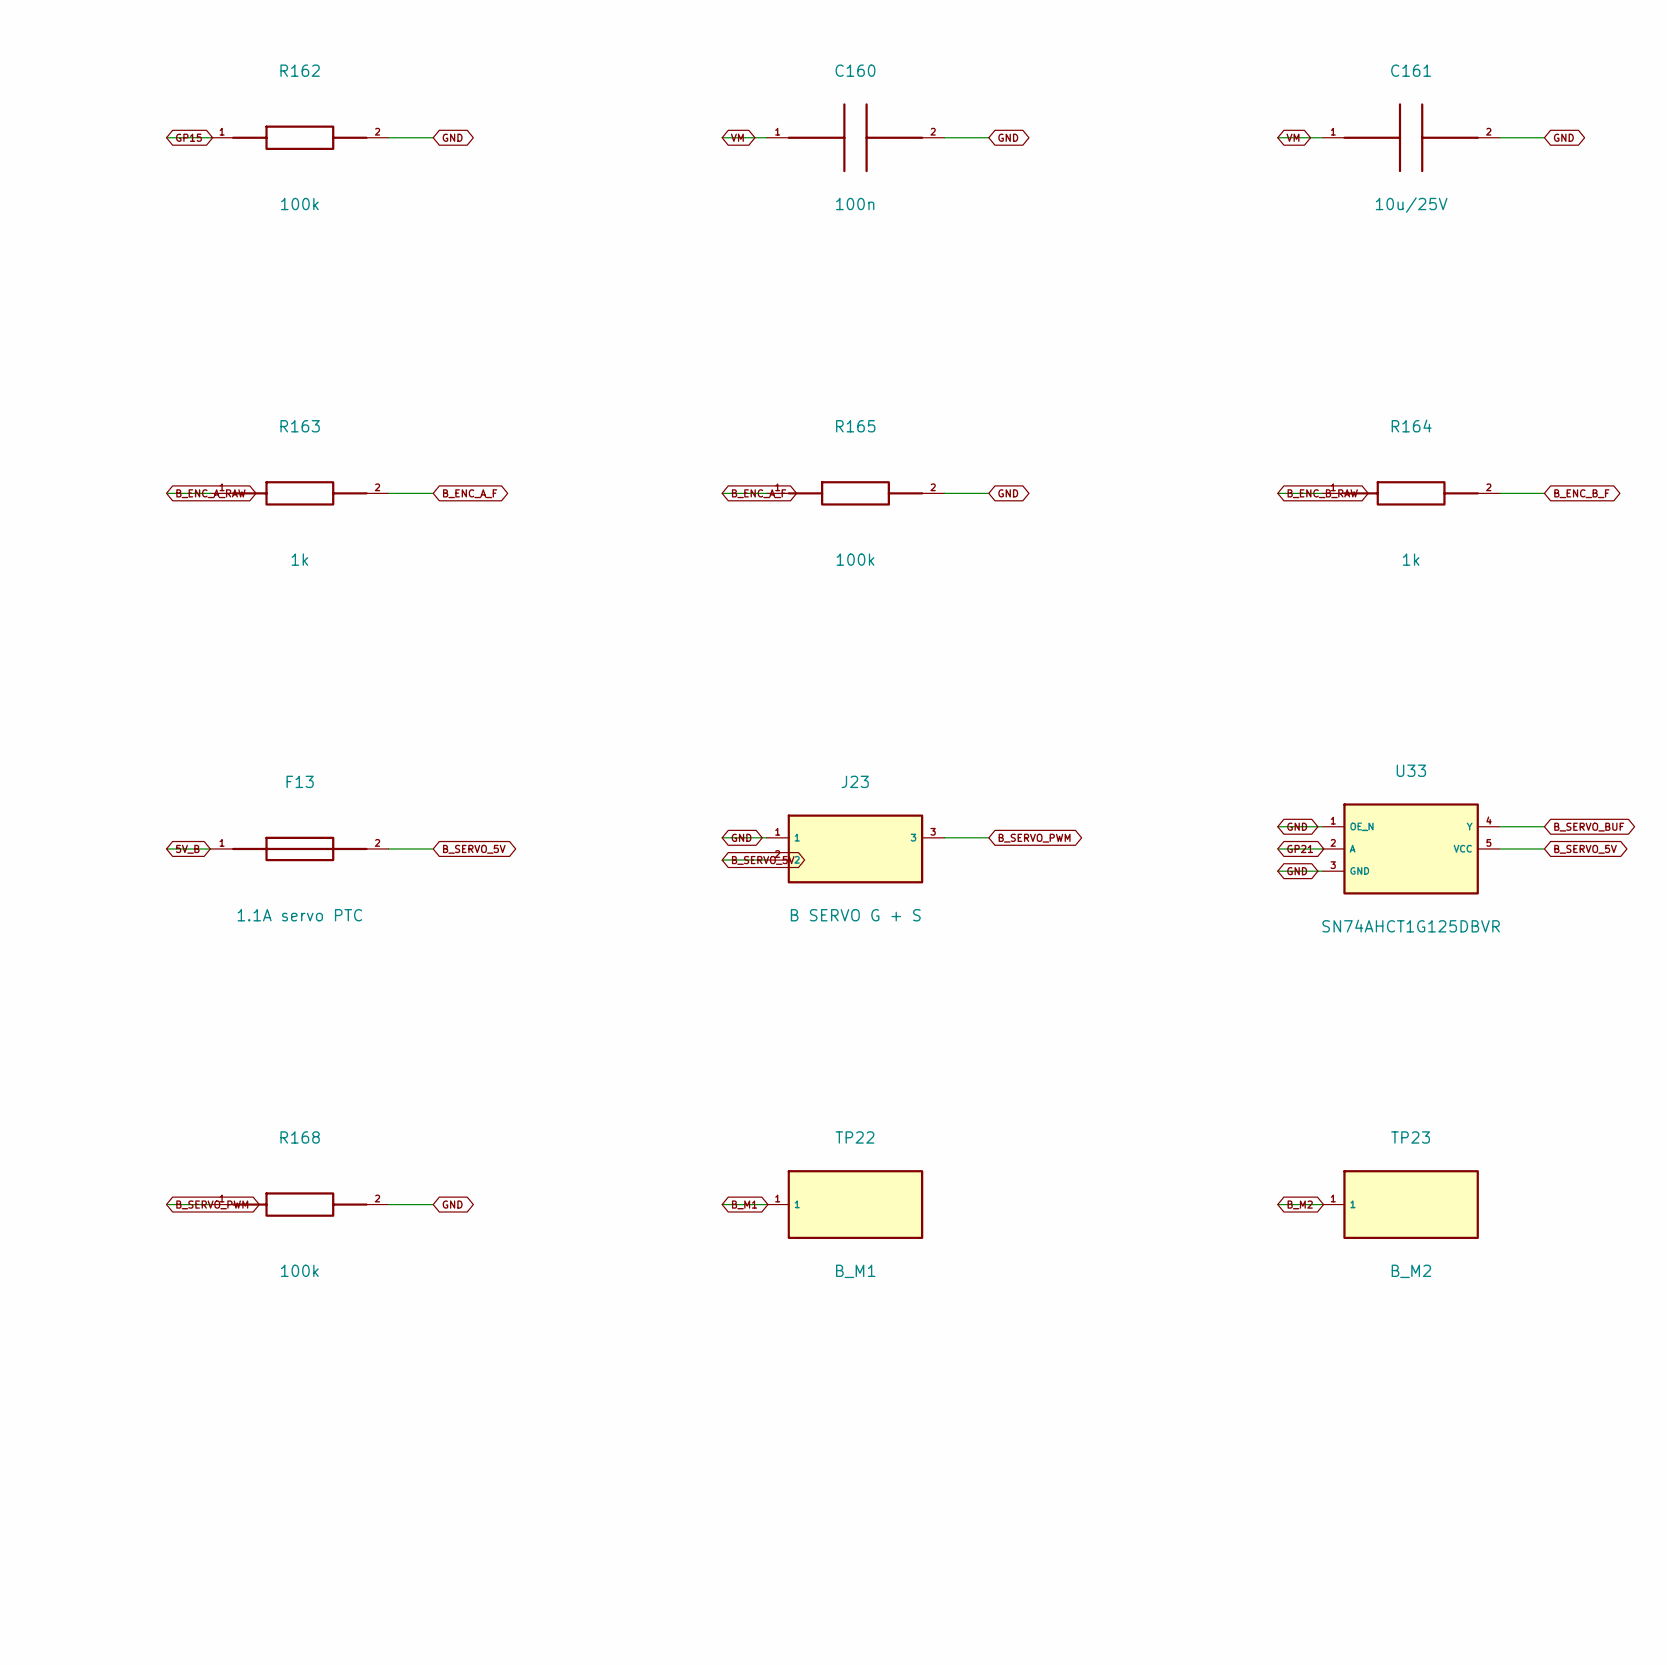
[picture p372: schematic arm_B.kicad_sch, Quadcuber A1 / arm_B / ENGINEERING HOLD, part in row 1, column 2]

Parts:
C160, C163, C164, C165: 100n; C_0805_2012Metric; MPN GRM21BR71H104KA01L
C161: 10u/25V; C_1210_3225Metric; MPN GRM32DR71E106KA12L
C162: 470u/25V; CP_Radial_D10.0mm_P5.00mm; MPN EEU-FR1E471
F13: 1.1A servo PTC; Fuse_Bourns_MF_MSMF_Style2_1812; MPN MF-MSMF110/16X-2
J13: EV3 B PINMAP HOLD; EV3_UserDrawing_PINMAP_HOLD; MPN UNCONFIRMED user drawing
J23: B SERVO G + S; PinHeader_1x03_P2.54mm_Vertical; MPN 61300311121
R160: 43.2k; R_0603_1608Metric; MPN RC0603FR-0743K2L
R161, R162, R165, R166, R168, R169: 100k; R_0603_1608Metric; MPN RC0603FR-07100KL
R163, R164: 1k; R_0603_1608Metric; MPN RC0603FR-071KL
R167: 220; R_0603_1608Metric; MPN RC0603FR-07220RL
TP22: B_M1; TestPoint_Pad_D1.5mm; MPN N/A PCB copper
TP23: B_M2; TestPoint_Pad_D1.5mm; MPN N/A PCB copper
TP24: GP18; TestPoint_Pad_D1.5mm; MPN N/A PCB copper
TP25: GP19; TestPoint_Pad_D1.5mm; MPN N/A PCB copper
U13: DRV8871DDAR; Texas_HTSOP-8-1EP_3.9x4.9mm_P1.27mm_EP2.95x4.9mm_Mask2.4x3.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; MPN DRV8871DDAR
U23: SN74LVC2G17DBVR; SOT-23-6; MPN SN74LVC2G17DBVR
U33: SN74AHCT1G125DBVR; SOT-23-5; MPN SN74AHCT1G125DBVR

Connections:
3V3: C163.1, U23.5 (VCC); also elsewhere on the board
5V_B: F13.1; also elsewhere on the board
5V_ENC: C164.1, J13.4 (+5V); also elsewhere on the board
B_ENC_A_F: R163.2, R165.1, U23.1 (1A)
B_ENC_A_RAW: J13.5 (TACHO0), R163.1
B_ENC_B_F: R164.2, R166.1, U23.3 (2A)
B_ENC_B_RAW: J13.6 (TACHO1), R164.1
B_ILIM: R160.1, U13.4 (ILIM)
B_M1: J13.1 (M1), TP22.1, U13.6 (OUT1)
B_M2: J13.2 (M2), TP23.1, U13.8 (OUT2)
B_SERVO_5V: C165.1, F13.2, J23.2, U33.5 (VCC)
B_SERVO_BUF: R167.1, U33.4 (Y)
B_SERVO_PWM: J23.3, R167.2, R168.1
GND: C160.2, C161.2, C162.2 (-), C163.2, C164.2, C165.2, J13.3 (GND), J23.1, R160.2, R161.2, R162.2, R165.2, R166.2, R168.2, R169.2, U13.1 (GND), U13.7 (PGND), U13.9 (EP_GND), U23.2 (GND), U33.1 (OE_N), U33.3 (GND); also elsewhere on the board
GP14: R161.1, U13.3 (IN1); also elsewhere on the board
GP15: R162.1, U13.2 (IN2); also elsewhere on the board
GP18: TP24.1, U23.6 (1Y); also elsewhere on the board
GP19: TP25.1, U23.4 (2Y); also elsewhere on the board
GP21: R169.1, U33.2 (A); also elsewhere on the board
VM: C160.1, C161.1, C162.1 (+), U13.5 (VM); also elsewhere on the board
