gonewx/quadcuber/electronics/quadcuber.kicad_pcb

## KiCad design electronics/quadcuber.kicad_pcb (continued)

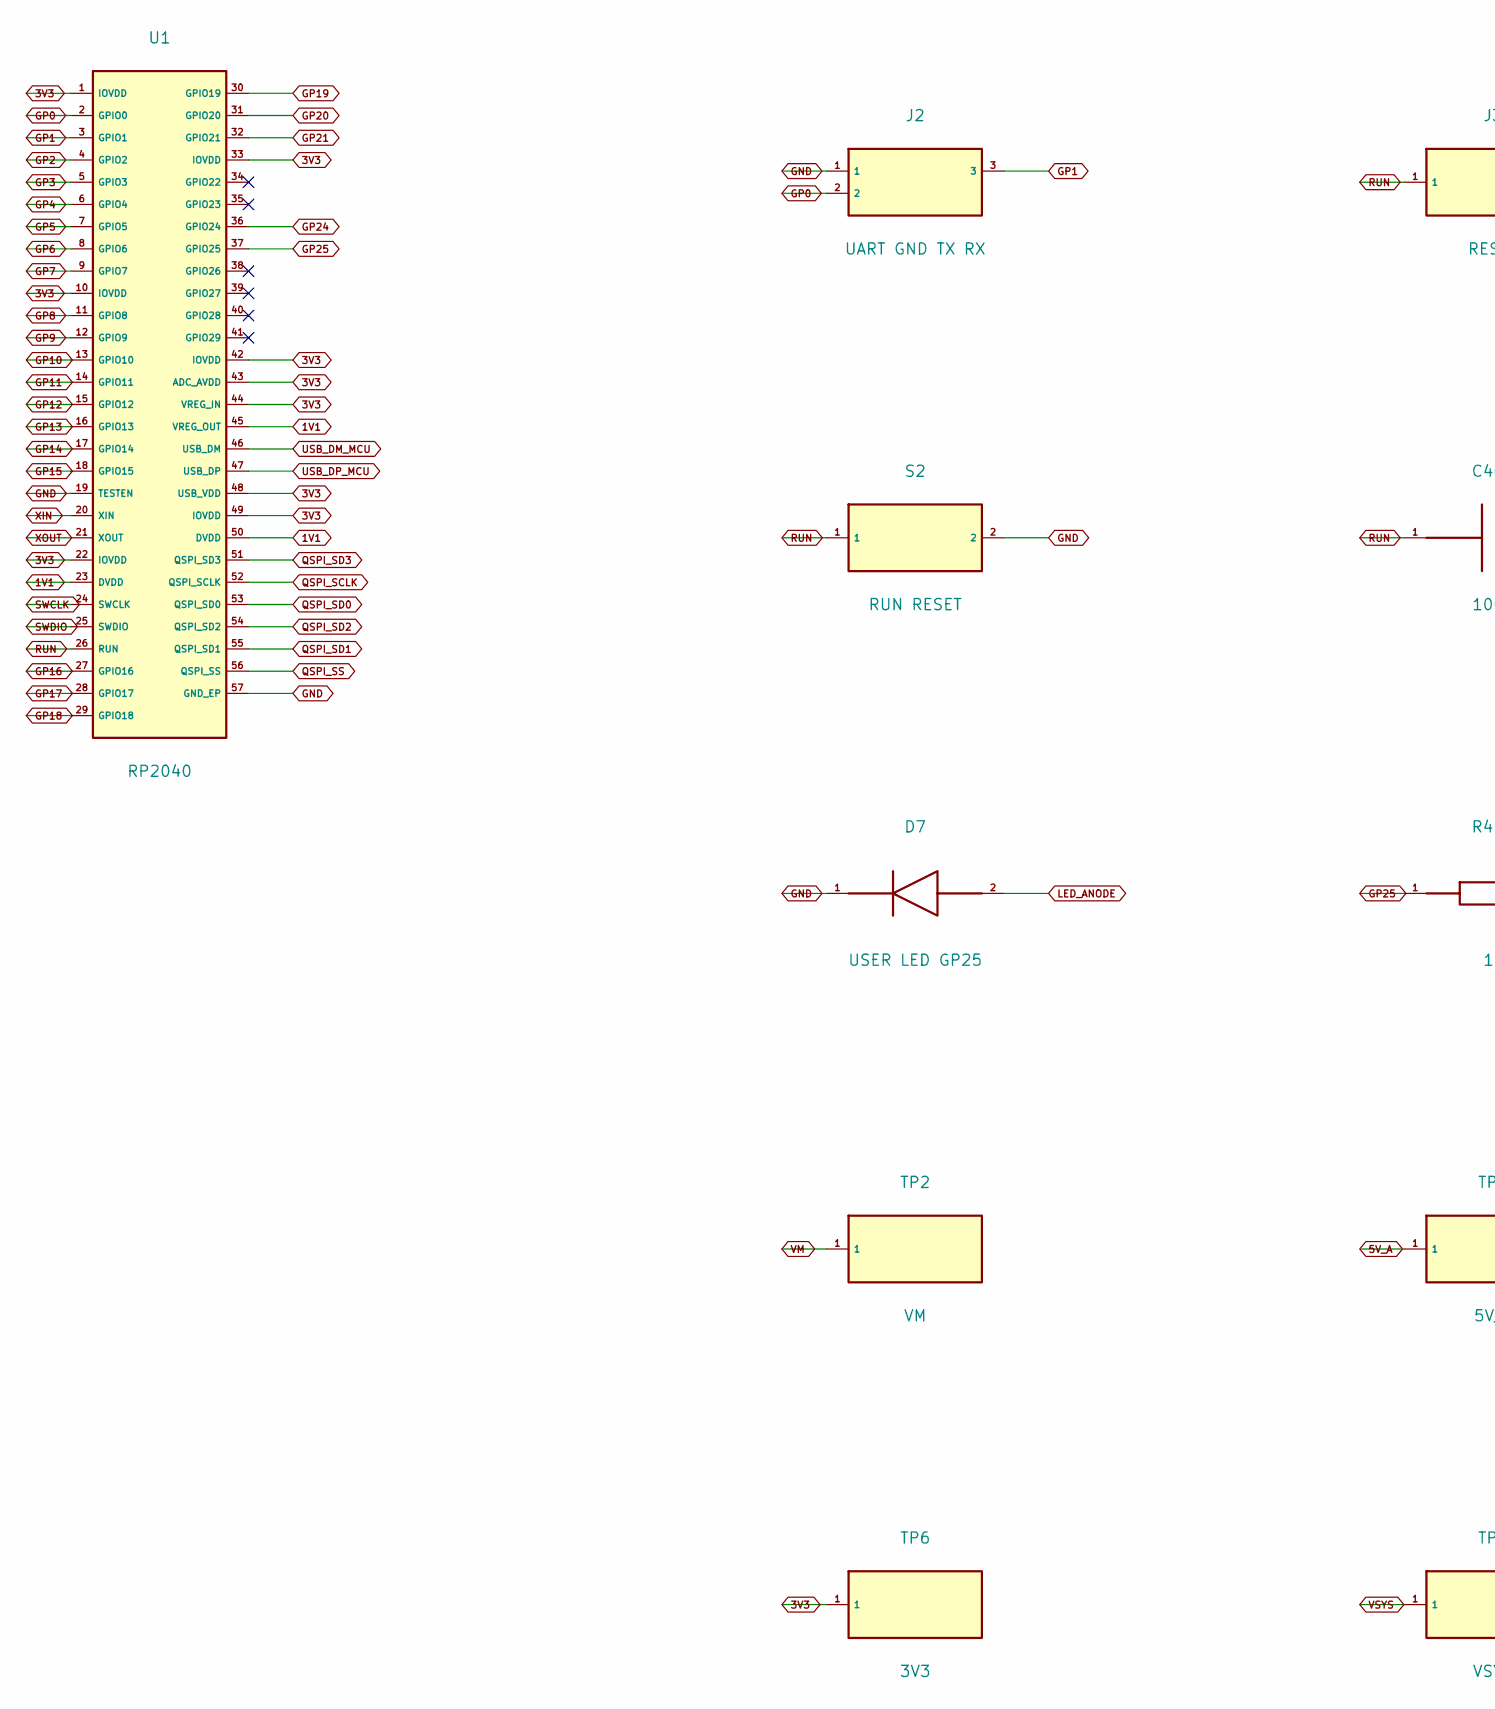
[picture p373: schematic controller.kicad_sch, Quadcuber A1 / controller / ENGINEERING HOLD, part in row 1, column 1]

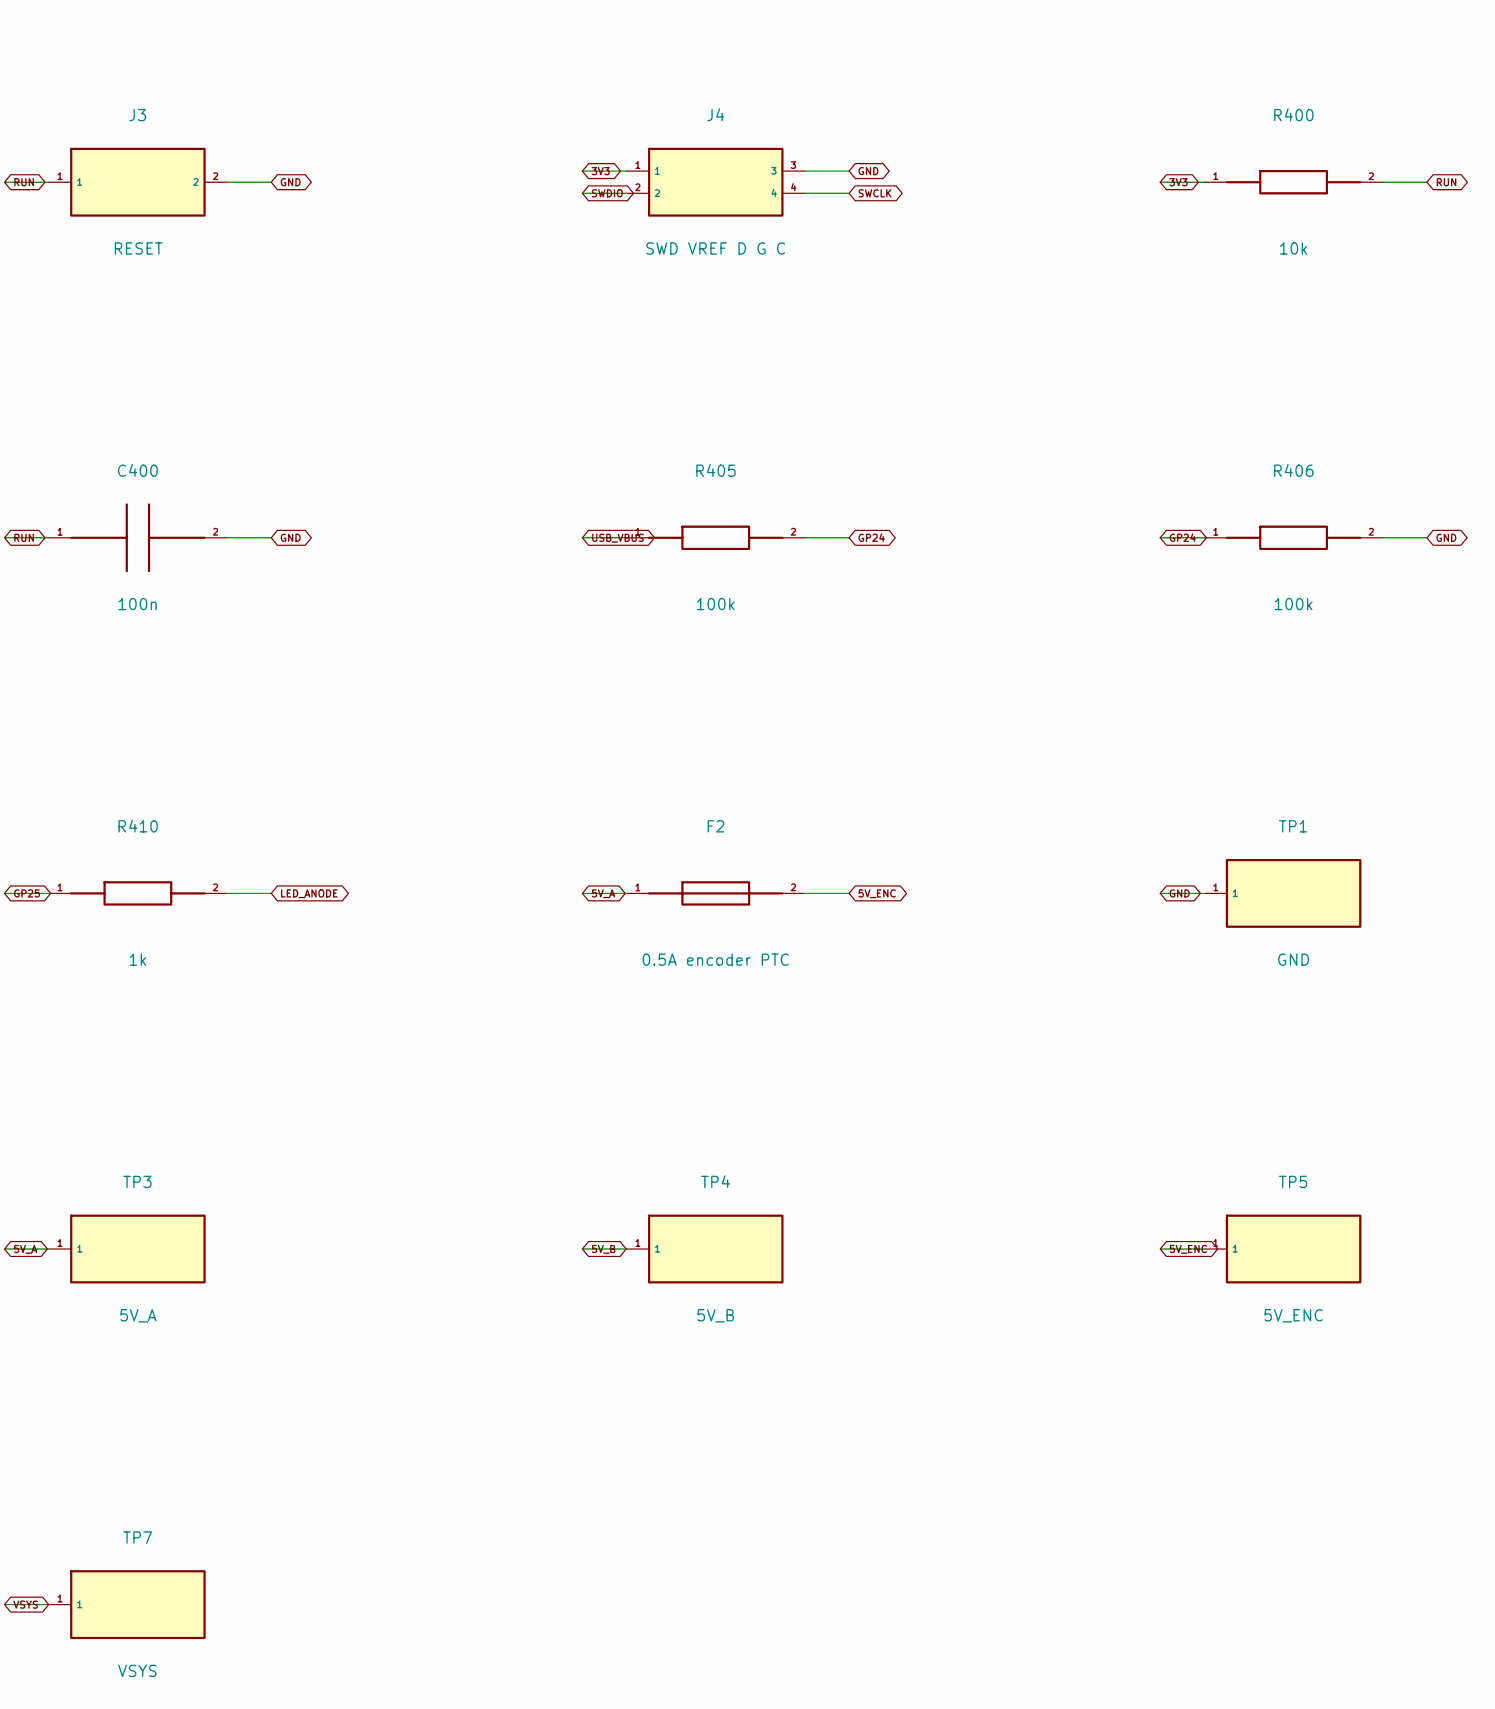
[picture p374: schematic controller.kicad_sch, Quadcuber A1 / controller / ENGINEERING HOLD, part in row 1, column 2]

Parts:
C400: 100n; C_0402_1005Metric; MPN GRM155R71C104KA88D
D7: USER LED GP25; LED_0603_1608Metric; MPN LTST-C190KGKT
F2: 0.5A encoder PTC; Fuse_1812_4532Metric; MPN MF-MSMF050-2
J2: UART GND TX RX; PinHeader_1x03_P2.54mm_Vertical; MPN 61300311121
J3: RESET; PinHeader_1x02_P2.54mm_Vertical; MPN 61300211121
J4: SWD VREF D G C; PinHeader_1x04_P2.54mm_Vertical; MPN 61300411121
R400: 10k; R_0603_1608Metric; MPN RC0603FR-0710KL
R405, R406: 100k; R_0603_1608Metric; MPN RC0603FR-07100KL
R410: 1k; R_0603_1608Metric; MPN RC0603FR-071KL
S2: RUN RESET; SW_SPST_TL3342; MPN TL3342F160QG
TP1: GND; TestPoint_Pad_D2.0mm; MPN N/A PCB copper
TP2: VM; TestPoint_Pad_D2.0mm; MPN N/A PCB copper
TP3: 5V_A; TestPoint_Pad_D2.0mm; MPN N/A PCB copper
TP4: 5V_B; TestPoint_Pad_D2.0mm; MPN N/A PCB copper
TP5: 5V_ENC; TestPoint_Pad_D2.0mm; MPN N/A PCB copper
TP6: 3V3; TestPoint_Pad_D2.0mm; MPN N/A PCB copper
TP7: VSYS; TestPoint_Pad_D2.0mm; MPN N/A PCB copper
U1: RP2040; QFN-56-1EP_7x7mm_P0.4mm_EP3.2x3.2mm_ThermalVias; MPN RP2040

Connections:
1V1: U1.23 (DVDD), U1.45 (VREG_OUT), U1.50 (DVDD); also elsewhere on the board
3V3: J4.1, R400.1, TP6.1, U1.1 (IOVDD), U1.10 (IOVDD), U1.22 (IOVDD), U1.33 (IOVDD), U1.42 (IOVDD), U1.43 (ADC_AVDD), U1.44 (VREG_IN), U1.48 (USB_VDD), U1.49 (IOVDD); also elsewhere on the board
5V_A: F2.1, TP3.1; also elsewhere on the board
5V_B: TP4.1; also elsewhere on the board
5V_ENC: F2.2, TP5.1; also elsewhere on the board
GND: C400.2, D7.1 (K), J2.1, J3.2, J4.3, R406.2, S2.2, TP1.1, U1.19 (TESTEN), U1.57 (GND_EP); also elsewhere on the board
GP0: J2.2, U1.2 (GPIO0)
GP1: J2.3, U1.3 (GPIO1)
GP2: U1.4 (GPIO2); also elsewhere on the board
GP3: U1.5 (GPIO3); also elsewhere on the board
GP4: U1.6 (GPIO4); also elsewhere on the board
GP5: U1.7 (GPIO5); also elsewhere on the board
GP6: U1.8 (GPIO6); also elsewhere on the board
GP7: U1.9 (GPIO7); also elsewhere on the board
GP8: U1.11 (GPIO8); also elsewhere on the board
GP9: U1.12 (GPIO9); also elsewhere on the board
GP10: U1.13 (GPIO10); also elsewhere on the board
GP11: U1.14 (GPIO11); also elsewhere on the board
GP12: U1.15 (GPIO12); also elsewhere on the board
GP13: U1.16 (GPIO13); also elsewhere on the board
GP14: U1.17 (GPIO14); also elsewhere on the board
GP15: U1.18 (GPIO15); also elsewhere on the board
GP16: U1.27 (GPIO16); also elsewhere on the board
GP17: U1.28 (GPIO17); also elsewhere on the board
GP18: U1.29 (GPIO18); also elsewhere on the board
GP19: U1.30 (GPIO19); also elsewhere on the board
GP20: U1.31 (GPIO20); also elsewhere on the board
GP21: U1.32 (GPIO21); also elsewhere on the board
GP24: R405.2, R406.1, U1.36 (GPIO24)
GP25: R410.1, U1.37 (GPIO25)
LED_ANODE: D7.2 (A), R410.2
QSPI_SCLK: U1.52 (QSPI_SCLK); also elsewhere on the board
QSPI_SD0: U1.53 (QSPI_SD0); also elsewhere on the board
QSPI_SD1: U1.55 (QSPI_SD1); also elsewhere on the board
QSPI_SD2: U1.54 (QSPI_SD2); also elsewhere on the board
QSPI_SD3: U1.51 (QSPI_SD3); also elsewhere on the board
QSPI_SS: U1.56 (QSPI_SS); also elsewhere on the board
RUN: C400.1, J3.1, R400.2, S2.1, U1.26 (RUN)
SWCLK: J4.4, U1.24 (SWCLK)
SWDIO: J4.2, U1.25 (SWDIO)
USB_DM_MCU: U1.46 (USB_DM); also elsewhere on the board
USB_DP_MCU: U1.47 (USB_DP); also elsewhere on the board
USB_VBUS: R405.1; also elsewhere on the board
VM: TP2.1; also elsewhere on the board
VSYS: TP7.1; also elsewhere on the board
XIN: U1.20 (XIN); also elsewhere on the board
XOUT: U1.21 (XOUT); also elsewhere on the board

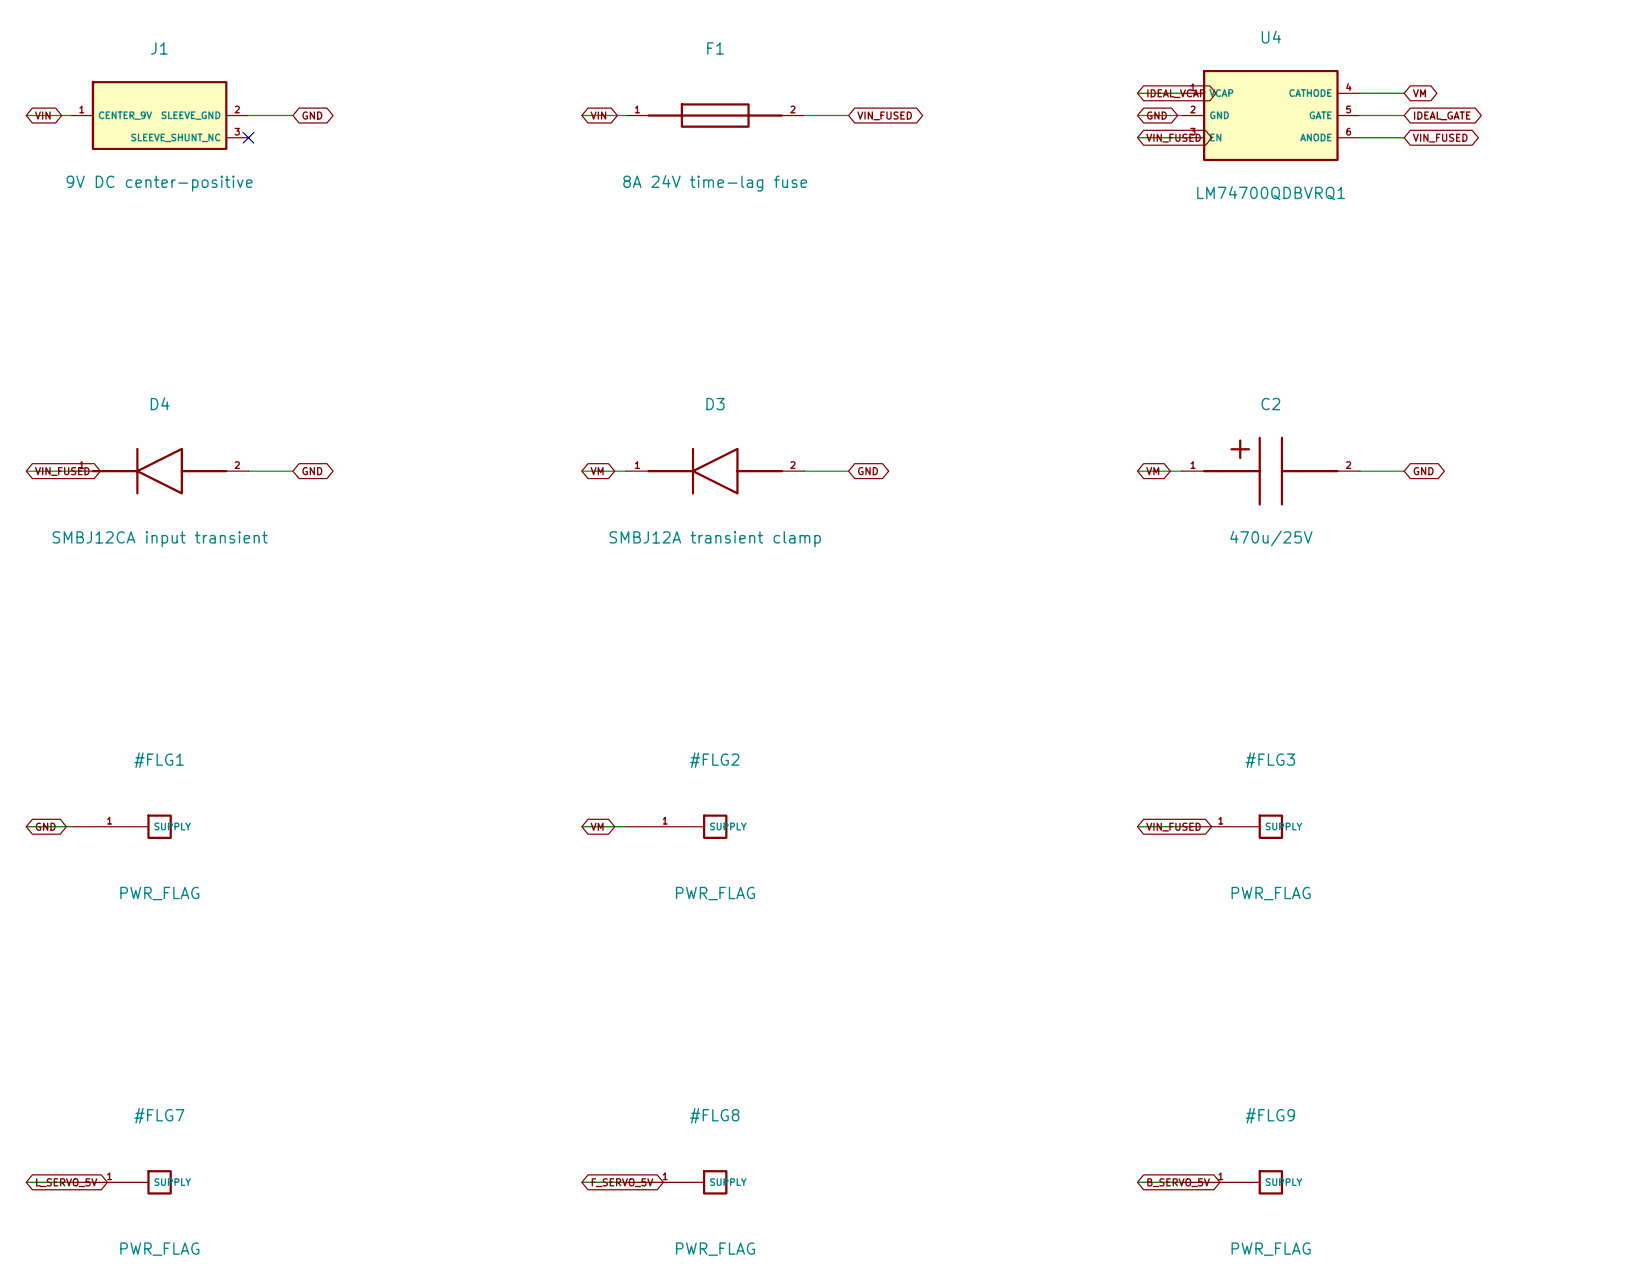
[picture p375: schematic power.kicad_sch, Quadcuber A1 / power / ENGINEERING HOLD, part in row 1, column 1]

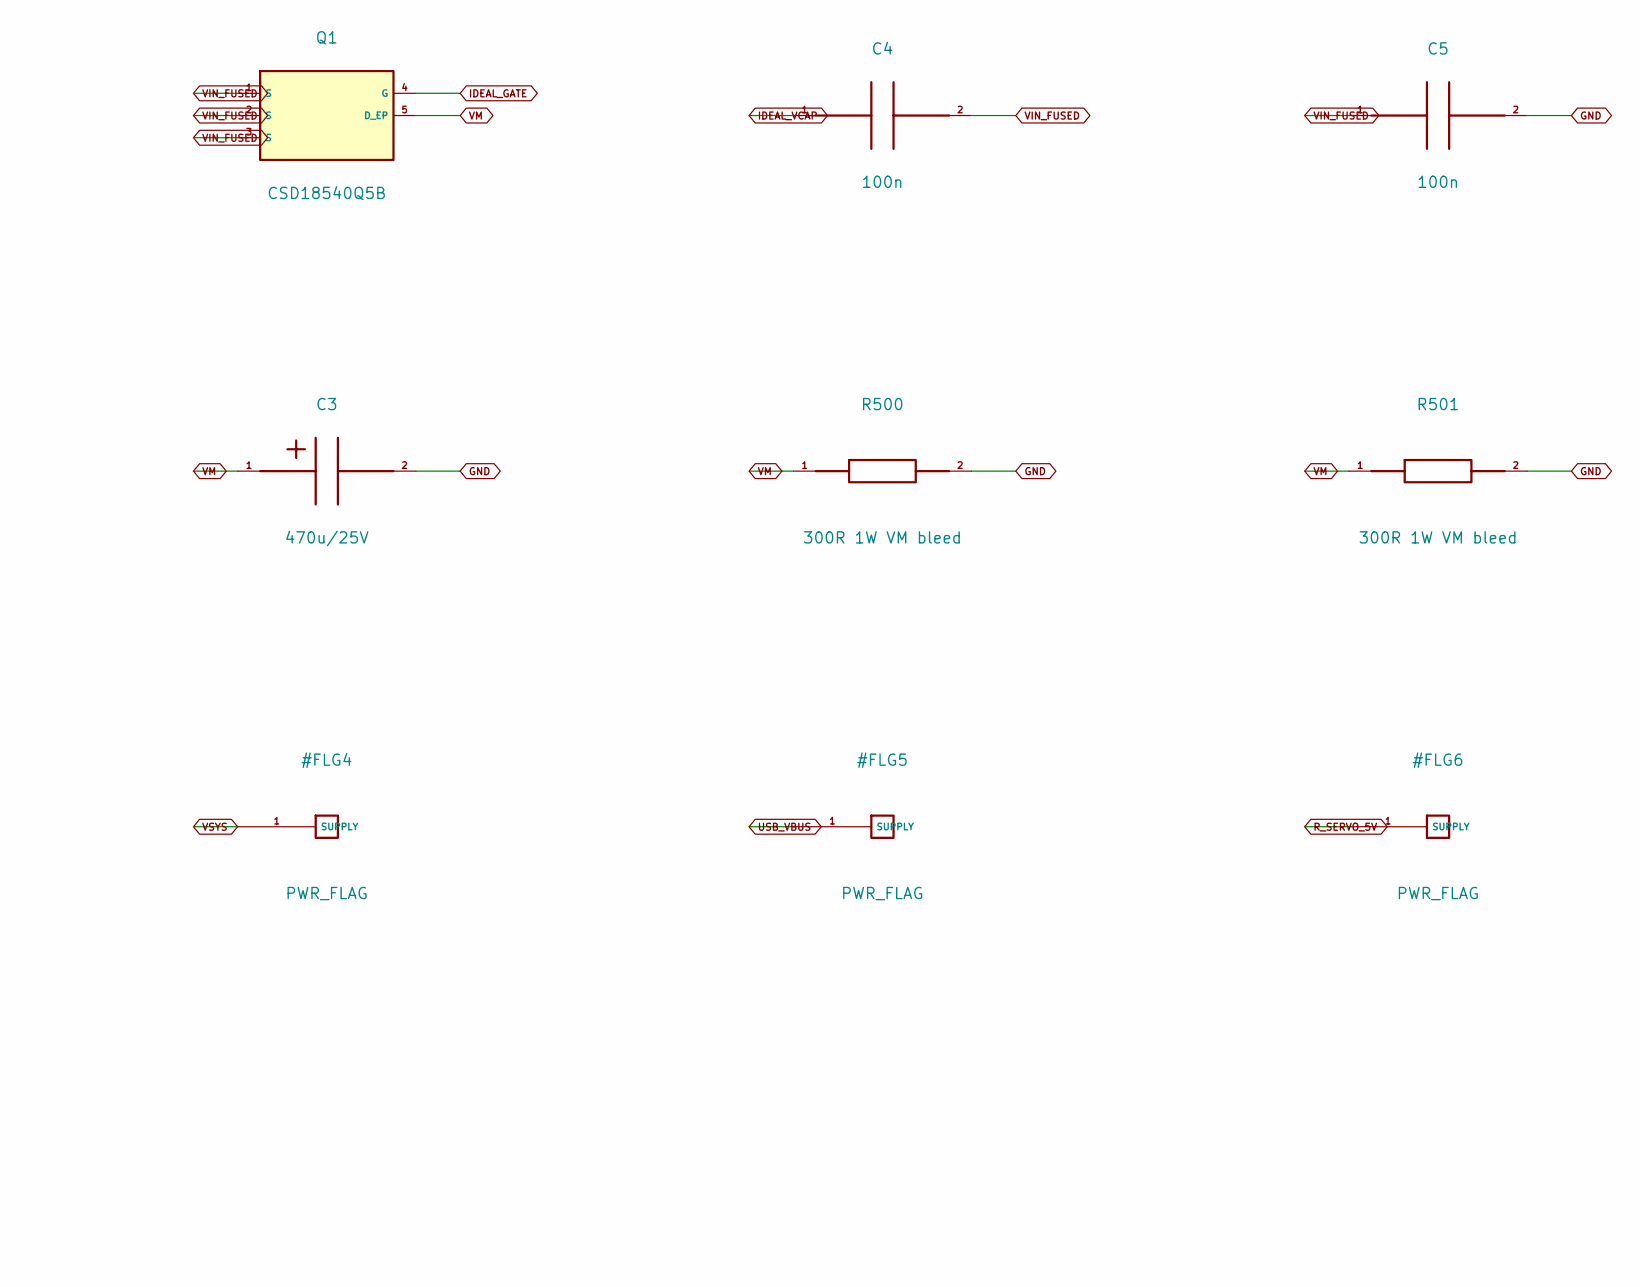
[picture p376: schematic power.kicad_sch, Quadcuber A1 / power / ENGINEERING HOLD, part in row 1, column 2]

Parts:
C2, C3: 470u/25V; CP_Radial_D10.0mm_P5.00mm; MPN EEU-FR1E471
C4, C5: 100n; C_0805_2012Metric; MPN GRM21BR71H104KA01L
D3: SMBJ12A transient clamp; D_SMB; MPN SMBJ12A
D4: SMBJ12CA input transient; D_SMB; MPN SMBJ12CA
F1: 8A 24V time-lag fuse; Fuse_Littelfuse_407_1206; MPN 0407008.WR
J1: 9V DC center-positive; Jack_DC_Switchcraft_RASPC722X; MPN RASPC722X
Q1: CSD18540Q5B; TDSON-8-1; MPN CSD18540Q5B
R500, R501: 300R 1W VM bleed; R_2512_6332Metric; MPN CRCW2512300RFKEG
U4: LM74700QDBVRQ1; SOT-23-6; MPN LM74700QDBVRQ1

Connections:
GND: C2.2 (-), C3.2 (-), C5.2, D3.2 (A), D4.2, J1.2 (SLEEVE_GND), R500.2, R501.2, U4.2 (GND); also elsewhere on the board
IDEAL_GATE: Q1.4 (G), U4.5 (GATE)
IDEAL_VCAP: C4.1, U4.1 (VCAP)
VIN: F1.1, J1.1 (CENTER_9V)
VIN_FUSED: C4.2, C5.1, D4.1, F1.2, Q1.1 (S), Q1.2 (S), Q1.3 (S), U4.3 (EN), U4.6 (ANODE)
VM: C2.1 (+), C3.1 (+), D3.1 (K), Q1.5 (D_EP), R500.1, R501.1, U4.4 (CATHODE); also elsewhere on the board

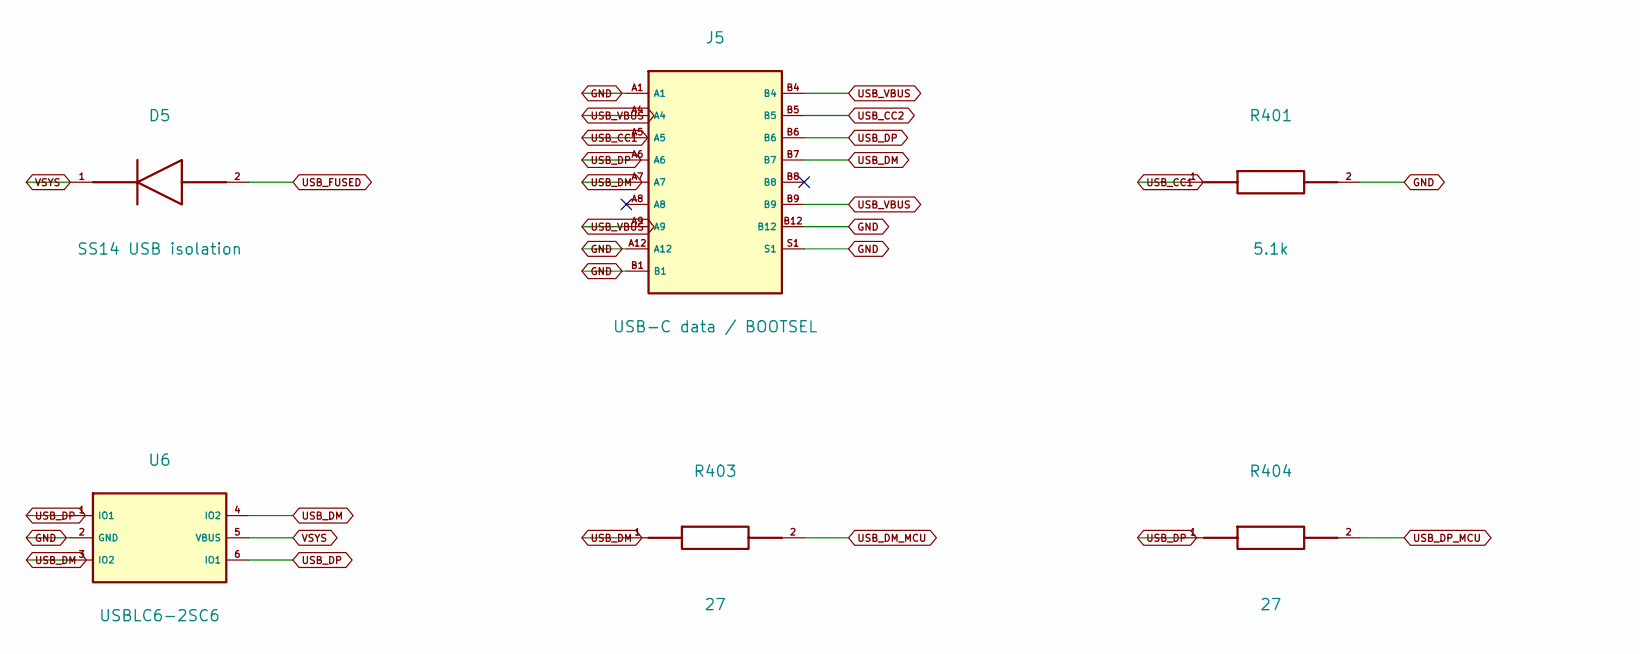
[picture p377: schematic usb.kicad_sch, Quadcuber A1 / usb / ENGINEERING HOLD, part in row 1, column 1]

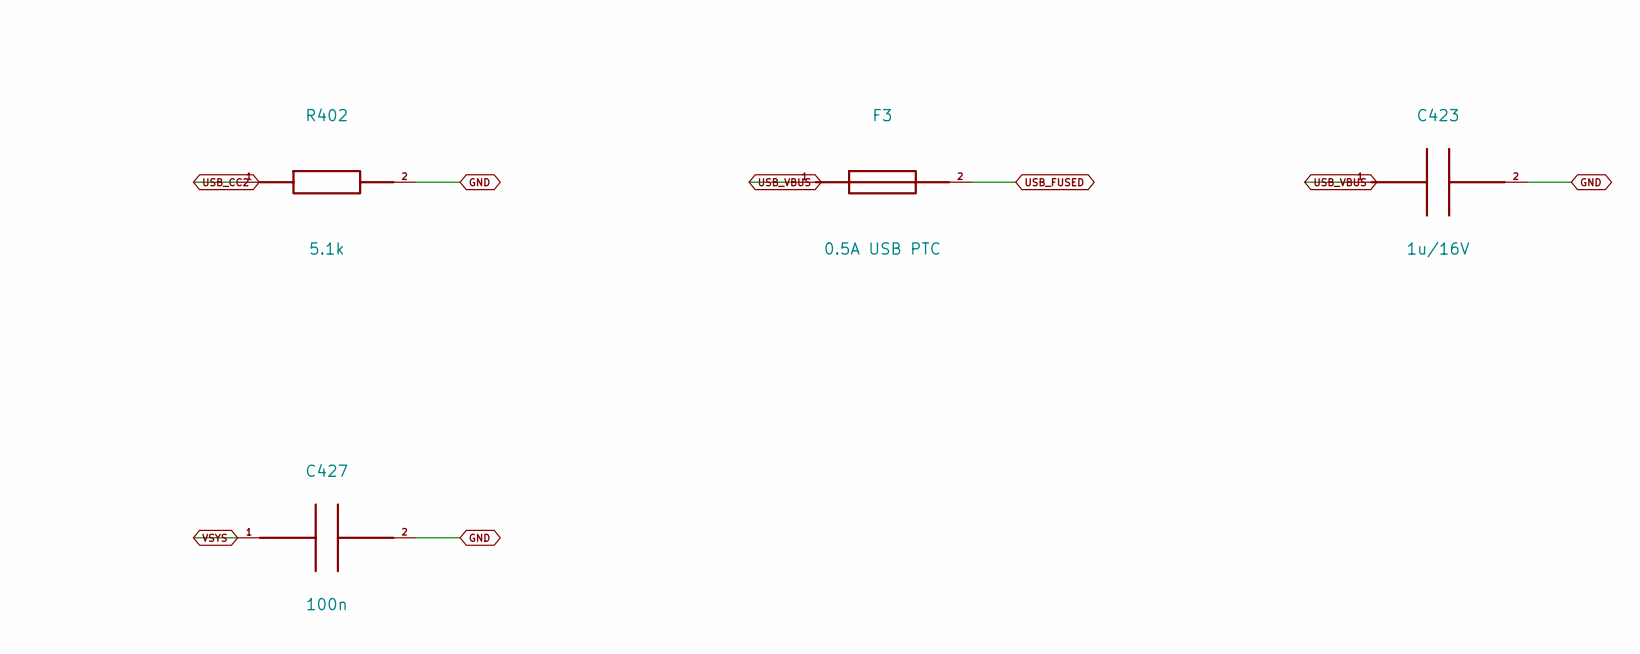
[picture p378: schematic usb.kicad_sch, Quadcuber A1 / usb / ENGINEERING HOLD, part in row 1, column 2]

Parts:
C423: 1u/16V; C_0805_2012Metric; MPN GRM21BR71C105KA01L
C427: 100n; C_0402_1005Metric; MPN GRM155R71C104KA88D
D5: SS14 USB isolation; D_SMA; MPN SS14-E3/61T
F3: 0.5A USB PTC; Fuse_1812_4532Metric; MPN MF-MSMF050-2
J5: USB-C data / BOOTSEL; USB_C_Receptacle_GCT_USB4105-xx-A_16P_TopMnt_Horizontal; MPN USB4105-GF-A
R401, R402: 5.1k; R_0603_1608Metric; MPN RC0603FR-075K1L
R403, R404: 27; R_0402_1005Metric; MPN RC0402FR-0727RL
U6: USBLC6-2SC6; SOT-23-6; MPN USBLC6-2SC6

Connections:
GND: C423.2, C427.2, J5.A1, J5.A12, J5.B1, J5.B12, J5.S1, R401.2, R402.2, U6.2 (GND); also elsewhere on the board
USB_CC1: J5.A5, R401.1
USB_CC2: J5.B5, R402.1
USB_DM: J5.A7, J5.B7, R403.1, U6.3 (IO2), U6.4 (IO2)
USB_DM_MCU: R403.2; also elsewhere on the board
USB_DP: J5.A6, J5.B6, R404.1, U6.1 (IO1), U6.6 (IO1)
USB_DP_MCU: R404.2; also elsewhere on the board
USB_FUSED: D5.2 (A), F3.2
USB_VBUS: C423.1, F3.1, J5.A4, J5.A9, J5.B4, J5.B9; also elsewhere on the board
VSYS: C427.1, D5.1 (K), U6.5 (VBUS); also elsewhere on the board

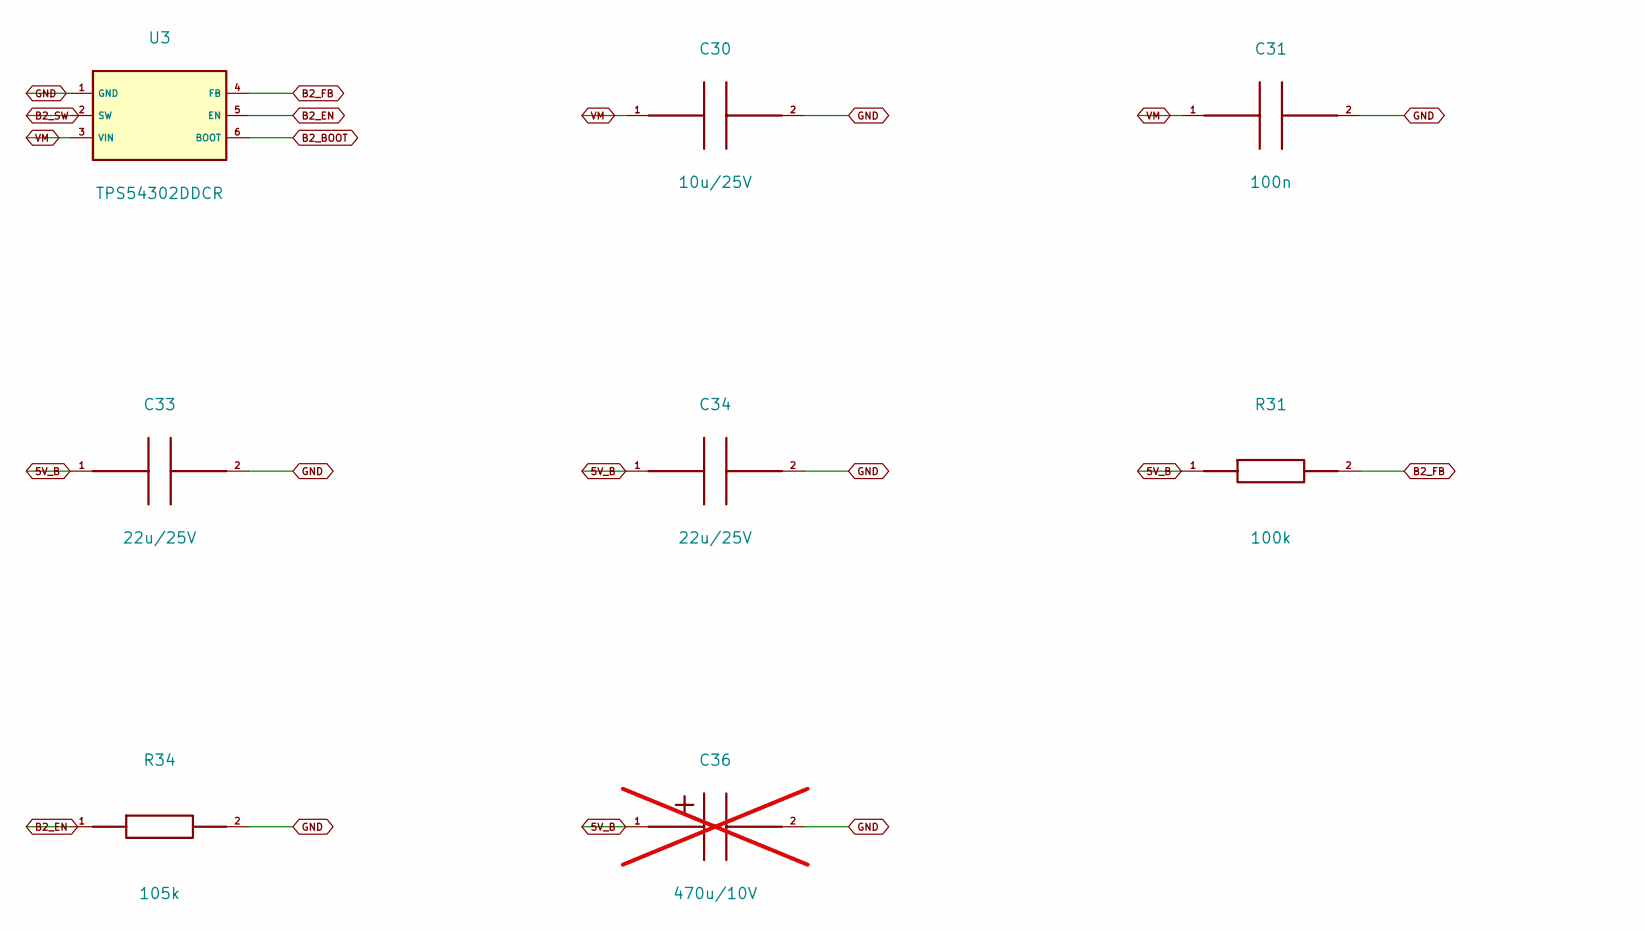
[picture p379: schematic buck2.kicad_sch, Quadcuber A1 / buck2 / ENGINEERING HOLD, part in row 1, column 1]

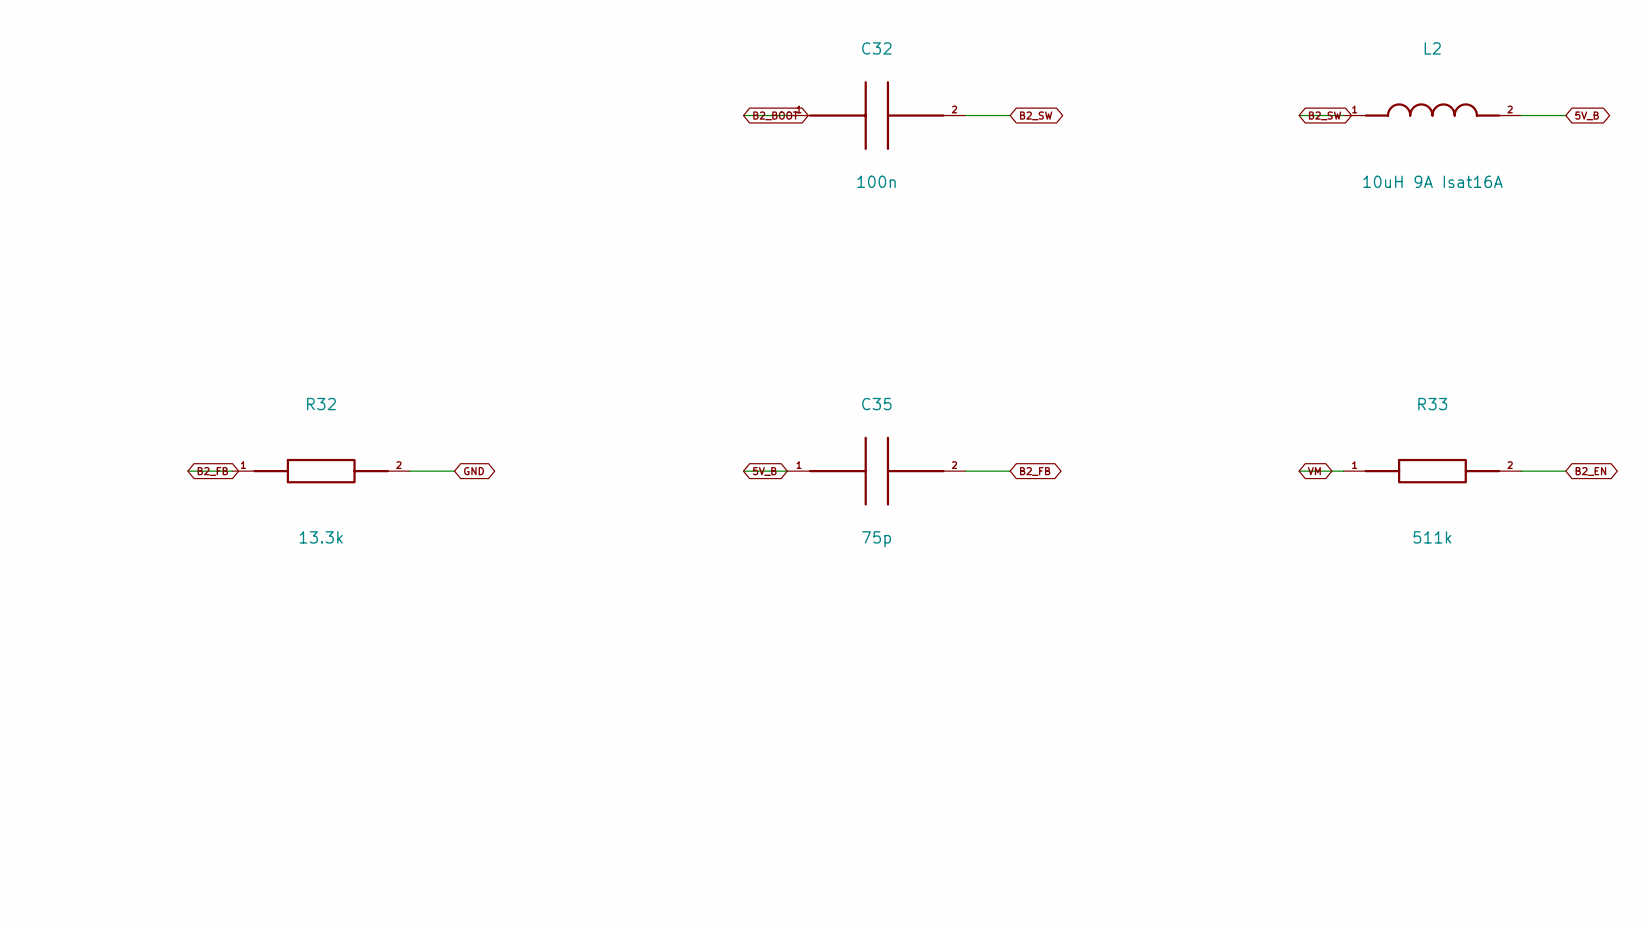
[picture p380: schematic buck2.kicad_sch, Quadcuber A1 / buck2 / ENGINEERING HOLD, part in row 1, column 2]

Parts:
C30: 10u/25V; C_1210_3225Metric; MPN GRM32DR71E106KA12L
C31, C32: 100n; C_0805_2012Metric; MPN GRM21BR71H104KA01L
C33, C34: 22u/25V; C_1210_3225Metric; MPN GRM32ER71E226KE15L
C35: 75p; C_0603_1608Metric; MPN C0603C750J5GACTU
C36: 470u/10V; CP_Radial_D8.0mm_P3.50mm; MPN EEU-FR1A471; not fitted
L2: 10uH 9A Isat16A; L_Bourns_SRP1245A; MPN SRP1245A-100M
R31: 100k; R_0603_1608Metric; MPN RT0603BRD07100KL
R32: 13.3k; R_0603_1608Metric; MPN RT0603BRD0713K3L
R33: 511k; R_0603_1608Metric; MPN RC0603FR-07511KL
R34: 105k; R_0603_1608Metric; MPN RC0603FR-07105KL
U3: TPS54302DDCR; SOT-23-6; MPN TPS54302DDCR

Connections:
5V_B: C33.1, C34.1, C35.1, C36.1 (+), L2.2, R31.1; also elsewhere on the board
B2_BOOT: C32.1, U3.6 (BOOT)
B2_EN: R33.2, R34.1, U3.5 (EN)
B2_FB: C35.2, R31.2, R32.1, U3.4 (FB)
B2_SW: C32.2, L2.1, U3.2 (SW)
GND: C30.2, C31.2, C33.2, C34.2, C36.2 (-), R32.2, R34.2, U3.1 (GND); also elsewhere on the board
VM: C30.1, C31.1, R33.1, U3.3 (VIN); also elsewhere on the board

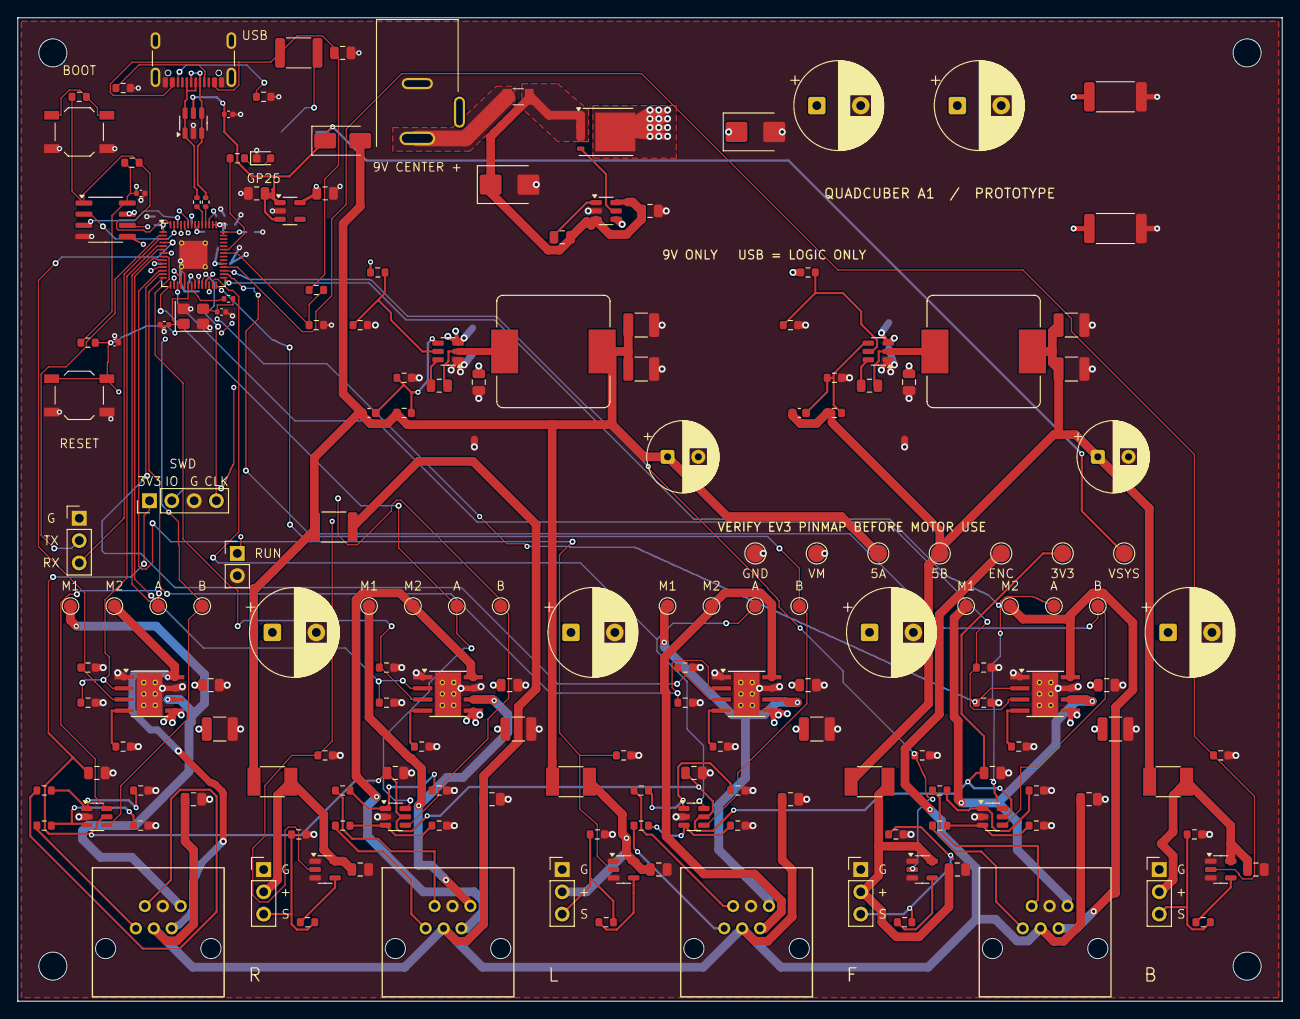
[picture p381: board quadcuber.kicad_pcb from above]

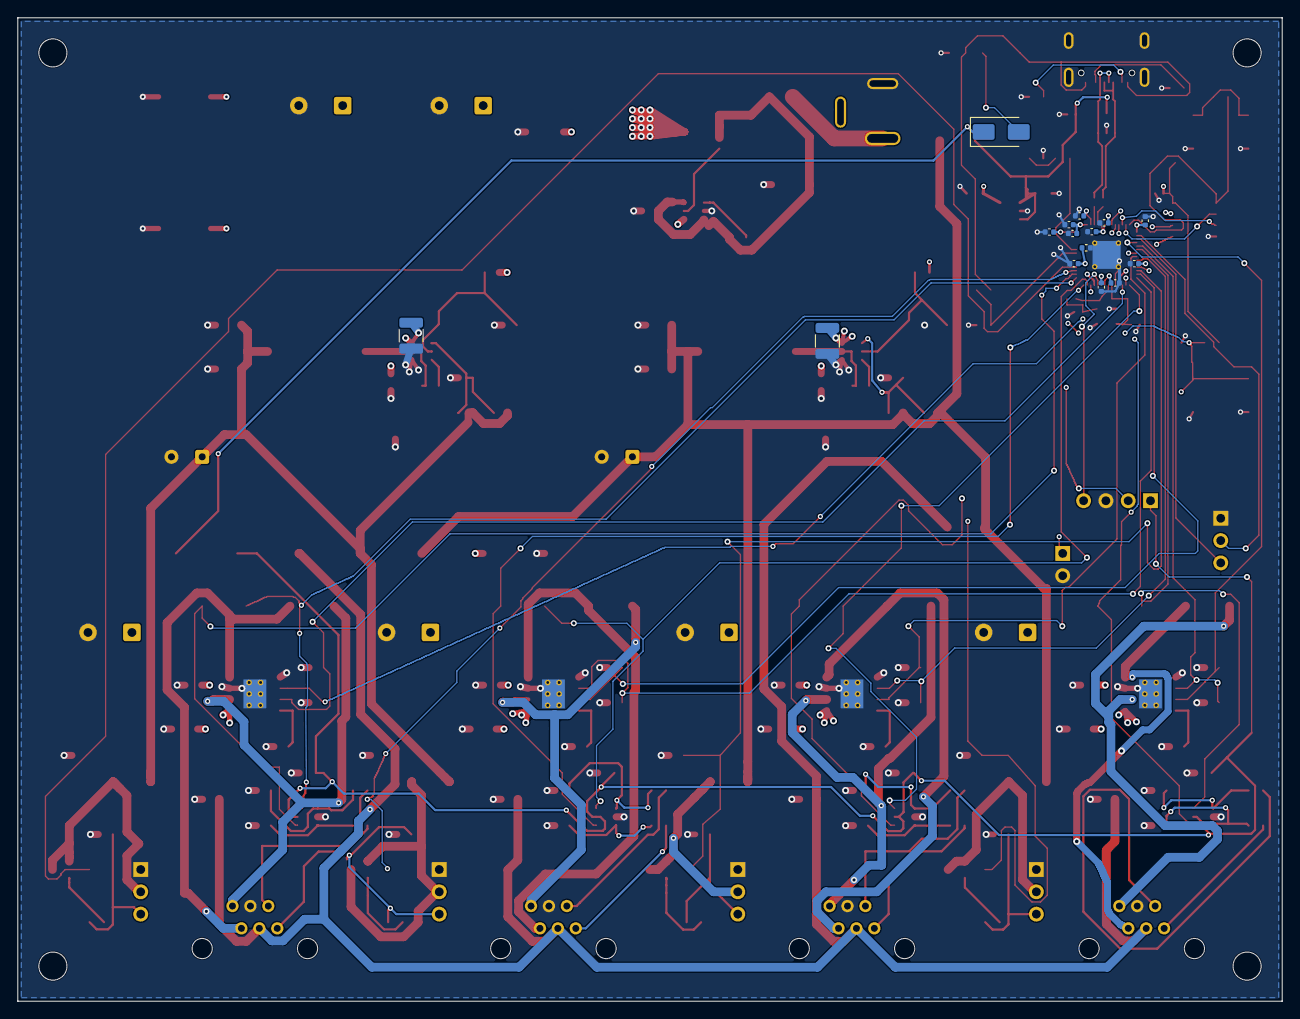
[picture p382: board quadcuber.kicad_pcb from below]

Board: 4 copper layers, 144.0 x 112.0 mm, 200 parts (15 on the bottom side), 106 nets.

Other parts of the board:
H1, H2, H3, H4: M3 insulated standoff; MountingHole_3.2mm_M3
