gonewx/quadcuber/firmware/pico/config.py

"""唯一人工配置入口：ARMS["R"] 与 ARMS["L"] 各自独立。

升级旧设备必须先备份并迁移设备 config.py，不能用本文件覆盖真实 R 参数。
L 的方向、传动比及控制初值未实测，不能复制 R 标定。见 docs/single_arm.md。
"""

ARMS = {
    "R": {

        # ---- 引脚 (R 臂) ------------------------------------------------------------
        'MOTOR_IN1': 2,  # DRV8833 AIN1; GP2/GP3 属于同一个 PWM slice
        'MOTOR_IN2': 3,  # DRV8833 AIN2
        'ENC_A': 4,  # 编码器 A 相 (EV3 线 5 脚黄线, 经 10k+20k 分压)
        'ENC_B': 5,  # 编码器 B 相 (EV3 线 6 脚蓝线, 经 10k+20k 分压)
        'SERVO': 8,  # Geekservo 信号线
        'ENC_SM': (0, 1),  # 编码器占用的两个 PIO 状态机 (0~3 在 PIO0, 4~7 在 PIO1)

        # ---- 方向 ------------------------------------------------------------------
        # 正方向: 从机械手后面 (舵机那头) 朝魔方看, 机械头顺时针 (和规划器 quadcuber/machine.py 的约定一致)。
        # 1) check: 正占空比应让编码器读数增加, 不一致时把 ENC_INVERT 改成相反的值;
        # 2) duty 0.3 500: 机械头应顺时针转, 反了就把两个都改成相反的值。齿轮会反向, 只看机械头, 不看马达。
        'MOTOR_INVERT': False,
        'ENC_INVERT': False,
        # 编码器经电阻分压 (10k 串联 + 20k 下拉) 接入; 内部上拉会抬高分压点, 必须保持 False。见 docs/single_arm.md 第 3 节。
        'ENC_PULLUP': False,

        # ---- 机械参数 ---------------------------------------------------------------
        # 保留每圈720计数。2026-09-28手转单次测得707，用户决定不重复校准；角度未独立精密验证。
        'COUNTS_PER_MOTOR_REV': 720,
        # 马达转几圈, 机械手转一圈。马达直接带机械手为 1.0; 例如 12 齿带 36 齿则为 3.0。
        # v4 沿用的传动比: 马达 24 齿直齿轮带 60 齿转盘, 2.5。空载实测时是 1.0 (见 docs/single_arm-results.md)。
        'GEAR_RATIO': 2.5,

        # ---- 马达驱动 ---------------------------------------------------------------
        'PWM_FREQ': 20000,  # 20kHz, 听不到啸叫
        'LOOP_US': 1000,  # 控制周期 (微秒)
        'BRAKE_AFTER_MOVE': True,  # 动作结束后短路刹车 (否则滑行)

        # ---- 舵机 (Geekservo) -------------------------------------------------------
        # 当前 v4 往后拉夹紧；名义夹紧在曲柄折叠死点前 25°，不是实测脉宽。
        # 舵机固定在平台上；初次定位必须脱开连杆，不能让舵机寻找或顶住硬挡块。
        'MACHINE_PROFILE': "v4",
        'ARM_ID': "R",  # 本文件上面的引脚是 R 臂，唯一引脚来源为 wiring/spec.py
        # 以下记录只在本臂完成物理标定后填写，换臂/改装后必须重新标定。
        # 500~2500 只是驱动允许的电气包络，不是机械安全行程；不提供旧 1200/1800 默认值。
        'SERVO_CALIBRATED': False,
        'SERVO_CALIBRATION_PROFILE': None,
        'SERVO_CALIBRATION_ARM': None,
        'SERVO_MIN_US': None,  # 实测安全工作区间下界
        'SERVO_MAX_US': None,  # 实测安全工作区间上界
        # 已填开合脉宽；安全区间、身份和时序尚未确认，不能据此解锁动作。
        'SERVO_OPEN_US': 1700,
        'SERVO_CLOSE_US': 1450,
        # 端点确认后先填人为选择的保守等待，仅用于单次 open/close 录像测时。
        # 取实测开合较慢值加余量写回，再确认时序，才允许组合动作和普通马达动作。
        'SERVO_MOVE_MS': None,
        'SERVO_TIMING_CONFIRMED': False,

        # ---- 控制参数 ----------------------------------------------------------------
        # 角度、速度都按机械手算。EV3 大马达空载实测 (GEAR_RATIO = 1.0, 记录见 docs/single_arm-results.md):
        # vmax 600, amax 6000, v_full 1180, tau 0.091, kp 0.03, kd 0.0008。
        # v4 齿轮比 2.5 后按比例换算 (马达层面的速度、加速度、反馈增益和空载时相同): v_full / 2.5, kp、kd × 2.5,
        # vmax、amax 取马达空载能力的一半左右。这些是推算值, 装上机械头后要用 speed / friction 重新测 (转盘和机械头的惯量、摩擦都会变)。
        'GAINS': {
            "vmax": 240.0,  # 度/秒 (机械手); 马达最高约 1050 度/秒, 除以 2.5 约 420
            "amax": 2400.0,  # 度/秒²
            "v_full": 472.0,  # 1180 / 2.5
            "tau": 0.091,  # 空载值, 装机后重测
            "kp": 0.075,
            "kd": 0.002,
            "ki": 0.0,
            "kfs": 0.11,  # friction实测正向0.110、反向0.115，取较小值
            "tol": 2.0,  # 到位容差 (度)
        },
    },
    "L": {

        # ---- 引脚 (L 臂) ------------------------------------------------------------
        'MOTOR_IN1': 6,  # DRV8833 BIN1; GP6/GP7 属于同一个 PWM slice
        'MOTOR_IN2': 7,  # DRV8833 BIN2
        'ENC_A': 12,  # 编码器 A 相 (EV3 线 5 脚黄线, 经 10k+20k 分压)
        'ENC_B': 13,  # 编码器 B 相 (EV3 线 6 脚蓝线, 经 10k+20k 分压)
        'SERVO': 9,  # Geekservo 信号线
        'ENC_SM': (2, 3),  # 编码器占用的两个 PIO 状态机 (0~3 在 PIO0, 4~7 在 PIO1)

        # ---- 方向 ------------------------------------------------------------------
        # 正方向: 从机械手后面 (舵机那头) 朝魔方看, 机械头顺时针 (和规划器 quadcuber/machine.py 的约定一致)。
        # 1) check: 正占空比应让编码器读数增加, 不一致时把 ENC_INVERT 改成相反的值;
        # 2) duty 0.3 500: 机械头应顺时针转, 反了就把两个都改成相反的值。齿轮会反向, 只看机械头, 不看马达。
        'MOTOR_INVERT': False,
        'ENC_INVERT': False,
        # 编码器经电阻分压 (10k 串联 + 20k 下拉) 接入; 内部上拉会抬高分压点, 必须保持 False。见 docs/single_arm.md 第 3 节。
        'ENC_PULLUP': False,

        # ---- 机械参数 ---------------------------------------------------------------
        # L 暂用名义720计数，未实测。707是R历史单次记录，不是L测量。
        'COUNTS_PER_MOTOR_REV': 720,
        # 马达转几圈, 机械手转一圈。马达直接带机械手为 1.0; 例如 12 齿带 36 齿则为 3.0。
        # v4 沿用的传动比: 马达 24 齿直齿轮带 60 齿转盘, 2.5。空载实测时是 1.0 (见 docs/single_arm-results.md)。
        'GEAR_RATIO': 2.5,

        # ---- 马达驱动 ---------------------------------------------------------------
        'PWM_FREQ': 20000,  # 20kHz, 听不到啸叫
        'LOOP_US': 1000,  # 控制周期 (微秒)
        'BRAKE_AFTER_MOVE': True,  # 动作结束后短路刹车 (否则滑行)

        # ---- 舵机 (Geekservo) -------------------------------------------------------
        # 当前 v4 往后拉夹紧；名义夹紧在曲柄折叠死点前 25°，不是实测脉宽。
        # 舵机固定在平台上；初次定位必须脱开连杆，不能让舵机寻找或顶住硬挡块。
        'MACHINE_PROFILE': "v4",
        'ARM_ID': "L",  # 独立 L 引脚，规范见 wiring/spec.py
        # 以下记录只在本臂完成物理标定后填写，换臂/改装后必须重新标定。
        # 500~2500 只是驱动允许的电气包络，不是机械安全行程；不提供旧 1200/1800 默认值。
        'SERVO_CALIBRATED': False,
        'SERVO_CALIBRATION_PROFILE': None,
        'SERVO_CALIBRATION_ARM': None,
        'SERVO_MIN_US': None,  # 实测安全工作区间下界
        'SERVO_MAX_US': None,  # 实测安全工作区间上界
        # L 未标定；不得复制 R 的开合、接触脉宽或确认标志。
        'SERVO_OPEN_US': None,
        'SERVO_CLOSE_US': None,
        # 端点确认后先填人为选择的保守等待，仅用于单次 open/close 录像测时。
        # 取实测开合较慢值加余量写回，再确认时序，才允许组合动作和普通马达动作。
        'SERVO_MOVE_MS': None,
        'SERVO_TIMING_CONFIRMED': False,

        # ---- 控制参数 ----------------------------------------------------------------
        # 角度、速度都按机械手算。EV3 大马达空载实测 (GEAR_RATIO = 1.0, 记录见 docs/single_arm-results.md):
        # vmax 600, amax 6000, v_full 1180, tau 0.091, kp 0.03, kd 0.0008。
        # v4 齿轮比 2.5 后按比例换算 (马达层面的速度、加速度、反馈增益和空载时相同): v_full / 2.5, kp、kd × 2.5,
        # vmax、amax 取马达空载能力的一半左右。这些是推算值, 装上机械头后要用 speed / friction 重新测 (转盘和机械头的惯量、摩擦都会变)。
        'GAINS': {
            "vmax": 240.0,  # 度/秒 (机械手); 马达最高约 1050 度/秒, 除以 2.5 约 420
            "amax": 2400.0,  # 度/秒²
            "v_full": 472.0,  # 1180 / 2.5
            "tau": 0.091,  # 空载值, 装机后重测
            "kp": 0.075,
            "kd": 0.002,
            "ki": 0.0,
            "kfs": 0.11,  # 取R历史摩擦记录作L待测初值，不是L实测
            "tol": 2.0,  # 到位容差 (度)
        },
    },
    "F": {

        # ---- 引脚 (F 臂) ------------------------------------------------------------
        'MOTOR_IN1': 10,  # B1 DRV8871 IN; GP10/GP11 属于同一个 PWM slice
        'MOTOR_IN2': 11,  # B1 DRV8871 IN
        'ENC_A': 16,  # 编码器 A 相 (EV3 线 5 脚黄线, 经 10k+20k 分压)
        'ENC_B': 17,  # 编码器 B 相 (EV3 线 6 脚蓝线, 经 10k+20k 分压)
        'SERVO': 20,  # Geekservo 信号线
        'ENC_SM': (4, 5),  # 编码器占用的两个 PIO 状态机 (0~3 在 PIO0, 4~7 在 PIO1)

        # ---- 方向 ------------------------------------------------------------------
        # 正方向: 从机械手后面 (舵机那头) 朝魔方看, 机械头顺时针 (和规划器 quadcuber/machine.py 的约定一致)。
        # 1) check: 正占空比应让编码器读数增加, 不一致时把 ENC_INVERT 改成相反的值;
        # 2) duty 0.3 500: 机械头应顺时针转, 反了就把两个都改成相反的值。齿轮会反向, 只看机械头, 不看马达。
        'MOTOR_INVERT': False,
        'ENC_INVERT': False,
        # 编码器经电阻分压 (10k 串联 + 20k 下拉) 接入; 内部上拉会抬高分压点, 必须保持 False。见 docs/single_arm.md 第 3 节。
        'ENC_PULLUP': False,

        # ---- 机械参数 ---------------------------------------------------------------
        # F 暂用名义720计数，未实测。707是R历史单次记录，不是F测量。
        'COUNTS_PER_MOTOR_REV': 720,
        # 马达转几圈, 机械手转一圈。马达直接带机械手为 1.0; 例如 12 齿带 36 齿则为 3.0。
        # v4 沿用的传动比: 马达 24 齿直齿轮带 60 齿转盘, 2.5。空载实测时是 1.0 (见 docs/single_arm-results.md)。
        'GEAR_RATIO': 2.5,

        # ---- 马达驱动 ---------------------------------------------------------------
        'PWM_FREQ': 20000,  # 20kHz, 听不到啸叫
        'LOOP_US': 1000,  # 控制周期 (微秒)
        'BRAKE_AFTER_MOVE': True,  # 动作结束后短路刹车 (否则滑行)

        # ---- 舵机 (Geekservo) -------------------------------------------------------
        # 当前 v4 往后拉夹紧；名义夹紧在曲柄折叠死点前 25°，不是实测脉宽。
        # 舵机固定在平台上；初次定位必须脱开连杆，不能让舵机寻找或顶住硬挡块。
        'MACHINE_PROFILE': "v4",
        'ARM_ID': "F",  # 独立 F 引脚，规范见 wiring/spec.py
        # 以下记录只在本臂完成物理标定后填写，换臂/改装后必须重新标定。
        # 500~2500 只是驱动允许的电气包络，不是机械安全行程；不提供旧 1200/1800 默认值。
        'SERVO_CALIBRATED': False,
        'SERVO_CALIBRATION_PROFILE': None,
        'SERVO_CALIBRATION_ARM': None,
        'SERVO_MIN_US': None,  # 实测安全工作区间下界
        'SERVO_MAX_US': None,  # 实测安全工作区间上界
        # F 未标定；不得复制 R 的开合、接触脉宽或确认标志。
        'SERVO_OPEN_US': None,
        'SERVO_CLOSE_US': None,
        # 端点确认后先填人为选择的保守等待，仅用于单次 open/close 录像测时。
        # 取实测开合较慢值加余量写回，再确认时序，才允许组合动作和普通马达动作。
        'SERVO_MOVE_MS': None,
        'SERVO_TIMING_CONFIRMED': False,

        # ---- 控制参数 ----------------------------------------------------------------
        # 角度、速度都按机械手算。EV3 大马达空载实测 (GEAR_RATIO = 1.0, 记录见 docs/single_arm-results.md):
        # vmax 600, amax 6000, v_full 1180, tau 0.091, kp 0.03, kd 0.0008。
        # v4 齿轮比 2.5 后按比例换算 (马达层面的速度、加速度、反馈增益和空载时相同): v_full / 2.5, kp、kd × 2.5,
        # vmax、amax 取马达空载能力的一半左右。这些是推算值, 装上机械头后要用 speed / friction 重新测 (转盘和机械头的惯量、摩擦都会变)。
        'GAINS': {
            "vmax": 240.0,  # 度/秒 (机械手); 马达最高约 1050 度/秒, 除以 2.5 约 420
            "amax": 2400.0,  # 度/秒²
            "v_full": 472.0,  # 1180 / 2.5
            "tau": 0.091,  # 空载值, 装机后重测
            "kp": 0.075,
            "kd": 0.002,
            "ki": 0.0,
            "kfs": 0.11,  # 取R历史摩擦记录作F待测初值，不是F实测
            "tol": 2.0,  # 到位容差 (度)
        },
    },    "B": {

        # ---- 引脚 (B 臂) ------------------------------------------------------------
        'MOTOR_IN1': 14,  # B1 DRV8871 IN; GP14/GP15 属于同一个 PWM slice
        'MOTOR_IN2': 15,  # B1 DRV8871 IN
        'ENC_A': 18,  # 编码器 A 相 (EV3 线 5 脚黄线, 经 10k+20k 分压)
        'ENC_B': 19,  # 编码器 B 相 (EV3 线 6 脚蓝线, 经 10k+20k 分压)
        'SERVO': 21,  # Geekservo 信号线
        'ENC_SM': (6, 7),  # 编码器占用的两个 PIO 状态机 (0~3 在 PIO0, 4~7 在 PIO1)

        # ---- 方向 ------------------------------------------------------------------
        # 正方向: 从机械手后面 (舵机那头) 朝魔方看, 机械头顺时针 (和规划器 quadcuber/machine.py 的约定一致)。
        # 1) check: 正占空比应让编码器读数增加, 不一致时把 ENC_INVERT 改成相反的值;
        # 2) duty 0.3 500: 机械头应顺时针转, 反了就把两个都改成相反的值。齿轮会反向, 只看机械头, 不看马达。
        'MOTOR_INVERT': False,
        'ENC_INVERT': False,
        # 编码器经电阻分压 (10k 串联 + 20k 下拉) 接入; 内部上拉会抬高分压点, 必须保持 False。见 docs/single_arm.md 第 3 节。
        'ENC_PULLUP': False,

        # ---- 机械参数 ---------------------------------------------------------------
        # B 暂用名义720计数，未实测。707是R历史单次记录，不是B测量。
        'COUNTS_PER_MOTOR_REV': 720,
        # 马达转几圈, 机械手转一圈。马达直接带机械手为 1.0; 例如 12 齿带 36 齿则为 3.0。
        # v4 沿用的传动比: 马达 24 齿直齿轮带 60 齿转盘, 2.5。空载实测时是 1.0 (见 docs/single_arm-results.md)。
        'GEAR_RATIO': 2.5,

        # ---- 马达驱动 ---------------------------------------------------------------
        'PWM_FREQ': 20000,  # 20kHz, 听不到啸叫
        'LOOP_US': 1000,  # 控制周期 (微秒)
        'BRAKE_AFTER_MOVE': True,  # 动作结束后短路刹车 (否则滑行)

        # ---- 舵机 (Geekservo) -------------------------------------------------------
        # 当前 v4 往后拉夹紧；名义夹紧在曲柄折叠死点前 25°，不是实测脉宽。
        # 舵机固定在平台上；初次定位必须脱开连杆，不能让舵机寻找或顶住硬挡块。
        'MACHINE_PROFILE': "v4",
        'ARM_ID': "B",  # 独立 B 引脚，规范见 wiring/spec.py
        # 以下记录只在本臂完成物理标定后填写，换臂/改装后必须重新标定。
        # 500~2500 只是驱动允许的电气包络，不是机械安全行程；不提供旧 1200/1800 默认值。
        'SERVO_CALIBRATED': False,
        'SERVO_CALIBRATION_PROFILE': None,
        'SERVO_CALIBRATION_ARM': None,
        'SERVO_MIN_US': None,  # 实测安全工作区间下界
        'SERVO_MAX_US': None,  # 实测安全工作区间上界
        # B 未标定；不得复制 R 的开合、接触脉宽或确认标志。
        'SERVO_OPEN_US': None,
        'SERVO_CLOSE_US': None,
        # 端点确认后先填人为选择的保守等待，仅用于单次 open/close 录像测时。
        # 取实测开合较慢值加余量写回，再确认时序，才允许组合动作和普通马达动作。
        'SERVO_MOVE_MS': None,
        'SERVO_TIMING_CONFIRMED': False,

        # ---- 控制参数 ----------------------------------------------------------------
        # 角度、速度都按机械手算。EV3 大马达空载实测 (GEAR_RATIO = 1.0, 记录见 docs/single_arm-results.md):
        # vmax 600, amax 6000, v_full 1180, tau 0.091, kp 0.03, kd 0.0008。
        # v4 齿轮比 2.5 后按比例换算 (马达层面的速度、加速度、反馈增益和空载时相同): v_full / 2.5, kp、kd × 2.5,
        # vmax、amax 取马达空载能力的一半左右。这些是推算值, 装上机械头后要用 speed / friction 重新测 (转盘和机械头的惯量、摩擦都会变)。
        'GAINS': {
            "vmax": 240.0,  # 度/秒 (机械手); 马达最高约 1050 度/秒, 除以 2.5 约 420
            "amax": 2400.0,  # 度/秒²
            "v_full": 472.0,  # 1180 / 2.5
            "tau": 0.091,  # 空载值, 装机后重测
            "kp": 0.075,
            "kd": 0.002,
            "ki": 0.0,
            "kfs": 0.11,  # 取R历史摩擦记录作B待测初值，不是B实测
            "tol": 2.0,  # 到位容差 (度)
        },
    },
}
