gonewx/quadcuber/electronics/check.py

#!/usr/bin/env python3
"""Independent net-contract checks; compare EDA-exported XML and physical PCB pads."""
import json,os,runpy,subprocess,sys,xml.etree.ElementTree as ET
from pathlib import Path
from toolchain import python_command, require_version
if (os.environ.get('KICAD_PYTHON') or os.environ.get('KICAD_APP_RUN')) and not os.environ.get('QUADCUBER_PCBNEW_CHILD'):
    env=dict(os.environ,QUADCUBER_PCBNEW_CHILD='1')
    raise SystemExit(subprocess.call([*python_command(),str(Path(__file__).resolve()),*sys.argv[1:]],env=env))
import pcbnew as p
require_version(p.GetBuildVersion())
H=Path(__file__).resolve().parent;R=H.parent;O=R/'generated/electronics'
arms=runpy.run_path(str(R/'wiring/spec.py'))['ARMS']
tree=ET.parse(O/'netlist.xml'); xmlnets={}
for net in tree.findall('./nets/net'):
    if net.get('name','').startswith('unconnected-'):continue
    for node in net.findall('node'):xmlnets[(node.get('ref'),node.get('pin'))]=net.get('name')
b=p.LoadBoard(str(H/'quadcuber.kicad_pcb')); pads={}
for f in b.GetFootprints():
    for pad in f.Pads():
        if pad.GetNumber():pads[(f.GetReference(),pad.GetNumber())]=str(pad.GetNetname())
errors=[]
def check(ref,pin,net):
    for src,nets in [('schematic',xmlnets),('pcb',pads)]:
        if nets.get((ref,str(pin)))!=net:errors.append(f'{src} {ref}.{pin}: {nets.get((ref,str(pin)))} != {net}')
for i,(arm,(motor,enc,servo,sm)) in enumerate(arms.items()):
    for pin,net in {1:'GND',2:f'GP{motor[1]}',3:f'GP{motor[0]}',5:'VM',6:arm+'_M1',7:'GND',8:arm+'_M2',9:'GND'}.items():check(f'U{10+i}',pin,net)
    for pin,net in {1:arm+'_M1',2:arm+'_M2',3:'GND',4:'5V_ENC',5:arm+'_ENC_A_RAW',6:arm+'_ENC_B_RAW'}.items():check(f'J{10+i}',pin,net)
    check(f'U{20+i}',6,f'GP{enc[0]}');check(f'U{20+i}',4,f'GP{enc[1]}');check(f'U{20+i}',5,'3V3')
    check(f'U{30+i}',2,f'GP{servo[0]}');check(f'U{30+i}',5,arm+'_SERVO_5V')
    check(f'J{20+i}',1,'GND');check(f'J{20+i}',2,arm+'_SERVO_5V');check(f'J{20+i}',3,arm+'_SERVO_PWM')
# Exact protection-part check; ERC cannot detect nonexistent MPNs or wrong lands.
for ref,pins in {'F1':{1:'VIN',2:'VIN_FUSED'},'R500':{1:'VM',2:'GND'},'R501':{1:'VM',2:'GND'}}.items():
    for pin,net in pins.items():check(ref,pin,net)
verified_mpn={'F1':'0407008.WR','R500':'CRCW2512300RFKEG','R501':'CRCW2512300RFKEG'}
verified_mpn['U7']='W25Q16RVCNJQ'
verified_mpn['J1']='RASPC722X'
for refs,mpn in [(['F10','F11','F12','F13'],'MF-MSMF110/16X-2'),(['C20','C30','C101','C121','C141','C161'],'GRM32DR71E106KA12L'),(['C420','C421'],'GRM155R61C105KA12D'),(['C422'],'C0805C475K4PACTU'),(['C25','C35'],'C0603C750J5GACTU')]:
    verified_mpn.update(dict.fromkeys(refs,mpn))
for ref,mpn in verified_mpn.items():
    field=tree.find(f'./components/comp[@ref="{ref}"]/fields/field[@name="MPN"]')
    if field is None or field.text!=mpn:errors.append(f'{ref}: exact MPN mismatch')
fuse=next(f for f in b.GetFootprints() if f.GetReference()=='F1')
if str(fuse.GetFPID().GetLibItemName())!='Fuse_Littelfuse_407_1206':errors.append('F1: wrong land pattern')
for pad in fuse.Pads():
    delta=pad.GetPosition()-fuse.GetPosition()
    want=-1.25 if pad.GetNumber()=='1' else 1.25
    if abs(p.ToMM(delta.x)-want)>.001 or abs(p.ToMM(delta.y))>.001 or abs(p.ToMM(pad.GetSize().x)-1)>.001 or abs(p.ToMM(pad.GetSize().y)-1.8)>.001:
        errors.append('F1: 407 land geometry mismatch')
# Parent visually checked Switchcraft component-side drawing; inches control.
# Project pad numbers: center=1, sleeve=2, sleeve shunt=3 (unused).
check('J1',1,'VIN');check('J1',2,'GND')
jack=next(f for f in b.GetFootprints() if f.GetReference()=='J1')
if str(jack.GetFPID().GetLibItemName())!='Jack_DC_Switchcraft_RASPC722X':errors.append('J1: wrong DC jack footprint')
if jack.GetOrientationDegrees()!=0 or jack.GetPosition()!=p.VECTOR2I(95500000,50000000):errors.append('J1: mating face no longer on approved top board edge')
slot_inches={'1':(0,.541,.140,.040),'2':(0,.295,.120,.030),'3':(.189,.423,.030,.120)}
if len(jack.Pads())!=3:errors.append('J1: expected three PTH slots')
for pad in jack.Pads():
    if pad.GetNumber() not in slot_inches:errors.append('J1: unexpected pad');continue
    x,y,dx,dy=[round(a*25.4,6) for a in slot_inches[pad.GetNumber()]]
    pos=pad.GetPosition()-jack.GetPosition()
    if any(abs(a-b)>.00001 for a,b in zip([p.ToMM(pos.x),p.ToMM(pos.y),p.ToMM(pad.GetDrillSize().x),p.ToMM(pad.GetDrillSize().y)],[x,y,dx,dy])):errors.append('J1: reference drawing slot geometry mismatch')
    if pad.GetAttribute()!=p.PAD_ATTRIB_PTH or pad.GetDrillShape()!=p.PAD_DRILL_SHAPE_OBLONG:errors.append('J1: expected plated oblong slot')
    if min(p.ToMM(pad.GetSize().x)-dx,p.ToMM(pad.GetSize().y)-dy)<.50799:errors.append('J1: slot annular ring below 0.254 mm')
    if pad.GetNumber()=='3' and pad.GetNetname()!='unconnected-(J1-SLEEVE_SHUNT_NC-Pad3)':errors.append('J1: sleeve shunt must remain NC')
for t in b.GetTracks():
    if t.GetNetname()=='VIN' and (isinstance(t,p.PCB_VIA) or t.GetLayer()!=p.F_Cu or t.GetWidth()<1800000):errors.append('J1: VIN route must retain >=1.8 mm on top copper without vias')
# Independent RP2040 datasheet mapping: package pad number != GPIO number.
gpio_pads={**{i:i+2 for i in range(8)},**{i:i+3 for i in range(8,16)},**{i:i+11 for i in range(16,22)},24:36,25:37}
for gpio,pin in gpio_pads.items():check('U1',pin,f'GP{gpio}')
for pin in [1,10,22,33,42,43,44,48,49]:check('U1',pin,'3V3')
for pin in [23,45,50]:check('U1',pin,'1V1')
for pin in [19,57]:check('U1',pin,'GND')
for pin,net in {20:'XIN',21:'XOUT',24:'SWCLK',25:'SWDIO',26:'RUN',46:'USB_DM_MCU',47:'USB_DP_MCU',51:'QSPI_SD3',52:'QSPI_SCLK',53:'QSPI_SD0',54:'QSPI_SD2',55:'QSPI_SD1',56:'QSPI_SS'}.items():check('U1',pin,net)
for ref,pp in {
 'U7':{1:'QSPI_SS',2:'QSPI_SD1',3:'QSPI_SD2',4:'GND',5:'QSPI_SD0',6:'QSPI_SCLK',7:'QSPI_SD3',8:'3V3'},
 'U5':{1:'VSYS',2:'GND',3:'VSYS',5:'3V3'},
 'D2':{1:'VSYS',2:'5V_A'},'D5':{1:'VSYS',2:'USB_FUSED'},
 'F3':{1:'USB_VBUS',2:'USB_FUSED'},'U6':{1:'USB_DP',2:'GND',3:'USB_DM',4:'USB_DM',5:'VSYS',6:'USB_DP'},
 'R401':{1:'USB_CC1',2:'GND'},'R402':{1:'USB_CC2',2:'GND'},
 'R403':{1:'USB_DM',2:'USB_DM_MCU'},'R404':{1:'USB_DP',2:'USB_DP_MCU'},
 'R408':{1:'QSPI_SS',2:'BOOT_BUTTON'},'S1':{1:'BOOT_BUTTON',2:'GND'},
 'J4':{1:'3V3',2:'SWDIO',3:'GND',4:'SWCLK'},
 'J5':{'A5':'USB_CC1','B5':'USB_CC2','A6':'USB_DP','B6':'USB_DP','A7':'USB_DM','B7':'USB_DM','A4':'USB_VBUS','A9':'USB_VBUS','B4':'USB_VBUS','B9':'USB_VBUS','A1':'GND','A12':'GND','B1':'GND','B12':'GND','S1':'GND'}
}.items():
    for pin,net in pp.items():check(ref,pin,net)
for pin in [34,35,38,39,40,41]:
    if pads.get(('U1',str(pin)),'') and not pads[('U1',str(pin))].startswith('unconnected-'):errors.append(f'Unused U1 pad {pin} unexpectedly connected')
for key,net in xmlnets.items():
    if not key[0].startswith('#') and pads.get(key)!=net:errors.append(f'Netlist mismatch {key}: {net} vs {pads.get(key)}')
for key,net in pads.items():
    if net and not net.startswith('unconnected-') and key not in xmlnets:errors.append(f'PCB-only connected pad {key}')
# Independently verify supplied drawing geometry; electrical mapping remains explicit HOLD.
for idx in range(4):
    f=next(f for f in b.GetFootprints() if f.GetReference()==f'J{10+idx}')
    expected=[(2.55,-4.84),(1.53,-2.30),(.51,-4.84),(-.51,-2.30),(-1.53,-4.84),(-2.55,-2.30)]
    for num,(dx,dy) in enumerate(expected,1):
        pa=next(pa for pa in f.Pads() if pa.GetNumber()==str(num))
        local=pa.GetPosition()-f.GetPosition()
        if abs(p.ToMM(local.x)-dx)>.001 or abs(p.ToMM(local.y)-dy)>.001 or abs(p.ToMM(pa.GetDrillSize().x)-.79)>.001:
            errors.append(f'{f.GetReference()}.{num}: drawing geometry mismatch')
    mounts=[pa for pa in f.Pads() if not pa.GetNumber()]
    if len(mounts)!=2 or any(abs(p.ToMM(pa.GetDrillSize().x)-2.3)>.001 for pa in mounts):errors.append(f'{f.GetReference()}: locator geometry mismatch')
for t in b.GetTracks():
    if t.GetNetname().startswith('unconnected-'):errors.append('Copper routed on a schematic NC net')
# Polarity and architecture checks use raw pin data, independent of diagram labels.
for i in [2,3]:
    check(f'U{i}',1,'GND');check(f'U{i}',3,'VM')
    check(f'U{i}',2,f'B{i-1}_SW');check(f'L{i-1}',1,f'B{i-1}_SW')
# Approved direct bootstrap: independent of source generator and shared mistakes.
for ch,cap,top,bottom in [(1,'C22','R21','R22'),(2,'C32','R31','R32')]:
    check(f'U{ch+1}',6,f'B{ch}_BOOT');check(cap,1,f'B{ch}_BOOT');check(cap,2,f'B{ch}_SW')
    for ref,mpn in [(top,'RT0603BRD07100KL'),(bottom,'RT0603BRD0713K3L')]:
        node=tree.find(f'./components/comp[@ref="{ref}"]/fields/field[@name="MPN"]')
        if node is None or node.text!=mpn:errors.append(f'{ref}: precision feedback MPN mismatch')
for ref in ['R20','R30']:
    if tree.find(f'./components/comp[@ref="{ref}"]') is not None or any(k[0]==ref for k in pads):errors.append(f'{ref}: obsolete bootstrap resistor remains')
if any(n.endswith('_BOOT_CAP') for n in [*xmlnets.values(),*pads.values()]):errors.append('Obsolete BOOT_CAP net remains')
for t in b.GetTracks():
    if t.GetNetname().endswith('_BOOT_CAP'):errors.append('Obsolete BOOT_CAP copper remains')
# Inspect geometry / current routes without claiming simulation or thermal proof.
widths={}
for t in b.GetTracks():
    net=str(t.GetNetname());widths.setdefault(net,[]).append(round(p.ToMM(t.GetWidth(p.F_Cu) if isinstance(t,p.PCB_VIA) else t.GetWidth()),3))
report={'contract_errors':errors,'connected_pad_count':len(xmlnets),'footprints':len(b.GetFootprints()),'tracks_and_vias':len(b.GetTracks()),'copper_layers':b.GetCopperLayerCount(),'outline_mm':[144,112],'minimum_trace_or_via_width_mm':{k:min(v) for k,v in widths.items()},'manufacturing_release':False,'not_verified':['EV3 same-lot six-way physical continuity and controlled current/temperature limits (drawing labels 1 and 6; no additional vendor files requested)','Board prototype thermal and regenerative tests','Mechanical bracket and cable clearances']}
(O/'contract-check.json').write_text(json.dumps(report,indent=2)+'\n')
print(f'Contract checks: {len(errors)} errors; {len(xmlnets)} connected symbol pins compared with PCB')
for e in errors:print(e)
sys.exit(bool(errors))
