gonewx/quadcuber/(commit log)

2026-09-26 四机械手魔方机器人: 动作规划器与模拟器 (第一版)
    - cube.py: 54 贴纸魔方模型 (世界坐标系), 转动记号解析
    - machine.py: 4 个机械手的状态、动作和物理约束 (支撑、夹条方向、中间层固定、
    整体翻转、空转、可选角度限制) 及耗时参数
    - planner.py: A* 规划器, 支持相对两面同时拧、空转与其他动作并行、多个机械手
    同时夹紧/松开; 默认滚动窗口 (比全局最优慢 1~2%); 角度受限时先按不限角度规划
    再用动态规划选择旋转方向, 不可行的窗口才做完整受限搜索
    - simulate.py: 只按世界坐标中的物理动作转动贴纸, 独立验证规划结果
    - 命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
2026-09-26 新增 CLAUDE.md: 项目背景、硬件方向、当前状态与下一步
    供后续独立会话使用 (quadcuber 与 arducuber 分开维护)。
    Claude-Session: https://claude.ai/code/session_01DuDGG7HaARb7dx8N1JvLGm
2026-09-26 单臂原型: Pico 测试程序、日志汇总工具和接线文档
    下一步的首要任务是用单臂原型测 90° 旋转的耗时、到位精度和夹持可靠性,
    这次把软件和电路这一侧准备好, 用户搭好实物即可开始测。
    - firmware/pico/ (MicroPython):
    - control.py: 与硬件无关的位置控制 (梯形速度曲线 + 速度/加速度前馈 + PID),
    带到位判定, 以及堵转/超时/失控 (马达或编码器接反) 保护
    - encoder.py: PIO 4 倍频正交计数, 每个编码器用 2 个状态机分别数 A、B 相边沿;
    计数都是单条 jmp x--/y-- 指令, 读数经 SMx_INSTR 插入 mov/push, 不会读到半更新的值
    - motor.py: DRV8833 慢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
2026-09-26 新增机械手概念设计文档 (乐高搭建参考)
    用户问"机械手怎么装": 之前的 single_arm.md 只讲电路和测试步骤, 没说乐高结构。
    按分工结构由用户搭建, 这里补充思路和尺寸要求 (不是零件清单):
    - 夹条的实现: U 形叉 + Geekservo 推动沿旋转轴前进/后退; 叉齿卡住面中间一列两个棱块的外侧,
    靠形状传递扭矩和托住魔方, 不依赖摩擦; 说明了它为什么符合规划器的约束
    - 关键尺寸 (按 56mm 魔方计算, 附推导): 叉齿宽 <=16mm, 退出行程 >=13mm (避开整体翻转时角块扫过的
    半径 39.6mm), 魔方面前 14mm 内除叉齿外不能有宽零件, 同轴度 <=1mm
    - 舵机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
2026-09-26 单臂原型的乐高搭建说明书及生成工具
    用户要求给出类似乐高产品说明书的搭建过程。按官方 LDraw 零件的精确尺寸建模,
    程序自动检查后渲染成说明书, 而不是凭感觉画零件清单。
    - tools/lego/model.py: 机械手 + 测试架模型 (20 步, 只用常见零件)
    - 转动座: 7x5 框架插在 EV3 输出盘上; 灰色 Geekservo 用长销装在框架侧面
    - 叉子: 7x5 框架 + 两根 9 孔梁叉齿, 套在两根 12 号轴导轨上滑动
    - 舵机经曲柄 (3 孔细梁) + 连杆 (7 孔梁) 推拉叉子, 行程 16.5mm, 两端停在死点
    - 测试架: 马达底部耳朵夹住竖放的 7x5 框架, 后墙连到固定叉, 固定叉卡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
2026-09-26 新增 EV3 中马达版的搭建说明书
    用户问是否必须用大马达, 决定也出一版中马达的搭建图, 用单臂原型实测两种马达。
    中马达的输出是正面一个十字孔 (没有带销孔的输出盘), 安装孔都与输出轴垂直,
    所以马达固定和联轴重新设计:
    - 15 孔梁贴在马达正面 (两个摩擦销), 输出轴从梁中间的圆孔穿过并被托住,
    梁的另一头用 4 个销固定在竖立的 7x5 框架上, 框架连到后墙
    - 4 号轴插进输出孔, 两片 3 孔细梁的十字孔锁住轴, 再用两个销带动转动座
    - 机械手和固定叉一端整体前移 1 个孔距, 其余与大马达版相同
    实现:
    - model.build(motor="larg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
2026-09-26 电平转换: 补充 TXS0108E 接法, 编码器引脚默认关闭内部上拉
    用户手上有 TXS0108E 和 5V-3V IIC/UART/SPI 电平转换模块 (多半是 BSS138 型)。
    - single_arm.md: 增加 TXS0108E 接法 (VA=3.3V、VB=5V、OE 接 VA) 和注意事项
    (不宜带电阻负载, 编码器若为开漏输出可能不可靠), 待验证表加一项
    - encoder.py / config.py: 编码器引脚的 Pico 内部上拉改为可选, 默认关闭
    (BSS138 模块自带上拉; TXS0108E 不宜接上拉; 电阻分压时上拉会抬高分压点)
    Claude-Session: https://claude.ai/code/session_01CyQ4N2VefegqCwb3Y7m1A9
2026-09-26 新增图解接线指南 (docs/wiring)
    用户已装好机械臂, 反馈接线说明全是文字。新增一个图文并茂的接线页面:
    - 系统总览图: 电源分配和信号流向
    - 完整接线图: 每根线的起止点, 按用途着色, 可按 9V/5V/3.3V/地线/马达/控制/编码器/舵机筛选
    - 分步接线清单 (8 步, 可勾选, 每步可在图上高亮对应导线)
    - Pico 40 脚引脚图, 高亮单臂用到的引脚; 四臂完整分配表
    - EV3 线色表 (强调红线是地线)、电平转换三种接法对比、上电前万用表检查表、首次上电顺序
    (先 USB -> 再 9V -> enc 手转验证编码器 -> check -> servo)
    页面由 docs/wiring/build.py 生成, 纯 HTM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
2026-09-26 说明书: 曲柄一步注明与舵机外壳留约 1.6mm 空隙是有意的
    用户搭到第 18 步发现曲柄和舵机之间不是严丝合缝。这是设计如此: 舵机输出轴伸出 5.6mm,
    3 孔细梁厚 4mm, 曲柄停在轴端齐平处, 连杆两头 (曲柄端和立轴端) 才一样高。
    在步骤文字里写明, 并提醒不要推到底。大马达版和中马达版说明书同步更新。
    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
2026-09-26 接线指南: 新增面包板布局图和跳线清单
    用户确认用面包板接线, 需要照着插的布局。
    - 标准 830 孔面包板: Pico 横放 (USB 朝左, 1~20 号脚在 h3~h22, 40~21 号脚在 c3~c22),
    电平转换跨凹槽插在 30~35 列; 上排电源轨为 5V 和地 (远离 GPIO 一侧)
    - 大电流线不走面包板: DRV8833 放板外 (VM/GND/AOUT 直连), 舵机电源直连 5V 降压模块,
    面包板的地只经 5V 降压模块 GND 一根线接出
    - 每根跳线给出孔坐标 (如 b7 -> j32), 附跳线清单表; 提醒电源轨中间可能断开
    - 修正: 板上文字改用专门的类名, 避免兄弟选择器把后面模块的标题染成浅色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
    [build.py]
2026-09-26 接线指南: 电平转换模块按用户实物的引脚顺序重排
    用户的模块丝印从左到右是 HV4 HV3 GND HV HV2 HV1 (之前按 SparkFun 型 HV1 HV2 HV GND HV3 HV4 画)。
    面包板第 30~35 列按新顺序重排, 相关跳线随之改为:
    3.3V b7->j33, 5V a33->上排+, 地 a32->上排-, GP4 i8->i35, GP5 j9->j34,
    EV3 黄线 (A) -> b35, 蓝线 (B) -> b34。LV 一侧假定与 HV 一侧同序, 图注中提醒对照丝印。
    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
2026-09-26 CLAUDE.md: 记录 5V 降压选用 DSN5000 (XL4005)
    用户手上有 DSN5000 (XL4005E1) 和 LM2596, 选用 5A 级的 DSN5000 给舵机/编码器供 5V,
    四臂整机也够用; LM2596 备用。
    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
2026-09-26 文档: 核实外部评审意见, 修正叉子空转和 57mm 魔方的错误说法
    - arm_concept.md: 叉子空转按 8mm 叉齿边缘接触重新计算, 约 ±4.5° (原来的 ±1° 错把接触点
    当成魔方角); 57mm 魔方放不进 56.8mm 开口, 改掉'内侧垫片'的错误建议;
    补充水平支撑风险和一对叉子慢速翻转的验证方法, 以及以魔方面为准的精度验收。
    - tools/lego/README.md: 死点不等于可靠锁定, 建议机械限位/过中心; 补充悬臂刚度和检查覆盖范围的限制。
    - machine.py: 支撑约束注明'水平叉子也能托住'尚未验证。
    - single_arm.md、CLAUDE.md: 增加对应的待验证项。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
2026-09-27 新增 mise.toml 配置文件，指定 Python 工具版本为最新。更新 README.md，添加 perfboard.md 文档链接，详细描述可拔插洞洞板设计及其安装步骤。新增 perfboard.md 文档，包含详细的接线指南、元件插入孔位、焊接步骤及面包板与洞洞板连接示意图。更新 single_arm.md，修正编码器接口信息，明确电平转换模块的使用。更新 wiring/build.p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
    [build.py, config.py, control.py, encoder.py, perfboard_layout.py, test_control.py]
2026-09-27 CLAUDE.md: 更新编码器电平方案, 撤回 BSS138 优先的旧结论
    实测低电平 1.6V, 原因是 EV3 编码器输出串联电阻与 BSS138 上拉分压;
    记录现行 SN74LVC2G17 方案和推挽确认后可用的电阻分压备选。
    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
2026-09-27 文档: 记录编码器万用表实测, 蓝线为推挽, 改为优先用电阻分压; 黄线无信号待查
    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
2026-09-27 文档: 按 LEGO 官方 EV3 编码器电路修正结论
    两路编码器都是推挽缓冲 + 串联电阻 (蓝 3.3k, 黄为型号电阻 3.3k/6.8k), 结构相同;
    撤回'蓝线串联电阻远小于 3.3k'的错误推断; 黄线恒定 3.2V 判定为接线断开待查。
    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
2026-09-27 编码器接口按最终方案改为电阻分压, 同步更新接线文档、图解指南和洞洞板图
    依据 LEGO 官方 EV3 编码器电路 (推挽输出 + 串联电阻) 和实测, 每路用 10k 串联 + 20k 下拉
    接 GP4/GP5, 不再使用电平转换模块:
    - single_arm.md: 物料、EV3 线表、编码器分压章节、验收步骤、待验证项
    - ev3-interface-verification.md: 结论改为最终方案, SN74LVC2G17 降为备选记录
    - wiring/build.py: 完整接线图、总览、面包板布局 (分压点第 26/28 列)、分步清单、检查表;
    3V3 改为接 DRV8833 STBY
    - wiring/perfboard_layout.py: 两板连接图和整机连线图改画分压电阻, 文字同步 (perfboard.md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
2026-09-28 保存单臂测试与接线设计，后续转向大马达结构验证
2026-09-28 乐高模型: 修正蓝色长销 (6558) 装不上的四处用法, 新增长销装配检查
    6558 的挡肩把销分成 1 孔长和 2 孔长两段, 过不了孔。旧模型只检查轴线对孔,
    没发现以下写法实际装不上:
    - 大马达耳朵: 长销穿 耳朵-框架-耳朵, 两片耳朵是同一个零件 -> 改用两根 2 孔长摩擦销各连耳朵和框架;
    - 装马达/马达支架/装固定叉: 立板和横梁已先连住 -> 长销掉头, 2 孔长段插横梁+立板, 固定板套短头;
    - 固定叉、叉子: 两边 3 孔梁先连住再往中间穿 -> 先在一侧 3 孔梁插好全部长销, 套中间层, 最后盖另一侧;
    - 舵机耳朵厚 2 孔, 挡肩落在孔中间 -> 销掉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
    [check.py, model.py, run_check.py]
2026-09-28 大马达固定: 改用 LEGO 官方 TRACK3R 的做法, 耳朵用红色带挡套长销 (32054)
    查了 LDraw 官方模型库里 LEGO 31313 的 TRACK3R 原厂模型: 马达尾部两片耳朵之间的缝里插框架一边,
    两根 32054 从同一侧穿 耳朵-框架, 挡套留在外面。本模型的结构本来就是"框架插缝",
    只把上一版临时用的 2780 换成官方用的 32054, 挡套能防止插过头。
    - ldraw.hole_segments: 按孔的实际长度给出每段孔 (不再合并成无限长直线), 用来判断挡套是否伸进孔;
    确认马达耳朵为 x=±(10..30) 两片、中间 1 孔宽的缝, 第 1、3 孔为圆销孔, 中间为十字孔。
    - check.long_pins: 新增 32054 挡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
2026-09-28 大马达加第二个固定点: 尾端面经 3 层 7 孔梁后垫块接横梁
    只靠尾部耳朵两根销时, 机械手的重量绕尾部往下压的力矩全压在这两根销上。马达尾端面下排 3 个销孔
    正对横梁上排, 中间正好空 3 个孔距, 用 3 根 7 孔梁叠成后垫块 (层间错开摩擦销), 后接横梁、前插尾端面。
    颈部鳍片 (LEGO 教育版小车的主固定点) 后面紧挨马达方箱, 梁引不回立板, 未采用。
    check: 销与孔的啮合改按每段孔的实际长度判断 (hole_segments), 不再用无限长孔线,
    避免把穿过马达包围盒的销误判为插在马达孔里。原始模型仍报出全部 16/14 处长销错误。
    run_che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
2026-09-28 大马达固定框架下加底部垫梁, 撑在底座框架上
    实物反馈: 马达连同固定框架整体只挂在立板上, 搭出来下垂。框架底边和底座框架顶面之间正好空
    1 个孔距, 垫一根 7 孔梁, 3 个摩擦销竖着插进框架底边的贯通孔, 梁压在底座框架前边上。
    run_check 两种马达问题数 0; 说明书重新生成。承重效果待实物确认。
    Claude-Session: https://claude.ai/code/session_016rHZpN9YgUrLSyjADeSeKp
    [model.py]
2026-09-28 机械臂导轨根部加两片 3 孔细梁夹紧
    用户反馈马达不再下垂但机械臂仍然下垂。导轨原来只靠转动座远端 1 孔厚的圆孔支撑,
    十字轴在圆孔里有间隙, 前面约 84mm 悬臂会把间隙放大到叉尖。改为边框前后各一片 3 孔细梁,
    十字孔同时卡住两根导轨并夹住边框, 外侧半轴套挡住。重新生成大/中马达版说明书。
    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
2026-09-28 后垫块另一端加一根蓝色长销连横梁（按用户实物补进说明书）
    用户在实物上用一根 1x3 蓝色长销把后垫块和横梁多连了一处，明显更稳。垫块第 7 孔的中、后两层
    和横梁第 6 孔原来都空着；垫块已连成一体，挡肩只能落在后层和横梁之间，长段在垫块里、短头插横梁。
    run_check 零问题，重新生成大/中马达版说明书。
    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
    [model.py]
2026-09-29 新增单臂原型 v2：转盘主轴承、承重和传扭分开（独立目录，不改 v1）
    按资深乐高 Technic 设计标准评估 v1：几何推导和检查工具可靠，但结构是逐步打补丁长出来的，
    机械臂整体挂在马达输出盘三个共线销上，输出轴间隙在叉尖放大，是实物下垂的根本原因。
    v2 放在 tools/lego/v2/ 和 docs/lego/v2/，v1 文件一个都没动：
    - 60 齿转盘 (18938/18939) 当主轴承，固定方式照搬官方 42082/42100（框架与转盘耳朵共面，销沿径向穿短边）
    - 马达只经 7 号轴传扭矩，输出盘销孔不用；两片 3 孔细梁卡轴带动舵机座
    - 机械臂、叉子都做成闭合盒子；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
2026-09-29 v2 README 记下已发布的说明书链接
    Claude-Session: https://claude.ai/code/session_01Ms6v6oKbLQsBqZ2uktk7cX
2026-09-29 新增四臂整机 v3 乐高模型 (按 CubeStormer 3 思路), 规划器加相邻两臂不能同时水平的可选约束
    v1、v2 保持不动, v3 放在 tools/lego/v3/ 和 docs/lego/v3/:
    - 夹爪改为两片会转的夹指 + 肘节连杆, 推到死点自锁, 水平时也夹得住, 舵机不受力
    - 舵机固定在后面的平台上, 推杆穿过转盘中孔开合夹爪, 机械手可无限旋转, 不需要角度限制
    - 马达偏到侧面, 36 齿带 60 齿转盘外圈 (减速 1.67 倍), 转动部分只剩约 52mm
    - 四个相同模块 + 16 块框架的风车形底座; 模块整体前移半个孔距, 让相邻模块孔位对齐
    - run_check.py: 单模块夹紧/松开、夹指中间行程、整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
2026-09-29 v3 修正转盘装不上的问题, 并新增按搭建顺序模拟插销的检查
    用户实物反馈: 第 3 步转盘下半装不上。原因是摩擦销中间有挡环, 转盘凸台被同一块框架四面围住,
    两头的销只能从框架外面插, 只能进一半。官方 42100 是先把销插进凸台, 再从外面压上分开的梁。
    - 转盘下半: 凸台卡在框架开口里, 圆盘边沿贴框架正面, 背面用两根竖放 5 孔粗梁压住, 两头不插销
    - 转盘上半: 并入机械头, 先插销再从两侧压上侧板; 装机械头时和下半直接扣合
    - 底座最后合拢的那条缝: 两组销方向垂直插不进, 改为只顶住不插销
    - 曲柄与连杆之间的轴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
    [booklet.py, model.py, run_check.py]
2026-09-29 v3 转盘下半的固定方式注明依据官方 42082, 说明书加官方原件对照图
    用户质疑第 3 步改法 "没有连接点" 并要求找最专业的做法。分析 LDraw 官方模型库中
    用到 18938/18939 转盘的 6 套 Technic 原厂模型, 固定方式只有两类:
    A. 42082 利勃海尔 R 9800: 凸台卡进 7x5 框架开口, 背面两根 5 孔粗梁压住, 凸台两头孔不用;
    B. 42042/42053/42055/42100: 先把销插进凸台两头 (或 32054 从外穿), 再压上两根分开的梁。
    v3 转盘下半 (被墙框架围住) 与 A 完全一致, 转盘上半 (装在两块分开的侧板上) 用 B, 结构不变,
    只补充出处、README 对比表和官方原件渲染图 (ref420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
2026-09-29 v3 第 6 步：马达前端改为颈部两层梁垫高，新增插深检查
    用户反馈马达的后端挡住了 7x5 框架。原因是大马达颈部比输出盘和方箱
    缩进 2 个孔，框架贴不到颈部的两个圆孔。改为颈部圆孔各套一根 5 孔梁，
    外面再叠一根，框架压在外层梁上；去掉与竖墙销方向冲突的马达—底座销。
    run_check.py 新增插深检查（每个销两段都要插进孔里），原连接检查把孔
    当作无限长直线，漏掉了这类问题。
    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
    [booklet.py, model.py, run_check.py]
2026-09-29 v3 转盘下半改用红色带挡套长销 32054 固定
    用户提出用带大头的 1x3 销。框架短边中间的侧孔正对凸台两头的单面销孔，
    32054（1 孔挡套 + 2 孔销）可以从框架外面穿过短边插进凸台，挡套留在外面，
    是官方 42042 等模型和 TRACK3R 的用法。每个模块省掉背面 2 根压梁和 4 个销，
    搭建步骤从 22 步减为 21 步。42082 的压梁做法作为对照保留在说明书里。
    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
2026-09-29 v3 转盘下半的 32054 改为从中孔里面插，第 7 步写清 7 号轴插到底
    用户提出从框架里面插更美观：挡套藏在转盘凸台里面，装上转盘上半后看不见。
    凸台两端壁之间正好 3 孔长，销能平放进去再往外推；两根挡套同排会互相挡住，
    所以一上一下错开。已用采样检查放入和推出路径、装好后与推杆和上半不干涉，
    间隙几乎为零，需实物确认。
    第 7 步：用户反馈 7 号轴露出长度和图不一致。大马达输出盘十字孔是贯通的，
    轴要推到底，与另一面输出盘平齐，文字里补上各段长度。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
2026-09-29 v3 框架只用在最需要刚度的地方，其余换成横梁（68 块降到 40 块）
    用户定的原则：框架只用在最需要刚度或三个方向交汇的地方，其余换成横梁。
    - 底座：16 块框架改为 8 根 15 孔梁，每条边上下两层叠接，角上首尾相接，
    销全部竖直；桌面下移到 y = 290，竖墙等高度不变。
    - 马达前端：颈部改用竖放 3 孔梁同时插两个圆孔，外层 11 孔、9 孔横梁直接
    接竖墙框架正面孔，省掉马达前板和连接板；尾部固定板下加 5 孔梁当脚。
    - 舵机平台：后半块框架改为两根 15 孔梁 + 5 孔垫块，支腿下移一格。
    保留的框架：竖墙 3、机械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
2026-09-29 v3 说明书：删除多余的第 21 步图（现在共 20 步）
    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
2026-09-29 v3 恢复框架底座，模块里更多框架换成竖梁和 L 形梁（整机 36 块）
    用户指出：底座不该简化（要有完整的面），而模块里还有很多框架可以用竖梁、
    L 形梁代替而不影响刚度。
    - 底座恢复为 16 块框架的风车形方框，桌面回到 y = 270。
    - 机械头侧板：每侧改成两根 3x5 L 形梁，长臂接转盘上半、短臂和长臂末端
    共 4 个销接 9 孔梁，不会绕销转动。
    - 平台支腿：两块框架改为每侧一根 L 形梁（短臂 2 个销插框架长边侧孔）+
    一根 11 孔竖梁。
    - 马达尾部耳朵缝里的框架改为一根竖放的 7 孔梁，兼作脚。
    模块里只留竖墙 3、推杆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
2026-09-29 v3 底座改为横梁两层交叉铺成的平台（不用框架，保留完整的面）
    用户说明底座不需要 7x5 框架，但要有面积。每条边是 5 个孔宽的平台带子：
    上层 5 列长梁并排铺满（15 孔 + 9 孔），下层 5 孔短梁每隔一个孔横垫一根；
    四角按风车方向分配，下层 7 孔梁顺边铺，把相邻两条边连成一体，销全部竖直。
    桌面下移到 y = 290，支腿竖梁、马达尾部竖梁加长到桌面。整机框架 20 块。
    run_check、four_arm 零问题，单元测试通过。
    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
    [booklet.py, model.py]
2026-09-29 v3 底座改为镂空网格，在不影响刚度的前提下省料
    用户问底座是否有必要铺满。占地保持 5 孔宽不变（站得稳），上层从 5 列减为
    3 列（两侧 + 竖墙所在的正中），下层横梁从每 2 孔一根改为每 4 孔一根，
    上下两层交叉处都有销，仍是刚性网格。每条边 24 根梁、47 个销降为 14 根、
    30 个销。run_check、four_arm 零问题，单元测试通过。
    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
    [booklet.py, model.py]
2026-09-29 v3: 底座改用 45680 套装的 7x11 框架，修第 9 步单销晃动，说明书加可旋转 3D 模型
    - 底座：每个模块一块 7x11 框架 39794（用户的 45680 套装里有 4 块；Brickset 清单显示 15x11 大框只有 2 块）。
    框架的竖孔和侧孔交替，竖孔离中心是奇数个半孔距，框架往马达一侧偏 20 LDU 才能和竖墙底边的侧孔对上。
    下层 15 孔梁垫在框架长边下面伸到角上，角上用 3x5 L 形梁每边 2 个销连接：单销交叉是铰链，
    四个角都是铰链时底座能被推成菱形。7x11 比竖墙窄，梁放在框架下面才不会从竖墙底下穿过。
    原横梁网格每条边 14 根梁、30 个销，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
2026-09-29 v3: 删除未使用的 15x11 大框零件图
    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
2026-09-29 v3: 底座改回 15x11 大框（用户确认手上有 4 块）
    用户实物有 4 块 15x11 大框 39790（Brickset 清单写 2 块，以用户为准）。每模块一块大框，
    仍往马达一侧偏 20 LDU 对上竖墙底边侧孔；偏过去的长边正好在马达尾脚下面，尾脚改为 7 孔竖梁踩在大框上。
    下层 15 孔梁垫在两条长边下面伸到角上，角上 3x5 L 形梁每边 2 个销，保持刚性。
    run_check 0 问题，four_arm 结论不变，单元测试通过。采购表按 4 块大框扣减。
    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
    [booklet.py, model.py]
2026-09-29 v3: 平台支腿接到底座大框（用户指出支腿只踩在桌面上）
    贴着大框长边外侧的那根支腿：11 孔竖梁上移一个孔，下端接一根倒放的 3x5 L 形梁，
    短臂用 1 个摩擦销插进大框长边的侧孔。平台一头用销接竖墙、一头经这根支腿接底座，形成闭环。
    为了能装上（销都沿同一方向插），这根竖梁和它的 4 个销挪到“装平台”这一步，最后从外面压上去。
    另一根支腿在大框开口里，没有能对上的孔，仍踩在桌面上，只承受竖直方向的力。
    第 11 步改为从另一侧、只取景当前模块，看得到这处连接。run_check 0 问题，four_arm 不变，单元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
    [model.py]
2026-09-29 v3: 3D 模型的 three.js 改为本地文件，不再从 jsDelivr 在线拉取
    booklet.py 把渲染用的 node_modules 里 three.js 0.170.0（MIT）需要的 4 个文件和 LICENSE
    复制到 docs/lego/v3/three/，importmap 指向本地路径（用户要求）。
    已用无头浏览器验证：除字体外的外网请求全部拦截时，3D 模型照常加载。
    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
2026-09-29 v3: 3D 模型支持键盘快捷键，并修正步骤错位
    - 快捷键（用户要求）：←/→ 上一步/下一步，Home/End 第一步/全部，A/D 左右转，W/S 上下转，
    +/- 缩放，R 复位；只在 3D 区域在屏幕上时响应，输入框里不响应。说明里列出了按键。
    - 修正：LDrawLoader 会把连续的空步骤并成一步（第 18 步“装机械头”没有新零件），
    导致滑块在第 18 步就显示了第 19 步的另外三个模块。booklet 输出有零件的步骤号表
    V3D_STEPMAP，viewer 用它把 buildingStep 换回真正的步骤号。已用无头浏览器核对各步零件数。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
    [booklet.py]
2026-09-29 v3: 写清舵机垫块的销插在哪几个孔（用户反馈与舵机长销冲突）
    第 9 步只写了“3 个摩擦销”，没说插哪几个孔，照着搭容易插到两头，和第 10 步舵机耳朵的
    蓝色长销抢同一个孔。模型里本来就是摩擦销在中间 3 个孔、长销在两头，这次把孔位写进第 9、10 步的文字。
    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
2026-09-29 v3: 第 16 步写明十字接头是 32039（一头十字孔、一头横圆孔）
    用户以为十字接头两头都是十字孔。32039 一头是顺长度方向的十字孔（接推杆），另一头是横着的圆孔（穿无摩擦长销），
    设计没错；容易和两头都是十字孔的轴连接器 59443 / 6538 混淆（45680 套装里有的是 59443），在步骤文字里注明。
    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
2026-09-29 v3: 十字接头 32039 横孔是十字孔，无摩擦长销改为 3 号轴；检查程序补上“圆销插十字孔”
    用户实物发现第 16 步插不进去：32039 两个孔都是十字孔（顺长度方向的接推杆，横着的也是十字孔），
    原设计当成圆孔穿米色无摩擦长销 32556a。改为穿 3 号轴 4519（45680 里有 14 根），
    轴卡在十字孔里不转，两根连杆的圆孔绕轴转，死点几何不变。我上一条回复说“设计没错”是错的，已更正。
    run_check.py 新增 pins_in_axle_holes：原连接检查只看孔轴线，分不出圆孔和十字孔。
    在销插进每个零件的那段孔里，离轴线 3.5 LDU 取 8 个方向，十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
2026-09-29 v3: 第 16 步十字接头改用 32013（一头十字孔一头圆孔），恢复无摩擦长销
    用户指出上一版改穿 3 号轴不是最佳：角度连接器 1 号 32013 正好一头顺长度方向的十字孔、
    另一头横圆孔，而且更常见。换成 32013 后圆孔里照原设计穿米色无摩擦长销 32556a，
    两根连杆套在长销两端，孔位和死点几何与原来完全相同。说明文字提醒不要拿成两孔都是十字孔的 32039。
    run_check 0 问题（含圆销插十字孔检查），four_arm 不变，单元测试通过。
    Claude-Session: https://claude.ai/code/session_01Ms6v6oKbLQsBqZ2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
    [booklet.py, model.py]
2026-09-29 v3: 转盘传动改照官方 42100（20 齿双面锥齿轮、中心距 5 孔），马达往转盘挪 1 孔
    用户实物装好后 36 齿和转盘 18938 咬不上，要求优先用成熟方案。用本地 OMR 官方模型核实
    18938 在官方套装里的驱动方式：42100 利勃海尔挖掘机用 20 齿双面锥齿轮 18575 平行轴、
    中心距 100 LDU、齿轮中面和转盘上半原点平齐；42042、42055 用 12 齿双面锥齿轮 90° 从下面啮合。
    按 42100 改：
    - 36 齿 32498 换 20 齿 32269（或 18575），减速 1.67 倍变 3 倍，马达轴离转盘轴 120 改 100；
    - 马达整体往转盘挪 20 LDU：颈部下横梁 9 孔改 7 孔（接竖墙 1 销，与马达、3 孔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
2026-09-29 v3: 马达底部销到底座大框，齿轮背面和转盘背面平齐
    用户指出两个问题：马达下部只踩桌面、上部受力会晃；齿轮没有和转盘齿圈平齐。
    - 马达底面有一排 3 个朝下的销孔（LDraw 95658 核对：z = -120，1 孔深），正好在底座大框长边正上方，
    两边两个对准大框竖孔，离大框上面正好 2 个孔高。用两层平放的 5 孔粗梁垫满，竖销连接
    （马达-上层 3、两层之间 2、下层-大框 2），去掉原来的 9 孔尾脚和它的 2 根带挡套长销。
    - 装配顺序改为：马达先横推装到竖墙，竖墙和马达再一起竖着压到底座，两处的销方向一致，
    collar_pins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
    [booklet.py, model.py]
2026-09-29 v3: 马达底块下面的两个大框竖孔改用底座梁的蓝色长销，检查程序加“同孔”检查
    用户第 8 步实物发现：马达底块要销的两个大框竖孔，第 1 步底座梁的摩擦销已经占满，插不进。
    改为这两个位置在第 1 步就用蓝色长销 6558：1 孔长的一段朝下插进梁，挡肩在梁和大框之间，
    上面露出 1 孔，第 8 步马达底块下层梁直接压上去；去掉第 8 步那 2 个摩擦销。
    run_check 新增 shared_holes：两个销/轴轴线重合、长度重叠 > 2 LDU 就报（碰撞检查不管销和销）。
    旧模型报 8 处（4 个模块各 2 个），新模型 0 问题；单元测试通过。
    Co-Authored-B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
    [model.py, run_check.py]
2026-09-29 v3: 转盘驱动齿轮按用户实测换成 24 齿直齿轮（中心距 5 孔不变）
    用户在 5 孔中心距上实测几种齿轮，24 齿直齿轮 3648 咬合最好。20 齿双面锥齿轮换成 24 齿，
    轴向位置不变（背面和转盘上半背面平齐），减速 3 倍变 2.5 倍（四臂固件 GEAR_RATIO = 2.5）。
    按标准节圆 24 齿要 5.25 孔，实测 5 孔最好，说明转盘外圈实际节圆比 75 LDU 小，以实测为准。
    run_check 齿轮许可规则、说明书文字、采购表、README、CLAUDE.md 同步。
    run_check 0 问题，单元测试通过。
    Claude-Session: https://claude.ai/code/se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
    [booklet.py, model.py, run_check.py]
2026-09-29 v3: 第 16 步十字接头改回 32039 + 3 号轴（两个孔都是十字孔）
    用户指出：32013（一头圆孔）+ 无摩擦长销的方案，长销在圆孔里能转能滑，没有东西挡住会慢慢退出来，
    还得另加限位；原来 32039 横孔（十字孔）穿 3 号轴，轴卡住不转、不易窜动，连杆的圆孔绕轴转，更可靠。
    上一版是我没评估就接受了换件建议。改回 67e8cfd 的做法，代码注释和 README 写明两种方案的取舍。
    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
    [booklet.py, model.py]
2026-09-29 v3: 第 16 步十字接头按用户选择改回 32013 + 无摩擦长销
    用户说明上一条"要加限位器"指的不是这里，在决策卡上选择改回 32013（一头十字孔一头圆孔）
    加米色无摩擦长销。撤销 b4459cc，恢复到第 23 版的做法。
    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
    [booklet.py, model.py]
2026-09-29 v3: 推杆改 16 号轴插到底并写明定死点方法，舵机连杆两头加半轴套防滑出
    用户实物反馈两个问题：
    1. 第 17 步 12 号轴装上后，夹爪连杆和推杆到不了垂直。模型里推杆只插进十字接头一半，
    实物会插到底，十字接头往后差半个孔，死点对不上。改为插到底（ROD_FRONT_IN 10 -> 20），
    换 16 号轴 50451（12 号插到底后后端退不到导向框架后面的轴承孔）。死点实际由十字块两边
    半轴套的位置决定，装机械头一步写明：舵机转到夹紧，手推推杆到连杆垂直，按住再推紧半轴套。
    2. 舵机和滑杆（十字块）之间的连杆容易掉出来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
    [booklet.py, model.py]
2026-09-29 v3: 推杆改用 2 号轴 + 光面轴连接器 + 12 号轴接长（用户没有 16 号轴）
    推杆插到十字接头底后至少要 13 孔长（12 号轴后端正好停在后轴承孔前面），乐高没有 13~15 号轴，
    用户也没有 16 号。改为 2 号轴插十字接头，59443 光面轴连接器紧贴其后，再接 12 号轴，共 14 孔长。
    连接器全行程只在转盘中孔里走，碰不到轴承孔；夹紧时后端穿出后轴承孔 1 个孔。
    run_check 0 问题（含张开行程扫描），单元测试通过。
    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
    [booklet.py, model.py]
2026-09-29 v3: 马达侧舵机平台支腿接到底座
    用户指出靠马达一侧的支腿只踩在桌面上。这根支腿在大框开口里, 离大框长边 3 个孔,
    且支腿 x 和长边侧孔差半个孔距。做法: 装竖墙前在大框长边内侧用 2 个摩擦销贴一根 3 孔梁
    (中间孔正对支腿), 装平台后用 5 号轴穿支腿倒数第 2 孔, 中间 2 个轴套撑开, 轴头插进 3 孔梁,
    支腿外侧再套 1 个轴套。3 孔梁必须在马达之前装 (马达压在它上方)。
    第 8 步换视角以看见这根梁; 采购表 5 号轴 12、轴套 32。run_check 0 问题。
    Claude-Session: https://claude.ai/c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
    [booklet.py, model.py]
2026-09-30 v3: 舵机平台改为前挂竖墙、后落后墙, 去掉两侧支腿
    用户认为马达侧支架 (轴 + 轴套撑到大框长边内侧) 是初级做法, 要求系统性、实用又专业。
    改成和前面竖墙同一种做法: 平台后端下面竖一块 7x5 框架当后墙, 上边侧孔竖销到两根 15 孔梁
    (同时取代原来的后端 5 孔横撑), 背面两根 9 孔竖梁用正面孔销住后墙, 下端沿推杆方向销进大框
    后短边的侧孔; 这 2 个销和前端接竖墙的 2 个销同向, 平台一推到位。
    两侧的 L 形梁 + 11 孔竖梁支腿、大框长边上的 L 形梁和 3 孔梁底脚全部去掉, 左右对称,
    不再占大框开口。每模块框架 5 -> 6 块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
2026-09-30 v3: 删掉误生成的 16 号轴零件图
    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
2026-09-30 v3: 平台后端支撑改用 55615, 去掉后墙框架; 舵机曲柄改 3 号轴
    1. 用户指出后墙 7x5 框架违反 "能不用 7x5 就不用", 建议用 55615。
    两根 15 孔梁下面各挂一个 55615 (横臂 2 个销朝上插梁, 竖臂孔沿 z) + 9 孔竖梁;
    马达一侧竖梁下端再用一个 55615 落到大框后短边竖孔 (z=0、40), 另一侧竖梁直接销进
    大框长边侧孔。竖梁都在平台装好后从外侧沿 z 压上, 不和平台沿推杆方向装入冲突。
    恢复后端 5 孔横撑 (挪到最后一个孔)。框架回到每模块 5 块, 整机 20 块。
    2. 用户实物: 舵机输出轴长度和图纸有出入, 曲柄离舵机远一点 2 号轴就套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
2026-09-30 v3: 垫块改 2 个销, 让出平台下 55615 的销孔; 同孔检查加上零件自带的销
    用户指出第 9 步舵机那一侧 55615 横臂的销要插的梁孔 (倒数第 5 个), 已被垫块第 2 个孔的
    摩擦销从上面占满。run_check 的同孔检查原来只看单独的销/轴, 没算 55615 自带的 4 个销, 所以漏检。
    - run_check: shared_holes 把 55615 自带的销也算进去 (旧模型现在会报这个冲突)。
    - 垫块只插第 3、4 个孔 2 个销 (第 1、5 个留给舵机耳朵, 第 2 个空着), 两个销仍能固定垫块。
    - 第 9 步说明写清两侧 55615 各插哪两个孔。
    run_check 0 问题。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
    [model.py, run_check.py]
2026-09-30 v3: 夹指转轴改 6 号轴, 9 孔梁外侧各加半轴套
    用户指出: 夹指受力或扭转时, 两侧 9 孔梁会被撑开, 轴套和梁之间的缝会变大。
    原来 5 号轴和 9 孔梁外面平齐, 两根梁之间只靠里面的轴套顶住, 往外张没有东西拉住。
    改 6 号轴, 两头在 9 孔梁外面各套一个半轴套, 轴把两根梁夹住当拉杆。
    半轴套离侧板 L 形梁短臂末端约 2 LDU, run_check 0 问题, four_arm 无变化。
    采购表: 5 号轴 -> 6 号轴 8 根, 半轴套 52。
    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
    [booklet.py, model.py]
2026-09-30 单臂测试改成 v3 单臂: 齿轮比 2.5, 控制参数按比例换算, 补充 v3 验证要点
    用户 v3 单臂已搭好。config.py: GEAR_RATIO 1.0 -> 2.5 (24 齿带 60 齿转盘);
    GAINS 按空载实测值换算到机械手角度 (v_full / 2.5, kp、kd × 2.5, vmax 240、amax 2400),
    标明是推算值, 装机后要重测。舵机脉宽注明 v3 曲柄开合约 115°, 旧值要重新标定。
    docs/single_arm.md 加 v3 小节: cal 应约 1800 计数、舵机死点标定、回差要看魔方、夹紧对中检查。
    test_firmware 的 speed 断言按齿轮比换算。57 个测试通过。
    Claude-Session: https://claude.ai/co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
2026-09-30 单臂测试文档按 v3 重写: 明确正方向、零位和各步通过标准
    用户指出 check 只说正转却没说哪个方向是正。重写 docs/single_arm.md:
    - 第 5 节开头加约定: 角度按机械头算; 从舵机那头朝魔方看顺时针为正
    (与 machine.py 一致), 齿轮会反向所以只看机械头; 零位、夹紧/松开的
    定义; 急停方法; RESULT 字段和三种失败原因的含义
    - 测试改为第 0~9 步: 上电检查、check + duty 目测确认方向 (反了两个
    INVERT 都改)、cal 约 1800、舵机死点标定、friction/speed、空转、
    回差 (看机械头不看编码器)、夹魔方、拧面、汇总, 每步写通过标准
    - 去掉中马达/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
    [arm_test.py, config.py]
2026-09-30 更新文档和配置以支持 v3 版本的单臂测试。主要更改包括：
    - 在 `.gitignore` 中添加 `arm.log` 文件以避免日志文件被跟踪。
    - 在 `CLAUDE.md` 中更新了单臂测试程序的描述，明确了 v3 版本的验证结果和接线指南。
    - 在 `README.md` 中增加了电路与硬件验证的说明，提供了生成电路文档的命令。
    - 在 GitHub Actions 的 `test.yml` 中添加了检查电路文档的步骤。
    - 更新了多个文档以反映最新的硬件配置和测试结果，确保文档与实际硬件一致。
    此外，更新了多个图像文件以支持新的文档内容。
2026-09-30 v3: 夹指绕乐高皮带做预压和摩擦（2026-09-30 实物反馈：推杆锁死后仍有间隙、打滑）
    - 原因是几何而非舵机力量：死点时夹指平行，闭合开口由孔位固定为 56.8mm，比 56mm 魔方大 0.8mm，压紧力为零；
    死点附近推杆走 3mm 夹指才动 0.3mm。用户不接受改造零件或非乐高材料，所以用乐高 15mm 皮带（x37）
    横向绕在每根夹指第 1~2 孔之间 2 圈，凸出约 1.5mm、压进魔方约 1mm，接触面变成橡胶。
    - make_custom_parts.py 新增 rubberband_on_beam，按绕好后的形状生成 parts/rubberband.dat（LDraw 库里没有皮带）。
    - model.py：CATALOG、BAND_X，新增第 12 步"夹指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
2026-10-01 搭建乐高圆弧压头方案并补齐四臂避让检查
    [bom.csv]
2026-10-01 按四组42610与50945库存重做四臂压头并验证避让
    [bom.csv]
2026-10-01 统一上下轮胎压头并按整机八组更新清单
    [bom.csv]
2026-10-01 改用两端十字孔薄梁并移除圆孔薄梁需求
    [bom.csv]
2026-10-01 补充连续回转与受力审查并标记后部干涉
    [load_test_template.csv]
2026-10-01 合并前保存主工作区的夹块草稿与用户修改
    [bom.csv]
2026-10-01 完成双侧薄梁压头与后部避让修正，更新验证和搭建说明
    [bom.csv]
2026-10-01 补充100g重力承重分析、下沉诊断与单臂测试记录
    [gravity_test.csv, load_test_template.csv]
2026-10-01 fix: 为上下夹指增加独立防翻折开限位
    [bom.csv]
2026-10-01 增加Watt承重导向与铰接驱动并验证空间载荷
    [bom.csv, gravity_test.csv]
2026-10-01 改善 Watt 活动轴及后部旋转轴套间隙
    [bom.csv]
2026-10-01 记录短 Watt 横梁候选的碰撞与未采用原因
2026-10-01 缩短推杆并前移支承，补计前接头偏心弯矩
    [bom.csv]
2026-10-01 docs: 将复杂搭建步骤拆成逐件装配图
2026-10-01 fix: 修正支架长销装配顺序与转盘轴销方向
2026-10-05 chore: 忽略本地导出的 output/ 与 tmp/
    这两个目录只放本地导出的 PDF 和临时文件，不进版本库。
2026-10-05 feat(lego): v4 四臂整机（反向连杆、转盘内推杆导向、承重加固）及分步说明书
    在基准版（b9aa5d5，双侧轮胎压头＋防翻折限位）上修改：
    - 十字接头移到连杆前方，往后拉夹紧；推杆为一根 12 号轴。
    - 推杆导向用 39793 连接块，卡在转盘上半两个凸耳之间。4 根蓝色长销同时
    连接侧板 L 形梁、凸耳和导向块；夹紧时十字接头离导向 8.25mm，导向兼作
    连杆死点挡块。之前导向贴在转盘正面，余量只有 0.25mm，实测轮胎压不紧。
    - 侧板内侧梁改为一长一短两段，让出连杆滑动通道（实测连杆贴侧梁摩擦严重），
    外侧加 7 孔梁连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
    [bom.csv]
2026-10-05 docs(lego): v5 推紧方案试验记录（未采用）
    试验：恢复往前推夹紧，十字接头改用 32034，后端插推杆、前端插 5 号导向轴；
    推力靠推杆端面传递，不靠摩擦。
    未采用原因：推紧方向下，十字接头在连杆后方，松开时往后退。推杆后退超过约
    40% 行程后，连杆会顶到转盘上半正面，全开时穿入约 5.8mm；要避开，只能把机械头
    加长 2 孔。基准版 v3（b9aa5d5）原模型存在同样的干涉，此前体素检查漏掉了浅穿入，
    网格检查只查有用途标记的零件，所以一直没被发现。最终改用 v4 的方案，
    原因与模型状态见 tools/lego/v5/README.md。
    Co-Aut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
2026-10-05 docs: 补充库存约束、路线复核、基准版说明书与机械头/后部实验记录
    - AGENTS.md、CLAUDE.md：乐高库存以 docs/lego/inventory.md 中的用户确认记录为准
    （薄梁只有十字端孔款，禁止使用全圆孔薄梁）。
    - docs/architecture-direction-review.md：四夹爪机械路线复核（网络调研加估算）。
    - docs/lego/v3-baseline/：v4 的基准版（双侧轮胎压头＋防翻折限位）说明书快照，
    包括承重测试模板和机械审查结果。
    - docs/lego/v3/design/：v3 机械头重设计、方盒滑块、架构重置的讨论稿。
    - artifacts/：机械头架构评审、机械头框架小样、机械头重设计、后部框架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
    [bom.csv, gravity_test.csv, load_test_template.csv]
2026-10-05 docs(lego): 整理 docs/lego 目录，将历史版本归档至 archive 并确立 v4 为当前定型基准
    [bom.csv, gravity_test.csv, load_test_template.csv]
2026-10-06 fix: 收紧 v4 控制与舵机标定安全约束
    [arm_test.py, build.py, config.py, direct_wiring.py, motor.py, pico_sim.py]
2026-10-06 chore: 更新 .gitignore 以忽略 pico 目录下的 arm.log 文件，并调整 arm.log 内容以反映最新的测试信息和状态
2026-10-06 fix: 取消手动舵机标定的 20µs 步长限制
    允许首次定位后直接指定已声明区间内的绝对脉宽，保留首脉冲、区间及会话门禁；同步帮助、标定文档与大步跳转回归测试。
    验证：96 项单元测试、接线文档一致性和固件语法检查通过。未连接或刷写硬件。
    [arm_test.py, build.py, test_v4_safety.py]
2026-10-06 fix: 更新电机和编码器反转设置为 False，以确保正确的信号读取和控制
2026-10-09 文档：在原接线页加入 R 与条件式 R+L 切换并验证网络
2026-10-11 refactor: 更新舵机开合脉宽设置，移除旧的 arm.log 文件
2026-10-11 test: 修正已填舵机端点的未标定安全回归与说明
2026-10-11 Synchronize final 501-step 882-part mechanical assembly and reproducible sources
2026-10-11 Rebuild source download from repository and correct final assembly scope
2026-10-11 refactor: isolate wiring sources from generated diagrams
2026-10-11 fix: unify current wiring navigation and label legacy guides
2026-10-11 feat: add isolated L arm configuration and safe single-arm selection
2026-10-11 refactor: unify R and L config with verified device migration
2026-10-11 Add integrated four-arm KiCad A0 board with checked routing and release holds
2026-10-11 Package PCB engineering review and resolve distribution test prerequisite
2026-10-11 Clarify motherboard plus socketed Pico H is a two-PCB assembly
2026-10-12 Integrate onboard RP2040 and drawing-based EV3 jacks on A1 PCB
2026-10-12 Add reproducible A1 power boundary simulations and explicit vendor model blocker
2026-10-12 Correct audited power BOM and add bounded VM discharge protection
2026-10-12 Use whitespace-delimited KiCad symbol library table entries
2026-10-12 Record required KiCad 10.0.7 migration and download blocker
2026-10-12 Migrate A1 to KiCad 10 and record blocked vendor-model transients
2026-10-12 Adapt A1 USB shield slots for JLC and close assembly preflight
2026-10-12 Raise visible A1 silkscreen labels to domestic JLC 1mm guidance
2026-10-13 Add externally supported dual-servo static positioning
2026-10-13 Revert "Add externally supported dual-servo static positioning"
    This reverts commit 97c61f7b87302b3bffcd7373dabd69c033152991.
2026-10-14 Bundle portable PCB display models with explicit licensing and precision limits
2026-10-14 Package unique DC5521 engineering first-board delivery
2026-10-14 将 A1 风险丝印改为工程样板提示，并重新导出制造文件
    - 正面丝印 "ENGINEERING HOLD" 改为 "PROTOTYPE"，"EV3 PINMAP/CURRENT UNVERIFIED - DO NOT FABRICATE"
    改为 "VERIFY EV3 PINMAP BEFORE MOTOR USE"。原文会让工厂 CAM 停单，并永久印在板上；
    用户已确认接受首板 EV3 风险，提醒改为上电前核对针序。新文字更短、居中位置不变。
    - generate.py 同步修改。重新运行 build.py：ERC/DRC 仍为 0；除 F.Silkscreen 外，
    Gerber/钻孔只有时间戳变化。PNG 预览改用 cairosvg 渲染。
    - 审核脚本中写死的 /workspace 路径改为读取 KICAD_APP_RUN 或脚本自身所在位置（保留原值作为默认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
2026-10-14 按 3cfff7c 设计重新打包工程首板，补全 LCSC 编号与 CAM 确认项
    - 设计基线改为 3cfff7c（只改丝印），重新运行控制器/UF2 核验、电源边界、
    30 项制造一致性检查和 JLC 几何预检，生成新包 quadcuber-A1-first-board-3cfff7c；
    删除旧 db20b98 包 ZIP。
    - SMT BOM 填入 39 个按精确 MPN 逐个核对的 LCSC 编号（2026-10-13 页面），
    part-matching.csv 增加页面库存列。W25Q16RVCNJQ 和 MF-MSMF110/16X-2 未上架，
    标为 BLOCKER（需代购或寄料，禁止换后缀）；库存为 0 或很少的料单独标注。
    - 自焊清单备注改为包内自洽的说明，去掉指向包外 sources/ 的引用和内部用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
2026-10-14 新增 B1 模块底板：只插 Pico H，其余元件手焊，2 层 99×99mm
    A1 集成板的光板加贴片费用对个人项目太高（光板 ¥553 起，另有 4 个料号缺货），
    本月账户只能领嘉立创 EDA 专用券，所以改做可付费打样、全部手焊的 B1：
    - 方案文档 docs/b1-carrier-board.md：下单约束、电源（P-MOS 反接保护加 12V 栅源稳压管、
    TVS/母线电容/泄放电阻、LM2596T-5.0 专供舵机、7805 加 1N5819 供 Pico VSYS 和编码器）、
    引脚（沿用 wiring/spec.py 的 ARMS，固件不用改）、面积和采购。
    - electronics-b1/：circuit.py 定义元件和网络；generate.py 生成原理图和 PCB，并预先锁定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
2026-10-14 B1 引脚测试增加与面包板接线表的交叉核对，并纳入 CI
    Pico 引脚表原先只有 circuit.py 一份手写来源；现与 wiring/build.py 中已实测接线用过的
    PICO_LEFT/PICO_RIGHT 逐脚比对（仅 AGND/ADC_VREF 命名不同）。CI 原有命令发现不了带连字符的
    electronics-b1 目录，单独加一行。
2026-10-14 B1 改为贴片为主：只保留插座和排针为通孔，并自带 3D 模型
    - 用户要求元件尽量用贴片：P-MOS 改为 AO4407A（SOIC-8），舵机降压改为 LM2596S-5.0（TO-263-5），
    逻辑 5V 改为 AMS1117-5.0（SOT-223），二极管改为 SS34/SS14/SMBJ12A/BZT52C12，
    电阻电容改为 0805/2512，电解改为贴片铝电解，电感改为 12×12 贴片功率电感，保险丝改为 1206 慢断 8A。
    元件都放在顶面，便于热风枪手焊。
    - 用户在 KiCad 3D 视图里看不到 Pico 和 DRV8871：KiCad Lite 不带标准 3D 库，DRV/EV3 的模型路径
    又指向 A1 工程。现把所用模型复制到 lib/3dmodels，统一用 ${KIPRJMOD} 引用。
    -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
2026-10-14 不再跟踪 KiCad 锁文件和本机界面设置
    上次提交误把 B1 在 KiCad 中打开时生成的 ~*.lck 锁文件和 .kicad_prl 加进了仓库，
    从索引中移除（本地文件保留），并加入 .gitignore。
2026-10-14 保存 KiCad 图形界面补齐后的 B1 工程设置
    用户在 KiCad 中打开 B1 后，界面把脚本生成的精简 .kicad_pro 补齐为完整格式（格式版本 1→3，
    补上默认的 ERC、铺铜、规则严重度等）。逐项比对：原有线宽、间距、网络类和规则值全部保留，
    DRC 结果不变（0 错误、0 未连通）。提交补齐后的版本，之后再打开就不会出现改动。
2026-10-14 新增 B1 淘宝采购记录与最终建议，包含对比分析与型号验证
    - 创建了多个文档，记录了 B1 板的淘宝采购过程，包括兴佳、优信和易鑫天诚的商品对比。
    - 详细列出了购物车状态、推荐商品、未加入项及其原因，确保用户能清晰了解各项选择。
    - 进行了型号验证，确保所选商品符合技术要求，并附上相关商品照片以供参考。
    - 购物车总金额更新为 ¥20.45，未含运费，记录了用户确认的最终采购建议。
2026-10-20 B1 底板：焊接上电指南、VM 短路排查记录，首板入口改为 B1
    - 新增 docs/b1-soldering-guide.md：分批焊接总表、方向核对、第 5 节断电验收改为
    “档位/表笔/通过/不通过→处理”的操作表，删去无法定性的目视项。
    - 新增 docs/b1-vm-short-debug.md：首板 VM 对地短路的完整排查记录。用电池注入电流、
    两点同时测毫伏压降沿 PCB 走线树定位，结论为 C31（100µF 电解）内部击穿，已换
    47µF/35V；另记录 VM 母线约 1.5mF 导致 PD 诱骗线上电即断（冲击电流），给出
    预充电转接线（10Ω 并联船型开关）方案。
    - README、electronics/README、electronics-b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
2026-10-20 固件支持 F/B 臂选择：B1 四路通道可逐路测试
    - arm_profiles.py：PINS 增加 F（GP10/11、编码器 GP16/17、舵机 GP20、PIO 4/5）
    和 B（GP14/15、GP18/19、GP21、PIO 6/7）；config.py 缺少某分组时明确报错
    - config.py 模板补 F/B 分组（按 L 复制，舵机开合值留 None，须实测标定）
    - arm_test.py 提示改为 arm R/L/F/B；wiring/spec.py 校验分组名
    - 测试覆盖 F/B 选择、缺分组报错及非法名称
    已在 B1 实板四路空载验证：bench 1 20 free 均 20/20，平均到位 0.56~0.57s。
2026-10-20 B1 补接口丝印并记录马达通道排查
    首测时舵机插反、误插进 J2（UART），EV3 背面数针也出过错，原因是板上没有针序标识。
    - 舵机排针逐针印 G/+/S，J2 印 GND/TX/RX 和 UART，EV3 背面第 1 针旁印 1
    - 丝印数据放在 circuit.py（SILK/REF_MOVES），generate.py 生成时加上；
    label_interfaces.py 给已布线 PCB 补加，只改丝印、可重复运行
    - R21/R31/R41 位号移到电阻下方，避免压住新标识；DRC 丝印重叠 23→16
    - test_b1.py 新增：各标识与对应网络焊盘同行
    - 重新导出 Gerber、预览、DRC（已生产的实物无这些丝印）
    - docs/b1-motor-channel-debug.md：L 路 U20 第 8 脚、B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
2026-10-20 B1 排查记录补 UART 回环和 VSYS 独立供电验收
    - J2 TX/RX 短接回环：115200 与 1M 波特收发一致，拔线后无数据，确认经 J2
    - 拔 USB、仅 9V 供电时 Pico 正常运行（临时 main.py 闪 LED，测后已删除）
    - 列出待四臂带载时再测的项目：多路同时动作的压降、补焊芯片温升
2026-10-20 忽略 firmware/pico 下的串口测试日志
    arm-B1.log 等测试日志只在本机保留，不再出现在 git status 中；需要存档的实测日志按惯例放 docs/measurements/。arm.log 仍保持跟踪（空文件，受冻结交付物测试保护）。
2026-10-20 忽略从设备导出的 config.py 备份
    pico-config-backup-*.py 是用户设备配置的本机备份，含实测舵机开合值，以设备为准，不进仓库。
